amyleesterling/humanoid-robot/electrical/kicad/project-button-v3/output/project-button-v3-pcb-test-access-bottom.png

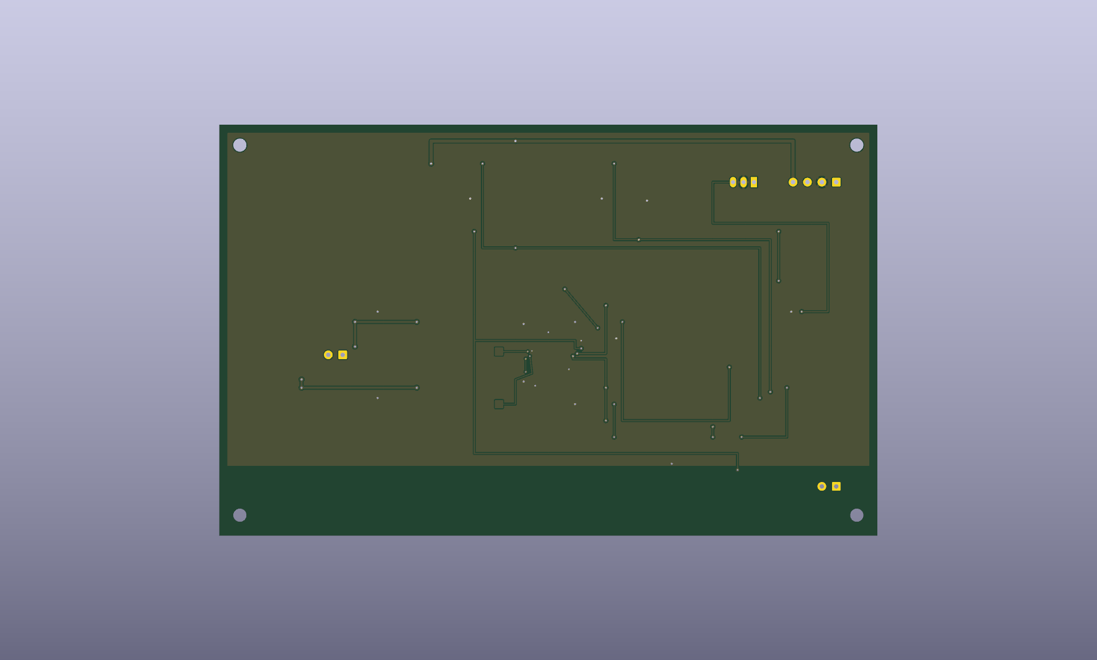
electrical/kicad/project-button-v3/output/project-button-v3-pcb-test-access-bottom.png
