amyleesterling/humanoid-robot/configuration/hr-v0-firmware-mechanical-source-binding-p0.1/README.md

# HR-V0-FW-MECH-SRC-BIND-P0.1

> **PRELIMINARY - NOT APPROVED FOR PROCUREMENT, FABRICATION, ASSEMBLY, CONNECTION, POWERED TESTING, MOTION, OR ENERGIZATION**

R245 binds both firmware configuration files to a SHA-256 manifest covering the current integrated P0.8 assembly, corrected P0.3 custom-part binding, inherited P0.7 kinematic basis and P0.3 hard-stop basis. The separate physical/HIL acceptance hash remains `SELECTION REQUIRED`; motion remains fail-closed.
