amyleesterling/humanoid-robot/configuration/hr-v0-config-reconciliation-p0.10/README.md

# HR-V0-CONFIG-REC-P0.10

> **PRELIMINARY - NOT APPROVED FOR PROCUREMENT, FABRICATION, ASSEMBLY, CONNECTION, POWERED TESTING, MOTION, OR ENERGIZATION**

R246 carries P0.9 forward and adds the partial/not-accepted P1.21 static voltage-budget evidence. P1.15 remains current; P1.21 remains unaccepted. Forty-one holds and fifty-seven unexecuted acceptance rows remain.
