amyleesterling/humanoid-robot/configuration/hr-v0-config-reconciliation-p0.11/README.md

# HR-V0-CONFIG-REC-P0.11

> **PRELIMINARY - NOT APPROVED FOR PROCUREMENT, FABRICATION, ASSEMBLY, CONNECTION, POWERED TESTING, MOTION, OR ENERGIZATION**

R247 carries P0.10 forward and adds the review/RFQ-preparation-only mechanical shop and unpowered assembly candidate. P1.15 remains current; P1.21 remains unaccepted. Forty-five holds and sixty-five unexecuted acceptance rows remain.
