amyleesterling/humanoid-robot/configuration/hr-v0-config-reconciliation-p0.12/README.md

# HR-V0-CONFIG-REC-P0.12

> **PRELIMINARY - NOT APPROVED FOR PROCUREMENT, FABRICATION, ASSEMBLY, CONNECTION, POWERED TESTING, MOTION, OR ENERGIZATION**

R248 carries P0.11 forward and adds a blank physical-properties evidence contract. It does not add physical evidence or close B-010. Fifty holds and seventy-three unexecuted acceptance rows remain.
