amyleesterling/humanoid-robot/configuration/hr-v0-config-reconciliation-p0.13/README.md

# HR-V0-CONFIG-REC-P0.13

> **PRELIMINARY - NOT APPROVED FOR PROCUREMENT, FABRICATION, ASSEMBLY, CONNECTION, POWERED TESTING, MOTION, OR ENERGIZATION**

R249 carries P0.12 forward and adds fail-closed accepted-property propagation. No accepted physical bundle or downstream rebuild exists. Fifty-five holds and eighty-one unexecuted acceptance rows remain.
