amyleesterling/humanoid-robot/configuration/hr-v0-config-reconciliation-p0.14/README.md

# HR-V0-CONFIG-REC-P0.14

> **PRELIMINARY - NOT APPROVED FOR PROCUREMENT, FABRICATION, ASSEMBLY, CONNECTION, POWERED TESTING, MOTION, OR ENERGIZATION**

R250 adds a qualified-review-only GD&T proposal. Formal GD&T remains unreleased. Sixty holds and eighty-nine unexecuted acceptances remain.
