amyleesterling/humanoid-robot/configuration/hr-v0-config-reconciliation-p0.15/README.md

# HR-V0-CONFIG-REC-P0.15

> **PRELIMINARY - NOT APPROVED FOR PROCUREMENT, FABRICATION, ASSEMBLY, CONNECTION, POWERED TESTING, MOTION, OR ENERGIZATION**

R251 adds the fail-closed first-shop-session contract. Sixty-five holds and ninety-seven unexecuted acceptances remain.
