amyleesterling/humanoid-robot/configuration/hr-v0-config-reconciliation-p0.16/README.md

# HR-V0-CONFIG-REC-P0.16

> **PRELIMINARY - NOT APPROVED FOR PROCUREMENT, FABRICATION, ASSEMBLY, CONNECTION, POWERED TESTING, MOTION, OR ENERGIZATION**

R252 adds the review-only zero-energy fixture and temporary-stack instruction. Seventy holds and 103 unexecuted acceptances remain.
