amyleesterling/humanoid-robot/configuration/hr-v0-config-reconciliation-p0.17/README.md

# HR-V0-CONFIG-REC-P0.17

> **PRELIMINARY - NOT APPROVED FOR PROCUREMENT, FABRICATION, ASSEMBLY, CONNECTION, POWERED TESTING, MOTION, OR ENERGIZATION**

R253 supersedes the rank-3 P0.1 locating scheme with rank-6 nominal P0.2. Seventy holds and 103 unexecuted acceptances remain.
