amyleesterling/humanoid-robot/configuration/hr-v0-config-reconciliation-p0.18/README.md

# HR-V0-CONFIG-REC-P0.18

> **PRELIMINARY - NOT APPROVED FOR PROCUREMENT, FABRICATION, ASSEMBLY, CONNECTION, POWERED TESTING, MOTION, OR ENERGIZATION**

R254 adds HR-V0-JOINT-MET-P0.2, supersedes P0.1 for execution planning, and limits P0.2 fixture applicability. 82 holds and 115 unexecuted acceptances remain.
