amyleesterling/humanoid-robot/configuration/hr-v0-config-reconciliation-p0.19/README.md

# HR-V0-CONFIG-REC-P0.19

> **PRELIMINARY - NOT APPROVED FOR PROCUREMENT, FABRICATION, ASSEMBLY, CONNECTION, POWERED TESTING, MOTION, OR ENERGIZATION**

R255 adds HR-V0-LOT-A-INQUIRY-P0.2 and supersedes two historical inquiry plans for current use. 97 holds and 130 unexecuted acceptances remain. Nothing is sent or authorized.
