amyleesterling/humanoid-robot/configuration/hr-v0-config-reconciliation-p0.2/README.md

# HR-V0 configuration reconciliation P0.2

> **PRELIMINARY - NOT APPROVED FOR PROCUREMENT, FABRICATION, ASSEMBLY, CONNECTION, POWERED TESTING, MOTION, OR ENERGIZATION**

R212 retains P1.15 as the direct watchdog/core binding and adds the machine-parity-checked P1.17 system view, current observation carrier P0.5, Pi carrier P0.1 and both observation harness candidates. P1.16, observation P0.2/P0.3/P0.4 and configuration P0.1 are historical. Pi acceptance, BOM closure, DFM, physical evidence and qualified acceptance remain open.
