amyleesterling/humanoid-robot/configuration/hr-v0-config-reconciliation-p0.20/README.md

# HR-V0-CONFIG-REC-P0.20

> **PRELIMINARY - NOT APPROVED FOR PROCUREMENT, FABRICATION, ASSEMBLY, CONNECTION, POWERED TESTING, MOTION, OR ENERGIZATION**

R256 adds HR-V0-JOINT-MEAS-DEF-P0.1. It defines exact source references but releases no physical result, tolerance, selection or work authority. 109 holds and 142 unexecuted acceptances remain.
