amyleesterling/humanoid-robot/configuration/hr-v0-config-reconciliation-p0.21/README.md

# HR-V0-CONFIG-REC-P0.21

> **PRELIMINARY - NOT APPROVED FOR PROCUREMENT, FABRICATION, ASSEMBLY, CONNECTION, POWERED TESTING, MOTION, OR ENERGIZATION**

R257 adds HR-V0-LOT-A-INQUIRY-P0.3 and supersedes P0.2 for current inquiry use. 125 holds and 158 unexecuted acceptances remain. Nothing is sent or authorized.
