amyleesterling/humanoid-robot/configuration/hr-v0-config-reconciliation-p0.22/README.md

# HR-V0-CONFIG-REC-P0.22

> **PRELIMINARY - NOT APPROVED FOR PROCUREMENT, FABRICATION, ASSEMBLY, CONNECTION, POWERED TESTING, MOTION, OR ENERGIZATION**

R258 adds HR-V0-LOT-A-TX-BUNDLE-P0.1. Five deterministic archives exist, but all remain UNSENT and NOT AUTHORIZED. Vendor-CAD redistribution authority remains open. 136 holds and 169 unexecuted acceptances remain.
