amyleesterling/humanoid-robot/configuration/hr-v0-config-reconciliation-p0.23/README.md

# HR-V0-CONFIG-REC-P0.23

> **PRELIMINARY - NOT APPROVED FOR PROCUREMENT, FABRICATION, ASSEMBLY, CONNECTION, POWERED TESTING, MOTION, OR ENERGIZATION**

R259 adds HR-V0-OBS-BOM-INTEGRATION-P0.1, BOM-099 through BOM-108, and corrects current release metadata to 108 groups. Exact mounting hardware, cable cuts, provider/received evidence, physical tests, qualified review and all work authority remain open. 144 holds and 179 unexecuted acceptances remain.
