amyleesterling/humanoid-robot/configuration/hr-v0-config-reconciliation-p0.24/README.md

# HR-V0-CONFIG-REC-P0.24

> **PRELIMINARY - NOT APPROVED FOR PROCUREMENT, FABRICATION, ASSEMBLY, CONNECTION, POWERED TESTING, MOTION, OR ENERGIZATION**

R260 adds HR-V0-OBS-MOUNT-STACK-P0.1. BOM-107 and BOM-108 now contain exact but unreleased candidate hardware; BOM-104 records restricted Samtec availability and the nominal 0.13 mm stack mismatch. 153 holds and 191 unexecuted acceptances remain.
