amyleesterling/humanoid-robot/configuration/hr-v0-config-reconciliation-p0.25/README.md

# HR-V0-CONFIG-REC-P0.25

> **PRELIMINARY - NOT APPROVED FOR PROCUREMENT, FABRICATION, ASSEMBLY, CONNECTION, POWERED TESTING, MOTION, OR ENERGIZATION**

R261 adds HR-V0-U2D2-JC1-HARNESS-P0.1. BOM-061 is now an exact but unreleased two-conductor harness candidate and the canonical BOM closure now agrees that BOM-107/108 are exact-candidate holds. 165 holds and 204 unexecuted acceptances remain.
