amyleesterling/humanoid-robot/configuration/hr-v0-config-reconciliation-p0.26/README.md

# HR-V0-CONFIG-REC-P0.26

> **PRELIMINARY - NOT APPROVED FOR PROCUREMENT, FABRICATION, ASSEMBLY, CONNECTION, POWERED TESTING, MOTION, OR ENERGIZATION**

R262 adds HR-V0-U2D2-JC1-HARNESS-RFQ-P0.1: a deterministic, UNSENT manufacturer-build request for the R261 controller harness. Provider response, quote, process evidence, first article, purchase decision and all physical/system acceptance remain open. 175 holds and 216 blank acceptances remain.
