amyleesterling/humanoid-robot/configuration/hr-v0-config-reconciliation-p0.27/README.md

# HR-V0-CONFIG-REC-P0.27

> **PRELIMINARY - NOT APPROVED FOR PROCUREMENT, FABRICATION, ASSEMBLY, CONNECTION, POWERED TESTING, MOTION, OR ENERGIZATION**

R263 adds HR-V0-DXL-PROT-CARRIER-HARNESS-P0.2: six exact harness identities, corrected minimum JST population, an exact held #8 source-terminal candidate, rejection of thirteen stale-placement collisions and a zero-planar-collision rotated planning screen. Placement, cuts, process, physical/qualified evidence and all work authority remain open. 185 holds and 234 blank acceptances remain.
