amyleesterling/humanoid-robot/configuration/hr-v0-config-reconciliation-p0.28/README.md

# HR-V0-CONFIG-REC-P0.28

> **PRELIMINARY - NOT APPROVED FOR PROCUREMENT, FABRICATION, DRILLING, ASSEMBLY, CONNECTION, POWERED TESTING, MOTION, OR ENERGIZATION**

R264 adds HR-V0-DXL-CARRIER-MOUNT-IF-P0.2: twelve transformed hole centers, six connector anchors, current screw replacement disposition and an inert no-drill fit contract. 200 holds and 252 blank acceptances remain.
