amyleesterling/humanoid-robot/configuration/hr-v0-config-reconciliation-p0.29/README.md

# HR-V0-CONFIG-REC-P0.29

> **PRELIMINARY - NOT APPROVED FOR PROCUREMENT, FABRICATION, MARKING, DRILLING, ASSEMBLY, CONNECTION, POWERED TESTING, MOTION, OR ENERGIZATION**

R265 adds HR-V0-CARRIER-FIT-EVID-CAP-P0.1, a blank local-only physical-fit evidence contract. It authorizes no session or physical work. 210 holds and 264 blank acceptances remain.
