amyleesterling/humanoid-robot/configuration/hr-v0-config-reconciliation-p0.3/README.md

# HR-V0 configuration reconciliation P0.3

> **PRELIMINARY - NOT APPROVED FOR PROCUREMENT, FABRICATION, ASSEMBLY, CONNECTION, POWERED TESTING, MOTION, OR ENERGIZATION**

R214 adds `HR-V0-ARM-ARCH-P0.8-DWG-INTEGRATED-CANDIDATE` as the current held integrated mechanical identity. It directly imports the five R213 custom-part STEP identities while retaining P0.7 only as historical transform/collision basis. All physical evidence, qualified acceptance and work authority remain open.
