amyleesterling/humanoid-robot/configuration/hr-v0-config-reconciliation-p0.30/README.md

# HR-V0-CONFIG-REC-P0.30

> **PRELIMINARY - NOT APPROVED FOR PROCUREMENT, FABRICATION, ASSEMBLY, CONNECTION, POWERED TESTING, MOTION, OR ENERGIZATION**

R266 adds HR-V0-LOT-A-DECISION-CAP-P0.1, a local-only blank decision surface. It records current primary-page facts and authorizes no contact, cart, checkout, purchase or receipt. 222 holds and 276 blank acceptances remain.
