amyleesterling/humanoid-robot/configuration/hr-v0-config-reconciliation-p0.31/README.md

# HR-V0-CONFIG-REC-P0.31

> **PRELIMINARY - NOT APPROVED FOR PROCUREMENT, FABRICATION, ASSEMBLY, CONNECTION, POWERED TESTING, MOTION, OR ENERGIZATION**

R267 adds HR-V0-LOT-A-ALT-ROUTE-P0.1. The exact actuator marketplace route is conditionally admissible for dated cart/quote evaluation only. It authorizes no contact, cart, checkout, purchase, receipt or physical work. 234 holds and 288 blank acceptances remain.
