amyleesterling/humanoid-robot/configuration/hr-v0-config-reconciliation-p0.32/README.md

# HR-V0-CONFIG-REC-P0.32

> **PRELIMINARY - NOT APPROVED FOR PROCUREMENT, FABRICATION, ASSEMBLY, CONNECTION, POWERED TESTING, MOTION, OR ENERGIZATION**

R268 adds HR-V0-GDT-REVIEW-P0.2. It corrects a non-equivalent tolerance-zone proposal and removes ambiguous datum wording without changing drawing geometry or authorizing work. 246 holds and 300 blank acceptances remain.
