amyleesterling/humanoid-robot/configuration/hr-v0-config-reconciliation-p0.33/README.md

# HR-V0-CONFIG-REC-P0.33

> **PRELIMINARY - NOT APPROVED FOR PROCUREMENT, QUOTATION, FABRICATION, ASSEMBLY, CONNECTION, POWERED TESTING, MOTION, OR ENERGIZATION**

R269 adds HR-V0-J2-STOP-STRENGTH-P0.1 as unselected review evidence. P0.8 remains the current unaccepted mechanical identity; P0.9 is not promoted. 258 holds and 312 blank acceptances remain.
