amyleesterling/humanoid-robot/configuration/hr-v0-config-reconciliation-p0.34/README.md

# HR-V0-CONFIG-REC-P0.34

> **PRELIMINARY - NOT APPROVED FOR PROCUREMENT, QUOTATION, FABRICATION, ASSEMBLY, CONNECTION, POWERED TESTING, MOTION, OR ENERGIZATION**

R270 supersedes the R269 force conversion and indexes HR-V0-J2-STOP-BOSSED-P0.1. P0.8 remains the current unaccepted mechanical identity; P0.10 is not selected.
