amyleesterling/humanoid-robot/configuration/hr-v0-config-reconciliation-p0.35/README.md

# HR-V0-CONFIG-REC-P0.35

> **PRELIMINARY - NOT APPROVED FOR PROCUREMENT, QUOTATION, FABRICATION, ASSEMBLY, CONNECTION, POWERED TESTING, MOTION, OR ENERGIZATION**

R271 indexes HR-V0-J2-STOP-FEA-P0.1. P0.8 remains the current unaccepted mechanical identity; P0.10 fails the interim full-part screen and is not selected.
