amyleesterling/humanoid-robot/configuration/hr-v0-config-reconciliation-p0.38/README.md

# HR-V0-CONFIG-REC-P0.38

> **PRELIMINARY - NOT APPROVED FOR PROCUREMENT, QUOTATION, FABRICATION, ASSEMBLY, CONNECTION, POWERED TESTING, MOTION, OR ENERGIZATION**

R274 indexes the unselected A04 P0.1 exact-candidate and verification package. P0.8 remains the current unaccepted mechanical identity; no procurement or structural-use authority exists.
