amyleesterling/humanoid-robot/configuration/hr-v0-config-reconciliation-p0.39/README.md

# HR-V0-CONFIG-REC-P0.39

> **PRELIMINARY - NOT APPROVED FOR PROCUREMENT, QUOTATION, FABRICATION, ASSEMBLY, CONNECTION, POWERED TESTING, MOTION, OR ENERGIZATION**

R275 indexes an unselected Rogers 2300327 soft-contact test-coupon candidate. It has no sole structural-stop or safety credit.
