amyleesterling/humanoid-robot/configuration/hr-v0-config-reconciliation-p0.4/README.md

# HR-V0-CONFIG-REC-P0.4

> **PRELIMINARY - NOT APPROVED FOR PROCUREMENT, FABRICATION, ASSEMBLY, CONNECTION, POWERED TESTING, MOTION, OR ENERGIZATION**

R223 reconciles P1.15 current identity with the unaccepted P1.18 topology, explicit P2P schedule, held node placement and 95-group covered BOM. No physical or work gate closes.
