amyleesterling/humanoid-robot/configuration/hr-v0-config-reconciliation-p0.40/README.md

# HR-V0-CONFIG-REC-P0.40

> **PRELIMINARY - NOT APPROVED FOR PROCUREMENT, QUOTATION, FABRICATION, ASSEMBLY, CONNECTION, POWERED TESTING, MOTION, OR ENERGIZATION**

R276 indexes P0.2's exact P0.12 contact-load boundary. Rogers 2300327 remains an unselected sacrificial test coupon with no structural-stop or safety credit.
