amyleesterling/humanoid-robot/configuration/hr-v0-config-reconciliation-p0.41/README.md

# HR-V0-CONFIG-REC-P0.41

> **PRELIMINARY - NOT APPROVED FOR PROCUREMENT, QUOTATION, FABRICATION, ASSEMBLY, CONNECTION, POWERED TESTING, MOTION, OR ENERGIZATION**

R277 indexes the P0.13 pad-pocket geometry and dependent-depth control. The 0.520 mm CAD depth is not a machining dimension; pad, adhesive and P0.13 remain unselected.
