amyleesterling/humanoid-robot/configuration/hr-v0-config-reconciliation-p0.42/README.md

# HR-V0-CONFIG-REC-P0.42

> **PRELIMINARY - NOT APPROVED FOR PROCUREMENT, QUOTATION, FABRICATION, ASSEMBLY, CONNECTION, POWERED TESTING, MOTION, OR ENERGIZATION**

R278 indexes the corrected exact-normal P0.13 linear screens. P0.13 remains unselected; nonlinear, joined-load, dynamic, physical and qualified closure remains open.
