amyleesterling/humanoid-robot/configuration/hr-v0-config-reconciliation-p0.43/README.md

# HR-V0-CONFIG-REC-P0.43

> **PRELIMINARY - NOT APPROVED FOR PROCUREMENT, QUOTATION, FABRICATION, ASSEMBLY, CONNECTION, POWERED TESTING, MOTION, OR ENERGIZATION**

R279 indexes the unexecuted exact local convergence protocol. R278-H02 and every work authority remain open.
