amyleesterling/humanoid-robot/configuration/hr-v0-config-reconciliation-p0.44/README.md

# HR-V0-CONFIG-REC-P0.44

> **PRELIMINARY - SCRATCH NUMERICAL EVIDENCE ONLY - NOT APPROVED FOR PROCUREMENT, QUOTATION, FABRICATION, ASSEMBLY, CONNECTION, POWERED TESTING, MOTION, OR ENERGIZATION**

R280 indexes bounded local-mesh/solver feasibility evidence. R278-H02 and every work authority remain open.
