amyleesterling/humanoid-robot/configuration/hr-v0-config-reconciliation-p0.45/README.md

# HR-V0-CONFIG-REC-P0.45

> **PRELIMINARY - NUMERICAL SOLVER FEASIBILITY ONLY - NOT APPROVED FOR PROCUREMENT, QUOTATION, FABRICATION, ASSEMBLY, CONNECTION, POWERED TESTING, MOTION, OR ENERGIZATION**

R281 indexes bounded numerical method evidence. H02 and every work authority remain open.
