amyleesterling/humanoid-robot/configuration/hr-v0-config-reconciliation-p0.46/README.md

# HR-V0-CONFIG-REC-P0.46

> **PRELIMINARY - PROTOCOL CORRECTION AND NUMERICAL METHOD EVIDENCE ONLY - NOT APPROVED FOR PROCUREMENT, QUOTATION, FABRICATION, ASSEMBLY, CONNECTION, POWERED TESTING, MOTION, OR ENERGIZATION**

R282 indexes the current fail-closed J2 refinement erratum. H02 and every work authority remain open.
