amyleesterling/humanoid-robot/configuration/hr-v0-config-reconciliation-p0.48/README.md

# HR-V0-CONFIG-REC-P0.48

> **PRELIMINARY - NUMERICAL MESH-METHOD DEVELOPMENT ONLY - NOT APPROVED FOR PROCUREMENT, QUOTATION, FABRICATION, ASSEMBLY, CONNECTION, POWERED TESTING, MOTION, OR ENERGIZATION**

R284 indexes bounded C07 mesh-method candidates and targeted failure localization. The sequence is not converged; R279-C02, H02, capacity and every work authority remain open.
