amyleesterling/humanoid-robot/configuration/hr-v0-config-reconciliation-p0.49/README.md

# HR-V0-CONFIG-REC-P0.49

> **PRELIMINARY - TARGETED CURVED-MESH METHOD EVIDENCE ONLY - NOT APPROVED FOR PROCUREMENT, QUOTATION, FABRICATION, ASSEMBLY, CONNECTION, POWERED TESTING, MOTION, OR ENERGIZATION**

R285 indexes exact target-feature identities and a repeatable bounded targeted-remesh candidate. Exact B-Rep/facet/load/full-domain/exact-zone/R279-C02/H02 and every authority remain open.
