amyleesterling/humanoid-robot/configuration/hr-v0-config-reconciliation-p0.6/README.md

# HR-V0-CONFIG-REC-P0.6

> **PRELIMINARY - NOT APPROVED FOR PROCUREMENT, FABRICATION, ASSEMBLY, CONNECTION, POWERED TESTING, MOTION, OR ENERGIZATION**

R242 adds held BOM-097 and HR-V0-P121-CONDUCTOR-FILL-P0.1. P1.15 remains current; P1.21 is unaccepted; no work gate closes.
