amyleesterling/humanoid-robot/configuration/hr-v0-config-reconciliation-p0.7/README.md

# HR-V0-CONFIG-REC-P0.7

> **PRELIMINARY - NOT APPROVED FOR PROCUREMENT, FABRICATION, ASSEMBLY, CONNECTION, POWERED TESTING, MOTION, OR ENERGIZATION**

R243 adds held BOM-098 and HR-V0-P121-TERM-P0.1. P1.15 remains current; P1.21 is unaccepted; no gate or work authority closes.
