amyleesterling/humanoid-robot/configuration/hr-v0-config-reconciliation-p0.9/README.md

# HR-V0-CONFIG-REC-P0.9

> **PRELIMINARY - NOT APPROVED FOR PROCUREMENT, FABRICATION, ASSEMBLY, CONNECTION, POWERED TESTING, MOTION, OR ENERGIZATION**

R245 corrects BOM-027 to `HR-V0-MECH-BOM-BIND-P0.3` and binds both firmware configurations to HR-V0-FW-MECH-SRC-BIND-P0.1. Source identity is closed; shop-document, physical/HIL and qualified acceptance remain open. P1.15 remains current and P1.21 unaccepted.
