amyleesterling/humanoid-robot/controls/hr-v0-runtime-evidence-log-p0.1/README.md

# HR-V0-EVID-LOG-P0.1

> **PRELIMINARY - NOT APPROVED FOR PROCUREMENT, FABRICATION, ASSEMBLY, CONNECTION, POWERED TESTING, MOTION, OR ENERGIZATION**

This package controls the source-side runtime evidence stream and the future target/calibration acceptance route. It does not contain an accepted calibration, target trace, physical result, qualified disposition, or test authority.

- 14 required event classes
- 10 clock/uncertainty budget rows
- 12 blank calibration records
- 15 future tests, all `NOT_EXECUTED`
- 15 open holds
- Sol M-022 remains `PARTIALLY_ADDRESSED_OPEN`
