amyleesterling/humanoid-robot/safety/hr-v0-p121-application-evidence-p0.1/README.md

# HR-V0-P121-APP-EVID-P0.1

> **PRELIMINARY - NOT APPROVED FOR PROCUREMENT, FABRICATION, ASSEMBLY, CONNECTION, POWERED TESTING, MOTION, OR ENERGIZATION**

R235 converts P1.21 application holds into 13 exact unsent manufacturer questions, 12 response controls, 18 unexecuted no-load tests and 14 open holds. It sends nothing, selects no unresolved dynamic limit, executes no test and grants no authority. P1.15 remains current; P1.21 remains unaccepted.
