amyleesterling/humanoid-robot/safety/hr-v0-p121-sra1-supply-watchdog-p0.1/README.md

# HR-V0-P121-SRA1-SUPPLY-WD-P0.1

> **PRELIMINARY - NOT APPROVED FOR PROCUREMENT, FABRICATION, ASSEMBLY, CONNECTION, POWERED TESTING, MOTION, OR ENERGIZATION**

R234 records the unaccepted P1.21 SRA1-supply watchdog candidate: seven exact terminal changes, 14 fault cases, nine supply/contact screens and 11 open holds. P1.15 remains current. DF-01 has zero safety credit.
