amyleesterling/humanoid-robot/safety/hr-v0-pnoz-kwd-application-p0.2/README.md

# HR-V0-PNOZ-KWD-APP-P0.2

> **PRELIMINARY - NOT APPROVED FOR PROCUREMENT, FABRICATION, ASSEMBLY, CONNECTION, POWERED TESTING, MOTION, OR ENERGIZATION**

R233 screens the P1.20 PNOZ s4 750104 input path against Phoenix Contact 2967060 source data. The electrical contact screen passes on paper; B-005 remains partially addressed/open, P1.20 remains unaccepted, and safety credit/work authority remain zero.
