amyleesterling/humanoid-robot/configuration/hr-v0-config-reconciliation-p0.1/README.md

# HR-V0 configuration reconciliation P0.1

> **PRELIMINARY - NOT APPROVED FOR PROCUREMENT, FABRICATION, ASSEMBLY, CONNECTION, MOTION, OR ENERGIZATION**

R195 synchronizes the carrier-integrated P1.15 candidate, direct-bound watchdog PCB-P1.0, watchdog manufacturing package P0.2, CAM review P0.2 and E2 hardware slice P0.4 into one fail-closed configuration. The P1.14 source, R165 parity record and P0.1 CAM remain controlled historical evidence. Physical evidence and qualified acceptance remain open.
