amyleesterling/humanoid-robot/hr30/whole-body-p0.1/joint-hardware-successor-reconciliation-p0.1/README.md

# HR-30 joint-hardware successor reconciliation P0.1

PRELIMINARY - JOINT-HARDWARE SUCCESSOR CANDIDATES ONLY - NOT APPROVED FOR PROCUREMENT, FABRICATION, ASSEMBLY, POWERED TESTING, MOTION, OR ENERGIZATION

This package binds all 39 legacy pulley/coupler envelopes to physical successor candidates. The old shapes are not manufacturing parts. No successor is selected or released. See `successor-manufacturing-binding.csv`.
