amyleesterling/humanoid-robot/hr30/whole-body-p0.1/leg-drivetrain-p0.1/README.md

# HR-30 reduced-leg drivetrain P0.1

**PRELIMINARY - PRODUCT/GEOMETRY CANDIDATE ONLY - NOT APPROVED FOR PROCUREMENT, FABRICATION, ASSEMBLY, POWERED TESTING, MOTION, OR ENERGIZATION**

Four product-specific 5GT/EV5GT modules cover all ten reduced leg axes. The dedicated LD-25K knee module uses 16:40 teeth, a 250 mm belt and a 10 mm XH540 horn-adapter interface. Native CAD represents catalog external/routing envelopes and exact solved pitch centers. P-bore-plus-tap retention and separate dimensioned adapter geometry are selected, while vendor tooth B-Reps, material, fits, fasteners, capacity and work authority remain open.
