amyleesterling/humanoid-robot/electrical/mechanical/hr-v0-dxl-carrier-mount-p0.2/README.md

# HR-V0-DXL-CARRIER-MOUNT-IF-P0.2

> **PRELIMINARY - NOT APPROVED FOR PROCUREMENT, FABRICATION, DRILLING, ASSEMBLY, CONNECTION, POWERED TESTING, MOTION, OR ENERGIZATION**

R264 defines exact nominal panel datums and an inert no-drill fit contract. It releases no hole, hardware, route, cut or physical work.
