amyleesterling/humanoid-robot/electrical/routing/hr-v0-p121-segregation-hardware-p0.1/README.md

# HR-V0-P121-SEGREGATION-HW-P0.1

> **PRELIMINARY - NOT APPROVED FOR PROCUREMENT, FABRICATION, ASSEMBLY, CONNECTION, POWERED TESTING, MOTION, OR ENERGIZATION**

R241 controls an exact 25 x 25 mm duct body/cover candidate and panel fit screen. Junction, conductors, fill, installation, safety credit and all authority remain open.
