amyleesterling/humanoid-robot/hr30/whole-body-p0.1/leg-drivetrain-adapters-p0.1/README.md

# HR-30 leg-drive adapters P0.1

**PRELIMINARY - DIMENSIONED ADAPTER GEOMETRY CANDIDATE ONLY - NOT APPROVED FOR PROCUREMENT, FABRICATION, ASSEMBLY, POWERED TESTING, MOTION, OR ENERGIZATION**

Five reusable machined-part families give all ten reduced leg axes a concrete nominal horn, pulley and output-shaft interface. The package is editable geometry, not a manufacturing release.
