amyleesterling/humanoid-robot/mechanical/analysis/hr-v0-j2-c07-conformal-successor-disposition-p0.1/README.md

# HR-V0-J2-C07-CONFORMAL-SUCCESSOR-DISPOSITION-P0.1

**PRELIMINARY - CONFORMAL SUCCESSOR DISPOSITION ONLY - NOT APPROVED FOR PROCUREMENT, QUOTATION, FABRICATION, ASSEMBLY, CONNECTION, POWERED TESTING, MOTION, OR ENERGIZATION**

R292 records the split R291 result: sampled curved-Jacobian failures are eliminated, while pocket-junction SICN regresses. More straight-only refinement is rejected; a separately preregistered optimization/topology-method candidate is required.
