amyleesterling/humanoid-robot/mechanical/analysis/hr-v0-j2-c07-conformal-successor-mesh-p0.1/README.md

# HR-V0-J2-C07-CONFORMAL-SUCCESSOR-MESH-P0.1

**PRELIMINARY - PREREGISTERED CONFORMAL SUCCESSOR MESH EVIDENCE ONLY - NOT APPROVED FOR PROCUREMENT, QUOTATION, FABRICATION, ASSEMBLY, CONNECTION, POWERED TESTING, MOTION, OR ENERGIZATION**

R291 executes exactly one preregistered successor to the retained failed R289 mesh. It preserves every R289 setting, adds a 0.18 mm field to the four failed exact pocket-straight volumes, and adds a 0.35 mm field to six symmetry-closed exact cylinder faces. All R279 thresholds are unchanged.

The result is data-driven. Even a complete R279-C02 mesh-quality pass does not execute structural fields, close H02, establish capacity, or grant any work authority.
