amyleesterling/humanoid-robot/mechanical/analysis/hr-v0-j2-c07-conformal-successor-prereg-p0.1/README.md

# HR-V0-J2-C07-CONFORMAL-SUCCESSOR-PREREG-P0.1

**PRELIMINARY - SUCCESSOR MESH PREREGISTRATION ONLY - NOT APPROVED FOR PROCUREMENT, QUOTATION, FABRICATION, ASSEMBLY, CONNECTION, POWERED TESTING, MOTION, OR ENERGIZATION**

R291 freezes one successor execution before meshing: four exact failed pocket-straight volumes receive a 0.18 mm local field and the four observed curved-failure cylinder faces are X-mirror-closed to six exact faces receiving a 0.35 mm field. All R279 acceptance thresholds remain unchanged. No mesh has been executed by this package.
