amyleesterling/humanoid-robot/mechanical/analysis/hr-v0-j2-c07-conformal-zone-mesh-p0.1/README.md

# HR-V0-J2-C07-CONFORMAL-ZONE-MESH-P0.1

**PRELIMINARY - EXACT-ZONE CONFORMAL MESH EVIDENCE ONLY - NOT APPROVED FOR PROCUREMENT, QUOTATION, FABRICATION, ASSEMBLY, CONNECTION, POWERED TESTING, MOTION, OR ENERGIZATION**

R289 meshes the exact R288 Boolean partition. Every tetrahedron inherits one exact volume-entity provenance; no centroid or sampled-distance zone membership is used. Full fixed-bin SICN histograms are retained globally and for every exact zone, and signed/normalized Tet10 Jacobians are evaluated at the actual Gmsh Gauss4/Gauss6/Gauss8 points.

The result is a bounded mesh-quality execution only. Full-domain Jacobian positivity, exterior facet fidelity, structural fields, convergence, H02, capacity, safety credit and every work authority remain open.
