amyleesterling/humanoid-robot/mechanical/analysis/hr-v0-j2-c07-exact-zone-partition-p0.1/README.md

# HR-V0-J2-C07-EXACT-ZONE-PARTITION-P0.1

**PRELIMINARY - EXACT ANALYSIS-ZONE CAD PARTITION ONLY - NOT APPROVED FOR PROCUREMENT, QUOTATION, FABRICATION, ASSEMBLY, CONNECTION, POWERED TESTING, MOTION, OR ENERGIZATION**

R288 creates an exact OpenCASCADE partition of the authoritative P0.13 C07 part into 27 primary analysis zones: eight separately named pocket-perimeter bands, the pocket-floor backing volume, twelve Euclidean 1 mm hole-rim neighborhoods, and six nonsingular ligament bands. The retained B-Rep is partitioned by Boolean provenance; no centroid, sampled-polyline, or element-mean membership substitute is used.

The exact C07 M5 bores E1/E2 begin at y=2.9 mm. R288 therefore rejects the earlier aggregate y=0 hole assumption for those two bores. It does not invent the missing radial thickness for fixed-offset hole gauge volumes.

No mesh or structural solve is executed. R279-C02, R278-H02, capacity, safety credit and every work authority remain open.
