amyleesterling/humanoid-robot/mechanical/analysis/hr-v0-j2-c07-fidelity-remesh-p0.1/README.md

# HR-V0-J2-C07-FIDELITY-REMESH-P0.1

> **PRELIMINARY - TARGETED B-REP FIDELITY REMESH EVIDENCE ONLY - NOT APPROVED FOR PROCUREMENT, QUOTATION, FABRICATION, ASSEMBLY, CONNECTION, POWERED TESTING, MOTION, OR ENERGIZATION**

R287 applies the preregistered 0.35 mm field to the X-mirror-closed set of 22 exact faces (21 R286 failures plus one required mirror counterpart) and their 88 owner-boundary curves while retaining the R285 global, pocket, hole, boss and rail-transition controls. The exact R286 evaluator is run next; no mesh pass alone grants structural, capacity, safety or work-authority credit.
