amyleesterling/humanoid-robot/mechanical/analysis/hr-v0-j2-c07-pe-cad-curving-facet-localization-p0.1/README.md

# HR-V0-J2-C07-PE-CAD-CURVING-FACET-LOCALIZATION-P0.1

**PRELIMINARY - R308 UNMAPPED-FACET LOCALIZATION EVIDENCE ONLY - NOT APPROVED FOR PROCUREMENT, QUOTATION, FABRICATION, ASSEMBLY, CONNECTION, POWERED TESTING, MOTION, OR ENERGIZATION**

R309 reproduces the R308 77-facet failure without changing mesh or tolerance and assigns each unmapped facet its nearest exact OCC face with six-node deviations. This is localization only; it does not retroactively pass the exact-face map or authorize a replacement mesh.
