amyleesterling/humanoid-robot/mechanical/analysis/hr-v0-j2-c07-pe-cad-curving-facet-p0.1/README.md

# HR-V0-J2-C07-PE-CAD-CURVING-FACET-P0.1

**PRELIMINARY - FAILED R307 EXACT FACET/B-REP/LOAD REVALIDATION EVIDENCE ONLY - NOT APPROVED FOR PROCUREMENT, QUOTATION, FABRICATION, ASSEMBLY, CONNECTION, POWERED TESTING, MOTION, OR ENERGIZATION**

The one frozen R308 evaluation stopped fail-closed before area/load credit: 112,569 of 112,646 exterior R307 quadratic facets mapped uniquely to an exact OCC face, while 77 mapped to none. No threshold, geometry, mesh or optimizer setting was changed. R307 remains valid only as bounded sampled Jacobian evidence. R279-C02, structural execution, H02, capacity, physical validation and every work authority remain open.
