amyleesterling/humanoid-robot/mechanical/analysis/hr-v0-j2-c07-pe-cad-curving-facet-prereg-p0.1/README.md

# HR-V0-J2-C07-PE-CAD-CURVING-FACET-PREREG-P0.1

**PRELIMINARY - R307 EXACT FACET/B-REP/LOAD REVALIDATION PREREGISTRATION ONLY - NOT APPROVED FOR PROCUREMENT, QUOTATION, FABRICATION, ASSEMBLY, CONNECTION, POWERED TESTING, MOTION, OR ENERGIZATION**

R308 freezes one exact exterior-facet/B-Rep/load evaluation of the retained R307 candidate. It does not remesh or alter CAD. Passing this gate still does not prove full-reference-domain positivity, structural convergence, capacity, physical validation, or work authority.
