amyleesterling/humanoid-robot/mechanical/analysis/hr-v0-j2-c07-pe-cad-curving-mesh-p0.1/README.md

# HR-V0-J2-C07-PE-CAD-CURVING-MESH-P0.1

**PRELIMINARY - CAD-RESIDENT CONSTRAINED CURVING EVIDENCE ONLY - NOT APPROVED FOR PROCUREMENT, QUOTATION, FABRICATION, ASSEMBLY, CONNECTION, POWERED TESTING, MOTION, OR ENERGIZATION**

R307 executes the one frozen CAD-resident constrained `HighOrder` candidate while the exact R297 OCC model remains live. The regenerated R300 linear mesh must reproduce exactly, all mapped linear corners are restored, and only optimized midsides are retained. Q4/Q6/Q8 results are finite sampled evidence, not proof over the complete reference tetrahedron.

Even a sampled pass does not close R279-C02. Exact exterior-facet/B-Rep/load revalidation, independent acceptance, structural fields, convergence, H02, capacity, physical validation and every work authority remain open.
