amyleesterling/humanoid-robot/mechanical/analysis/hr-v0-j2-c07-pe-cad-curving-prereg-p0.1/README.md

# HR-V0-J2-C07-PE-CAD-CURVING-PREREG-P0.1

**PRELIMINARY - CAD-RESIDENT CONSTRAINED CURVING PREREGISTRATION ONLY - NOT APPROVED FOR PROCUREMENT, QUOTATION, FABRICATION, ASSEMBLY, CONNECTION, POWERED TESTING, MOTION, OR ENERGIZATION**

R307 moves the one constrained `HighOrder` operation from the stalled discrete-mesh R306 route into the live OCC/CAD-resident R300 generation pipeline. The physical part and analysis partition do not change. The regenerated linear mesh must first reproduce R300 exactly. No structural or physical-work authority follows from this preregistration or a future sampled pass.
