amyleesterling/humanoid-robot/mechanical/analysis/hr-v0-j2-c07-pe-constrained-curving-mesh-p0.1/README.md

# HR-V0-J2-C07-PE-CONSTRAINED-CURVING-MESH-P0.1

**PRELIMINARY - CONTROLLED-STOP CONSTRAINED CURVING ATTEMPT EVIDENCE ONLY - NOT APPROVED FOR PROCUREMENT, QUOTATION, FABRICATION, ASSEMBLY, CONNECTION, POWERED TESTING, MOTION, OR ENERGIZATION**

R306 attempted the single preregistered `HighOrder` operation on the retained discrete R300 mesh. The process produced no result and was stopped after its CPU and memory counters remained unchanged for at least 60 seconds. No alternate optimizer was substituted. Only the temporary decompressed copy was removed; R300 remains intact. The route is rejected for this toolchain.
