amyleesterling/humanoid-robot/mechanical/analysis/hr-v0-j2-c07-pe-constrained-curving-prereg-p0.1/README.md

# HR-V0-J2-C07-PE-CONSTRAINED-CURVING-PREREG-P0.1

**PRELIMINARY - CONSTRAINED HIGH-ORDER CURVING PREREGISTRATION ONLY - NOT APPROVED FOR PROCUREMENT, QUOTATION, FABRICATION, ASSEMBLY, CONNECTION, POWERED TESTING, MOTION, OR ENERGIZATION**

R306 freezes one no-remesh constrained `HighOrder` optimization of the R300 C07-MATRIX. Every pre-operation linear corner must be restored exactly; optimized midsides may be retained only if Q4/Q6/Q8, exact facet mapping, B-Rep deviation, per-face area and load-geometry gates all pass. Full-domain positivity, R279-C02, structural convergence, H02, capacity and all work authority remain open.
