amyleesterling/humanoid-robot/mechanical/analysis/hr-v0-j2-c07-pe-corrected-surface-imprint-p0.1/README.md

# HR-V0-J2-C07-PE-CORRECTED-SURFACE-IMPRINT-P0.1

**PRELIMINARY - CORRECTED 24-FACE ANALYSIS-SURFACE IMPRINT EVIDENCE ONLY - NOT APPROVED FOR PROCUREMENT, QUOTATION, FABRICATION, ASSEMBLY, CONNECTION, POWERED TESTING, MOTION, OR ENERGIZATION**

R312 executes the one frozen 24-face surface imprint across all 21 R297 analysis volumes. It grants topology evidence only if every zone maps one-to-one with volume/bbox/COM closure, the fused PE band remains one volume, and every corrected exact trimmed face is present with one exterior owner. No mesh or structural solve is executed.
