amyleesterling/humanoid-robot/mechanical/analysis/hr-v0-j2-c07-pe-corrected-surface-imprint-prereg-p0.1/README.md

# HR-V0-J2-C07-PE-CORRECTED-SURFACE-IMPRINT-PREREG-P0.1

**PRELIMINARY - CORRECTED 24-FACE ANALYSIS-SURFACE IMPRINT PREREGISTRATION ONLY - NOT APPROVED FOR PROCUREMENT, QUOTATION, FABRICATION, ASSEMBLY, CONNECTION, POWERED TESTING, MOTION, OR ENERGIZATION**

R312 freezes one corrected surface-imprint operation using all 24 exact STEP faces implicated by the R311 trimmed-face audit. The earlier R310 seven-plane candidate is rejected. No Boolean or mesh has executed.
