amyleesterling/humanoid-robot/mechanical/analysis/hr-v0-j2-c07-pe-frontal-disposition-p0.1/README.md

# HR-V0-J2-C07-PE-FRONTAL-DISPOSITION-P0.1

**PRELIMINARY - FRONTAL TETRAHEDRALIZATION DISPOSITION ONLY - NOT APPROVED FOR PROCUREMENT, QUOTATION, FABRICATION, ASSEMBLY, CONNECTION, POWERED TESTING, MOTION, OR ENERGIZATION**

R296 rejects R295. Three linear-mesh methods leave the same four PE straight-zone defects, while every R2 subzone and every non-PE R295 zone passes. This is evidence that the four tangent internal analysis seams—not the authoritative part—force the low-quality cells.

The next partition removes only those internal analysis seams by representing the exact PE band as one fused material volume. Eight exact straight/corner solids remain retained classification subsets. Requiring every fused-band cell to meet SICN 0.20 conservatively proves the same floor for each subset. No physical CAD, requirement threshold, structural result, capacity conclusion, or work authority changes.
