amyleesterling/humanoid-robot/mechanical/analysis/hr-v0-j2-c07-pe-frontal-mesh-p0.1/README.md

# HR-V0-J2-C07-PE-FRONTAL-MESH-P0.1

**PRELIMINARY - PREREGISTERED FRONTAL TETRAHEDRALIZATION EVIDENCE ONLY - NOT APPROVED FOR PROCUREMENT, QUOTATION, FABRICATION, ASSEMBLY, CONNECTION, POWERED TESTING, MOTION, OR ENERGIZATION**

R295 executes exactly one preregistered linear-topology candidate: Gmsh Frontal `Algorithm3D=4`, Netgen linear optimization, and then Tet10 conversion. Exact CAD, targets, size fields, and acceptance thresholds remain unchanged; Relocate3D and high-order optimization are absent.

This is mesh-method evidence only. Even an R279-C02 pass does not execute structural fields, establish convergence or capacity, close H02, or grant work authority.
