amyleesterling/humanoid-robot/mechanical/analysis/hr-v0-j2-c07-pe-frontal-prereg-p0.1/README.md

# HR-V0-J2-C07-PE-FRONTAL-PREREG-P0.1

**PRELIMINARY - FRONTAL TETRAHEDRALIZATION PREREGISTRATION ONLY - NOT APPROVED FOR PROCUREMENT, QUOTATION, FABRICATION, ASSEMBLY, CONNECTION, POWERED TESTING, MOTION, OR ENERGIZATION**

R295 freezes one genuinely different linear tetrahedralization before execution: Gmsh Frontal `Algorithm3D=4`, then Netgen optimization, then Tet10 conversion. Exact CAD, targets, mesh-size fields, thresholds, and single-thread execution remain unchanged. Relocate3D and high-order optimization are prohibited.
