amyleesterling/humanoid-robot/mechanical/analysis/hr-v0-j2-c07-pe-rail-jacobian-disposition-p0.1/README.md

# HR-V0-J2-C07-PE-RAIL-JACOBIAN-DISPOSITION-P0.1

**PRELIMINARY - RAIL-JACOBIAN SUCCESSOR DISPOSITION ONLY - NOT APPROVED FOR PROCUREMENT, QUOTATION, FABRICATION, ASSEMBLY, CONNECTION, POWERED TESTING, MOTION, OR ENERGIZATION**

R305 rejects the R303 rail-face refinement. R303 retains the linear gates but degrades the global minimum SICN and increases failed Q4/Q6/Q8 points from 3 to 10. R300 is restored as the next numerical-method baseline. The next candidate must change only high-order curving, restore every linear corner exactly, and revalidate exact B-Rep facets, surface deviation, area, and load geometry before any structural work.
