amyleesterling/humanoid-robot/mechanical/analysis/hr-v0-j2-c07-pe-rail-jacobian-mesh-p0.1/README.md

# HR-V0-J2-C07-PE-RAIL-JACOBIAN-MESH-P0.1

**PRELIMINARY - PREREGISTERED RAIL-TRANSITION JACOBIAN SUCCESSOR EVIDENCE ONLY - NOT APPROVED FOR PROCUREMENT, QUOTATION, FABRICATION, ASSEMBLY, CONNECTION, POWERED TESTING, MOTION, OR ENERGIZATION**

R303 executes exactly one R302-preregistered successor to R300. The only new field is the frozen 0.25 mm / 1.5 mm field on the R301-localized rail-transition cylinder and its exact X mirror. The R300 H1-H4 bore-wall field, seam-free partition, Frontal+Netgen method, all prior fields, and all thresholds remain unchanged. The resulting finite sampled mesh-quality candidate does not pass.

Even a sampled gate pass does not prove full-reference-domain curved-element positivity, close R279-C02 or H02, establish capacity, or grant any physical-work authority.
