amyleesterling/humanoid-robot/mechanical/analysis/hr-v0-j2-c07-pe-rail-jacobian-prereg-p0.1/README.md

# HR-V0-J2-C07-PE-RAIL-JACOBIAN-PREREG-P0.1

**PRELIMINARY - RAIL-TRANSITION JACOBIAN SUCCESSOR PREREGISTRATION ONLY - NOT APPROVED FOR PROCUREMENT, QUOTATION, FABRICATION, ASSEMBLY, CONNECTION, POWERED TESTING, MOTION, OR ENERGIZATION**

R302 freezes two exact X-mirrored rail-transition cylinders at 0.25 mm after R301 localized three residual Q8 failures to one face. Candidate Z mirrors were explicitly enumerated and do not exist in the R297 topology. R300's passing linear quality evidence and all thresholds remain unchanged. The mesh is not executed by this package.

[Interactive guide](index.html)
