amyleesterling/humanoid-robot/mechanical/analysis/hr-v0-j2-c07-pe-seam-free-jacobian-mesh-p0.1/README.md

# HR-V0-J2-C07-PE-SEAM-FREE-JACOBIAN-MESH-P0.1

**PRELIMINARY - PREREGISTERED SEAM-FREE JACOBIAN SUCCESSOR EVIDENCE ONLY - NOT APPROVED FOR PROCUREMENT, QUOTATION, FABRICATION, ASSEMBLY, CONNECTION, POWERED TESTING, MOTION, OR ENERGIZATION**

R300 executes one preregistered successor to R298. The only change is a symmetry-closed 0.25 mm field on the four H1-H4 bore-wall faces localized by R299. The seam-free partition, Frontal+Netgen method, all existing fields, and every threshold remain unchanged.

A mesh gate pass only unlocks separately preregistered structural-field and convergence work. It does not close H02, establish capacity, or grant work authority.
