amyleesterling/humanoid-robot/mechanical/analysis/hr-v0-j2-c07-pe-seam-free-jacobian-prereg-p0.1/README.md

# HR-V0-J2-C07-PE-SEAM-FREE-JACOBIAN-PREREG-P0.1

**PRELIMINARY - SEAM-FREE JACOBIAN SUCCESSOR PREREGISTRATION ONLY - NOT APPROVED FOR PROCUREMENT, QUOTATION, FABRICATION, ASSEMBLY, CONNECTION, POWERED TESTING, MOTION, OR ENERGIZATION**

R300 freezes one successor to R298 before meshing. The only addition is a 0.25 mm field around the one R299 bore-wall failure face, closed by X/Z symmetry to all four H1-H4 bore walls. Exact CAD, seam-free topology, existing fields, Frontal+Netgen method, and thresholds are unchanged.
