amyleesterling/humanoid-robot/mechanical/analysis/hr-v0-j2-c07-pe-seam-free-mesh-p0.1/README.md

# HR-V0-J2-C07-PE-SEAM-FREE-MESH-P0.1

**PRELIMINARY - PREREGISTERED SEAM-FREE PE MESH EVIDENCE ONLY - NOT APPROVED FOR PROCUREMENT, QUOTATION, FABRICATION, ASSEMBLY, CONNECTION, POWERED TESTING, MOTION, OR ENERGIZATION**

R298 executes one preregistered Frontal+Netgen mesh of the R297 seam-free analysis partition. The authoritative physical geometry is unchanged. All cells in the exact fused PE volume are screened at SICN 0.20; because each retained straight/corner solid is an exact subset, the fused-volume minimum conservatively bounds all eight subzones without centroid classification.

This is mesh evidence only. Structural fields, convergence, H02, capacity, safety credit, and every work authority remain open even if R279-C02 passes.
