amyleesterling/humanoid-robot/mechanical/analysis/hr-v0-j2-c07-pe-seam-free-mesh-prereg-p0.1/README.md

# HR-V0-J2-C07-PE-SEAM-FREE-MESH-PREREG-P0.1

**PRELIMINARY - SEAM-FREE PE MESH PREREGISTRATION ONLY - NOT APPROVED FOR PROCUREMENT, QUOTATION, FABRICATION, ASSEMBLY, CONNECTION, POWERED TESTING, MOTION, OR ENERGIZATION**

R298 freezes one Frontal+Netgen mesh of the validated R297 seam-free analysis partition. The fused PE volume receives the retained 0.18 mm field; six exact curved faces retain 0.35 mm refinement. All thresholds and the one-run stop rule are frozen before meshing.
