amyleesterling/humanoid-robot/mechanical/analysis/hr-v0-j2-c07-pe-seam-free-partition-p0.1/README.md

# HR-V0-J2-C07-PE-SEAM-FREE-PARTITION-P0.1

**PRELIMINARY - SEAM-FREE PE ANALYSIS PARTITION ONLY - NOT APPROVED FOR PROCUREMENT, QUOTATION, FABRICATION, ASSEMBLY, CONNECTION, POWERED TESTING, MOTION, OR ENERGIZATION**

R297 removes only four internal tangent seam planes from the analysis partition by fusing the eight exact R288 PE material fragments into one exact `C07-PE-FUSED` material volume. The authoritative P0.13 physical solid is unchanged. Eight original PE subzone solids are retained in a separate classification B-Rep with exact volumes and signatures.

The 21 volumes are re-fragmented together after the PE union so every remaining interface is topologically shared; each input maps one-to-one to one output volume and the removed PE-to-PE seams do not return. PE, per-volume, and total material volumes close within 1e-10 relative error. No mesh or structural solve is executed.
