amyleesterling/humanoid-robot/mechanical/analysis/hr-v0-j2-c07-pe-surface-imprint-disposition-p0.1/README.md

# HR-V0-J2-C07-PE-SURFACE-IMPRINT-DISPOSITION-P0.1

**PRELIMINARY - EXACT EXTERIOR-SURFACE IMPRINT DISPOSITION/PREREGISTRATION ONLY - NOT APPROVED FOR PROCUREMENT, QUOTATION, FABRICATION, ASSEMBLY, CONNECTION, POWERED TESTING, MOTION, OR ENERGIZATION**

R310 proves all 255 nodes on the 77 R308 failures are exactly unchanged from R300 to R307. Coordinate restoration is rejected as non-corrective. The next frozen candidate imprints the seven exact trimmed planar face boundaries onto the exterior analysis topology while preserving the seam-free internal volume partition and all material. No topology execution or mesh has occurred.
