amyleesterling/humanoid-robot/mechanical/analysis/hr-v0-j2-c07-pe-topology-disposition-p0.1/README.md

# HR-V0-J2-C07-PE-TOPOLOGY-DISPOSITION-P0.1

**PRELIMINARY - PE-JUNCTION MESH-METHOD DISPOSITION ONLY - NOT APPROVED FOR PROCUREMENT, QUOTATION, FABRICATION, ASSEMBLY, CONNECTION, POWERED TESTING, MOTION, OR ENERGIZATION**

R294 rejects the preregistered R293 relocation candidate. It retains the same 948,530 tetrahedral topology, changes 551,625 element-quality values, and leaves 24 cells below SICN 0.20 across the same four PE straight zones plus C07-MATRIX. The actual-quadrature curved-Jacobian gate remains clean.

The next candidate changes the tetrahedralization itself: Gmsh Frontal Algorithm3D=4 followed by Netgen only, with exact CAD, fields, and thresholds unchanged. It is not executed by this disposition package.
