amyleesterling/humanoid-robot/mechanical/analysis/hr-v0-j2-c07-pe-topology-mesh-p0.1/README.md

# HR-V0-J2-C07-PE-TOPOLOGY-MESH-P0.1

**PRELIMINARY - PREREGISTERED PE-JUNCTION MESH-METHOD EVIDENCE ONLY - NOT APPROVED FOR PROCUREMENT, QUOTATION, FABRICATION, ASSEMBLY, CONNECTION, POWERED TESTING, MOTION, OR ENERGIZATION**

R293 executes exactly one preregistered PE-junction method candidate. Exact CAD, target entities, mesh-size fields, and acceptance thresholds are byte-bound to the prior evidence. The only change is the linear optimizer sequence `Netgen` then `Relocate3D` before Tet10 conversion.

The result is a bounded mesh-method execution. Even an R279-C02 pass does not execute structural fields, establish convergence or capacity, close H02, or grant any work authority.
