amyleesterling/humanoid-robot/mechanical/analysis/hr-v0-j2-c07-pe-topology-prereg-p0.1/README.md

# HR-V0-J2-C07-PE-TOPOLOGY-PREREG-P0.1

**PRELIMINARY - PE-JUNCTION MESH-METHOD PREREGISTRATION ONLY - NOT APPROVED FOR PROCUREMENT, QUOTATION, FABRICATION, ASSEMBLY, CONNECTION, POWERED TESTING, MOTION, OR ENERGIZATION**

R293 freezes one PE-junction mesh-method candidate before execution. It preserves the exact R288 CAD partition, all R291 size fields and targets, and every acceptance threshold. The only method change is a pre-Tet10 linear optimizer sequence of `Netgen` followed by `Relocate3D`.

The one-run stop rule forbids result-dependent tuning. No mesh, structural solution, convergence study, capacity decision, or work authority is created here.
