amyleesterling/humanoid-robot/mechanical/analysis/hr-v0-j2-c07-pe-trimmed-facet-audit-p0.1/README.md

# HR-V0-J2-C07-PE-TRIMMED-FACET-AUDIT-P0.1

**PRELIMINARY - CORRECTED EXACT TRIMMED-FACE OWNERSHIP AUDIT ONLY - NOT APPROVED FOR PROCUREMENT, QUOTATION, FABRICATION, ASSEMBLY, CONNECTION, POWERED TESTING, MOTION, OR ENERGIZATION**

R311 corrects the earlier exact-face method by requiring both <=1e-7 mm underlying-surface distance and exact OCC trimmed-face containment for every quadratic-facet node. R308-R310 are superseded where they treated distance as sufficient containment evidence. No mesh or tolerance changed.
