amyleesterling/humanoid-robot/mechanical/analysis/hr-v0-j2-c07-pe-trimmed-facet-audit-prereg-p0.1/README.md

# HR-V0-J2-C07-PE-TRIMMED-FACET-AUDIT-PREREG-P0.1

**PRELIMINARY - CORRECTED EXACT TRIMMED-FACE AUDIT PREREGISTRATION ONLY - NOT APPROVED FOR PROCUREMENT, QUOTATION, FABRICATION, ASSEMBLY, CONNECTION, POWERED TESTING, MOTION, OR ENERGIZATION**

R311 preregisters a corrected exact trimmed-face audit after a read-only check disproved the R310 containment premise. No topology operation may execute until this full boundary audit is disposed.
