amyleesterling/humanoid-robot/mechanical/analysis/hr-v0-j2-c07-targeted-remesh-p0.1/README.md

# HR-V0-J2-C07-TARGETED-REMESH-P0.1

> **PRELIMINARY - TARGETED CURVED-MESH METHOD EVIDENCE ONLY - NOT APPROVED FOR PROCUREMENT, QUOTATION, FABRICATION, ASSEMBLY, CONNECTION, POWERED TESTING, MOTION, OR ENERGIZATION**

R285 applies bounded exact-OCC targeted refinement to the R284 V06 no-high-order-optimizer route and repeats it twice in fresh Python processes. Q4/Q6/Q8 are finite sampled-Jacobian screens, not a proof over each curved element or a structural solve. Exact B-Rep surface deviation, exact facet mapping, exact-zone clipped histograms, full-domain curved-Jacobian positivity, load-boundary preservation, R279-C02, H02, selection, capacity, safety and every work authority remain open.
