amyleesterling/humanoid-robot/mechanical/analysis/hr-v0-j2-curved-mesh-development-p0.1/README.md

# HR-V0-J2-CURVED-MESH-DEVELOPMENT-P0.1

> **PRELIMINARY - NUMERICAL MESH-METHOD DEVELOPMENT ONLY - NOT APPROVED FOR PROCUREMENT, QUOTATION, FABRICATION, ASSEMBLY, CONNECTION, POWERED TESTING, MOTION, OR ENERGIZATION**

R284 identifies V06 and a constrained-high-order alternate as bounded sampled-Jacobian method candidates. The non-monotonic V03/V06/V08 sequence is not convergence; R279-C02, H02 and every physical-work gate remain open.
