amyleesterling/humanoid-robot/mechanical/analysis/hr-v0-j2-exact-zone-submodel-architecture-p0.1/README.md

# HR-V0-J2-EXACT-ZONE-SUBMODEL-ARCH-P0.1

**PRELIMINARY - NUMERICAL METHOD PROTOTYPE ONLY - NOT APPROVED FOR PROCUREMENT, QUOTATION, FABRICATION, ASSEMBLY, CONNECTION, POWERED TESTING, MOTION, OR ENERGIZATION**

This isolated R283 package is an executable numerical-method architecture prototype. It proves SHA-bound STEP loading, exact OpenCASCADE edge-distance calls, retained B-Rep edge identities with owner-face/wire adjacency, exact section geometry, exact frozen-probe face binding, synthetic direct-quadrature arithmetic, and a fail-closed raw-run schema.

It does **not** execute production cell/facet clipping, a structural solve, submodel transfer, mesh convergence, section resultants, or H02 closure. The intended C07 pocket perimeter is retained as one ordered closed loop of four straight edges and four R2 corner arcs. The C06 INBOARD/OUTBOARD parameter convention and FRONT/BACK half-space sign remain open.

Run `tools/generate_hr_v0_j2_exact_zone_submodel_p01.py`, then `tools/check_hr_v0_j2_exact_zone_submodel_p01.py` in the repository CAD environment.
