amyleesterling/humanoid-robot/mechanical/analysis/hr-v0-j2-execution-architecture-p0.1/README.md

# HR-V0-J2-EXECUTION-ARCHITECTURE-P0.1

> **PRELIMINARY - NUMERICAL METHOD ARCHITECTURE ONLY - NOT APPROVED FOR PROCUREMENT, QUOTATION, FABRICATION, ASSEMBLY, CONNECTION, POWERED TESTING, MOTION, OR ENERGIZATION**

R283 publishes an accepted-for-development exact-zone/submodel execution architecture prototype and rejects the V04 curved-mesh route. H02 and every physical-work gate remain open.
