amyleesterling/humanoid-robot/mechanical/analysis/hr-v0-j2-numerical-backend-p0.1/README.md

# HR-V0-J2-NUMERICAL-BACKEND-P0.1

> **PRELIMINARY - NUMERICAL SOLVER FEASIBILITY ONLY - NOT APPROVED FOR PROCUREMENT, QUOTATION, FABRICATION, ASSEMBLY, CONNECTION, POWERED TESTING, MOTION, OR ENERGIZATION**

R281 establishes a bounded iterative P2 and C07 mesh-quality route for later R279 execution. It does not close H02 or supply capacity/work authority.
