amyleesterling/humanoid-robot/mechanical/analysis/hr-v0-j2-refinement-erratum-p0.1/README.md

# HR-V0-J2-REFINEMENT-ERRATUM-P0.1

> **PRELIMINARY - PROTOCOL CORRECTION AND NUMERICAL METHOD EVIDENCE ONLY - NOT APPROVED FOR PROCUREMENT, QUOTATION, FABRICATION, ASSEMBLY, CONNECTION, POWERED TESTING, MOTION, OR ENERGIZATION**

R282 corrects the R279 execution protocol and publishes bounded backend/curved-geometry prototypes. C07 curved Jacobians fail, so H02 remains open.
