amyleesterling/humanoid-robot/mechanical/analysis/hr-v0-j2-stop-access-well-fea-p0.1/README.md

# HR-V0-J2-STOP-ACCESS-WELL-FEA-P0.1

> **PRELIMINARY - NOT APPROVED FOR PROCUREMENT, QUOTATION, FABRICATION, ASSEMBLY, CONNECTION, POWERED TESTING, MOTION, OR ENERGIZATION**

R273 screens exact P0.12 C06/C07 with C07 restraint returned to the original A04 land. The result is not a joined-load or release analysis.
