amyleesterling/humanoid-robot/mechanical/analysis/hr-v0-j2-stop-bossed-p0.1/README.md

# HR-V0-J2-STOP-BOSSED-P0.1

> **PRELIMINARY - NOT APPROVED FOR PROCUREMENT, QUOTATION, FABRICATION, ASSEMBLY, CONNECTION, POWERED TESTING, MOTION, OR ENERGIZATION**

R270 corrects the J2 contact-force moment arm and binds an unselected integral-boss CAD candidate. The 4x result is an interim geometry rejection screen only. Twelve physical and qualified holds remain open.
