amyleesterling/humanoid-robot/mechanical/analysis/hr-v0-j2-stop-fea-p0.1/README.md

# HR-V0-J2-STOP-FEA-P0.1

> **PRELIMINARY - NOT APPROVED FOR PROCUREMENT, QUOTATION, FABRICATION, ASSEMBLY, CONNECTION, POWERED TESTING, MOTION, OR ENERGIZATION**

R271 records a reproducible linear-elastic full-part rejection screen of exact P0.10 C06. The model does not select P0.10 or release fabrication, motion or energization.
