amyleesterling/humanoid-robot/mechanical/analysis/hr-v0-j2-stop-pad-pocket-fea-p0.1/README.md

# HR-V0-J2-STOP-PAD-POCKET-FEA-P0.1

> **PRELIMINARY - NOT APPROVED FOR PROCUREMENT, QUOTATION, FABRICATION, ASSEMBLY, CONNECTION, POWERED TESTING, MOTION, OR ENERGIZATION**

R278 corrects the C06/C07 coordinate transforms and separately screens the P0.13 metal-perimeter and pocket-floor paths. All cases pass an internal linear geometry-rejection rule; no allowable, selection or work authority is released.
