amyleesterling/humanoid-robot/mechanical/analysis/hr-v0-j2-stop-refinement-execution-p0.1/README.md

# HR-V0-J2-STOP-REFINEMENT-EXECUTION-P0.1

> **PRELIMINARY - SCRATCH NUMERICAL EVIDENCE ONLY - NOT APPROVED FOR PROCUREMENT, QUOTATION, FABRICATION, ASSEMBLY, CONNECTION, POWERED TESTING, MOTION, OR ENERGIZATION**

R280 records exact P0.13 entity-tag/local-mesh feasibility, one bounded P1 diagnostic, a C07 quality rejection and two resource-limited P2 attempts. R278-H02 remains open.
