amyleesterling/humanoid-robot/mechanical/analysis/hr-v0-j2-stop-strength-p0.1/README.md

# HR-V0-J2-STOP-STRENGTH-P0.1

> **PRELIMINARY - NOT APPROVED FOR PROCUREMENT, QUOTATION, FABRICATION, ASSEMBLY, CONNECTION, POWERED TESTING, MOTION, OR ENERGIZATION**

R269 corrects the hidden perfect-load-sharing assumption in the P0.8 J2 stop screen. P0.9 remains an unselected geometry candidate pending all twelve holds.
