amyleesterling/humanoid-robot/mechanical/analysis/hr-v0-j2-targeted-remesh-disposition-p0.1/README.md

# HR-V0-J2-TARGETED-REMESH-DISPOSITION-P0.1

> **PRELIMINARY - TARGETED CURVED-MESH METHOD EVIDENCE ONLY - NOT APPROVED FOR PROCUREMENT, QUOTATION, FABRICATION, ASSEMBLY, CONNECTION, POWERED TESTING, MOTION, OR ENERGIZATION**

R285 freezes exact target features and demonstrates a three-run repeatable bounded sampled-Jacobian targeted mesh. Exact B-Rep/facet/load/full-domain/exact-zone/convergence evidence, R279-C02 and H02 remain open.
