amyleesterling/humanoid-robot/mechanical/analysis/hr-v0-property-propagation-p0.1/README.md

# HR-V0-PROP-PROPAGATION-P0.1

> **PRELIMINARY - NOT APPROVED FOR PROCUREMENT, FABRICATION, ASSEMBLY, CONNECTION, POWERED TESTING, MOTION, OR ENERGIZATION**

R249 prevents incomplete historical mass, torque, stop and impact screens from becoming release inputs. The six-row accepted-property compiler currently exits 78 because R248 is unexecuted. No downstream analysis is rebuilt or accepted.
