amyleesterling/humanoid-robot/mechanical/drawings/hr-v0-gdt-review-p0.1/README.md

# HR-V0-GDT-REVIEW-P0.1

> **PRELIMINARY - NOT APPROVED FOR PROCUREMENT, FABRICATION, ASSEMBLY, CONNECTION, POWERED TESTING, MOTION, OR ENERGIZATION**

Five functional datum schemes and twenty feature-control candidates are proposed for qualified review. No drawing geometry changes, formal release, physical evidence or work authority exists.
