amyleesterling/humanoid-robot/mechanical/drawings/hr-v0-gdt-review-p0.2/README.md

# HR-V0-GDT-REVIEW-P0.2

> **PRELIMINARY - NOT APPROVED FOR PROCUREMENT, FABRICATION, ASSEMBLY, CONNECTION, POWERED TESTING, MOTION, OR ENERGIZATION**

R268 removes the ambiguous `B/C as applicable` wording and proves that the prior Ø0.14 position proposal is not equivalent to the current ±0.05 coordinate zones. Current controls remain unchanged until functional stack analysis and qualified review.
