amyleesterling/humanoid-robot/mechanical/joints/hr-v0-a04-joint-p0.1/README.md

# HR-V0-A04-JOINT-P0.1

> **PRELIMINARY - NOT APPROVED FOR PROCUREMENT, QUOTATION, FABRICATION, ASSEMBLY, CONNECTION, POWERED TESTING, MOTION, OR ENERGIZATION**

R274 replaces unavailable dimensional placeholders at A04 with five exact supplier/tool candidates and a fail-closed stack, torque-preload, joined-load and proof evidence contract. No hardware is selected or authorized for purchase or use.
