amyleesterling/humanoid-robot/mechanical/metrology/hr-v0-first-shop-session-p0.1/README.md

# HR-V0-FIRST-SHOP-SESSION-P0.1

> **PRELIMINARY - NOT APPROVED FOR PROCUREMENT, FABRICATION, ASSEMBLY, CONNECTION, POWERED TESTING, MOTION, OR ENERGIZATION**

One controlled path from the blocked Lot A inquiry through receipt, quarantine and unpowered joint-stack metrology. All gates, questions, roles, evidence and results remain open.
