amyleesterling/humanoid-robot/mechanical/metrology/hr-v0-moving-properties-closure-p0.1/README.md

# HR-V0-MOVING-PROP-CLOSURE-P0.1

> **PRELIMINARY - NOT APPROVED FOR PROCUREMENT, FABRICATION, ASSEMBLY, CONNECTION, POWERED TESTING, MOTION, OR ENERGIZATION**

R248 defines the complete blank physical-evidence contract for all 17 moving-mass ledger rows, four assembly configurations, two-axis COM and calibrated bifilar inertia. It contains no physical result and does not close Sol B-010 or R247-H11.
