amyleesterling/humanoid-robot/mechanical/stops/hr-v0-j2-pad-pocket-p0.1/README.md

# HR-V0-J2-PAD-POCKET-P0.1

> **PRELIMINARY - NOT APPROVED FOR PROCUREMENT, QUOTATION, FABRICATION, ASSEMBLY, CONNECTION, POWERED TESTING, MOTION, OR ENERGIZATION**

R277 adds exact P0.13 bonded-pad pockets and a received-stack-dependent machining rule. The 0.520 mm CAD depth is visualization only. Rogers 2300327 and 3M 467MP remain unselected candidates; the pad receives zero structural credit and the surrounding metal stop remains mandatory.
