amyleesterling/humanoid-robot/mechanical/stops/hr-v0-j2-soft-contact-pad-p0.1/README.md

# HR-V0-J2-SOFT-CONTACT-PAD-P0.1

> **PRELIMINARY - NOT APPROVED FOR PROCUREMENT, QUOTATION, FABRICATION, ASSEMBLY, CONNECTION, POWERED TESTING, MOTION, OR ENERGIZATION**

R275 defines Rogers 2300327 only as an unselected sacrificial soft-contact pad ahead of the structural metal backup. It is not an energy-rated stop and carries no safety credit.
