amyleesterling/humanoid-robot/docs/hr-v0-arm-architecture-p0.8-dwg-integrated.md

# HR-V0 integrated arm architecture P0.8

> **PRELIMINARY - NOT APPROVED FOR PROCUREMENT, FABRICATION, ASSEMBLY, CONNECTION, POWERED TESTING, MOTION, OR ENERGIZATION.**

Identifier: `HR-V0-ARM-ARCH-P0.8-DWG-INTEGRATED-CANDIDATE`

Round: `R214`

## Result

The complete arm/column candidate now directly imports all five exact STEP identities from `HR-V0-MECH-BOM-BIND-P0.2`. The P0.7 transforms and nine interface records are unchanged. The successor generation reran the 40,001-pose collision sweep, 69-pair continuous-clearance certificate and J2 positive-stop analysis.

Four corrected parts encode nominal 11.30 mm × 2.90 mm, 90-degree countersinks. The 11.40 mm diameter and 3.10 mm depth remain separate conservative inspection/calculation screens. C05 is unchanged.

The model-space evidence reproduces first nominal body contact at 121.643289 degrees, the candidate 115-degree soft limit and the candidate 118-degree metal-stop target. This does not establish physical stopping distance, load capacity, fit, tolerance accumulation, cable/guard clearance or safety performance.

## Remaining release boundary

Twelve holds in `release/hr-v0/arm-architecture-p0.8-dwg-integrated/open-holds.csv` retain qualified review, DFM, MTR, FAI, received fit, fastener seating, mass/inertia, structural proof, physical stop proof, cables/guards, firmware binding and stage-specific written authority.

Passing repository checks does not authorize provider contact, procurement, fabrication, assembly, connection, powered testing, motion, or energization.
