amyleesterling/humanoid-robot/docs/hr-v0-j2-execution-architecture-p0.1.md

# HR-V0 J2 execution architecture P0.1

> **PRELIMINARY - NUMERICAL METHOD ARCHITECTURE ONLY - NOT APPROVED FOR PROCUREMENT, QUOTATION, FABRICATION, ASSEMBLY, CONNECTION, POWERED TESTING, MOTION, OR ENERGIZATION**

R283 freezes the exact C07 eight-edge perimeter, C06 root identities, gauge/probe definitions and raw-run evidence contract. The refined V04 curved mesh passes bounded SICN and determinant screens but is rejected because 897 of 8,999 corner correspondences exceed 1e-9 mm, with 0.0863831 mm maximum displacement. Production clipping, structural fields, submodel transfer, convergence, H02 and every physical gate remain open.

[Interactive R283 guide](../release/hr-v0/j2-execution-architecture-p0.1/index.html)
