amyleesterling/humanoid-robot/docs/hr-v0-atomic-requirements-p0.2.md

# HR-V0 internally audited atomic requirement candidates P0.2

**PRELIMINARY - NOT APPROVED FOR FABRICATION, CONNECTION, MOTION, OR ENERGIZATION**

Identifier: `HR-V0-REQ-ATOMIC-P0.2`

Round: R143

Date: 2026-08-09

R143 challenged R142's one-`shall` syntax screen and found 62 additional independently passable duties hidden inside child statements. Examples included cable versus connector inspections, RESET versus ARM outputs, separate inhibit/shutdown responses, and device-open versus register-write prohibitions.

P0.2 contains 458 draft child candidates across the same 66 parents. Existing P0.1 artifacts remain immutable historical evidence. P0.2 is a revised candidate register; changed statements and appended IDs are controlled by the product revision and have not been independently accepted.

Every child now carries a candidate PASS criterion and an exact blank result schema. `child-acceptance-record-template.csv` contains 458 unexecuted rows with configuration, procedure revision, observation, limit, result, evidence, executor, timestamp, reviewer and decision fields. The template is not evidence and cannot be bulk-promoted.

Eight holds remain open, including independent parent-coverage/atomicity acceptance, procedure integration, named qualified people, execution, downstream trace acceptance and formal baselining. `GOV-001` and Sol R12 N-004 remain open.
