amyleesterling/humanoid-robot/docs/reviews/2026-08-08-e2-hardware-p0.1-independent-review-request.md

# Project Button R79 independent engineering review request

**PRELIMINARY - REVIEW INPUT ONLY - NOT APPROVED FOR FABRICATION OR ENERGIZATION**

Date: 2026-08-08

Scope: Electrical `V3-P1.9` and `HR-V0-E2-HW-P0.1`

Please review accuracy and completeness, not presentation polish. Treat this repository as authoritative and the hosted website as presentation only. Do not treat clean ERC, DRC, generated HTML or repository checks as physical or safety validation.

## Focus questions

1. Does XT1's exact catalog group and `XT1-01` through `XT1-06` mapping agree across KiCad, BOM, connector schedule, wire table, physical-panel records and the E2 slice?
2. Is it correct to retain XT1 in the unresolved-interface register after freezing hardware and positions because conductors, protection, received compatibility, installation and point-to-point proof remain open?
3. Does the E2 slice unambiguously keep the 12 V actuator source, actuator branches, U2D2 power path and every actuator plug physically absent or disconnected?
4. Are K1/K2 correctly limited at E2 to coil and auxiliary/mirror-contact observation with load poles unsourced and unwired?
5. Do any installed/absent/DNP states conflict with Electrical V3-P1.9, `HR-V0-CP-P0.4`, `HR-V0-E2-SEQ-P0.1`, functional-safety allocation or gate records?
6. Are any hardware, terminal, conductor, protection, enclosure, firmware, instrument, authorization or physical-evidence prerequisites missing from the twelve holds?
7. Does any wording imply permission to procure, fabricate, wire, connect, energize or operate?

## Reproduction

```powershell
python tools/generate_hr_v0_electrical_v3.py --validate
python tools/check_hr_v0_electrical_v3.py
python tools/generate_hr_v0_e2_hardware_slice.py
python tools/check_hr_v0_e2_hardware_slice.py
python tools/check_hr_v0_control_panel.py
```

Please report `BLOCKER`, `MAJOR` and `MINOR` findings with exact file/row/reference/net evidence and current primary-source support. Do not mark the design approved or ready for energization.
