amyleesterling/humanoid-robot/hr30/whole-body-p0.1/safety-requirements-p0.1/README.md

# HR-30 whole-body safety requirements P0.1

**PRELIMINARY - SAFETY REQUIREMENTS CANDIDATE ONLY - NOT FUNCTIONALLY SAFETY VALIDATED - NOT APPROVED FOR CONNECTION, POWERED TESTING, MOTION, OR ENERGIZATION**

This package is the candidate SRS for the complete HR-30 P0.1 through the E0-E7 zero-motion first-energization ladder. It records no achieved PL, accepted risk, physical test, qualified approval or work authority. Open [index.html](index.html) for the readable guide.
