amyleesterling/humanoid-robot/electrical/kicad/hr-v0-dxl-star-p0.2-carrier-candidate/output/hr-v0-dxl-star-p0.2-carrier-candidate-bottom.png

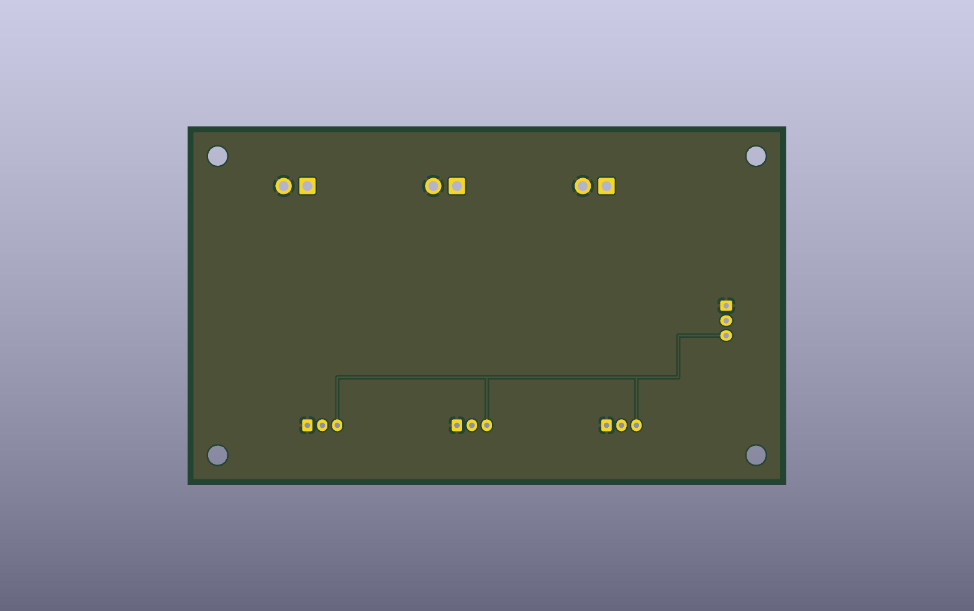
electrical/kicad/hr-v0-dxl-star-p0.2-carrier-candidate/output/hr-v0-dxl-star-p0.2-carrier-candidate-bottom.png
