amyleesterling/humanoid-robot/mechanical/analysis/hr-v0-j2-stop-fea-p0.1/mesh-convergence.png

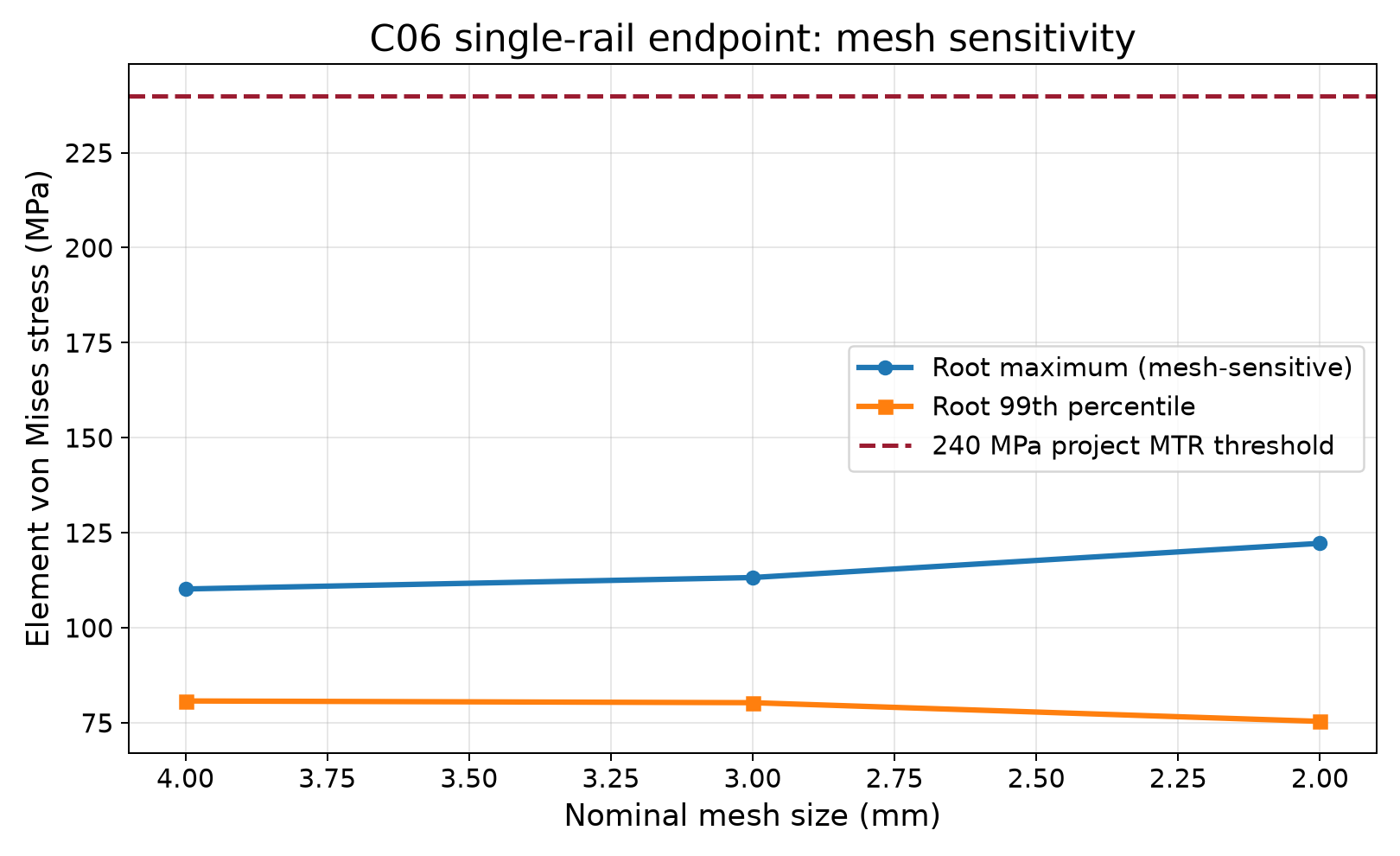
mechanical/analysis/hr-v0-j2-stop-fea-p0.1/mesh-convergence.png
