amyleesterling/humanoid-robot/release/hr-v0/dxl-protection-carrier-p0.1/output/hr-v0-dxl-protection-carrier-bottom.png

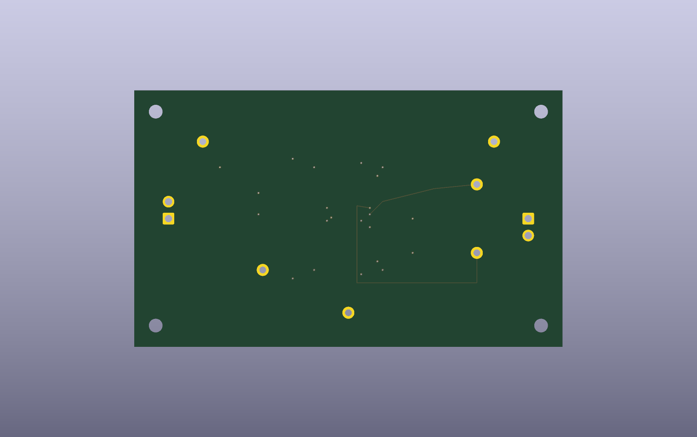
release/hr-v0/dxl-protection-carrier-p0.1/output/hr-v0-dxl-protection-carrier-bottom.png
