amyleesterling/humanoid-robot/bom/hr-v0-observation-bom-integration-p0.1/README.md

# HR-V0-OBS-BOM-INTEGRATION-P0.1

> **PRELIMINARY - NOT APPROVED FOR PROCUREMENT, FABRICATION, ASSEMBLY, CONNECTION, POWERED TESTING, MOTION, OR ENERGIZATION**

R259 adds BOM-099 through BOM-108 and binds four observation assemblies, exact connector/conductor candidates and two unresolved mounting-interface sets. Exact hardware, cable cuts, provider/process evidence, received articles, tests and qualified acceptance remain open.
