amyleesterling/humanoid-robot/hr30/whole-body-p0.1/fabrication-sourcing-p0.1/README.md

# HR-30 whole-body fabrication sourcing P0.1

PRELIMINARY - RFQ AND DFM CONVERSATION PACKAGE ONLY - NOT APPROVED FOR PROCUREMENT, FABRICATION, ASSEMBLY, POWERED TESTING, MOTION, OR ENERGIZATION

This package turns all **98** existing whole-body manufacturing candidates into a controlled **pre-RFQ/DFM conversation**. It does not release a drawing, material, tolerance, purchase order, fabrication operation, or powered work.

The key practical result is a complete part-to-route allocation: 45 flat profiles, 5 CNC/cut-drill metal parts, 20 machined polymer or elastomer candidates, 4 precision rods, and 24 nonstructural printed fit articles. Every row points to the controlled STEP plus any existing DXF/STL derivative and records the STEP SHA-256.

The public-stock screen is intentionally fail-closed. Only 0 of 45 planar candidates match the reviewed SendCutSend nominal stock values within 0.02 mm. Every other row says **DO NOT SUBSTITUTE**: use an exact-finished-thickness CNC quote or revise the authoritative CAD after engineering review.

Recommended sequence: request no-order DFM quotes from two qualified suppliers for each batch; visit or contact Artisans Asylum for local machining/fixture discussion; use The Hive or another trained shop only for nonstructural fit articles; reconcile written DFM; then release materials, tolerances, inspection and purchase documents through qualified review.
