amyleesterling/humanoid-robot/mechanical/analysis/hr-v0-j2-c07-constrained-high-order-p0.1/README.md

# HR-V0-J2-C07-CONSTRAINED-HIGH-ORDER-P0.1

> **PRELIMINARY - CONSTRAINED HIGH-ORDER MESH METHOD EVIDENCE ONLY - NOT APPROVED FOR PROCUREMENT, QUOTATION, FABRICATION, ASSEMBLY, CONNECTION, POWERED TESTING, MOTION, OR ENERGIZATION**

R284 demonstrates one bounded constrained-high-order C07 meshing route. HighOrder-optimized midsides are retained while all 8,999 linear corners are restored exactly. Linear SICN, connectivity/orientation, OCC corner membership and finite samples at Q4/Q6/Q8 curved/normalized determinant rules pass. These samples are not a proof over each full curved element and are not actual future structural quadrature unless that solver chooses the same rules. Corner restoration has not been revalidated against the exact B-Rep curved entities; exact facet mapping and surface deviation remain open. This is meshing-method evidence only: full R279-C02, H02, selection, safety, capacity and work authority remain open.
