amyleesterling/humanoid-robot/docs/hr-v0-mechanical-bom-binding-p0.2.md

# HR-V0 corrected mechanical custom-part/BOM binding P0.2

> **PRELIMINARY - NOT APPROVED FOR QUOTATION, FABRICATION, ASSEMBLY, MOTION, OR ENERGIZATION**

R213 issues `HR-V0-MECH-BOM-BIND-P0.2` and makes `HR-V0-ARM-ARCH-P0.8-DWG-CANDIDATE` the current **held design candidate** for BOM-027 custom-part review. It does not release a part for quotation or machining.

The five-row binding contains one each `MV0-C01`, `MV0-C04`, `MV0-C05`, `MV0-C06`, and `MV0-C07`. Four P0.8 STEP solids replace the P0.7 upper-limit countersink model with nominal 11.30 mm × 2.90 mm, 90° geometry. C05 is unchanged. Machine evidence records zero external bounding-box delta, unchanged controlled hole centers, five finished DXFs, five conventional drawings, 26 drawing-explicit controls, five ICF-01 registrations, and 30 unexecuted FAI operations.

P0.7 remains the controlled system transform/collision basis only because the corrected solids have identical external envelopes and controlled hole centers. It is historical for BOM-027 fabrication-geometry review.

Twelve holds remain open. Independent/qualified review, provider DFM, material/MTR, received fastener seating, all FAI, unpowered fit, stop/structural proof, mass properties, configuration acceptance, and physical evidence are absent. `EG-003`, `EG-005`, and `EG-006` remain partial.
