amyleesterling/humanoid-robot/bom/bom.csv

item_id | subsystem | manufacturer | manufacturer_part_number | quantity | baseline_status | selection_basis
BOM-001 | compute | Raspberry Pi | Raspberry Pi 5 8GB unit only; SC1112 | 1 | proposed | Exact current 8GB unit-only candidate from the Raspberry Pi configurator; receiving, cooling, storage/image, retention, runtime, thermal and application evidence remain open
BOM-002 | compute | Raspberry Pi | 27W USB-C Power Supply US Type A black; SC1158 | 1 | proposed | Exact current US Type-A black candidate from the Raspberry Pi configurator; received identity, site, cable retention, load/startup/brownout and thermal evidence remain open
BOM-003 | interface | ROBOTIS | U2D2; SKU 902-0132-000 | 1 | proposed | USB to DYNAMIXEL TTL/RS-485 interface; received USB connector revision and retained cable remain acceptance inputs
BOM-004 | interface | ROBOTIS | U2D2 Power Hub Board Set; SKU 902-0145-001 | 1 | dnp_development_only | Official maximum is 10.0 A versus 11.1 A summed actuator stall screen; prohibited from carrying operational HR-V0 actuator current
BOM-005 | shoulder | ROBOTIS | XM540-W270-T; SKU 902-0137-000 | 1 | proposed | 12 V TTL actuator; 10.6 N m stall at 12 V and 4.4 A; stall is not a continuous rating; verify received -T interface and model readback
BOM-006 | elbow | ROBOTIS | XM540-W270-T; SKU 902-0137-000 | 1 | proposed | Same controlled candidate as shoulder; final use gated by received inspection and thermal/current characterization
BOM-007 | gripper | ROBOTIS | XM430-W350-T; SKU 902-0124-000 | 1 | proposed | TTL actuator candidate for gripper architecture; verify received -T interface and model readback
BOM-008 | actuator_power | Mean Well | LRS-350-12 | 1 | legacy_v2.1_not_v3 | Retained only for V2.1 provenance; V3 removes project-built mains and proposes external GST280A12-C6P
BOM-009 | safety_power | Mean Well | HDR-30-24 | 1 | legacy_v2.1_not_v3 | Retained only for V2.1 provenance; V3 removes project-built mains; the historical GST40A24-P1J proposal was superseded by the current GlobTek factory-cord candidate
BOM-010 | safety_relay | Pilz | PNOZ s4 24 VDC 750104 | 2 | proposed | V3 uses separate SR1 RESET eligibility and SRA1 ARM/EDM stages; monitored falling-edge application review and physical tests remain required
BOM-011 | power_contactor | Schneider Electric | LC1D25BD | 2 | proposed | 24 VDC coil with integrated 1NO+1NC mirror/mechanically linked auxiliaries; MKTED210011EN Catalog 2026 shows 32 A at 24 V for LC1D25 with one to three poles in series, but the 11.1 A HR-V0 screen is below that table and triggers the catalog critical-current/support warning; exact 12 V regenerative duty, protection coordination, loaded interruption and qualified review remain required
BOM-012 | emergency_stop | IDEC | XW1E-BV402M-R | 1 | selection_required | Exact dual-NC candidate recorded; received bottom-view block identity continuity terminal mapping panel fit and qualified review required before selection
BOM-013 | watchdog_controller | Raspberry Pi | Raspberry Pi Pico 1; order SC0915; RP2040 | 1 | proposed | Independent heartbeat monitor candidate; exact GPIO firmware and failure analysis open; not safety-rated
BOM-014 | watchdog_relay | Phoenix Contact | PLC-RSC-24DC/21-21; item 2967060 | 2 | proposed | Two independently driven ordinary relay candidates; official terminal drawing received mapping DC application and common-cause review required; no PL/SIL credit
BOM-015 | branch_protection | Littelfuse | ATOF 287 Series exact ampere order codes SELECTION REQUIRED | 4 | selection_required | F0 through F3 use the proposed ATOF family only; no ampere value is released. Selection requires source fault current cable connector inrush regeneration duty ambient bundling time-current interrupting and jurisdiction evidence
BOM-016 | frame | Generic | 6061-T6 aluminum plate and spacers | 1 | superseded | Replaced by controlled MV0-001 through MV0-004 rows; retained for history
BOM-017 | guard | Selection required | Tool-removable fixed enclosure panels and support frame | 1 | design_required | Preliminary 900 x 400 x 950 mm internal space and 6 mm panel geometry are planning values only; exact material grade thickness frame fasteners support spacing impact retention access probe and service method require sweep/stop/drop evidence
BOM-018 | gripper_mechanics | ROBOTIS | OpenMANIPULATOR-X Frame Set RM-X52; SKU 905-0023-000 | 1 | proposed | Orderable parent kit for the allocated gripper mechanism subset in bom/hr-v0-gripper-kit-contents.csv; R108 rejects FR12-G101GM as a sole substitute because its published frame-set scope does not establish the complete mechanism; FR12-H104K fit guard pads exact fasteners measured mass grip-force characterization and received inspection remain release blockers
BOM-019 | safety_output_fuse_holder | Phoenix Contact | PT 4-HESI (5X20), item 3211861 | 2 | exact_candidate_hold | Exact non-LED 5 x 20 mm DIN fuse-terminal holder candidate only; fuse links conductors ferrules grouping loss source/coil behavior coordination received evidence and qualified review remain SELECTION REQUIRED
BOM-020 | coil_suppression | Schneider Electric | Integrated in LC1D25BD BD coil | 2 | integrated_candidate | BD coil includes bidirectional peak-limiting diode; do not add an assumed external suppression network; validate received coil dropout and stopping time
BOM-021 | shoulder_output_frame | ROBOTIS | FR13-H101K Set; SKU 903-0270-300 | 1 | proposed | Manufacturer STEP/PDF controlled locally; expected kit contents in bom/hr-v0-frame-kit-contents.csv; PCD22 fit output stack fasteners proof and received inspection required
BOM-022 | elbow_output_frame | ROBOTIS | FR13-H101K Set; SKU 903-0270-300 | 1 | proposed | Manufacturer STEP/PDF controlled locally; expected kit contents in bom/hr-v0-frame-kit-contents.csv; PCD22 fit output stack fasteners proof and received inspection required
BOM-023 | actuator_body_frames | ROBOTIS | FR13-S102K Set; SKU 903-0269-300 | 2 | evaluation_candidate | R69 exact architecture uses two S102 sets with corrected XM540 registration; evaluation purchase requires program-owner approval and received contents fit tool access fastener allocation load proof and qualified application release remain required
BOM-024 | frame_extrusion | 80/20 Inc. | 40-4040 40 Series T-Slot | 5 | exact_candidate_hold | Two 500 mm longitudinal rails two 240 mm transverse rails and one 500 mm column produce the candidate 500 x 320 mm square-cut outside frame without positive-volume member overlap; supplier quote receiving inspection joint proof and application release remain required
BOM-025 | frame_gussets | 80/20 Inc. | 40-4332 | 6 | exact_candidate_hold | Exact candidate allocation is four vertical-ridge base-corner brackets plus two opposed Y-face column brackets; manufacturer suggests two 75-3422 bolt assemblies per bracket; received fit tool access actual-joint torque slip proof and qualified mechanical acceptance remain required
BOM-026 | arm_link_stock | 80/20 Inc. | 20-2040 profile with 20-7047 two-hole M5 x 0.8 end-tap service | 2 | exact_candidate_hold | R57 candidate cut lengths are 100 mm and 50 mm with the 40 mm section vertical; supplier end-service confirmation cut tolerance end squareness finish receiving inspection interface proof and qualified release remain required
BOM-027 | arm_adapters | Custom CNC / provider SELECTION REQUIRED | HR-V0-ARM-ARCH-P0.8-DWG-CANDIDATE held custom set: MV0-C01/C04/C05/C06/C07 x1 each; 6061-T651 9.525 mm nominal candidate | 5 | exact_candidate_hold | R213 replaces the P0.7 custom-part manufacturing identities with the corrected P0.8 drawing candidate: four nominal 11.30 mm x 2.90 mm 90 degree countersink STEP solids, unchanged C05, five finished DXFs, five conventional drawings, 26 drawing-explicit controls and 30 unexecuted FAI operations. Twelve P0.2 holds remain open; no provider contact, quote, purchase, fabrication, assembly, motion or energization authority.
BOM-028 | bench_anchors | Custom | MV0-004 | 2 | design_required | Geometry exists; bench fastener and substrate evidence remain selection required
BOM-029 | reset_control | IDEC | HW1B-M1F10-B | 1 | proposed | Exact black momentary 1NO operator frozen from current IDEC primary evidence; explicit RESET legend panel spacing guarding received terminal mapping continuity and human-factors review remain open; RESET has no motion authority
BOM-030 | arm_control | IDEC | HW1B-M1F10-G | 1 | proposed | Exact green momentary 1NO operator frozen from current IDEC primary evidence to differ from black RESET; explicit ARM legend panel spacing guarding received terminal mapping continuity and human-factors review remain open
BOM-031 | actuator_power_v3 | Mean Well | GST280A12-C6P | 1 | proposed | External 12 V 21 A candidate; source application reverse-current regeneration fault coordination mating harness and received tests remain open
BOM-032 | safety_power_v3 | GlobTek | WR9QI1660YL4NKITR6B | 1 | proposed | Exact 24 V 1.66 A 40 W Class II wall-adapter candidate with factory YL4/C40337 locking output cord and Q blade kit; received plug identity/fit blade retention load startup branch protection site application and physical tests remain open
BOM-033 | actuator_source_mating | Molex | 39012066 housing; 6x 444783112 HCS male contacts | 1 | proposed | Project-side connector system frozen for 16 AWG with tool 63819-0900; exact wire order code/length distribution strain relief source-side contact construction unequal current sharing crimp pull retention polarity and stabilized thermal evidence remain open
BOM-034 | safety_source_interface | Kycon | KPJX-PM-4S | 1 | proposed | Exact panel-jack candidate for the GlobTek YL4/KPPX-4P-or-equal output cord; received plug identity fit pin-view continuity polarity PCB/harness panel mounting retention strain relief touch protection and thermal evidence remain open
BOM-035 | actuator_injection | Integrated function | Integrated in BOM-051 DXL-STAR-P0.2-CARRIER-CANDIDATE; no separate item | 1 | integrated_candidate | R163 reconciles the carrier-aware configuration: current Electrical V3-P1.15 contains one INJ1 and native DXL-STAR-P0.2 implements all three limited-postcarrier VDD branches on parent BOM-051. No separate injection-module purchase is required. BOM-051 current manufacturing data, BOM-087 carrier PCBAs, BOM-088/BOM-089 harnesses, BOM-090/BOM-091 mounting hardware, connectors, protection, waveform, no-backfeed, grounding, thermal, physical and qualified-review evidence remain open; no fabrication, assembly, connection, motion or energization is authorized.
BOM-036 | watchdog_driver | Texas Instruments | TPL7407LPWR | 2 | proposed | Two physically separate 40 V seven-channel packages; only OUT1 used per package; unused inputs tied low and unused outputs open; exact PCB COM bypass slew clamp polarity thermal brownout fault and HIL evidence required
BOM-037 | watchdog_supply | TRACO POWER | TSR 1-2450 | 1 | proposed | Exact non-isolated pinout frozen; branch protection load budget startup brownout output-fault EMC enclosed-thermal and received-unit evidence remain open
BOM-038 | heartbeat_interface | Vishay / Panasonic | VO618A-4X017T with ERJ6ENF9100V 910 ohm input resistor and ERJ6ENF1002V 10 kilohm pullup | 1 | proposed | Ordinary optical signal interface only; exact PCB creepage clearance GPIO level LED current leakage edge timing power-sequence EMC open-short fault and HIL evidence required; no safety credit
BOM-039 | control_terminals | Phoenix Contact | XT1: 3209510 x5; 3209523 x1; 3030417 x1; NO JUMPERS | 1 | exact_candidate_hold | R168 freezes six feed-through bodies, the end cover, color/position mapping and controlled absence of jumpers. Two 3022218 restraints are allocated from BOM-085 and marker stock/text/process remain under BOM-062; do not duplicate them here. Conductors, insulation, gauge/color/length, direct-wire/ferrule method, tool/die, strip process, current/temperature/protection coordination, grounding, received identity, labels, rail retention, point-to-point evidence and qualified review remain SELECTION REQUIRED. No procurement, assembly, wiring or energization authority.
BOM-040 | bonding_interface | Selection required | Frame and cable-shield termination system | 1 | selection_required | Exact implementation awaits EMC and parallel-path review against GST280A internal output-to-PE bond
BOM-041 | safe_indicator | IDEC | HW1P-1FQD-A-24V | 1 | proposed | Exact amber 22 mm round-flush 24 VAC/DC screw-terminal pilot-light candidate; label RESET STAGE READY - DIAGNOSTIC ONLY / NO MOTION AUTHORITY; execute HR-V0-H1-RCV-P0.1 for received terminal/internal-circuit/polarity/current/brightness/mounting/human-factors evidence; no safety credit or procurement/wiring release
BOM-042 | service_disconnect | Littelfuse | 75920-01 70 V DC SPST master disconnect with On/Off markings and yellow knob | 1 | exact_candidate_hold | Exact active catalog candidate only; high-side SPST topology matches the positive-only schematic and OFF-position padlock feature is documented. Conductor/lug system, source/load designation, fault/load-break duty, rear touch protection, received geometry, placement, zero-energy verification, human factors, Boston application review and physical tests remain required
BOM-043 | watchdog_feedback_interface | Texas Instruments / Vishay / Panasonic / TDK / Murata | ISO1212DBQ dual-channel 24 V feedback receiver assembly with exact proposed passive order codes | 1 | proposed | V3-P1.0 retains MMA02040C1001FB300 ERJ6ENF5620V CGA3E2X7R1H103K080AA CRCW12102K70FKEA GRM21BR71H104KA01L ERJ6ENF1001V and ERJ6ENF1002V; routed PCB derating received measurements EMC fault injection HIL and qualified review remain required
BOM-044 | receiver_catch | Selection required | Fixed payload receiver nests and catch tray assembly | 1 | design_required | Preliminary 820 x 320 x 50 mm catch space only; exact nest positions material thickness support fasteners rebound/slide limits and drop-test configuration remain SELECTION REQUIRED
BOM-045 | moving_harness_mechanical | Selection required | Moving cable clamps service loops abrasion protection and strain relief | 1 | design_required | Five controlled route zones exist; exact cable connector bundle diameter bend/twist/tension limits clamps flex life and mass allocation remain SELECTION REQUIRED
BOM-046 | watchdog_pcb_terminals | Phoenix Contact | MKDS 1/4-3,5 item 1751264 | 1 | proposed | JWP1 project pin allocation frozen in V3-P1.0; official drawing land pattern received orientation conductor ferrule torque harness protection temperature and application evidence remain open
BOM-047 | watchdog_pcb_terminals | Phoenix Contact | MKDS 1/2-3,5 item 1751248 | 2 | proposed | JWF1/JWH1 project pin allocations frozen in V3-P1.0; official drawing land pattern received orientation conductor ferrule torque harness retention EMC and application evidence remain open
BOM-048 | watchdog_pcb | Custom PCB / provider SELECTION REQUIRED | Project Button watchdog PCB PCB-P1.0 / Electrical V3-P1.15 direct-bound; assembly data HR-V0-WD-PCBA-DATA-P0.2 | 1 | exact_candidate_hold | R195 directly binds the native PCB-P1.0 board-title identity to Electrical V3-P1.15 and refreshes source-bound HR-V0-WD-CAM-P0.2 review outputs: 10 Gerber/job files, 5 drill/map/report files, IPC-D-356, board statistics, native DRC 0, and exact 42-reference internal position parity. Copper, topology, placement and native assembly fields are unchanged from PCB-P0.9. The CAM set is quarantined and not supplier-released; supplier-normalized XYRS, provider, process, stackup, material, copper, finish, mask, legend, tolerances, panelization, electrical test, DFM, first article, physical, HIL, EMC, thermal, and qualified-review evidence remain SELECTION REQUIRED; HR-V0-WD-CAM-P0.1 and historical PCB-P0.5 CAM are prohibited for supplier use; no contact, upload, quotation, fabrication, assembly, connection, motion, energization, or safety credit is authorized.
BOM-049 | main_fuse_holder | Littelfuse | FHAC0002SXJ | 1 | proposed | Exact 32 V heavy-duty inline ATO holder candidate with 12 AWG GXL pigtails and 30 A holder maximum; fuse rating 12-to-16 AWG transition splice strain relief mounting and installed thermal evidence remain SELECTION REQUIRED
BOM-050 | branch_fuse_block | Blue Sea Systems | 5025 | 1 | proposed | Exact six-circuit ST Blade block candidate with negative bus and cover; 32 VDC 30 A/circuit and 100 A/block product maxima are not branch selections; terminals conductors mounting unused positions cover access and thermal evidence remain open
BOM-051 | actuator_injection_pcb | Custom PCB / provider SELECTION REQUIRED | DXL-STAR-P0.2-CARRIER-CANDIDATE; manufacturing review HR-V0-DXL-STAR-MFG-P0.2 | 1 | exact_candidate_hold | R164 source-binds the carrier-aware P0.2 native board to quarantined internal CAM: 10 Gerber/job files, 5 drill/map/report files, IPC-D-356, native DRC 0, exact seven-connector placement parity, eighteen terminal mappings and four NPTH records. The R151 P0.1 CAM remains historical and may not fabricate P0.2. The P0.2 CAM is not supplier-released; provider/process, supplier-normalized XYRS, material/stackup/finish/tolerances, DFM, first article, connector/current, harness, protection, waveform, no-backfeed, return/PE/shield, thermal/load, physical, HIL, EMC and qualified-review evidence remain open; no contact, upload, quotation, fabrication, assembly, connection, motion, energization or safety credit is authorized.
BOM-052 | actuator_injection_header | JST | B3B-EH-A | 4 | proposed | One controller and three actuator headers; 2.5 mm EH family 3 A AWG22 series basis does not resolve the XM540 4.4 A stall-current conflict
BOM-053 | actuator_power_header | JST | B2P-VH | 3 | proposed | Three branch-power board headers; exact mating contacts depend on selected conductor and application evidence
BOM-054 | actuator_signal_housing | JST | EHR-3 | 2 | proposed | Two EHR-3 housings are controlled internal content of BOM-061. R262 makes JST/GAM custom assembly the primary unsent inquiry route; separate housing purchase is prohibited if that route is later accepted. Provider part/drawing, received identity, population, retention and physical evidence remain open.
BOM-055 | actuator_signal_contact | JST | SEH-001T-P0.6 | 4 | proposed | Four SEH-001T-P0.6 contacts are controlled internal content of BOM-061 cavities 1 and 3. R262 makes manufacturer-controlled termination the primary unsent inquiry route; separate contact/tool purchase is prohibited if accepted. Exact wire/process compatibility, crimp conformity, pull/section evidence, retention and received inspection remain open.
BOM-056 | actuator_power_housing | JST | VHR-2N | 9 | proposed | R263 corrects the minimum populated quantity to nine VHR-2N housings: three carrier-input ends plus both ends of three carrier-output harnesses. Process spares, receiving, assembly process, retention, thermal and procurement authority remain open.
BOM-057 | actuator_power_contact | JST | SVH-21T-P1.1 | 18 plus process scrap SELECTION REQUIRED | proposed | R263 corrects the minimum populated quantity to eighteen SVH-21T-P1.1 contacts for nine two-cavity housings. Exact process scrap, tooling, crimp geometry, pull/inspection, receiving, thermal and procurement authority remain open.
BOM-058 | control_enclosure | Hammond Manufacturing | PJ302410RT enclosure plus 18P2721 white-steel inner panel | 1 | exact_candidate_hold | Exact enlarged catalog-candidate pair adopted by HR-V0-CP-P0.6 after the smaller P0.5 panel could not honestly contain the compute installation; received fit mounting cable entries ventilation thermal rise bonding separation and qualified enclosure-system evidence remain open
BOM-059 | panel_mounting_residual | Selection required | Backplate mounting fasteners DR4 end retention rail/duct fasteners and protective-bonding hardware | 1 | selection_required | R123 separates exact held rail duct and DR1-DR3 end-bracket candidates into BOM-083 through BOM-085. Exact backplate fasteners DR4 end retention rail/duct fasteners hole patterns coating preparation bonding hardware torque loads and qualified installation evidence remain SELECTION REQUIRED
BOM-060 | stationary_control_wire | Selection required | Stationary 24 V control and actuator-power conductors | 1 | selection_required | Every conductor requires exact manufacturer order code insulation temperature voltage stranding color gauge length termination bundling and routing evidence
BOM-061 | controller_signal_harness | Project-controlled custom / JST / Belden | HR-V0-U2D2-JC1-HARNESS-P0.1; 2 x EHR-3; 4 x SEH-001T-P0.6; 500 +/- 5 mm finished; 3051 BK005 GND + 3051 WH005 DATA; cavity 2 empty both ends | 1 | exact_candidate_hold | Exact data/reference-only candidate: U2D2 1 GND to JC1.1 CTRL_GND, 2 empty with no contact or conductor to JC1.2 NO_NET_NO_COPPER, 3 DATA to JC1.3 DXL_DATA. Finished length and twist lay are candidates only; raw cuts, official crimp limits, received route, pull/continuity/isolation/no-backfeed/waveform evidence and qualified release remain open. R262 adds a deterministic UNSENT JST/GAM custom-assembly RFQ and rejects catalog 304.8 mm single leads as the complete harness. Provider part/drawing, response, quote, process evidence, first article, purchase decision and every physical/system result remain open. R262 adds a deterministic UNSENT JST/GAM custom-assembly RFQ and rejects catalog 304.8 mm single leads as the complete harness. Provider part/drawing, response, quote, process evidence, first article, purchase decision and every physical/system result remain open.
BOM-062 | panel_identification | Phoenix Contact | 0828734 UCT-TM 5; 0830839 US-EMLP 17.5X15; 0828805 US-EMLP 60X30 | 1 | exact_candidate_hold | R169 freezes exact candidate material stocks and controlled text for six XT1 position markers, thirty device references, four operator legends and four large status/configuration legends. Configured material is one card of each, but manufacturer pack/minimum-order quantities are not installed quantities or purchase authority. Printer or marking service, consumables, approved artwork, placement, substrate preparation, adhesion, durability, received/as-built evidence, true two-end wire-marker stock/sleeves/schedule, Boston/US code-required markings and qualified review remain SELECTION REQUIRED. No procurement, printing, installation, wiring or energization authority.
BOM-063 | ac_input_cords | Eaton Tripp Lite series | P006-006; NEMA 5-15P to IEC C13; 10 A 125 VAC; 18 AWG; 6 ft; black | 1 | proposed | R147 freezes the current UL/cUL P006-006 catalog candidate for Boston/US evaluation against the GST280A12-C6P Class-I C14 inlet. Exact premises branch protection makerspace policy code applicability received identity C13/C14 fit PE continuity route retention 95 A catalog inrush temperature abnormal behavior and qualified electrical acceptance remain open; no purchase connection or energization authority
BOM-064 | compute_storage | Kingston Technology | SDCIT2/64GBSP | 1 | exact_candidate_hold | R170 freezes the exact 64 GB card-only industrial microSD candidate from Kingston's current primary datasheet. Family pSLC-mode TLC 30K P/E power-failure protection wear-levelling ECC and health-monitoring statements are not Project Button validation; approved seller receiving identity 64 GB endurance allocation Pi 5 compatibility imaging filesystem abrupt-loss recovery retention current thermal and qualified-review evidence remain open
BOM-065 | bench_anchoring | Selection required | Bench-specific anchors bolts washers backing plates and retention | 1 | design_required | Exact hardware depends on surveyed bench substrate thickness edge distance permission and pull-out/shear proof
BOM-066 | structural_fasteners | Selection required | Project-added frame link adapter stop and gripper fastener/retention set | 1 | design_required | R274 defines McMaster 91290A303/98688A148/90576A161 and Wiha 36852/26060 as unselected A04 exact supplier/tool candidates; current quote lot certificates received tolerance torque-preload joined-load fit proof qualified acceptance and all other structural fasteners remain SELECTION REQUIRED
BOM-067 | cable_entry_and_strain_relief | Selection required | Cable glands bushings clamps and enclosure strain-relief hardware | 1 | design_required | Exact order codes depend on released cable diameters enclosure wall thickness bend radius pull load EMC and ingress strategy
BOM-068 | guard_access_hardware | Selection required | Tool-removable guard panel fasteners supports and captive access hardware | 1 | design_required | Exact hardware and spacing depend on released guard material impact/retention proof access-probe results and service method
BOM-069 | wire_termination_materials | Selection required | Ferrules lugs splices heat-shrink markers and insulating boots | 1 | selection_required | Every termination requires exact order code compatible conductor terminal tool strip length inspection and pull-test acceptance
BOM-070 | compute_interface_cable | StarTech.com | USB2AC50CM | 1 | exact_candidate_hold | Exact 0.5 m straight USB-A-to-USB-C USB 2.0 candidate; current official datasheet states 480 Mbps 3.5 mm OD 22/30 AWG PVC jacket and aluminum-mylar foil with braid shield. Received identity host/U2D2 fit bend/retention pull/slip abrasion enumeration waveform common-mode no-backfeed power-sequencing EMC thermal and qualified application evidence remain open; cable operating environment must remain within the published 0 to 35 C range
BOM-071 | frame_joint_hardware | 80/20 Inc. | 75-3422 | 12 | exact_candidate_hold | Two M8 x 16 BHSCS plus economy T-nut assemblies per 40-4332 bracket; 13 to 20 N m is a manufacturer guide only and actual-joint torque proof receiving inspection reuse rule and witness marking remain required
BOM-072 | safety_output_fuse_links | Selection required | Two 5 x 20 mm fuse links for FSR1 and FSR2 | 2 | selection_required | Exact manufacturer family ampere rating speed voltage interrupting rating power loss temperature derating and order codes require received WR9QI1660YL4NKITR6B/LC1D25BD behavior conductor ambient grouping time-current clearing evidence and qualified review
BOM-073 | safety_output_fuse_end_cover | Phoenix Contact | D-ST 4, item 3030420 | 1 | exact_candidate_hold | Exact 2.2 mm-wide end-cover candidate for the open side of the proposed 3211861 holder group; received compatibility orientation grouping fit and qualified application evidence remain required
BOM-074 | guard_frame_profile | 80/20 Inc. | 20-2020 custom length | 16 | exact_candidate_hold | Exact 6063-T6 clear-anodized 20 x 20 mm catalog profile candidate with four open T-slots; quantities and cut lengths follow HR-V0-GUARD-P0.3; written configuration received length/squareness identity joint calculation anchors and proof remain required
BOM-075 | guard_frame_brackets | 80/20 Inc. | 14201 | 20 | exact_candidate_hold | Exact 20 Series dual-support inside-corner bracket candidate for the twenty modeled rail/post joints; published page gives geometry and suggested hardware but no project allowable; orientation access load torque fit slip and proof remain required
BOM-076 | guard_frame_joint_hardware | 80/20 Inc. | 75-3581 | 40 | exact_candidate_hold | Two manufacturer-suggested M5 x 8 BHSCS plus slide-in economy T-nut assemblies per 14201 joint; received identity torque locking reuse witness marking slip and proof remain required
BOM-077 | guard_transparent_sheet | Plaskolite | TUFFAK GP clear nominal 6 mm; supplier SKU SELECTION REQUIRED | 13 | exact_candidate_hold | Exact manufacturer grade and nominal thickness candidate for eight outer panels plus five receiver pieces; PDS004 122022 values are typical and not specification values; supplier SKU stock thickness tolerance edge retention impact flame suitability and proof remain required
BOM-078 | guard_panel_retainers | 80/20 Inc. | 12004 with nominal 3 mm outer-panel branch; 11 x 2 m stock screen; 20-2496 EXCLUDED | 1 | selection_required | HR-V0-GUARD-RET-P0.1 excludes the drill-through 20-2496 route and records 12004 only as an exact continuous-gasket evaluation candidate for nominal 3 mm outer panels; impact energy retention allowable final sheet dimensions temperature fit received proof and qualified selection remain required
BOM-079 | compute_cooling | Raspberry Pi | SC1148 | 1 | exact_candidate_hold | Raspberry Pi Active Cooler for Raspberry Pi 5 exact candidate; received identity push pins thermal pads fan connector installed current airflow clearance thermal fault enclosure and qualified application evidence remain required
BOM-080 | compute_subenclosure | Waveshare | PI5-CASE-D; SKU 26087 | 1 | exact_candidate_hold | Exact metal Raspberry Pi 5 case and included 35 mm rail-bracket candidate; official Active Cooler compatibility is published but received identity hardware thread and length rail retention coating grounding EMC clearance airflow service and thermal evidence remain required
BOM-081 | compute_device_retention | HellermannTyton | GTM500C2; article 130-95000 | 3 | exact_candidate_hold | Exact nonadhesive screw-mount hook-and-loop bases proposed for one U2D2 body and two cable-service-loop positions; exact panel fasteners torque rigid-device retention abrasion pull vibration flame application and received fit remain open
BOM-082 | compute_device_retention_straps | HellermannTyton | GT.50X80C2; article 854-44353 | 3 | exact_candidate_hold | Exact 203.2 x 12.7 mm black releasable Grip Tie candidates paired with BOM-081; manufacturer publishes cable-bundling use rather than rigid U2D2 retention so compression slip abrasion pull vibration service-life and qualified application evidence remain open
BOM-083 | panel_din_rail | Phoenix Contact | NS 35/7,5 UNPERF 500MM; item 1207648 | 2 | exact_candidate_hold | Two exact 500 mm unperforated EN 60715 steel rail candidates cover planning segments DR1 323.8 mm DR3 65 mm on RAIL-A and DR2 153.8 mm DR4 100 mm plus R223 DR5 160 mm on RAIL-B. RAIL-B retains 86.2 mm before kerf. All lengths remain planning values; received stock cut kerf hole pattern drilling deburr coating damage fasteners bonding load retention inspection and qualified release remain open. Application quantity is not a manufacturer pack/order quantity
BOM-084 | panel_wire_duct | Phoenix Contact | CD 40X40; item 3240189 | 1 | exact_candidate_hold | One exact 2000 mm 40 x 40 mm PVC duct candidate comprising upper part and mounting base covers WD1 665.8 mm WD2 665.8 mm WD3 323.8 mm and R223 WD4 323.8 mm with 20.8 mm remaining before kerf. Exact cut lengths kerf tolerance damage allowance fill routing separation cover access fasteners thermal behavior received inspection and qualified release remain open. Application quantity is not a manufacturer pack/order quantity
BOM-085 | panel_rail_end_brackets | Phoenix Contact | CLIPFIX 35; item 3022218 | 8 | exact_candidate_hold | Two exact NS 35/7.5-compatible end-bracket candidates each for DR1 DR2 DR3 and R223 DR5. DR4 is deliberately excluded because the 100 mm planning rail and 90.5 mm case envelope do not establish room or compatibility for two 9.5 mm brackets; its end retention remains in BOM-059. Received fit installed retention load vibration service access and qualified release remain open; application quantity is not a manufacturer pack/order quantity
BOM-086 | actuator_branch_cables | Integrated ROBOTIS package content | Robot Cable-X3P 180mm JST-JST, one included in each BOM-005/BOM-006/BOM-007 actuator package; standalone 10-pack reference SKU 903-0249-000 | 3 | integrated_candidate | R153 records three assembled branch cables as included package content with no separate purchase. Current official XM540/XM430 pages each list one 180 mm JST-JST X3P cable; the standalone 10-pack page identifies SKU 903-0249-000. Received identity, pin orientation, continuity, factory conductor construction, routing, bend/strain relief, connector retention, the JST EH 3 A versus XM540 4.4 A stall-current conflict, thermal, waveform, fault and qualified application evidence remain open; no connection or energization is authorized
BOM-087 | actuator_branch_current_limiter_pcba | Custom PCB / provider SELECTION REQUIRED | HR-V0-DXL-PROT-CARRIER-P0.3; two J1/J2 1.65 kOhm ILM variants plus one G1 3.32 kOhm ILM variant | 3 | exact_candidate_hold | R159 source-controls the routed four-layer P0.3 carrier and exact variant populations. R161 inserts three carrier interfaces between fused-prelimit and limited-postcarrier nets. Provider/process, PCB stack/material/finish, assembler DFM, first article, current-limit tolerance, reverse-energy, transient, thermal, fault, EMC, received inspection and qualified application evidence remain open; no upload, quotation, fabrication, assembly, connection or energization is authorized
BOM-088 | actuator_branch_carrier_input_harness | Custom harness / exact candidates on hold | HAR-CIN-J1 / HAR-CIN-J2 / HAR-CIN-G1; PN18-8R-E to VHR-2N/SVH-21T-P1.1 on Belden 9918; cuts SELECTION REQUIRED | 3 | design_required | R263 defines three input harnesses and advances both 5025 source conductors to Panduit PN18-8R-E #8 ring-terminal candidates. Physical positive/return screw positions, received one-ring-per-screw fit, cut lengths, both termination processes, route, thermal/fault evidence, qualified review and authority remain open.
BOM-089 | actuator_branch_carrier_output_harness | Custom harness / exact candidates on hold | HAR-COUT-J1 / HAR-COUT-J2 / HAR-COUT-G1; VHR-2N/SVH-21T-P1.1 both ends on Belden 9918; cuts SELECTION REQUIRED | 3 | design_required | R263 defines three output harnesses with exact candidate populations at carrier JOUT1 and DXL-star JP1/JP2/JP3. Exact cuts, JST process, route, retention, thermal/fault evidence, qualified review and authority remain open.
BOM-090 | actuator_branch_carrier_standoffs | Essentra Components | TNM3-6.5-10-1 | 12 | exact_candidate_hold | R162 proposes twelve exact M3 female/female insulating standoffs nominally 10 mm long with 6.5 mm bodies and 6 mm internal thread depth. Received dimensions/material/insert identity, temperature/fire/creep application, torque, pull/shear/vibration proof, panel fit and qualified review remain open; no procurement or mounting authority is issued
BOM-091 | actuator_branch_carrier_screws | Essentra Components | NSE-1580-M3-6; official Essentra replacement shown for legacy 0120070000VR | 24 | exact_candidate_hold | R264 records the manufacturer page's replacement relation without assuming received equivalence. Twenty-four nylon M3 x 0.5 x 6 mm screw candidates remain held pending current order route, received identity/dimensions/material, tolerance stack, panel hole/coating, torque/locking/reuse, creep, pull/shear/vibration, rear clearance and qualified review. No procurement, drilling or mounting authority is issued.
BOM-092 | panel_control_distribution_blocks | Phoenix Contact | PTFIX 6/18X2,5-NS35 RD item 3273114 x1; PTFIX 6/18X2,5-NS35 BU item 3273112 x1 | 2 | exact_candidate_hold | R222/R223 add one exact red XD24 and one exact blue XD0 catalog candidate. Catalog connection counts and envelopes are controlled; project loading protection conductor preparation spare-position treatment rail fit markers received identity thermal/fault evidence and qualified electrical acceptance remain open. No procurement installation wiring connection or energization is authorized
BOM-093 | panel_control_junction_terminals | Phoenix Contact | PT 2,5-TWIN item 3209549 | 3 | exact_candidate_hold | R222/R223 add three exact catalog candidates for XN1 SR1_S12 XN2 SRA1_S12 and diagnostic XN3 SR1_STATUS. Different-potential adjacency end-cover/partition/marker application rail retention conductors received identity continuity pull thermal/fault evidence and qualified acceptance remain open. No procurement installation wiring connection or energization is authorized
BOM-094 | panel_control_junction_end_cover | Phoenix Contact | D-ST 2,5-TWIN item 3030488 | 1 | exact_candidate_hold | The current Phoenix Contact PT 2,5-TWIN record lists 3030488 as an end-cover accessory. Quantity one is a held group-end candidate only; orientation different-potential adjacency partitions markers received fit access and qualified application acceptance remain open. No procurement installation wiring connection or energization is authorized
BOM-095 | panel_control_node_accessories | Selection required | PTFIX/PT 2,5-TWIN markers partitions covers adapters and any additional restraint; SELECTION REQUIRED | 1 | design_required | R223 exposes rather than assumes the remaining node accessory system. Exact markers spare-position covers partitions adapters restraint quantities compatibility and qualified application evidence remain SELECTION REQUIRED. No procurement installation wiring connection or energization is authorized
BOM-096 | panel_protected_top_routing_duct | Phoenix Contact | CD 25X25 item 3240187 | 1 | exact_candidate_hold | R241 adds one application-piece candidate from a 25 x 25 x 2000 mm base-and-cover stock article for WD5. Manufacturer packing unit and minimum order quantity are 24, not the application quantity. Exact conductor size and OD, fill, thermal conditions, junction/cutout, ribs, edges, clips, fasteners, labels, received fit, installation and qualified review remain open. No procurement, cutting, drilling, installation, wiring, connection or energization is authorized
BOM-097 | panel_p121_stationary_control_conductor | Belden | 3057 BL005 | 1 | exact_candidate_hold | R242 assigns one exact active 100 ft blue 16 AWG candidate reel to the seven stationary P1.21 WD5/WD2 conductors. The 6.72325 m route-centerline sum is geometry only. Qualified Boston/US color convention, the red XD24/blue XD0 identification conflict, received identity/DCR, cut lengths, ferrules/tools, strip/torque/pull, F24/fault coordination, complete WD2 occupancy, bend/junction, thermal, installed evidence and qualified review remain open. No procurement, cutting, wiring, connection or energization is authorized
BOM-098 | panel_p121_ferrule_materials | Phoenix Contact | AI 1,5 - 8 BK item 3200043, minimum pack 100; A 1,5 - 7 item 3200263, minimum pack 1000 | 2 | exact_candidate_hold | R243 maps twelve item 3200043 insulated 8 mm ferrules to XD24/KWD endpoints and two item 3200263 uninsulated 7 mm ferrules to Pilz SR1/SRA1 A1 endpoints. Application quantities are not manufacturer order quantities. Terminal application acceptance, exact torque bits, tool calibration, received Belden/ferrule coupons, 40 N for 60 s pull evidence, installed retention/torque/continuity/isolation and qualified review remain open. No procurement, wiring, connection or energization is authorized
BOM-099 | diagnostic_observation | Custom PCB / provider SELECTION REQUIRED | HR-V0-RUNTIME-OBS-CARRIER-P0.5 PCBA; 49 mounted components; four M3 mounting interfaces | 1 | exact_candidate_hold | One source-bound diagnostic receiver PCBA. Native source, connector map and population are exact; provider, process, stackup, DFM, first article, physical tests and qualified review remain open. Zero safety credit.
BOM-100 | diagnostic_observation | Custom PCB / provider SELECTION REQUIRED | HR-V0-PI-OBS-CARRIER-P0.1 PCBA; two mounted connectors; four M2.5 mounting interfaces | 1 | exact_candidate_hold | One source-bound passive Pi observation carrier. Provider, process, received Pi/header geometry, stack, physical tests and qualified review remain open. Zero safety credit.
BOM-101 | diagnostic_observation_harness | Custom harness / selection required | HR-V0-OBSERVATION-FIELD-HARNESS-P0.1; five point-to-point conductors | 1 | design_required | One field harness assembly with five exact net/color candidates. Every cut length, installed route, support, preparation, pull/continuity result and physical acceptance remains SELECTION REQUIRED.
BOM-102 | diagnostic_observation_harness | Custom harness / selection required | HR-V0-OBSERVATION-COMPUTE-HARNESS-P0.1; six point-to-point conductors | 1 | design_required | One compute harness assembly with six exact net/color candidates. Every cut length, installed route, separation, preparation, pull/continuity result and physical acceptance remains SELECTION REQUIRED.
BOM-103 | diagnostic_observation_pcba_component | Phoenix Contact | MKDS 1/6-3,5; item 1751280; JFIELD1 and JLOGIC1 | 2 | exact_candidate_hold | Two exact six-position runtime-carrier terminal candidates. Land, orientation, conductor preparation, torque, received identity, DFM and installed evidence remain open.
BOM-104 | diagnostic_observation_pcba_component | Samtec | ESQ-120-33-G-D; JPI1 | 1 | exact_candidate_hold | One exact 2x20 elevated socket candidate. Samtec currently restricts the part to existing customers and directs new customers to inquire for an alternate. Received Pi/header fit, land/drill DFM, 16.13 mm header versus 16.00 mm spacer reconciliation, mechanical support and physical acceptance remain open.
BOM-105 | diagnostic_observation_pcba_component | Phoenix Contact | MKDS 1/6-3,5; item 1751280; JOBS1 | 1 | exact_candidate_hold | One exact six-position Pi-carrier terminal candidate. Land, orientation, conductor preparation, torque, received identity, DFM and installed evidence remain open.
BOM-106 | diagnostic_observation_harness_material | Belden | 3051 WB005, WO005, WV005, WY005, WU005, RD005, BK005, BL005, OR005, VI005 and WH005 | 11 | exact_candidate_hold | Eleven exact 22 AWG color/spool candidates cover one unique conductor color each. BK005 and WH005 are also allocated to BOM-061 without a duplicate system-BOM purchase group. Purchase quantity, process allowance, received identity/DCR, all raw cut lengths, application review and physical evidence remain open.
BOM-107 | diagnostic_observation_mounting | Essentra Components | 4 x TNM3-6.5-10-1; 8 x NSE-1580-M3-6 current manufacturer replacement candidate for legacy 0120070000VR | 1 | exact_candidate_hold | R264 records the current official replacement relation. Current order route, received replacement identity/dimensions, equivalence, tolerances, torque, creep, load, coating interface, panel-hole process and physical proof remain open. No drilling or procurement release.
BOM-108 | diagnostic_observation_mounting | Essentra Components | 4 x 300251659935; 8 x 50M025045P006 | 1 | exact_candidate_hold | Exact four-site M2.5 nylon candidate stack. US availability, received dimensions, 0.13 mm nominal header/spacer mismatch, Pi/cooler/case fit, torque, creep, load and physical proof remain open. No assembly or procurement release.
BOM-109 | actuator_branch_source_ring_terminal | Panduit | PN18-8R-E | 1 package of 20; 6 production positions and 14 unallocated process/spare pieces | exact_candidate_hold | R263 exact #8 ring-terminal candidate for Belden 9918 at six Blue Sea 5025 branch positive/return screw interfaces. Exact physical screw assignments, tool/product approval, strip/crimp process, samples, pull/inspection, received fit, torque, thermal and procurement authority remain open.
BOM-110 | j2_soft_contact_pad | Rogers Corporation | 2300327; PORON 4790-92-25024-04P; converter/cut-piece order route SELECTION REQUIRED | 2 finished 40 x 12 mm R1.5 coupons from one quoted converter route | exact_candidate_hold | R277 exact material candidate for sacrificial contact/noise/rebound only; converter laminates retention film to PET-supported face and cuts coupons. Quote, lot/CoC, stack map, dependent pocket depth, retention/dynamics/life/physical proof and qualified acceptance open. PRELIMINARY - NOT APPROVED FOR PROCUREMENT, QUOTATION, FABRICATION, ASSEMBLY, CONNECTION, POWERED TESTING, MOTION, OR ENERGIZATION
BOM-111 | j2_soft_contact_pad_retention | 3M | 467MP / Adhesive 200MP; exact roll size and converter-laminated cut-piece order SELECTION REQUIRED | 2 finished 40 x 12 mm adhesive films applied by selected converter | exact_product_family_candidate_hold | R277 nonstructural retention candidate only. September 2024 TDS gives 2.3 mil/0.06 mm typical thickness and metal/HSE-plastic application; not a specification tolerance or PORON application approval. Quote, converter, surface prep, lot/CoC, stack measurement, peel/migration/life proof and qualified acceptance open. PRELIMINARY - NOT APPROVED FOR PROCUREMENT, QUOTATION, FABRICATION, ASSEMBLY, CONNECTION, POWERED TESTING, MOTION, OR ENERGIZATION
