amyleesterling/humanoid-robot/bom/hr-v0-compute-selection-p0.1.csv

line_id | parent_item_id | manufacturer | exact_candidate | quantity | selection_state | primary_evidence | receiving_route | allowed_action | warning
COMP-001 | BOM-001 | Raspberry Pi | Raspberry Pi 5 8GB RAM - Unit only; SC1112 | 1 | EXACT CANDIDATE - APPLICATION OPEN | electrical/vendor/raspberry-pi/compute-r119/source-manifest-p0.1.csv | tests/forms/hr-v0-compute-receiving-template-p0.1.csv | HOLD - SEPARATE PROGRAM OWNER APPROVAL REQUIRED BEFORE PURCHASE | PRELIMINARY - NOT APPROVED FOR PROCUREMENT FABRICATION OR ENERGIZATION
COMP-002 | BOM-002 | Raspberry Pi | Raspberry Pi 27W USB-C Power Supply; US Type A; black; SC1158 | 1 | EXACT CANDIDATE - APPLICATION OPEN | electrical/vendor/raspberry-pi/compute-r119/source-manifest-p0.1.csv | tests/forms/hr-v0-compute-receiving-template-p0.1.csv | HOLD - SEPARATE PROGRAM OWNER APPROVAL REQUIRED BEFORE PURCHASE | PRELIMINARY - NOT APPROVED FOR PROCUREMENT FABRICATION OR ENERGIZATION
