amyleesterling/humanoid-robot/bom/hr-v0-gripper-acquisition-candidate-p0.1.csv

record_id | manufacturer | orderable_item | order_code | documented_scope | project_disposition | evidence_required | status
GAC-001 | ROBOTIS | OpenMANIPULATOR-X Frame Set RM-X52 | 905-0023-000 | Current proposed parent kit for the complete gripper-mechanism subset recorded in hr-v0-gripper-kit-contents.csv | RETAINED AS PROPOSED PARENT KIT; NOT RELEASED | received label and contents reconciliation; individual mass and geometry; H104 registration; fastener stack; guard; force/current/drop evidence | SELECTION REQUIRED
GAC-002 | ROBOTIS | FR12-G101GM Set | 903-0256-300 | Manufacturer calls this a gripper frame set; package lists FR12-E170GM x1, FR12-E171GM x1, WB M2x3 x12, FHS M2.5x14 x6 and spacer ring x6; idler excluded | REJECTED AS SOLE HR-V0 GRIPPER-MECHANISM SOURCE; OPTIONAL UNPOWERED EVALUATION ONLY | manufacturer drawing or received inspection identifying the two assemblies; complete mechanism reconciliation; exact mass and geometry | REJECTED AS SOLE SOURCE
GAC-003 | ROBOTIS | HN12-I101 Set | 903-0240-000 | Manufacturer-required XH430/XM430 idler set; package lists plastic bearing, idler, DC12 cap and WB M2x3 x18; hinge frame excluded | REQUIRED SUPPLEMENT IF GAC-002 IS EVER SELECTED; NOT RELEASED | received identity and contents; fit; mass; cable-clearance; fastener and retention evidence | SELECTION REQUIRED
