amyleesterling/humanoid-robot/bom/hr-v0-watchdog-pcb-binding.csv

binding_id | bom_item_id | board_id | electrical_revision | current_system_binding | native_pcb_path | native_pcb_sha256 | assembly_data_id | assembly_bom_path | assembly_bom_sha256 | placement_path | placement_sha256 | populated_references | bom_lines | mechanical_features | cam_exists_at_issue | current_cam_review_identifier | current_cam_review_exists | supplier_xyrs_exists | fabrication_authorized | release_state | warning
WDBIND-001 | BOM-048 | PCB-P1.0 | Project Button Electrical V3-P1.15 | Project Button Electrical V3-P1.15-CARRIER-CANDIDATE / PCB-P1.0 direct native binding | electrical/kicad/project-button-v3/project-button-v3.kicad_pcb | 4e893c7d0d8e18ad933487bd51e390ef4497f9d021df8e67b7821797db296720 | HR-V0-WD-PCBA-DATA-P0.2 | electrical/manufacturing/hr-v0-watchdog-pcba-assembly-data-p0.2/board-assembly-bom.csv | 47d069003a4a42f3128e9a224e3426ea2c301197aa9685f0a61b131faa7c52c0 | electrical/manufacturing/hr-v0-watchdog-pcba-assembly-data-p0.2/assembly-placement-reference.csv | 9d913d4b7dab246f6791a2d47a7e6ffbf9366115b6c4d91100b07eb507e3807d | 42 | 16 | 4 | FALSE | HR-V0-WD-CAM-P0.2 | TRUE | FALSE | FALSE | EXACT CANDIDATE HOLD - CURRENT CAM REVIEW EXISTS BUT IS NOT RELEASED; ASSEMBLY PROCESS ABSENT | PRELIMINARY - NOT APPROVED FOR FABRICATION, ASSEMBLY, CONNECTION, MOTION, OR ENERGIZATION
