amyleesterling/humanoid-robot/hr30/whole-body-p0.1/component-envelope-schedule.csv

component | group | physical_or_reference | xmin_mm | xmax_mm | ymin_mm | ymax_mm | zmin_mm | zmax_mm | note | status
L_FOOT_SHELL_ENVELOPE | foot | PHYSICAL ENVELOPE | 17.493945 | 107.506055 | -47.506055 | 97.506055 | -0.006055 | 35.006055 |  | CANDIDATE ENVELOPE - NOT A FABRICATION PART
L_ANKLE_HOUSING_ENVELOPE | joint housing | PHYSICAL ENVELOPE | 29.494954 | 95.505046 | -32.005046 | 32.005046 | 24.994954 | 77.005046 |  | CANDIDATE ENVELOPE - NOT A FABRICATION PART
L_SHIN_STRUCTURAL_ENVELOPE | lower leg | PHYSICAL ENVELOPE | 35.494954 | 89.505046 | -27.005046 | 27.005046 | 59.994954 | 195.005046 |  | CANDIDATE ENVELOPE - NOT A FABRICATION PART
L_SHIN_SHELL_ENVELOPE | lower-leg shell | PHYSICAL ENVELOPE | 26.750000 | 98.250000 | -37.750000 | 37.750000 | 59.250000 | 195.750000 |  | CANDIDATE ENVELOPE - NOT A FABRICATION PART
L_KNEE_HOUSING_ENVELOPE | joint housing | PHYSICAL ENVELOPE | 27.493945 | 97.506055 | -34.006055 | 34.006055 | 181.993945 | 238.006055 |  | CANDIDATE ENVELOPE - NOT A FABRICATION PART
L_THIGH_STRUCTURAL_ENVELOPE | upper leg | PHYSICAL ENVELOPE | 33.494954 | 91.505046 | -29.005046 | 29.005046 | 224.994954 | 365.005046 |  | CANDIDATE ENVELOPE - NOT A FABRICATION PART
L_THIGH_SHELL_ENVELOPE | upper-leg shell | PHYSICAL ENVELOPE | 23.500000 | 101.500000 | -40.000000 | 40.000000 | 223.000000 | 367.000000 |  | CANDIDATE ENVELOPE - NOT A FABRICATION PART
L_HIP_HOUSING_ENVELOPE | joint housing | PHYSICAL ENVELOPE | 26.492936 | 98.507064 | -41.007064 | 41.007064 | 344.992936 | 415.007064 |  | CANDIDATE ENVELOPE - NOT A FABRICATION PART
R_FOOT_SHELL_ENVELOPE | foot | PHYSICAL ENVELOPE | -107.506055 | -17.493945 | -47.506055 | 97.506055 | -0.006055 | 35.006055 |  | CANDIDATE ENVELOPE - NOT A FABRICATION PART
R_ANKLE_HOUSING_ENVELOPE | joint housing | PHYSICAL ENVELOPE | -95.505046 | -29.494954 | -32.005046 | 32.005046 | 24.994954 | 77.005046 |  | CANDIDATE ENVELOPE - NOT A FABRICATION PART
R_SHIN_STRUCTURAL_ENVELOPE | lower leg | PHYSICAL ENVELOPE | -89.505046 | -35.494954 | -27.005046 | 27.005046 | 59.994954 | 195.005046 |  | CANDIDATE ENVELOPE - NOT A FABRICATION PART
R_SHIN_SHELL_ENVELOPE | lower-leg shell | PHYSICAL ENVELOPE | -98.250000 | -26.750000 | -37.750000 | 37.750000 | 59.250000 | 195.750000 |  | CANDIDATE ENVELOPE - NOT A FABRICATION PART
R_KNEE_HOUSING_ENVELOPE | joint housing | PHYSICAL ENVELOPE | -97.506055 | -27.493945 | -34.006055 | 34.006055 | 181.993945 | 238.006055 |  | CANDIDATE ENVELOPE - NOT A FABRICATION PART
R_THIGH_STRUCTURAL_ENVELOPE | upper leg | PHYSICAL ENVELOPE | -91.505046 | -33.494954 | -29.005046 | 29.005046 | 224.994954 | 365.005046 |  | CANDIDATE ENVELOPE - NOT A FABRICATION PART
R_THIGH_SHELL_ENVELOPE | upper-leg shell | PHYSICAL ENVELOPE | -101.500000 | -23.500000 | -40.000000 | 40.000000 | 223.000000 | 367.000000 |  | CANDIDATE ENVELOPE - NOT A FABRICATION PART
R_HIP_HOUSING_ENVELOPE | joint housing | PHYSICAL ENVELOPE | -98.507064 | -26.492936 | -41.007064 | 41.007064 | 344.992936 | 415.007064 |  | CANDIDATE ENVELOPE - NOT A FABRICATION PART
PELVIS_SHELL_ENVELOPE | pelvis | PHYSICAL ENVELOPE | -80.750000 | 80.750000 | -55.750000 | 55.750000 | 348.750000 | 420.250000 |  | CANDIDATE ENVELOPE - NOT A FABRICATION PART
PELVIS_LOAD_FRAME_ENVELOPE | pelvis structure | PHYSICAL ENVELOPE | -66.005046 | 66.005046 | -36.005046 | 36.005046 | 368.994954 | 411.005046 |  | CANDIDATE ENVELOPE - NOT A FABRICATION PART
WAIST_BEARING_STACK_RESERVATION | joint housing | PHYSICAL ENVELOPE | -56.006055 | 56.006055 | -42.006055 | 42.006055 | 407.993945 | 442.006055 |  | CANDIDATE ENVELOPE - NOT A FABRICATION PART
TORSO_SHELL_ENVELOPE | torso | PHYSICAL ENVELOPE | -104.500000 | 104.500000 | -64.500000 | 64.500000 | 430.500000 | 594.500000 |  | CANDIDATE ENVELOPE - NOT A FABRICATION PART
TORSO_LEFT_FRAME_RAIL | torso structure | PHYSICAL ENVELOPE | 59.996972 | 80.003028 | -12.503028 | 12.503028 | 438.996972 | 581.003028 |  | CANDIDATE ENVELOPE - NOT A FABRICATION PART
TORSO_RIGHT_FRAME_RAIL | torso structure | PHYSICAL ENVELOPE | -80.003028 | -59.996972 | -12.503028 | 12.503028 | 438.996972 | 581.003028 |  | CANDIDATE ENVELOPE - NOT A FABRICATION PART
TORSO_SHOULDER_CROSSMEMBER | torso structure | PHYSICAL ENVELOPE | -85.003028 | 85.003028 | -14.003028 | 14.003028 | 562.996972 | 587.003028 |  | CANDIDATE ENVELOPE - NOT A FABRICATION PART
NECK_COLUMN_ENVELOPE | neck | PHYSICAL ENVELOPE | -27.006055 | 27.006055 | -27.006055 | 27.006055 | 595.993945 | 654.006055 |  | CANDIDATE ENVELOPE - NOT A FABRICATION PART
HEAD_SHELL_ENVELOPE | head | PHYSICAL ENVELOPE | -75.012110 | 75.012110 | -55.012110 | 55.012110 | 649.987890 | 762.012110 |  | CANDIDATE ENVELOPE - NOT A FABRICATION PART
FACE_SCREEN_PANEL | face screen | PHYSICAL ENVELOPE | -58.003028 | 58.003028 | -61.003028 | -53.996972 | 674.996972 | 733.003028 | serviceable display-panel envelope; exact display selection required | CANDIDATE ENVELOPE - NOT A FABRICATION PART
FACE_LEFT_EYE_GRAPHIC | screen-face graphic | PHYSICAL ENVELOPE | 18.999293 | 37.000707 | -62.500707 | -60.499293 | 708.999293 | 717.000707 | visual identity only; rendered by the display in production | CANDIDATE ENVELOPE - NOT A FABRICATION PART
FACE_RIGHT_EYE_GRAPHIC | screen-face graphic | PHYSICAL ENVELOPE | -37.000707 | -18.999293 | -62.500707 | -60.499293 | 708.999293 | 717.000707 | visual identity only; rendered by the display in production | CANDIDATE ENVELOPE - NOT A FABRICATION PART
FACE_DISPLAY_RESERVATION | sensor/display bay | REFERENCE/RESERVATION | -54.003028 | 54.003028 | -56.003028 | -47.996972 | 678.996972 | 729.003028 | display, camera privacy indicator and status-light hardware unresolved | CANDIDATE ENVELOPE - NOT A FABRICATION PART
L_SHOULDER_HOUSING_ENVELOPE | joint housing | PHYSICAL ENVELOPE | 69.993945 | 110.006055 | -36.006055 | 36.006055 | 560.993945 | 619.006055 |  | CANDIDATE ENVELOPE - NOT A FABRICATION PART
L_UPPER_ARM_STRUCTURAL_ENVELOPE | upper arm | PHYSICAL ENVELOPE | 73.549272 | 144.450728 | -17.000000 | 17.000000 | 440.581192 | 594.311951 |  | CANDIDATE ENVELOPE - NOT A FABRICATION PART
L_UPPER_ARM_SHELL_ENVELOPE | upper-arm shell | PHYSICAL ENVELOPE | 66.775443 | 151.224557 | -24.000000 | 24.000000 | 438.805683 | 596.087460 |  | CANDIDATE ENVELOPE - NOT A FABRICATION PART
L_ELBOW_HOUSING_ENVELOPE | joint housing | PHYSICAL ENVELOPE | 100.993945 | 155.006055 | -31.006055 | 31.006055 | 417.887088 | 471.899198 |  | CANDIDATE ENVELOPE - NOT A FABRICATION PART
L_FOREARM_STRUCTURAL_ENVELOPE | forearm | PHYSICAL ENVELOPE | 112.004542 | 148.995458 | -16.000000 | 16.000000 | 299.422678 | 445.449840 |  | CANDIDATE ENVELOPE - NOT A FABRICATION PART
L_FOREARM_SHELL_ENVELOPE | forearm shell | PHYSICAL ENVELOPE | 105.006529 | 155.993471 | -23.000000 | 23.000000 | 299.179123 | 445.693395 |  | CANDIDATE ENVELOPE - NOT A FABRICATION PART
L_WRIST_HOUSING_ENVELOPE | joint housing | PHYSICAL ENVELOPE | 108.993945 | 157.006055 | -28.006055 | 28.006055 | 277.473320 | 322.485430 |  | CANDIDATE ENVELOPE - NOT A FABRICATION PART
L_HAND_PALM_ENVELOPE | hand-shaped gripper palm | PHYSICAL ENVELOPE | 107.993945 | 158.006055 | -29.006055 | 29.006055 | 256.973320 | 292.985430 | houses one actuator and symmetric coupling | CANDIDATE ENVELOPE - NOT A FABRICATION PART
L_INBOARD_GRIPPER_FINGER | hand-shaped gripper finger | PHYSICAL ENVELOPE | 110.994954 | 129.005046 | -22.005046 | 22.005046 | 223.974329 | 269.984421 | broad parallel jaw; no narrow scissor point | CANDIDATE ENVELOPE - NOT A FABRICATION PART
L_INBOARD_SOFT_PAD_LAND | gripper contact pad land | PHYSICAL ENVELOPE | 111.996972 | 128.003028 | -24.003028 | 24.003028 | 230.976348 | 238.982403 | replaceable compliant pad; material and force-stroke selection required | CANDIDATE ENVELOPE - NOT A FABRICATION PART
L_OUTBOARD_GRIPPER_FINGER | hand-shaped gripper finger | PHYSICAL ENVELOPE | 136.994954 | 155.005046 | -22.005046 | 22.005046 | 223.974329 | 269.984421 | broad parallel jaw; no narrow scissor point | CANDIDATE ENVELOPE - NOT A FABRICATION PART
L_OUTBOARD_SOFT_PAD_LAND | gripper contact pad land | PHYSICAL ENVELOPE | 137.996972 | 154.003028 | -24.003028 | 24.003028 | 230.976348 | 238.982403 | replaceable compliant pad; material and force-stroke selection required | CANDIDATE ENVELOPE - NOT A FABRICATION PART
R_SHOULDER_HOUSING_ENVELOPE | joint housing | PHYSICAL ENVELOPE | -110.006055 | -69.993945 | -36.006055 | 36.006055 | 560.993945 | 619.006055 |  | CANDIDATE ENVELOPE - NOT A FABRICATION PART
R_UPPER_ARM_STRUCTURAL_ENVELOPE | upper arm | PHYSICAL ENVELOPE | -144.450728 | -73.549272 | -17.000000 | 17.000000 | 440.581192 | 594.311951 |  | CANDIDATE ENVELOPE - NOT A FABRICATION PART
R_UPPER_ARM_SHELL_ENVELOPE | upper-arm shell | PHYSICAL ENVELOPE | -151.224557 | -66.775443 | -24.000000 | 24.000000 | 438.805683 | 596.087460 |  | CANDIDATE ENVELOPE - NOT A FABRICATION PART
R_ELBOW_HOUSING_ENVELOPE | joint housing | PHYSICAL ENVELOPE | -155.006055 | -100.993945 | -31.006055 | 31.006055 | 417.887088 | 471.899198 |  | CANDIDATE ENVELOPE - NOT A FABRICATION PART
R_FOREARM_STRUCTURAL_ENVELOPE | forearm | PHYSICAL ENVELOPE | -148.995458 | -112.004542 | -16.000000 | 16.000000 | 299.422678 | 445.449840 |  | CANDIDATE ENVELOPE - NOT A FABRICATION PART
R_FOREARM_SHELL_ENVELOPE | forearm shell | PHYSICAL ENVELOPE | -155.993471 | -105.006529 | -23.000000 | 23.000000 | 299.179123 | 445.693395 |  | CANDIDATE ENVELOPE - NOT A FABRICATION PART
R_WRIST_HOUSING_ENVELOPE | joint housing | PHYSICAL ENVELOPE | -157.006055 | -108.993945 | -28.006055 | 28.006055 | 277.473320 | 322.485430 |  | CANDIDATE ENVELOPE - NOT A FABRICATION PART
R_HAND_PALM_ENVELOPE | hand-shaped gripper palm | PHYSICAL ENVELOPE | -158.006055 | -107.993945 | -29.006055 | 29.006055 | 256.973320 | 292.985430 | houses one actuator and symmetric coupling | CANDIDATE ENVELOPE - NOT A FABRICATION PART
R_INBOARD_GRIPPER_FINGER | hand-shaped gripper finger | PHYSICAL ENVELOPE | -155.005046 | -136.994954 | -22.005046 | 22.005046 | 223.974329 | 269.984421 | broad parallel jaw; no narrow scissor point | CANDIDATE ENVELOPE - NOT A FABRICATION PART
R_INBOARD_SOFT_PAD_LAND | gripper contact pad land | PHYSICAL ENVELOPE | -154.003028 | -137.996972 | -24.003028 | 24.003028 | 230.976348 | 238.982403 | replaceable compliant pad; material and force-stroke selection required | CANDIDATE ENVELOPE - NOT A FABRICATION PART
R_OUTBOARD_GRIPPER_FINGER | hand-shaped gripper finger | PHYSICAL ENVELOPE | -129.005046 | -110.994954 | -22.005046 | 22.005046 | 223.974329 | 269.984421 | broad parallel jaw; no narrow scissor point | CANDIDATE ENVELOPE - NOT A FABRICATION PART
R_OUTBOARD_SOFT_PAD_LAND | gripper contact pad land | PHYSICAL ENVELOPE | -128.003028 | -111.996972 | -24.003028 | 24.003028 | 230.976348 | 238.982403 | replaceable compliant pad; material and force-stroke selection required | CANDIDATE ENVELOPE - NOT A FABRICATION PART
TORSO_COMPUTE_BAY | component bay | REFERENCE/RESERVATION | -71.004037 | 71.004037 | -31.004037 | 41.004037 | 478.995963 | 561.004037 | compute, cooling, storage and retention selection required | CANDIDATE ENVELOPE - NOT A FABRICATION PART
PELVIS_POWER_BAY | component bay | REFERENCE/RESERVATION | -59.004037 | 59.004037 | -31.004037 | 41.004037 | 359.495963 | 404.504037 | source, conversion, protection and regeneration architecture selection required | CANDIDATE ENVELOPE - NOT A FABRICATION PART
HEAD_SENSOR_BAY | component bay | REFERENCE/RESERVATION | -54.004037 | 54.004037 | -31.004037 | 39.004037 | 675.995963 | 734.004037 | camera, audio, illumination and privacy hardware selection required | CANDIDATE ENVELOPE - NOT A FABRICATION PART
PELVIS_IMU_DATUM_BAY | component bay | REFERENCE/RESERVATION | -21.003028 | 21.003028 | -21.003028 | 21.003028 | 396.996972 | 417.003028 | pelvis IMU exact model and mount remain open | CANDIDATE ENVELOPE - NOT A FABRICATION PART
PELVIS_RESTRAINT_INTERFACE_ENVELOPE | restraint interface | REFERENCE/RESERVATION | -40.003028 | 40.003028 | 5.996972 | 58.003028 | 403.996972 | 424.003028 | rated restraint interface not designed | CANDIDATE ENVELOPE - NOT A FABRICATION PART
AXIS_HEAD_PAN | joint axis reference | REFERENCE/RESERVATION | -3.501088 | 3.501088 | -3.500000 | 3.500000 | 622.498912 | 677.501088 |  | CANDIDATE ENVELOPE - NOT A FABRICATION PART
AXIS_HEAD_TILT | joint axis reference | REFERENCE/RESERVATION | -27.501088 | 27.501088 | -3.500000 | 3.500000 | 686.498912 | 693.501088 |  | CANDIDATE ENVELOPE - NOT A FABRICATION PART
AXIS_WAIST_YAW | joint axis reference | REFERENCE/RESERVATION | -3.501088 | 3.501088 | -3.500000 | 3.500000 | 397.498912 | 452.501088 |  | CANDIDATE ENVELOPE - NOT A FABRICATION PART
AXIS_L_SHOULDER_PITCH | joint axis reference | REFERENCE/RESERVATION | 55.998912 | 124.001088 | -3.500000 | 3.500000 | 586.498912 | 593.501088 |  | CANDIDATE ENVELOPE - NOT A FABRICATION PART
AXIS_L_SHOULDER_ROLL | joint axis reference | REFERENCE/RESERVATION | 86.500000 | 93.500000 | -34.001088 | 34.001088 | 586.498912 | 593.501088 |  | CANDIDATE ENVELOPE - NOT A FABRICATION PART
AXIS_L_ELBOW_PITCH | joint axis reference | REFERENCE/RESERVATION | 93.998912 | 162.001088 | -3.500000 | 3.500000 | 441.392055 | 448.394231 |  | CANDIDATE ENVELOPE - NOT A FABRICATION PART
AXIS_L_WRIST_ROTATION | joint axis reference | REFERENCE/RESERVATION | 129.498912 | 136.501088 | -3.500000 | 3.500000 | 265.978287 | 333.980463 |  | CANDIDATE ENVELOPE - NOT A FABRICATION PART
AXIS_L_GRIPPER | joint axis reference | REFERENCE/RESERVATION | 98.998912 | 167.001088 | -3.500000 | 3.500000 | 253.478287 | 260.480463 |  | CANDIDATE ENVELOPE - NOT A FABRICATION PART
AXIS_L_HIP_YAW | joint axis reference | REFERENCE/RESERVATION | 58.998912 | 66.001088 | -3.500000 | 3.500000 | 375.998912 | 444.001088 |  | CANDIDATE ENVELOPE - NOT A FABRICATION PART
AXIS_L_HIP_ROLL | joint axis reference | REFERENCE/RESERVATION | 59.000000 | 66.000000 | -34.001088 | 34.001088 | 386.498912 | 393.501088 |  | CANDIDATE ENVELOPE - NOT A FABRICATION PART
AXIS_L_HIP_PITCH | joint axis reference | REFERENCE/RESERVATION | 28.498912 | 96.501088 | -3.500000 | 3.500000 | 366.498912 | 373.501088 |  | CANDIDATE ENVELOPE - NOT A FABRICATION PART
AXIS_L_KNEE_PITCH | joint axis reference | REFERENCE/RESERVATION | 28.498912 | 96.501088 | -3.500000 | 3.500000 | 206.498912 | 213.501088 |  | CANDIDATE ENVELOPE - NOT A FABRICATION PART
AXIS_L_ANKLE_PITCH | joint axis reference | REFERENCE/RESERVATION | 28.498912 | 96.501088 | -3.500000 | 3.500000 | 51.498912 | 58.501088 |  | CANDIDATE ENVELOPE - NOT A FABRICATION PART
AXIS_L_ANKLE_ROLL | joint axis reference | REFERENCE/RESERVATION | 59.000000 | 66.000000 | -34.001088 | 34.001088 | 31.498912 | 38.501088 |  | CANDIDATE ENVELOPE - NOT A FABRICATION PART
AXIS_R_SHOULDER_PITCH | joint axis reference | REFERENCE/RESERVATION | -124.001088 | -55.998912 | -3.500000 | 3.500000 | 586.498912 | 593.501088 |  | CANDIDATE ENVELOPE - NOT A FABRICATION PART
AXIS_R_SHOULDER_ROLL | joint axis reference | REFERENCE/RESERVATION | -93.500000 | -86.500000 | -34.001088 | 34.001088 | 586.498912 | 593.501088 |  | CANDIDATE ENVELOPE - NOT A FABRICATION PART
AXIS_R_ELBOW_PITCH | joint axis reference | REFERENCE/RESERVATION | -162.001088 | -93.998912 | -3.500000 | 3.500000 | 441.392055 | 448.394231 |  | CANDIDATE ENVELOPE - NOT A FABRICATION PART
AXIS_R_WRIST_ROTATION | joint axis reference | REFERENCE/RESERVATION | -136.501088 | -129.498912 | -3.500000 | 3.500000 | 265.978287 | 333.980463 |  | CANDIDATE ENVELOPE - NOT A FABRICATION PART
AXIS_R_GRIPPER | joint axis reference | REFERENCE/RESERVATION | -167.001088 | -98.998912 | -3.500000 | 3.500000 | 253.478287 | 260.480463 |  | CANDIDATE ENVELOPE - NOT A FABRICATION PART
AXIS_R_HIP_YAW | joint axis reference | REFERENCE/RESERVATION | -66.001088 | -58.998912 | -3.500000 | 3.500000 | 375.998912 | 444.001088 |  | CANDIDATE ENVELOPE - NOT A FABRICATION PART
AXIS_R_HIP_ROLL | joint axis reference | REFERENCE/RESERVATION | -66.000000 | -59.000000 | -34.001088 | 34.001088 | 386.498912 | 393.501088 |  | CANDIDATE ENVELOPE - NOT A FABRICATION PART
AXIS_R_HIP_PITCH | joint axis reference | REFERENCE/RESERVATION | -96.501088 | -28.498912 | -3.500000 | 3.500000 | 366.498912 | 373.501088 |  | CANDIDATE ENVELOPE - NOT A FABRICATION PART
AXIS_R_KNEE_PITCH | joint axis reference | REFERENCE/RESERVATION | -96.501088 | -28.498912 | -3.500000 | 3.500000 | 206.498912 | 213.501088 |  | CANDIDATE ENVELOPE - NOT A FABRICATION PART
AXIS_R_ANKLE_PITCH | joint axis reference | REFERENCE/RESERVATION | -96.501088 | -28.498912 | -3.500000 | 3.500000 | 51.498912 | 58.501088 |  | CANDIDATE ENVELOPE - NOT A FABRICATION PART
AXIS_R_ANKLE_ROLL | joint axis reference | REFERENCE/RESERVATION | -66.000000 | -59.000000 | -34.001088 | 34.001088 | 31.498912 | 38.501088 |  | CANDIDATE ENVELOPE - NOT A FABRICATION PART
JMOD_HEAD_PAN_OUTPUT_SHAFT | joint module shaft | PHYSICAL ENVELOPE | -3.000933 | 3.000933 | -3.000000 | 3.000000 | 630.999067 | 669.000933 | JMF-01-COMPACT hollow shaft candidate with 3.7 mm through bore; material, wall, fits and retention selection required | CANDIDATE ENVELOPE - NOT A FABRICATION PART
JMOD_HEAD_PAN_BEARING_B_RING | joint module bearing | PHYSICAL ENVELOPE | -7.502331 | 7.502331 | -7.500000 | 7.500000 | 660.997669 | 666.002331 | JMF-01-COMPACT 696 OPEN EVALUATION CANDIDATE catalogue envelope; load direction, life, suffix, fit, retention and application selection required | CANDIDATE ENVELOPE - NOT A FABRICATION PART
JMOD_HEAD_PAN_INTERFACE_PLATE_B | joint module interface plate | PHYSICAL ENVELOPE | -19.001189 | 19.001189 | -18.001189 | 18.001189 | 665.998409 | 669.001591 | JMF-01-COMPACT provisional four-hole module interface; thread/fastener stack not released | CANDIDATE ENVELOPE - NOT A FABRICATION PART
JMOD_HEAD_PAN_CABLE_CORRIDOR | joint cable corridor | REFERENCE/RESERVATION | -3.000933 | 3.000933 | 7.080000 | 13.080000 | 630.999067 | 669.000933 | JMF-01-COMPACT routing reservation; cable construction and bend control selection required | CANDIDATE ENVELOPE - NOT A FABRICATION PART
JMOD_HEAD_PAN_ACTUATOR_VENDOR_CANDIDATE | joint actuator vendor geometry | PHYSICAL ENVELOPE | -24.500000 | 9.500000 | -10.000000 | 10.000000 | 591.500000 | 620.500000 | ROBOTIS-XC330 SHA-bound manufacturer geometry in STEP; dimension-matched simplified body in GLB; project mounting interface remains candidate | CANDIDATE ENVELOPE - NOT A FABRICATION PART
JMOD_HEAD_PAN_ACTUATOR_OUTPUT_COUPLER | joint transmission | PHYSICAL ENVELOPE | -2.160671 | 2.160671 | -2.160000 | 2.160000 | 613.999329 | 650.000671 | coaxial output coupling candidate; spline, clamp, material and retention selection required | CANDIDATE ENVELOPE - NOT A FABRICATION PART
JMOD_HEAD_TILT_OUTPUT_SHAFT | joint module shaft | PHYSICAL ENVELOPE | -19.000933 | 19.000933 | -3.000000 | 3.000000 | 686.999067 | 693.000933 | JMF-01-COMPACT hollow shaft candidate with 3.7 mm through bore; material, wall, fits and retention selection required | CANDIDATE ENVELOPE - NOT A FABRICATION PART
JMOD_HEAD_TILT_BEARING_B_RING | joint module bearing | PHYSICAL ENVELOPE | 10.997669 | 16.002331 | -7.500000 | 7.500000 | 682.497669 | 697.502331 | JMF-01-COMPACT 696 OPEN EVALUATION CANDIDATE catalogue envelope; load direction, life, suffix, fit, retention and application selection required | CANDIDATE ENVELOPE - NOT A FABRICATION PART
JMOD_HEAD_TILT_INTERFACE_PLATE_B | joint module interface plate | PHYSICAL ENVELOPE | 15.998409 | 19.001591 | -18.001189 | 18.001189 | 670.998811 | 709.001189 | JMF-01-COMPACT provisional four-hole module interface; thread/fastener stack not released | CANDIDATE ENVELOPE - NOT A FABRICATION PART
JMOD_HEAD_TILT_CABLE_CORRIDOR | joint cable corridor | REFERENCE/RESERVATION | -19.000933 | 19.000933 | 7.080000 | 13.080000 | 686.999067 | 693.000933 | JMF-01-COMPACT routing reservation; cable construction and bend control selection required | CANDIDATE ENVELOPE - NOT A FABRICATION PART
JMOD_HEAD_TILT_ACTUATOR_VENDOR_CANDIDATE | joint actuator vendor geometry | PHYSICAL ENVELOPE | -58.500000 | -29.500000 | -10.000000 | 10.000000 | 665.500000 | 699.500000 | ROBOTIS-XC330 SHA-bound manufacturer geometry in STEP; dimension-matched simplified body in GLB; project mounting interface remains candidate | CANDIDATE ENVELOPE - NOT A FABRICATION PART
JMOD_HEAD_TILT_ACTUATOR_OUTPUT_COUPLER | joint transmission | PHYSICAL ENVELOPE | -36.000671 | 0.000671 | -2.160000 | 2.160000 | 687.839329 | 692.160671 | coaxial output coupling candidate; spline, clamp, material and retention selection required | CANDIDATE ENVELOPE - NOT A FABRICATION PART
JMOD_WAIST_YAW_OUTPUT_SHAFT | joint module shaft | PHYSICAL ENVELOPE | -8.502642 | 8.502642 | -8.500000 | 8.500000 | 405.997358 | 444.002642 | JMF-05-WAIST hollow shaft candidate with 10.5 mm through bore; material, wall, fits and retention selection required | CANDIDATE ENVELOPE - NOT A FABRICATION PART
JMOD_WAIST_YAW_BEARING_B_RING | joint module bearing | PHYSICAL ENVELOPE | -13.004041 | 13.004041 | -13.000000 | 13.000000 | 433.995959 | 439.004041 | JMF-05-WAIST 6803 OPEN EVALUATION CANDIDATE catalogue envelope; load direction, life, suffix, fit, retention and application selection required | CANDIDATE ENVELOPE - NOT A FABRICATION PART
JMOD_WAIST_YAW_INTERFACE_PLATE_B | joint module interface plate | PHYSICAL ENVELOPE | -36.000984 | 36.000984 | -49.000984 | 49.000984 | 438.996540 | 444.003460 | JMF-05-WAIST provisional four-hole module interface; thread/fastener stack not released | CANDIDATE ENVELOPE - NOT A FABRICATION PART
JMOD_WAIST_YAW_CABLE_CORRIDOR | joint cable corridor | REFERENCE/RESERVATION | -9.002797 | 9.002797 | 11.160000 | 29.160000 | 405.997203 | 444.002797 | JMF-05-WAIST routing reservation; cable construction and bend control selection required | CANDIDATE ENVELOPE - NOT A FABRICATION PART
JMOD_WAIST_YAW_ACTUATOR_VENDOR_CANDIDATE | joint actuator vendor geometry | PHYSICAL ENVELOPE | -44.750000 | 13.750000 | -16.750000 | 16.750000 | 357.500000 | 411.800000 | ROBOTIS-540 SHA-bound manufacturer geometry in STEP; dimension-matched simplified body in GLB; project mounting interface remains candidate | CANDIDATE ENVELOPE - NOT A FABRICATION PART
JMOD_WAIST_YAW_ACTUATOR_OUTPUT_COUPLER | joint transmission | PHYSICAL ENVELOPE | -6.121902 | 6.121902 | -6.120000 | 6.120000 | 381.998098 | 425.001902 | coaxial output coupling candidate; spline, clamp, material and retention selection required | CANDIDATE ENVELOPE - NOT A FABRICATION PART
JMOD_L_SHOULDER_PITCH_OUTPUT_SHAFT | joint module shaft | PHYSICAL ENVELOPE | 62.998446 | 117.001554 | -5.000000 | 5.000000 | 584.998446 | 595.001554 | JMF-03-SHOULDER-GIMBAL hollow shaft candidate with 6.2 mm through bore; material, wall, fits and retention selection required | CANDIDATE ENVELOPE - NOT A FABRICATION PART
JMOD_L_SHOULDER_PITCH_BEARING_A_RING | joint module bearing | PHYSICAL ENVELOPE | 66.996581 | 73.003419 | -11.000000 | 11.000000 | 578.996581 | 601.003419 | JMF-03-SHOULDER-GIMBAL 61900-2RS1 EVALUATION CANDIDATE catalogue envelope; load direction, life, suffix, fit, retention and application selection required | CANDIDATE ENVELOPE - NOT A FABRICATION PART
JMOD_L_SHOULDER_PITCH_INTERFACE_PLATE_A | joint module interface plate | PHYSICAL ENVELOPE | 62.997695 | 67.002305 | -26.001690 | 26.001690 | 561.998310 | 618.001690 | JMF-03-SHOULDER-GIMBAL provisional four-hole module interface; thread/fastener stack not released | CANDIDATE ENVELOPE - NOT A FABRICATION PART
JMOD_L_SHOULDER_PITCH_BEARING_B_RING | joint module bearing | PHYSICAL ENVELOPE | 106.996581 | 113.003419 | -11.000000 | 11.000000 | 578.996581 | 601.003419 | JMF-03-SHOULDER-GIMBAL 61900-2RS1 EVALUATION CANDIDATE catalogue envelope; load direction, life, suffix, fit, retention and application selection required | CANDIDATE ENVELOPE - NOT A FABRICATION PART
JMOD_L_SHOULDER_PITCH_INTERFACE_PLATE_B | joint module interface plate | PHYSICAL ENVELOPE | 112.997695 | 117.002305 | -26.001690 | 26.001690 | 561.998310 | 618.001690 | JMF-03-SHOULDER-GIMBAL provisional four-hole module interface; thread/fastener stack not released | CANDIDATE ENVELOPE - NOT A FABRICATION PART
JMOD_L_SHOULDER_PITCH_CABLE_CORRIDOR | joint cable corridor | REFERENCE/RESERVATION | 62.998446 | 117.001554 | 9.560000 | 19.560000 | 584.998446 | 595.001554 | JMF-03-SHOULDER-GIMBAL routing reservation; cable construction and bend control selection required | CANDIDATE ENVELOPE - NOT A FABRICATION PART
JMOD_L_SHOULDER_PITCH_OUTPUT_PULLEY | joint transmission | PHYSICAL ENVELOPE | 83.994240 | 96.005760 | -18.535760 | 18.535760 | 571.470000 | 608.530000 | 1.5:1 exact catalogue candidate lightweight spoked pulley envelope; pitch/width/tooth count selection required | CANDIDATE ENVELOPE - NOT A FABRICATION PART
JMOD_L_SHOULDER_PITCH_MOTOR_PULLEY | joint transmission | PHYSICAL ENVELOPE | 83.996220 | 96.003780 | 29.853942 | 54.181501 | 577.840000 | 602.160000 | 1.5:1 exact catalogue candidate lightweight spoked motor pulley envelope; bore and retention selection required | CANDIDATE ENVELOPE - NOT A FABRICATION PART
JMOD_L_SHOULDER_PITCH_ACTUATOR_VENDOR_CANDIDATE | joint actuator vendor geometry | PHYSICAL ENVELOPE | 71.000000 | 113.700000 | 27.767722 | 56.267722 | 554.750000 | 601.250000 | ROBOTIS-X430 SHA-bound manufacturer geometry in STEP; dimension-matched simplified body in GLB; project mounting interface remains candidate | CANDIDATE ENVELOPE - NOT A FABRICATION PART
JMOD_L_SHOULDER_PITCH_BELT_PATH_RESERVATION | joint transmission reservation | REFERENCE/RESERVATION | 86.000000 | 94.000000 | -0.001243 | 42.018965 | 585.998757 | 594.001243 | belt sweep/guard reservation only; no belt selection or load credit | CANDIDATE ENVELOPE - NOT A FABRICATION PART
JMOD_L_SHOULDER_ROLL_OUTPUT_SHAFT | joint module shaft | PHYSICAL ENVELOPE | 85.000000 | 95.000000 | -27.001554 | 27.001554 | 584.998446 | 595.001554 | JMF-03-SHOULDER-GIMBAL hollow shaft candidate with 6.2 mm through bore; material, wall, fits and retention selection required | CANDIDATE ENVELOPE - NOT A FABRICATION PART
JMOD_L_SHOULDER_ROLL_BEARING_A_RING | joint module bearing | PHYSICAL ENVELOPE | 79.000000 | 101.000000 | -23.003419 | -16.996581 | 578.996581 | 601.003419 | JMF-03-SHOULDER-GIMBAL 61900-2RS1 EVALUATION CANDIDATE catalogue envelope; load direction, life, suffix, fit, retention and application selection required | CANDIDATE ENVELOPE - NOT A FABRICATION PART
JMOD_L_SHOULDER_ROLL_INTERFACE_PLATE_A | joint module interface plate | PHYSICAL ENVELOPE | 63.998310 | 116.001690 | -27.002305 | -22.997695 | 561.998310 | 618.001690 | JMF-03-SHOULDER-GIMBAL provisional four-hole module interface; thread/fastener stack not released | CANDIDATE ENVELOPE - NOT A FABRICATION PART
JMOD_L_SHOULDER_ROLL_BEARING_B_RING | joint module bearing | PHYSICAL ENVELOPE | 79.000000 | 101.000000 | 16.996581 | 23.003419 | 578.996581 | 601.003419 | JMF-03-SHOULDER-GIMBAL 61900-2RS1 EVALUATION CANDIDATE catalogue envelope; load direction, life, suffix, fit, retention and application selection required | CANDIDATE ENVELOPE - NOT A FABRICATION PART
JMOD_L_SHOULDER_ROLL_INTERFACE_PLATE_B | joint module interface plate | PHYSICAL ENVELOPE | 63.998310 | 116.001690 | 22.997695 | 27.002305 | 561.998310 | 618.001690 | JMF-03-SHOULDER-GIMBAL provisional four-hole module interface; thread/fastener stack not released | CANDIDATE ENVELOPE - NOT A FABRICATION PART
JMOD_L_SHOULDER_ROLL_CABLE_CORRIDOR | joint cable corridor | REFERENCE/RESERVATION | 85.000000 | 95.000000 | -27.001554 | 27.001554 | 570.438446 | 580.441554 | JMF-03-SHOULDER-GIMBAL routing reservation; cable construction and bend control selection required | CANDIDATE ENVELOPE - NOT A FABRICATION PART
JMOD_L_SHOULDER_ROLL_OUTPUT_PULLEY | joint transmission | PHYSICAL ENVELOPE | 71.464240 | 108.535760 | -6.005760 | 6.005760 | 571.470000 | 608.530000 | 1.5:1 exact catalogue candidate lightweight spoked pulley envelope; pitch/width/tooth count selection required | CANDIDATE ENVELOPE - NOT A FABRICATION PART
JMOD_L_SHOULDER_ROLL_MOTOR_PULLEY | joint transmission | PHYSICAL ENVELOPE | 77.836220 | 102.163780 | -6.003780 | 6.003780 | 535.822278 | 560.142278 | 1.5:1 exact catalogue candidate lightweight spoked motor pulley envelope; bore and retention selection required | CANDIDATE ENVELOPE - NOT A FABRICATION PART
JMOD_L_SHOULDER_ROLL_ACTUATOR_VENDOR_CANDIDATE | joint actuator vendor geometry | PHYSICAL ENVELOPE | 75.750000 | 104.250000 | -19.000000 | 23.700000 | 512.732278 | 559.232278 | ROBOTIS-X430 SHA-bound manufacturer geometry in STEP; dimension-matched simplified body in GLB; project mounting interface remains candidate | CANDIDATE ENVELOPE - NOT A FABRICATION PART
JMOD_L_SHOULDER_ROLL_BELT_PATH_RESERVATION | joint transmission reservation | REFERENCE/RESERVATION | 85.998757 | 94.001243 | -4.000000 | 4.000000 | 547.981035 | 590.001243 | belt sweep/guard reservation only; no belt selection or load credit | CANDIDATE ENVELOPE - NOT A FABRICATION PART
JMOD_L_ELBOW_PITCH_OUTPUT_SHAFT | joint module shaft | PHYSICAL ENVELOPE | 100.998446 | 155.001554 | -5.000000 | 5.000000 | 439.891589 | 449.894697 | JMF-04-MEDIUM hollow shaft candidate with 6.2 mm through bore; material, wall, fits and retention selection required | CANDIDATE ENVELOPE - NOT A FABRICATION PART
JMOD_L_ELBOW_PITCH_BEARING_B_RING | joint module bearing | PHYSICAL ENVELOPE | 144.996581 | 151.003419 | -11.000000 | 11.000000 | 433.889724 | 455.896562 | JMF-04-MEDIUM 61900-2RS1 EVALUATION CANDIDATE catalogue envelope; load direction, life, suffix, fit, retention and application selection required | CANDIDATE ENVELOPE - NOT A FABRICATION PART
JMOD_L_ELBOW_PITCH_INTERFACE_PLATE_B | joint module interface plate | PHYSICAL ENVELOPE | 150.997695 | 155.002305 | -26.001690 | 26.001690 | 416.891453 | 472.894833 | JMF-04-MEDIUM provisional four-hole module interface; thread/fastener stack not released | CANDIDATE ENVELOPE - NOT A FABRICATION PART
JMOD_L_ELBOW_PITCH_CABLE_CORRIDOR | joint cable corridor | REFERENCE/RESERVATION | 100.998601 | 155.001399 | 10.060000 | 19.060000 | 440.391744 | 449.394542 | JMF-04-MEDIUM routing reservation; cable construction and bend control selection required | CANDIDATE ENVELOPE - NOT A FABRICATION PART
JMOD_L_ELBOW_PITCH_ACTUATOR_VENDOR_CANDIDATE | joint actuator vendor geometry | PHYSICAL ENVELOPE | 58.000000 | 100.700000 | -14.250000 | 14.250000 | 409.643143 | 456.143143 | ROBOTIS-X430 SHA-bound manufacturer geometry in STEP; dimension-matched simplified body in GLB; project mounting interface remains candidate | CANDIDATE ENVELOPE - NOT A FABRICATION PART
JMOD_L_ELBOW_PITCH_ACTUATOR_OUTPUT_COUPLER | joint transmission | PHYSICAL ENVELOPE | 76.998881 | 128.001119 | -3.600000 | 3.600000 | 441.292024 | 448.494262 | coaxial output coupling candidate; spline, clamp, material and retention selection required | CANDIDATE ENVELOPE - NOT A FABRICATION PART
JMOD_L_WRIST_ROTATION_OUTPUT_SHAFT | joint module shaft | PHYSICAL ENVELOPE | 129.999067 | 136.000933 | -3.000000 | 3.000000 | 280.978443 | 318.980308 | JMF-01-COMPACT hollow shaft candidate with 3.7 mm through bore; material, wall, fits and retention selection required | CANDIDATE ENVELOPE - NOT A FABRICATION PART
JMOD_L_WRIST_ROTATION_BEARING_B_RING | joint module bearing | PHYSICAL ENVELOPE | 125.497669 | 140.502331 | -7.500000 | 7.500000 | 310.977044 | 315.981707 | JMF-01-COMPACT 696 OPEN EVALUATION CANDIDATE catalogue envelope; load direction, life, suffix, fit, retention and application selection required | CANDIDATE ENVELOPE - NOT A FABRICATION PART
JMOD_L_WRIST_ROTATION_INTERFACE_PLATE_B | joint module interface plate | PHYSICAL ENVELOPE | 113.998811 | 152.001189 | -18.001189 | 18.001189 | 315.977785 | 318.980966 | JMF-01-COMPACT provisional four-hole module interface; thread/fastener stack not released | CANDIDATE ENVELOPE - NOT A FABRICATION PART
JMOD_L_WRIST_ROTATION_CABLE_CORRIDOR | joint cable corridor | REFERENCE/RESERVATION | 129.999067 | 136.000933 | 7.080000 | 13.080000 | 280.978443 | 318.980308 | JMF-01-COMPACT routing reservation; cable construction and bend control selection required | CANDIDATE ENVELOPE - NOT A FABRICATION PART
JMOD_L_WRIST_ROTATION_ACTUATOR_VENDOR_CANDIDATE | joint actuator vendor geometry | PHYSICAL ENVELOPE | 108.500000 | 142.500000 | -10.000000 | 10.000000 | 313.479375 | 342.479376 | ROBOTIS-XC330 SHA-bound manufacturer geometry in STEP; dimension-matched simplified body in GLB; project mounting interface remains candidate | CANDIDATE ENVELOPE - NOT A FABRICATION PART
JMOD_L_WRIST_ROTATION_ACTUATOR_OUTPUT_COUPLER | joint transmission | PHYSICAL ENVELOPE | 130.839329 | 135.160671 | -2.160000 | 2.160000 | 299.978704 | 335.980047 | coaxial output coupling candidate; spline, clamp, material and retention selection required | CANDIDATE ENVELOPE - NOT A FABRICATION PART
JMOD_L_GRIPPER_OUTPUT_SHAFT | joint module shaft | PHYSICAL ENVELOPE | 115.999223 | 150.000777 | -2.500000 | 2.500000 | 254.478598 | 259.480153 | JMF-02-GRIPPER hollow shaft candidate with 3.1 mm through bore; material, wall, fits and retention selection required | CANDIDATE ENVELOPE - NOT A FABRICATION PART
JMOD_L_GRIPPER_BEARING_B_RING | joint module bearing | PHYSICAL ENVELOPE | 141.997513 | 147.002487 | -8.000000 | 8.000000 | 248.976889 | 264.981862 | JMF-02-GRIPPER 625-2Z EVALUATION CANDIDATE catalogue envelope; load direction, life, suffix, fit, retention and application selection required | CANDIDATE ENVELOPE - NOT A FABRICATION PART
JMOD_L_GRIPPER_INTERFACE_PLATE_B | joint module interface plate | PHYSICAL ENVELOPE | 146.998447 | 150.001553 | -21.001189 | 21.001189 | 238.978186 | 274.980565 | JMF-02-GRIPPER provisional four-hole module interface; thread/fastener stack not released | CANDIDATE ENVELOPE - NOT A FABRICATION PART
JMOD_L_GRIPPER_CABLE_CORRIDOR | joint cable corridor | REFERENCE/RESERVATION | 115.999067 | 150.000933 | 7.640000 | 13.640000 | 253.978443 | 259.980308 | JMF-02-GRIPPER routing reservation; cable construction and bend control selection required | CANDIDATE ENVELOPE - NOT A FABRICATION PART
JMOD_L_GRIPPER_ACTUATOR_VENDOR_CANDIDATE | joint actuator vendor geometry | PHYSICAL ENVELOPE | 123.000000 | 143.000000 | -22.500000 | 6.500000 | 258.479375 | 292.479375 | ROBOTIS-XC330 SHA-bound manufacturer geometry mounted transversely in the palm; dimension-matched simplified body in GLB; project mounting interface remains candidate | CANDIDATE ENVELOPE - NOT A FABRICATION PART
JMOD_L_GRIPPER_SYMMETRIC_DRIVE_COUPLER | gripper transmission | PHYSICAL ENVELOPE | 129.999067 | 136.000933 | -3.000000 | 3.000000 | 256.978443 | 282.980308 | candidate rack/pinion or tendon equalizer connection; geometry is packaging-only | CANDIDATE ENVELOPE - NOT A FABRICATION PART
JMOD_L_HIP_YAW_OUTPUT_SHAFT | joint module shaft | PHYSICAL ENVELOPE | 56.498135 | 68.501865 | -6.000000 | 6.000000 | 374.998135 | 445.001865 | JMF-06-LEG-DIRECT hollow shaft candidate with 7.4 mm through bore; material, wall, fits and retention selection required | CANDIDATE ENVELOPE - NOT A FABRICATION PART
JMOD_L_HIP_YAW_BEARING_B_RING | joint module bearing | PHYSICAL ENVELOPE | 50.496270 | 74.503730 | -12.000000 | 12.000000 | 433.996270 | 440.003730 | JMF-06-LEG-DIRECT 6901 OPEN EVALUATION CANDIDATE catalogue envelope; load direction, life, suffix, fit, retention and application selection required | CANDIDATE ENVELOPE - NOT A FABRICATION PART
JMOD_L_HIP_YAW_INTERFACE_PLATE_B | joint module interface plate | PHYSICAL ENVELOPE | 27.498029 | 97.501971 | -33.001971 | 33.001971 | 439.997204 | 445.002796 | JMF-06-LEG-DIRECT provisional four-hole module interface; thread/fastener stack not released | CANDIDATE ENVELOPE - NOT A FABRICATION PART
JMOD_L_HIP_YAW_CABLE_CORRIDOR | joint cable corridor | REFERENCE/RESERVATION | 56.498135 | 68.501865 | 12.480000 | 24.480000 | 374.998135 | 445.001865 | JMF-06-LEG-DIRECT routing reservation; cable construction and bend control selection required | CANDIDATE ENVELOPE - NOT A FABRICATION PART
JMOD_L_HIP_YAW_ACTUATOR_VENDOR_CANDIDATE | joint actuator vendor geometry | PHYSICAL ENVELOPE | 17.750000 | 76.250000 | -16.750000 | 16.750000 | 324.500000 | 378.800000 | ROBOTIS-540 SHA-bound manufacturer geometry in STEP; dimension-matched simplified body in GLB; project mounting interface remains candidate | CANDIDATE ENVELOPE - NOT A FABRICATION PART
JMOD_L_HIP_YAW_ACTUATOR_OUTPUT_COUPLER | joint transmission | PHYSICAL ENVELOPE | 58.178657 | 66.821343 | -4.320000 | 4.320000 | 348.998657 | 410.001343 | coaxial output coupling candidate; spline, clamp, material and retention selection required | CANDIDATE ENVELOPE - NOT A FABRICATION PART
JMOD_L_HIP_ROLL_OUTPUT_SHAFT | joint module shaft | PHYSICAL ENVELOPE | 56.500000 | 68.500000 | -37.001865 | 37.001865 | 383.998135 | 396.001865 | JMF-08-LEG-REDUCED-20 hollow shaft candidate with 7.4 mm through bore; material, wall, fits and retention selection required | CANDIDATE ENVELOPE - NOT A FABRICATION PART
JMOD_L_HIP_ROLL_BEARING_A_RING | joint module bearing | PHYSICAL ENVELOPE | 50.500000 | 74.500000 | -32.003730 | -25.996270 | 377.996270 | 402.003730 | JMF-08-LEG-REDUCED-20 6901 OPEN EVALUATION CANDIDATE catalogue envelope; load direction, life, suffix, fit, retention and application selection required | CANDIDATE ENVELOPE - NOT A FABRICATION PART
JMOD_L_HIP_ROLL_INTERFACE_PLATE_A | joint module interface plate | PHYSICAL ENVELOPE | 25.498029 | 99.501971 | -37.002752 | -31.997248 | 354.998029 | 425.001971 | JMF-08-LEG-REDUCED-20 provisional four-hole module interface; thread/fastener stack not released | CANDIDATE ENVELOPE - NOT A FABRICATION PART
JMOD_L_HIP_ROLL_BEARING_B_RING | joint module bearing | PHYSICAL ENVELOPE | 50.500000 | 74.500000 | 25.996270 | 32.003730 | 377.996270 | 402.003730 | JMF-08-LEG-REDUCED-20 6901 OPEN EVALUATION CANDIDATE catalogue envelope; load direction, life, suffix, fit, retention and application selection required | CANDIDATE ENVELOPE - NOT A FABRICATION PART
JMOD_L_HIP_ROLL_INTERFACE_PLATE_B | joint module interface plate | PHYSICAL ENVELOPE | 25.498029 | 99.501971 | 31.997248 | 37.002752 | 354.998029 | 425.001971 | JMF-08-LEG-REDUCED-20 provisional four-hole module interface; thread/fastener stack not released | CANDIDATE ENVELOPE - NOT A FABRICATION PART
JMOD_L_HIP_ROLL_CABLE_CORRIDOR | joint cable corridor | REFERENCE/RESERVATION | 56.500000 | 68.500000 | -37.001865 | 37.001865 | 364.398135 | 376.401865 | JMF-08-LEG-REDUCED-20 routing reservation; cable construction and bend control selection required | CANDIDATE ENVELOPE - NOT A FABRICATION PART
JMOD_L_HIP_ROLL_OUTPUT_PULLEY | joint transmission | PHYSICAL ENVELOPE | 31.230284 | 93.769716 | -6.009716 | 6.009716 | 358.740000 | 421.260000 | 2.0:1 exact product/geometry candidate lightweight spoked pulley envelope; pitch/width/tooth count selection required | CANDIDATE ENVELOPE - NOT A FABRICATION PART
JMOD_L_HIP_ROLL_MOTOR_PULLEY | joint transmission | PHYSICAL ENVELOPE | 47.150230 | 77.849770 | -6.004770 | 6.004770 | 324.689793 | 355.379794 | 2.0:1 exact product/geometry candidate lightweight spoked motor pulley envelope; bore and retention selection required | CANDIDATE ENVELOPE - NOT A FABRICATION PART
JMOD_L_HIP_ROLL_ACTUATOR_VENDOR_CANDIDATE | joint actuator vendor geometry | PHYSICAL ENVELOPE | 45.750000 | 79.250000 | -24.500000 | 29.800000 | 295.284793 | 353.784793 | ROBOTIS-540 SHA-bound manufacturer geometry in STEP; dimension-matched simplified body in GLB; project mounting interface remains candidate | CANDIDATE ENVELOPE - NOT A FABRICATION PART
JMOD_L_HIP_ROLL_BELT_PATH_RESERVATION | joint transmission reservation | REFERENCE/RESERVATION | 58.498757 | 66.501243 | -4.000000 | 4.000000 | 340.033550 | 390.001243 | belt sweep/guard reservation only; no belt selection or load credit | CANDIDATE ENVELOPE - NOT A FABRICATION PART
JMOD_L_HIP_PITCH_OUTPUT_SHAFT | joint module shaft | PHYSICAL ENVELOPE | 25.498135 | 99.501865 | -6.000000 | 6.000000 | 363.998135 | 376.001865 | JMF-07-LEG-REDUCED-15 hollow shaft candidate with 7.4 mm through bore; material, wall, fits and retention selection required | CANDIDATE ENVELOPE - NOT A FABRICATION PART
JMOD_L_HIP_PITCH_BEARING_A_RING | joint module bearing | PHYSICAL ENVELOPE | 30.496270 | 36.503730 | -12.000000 | 12.000000 | 357.996270 | 382.003730 | JMF-07-LEG-REDUCED-15 6901 OPEN EVALUATION CANDIDATE catalogue envelope; load direction, life, suffix, fit, retention and application selection required | CANDIDATE ENVELOPE - NOT A FABRICATION PART
JMOD_L_HIP_PITCH_INTERFACE_PLATE_A | joint module interface plate | PHYSICAL ENVELOPE | 25.497371 | 30.502629 | -36.001971 | 36.001971 | 330.998029 | 409.001971 | JMF-07-LEG-REDUCED-15 provisional four-hole module interface; thread/fastener stack not released | CANDIDATE ENVELOPE - NOT A FABRICATION PART
JMOD_L_HIP_PITCH_BEARING_B_RING | joint module bearing | PHYSICAL ENVELOPE | 88.496270 | 94.503730 | -12.000000 | 12.000000 | 357.996270 | 382.003730 | JMF-07-LEG-REDUCED-15 6901 OPEN EVALUATION CANDIDATE catalogue envelope; load direction, life, suffix, fit, retention and application selection required | CANDIDATE ENVELOPE - NOT A FABRICATION PART
JMOD_L_HIP_PITCH_INTERFACE_PLATE_B | joint module interface plate | PHYSICAL ENVELOPE | 94.497371 | 99.502629 | -36.001971 | 36.001971 | 330.998029 | 409.001971 | JMF-07-LEG-REDUCED-15 provisional four-hole module interface; thread/fastener stack not released | CANDIDATE ENVELOPE - NOT A FABRICATION PART
JMOD_L_HIP_PITCH_CABLE_CORRIDOR | joint cable corridor | REFERENCE/RESERVATION | 25.498135 | 99.501865 | -6.000000 | 6.000000 | 343.838135 | 355.841865 | JMF-07-LEG-REDUCED-15 routing reservation; cable construction and bend control selection required | CANDIDATE ENVELOPE - NOT A FABRICATION PART
JMOD_L_HIP_PITCH_OUTPUT_PULLEY | joint transmission | PHYSICAL ENVELOPE | 56.492756 | 68.507244 | -23.312244 | 23.312244 | 346.695000 | 393.305000 | 1.5:1 exact product/geometry candidate lightweight spoked pulley envelope; pitch/width/tooth count selection required | CANDIDATE ENVELOPE - NOT A FABRICATION PART
JMOD_L_HIP_PITCH_MOTOR_PULLEY | joint transmission | PHYSICAL ENVELOPE | 56.495230 | 68.504770 | -15.349770 | 15.349770 | 305.296487 | 335.986488 | 1.5:1 exact product/geometry candidate lightweight spoked motor pulley envelope; bore and retention selection required | CANDIDATE ENVELOPE - NOT A FABRICATION PART
JMOD_L_HIP_PITCH_ACTUATOR_VENDOR_CANDIDATE | joint actuator vendor geometry | PHYSICAL ENVELOPE | 38.000000 | 92.300000 | -16.750000 | 16.750000 | 275.891488 | 334.391488 | ROBOTIS-540 SHA-bound manufacturer geometry in STEP; dimension-matched simplified body in GLB; project mounting interface remains candidate | CANDIDATE ENVELOPE - NOT A FABRICATION PART
JMOD_L_HIP_PITCH_BELT_PATH_RESERVATION | joint transmission reservation | REFERENCE/RESERVATION | 58.498757 | 66.501243 | -4.000000 | 4.000000 | 320.640244 | 370.001243 | belt sweep/guard reservation only; no belt selection or load credit | CANDIDATE ENVELOPE - NOT A FABRICATION PART
JMOD_L_KNEE_PITCH_OUTPUT_SHAFT | joint module shaft | PHYSICAL ENVELOPE | 25.498135 | 99.501865 | -6.000000 | 6.000000 | 203.998135 | 216.001865 | JMF-09-KNEE-REDUCED-25 hollow shaft candidate with 7.4 mm through bore; material, wall, fits and retention selection required | CANDIDATE ENVELOPE - NOT A FABRICATION PART
JMOD_L_KNEE_PITCH_BEARING_A_RING | joint module bearing | PHYSICAL ENVELOPE | 30.496270 | 36.503730 | -12.000000 | 12.000000 | 197.996270 | 222.003730 | JMF-09-KNEE-REDUCED-25 6901 OPEN EVALUATION CANDIDATE catalogue envelope; load direction, life, suffix, fit, retention and application selection required | CANDIDATE ENVELOPE - NOT A FABRICATION PART
JMOD_L_KNEE_PITCH_INTERFACE_PLATE_A | joint module interface plate | PHYSICAL ENVELOPE | 25.497277 | 30.502723 | -37.001971 | 37.001971 | 170.998029 | 249.001971 | JMF-09-KNEE-REDUCED-25 provisional four-hole module interface; thread/fastener stack not released | CANDIDATE ENVELOPE - NOT A FABRICATION PART
JMOD_L_KNEE_PITCH_BEARING_B_RING | joint module bearing | PHYSICAL ENVELOPE | 88.496270 | 94.503730 | -12.000000 | 12.000000 | 197.996270 | 222.003730 | JMF-09-KNEE-REDUCED-25 6901 OPEN EVALUATION CANDIDATE catalogue envelope; load direction, life, suffix, fit, retention and application selection required | CANDIDATE ENVELOPE - NOT A FABRICATION PART
JMOD_L_KNEE_PITCH_INTERFACE_PLATE_B | joint module interface plate | PHYSICAL ENVELOPE | 94.497277 | 99.502723 | -37.001971 | 37.001971 | 170.998029 | 249.001971 | JMF-09-KNEE-REDUCED-25 provisional four-hole module interface; thread/fastener stack not released | CANDIDATE ENVELOPE - NOT A FABRICATION PART
JMOD_L_KNEE_PITCH_CABLE_CORRIDOR | joint cable corridor | REFERENCE/RESERVATION | 25.498135 | 99.501865 | -6.000000 | 6.000000 | 224.718135 | 236.721865 | JMF-09-KNEE-REDUCED-25 routing reservation; cable construction and bend control selection required | CANDIDATE ENVELOPE - NOT A FABRICATION PART
JMOD_L_KNEE_PITCH_OUTPUT_PULLEY | joint transmission | PHYSICAL ENVELOPE | 56.490284 | 68.509716 | -31.269716 | 31.269716 | 178.740000 | 241.260000 | 2.5:1 exact product/geometry candidate lightweight spoked pulley envelope; pitch/width/tooth count selection required | CANDIDATE ENVELOPE - NOT A FABRICATION PART
JMOD_L_KNEE_PITCH_MOTOR_PULLEY | joint transmission | PHYSICAL ENVELOPE | 56.496220 | 68.503780 | -12.163780 | 12.163780 | 249.295623 | 273.615623 | 2.5:1 exact product/geometry candidate lightweight spoked motor pulley envelope; bore and retention selection required | CANDIDATE ENVELOPE - NOT A FABRICATION PART
JMOD_L_KNEE_PITCH_ACTUATOR_VENDOR_CANDIDATE | joint actuator vendor geometry | PHYSICAL ENVELOPE | 38.000000 | 92.300000 | -16.750000 | 16.750000 | 216.705623 | 275.205623 | ROBOTIS-540 SHA-bound manufacturer geometry in STEP; dimension-matched simplified body in GLB; project mounting interface remains candidate | CANDIDATE ENVELOPE - NOT A FABRICATION PART
JMOD_L_KNEE_PITCH_BELT_PATH_RESERVATION | joint transmission reservation | REFERENCE/RESERVATION | 58.498757 | 66.501243 | -4.000000 | 4.000000 | 209.998757 | 261.456866 | belt sweep/guard reservation only; no belt selection or load credit | CANDIDATE ENVELOPE - NOT A FABRICATION PART
JMOD_L_ANKLE_PITCH_OUTPUT_SHAFT | joint module shaft | PHYSICAL ENVELOPE | 25.498135 | 99.501865 | -6.000000 | 6.000000 | 48.998135 | 61.001865 | JMF-10-ANKLE-PITCH-REDUCED-25 hollow shaft candidate with 7.4 mm through bore; material, wall, fits and retention selection required | CANDIDATE ENVELOPE - NOT A FABRICATION PART
JMOD_L_ANKLE_PITCH_BEARING_A_RING | joint module bearing | PHYSICAL ENVELOPE | 30.496270 | 36.503730 | -12.000000 | 12.000000 | 42.996270 | 67.003730 | JMF-10-ANKLE-PITCH-REDUCED-25 6901 OPEN EVALUATION CANDIDATE catalogue envelope; load direction, life, suffix, fit, retention and application selection required | CANDIDATE ENVELOPE - NOT A FABRICATION PART
JMOD_L_ANKLE_PITCH_INTERFACE_PLATE_A | joint module interface plate | PHYSICAL ENVELOPE | 25.497276 | 30.502724 | -37.001971 | 37.001971 | 18.998029 | 91.001971 | JMF-10-ANKLE-PITCH-REDUCED-25 provisional four-hole module interface; thread/fastener stack not released | CANDIDATE ENVELOPE - NOT A FABRICATION PART
JMOD_L_ANKLE_PITCH_BEARING_B_RING | joint module bearing | PHYSICAL ENVELOPE | 88.496270 | 94.503730 | -12.000000 | 12.000000 | 42.996270 | 67.003730 | JMF-10-ANKLE-PITCH-REDUCED-25 6901 OPEN EVALUATION CANDIDATE catalogue envelope; load direction, life, suffix, fit, retention and application selection required | CANDIDATE ENVELOPE - NOT A FABRICATION PART
JMOD_L_ANKLE_PITCH_INTERFACE_PLATE_B | joint module interface plate | PHYSICAL ENVELOPE | 94.497276 | 99.502724 | -37.001971 | 37.001971 | 18.998029 | 91.001971 | JMF-10-ANKLE-PITCH-REDUCED-25 provisional four-hole module interface; thread/fastener stack not released | CANDIDATE ENVELOPE - NOT A FABRICATION PART
JMOD_L_ANKLE_PITCH_CABLE_CORRIDOR | joint cable corridor | REFERENCE/RESERVATION | 25.498446 | 99.501554 | -5.000000 | 5.000000 | 70.158446 | 80.161554 | JMF-10-ANKLE-PITCH-REDUCED-25 routing reservation; cable construction and bend control selection required | CANDIDATE ENVELOPE - NOT A FABRICATION PART
JMOD_L_ANKLE_PITCH_OUTPUT_PULLEY | joint transmission | PHYSICAL ENVELOPE | 56.490284 | 68.509716 | -31.269716 | 31.269716 | 23.740000 | 86.260000 | 2.5:1 exact product/geometry candidate lightweight spoked pulley envelope; pitch/width/tooth count selection required | CANDIDATE ENVELOPE - NOT A FABRICATION PART
JMOD_L_ANKLE_PITCH_MOTOR_PULLEY | joint transmission | PHYSICAL ENVELOPE | 56.496220 | 68.503780 | -12.163780 | 12.163780 | 94.295623 | 118.615623 | 2.5:1 exact product/geometry candidate lightweight spoked motor pulley envelope; bore and retention selection required | CANDIDATE ENVELOPE - NOT A FABRICATION PART
JMOD_L_ANKLE_PITCH_ACTUATOR_VENDOR_CANDIDATE | joint actuator vendor geometry | PHYSICAL ENVELOPE | 43.500000 | 86.200000 | -14.250000 | 14.250000 | 71.205623 | 117.705623 | ROBOTIS-X430 SHA-bound manufacturer geometry in STEP; dimension-matched simplified body in GLB; project mounting interface remains candidate | CANDIDATE ENVELOPE - NOT A FABRICATION PART
JMOD_L_ANKLE_PITCH_BELT_PATH_RESERVATION | joint transmission reservation | REFERENCE/RESERVATION | 58.498757 | 66.501243 | -4.000000 | 4.000000 | 54.998757 | 106.456866 | belt sweep/guard reservation only; no belt selection or load credit | CANDIDATE ENVELOPE - NOT A FABRICATION PART
JMOD_L_ANKLE_ROLL_OUTPUT_SHAFT | joint module shaft | PHYSICAL ENVELOPE | 56.500000 | 68.500000 | -37.001865 | 37.001865 | 28.998135 | 41.001865 | JMF-08-LEG-REDUCED-20 hollow shaft candidate with 7.4 mm through bore; material, wall, fits and retention selection required | CANDIDATE ENVELOPE - NOT A FABRICATION PART
JMOD_L_ANKLE_ROLL_BEARING_A_RING | joint module bearing | PHYSICAL ENVELOPE | 50.500000 | 74.500000 | -32.003730 | -25.996270 | 22.996270 | 47.003730 | JMF-08-LEG-REDUCED-20 6901 OPEN EVALUATION CANDIDATE catalogue envelope; load direction, life, suffix, fit, retention and application selection required | CANDIDATE ENVELOPE - NOT A FABRICATION PART
JMOD_L_ANKLE_ROLL_INTERFACE_PLATE_A | joint module interface plate | PHYSICAL ENVELOPE | 25.498029 | 99.501971 | -37.002752 | -31.997248 | -0.001971 | 70.001971 | JMF-08-LEG-REDUCED-20 provisional four-hole module interface; thread/fastener stack not released | CANDIDATE ENVELOPE - NOT A FABRICATION PART
JMOD_L_ANKLE_ROLL_BEARING_B_RING | joint module bearing | PHYSICAL ENVELOPE | 50.500000 | 74.500000 | 25.996270 | 32.003730 | 22.996270 | 47.003730 | JMF-08-LEG-REDUCED-20 6901 OPEN EVALUATION CANDIDATE catalogue envelope; load direction, life, suffix, fit, retention and application selection required | CANDIDATE ENVELOPE - NOT A FABRICATION PART
JMOD_L_ANKLE_ROLL_INTERFACE_PLATE_B | joint module interface plate | PHYSICAL ENVELOPE | 25.498029 | 99.501971 | 31.997248 | 37.002752 | -0.001971 | 70.001971 | JMF-08-LEG-REDUCED-20 provisional four-hole module interface; thread/fastener stack not released | CANDIDATE ENVELOPE - NOT A FABRICATION PART
JMOD_L_ANKLE_ROLL_CABLE_CORRIDOR | joint cable corridor | REFERENCE/RESERVATION | 56.500000 | 68.500000 | -37.001865 | 37.001865 | 48.598135 | 60.601865 | JMF-08-LEG-REDUCED-20 routing reservation; cable construction and bend control selection required | CANDIDATE ENVELOPE - NOT A FABRICATION PART
JMOD_L_ANKLE_ROLL_OUTPUT_PULLEY | joint transmission | PHYSICAL ENVELOPE | 31.230284 | 93.769716 | -6.009716 | 6.009716 | 3.740000 | 66.260000 | 2.0:1 exact product/geometry candidate lightweight spoked pulley envelope; pitch/width/tooth count selection required | CANDIDATE ENVELOPE - NOT A FABRICATION PART
JMOD_L_ANKLE_ROLL_MOTOR_PULLEY | joint transmission | PHYSICAL ENVELOPE | 47.150230 | 77.849770 | -6.004770 | 6.004770 | 69.620206 | 100.310207 | 2.0:1 exact product/geometry candidate lightweight spoked motor pulley envelope; bore and retention selection required | CANDIDATE ENVELOPE - NOT A FABRICATION PART
JMOD_L_ANKLE_ROLL_ACTUATOR_VENDOR_CANDIDATE | joint actuator vendor geometry | PHYSICAL ENVELOPE | 48.250000 | 76.750000 | -19.000000 | 23.700000 | 49.715207 | 96.215207 | ROBOTIS-X430 SHA-bound manufacturer geometry in STEP; dimension-matched simplified body in GLB; project mounting interface remains candidate | CANDIDATE ENVELOPE - NOT A FABRICATION PART
JMOD_L_ANKLE_ROLL_BELT_PATH_RESERVATION | joint transmission reservation | REFERENCE/RESERVATION | 58.498757 | 66.501243 | -4.000000 | 4.000000 | 34.998757 | 84.966450 | belt sweep/guard reservation only; no belt selection or load credit | CANDIDATE ENVELOPE - NOT A FABRICATION PART
JMOD_R_SHOULDER_PITCH_OUTPUT_SHAFT | joint module shaft | PHYSICAL ENVELOPE | -117.001554 | -62.998446 | -5.000000 | 5.000000 | 584.998446 | 595.001554 | JMF-03-SHOULDER-GIMBAL hollow shaft candidate with 6.2 mm through bore; material, wall, fits and retention selection required | CANDIDATE ENVELOPE - NOT A FABRICATION PART
JMOD_R_SHOULDER_PITCH_BEARING_A_RING | joint module bearing | PHYSICAL ENVELOPE | -113.003419 | -106.996581 | -11.000000 | 11.000000 | 578.996581 | 601.003419 | JMF-03-SHOULDER-GIMBAL 61900-2RS1 EVALUATION CANDIDATE catalogue envelope; load direction, life, suffix, fit, retention and application selection required | CANDIDATE ENVELOPE - NOT A FABRICATION PART
JMOD_R_SHOULDER_PITCH_INTERFACE_PLATE_A | joint module interface plate | PHYSICAL ENVELOPE | -117.002305 | -112.997695 | -26.001690 | 26.001690 | 561.998310 | 618.001690 | JMF-03-SHOULDER-GIMBAL provisional four-hole module interface; thread/fastener stack not released | CANDIDATE ENVELOPE - NOT A FABRICATION PART
JMOD_R_SHOULDER_PITCH_BEARING_B_RING | joint module bearing | PHYSICAL ENVELOPE | -73.003419 | -66.996581 | -11.000000 | 11.000000 | 578.996581 | 601.003419 | JMF-03-SHOULDER-GIMBAL 61900-2RS1 EVALUATION CANDIDATE catalogue envelope; load direction, life, suffix, fit, retention and application selection required | CANDIDATE ENVELOPE - NOT A FABRICATION PART
JMOD_R_SHOULDER_PITCH_INTERFACE_PLATE_B | joint module interface plate | PHYSICAL ENVELOPE | -67.002305 | -62.997695 | -26.001690 | 26.001690 | 561.998310 | 618.001690 | JMF-03-SHOULDER-GIMBAL provisional four-hole module interface; thread/fastener stack not released | CANDIDATE ENVELOPE - NOT A FABRICATION PART
JMOD_R_SHOULDER_PITCH_CABLE_CORRIDOR | joint cable corridor | REFERENCE/RESERVATION | -117.001554 | -62.998446 | 9.560000 | 19.560000 | 584.998446 | 595.001554 | JMF-03-SHOULDER-GIMBAL routing reservation; cable construction and bend control selection required | CANDIDATE ENVELOPE - NOT A FABRICATION PART
JMOD_R_SHOULDER_PITCH_OUTPUT_PULLEY | joint transmission | PHYSICAL ENVELOPE | -96.005760 | -83.994240 | -18.535760 | 18.535760 | 571.470000 | 608.530000 | 1.5:1 exact catalogue candidate lightweight spoked pulley envelope; pitch/width/tooth count selection required | CANDIDATE ENVELOPE - NOT A FABRICATION PART
JMOD_R_SHOULDER_PITCH_MOTOR_PULLEY | joint transmission | PHYSICAL ENVELOPE | -96.003780 | -83.996220 | 29.853942 | 54.181501 | 577.840000 | 602.160000 | 1.5:1 exact catalogue candidate lightweight spoked motor pulley envelope; bore and retention selection required | CANDIDATE ENVELOPE - NOT A FABRICATION PART
JMOD_R_SHOULDER_PITCH_ACTUATOR_VENDOR_CANDIDATE | joint actuator vendor geometry | PHYSICAL ENVELOPE | -109.000000 | -66.300000 | 27.767722 | 56.267722 | 554.750000 | 601.250000 | ROBOTIS-X430 SHA-bound manufacturer geometry in STEP; dimension-matched simplified body in GLB; project mounting interface remains candidate | CANDIDATE ENVELOPE - NOT A FABRICATION PART
JMOD_R_SHOULDER_PITCH_BELT_PATH_RESERVATION | joint transmission reservation | REFERENCE/RESERVATION | -94.000000 | -86.000000 | -0.001243 | 42.018965 | 585.998757 | 594.001243 | belt sweep/guard reservation only; no belt selection or load credit | CANDIDATE ENVELOPE - NOT A FABRICATION PART
JMOD_R_SHOULDER_ROLL_OUTPUT_SHAFT | joint module shaft | PHYSICAL ENVELOPE | -95.000000 | -85.000000 | -27.001554 | 27.001554 | 584.998446 | 595.001554 | JMF-03-SHOULDER-GIMBAL hollow shaft candidate with 6.2 mm through bore; material, wall, fits and retention selection required | CANDIDATE ENVELOPE - NOT A FABRICATION PART
JMOD_R_SHOULDER_ROLL_BEARING_A_RING | joint module bearing | PHYSICAL ENVELOPE | -101.000000 | -79.000000 | -23.003419 | -16.996581 | 578.996581 | 601.003419 | JMF-03-SHOULDER-GIMBAL 61900-2RS1 EVALUATION CANDIDATE catalogue envelope; load direction, life, suffix, fit, retention and application selection required | CANDIDATE ENVELOPE - NOT A FABRICATION PART
JMOD_R_SHOULDER_ROLL_INTERFACE_PLATE_A | joint module interface plate | PHYSICAL ENVELOPE | -116.001690 | -63.998310 | -27.002305 | -22.997695 | 561.998310 | 618.001690 | JMF-03-SHOULDER-GIMBAL provisional four-hole module interface; thread/fastener stack not released | CANDIDATE ENVELOPE - NOT A FABRICATION PART
JMOD_R_SHOULDER_ROLL_BEARING_B_RING | joint module bearing | PHYSICAL ENVELOPE | -101.000000 | -79.000000 | 16.996581 | 23.003419 | 578.996581 | 601.003419 | JMF-03-SHOULDER-GIMBAL 61900-2RS1 EVALUATION CANDIDATE catalogue envelope; load direction, life, suffix, fit, retention and application selection required | CANDIDATE ENVELOPE - NOT A FABRICATION PART
JMOD_R_SHOULDER_ROLL_INTERFACE_PLATE_B | joint module interface plate | PHYSICAL ENVELOPE | -116.001690 | -63.998310 | 22.997695 | 27.002305 | 561.998310 | 618.001690 | JMF-03-SHOULDER-GIMBAL provisional four-hole module interface; thread/fastener stack not released | CANDIDATE ENVELOPE - NOT A FABRICATION PART
JMOD_R_SHOULDER_ROLL_CABLE_CORRIDOR | joint cable corridor | REFERENCE/RESERVATION | -95.000000 | -85.000000 | -27.001554 | 27.001554 | 570.438446 | 580.441554 | JMF-03-SHOULDER-GIMBAL routing reservation; cable construction and bend control selection required | CANDIDATE ENVELOPE - NOT A FABRICATION PART
JMOD_R_SHOULDER_ROLL_OUTPUT_PULLEY | joint transmission | PHYSICAL ENVELOPE | -108.535760 | -71.464240 | -6.005760 | 6.005760 | 571.470000 | 608.530000 | 1.5:1 exact catalogue candidate lightweight spoked pulley envelope; pitch/width/tooth count selection required | CANDIDATE ENVELOPE - NOT A FABRICATION PART
JMOD_R_SHOULDER_ROLL_MOTOR_PULLEY | joint transmission | PHYSICAL ENVELOPE | -102.163780 | -77.836220 | -6.003780 | 6.003780 | 535.822278 | 560.142278 | 1.5:1 exact catalogue candidate lightweight spoked motor pulley envelope; bore and retention selection required | CANDIDATE ENVELOPE - NOT A FABRICATION PART
JMOD_R_SHOULDER_ROLL_ACTUATOR_VENDOR_CANDIDATE | joint actuator vendor geometry | PHYSICAL ENVELOPE | -104.250000 | -75.750000 | -19.000000 | 23.700000 | 512.732278 | 559.232278 | ROBOTIS-X430 SHA-bound manufacturer geometry in STEP; dimension-matched simplified body in GLB; project mounting interface remains candidate | CANDIDATE ENVELOPE - NOT A FABRICATION PART
JMOD_R_SHOULDER_ROLL_BELT_PATH_RESERVATION | joint transmission reservation | REFERENCE/RESERVATION | -94.001243 | -85.998757 | -4.000000 | 4.000000 | 547.981035 | 590.001243 | belt sweep/guard reservation only; no belt selection or load credit | CANDIDATE ENVELOPE - NOT A FABRICATION PART
JMOD_R_ELBOW_PITCH_OUTPUT_SHAFT | joint module shaft | PHYSICAL ENVELOPE | -155.001554 | -100.998446 | -5.000000 | 5.000000 | 439.891589 | 449.894697 | JMF-04-MEDIUM hollow shaft candidate with 6.2 mm through bore; material, wall, fits and retention selection required | CANDIDATE ENVELOPE - NOT A FABRICATION PART
JMOD_R_ELBOW_PITCH_BEARING_B_RING | joint module bearing | PHYSICAL ENVELOPE | -111.003419 | -104.996581 | -11.000000 | 11.000000 | 433.889724 | 455.896562 | JMF-04-MEDIUM 61900-2RS1 EVALUATION CANDIDATE catalogue envelope; load direction, life, suffix, fit, retention and application selection required | CANDIDATE ENVELOPE - NOT A FABRICATION PART
JMOD_R_ELBOW_PITCH_INTERFACE_PLATE_B | joint module interface plate | PHYSICAL ENVELOPE | -105.002305 | -100.997695 | -26.001690 | 26.001690 | 416.891453 | 472.894833 | JMF-04-MEDIUM provisional four-hole module interface; thread/fastener stack not released | CANDIDATE ENVELOPE - NOT A FABRICATION PART
JMOD_R_ELBOW_PITCH_CABLE_CORRIDOR | joint cable corridor | REFERENCE/RESERVATION | -155.001399 | -100.998601 | 10.060000 | 19.060000 | 440.391744 | 449.394542 | JMF-04-MEDIUM routing reservation; cable construction and bend control selection required | CANDIDATE ENVELOPE - NOT A FABRICATION PART
JMOD_R_ELBOW_PITCH_ACTUATOR_VENDOR_CANDIDATE | joint actuator vendor geometry | PHYSICAL ENVELOPE | -96.000000 | -53.300000 | -14.250000 | 14.250000 | 409.643143 | 456.143143 | ROBOTIS-X430 SHA-bound manufacturer geometry in STEP; dimension-matched simplified body in GLB; project mounting interface remains candidate | CANDIDATE ENVELOPE - NOT A FABRICATION PART
JMOD_R_ELBOW_PITCH_ACTUATOR_OUTPUT_COUPLER | joint transmission | PHYSICAL ENVELOPE | -128.001119 | -76.998881 | -3.600000 | 3.600000 | 441.292024 | 448.494262 | coaxial output coupling candidate; spline, clamp, material and retention selection required | CANDIDATE ENVELOPE - NOT A FABRICATION PART
JMOD_R_WRIST_ROTATION_OUTPUT_SHAFT | joint module shaft | PHYSICAL ENVELOPE | -136.000933 | -129.999067 | -3.000000 | 3.000000 | 280.978443 | 318.980308 | JMF-01-COMPACT hollow shaft candidate with 3.7 mm through bore; material, wall, fits and retention selection required | CANDIDATE ENVELOPE - NOT A FABRICATION PART
JMOD_R_WRIST_ROTATION_BEARING_B_RING | joint module bearing | PHYSICAL ENVELOPE | -140.502331 | -125.497669 | -7.500000 | 7.500000 | 310.977044 | 315.981707 | JMF-01-COMPACT 696 OPEN EVALUATION CANDIDATE catalogue envelope; load direction, life, suffix, fit, retention and application selection required | CANDIDATE ENVELOPE - NOT A FABRICATION PART
JMOD_R_WRIST_ROTATION_INTERFACE_PLATE_B | joint module interface plate | PHYSICAL ENVELOPE | -152.001189 | -113.998811 | -18.001189 | 18.001189 | 315.977785 | 318.980966 | JMF-01-COMPACT provisional four-hole module interface; thread/fastener stack not released | CANDIDATE ENVELOPE - NOT A FABRICATION PART
JMOD_R_WRIST_ROTATION_CABLE_CORRIDOR | joint cable corridor | REFERENCE/RESERVATION | -136.000933 | -129.999067 | 7.080000 | 13.080000 | 280.978443 | 318.980308 | JMF-01-COMPACT routing reservation; cable construction and bend control selection required | CANDIDATE ENVELOPE - NOT A FABRICATION PART
JMOD_R_WRIST_ROTATION_ACTUATOR_VENDOR_CANDIDATE | joint actuator vendor geometry | PHYSICAL ENVELOPE | -157.500000 | -123.500000 | -10.000000 | 10.000000 | 313.479375 | 342.479376 | ROBOTIS-XC330 SHA-bound manufacturer geometry in STEP; dimension-matched simplified body in GLB; project mounting interface remains candidate | CANDIDATE ENVELOPE - NOT A FABRICATION PART
JMOD_R_WRIST_ROTATION_ACTUATOR_OUTPUT_COUPLER | joint transmission | PHYSICAL ENVELOPE | -135.160671 | -130.839329 | -2.160000 | 2.160000 | 299.978704 | 335.980047 | coaxial output coupling candidate; spline, clamp, material and retention selection required | CANDIDATE ENVELOPE - NOT A FABRICATION PART
JMOD_R_GRIPPER_OUTPUT_SHAFT | joint module shaft | PHYSICAL ENVELOPE | -150.000777 | -115.999223 | -2.500000 | 2.500000 | 254.478598 | 259.480153 | JMF-02-GRIPPER hollow shaft candidate with 3.1 mm through bore; material, wall, fits and retention selection required | CANDIDATE ENVELOPE - NOT A FABRICATION PART
JMOD_R_GRIPPER_BEARING_B_RING | joint module bearing | PHYSICAL ENVELOPE | -147.002487 | -141.997513 | -8.000000 | 8.000000 | 248.976889 | 264.981862 | JMF-02-GRIPPER 625-2Z EVALUATION CANDIDATE catalogue envelope; load direction, life, suffix, fit, retention and application selection required | CANDIDATE ENVELOPE - NOT A FABRICATION PART
JMOD_R_GRIPPER_INTERFACE_PLATE_B | joint module interface plate | PHYSICAL ENVELOPE | -150.001553 | -146.998447 | -21.001189 | 21.001189 | 238.978186 | 274.980565 | JMF-02-GRIPPER provisional four-hole module interface; thread/fastener stack not released | CANDIDATE ENVELOPE - NOT A FABRICATION PART
JMOD_R_GRIPPER_CABLE_CORRIDOR | joint cable corridor | REFERENCE/RESERVATION | -150.000933 | -115.999067 | 7.640000 | 13.640000 | 253.978443 | 259.980308 | JMF-02-GRIPPER routing reservation; cable construction and bend control selection required | CANDIDATE ENVELOPE - NOT A FABRICATION PART
JMOD_R_GRIPPER_ACTUATOR_VENDOR_CANDIDATE | joint actuator vendor geometry | PHYSICAL ENVELOPE | -143.000000 | -123.000000 | -22.500000 | 6.500000 | 258.479375 | 292.479375 | ROBOTIS-XC330 SHA-bound manufacturer geometry mounted transversely in the palm; dimension-matched simplified body in GLB; project mounting interface remains candidate | CANDIDATE ENVELOPE - NOT A FABRICATION PART
JMOD_R_GRIPPER_SYMMETRIC_DRIVE_COUPLER | gripper transmission | PHYSICAL ENVELOPE | -136.000933 | -129.999067 | -3.000000 | 3.000000 | 256.978443 | 282.980308 | candidate rack/pinion or tendon equalizer connection; geometry is packaging-only | CANDIDATE ENVELOPE - NOT A FABRICATION PART
JMOD_R_HIP_YAW_OUTPUT_SHAFT | joint module shaft | PHYSICAL ENVELOPE | -68.501865 | -56.498135 | -6.000000 | 6.000000 | 374.998135 | 445.001865 | JMF-06-LEG-DIRECT hollow shaft candidate with 7.4 mm through bore; material, wall, fits and retention selection required | CANDIDATE ENVELOPE - NOT A FABRICATION PART
JMOD_R_HIP_YAW_BEARING_B_RING | joint module bearing | PHYSICAL ENVELOPE | -74.503730 | -50.496270 | -12.000000 | 12.000000 | 433.996270 | 440.003730 | JMF-06-LEG-DIRECT 6901 OPEN EVALUATION CANDIDATE catalogue envelope; load direction, life, suffix, fit, retention and application selection required | CANDIDATE ENVELOPE - NOT A FABRICATION PART
JMOD_R_HIP_YAW_INTERFACE_PLATE_B | joint module interface plate | PHYSICAL ENVELOPE | -97.501971 | -27.498029 | -33.001971 | 33.001971 | 439.997204 | 445.002796 | JMF-06-LEG-DIRECT provisional four-hole module interface; thread/fastener stack not released | CANDIDATE ENVELOPE - NOT A FABRICATION PART
JMOD_R_HIP_YAW_CABLE_CORRIDOR | joint cable corridor | REFERENCE/RESERVATION | -68.501865 | -56.498135 | 12.480000 | 24.480000 | 374.998135 | 445.001865 | JMF-06-LEG-DIRECT routing reservation; cable construction and bend control selection required | CANDIDATE ENVELOPE - NOT A FABRICATION PART
JMOD_R_HIP_YAW_ACTUATOR_VENDOR_CANDIDATE | joint actuator vendor geometry | PHYSICAL ENVELOPE | -107.250000 | -48.750000 | -16.750000 | 16.750000 | 324.500000 | 378.800000 | ROBOTIS-540 SHA-bound manufacturer geometry in STEP; dimension-matched simplified body in GLB; project mounting interface remains candidate | CANDIDATE ENVELOPE - NOT A FABRICATION PART
JMOD_R_HIP_YAW_ACTUATOR_OUTPUT_COUPLER | joint transmission | PHYSICAL ENVELOPE | -66.821343 | -58.178657 | -4.320000 | 4.320000 | 348.998657 | 410.001343 | coaxial output coupling candidate; spline, clamp, material and retention selection required | CANDIDATE ENVELOPE - NOT A FABRICATION PART
JMOD_R_HIP_ROLL_OUTPUT_SHAFT | joint module shaft | PHYSICAL ENVELOPE | -68.500000 | -56.500000 | -37.001865 | 37.001865 | 383.998135 | 396.001865 | JMF-08-LEG-REDUCED-20 hollow shaft candidate with 7.4 mm through bore; material, wall, fits and retention selection required | CANDIDATE ENVELOPE - NOT A FABRICATION PART
JMOD_R_HIP_ROLL_BEARING_A_RING | joint module bearing | PHYSICAL ENVELOPE | -74.500000 | -50.500000 | -32.003730 | -25.996270 | 377.996270 | 402.003730 | JMF-08-LEG-REDUCED-20 6901 OPEN EVALUATION CANDIDATE catalogue envelope; load direction, life, suffix, fit, retention and application selection required | CANDIDATE ENVELOPE - NOT A FABRICATION PART
JMOD_R_HIP_ROLL_INTERFACE_PLATE_A | joint module interface plate | PHYSICAL ENVELOPE | -99.501971 | -25.498029 | -37.002752 | -31.997248 | 354.998029 | 425.001971 | JMF-08-LEG-REDUCED-20 provisional four-hole module interface; thread/fastener stack not released | CANDIDATE ENVELOPE - NOT A FABRICATION PART
JMOD_R_HIP_ROLL_BEARING_B_RING | joint module bearing | PHYSICAL ENVELOPE | -74.500000 | -50.500000 | 25.996270 | 32.003730 | 377.996270 | 402.003730 | JMF-08-LEG-REDUCED-20 6901 OPEN EVALUATION CANDIDATE catalogue envelope; load direction, life, suffix, fit, retention and application selection required | CANDIDATE ENVELOPE - NOT A FABRICATION PART
JMOD_R_HIP_ROLL_INTERFACE_PLATE_B | joint module interface plate | PHYSICAL ENVELOPE | -99.501971 | -25.498029 | 31.997248 | 37.002752 | 354.998029 | 425.001971 | JMF-08-LEG-REDUCED-20 provisional four-hole module interface; thread/fastener stack not released | CANDIDATE ENVELOPE - NOT A FABRICATION PART
JMOD_R_HIP_ROLL_CABLE_CORRIDOR | joint cable corridor | REFERENCE/RESERVATION | -68.500000 | -56.500000 | -37.001865 | 37.001865 | 364.398135 | 376.401865 | JMF-08-LEG-REDUCED-20 routing reservation; cable construction and bend control selection required | CANDIDATE ENVELOPE - NOT A FABRICATION PART
JMOD_R_HIP_ROLL_OUTPUT_PULLEY | joint transmission | PHYSICAL ENVELOPE | -93.769716 | -31.230284 | -6.009716 | 6.009716 | 358.740000 | 421.260000 | 2.0:1 exact product/geometry candidate lightweight spoked pulley envelope; pitch/width/tooth count selection required | CANDIDATE ENVELOPE - NOT A FABRICATION PART
JMOD_R_HIP_ROLL_MOTOR_PULLEY | joint transmission | PHYSICAL ENVELOPE | -77.849770 | -47.150230 | -6.004770 | 6.004770 | 324.689793 | 355.379794 | 2.0:1 exact product/geometry candidate lightweight spoked motor pulley envelope; bore and retention selection required | CANDIDATE ENVELOPE - NOT A FABRICATION PART
JMOD_R_HIP_ROLL_ACTUATOR_VENDOR_CANDIDATE | joint actuator vendor geometry | PHYSICAL ENVELOPE | -79.250000 | -45.750000 | -24.500000 | 29.800000 | 295.284793 | 353.784793 | ROBOTIS-540 SHA-bound manufacturer geometry in STEP; dimension-matched simplified body in GLB; project mounting interface remains candidate | CANDIDATE ENVELOPE - NOT A FABRICATION PART
JMOD_R_HIP_ROLL_BELT_PATH_RESERVATION | joint transmission reservation | REFERENCE/RESERVATION | -66.501243 | -58.498757 | -4.000000 | 4.000000 | 340.033550 | 390.001243 | belt sweep/guard reservation only; no belt selection or load credit | CANDIDATE ENVELOPE - NOT A FABRICATION PART
JMOD_R_HIP_PITCH_OUTPUT_SHAFT | joint module shaft | PHYSICAL ENVELOPE | -99.501865 | -25.498135 | -6.000000 | 6.000000 | 363.998135 | 376.001865 | JMF-07-LEG-REDUCED-15 hollow shaft candidate with 7.4 mm through bore; material, wall, fits and retention selection required | CANDIDATE ENVELOPE - NOT A FABRICATION PART
JMOD_R_HIP_PITCH_BEARING_A_RING | joint module bearing | PHYSICAL ENVELOPE | -94.503730 | -88.496270 | -12.000000 | 12.000000 | 357.996270 | 382.003730 | JMF-07-LEG-REDUCED-15 6901 OPEN EVALUATION CANDIDATE catalogue envelope; load direction, life, suffix, fit, retention and application selection required | CANDIDATE ENVELOPE - NOT A FABRICATION PART
JMOD_R_HIP_PITCH_INTERFACE_PLATE_A | joint module interface plate | PHYSICAL ENVELOPE | -99.502629 | -94.497371 | -36.001971 | 36.001971 | 330.998029 | 409.001971 | JMF-07-LEG-REDUCED-15 provisional four-hole module interface; thread/fastener stack not released | CANDIDATE ENVELOPE - NOT A FABRICATION PART
JMOD_R_HIP_PITCH_BEARING_B_RING | joint module bearing | PHYSICAL ENVELOPE | -36.503730 | -30.496270 | -12.000000 | 12.000000 | 357.996270 | 382.003730 | JMF-07-LEG-REDUCED-15 6901 OPEN EVALUATION CANDIDATE catalogue envelope; load direction, life, suffix, fit, retention and application selection required | CANDIDATE ENVELOPE - NOT A FABRICATION PART
JMOD_R_HIP_PITCH_INTERFACE_PLATE_B | joint module interface plate | PHYSICAL ENVELOPE | -30.502629 | -25.497371 | -36.001971 | 36.001971 | 330.998029 | 409.001971 | JMF-07-LEG-REDUCED-15 provisional four-hole module interface; thread/fastener stack not released | CANDIDATE ENVELOPE - NOT A FABRICATION PART
JMOD_R_HIP_PITCH_CABLE_CORRIDOR | joint cable corridor | REFERENCE/RESERVATION | -99.501865 | -25.498135 | -6.000000 | 6.000000 | 343.838135 | 355.841865 | JMF-07-LEG-REDUCED-15 routing reservation; cable construction and bend control selection required | CANDIDATE ENVELOPE - NOT A FABRICATION PART
JMOD_R_HIP_PITCH_OUTPUT_PULLEY | joint transmission | PHYSICAL ENVELOPE | -68.507244 | -56.492756 | -23.312244 | 23.312244 | 346.695000 | 393.305000 | 1.5:1 exact product/geometry candidate lightweight spoked pulley envelope; pitch/width/tooth count selection required | CANDIDATE ENVELOPE - NOT A FABRICATION PART
JMOD_R_HIP_PITCH_MOTOR_PULLEY | joint transmission | PHYSICAL ENVELOPE | -68.504770 | -56.495230 | -15.349770 | 15.349770 | 305.296487 | 335.986488 | 1.5:1 exact product/geometry candidate lightweight spoked motor pulley envelope; bore and retention selection required | CANDIDATE ENVELOPE - NOT A FABRICATION PART
JMOD_R_HIP_PITCH_ACTUATOR_VENDOR_CANDIDATE | joint actuator vendor geometry | PHYSICAL ENVELOPE | -87.000000 | -32.700000 | -16.750000 | 16.750000 | 275.891488 | 334.391488 | ROBOTIS-540 SHA-bound manufacturer geometry in STEP; dimension-matched simplified body in GLB; project mounting interface remains candidate | CANDIDATE ENVELOPE - NOT A FABRICATION PART
JMOD_R_HIP_PITCH_BELT_PATH_RESERVATION | joint transmission reservation | REFERENCE/RESERVATION | -66.501243 | -58.498757 | -4.000000 | 4.000000 | 320.640244 | 370.001243 | belt sweep/guard reservation only; no belt selection or load credit | CANDIDATE ENVELOPE - NOT A FABRICATION PART
JMOD_R_KNEE_PITCH_OUTPUT_SHAFT | joint module shaft | PHYSICAL ENVELOPE | -99.501865 | -25.498135 | -6.000000 | 6.000000 | 203.998135 | 216.001865 | JMF-09-KNEE-REDUCED-25 hollow shaft candidate with 7.4 mm through bore; material, wall, fits and retention selection required | CANDIDATE ENVELOPE - NOT A FABRICATION PART
JMOD_R_KNEE_PITCH_BEARING_A_RING | joint module bearing | PHYSICAL ENVELOPE | -94.503730 | -88.496270 | -12.000000 | 12.000000 | 197.996270 | 222.003730 | JMF-09-KNEE-REDUCED-25 6901 OPEN EVALUATION CANDIDATE catalogue envelope; load direction, life, suffix, fit, retention and application selection required | CANDIDATE ENVELOPE - NOT A FABRICATION PART
JMOD_R_KNEE_PITCH_INTERFACE_PLATE_A | joint module interface plate | PHYSICAL ENVELOPE | -99.502723 | -94.497277 | -37.001971 | 37.001971 | 170.998029 | 249.001971 | JMF-09-KNEE-REDUCED-25 provisional four-hole module interface; thread/fastener stack not released | CANDIDATE ENVELOPE - NOT A FABRICATION PART
JMOD_R_KNEE_PITCH_BEARING_B_RING | joint module bearing | PHYSICAL ENVELOPE | -36.503730 | -30.496270 | -12.000000 | 12.000000 | 197.996270 | 222.003730 | JMF-09-KNEE-REDUCED-25 6901 OPEN EVALUATION CANDIDATE catalogue envelope; load direction, life, suffix, fit, retention and application selection required | CANDIDATE ENVELOPE - NOT A FABRICATION PART
JMOD_R_KNEE_PITCH_INTERFACE_PLATE_B | joint module interface plate | PHYSICAL ENVELOPE | -30.502723 | -25.497277 | -37.001971 | 37.001971 | 170.998029 | 249.001971 | JMF-09-KNEE-REDUCED-25 provisional four-hole module interface; thread/fastener stack not released | CANDIDATE ENVELOPE - NOT A FABRICATION PART
JMOD_R_KNEE_PITCH_CABLE_CORRIDOR | joint cable corridor | REFERENCE/RESERVATION | -99.501865 | -25.498135 | -6.000000 | 6.000000 | 224.718135 | 236.721865 | JMF-09-KNEE-REDUCED-25 routing reservation; cable construction and bend control selection required | CANDIDATE ENVELOPE - NOT A FABRICATION PART
JMOD_R_KNEE_PITCH_OUTPUT_PULLEY | joint transmission | PHYSICAL ENVELOPE | -68.509716 | -56.490284 | -31.269716 | 31.269716 | 178.740000 | 241.260000 | 2.5:1 exact product/geometry candidate lightweight spoked pulley envelope; pitch/width/tooth count selection required | CANDIDATE ENVELOPE - NOT A FABRICATION PART
JMOD_R_KNEE_PITCH_MOTOR_PULLEY | joint transmission | PHYSICAL ENVELOPE | -68.503780 | -56.496220 | -12.163780 | 12.163780 | 249.295623 | 273.615623 | 2.5:1 exact product/geometry candidate lightweight spoked motor pulley envelope; bore and retention selection required | CANDIDATE ENVELOPE - NOT A FABRICATION PART
JMOD_R_KNEE_PITCH_ACTUATOR_VENDOR_CANDIDATE | joint actuator vendor geometry | PHYSICAL ENVELOPE | -87.000000 | -32.700000 | -16.750000 | 16.750000 | 216.705623 | 275.205623 | ROBOTIS-540 SHA-bound manufacturer geometry in STEP; dimension-matched simplified body in GLB; project mounting interface remains candidate | CANDIDATE ENVELOPE - NOT A FABRICATION PART
JMOD_R_KNEE_PITCH_BELT_PATH_RESERVATION | joint transmission reservation | REFERENCE/RESERVATION | -66.501243 | -58.498757 | -4.000000 | 4.000000 | 209.998757 | 261.456866 | belt sweep/guard reservation only; no belt selection or load credit | CANDIDATE ENVELOPE - NOT A FABRICATION PART
JMOD_R_ANKLE_PITCH_OUTPUT_SHAFT | joint module shaft | PHYSICAL ENVELOPE | -99.501865 | -25.498135 | -6.000000 | 6.000000 | 48.998135 | 61.001865 | JMF-10-ANKLE-PITCH-REDUCED-25 hollow shaft candidate with 7.4 mm through bore; material, wall, fits and retention selection required | CANDIDATE ENVELOPE - NOT A FABRICATION PART
JMOD_R_ANKLE_PITCH_BEARING_A_RING | joint module bearing | PHYSICAL ENVELOPE | -94.503730 | -88.496270 | -12.000000 | 12.000000 | 42.996270 | 67.003730 | JMF-10-ANKLE-PITCH-REDUCED-25 6901 OPEN EVALUATION CANDIDATE catalogue envelope; load direction, life, suffix, fit, retention and application selection required | CANDIDATE ENVELOPE - NOT A FABRICATION PART
JMOD_R_ANKLE_PITCH_INTERFACE_PLATE_A | joint module interface plate | PHYSICAL ENVELOPE | -99.502724 | -94.497276 | -37.001971 | 37.001971 | 18.998029 | 91.001971 | JMF-10-ANKLE-PITCH-REDUCED-25 provisional four-hole module interface; thread/fastener stack not released | CANDIDATE ENVELOPE - NOT A FABRICATION PART
JMOD_R_ANKLE_PITCH_BEARING_B_RING | joint module bearing | PHYSICAL ENVELOPE | -36.503730 | -30.496270 | -12.000000 | 12.000000 | 42.996270 | 67.003730 | JMF-10-ANKLE-PITCH-REDUCED-25 6901 OPEN EVALUATION CANDIDATE catalogue envelope; load direction, life, suffix, fit, retention and application selection required | CANDIDATE ENVELOPE - NOT A FABRICATION PART
JMOD_R_ANKLE_PITCH_INTERFACE_PLATE_B | joint module interface plate | PHYSICAL ENVELOPE | -30.502724 | -25.497276 | -37.001971 | 37.001971 | 18.998029 | 91.001971 | JMF-10-ANKLE-PITCH-REDUCED-25 provisional four-hole module interface; thread/fastener stack not released | CANDIDATE ENVELOPE - NOT A FABRICATION PART
JMOD_R_ANKLE_PITCH_CABLE_CORRIDOR | joint cable corridor | REFERENCE/RESERVATION | -99.501554 | -25.498446 | -5.000000 | 5.000000 | 70.158446 | 80.161554 | JMF-10-ANKLE-PITCH-REDUCED-25 routing reservation; cable construction and bend control selection required | CANDIDATE ENVELOPE - NOT A FABRICATION PART
JMOD_R_ANKLE_PITCH_OUTPUT_PULLEY | joint transmission | PHYSICAL ENVELOPE | -68.509716 | -56.490284 | -31.269716 | 31.269716 | 23.740000 | 86.260000 | 2.5:1 exact product/geometry candidate lightweight spoked pulley envelope; pitch/width/tooth count selection required | CANDIDATE ENVELOPE - NOT A FABRICATION PART
JMOD_R_ANKLE_PITCH_MOTOR_PULLEY | joint transmission | PHYSICAL ENVELOPE | -68.503780 | -56.496220 | -12.163780 | 12.163780 | 94.295623 | 118.615623 | 2.5:1 exact product/geometry candidate lightweight spoked motor pulley envelope; bore and retention selection required | CANDIDATE ENVELOPE - NOT A FABRICATION PART
JMOD_R_ANKLE_PITCH_ACTUATOR_VENDOR_CANDIDATE | joint actuator vendor geometry | PHYSICAL ENVELOPE | -81.500000 | -38.800000 | -14.250000 | 14.250000 | 71.205623 | 117.705623 | ROBOTIS-X430 SHA-bound manufacturer geometry in STEP; dimension-matched simplified body in GLB; project mounting interface remains candidate | CANDIDATE ENVELOPE - NOT A FABRICATION PART
JMOD_R_ANKLE_PITCH_BELT_PATH_RESERVATION | joint transmission reservation | REFERENCE/RESERVATION | -66.501243 | -58.498757 | -4.000000 | 4.000000 | 54.998757 | 106.456866 | belt sweep/guard reservation only; no belt selection or load credit | CANDIDATE ENVELOPE - NOT A FABRICATION PART
JMOD_R_ANKLE_ROLL_OUTPUT_SHAFT | joint module shaft | PHYSICAL ENVELOPE | -68.500000 | -56.500000 | -37.001865 | 37.001865 | 28.998135 | 41.001865 | JMF-08-LEG-REDUCED-20 hollow shaft candidate with 7.4 mm through bore; material, wall, fits and retention selection required | CANDIDATE ENVELOPE - NOT A FABRICATION PART
JMOD_R_ANKLE_ROLL_BEARING_A_RING | joint module bearing | PHYSICAL ENVELOPE | -74.500000 | -50.500000 | -32.003730 | -25.996270 | 22.996270 | 47.003730 | JMF-08-LEG-REDUCED-20 6901 OPEN EVALUATION CANDIDATE catalogue envelope; load direction, life, suffix, fit, retention and application selection required | CANDIDATE ENVELOPE - NOT A FABRICATION PART
JMOD_R_ANKLE_ROLL_INTERFACE_PLATE_A | joint module interface plate | PHYSICAL ENVELOPE | -99.501971 | -25.498029 | -37.002752 | -31.997248 | -0.001971 | 70.001971 | JMF-08-LEG-REDUCED-20 provisional four-hole module interface; thread/fastener stack not released | CANDIDATE ENVELOPE - NOT A FABRICATION PART
JMOD_R_ANKLE_ROLL_BEARING_B_RING | joint module bearing | PHYSICAL ENVELOPE | -74.500000 | -50.500000 | 25.996270 | 32.003730 | 22.996270 | 47.003730 | JMF-08-LEG-REDUCED-20 6901 OPEN EVALUATION CANDIDATE catalogue envelope; load direction, life, suffix, fit, retention and application selection required | CANDIDATE ENVELOPE - NOT A FABRICATION PART
JMOD_R_ANKLE_ROLL_INTERFACE_PLATE_B | joint module interface plate | PHYSICAL ENVELOPE | -99.501971 | -25.498029 | 31.997248 | 37.002752 | -0.001971 | 70.001971 | JMF-08-LEG-REDUCED-20 provisional four-hole module interface; thread/fastener stack not released | CANDIDATE ENVELOPE - NOT A FABRICATION PART
JMOD_R_ANKLE_ROLL_CABLE_CORRIDOR | joint cable corridor | REFERENCE/RESERVATION | -68.500000 | -56.500000 | -37.001865 | 37.001865 | 48.598135 | 60.601865 | JMF-08-LEG-REDUCED-20 routing reservation; cable construction and bend control selection required | CANDIDATE ENVELOPE - NOT A FABRICATION PART
JMOD_R_ANKLE_ROLL_OUTPUT_PULLEY | joint transmission | PHYSICAL ENVELOPE | -93.769716 | -31.230284 | -6.009716 | 6.009716 | 3.740000 | 66.260000 | 2.0:1 exact product/geometry candidate lightweight spoked pulley envelope; pitch/width/tooth count selection required | CANDIDATE ENVELOPE - NOT A FABRICATION PART
JMOD_R_ANKLE_ROLL_MOTOR_PULLEY | joint transmission | PHYSICAL ENVELOPE | -77.849770 | -47.150230 | -6.004770 | 6.004770 | 69.620206 | 100.310207 | 2.0:1 exact product/geometry candidate lightweight spoked motor pulley envelope; bore and retention selection required | CANDIDATE ENVELOPE - NOT A FABRICATION PART
JMOD_R_ANKLE_ROLL_ACTUATOR_VENDOR_CANDIDATE | joint actuator vendor geometry | PHYSICAL ENVELOPE | -76.750000 | -48.250000 | -19.000000 | 23.700000 | 49.715207 | 96.215207 | ROBOTIS-X430 SHA-bound manufacturer geometry in STEP; dimension-matched simplified body in GLB; project mounting interface remains candidate | CANDIDATE ENVELOPE - NOT A FABRICATION PART
JMOD_R_ANKLE_ROLL_BELT_PATH_RESERVATION | joint transmission reservation | REFERENCE/RESERVATION | -66.501243 | -58.498757 | -4.000000 | 4.000000 | 34.998757 | 84.966450 | belt sweep/guard reservation only; no belt selection or load credit | CANDIDATE ENVELOPE - NOT A FABRICATION PART
