amyleesterling/humanoid-robot/bom/hr-v0-observation-bom-integration-p0.1/acceptance-matrix.csv

acceptance_id | criterion | execution_state | result | evidence_uri | approver | warning
R259-ACC-01 | BOM-099 through BOM-108 exist exactly once in the hierarchical BOM and closure register | NOT EXECUTED | OPEN |  |  | PRELIMINARY - NOT APPROVED FOR PROCUREMENT, FABRICATION, ASSEMBLY, CONNECTION, POWERED TESTING, MOTION, OR ENERGIZATION
R259-ACC-02 | Runtime PCBA quantity and 49-component/four-hole source scope agree | NOT EXECUTED | OPEN |  |  | PRELIMINARY - NOT APPROVED FOR PROCUREMENT, FABRICATION, ASSEMBLY, CONNECTION, POWERED TESTING, MOTION, OR ENERGIZATION
R259-ACC-03 | Pi PCBA quantity and two-component/four-hole source scope agree | NOT EXECUTED | OPEN |  |  | PRELIMINARY - NOT APPROVED FOR PROCUREMENT, FABRICATION, ASSEMBLY, CONNECTION, POWERED TESTING, MOTION, OR ENERGIZATION
R259-ACC-04 | Runtime and Pi terminal allocations total three item 1751280 candidates without duplication | NOT EXECUTED | OPEN |  |  | PRELIMINARY - NOT APPROVED FOR PROCUREMENT, FABRICATION, ASSEMBLY, CONNECTION, POWERED TESTING, MOTION, OR ENERGIZATION
R259-ACC-05 | One Samtec ESQ-120-33-G-D candidate is allocated only to JPI1 | NOT EXECUTED | OPEN |  |  | PRELIMINARY - NOT APPROVED FOR PROCUREMENT, FABRICATION, ASSEMBLY, CONNECTION, POWERED TESTING, MOTION, OR ENERGIZATION
R259-ACC-06 | Field harness has one assembly and five conductor identities | NOT EXECUTED | OPEN |  |  | PRELIMINARY - NOT APPROVED FOR PROCUREMENT, FABRICATION, ASSEMBLY, CONNECTION, POWERED TESTING, MOTION, OR ENERGIZATION
R259-ACC-07 | Compute harness has one assembly and six conductor identities | NOT EXECUTED | OPEN |  |  | PRELIMINARY - NOT APPROVED FOR PROCUREMENT, FABRICATION, ASSEMBLY, CONNECTION, POWERED TESTING, MOTION, OR ENERGIZATION
R259-ACC-08 | Eleven distinct Belden color/order-code candidates cover all eleven conductor rows | NOT EXECUTED | OPEN |  |  | PRELIMINARY - NOT APPROVED FOR PROCUREMENT, FABRICATION, ASSEMBLY, CONNECTION, POWERED TESTING, MOTION, OR ENERGIZATION
R259-ACC-09 | Both four-site mounting interfaces remain unresolved and unreleased | NOT EXECUTED | OPEN |  |  | PRELIMINARY - NOT APPROVED FOR PROCUREMENT, FABRICATION, ASSEMBLY, CONNECTION, POWERED TESTING, MOTION, OR ENERGIZATION
R259-ACC-10 | No procurement, fabrication, assembly, connection, powered testing, motion, energization or safety credit is authorized | NOT EXECUTED | OPEN |  |  | PRELIMINARY - NOT APPROVED FOR PROCUREMENT, FABRICATION, ASSEMBLY, CONNECTION, POWERED TESTING, MOTION, OR ENERGIZATION
