amyleesterling/humanoid-robot/bom/hr-v0-observation-bom-integration-p0.1/selection-holds.csv

hold_id | scope | evidence_required | state | warning
R259-H01 | runtime carrier fabrication and assembly | provider/process/stackup/DFM/XYRS/first article and received inspection | OPEN | PRELIMINARY - NOT APPROVED FOR PROCUREMENT, FABRICATION, ASSEMBLY, CONNECTION, POWERED TESTING, MOTION, OR ENERGIZATION
R259-H02 | Pi carrier fabrication and assembly | provider/process/DFM/header land/stack/first article and received inspection | OPEN | PRELIMINARY - NOT APPROVED FOR PROCUREMENT, FABRICATION, ASSEMBLY, CONNECTION, POWERED TESTING, MOTION, OR ENERGIZATION
R259-H03 | runtime mounting hardware | exact four-site hardware identities, stack, panel interface, torque and proof | DESIGN REQUIRED | PRELIMINARY - NOT APPROVED FOR PROCUREMENT, FABRICATION, ASSEMBLY, CONNECTION, POWERED TESTING, MOTION, OR ENERGIZATION
R259-H04 | Pi mounting hardware | exact four-site hardware identities, stack, cooler/case clearance, torque and fit | DESIGN REQUIRED | PRELIMINARY - NOT APPROVED FOR PROCUREMENT, FABRICATION, ASSEMBLY, CONNECTION, POWERED TESTING, MOTION, OR ENERGIZATION
R259-H05 | field harness | five cut lengths, routes, support, preparations, labels and physical results | SELECTION REQUIRED | PRELIMINARY - NOT APPROVED FOR PROCUREMENT, FABRICATION, ASSEMBLY, CONNECTION, POWERED TESTING, MOTION, OR ENERGIZATION
R259-H06 | compute harness | six cut lengths, routes, separation, support, preparations, labels and physical results | SELECTION REQUIRED | PRELIMINARY - NOT APPROVED FOR PROCUREMENT, FABRICATION, ASSEMBLY, CONNECTION, POWERED TESTING, MOTION, OR ENERGIZATION
R259-H07 | conductor material allocation | make/buy strategy, actual procurement quantities, received identity/DCR and process allowance | SELECTION REQUIRED | PRELIMINARY - NOT APPROVED FOR PROCUREMENT, FABRICATION, ASSEMBLY, CONNECTION, POWERED TESTING, MOTION, OR ENERGIZATION
R259-H08 | qualified review and authority | qualified electrical/mechanical/functional-safety dispositions and separate written stage authority | NOT EXECUTED | PRELIMINARY - NOT APPROVED FOR PROCUREMENT, FABRICATION, ASSEMBLY, CONNECTION, POWERED TESTING, MOTION, OR ENERGIZATION
