amyleesterling/humanoid-robot/references/gripper/robotis-gripper-orderable-source-register-p0.1.csv

source_id | manufacturer | title | url | revision_or_date | access_date | verified_claim | evidence_boundary
GOS-001 | ROBOTIS | FR12-G101GM Set | https://www.robotis.us/fr12-g101gm-set/ | web page; no document revision shown | 2026-08-08 | SKU 903-0256-300; X430 gripper frame set; five package line items; HN12-I101 required for XM430 and not included | commerce stock price and weight are time-sensitive and rejected for engineering mass or availability credit; page does not establish a complete HR-V0 mechanism
GOS-002 | ROBOTIS | HN12-I101 Set | https://www.robotis.us/hn12-i101-set/ | web page; no document revision shown | 2026-08-08 | SKU 903-0240-000; compatible with XH/XM430; four package line items; hinge frame excluded | commerce weight is rejected for engineering mass credit; no received fit retention or cable-clearance evidence
GOS-003 | ROBOTIS | DYNAMIXEL-X compatibility chart | https://en.robotis.com/service/compatibility_table.php?cate=dx | live compatibility chart; no document revision shown | 2026-08-08 | HN12-I101 row includes XM430-W350-T | compatibility listing is not an HR-V0 assembly release
GOS-004 | ROBOTIS | Drawing index - Frame | https://en.robotis.com/service/downloadpage.php?ca_id=7030 | live drawing index; no document revision shown | 2026-08-08 | FR12-H101K FR12-H103GM FR12-H104K FR12-S101K and FR12-S102K records are exposed | no FR12-G101GM FR12-E170GM or FR12-E171GM record was located; no gripper-frame drawing file was acquired
GOS-005 | ROBOTIS | OpenMANIPULATOR-X assembly | https://emanual.robotis.com/docs/en/platform/openmanipulator_x/assembly/ | live e-Manual; page revision not shown | 2026-08-08 | assembly page identifies the RM-X52-era complete mechanism parts and publisher-CAD routes | publisher CAD endpoint remains unavailable and public meshes do not provide manufacturing definition
