amyleesterling/humanoid-robot/hr30/whole-body-p0.1/first-build-cart-p0.1/purchase-candidate-register.csv

cart_id | disposition | manufacturer | order_code | description | quantity | unit_price_usd | extended_price_usd | shipping_tax | availability | source_id | project_use | authority
FBC-P01 | HUMAN APPROVAL REQUIRED | ROBOTIS | 902-0132-000 | U2D2 USB communication interface; reusable single-actuator commissioning tool | 1 | 36.92 | 36.92 | NOT INCLUDED | LISTED FOR SALE; NUMERIC STOCK NOT STATED | FBC-S01 | ONE DISCONNECTED ACTUATOR ONLY; NOT A WHOLE-BODY BUS CONTROLLER | NO ORDER PLACED / NO CONNECTION OR POWER AUTHORITY
FBC-P02 | HUMAN APPROVAL REQUIRED | ROBOTIS | 902-0145-001 | U2D2 Power Hub Board Set; reusable current-limited single-actuator bench interface | 1 | 21.85 | 21.85 | NOT INCLUDED | LISTED FOR SALE; NUMERIC STOCK NOT STATED | FBC-S03 | ONE ACTUATOR ONLY; REJECTED FOR SUMMED ROBOT POWER | NO ORDER PLACED / NO CONNECTION OR POWER AUTHORITY
