amyleesterling/humanoid-robot/cad/hr-v0/generated/HR-V0_preliminary_assembly.step

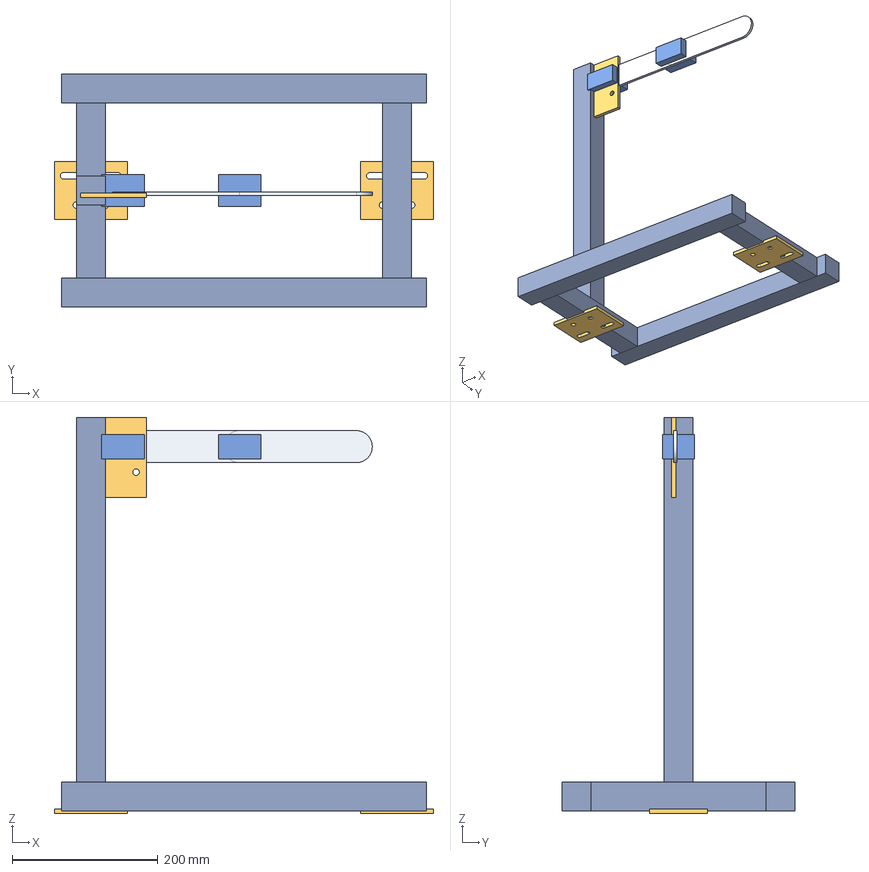
[picture p9: CAD file, 2026-08-10]
cad/hr-v0/generated/HR-V0_preliminary_assembly.step
520.0 x 320.0 x 543.2 mm
base_rear
base_front
base_left
base_right
column
MV0_003_adapter
J1_XM540_envelope
MV0_001_upper
J2_XM540_envelope
MV0_002_forearm
MV0_004_anchor_left
MV0_004_anchor_right
