amyleesterling/humanoid-robot/hr30/whole-body-p0.1/harness/physical-p0.1/HR30_whole_body_harness_centerlines_candidate.step

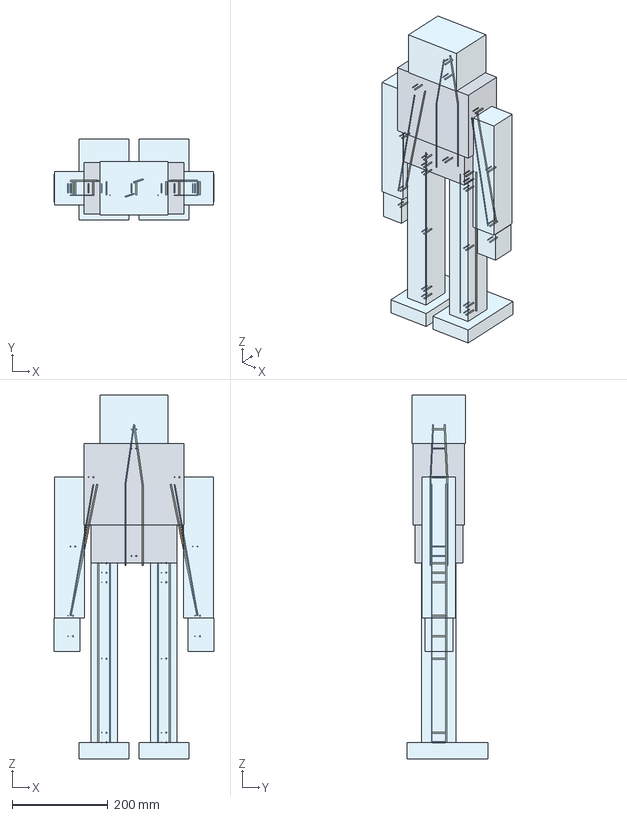
[picture p10: CAD file, 2026-08-17]
hr30/whole-body-p0.1/harness/physical-p0.1/HR30_whole_body_harness_centerlines_candidate.step
334.0 x 170.0 x 762.0 mm
BODY-LEFT-FOOT
BODY-RIGHT-FOOT
BODY-LEFT-LEG
BODY-RIGHT-LEG
BODY-PELVIS
BODY-TORSO
BODY-HEAD
BODY-LEFT-ARM
BODY-RIGHT-ARM
BODY-LEFT-HAND
BODY-RIGHT-HAND
ROUTE-HN01_TORSO_POWER_SPINE
ROUTE-HN01_TORSO_DATA_SPINE
ROUTE-HN01_HEAD_BRANCH
ROUTE-HN01_HEAD_POWER_BRANCH
ROUTE-HN01_L_LEG_POWER
ROUTE-HN01_L_LEG_DATA
ROUTE-HN01_L_ARM_POWER
ROUTE-HN01_L_ARM_DATA
ROUTE-HN01_R_LEG_POWER
ROUTE-HN01_R_LEG_DATA
ROUTE-HN01_R_ARM_POWER
ROUTE-HN01_R_ARM_DATA
ROUTE-LOOP-L_HIP_YAW-PWR
ROUTE-LOOP-L_HIP_YAW-DATA
ROUTE-LOOP-L_HIP_ROLL-PWR
ROUTE-LOOP-L_HIP_ROLL-DATA
ROUTE-LOOP-L_HIP_PITCH-PWR
ROUTE-LOOP-L_HIP_PITCH-DATA
ROUTE-LOOP-L_KNEE_PITCH-PWR
ROUTE-LOOP-L_KNEE_PITCH-DATA
ROUTE-LOOP-L_ANKLE_PITCH-PWR
ROUTE-LOOP-L_ANKLE_PITCH-DATA
ROUTE-LOOP-L_ANKLE_ROLL-PWR
ROUTE-LOOP-L_ANKLE_ROLL-DATA
ROUTE-LOOP-R_HIP_YAW-PWR
ROUTE-LOOP-R_HIP_YAW-DATA
ROUTE-LOOP-R_HIP_ROLL-PWR
ROUTE-LOOP-R_HIP_ROLL-DATA
ROUTE-LOOP-R_HIP_PITCH-PWR
ROUTE-LOOP-R_HIP_PITCH-DATA
ROUTE-LOOP-R_KNEE_PITCH-PWR
ROUTE-LOOP-R_KNEE_PITCH-DATA
ROUTE-LOOP-R_ANKLE_PITCH-PWR
ROUTE-LOOP-R_ANKLE_PITCH-DATA
ROUTE-LOOP-R_ANKLE_ROLL-PWR
ROUTE-LOOP-R_ANKLE_ROLL-DATA
ROUTE-LOOP-L_SHOULDER_PITCH-PWR
ROUTE-LOOP-L_SHOULDER_PITCH-DATA
ROUTE-LOOP-L_SHOULDER_ROLL-PWR
ROUTE-LOOP-L_SHOULDER_ROLL-DATA
ROUTE-LOOP-L_ELBOW_PITCH-PWR
ROUTE-LOOP-L_ELBOW_PITCH-DATA
ROUTE-LOOP-R_SHOULDER_PITCH-PWR
ROUTE-LOOP-R_SHOULDER_PITCH-DATA
ROUTE-LOOP-R_SHOULDER_ROLL-PWR
ROUTE-LOOP-R_SHOULDER_ROLL-DATA
ROUTE-LOOP-R_ELBOW_PITCH-PWR
ROUTE-LOOP-R_ELBOW_PITCH-DATA
ROUTE-LOOP-WAIST_YAW-PWR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
