amyleesterling/humanoid-robot/hr30/whole-body-p0.1/joint-family-cad/JMF-01-COMPACT/JMF-01-COMPACT_assembly.step

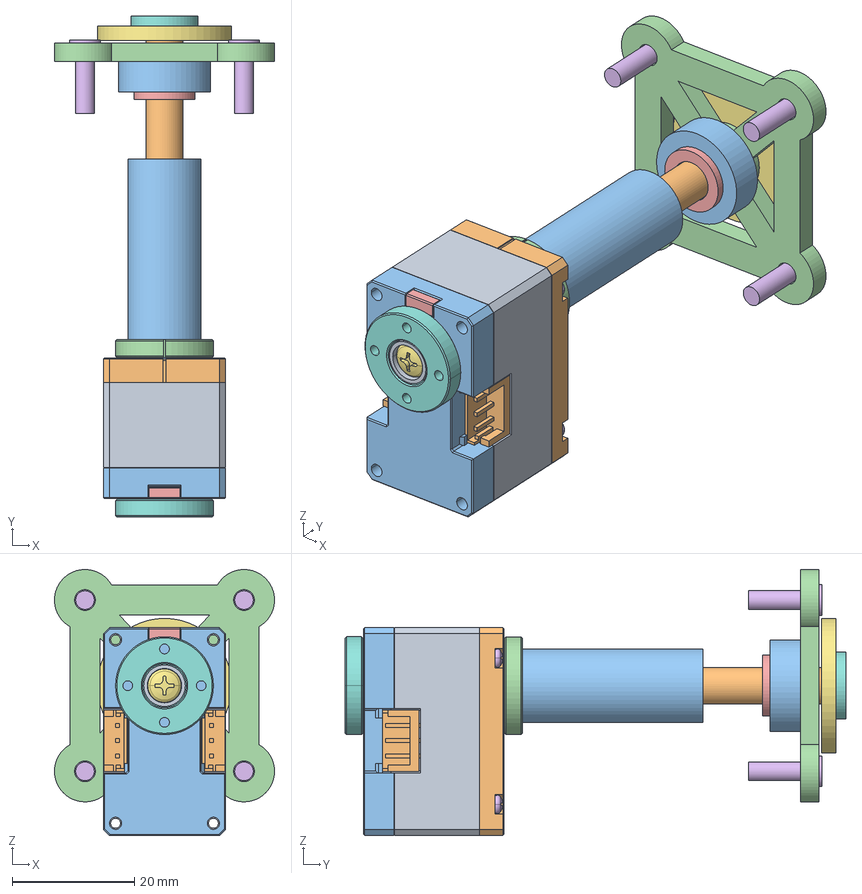
[picture p11: CAD file, 2026-08-15]
hr30/whole-body-p0.1/joint-family-cad/JMF-01-COMPACT/JMF-01-COMPACT_assembly.step
36.0 x 81.9 x 43.5 mm
