amyleesterling/humanoid-robot/hr30/whole-body-p0.1/joint-family-cad/JMF-02-GRIPPER/JMF-02-GRIPPER_assembly.step

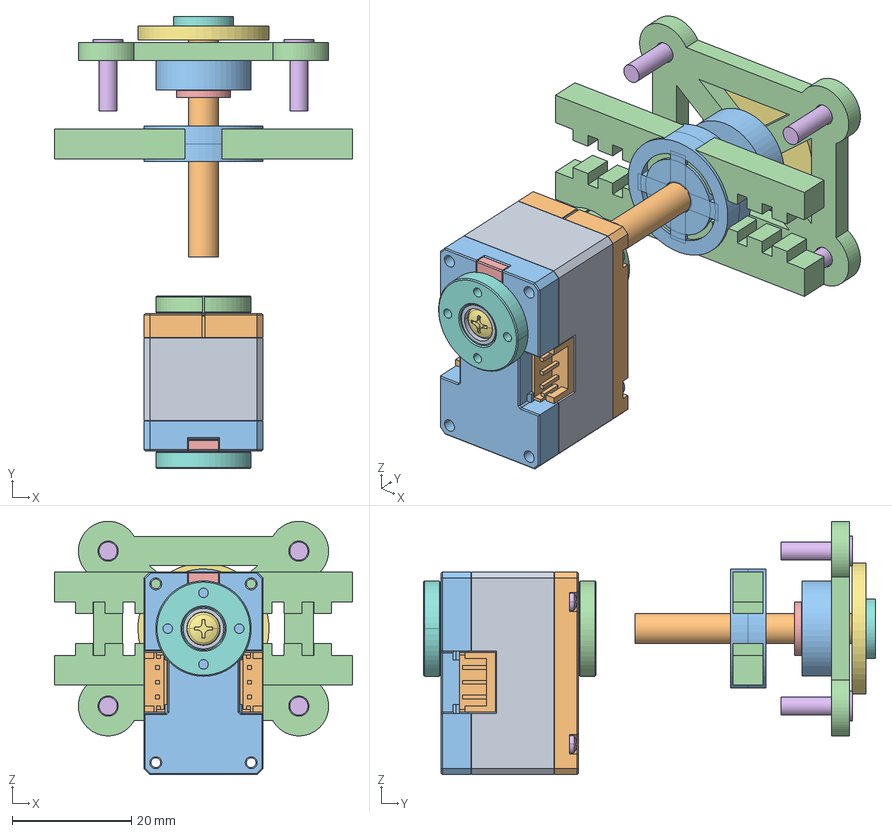
[picture p12: CAD file, 2026-08-15]
hr30/whole-body-p0.1/joint-family-cad/JMF-02-GRIPPER/JMF-02-GRIPPER_assembly.step
50.0 x 75.9 x 42.5 mm
