amyleesterling/humanoid-robot/hr30/whole-body-p0.1/joint-family-cad/JMF-04-MEDIUM/JMF-04-MEDIUM_assembly.step

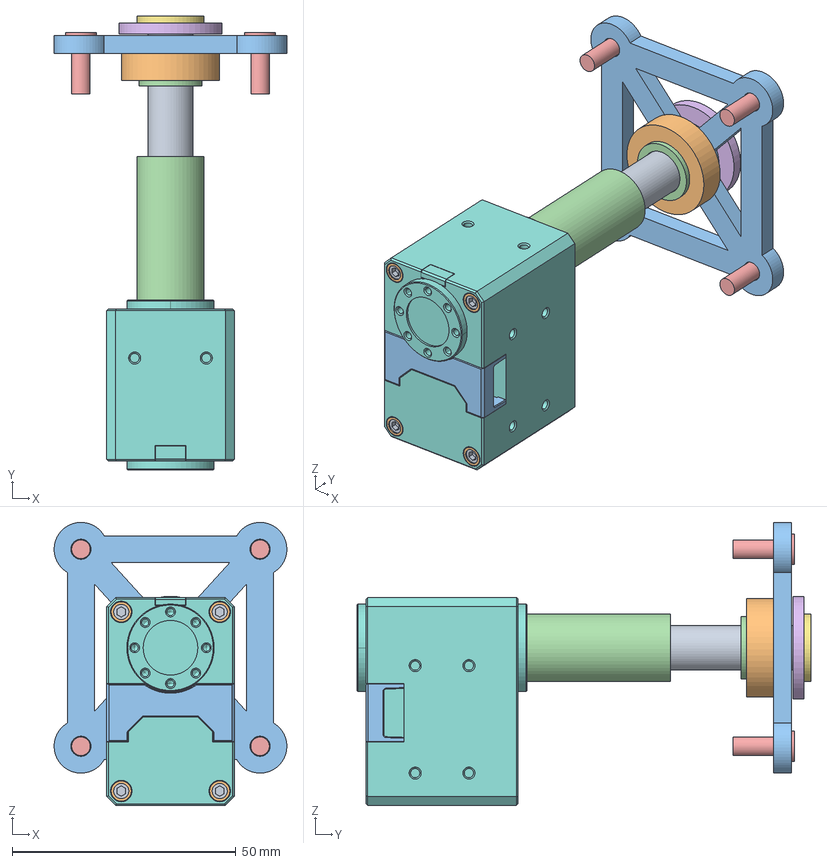
[picture p13: CAD file, 2026-08-16]
hr30/whole-body-p0.1/joint-family-cad/JMF-04-MEDIUM/JMF-04-MEDIUM_assembly.step
52.0 x 101.4 x 63.2 mm
