amyleesterling/humanoid-robot/hr30/whole-body-p0.1/joint-family-cad/JMF-05-WAIST/JMF-05-WAIST_assembly.step

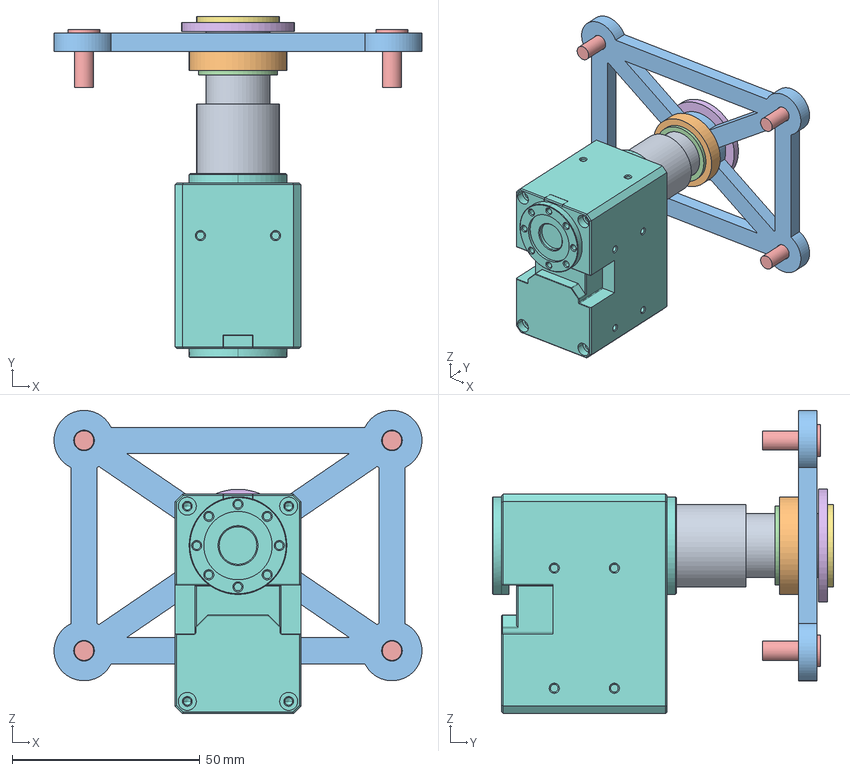
[picture p14: CAD file, 2026-08-16]
hr30/whole-body-p0.1/joint-family-cad/JMF-05-WAIST/JMF-05-WAIST_assembly.step
98.0 x 90.9 x 80.7 mm
