amyleesterling/humanoid-robot/hr30/whole-body-p0.1/joint-family-cad/JMF-06-LEG-DIRECT/JMF-06-LEG-DIRECT_assembly.step

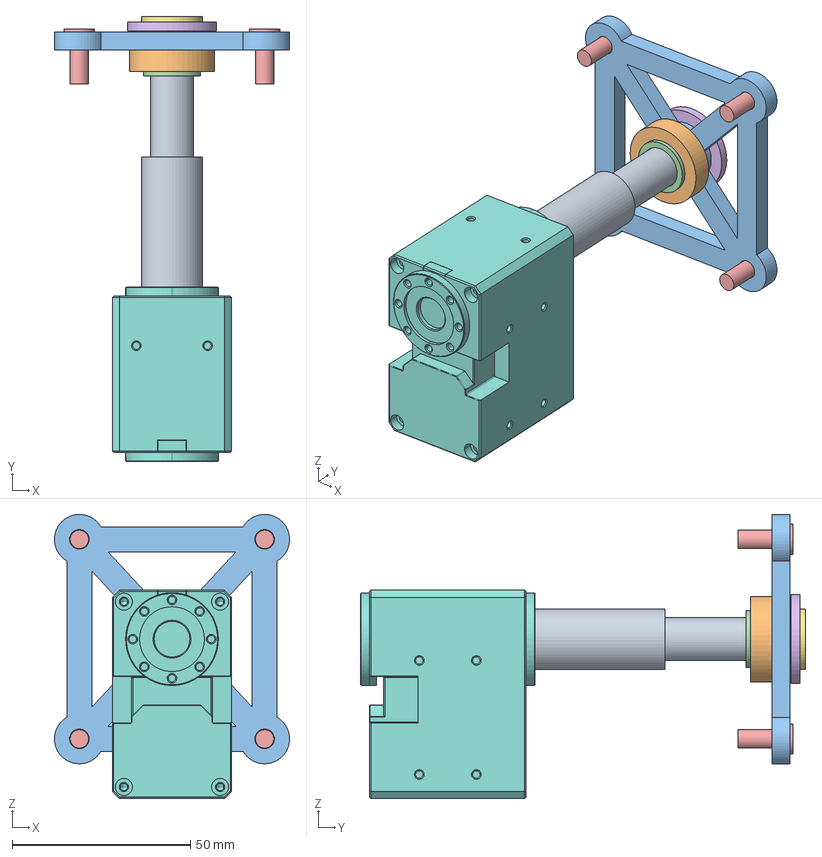
[picture p15: CAD file, 2026-08-16]
hr30/whole-body-p0.1/joint-family-cad/JMF-06-LEG-DIRECT/JMF-06-LEG-DIRECT_assembly.step
66.0 x 124.9 x 79.7 mm
