amyleesterling/humanoid-robot/hr30/whole-body-p0.1/joint-family-cad/JMF-07-LEG-REDUCED-15/JMF-07-LEG-REDUCED-15_assembly.step

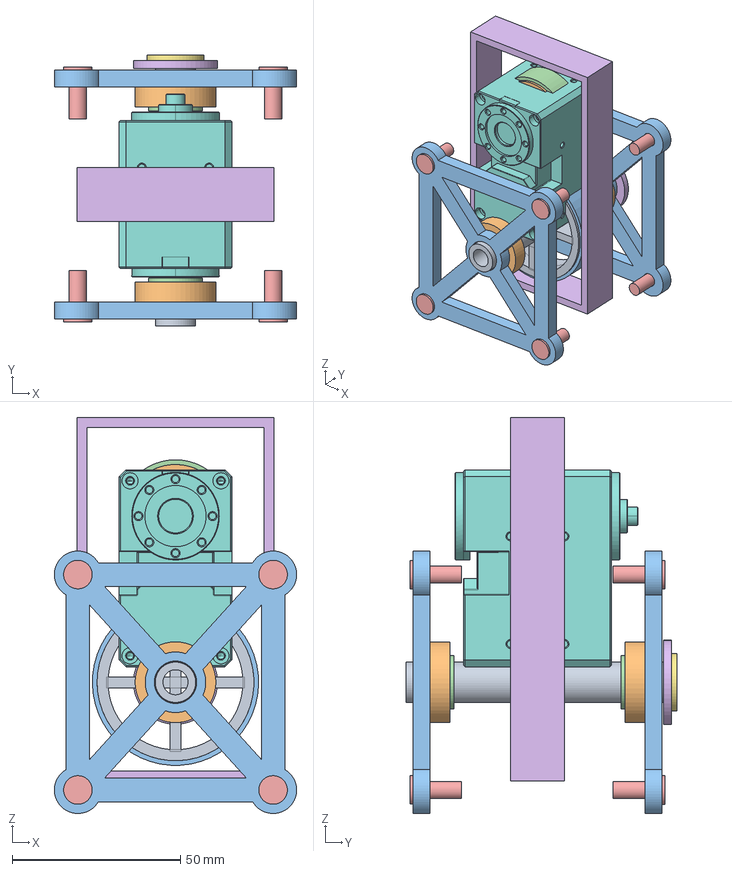
[picture p16: CAD file, 2026-08-16]
hr30/whole-body-p0.1/joint-family-cad/JMF-07-LEG-REDUCED-15/JMF-07-LEG-REDUCED-15_assembly.step
72.0 x 80.4 x 117.7 mm
