amyleesterling/humanoid-robot/hr30/whole-body-p0.1/joint-family-cad/JMF-08-LEG-REDUCED-20/JMF-08-LEG-REDUCED-20_assembly.step

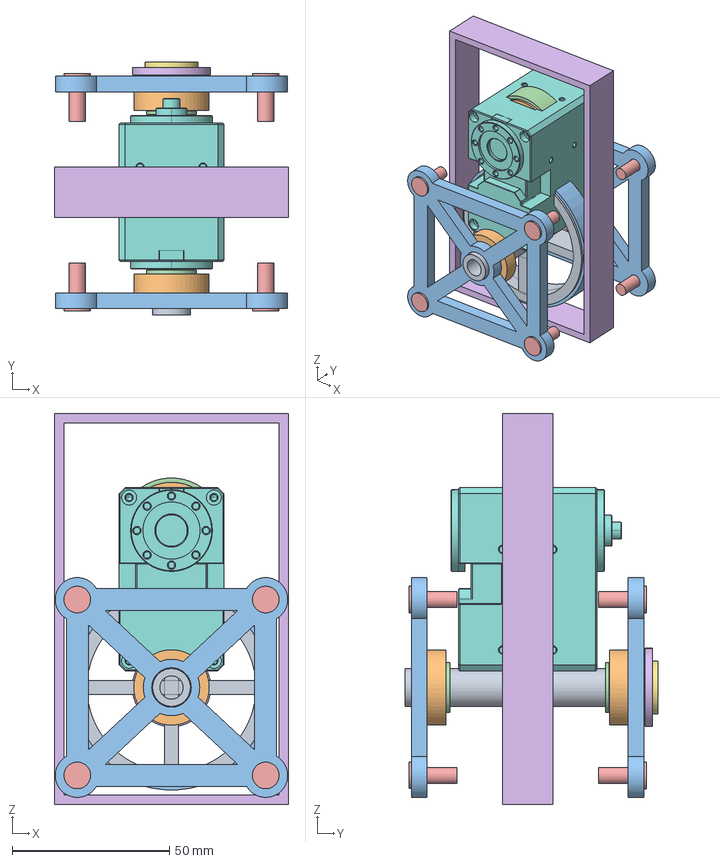
[picture p17: CAD file, 2026-08-16]
hr30/whole-body-p0.1/joint-family-cad/JMF-08-LEG-REDUCED-20/JMF-08-LEG-REDUCED-20_assembly.step
74.5 x 80.4 x 124.5 mm
