amyleesterling/humanoid-robot/hr30/whole-body-p0.1/joint-family-cad/JMF-09-KNEE-REDUCED-20/JMF-09-KNEE-REDUCED-20_assembly.step

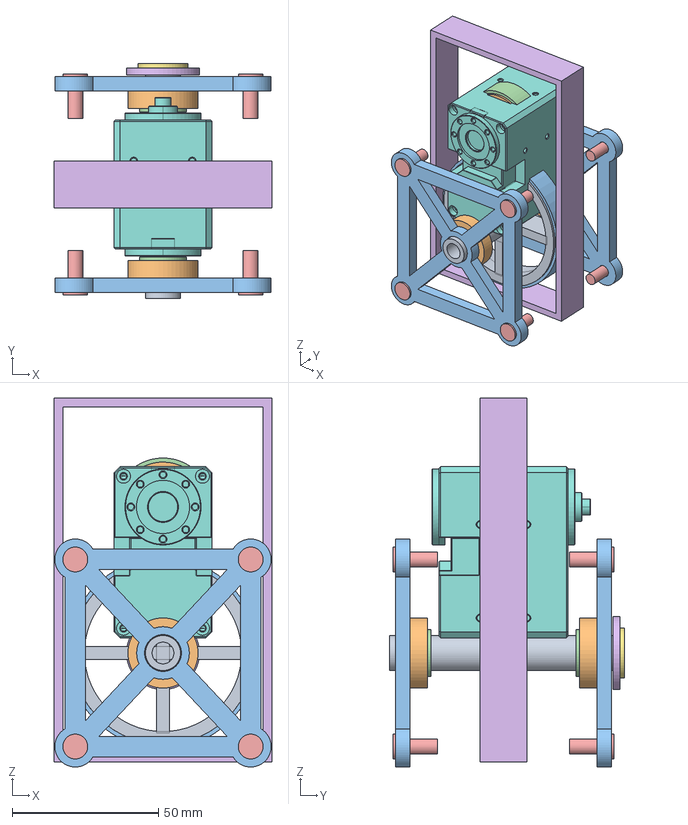
[picture p18: CAD file, 2026-08-15]
hr30/whole-body-p0.1/joint-family-cad/JMF-09-KNEE-REDUCED-20/JMF-09-KNEE-REDUCED-20_assembly.step
74.5 x 80.4 x 126.2 mm
