amyleesterling/humanoid-robot/hr30/whole-body-p0.1/joint-family-cad/JMF-09-KNEE-REDUCED-25/JMF-09-KNEE-REDUCED-25_assembly.step

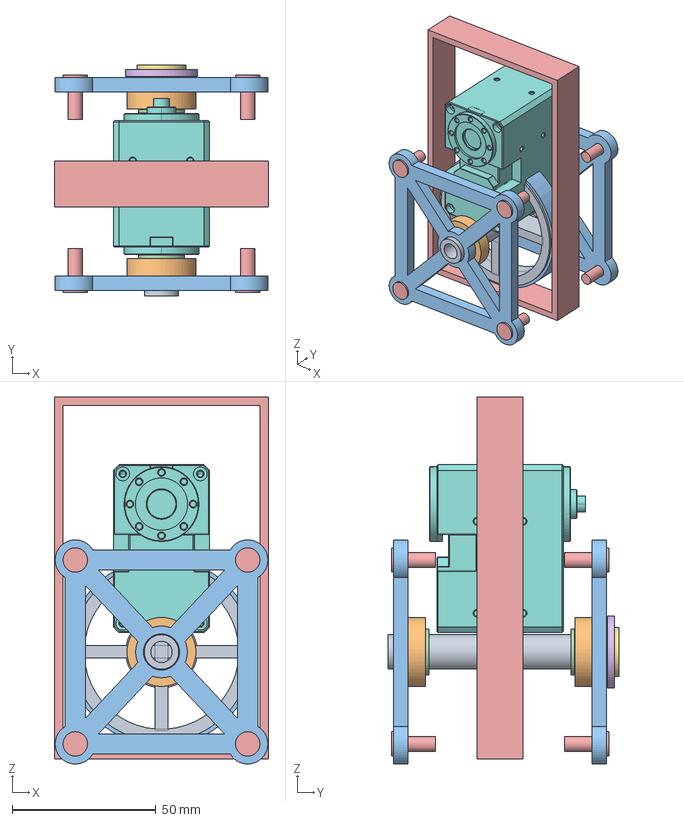
[picture p19: CAD file, 2026-08-16]
hr30/whole-body-p0.1/joint-family-cad/JMF-09-KNEE-REDUCED-25/JMF-09-KNEE-REDUCED-25_assembly.step
74.5 x 80.4 x 127.7 mm
