amyleesterling/humanoid-robot/hr30/whole-body-p0.1/joint-family-cad/JMF-10-ANKLE-PITCH-REDUCED-25/JMF-10-ANKLE-PITCH-REDUCED-25_assembly.step

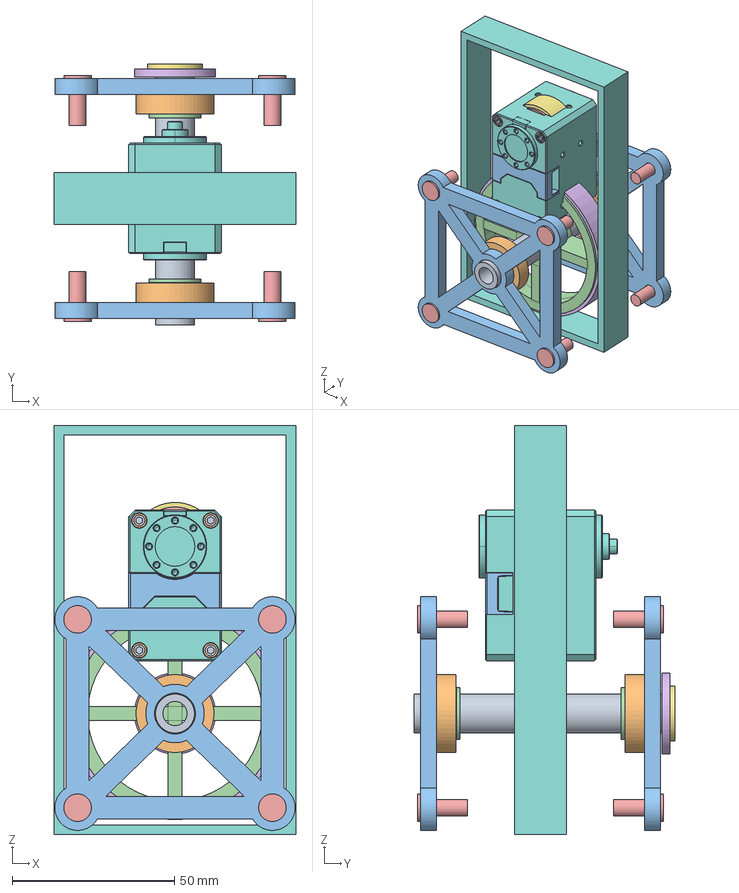
[picture p20: CAD file, 2026-08-16]
hr30/whole-body-p0.1/joint-family-cad/JMF-10-ANKLE-PITCH-REDUCED-25/JMF-10-ANKLE-PITCH-REDUCED-25_assembly.step
74.5 x 80.4 x 126.0 mm
