amyleesterling/humanoid-robot/hr30/whole-body-p0.1/harness/actuator-transition-brackets-p0.1/ATB-STANDARD-ASSEMBLY-P0.1.step

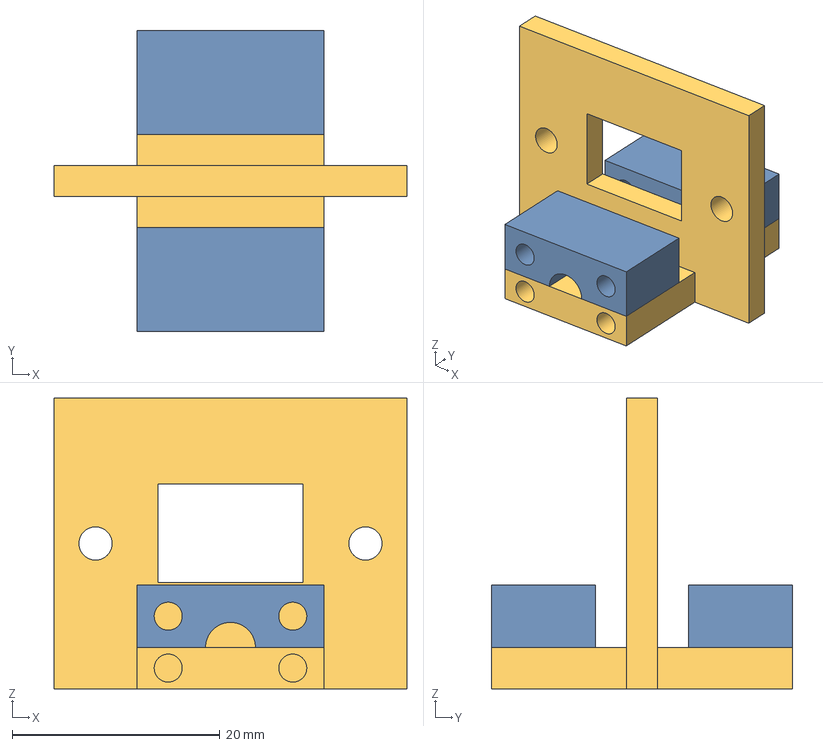
[picture p21: CAD file, 2026-08-17]
hr30/whole-body-p0.1/harness/actuator-transition-brackets-p0.1/ATB-STANDARD-ASSEMBLY-P0.1.step
34.0 x 29.0 x 28.0 mm
ATB-BASE
ATB-CAP-DYNAMIC
ATB-CAP-PIGTAIL
