amyleesterling/humanoid-robot/cad/hr-v0-q4x-box-layout-p0.1/hr-v0-q4x-box-layout-p0.1.step

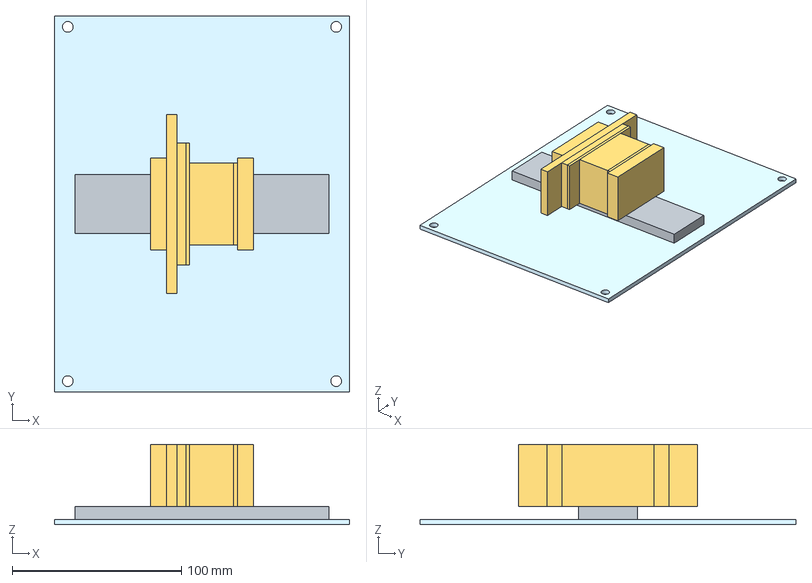
[picture p22: CAD file, 2026-08-10]
cad/hr-v0-q4x-box-layout-p0.1/hr-v0-q4x-box-layout-p0.1.step
174.5 x 222.2 x 47.5 mm
PANEL1_14F0907_PROXY
DR1_150MM_ENVELOPE
CATALOG_ENVELOPE_01
CATALOG_ENVELOPE_02
CATALOG_ENVELOPE_03
CATALOG_ENVELOPE_04
CATALOG_ENVELOPE_05
CATALOG_ENVELOPE_06
CATALOG_ENVELOPE_07
