amyleesterling/humanoid-robot/cad/hr-v0/generated/arm-architecture-p0.1/parts/MV0-C01_pcd22_to_20-2040_adapter.step

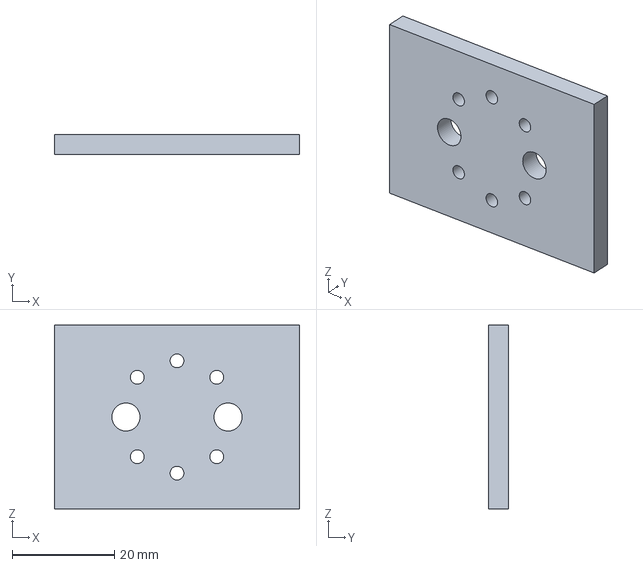
[picture p23: CAD file, 2026-08-10]
cad/hr-v0/generated/arm-architecture-p0.1/parts/MV0-C01_pcd22_to_20-2040_adapter.step
48.0 x 4.00 x 36.0 mm
