amyleesterling/humanoid-robot/cad/hr-v0/generated/arm-architecture-p0.10-bossed-stop/HR-V0_J2_positive_stop_contact_candidate.step

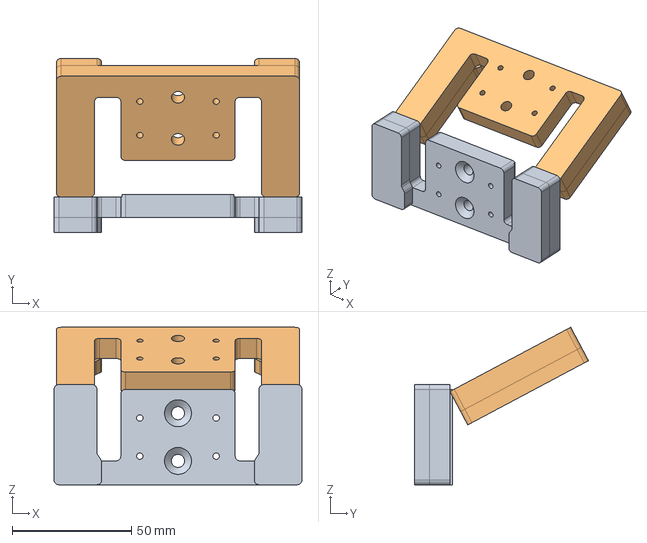
[picture p24: CAD file, 2026-08-15]
cad/hr-v0/generated/arm-architecture-p0.10-bossed-stop/HR-V0_J2_positive_stop_contact_candidate.step
104.0 x 73.0 x 66.1 mm
