amyleesterling/humanoid-robot/cad/hr-v0/generated/arm-architecture-p0.10-bossed-stop/parts/MV0-C07_J2-positive-fixed-catch-profile.dxf

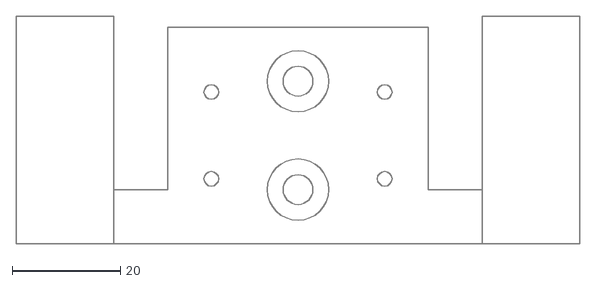
[picture p25: CAD file, 2026-08-15]
cad/hr-v0/generated/arm-architecture-p0.10-bossed-stop/parts/MV0-C07_J2-positive-fixed-catch-profile.dxf
104.0 x 42.0
