amyleesterling/humanoid-robot/cad/hr-v0/generated/arm-architecture-p0.11-side-web-stop/parts/MV0-C07_J2_positive_fixed_catch_adapter.step

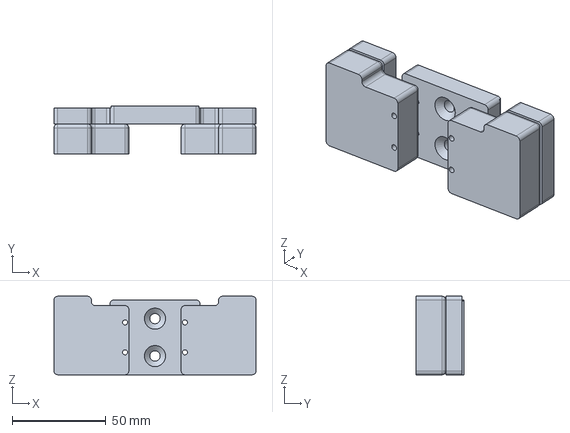
[picture p27: CAD file, 2026-08-15]
cad/hr-v0/generated/arm-architecture-p0.11-side-web-stop/parts/MV0-C07_J2_positive_fixed_catch_adapter.step
108.0 x 25.4 x 42.0 mm
