amyleesterling/humanoid-robot/cad/hr-v0/generated/arm-architecture-p0.12-access-well-stop/HR-V0_J2_positive_stop_contact_candidate.step

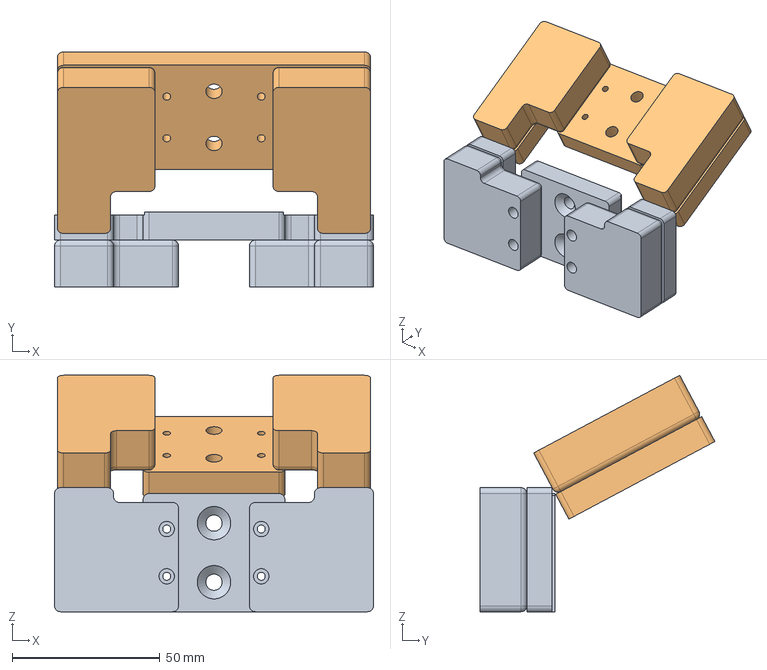
[picture p28: CAD file, 2026-08-15]
cad/hr-v0/generated/arm-architecture-p0.12-access-well-stop/HR-V0_J2_positive_stop_contact_candidate.step
108.0 x 79.5 x 80.1 mm
