amyleesterling/humanoid-robot/cad/hr-v0/generated/arm-architecture-p0.12-access-well-stop/parts/MV0-C06_J2-positive-moving-striker-profile.dxf

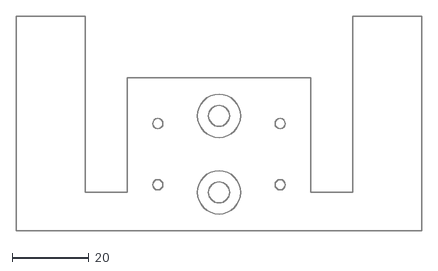
[picture p29: CAD file, 2026-08-15]
cad/hr-v0/generated/arm-architecture-p0.12-access-well-stop/parts/MV0-C06_J2-positive-moving-striker-profile.dxf
106.0 x 56.0
