amyleesterling/humanoid-robot/cad/hr-v0/generated/arm-architecture-p0.13-pad-pocket-stop/HR-V0_J2_C07_pad-pocket-installed-screen.step

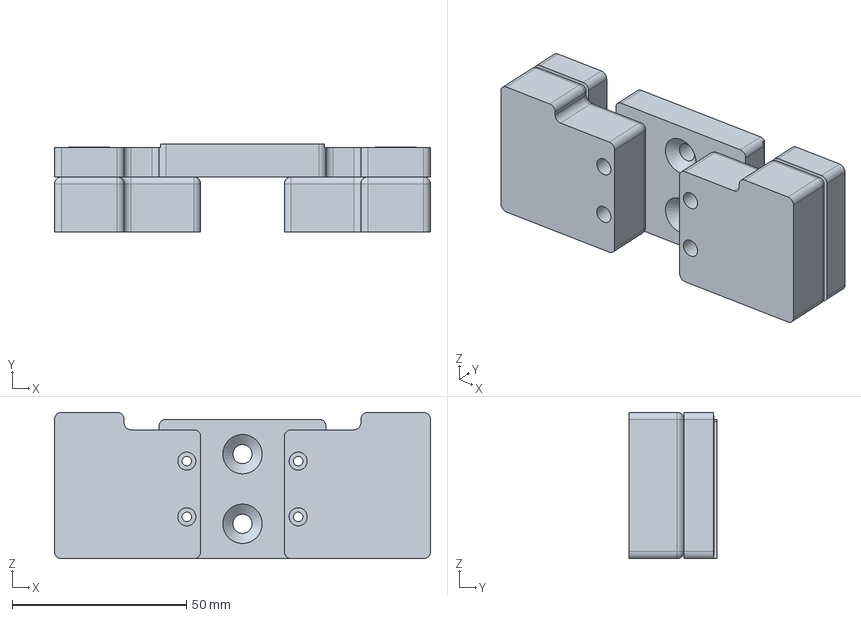
[picture p30: CAD file, 2026-08-15]
cad/hr-v0/generated/arm-architecture-p0.13-pad-pocket-stop/HR-V0_J2_C07_pad-pocket-installed-screen.step
108.0 x 25.4 x 42.0 mm
