amyleesterling/humanoid-robot/cad/hr-v0/generated/arm-architecture-p0.13-pad-pocket-stop/parts/MV0-C06_J2_positive_moving_striker_adapter.step

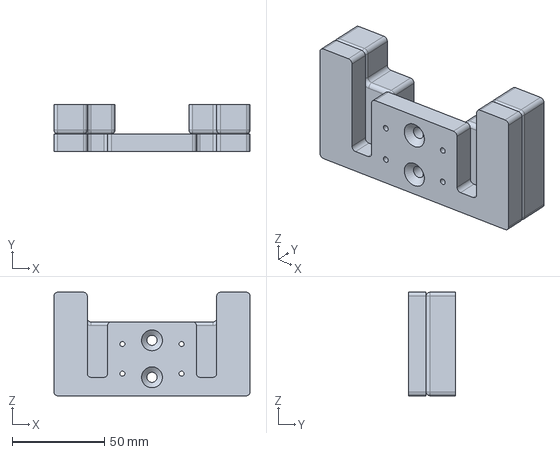
[picture p31: CAD file, 2026-08-15]
cad/hr-v0/generated/arm-architecture-p0.13-pad-pocket-stop/parts/MV0-C06_J2_positive_moving_striker_adapter.step
106.0 x 25.4 x 56.0 mm
