amyleesterling/humanoid-robot/cad/hr-v0/generated/arm-architecture-p0.8-dwg-integrated/HR-V0_J2_positive_stop_contact_candidate.step

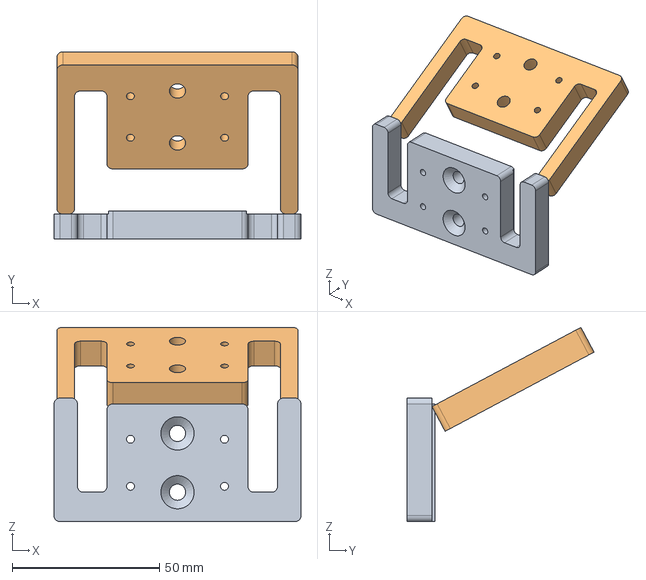
[picture p32: CAD file, 2026-08-15]
cad/hr-v0/generated/arm-architecture-p0.8-dwg-integrated/HR-V0_J2_positive_stop_contact_candidate.step
84.0 x 63.7 x 66.1 mm
