amyleesterling/humanoid-robot/cad/hr-v0/generated/arm-architecture-p0.8-dwg-integrated/parts/MV0-C01_rect32x16_to_20-2040_countersunk_adapter.step

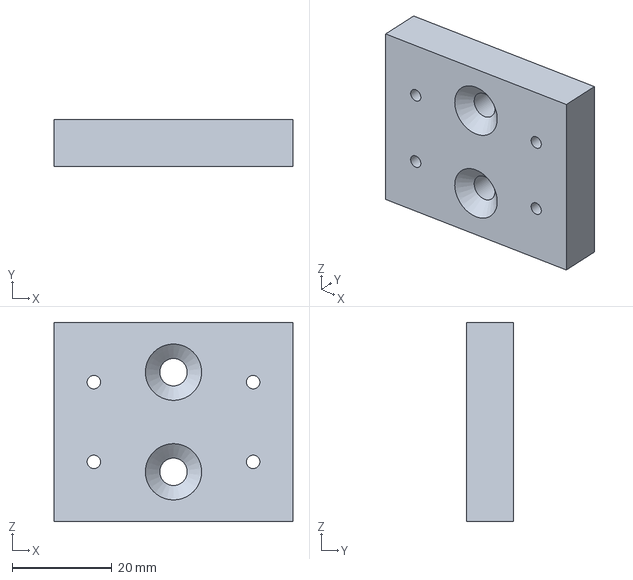
[picture p33: CAD file, 2026-08-10]
cad/hr-v0/generated/arm-architecture-p0.8-dwg-integrated/parts/MV0-C01_rect32x16_to_20-2040_countersunk_adapter.step
48.0 x 9.53 x 40.0 mm
