amyleesterling/humanoid-robot/cad/hr-v0/generated/arm-architecture-p0.9-stop-strength/parts/MV0-C06_J2-positive-moving-striker-profile.dxf

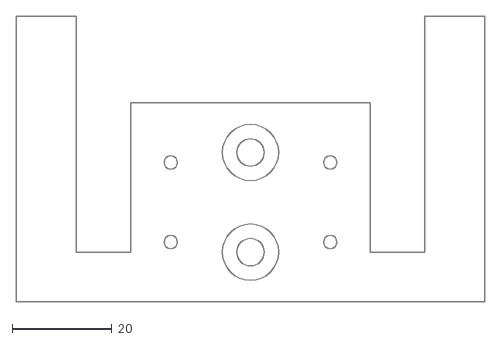
[picture p35: CAD file, 2026-08-15]
cad/hr-v0/generated/arm-architecture-p0.9-stop-strength/parts/MV0-C06_J2-positive-moving-striker-profile.dxf
94.0 x 57.4
