amyleesterling/humanoid-robot/cad/hr-v0/generated/arm-architecture-p0.9-x430/parts/P09-C01_X430_fixed-catch-adapter.step

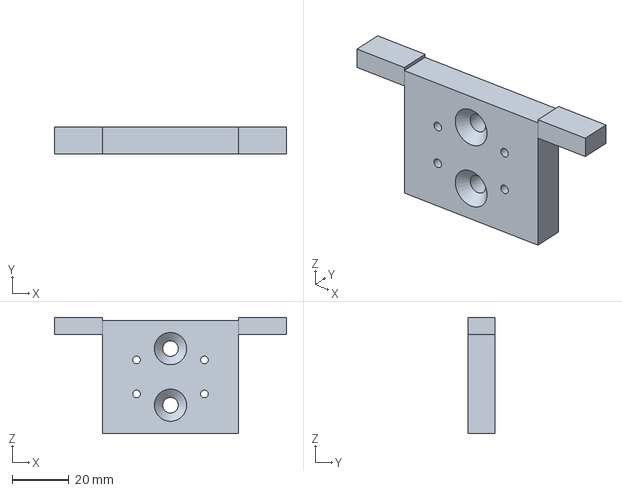
[picture p36: CAD file, 2026-08-10]
cad/hr-v0/generated/arm-architecture-p0.9-x430/parts/P09-C01_X430_fixed-catch-adapter.step
82.0 x 9.53 x 41.0 mm
