amyleesterling/humanoid-robot/cad/hr-v0/generated/arm-architecture-p1.0-x430-clearance/parts/P10-C02_X430_relief-moving-striker.step

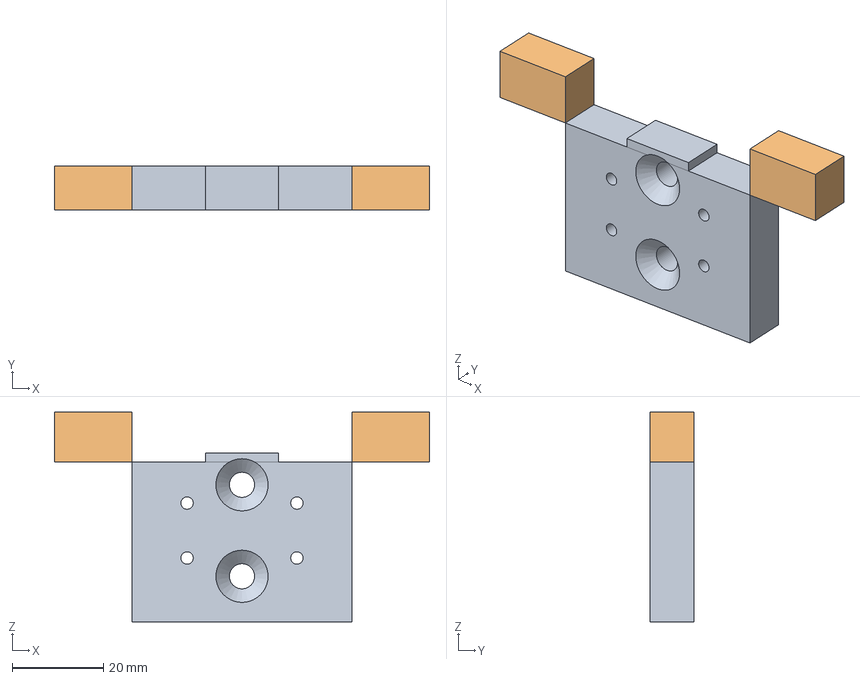
[picture p37: CAD file, 2026-08-10]
cad/hr-v0/generated/arm-architecture-p1.0-x430-clearance/parts/P10-C02_X430_relief-moving-striker.step
82.0 x 9.53 x 45.9 mm
