amyleesterling/humanoid-robot/cad/hr-v0/generated/arm-architecture-p1.1-x430-lowered-forearm/parts/P11-C02_X430_lowered-forearm-moving-striker.step

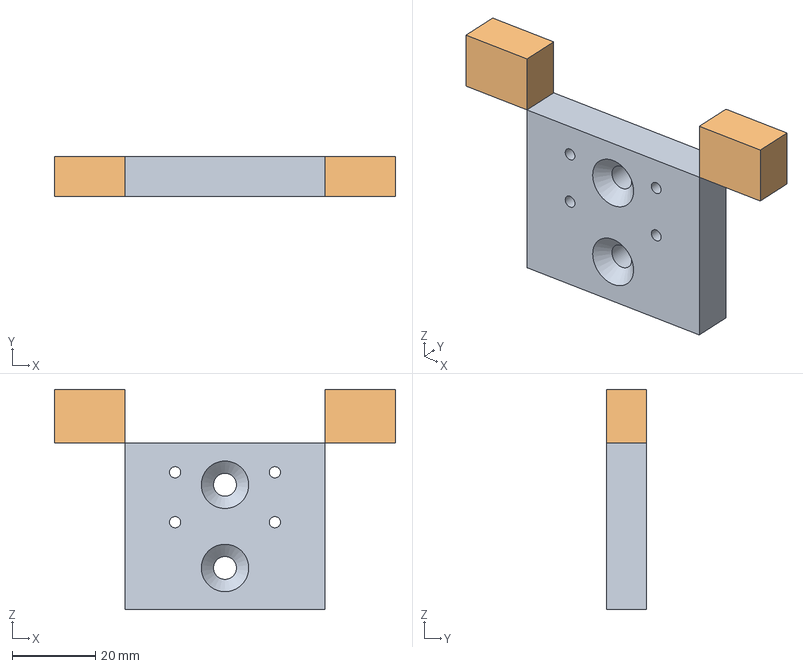
[picture p38: CAD file, 2026-08-10]
cad/hr-v0/generated/arm-architecture-p1.1-x430-lowered-forearm/parts/P11-C02_X430_lowered-forearm-moving-striker.step
82.0 x 9.53 x 52.9 mm
