amyleesterling/humanoid-robot/cad/hr-v0/generated/fit-coupons/MV0-FC02_s102_32x16_tapped_pattern_coupon.step

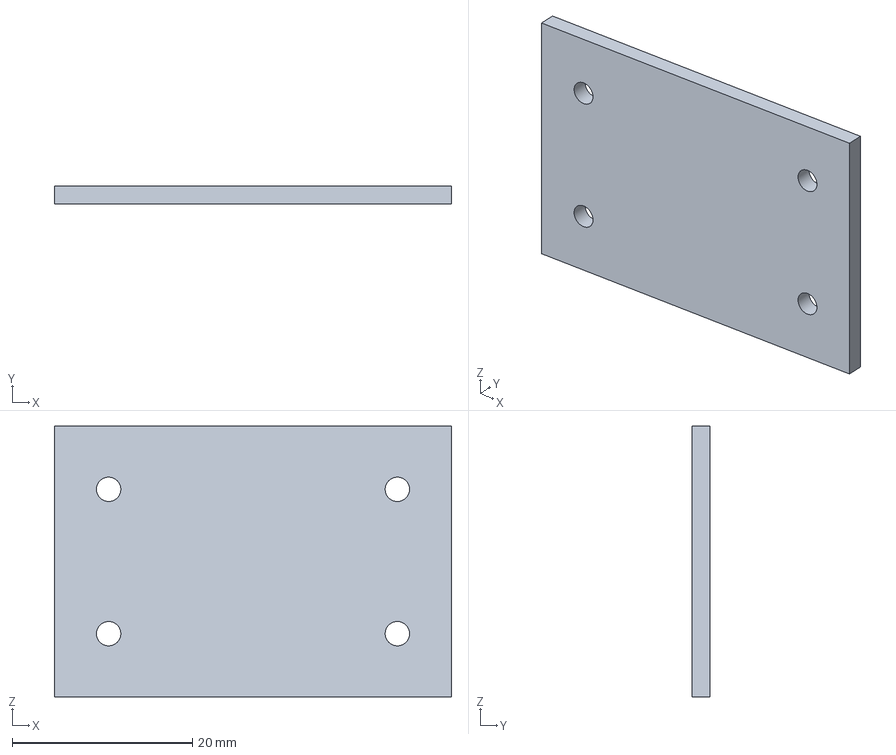
[picture p39: CAD file, 2026-08-10]
cad/hr-v0/generated/fit-coupons/MV0-FC02_s102_32x16_tapped_pattern_coupon.step
44.0 x 2.00 x 30.0 mm
