amyleesterling/humanoid-robot/cad/hr-v0/generated/fx103-output-adapter-p0.2/FX103-C01_P0.2_horn_flange.step

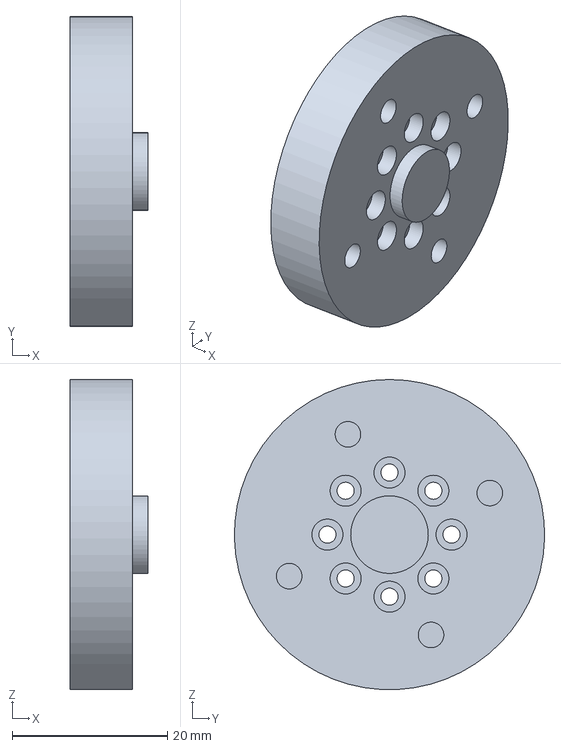
[picture p40: CAD file, 2026-08-10]
cad/hr-v0/generated/fx103-output-adapter-p0.2/FX103-C01_P0.2_horn_flange.step
10.0 x 40.0 x 40.0 mm
