amyleesterling/humanoid-robot/cad/hr-v0/generated/fx103-output-adapter-p0.3/FX103-C02_P0.1_shaft_flange.step

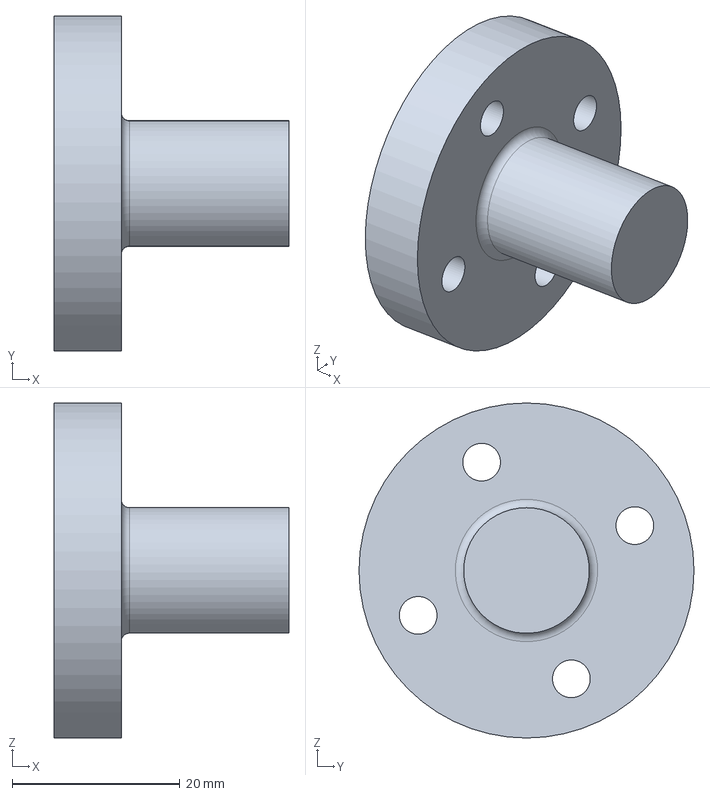
[picture p41: CAD file, 2026-08-10]
cad/hr-v0/generated/fx103-output-adapter-p0.3/FX103-C02_P0.1_shaft_flange.step
28.0 x 40.0 x 40.0 mm
