amyleesterling/humanoid-robot/cad/hr-v0/generated/fx104-c01-p0.1/FX104-C01_P0.1_fabrication_candidate.step

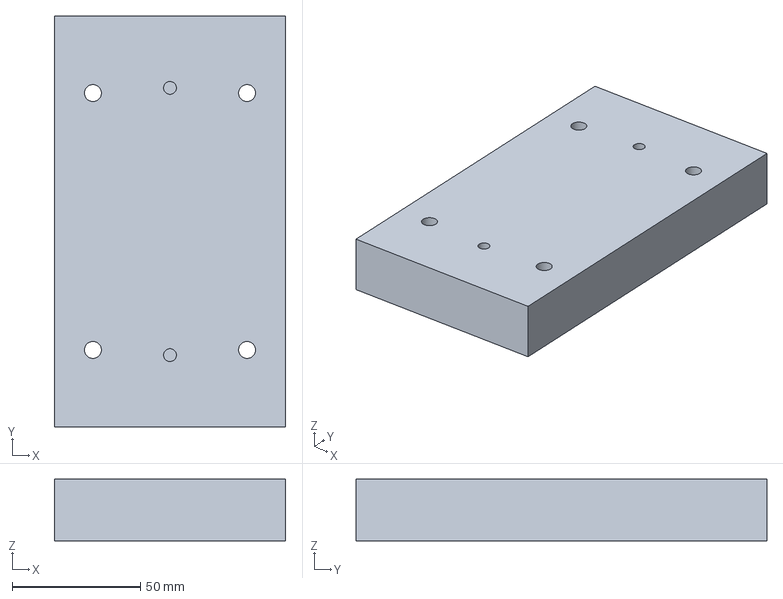
[picture p42: CAD file, 2026-08-10]
cad/hr-v0/generated/fx104-c01-p0.1/FX104-C01_P0.1_fabrication_candidate.step
90.0 x 160.0 x 24.0 mm
