amyleesterling/humanoid-robot/cad/hr-v0/generated/manufacturing-blanks/MV0-003_shoulder_adapter_PROFILE_ONLY_RFQ.step

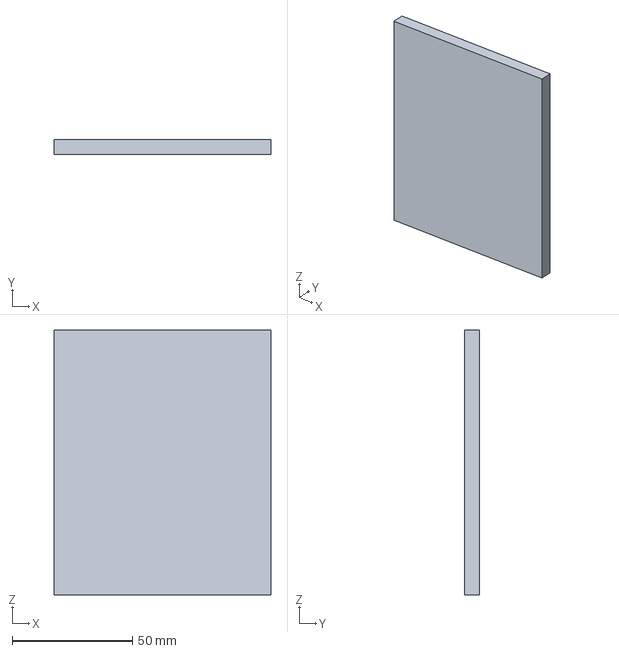
[picture p43: CAD file, 2026-08-10]
cad/hr-v0/generated/manufacturing-blanks/MV0-003_shoulder_adapter_PROFILE_ONLY_RFQ.step
90.0 x 6.35 x 110.0 mm
