amyleesterling/humanoid-robot/cad/hr-v0/generated/mass-reduction-p0.1/HR-V0_mass-reduced-moving-adapters-candidate.step

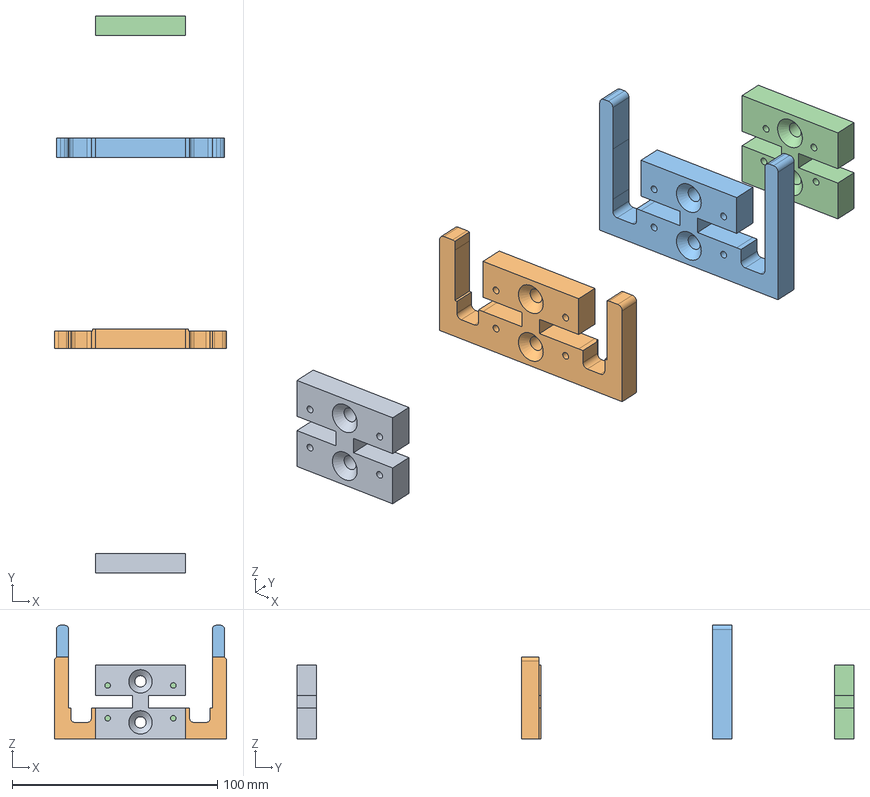
[picture p44: CAD file, 2026-08-10]
cad/hr-v0/generated/mass-reduction-p0.1/HR-V0_mass-reduced-moving-adapters-candidate.step
84.0 x 271.6 x 55.4 mm
