amyleesterling/humanoid-robot/cad/hr-v0/generated/mass-reduction-p0.1/parts/MV0-C01R_same-interface-relief-candidate.step

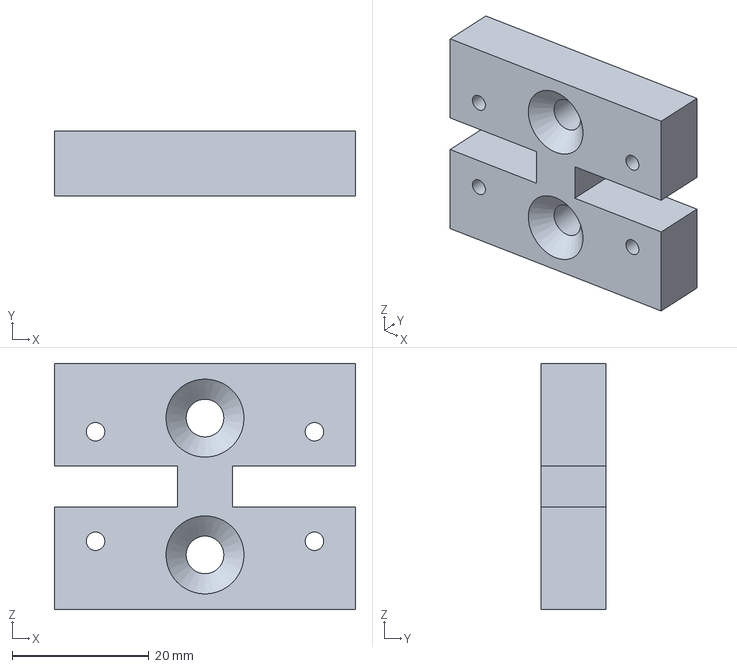
[picture p45: CAD file, 2026-08-10]
cad/hr-v0/generated/mass-reduction-p0.1/parts/MV0-C01R_same-interface-relief-candidate.step
44.0 x 9.53 x 36.0 mm
