amyleesterling/humanoid-robot/cad/hr-v0/generated/mechanical-drawing-p0.1/dxf/MV0-C04_finished-profile-and-features_P0.1.dxf

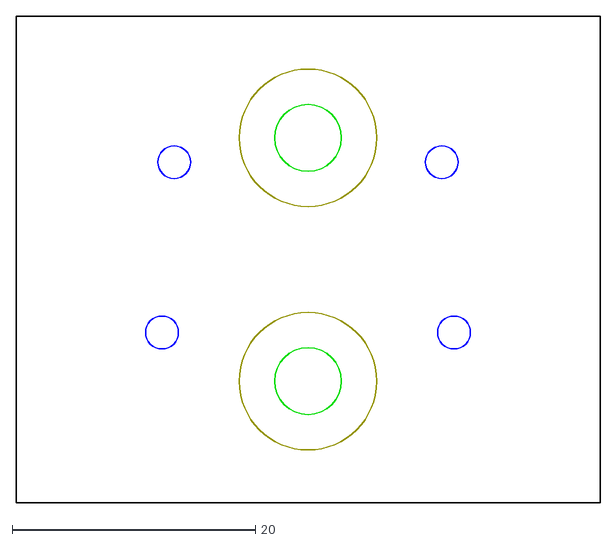
[picture p46: CAD file, 2026-08-10]
cad/hr-v0/generated/mechanical-drawing-p0.1/dxf/MV0-C04_finished-profile-and-features_P0.1.dxf
48.0 x 40.0
