amyleesterling/humanoid-robot/cad/hr-v0/generated/parts/MV0-002_forearm_link_plate.step

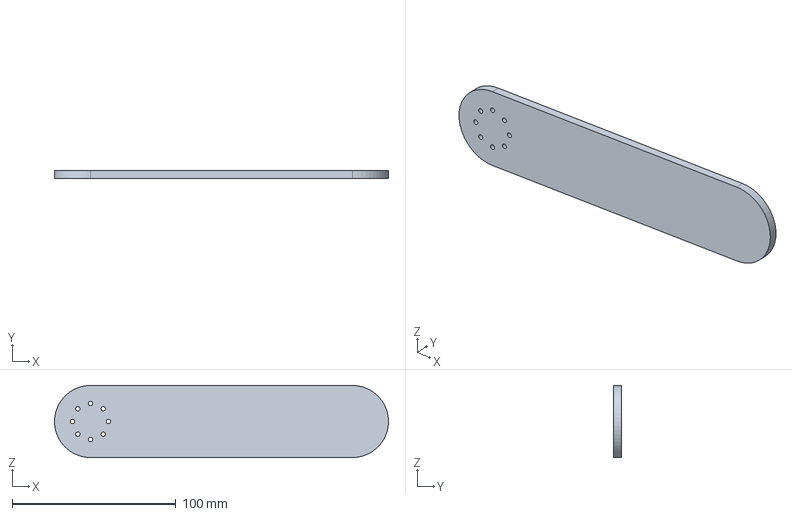
[picture p47: CAD file, 2026-08-10]
cad/hr-v0/generated/parts/MV0-002_forearm_link_plate.step
204.0 x 4.75 x 44.0 mm
