amyleesterling/humanoid-robot/cad/hr-v0/generated/passive-arm-receiver-detail-p0.2/FAB-REC-003-guide-tab-blank.step

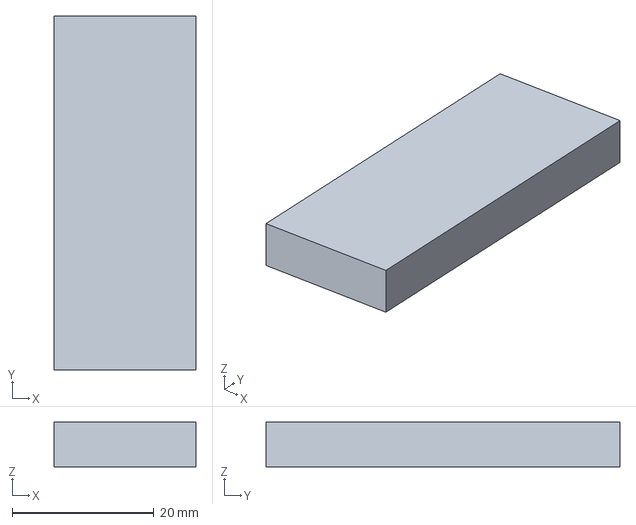
[picture p48: CAD file, 2026-08-10]
cad/hr-v0/generated/passive-arm-receiver-detail-p0.2/FAB-REC-003-guide-tab-blank.step
20.0 x 50.0 x 6.35 mm
