amyleesterling/humanoid-robot/cad/hr-v0/generated/passive-arm-receiver-p0.1/HR-V0_passive-arm-receiver-candidate.step

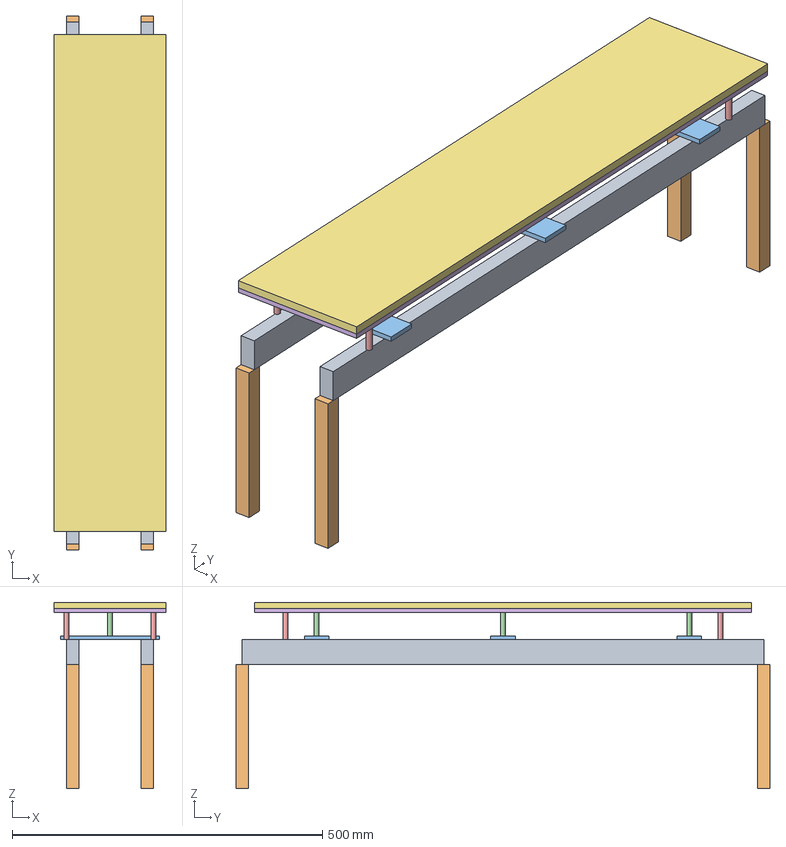
[picture p49: CAD file, 2026-08-10]
cad/hr-v0/generated/passive-arm-receiver-p0.1/HR-V0_passive-arm-receiver-candidate.step
180.0 x 860.0 x 300.0 mm
