amyleesterling/humanoid-robot/cad/hr-v0/generated/pololu-gripper-adapter-p0.1/hr-v0-pololu-gripper-adapter-p0.1.step

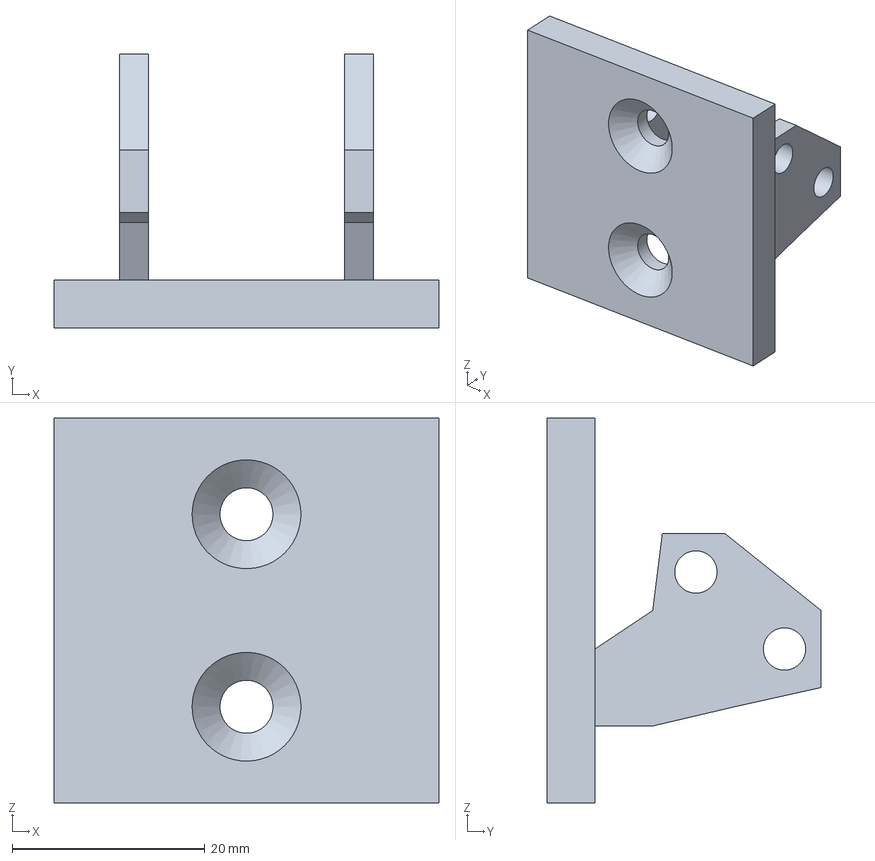
[picture p50: CAD file, 2026-08-10]
cad/hr-v0/generated/pololu-gripper-adapter-p0.1/hr-v0-pololu-gripper-adapter-p0.1.step
40.0 x 28.5 x 40.0 mm
