amyleesterling/humanoid-robot/cad/hr-v0/generated/power-loss-envelope-p0.1/HR-V0_collapse-envelope-review.step

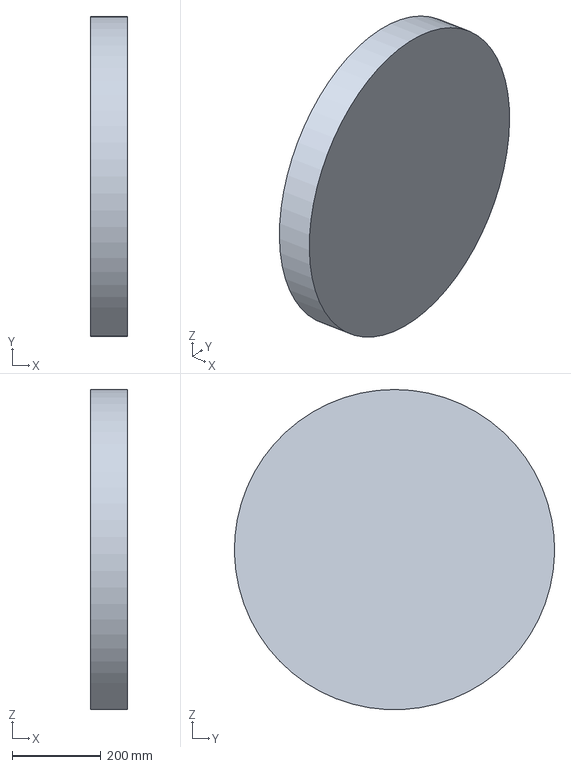
[picture p51: CAD file, 2026-08-10]
cad/hr-v0/generated/power-loss-envelope-p0.1/HR-V0_collapse-envelope-review.step
84.0 x 719.7 x 719.5 mm
