amyleesterling/humanoid-robot/cad/hr-v0/generated/receiver-guide-interface-p0.1/FAB-REC-004-guide-angle-hole-free-envelope.step

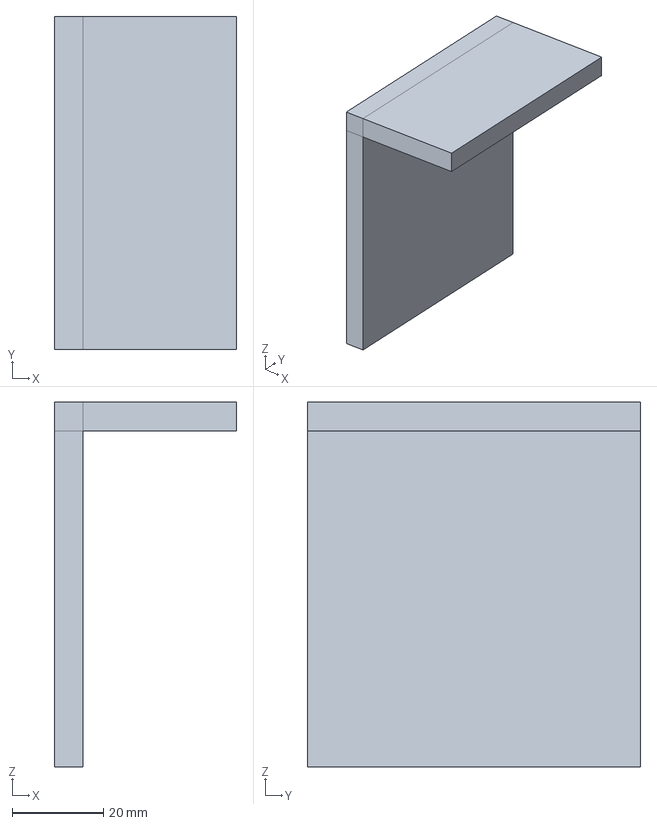
[picture p52: CAD file, 2026-08-10]
cad/hr-v0/generated/receiver-guide-interface-p0.1/FAB-REC-004-guide-angle-hole-free-envelope.step
40.0 x 73.0 x 80.0 mm
