amyleesterling/humanoid-robot/cad/hr-v0/generated/safety-enclosure/HR-V0_guard_receiver_envelope_NOT_RELEASED.step

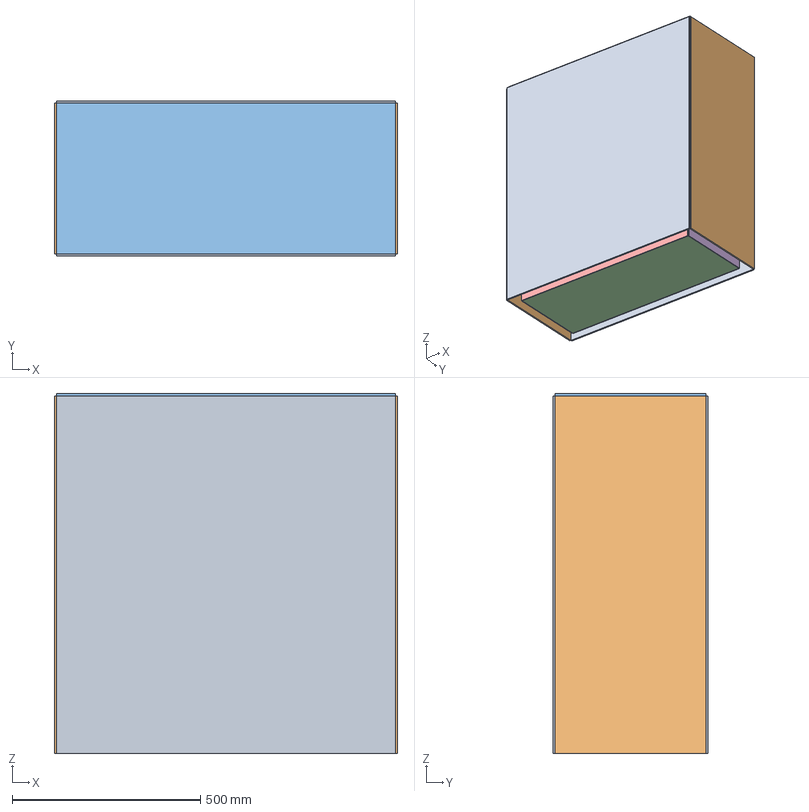
[picture p53: CAD file, 2026-08-10]
cad/hr-v0/generated/safety-enclosure/HR-V0_guard_receiver_envelope_NOT_RELEASED.step
912.0 x 412.0 x 956.0 mm
rear_panel_envelope
tool_removable_front_panel_envelope
left_panel_envelope
right_panel_envelope
top_panel_envelope
catch_bottom_envelope
catch_rear_wall_envelope
catch_front_wall_envelope
catch_left_wall_envelope
catch_right_wall_envelope
