amyleesterling/humanoid-robot/cad/hr-v0/generated/vendor-interfaces/XM540-H101-S102-same-origin.step

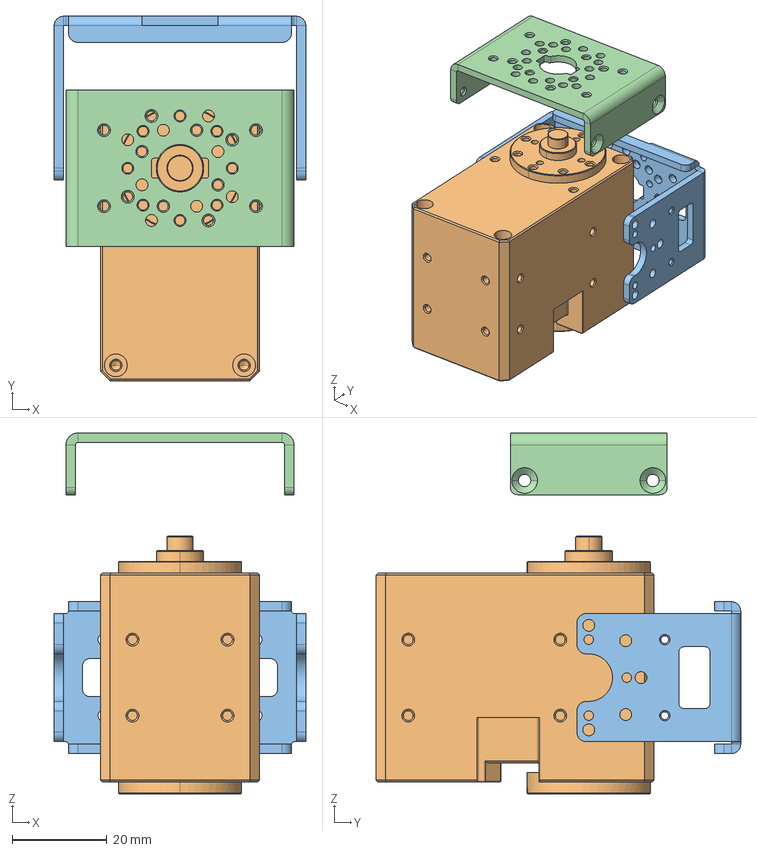
[picture p54: CAD file, 2026-08-10]
cad/hr-v0/generated/vendor-interfaces/XM540-H101-S102-same-origin.step
53.0 x 76.8 x 76.0 mm
