amyleesterling/humanoid-robot/cad/hr-v0/generated/xc330-gripper-feasibility-p0.1/hr-v0-xc330-gripper-right-jaw-p0.1.step

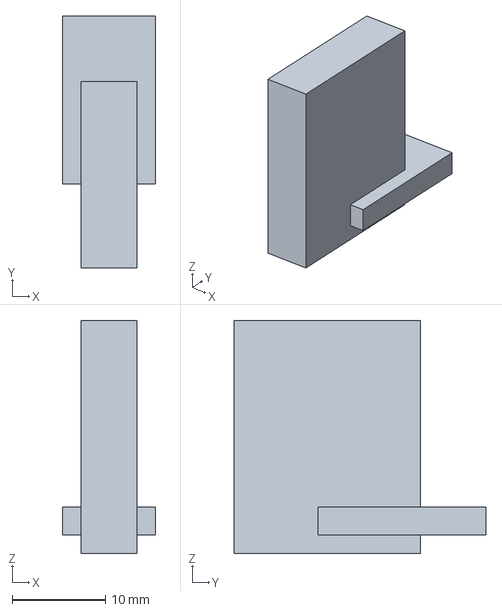
[picture p55: CAD file, 2026-08-10]
cad/hr-v0/generated/xc330-gripper-feasibility-p0.1/hr-v0-xc330-gripper-right-jaw-p0.1.step
10.0 x 27.0 x 25.0 mm
