amyleesterling/humanoid-robot/cad/hr-v0/generated/xc330-gripper-interface-p0.2/hr-v0-xc330-gripper-left-pad-envelope-p0.2.step

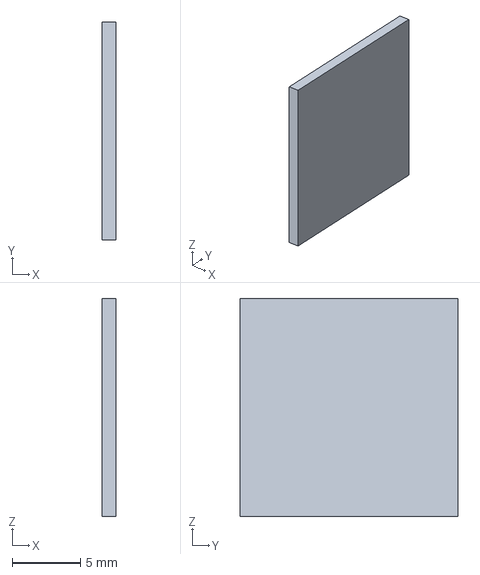
[picture p56: CAD file, 2026-08-10]
cad/hr-v0/generated/xc330-gripper-interface-p0.2/hr-v0-xc330-gripper-left-pad-envelope-p0.2.step
1.00 x 16.0 x 16.0 mm
