amyleesterling/humanoid-robot/cad/hr-v0/generated/xc330-wrist-integration-p0.1/hr-v0-xc330-h104-bridge-minus-p0.1.step

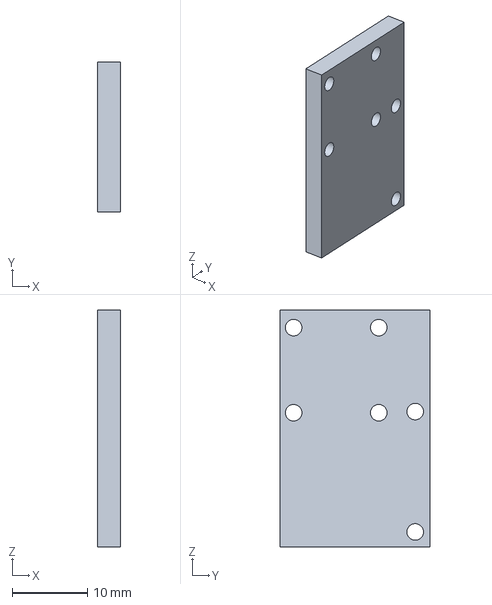
[picture p57: CAD file, 2026-08-10]
cad/hr-v0/generated/xc330-wrist-integration-p0.1/hr-v0-xc330-h104-bridge-minus-p0.1.step
3.00 x 20.0 x 31.5 mm
