amyleesterling/humanoid-robot/cad/hr-v0/guard-receiver-p0.2/HR-V0_fixed-guard-receiver-candidate.step

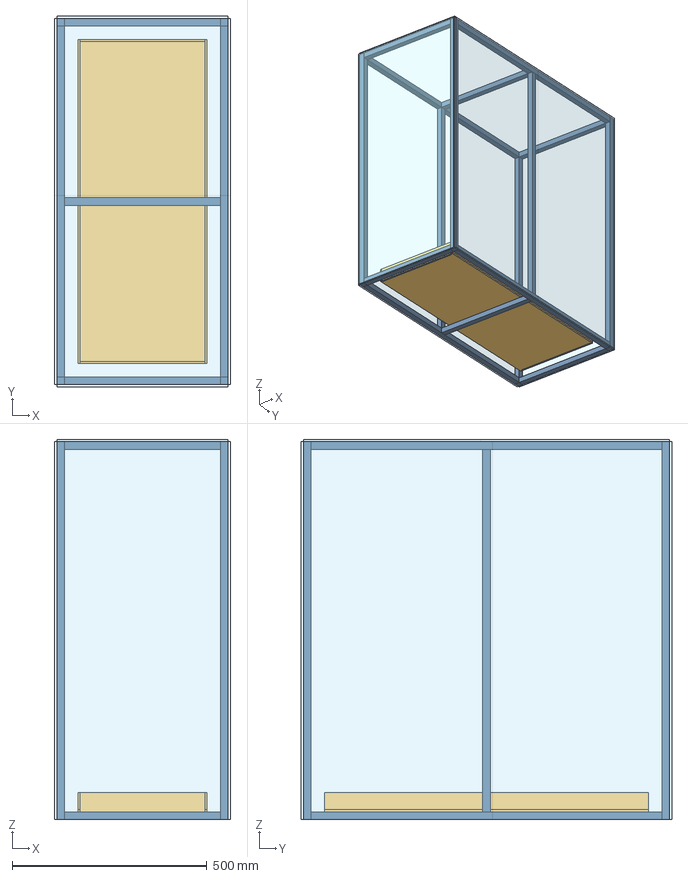
[picture p58: CAD file, 2026-08-10]
cad/hr-v0/guard-receiver-p0.2/HR-V0_fixed-guard-receiver-candidate.step
452.0 x 952.0 x 976.0 mm
POST-01
POST-02
POST-03
POST-04
POST-05
POST-06
YRAIL-FRONT-BOT
YRAIL-REAR-BOT
XRAIL-LEFT-BOT
XRAIL-RIGHT-BOT
XRAIL-CENTER-BOT
YRAIL-FRONT-TOP
YRAIL-REAR-TOP
XRAIL-LEFT-TOP
XRAIL-RIGHT-TOP
XRAIL-CENTER-TOP
PANEL-FRONT-LEFT
PANEL-FRONT-RIGHT
PANEL-REAR-LEFT
PANEL-REAR-RIGHT
PANEL-LEFT
PANEL-RIGHT
PANEL-TOP-LEFT
PANEL-TOP-RIGHT
RECEIVER-BASE
RECEIVER-WALL-X1
RECEIVER-WALL-X2
RECEIVER-WALL-Y1
RECEIVER-WALL-Y2
RESERVED-YZ-SPACE-NOT-SAFETY-DISTANCE
