amyleesterling/humanoid-robot/hr30/whole-body-p0.1/boston-fabrication-route-p0.1/bpl-submission/HR30_G01_gripper_fit_plate_nonstructural.stl

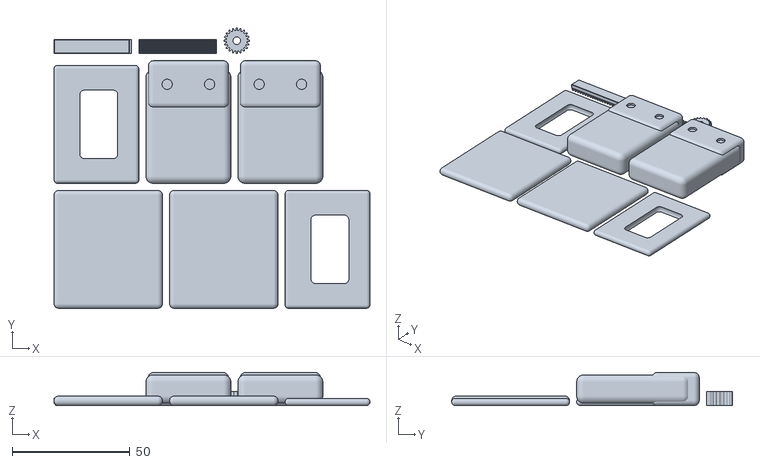
[picture p59: CAD file, 2026-08-17]
hr30/whole-body-p0.1/boston-fabrication-route-p0.1/bpl-submission/HR30_G01_gripper_fit_plate_nonstructural.stl
134.0 x 119.0 x 14.0
