amyleesterling/humanoid-robot/hr30/whole-body-p0.1/electrical/axis-commissioning-station-p0.1/HR30_axis_commissioning_station_candidate.step

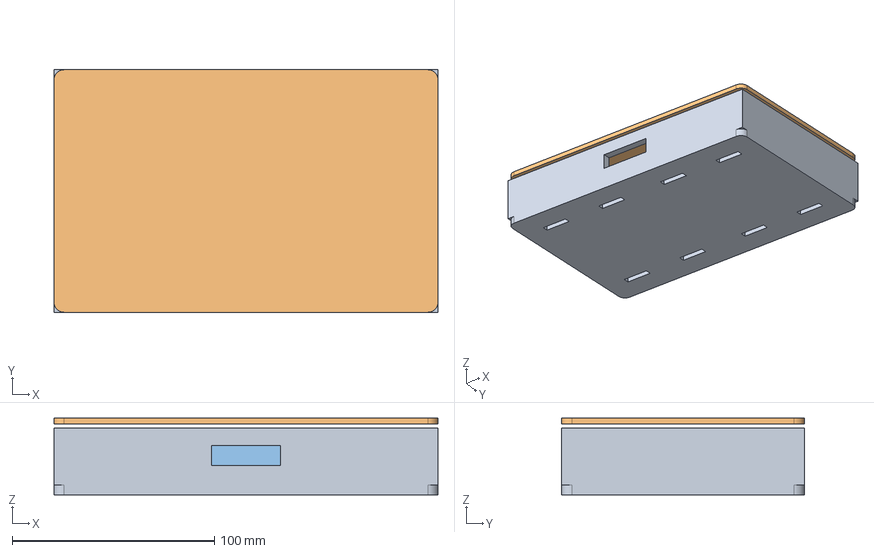
[picture p60: CAD file, 2026-08-17]
hr30/whole-body-p0.1/electrical/axis-commissioning-station-p0.1/HR30_axis_commissioning_station_candidate.step
190.0 x 120.0 x 38.0 mm
