amyleesterling/humanoid-robot/hr30/whole-body-p0.1/electrical/axis-commissioning-station-p0.1/no-motion-inspection-p0.1/xm430_w350_r_restraint_base.step

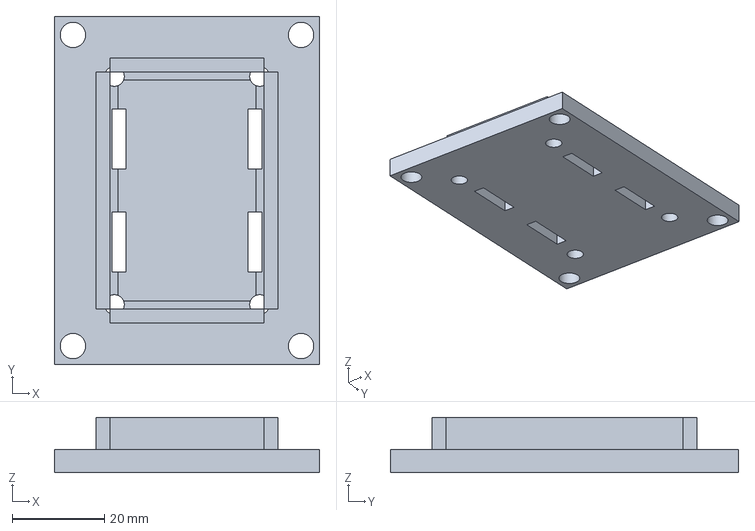
[picture p61: CAD file, 2026-08-17]
hr30/whole-body-p0.1/electrical/axis-commissioning-station-p0.1/no-motion-inspection-p0.1/xm430_w350_r_restraint_base.step
57.5 x 75.5 x 12.0 mm
