amyleesterling/humanoid-robot/hr30/whole-body-p0.1/electrical/tether-power-core-p0.1/HR30_external_tether_panel_candidate.step

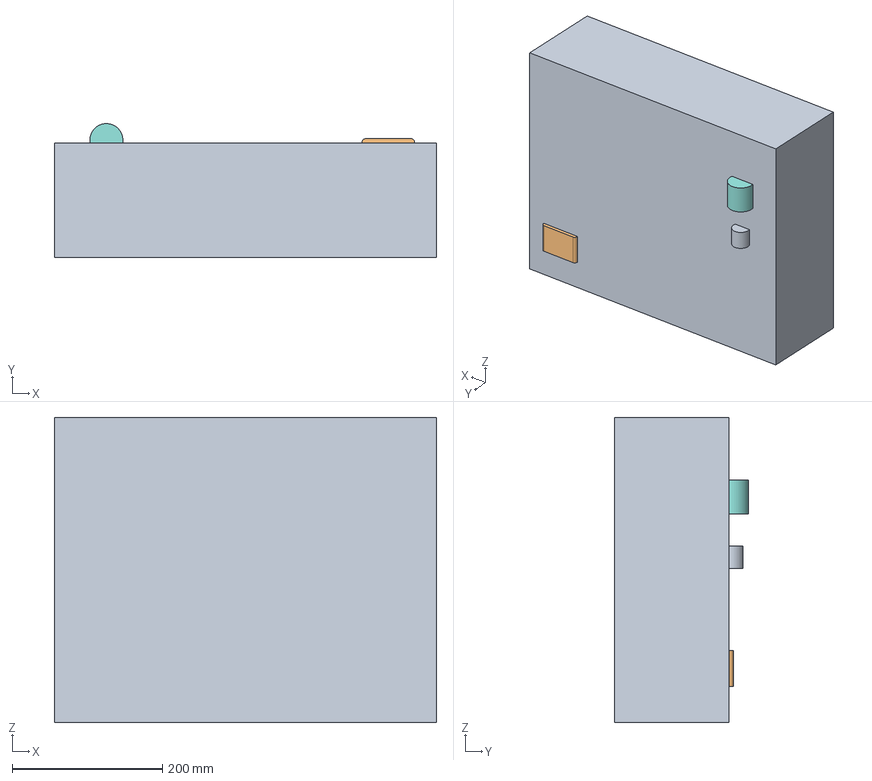
[picture p62: CAD file, 2026-08-17]
hr30/whole-body-p0.1/electrical/tether-power-core-p0.1/HR30_external_tether_panel_candidate.step
508.0 x 178.0 x 406.0 mm
