amyleesterling/humanoid-robot/hr30/whole-body-p0.1/first-fit-article-p0.1/FFA_clearance_coupon.stl

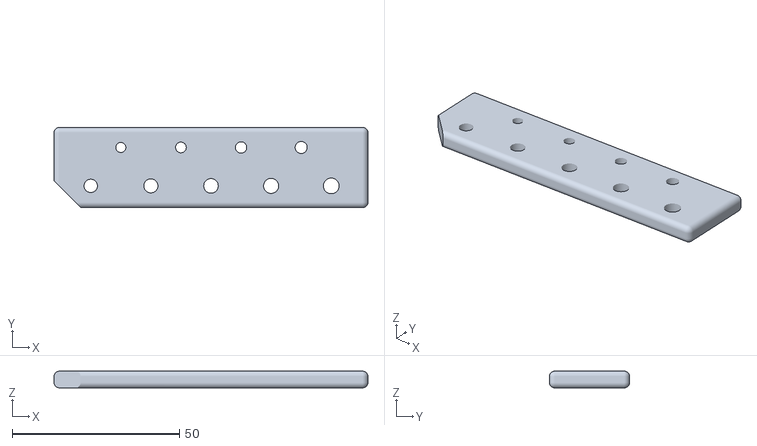
[picture p63: CAD file, 2026-08-17]
hr30/whole-body-p0.1/first-fit-article-p0.1/FFA_clearance_coupon.stl
94.0 x 24.0 x 5.00
