amyleesterling/humanoid-robot/hr30/whole-body-p0.1/first-fit-article-p0.1/stl/FFA_FRAME_FRONT.stl

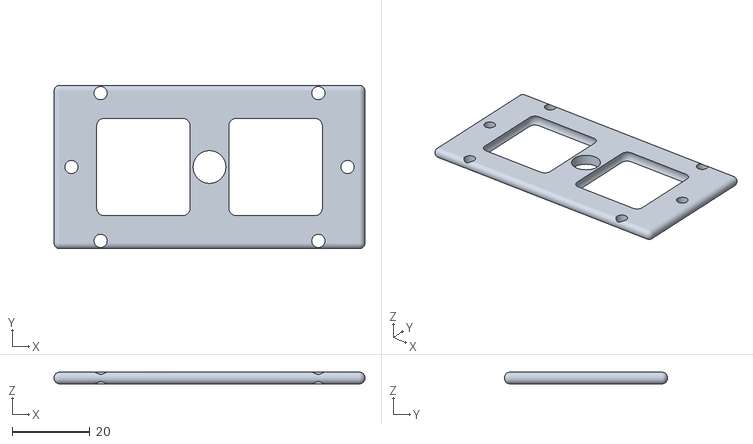
[picture p64: CAD file, 2026-08-17]
hr30/whole-body-p0.1/first-fit-article-p0.1/stl/FFA_FRAME_FRONT.stl
80.0 x 42.0 x 3.00
