amyleesterling/humanoid-robot/hr30/whole-body-p0.1/full-scale-fit-check-p0.1/stl/A01/A01_UPPER_ARM_FRONT_COVER.stl

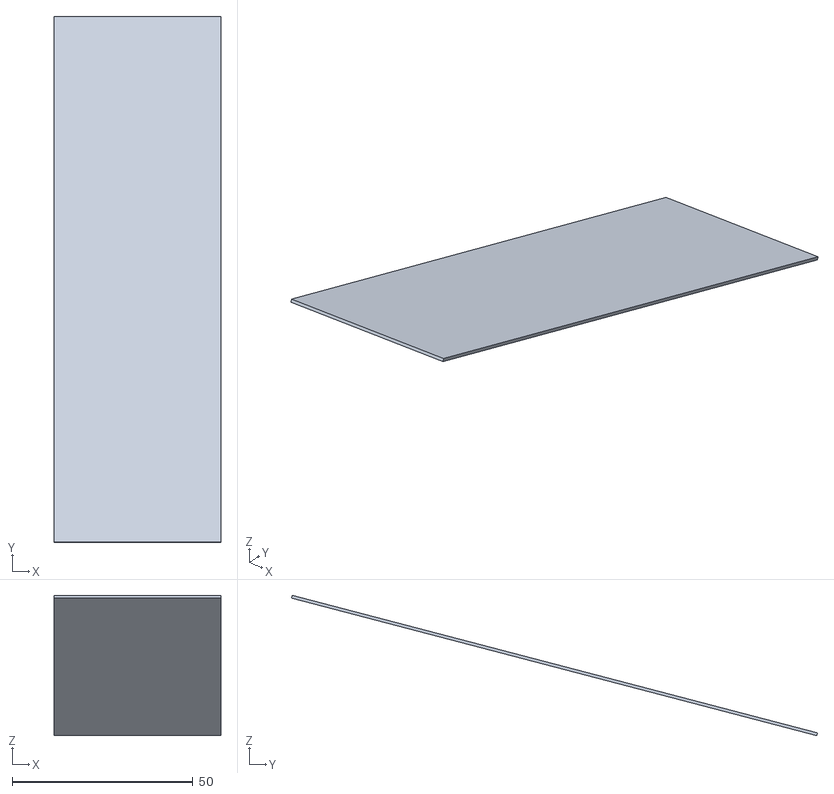
[picture p65: CAD file, 2026-08-17]
hr30/whole-body-p0.1/full-scale-fit-check-p0.1/stl/A01/A01_UPPER_ARM_FRONT_COVER.stl
46.0 x 145.3 x 38.8
