amyleesterling/humanoid-robot/hr30/whole-body-p0.1/full-scale-fit-check-p0.1/stl/A02/A02_FOREARM_FRONT_COVER.stl

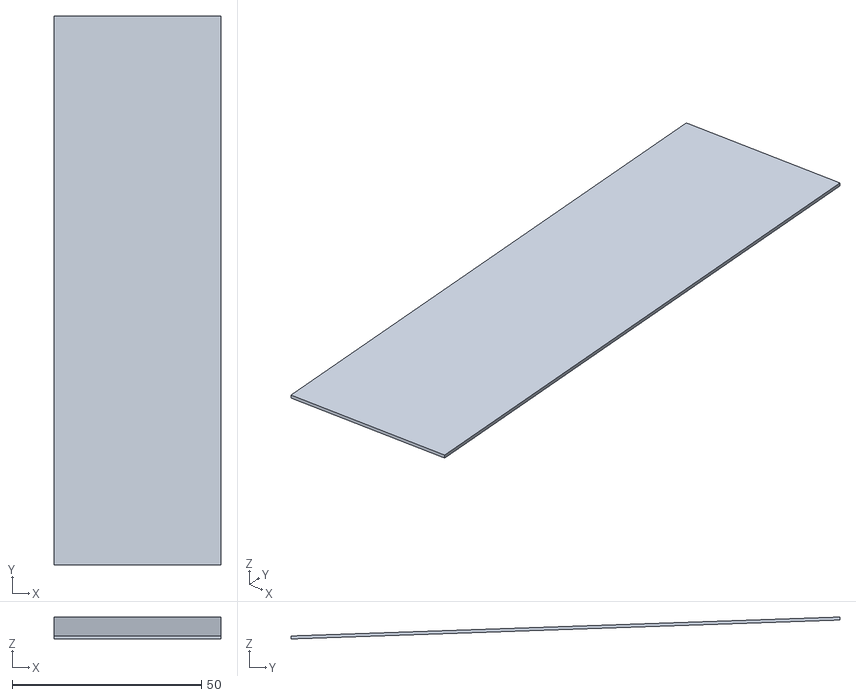
[picture p66: CAD file, 2026-08-17]
hr30/whole-body-p0.1/full-scale-fit-check-p0.1/stl/A02/A02_FOREARM_FRONT_COVER.stl
44.0 x 144.9 x 5.80
