amyleesterling/humanoid-robot/hr30/whole-body-p0.1/full-scale-fit-check-p0.1/stl/F01/F01_TOP_COVER.stl

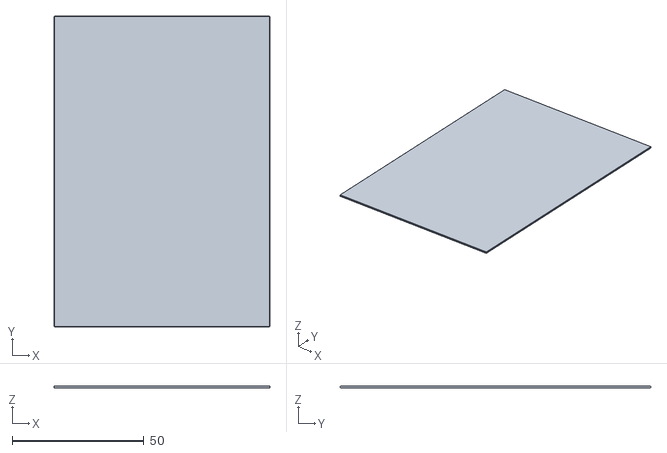
[picture p67: CAD file, 2026-08-17]
hr30/whole-body-p0.1/full-scale-fit-check-p0.1/stl/F01/F01_TOP_COVER.stl
82.0 x 118.0 x 0.8
