amyleesterling/humanoid-robot/hr30/whole-body-p0.1/full-scale-fit-check-p0.1/stl/F02/F02_SOLE_CARRIER.stl

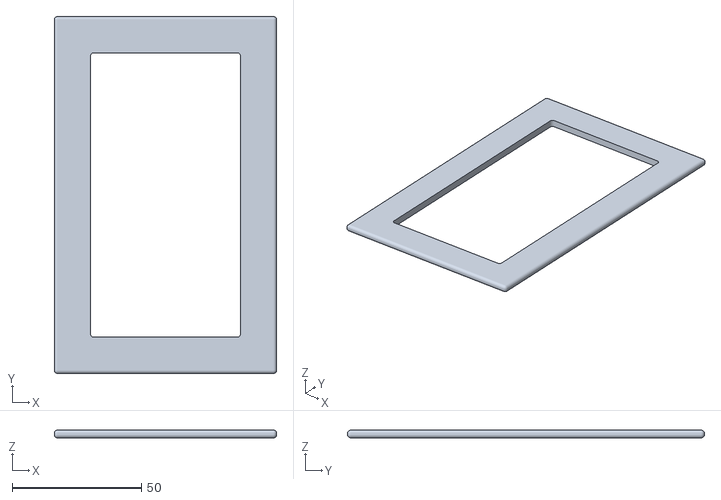
[picture p68: CAD file, 2026-08-17]
hr30/whole-body-p0.1/full-scale-fit-check-p0.1/stl/F02/F02_SOLE_CARRIER.stl
86.0 x 138.0 x 3.00
