amyleesterling/humanoid-robot/hr30/whole-body-p0.1/full-scale-fit-check-p0.1/stl/G01/G01_MANUAL_RELEASE_HUB.stl

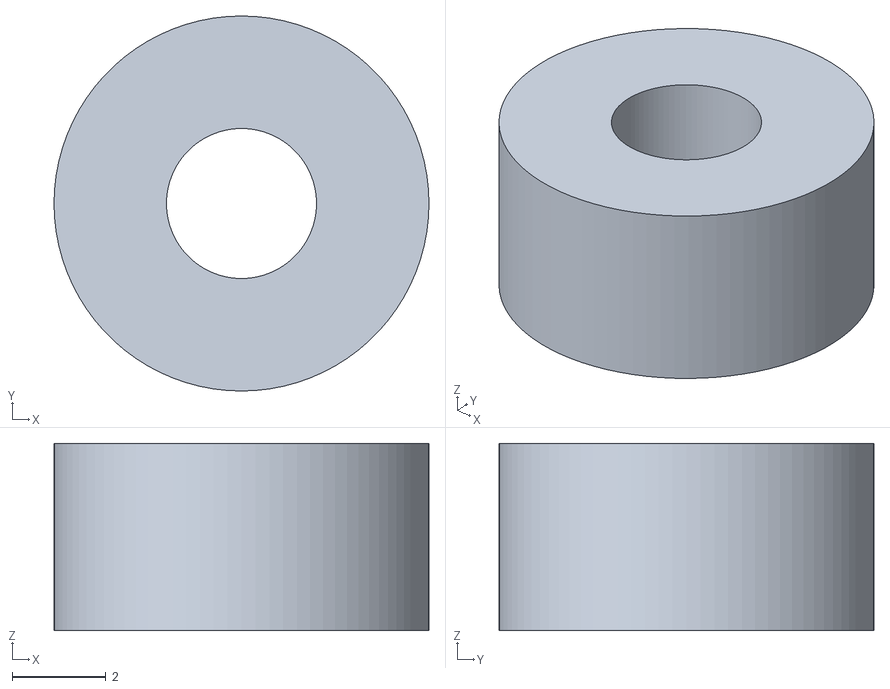
[picture p69: CAD file, 2026-08-17]
hr30/whole-body-p0.1/full-scale-fit-check-p0.1/stl/G01/G01_MANUAL_RELEASE_HUB.stl
8.00 x 8.00 x 4.00
