amyleesterling/humanoid-robot/hr30/whole-body-p0.1/full-scale-fit-check-p0.1/stl/G02/G02_RACK_POSITIVE.stl

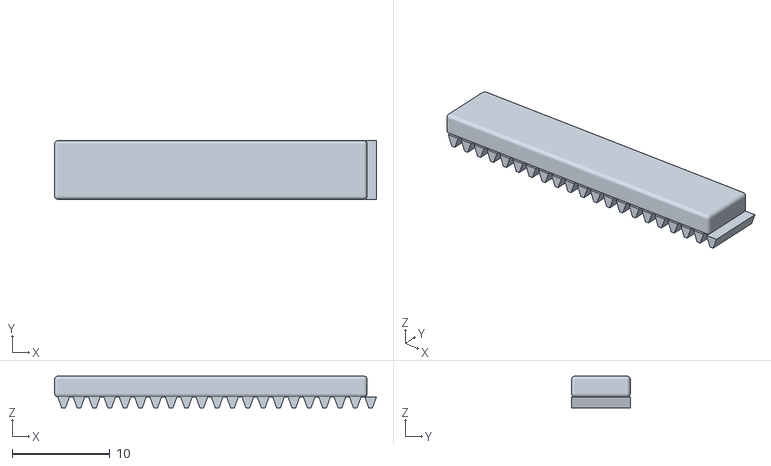
[picture p70: CAD file, 2026-08-17]
hr30/whole-body-p0.1/full-scale-fit-check-p0.1/stl/G02/G02_RACK_POSITIVE.stl
33.0 x 6.00 x 3.25
