amyleesterling/humanoid-robot/hr30/whole-body-p0.1/full-scale-fit-check-p0.1/stl/H01/H01_HEAD_REAR_COVER.stl

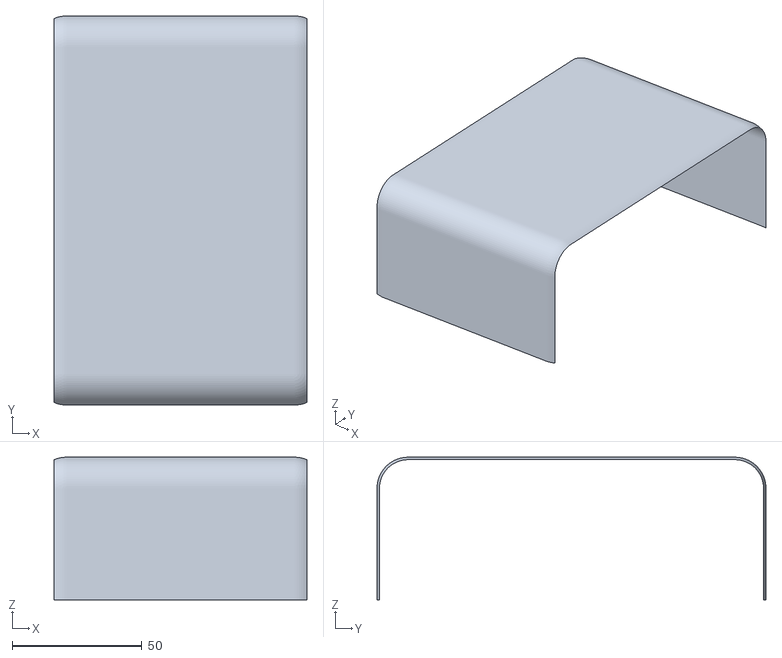
[picture p71: CAD file, 2026-08-17]
hr30/whole-body-p0.1/full-scale-fit-check-p0.1/stl/H01/H01_HEAD_REAR_COVER.stl
97.4 x 150.0 x 55.0
