amyleesterling/humanoid-robot/hr30/whole-body-p0.1/full-scale-fit-check-p0.1/stl/L01/L01_THIGH_REAR_COVER.stl

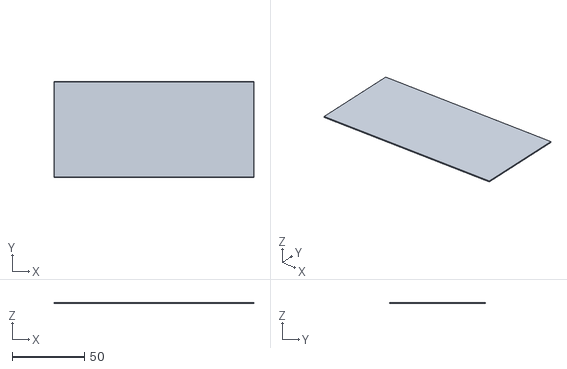
[picture p72: CAD file, 2026-08-17]
hr30/whole-body-p0.1/full-scale-fit-check-p0.1/stl/L01/L01_THIGH_REAR_COVER.stl
138.0 x 66.0 x 0.8
