amyleesterling/humanoid-robot/hr30/whole-body-p0.1/full-scale-fit-check-p0.1/stl/L02/L02_SHIN_REAR_COVER.stl

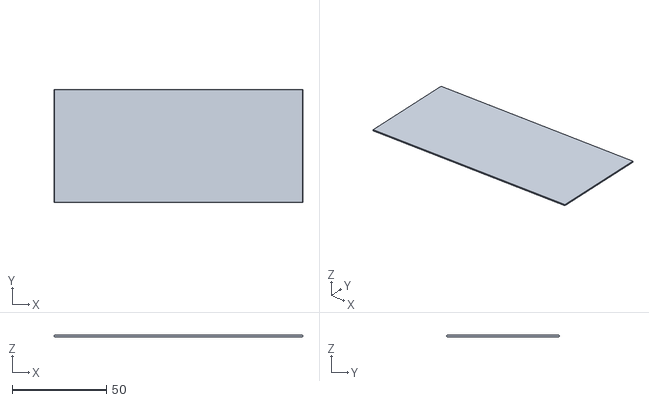
[picture p73: CAD file, 2026-08-17]
hr30/whole-body-p0.1/full-scale-fit-check-p0.1/stl/L02/L02_SHIN_REAR_COVER.stl
132.0 x 60.0 x 0.8
