amyleesterling/humanoid-robot/hr30/whole-body-p0.1/full-scale-fit-check-p0.1/stl/N01/N01_NECK_TUBE.stl

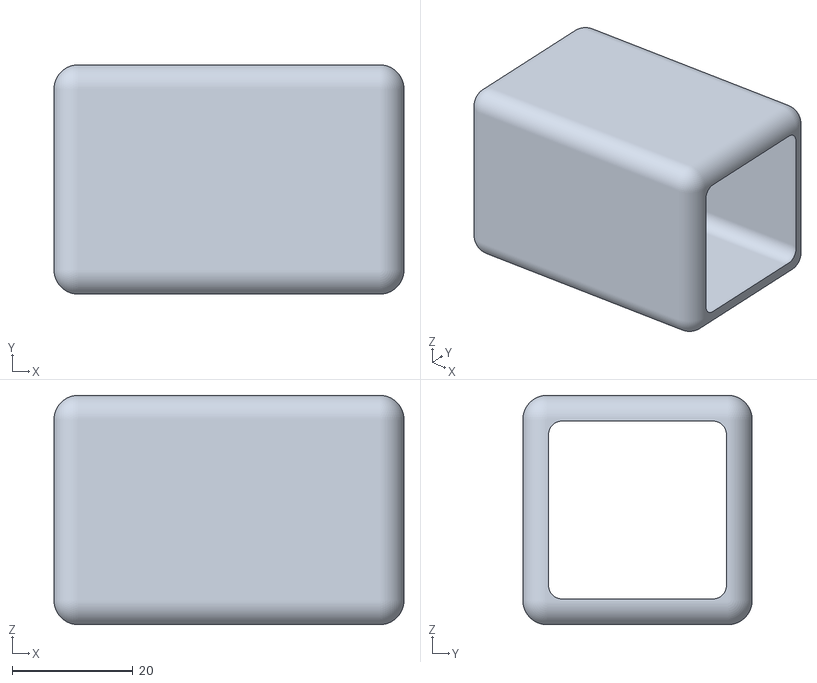
[picture p74: CAD file, 2026-08-17]
hr30/whole-body-p0.1/full-scale-fit-check-p0.1/stl/N01/N01_NECK_TUBE.stl
58.0 x 38.0 x 38.0
