amyleesterling/humanoid-robot/hr30/whole-body-p0.1/full-scale-fit-check-p0.1/stl/P01/P01_WAIST_BRIDGE.stl

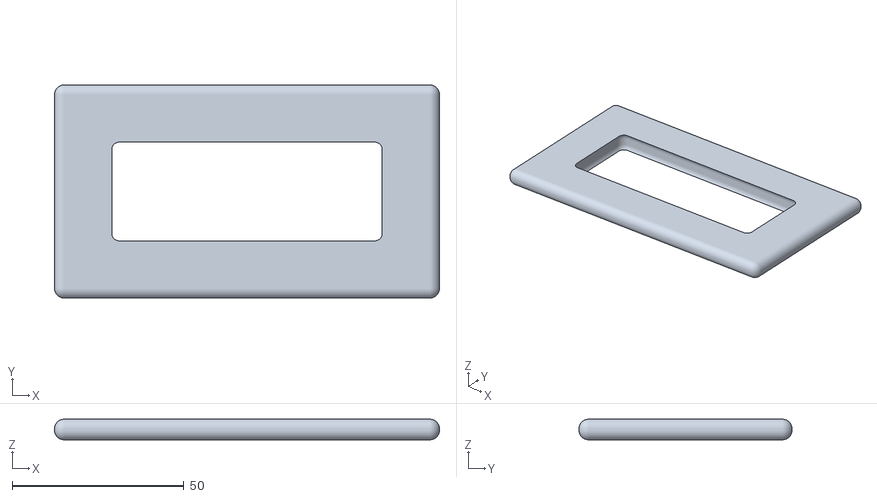
[picture p75: CAD file, 2026-08-17]
hr30/whole-body-p0.1/full-scale-fit-check-p0.1/stl/P01/P01_WAIST_BRIDGE.stl
112.0 x 62.0 x 6.00
