amyleesterling/humanoid-robot/hr30/whole-body-p0.1/full-scale-fit-check-p0.1/stl/T01/T01_SHOULDER_CROSS_TUBE.stl

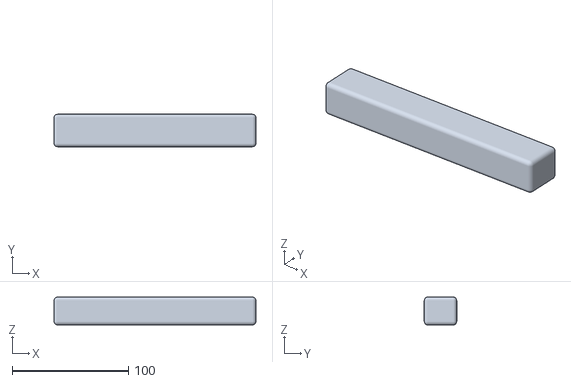
[picture p76: CAD file, 2026-08-17]
hr30/whole-body-p0.1/full-scale-fit-check-p0.1/stl/T01/T01_SHOULDER_CROSS_TUBE.stl
174.0 x 28.0 x 24.0
