amyleesterling/humanoid-robot/hr30/whole-body-p0.1/grippers-p0.1/parts/FINGER_NEGATIVE.step

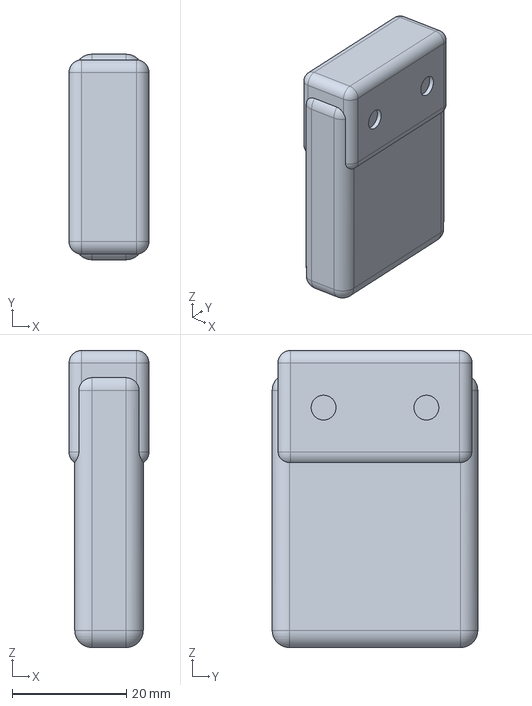
[picture p77: CAD file, 2026-08-16]
hr30/whole-body-p0.1/grippers-p0.1/parts/FINGER_NEGATIVE.step
14.0 x 36.0 x 52.0 mm
