amyleesterling/humanoid-robot/hr30/whole-body-p0.1/harness/actuator-transition-brackets-p0.1/ATB-CLAMP-CAP-P0.1.step

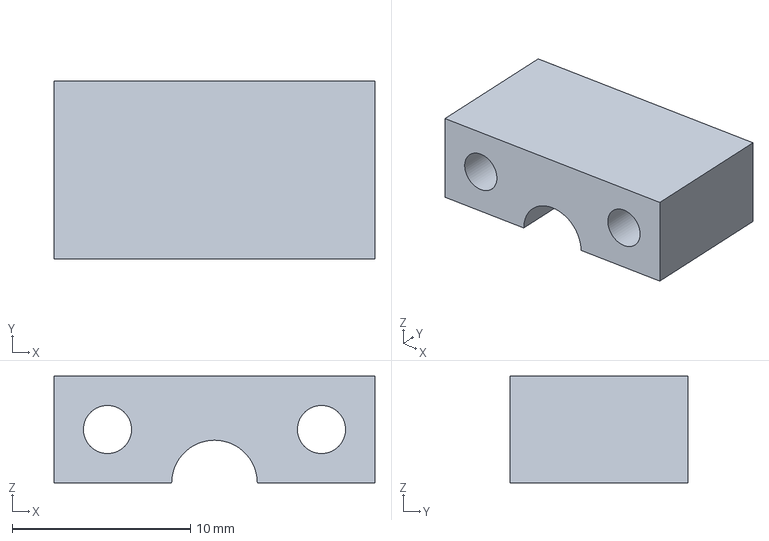
[picture p78: CAD file, 2026-08-17]
hr30/whole-body-p0.1/harness/actuator-transition-brackets-p0.1/ATB-CLAMP-CAP-P0.1.step
18.0 x 10.0 x 6.00 mm
