amyleesterling/humanoid-robot/hr30/whole-body-p0.1/harness/power-route-guides-p0.1/HR-30_power_route_guides_candidate.step

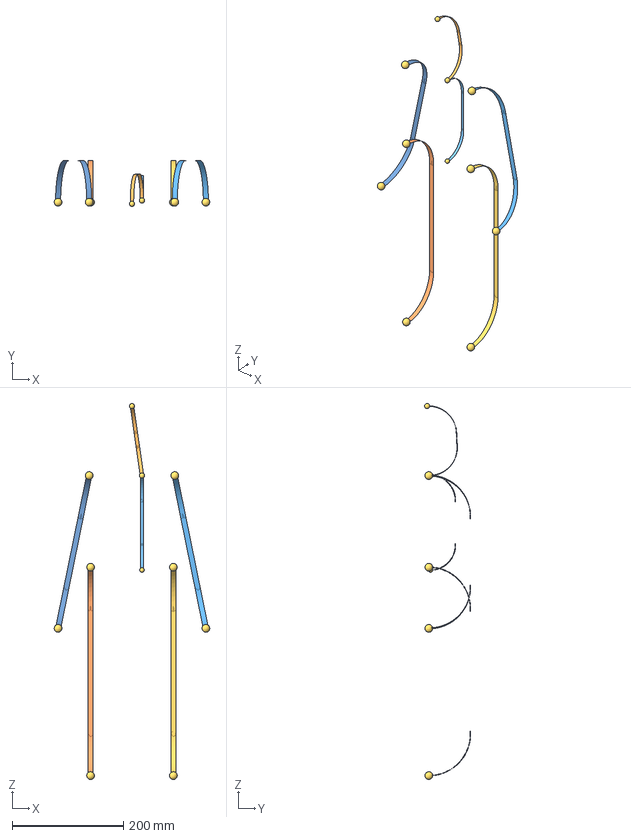
[picture p79: CAD file, 2026-08-18]
hr30/whole-body-p0.1/harness/power-route-guides-p0.1/HR-30_power_route_guides_candidate.step
280.0 x 82.6 x 676.7 mm
HN01_HEAD_POWER_BRANCH
HN01_HEAD_POWER_BRANCH_ENTRY
HN01_HEAD_POWER_BRANCH_EXIT
HN01_L_ARM_POWER
HN01_L_ARM_POWER_ENTRY
HN01_L_ARM_POWER_EXIT
HN01_L_LEG_POWER
HN01_L_LEG_POWER_ENTRY
HN01_L_LEG_POWER_EXIT
HN01_R_ARM_POWER
HN01_R_ARM_POWER_ENTRY
HN01_R_ARM_POWER_EXIT
HN01_R_LEG_POWER
HN01_R_LEG_POWER_ENTRY
HN01_R_LEG_POWER_EXIT
HN01_TORSO_POWER_SPINE
HN01_TORSO_POWER_SPINE_ENTRY
HN01_TORSO_POWER_SPINE_EXIT
