amyleesterling/humanoid-robot/hr30/whole-body-p0.1/HR-30_p09_left_touchdown_candidate.step

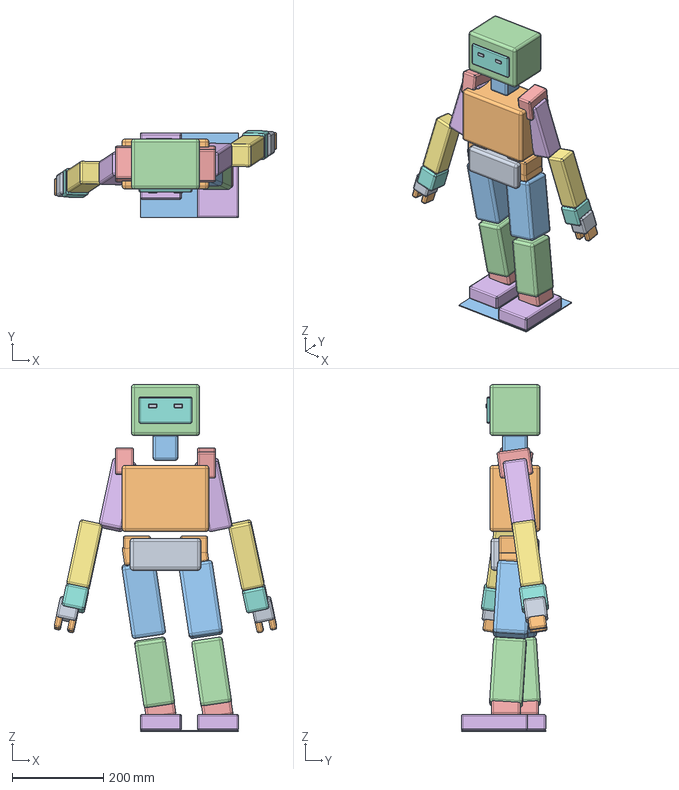
[picture p80: CAD file, 2026-08-17]
hr30/whole-body-p0.1/HR-30_p09_left_touchdown_candidate.step
487.0 x 191.2 x 760.0 mm
