amyleesterling/humanoid-robot/hr30/whole-body-p0.1/joint-hardware-manufacturing-p0.1/parts/HEAD_PAN/JMOD_HEAD_PAN_INTERFACE_PLATE_B/JMOD_HEAD_PAN_INTERFACE_PLATE_B_profile.dxf

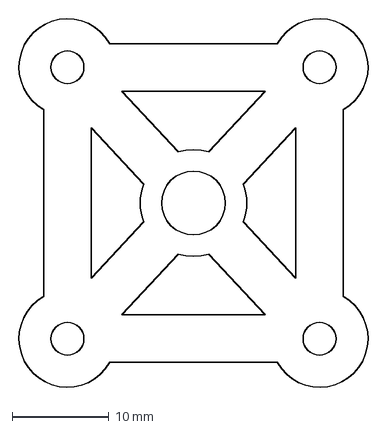
[picture p81: CAD file, 2026-08-17]
hr30/whole-body-p0.1/joint-hardware-manufacturing-p0.1/parts/HEAD_PAN/JMOD_HEAD_PAN_INTERFACE_PLATE_B/JMOD_HEAD_PAN_INTERFACE_PLATE_B_profile.dxf
36.6 x 38.6 mm
