amyleesterling/humanoid-robot/hr30/whole-body-p0.1/joint-hardware-manufacturing-p0.1/parts/HEAD_PAN/JMOD_HEAD_PAN_OUTPUT_SHAFT/JMOD_HEAD_PAN_OUTPUT_SHAFT.step

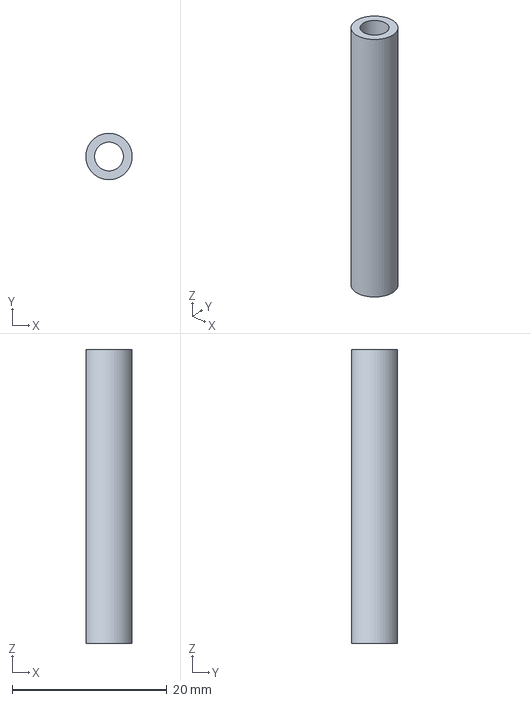
[picture p82: CAD file, 2026-08-15]
hr30/whole-body-p0.1/joint-hardware-manufacturing-p0.1/parts/HEAD_PAN/JMOD_HEAD_PAN_OUTPUT_SHAFT/JMOD_HEAD_PAN_OUTPUT_SHAFT.step
5.99 x 6.00 x 38.0 mm
