amyleesterling/humanoid-robot/hr30/whole-body-p0.1/joint-hardware-manufacturing-p0.1/parts/L_ANKLE_PITCH/JMOD_L_ANKLE_PITCH_INTERFACE_PLATE_B/JMOD_L_ANKLE_PITCH_INTERFACE_PLATE_B_profile.dxf

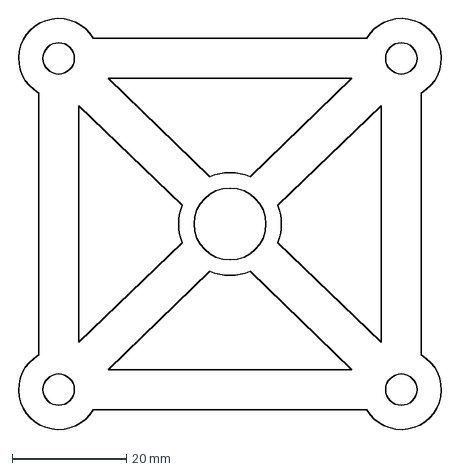
[picture p85: CAD file, 2026-08-17]
hr30/whole-body-p0.1/joint-hardware-manufacturing-p0.1/parts/L_ANKLE_PITCH/JMOD_L_ANKLE_PITCH_INTERFACE_PLATE_B/JMOD_L_ANKLE_PITCH_INTERFACE_PLATE_B_profile.dxf
74.8 x 72.8 mm
