amyleesterling/humanoid-robot/hr30/whole-body-p0.1/joint-hardware-manufacturing-p0.1/parts/L_ANKLE_PITCH/JMOD_L_ANKLE_PITCH_OUTPUT_SHAFT/JMOD_L_ANKLE_PITCH_OUTPUT_SHAFT.step

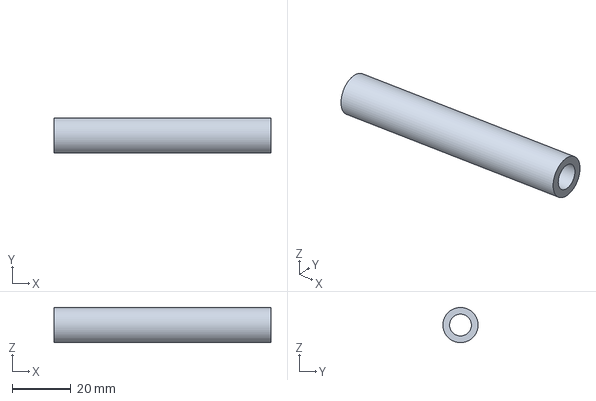
[picture p86: CAD file, 2026-08-15]
hr30/whole-body-p0.1/joint-hardware-manufacturing-p0.1/parts/L_ANKLE_PITCH/JMOD_L_ANKLE_PITCH_OUTPUT_SHAFT/JMOD_L_ANKLE_PITCH_OUTPUT_SHAFT.step
74.0 x 12.0 x 12.0 mm
