amyleesterling/humanoid-robot/hr30/whole-body-p0.1/joint-hardware-manufacturing-p0.1/parts/L_ELBOW_PITCH/JMOD_L_ELBOW_PITCH_OUTPUT_SHAFT/JMOD_L_ELBOW_PITCH_OUTPUT_SHAFT.step

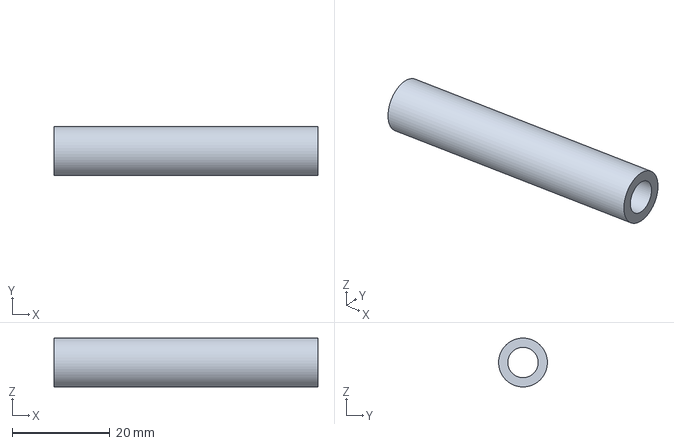
[picture p90: CAD file, 2026-08-16]
hr30/whole-body-p0.1/joint-hardware-manufacturing-p0.1/parts/L_ELBOW_PITCH/JMOD_L_ELBOW_PITCH_OUTPUT_SHAFT/JMOD_L_ELBOW_PITCH_OUTPUT_SHAFT.step
54.0 x 10.00 x 9.99 mm
