amyleesterling/humanoid-robot/hr30/whole-body-p0.1/joint-hardware-manufacturing-p0.1/parts/L_GRIPPER/JMOD_L_GRIPPER_INTERFACE_PLATE_B/JMOD_L_GRIPPER_INTERFACE_PLATE_B_profile.dxf

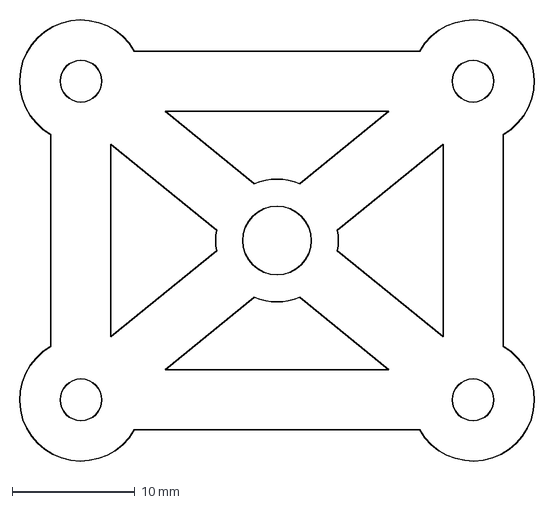
[picture p91: CAD file, 2026-08-17]
hr30/whole-body-p0.1/joint-hardware-manufacturing-p0.1/parts/L_GRIPPER/JMOD_L_GRIPPER_INTERFACE_PLATE_B/JMOD_L_GRIPPER_INTERFACE_PLATE_B_profile.dxf
42.6 x 36.6 mm
