amyleesterling/humanoid-robot/hr30/whole-body-p0.1/joint-hardware-manufacturing-p0.1/parts/L_GRIPPER/JMOD_L_GRIPPER_OUTPUT_SHAFT/JMOD_L_GRIPPER_OUTPUT_SHAFT.step

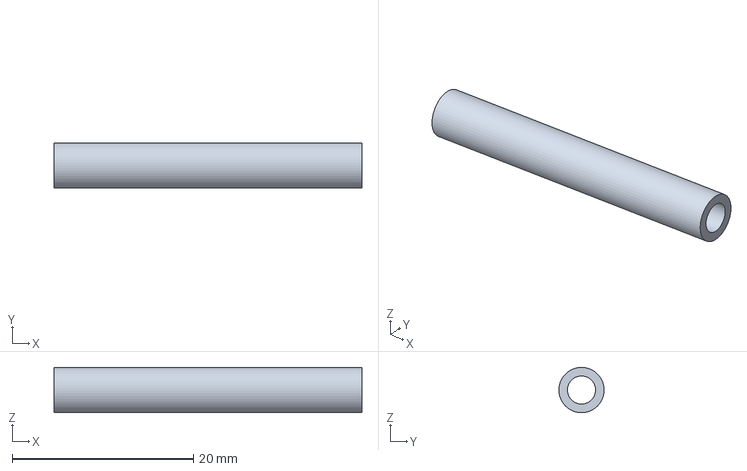
[picture p92: CAD file, 2026-08-16]
hr30/whole-body-p0.1/joint-hardware-manufacturing-p0.1/parts/L_GRIPPER/JMOD_L_GRIPPER_OUTPUT_SHAFT/JMOD_L_GRIPPER_OUTPUT_SHAFT.step
34.0 x 5.00 x 5.00 mm
