amyleesterling/humanoid-robot/hr30/whole-body-p0.1/joint-hardware-manufacturing-p0.1/parts/L_HIP_PITCH/JMOD_L_HIP_PITCH_INTERFACE_PLATE_A/JMOD_L_HIP_PITCH_INTERFACE_PLATE_A_profile.dxf

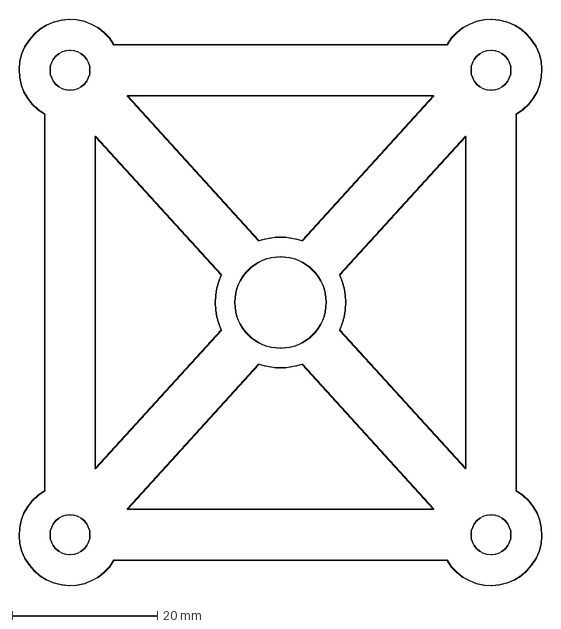
[picture p93: CAD file, 2026-08-17]
hr30/whole-body-p0.1/joint-hardware-manufacturing-p0.1/parts/L_HIP_PITCH/JMOD_L_HIP_PITCH_INTERFACE_PLATE_A/JMOD_L_HIP_PITCH_INTERFACE_PLATE_A_profile.dxf
72.8 x 78.8 mm
