amyleesterling/humanoid-robot/hr30/whole-body-p0.1/joint-hardware-manufacturing-p0.1/parts/L_HIP_YAW/JMOD_L_HIP_YAW_OUTPUT_SHAFT/JMOD_L_HIP_YAW_OUTPUT_SHAFT.step

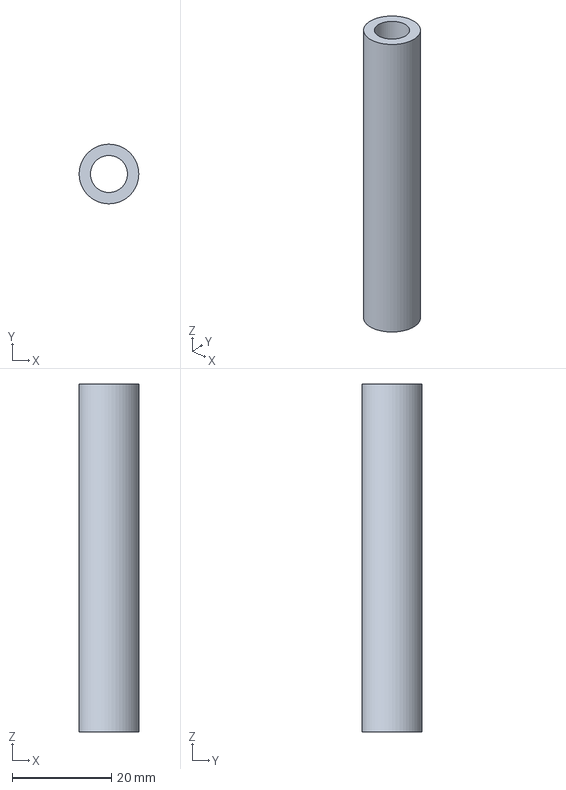
[picture p98: CAD file, 2026-08-15]
hr30/whole-body-p0.1/joint-hardware-manufacturing-p0.1/parts/L_HIP_YAW/JMOD_L_HIP_YAW_OUTPUT_SHAFT/JMOD_L_HIP_YAW_OUTPUT_SHAFT.step
12.0 x 12.0 x 70.0 mm
