amyleesterling/humanoid-robot/hr30/whole-body-p0.1/joint-hardware-manufacturing-p0.1/parts/L_KNEE_PITCH/JMOD_L_KNEE_PITCH_INTERFACE_PLATE_B/JMOD_L_KNEE_PITCH_INTERFACE_PLATE_B_profile.dxf

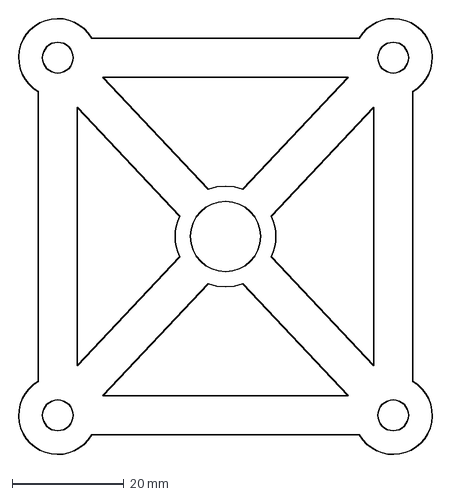
[picture p100: CAD file, 2026-08-17]
hr30/whole-body-p0.1/joint-hardware-manufacturing-p0.1/parts/L_KNEE_PITCH/JMOD_L_KNEE_PITCH_INTERFACE_PLATE_B/JMOD_L_KNEE_PITCH_INTERFACE_PLATE_B_profile.dxf
74.8 x 78.8 mm
