amyleesterling/humanoid-robot/hr30/whole-body-p0.1/joint-hardware-manufacturing-p0.1/parts/L_SHOULDER_ROLL/JMOD_L_SHOULDER_ROLL_INTERFACE_PLATE_B/JMOD_L_SHOULDER_ROLL_INTERFACE_PLATE_B_profile.dxf

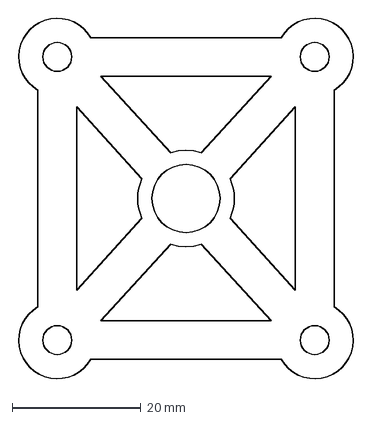
[picture p104: CAD file, 2026-08-17]
hr30/whole-body-p0.1/joint-hardware-manufacturing-p0.1/parts/L_SHOULDER_ROLL/JMOD_L_SHOULDER_ROLL_INTERFACE_PLATE_B/JMOD_L_SHOULDER_ROLL_INTERFACE_PLATE_B_profile.dxf
52.7 x 56.7 mm
