amyleesterling/humanoid-robot/hr30/whole-body-p0.1/joint-hardware-manufacturing-p0.1/parts/R_ANKLE_PITCH/JMOD_R_ANKLE_PITCH_INTERFACE_PLATE_A/JMOD_R_ANKLE_PITCH_INTERFACE_PLATE_A_profile.dxf

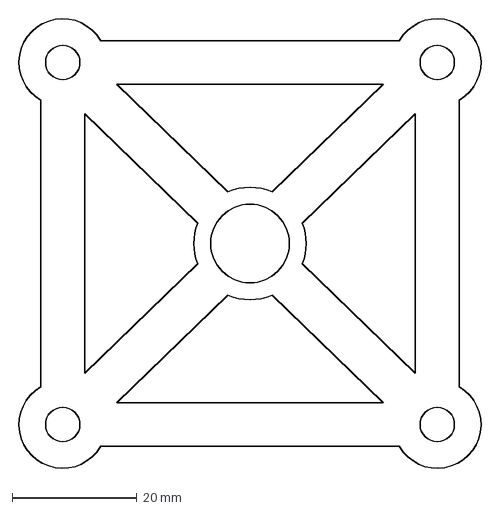
[picture p106: CAD file, 2026-08-17]
hr30/whole-body-p0.1/joint-hardware-manufacturing-p0.1/parts/R_ANKLE_PITCH/JMOD_R_ANKLE_PITCH_INTERFACE_PLATE_A/JMOD_R_ANKLE_PITCH_INTERFACE_PLATE_A_profile.dxf
74.8 x 72.8 mm
