amyleesterling/humanoid-robot/hr30/whole-body-p0.1/joint-hardware-manufacturing-p0.1/parts/R_ANKLE_ROLL/JMOD_R_ANKLE_ROLL_INTERFACE_PLATE_B/JMOD_R_ANKLE_ROLL_INTERFACE_PLATE_B_profile.dxf

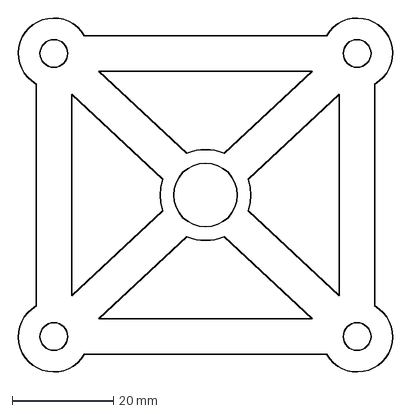
[picture p109: CAD file, 2026-08-17]
hr30/whole-body-p0.1/joint-hardware-manufacturing-p0.1/parts/R_ANKLE_ROLL/JMOD_R_ANKLE_ROLL_INTERFACE_PLATE_B/JMOD_R_ANKLE_ROLL_INTERFACE_PLATE_B_profile.dxf
74.8 x 70.8 mm
