amyleesterling/humanoid-robot/hr30/whole-body-p0.1/joint-hardware-manufacturing-p0.1/parts/R_HIP_ROLL/JMOD_R_HIP_ROLL_INTERFACE_PLATE_A/JMOD_R_HIP_ROLL_INTERFACE_PLATE_A_profile.dxf

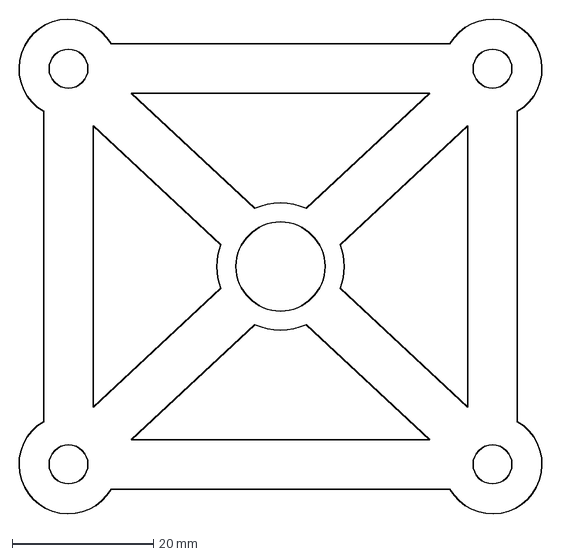
[picture p114: CAD file, 2026-08-17]
hr30/whole-body-p0.1/joint-hardware-manufacturing-p0.1/parts/R_HIP_ROLL/JMOD_R_HIP_ROLL_INTERFACE_PLATE_A/JMOD_R_HIP_ROLL_INTERFACE_PLATE_A_profile.dxf
74.8 x 70.8 mm
