amyleesterling/humanoid-robot/hr30/whole-body-p0.1/joint-hardware-manufacturing-p0.1/parts/R_HIP_YAW/JMOD_R_HIP_YAW_INTERFACE_PLATE_B/JMOD_R_HIP_YAW_INTERFACE_PLATE_B_profile.dxf

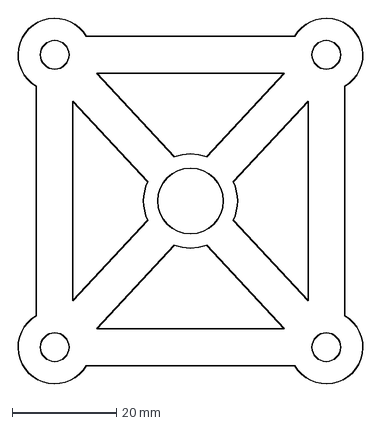
[picture p116: CAD file, 2026-08-17]
hr30/whole-body-p0.1/joint-hardware-manufacturing-p0.1/parts/R_HIP_YAW/JMOD_R_HIP_YAW_INTERFACE_PLATE_B/JMOD_R_HIP_YAW_INTERFACE_PLATE_B_profile.dxf
66.8 x 70.8 mm
