amyleesterling/humanoid-robot/hr30/whole-body-p0.1/joint-hardware-manufacturing-p0.1/parts/R_KNEE_PITCH/JMOD_R_KNEE_PITCH_INTERFACE_PLATE_B/JMOD_R_KNEE_PITCH_INTERFACE_PLATE_B_profile.dxf

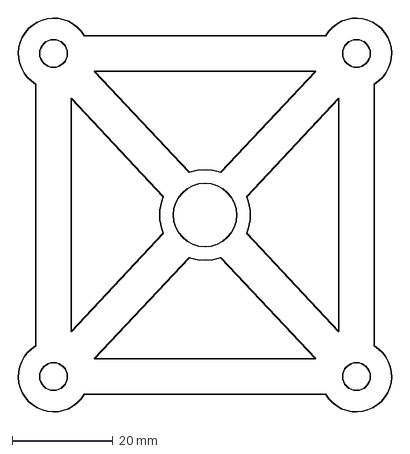
[picture p118: CAD file, 2026-08-17]
hr30/whole-body-p0.1/joint-hardware-manufacturing-p0.1/parts/R_KNEE_PITCH/JMOD_R_KNEE_PITCH_INTERFACE_PLATE_B/JMOD_R_KNEE_PITCH_INTERFACE_PLATE_B_profile.dxf
74.8 x 78.8 mm
