amyleesterling/humanoid-robot/hr30/whole-body-p0.1/joint-hardware-manufacturing-p0.1/parts/R_SHOULDER_PITCH/JMOD_R_SHOULDER_PITCH_INTERFACE_PLATE_B/JMOD_R_SHOULDER_PITCH_INTERFACE_PLATE_B_profile.dxf

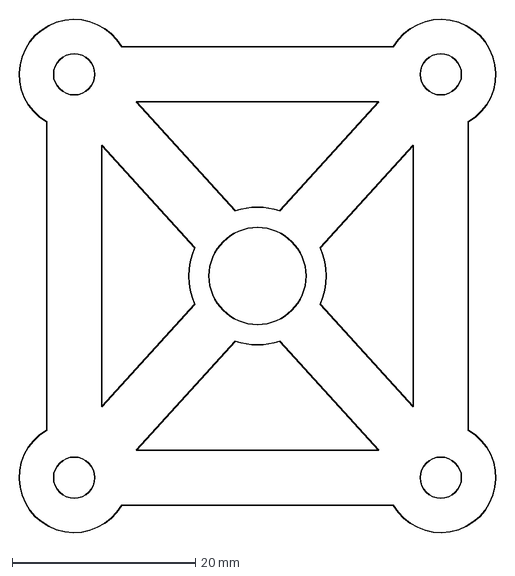
[picture p120: CAD file, 2026-08-17]
hr30/whole-body-p0.1/joint-hardware-manufacturing-p0.1/parts/R_SHOULDER_PITCH/JMOD_R_SHOULDER_PITCH_INTERFACE_PLATE_B/JMOD_R_SHOULDER_PITCH_INTERFACE_PLATE_B_profile.dxf
52.7 x 56.7 mm
