amyleesterling/humanoid-robot/hr30/whole-body-p0.1/joint-hardware-manufacturing-p0.1/parts/R_WRIST_ROTATION/JMOD_R_WRIST_ROTATION_INTERFACE_PLATE_B/JMOD_R_WRIST_ROTATION_INTERFACE_PLATE_B_profile.dxf

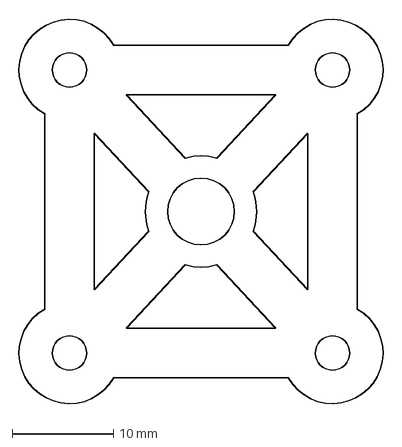
[picture p123: CAD file, 2026-08-17]
hr30/whole-body-p0.1/joint-hardware-manufacturing-p0.1/parts/R_WRIST_ROTATION/JMOD_R_WRIST_ROTATION_INTERFACE_PLATE_B/JMOD_R_WRIST_ROTATION_INTERFACE_PLATE_B_profile.dxf
36.6 x 38.6 mm
