amyleesterling/humanoid-robot/hr30/whole-body-p0.1/joint-hardware-manufacturing-p0.1/parts/WAIST_YAW/JMOD_WAIST_YAW_INTERFACE_PLATE_B/JMOD_WAIST_YAW_INTERFACE_PLATE_B_profile.dxf

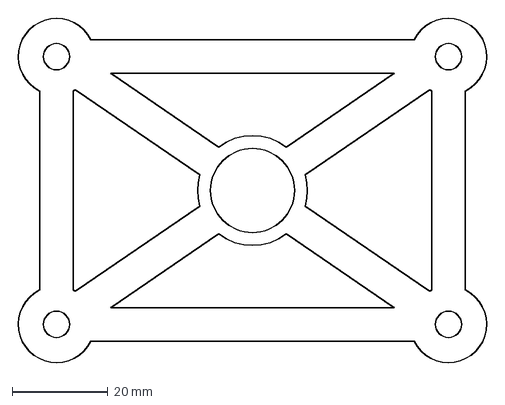
[picture p124: CAD file, 2026-08-17]
hr30/whole-body-p0.1/joint-hardware-manufacturing-p0.1/parts/WAIST_YAW/JMOD_WAIST_YAW_INTERFACE_PLATE_B/JMOD_WAIST_YAW_INTERFACE_PLATE_B_profile.dxf
98.9 x 72.9 mm
