amyleesterling/humanoid-robot/hr30/whole-body-p0.1/joint-hardware-manufacturing-p0.1/parts/WAIST_YAW/JMOD_WAIST_YAW_OUTPUT_SHAFT/JMOD_WAIST_YAW_OUTPUT_SHAFT.step

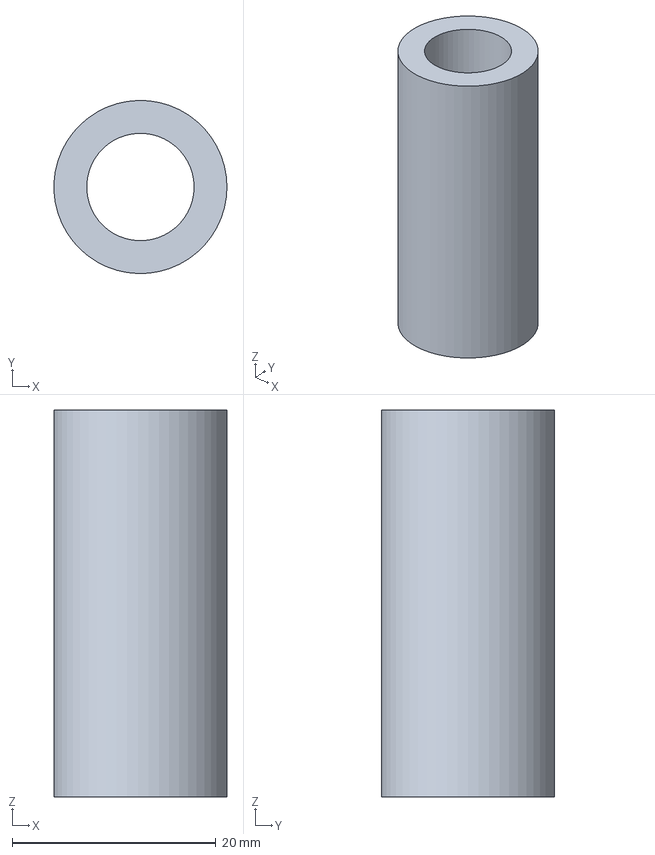
[picture p125: CAD file, 2026-08-15]
hr30/whole-body-p0.1/joint-hardware-manufacturing-p0.1/parts/WAIST_YAW/JMOD_WAIST_YAW_OUTPUT_SHAFT/JMOD_WAIST_YAW_OUTPUT_SHAFT.step
17.0 x 17.0 x 38.0 mm
