amyleesterling/humanoid-robot/(list of files, cad)

Other CAD files:
cad/hr-v0/generated/elbow-architecture-p0.8/parts/P08-C02_X430_moving-striker-adapter.step
cad/hr-v0/guard-receiver-p0.3/HR-V0_fixed-guard-receiver-candidate.step
hr30/whole-body-p0.1/joint-hardware-manufacturing-p0.1/parts/HEAD_TILT/JMOD_HEAD_TILT_OUTPUT_SHAFT/JMOD_HEAD_TILT_OUTPUT_SHAFT.step
hr30/whole-body-p0.1/joint-hardware-manufacturing-p0.1/parts/L_ANKLE_ROLL/JMOD_L_ANKLE_ROLL_OUTPUT_SHAFT/JMOD_L_ANKLE_ROLL_OUTPUT_SHAFT.step
hr30/whole-body-p0.1/joint-hardware-manufacturing-p0.1/parts/L_HIP_PITCH/JMOD_L_HIP_PITCH_OUTPUT_SHAFT/JMOD_L_HIP_PITCH_OUTPUT_SHAFT.step
hr30/whole-body-p0.1/joint-hardware-manufacturing-p0.1/parts/L_HIP_ROLL/JMOD_L_HIP_ROLL_OUTPUT_SHAFT/JMOD_L_HIP_ROLL_OUTPUT_SHAFT.step
hr30/whole-body-p0.1/joint-hardware-manufacturing-p0.1/parts/L_KNEE_PITCH/JMOD_L_KNEE_PITCH_OUTPUT_SHAFT/JMOD_L_KNEE_PITCH_OUTPUT_SHAFT.step
hr30/whole-body-p0.1/joint-hardware-manufacturing-p0.1/parts/L_SHOULDER_PITCH/JMOD_L_SHOULDER_PITCH_OUTPUT_SHAFT/JMOD_L_SHOULDER_PITCH_OUTPUT_SHAFT.step
hr30/whole-body-p0.1/joint-hardware-manufacturing-p0.1/parts/L_SHOULDER_ROLL/JMOD_L_SHOULDER_ROLL_OUTPUT_SHAFT/JMOD_L_SHOULDER_ROLL_OUTPUT_SHAFT.step
hr30/whole-body-p0.1/joint-hardware-manufacturing-p0.1/parts/L_WRIST_ROTATION/JMOD_L_WRIST_ROTATION_OUTPUT_SHAFT/JMOD_L_WRIST_ROTATION_OUTPUT_SHAFT.step
hr30/whole-body-p0.1/joint-hardware-manufacturing-p0.1/parts/R_ANKLE_PITCH/JMOD_R_ANKLE_PITCH_OUTPUT_SHAFT/JMOD_R_ANKLE_PITCH_OUTPUT_SHAFT.step
hr30/whole-body-p0.1/joint-hardware-manufacturing-p0.1/parts/R_ANKLE_ROLL/JMOD_R_ANKLE_ROLL_OUTPUT_SHAFT/JMOD_R_ANKLE_ROLL_OUTPUT_SHAFT.step
hr30/whole-body-p0.1/joint-hardware-manufacturing-p0.1/parts/R_ELBOW_PITCH/JMOD_R_ELBOW_PITCH_OUTPUT_SHAFT/JMOD_R_ELBOW_PITCH_OUTPUT_SHAFT.step
hr30/whole-body-p0.1/joint-hardware-manufacturing-p0.1/parts/R_GRIPPER/JMOD_R_GRIPPER_OUTPUT_SHAFT/JMOD_R_GRIPPER_OUTPUT_SHAFT.step
hr30/whole-body-p0.1/joint-hardware-manufacturing-p0.1/parts/R_HIP_PITCH/JMOD_R_HIP_PITCH_OUTPUT_SHAFT/JMOD_R_HIP_PITCH_OUTPUT_SHAFT.step
hr30/whole-body-p0.1/joint-hardware-manufacturing-p0.1/parts/R_HIP_ROLL/JMOD_R_HIP_ROLL_OUTPUT_SHAFT/JMOD_R_HIP_ROLL_OUTPUT_SHAFT.step
hr30/whole-body-p0.1/joint-hardware-manufacturing-p0.1/parts/R_HIP_YAW/JMOD_R_HIP_YAW_OUTPUT_SHAFT/JMOD_R_HIP_YAW_OUTPUT_SHAFT.step
hr30/whole-body-p0.1/joint-hardware-manufacturing-p0.1/parts/R_KNEE_PITCH/JMOD_R_KNEE_PITCH_OUTPUT_SHAFT/JMOD_R_KNEE_PITCH_OUTPUT_SHAFT.step
hr30/whole-body-p0.1/joint-hardware-manufacturing-p0.1/parts/R_SHOULDER_PITCH/JMOD_R_SHOULDER_PITCH_OUTPUT_SHAFT/JMOD_R_SHOULDER_PITCH_OUTPUT_SHAFT.step
hr30/whole-body-p0.1/joint-hardware-manufacturing-p0.1/parts/R_SHOULDER_ROLL/JMOD_R_SHOULDER_ROLL_OUTPUT_SHAFT/JMOD_R_SHOULDER_ROLL_OUTPUT_SHAFT.step
hr30/whole-body-p0.1/joint-hardware-manufacturing-p0.1/parts/R_WRIST_ROTATION/JMOD_R_WRIST_ROTATION_OUTPUT_SHAFT/JMOD_R_WRIST_ROTATION_OUTPUT_SHAFT.step
cad/hr-v0-q4x-box-layout-p0.1/14F0907-review-proxy.stl
cad/hr-v0/generated/arm-architecture-p0.1/parts/MV0-C02_20-2040_100mm_collision_envelope.step
cad/hr-v0/generated/arm-architecture-p0.1/parts/MV0-C03_20-2040_50mm_collision_envelope.step
cad/hr-v0/generated/arm-architecture-p0.10-bossed-stop/parts/MV0-C01_adapter-finished-profile.dxf
cad/hr-v0/generated/arm-architecture-p0.10-bossed-stop/parts/MV0-C02_20-2040_100mm_vertical_collision_envelope.step
cad/hr-v0/generated/arm-architecture-p0.10-bossed-stop/parts/MV0-C03_20-2040_50mm_vertical_collision_envelope.step
cad/hr-v0/generated/arm-architecture-p0.10-bossed-stop/parts/MV0-C04_H104_to_20-2040_countersunk_adapter.step
cad/hr-v0/generated/arm-architecture-p0.10-bossed-stop/parts/MV0-C04_gripper-adapter-finished-profile.dxf
cad/hr-v0/generated/arm-architecture-p0.10-bossed-stop/parts/MV0-C05_S102_to_40-4040_side_slot_support.step
cad/hr-v0/generated/arm-architecture-p0.10-bossed-stop/parts/MV0-C05_shoulder-support-finished-profile.dxf
cad/hr-v0/generated/arm-architecture-p0.10-bossed-stop/parts/MV0-C06_J2-positive-moving-striker-profile.dxf
cad/hr-v0/generated/arm-architecture-p0.10-bossed-stop/parts/MV0-C06_J2_positive_moving_striker_adapter.step
cad/hr-v0/generated/arm-architecture-p0.10-bossed-stop/parts/MV0-C07_J2_positive_fixed_catch_adapter.step
cad/hr-v0/generated/arm-architecture-p0.11-side-web-stop/parts/MV0-C01_adapter-finished-profile.dxf
cad/hr-v0/generated/arm-architecture-p0.11-side-web-stop/parts/MV0-C02_20-2040_100mm_vertical_collision_envelope.step
cad/hr-v0/generated/arm-architecture-p0.11-side-web-stop/parts/MV0-C03_20-2040_50mm_vertical_collision_envelope.step
cad/hr-v0/generated/arm-architecture-p0.11-side-web-stop/parts/MV0-C04_H104_to_20-2040_countersunk_adapter.step
cad/hr-v0/generated/arm-architecture-p0.11-side-web-stop/parts/MV0-C04_gripper-adapter-finished-profile.dxf
cad/hr-v0/generated/arm-architecture-p0.11-side-web-stop/parts/MV0-C05_S102_to_40-4040_side_slot_support.step
cad/hr-v0/generated/arm-architecture-p0.11-side-web-stop/parts/MV0-C05_shoulder-support-finished-profile.dxf
cad/hr-v0/generated/arm-architecture-p0.11-side-web-stop/parts/MV0-C07_J2-positive-fixed-catch-profile.dxf
cad/hr-v0/generated/arm-architecture-p0.12-access-well-stop/parts/MV0-C01_adapter-finished-profile.dxf
cad/hr-v0/generated/arm-architecture-p0.12-access-well-stop/parts/MV0-C02_20-2040_100mm_vertical_collision_envelope.step
cad/hr-v0/generated/arm-architecture-p0.12-access-well-stop/parts/MV0-C03_20-2040_50mm_vertical_collision_envelope.step
cad/hr-v0/generated/arm-architecture-p0.12-access-well-stop/parts/MV0-C04_H104_to_20-2040_countersunk_adapter.step
cad/hr-v0/generated/arm-architecture-p0.12-access-well-stop/parts/MV0-C04_gripper-adapter-finished-profile.dxf
cad/hr-v0/generated/arm-architecture-p0.12-access-well-stop/parts/MV0-C05_S102_to_40-4040_side_slot_support.step
cad/hr-v0/generated/arm-architecture-p0.12-access-well-stop/parts/MV0-C05_shoulder-support-finished-profile.dxf
cad/hr-v0/generated/arm-architecture-p0.12-access-well-stop/parts/MV0-C07_J2-positive-fixed-catch-profile.dxf
cad/hr-v0/generated/arm-architecture-p0.12-access-well-stop/parts/MV0-C07_J2_positive_fixed_catch_adapter.step
cad/hr-v0/generated/arm-architecture-p0.13-pad-pocket-stop/HR-V0_J2_positive_stop_contact_candidate.step
cad/hr-v0/generated/arm-architecture-p0.13-pad-pocket-stop/parts/MV0-C01_adapter-finished-profile.dxf
cad/hr-v0/generated/arm-architecture-p0.13-pad-pocket-stop/parts/MV0-C02_20-2040_100mm_vertical_collision_envelope.step
cad/hr-v0/generated/arm-architecture-p0.13-pad-pocket-stop/parts/MV0-C03_20-2040_50mm_vertical_collision_envelope.step
cad/hr-v0/generated/arm-architecture-p0.13-pad-pocket-stop/parts/MV0-C04_H104_to_20-2040_countersunk_adapter.step
cad/hr-v0/generated/arm-architecture-p0.13-pad-pocket-stop/parts/MV0-C04_gripper-adapter-finished-profile.dxf
cad/hr-v0/generated/arm-architecture-p0.13-pad-pocket-stop/parts/MV0-C05_S102_to_40-4040_side_slot_support.step
cad/hr-v0/generated/arm-architecture-p0.13-pad-pocket-stop/parts/MV0-C05_shoulder-support-finished-profile.dxf
cad/hr-v0/generated/arm-architecture-p0.13-pad-pocket-stop/parts/MV0-C07_J2-positive-fixed-catch-profile.dxf
cad/hr-v0/generated/arm-architecture-p0.13-pad-pocket-stop/parts/MV0-C07_J2_positive_fixed_catch_adapter.step
cad/hr-v0/generated/arm-architecture-p0.13-pad-pocket-stop/parts/PAD-SR1-1_40x12x0.61_nominal-screen.step
cad/hr-v0/generated/arm-architecture-p0.13-pad-pocket-stop/parts/PAD-SR1-2_40x12x0.61_nominal-screen.step
cad/hr-v0/generated/arm-architecture-p0.8-dwg-integrated/parts/MV0-C01_adapter-finished-profile.dxf
cad/hr-v0/generated/arm-architecture-p0.8-dwg-integrated/parts/MV0-C02_20-2040_100mm_vertical_collision_envelope.step
cad/hr-v0/generated/arm-architecture-p0.8-dwg-integrated/parts/MV0-C03_20-2040_50mm_vertical_collision_envelope.step
cad/hr-v0/generated/arm-architecture-p0.8-dwg-integrated/parts/MV0-C04_H104_to_20-2040_countersunk_adapter.step
cad/hr-v0/generated/arm-architecture-p0.8-dwg-integrated/parts/MV0-C04_gripper-adapter-finished-profile.dxf
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
