amyleesterling/humanoid-robot/hr30/whole-body-p0.1/first-build-cart-p0.1/README.md

# HR-30 first physical-build cart P0.1

PRELIMINARY - HUMAN APPROVAL REQUIRED BEFORE ANY ORDER OR PHYSICAL WORK - NOT APPROVED FOR PROCUREMENT, STRUCTURAL FABRICATION, CONNECTION, POWERED TESTING, MOTION, OR ENERGIZATION

This package creates a small, human-approved first physical tranche from the current whole-body release: one clearance coupon and eleven-part manual G01 fit article, two reusable ROBOTIS bench-interface candidates, eight sample/quote requests, six borrow/contract equipment paths and eight explicit do-not-buy holds. No order or physical work has been executed.
