amyleesterling/humanoid-robot/hr30/whole-body-p0.1/boston-fabrication-route-p0.1/README.md

# HR-30 Boston fabrication route P0.1

PRELIMINARY - UNPOWERED NONSTRUCTURAL FIT-CHECK / RFQ ROUTE ONLY - NOT APPROVED FOR PROCUREMENT, STRUCTURAL FABRICATION, ASSEMBLY, POWERED TESTING, MOTION, OR ENERGIZATION

This package contains one BPL-envelope gripper fit plate, a complete 98-STL makerspace bundle, current Boston-area facility research, and controlled commercial RFQ routing. BPL is currently unavailable; no facility has been contacted and no quote, material, structural part or work authority is released.
