amyleesterling/humanoid-robot/hr30/whole-body-p0.1/joint-hardware-manufacturing-p0.1/README.md

# HR-30 actual-axis joint-hardware manufacturing P0.1

**PRELIMINARY - JOINT-HARDWARE REFINEMENT FILES ONLY - NOT APPROVED FOR PROCUREMENT, FABRICATION, ASSEMBLY, POWERED TESTING, MOTION, OR ENERGIZATION**

All 142 non-actuator joint-hardware candidates on the 25 actual axes are classified. The package exports 64 local-coordinate shaft/carrier refinement STEP/SVG files and 39 carrier DXFs. It intentionally withholds supplier files for 39 catalogue bearing envelopes. The 39 legacy pulley/coupler envelopes are superseded and bound through the successor reconciliation; none is a supplier-upload part, and all successor validation/release gates remain open.

This is editable refinement geometry, not a drawing release or work authority.
