amyleesterling/humanoid-robot/hr30/whole-body-p0.1/assembly-guide-p0.1/README.md

# HR-30 whole-robot assembly guide P0.1

**PRELIMINARY - CONFIGURATION AND PACKAGING CAD ONLY - NOT APPROVED FOR PROCUREMENT, FABRICATION, ASSEMBLY, POWERED TESTING, MOTION, OR ENERGIZATION**

This package converts the complete P0.1 humanoid into twelve dependency-ordered, module-specific unpowered assembly travelers. Open `index.html` for the interactive guide. Browser checkboxes are planning aids only and are not signed evidence.
