amyleesterling/humanoid-robot/hr30/whole-body-p0.1/leg-drivetrain-installation-p0.1/README.md

# HR-30 installed leg drivetrains P0.1

**PRELIMINARY - WHOLE-BODY PRODUCT PACKAGING CANDIDATE ONLY - NOT APPROVED FOR PROCUREMENT, FABRICATION, ASSEMBLY, POWERED TESTING, MOTION, OR ENERGIZATION**

A complete-body derived assembly replaces the ten generic reduced-leg pulley, belt and actuator placeholders with exact candidate product envelopes, exact horns, nominal motor adapters, shouldered output shafts and capture washers on external service planes. This is packaging CAD, not a released structure or capacity result.
