amyleesterling/humanoid-robot/docs/hr-v0-mechanical-manufacturing-review-p0.1.md

# HR-V0 mechanical manufacturing review package P0.1

> **PRELIMINARY - NOT APPROVED FOR PROCUREMENT, FABRICATION, ASSEMBLY, CONNECTION, POWERED TESTING, MOTION, OR ENERGIZATION.**

Identifier: `HR-V0-MECH-MFG-REVIEW-P0.1`  
Round: R215  
Configuration: `HR-V0-ARM-ARCH-P0.8-DWG-INTEGRATED-CANDIDATE`  
Manufacturing identity: `HR-V0-MECH-BOM-BIND-P0.2`

## Outcome

R215 creates one qualified-review-ready front door for the five current custom aluminum candidates. It does not introduce new part geometry. It binds the existing five conventional drawings, five finished DXFs, five exact STEP identities, 26 drawing-explicit controls, 30 unexecuted first-article operations, nine integrated interfaces, six exact fastener candidates on hold, twelve provider DFM questions, and twelve open release holds.

The package corrects a process ambiguity left after R214: a reviewer previously had to discover the manufacturing evidence across several historical packages. The new document-precedence rule makes the drawing/control register, exact STEP, and exact DXF a co-controlled set. No artifact silently overrides another. Any mismatch, portal healing, default substitution, best-fit shift, slotting, filing, or forced alignment is a blocking nonconformance requiring a new controlled revision.

## Permitted action

A qualified mechanical reviewer may inspect the exact files, independently recompute hashes, create controlled redlines, and return the blank decision template tied to an exact Git commit. This is the only action made available by R215.

Provider contact, file upload, quotation, procurement, fabrication, assembly, connection, powered test, motion, and energization remain prohibited without separate written authority. The package records zero provider responses, zero qualified decisions, zero received articles, zero FAI results, and zero physical proof.

## Source freshness

On 2026-08-11, current official 80/20 pages still identified `20-2040`, the `20-7047` two-hole M5 x 0.8 end-tap option, `13035`, `17-8520`, and `40-4040`. The official MISUMI catalog family supports `SCB` M2.5 and A2-70, but the exact live configurator could not be fetched. The exact Accu `SHKL-M5-20-A2-R360` and `HNN-M2.5-A2` pages were not reverified. Those items therefore remain exact candidates on hold, with current availability and received identity explicitly `SELECTION REQUIRED`.

Source freshness does not establish suitability, stock, orderability, received identity, torque, locking, reuse, fit, or proof.

## Controlled artifacts

- [Interactive manufacturing-review guide](../release/hr-v0/mechanical-manufacturing-review-p0.1/index.html)
- `release/hr-v0/mechanical-manufacturing-review-p0.1/part-release-matrix.csv`
- `release/hr-v0/mechanical-manufacturing-review-p0.1/document-precedence.csv`
- `release/hr-v0/mechanical-manufacturing-review-p0.1/interface-fastener-stack.csv`
- `release/hr-v0/mechanical-manufacturing-review-p0.1/fastener-candidate-register.csv`
- `release/hr-v0/mechanical-manufacturing-review-p0.1/qualified-review-checklist.csv`
- `release/hr-v0/mechanical-manufacturing-review-p0.1/qualified-review-decision-template.csv`
- `release/hr-v0/mechanical-manufacturing-review-p0.1/provider-dfm-response-template.csv`
- `release/hr-v0/mechanical-manufacturing-review-p0.1/source-freshness-register.csv`
- `release/hr-v0/mechanical-manufacturing-review-p0.1/source-hash-register.csv`
- `release/hr-v0/mechanical-manufacturing-review-p0.1/open-holds.csv`
- `release/hr-v0/mechanical-manufacturing-review-p0.1/authority-boundary.csv`
- `release/hr-v0/mechanical-manufacturing-review-p0.1/package-status.json`

## Remaining closure

All twelve inherited holds remain open: qualified drawing/GD&T review; provider DFM; exact material/MTR; countersink and received-fastener seating; C05 column/T-slot proof; C04 gripper-interface proof; C06/C07 bumper/contact/load/life proof; all thirty FAI operations; received mass/COM/inertia; unpowered complete-chain fit; structural/static/stop/fatigue proof; and immutable configuration acceptance.

`EG-003`, `EG-005`, and `EG-006` remain partial. Passing the package checker proves repository consistency only. It is not a machining, structural, safety, or energization approval.
