amyleesterling/humanoid-robot/docs/hr-v0-build-site-basis.md

# HR-V0 Boston Build-Site Basis

Status: **PARTIAL INPUT RECORD — NOT AN ENERGIZATION AUTHORIZATION**

Recorded: 2026-08-06

Code-route recheck: 2026-08-08

Superseding site-control supplement: `HR-V0-BOSTON-SITE-P0.2` / R194 / 2026-08-10

Applies to: HR-V0 only

## Frozen program inputs

| Input | Controlled value |
|---|---|
| Build/use region | Boston, Massachusetts, USA |
| Nominal utility basis | 120 VAC, 60 Hz |
| Environment | Indoor bench-mounted experimental machinery |
| Operators | Adults working in a controlled test area |
| Child access | Prohibited during assembly, test, and operation |
| Payload | One controlled soft-foam object; measured mass no more than 100 g; each measured principal dimension 40-70 mm inclusive; exact article and metrology method remain `SELECTION REQUIRED` |
| Strength/cost objective | Low-mass, low-force, cost-conscious demonstrator; no relaxation of proof or safety gates |
| Local fabrication access | A Boston-area library makerspace may have CNC equipment; metal capability, machine model, material permission, training, and tolerance are not yet verified |
| HR-30 program end-state | 762 mm nominal humanoid capable of untethered level-floor walking after the staged validation program |

The 120 VAC/60 Hz entry identifies the nominal regional supply only. It is not evidence that a particular receptacle or branch circuit is suitable.

## Inputs required to close EG-001

R194 converts these narrative inputs into the twenty-row completion form at `configuration/hr-v0-boston-site-p0.2/premises-input-template.csv` and records eight fail-closed holds. This document remains the program-input basis; the R194 package is the current machine-readable site-control record.

The Massachusetts Department of Fire Services current page identifies 527 CMR 12.00 as based on the 2026 edition of NFPA 70, effective 2026-04-24. Boston's current permit page identifies the licensed-contractor application and inspection route for covered electrical installation work. These current routes do not determine applicability to a not-yet-selected home, library, makerspace or workplace test site. The exact site representative and qualified local reviewer must record the site/work-scope determination.

- Exact assembly and test site, responsible site representative, and written permission.
- Receptacle type and condition; measured polarity and equipment-ground continuity.
- Branch-circuit voltage, breaker type/rating, available fault-current basis, and whether GFCI protection is present or required.
- Applicable edition and local adoption/amendments of electrical, fire, building, workplace, and machinery requirements, reviewed by a qualified person.
- Available bench footprint, floor footprint, access clearances, egress, and exclusion-zone boundary.
- Bench construction, anchoring substrate, permitted anchor method, and load rating.
- Ambient temperature, ventilation, dust/moisture exposure, lighting, and housekeeping constraints.
- Emergency response, disconnect accessibility, fire-extinguisher provision, and supervision rules.
- Exact external AC/DC adapters and their listing/marking accepted for the site and application.
- Exact library/makerspace name and machine evidence if any released part will be made there: equipment model, allowed materials and thickness, work envelope, CAM workflow, training, supervision, cost, achievable tolerance, inspection tools, and permission for outside stock.

## Required evidence

The program owner and qualified electrical reviewer must sign a site-input record covering the items above. The reviewer must confirm the applicable code basis and the written staged energization procedure. Until then, energization gate EG-001 remains **partial**.

**PRELIMINARY—NOT APPROVED FOR FABRICATION OR ENERGIZATION.**
