amyleesterling/humanoid-robot/docs/hr-v0-q4x-installation-evidence-p0.1.md

# HR-V0 Q4X installation evidence and receiving package P0.1

> **PRELIMINARY - RECEIVING AND METROLOGY PLAN ONLY - NOT APPROVED FOR PROCUREMENT, FABRICATION, DRILLING, CONNECTION, POWERED TESTING, MOTION, OR ENERGIZATION**

Artifact: **HR-V0-Q4X-INSTALL-EVIDENCE-P0.1**

Round: **R186**

Date: **2026-08-10**

## Outcome

R186 makes the next physical-evidence step executable on paper without releasing a purchase or a hole. LAPP instruction `99990621 / BS00/2622 VS20` applies torque `M = 1.5 N m` to M12 gland installation into a housing or with a locknut and to the cap nut. The VDE certificate updated 2022-10-21 also lists 1.5 N m installation and cap-nut torque, but its separate locknut-torque field is blank. The package preserves that distinction.

No reviewed LAPP record gives a Project Button through-hole diameter or tolerance. The bore, G1/G2 coordinates, rail hardware, modified-enclosure rating and physical work authority therefore remain `SELECTION REQUIRED`.

## What can happen next

Only after a separately signed acquisition decision may the exact ten-line evaluation lot be purchased and received. The ten-step metrology plan then records the enclosure wall map, panel, rail-slot realization, gland/locknut geometry and a dry DIN-device fit. All result fields are blank and `NOT EXECUTED`.

The final bore and drilling drawing require received measurements, calibrated tools, exact cable/sheath evidence and qualified mechanical/electrical review. Catalog torque is an installation input, not proof that a drilled fiberglass enclosure retains any catalog rating.

## Controlled artifacts

- source, installation, lot, metrology, hash and hold registers: `test-equipment/hr-v0/q4x-installation-evidence-p0.1/`;
- blank receiving/metrology form: `tests/forms/hr-v0-q4x-hardware-receiving-template-p0.1.csv`; and
- interactive evidence guide: `release/hr-v0/q4x-installation-evidence-p0.1/index.html`.

## Gate effect

R186 closes no energization gate and no Sol R12 blocker. It reduces an undocumented torque question to a bounded manufacturer/application decision, but all eleven `QIH-*` holds remain open. `EG-025` remains open and `EG-026` remains partial.
