amyleesterling/humanoid-robot/docs/reviews/2026-08-08-boston-fabrication-route-p0.2-independent-review-request.md

# Independent review request - HR-V0 Boston fabrication route P0.2

> **PRELIMINARY - NOT APPROVED FOR QUOTATION, FABRICATION, ASSEMBLY, MOTION, OR ENERGIZATION.**

Review `HR-V0-BOSTON-FAB-ROUTE-P0.2`, `HR-V0-FAB-SRC-P0.5` and the current P0.7 drawings for accuracy, manufacturability and completeness.

Please independently check:

1. Confirm every C01/C04/C05/C06/C07 thickness, hole, profile, countersink, flatness, parallelism, rail-datum, face-step and coplanarity control against the native P0.7 STEP/DXF/drawing sources.
2. Confirm that the earlier 4.75 mm suggestion is incompatible and that 9.525 mm nominal / 9.00..10.00 mm finished is correctly propagated.
3. Recheck current Xometry and Protolabs default/precision capabilities, inspection options and material controls; identify anything that requires manual rather than instant quoting.
4. Recheck SendCutSend's published tolerance, material/temper and M5 countersink behavior. Challenge the finished-part exclusion if current primary evidence proves the exact P0.7 controls can be guaranteed.
5. Determine whether a two-stage oversized-blank route can preserve heat-lot traceability and datums without increasing risk or cost; no such route is currently released.
6. Confirm Artisans Asylum's exact machine, access/training, material, workholding, CAM, metrology and accepted-job limits before assigning any role beyond capability inquiry.
7. Review the twelve capability/DFM questions and identify any missing quality, nonconformance, fixture, inspection, traceability, export-control, commercial or first-article term.
8. Confirm that no current file can be mistaken for an upload, quote request, purchase order or first-article authorization.
9. Identify which drawing/material/stop issues a qualified mechanical reviewer must close before an inquiry can responsibly be sent.
10. State separately whether the package is ready for capability inquiry, quotation, first article, fabrication and energization. Do not collapse those decisions.

Return BLOCKER / MAJOR / MINOR findings with exact part/control/file references, re-derived units, primary-source URLs and evidence needed to close. Do not approve quotation, fabrication, motion or energization.
