amyleesterling/humanoid-robot/test-fixtures/hr-v0-p121-no-load-fixture-p0.1/README.md

# HR-V0 P1.21 no-load fixture P0.1

**PRELIMINARY - NOT APPROVED FOR PROCUREMENT, FABRICATION, ASSEMBLY, CONNECTION, POWERED TESTING, MOTION, OR ENERGIZATION**

This package provides the missing control-only fixture artifact for the P1.21 A1-gating evidence plan: a five-sheet native KiCad project, 42-row point-to-point schedule, physical planning layout, all 15 required signal bindings, all 18 unexecuted test bindings, explicit physical-absence checks and candidate BOM. It does not close AUTH-004 because independent checking and release acceptance remain open. AUTH-001 through AUTH-010 still prohibit connection and powered work.
