amyleesterling/humanoid-robot/tests/hr-v0-carrier-fit-evidence-capture-p0.1/README.md

# HR-V0-CARRIER-FIT-EVID-CAP-P0.1

> **PRELIMINARY - NOT APPROVED FOR PROCUREMENT, FABRICATION, MARKING, DRILLING, ASSEMBLY, CONNECTION, POWERED TESTING, MOTION, OR ENERGIZATION**

R265 is a blank local-only raw evidence capture surface. It authorizes no session or physical work and computes no acceptance.
