amyleesterling/humanoid-robot/docs/reviews/2026-08-10-r206-validation-record.md

# R206 validation record

**PRELIMINARY - NOT APPROVED FOR PROCUREMENT, FABRICATION, ASSEMBLY, CONNECTION, POWERED TESTING, MOTION, OR ENERGIZATION**

R206 issues nonselected Electrical `V3-P1.16-OBSERVATION-CANDIDATE` and `HR-V0-OBSERVATION-FIELD-HARNESS-P0.1`. The first P1.16 generation exposed a hierarchy/export defect: page 13 existed as a child file and schedule input but was absent from the root hierarchy, ERC sheet list and exports. The generator now allocates thirteen hierarchy blocks, and a dedicated checker fails if page 13 disappears from any native evidence surface.

The corrected native project contains root plus thirteen child sheets, 81 component blocks and 332 modeled terminals. KiCad 10.0.5 ERC reports 0 errors / 0 warnings and explicitly parses `/13 Runtime diagnostic observation interfaces/`. This proves modeled connectivity and annotation only.

The field-harness package source-matches W9007-W9011, records five exact Belden 3051 color/order-code candidates and records current Phoenix conductor/strip/torque envelopes. The 263.1 mm rounded-centerline result is a geometry screen only. Every cut length remains `SELECTION REQUIRED`; all twelve selection holds and twelve acceptance rows remain open.

## Repository validation

- Ordinary fail-closed repository checker sweep: 148/148 passed.
- KiCad 10.0.5 `pcbnew` checker sweep: 15/15 passed.
- Supervisor tests: 67/67 passed.
- Watchdog model/compiled-C tests: 11/11 passed.
- Host-deployment tests: 16/16 passed while correctly reporting `ready: false` and `motion_authority: NONE` with 36 holds.
- Energization-gate audit through E6: 30 applicable, 0 closed, 23 partial and 7 open. `--require-ready` correctly exited 2.
- Desktop browser QA at 1280 px passed: 16 px body text, readable warning, four metric cards, wiring diagram and horizontally scrollable schedules without page-level overflow.
- Narrow browser QA at 390 x 844 passed: 16 px body text, 32 px heading, 339 px reflowed cards/warning, no page-level horizontal overflow and deliberate table-local scrolling (335 px viewport / 880 px content).

The non-ready gate result is the required fail-closed outcome. No passing source check closes a physical, functional-safety, qualified-review or work-authorization gate.
