amyleesterling/humanoid-robot/docs/reviews/2026-08-11-r217-validation-record.md

# R217 validation record

> **PRELIMINARY - NOT APPROVED FOR PROCUREMENT, FABRICATION, ASSEMBLY, CONNECTION, POWERED TESTING, MOTION, OR ENERGIZATION.**

Identifier: `HR-V0-BOSTON-FAB-ROUTE-P0.4`

## Repository checks

- Five current P0.8/R215/R173 configuration inputs are SHA-256 bound.
- Six routes are classified as local commercial, online commercial/network, self-fabrication/training or excluded.
- Ten current official provider/resource records carry explicit capability-only claim boundaries.
- Ten fabrication inputs preserve the R173 payload/motion correction while retaining every unresolved load, duty, material, inspection and authority hold.
- Nine capability-inquiry questions remain `NOT SENT / NO RESPONSE`.
- The authorization template permits no files and remains `NOT AUTHORIZED`.
- No provider is selected, contacted, quoted or supplied files.
- Every procurement, fabrication, assembly, connection, powered-test, motion and energization flag remains false.

## Validation state

- Dedicated package checker: PASS (five bound current inputs, six routes, ten official sources, ten unresolved inputs and nine unsent capability questions; all authority flags false).
- Pre-stage standard repository sweep: 158/159 PASS. The sole expected failure was the release-manifest checker rejecting the sixteen new, still-untracked R217 files before staging.
- Native KiCad checker sweep under KiCad 10 Python: 18/18 PASS.
- Firmware source validation: 78 executable unit tests PASS. Target flash, received-hardware execution and HIL were not performed.
- Interactive desktop QA at 1280 x 900: body/control text 16 px minimum, secondary text 14 px minimum, six route cards, no horizontal overflow and the preliminary warning present.
- Route filters: Boston-area 3, online 2, excluded 1 and all routes 6; every returned provider/resource matched its route class.
- Interactive mobile QA at 390 x 844: body/control text 16 px minimum, secondary text 14 px minimum, 335 px single-column cards, no horizontal overflow and the preliminary warning present.
- Final synchronized standard sweep, release-manifest count and clean-commit verification are recorded below after staging.

## Final synchronized state

- Final standard repository sweep: 159/159 PASS.
- Release manifest regenerated with 4,078 package files.
- Dedicated package checker, native KiCad sweep, firmware validation and `git diff --check`: PASS.
- Clean-commit and remote-identity verification are recorded in the commit/PR handoff after publication.

Passing checks establish repository identity, provenance, state and presentation consistency only. They do not establish provider acceptance, machinability, material traceability, physical part conformance, structural adequacy, functional safety or work authority.
