amyleesterling/humanoid-robot/docs/reviews/2026-08-11-r219-validation-record.md

# R219 validation record

> **PRELIMINARY - NOT APPROVED FOR PROCUREMENT, FABRICATION, ASSEMBLY, CONNECTION, POWERED TESTING, MOTION, OR ENERGIZATION.**

Identifier: `HR-V0-FS-REVIEW-ROUTE-P0.1`

## Controlled checks

- Eight current review inputs are SHA-256 bound, including the P1.15 core and P1.17 observation-view project identities.
- Four official capability leads are recorded without provider selection, endorsement or project-acceptance claims.
- Twelve competence and independence criteria remain unaccepted and require evidence from named people.
- Ten scope records cover pre-design, pre-E2 and pre-E4 work; none is accepted or executed.
- Ten capability questions remain `NOT SENT`; the authorization form permits no file transmission or quote request.
- Thirteen reviewer-declaration fields remain `NOT EXECUTED` and `NOT ACCEPTED`.
- Sixteen required deliverables remain unreceived, unbound, unaccepted and unsigned.
- All provider, file-transfer, quotation, contract, PLr/SIL, validation, approval and energization flags remain false.

## Validation state

- Dedicated package checker: PASS.
- Correct-runtime pre-stage standard repository sweep: 160/161 PASS. The sole expected failure was the release-manifest checker rejecting the eighteen new, still-untracked R219 files before staging.
- Native KiCad checker sweep under KiCad 10 Python: 18/18 PASS. No ECAD source changed in R219.
- Firmware source validation: supervisor 67/67 and watchdog 11/11, total 78/78 PASS. Target flash, received-hardware execution and HIL were not performed.
- Interactive desktop QA at 1280 x 720: 16 px body/control text, 14 px metadata, four cards, warning present and no horizontal overflow.
- The `Local MA office` filter returned only TÜV SÜD America; the all-routes view returned four cards.
- Visual inspection confirmed readable dark-blue/sky-blue/gold presentation and explicit unresolved-provider language.
- Final synchronized standard sweep and release-manifest count are recorded below after staging.

## Final synchronized state

- Final standard repository sweep: 161/161 PASS.
- Release manifest regenerated with 4,114 package files.
- Dedicated package checker, native KiCad sweep, firmware validation and `git diff --check`: PASS.

Passing source checks establish provenance, scope, fail-closed state and presentation consistency only. They do not establish provider competence for this project, reviewer independence, project acceptance, PLr/SIL, achieved safety performance, physical validation, functional-safety approval or permission to perform powered work.
