amyleesterling/humanoid-robot/docs/reviews/2026-08-11-r221-validation-record.md

# R221 validation record

**PRELIMINARY - NOT APPROVED FOR PROCUREMENT, FABRICATION, ASSEMBLY, CONNECTION, POWERED TESTING, MOTION, OR ENERGIZATION**

Date: 2026-08-11

Artifact: `HR-V0-PANEL-COND-P0.1`

## Digital checks

- current input contains exactly 66 unique panel endpoint records;
- 56 fixed internal endpoints carry only a Belden 3057 16 AWG family/gauge candidate;
- ten `S0/S1/S2/H1` door-loom endpoints remain without a conductor candidate;
- every exact color/order code, cut length, listed-end termination, opposite endpoint, opposite-end termination and route remains `SELECTION REQUIRED`;
- 22 AWG is explicitly rejected at Schneider `LC1D25BD` control terminals;
- 16 AWG ferrules are explicitly rejected at Phoenix `1751248` watchdog-board terminals;
- voltage drop and `F24` coordination remain not calculated / not selected;
- all twelve closure holds are open; and
- no procurement, fabrication, assembly, connection, powered-test, motion or energization authority is present.

## Validation results

- dedicated R221 conductor-basis checker: PASS;
- standard repository checks: 163/163 PASS;
- native KiCad checks under KiCad 10 Python: 18/18 PASS;
- executable firmware tests: 78/78 PASS;
- controlled release manifest: 4,150 package files, PASS;
- staged-diff whitespace check: PASS after correction; and
- responsive browser-layout inspection: NOT EXECUTED because the controlled in-app browser rejected the local `file:` URL under its URL policy. This is an open evidence item, not a pass.

These are digital consistency checks, not physical or safety validation. No physical wire sample, terminal preparation, ferrule/crimp, pull, temperature-rise, fault-current, voltage-drop, routing, door-flex, EMC or protection-coordination test has been executed.
