amyleesterling/humanoid-robot/docs/reviews/2026-08-11-r222-validation-record.md

# R222 validation record

**PRELIMINARY - NOT APPROVED FOR PROCUREMENT, FABRICATION, ASSEMBLY, CONNECTION, POWERED TESTING, MOTION, OR ENERGIZATION**

Date: 2026-08-11

Artifacts: `HR-V0-PANEL-P2P-P0.1`; `V3-P1.18-PANEL-TOPOLOGY-CANDIDATE`

## Digital checks

- 55 physical conductor candidates have two populated ends;
- all 66 unique R221 endpoint labels are mapped exactly once;
- `XD24`, `XD0`, `XN1`, `XN2`, and `XN3` are explicit component blocks in native ECAD;
- node order codes, modeled positions and net allocations match the controlled topology register;
- the P1.18 hierarchy parses as 13 pages with 84 component blocks and 340 modeled terminals;
- native KiCad 10.0.5 ERC reports 0 errors and 0 warnings;
- 45 fixed-internal conductors carry only the R221 family/gauge candidate;
- ten door conductors remain without a dynamic-flex candidate;
- every exact color/order code, length, route and end preparation remains unselected;
- all ten closure holds remain open; and
- every work-authority flag remains false.

## Validation results

- dedicated R222 topology checker: PASS;
- pre-stage standard repository checker sweep: 163/164 PASS; the sole expected failure was the manifest check rejecting new untracked R222 files;
- final staged standard repository checker sweep: 164/164 PASS;
- native KiCad checker sweep under KiCad 10 Python: 18/18 PASS;
- executable firmware tests: supervisor 67/67 and watchdog 11/11, total 78/78 PASS;
- controlled release manifest: 4,218 package files, PASS;
- staged-diff whitespace check: PASS; and
- responsive browser-layout inspection: NOT EXECUTED. The prior controlled browser route rejected local `file:` URLs; this remains an open visual evidence item unless a deployed review URL is inspected.

These are digital consistency checks, not physical or safety validation. No conductor has been selected completely, cut, terminated, installed, inspected or tested. No distribution block, terminal, cover or marker has been received. No fault, thermal, separation, stopping or functional-safety evidence has been executed.
