amyleesterling/humanoid-robot/docs/reviews/2026-08-11-r229-validation-record.md

# R229 validation record

> **PRELIMINARY - NOT APPROVED FOR PROCUREMENT, FABRICATION, ASSEMBLY, CONNECTION, POWERED TESTING, MOTION, OR ENERGIZATION**

- Date: 2026-08-11
- Artifact: `HR-V0-P118-DISPOSITION-P0.1`

## Configuration results

- 13 P1.15/P1.18 native sheet pairs are SHA-256 bound.
- Nine child sheets are identical after narrow administrative normalization.
- Sheets 01-03 contain the five explicit topology-node additions; the root contains index narrative only.
- All 77 original BOM rows and 308 original terminal/net rows are identical.
- Five components and 32 terminal rows are added; none are removed.
- All 106 named nets remain; 101 have identical membership and five gain only node terminals.
- All 269 semantic wire-table rows remain, with 32 node-terminal rows added.
- All 63 unresolved records remain identical by sheet/reference.
- Eight logic invariants retain zero new safety credit.
- Seven holds remain open; all independent/qualified decision and work-authority fields remain blank or false.
- P1.15 remains current; P1.18 remains unaccepted.

## Repository and visual validation

- focused R229 checker: **PASS**;
- native KiCad/pcbnew checker sweep: **18 / 18 PASS**;
- pre-manifest standard repository checker sweep: **171 / 172 PASS**; every nonmanifest checker passed and the only failure was the expected untracked/stale-manifest gate;
- final staged standard repository checker sweep: **172 / 172 PASS**;
- supervisor firmware tests: **67 / 67 PASS**;
- watchdog firmware tests: **11 / 11 PASS**;
- desktop browser QA at 1280 x 720: **PASS**; no body overflow, 16 px body text, 14 px code text, thirteen sheet cards and exact 106/101/5 net filters; both tables fit 1,225 px containers;
- mobile browser QA at requested 390 x 844: **PASS**; 375 CSS-pixel document width, no body overflow, 16 px body text, 14 px code text, 339 px cards and both tables contained in 335 px horizontal-scroll regions;
- staged deterministic release manifest: **PASS with 4,440 controlled package files**;
- independent electrical and functional-safety review: **OPEN**.

The bounded semantic delta does not prove terminal application, protection, installed construction, fault behavior, stopping performance, functional safety or permission to perform work.
