amyleesterling/humanoid-robot/docs/reviews/2026-08-11-r231-validation-record.md

# R231 validation record

> **PRELIMINARY - NOT APPROVED FOR PROCUREMENT, FABRICATION, ASSEMBLY, CONNECTION, POWERED TESTING, MOTION, OR ENERGIZATION**

- Date: 2026-08-11
- Artifact: `HR-V0-SOL-R12-STATUS-R231`

## Evidence results

- The complete archived Sol R12 review remains unchanged at 18 BLOCKER, 30 MAJOR and 8 MINOR findings.
- The R231 register contains every blocker ID from B-001 through B-018 exactly once.
- Current dispositions total 12 `PARTIALLY_ADDRESSED_OPEN`, one `OPEN_BLOCKER` and five `OPEN_HR30_BLOCKER`.
- Qualified-closure count remains zero.
- The focused R231 checker passes 18/18 records.
- Desktop browser QA passes at 1,265 CSS pixels: 18 rows, no body overflow, 16 px body text and 14 px badges/code.
- Mobile browser QA passes at requested 390 x 844: 375 CSS-pixel document width, no body overflow, 16 px body text, and the 343 px table viewport contains deliberate local scrolling.
- The HR-30 filter exposes exactly five rows.
- Standard repository checker sweep: **174 / 174 PASS**.
- Native KiCad/pcbnew checker sweep: **18 / 18 PASS**.
- Supervisor firmware source tests: **67 / 67 PASS**.
- Watchdog reference-model and compiled-C differential tests: **11 / 11 PASS**.
- Final staged deterministic release manifest: **PASS with 4,518 controlled package files**.

## Boundary

R231 is a project-owned reconciliation of an existing independent review. It is not new independent evidence, qualified review, physical validation or permission to perform work. Source and configuration improvements cannot close a finding whose acceptance requires received parts, installed construction, calibrated measurement, fault injection, stopping performance, functional-safety calculation or signed qualified disposition.
