amyleesterling/humanoid-robot/docs/reviews/2026-08-11-r238-validation-record.md

# R238 validation record

> **PRELIMINARY - NOT APPROVED FOR PROCUREMENT, FABRICATION, ASSEMBLY, CONNECTION, POWERED TESTING, MOTION, OR ENERGIZATION**

Date: 2026-08-11  
Package: `HR-V0-P121-CONSOLIDATED-REVIEW-P0.1`

## Executed checks

- Consolidated-package generator: PASS.
- Dedicated R238 structural checker: PASS.
- Source lineage: P1.21 imports P1.20; P1.20 imports P1.19: PASS.
- Native sheet count: 13: PASS.
- P1.19-to-P1.21 keyed terminal delta: 6: PASS.
- P1.21 ERC record: 0 errors / 0 warnings: PASS, connectivity and annotation only.
- Pre-manifest standard repository checker sweep: 180/181 PASS; the only failure was the expected release-manifest rejection of the new untracked R238 files.
- Native KiCad `pcbnew` checker sweep under KiCad 10.0.5 Python: 18/18 PASS. R238 changes no board source.
- Interactive browser QA at 1280 x 720: PASS. The header, warning, status cards and selected page 3 rendered without body overflow; the selector changed the drawing to the ARM/watchdog sheet; the SVG loaded at 2245 px natural width; minimum functional text was 14 CSS px and body copy remained 16 px or larger. Responsive CSS is present; a separate narrow viewport was not executed.
- Final staged standard repository checker sweep: 181/181 PASS using the controlled Python/CadQuery environment.
- Deterministic release manifest: 4,824 package files; manifest checker PASS before commit.

## Boundary

P1.15 remains current. P1.21 remains unaccepted. No independent or qualified review, manufacturer response, physical test result, functional-safety approval or work authorization is created by these checks.
