amyleesterling/humanoid-robot/docs/reviews/2026-08-11-r239-validation-record.md

# R239 validation record

> **PRELIMINARY - NOT APPROVED FOR PROCUREMENT, FABRICATION, ASSEMBLY, CONNECTION, POWERED TESTING, MOTION, OR ENERGIZATION**

Date: 2026-08-11  
Package: `HR-V0-P121-VISUAL-REVIEW-P0.1`

## Executed evidence

- Dedicated R239 generator/checker: PASS.
- Page coverage: 13/13.
- Fresh complete-sheet browser inspection: pages 2 and 3, PASS.
- Inherited R230/R238 layout basis: pages 0, 1 and 4-12, hash-bound.
- Project visual findings: 0.
- Closed project-owned hold: `P121C-H01` only.
- Remaining holds: 10 OPEN.
- Pre-manifest standard repository checker sweep: 181/182 PASS; only the expected manifest rejection of new untracked R239 files failed.
- Native KiCad `pcbnew` checker sweep: 18/18 PASS; R239 changes no ECAD source.
- Interactive guide browser QA at 1280 x 720: PASS; both SVGs loaded, thirteen table rows rendered, body width stayed within the viewport and minimum functional text was 14 CSS px.
- Final staged standard repository checker sweep: 182/182 PASS using the controlled Python/CadQuery environment.
- Deterministic release manifest: 4,844 package files; manifest checker PASS before commit.

## Boundary

The inspection is project-owned and visual. It does not prove electrical correctness, physical suitability, functional-safety performance or work authorization. P1.15 remains current and P1.21 remains unaccepted.
