amyleesterling/humanoid-robot/docs/reviews/2026-08-11-r251-validation-record.md

# R251 validation record

> **PRELIMINARY - NOT APPROVED FOR PROCUREMENT, FABRICATION, ASSEMBLY, CONNECTION, POWERED TESTING, MOTION, OR ENERGIZATION**

R251 validates the fail-closed first-shop-session contract: six exact articles, ten purchase gates, eight unsent supplier questions, eighteen unpowered operations, eight hold points, six instruments, twenty HSI rows, seven roles, nine evidence locations, ten stop-work conditions, twelve open holds and ten unexecuted acceptance rows. Nothing was purchased, received, assembled, connected, powered, moved or accepted.

Executed results:

- dedicated R251 checker: **PASS**;
- standard repository sweep: **194/194 PASS**;
- native KiCad regression: **18/18 PASS**;
- release manifest: **5,506 package files before this validation record; regenerated afterward**;
- desktop browser QA at 1265 px viewport: both guides render with 16 px body text and 14 px minimum technical text, zero page-level horizontal overflow, exact preliminary/status warnings, 18 tables, 18 downloads and 361 data rows in total; first views are readable and nonoverlapping; and
- mobile visual execution: **NOT COMPLETED**.

Browser QA initially detected a real encoding defect: the generator wrote HTML with the Windows default encoding while declaring UTF-8. The generator now emits UTF-8 explicitly and uses an HTML entity for the status separators; the corrected status renders as `PURCHASE BLOCKED · SESSION NOT AUTHORIZED · NO ASSEMBLY OR POWER · ALL RESULTS BLANK`.

These checks validate package structure, binding, blank-state controls and presentation only. They do not answer the supplier questions, authorize purchase or shop work, establish instrument capability, generate physical measurements, select a hard-stop topology, release buildable mechanical drawings, or establish any safety function or energization authority.
