amyleesterling/humanoid-robot/docs/reviews/2026-08-11-r254-validation-record.md

# R254 validation record

> **PRELIMINARY - NOT APPROVED FOR PROCUREMENT, FABRICATION, ASSEMBLY, CONNECTION, POWERED TESTING, MOTION, OR ENERGIZATION**

R254 validates the generated execution contract and configuration consistency only. It does not validate a measurement method, fixture, article, purchase, assembly or physical result.

## Generated-package checks

- dedicated R254 checker: **PASS**;
- task-specific methods: **5**, all `NOT EXECUTED`;
- HSI routes: **20/20**, all open;
- uncertainty inputs: **40**, all blank and `SELECTION REQUIRED`;
- phase gates: **5**, all `NOT AUTHORIZED` and `NOT EXECUTED`;
- operations: **22**, all authorization `NONE` and `NOT EXECUTED`;
- hold points: **12 OPEN**;
- acceptance rows: **12 OPEN / NOT EXECUTED**;
- P0.2 applicability: two `NOT APPLICABLE`, one conditional support candidate, one conditional fixed-datum candidate and one `NOT ACCEPTABLE AS SOLE FIXTURE`; all use authority `NO`;
- configuration P0.18: **37 current records, 27 supersession records, 82 open holds and 115 open/unexecuted acceptance rows**; and
- package status: zero articles received, operations executed or authorizations granted.

- standard repository checker sweep under the project CadQuery runtime: **197/197 PASS**;
- native KiCad regression under KiCad 10.0: **18/18 PASS**;
- staged release-candidate manifest: **5,675 package files; PASS before commit**; and
- `git diff --check`: **PASS**.

## Browser QA

At the default 1280 px viewport, the interactive P0.2 guide renders with 16 px body text, 14 px technical-table text, zero page-level horizontal overflow, seven tables and 109 data rows. The six method-filter buttons are present; selecting `JSM2-M03` uniquely activates that filter and leaves only its 15 applicable rows visible. Browser console warning/error count is zero.

At a 390 x 844 px mobile viewport, body text remains 16 px, technical-table text remains 14 px, page-level width remains inside the viewport, and wide tables use their own horizontal scrollers rather than shrinking text. The temporary viewport override was reset after QA.

## Interpretation boundary

The R84 overall measurement-capability values remain provisional screens. Because calibration, resolution, repeatability, fixture, datum, environmental, model-fit and processing inputs are blank, no uncertainty result is claimed. The P0.2 constraint-rank result remains valid as a nominal mathematical fact, but it does not demonstrate suitability for any of the five measurement methods.

No Sol blocker, build gate, qualified-review gate, functional-safety claim or energization prerequisite closes through R254.
