amyleesterling/humanoid-robot/docs/reviews/2026-08-11-r255-validation-record.md

# R255 validation record

> **PRELIMINARY - NOT APPROVED FOR PROCUREMENT, FABRICATION, ASSEMBLY, CONNECTION, POWERED TESTING, MOTION, OR ENERGIZATION**

R255 validates controlled inquiry artifacts only. It does not validate a supplier response, quote, provider capability, method, purchase or work event.

## Generated-package checks

- dedicated R255 checker: **PASS**;
- inquiry routes: **5**, all not authorized/not contacted;
- ROBOTIS questions: **12**, all unsent/not received;
- metrology questions: **32 unique / 96 provider-attributed rows**, all unsent/not received;
- recipient-specific response templates: **5**, containing 8, 4, 32, 32 and 32 blank rows;
- method bid rows: **15**, all not received/not dispositioned;
- returned-evidence rows: **18**, all not received;
- decision gates: **15 OPEN**;
- workflow steps: **14**, all authorization `NONE` and `NOT EXECUTED`;
- acceptance rows: **15 OPEN / NOT EXECUTED**;
- transmittals: **5**, with sender/reply identity `SELECTION REQUIRED`, send authorization `NOT AUTHORIZED` and sent state `NOT SENT`;
- configuration P0.19: **38 current records, 30 supersession records, 97 open holds and 130 blank/unexecuted acceptance rows**; and
- package status: zero transmissions authorized, messages sent, responses received, providers selected, purchases, shipments, work events or articles.

- standard repository checker sweep under the project CadQuery runtime: **198/198 PASS**;
- native KiCad regression under KiCad 10.0: **18/18 PASS**;
- staged release-candidate manifest: **5,748 package files; PASS before commit**; and
- `git diff --check`: **PASS**.

## Browser QA

At the default 1280 px viewport, the interactive inquiry guide renders with 16 px body text, 14 px technical-table text, zero page-level horizontal overflow, eight tables and 180 data rows. Six filter buttons are present. Selecting `R255-RT-04` uniquely activates that provider and leaves its 39 attributable rows visible. Browser console warning/error count is zero.

At a 390 x 844 px mobile viewport, body text remains 16 px, technical-table text remains 14 px, page-level width remains inside the viewport, and each wide table retains a horizontal scroller. The temporary viewport override was reset after QA.

## Interpretation boundary

Official contact/service pages establish only current routes and published capability claims. They do not establish exact availability, price, method suitability, uncertainty, accredited result scope or application approval. Those facts remain unverified until attributable evidence is returned and qualified reviewers accept it.

No Sol blocker, build gate, qualified-review gate, functional-safety claim or energization prerequisite closes through R255.
