amyleesterling/humanoid-robot/docs/reviews/2026-08-12-r257-validation-record.md

# R257 validation record

> **PRELIMINARY - NOT APPROVED FOR PROCUREMENT, FABRICATION, ASSEMBLY, CONNECTION, POWERED TESTING, MOTION, OR ENERGIZATION**

R257 validates an unsent exact-feature inquiry package only. It does not validate any provider, bid, method, measurement, purchase or work event.

## Generated-package checks

- dedicated R257 checker: **PASS**;
- inquiry routes: **5**, all not authorized/not contacted;
- controlled attachments: **14**, all current and hash-bound;
- R256 source features: **79**;
- R256 measurement characteristics: **18**;
- ROBOTIS questions: **12**, all unsent/not received;
- metrology questions: **33 unique / 99 provider-attributed rows**, all unsent/not received;
- method bid rows: **15**, all not received/not dispositioned;
- characteristic bid rows: **54**, all blank/not received/not dispositioned;
- recipient-isolated response templates: **8**, containing 8, 4, 33, 33, 33, 18, 18 and 18 rows;
- returned-evidence rows: **20**, all not received;
- decision gates: **16 OPEN**;
- workflow steps: **15**, all authorization `NONE` and `NOT EXECUTED`;
- acceptance rows: **16 OPEN / NOT EXECUTED**;
- configuration P0.21: **40 current records, 33 supersession records, 125 open holds and 158 blank/unexecuted acceptance rows**; and
- package status: zero transmissions, responses, providers, purchases, shipments, work events, articles or physical results.

- standard repository checker sweep under the project CadQuery runtime: **200/200 PASS**;
- native KiCad/`pcbnew` checker sweep under KiCad 10.0: **18/18 PASS**; R257 changes no ECAD source;
- staged release-candidate manifest: **5,886 package files; PASS before commit**; and
- `git diff --check`: **PASS**.

## Browser QA

At the default 1280 px viewport, the interactive guide renders with 16 px body text, 14 px technical-table text, no page-level horizontal overflow, ten sections, seven tables and 223 data rows. Six route-filter buttons are present. Selecting `R257-RT-04` uniquely activates that provider, leaves 57 attributable rows visible and exposes zero rows belonging to another provider. Browser console warning/error count is zero.

At a 390 x 844 px mobile viewport, body text remains 16 px, technical-table text remains 14 px and page-level width stays inside the viewport. All seven wide tables retain independent horizontal scrollers. The temporary viewport override was reset after QA.

## Interpretation boundary

The exact files make quotation scope reproducible. They do not provide a received-feature match, accepted measurement method, numeric uncertainty, acceptance limit, assembly instruction or work authority.

No Sol R12 blocker, build gate, qualified-review gate, functional-safety claim or energization prerequisite closes through R257.
