amyleesterling/humanoid-robot/docs/reviews/2026-08-12-r258-validation-record.md

# R258 validation record

> **PRELIMINARY - NOT APPROVED FOR PROCUREMENT, FABRICATION, ASSEMBLY, CONNECTION, POWERED TESTING, MOTION, OR ENERGIZATION**

R258 validates deterministic archive construction and isolation only. It does not validate external-transmission rights, any recipient, response, provider, purchase or work event.

## Generated-package checks

- dedicated R258 checker: **PASS**;
- deterministic recipient archives: **5/5 reproduced byte-for-byte**;
- archive control: sorted members, fixed timestamps, CRC verification and internal SHA-256 manifests;
- route isolation: **PASS**;
- ROBOTIS sales/technical question separation: **PASS**;
- ROBOTIS metrology-content exclusion: **PASS**;
- metrology bundle contents: **14 scope attachments + 33 questions + five method rows + 18 characteristic rows each**;
- decision gates: **11 OPEN**, including vendor-CAD redistribution authority;
- transmission-event rows: **5 NOT SENT**, all event fields blank;
- acceptance rows: **11 OPEN / NOT EXECUTED**;
- configuration P0.22: **41 current records, 34 supersession records, 136 open holds and 169 blank/unexecuted acceptance rows**; and
- package status: zero transmissions authorized, messages sent, responses, providers, purchases, articles, work events or physical results.

- standard repository checker sweep under the project runtime: **201/201 PASS**;
- native KiCad/`pcbnew` checker sweep under KiCad 10.0: **18/18 PASS**; R258 changes no ECAD source;
- staged release-candidate manifest: **5,943 package files; PASS**; and
- `git diff --check`: **PASS**.

## Browser QA

At a 1280 x 900 px desktop viewport, the guide renders with 16 px body text, 14 px technical-table text, no page-level horizontal overflow, five recipient cards, two tables, 16 data rows and five distinct ZIP links. Both table wrappers retain `overflow-x: auto`. The five visible archives and hashes match the generated register.

At a 390 x 844 px mobile viewport, body text remains 16 px, technical-table text remains 14 px and page-level width stays inside the viewport. Both wide tables own their horizontal overflow: the 311 px wrappers contain 980 px and 1,141 px tables. Captured console warning/error count is zero. The temporary viewport override was reset and the QA tab closed after inspection.

## Interpretation boundary

No Sol R12 blocker, build gate, qualified-review gate, functional-safety claim or energization prerequisite closes through R258.
