amyleesterling/humanoid-robot/docs/reviews/2026-08-12-r259-validation-record.md

# R259 validation record

> **PRELIMINARY - NOT APPROVED FOR PROCUREMENT, FABRICATION, ASSEMBLY, CONNECTION, POWERED TESTING, MOTION, OR ENERGIZATION**

R259 validates observation-assembly BOM coverage and current configuration metadata only. It does not validate a fabricated article, installed harness, mounting stack, physical fit, electrical performance, functional safety or work authority.

## Generated-package checks

- dedicated R259 checker: **PASS**;
- system BOM / closure parity: **108/108 identifiers and classifications**;
- new observation groups: **10 (`BOM-099..108`)**;
- assembly register: **4 rows**;
- mounting-interface register: **2 rows**, both `SELECTION REQUIRED` / `DESIGN REQUIRED`;
- conductor-candidate register: **11 exact color/spool candidates**, with cut and purchase quantities unresolved;
- selection holds: **8 OPEN / DESIGN REQUIRED / SELECTION REQUIRED / NOT EXECUTED**;
- acceptance rows: **10 blank/unexecuted**;
- configuration P0.23: **42 current records, 35 supersession records, 28 BOM-integration records, 11 gate records, 144 open holds and 179 blank/unexecuted acceptance rows**; and
- package status: zero physical articles, tests, qualified approvals or procurement/fabrication/assembly/connection/powered-test/motion/energization authority.

- standard-runtime repository checker sweep before manifest freeze: **201/201 PASS**;
- native KiCad/`pcbnew` checker sweep under KiCad 10.0.5 Python: **18/18 PASS**; R259 changes no ECAD source; and
- `git diff --check`: **PASS**.

- staged release-candidate manifest: **5,994 package files; PASS**; and
- final standard-runtime sweep including the staged manifest checker: **202/202 PASS**.

## Browser QA

At a 1280 x 900 px desktop viewport, the guide renders with 16 px body text, 14 px technical-table text, no page-level horizontal overflow, four summary cards, four tables, 24 data rows and five controlled-record links. All four table wrappers retain `overflow-x: auto`.

At a 390 x 844 px mobile viewport, body text remains 16 px and table text remains 14 px. The page has no page-level horizontal overflow; each 311 px table wrapper owns its 980 px table overflow. The preliminary warning is visible at both the top and bottom. Captured console warning/error count is zero. The temporary viewport override was reset and the QA tabs were closed after inspection.

## Interpretation boundary

HOLD-15 remains open. No Sol R12 blocker, build gate, qualified-review gate, functional-safety claim or energization prerequisite closes through R259.
