amyleesterling/humanoid-robot/docs/reviews/2026-08-12-r262-validation-record.md

# R262 validation record

> **PRELIMINARY - NOT APPROVED FOR PROCUREMENT, FABRICATION, ASSEMBLY, CONNECTION, POWERED TESTING, MOTION, OR ENERGIZATION**

Generated correction: `HR-V0-U2D2-JC1-HARNESS-RFQ-P0.1`.

Controlled scope:

- eight current primary-source records;
- three manufacturing-route dispositions;
- twelve exact provider requirement rows;
- eighteen provider questions, all `UNSENT`;
- twelve blank response-evaluation rows;
- one deterministic UNSENT ZIP with internal manifest and fail-closed control JSON;
- ten open holds and twelve blank acceptance rows;
- unchanged 108-group system BOM with R262 boundaries on BOM-054/055/061; and
- configuration P0.26 with 45 current records, 38 supersessions, 29 BOM integrations, 11 gates, 175 holds and 216 blank acceptances.

## Executed validation

- dedicated R262 checker: **PASS**;
- standard-runtime repository checker sweep: **205/205 PASS**;
- native KiCad/`pcbnew` checker sweep under KiCad 10.0.5 Python: **18/18 PASS**; R262 changes no ECAD source;
- staged release-candidate manifest: **6,156 package files; PASS**;
- deterministic UNSENT ZIP membership, timestamp, internal-manifest and engineering/release byte parity: **PASS**; and
- `git diff --check`: **PASS**.

## Web-guide and diagram validation boundary

Static inspection confirms a responsive viewport, 16 px minimum body copy, 14 px table text, table-owned horizontal overflow, mobile rules, an accessible SVG title/description and 18 px minimum SVG annotation text. The local SVG renderer could not process the file and direct local-file browser access remains prohibited by browser policy, so no screenshot-based visual result is claimed. The guide and numbered SVG require visual recheck when served from an approved local or hosted URL.

Passing these checks does not establish provider acceptance, price, delivery, process quality, physical performance, functional safety or authority to transmit, purchase or perform work.
