amyleesterling/humanoid-robot/docs/reviews/2026-08-12-r263-validation-record.md

# R263 validation record

> **PRELIMINARY - NOT APPROVED FOR PROCUREMENT, FABRICATION, ASSEMBLY, CONNECTION, POWERED TESTING, MOTION, OR ENERGIZATION**

Date: 2026-08-12  
Package: `HR-V0-DXL-PROT-CARRIER-HARNESS-P0.2`  
Configuration: `HR-V0-CONFIG-REC-P0.27`

## Reproduced corrections

- Six harnesses, twelve conductors and 24 endpoint rows are present.
- The minimum populated JST quantity is nine `VHR-2N` housings and eighteen `SVH-21T-P1.1` contacts before process scrap.
- Six Panduit `PN18-8R-E` terminals are held candidates for the Blue Sea Systems 5025 branch positive/return screw interfaces; physical circuit positions, one-ring-per-screw fit and all process evidence remain open.
- Thirteen positive-area rectangle intersections reproduce the stale R161 placement conflict with current P0.7 objects.
- Three rotated right-side planning rectangles have zero nominal planar intersections. This is a two-dimensional analytical screen, not received fit, depth, connector-sweep, access, thermal or drilling evidence.
- All twelve cut lengths and all strip/crimp values remain `SELECTION REQUIRED` and `DO NOT CUT OR CRIMP`.

## Automated validation

- Dedicated R263 checker: pass.
- Historical affected checks for R237, R259, R260, R261 and R262: pass after successor-aware configuration checks were extended to P0.27 and the 109-group BOM.
- Standard repository checker count: final post-staging result 206 of 206 pass. The initial pre-staging sweep reported six successor/manifest failures; successor-aware checks, fail-closed metadata and staged-manifest synchronization were corrected before the final pass.
- Native KiCad checks: 18 of 18 pass under KiCad 10 Python, including the current P0.3 limiter carrier, current P0.2 DXL star, watchdog PCB/CAM and observation carriers.
- Python syntax compilation: pass for the R263 generator and checker.
- Web legibility static checks: body text minimum 16 px-equivalent, table text 14 px and SVG functional text 19 px or larger.
- Browser visual QA: not claimed. The available browser connection prohibits direct local-file navigation, and this round did not publish or start an alternate server.

## Evidence boundary

No component was ordered or received. No conductor was cut, stripped or crimped. No board or panel was drilled. No harness was assembled, connected, powered or tested. No qualified reviewer accepted the carrier placement, conductor/terminal application, protection coordination, grounding, functional safety or work authority. ERC/DRC and project checkers establish file consistency only; they do not approve electrical correctness, functional safety or energization.

The synchronized release manifest contains 6,215 package files. Energization remains prohibited.
