amyleesterling/humanoid-robot/docs/reviews/2026-08-12-r264-validation-record.md

# R264 validation record

> **PRELIMINARY - NOT APPROVED FOR PROCUREMENT, FABRICATION, DRILLING, ASSEMBLY, CONNECTION, POWERED TESTING, MOTION, OR ENERGIZATION**

Identifier: `HR-V0-DXL-CARRIER-MOUNT-IF-P0.2`

Configuration: `HR-V0-CONFIG-REC-P0.28`

Generation reproduces twelve hole centers and six connector anchors from the hashed P0.3 PCB, P0.7 panel and R263 placement sources. All 15 holds and 18 acceptance rows are open; all 14 metrology rows are unexecuted. The SVG is explicitly not a drill template. No physical article, measurement, drilling, procurement, connection, powered test, motion or energization occurred.

Automated validation result: the dedicated checker passes; 203 non-KiCad repository checks pass; 19 native board checks pass under KiCad 10 Python; generator/checker syntax compilation passes. Desktop browser QA found and corrected one clipped SVG legend, then confirmed the corrected diagram and no page-level horizontal overflow. Functional HTML text is 16 px body, 14 px tables and 14 px or larger in the SVG. The available viewport override did not change the browser's reported 1280 px width, so narrow-screen visual QA is not claimed; the responsive rule and horizontal table reflow are statically present. The staged release manifest passes with 6,276 package files.

No Sol R12 blocker receives qualified closure.
