amyleesterling/humanoid-robot/docs/reviews/2026-08-12-r265-validation-record.md

# R265 validation record

> **PRELIMINARY - NOT APPROVED FOR PROCUREMENT, FABRICATION, MARKING, DRILLING, ASSEMBLY, CONNECTION, POWERED TESTING, MOTION, OR ENERGIZATION**

Package: `HR-V0-CARRIER-FIT-EVID-CAP-P0.1`

Configuration: `HR-V0-CONFIG-REC-P0.29`

Generation binds the exact R264 source hashes and produces 80 blank measurement rows, twelve blank photo groups, twelve active stop conditions, ten open holds and twelve blank acceptance rows. Both scale bars and all three board envelopes are encoded in millimetres on a US Letter landscape SVG. No physical session, download, measurement, photo, result, signature or authority is claimed.

Automated validation passed 206 non-native repository checks and 19 KiCad-native checks. The dedicated R265 checker and `node --check` of the external capture script passed. Browser QA at the effective 1280 x 720 viewport confirmed 16 px body/input text, 14 px table text, no page-level horizontal overflow, readable unclipped mockup art, successful script loading, and a completeness change from 0 to 1 after one dummy raw-value entry. No download was activated. The requested 390 x 844 viewport override remained at 1280 x 720, so narrow-mobile visual QA is explicitly unverified; the static CSS breakpoint and internal table scrolling were checked only from source.

The staged master release manifest passed with 6,340 package files. No Sol R12 blocker receives qualified closure.
