amyleesterling/humanoid-robot/docs/reviews/2026-08-12-r266-validation-record.md

# R266 validation record

> **PRELIMINARY - NOT APPROVED FOR PROCUREMENT, FABRICATION, ASSEMBLY, CONNECTION, POWERED TESTING, MOTION, OR ENERGIZATION**

`HR-V0-LOT-A-DECISION-CAP-P0.1` records four current primary-source checks, three exact item lines, four open findings, twelve decision gates, twelve blank owner inputs, six blank signatures, eight scope rows, ten active stop conditions and twelve blank acceptances. The $1,182.22 arithmetic is `2 x 482.89 + 2 x 76.71 + 2 x 31.51`; it excludes shipping, tax, fees and allocation. No supplier was contacted, no cart was created, no download was activated, and no purchase or physical work is claimed.

Automated validation passed 207 non-native repository checks and 19 KiCad-native checks. The dedicated R266 checker and `node --check` of the external decision script passed. Browser QA at the effective 1280 x 720 viewport confirmed 16 px body/input text, 14 px table text, no page-level horizontal overflow, no script errors, and a draft counter change from 0/12 to 1/12 after one dummy `defer` entry. No download was activated. Narrow-mobile visual QA remains unverified because the browser viewport override did not apply in this environment; the static CSS breakpoint and internal table scrolling were inspected only from source.

The staged master release manifest passed with 6,402 package files. No Sol R12 blocker receives qualified closure.
