amyleesterling/humanoid-robot/docs/reviews/2026-08-12-r267-validation-record.md

# R267 validation record

> **PRELIMINARY - NOT APPROVED FOR PROCUREMENT, FABRICATION, ASSEMBLY, CONNECTION, POWERED TESTING, MOTION, OR ENERGIZATION**

`HR-V0-LOT-A-ALT-ROUTE-P0.1` records eight current source checks, four compared routes, three exact basket lines, six open findings, twelve gates, twelve blank owner inputs, six blank signatures, eight scope rows, ten active stop conditions and twelve blank acceptances. The visible arithmetic remains `2 x 482.89 + 2 x 76.71 + 2 x 31.51 = 1,182.22 USD`. No seller was contacted, no cart/quote was created, no checkout or download was activated, and no purchase, receipt or physical work is claimed.

The DigiKey route is conditionally admissible only because its page explicitly binds the exact manufacturer number to the `-T` model and displays fulfillment from ROBOTIS Inc. This is not a claim that dynamic stock is reserved, that commercial terms are accepted, or that the received identity is proven. No Sol R12 blocker receives qualified closure.

Automated validation passed 208 non-native repository checks and 19 KiCad-native checks. The dedicated R267 checker and `node --check` of the external decision script passed. Browser QA at the effective 1280 x 720 viewport confirmed 16 px body/input text, 14 px table text, no page-level horizontal overflow, legible unclipped content and a draft counter transition from 0/12 to 1/12 after one dummy `defer` entry; the input was cleared back to 0/12 and no download was activated. The browser evaluation sandbox does not expose page globals or handler properties, so successful counter behavior is the runtime evidence. Narrow-mobile visual QA remains unverified in this environment; responsive CSS and internal table scrolling were inspected from source.

The staged master release manifest covers 6,466 package files. No physical article, executed test, qualified approval or energization authority is claimed.
