amyleesterling/humanoid-robot/docs/reviews/2026-08-12-r268-validation-record.md

# R268 validation record

> **PRELIMINARY - NOT APPROVED FOR PROCUREMENT, FABRICATION, ASSEMBLY, CONNECTION, POWERED TESTING, MOTION, OR ENERGIZATION**

`HR-V0-GDT-REVIEW-P0.2` binds five current drawings and provides five functional datum strategies, twenty exact feature-family rows, twenty feature-control decisions, fifteen degree-of-freedom rows, one numerical tolerance-zone comparison, twelve open holds and twelve blank acceptances. It changes no drawing geometry or coordinate tolerance and releases no formal GD&T.

The numerical comparison independently reproduces the square-corner radius `sqrt(0.05^2 + 0.05^2) = 0.070710678 mm`, the enclosing circular diameter `0.141421356 mm`, and the Ø0.14 radius `0.070000000 mm`. Because neither zone contains the other, P0.1's proposed conversion is rejected as non-equivalent.

Automated validation passed **211/211 non-native repository checks** and **18/18 KiCad-native checks** under KiCad 10.0. Browser QA passed at 1280 x 720 and 390 x 844: body text remained 16 px, table text 14 px, the warning remained visible, the page had no horizontal overflow, and wide tables used internal horizontal scrolling. The page contains zero forms and zero buttons. The staged master manifest covers **6,521 package files**.

No Sol R12 blocker closes. B-003 and EG-005 remain partial/open pending qualified review, functional stack analysis, successor drawings, provider DFM, FAI, received fit, structural proof and signed authority.
