amyleesterling/humanoid-robot/docs/reviews/2026-08-12-r269-validation-record.md

# R269 validation record

> **PRELIMINARY - NOT APPROVED FOR PROCUREMENT, QUOTATION, FABRICATION, ASSEMBLY, CONNECTION, POWERED TESTING, MOTION, OR ENERGIZATION**

`HR-V0-J2-STOP-STRENGTH-P0.1` binds twelve artifacts and records the corrected load model. P0.9 changes only C06/C07 stop geometry; C01/C04/C05 STEP identities, actuator-side hole axes and transforms remain unchanged. Deterministic CAD validation passed 40,001 discrete poses and 69 continuous-clearance pairs with 0.765783 mm minimum nominal clearance. The single-rail 12 V momentary-stall nominal screen is 61.344 MPa with a 3.912 ratio to the provisional 240 MPa MTR threshold; the 4.0 combined-factor case fails.

Automated validation passed **213/213 repository checks**. Native KiCad 10.0.5 / `pcbnew` regression passed **18/18**; R269 changes no ECAD source. Browser QA passed at 1280 x 720 and 390 x 844: body text remained 16 px, table text 14 px, the warning and assembly image rendered, there was no page-level horizontal overflow, and wide tables used internal scrolling. The page has zero forms, zero buttons and zero browser errors/warnings. The staged master manifest covers **6,623 package files**.

All twelve holds and twelve acceptances remain open/unexecuted. P0.9 is not selected. All 18 Sol R12 blockers remain without qualified closure; HR-V0 remains not build-ready and energization remains prohibited.
