amyleesterling/humanoid-robot/docs/reviews/2026-08-12-r270-validation-record.md

# R270 validation record

> **PRELIMINARY - NOT APPROVED FOR PROCUREMENT, QUOTATION, FABRICATION, ASSEMBLY, CONNECTION, POWERED TESTING, MOTION, OR ENERGIZATION**

R270 regenerated `HR-V0-ARM-ARCH-P0.10-BOSSED-STOP-CANDIDATE` twice from source. The full nominal CAD pass completed 40,001 discrete poses and 69 continuous non-intentional body-pair certificates. Exact-kernel near-contact evaluation at J2 = 117.9999 degrees recorded a 0.000028516 mm face gap, +Y common normal, and 19.115315 mm effective normal-force arm about the J2 +X axis.

Repository validation passed **214/214** checks. Native KiCad regression passed **19/19** detected `pcbnew` checks; R270 changes no ECAD source. The staged master manifest contains **6,730** package files.

Browser QA passed at 1280 × 720 and 390 × 844. Body text was 16 px and table text 14 px at both sizes; the page had no document-level horizontal overflow, wide tables remained internally scrollable, and the assembly image loaded. The temporary mobile viewport override was reset.

This validation demonstrates repository consistency and nominal candidate geometry only. It does not close nonlinear contact/root/interface analysis, tolerances, fasteners, deflection, fatigue, bumper behavior, measured inertia/speed/current decay, DFM, FAI, physical stopping tests, qualified review, or work authority.
