amyleesterling/humanoid-robot/docs/reviews/2026-08-12-r272-validation-record.md

# R272 validation record

> **PRELIMINARY - NOT APPROVED FOR PROCUREMENT, QUOTATION, FABRICATION, ASSEMBLY, CONNECTION, POWERED TESTING, MOTION, OR ENERGIZATION**

R272 generated exact P0.11 C06/C07 STEP, assembly STEP/GLB and full nominal arm evidence. The 40,001-pose sampled sweep reports no collision within the provisional command domain. The adaptive continuous certificate covers 69 non-intentional pairs over J1 -20..70 degrees and J2 15..120 degrees with a 0.764678 mm minimum guaranteed nominal-model clearance. Nominal stop contact is 118 degrees after retuning C06 top Z to 36.026374 mm.

The exact 253.607 N endpoint-plus-gravity single-rail load was applied to three meshes per part. The 2 mm C06 model gives 17.914836 MPa global maximum and 0.017444 mm maximum displacement; its 4x internal rejection value is 71.659343 MPa. The 2 mm C07 model gives 7.845007 MPa and 0.003196 mm; its 4x value is 31.380028 MPa. Final-two-mesh global-maximum changes are 3.31% and 8.48%. Qualified convergence is not claimed.

C07's rear web now carries through its four M2.5 axes. The longer fastener stack, preload, bearing, prying, tool access and frame compliance are unresolved. Twelve acceptance rows remain unexecuted. P0.11 remains unselected.

Repository validation passed **216/216** non-`pcbnew` checks. Native KiCad 10.0.5 regression passed **18/18** currently detected `pcbnew` checks; R272 changes no ECAD source. The staged master manifest contains **6,947** package files, including this validation record and all R272 source/evidence artifacts.

Browser QA passed at 1280 x 720 and 390 x 844. Body text remained 16 px, table text 14 px and the warning 16 px. Neither viewport had document-level horizontal overflow; wide tables scrolled internally; the four artifact links resolved to controlled local paths; no images were broken; the page contains zero forms and zero buttons; and the browser reported zero warnings or errors. The temporary viewport override and local server were reset.

The first repository sweep correctly rejected an attempted P0.11 attachment to current release products. That promotion was removed: P0.8 remains the current unaccepted mechanical identity, P0.11 is indexed only as unselected review evidence, and all inherited electrical/BOM/assembly release metadata remains unchanged. A second sweep then passed 216/216.

No physical or qualified-review claim is made. Passing automation does not authorize procurement, fabrication, assembly, connection, powered testing, motion or energization.
