amyleesterling/humanoid-robot/docs/reviews/2026-08-12-r273-validation-record.md

# R273 validation record

> **PRELIMINARY - NOT APPROVED FOR PROCUREMENT, QUOTATION, FABRICATION, ASSEMBLY, CONNECTION, POWERED TESTING, MOTION, OR ENERGIZATION**

R273 generated exact P0.12 C06/C07 STEP, assembly STEP/GLB and full nominal arm evidence. Four 5.20 mm C07 rear access wells terminate at the original screw-head seat plane, leaving the original 9.525 mm A04 clamped grip and all four axes unchanged. Nominal geometry screens report 0.350 mm radial head clearance, 1.400 mm inner-web ligament and 4.500 pitches beyond the screened nut envelope. These values exclude complete manufacturing and received-hardware tolerances.

The 40,001-pose sampled sweep reports no collision within the provisional command domain. The adaptive continuous certificate covers 69 non-intentional pairs over J1 -20..70 degrees and J2 15..120 degrees with a 0.764678 mm minimum guaranteed nominal-model clearance. Nominal stop contact remains 118 degrees and modeled body contact remains 121.643289 degrees.

The exact 253.607 N endpoint-plus-gravity single-rail load was applied to three meshes per part. C06 is unchanged at 17.914836 MPa and 0.017444 mm on the 2 mm mesh. With C07 restraint moved to the original A04 land, C07 gives 25.671010 MPa and 0.012189 mm; its internal 4x value is 102.684039 MPa. Final-two-mesh global-maximum changes are 3.31% and 2.05%. Qualified convergence is not claimed.

The elastic bolt-group demand screen gives 392.085 N maximum absolute axial reaction, 112.275 N maximum in-plane shear and 407.844 N combined demand at one axis. It makes no capacity claim and omits preload, slip, prying, S102 compliance, nonlinear contact, tolerance, fatigue and shock.

The referenced screw, washer and nut pages are recorded only for dimensional traceability. Current exact available order codes, certificates, strength, tightening, anti-galling, locking, reuse, physical fit and proof remain `SELECTION REQUIRED`. Fifteen acceptance rows remain unexecuted. P0.12 remains unselected.

The staged repository validation passed **217/217** non-`pcbnew` checks. Native KiCad 10.0.5 regression passed **18/18** currently detected `pcbnew` checks; R273 changes no ECAD source. The staged master manifest contains **7,099** package files.

Browser QA passed at 1280 x 720 and 390 x 844. Body copy remained 16 px, table/secondary text 14 px and the warning at least 16 px. Neither viewport had document-level horizontal overflow; wide tables scrolled inside their own containers. All six artifact links resolve to staged controlled files, no images are broken, the page contains zero forms/buttons and the browser reported zero warnings or errors. The temporary viewport override and local server were reset.

No physical or qualified-review claim is made. Passing automation does not authorize procurement, fabrication, assembly, connection, powered testing, motion or energization.
