amyleesterling/humanoid-robot/docs/reviews/2026-08-12-r274-validation-record.md

# R274 validation record

> **PRELIMINARY - NOT APPROVED FOR PROCUREMENT, QUOTATION, FABRICATION, ASSEMBLY, CONNECTION, POWERED TESTING, MOTION, OR ENERGIZATION**

R274 generated `HR-V0-A04-JOINT-P0.1`, its release copy and configuration reconciliation P0.38. The package identifies five current supplier-order/tool candidates, but selects none of them and releases no work.

The nominal stack arithmetic reproduces 2.725 mm, or 6.056 M2.5 pitches, beyond the nominal nut. This is not a tolerance closure because received screw length, nut height and S102 thickness bounds remain unavailable or unaccepted. The corrected direct bolt-demand screen uses the R273 elastic-group reactions and reports 115.632 MPa axial stress, 33.112 MPa shear stress and 129.073 MPa von Mises stress on the M2.5 tensile-stress area. It is a demand screen only; preload, slip, separation, prying, sheet flexibility, bearing, thread/head/nut/washer capacity, fatigue and impact remain open.

The package contains five candidate lines, ten blank receiving rows, twelve blank torque/preload trials, a four-axis installation traveler, seven unexecuted verification steps and twelve open holds. Catalog class labels were not promoted to configuration allowables. Procurement, assembly, structural use, powered testing, motion and energization remain unauthorized.

The staged repository validation passed **219/219** non-`pcbnew` checks. Native KiCad 10.0.5 regression passed **18/18** currently detected `pcbnew` checks; R274 changes no ECAD source. The final staged master-manifest count is recorded below after regeneration.

Browser QA passed at 1440 x 900 and 390 x 844. Body copy was 17.28 px desktop and 16 px mobile; the smallest functional/table text was 14 px. Neither viewport had document-level horizontal overflow, while the wide tables scrolled within their own containers. The stack calculator was exercised by changing screw length from 18.0 mm to 17.5 mm; the displayed projection changed from 2.725 mm / 6.056 pitches to 2.225 mm / 4.944 pitches, then the input was reset. The temporary viewport override, local tab and local server were reset or closed.

Final staged master manifest: **7,201 package files**.

No physical result or qualified-review acceptance is claimed. Passing automation does not authorize procurement, fabrication, assembly, connection, powered testing, motion or energization.
