amyleesterling/humanoid-robot/docs/reviews/2026-08-12-r275-validation-record.md

# R275 validation record

> **PRELIMINARY - NOT APPROVED FOR PROCUREMENT, QUOTATION, FABRICATION, ASSEMBLY, CONNECTION, POWERED TESTING, MOTION, OR ENERGIZATION**

R275 generated `HR-V0-J2-SOFT-CONTACT-PAD-P0.1`, its release copy and configuration reconciliation P0.39. The package records Rogers `2300327` / PORON `4790-92-25024-04P` only as an unselected test-coupon candidate ahead of the structural metal backup.

Published thickness of 0.61 +/-0.08 mm fits the current 0.75 mm envelope on paper. Published compression-force data are not an energy or stall-load rating. The package therefore assigns the pad only a sacrificial contact/noise/rebound role and gives it zero structural-stop or safety credit. ACE `MC5M-3-B` is recorded as unsuitable for the current envelope and approach speed, not as a released alternative.

The arithmetic reproduces 0.000154502 J at 10 deg/s and 0.001390518 J at the 30 deg/s sensitivity point using the currently unaccepted inertia. The 0.142290750 J motor-work comparison is explicitly an order-of-magnitude warning built from the superseded radius-basis endpoint force; it is not an accepted force or energy model. Exact contact-normal work, as-built inertia including reflected rotor, maximum fault speed, current/torque decay, bumper force-stroke behavior and the full joined backup-stop load path remain open.

The package contains four manufacturer-source records, six separated load cases, ten unexecuted verification tests, twelve open holds and twelve unexecuted acceptance rows. No pad has been selected, ordered, received, installed or tested.

The staged repository validation passed **219/219** non-`pcbnew` checks. Native KiCad 10.0.5 regression passed **18/18** currently detected `pcbnew` checks; R275 changes no ECAD source. The final staged master-manifest count is recorded below after regeneration.

Browser QA passed at 1440 x 900 and 390 x 844. Body copy was 17.28 px desktop and 16 px mobile; the smallest functional/table text was 14 px. Neither viewport had document-level horizontal overflow, while the wide tables scrolled within their own containers. The warning, role boundary, metrics, load cases, source table and evidence table rendered in the expected order. The temporary viewport override, local tab and local server were reset or closed.

Final staged master manifest: **7,201 package files**.

No physical result or qualified-review acceptance is claimed. Passing automation does not authorize procurement, fabrication, assembly, connection, powered testing, motion or energization.
