amyleesterling/humanoid-robot/docs/reviews/2026-08-12-r279-validation-record.md

# R279 validation record

> **PRELIMINARY - NOT APPROVED FOR PROCUREMENT, QUOTATION, FABRICATION, ASSEMBLY, CONNECTION, POWERED TESTING, MOTION, OR ENERGIZATION**

R279 generated `HR-V0-J2-STOP-REFINEMENT-PROTOCOL-P0.1`, its synchronized interactive guide and configuration reconciliation P0.43. This is an executable protocol definition, not an executed local-convergence analysis.

The audit recomputed 18 R278 final-pair metrics directly from `mesh-convergence.csv`. Thirteen exceed 5% relative change. The largest is 18.700% for the reported C07 pocket-floor root maximum; the metal-perimeter root maximum changes 17.910% and the C06 reported root p99 changes 15.992%. The uniform 2 mm P1 mesh also cannot resolve the 0.520 mm pocket thickness. R278-H02 therefore remains open.

The successor protocol defines seven named physical-zone groups, including exact B-Rep rail-root and pocket-edge identities, fixed C06/C07 gauge sections, pocket-floor probes and six separately reported hole families. Four local mesh levels reduce the pocket target from 0.26 to 0.09 mm and use growth no greater than 1.4. Acceptance requires curvature-conforming P2 evidence, recorded mesh quality, normalized force and moment balance, exact loaded-area/resultant preservation, registered displacement probes, section resultants, fixed-domain volume-weighted metrics, observed order/GCI and explicit raw singularity trends. A future pass can establish only numerical convergence of the idealized model.

Repository validation passed **223/224** non-`pcbnew` checks before staging; the sole expected failure was the staged-manifest checker rejecting the new untracked R279 files. Native KiCad regression and final post-staging results are recorded below after configuration closure.

Browser QA passed at 1440 x 900 and 390 x 844. Desktop body/table text measured 17/16 px; mobile body/table text measured 16/16 px. The smallest functional text was 16 px. Neither viewport had page-level horizontal overflow; all six wide tables used their own horizontal scrolling on mobile. The warning and R278-H02-open statement were visible in the rendered DOM. The temporary browser tab and local server were closed.

Final native KiCad result: **18/18 passed**.

Final post-staging non-`pcbnew` result: **224/224 passed**.

Final staged master manifest: **7,469 package files**.

No analysis execution, mesh-convergence closure, capacity result, physical result, qualified acceptance or work authorization is claimed.
