amyleesterling/humanoid-robot/docs/reviews/2026-08-12-r283-validation-record.md

# R283 validation record

> **PRELIMINARY - NUMERICAL METHOD ARCHITECTURE ONLY - NOT APPROVED FOR PROCUREMENT, QUOTATION, FABRICATION, ASSEMBLY, CONNECTION, POWERED TESTING, MOTION, OR ENERGIZATION**

R283 publishes `HR-V0-J2-EXECUTION-ARCHITECTURE-P0.1` and configuration reconciliation P0.47. The exact-geometry architecture prototype passed its bounded checks. The V04 C07 curved mesh was rejected: its linear SICN and Q4/Q6/Q8 determinant screens passed, but 897 of 8,999 corner correspondences exceeded the frozen 1e-9 mm tolerance; maximum displacement was 0.0863831 mm.

Validation on 2026-08-12:

- Exact-zone/submodel architecture checker: **PASS**.
- C07 curved-mesh repair checker: **PASS as synchronized rejection evidence**; no route promoted.
- R283 integration checker: **PASS**.
- HR-V0 standard checker sweep: **230/230 checks passed**.
- Native KiCad status remains **18/18 checks passed**; R283 changes no ECAD source.
- Master release inventory: **7,775 package files**.
- Staged whitespace validation: **PASS**.
- Interactive guide desktop QA at 1,265 px: 16 px minimum text, no root overflow, all three tables present.
- Interactive guide mobile QA at 375 px client width: 16 px minimum text, no root overflow, all three tables scroll internally.

These checks prove configuration consistency and bounded numerical-method behavior only. Exact clipped zones, structural fields, submodel transfer, multilevel convergence, H02, capacity, selection, safety credit, fabrication, powered testing, motion and energization remain open.
