amyleesterling/humanoid-robot/docs/reviews/2026-08-12-r284-validation-record.md

# R284 validation record

> **PRELIMINARY - NUMERICAL MESH-METHOD DEVELOPMENT ONLY - NOT APPROVED FOR PROCUREMENT, QUOTATION, FABRICATION, ASSEMBLY, CONNECTION, POWERED TESTING, MOTION, OR ENERGIZATION**

Project-owned checkers reproduce V03 fail (37 sampled determinant failures), V06 bounded pass (zero), V08 fail (9), constrained V04 bounded pass, and localization of 12 failed elements across V03/V08. Independent and qualified acceptance remain open.

Validation on 2026-08-12:

- Fixed-corner raw Tet10 transfer/Jacobian checker: **PASS**; V06 is the sole bounded candidate.
- Constrained-high-order alternate checker: **PASS as bounded method evidence**.
- Failed-element localization checker: **PASS**; no remesh or structural result claimed.
- R284 integration checker: **PASS**.
- HR-V0 standard checker sweep: **234/234 checks passed**.
- Master release inventory: **7,938 package files**.
- Staged whitespace validation: **PASS**.
- Interactive guide desktop QA at 1,265 px client width: 16 px minimum text, no root overflow, all three tables present.
- Interactive guide mobile QA at 360 px client width: 16 px minimum text, no root overflow, all three tables scroll internally.

These checks establish configuration consistency and bounded numerical-method evidence only. Exact facet/B-Rep fidelity, repeatability, full R279-C02 quality evidence, structural fields, exact-zone statistics, multilevel convergence, R278-H02, capacity, selection, safety credit, fabrication, powered testing, motion and energization remain open.
