amyleesterling/humanoid-robot/docs/reviews/2026-08-13-r308-validation-record.md

# R308 project validation record

**PRELIMINARY - NOT APPROVED FOR ENERGIZATION OR PHYSICAL WORK**

- R307 executor compiled and completed once under the frozen protocol.
- Exact R300 linear arrays and Tet10 topology reproduced.
- 239,848 corners were restored; recorded maximum final error was 0.0 mm.
- Finite Q4/Q6/Q8 signed and normalized screens contained zero failures.
- The independent R307 package checker passes.
- R308 executed once and failed closed with 112,569 uniquely mapped and 77 unmapped exterior facets.
- The R308 failure-package checker passes.
- Exact-facet revalidation, R279-C02, structural execution, H02, capacity, safety credit and all work authority remain false.

This is project-owned validation, not independent or qualified acceptance.
