amyleesterling/humanoid-robot/docs/reviews/2026-08-13-r312-validation-record.md

# R312 project validation record

**PRELIMINARY - NOT APPROVED FOR ENERGIZATION OR PHYSICAL WORK**

- R311's corrected evaluator requires exact trimmed-face containment for every candidate node.
- The R311 checker reproduces 112,399 uniquely mapped and 247 unmapped exterior facets in 32 clusters across 24 exact faces.
- The R312 operation was preregistered before its single execution.
- All 21 source zones map one-to-one; total material, zone volumes, bounding boxes, centers of mass and the fused PE volume meet the frozen equivalence limits.
- Only 8 of 24 exact target faces meet the frozen one-face/one-exterior-owner criterion, so topology acceptance is false.
- The R312 checker verifies the preregistration, source/release parity, manifests, hashes, numerical limits, rejection state and authority boundary.
- No mesh, structural solve, R279-C02 closure, H02 closure, capacity credit, safety credit or physical-work authority exists.

This is project-owned validation, not independent or qualified acceptance.
