amyleesterling/humanoid-robot/docs/reviews/2026-08-07-dynamic-characterization-p0.1-independent-review-request.md

# Independent review request — HR-V0 dynamic-characterization P0.1

> **CRITICISM REQUEST ONLY—NOT AN APPROVAL OR AUTHORIZATION TO BUILD, CONNECT, TEST, MOVE, OR ENERGIZE.**

Please review repository identifier `HR-V0-DYN-CHAR-P0.1` and report `BLOCKER`, `MAJOR`, and `MINOR` findings with exact file/row references.

## Questions

1. Does the 15-channel register capture the minimum independent evidence for angle, velocity, bidirectional current, voltage, reaction force, bumper travel, contactor states, stop events, video and sample timing?
2. Is the ROBOTIS/U2D2 telemetry boundary conservative and technically accurate?
3. Is LabJack T7 correctly treated as a nonselected evaluation candidate, with manufacturer stream-rate facts separated from project requirements?
4. Are fixture reaction loads, secondary restraint, guard independence and remote-operation controls sufficiently fail-closed?
5. Does the sequence prevent a successful unpowered or source-only stage from implicitly authorizing motion?
6. What additional sensor dynamics, synchronization, aliasing, uncertainty, saturation, regeneration, data-integrity or fault-injection evidence is needed?
7. Is the 35-field raw schema sufficient to reproduce stopping time, residual travel, contact energy and current persistence without relying on narrative notes?
8. Which items require a qualified mechanical, electrical, metrology or functional-safety reviewer before physical execution?

Please do not infer sensor ranges, sample rates, order codes, safe impact limits, proof loads or authorization. Mark unresolved values `SELECTION REQUIRED`.
