amyleesterling/humanoid-robot/mechanical/analysis/hr-v0-j2-c07-conformal-mesh-failure-localization-p0.1/README.md

# HR-V0-J2-C07-CONFORMAL-MESH-FAILURE-LOCALIZATION-P0.1

**PRELIMINARY - CONFORMAL MESH FAILURE LOCALIZATION ONLY - NOT APPROVED FOR PROCUREMENT, QUOTATION, FABRICATION, ASSEMBLY, CONNECTION, POWERED TESTING, MOTION, OR ENERGIZATION**

R290 localizes every R289 linear SICN value below 0.20 and every wrong/zero or normalized-floor Tet10 Jacobian at the actual Gauss4/Gauss6/Gauss8 points. Exact-zone membership comes from the R289 physical-volume provenance. Curved failures are additionally bound to the nearest exact R288 B-Rep face.

No threshold changes, remesh, structural solve, capacity or work authority follow from this diagnostic package.
