amyleesterling/humanoid-robot/mechanical/analysis/hr-v0-j2-c07-curved-mesh-repair-p0.1/README.md

# HR-V0-J2-C07-CURVED-MESH-REPAIR-P0.1

> **PRELIMINARY - CURVED MESH METHOD EVIDENCE ONLY - NOT APPROVED FOR PROCUREMENT, QUOTATION, FABRICATION, ASSEMBLY, CONNECTION, POWERED TESTING, MOTION, OR ENERGIZATION**

R283 reruns V04 against the exact STEP SHA with retained raw evidence. Linear SICN, Q4/Q6/Q8 curved determinant, element connectivity/orientation and OCC corner-membership screens pass. The frozen unique 1e-9 mm spatial corner bijection fails: maximum nearest-corner displacement is 0.0863831 mm. V04 is rejected and no bounded route is promoted. This is not R279-C02, H02, capacity, selection, safety credit, or work authority.
