amyleesterling/humanoid-robot/mechanical/analysis/hr-v0-j2-c07-pe-rail-jacobian-failure-localization-p0.1/README.md

# HR-V0-J2-C07-PE-RAIL-JACOBIAN-FAILURE-LOCALIZATION-P0.1

**PRELIMINARY - RAIL-JACOBIAN SUCCESSOR FAILURE LOCALIZATION ONLY - NOT APPROVED FOR PROCUREMENT, QUOTATION, FABRICATION, ASSEMBLY, CONNECTION, POWERED TESTING, MOTION, OR ENERGIZATION**

R304 localizes all 10 residual R303 failed quadrature points across 1 element(s) and 1 exact B-Rep face cluster(s). R303 retains the global and monitored-zone linear quality gates. No remesh or structural work is executed.
