amyleesterling/humanoid-robot/mechanical/analysis/hr-v0-j2-c07-pe-seam-free-failure-localization-p0.1/README.md

# HR-V0-J2-C07-PE-SEAM-FREE-FAILURE-LOCALIZATION-P0.1

**PRELIMINARY - SEAM-FREE MESH FAILURE LOCALIZATION ONLY - NOT APPROVED FOR PROCUREMENT, QUOTATION, FABRICATION, ASSEMBLY, CONNECTION, POWERED TESTING, MOTION, OR ENERGIZATION**

R299 localizes the residual R298 evidence: 1 global cell below SICN 0.20 (permitted by the global fraction gate) and 6 failed Gauss-order/QP pairs across 2 curved Tet10 element(s). Exact nearest R297 B-Rep faces are retained for the next preregistration. No remesh or structural work is executed.
