amyleesterling/humanoid-robot/mechanical/analysis/hr-v0-j2-c07-pe-seam-free-jacobian-failure-localization-p0.1/README.md

# HR-V0-J2-C07-PE-SEAM-FREE-JACOBIAN-FAILURE-LOCALIZATION-P0.1

**PRELIMINARY - SEAM-FREE JACOBIAN FAILURE LOCALIZATION ONLY - NOT APPROVED FOR PROCUREMENT, QUOTATION, FABRICATION, ASSEMBLY, CONNECTION, POWERED TESTING, MOTION, OR ENERGIZATION**

R301 localizes all 3 residual R300 curved failed quadrature points across 2 element(s) and 1 exact B-Rep face cluster(s). R300 has zero linear cells below SICN 0.20. No remesh or structural work is executed.
