amyleesterling/humanoid-robot/hr30/whole-body-p0.1/hr30.urdf

<robot name="hr30_whole_body_p01">
  <link name="base_link">
    <inertial>
      <origin xyz="-0.003051 0.007384 -0.000262" rpy="0 0 0" />
      <mass value="1.550063" />
      <inertia ixx="0.002057063" ixy="0" ixz="0" iyy="0.003736298" iyz="0" izz="0.004527477" />
    </inertial>
    <visual>
      <origin xyz="0.000000 0.000000 0.000000" rpy="0 0 0" />
      <geometry>
        <box size="0.155000 0.105000 0.070000" />
      </geometry>
      <material name="button_sky">
        <color rgba="0.49 0.83 0.98 1" />
      </material>
    </visual>
    <collision>
      <origin xyz="0.000000 0.000000 0.000000" rpy="0 0 0" />
      <geometry>
        <box size="0.155000 0.105000 0.070000" />
      </geometry>
    </collision>
  </link>
  <link name="torso">
    <inertial>
      <origin xyz="-0.000208 0.044790 0.099923" rpy="0 0 0" />
      <mass value="2.499749" />
      <inertia ixx="0.006900349" ixy="0" ixz="0" iyy="0.011899847" iyz="0" izz="0.010040659" />
    </inertial>
    <visual>
      <origin xyz="0.000000 0.000000 0.087500" rpy="0 0 0" />
      <geometry>
        <box size="0.190000 0.110000 0.145000" />
      </geometry>
      <material name="button_sky">
        <color rgba="0.49 0.83 0.98 1" />
      </material>
    </visual>
    <collision>
      <origin xyz="0.000000 0.000000 0.087500" rpy="0 0 0" />
      <geometry>
        <box size="0.190000 0.110000 0.145000" />
      </geometry>
    </collision>
  </link>
  <link name="neck_pan_link">
    <inertial>
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
    <collision>
      <origin xyz="0.000000 0.000000 0.000000" rpy="0 0 0" />
      <geometry>
        <box size="0.066000 0.064000 0.052000" />
      </geometry>
    </collision>
  </link>
  <link name="R_foot">
    <inertial>
      <origin xyz="-0.000000 0.005810 -0.001025" rpy="0 0 0" />
      <mass value="0.448853" />
      <inertia ixx="0.000832248" ixy="0" ixz="0" iyy="0.000348796" iyz="0" izz="0.001089403" />
    </inertial>
    <visual>
      <origin xyz="0.000000 -0.025000 -0.017500" rpy="0 0 0" />
      <geometry>
        <box size="0.090000 0.145000 0.035000" />
      </geometry>
      <material name="button_sky">
        <color rgba="0.49 0.83 0.98 1" />
      </material>
    </visual>
    <collision>
      <origin xyz="0.000000 -0.025000 -0.017500" rpy="0 0 0" />
      <geometry>
        <box size="0.090000 0.145000 0.035000" />
      </geometry>
    </collision>
  </link>
  <joint name="WAIST_YAW" type="revolute">
    <parent link="base_link" />
    <child link="torso" />
    <origin xyz="0.000000 0.000000 0.035000" rpy="0 0 0" />
    <axis xyz="0 0 1" />
    <limit lower="-0.520000" upper="0.520000" effort="0.0" velocity="0.250000" />
    <dynamics damping="0.1" friction="0.0" />
  </joint>
  <joint name="HEAD_PAN" type="revolute">
    <parent link="torso" />
    <child link="neck_pan_link" />
    <origin xyz="0.000000 0.000000 0.225000" rpy="0 0 0" />
    <axis xyz="0 0 1" />
    <limit lower="-1.400000" upper="1.400000" effort="0.0" velocity="1.000000" />
    <dynamics damping="0.1" friction="0.0" />
  </joint>
  <joint name="HEAD_TILT" type="revolute">
    <parent link="neck_pan_link" />
    <child link="head" />
    <origin xyz="0.000000 0.000000 0.040000" rpy="0 0 0" />
    <axis xyz="1 0 0" />
    <limit lower="-0.520000" upper="0.520000" effort="0.0" velocity="0.800000" />
    <dynamics damping="0.1" friction="0.0" />
  </joint>
  <joint name="L_SHOULDER_PITCH" type="revolute">
    <parent link="torso" />
    <child link="L_shoulder_pitch_link" />
    <origin xyz="0.090000 0.000000 0.165000" rpy="0 0 0" />
    <axis xyz="1 0 0" />
    <limit lower="-1.570000" upper="1.570000" effort="0.0" velocity="0.600000" />
    <dynamics damping="0.1" friction="0.0" />
  </joint>
  <joint name="L_SHOULDER_ROLL" type="revolute">
    <parent link="L_shoulder_pitch_link" />
    <child link="L_upper_arm" />
    <origin xyz="0.000000 0.000000 0.000000" rpy="0 0 0" />
    <axis xyz="0 1 0" />
    <limit lower="-1.220000" upper="1.220000" effort="0.0" velocity="0.600000" />
    <dynamics damping="0.1" friction="0.0" />
  </joint>
  <joint name="L_ELBOW_PITCH" type="revolute">
    <parent link="L_upper_arm" />
    <child link="L_forearm" />
    <origin xyz="0.038000 0.000000 -0.145107" rpy="0 0 0" />
    <axis xyz="1 0 0" />
    <limit lower="0.000000" upper="2.200000" effort="0.0" velocity="0.800000" />
    <dynamics damping="0.1" friction="0.0" />
  </joint>
  <joint name="L_WRIST_ROTATION" type="revolute">
    <parent link="L_forearm" />
    <child link="L_hand" />
    <origin xyz="0.005000 0.000000 -0.144914" rpy="0 0 0" />
    <axis xyz="0 0 1" />
    <limit lower="-1.570000" upper="1.570000" effort="0.0" velocity="1.000000" />
    <dynamics damping="0.1" friction="0.0" />
  </joint>
  <joint name="L_GRIPPER" type="prismatic">
    <parent link="L_hand" />
    <child link="L_gripper" />
    <origin xyz="0.000000 0.000000 -0.043000" rpy="0 0 0" />
    <axis xyz="1.0 0 0" />
    <limit lower="0.000000" upper="0.026000" effort="0.0" velocity="0.030000" />
    <dynamics damping="0.1" friction="0.0" />
  </joint>
  <joint name="L_HIP_YAW" type="revolute">
    <parent link="base_link" />
    <child link="L_hip_yaw_link" />
    <origin xyz="0.062500 0.000000 0.020000" rpy="0 0 0" />
    <axis xyz="0 0 1" />
    <limit lower="-0.520000" upper="0.520000" effort="0.0" velocity="0.500000" />
    <dynamics damping="0.1" friction="0.0" />
  </joint>
  <joint name="L_HIP_ROLL" type="revolute">
    <parent link="L_hip_yaw_link" />
    <child link="L_hip_roll_link" />
    <origin xyz="0.000000 0.000000 -0.020000" rpy="0 0 0" />
    <axis xyz="0 1 0" />
    <limit lower="-0.440000" upper="0.440000" effort="0.0" velocity="0.500000" />
    <dynamics damping="0.1" friction="0.0" />
  </joint>
  <joint name="L_HIP_PITCH" type="revolute">
    <parent link="L_hip_roll_link" />
    <child link="L_thigh" />
    <origin xyz="0.000000 0.000000 -0.020000" rpy="0 0 0" />
    <axis xyz="1 0 0" />
    <limit lower="-0.610000" upper="0.790000" effort="0.0" velocity="0.600000" />
    <dynamics damping="0.1" friction="0.0" />
  </joint>
  <joint name="L_KNEE_PITCH" type="revolute">
    <parent link="L_thigh" />
    <child link="L_shin" />
    <origin xyz="0.000000 0.000000 -0.160000" rpy="0 0 0" />
    <axis xyz="1 0 0" />
    <limit lower="0.000000" upper="2.090000" effort="0.0" velocity="0.700000" />
    <dynamics damping="0.1" friction="0.0" />
  </joint>
  <joint name="L_ANKLE_PITCH" type="revolute">
    <parent link="L_shin" />
    <child link="L_ankle_pitch_link" />
    <origin xyz="0.000000 0.000000 -0.155000" rpy="0 0 0" />
    <axis xyz="1 0 0" />
    <limit lower="-0.610000" upper="0.520000" effort="0.0" velocity="0.700000" />
    <dynamics damping="0.1" friction="0.0" />
  </joint>
  <joint name="L_ANKLE_ROLL" type="revolute">
    <parent link="L_ankle_pitch_link" />
    <child link="L_foot" />
    <origin xyz="0.000000 0.000000 -0.020000" rpy="0 0 0" />
    <axis xyz="0 1 0" />
    <limit lower="-0.350000" upper="0.350000" effort="0.0" velocity="0.700000" />
    <dynamics damping="0.1" friction="0.0" />
  </joint>
  <joint name="R_SHOULDER_PITCH" type="revolute">
    <parent link="torso" />
    <child link="R_shoulder_pitch_link" />
    <origin xyz="-0.090000 0.000000 0.165000" rpy="0 0 0" />
    <axis xyz="1 0 0" />
    <limit lower="-1.570000" upper="1.570000" effort="0.0" velocity="0.600000" />
    <dynamics damping="0.1" friction="0.0" />
  </joint>
  <joint name="R_SHOULDER_ROLL" type="revolute">
    <parent link="R_shoulder_pitch_link" />
    <child link="R_upper_arm" />
    <origin xyz="0.000000 0.000000 0.000000" rpy="0 0 0" />
    <axis xyz="0 1 0" />
    <limit lower="-1.220000" upper="1.220000" effort="0.0" velocity="0.600000" />
    <dynamics damping="0.1" friction="0.0" />
  </joint>
  <joint name="R_ELBOW_PITCH" type="revolute">
    <parent link="R_upper_arm" />
    <child link="R_forearm" />
    <origin xyz="-0.038000 0.000000 -0.145107" rpy="0 0 0" />
    <axis xyz="1 0 0" />
    <limit lower="0.000000" upper="2.200000" effort="0.0" velocity="0.800000" />
    <dynamics damping="0.1" friction="0.0" />
  </joint>
  <joint name="R_WRIST_ROTATION" type="revolute">
    <parent link="R_forearm" />
    <child link="R_hand" />
    <origin xyz="-0.005000 0.000000 -0.144914" rpy="0 0 0" />
    <axis xyz="0 0 1" />
    <limit lower="-1.570000" upper="1.570000" effort="0.0" velocity="1.000000" />
    <dynamics damping="0.1" friction="0.0" />
  </joint>
  <joint name="R_GRIPPER" type="prismatic">
    <parent link="R_hand" />
    <child link="R_gripper" />
    <origin xyz="0.000000 0.000000 -0.043000" rpy="0 0 0" />
    <axis xyz="-1.0 0 0" />
    <limit lower="0.000000" upper="0.026000" effort="0.0" velocity="0.030000" />
    <dynamics damping="0.1" friction="0.0" />
  </joint>
  <joint name="R_HIP_YAW" type="revolute">
    <parent link="base_link" />
    <child link="R_hip_yaw_link" />
    <origin xyz="-0.062500 0.000000 0.020000" rpy="0 0 0" />
    <axis xyz="0 0 1" />
    <limit lower="-0.520000" upper="0.520000" effort="0.0" velocity="0.500000" />
    <dynamics damping="0.1" friction="0.0" />
  </joint>
  <joint name="R_HIP_ROLL" type="revolute">
    <parent link="R_hip_yaw_link" />
    <child link="R_hip_roll_link" />
    <origin xyz="0.000000 0.000000 -0.020000" rpy="0 0 0" />
    <axis xyz="0 1 0" />
    <limit lower="-0.440000" upper="0.440000" effort="0.0" velocity="0.500000" />
    <dynamics damping="0.1" friction="0.0" />
  </joint>
  <joint name="R_HIP_PITCH" type="revolute">
    <parent link="R_hip_roll_link" />
    <child link="R_thigh" />
    <origin xyz="0.000000 0.000000 -0.020000" rpy="0 0 0" />
    <axis xyz="1 0 0" />
    <limit lower="-0.610000" upper="0.790000" effort="0.0" velocity="0.600000" />
    <dynamics damping="0.1" friction="0.0" />
  </joint>
  <joint name="R_KNEE_PITCH" type="revolute">
    <parent link="R_thigh" />
    <child link="R_shin" />
    <origin xyz="0.000000 0.000000 -0.160000" rpy="0 0 0" />
    <axis xyz="1 0 0" />
    <limit lower="0.000000" upper="2.090000" effort="0.0" velocity="0.700000" />
    <dynamics damping="0.1" friction="0.0" />
  </joint>
  <joint name="R_ANKLE_PITCH" type="revolute">
    <parent link="R_shin" />
    <child link="R_ankle_pitch_link" />
    <origin xyz="0.000000 0.000000 -0.155000" rpy="0 0 0" />
    <axis xyz="1 0 0" />
    <limit lower="-0.610000" upper="0.520000" effort="0.0" velocity="0.700000" />
    <dynamics damping="0.1" friction="0.0" />
  </joint>
  <joint name="R_ANKLE_ROLL" type="revolute">
    <parent link="R_ankle_pitch_link" />
    <child link="R_foot" />
    <origin xyz="0.000000 0.000000 -0.020000" rpy="0 0 0" />
    <axis xyz="0 1 0" />
    <limit lower="-0.350000" upper="0.350000" effort="0.0" velocity="0.700000" />
    <dynamics damping="0.1" friction="0.0" />
  </joint>
</robot>
