amyleesterling/humanoid-robot/electrical/kicad/hr-v0-runtime-observation-interface-p0.1/output/hr-v0-runtime-observation-interface-p0.1-preliminary.pdf

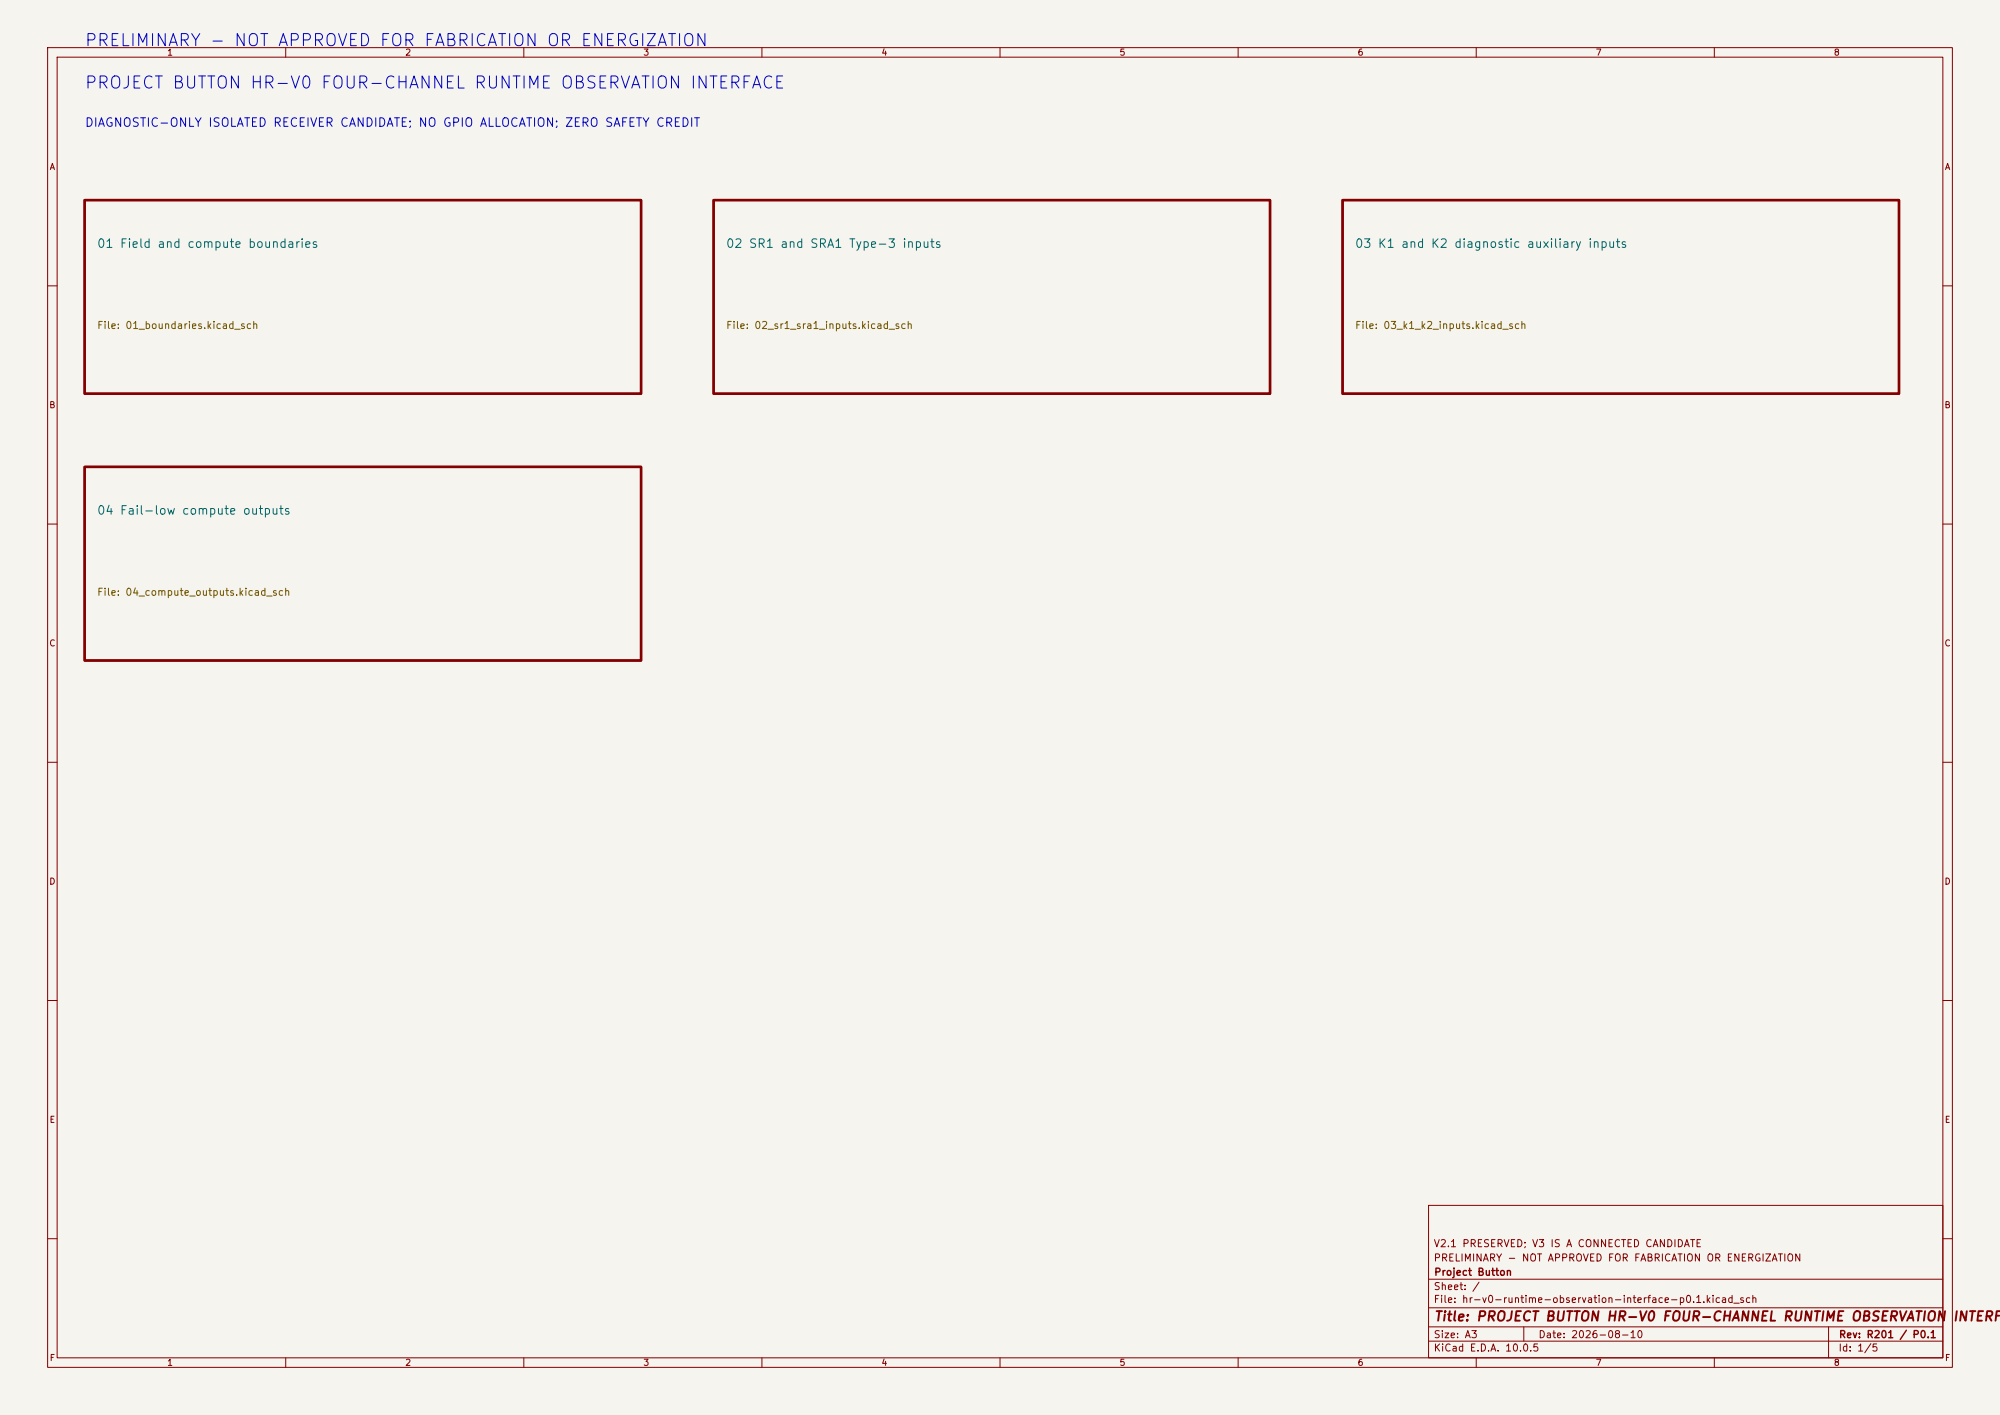
[picture p126: page 1]

PRELIMINARY - NOT APPROVED FOR FABRICATION OR ENERGIZATION

PROJECT BUTTON HR-V0 FOUR-CHANNEL RUNTIME OBSERVATION INTERFACE

DIAGNOSTIC-ONLY ISOLATED RECEIVER CANDIDATE; NO GPIO ALLOCATION; ZERO SAFETY CREDIT

01 Field and compute boundaries

03 K1 and K2 diagnostic auxiliary inputs

04 Fail-low compute outputs

V2.1 PRESERVED; V3 IS A CONNECTED CANDIDATE
Project Button
Sheet: /
File: hr-v0-runtime-observation-interface-p0.1.kicad_sch
Title: PROJECT BUTTON HR-V0 FOUR-CHANNEL RUNTIME OBSERVATION INTERFACE index

Size: A3 | Rev: R201 / P0.1 | F Date: 2026-08-10
KiCad E.D.A. 10.0.5 | Id: 1/5

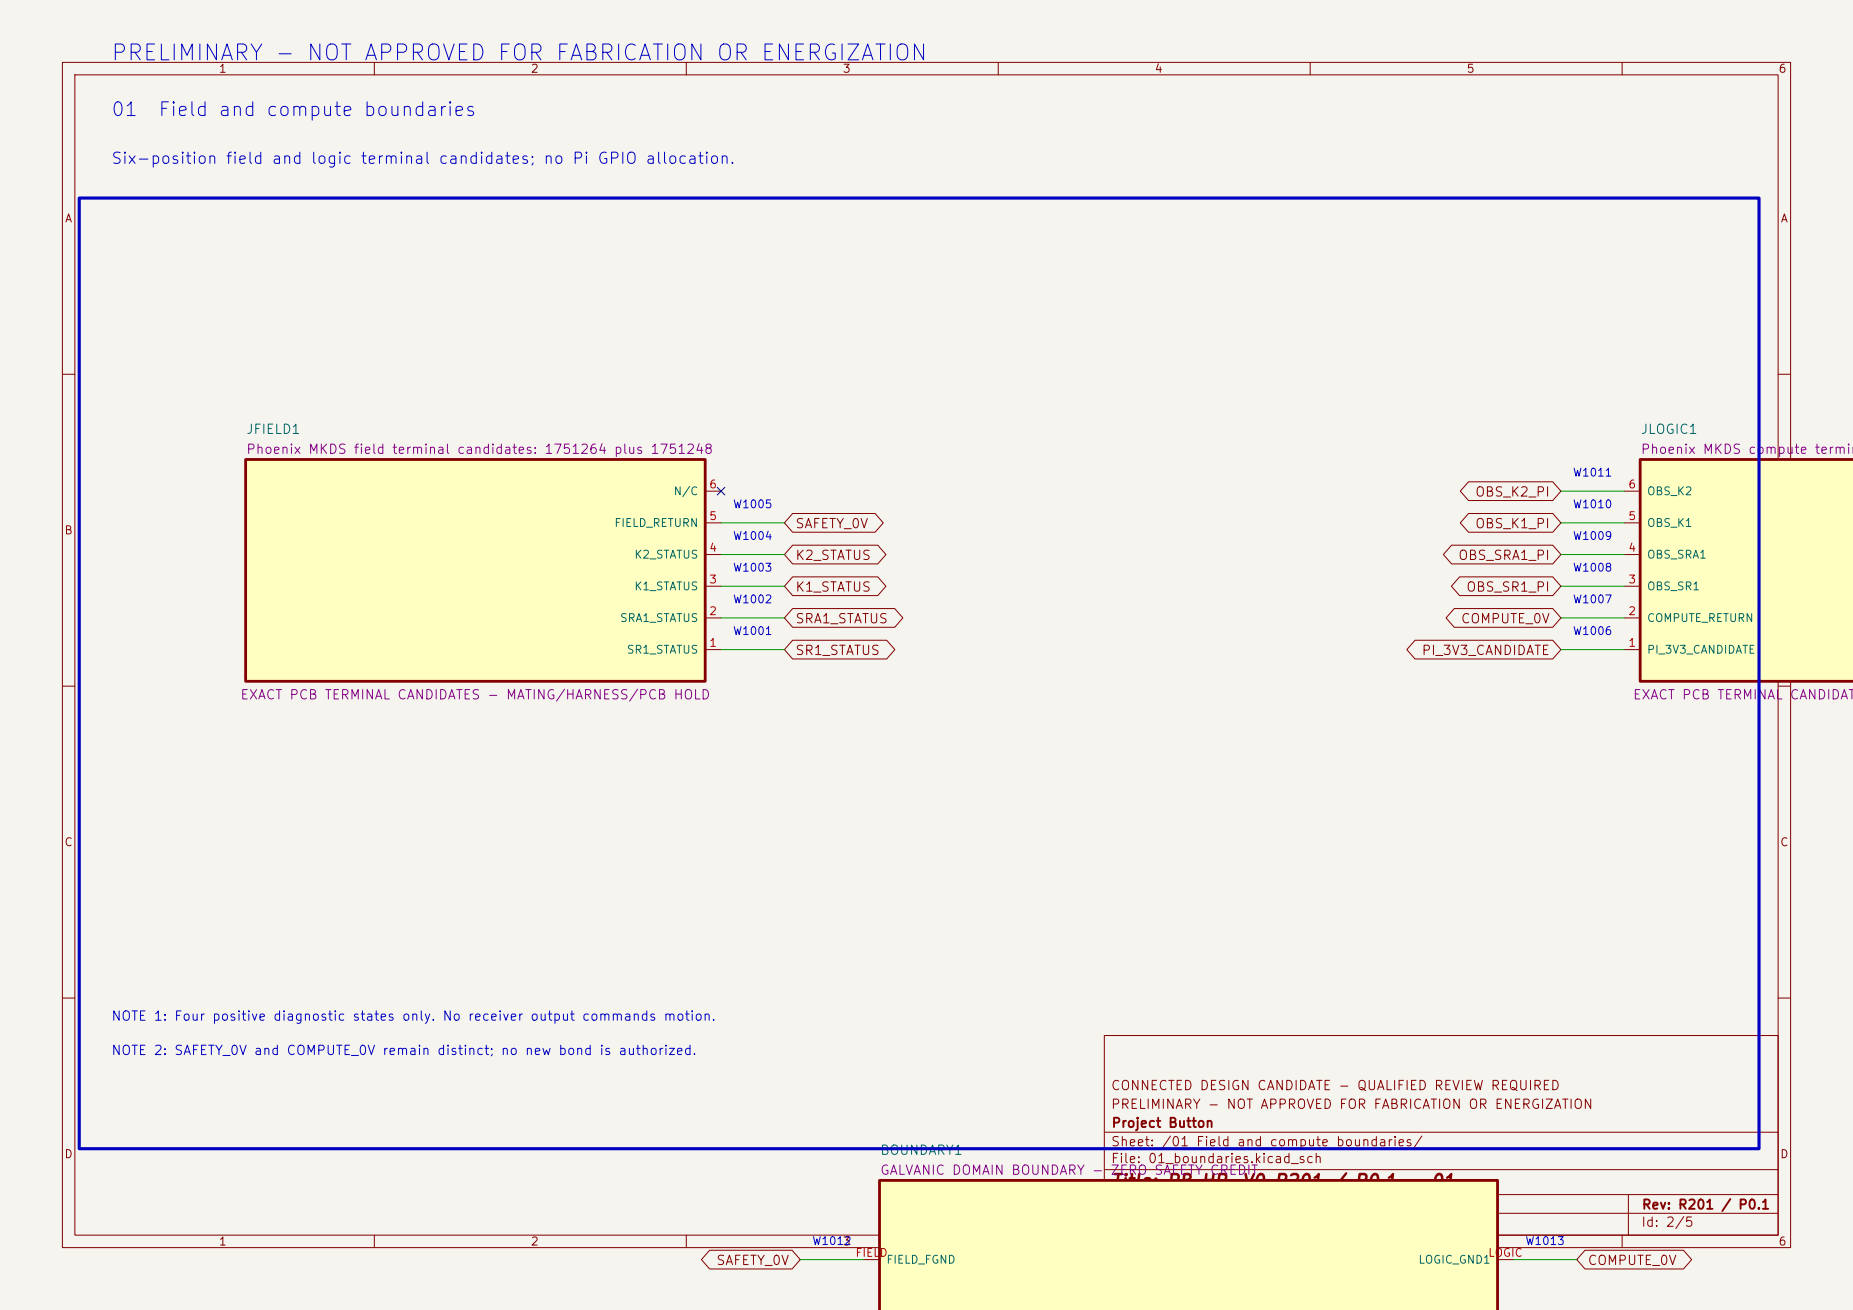
[picture p127: page 2]

01 Field and compute boundaries

JFIELD1
Phoenix MKDS field terminal candidates: 1751264 plus 1751248

JLOGIC1
Phoenix MKDS compute terminal candidates: 1751264 plus 1751248

W1010 NOTE 2: SAFETY_0V and COMPUTE_0V remain distinct; no new bond is authorized.

EXACT PCB TERMINAL CANDIDATES - MATING/HARNESS/PCB HOLD

EXACT PCB TERMINAL CANDIDATES - PI PINS/HARNESS/PCB HOLD

CONNECTED DESIGN CANDIDATE - QUALIFIED REVIEW REQUIRED PRELIMINARY - NOT APPROVED FOR FABRICATION OR ENERGIZATION Project Button

Sheet: /01 Field and compute boundaries/

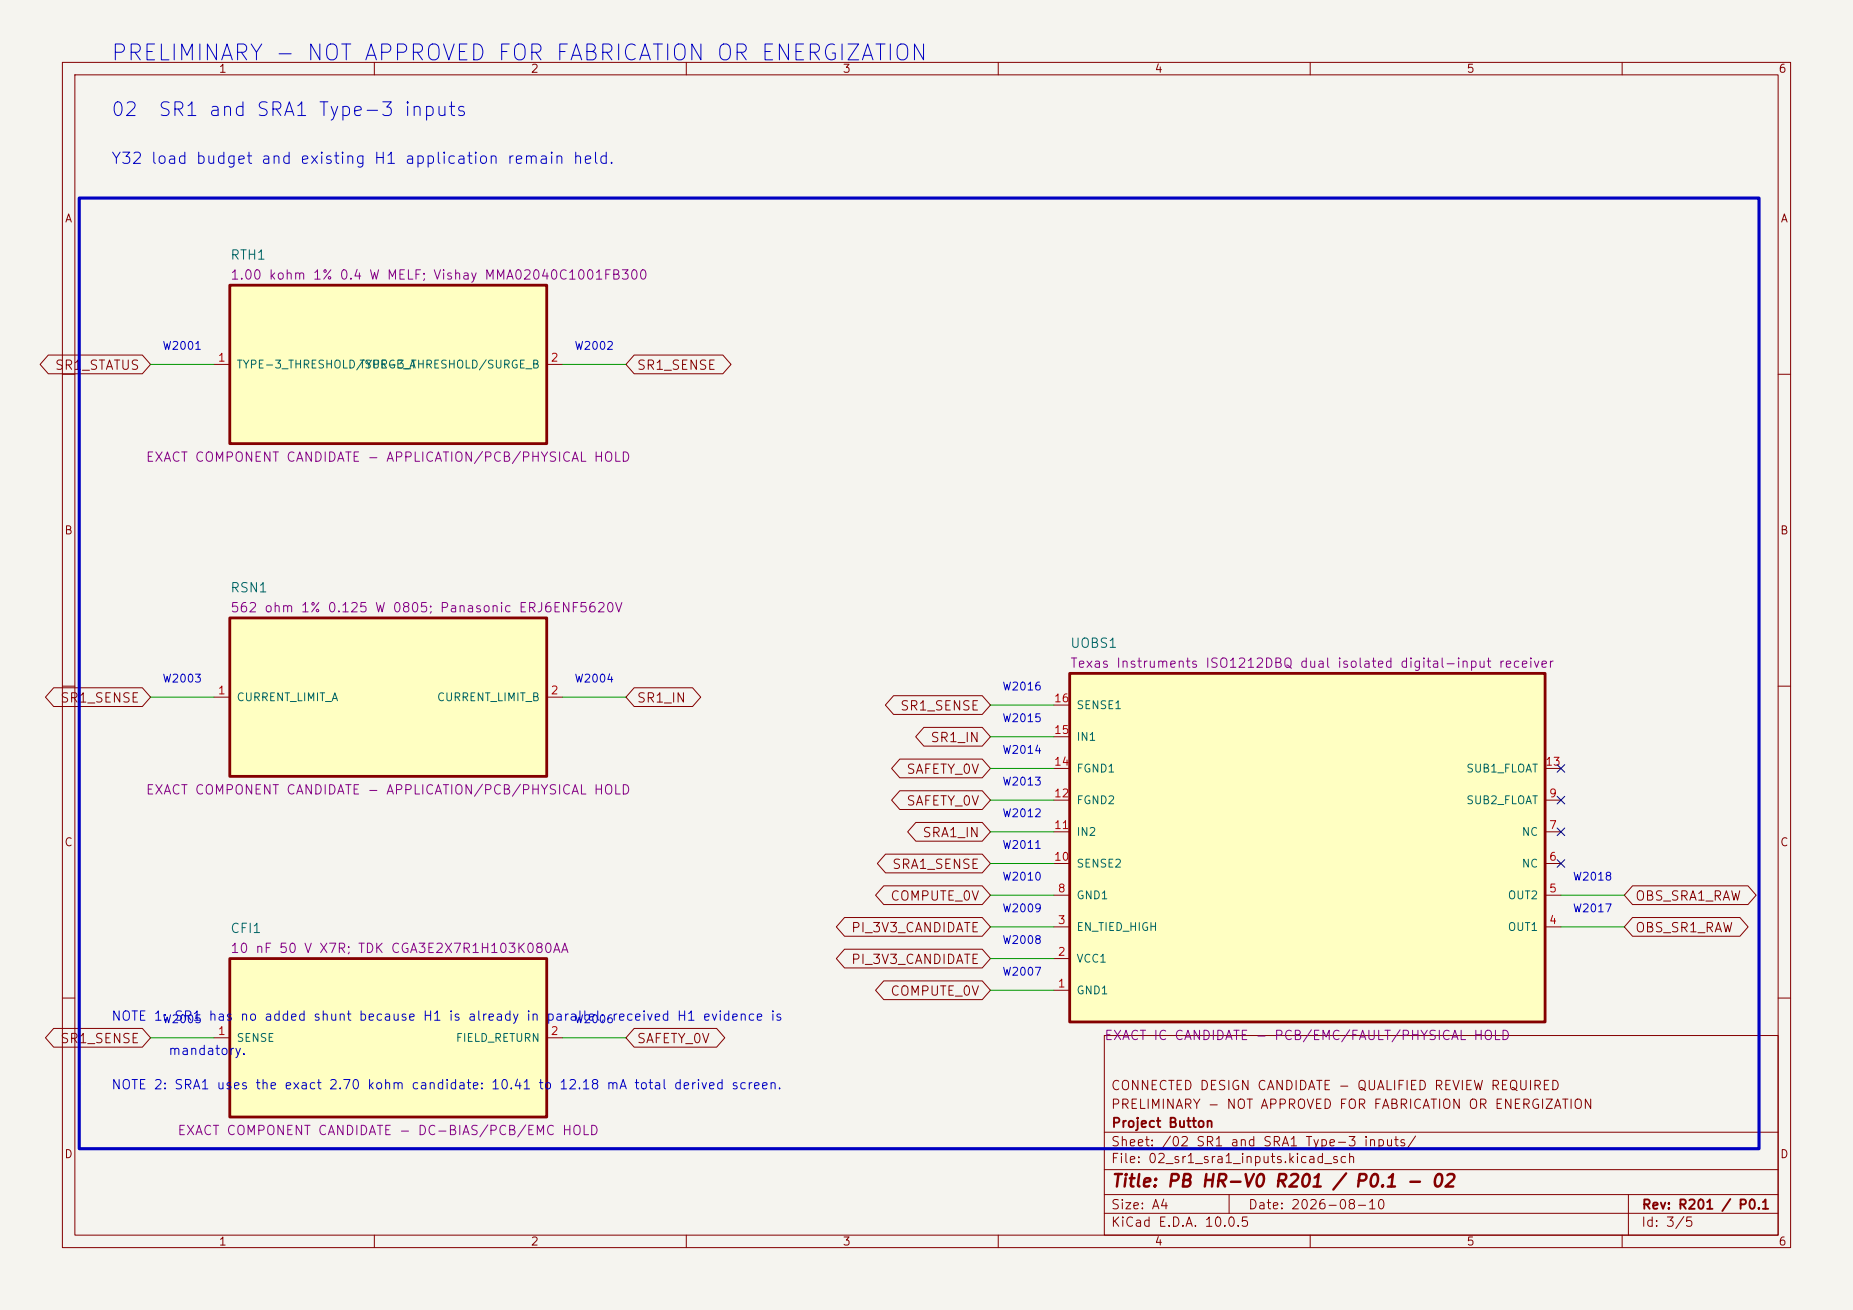
[picture p128: page 3]

EXACT COMPONENT CANDIDATE - APPLICATION/PCB/PHYSICAL HOLD

EXACT IC CANDIDATE - PCB/EMC/FAULT/PHYSICAL HOLD

CONNECTED DESIGN CANDIDATE - QUALIFIED REVIEW REQUIRED PRELIMINARY - NOT APPROVED FOR FABRICATION OR ENERGIZATION Project Button

EXACT COMPONENT CANDIDATE - DC-BIAS/PCB/EMC HOLD

Sheet: /02 SR1 and SRA1 Type-3 inputs/

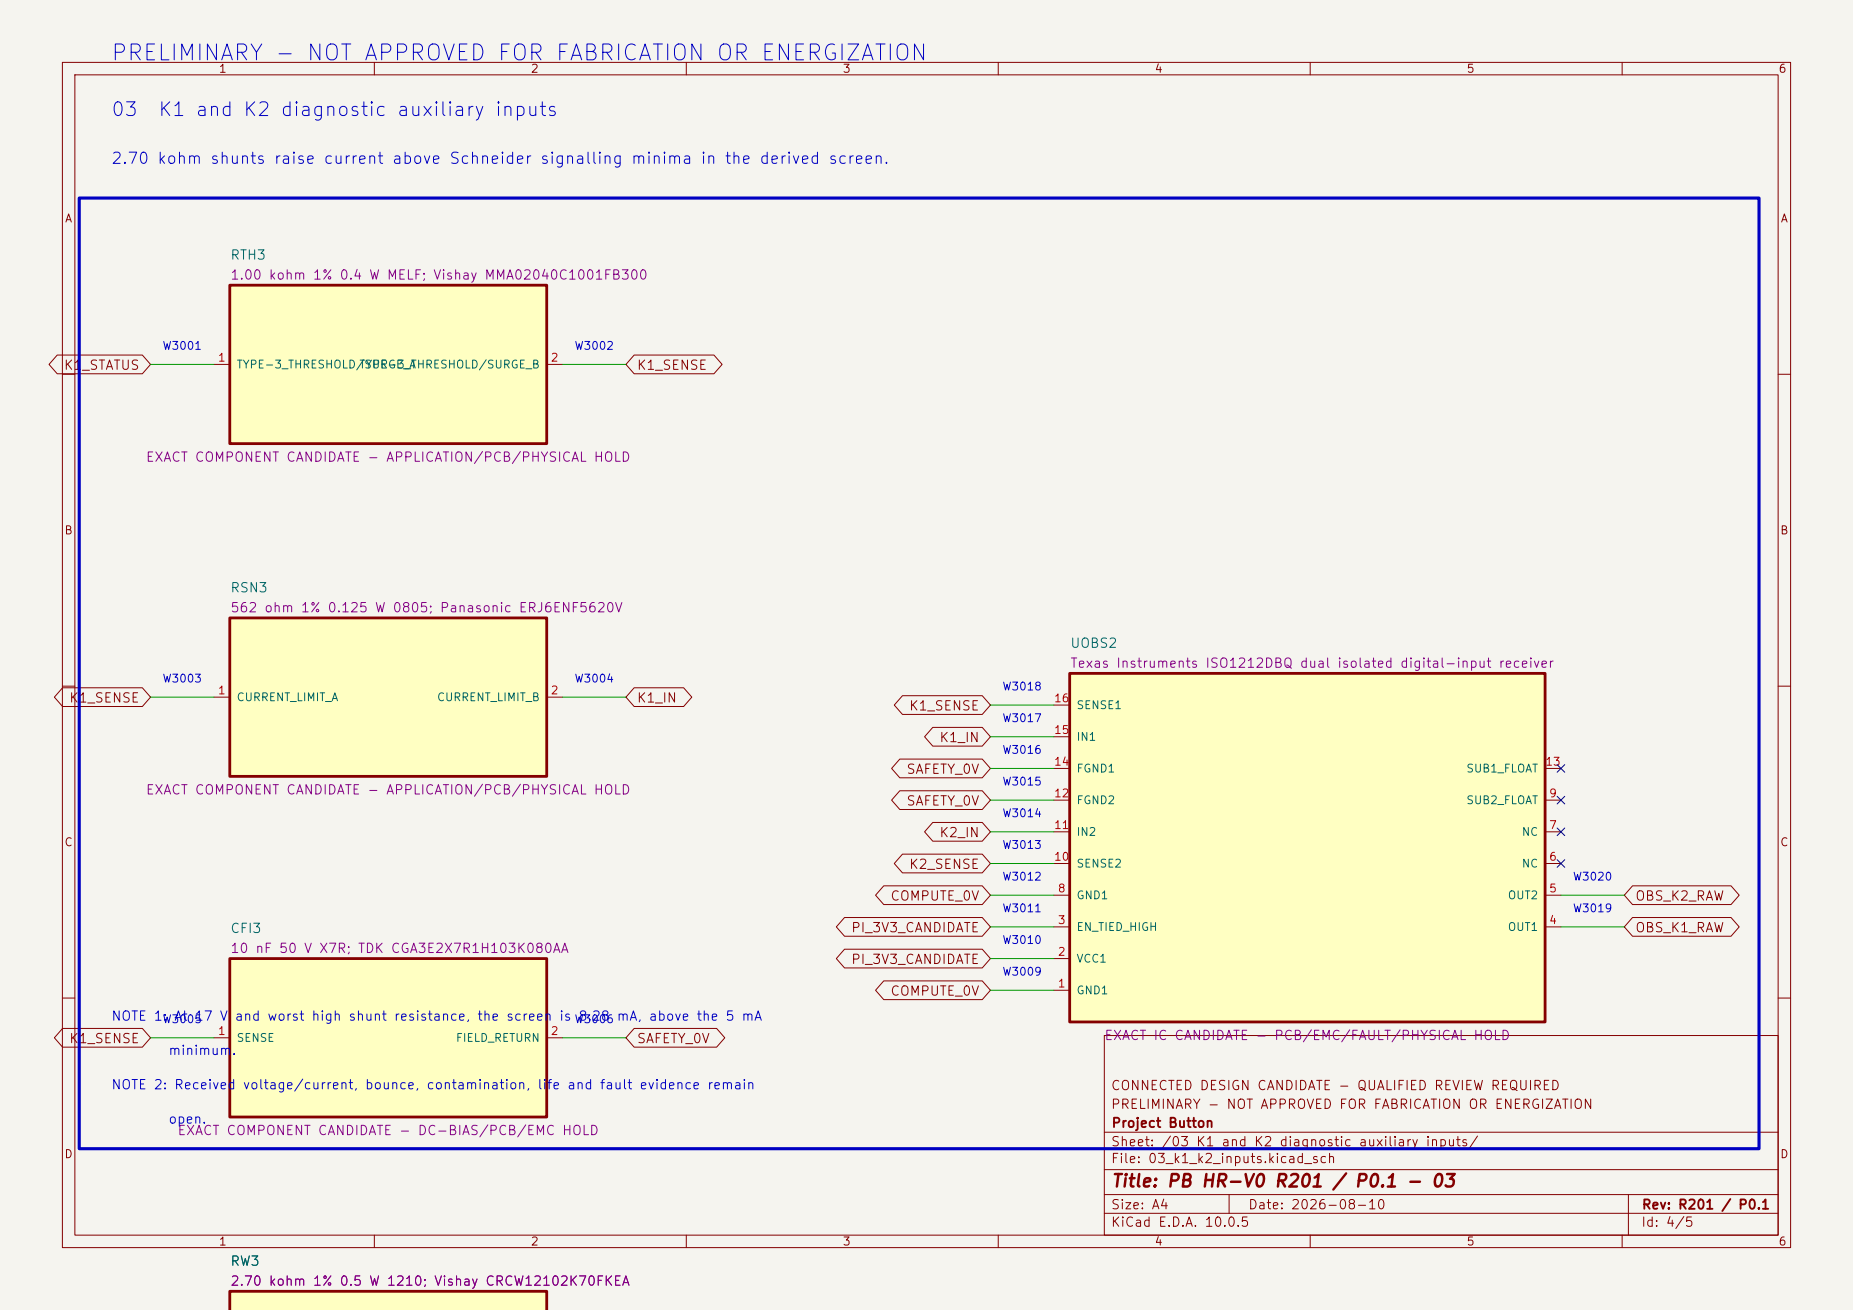
[picture p129: page 4]

03 K1 and K2 diagnostic auxiliary inputs

2.70 kohm shunts raise current above Schneider signalling minima in the derived screen.

EXACT COMPONENT CANDIDATE - APPLICATION/PCB/PHYSICAL HOLD

Texas Instruments ISO1212DBQ dual isolated digital-input receiver

EXACT IC CANDIDATE - PCB/EMC/FAULT/PHYSICAL HOLD

CONNECTED DESIGN CANDIDATE - QUALIFIED REVIEW REQUIRED PRELIMINARY - NOT APPROVED FOR FABRICATION OR ENERGIZATION Project Button

EXACT COMPONENT CANDIDATE - DC-BIAS/PCB/EMC HOLD

Sheet: /03 K1 and K2 diagnostic auxiliary inputs/

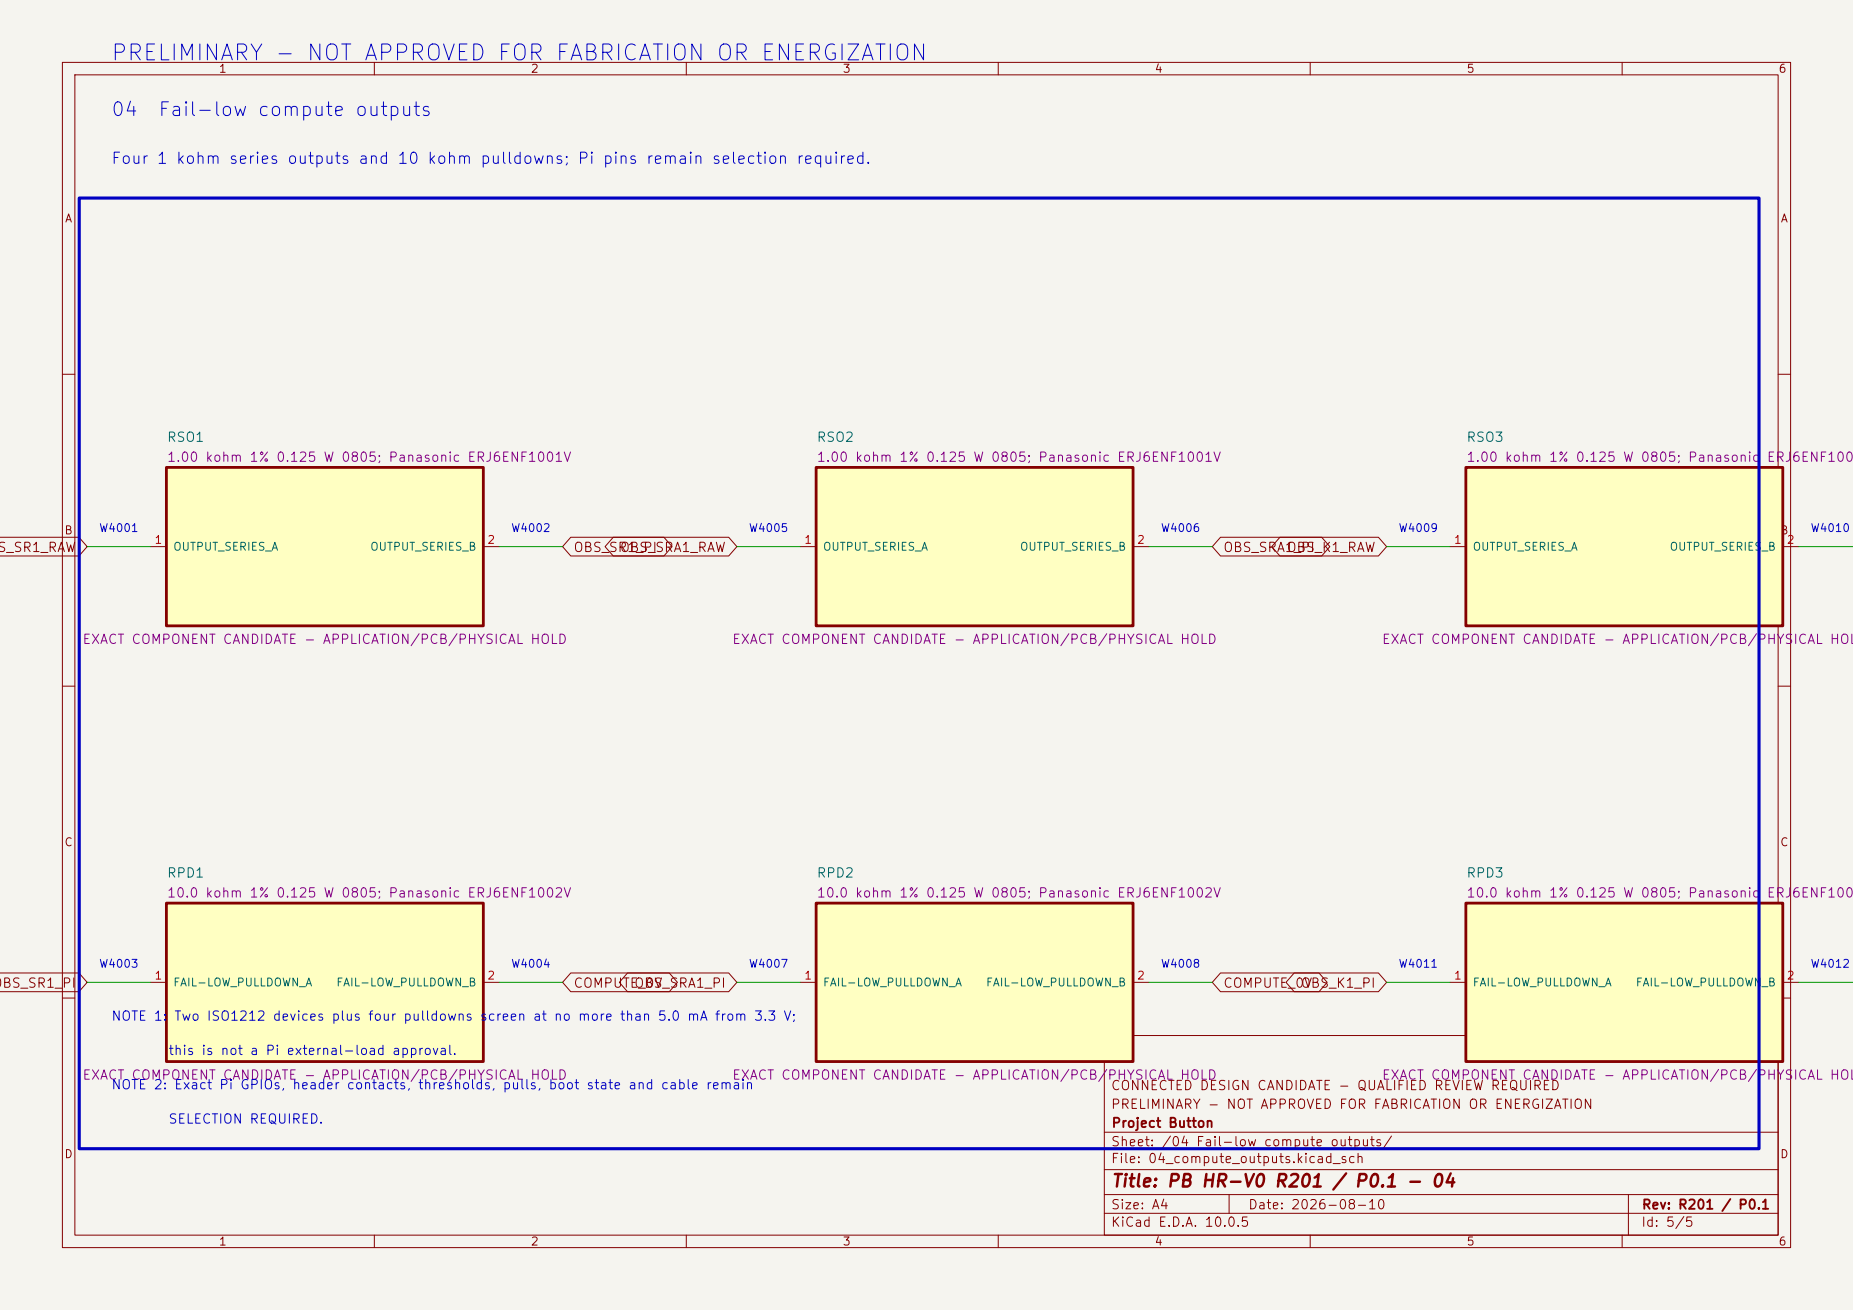
[picture p130: page 5]

W4001 PRELIMINARY - NOT APPROVED FOR FABRICATION OR ENERGIZATION

04 Fail-low compute outputs

EXACT COMPONENT CANDIDATE - APPLICATION/PCB/PHYSICAL HOLD

CONNECTED DESIGN CANDIDATE - QUALIFIED REVIEW REQUIRED PRELIMINARY - NOT APPROVED FOR FABRICATION OR ENERGIZATION Project Button

Sheet: /04 Fail-low compute outputs/
