amyleesterling/humanoid-robot/electrical/kicad/project-button-v3-p1.16-observation-candidate/output/project-button-v3-p1.16-observation-candidate-preliminary.pdf

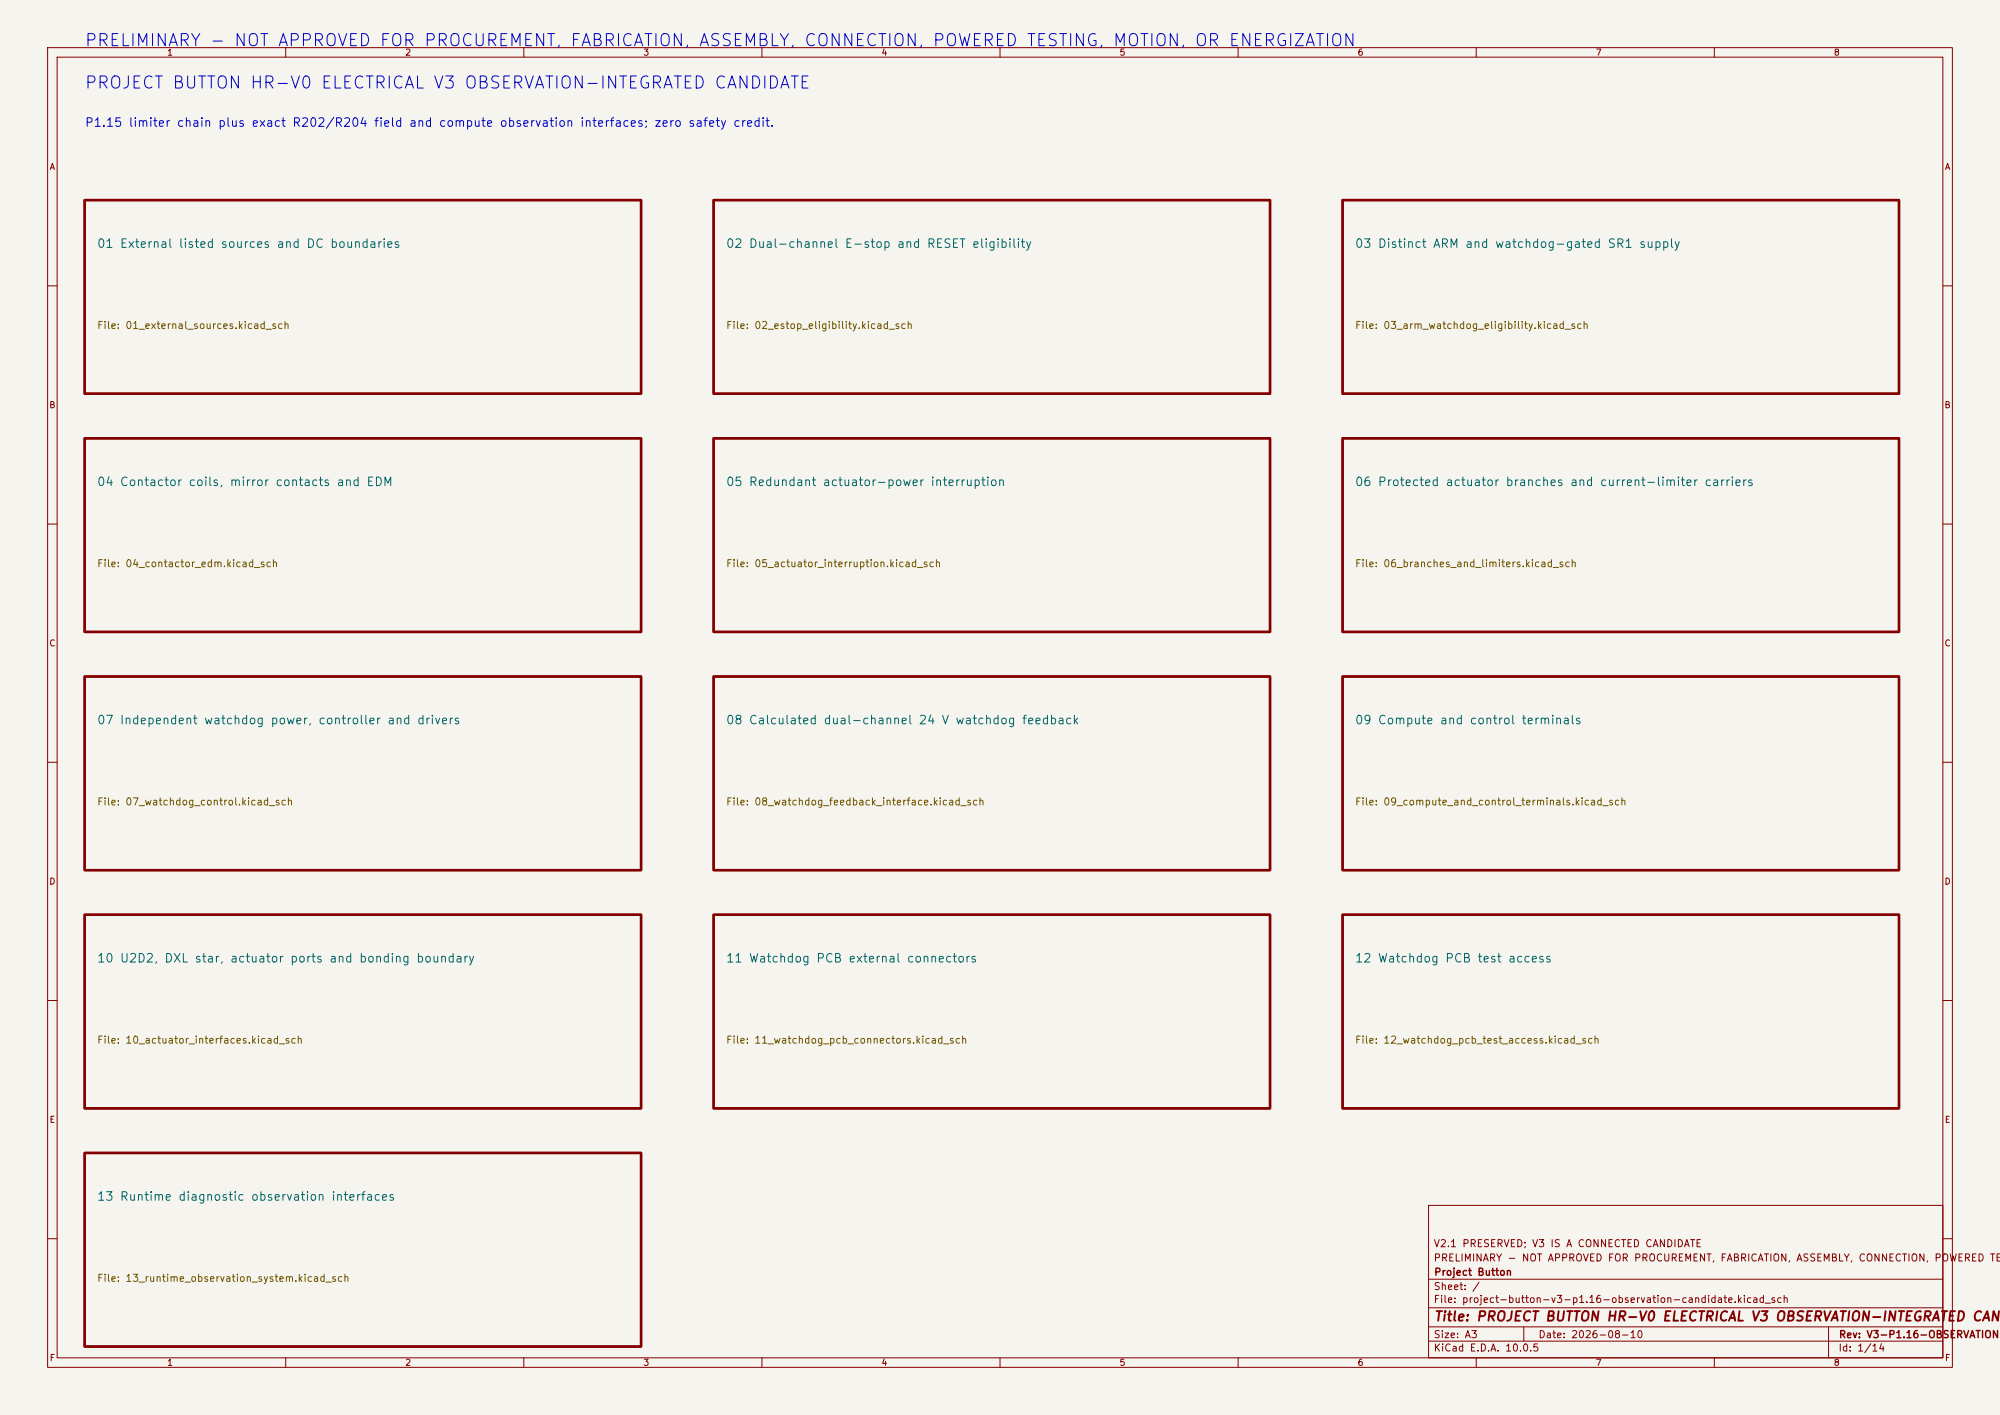
[picture p131: page 1]

PRELIMINARY - NOT APPROVED FOR PROCUREMENT, FABRICATION, ASSEMBLY, CONNECTION, POWERED TESTING, MOTION, OR ENERGIZATION

PROJECT BUTTON HR-V0 ELECTRICAL V3 OBSERVATION-INTEGRATED CANDIDATE

P1.15 limiter chain plus exact R202/R204 field and compute observation interfaces; zero safety credit.

01 External listed sources and DC boundaries

02 Dual-channel E-stop and RESET eligibility

03 Distinct ARM and watchdog-gated SR1 supply

04 Contactor coils, mirror contacts and EDM

05 Redundant actuator-power interruption

06 Protected actuator branches and current-limiter carriers

07 Independent watchdog power, controller and drivers

08 Calculated dual-channel 24 V watchdog feedback

09 Compute and control terminals

10 U2D2, DXL star, actuator ports and bonding boundary

11 Watchdog PCB external connectors

12 Watchdog PCB test access

13 Runtime diagnostic observation interfaces

V2.1 PRESERVED; V3 IS A CONNECTED CANDIDATE
Project Button
Sheet: /
File: project-button-v3-p1.16-observation-candidate.kicad_sch
Title: PROJECT BUTTON HR-V0 ELECTRICAL V3 OBSERVATION-INTEGRATED CANDIDATE index

F Date: 2026-08-10

KiCad E.D.A. 10.0.5 | Id: 1/14

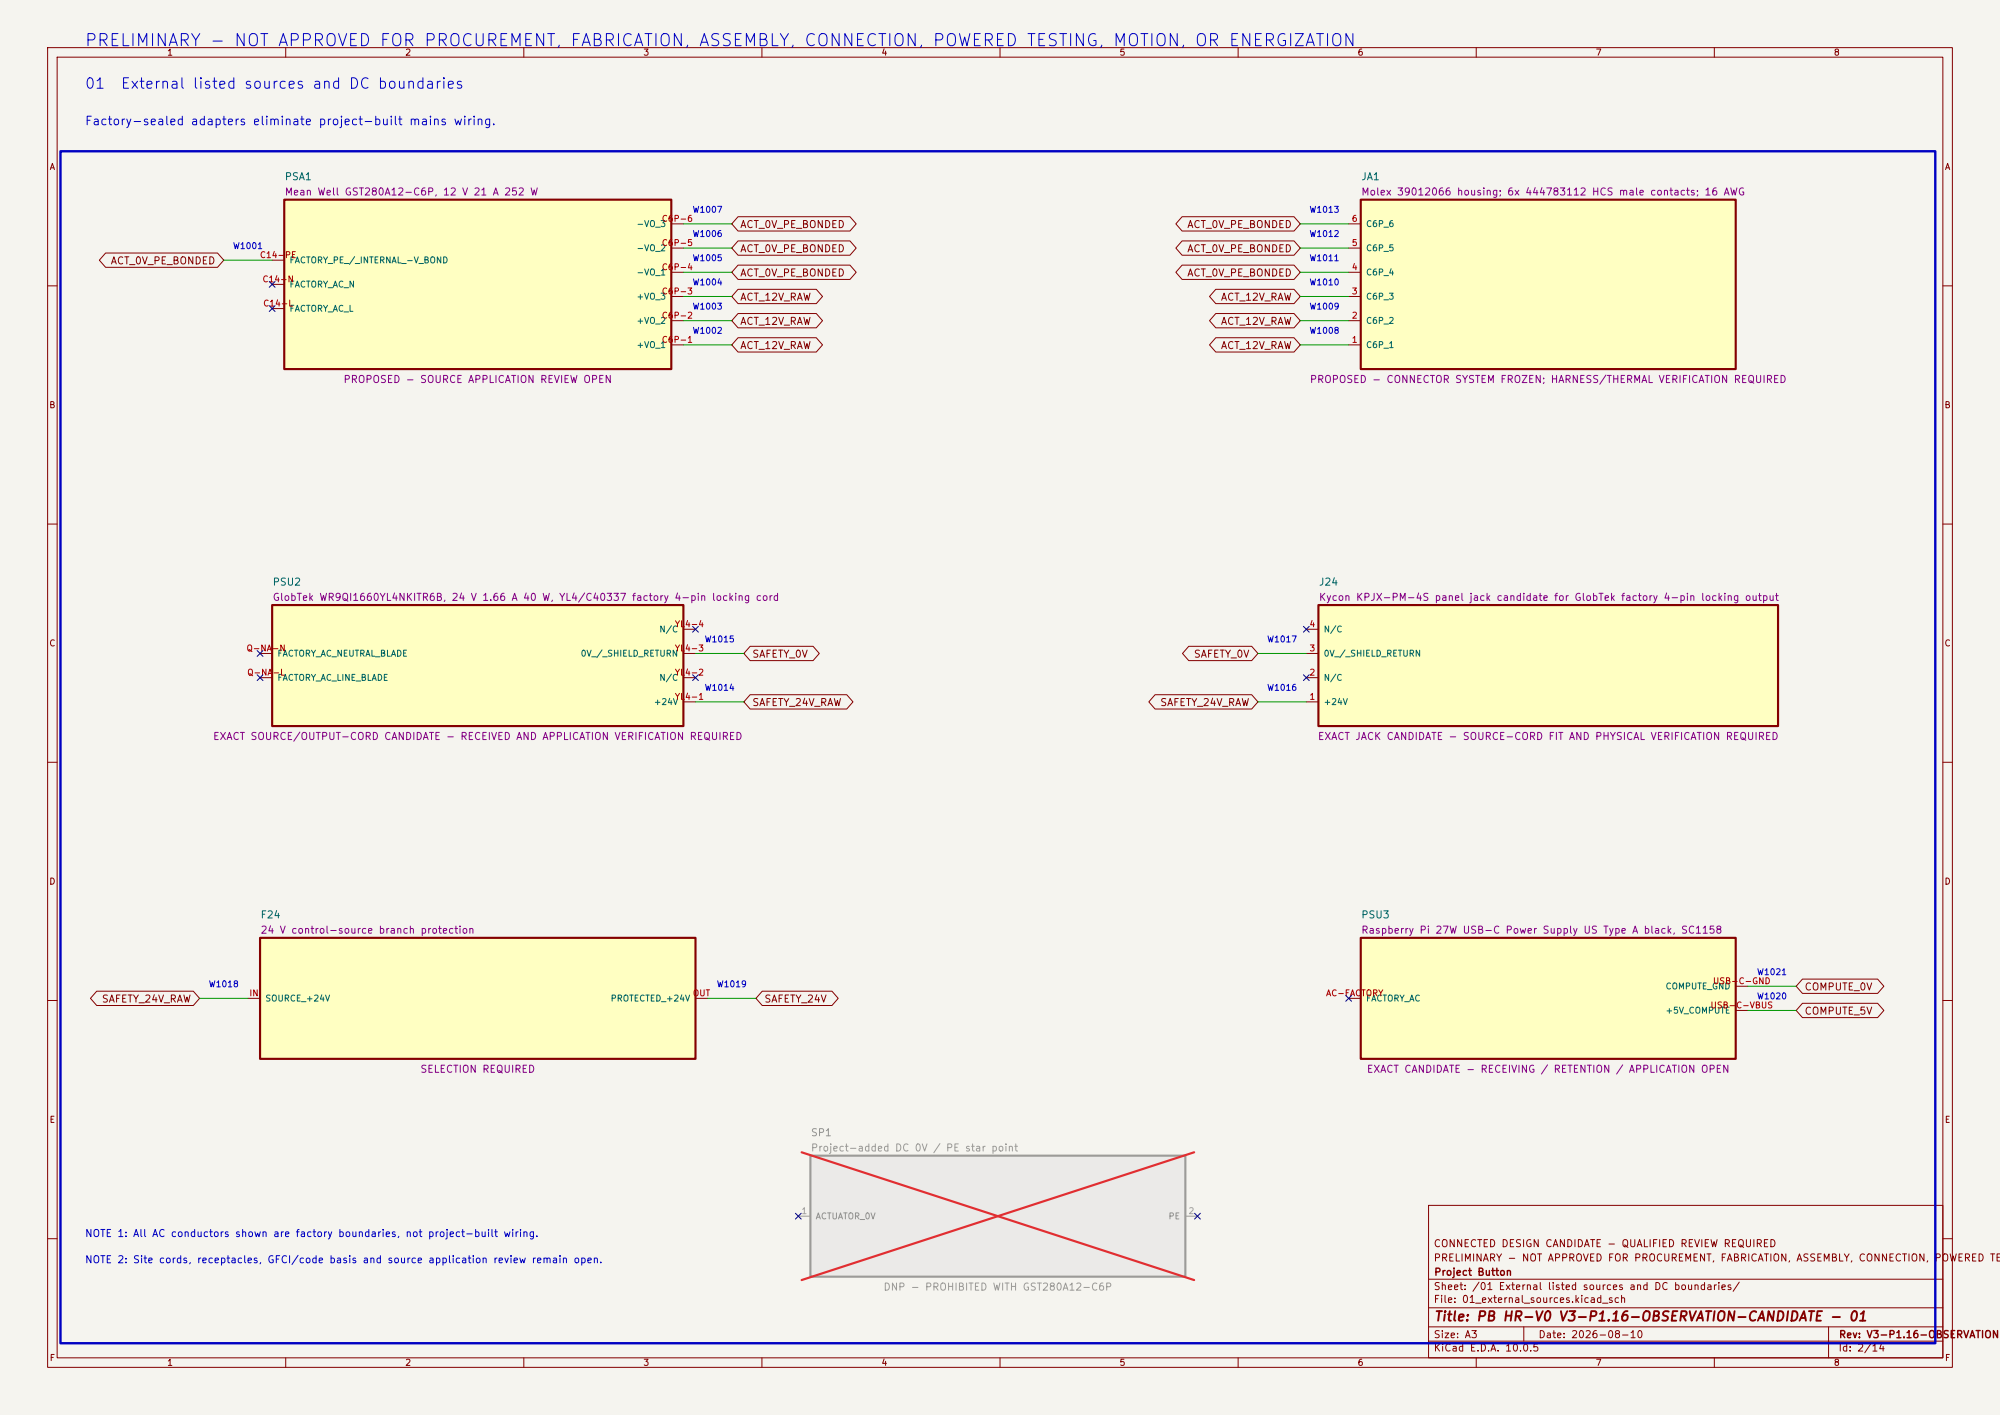
[picture p132: page 2]

01 External listed sources and DC boundaries

SAFETY_0V W1004 W1003 W1002 W1001 Factory-sealed adapters eliminate project-built mains wiring.

Molex 39012066 housing; 6x 444783112 HCS male contacts; 16 AWG +VO_1C6P-1 +VO_2C6P-2 +VO_3C6P-3 -VO_1C6P-4 -VO_2C6P-5 -VO_3C6P-6

PROPOSED - SOURCE APPLICATION REVIEW OPEN

PROPOSED - CONNECTOR SYSTEM FROZEN; HARNESS/THERMAL VERIFICATION REQUIRED

Kycon KPJX-PM-4S panel jack candidate for GlobTek factory 4-pin locking output

EXACT SOURCE/OUTPUT-CORD CANDIDATE - RECEIVED AND APPLICATION VERIFICATION REQUIRED

EXACT JACK CANDIDATE - SOURCE-CORD FIT AND PHYSICAL VERIFICATION REQUIRED

24 V control-source branch protection

Raspberry Pi 27W USB-C Power Supply US Type A black, SC1158

EXACT CANDIDATE - RECEIVING / RETENTION / APPLICATION OPEN

Project-added DC 0V / PE star point

NOTE 1: All AC conductors shown are factory boundaries, not project-built wiring.

CONNECTED DESIGN CANDIDATE - QUALIFIED REVIEW REQUIRED
Project Button
Sheet: /01 External listed sources and DC boundaries/
File: 01_external_sources.kicad_sch
Title: PB HR-V0 V3-P1.16-OBSERVATION-CANDIDATE - 01

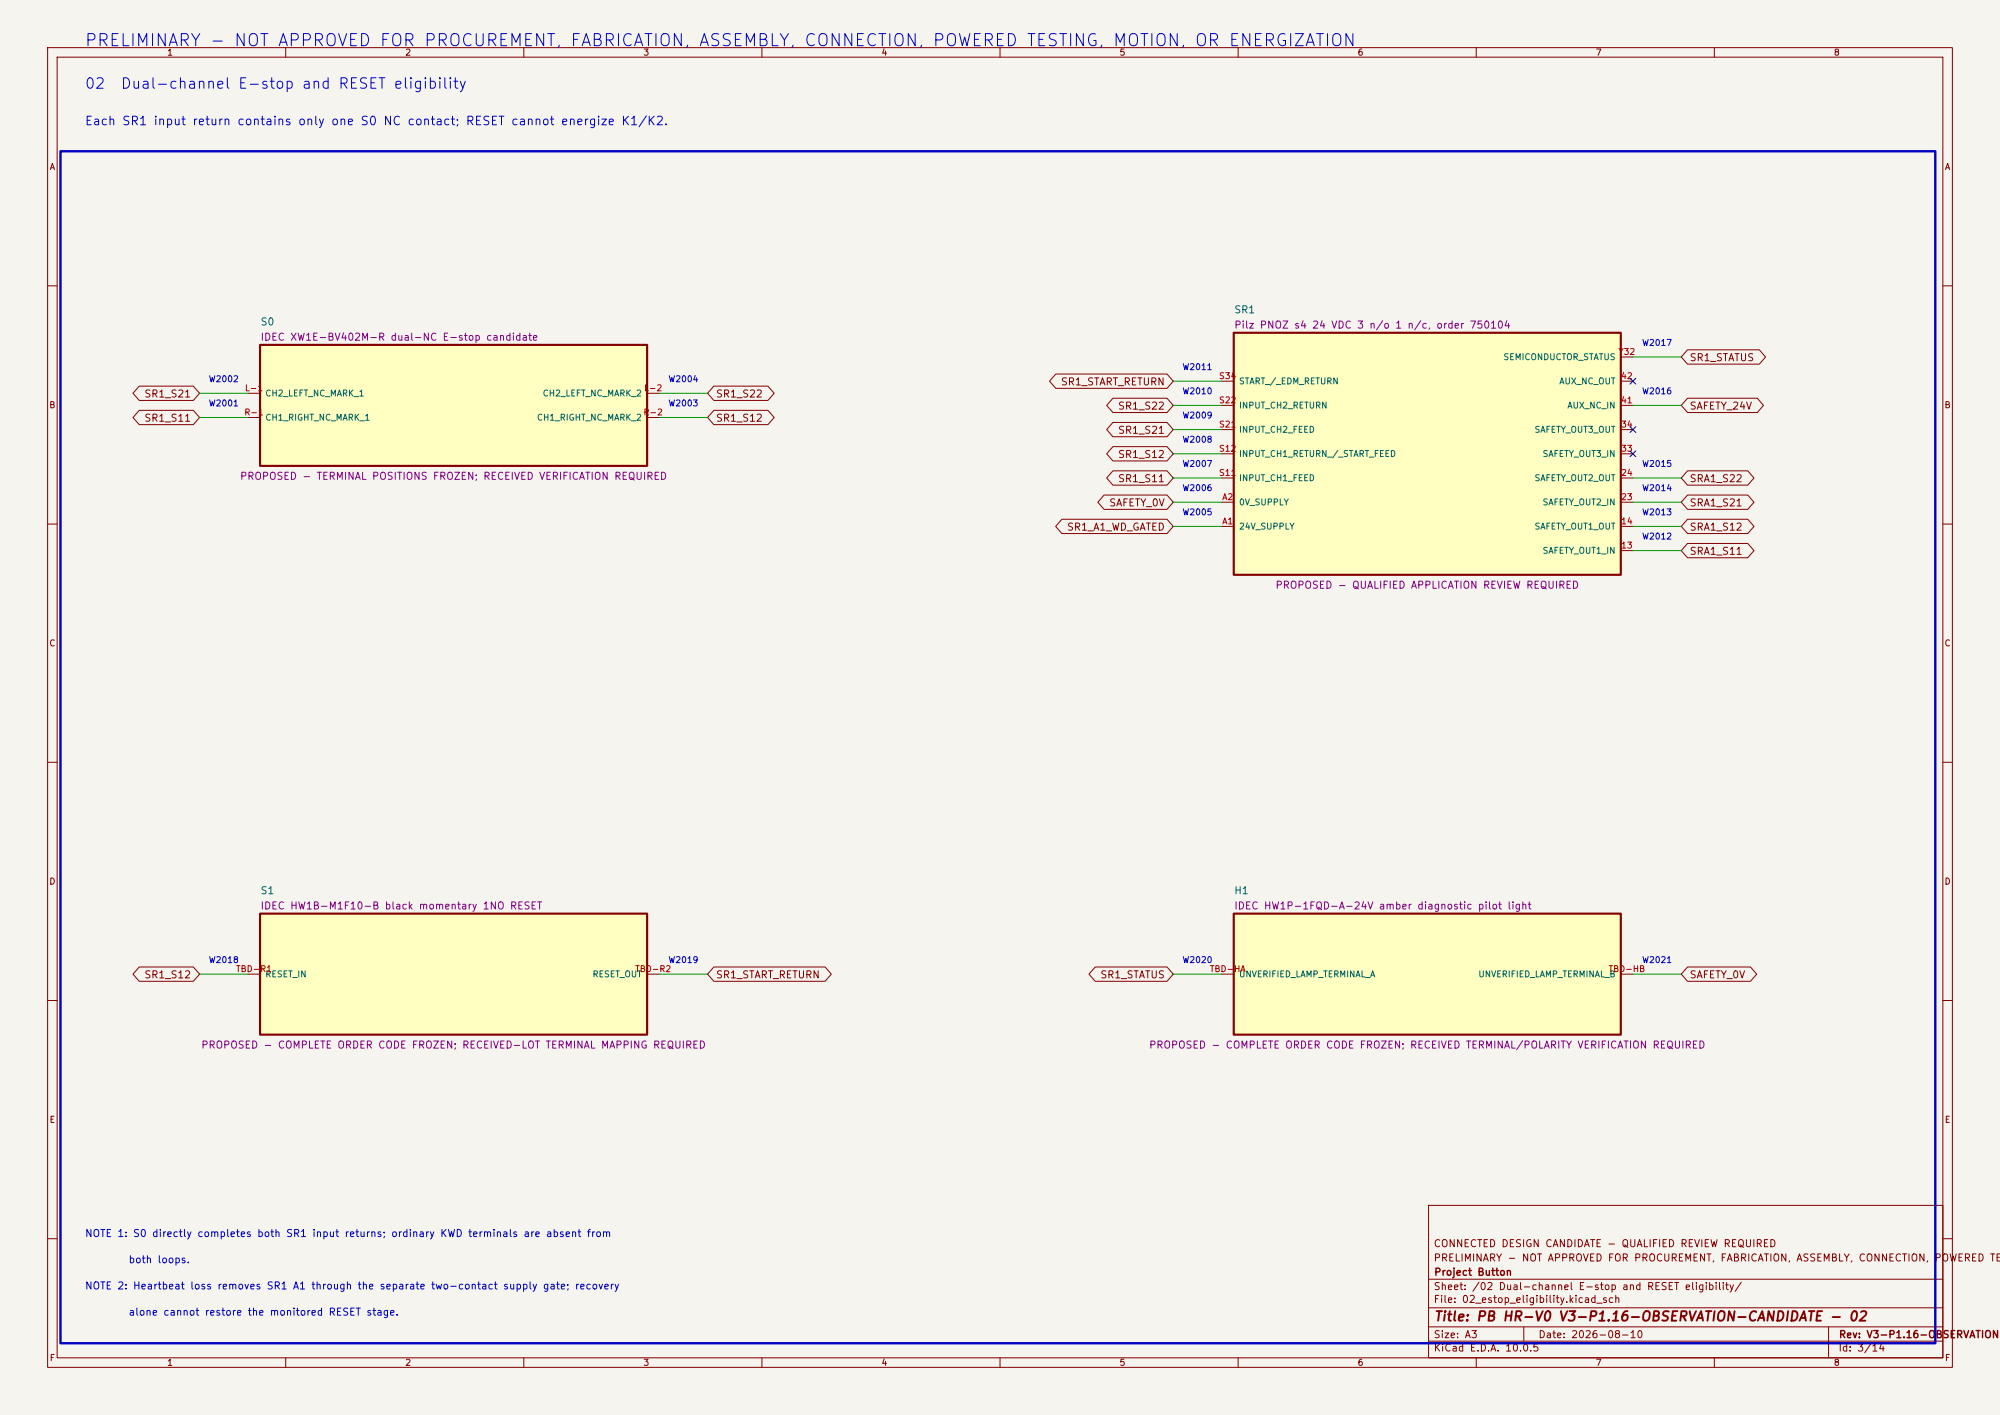
[picture p133: page 3]

02 Dual-channel E-stop and RESET eligibility

W2012 Each SR1 input return contains only one S0 NC contact; RESET cannot energize K1/K2.

SEMICONDUCTOR_STATUS Y32 SR1
Pilz PNOZ s4 24 VDC 3 n/o 1 n/c, order 750104

IDEC XW1E-BV402M-R dual-NC E-stop candidate

PROPOSED - TERMINAL POSITIONS FROZEN; RECEIVED VERIFICATION REQUIRED

PROPOSED - QUALIFIED APPLICATION REVIEW REQUIRED

PROPOSED - COMPLETE ORDER CODE FROZEN; RECEIVED-LOT TERMINAL MAPPING REQUIRED

PROPOSED - COMPLETE ORDER CODE FROZEN; RECEIVED TERMINAL/POLARITY VERIFICATION REQUIRED

NOTE 1: S0 directly completes both SR1 input returns; ordinary KWD terminals are absent from

CONNECTED DESIGN CANDIDATE - QUALIFIED REVIEW REQUIRED Project Button

NOTE 2: Heartbeat loss removes SR1 A1 through the separate two-contact supply gate; recovery

Sheet: /02 Dual-channel E-stop and RESET eligibility/ File: 02_estop_eligibility.kicad_sch

alone cannot restore the monitored RESET stage.

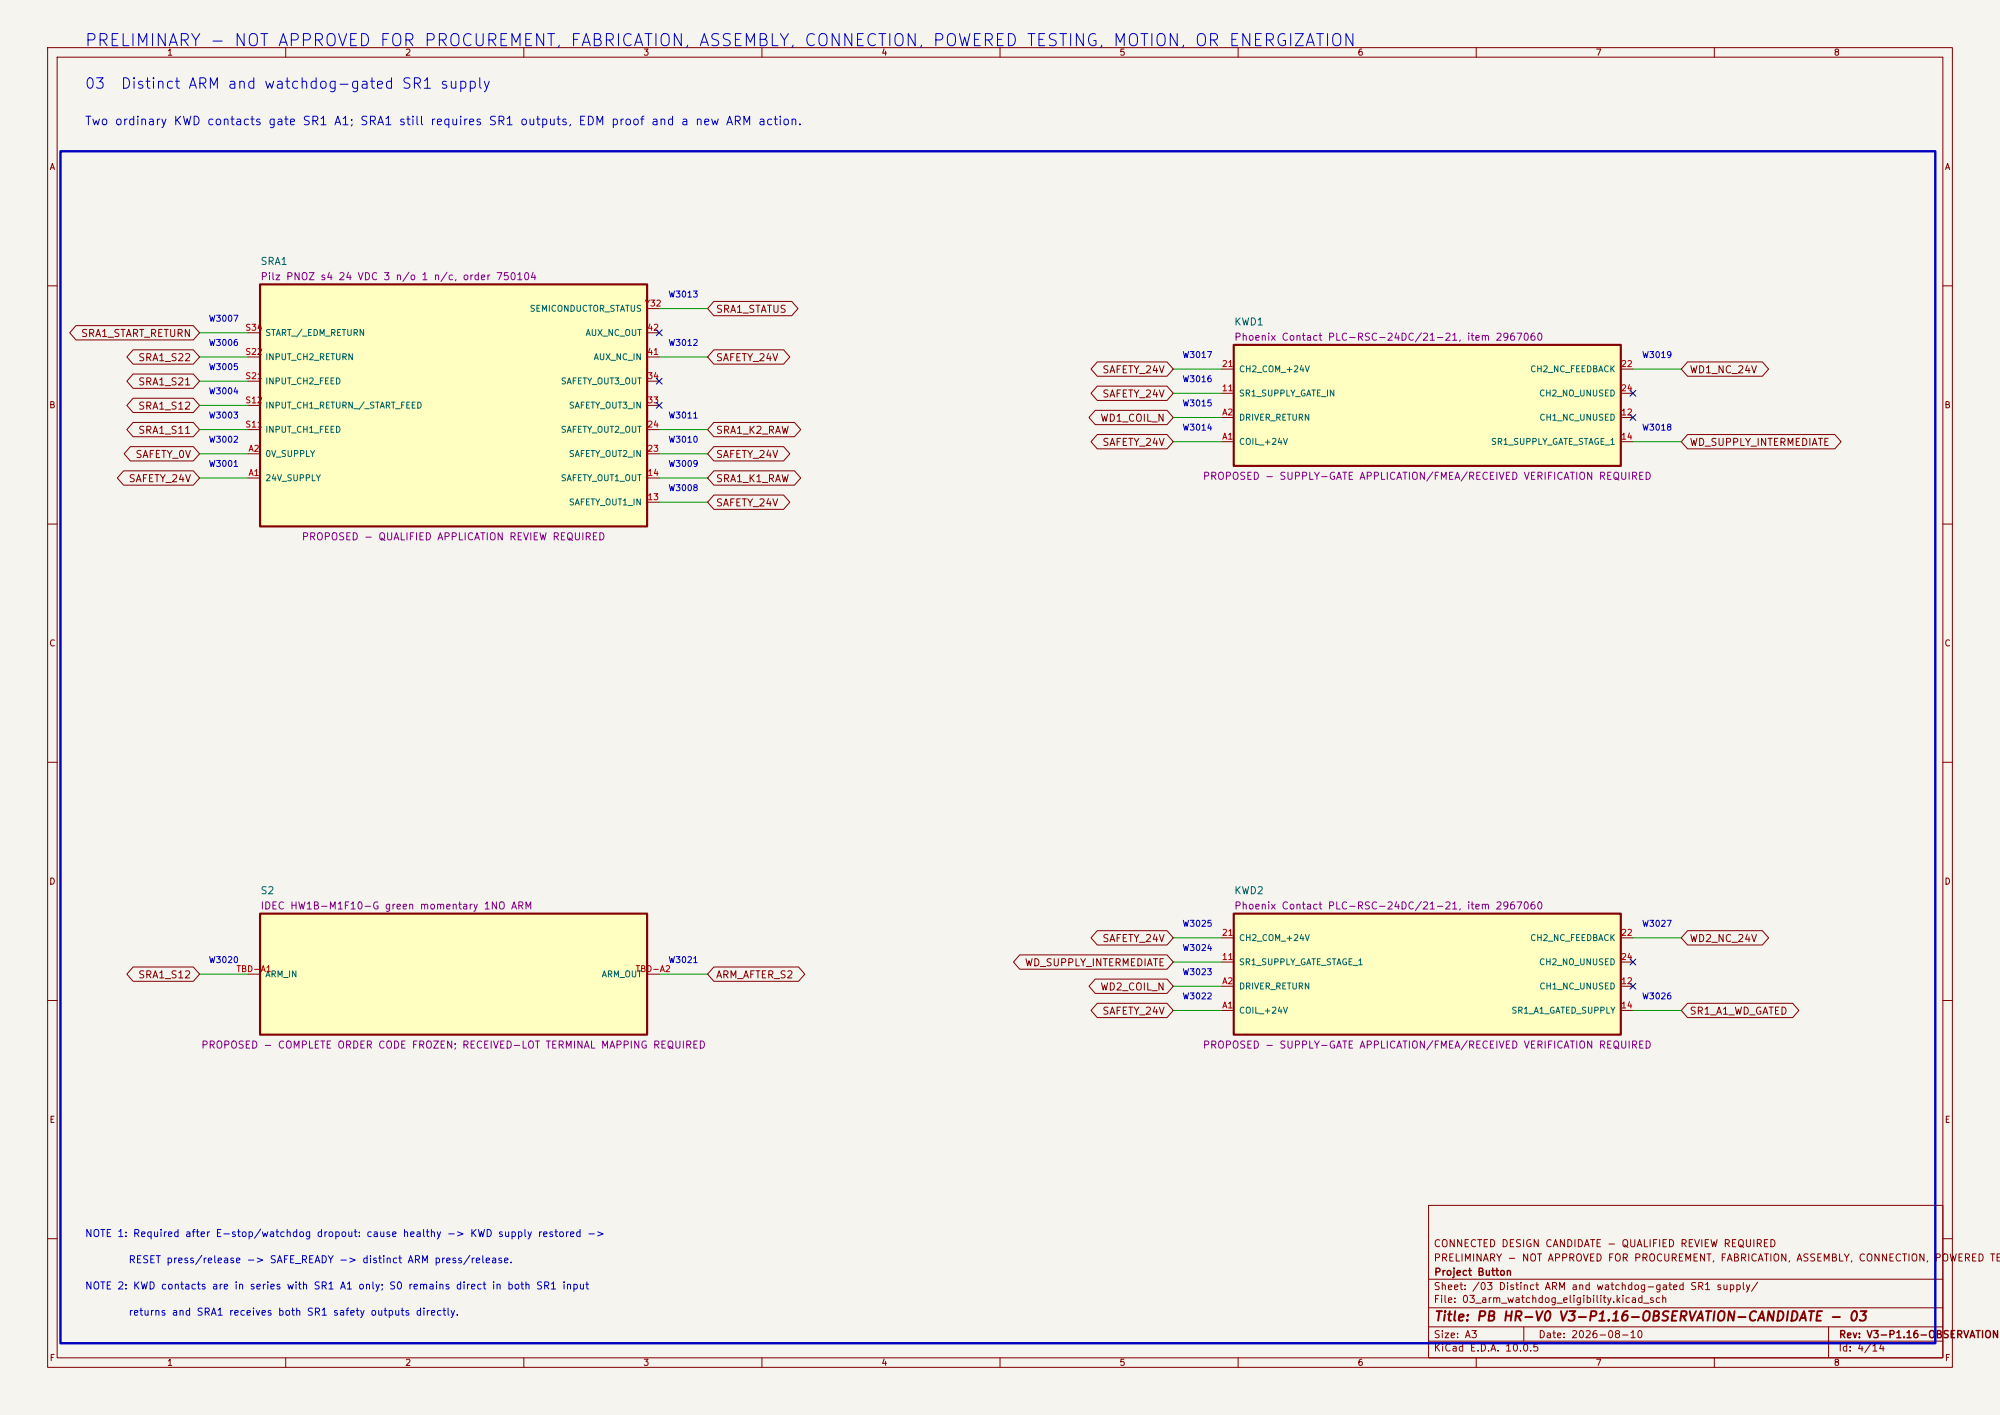
[picture p134: page 4]

PRELIMINARY - NOT APPROVED FOR PROCUREMENT, FABRICATION, ASSEMBLY, CONNECTION, POWERED TESTING, MOTION, OR ENERGIZATION

W3015 03 Distinct ARM and watchdog-gated SR1 supply

SEMICONDUCTOR_STATUS Y32 SRA1
Pilz PNOZ s4 24 VDC 3 n/o 1 n/c, order 750104

Phoenix Contact PLC-RSC-24DC/21-21, item 2967060

PROPOSED - SUPPLY-GATE APPLICATION/FMEA/RECEIVED VERIFICATION REQUIRED

PROPOSED - QUALIFIED APPLICATION REVIEW REQUIRED

IDEC HW1B-M1F10-G green momentary 1NO ARM

PROPOSED - COMPLETE ORDER CODE FROZEN; RECEIVED-LOT TERMINAL MAPPING REQUIRED

CONNECTED DESIGN CANDIDATE - QUALIFIED REVIEW REQUIRED Project Button

RESET press/release -> SAFE_READY -> distinct ARM press/release.

Sheet: /03 Distinct ARM and watchdog-gated SR1 supply/ File: 03_arm_watchdog_eligibility.kicad_sch

returns and SRA1 receives both SR1 safety outputs directly.

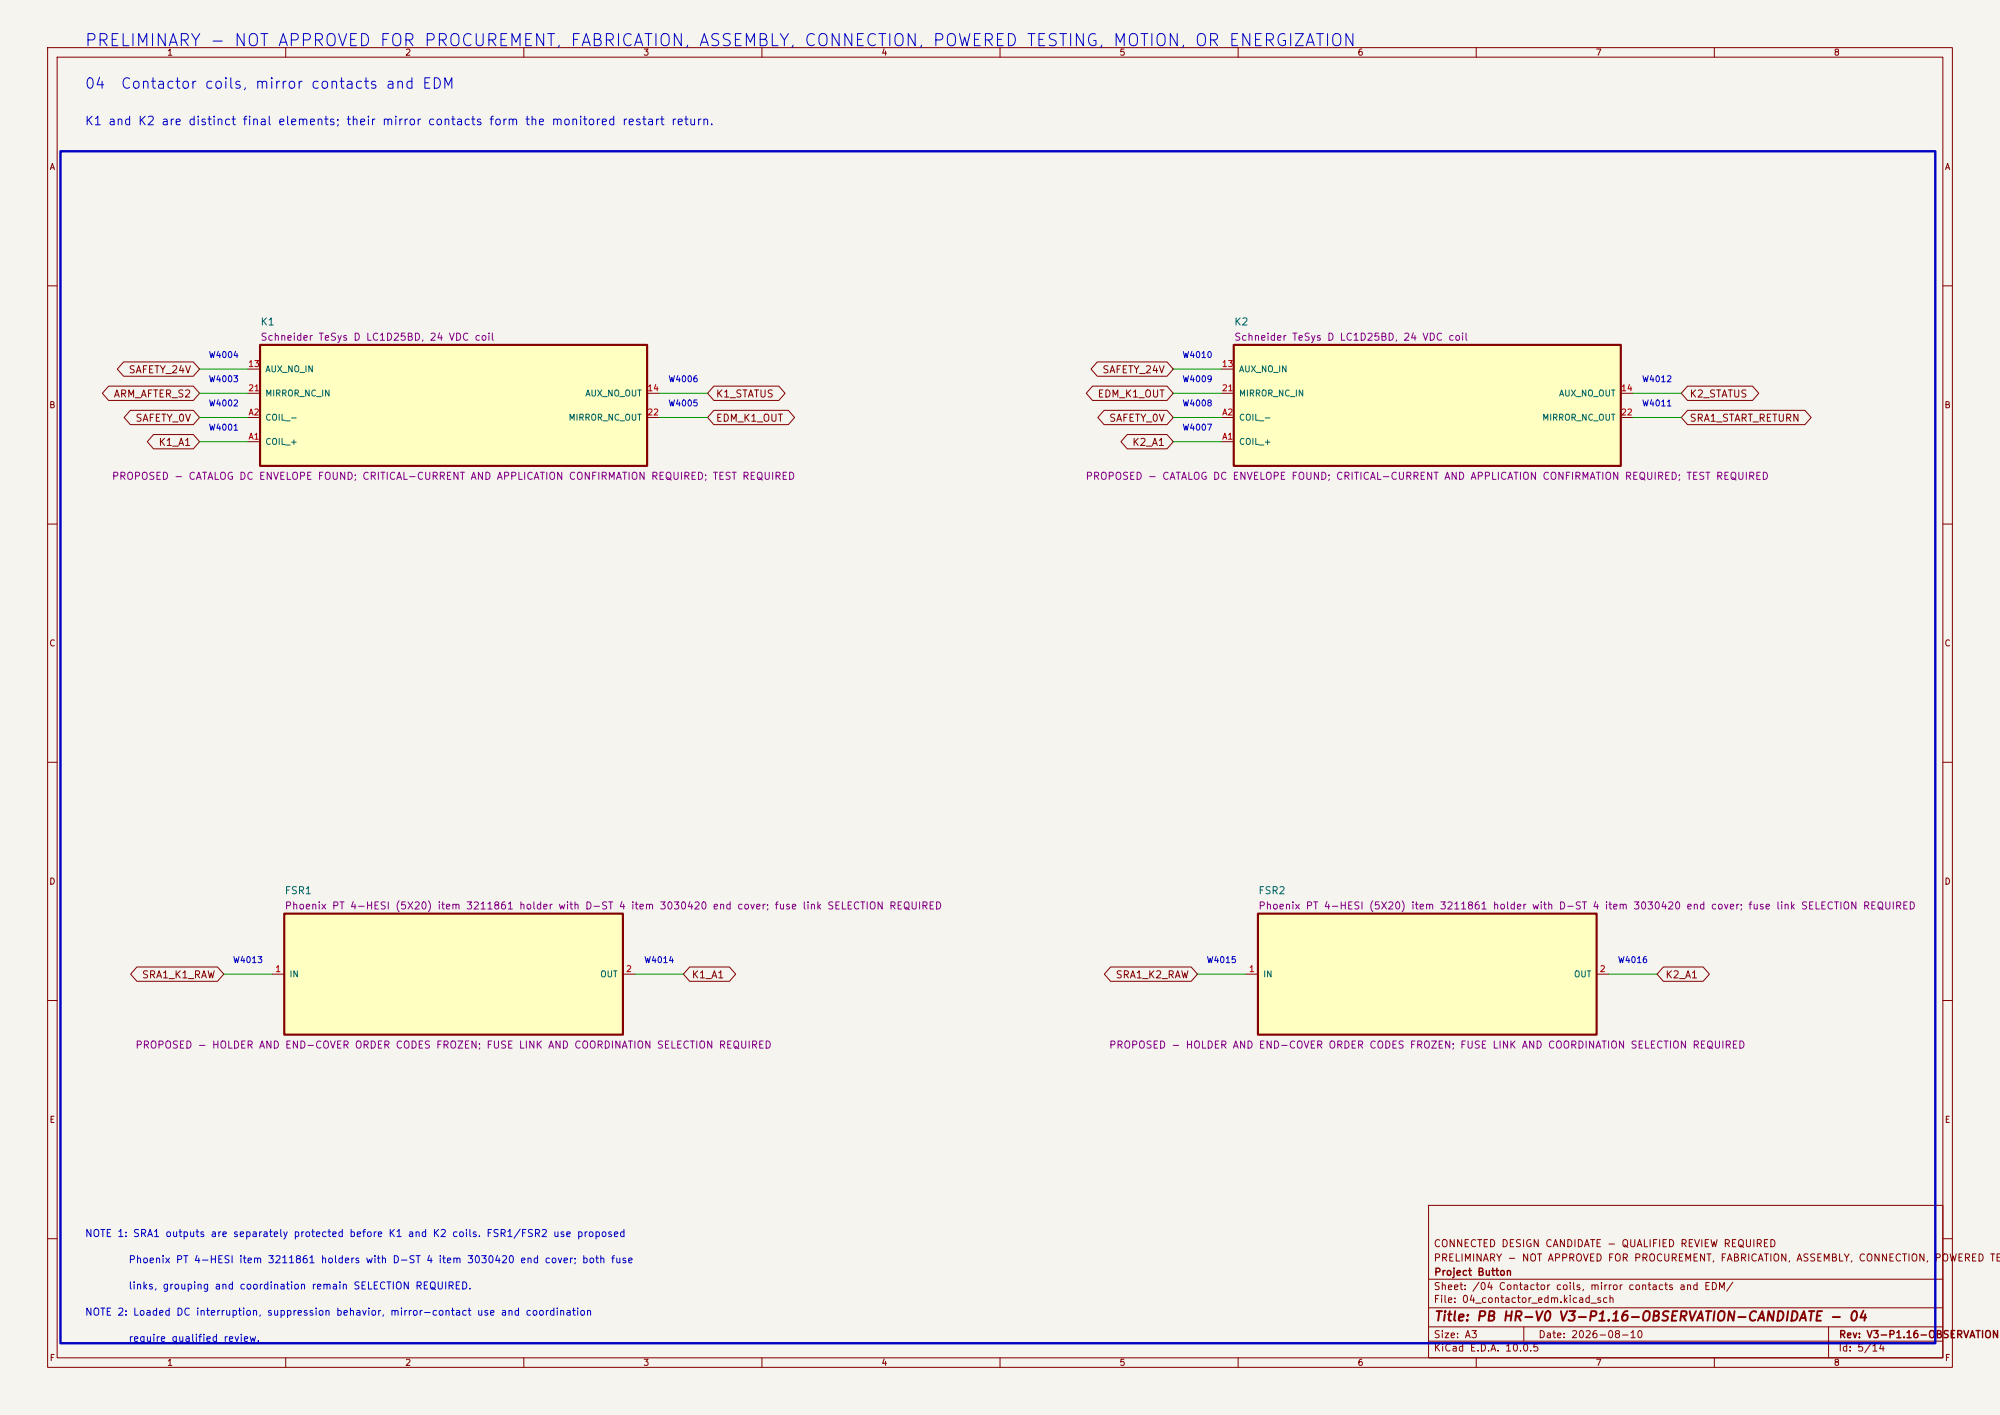
[picture p135: page 5]

PRELIMINARY - NOT APPROVED FOR PROCUREMENT, FABRICATION, ASSEMBLY, CONNECTION, POWERED TESTING, MOTION, OR ENERGIZATION

W4008 W4003 04 Contactor coils, mirror contacts and EDM

Schneider TeSys D LC1D25BD, 24 VDC coil

PROPOSED - CATALOG DC ENVELOPE FOUND; CRITICAL-CURRENT AND APPLICATION CONFIRMATION REQUIRED; TEST REQUIRED

Phoenix PT 4-HESI (5X20) item 3211861 holder with D-ST 4 item 3030420 end cover; fuse link SELECTION REQUIRED

W4014 NOTE 1: SRA1 outputs are separately protected before K1 and K2 coils. FSR1/FSR2 use proposed

PROPOSED - HOLDER AND END-COVER ORDER CODES FROZEN; FUSE LINK AND COORDINATION SELECTION REQUIRED

CONNECTED DESIGN CANDIDATE - QUALIFIED REVIEW REQUIRED Project Button

Phoenix PT 4-HESI item 3211861 holders with D-ST 4 item 3030420 end cover; both fuse

links, grouping and coordination remain SELECTION REQUIRED.

Sheet: /04 Contactor coils, mirror contacts and EDM/ File: 04_contactor_edm.kicad_sch

NOTE 2: Loaded DC interruption, suppression behavior, mirror-contact use and coordination

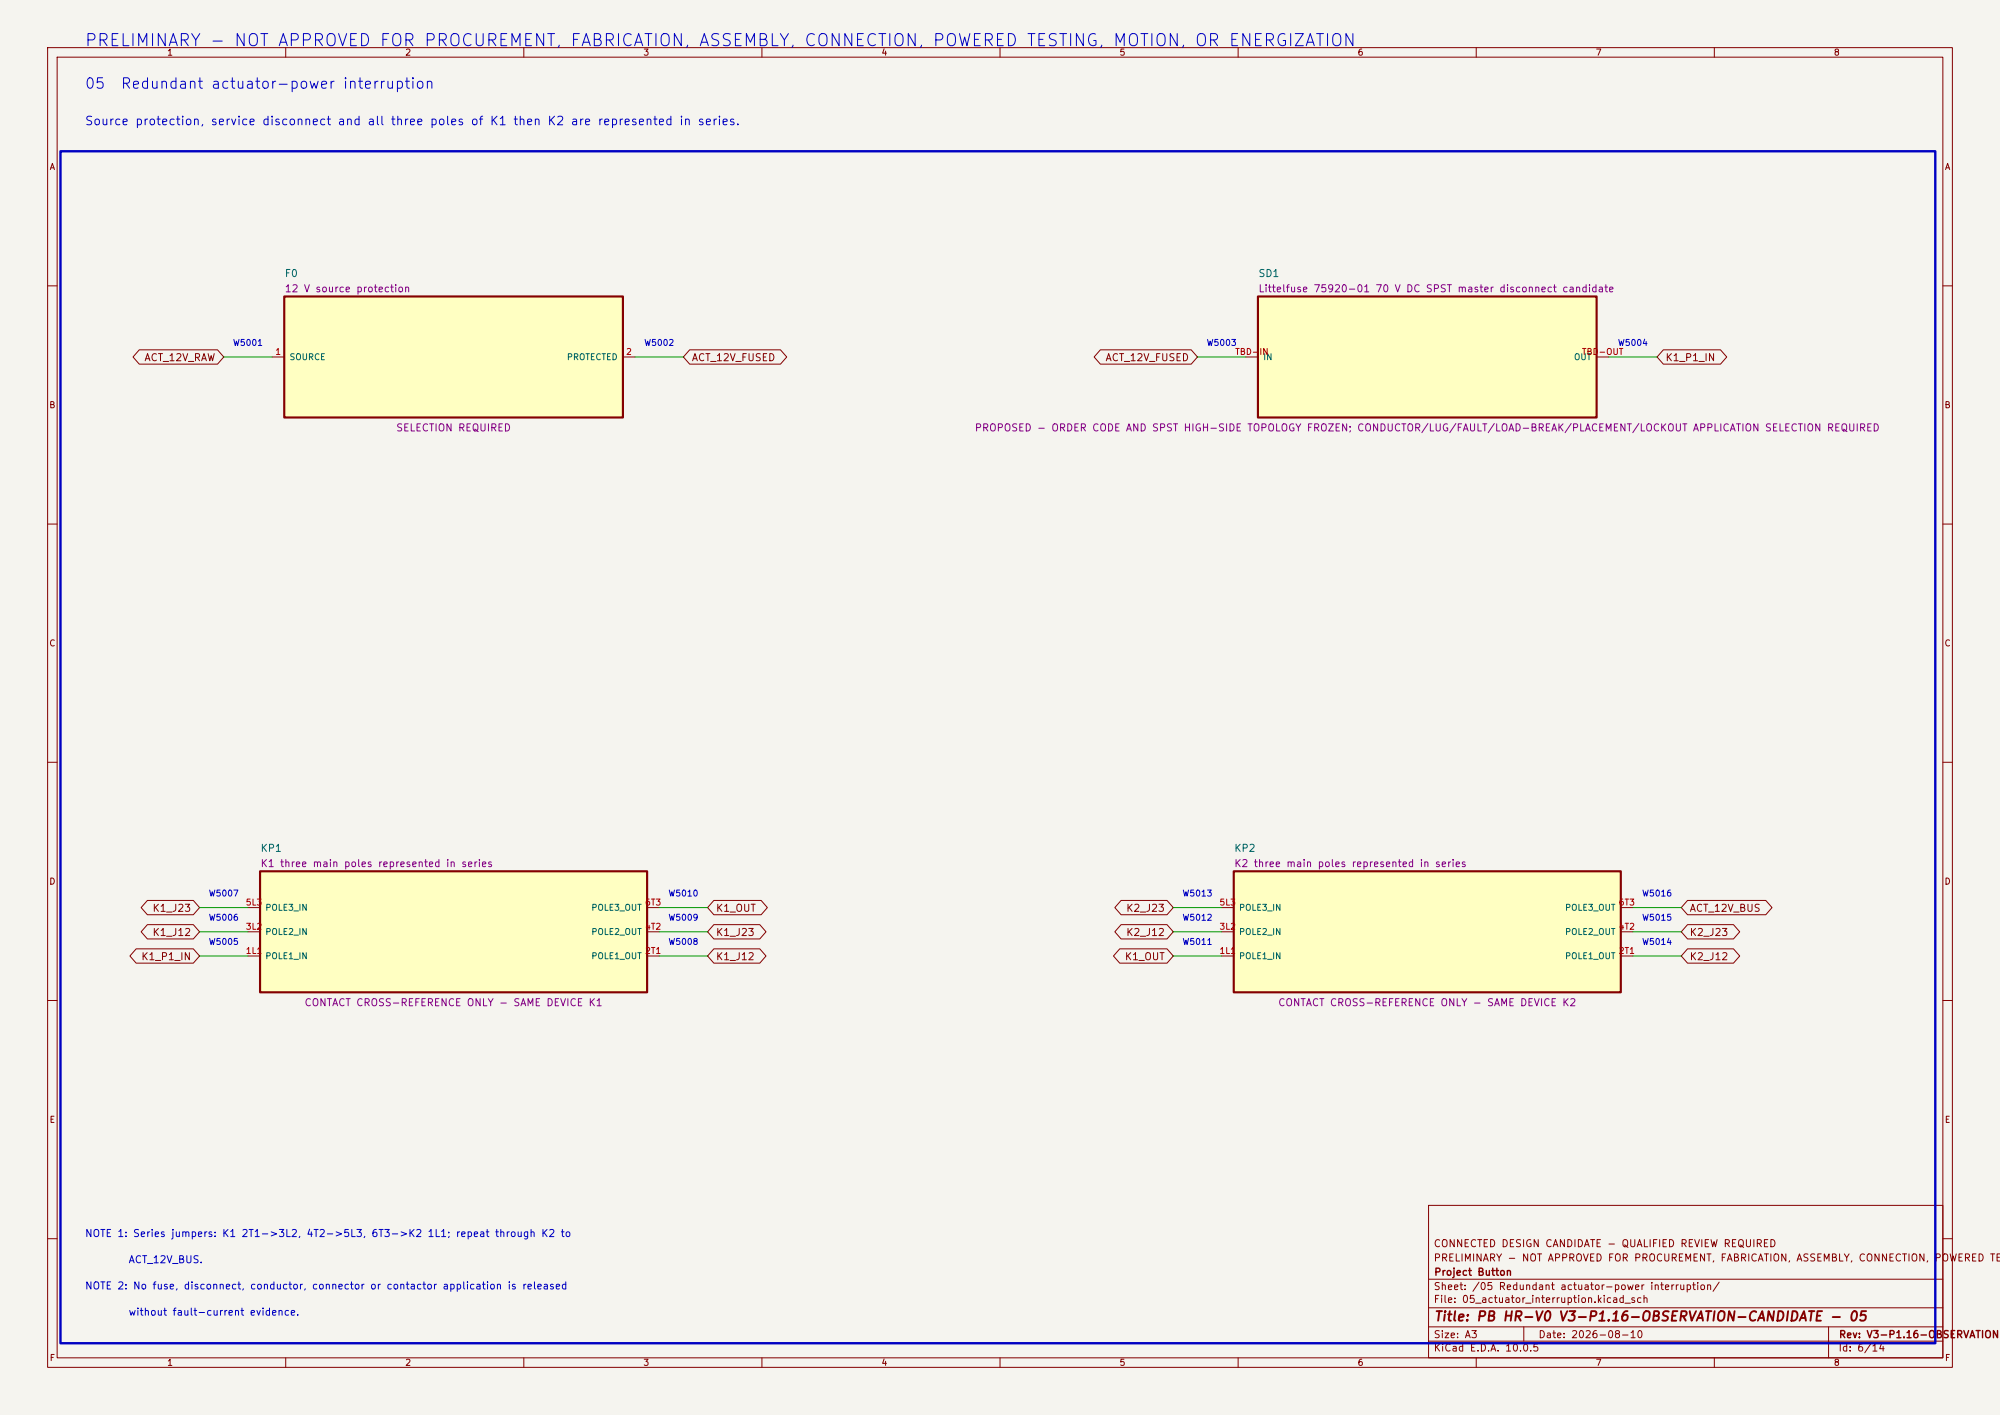
[picture p136: page 6]

W5003 PRELIMINARY - NOT APPROVED FOR PROCUREMENT, FABRICATION, ASSEMBLY, CONNECTION, POWERED TESTING, MOTION, OR ENERGIZATION

05 Redundant actuator-power interruption

Source protection, service disconnect and all three poles of K1 then K2 are represented in series.

Littelfuse 75920-01 70 V DC SPST master disconnect candidate

PROPOSED - ORDER CODE AND SPST HIGH-SIDE TOPOLOGY FROZEN; CONDUCTOR/LUG/FAULT/LOAD-BREAK/PLACEMENT/LOCKOUT APPLICATION SELECTION REQUIRED

K1 three main poles represented in series

K2 three main poles represented in series

CONTACT CROSS-REFERENCE ONLY - SAME DEVICE K1

CONTACT CROSS-REFERENCE ONLY - SAME DEVICE K2

CONNECTED DESIGN CANDIDATE - QUALIFIED REVIEW REQUIRED Project Button

NOTE 2: No fuse, disconnect, conductor, connector or contactor application is released

Sheet: /05 Redundant actuator-power interruption/ File: 05_actuator_interruption.kicad_sch

without fault-current evidence.

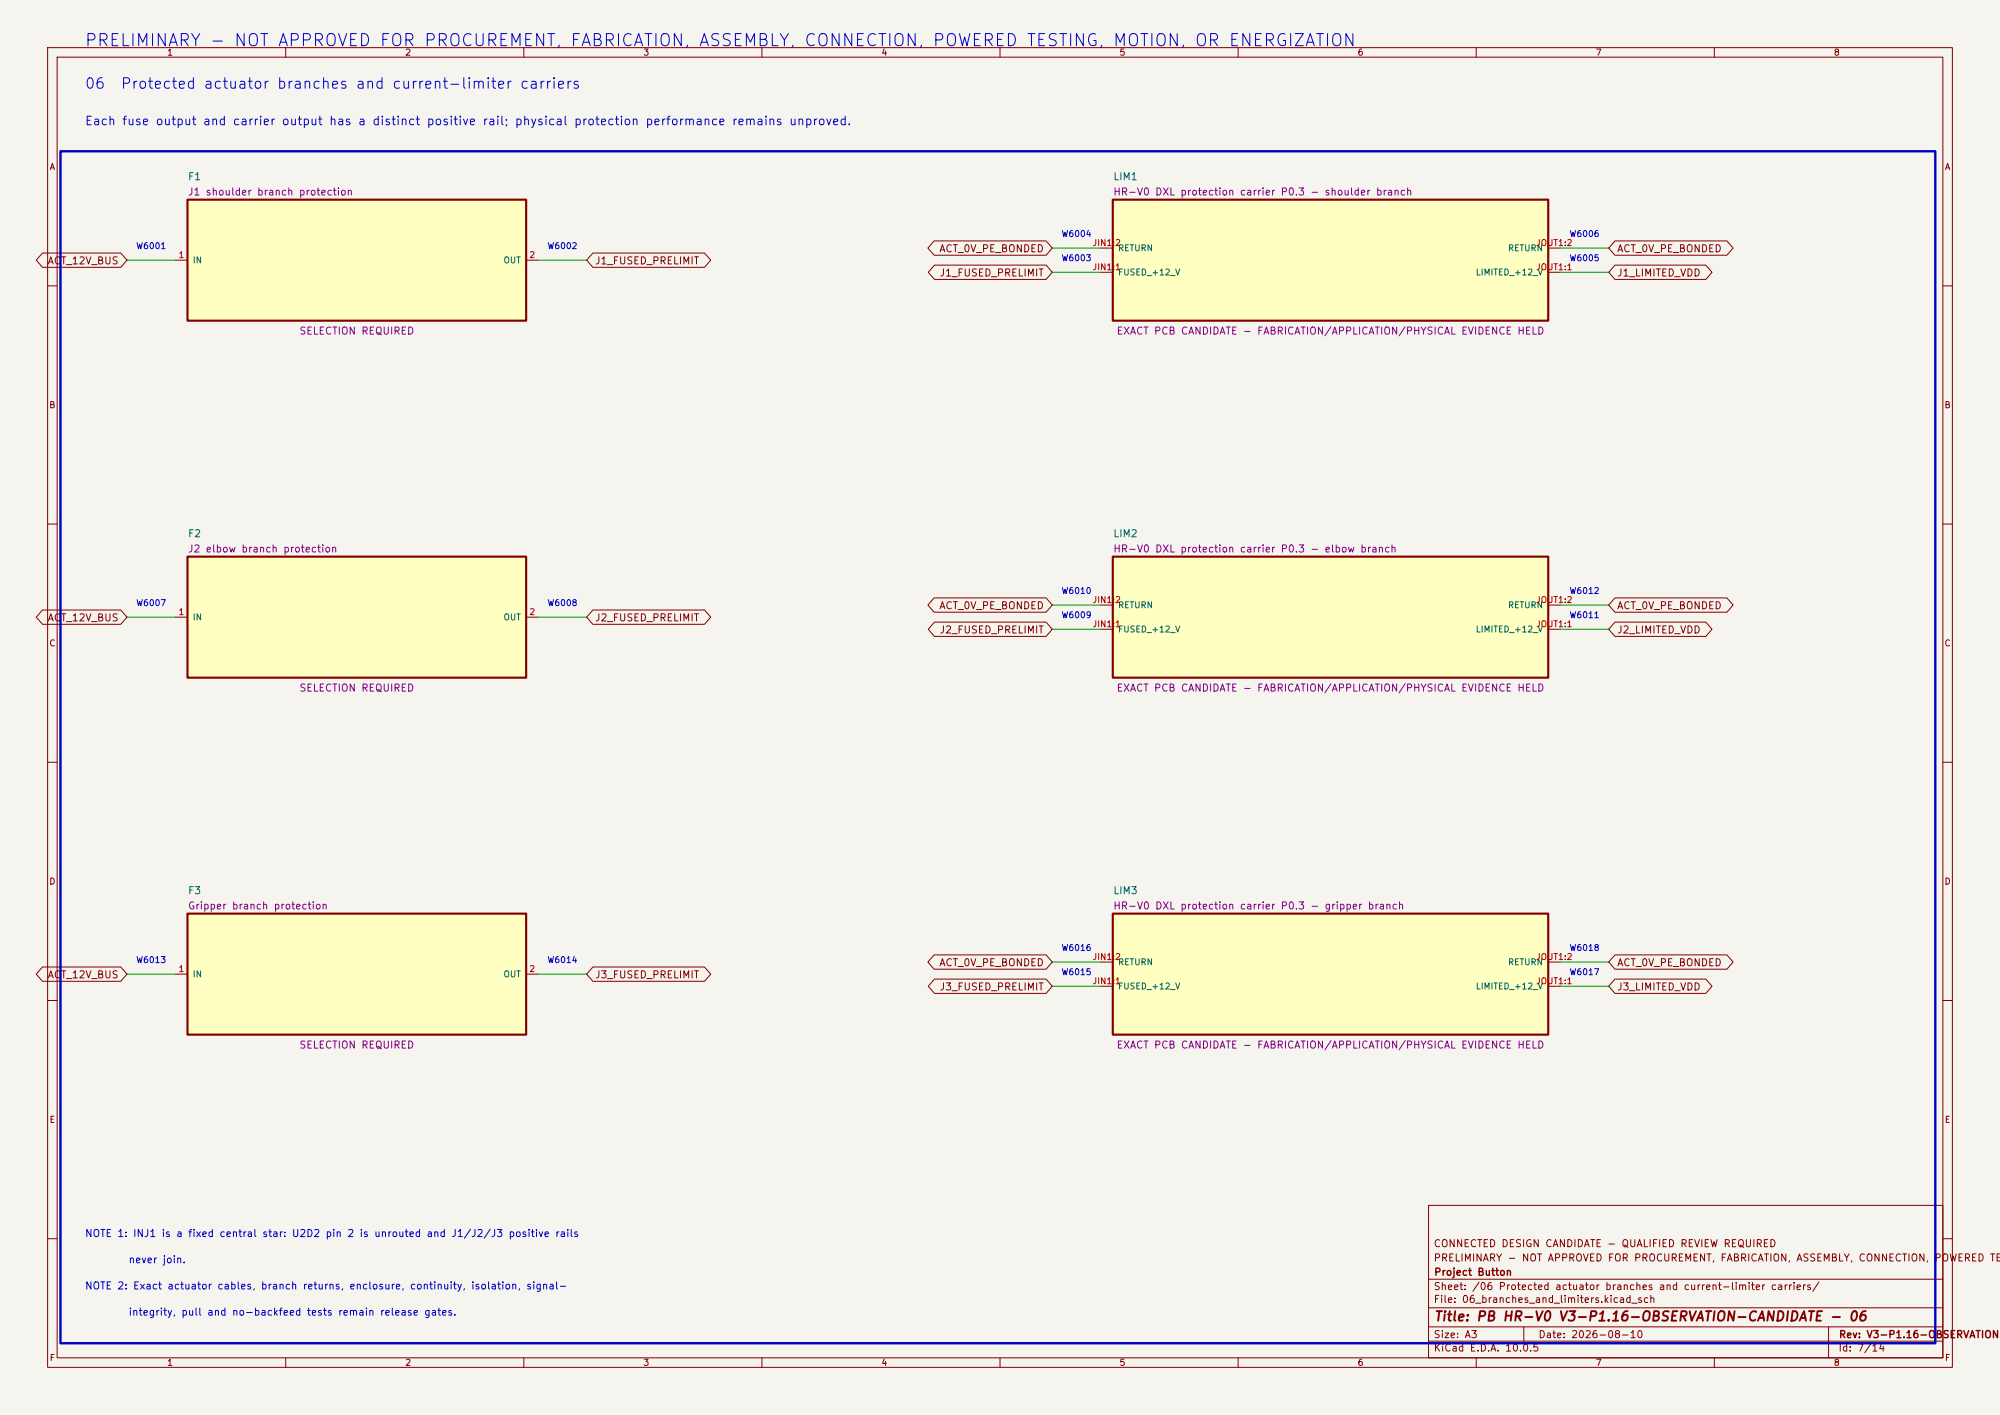
[picture p137: page 7]

PRELIMINARY - NOT APPROVED FOR PROCUREMENT, FABRICATION, ASSEMBLY, CONNECTION, POWERED TESTING, MOTION, OR ENERGIZATION

06 Protected actuator branches and current-limiter carriers

Each fuse output and carrier output has a distinct positive rail; physical protection performance remains unproved.

LIMITED_+12_VJOUT1:1 RETURNJOUT1:2 LIM1
HR-V0 DXL protection carrier P0.3 - shoulder branch

EXACT PCB CANDIDATE - FABRICATION/APPLICATION/PHYSICAL EVIDENCE HELD

LIMITED_+12_VJOUT1:1 RETURNJOUT1:2 LIM2
HR-V0 DXL protection carrier P0.3 - elbow branch

LIMITED_+12_VJOUT1:1 RETURNJOUT1:2 LIM3
HR-V0 DXL protection carrier P0.3 - gripper branch

CONNECTED DESIGN CANDIDATE - QUALIFIED REVIEW REQUIRED Project Button

NOTE 2: Exact actuator cables, branch returns, enclosure, continuity, isolation, signal-

Sheet: /06 Protected actuator branches and current-limiter carriers/ File: 06_branches_and_limiters.kicad_sch

integrity, pull and no-backfeed tests remain release gates.

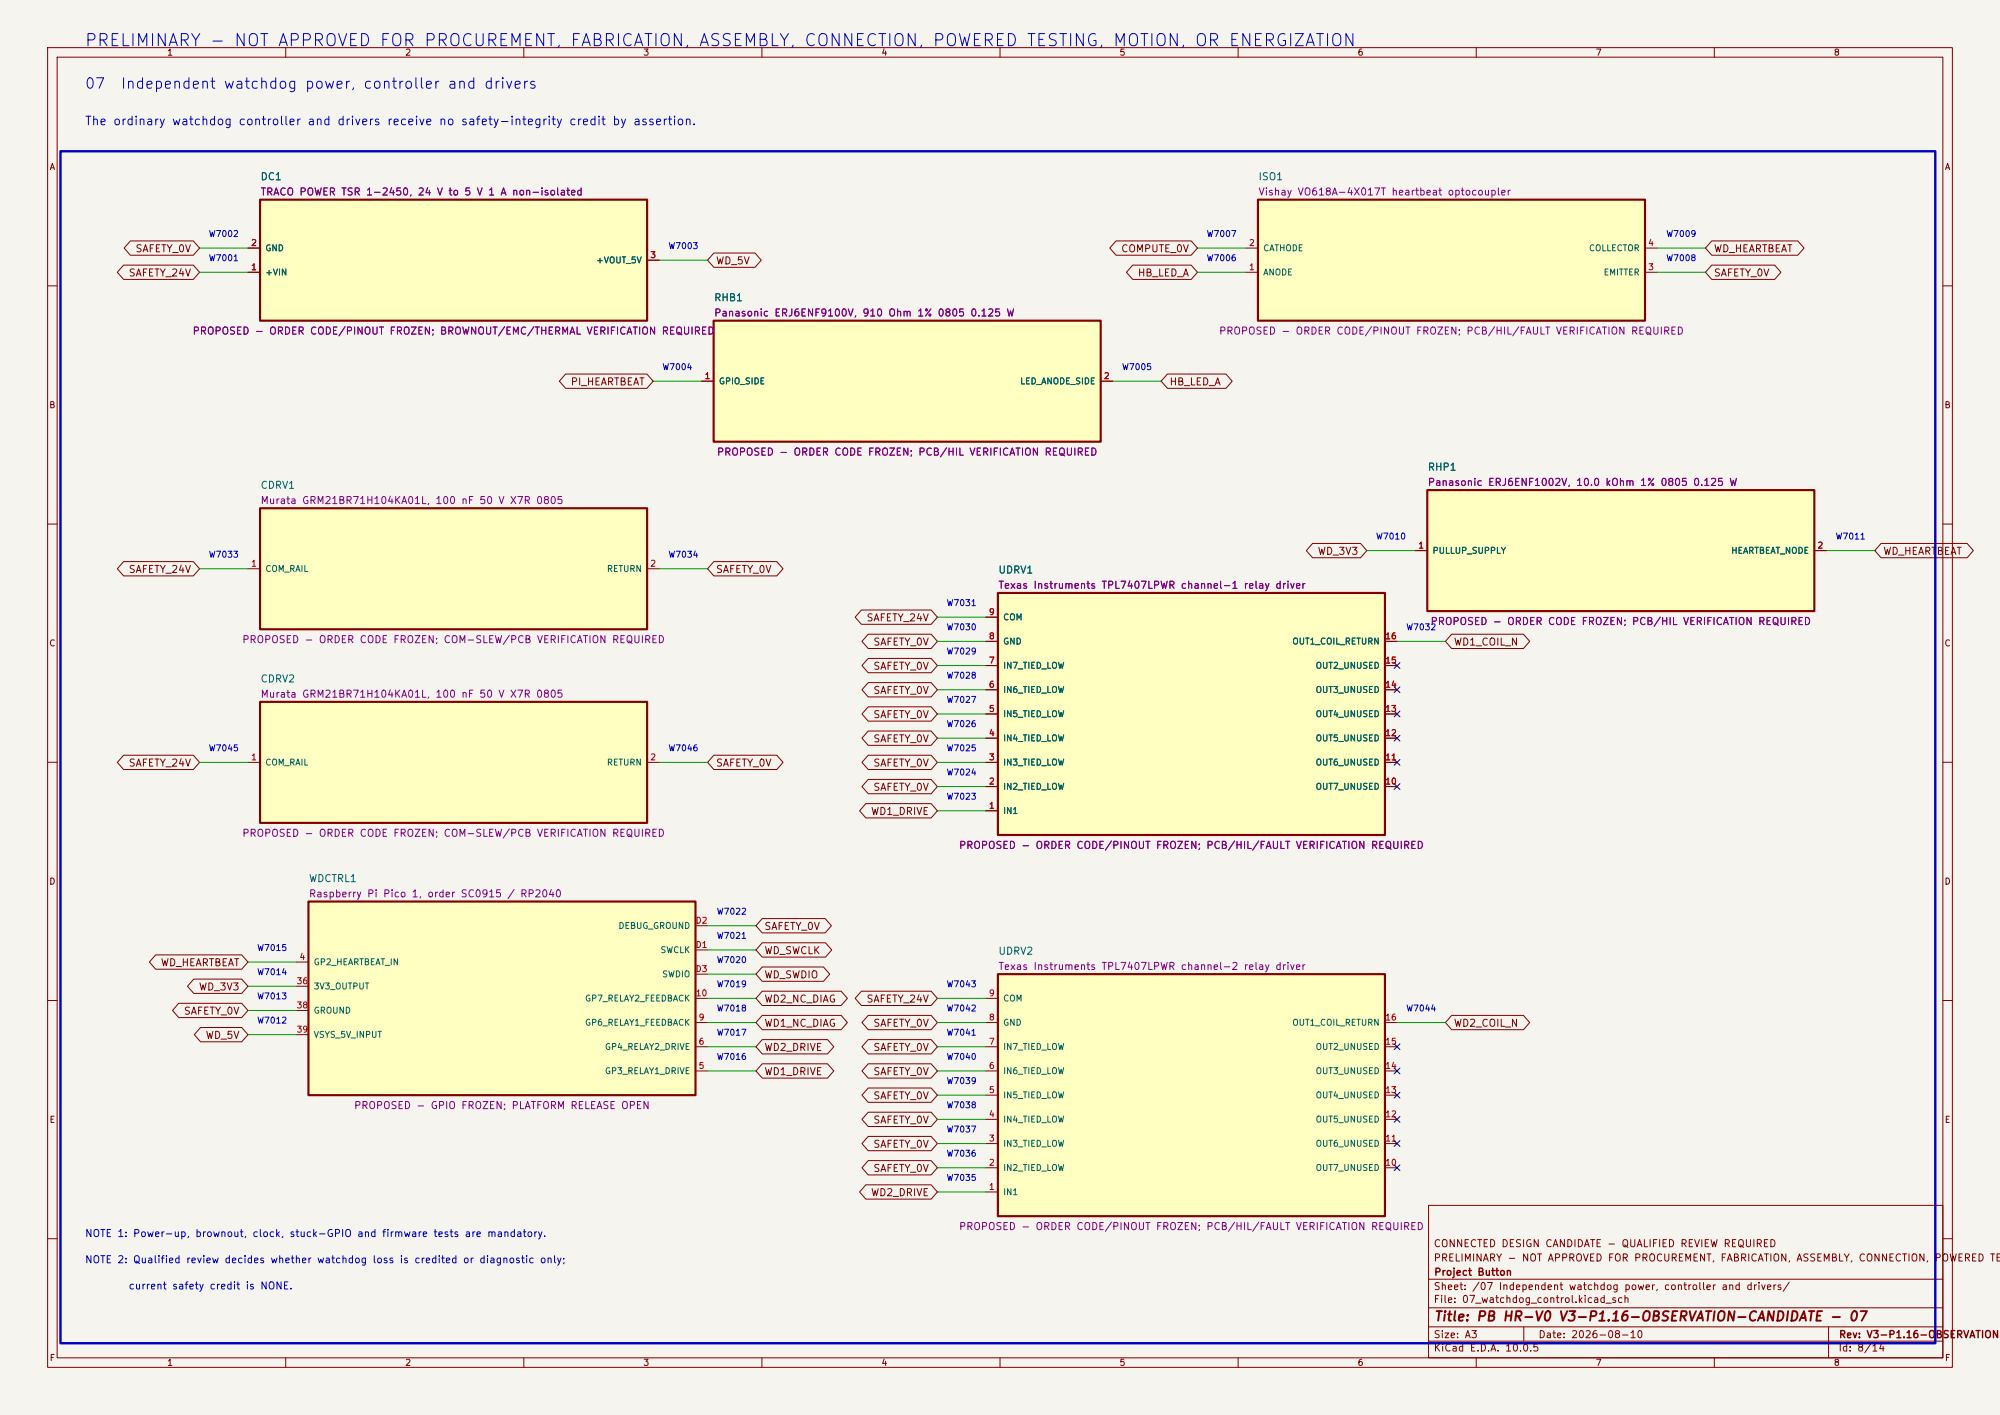
[picture p138: page 8]

W7002 PRELIMINARY - NOT APPROVED FOR PROCUREMENT, FABRICATION, ASSEMBLY, CONNECTION, POWERED TESTING, MOTION, OR ENERGIZATION

TRACO POWER TSR 1-2450, 24 V to 5 V 1 A non-isolated

PROPOSED - ORDER CODE/PINOUT FROZEN; BROWNOUT/EMC/THERMAL VERIFICATION REQUIRED

PROPOSED - ORDER CODE/PINOUT FROZEN; PCB/HIL/FAULT VERIFICATION REQUIRED

PROPOSED - ORDER CODE FROZEN; PCB/HIL VERIFICATION REQUIRED

Texas Instruments TPL7407LPWR channel-1 relay driver

PROPOSED - ORDER CODE FROZEN; COM-SLEW/PCB VERIFICATION REQUIRED

Raspberry Pi Pico 1, order SC0915 / RP2040

Texas Instruments TPL7407LPWR channel-2 relay driver

PROPOSED - GPIO FROZEN; PLATFORM RELEASE OPEN

NOTE 1: Power-up, brownout, clock, stuck-GPIO and firmware tests are mandatory.

CONNECTED DESIGN CANDIDATE - QUALIFIED REVIEW REQUIRED Project Button

NOTE 2: Qualified review decides whether watchdog loss is credited or diagnostic only;

current safety credit is NONE.

Sheet: /07 Independent watchdog power, controller and drivers/ File: 07_watchdog_control.kicad_sch

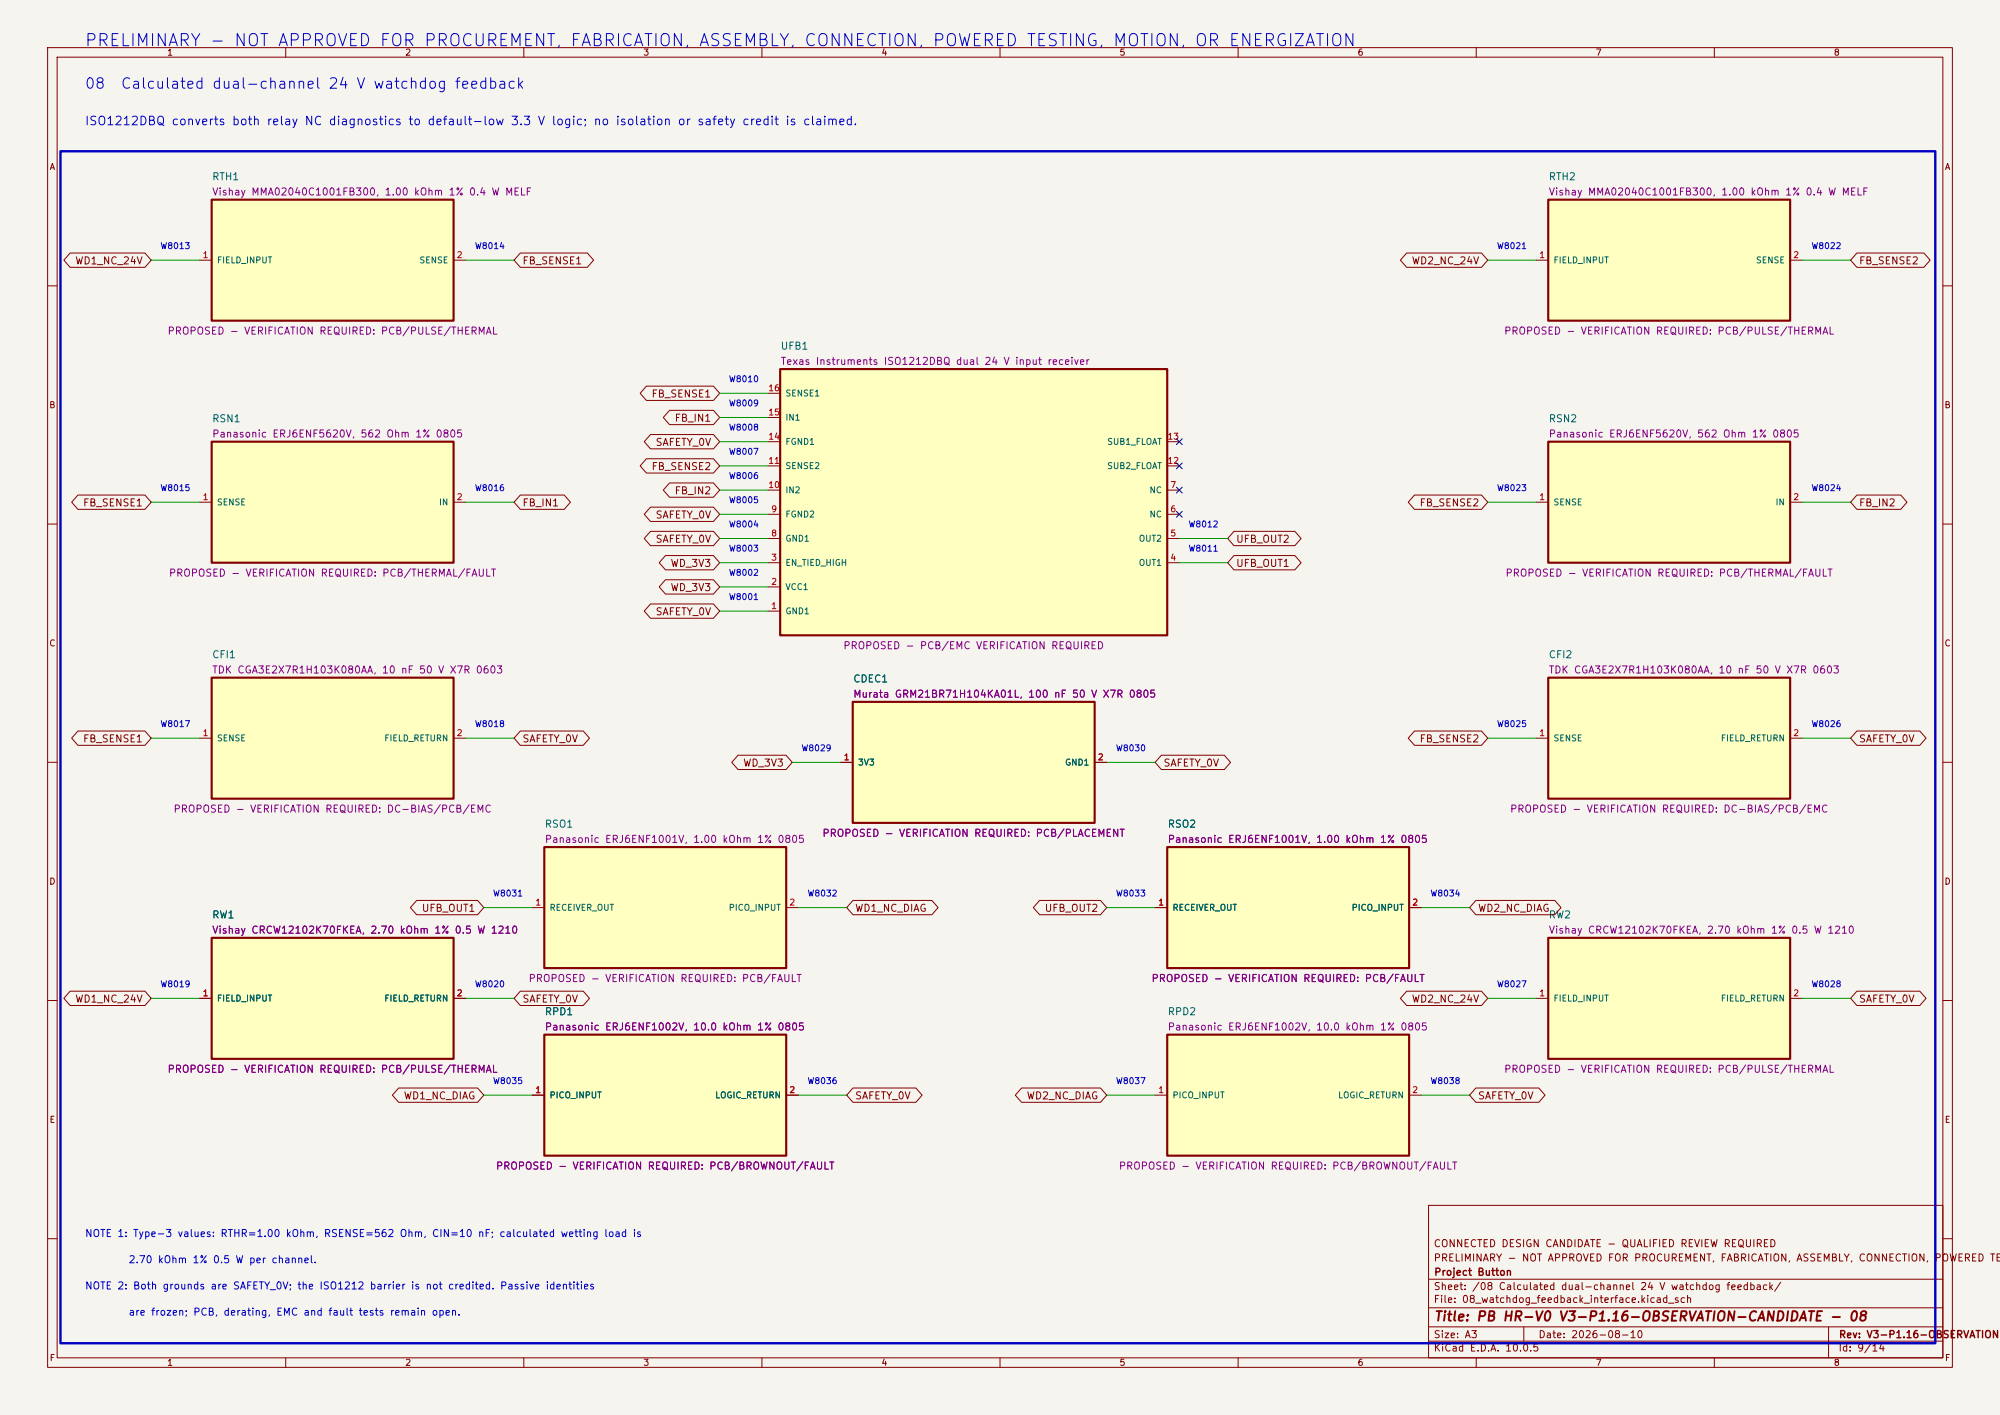
[picture p139: page 9]

W8009 W8008 W8007 PRELIMINARY - NOT APPROVED FOR PROCUREMENT, FABRICATION, ASSEMBLY, CONNECTION, POWERED TESTING, MOTION, OR ENERGIZATION

08 Calculated dual-channel 24 V watchdog feedback

ISO1212DBQ converts both relay NC diagnostics to default-low 3.3 V logic; no isolation or safety credit is claimed.

PROPOSED - VERIFICATION REQUIRED: PCB/PULSE/THERMAL

Texas Instruments ISO1212DBQ dual 24 V input receiver SENSE 1

PROPOSED - VERIFICATION REQUIRED: PCB/THERMAL/FAULT

PROPOSED - PCB/EMC VERIFICATION REQUIRED

PROPOSED - VERIFICATION REQUIRED: DC-BIAS/PCB/EMC

PROPOSED - VERIFICATION REQUIRED: PCB/PLACEMENT

PROPOSED - VERIFICATION REQUIRED: PCB/FAULT

PROPOSED - VERIFICATION REQUIRED: PCB/BROWNOUT/FAULT

CONNECTED DESIGN CANDIDATE - QUALIFIED REVIEW REQUIRED Project Button

NOTE 2: Both grounds are SAFETY_0V; the ISO1212 barrier is not credited. Passive identities are frozen; PCB, derating, EMC and fault tests remain open.

Sheet: /08 Calculated dual-channel 24 V watchdog feedback/ File: 08_watchdog_feedback_interface.kicad_sch

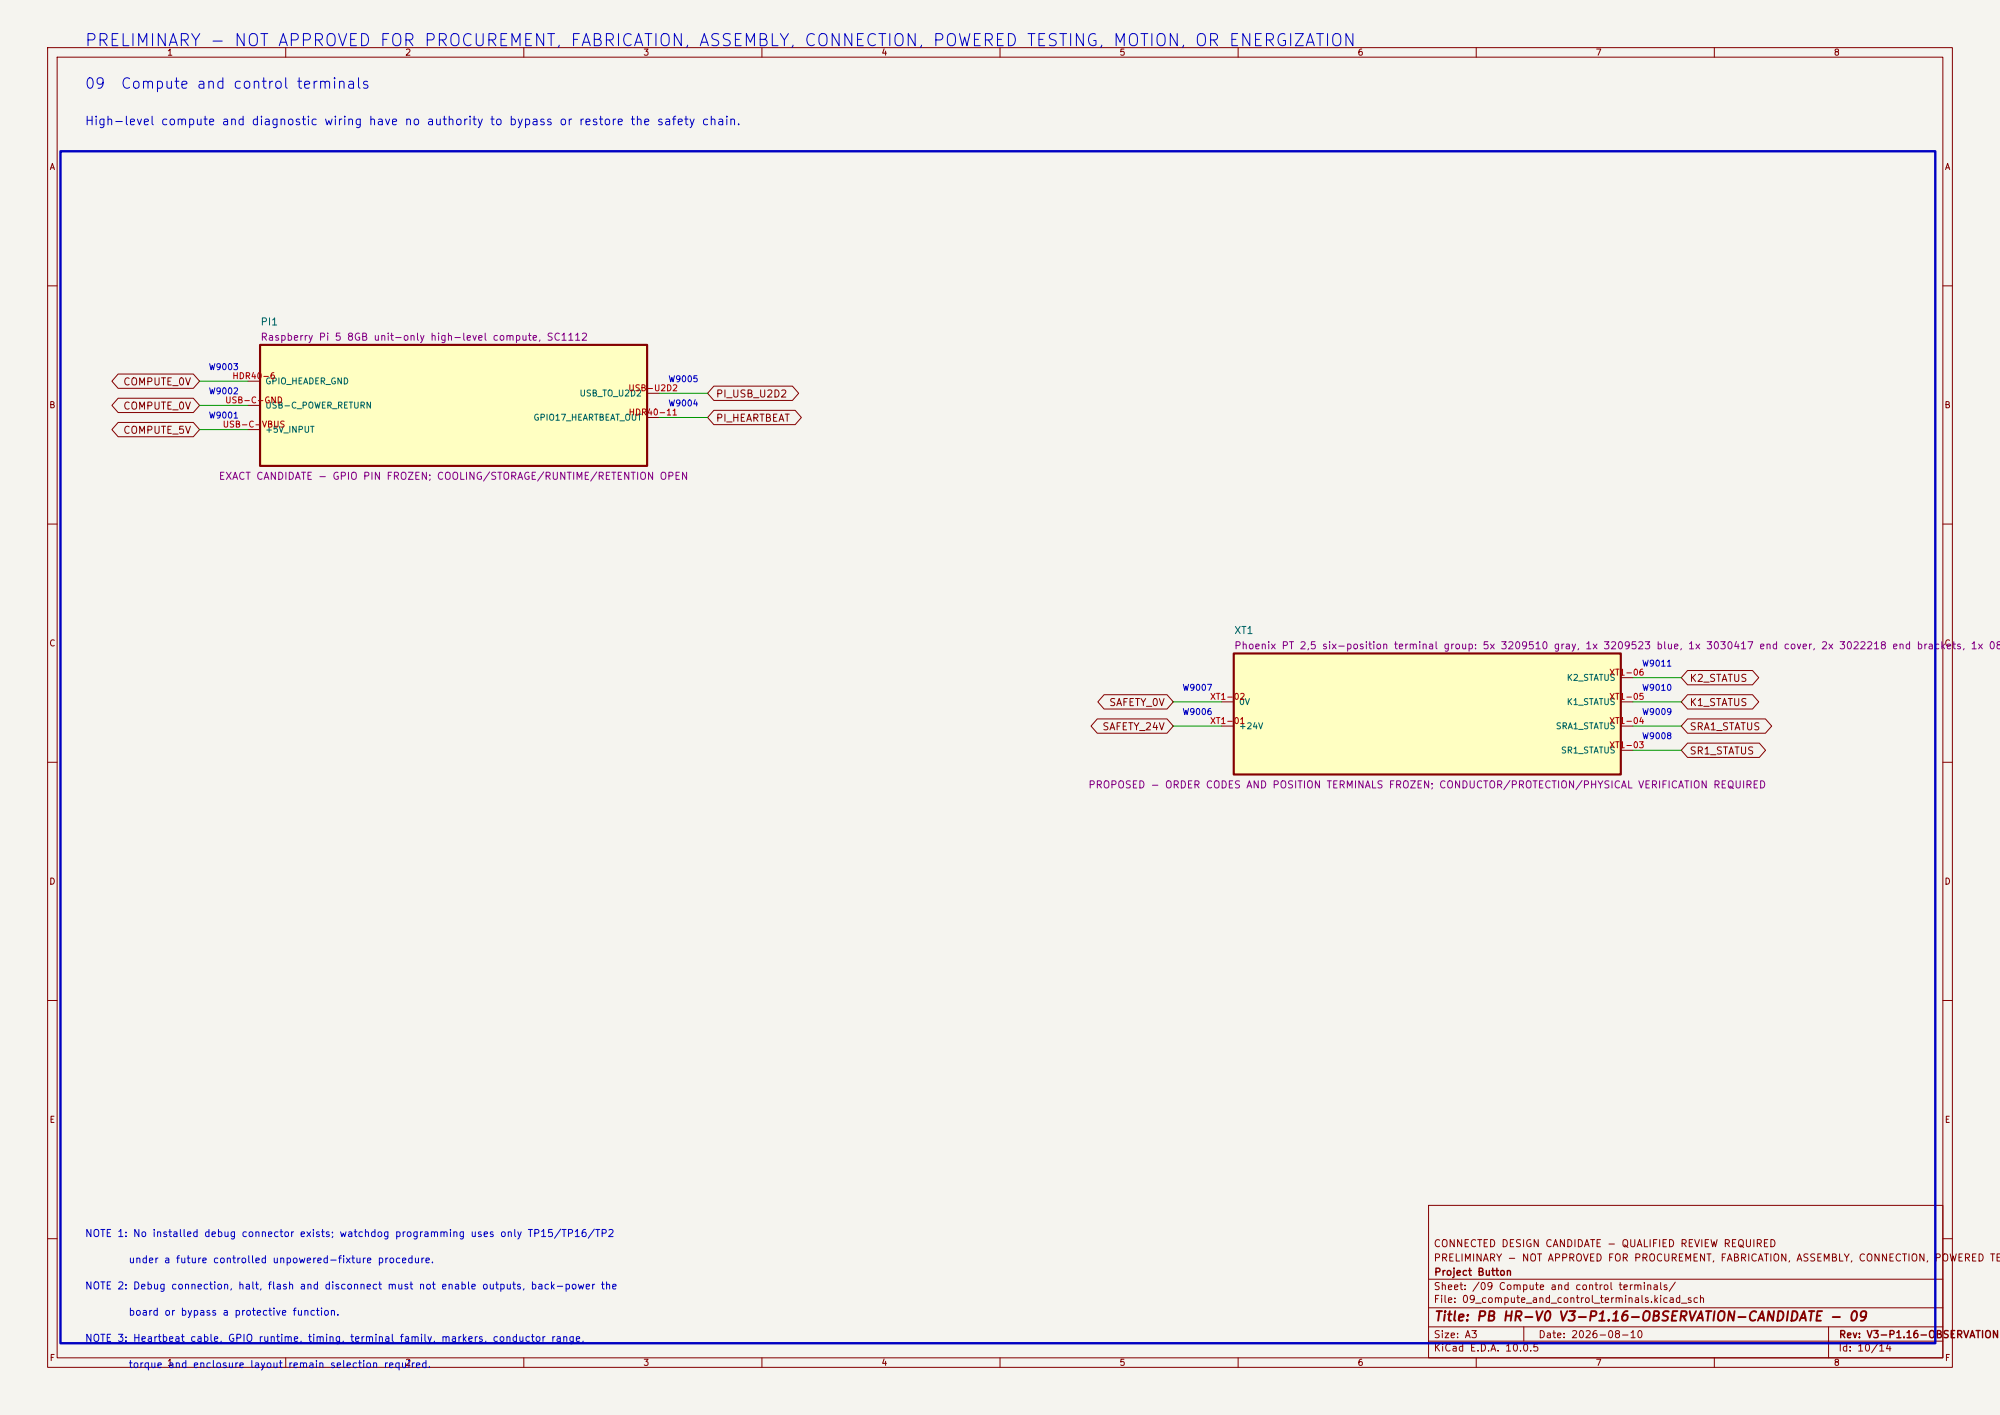
[picture p140: page 10]

W9009 High-level compute and diagnostic wiring have no authority to bypass or restore the safety chain.

EXACT CANDIDATE - GPIO PIN FROZEN; COOLING/STORAGE/RUNTIME/RETENTION OPEN

SRA1_STATUSXT1-04 K1_STATUSXT1-05 K2_STATUSXT1-06 XT1
Phoenix PT 2,5 six-position terminal group: 5x 3209510 gray, 1x 3209523 blue, 1x 3030417 end cover, 2x 3022218 end brackets, 1x 0828734 marker sheet

PROPOSED - ORDER CODES AND POSITION TERMINALS FROZEN; CONDUCTOR/PROTECTION/PHYSICAL VERIFICATION REQUIRED

CONNECTED DESIGN CANDIDATE - QUALIFIED REVIEW REQUIRED Project Button

under a future controlled unpowered-fixture procedure.

NOTE 2: Debug connection, halt, flash and disconnect must not enable outputs, back-power the

Sheet: /09 Compute and control terminals/ File: 09_compute_and_control_terminals.kicad_sch

board or bypass a protective function.

NOTE 3: Heartbeat cable, GPIO runtime, timing, terminal family, markers, conductor range,

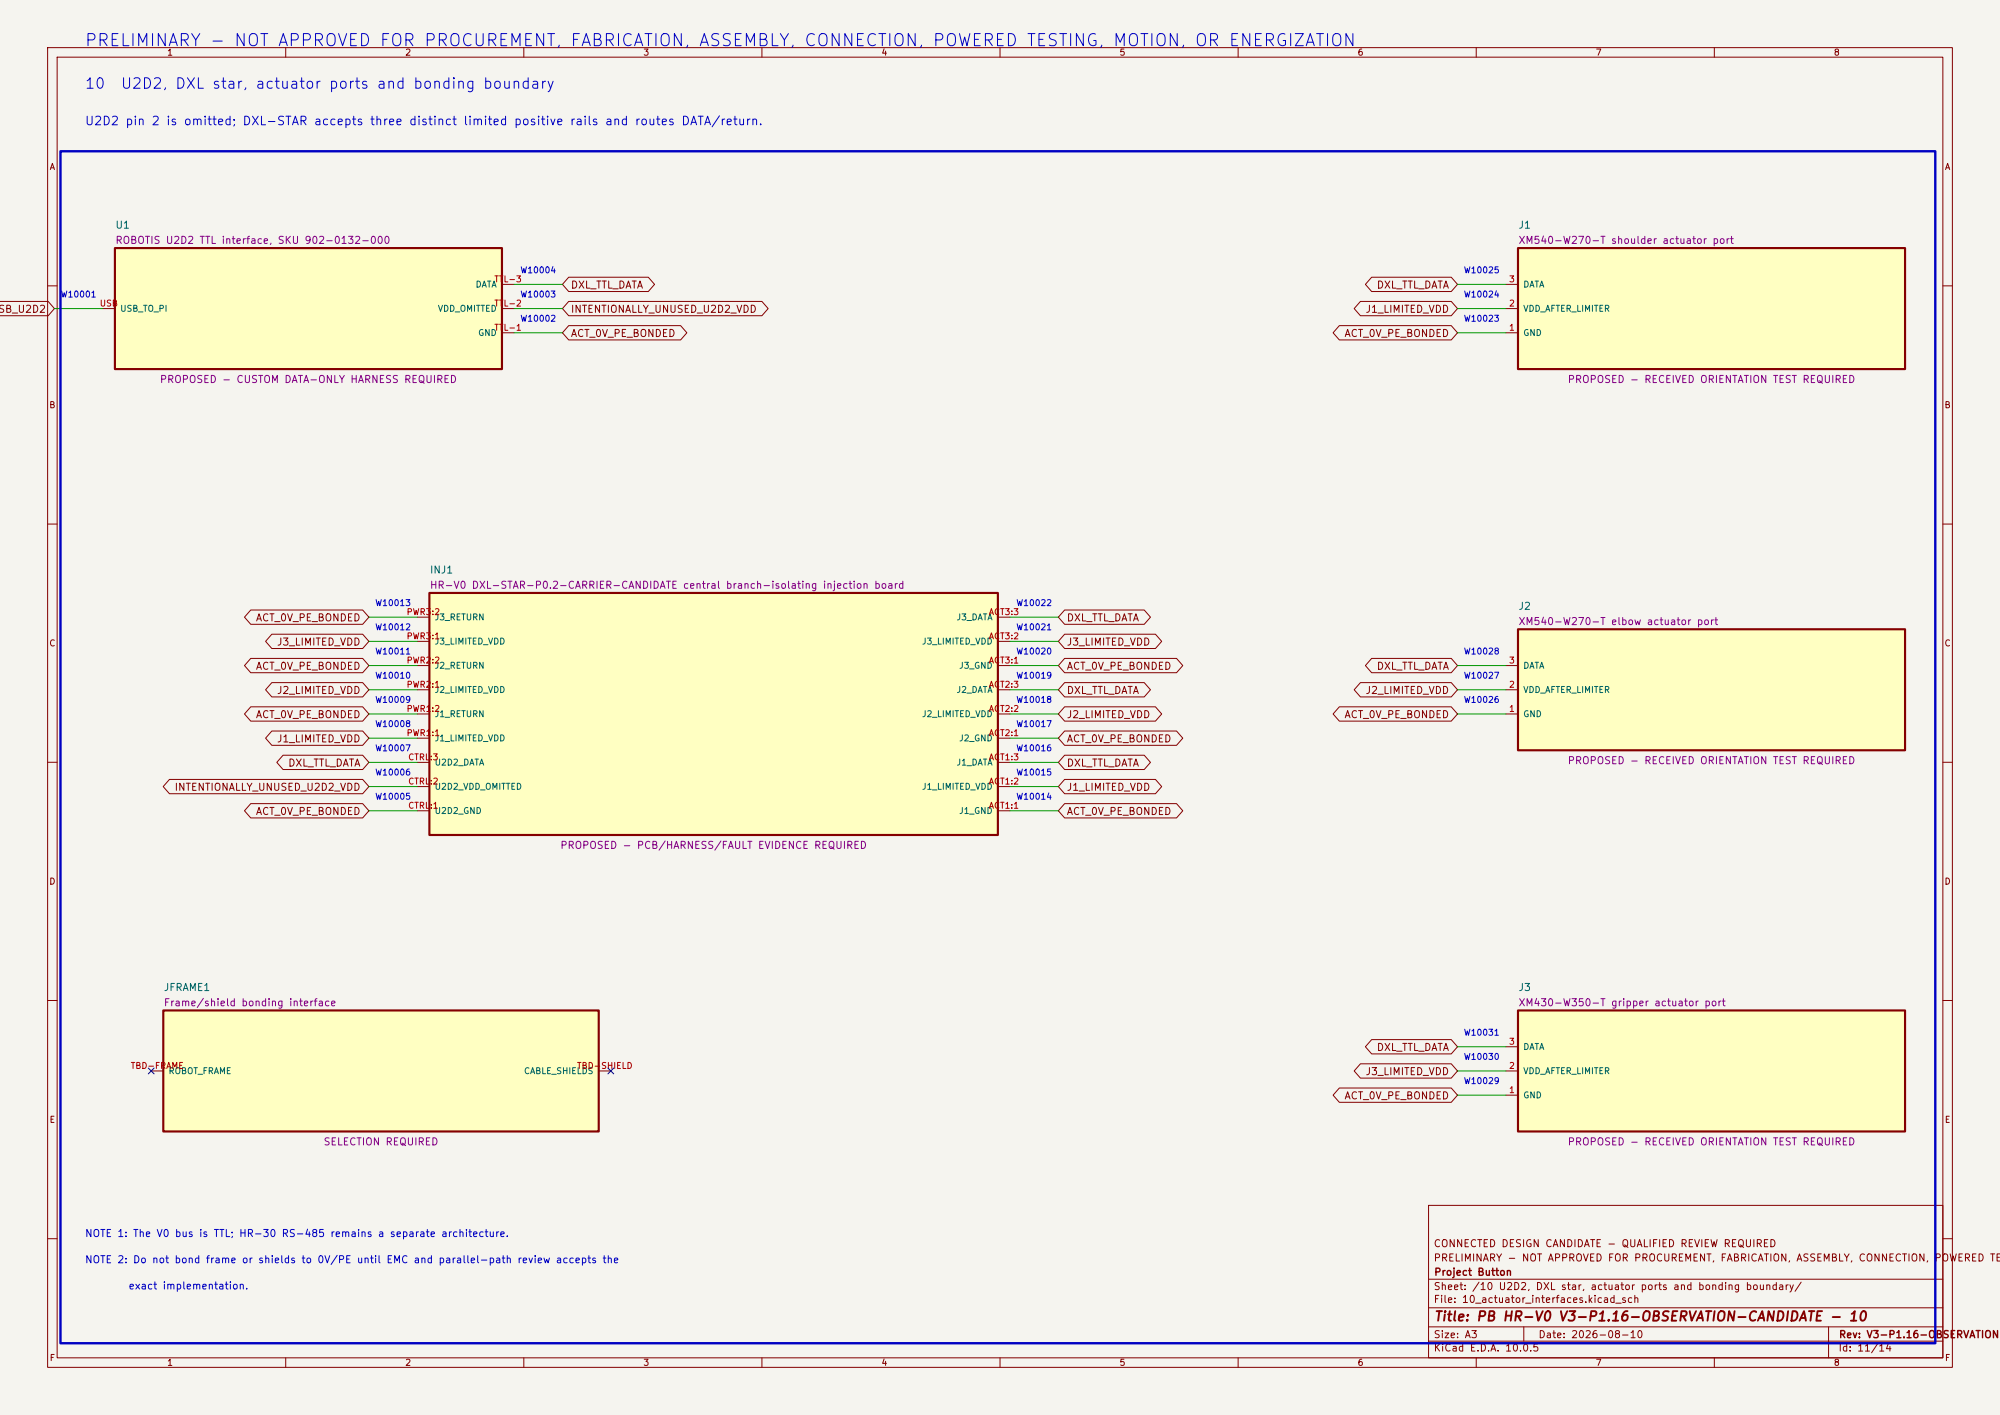
[picture p141: page 11]

VDD_OMITTEDTTL-2 DATATTL-3 USB_TO_PI USBU1
ROBOTIS U2D2 TTL interface, SKU 902-0132-000

PROPOSED - CUSTOM DATA-ONLY HARNESS REQUIRED

PROPOSED - RECEIVED ORIENTATION TEST REQUIRED

INJ1
HR-V0 DXL-STAR-P0.2-CARRIER-CANDIDATE central branch-isolating injection board

PROPOSED - PCB/HARNESS/FAULT EVIDENCE REQUIRED

JFRAME1
Frame/shield bonding interface

CONNECTED DESIGN CANDIDATE - QUALIFIED REVIEW REQUIRED Project Button

NOTE 2: Do not bond frame or shields to 0V/PE until EMC and parallel-path review accepts the

Sheet: /10 U2D2, DXL star, actuator ports and bonding boundary/ File: 10_actuator_interfaces.kicad_sch

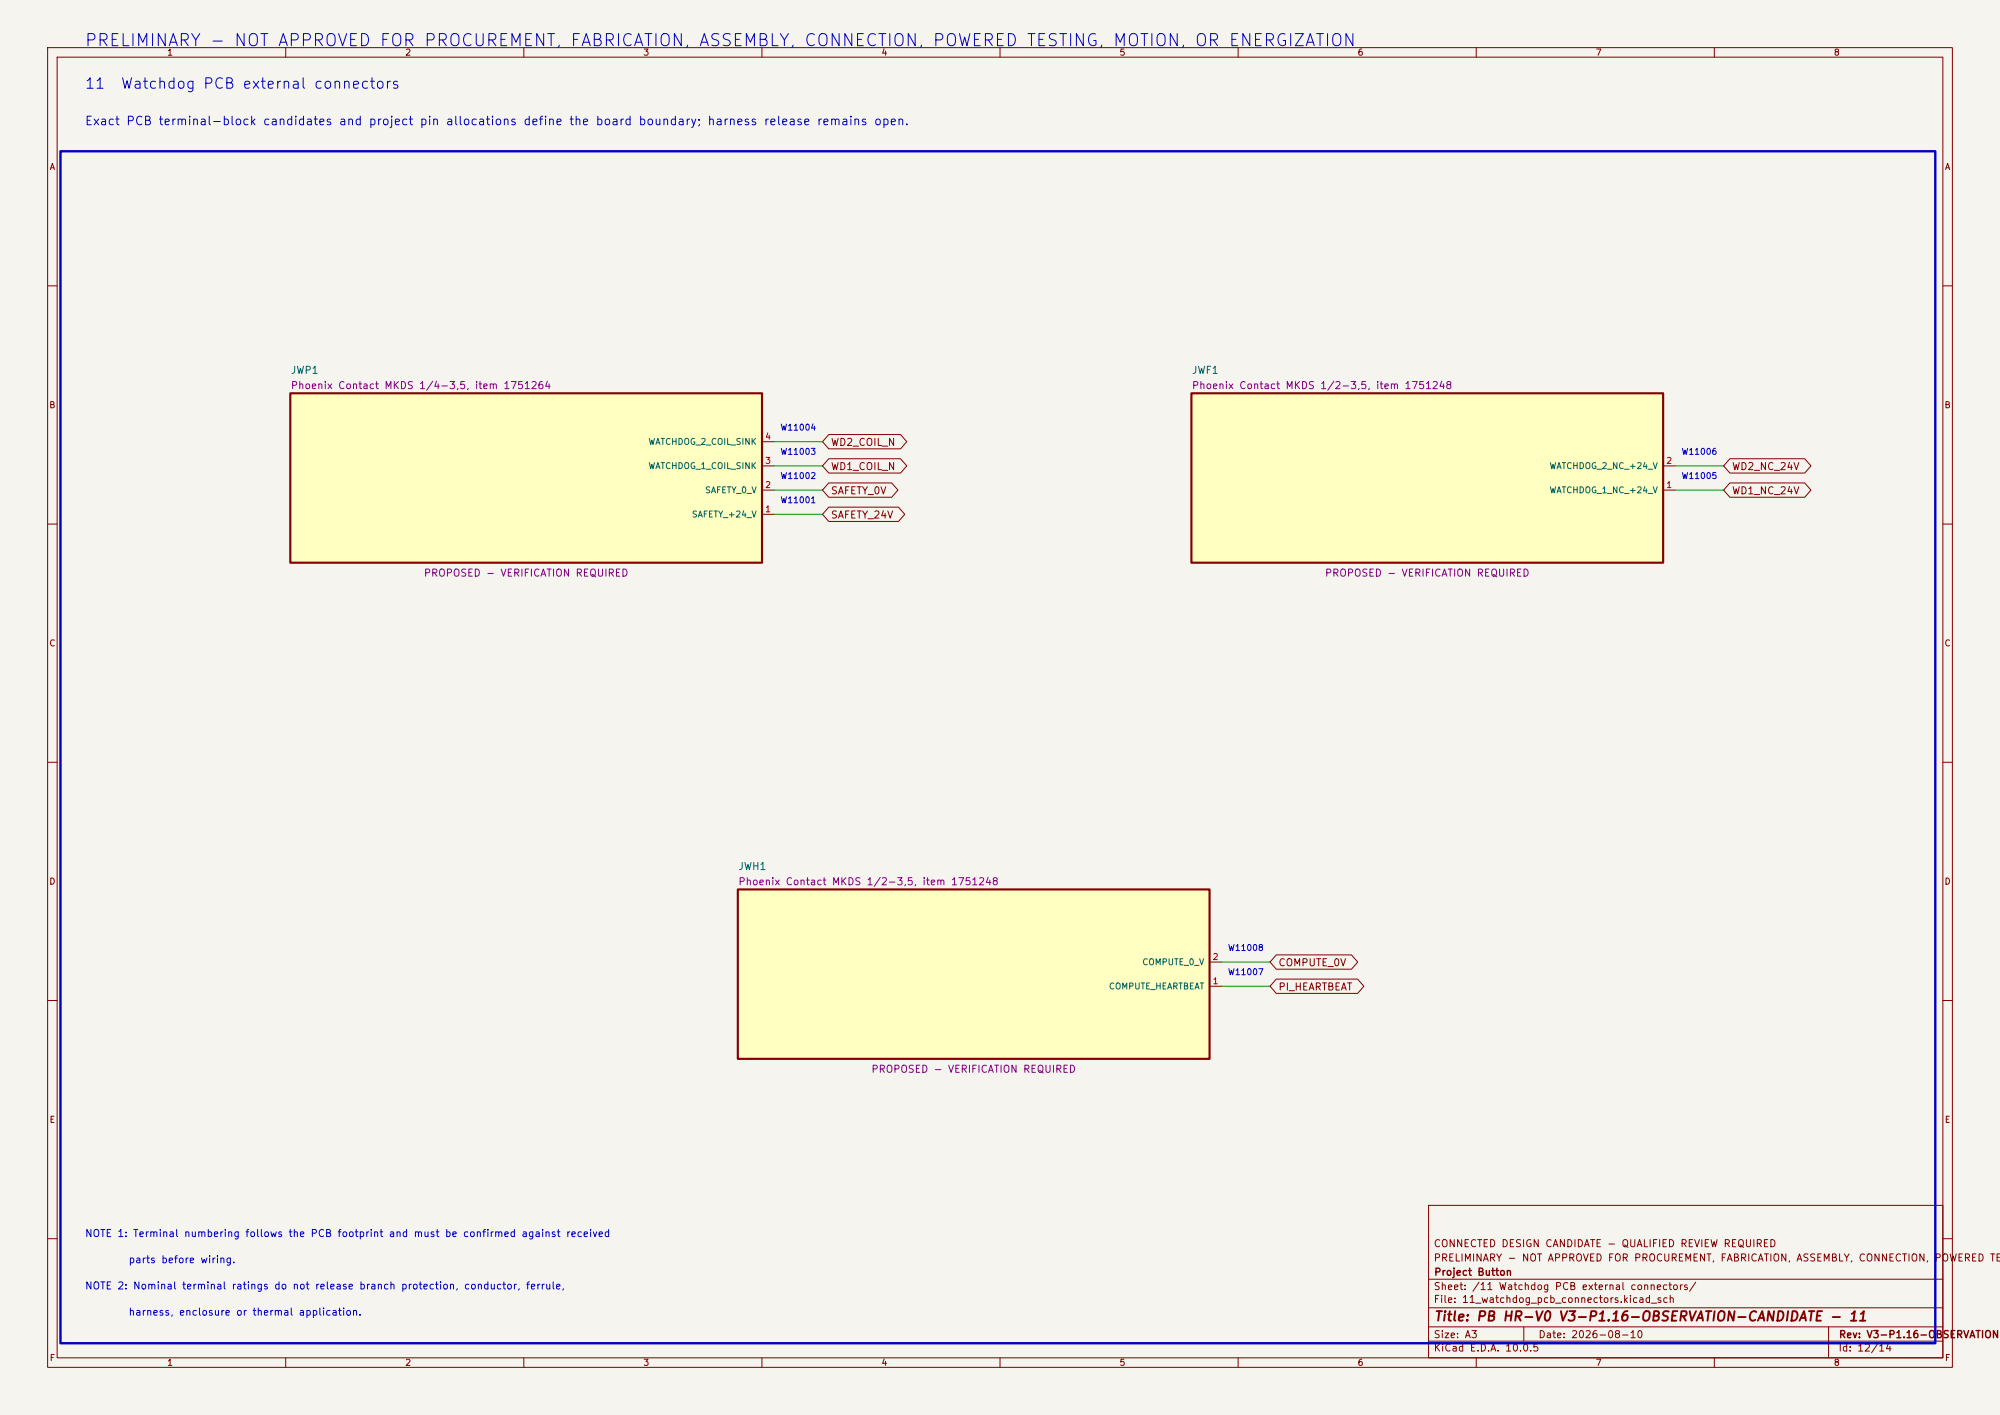
[picture p142: page 12]

11 Watchdog PCB external connectors

Exact PCB terminal-block candidates and project pin allocations define the board boundary; harness release remains open.

JWP1
Phoenix Contact MKDS 1/4-3,5, item 1751264

JWF1
Phoenix Contact MKDS 1/2-3,5, item 1751248

JWH1

W11008 NOTE 1: Terminal numbering follows the PCB footprint and must be confirmed against received

CONNECTED DESIGN CANDIDATE - QUALIFIED REVIEW REQUIRED Project Button

NOTE 2: Nominal terminal ratings do not release branch protection, conductor, ferrule,

Sheet: /11 Watchdog PCB external connectors/ File: 11_watchdog_pcb_connectors.kicad_sch

harness, enclosure or thermal application.

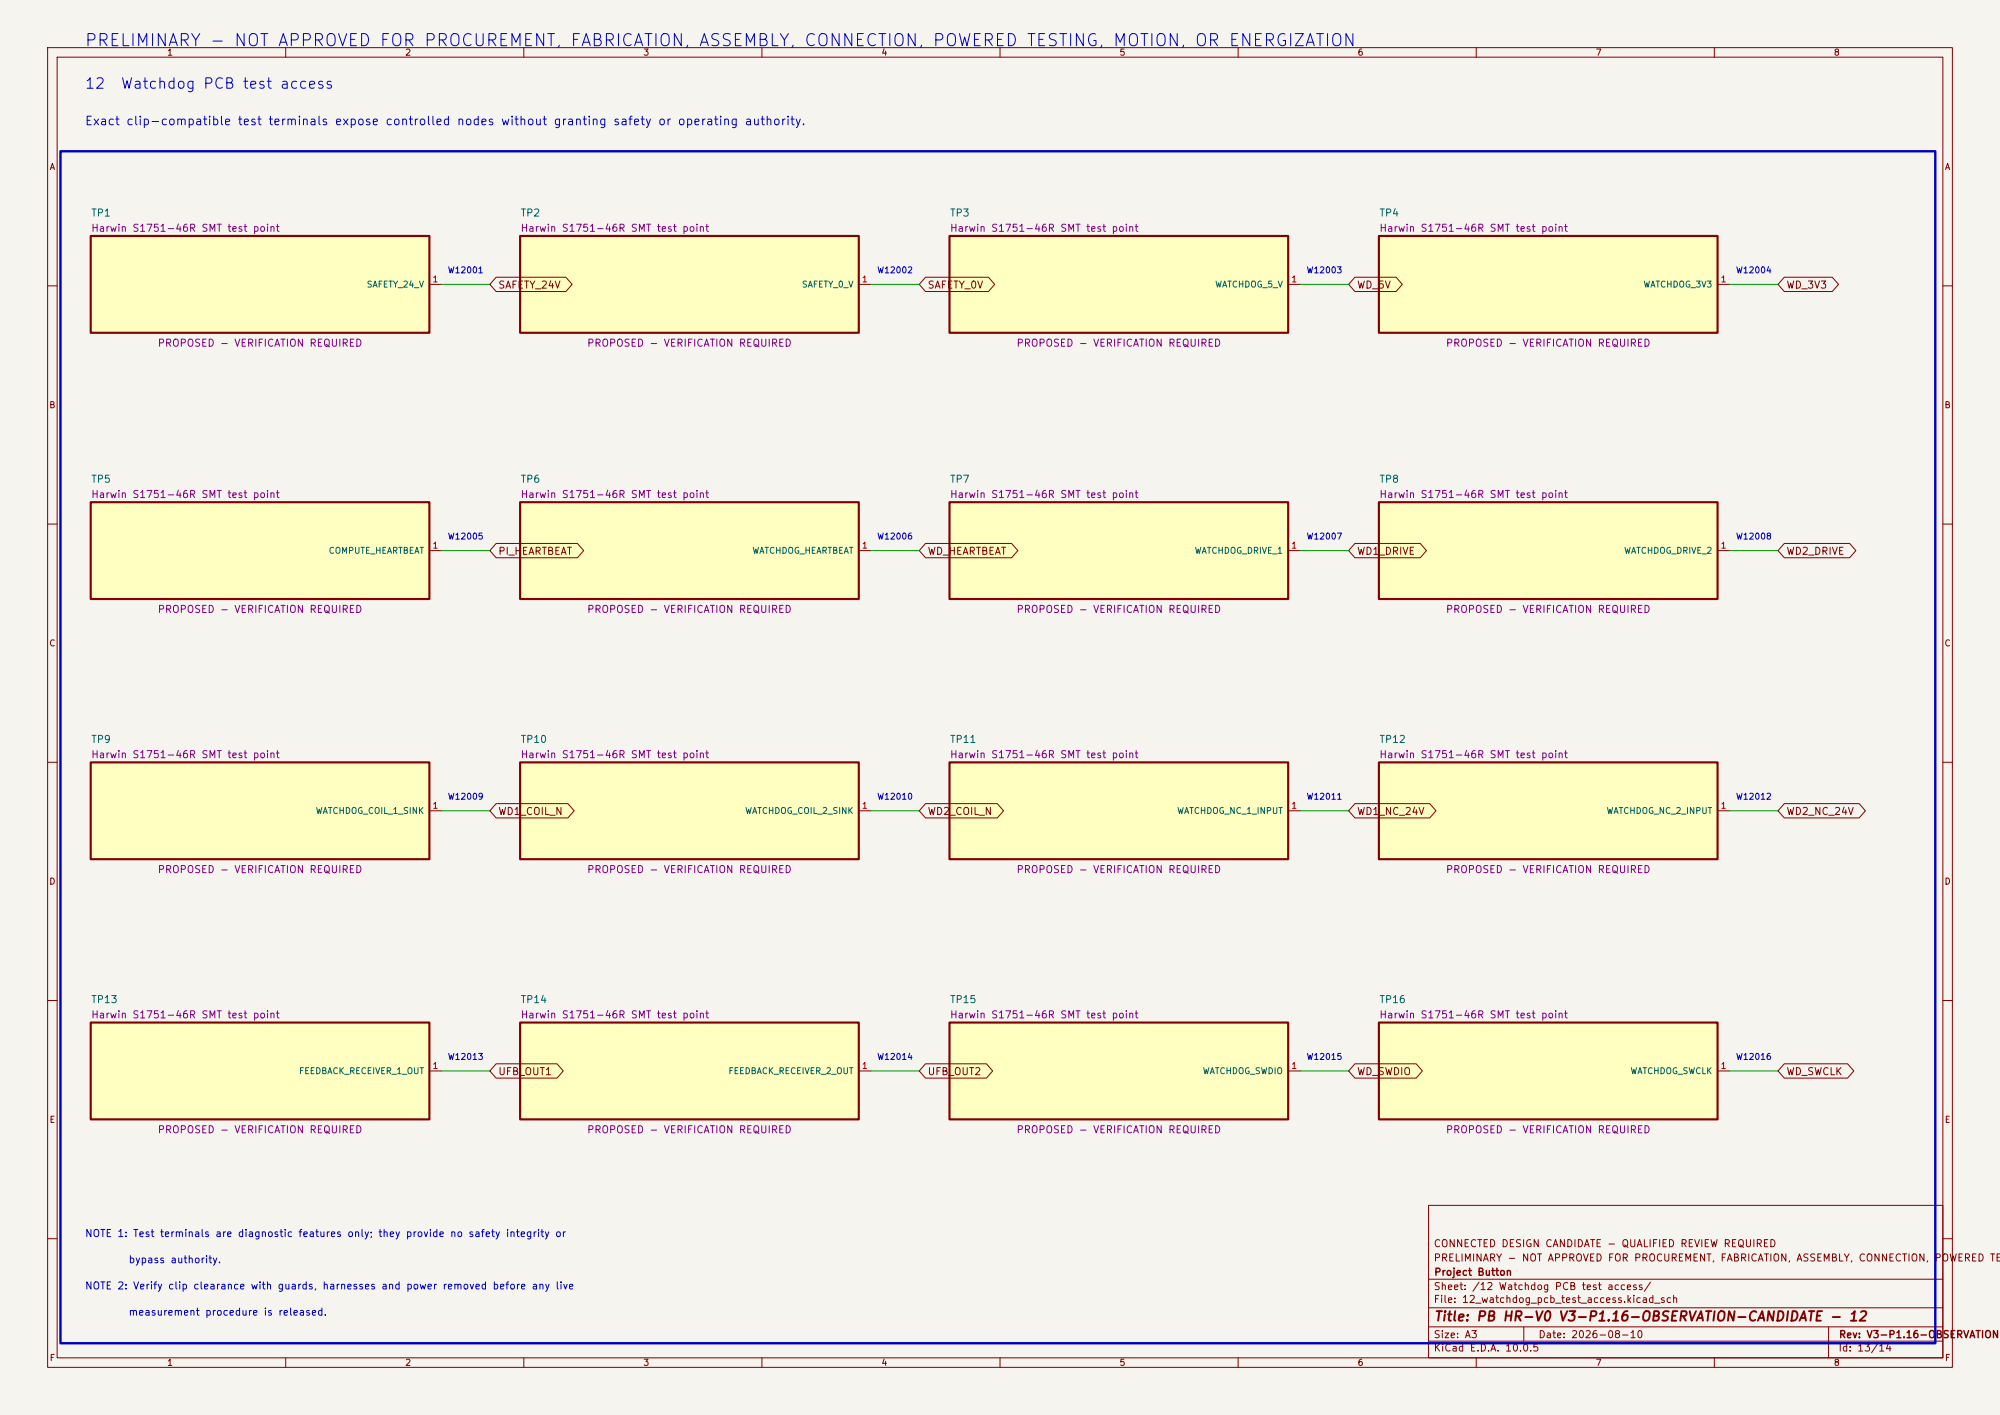
[picture p143: page 13]

W12001 PRELIMINARY - NOT APPROVED FOR PROCUREMENT, FABRICATION, ASSEMBLY, CONNECTION, POWERED TESTING, MOTION, OR ENERGIZATION

12 Watchdog PCB test access

Exact clip-compatible test terminals expose controlled nodes without granting safety or operating authority. W12005 NOTE 1: Test terminals are diagnostic features only; they provide no safety integrity or bypass authority.

Harwin S1751-46R SMT test point

CONNECTED DESIGN CANDIDATE - QUALIFIED REVIEW REQUIRED Project Button

NOTE 2: Verify clip clearance with guards, harnesses and power removed before any live

Sheet: /12 Watchdog PCB test access/ File: 12_watchdog_pcb_test_access.kicad_sch

measurement procedure is released.

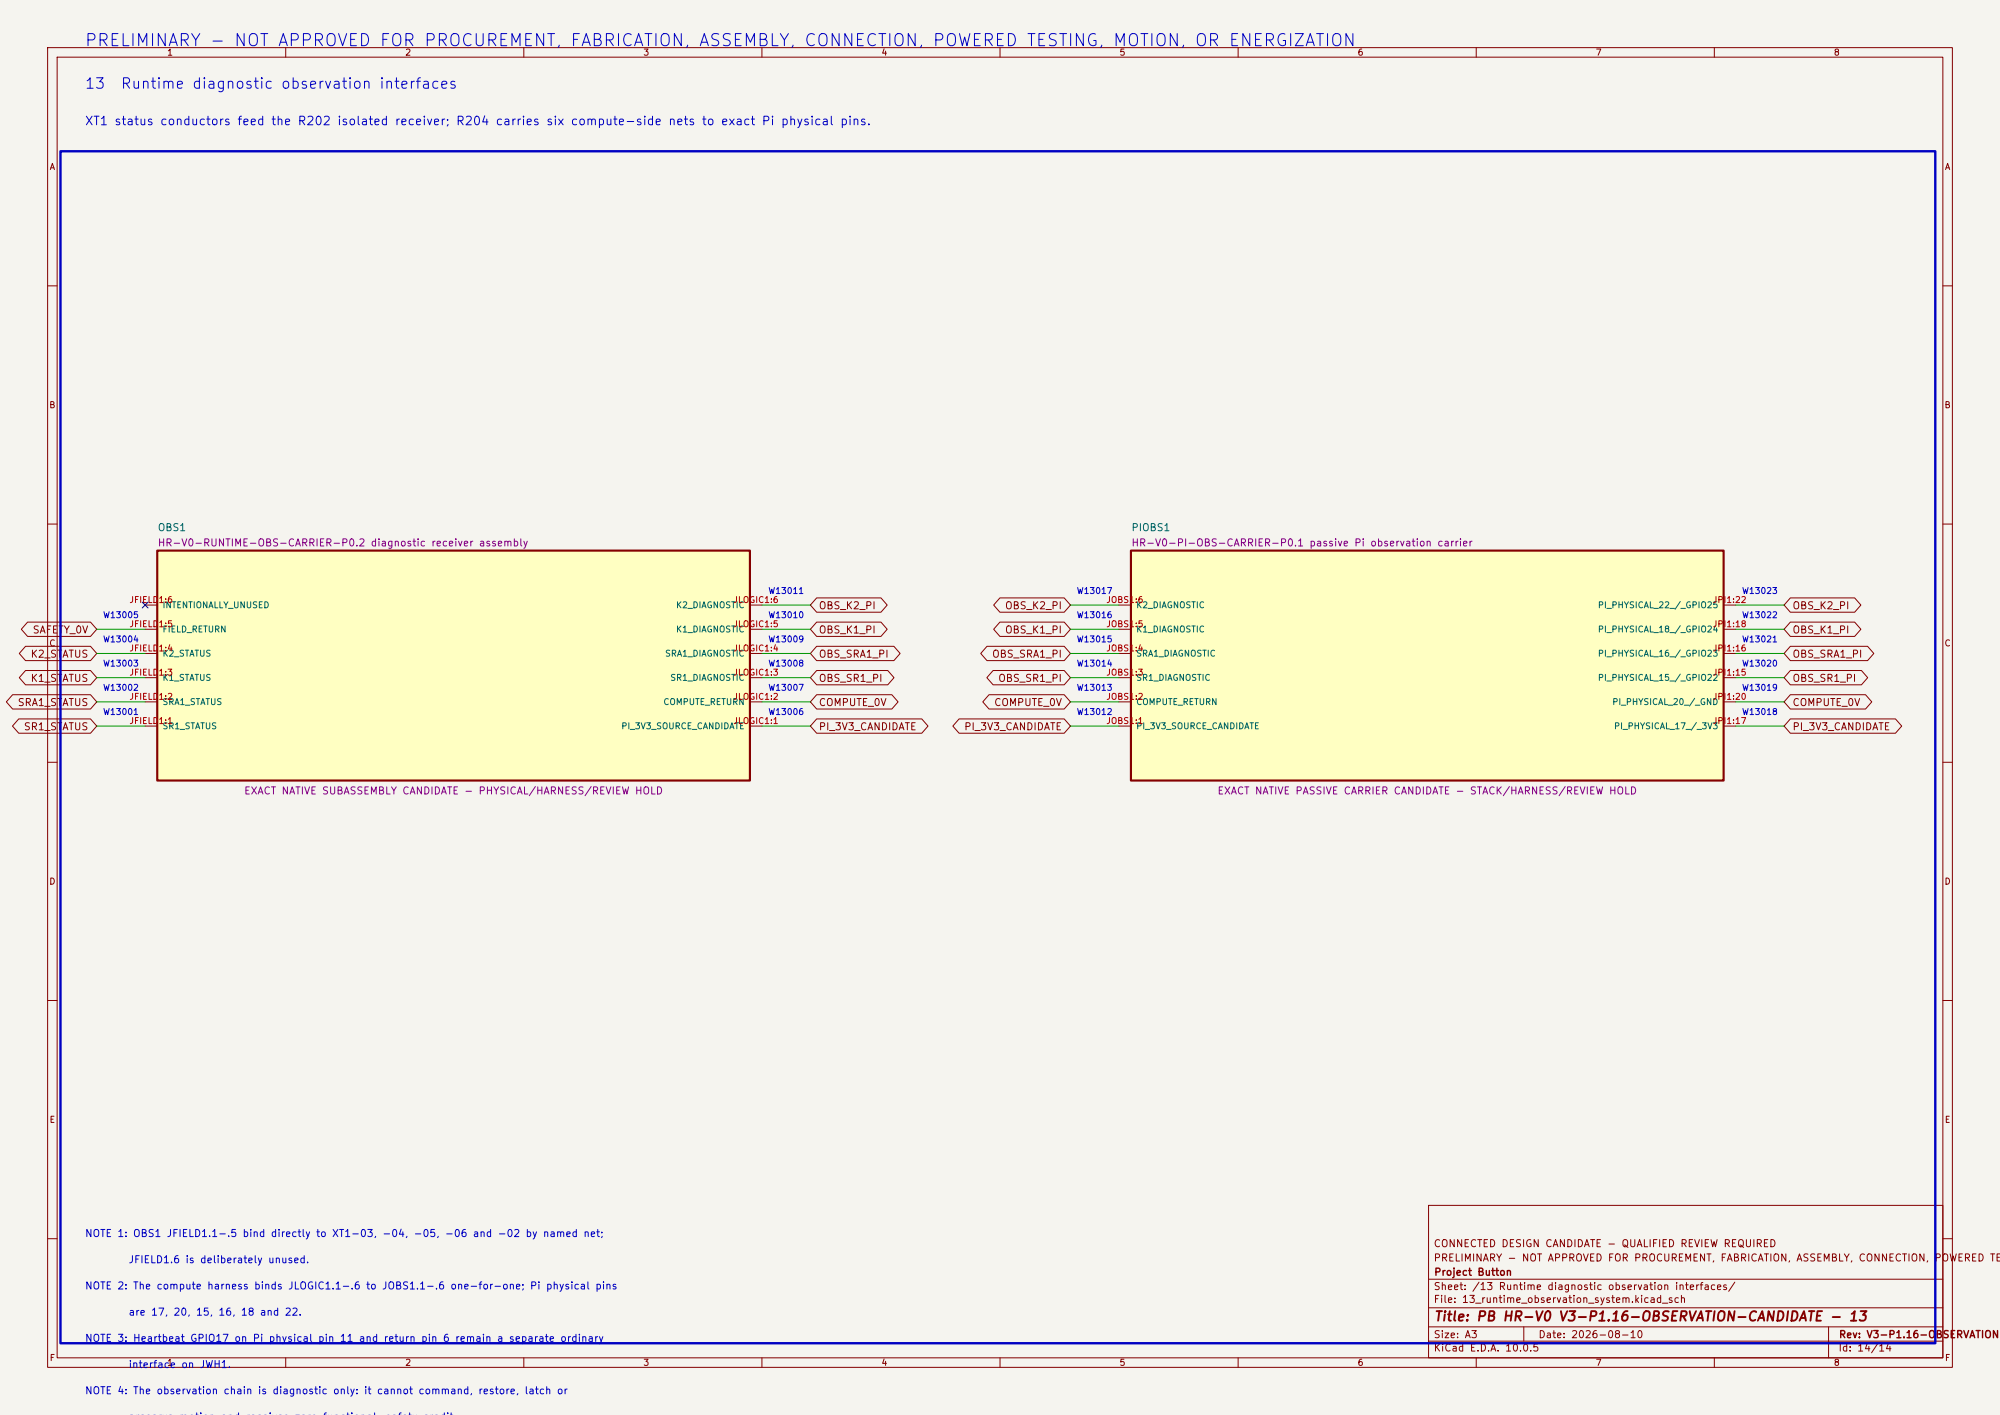
[picture p144: page 14]

XT1 status conductors feed the R202 isolated receiver; R204 carries six compute-side nets to exact Pi physical pins.

SRA1_DIAGNOSTICJLOGIC1:4 K1_DIAGNOSTICJLOGIC1:5 K2_DIAGNOSTICJLOGIC1:6 OBS1
HR-V0-PI-OBS-CARRIER-P0.1 passive Pi observation carrier SR1_STATUS JFIELD1:1

HR-V0-RUNTIME-OBS-CARRIER-P0.2 diagnostic receiver assembly

W13001 NOTE 1: OBS1 JFIELD1.1-.5 bind directly to XT1-03, -04, -05, -06 and -02 by named net;

EXACT NATIVE SUBASSEMBLY CANDIDATE - PHYSICAL/HARNESS/REVIEW HOLD

EXACT NATIVE PASSIVE CARRIER CANDIDATE - STACK/HARNESS/REVIEW HOLD

CONNECTED DESIGN CANDIDATE - QUALIFIED REVIEW REQUIRED Project Button

NOTE 2: The compute harness binds JLOGIC1.1-.6 to JOBS1.1-.6 one-for-one; Pi physical pins are 17, 20, 15, 16, 18 and 22.

Sheet: /13 Runtime diagnostic observation interfaces/ File: 13_runtime_observation_system.kicad_sch

NOTE 3: Heartbeat GPIO17 on Pi physical pin 11 and return pin 6 remain a separate ordinary

NOTE 4: The observation chain is diagnostic only: it cannot command, restore, latch or

preserve motion and receives zero functional-safety credit.
