amyleesterling/humanoid-robot/electrical/kicad/project-button-v3-p1.19-visual-correction-candidate/output/project-button-v3-p1.19-visual-correction-candidate-preliminary.pdf

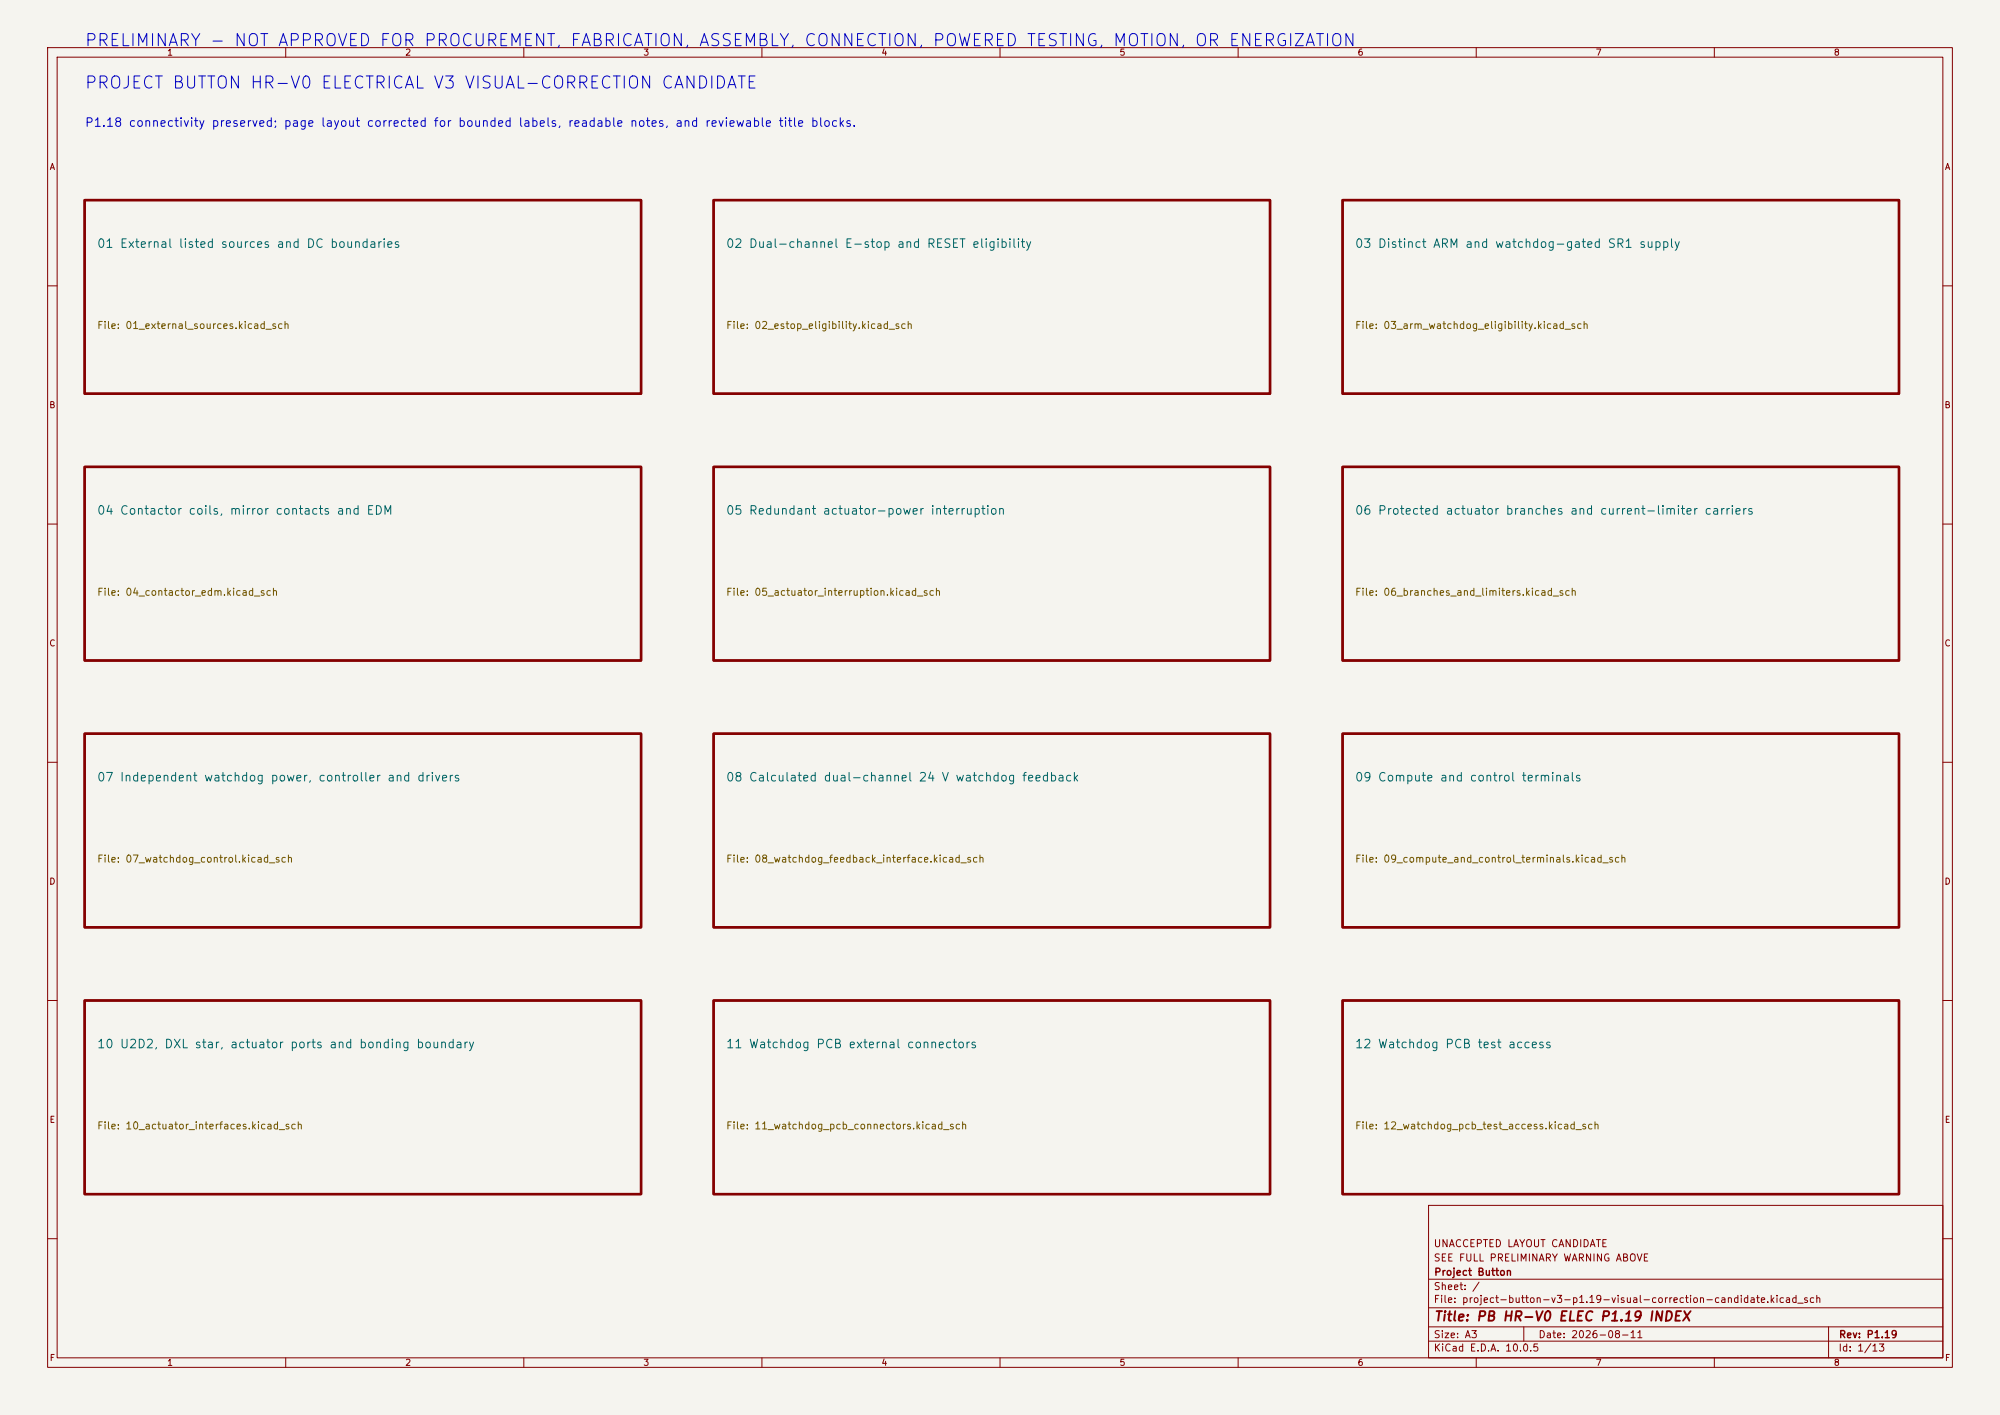
[picture p172: page 1]

PRELIMINARY - NOT APPROVED FOR PROCUREMENT, FABRICATION, ASSEMBLY, CONNECTION, POWERED TESTING, MOTION, OR ENERGIZATION

PROJECT BUTTON HR-V0 ELECTRICAL V3 VISUAL-CORRECTION CANDIDATE

P1.18 connectivity preserved; page layout corrected for bounded labels, readable notes, and reviewable title blocks.

01 External listed sources and DC boundaries

02 Dual-channel E-stop and RESET eligibility

03 Distinct ARM and watchdog-gated SR1 supply

04 Contactor coils, mirror contacts and EDM

05 Redundant actuator-power interruption

06 Protected actuator branches and current-limiter carriers

07 Independent watchdog power, controller and drivers

08 Calculated dual-channel 24 V watchdog feedback

09 Compute and control terminals

10 U2D2, DXL star, actuator ports and bonding boundary

11 Watchdog PCB external connectors

12 Watchdog PCB test access

UNACCEPTED LAYOUT CANDIDATE
SEE FULL PRELIMINARY WARNING ABOVE
Project Button
Sheet: /
File: project-button-v3-p1.19-visual-correction-candidate.kicad_sch
Title: PB HR-V0 ELEC P1.19 INDEX

Size: A3 | Rev: P1.19 | F Date: 2026-08-11
KiCad E.D.A. 10.0.5 | Id: 1/13

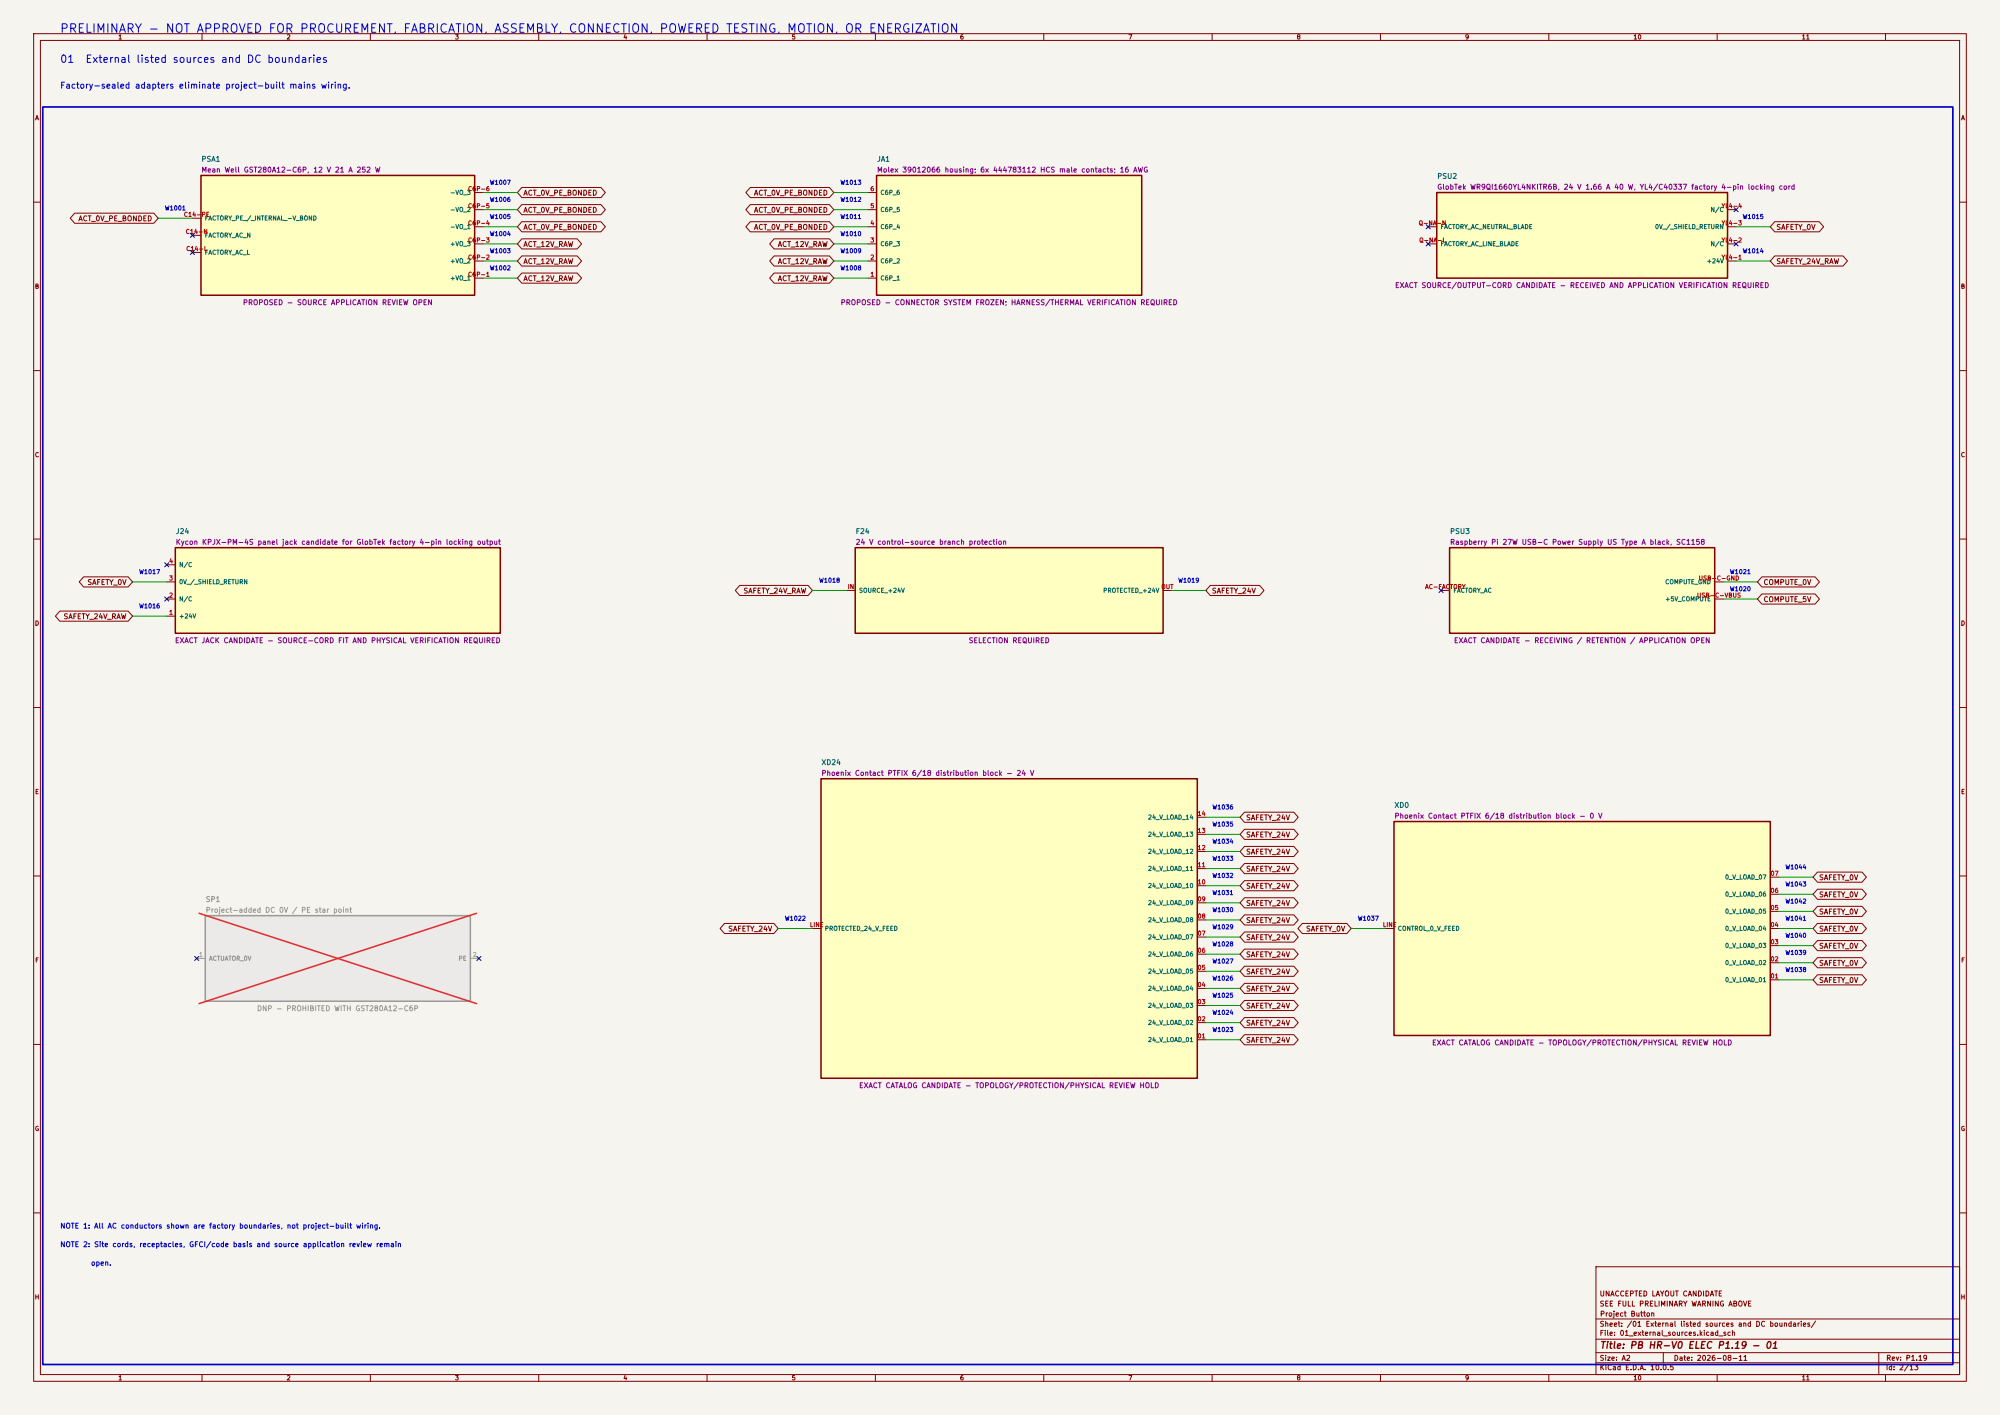
[picture p173: page 2]

PRELIMINARY - NOT APPROVED FOR PROCUREMENT, FABRICATION, ASSEMBLY, CONNECTION, POWERED TESTING, MOTION, OR ENERGIZATION

01 External listed sources and DC boundaries

Factory-sealed adapters eliminate project-built mains wiring.

Molex 39012066 housing; 6x 444783112 HCS male contacts; 16 AWG

YL4-4 PSU2
GlobTek WR9QI1660YL4NKITR6B, 24 V 1.66 A 40 W, YL4/C40337 factory 4-pin locking cord

Kycon KPJX-PM-4S panel jack candidate for GlobTek factory 4-pin locking output +VO_1C6P-1 +VO_2C6P-2 +VO_3C6P-3 -VO_1C6P-4 -VO_2C6P-5 -VO_3C6P-6

EXACT SOURCE/OUTPUT-CORD CANDIDATE - RECEIVED AND APPLICATION VERIFICATION REQUIRED

PROPOSED - SOURCE APPLICATION REVIEW OPEN

PROPOSED - CONNECTOR SYSTEM FROZEN; HARNESS/THERMAL VERIFICATION REQUIRED

24 V control-source branch protection

Raspberry Pi 27W USB-C Power Supply US Type A black, SC1158

EXACT JACK CANDIDATE - SOURCE-CORD FIT AND PHYSICAL VERIFICATION REQUIRED

EXACT CANDIDATE - RECEIVING / RETENTION / APPLICATION OPEN

14 PROTECTED_24_V_FEED LINEXD24
Phoenix Contact PTFIX 6/18 distribution block - 24 V

LINEXD0
Phoenix Contact PTFIX 6/18 distribution block - 0 V

EXACT CATALOG CANDIDATE - TOPOLOGY/PROTECTION/PHYSICAL REVIEW HOLD

UNACCEPTED LAYOUT CANDIDATE
SEE FULL PRELIMINARY WARNING ABOVE
Project Button
Sheet: /01 External listed sources and DC boundaries/
File: 01_external_sources.kicad_sch
Title: PB HR-V0 ELEC P1.19 - 01

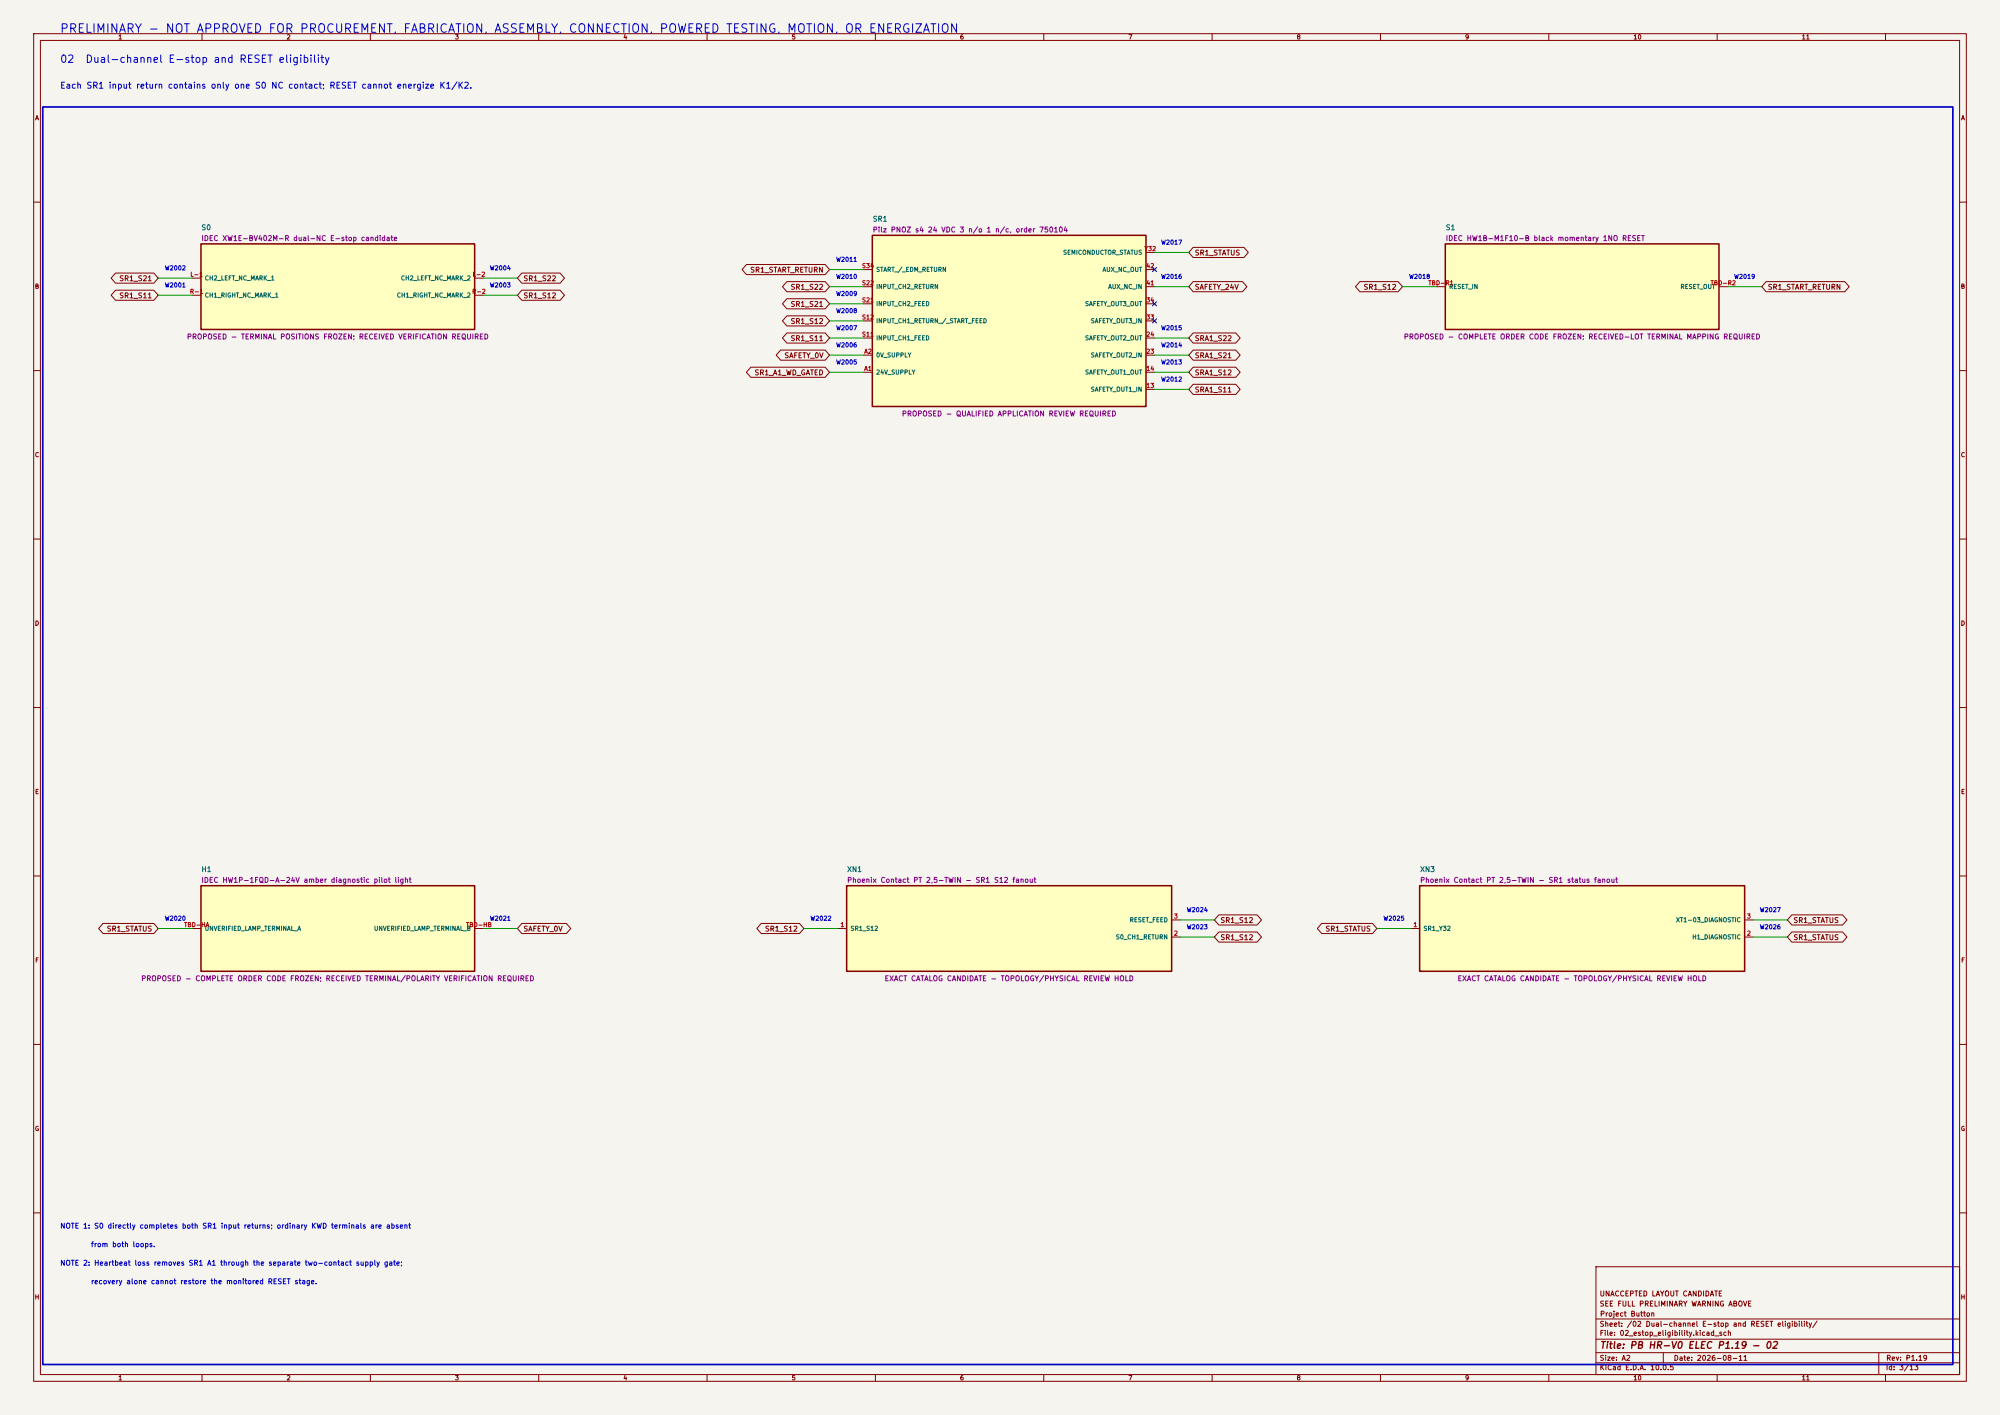
[picture p174: page 3]

W2010 PRELIMINARY - NOT APPROVED FOR PROCUREMENT, FABRICATION, ASSEMBLY, CONNECTION, POWERED TESTING, MOTION, OR ENERGIZATION

02 Dual-channel E-stop and RESET eligibility

SEMICONDUCTOR_STATUS Y32 SR1
Pilz PNOZ s4 24 VDC 3 n/o 1 n/c, order 750104

IDEC XW1E-BV402M-R dual-NC E-stop candidate

PROPOSED - TERMINAL POSITIONS FROZEN; RECEIVED VERIFICATION REQUIRED

PROPOSED - COMPLETE ORDER CODE FROZEN; RECEIVED-LOT TERMINAL MAPPING REQUIRED

PROPOSED - QUALIFIED APPLICATION REVIEW REQUIRED

IDEC HW1P-1FQD-A-24V amber diagnostic pilot light

Phoenix Contact PT 2,5-TWIN - SR1 S12 fanout

Phoenix Contact PT 2,5-TWIN - SR1 status fanout

PROPOSED - COMPLETE ORDER CODE FROZEN; RECEIVED TERMINAL/POLARITY VERIFICATION REQUIRED

EXACT CATALOG CANDIDATE - TOPOLOGY/PHYSICAL REVIEW HOLD

NOTE 1: S0 directly completes both SR1 input returns; ordinary KWD terminals are absent

NOTE 2: Heartbeat loss removes SR1 A1 through the separate two-contact supply gate;

recovery alone cannot restore the monitored RESET stage.

UNACCEPTED LAYOUT CANDIDATE
SEE FULL PRELIMINARY WARNING ABOVE
Project Button
Sheet: /02 Dual-channel E-stop and RESET eligibility/
File: 02_estop_eligibility.kicad_sch

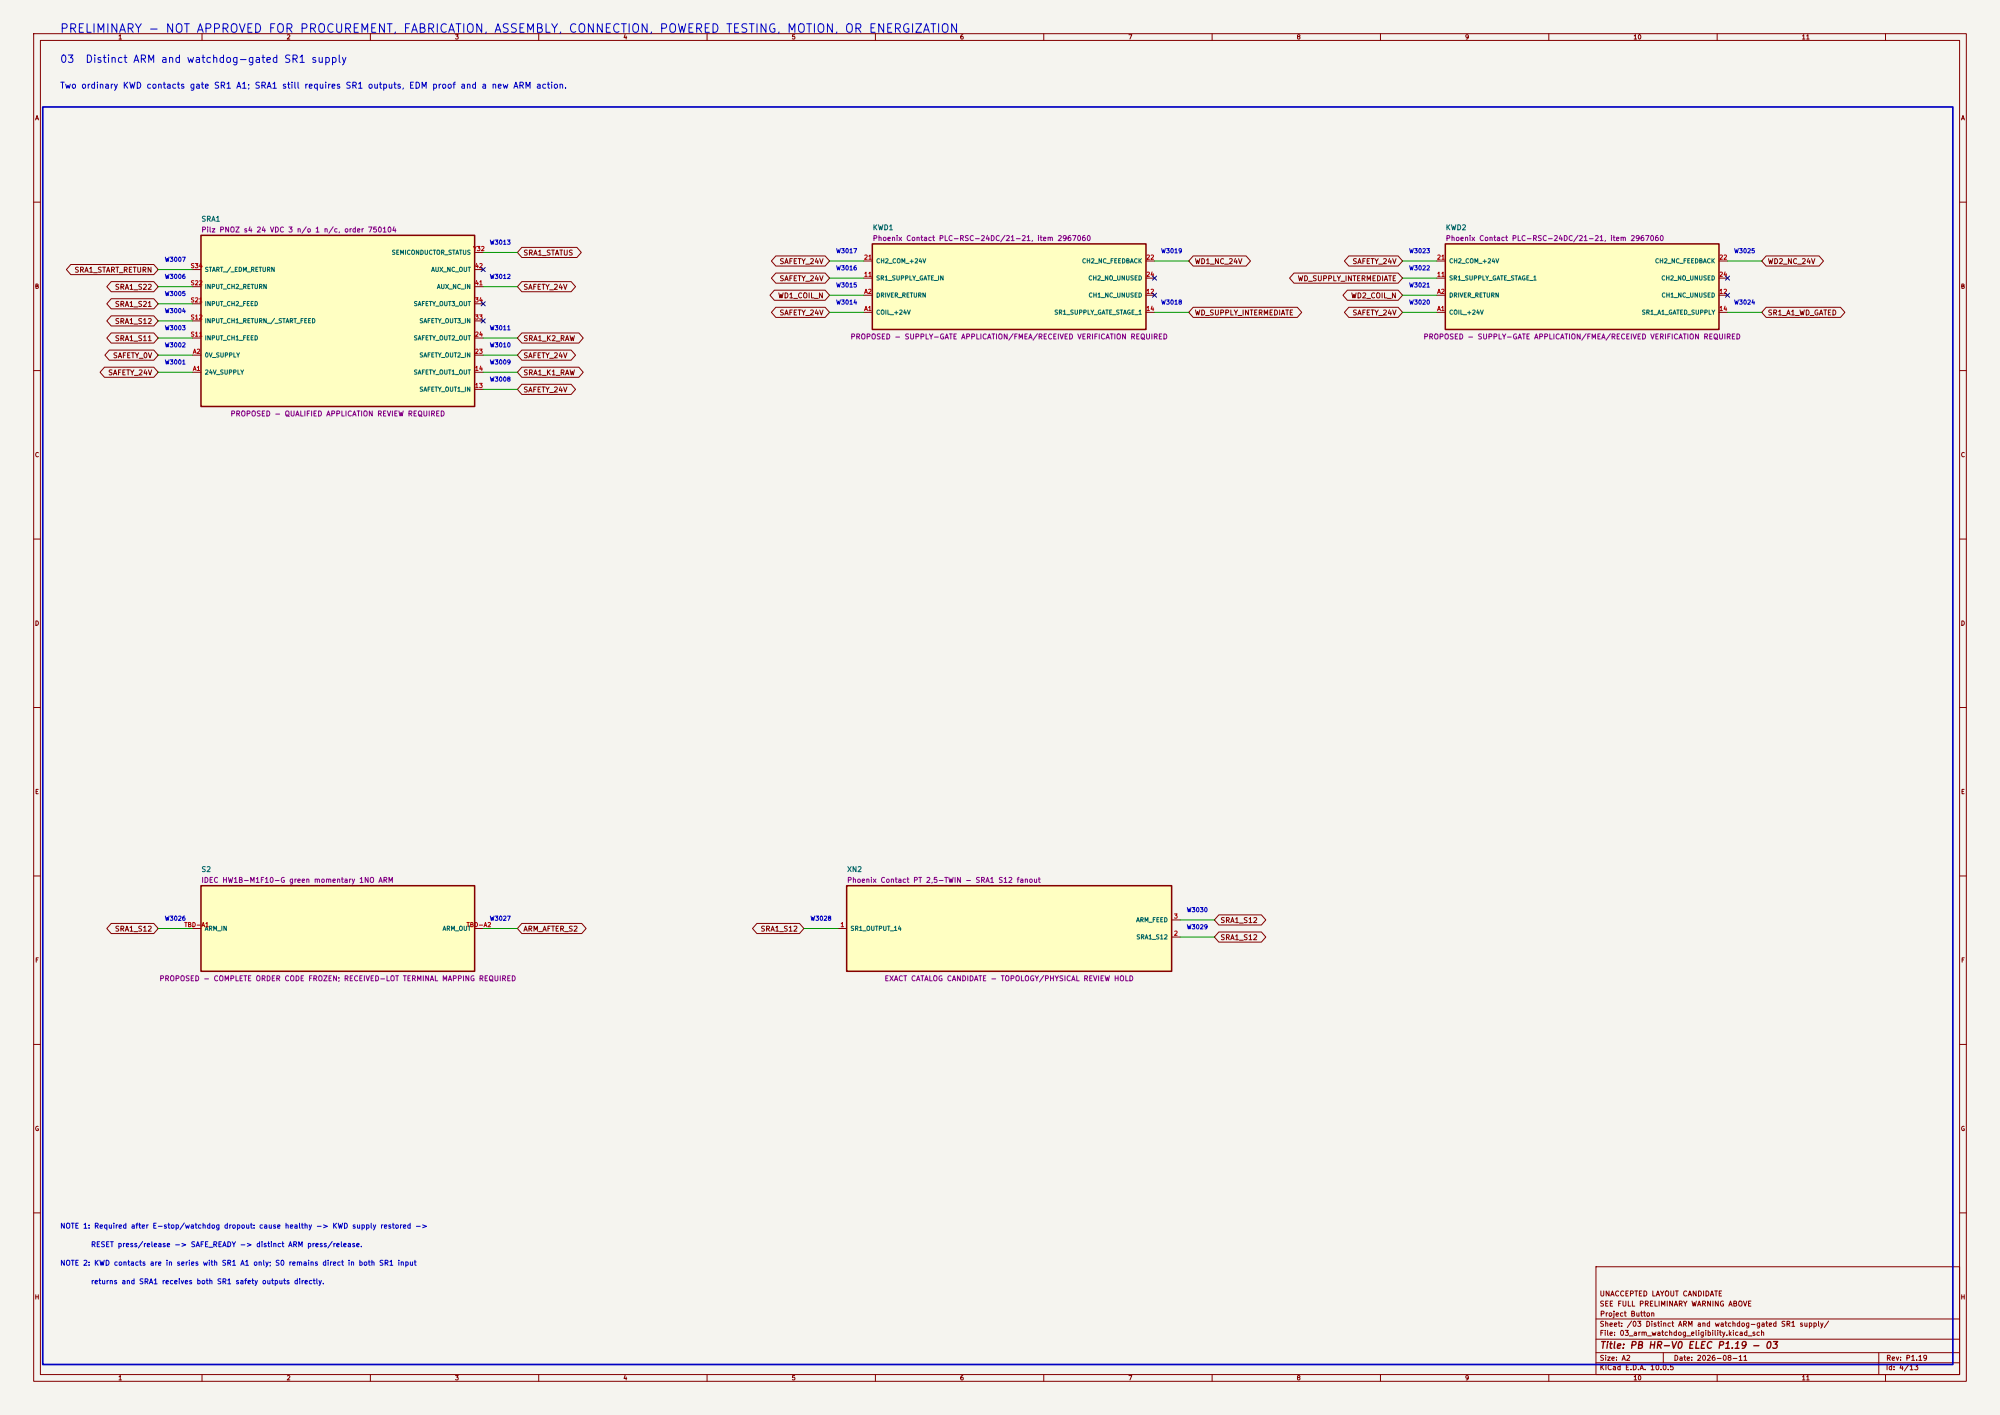
[picture p175: page 4]

03 Distinct ARM and watchdog-gated SR1 supply

Two ordinary KWD contacts gate SR1 A1; SRA1 still requires SR1 outputs, EDM proof and a new ARM action.

SEMICONDUCTOR_STATUS Y32 SRA1
Pilz PNOZ s4 24 VDC 3 n/o 1 n/c, order 750104

Phoenix Contact PLC-RSC-24DC/21-21, item 2967060

A2KWD2

PROPOSED - SUPPLY-GATE APPLICATION/FMEA/RECEIVED VERIFICATION REQUIRED

PROPOSED - QUALIFIED APPLICATION REVIEW REQUIRED

IDEC HW1B-M1F10-G green momentary 1NO ARM

Phoenix Contact PT 2,5-TWIN - SRA1 S12 fanout

PROPOSED - COMPLETE ORDER CODE FROZEN; RECEIVED-LOT TERMINAL MAPPING REQUIRED

EXACT CATALOG CANDIDATE - TOPOLOGY/PHYSICAL REVIEW HOLD

NOTE 1: Required after E-stop/watchdog dropout: cause healthy -> KWD supply restored ->

RESET press/release -> SAFE_READY -> distinct ARM press/release.

NOTE 2: KWD contacts are in series with SR1 A1 only; S0 remains direct in both SR1 input

returns and SRA1 receives both SR1 safety outputs directly.

UNACCEPTED LAYOUT CANDIDATE
SEE FULL PRELIMINARY WARNING ABOVE
Project Button
Sheet: /03 Distinct ARM and watchdog-gated SR1 supply/
File: 03_arm_watchdog_eligibility.kicad_sch

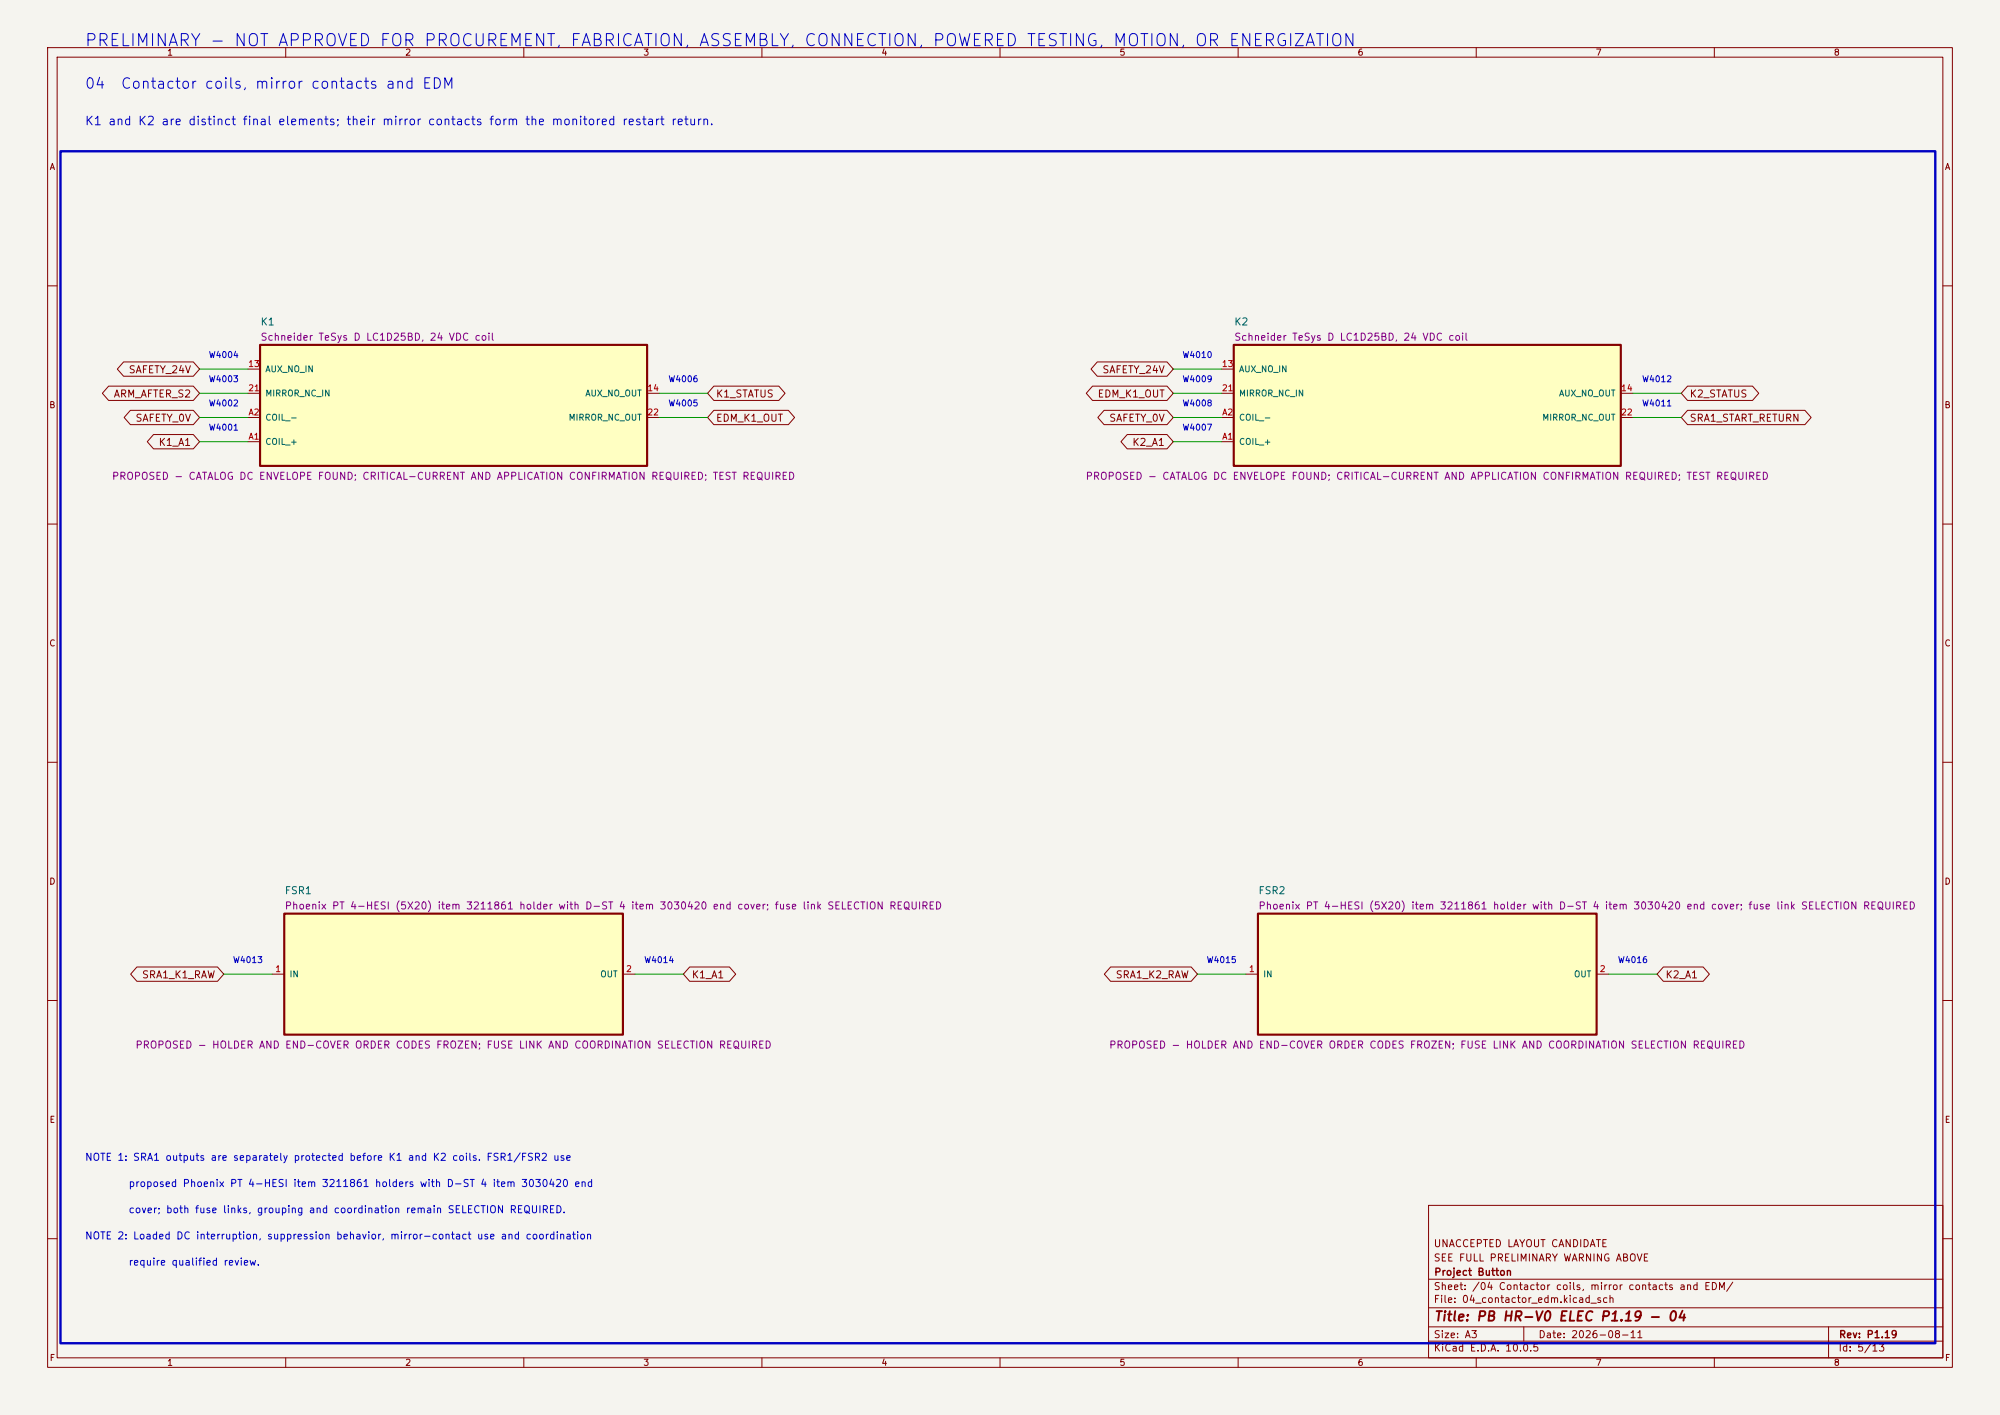
[picture p176: page 5]

PRELIMINARY - NOT APPROVED FOR PROCUREMENT, FABRICATION, ASSEMBLY, CONNECTION, POWERED TESTING, MOTION, OR ENERGIZATION

W4008 W4003 04 Contactor coils, mirror contacts and EDM

Schneider TeSys D LC1D25BD, 24 VDC coil

PROPOSED - CATALOG DC ENVELOPE FOUND; CRITICAL-CURRENT AND APPLICATION CONFIRMATION REQUIRED; TEST REQUIRED

Phoenix PT 4-HESI (5X20) item 3211861 holder with D-ST 4 item 3030420 end cover; fuse link SELECTION REQUIRED

W4014 NOTE 1: SRA1 outputs are separately protected before K1 and K2 coils. FSR1/FSR2 use

PROPOSED - HOLDER AND END-COVER ORDER CODES FROZEN; FUSE LINK AND COORDINATION SELECTION REQUIRED

proposed Phoenix PT 4-HESI item 3211861 holders with D-ST 4 item 3030420 end

cover; both fuse links, grouping and coordination remain SELECTION REQUIRED.

NOTE 2: Loaded DC interruption, suppression behavior, mirror-contact use and coordination

UNACCEPTED LAYOUT CANDIDATE SEE FULL PRELIMINARY WARNING ABOVE Project Button

Sheet: /04 Contactor coils, mirror contacts and EDM/ File: 04_contactor_edm.kicad_sch

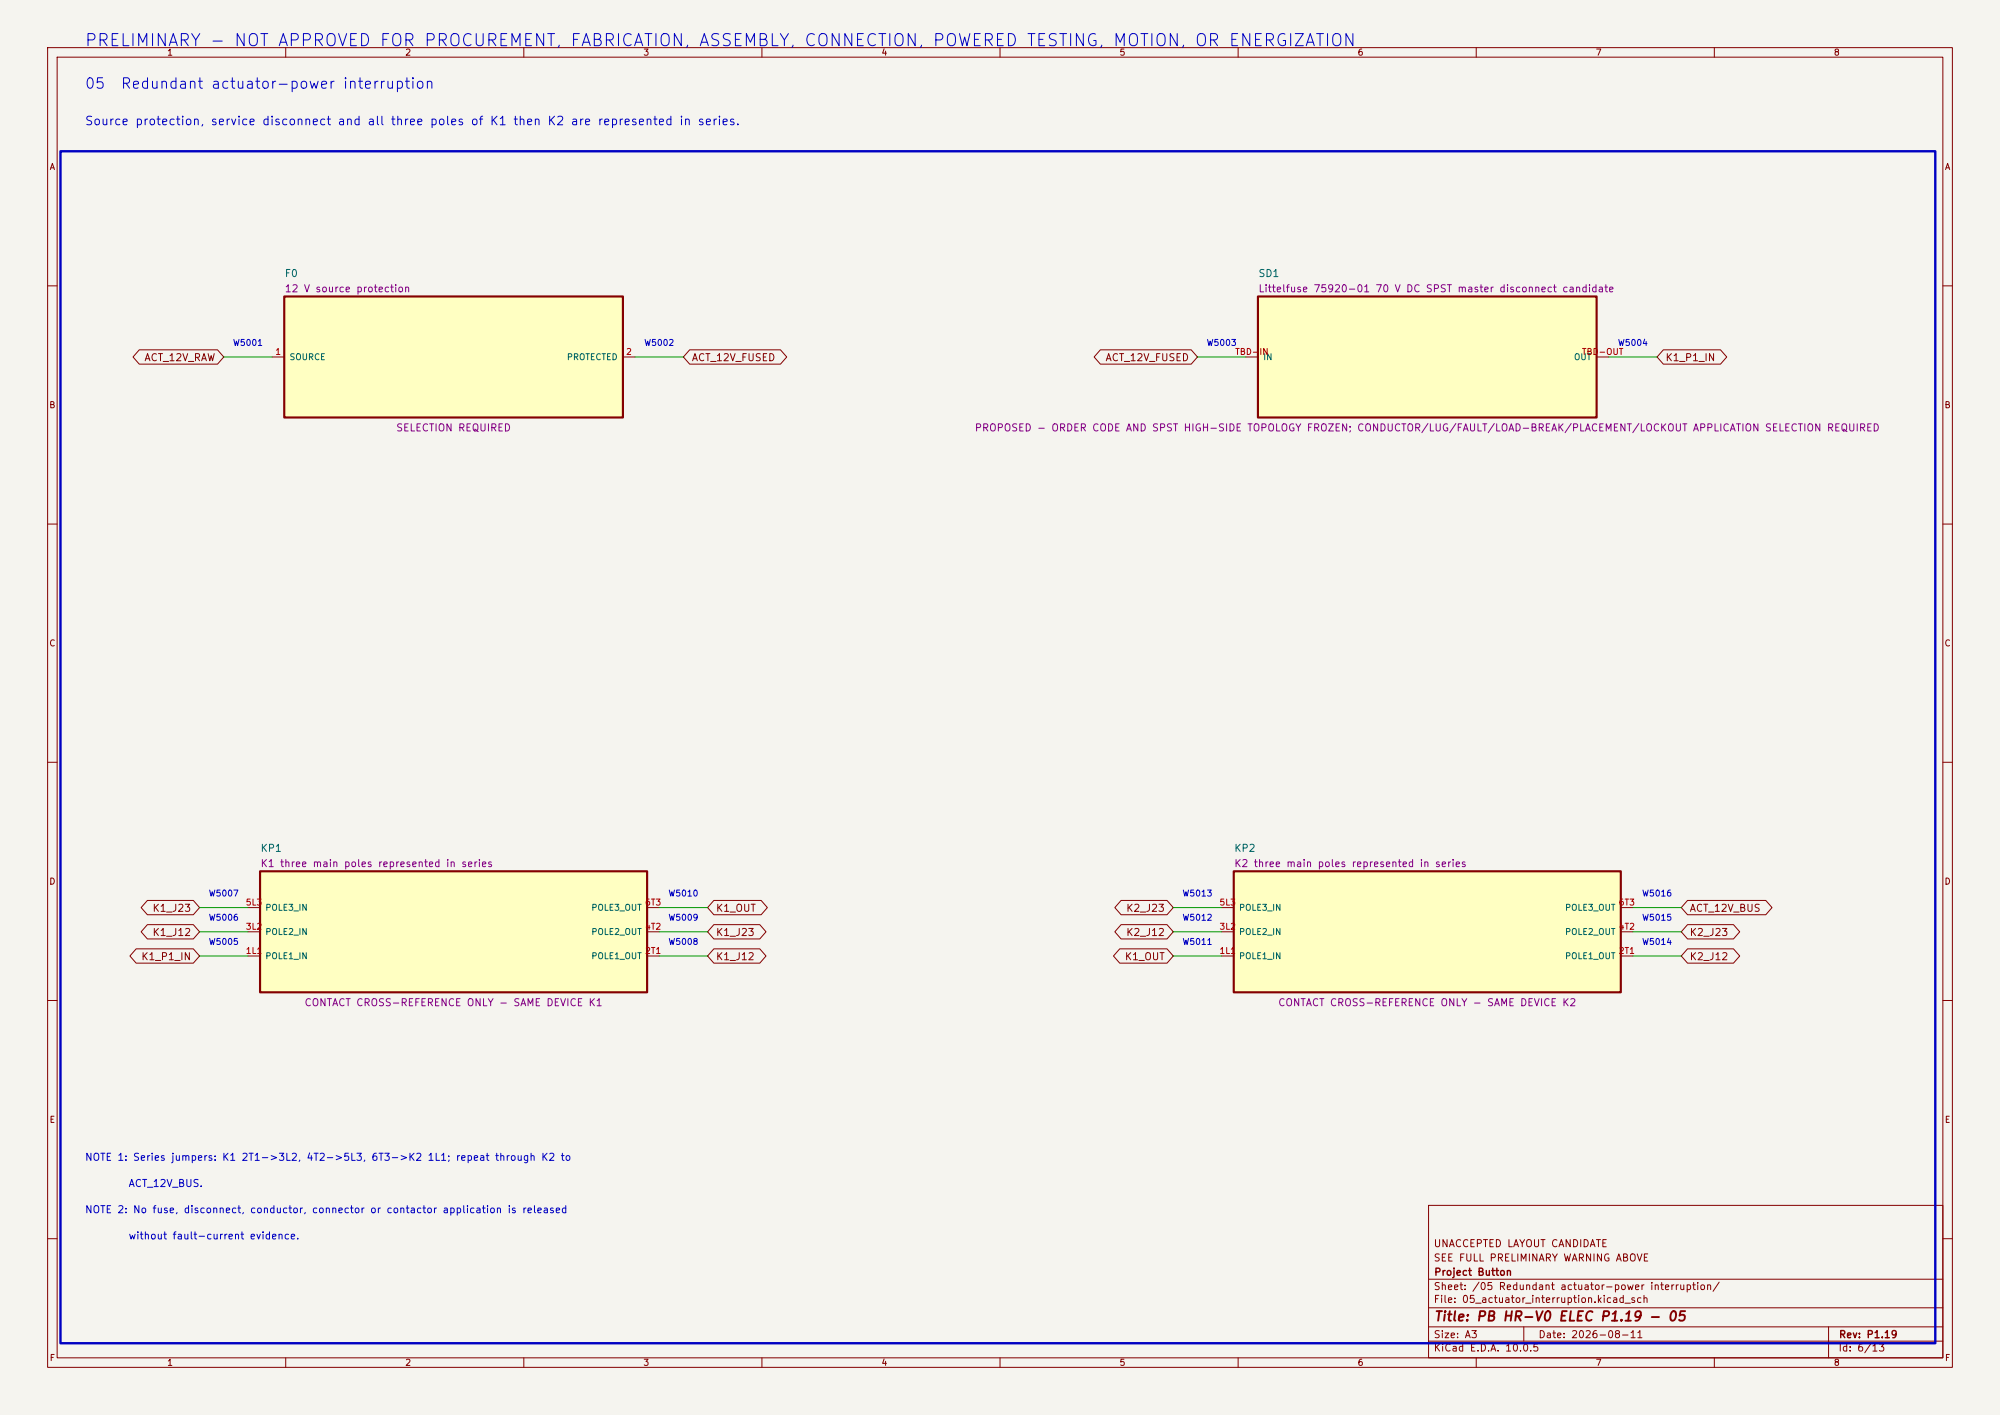
[picture p177: page 6]

W5003 PRELIMINARY - NOT APPROVED FOR PROCUREMENT, FABRICATION, ASSEMBLY, CONNECTION, POWERED TESTING, MOTION, OR ENERGIZATION

05 Redundant actuator-power interruption

Source protection, service disconnect and all three poles of K1 then K2 are represented in series.

Littelfuse 75920-01 70 V DC SPST master disconnect candidate

PROPOSED - ORDER CODE AND SPST HIGH-SIDE TOPOLOGY FROZEN; CONDUCTOR/LUG/FAULT/LOAD-BREAK/PLACEMENT/LOCKOUT APPLICATION SELECTION REQUIRED

K1 three main poles represented in series

K2 three main poles represented in series

CONTACT CROSS-REFERENCE ONLY - SAME DEVICE K1

CONTACT CROSS-REFERENCE ONLY - SAME DEVICE K2

NOTE 2: No fuse, disconnect, conductor, connector or contactor application is released

without fault-current evidence.

UNACCEPTED LAYOUT CANDIDATE SEE FULL PRELIMINARY WARNING ABOVE Project Button

Sheet: /05 Redundant actuator-power interruption/ File: 05_actuator_interruption.kicad_sch

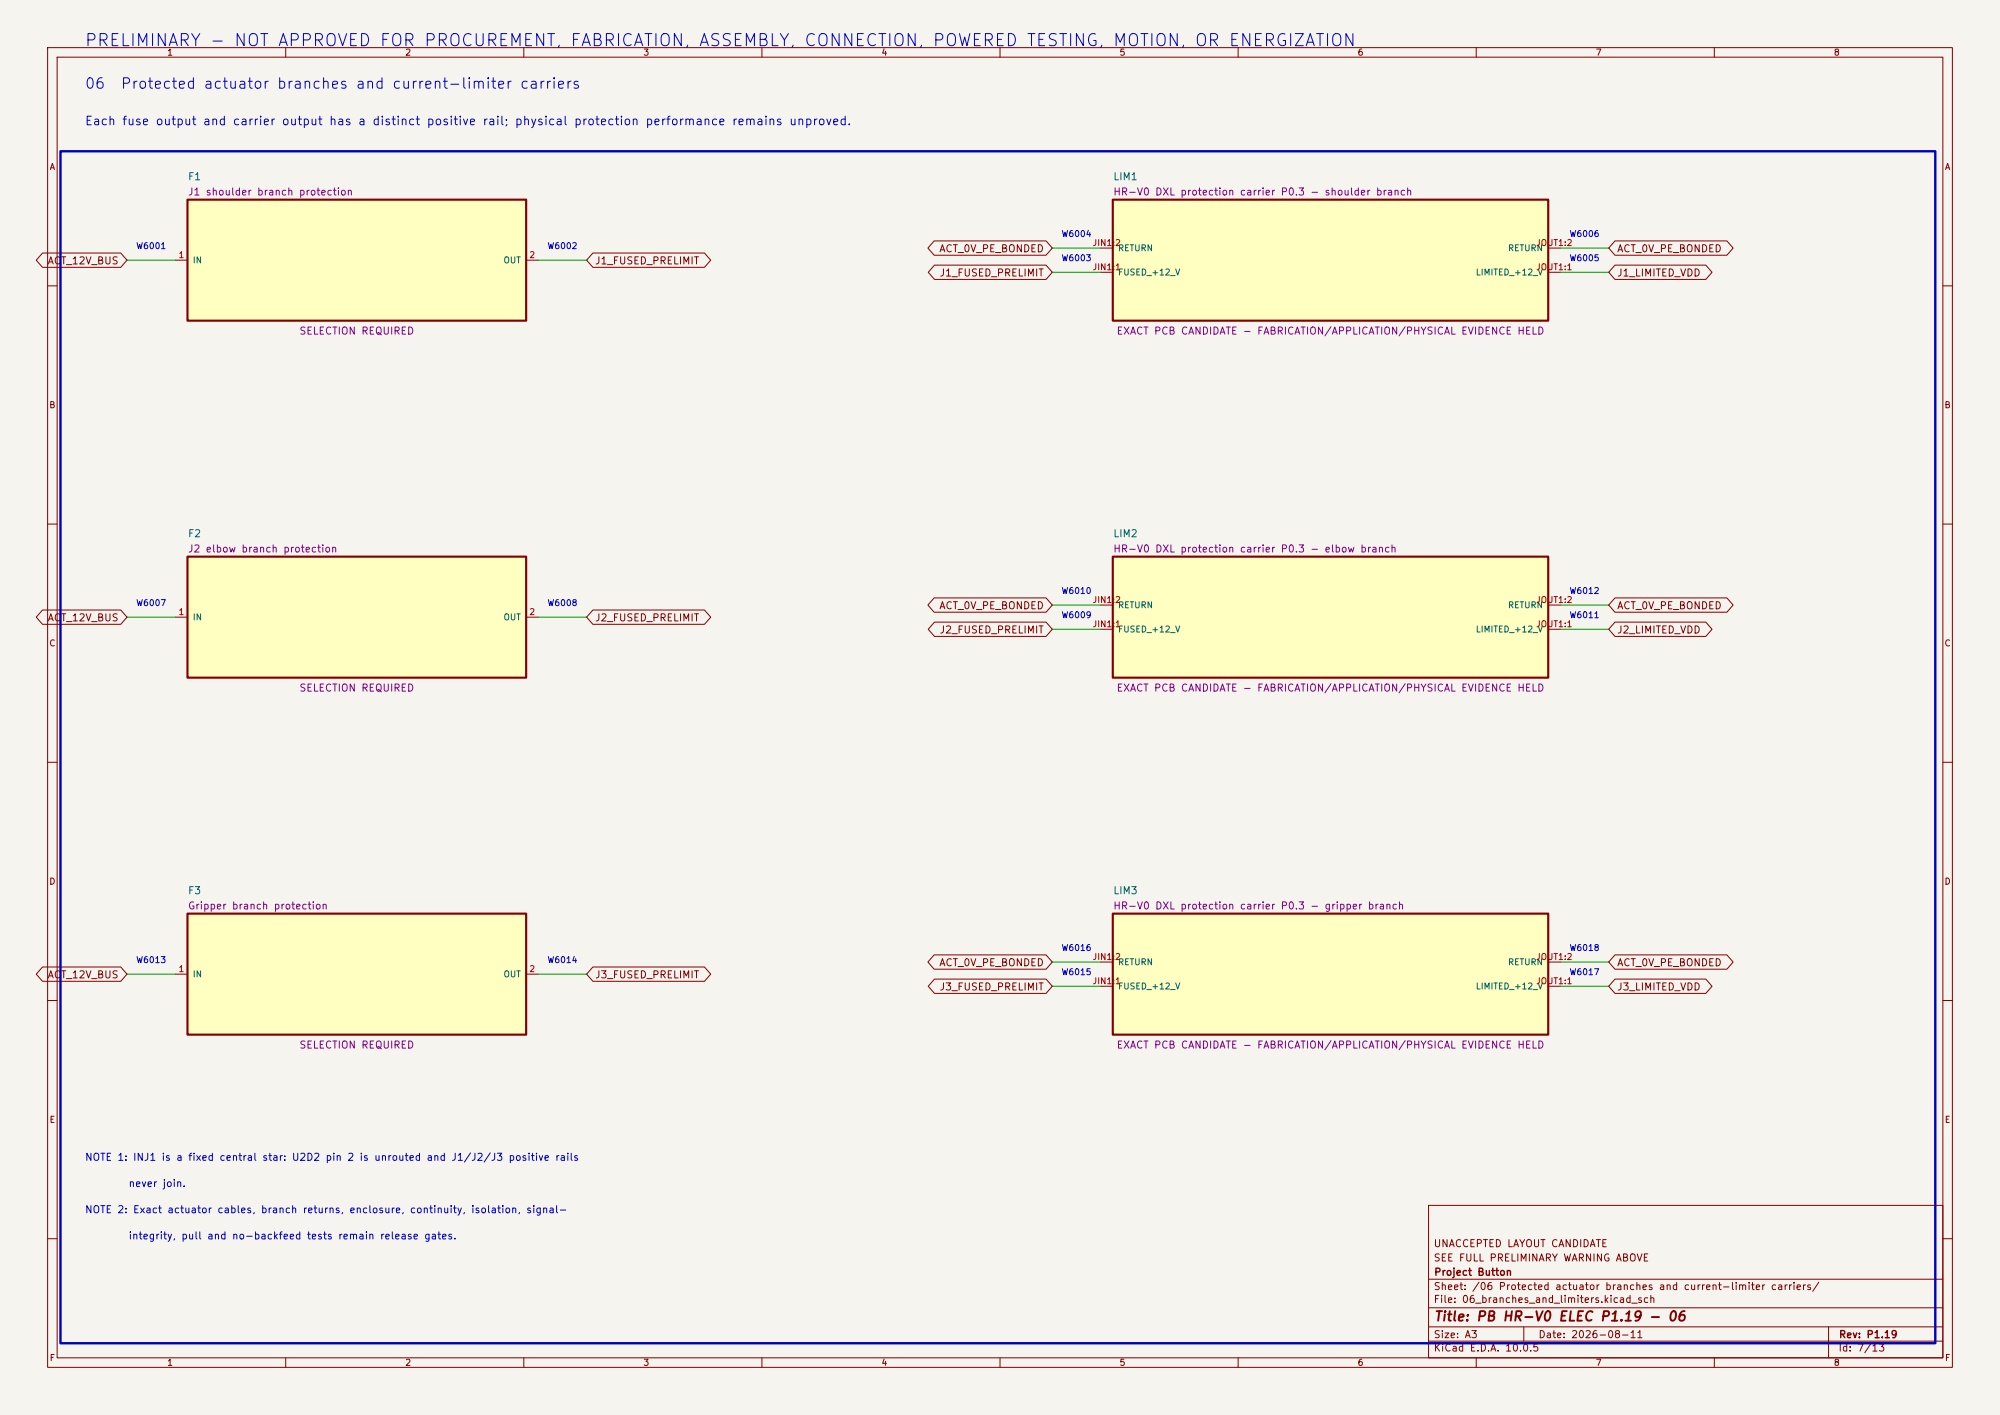
[picture p178: page 7]

PRELIMINARY - NOT APPROVED FOR PROCUREMENT, FABRICATION, ASSEMBLY, CONNECTION, POWERED TESTING, MOTION, OR ENERGIZATION

06 Protected actuator branches and current-limiter carriers

Each fuse output and carrier output has a distinct positive rail; physical protection performance remains unproved.

LIMITED_+12_VJOUT1:1 RETURNJOUT1:2 LIM1
HR-V0 DXL protection carrier P0.3 - shoulder branch

EXACT PCB CANDIDATE - FABRICATION/APPLICATION/PHYSICAL EVIDENCE HELD

LIMITED_+12_VJOUT1:1 RETURNJOUT1:2 LIM2
HR-V0 DXL protection carrier P0.3 - elbow branch

LIMITED_+12_VJOUT1:1 RETURNJOUT1:2 LIM3
HR-V0 DXL protection carrier P0.3 - gripper branch

NOTE 2: Exact actuator cables, branch returns, enclosure, continuity, isolation, signal-

integrity, pull and no-backfeed tests remain release gates.

UNACCEPTED LAYOUT CANDIDATE SEE FULL PRELIMINARY WARNING ABOVE Project Button

Sheet: /06 Protected actuator branches and current-limiter carriers/ File: 06_branches_and_limiters.kicad_sch

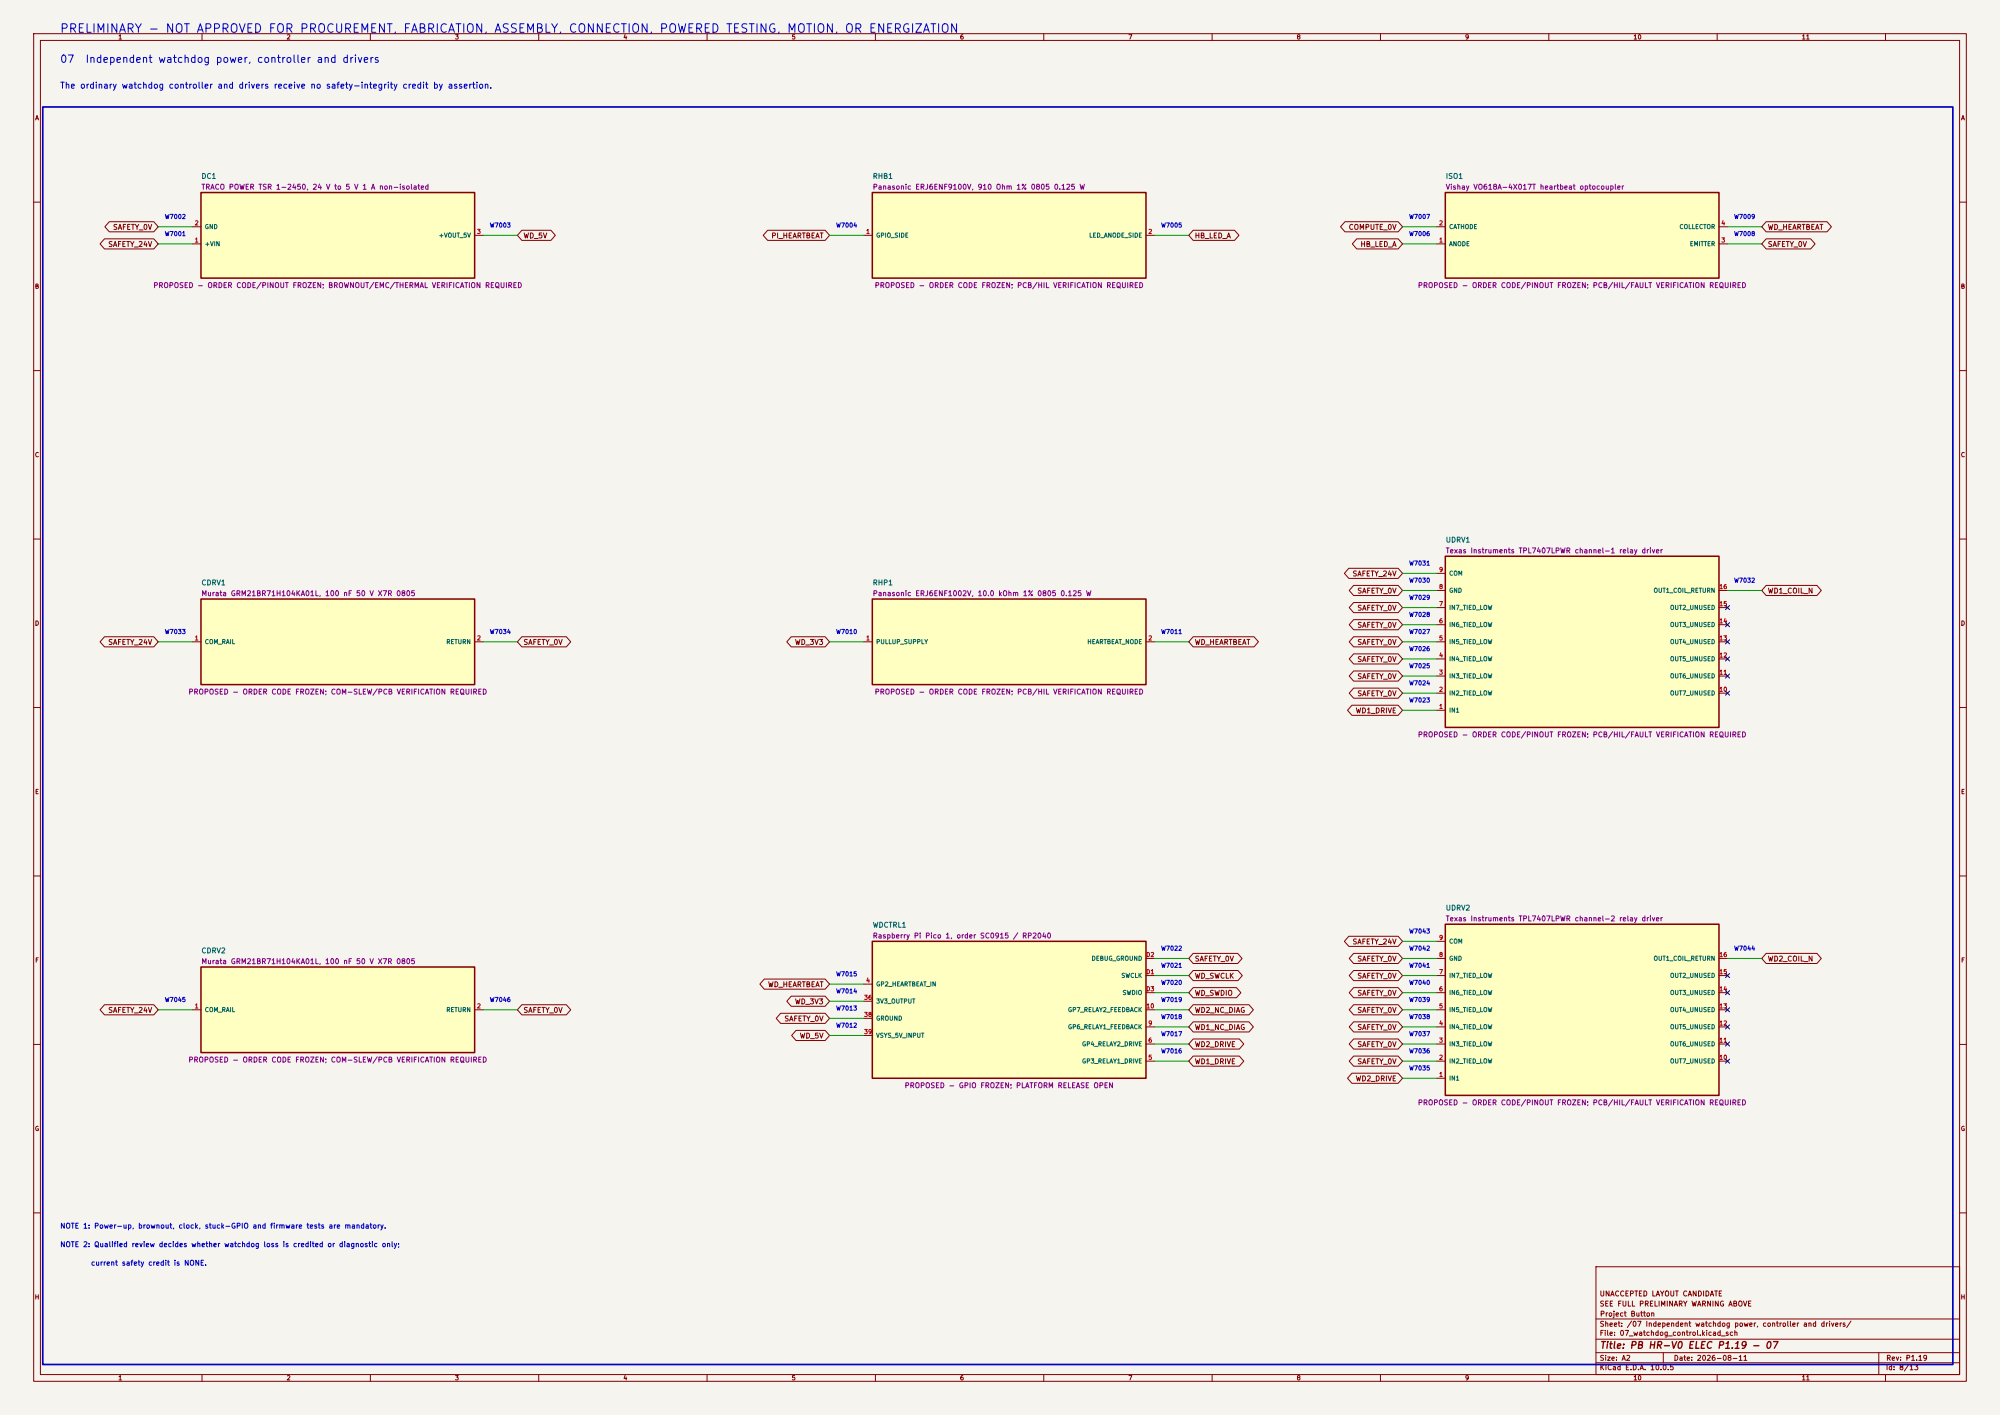
[picture p179: page 8]

W7005 PRELIMINARY - NOT APPROVED FOR PROCUREMENT, FABRICATION, ASSEMBLY, CONNECTION, POWERED TESTING, MOTION, OR ENERGIZATION

07 Independent watchdog power, controller and drivers

TRACO POWER TSR 1-2450, 24 V to 5 V 1 A non-isolated

PROPOSED - ORDER CODE/PINOUT FROZEN; BROWNOUT/EMC/THERMAL VERIFICATION REQUIRED

PROPOSED - ORDER CODE FROZEN; PCB/HIL VERIFICATION REQUIRED

PROPOSED - ORDER CODE/PINOUT FROZEN; PCB/HIL/FAULT VERIFICATION REQUIRED

PROPOSED - ORDER CODE FROZEN; COM-SLEW/PCB VERIFICATION REQUIRED

Raspberry Pi Pico 1, order SC0915 / RP2040

PROPOSED - GPIO FROZEN; PLATFORM RELEASE OPEN

NOTE 1: Power-up, brownout, clock, stuck-GPIO and firmware tests are mandatory.

NOTE 2: Qualified review decides whether watchdog loss is credited or diagnostic only;

current safety credit is NONE.

UNACCEPTED LAYOUT CANDIDATE
SEE FULL PRELIMINARY WARNING ABOVE
Project Button
Sheet: /07 Independent watchdog power, controller and drivers/
File: 07_watchdog_control.kicad_sch

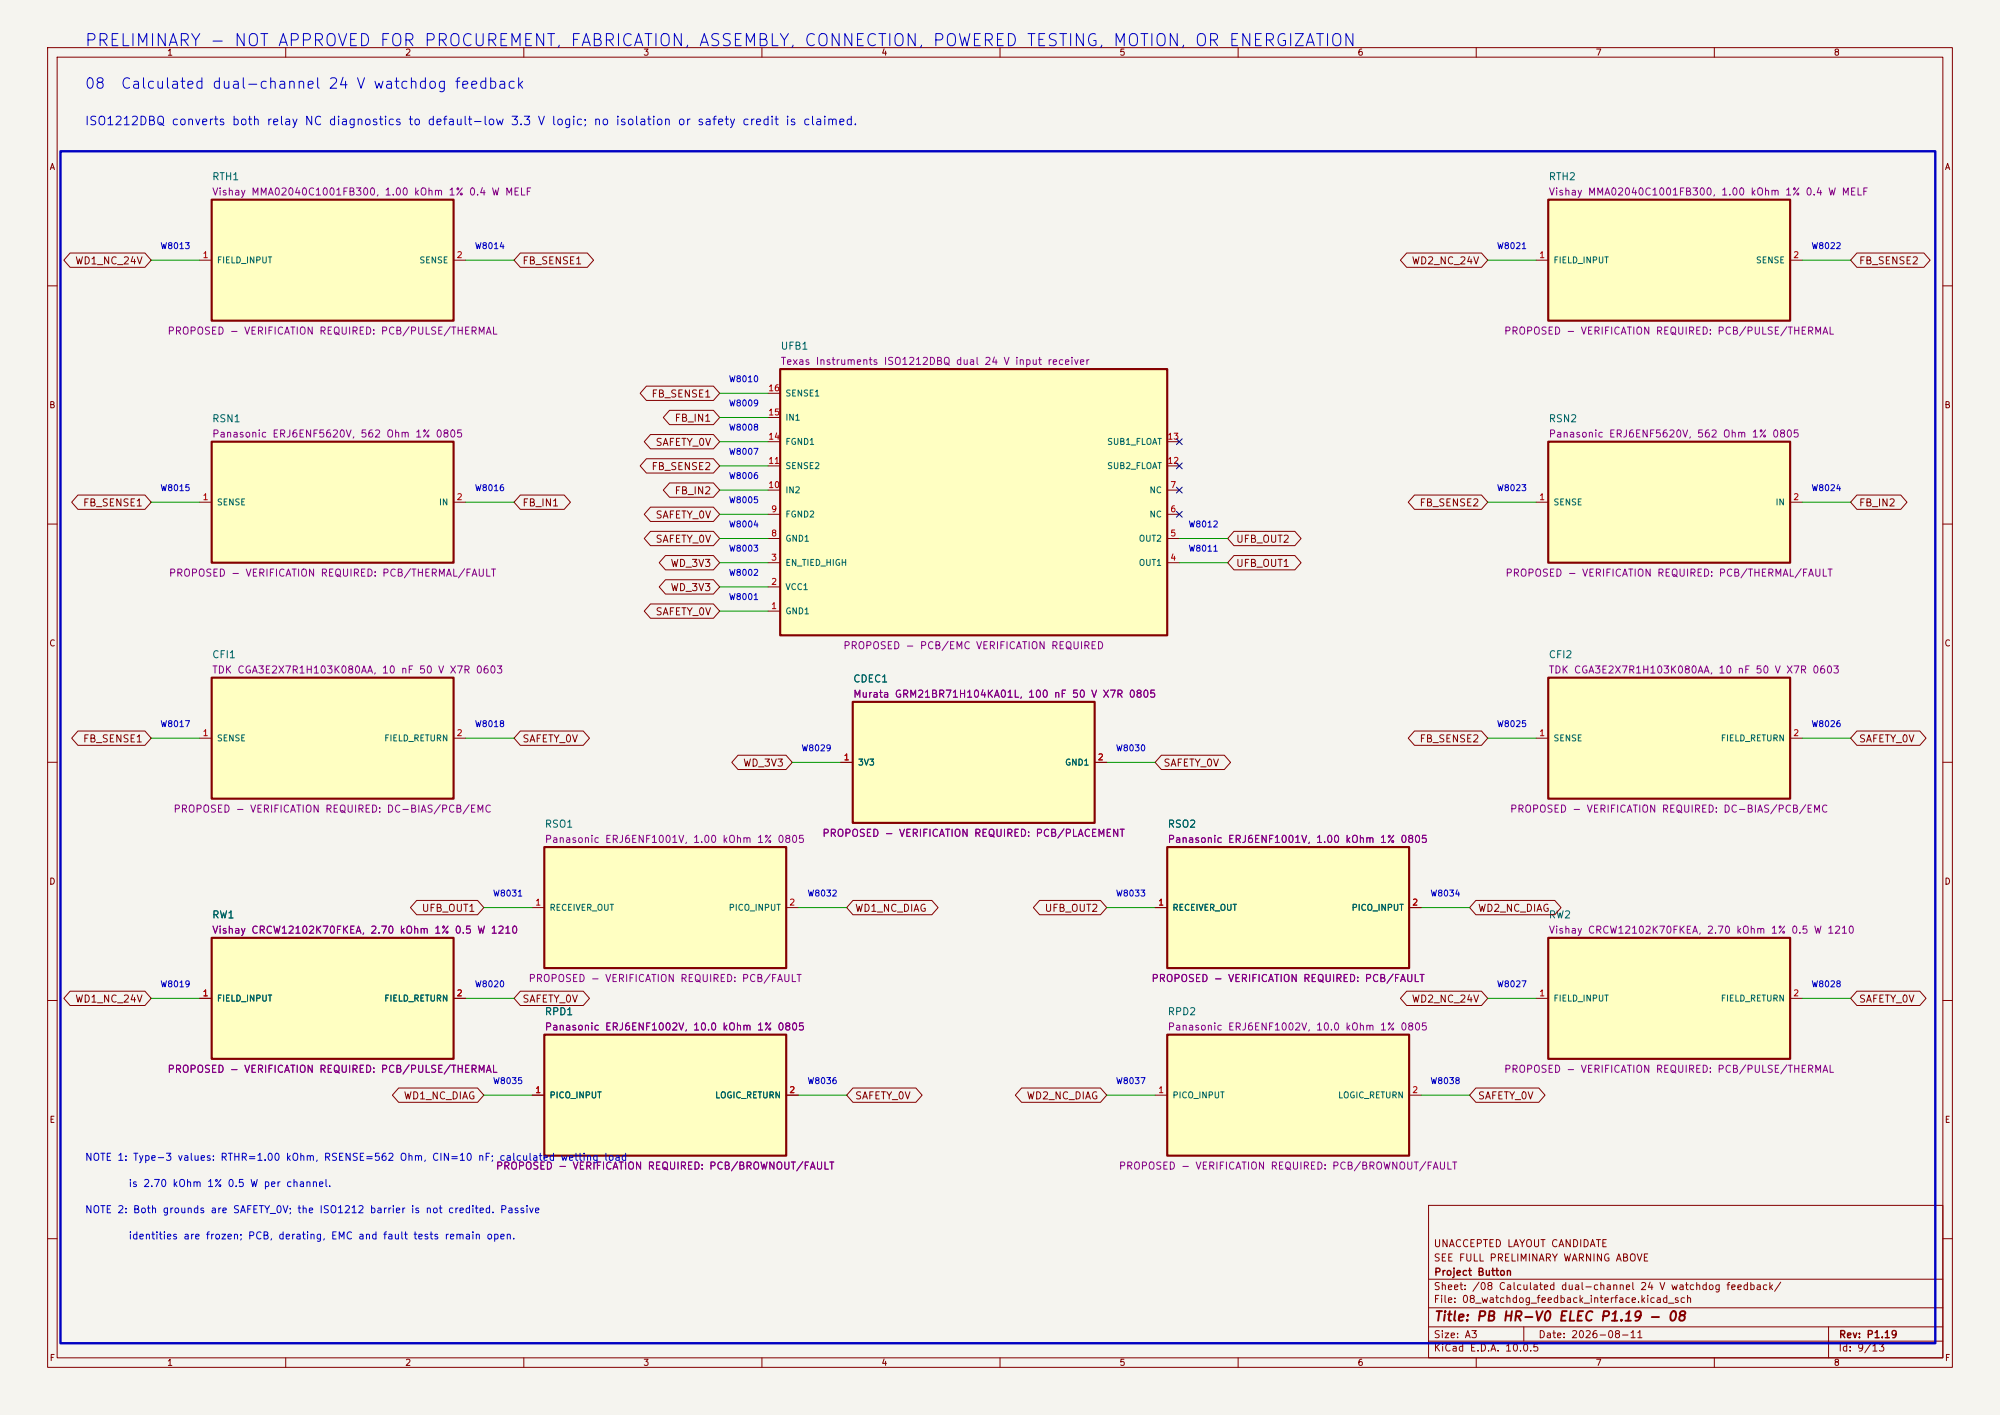
[picture p180: page 9]

W8009 W8008 W8007 PRELIMINARY - NOT APPROVED FOR PROCUREMENT, FABRICATION, ASSEMBLY, CONNECTION, POWERED TESTING, MOTION, OR ENERGIZATION

08 Calculated dual-channel 24 V watchdog feedback

ISO1212DBQ converts both relay NC diagnostics to default-low 3.3 V logic; no isolation or safety credit is claimed.

PROPOSED - VERIFICATION REQUIRED: PCB/PULSE/THERMAL

Texas Instruments ISO1212DBQ dual 24 V input receiver SENSE 1

PROPOSED - VERIFICATION REQUIRED: PCB/THERMAL/FAULT

PROPOSED - PCB/EMC VERIFICATION REQUIRED

PROPOSED - VERIFICATION REQUIRED: DC-BIAS/PCB/EMC

PROPOSED - VERIFICATION REQUIRED: PCB/PLACEMENT

PROPOSED - VERIFICATION REQUIRED: PCB/FAULT

PROPOSED - VERIFICATION REQUIRED: PCB/BROWNOUT/FAULT

is 2.70 kOhm 1% 0.5 W per channel.

NOTE 2: Both grounds are SAFETY_0V; the ISO1212 barrier is not credited. Passive

identities are frozen; PCB, derating, EMC and fault tests remain open.

UNACCEPTED LAYOUT CANDIDATE SEE FULL PRELIMINARY WARNING ABOVE Project Button

Sheet: /08 Calculated dual-channel 24 V watchdog feedback/ File: 08_watchdog_feedback_interface.kicad_sch

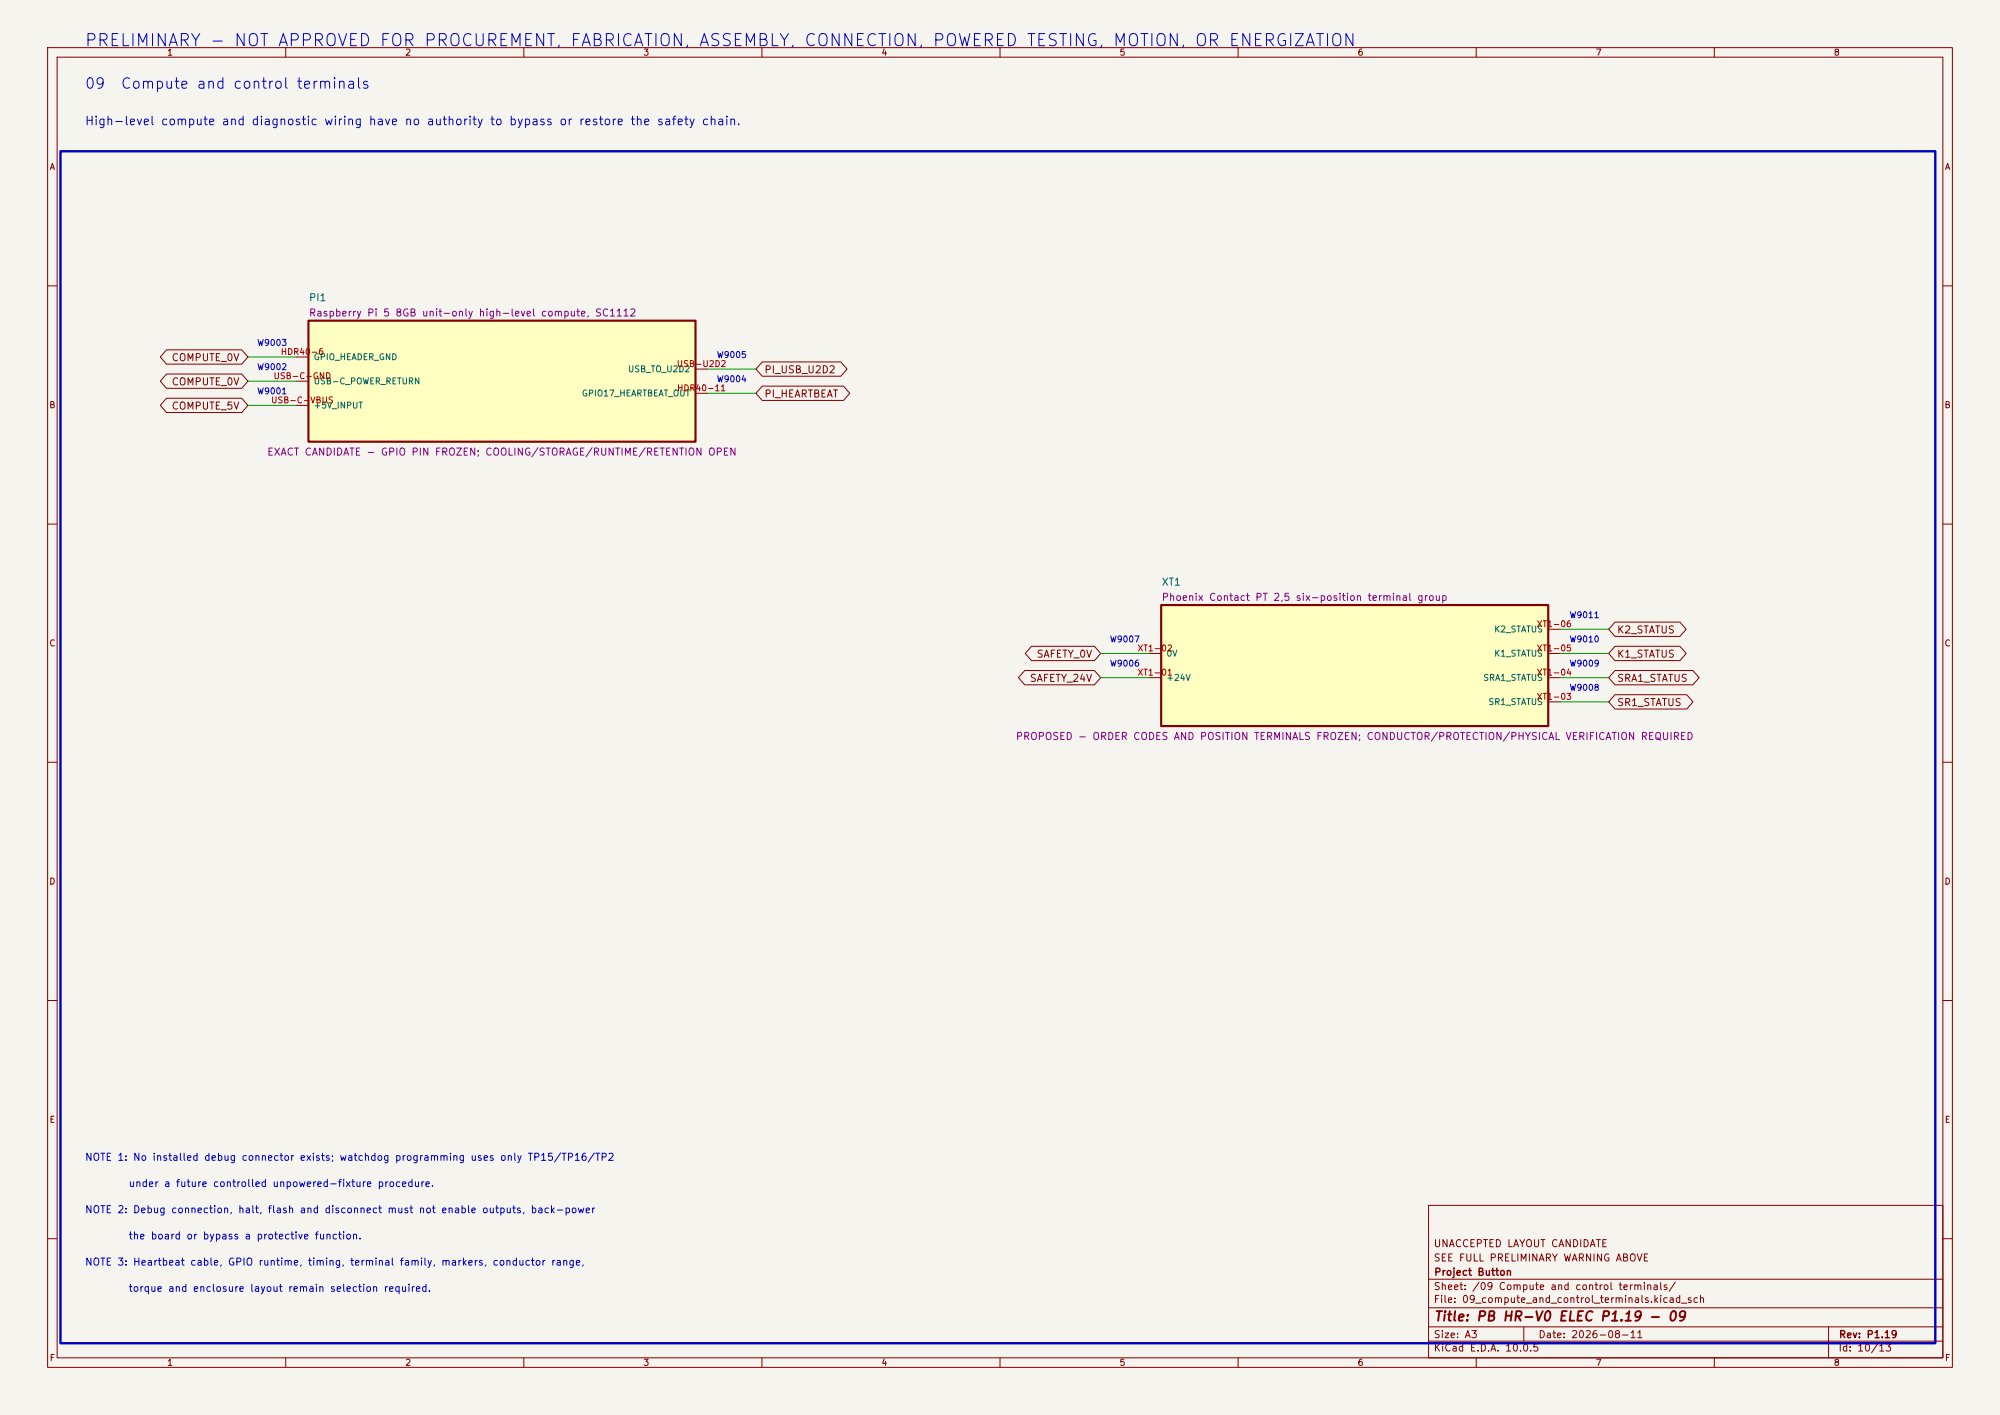
[picture p181: page 10]

W9007 PRELIMINARY - NOT APPROVED FOR PROCUREMENT, FABRICATION, ASSEMBLY, CONNECTION, POWERED TESTING, MOTION, OR ENERGIZATION

W9009 09 Compute and control terminals

Raspberry Pi 5 8GB unit-only high-level compute, SC1112

EXACT CANDIDATE - GPIO PIN FROZEN; COOLING/STORAGE/RUNTIME/RETENTION OPEN

SRA1_STATUSXT1-04 K1_STATUSXT1-05 K2_STATUSXT1-06 XT1
Phoenix Contact PT 2,5 six-position terminal group

W9006 NOTE 1: No installed debug connector exists; watchdog programming uses only TP15/TP16/TP2

PROPOSED - ORDER CODES AND POSITION TERMINALS FROZEN; CONDUCTOR/PROTECTION/PHYSICAL VERIFICATION REQUIRED

under a future controlled unpowered-fixture procedure.

NOTE 2: Debug connection, halt, flash and disconnect must not enable outputs, back-power

the board or bypass a protective function.

UNACCEPTED LAYOUT CANDIDATE SEE FULL PRELIMINARY WARNING ABOVE Project Button

NOTE 3: Heartbeat cable, GPIO runtime, timing, terminal family, markers, conductor range,

torque and enclosure layout remain selection required.

Sheet: /09 Compute and control terminals/ File: 09_compute_and_control_terminals.kicad_sch

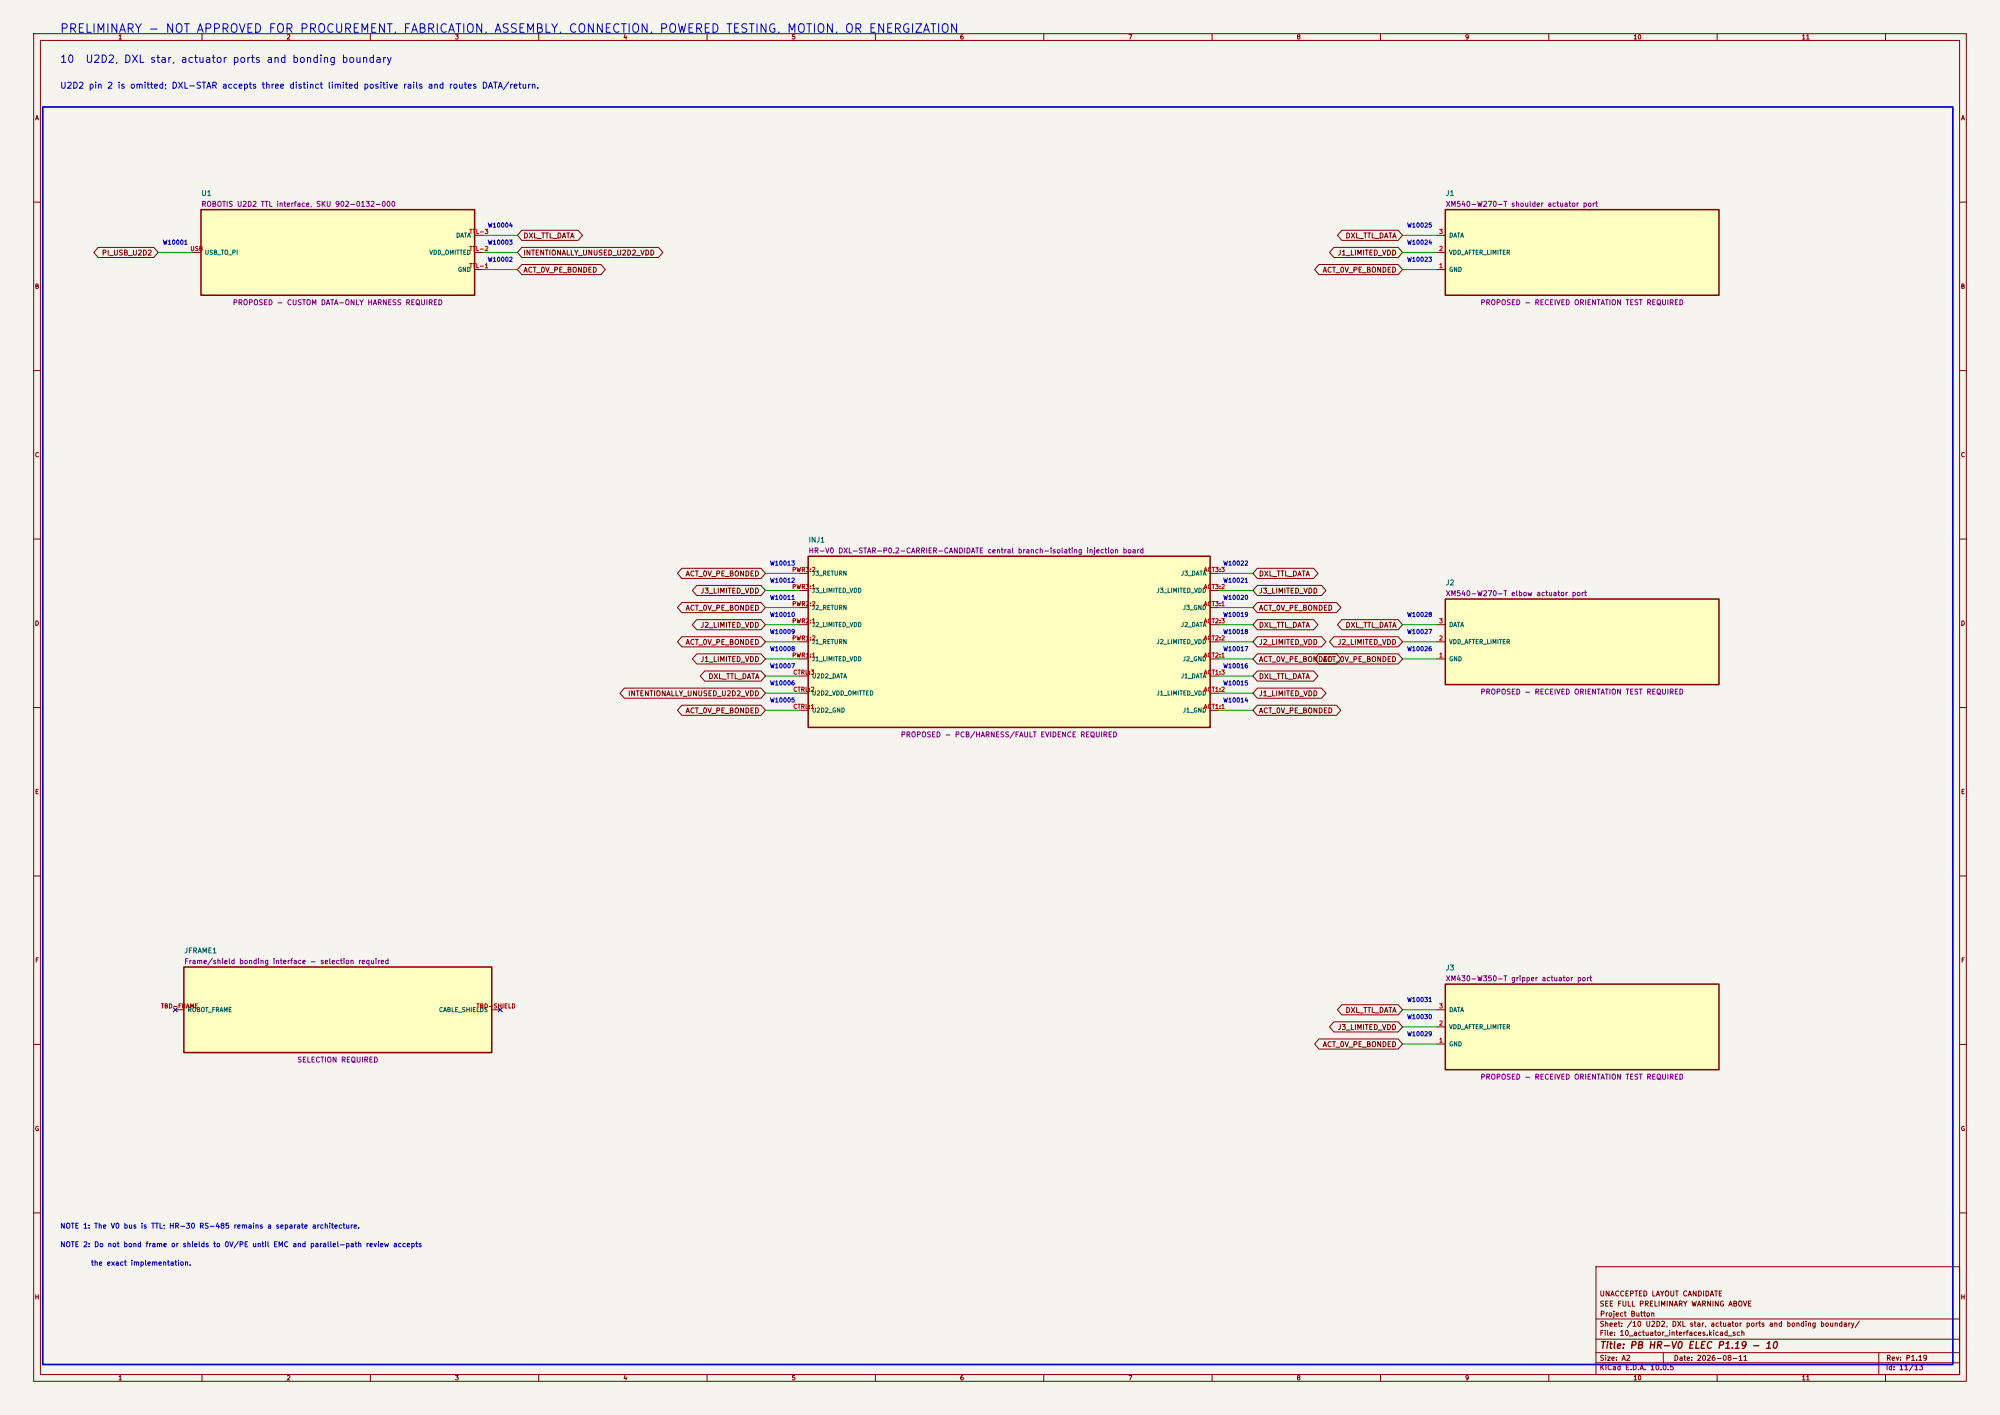
[picture p182: page 11]

PRELIMINARY - NOT APPROVED FOR PROCUREMENT, FABRICATION, ASSEMBLY, CONNECTION, POWERED TESTING, MOTION, OR ENERGIZATION

10 U2D2, DXL star, actuator ports and bonding boundary

VDD_OMITTEDTTL-2 DATATTL-3 USB_TO_PI USBU1
ROBOTIS U2D2 TTL interface, SKU 902-0132-000

XM540-W270-T shoulder actuator port GNDTTL-1

PROPOSED - CUSTOM DATA-ONLY HARNESS REQUIRED

PROPOSED - RECEIVED ORIENTATION TEST REQUIRED

INJ1
HR-V0 DXL-STAR-P0.2-CARRIER-CANDIDATE central branch-isolating injection board

PROPOSED - PCB/HARNESS/FAULT EVIDENCE REQUIRED

JFRAME1
Frame/shield bonding interface - selection required

NOTE 1: The V0 bus is TTL; HR-30 RS-485 remains a separate architecture.

NOTE 2: Do not bond frame or shields to 0V/PE until EMC and parallel-path review accepts

UNACCEPTED LAYOUT CANDIDATE
SEE FULL PRELIMINARY WARNING ABOVE
Project Button
Sheet: /10 U2D2, DXL star, actuator ports and bonding boundary/
File: 10_actuator_interfaces.kicad_sch

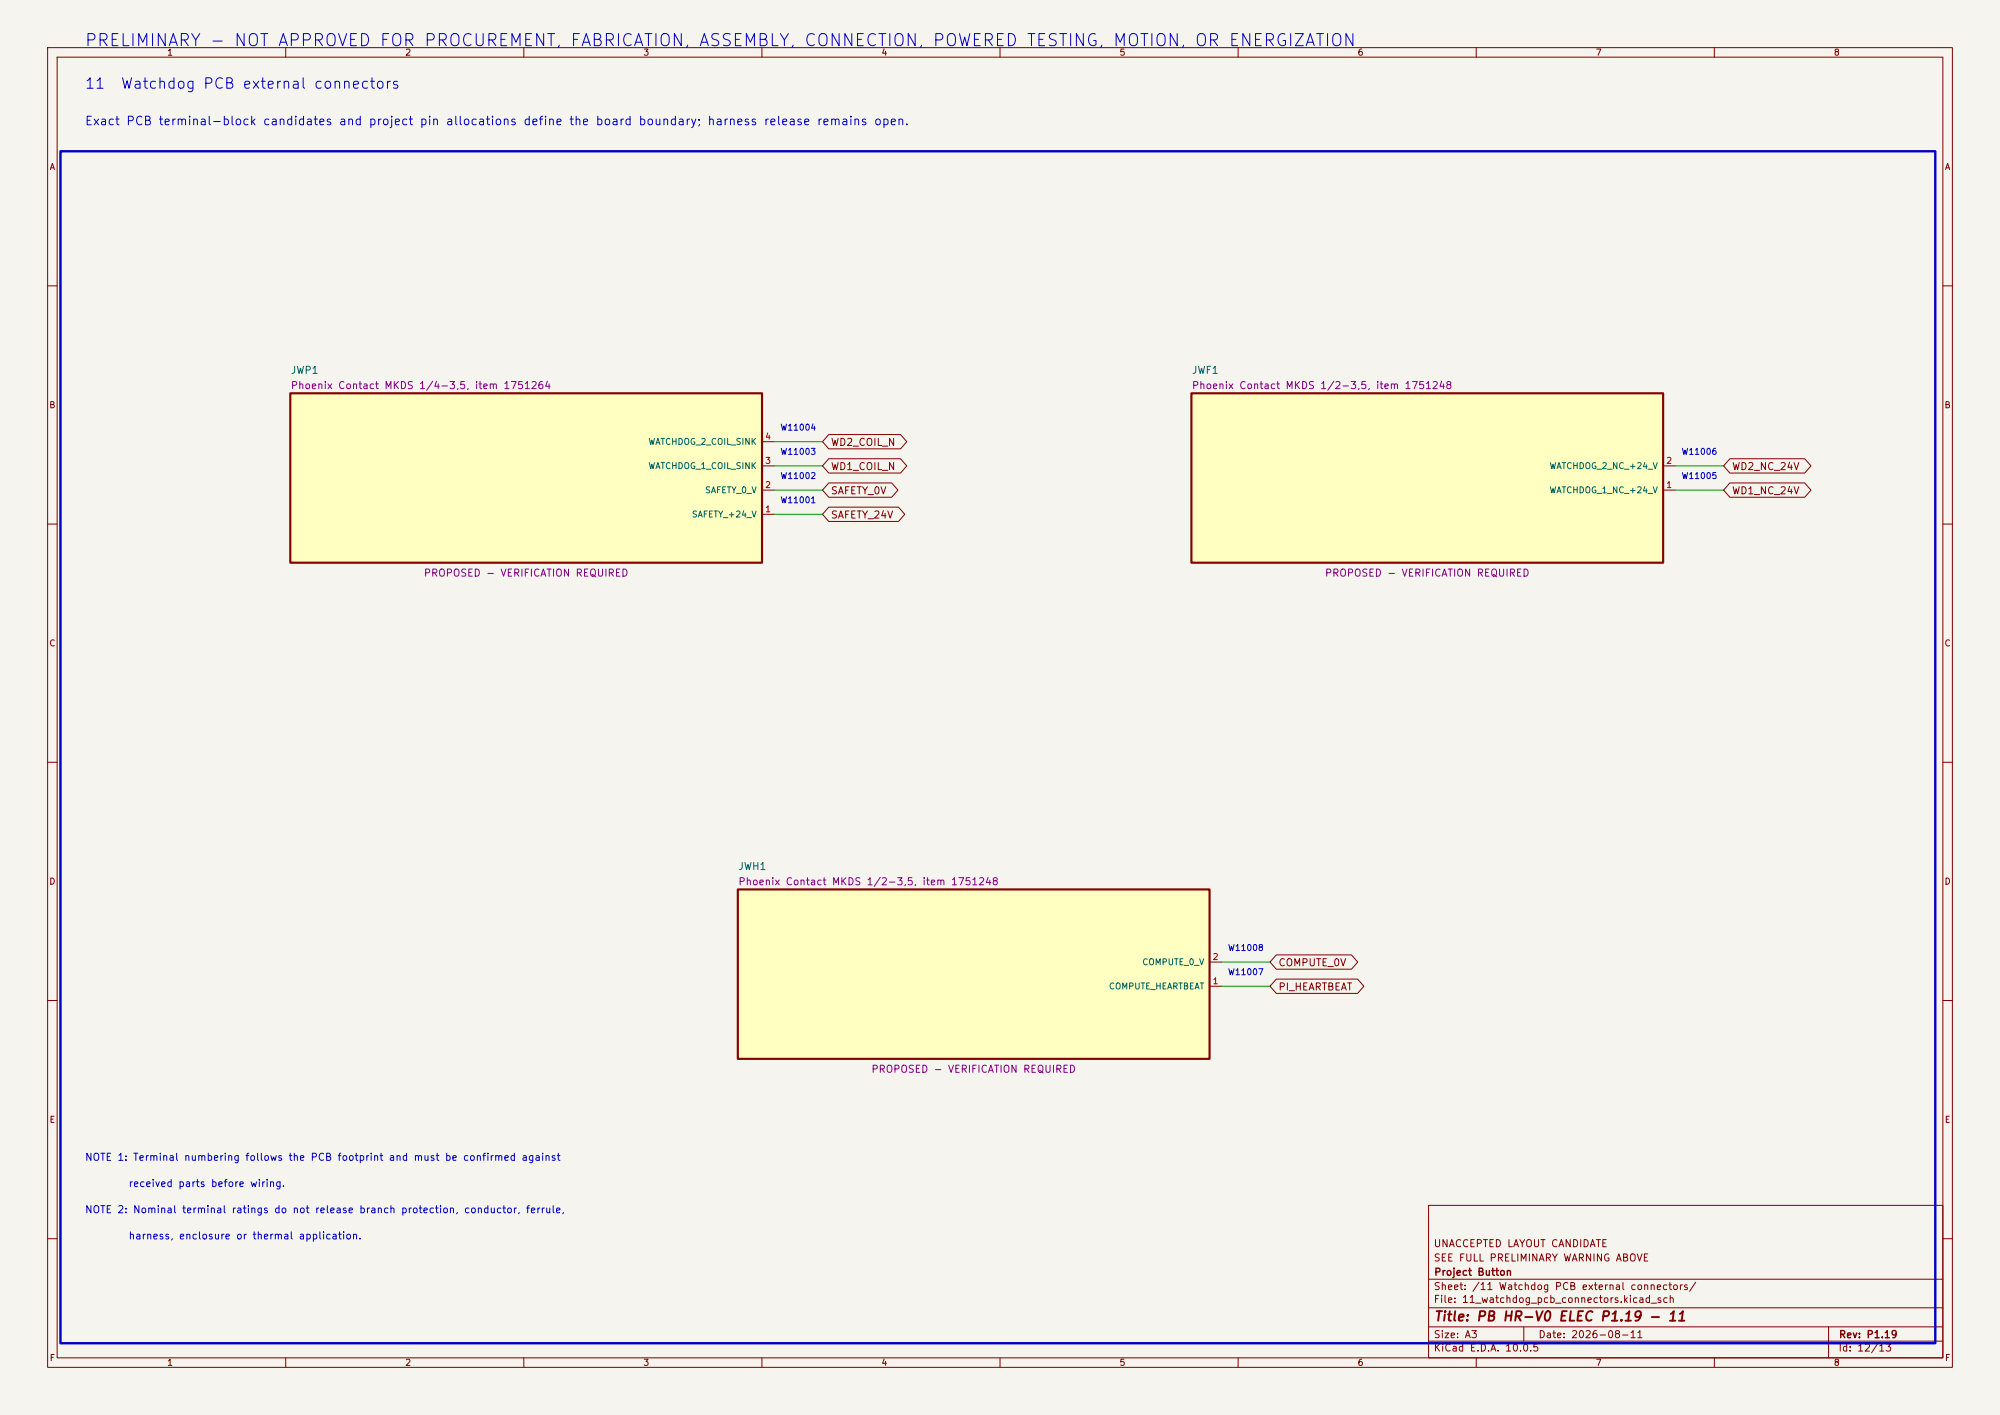
[picture p183: page 12]

11 Watchdog PCB external connectors

Exact PCB terminal-block candidates and project pin allocations define the board boundary; harness release remains open.

JWP1
Phoenix Contact MKDS 1/4-3,5, item 1751264

JWF1
Phoenix Contact MKDS 1/2-3,5, item 1751248

JWH1

W11008 NOTE 1: Terminal numbering follows the PCB footprint and must be confirmed against

received parts before wiring.

NOTE 2: Nominal terminal ratings do not release branch protection, conductor, ferrule,

harness, enclosure or thermal application.

UNACCEPTED LAYOUT CANDIDATE SEE FULL PRELIMINARY WARNING ABOVE Project Button

Sheet: /11 Watchdog PCB external connectors/ File: 11_watchdog_pcb_connectors.kicad_sch

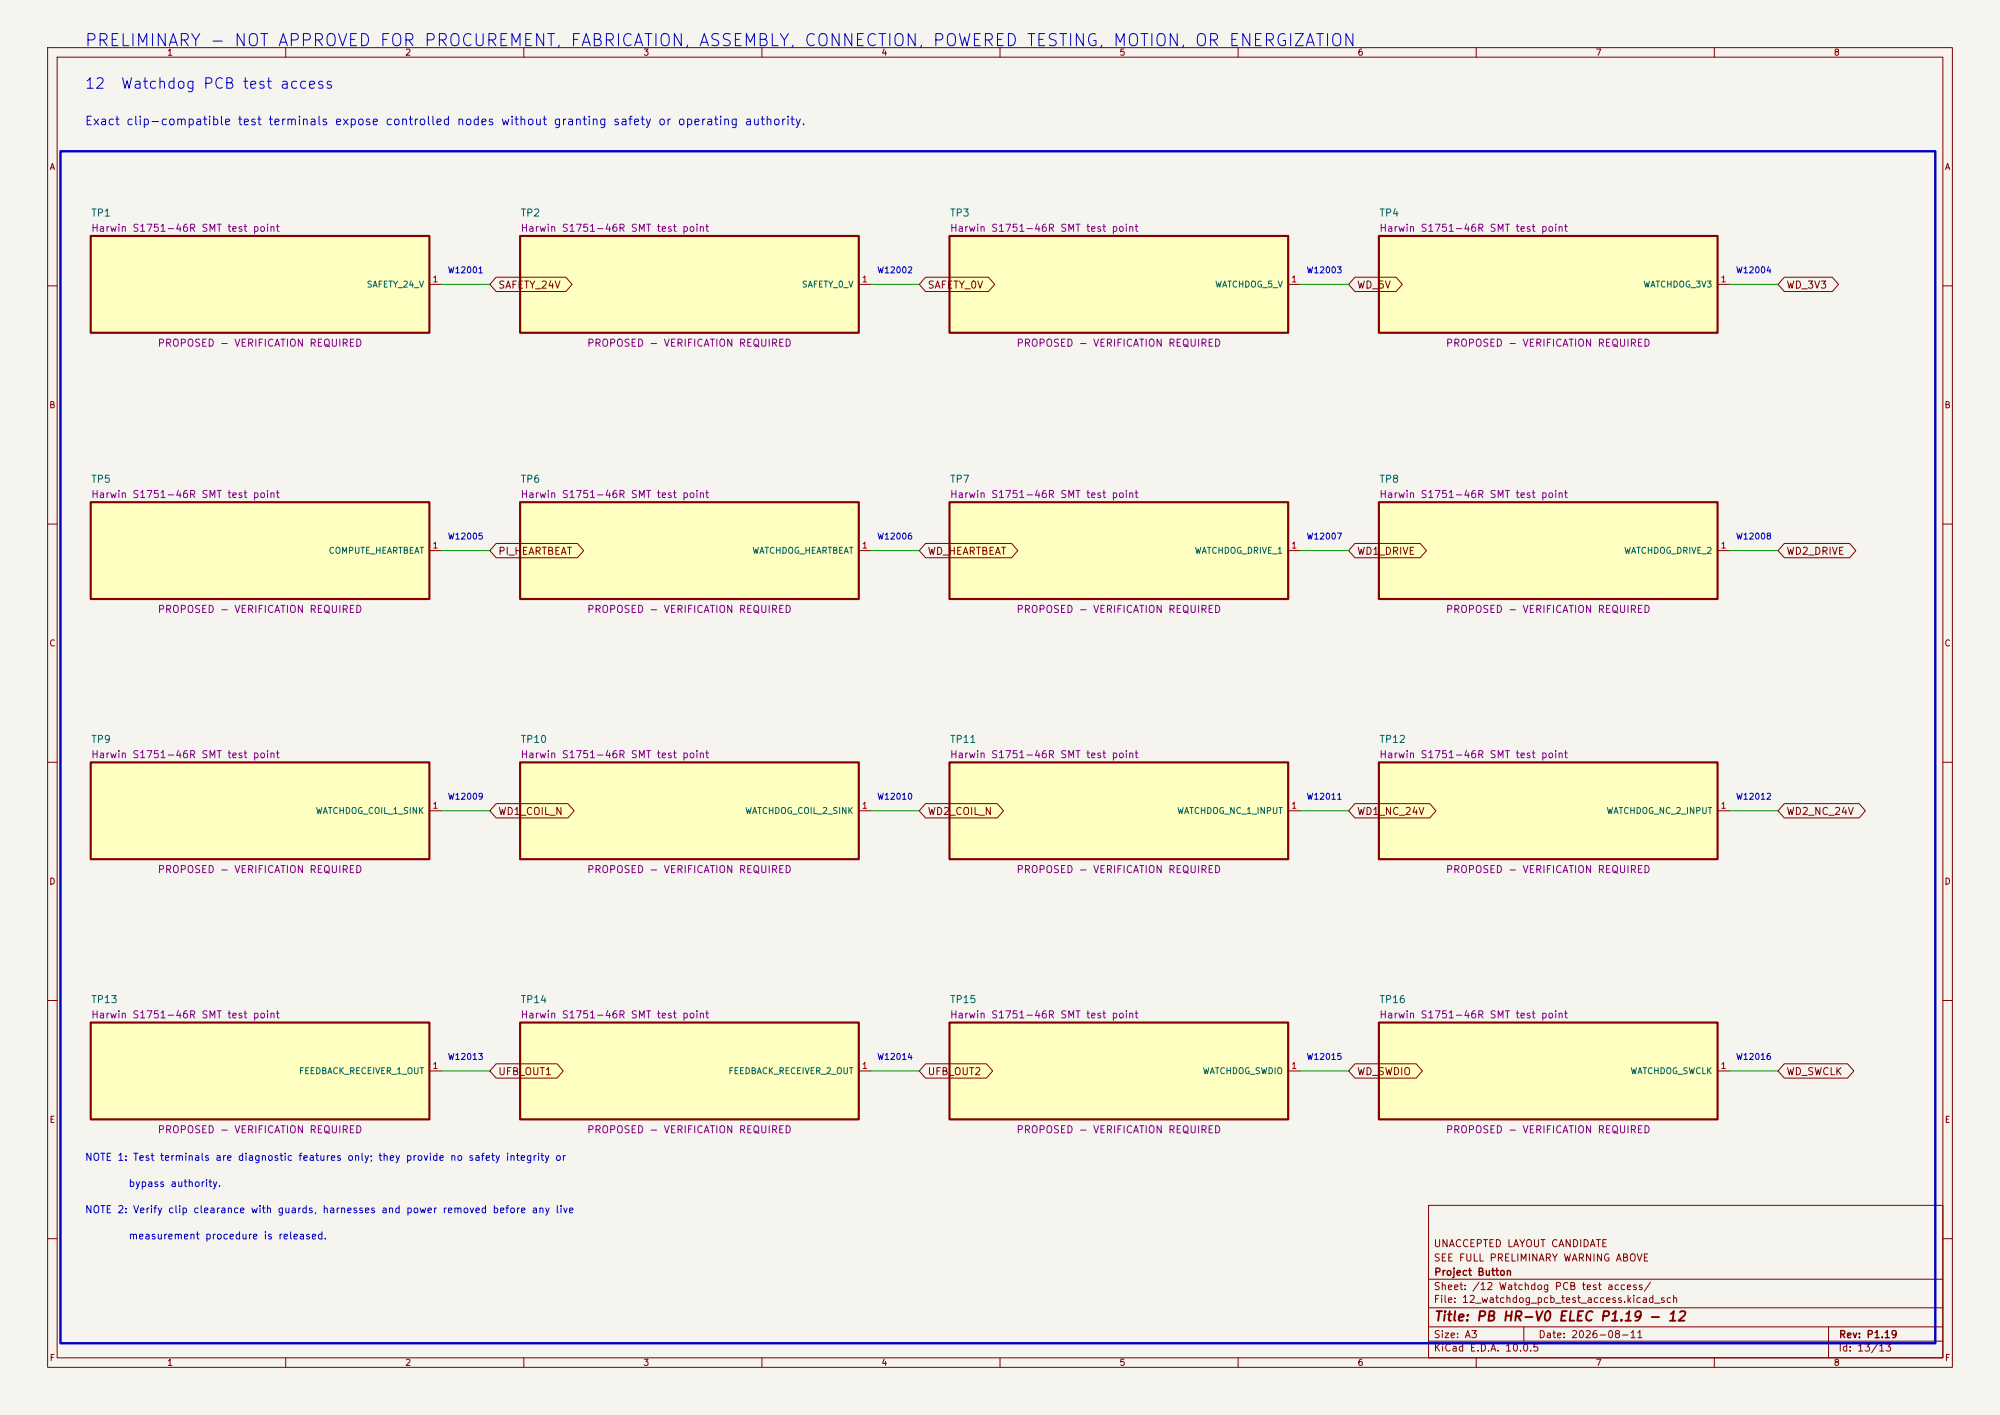
[picture p184: page 13]

W12001 PRELIMINARY - NOT APPROVED FOR PROCUREMENT, FABRICATION, ASSEMBLY, CONNECTION, POWERED TESTING, MOTION, OR ENERGIZATION

12 Watchdog PCB test access

Exact clip-compatible test terminals expose controlled nodes without granting safety or operating authority. W12005 NOTE 1: Test terminals are diagnostic features only; they provide no safety integrity or bypass authority.

Harwin S1751-46R SMT test point

NOTE 2: Verify clip clearance with guards, harnesses and power removed before any live

measurement procedure is released.

UNACCEPTED LAYOUT CANDIDATE SEE FULL PRELIMINARY WARNING ABOVE Project Button

Sheet: /12 Watchdog PCB test access/ File: 12_watchdog_pcb_test_access.kicad_sch
