amyleesterling/humanoid-robot/electrical/kicad/hr-v0-dxl-protection-eval/output/hr-v0-dxl-protection-eval-preliminary.pdf

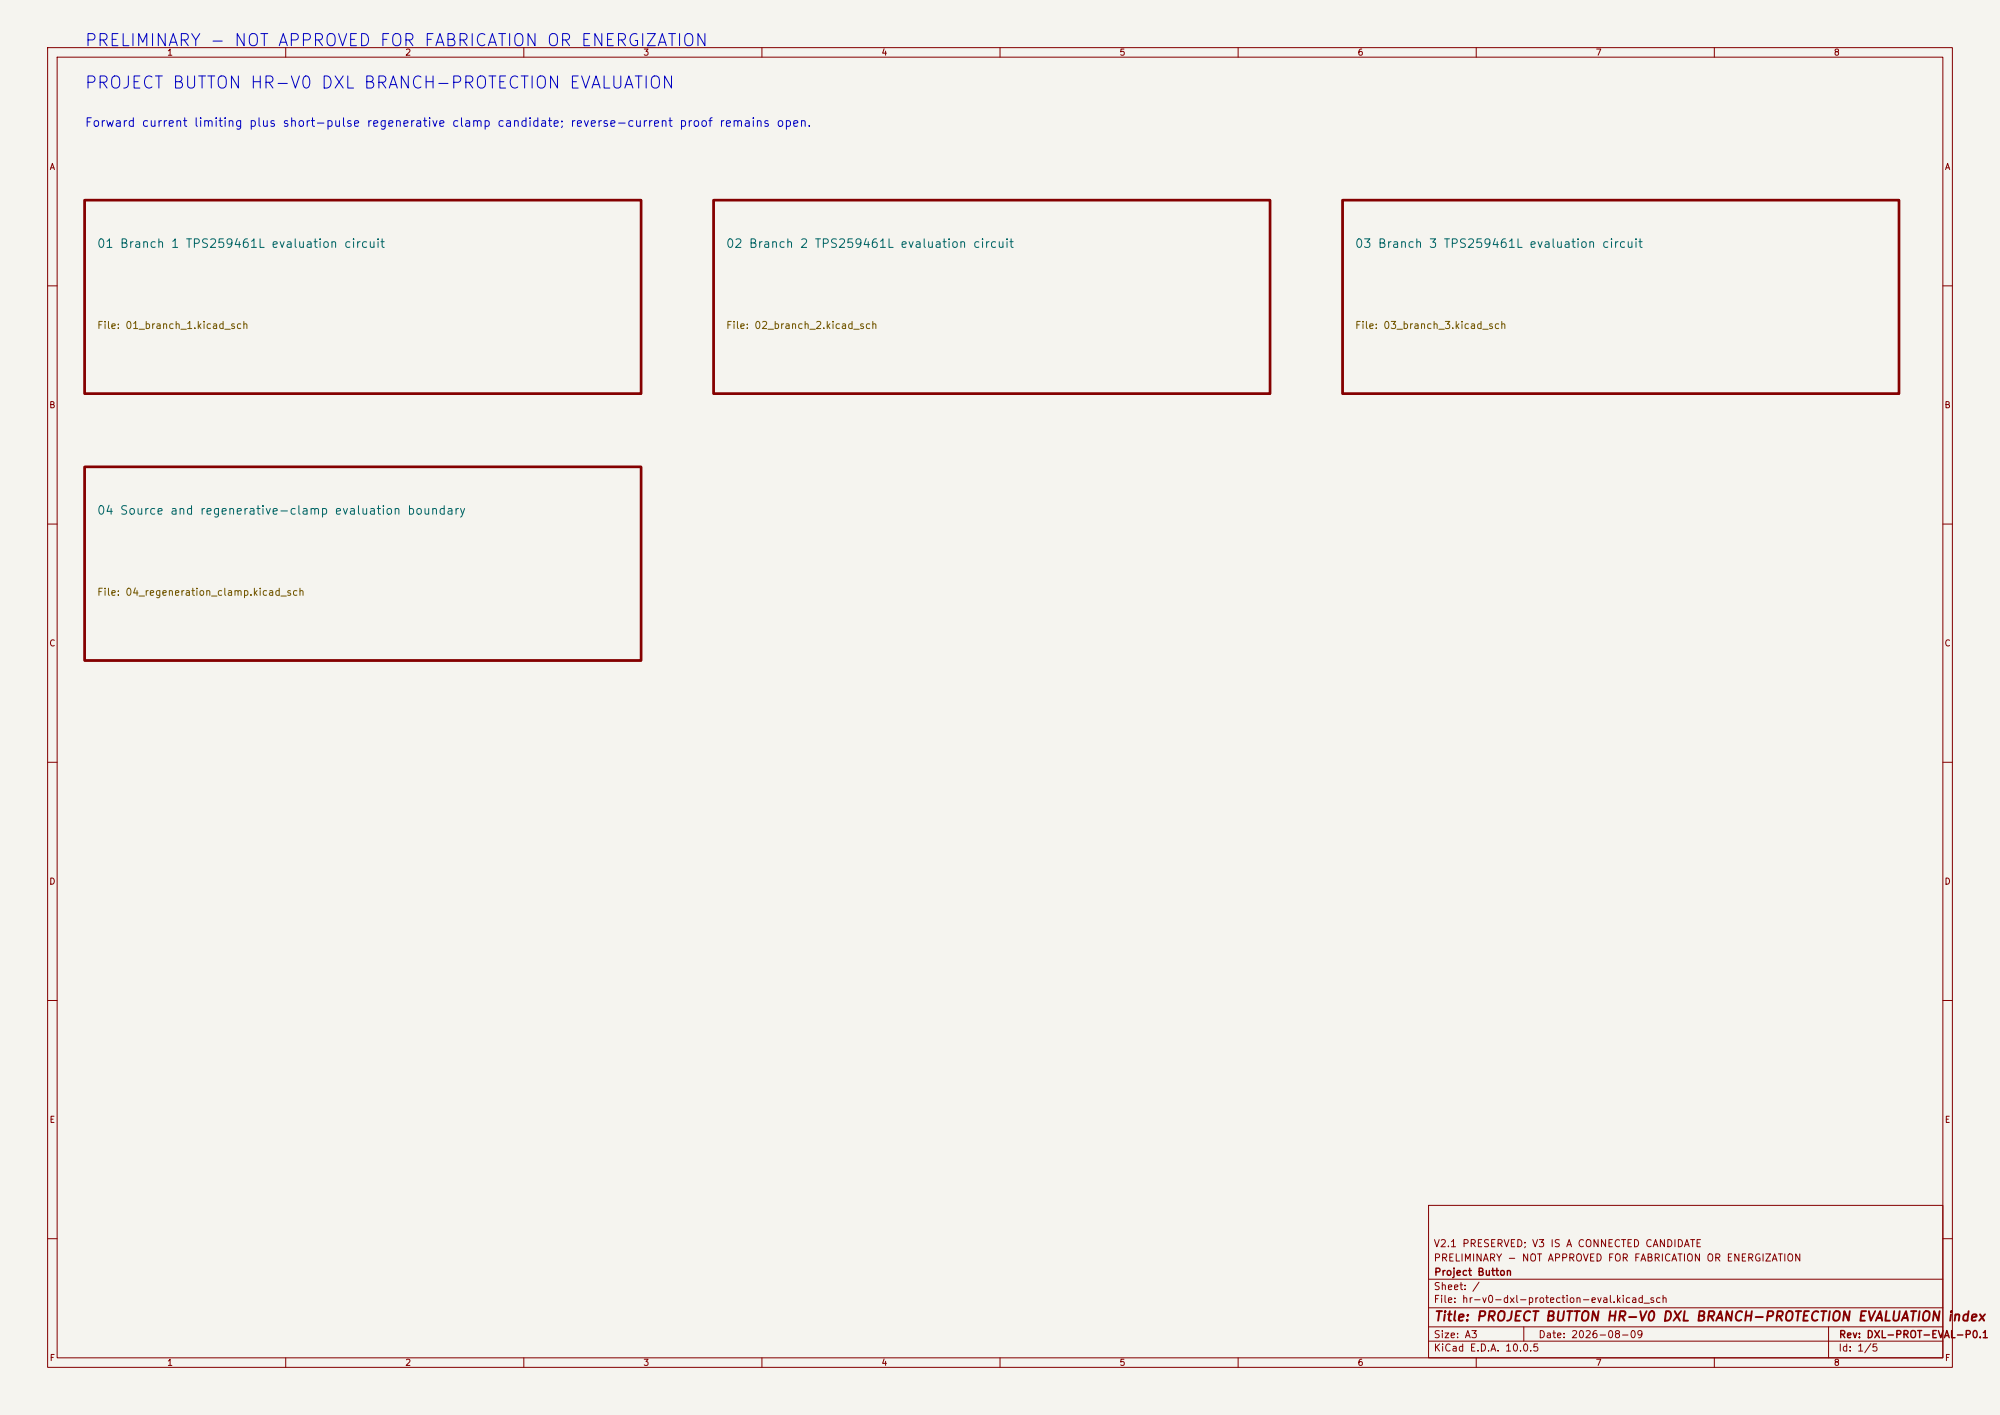
[picture p211: page 1]

PRELIMINARY - NOT APPROVED FOR FABRICATION OR ENERGIZATION

PROJECT BUTTON HR-V0 DXL BRANCH-PROTECTION EVALUATION

Forward current limiting plus short-pulse regenerative clamp candidate; reverse-current proof remains open.

04 Source and regenerative-clamp evaluation boundary

V2.1 PRESERVED; V3 IS A CONNECTED CANDIDATE
Project Button
Sheet: /
File: hr-v0-dxl-protection-eval.kicad_sch
Title: PROJECT BUTTON HR-V0 DXL BRANCH-PROTECTION EVALUATION index

F Date: 2026-08-09

KiCad E.D.A. 10.0.5 | Id: 1/5

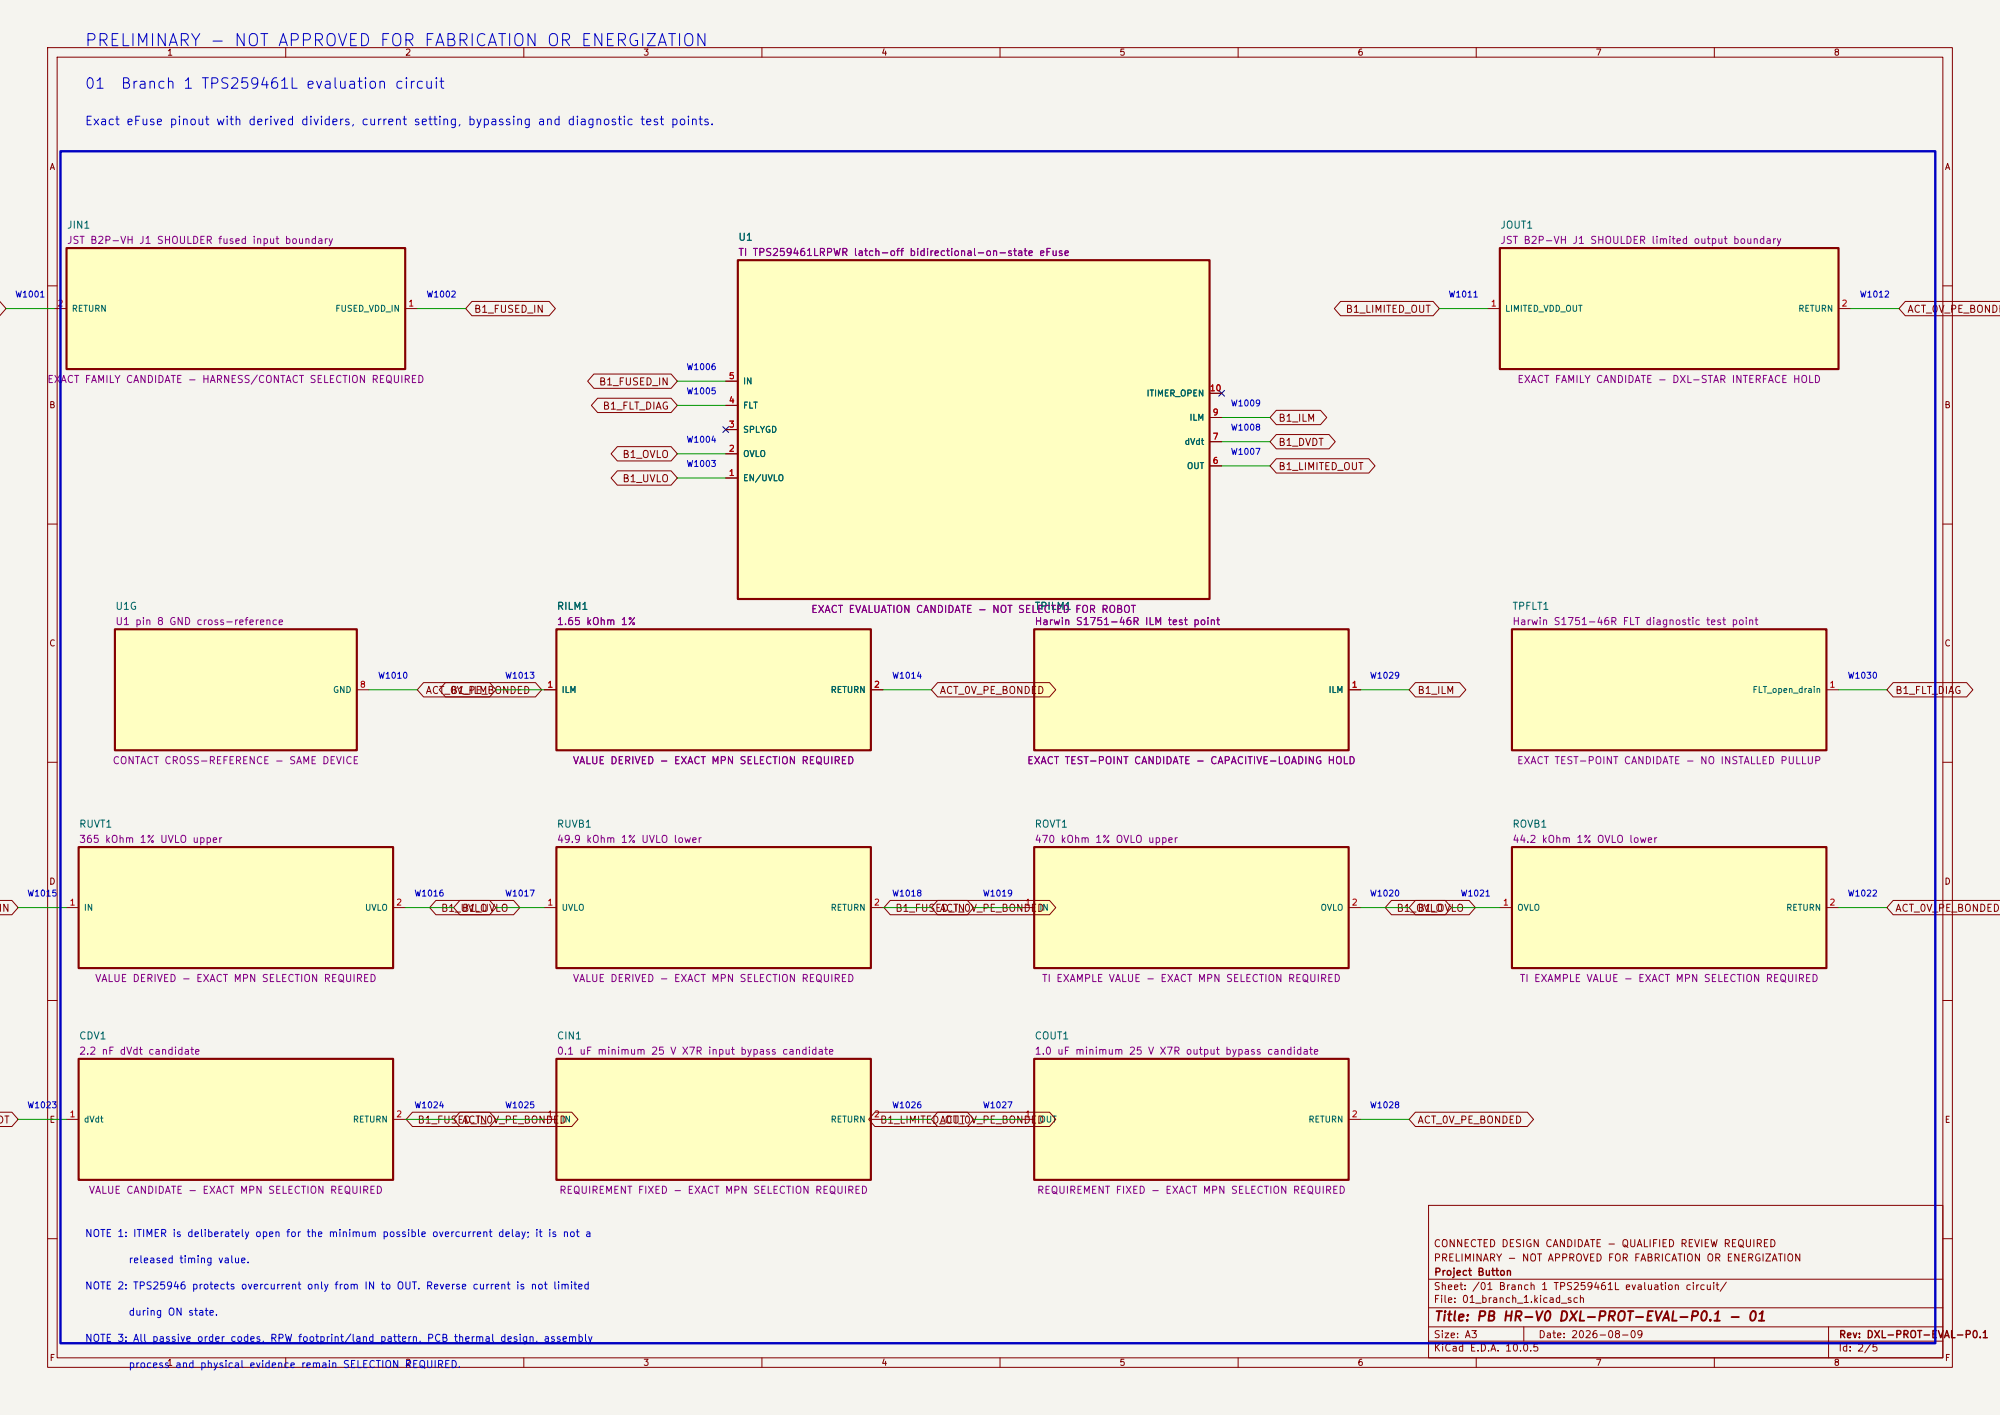
[picture p212: page 2]

Exact eFuse pinout with derived dividers, current setting, bypassing and diagnostic test points. W1006

JIN1
JST B2P-VH J1 SHOULDER fused input boundary

JOUT1
JST B2P-VH J1 SHOULDER limited output boundary

TI TPS259461LRPWR latch-off bidirectional-on-state eFuse

EXACT FAMILY CANDIDATE - HARNESS/CONTACT SELECTION REQUIRED

EXACT FAMILY CANDIDATE - DXL-STAR INTERFACE HOLD

EXACT EVALUATION CANDIDATE - NOT SELECTED FOR ROBOT

TPILM1
Harwin S1751-46R ILM test point

TPFLT1
Harwin S1751-46R FLT diagnostic test point

CONTACT CROSS-REFERENCE - SAME DEVICE

VALUE DERIVED - EXACT MPN SELECTION REQUIRED

EXACT TEST-POINT CANDIDATE - CAPACITIVE-LOADING HOLD

EXACT TEST-POINT CANDIDATE - NO INSTALLED PULLUP

TI EXAMPLE VALUE - EXACT MPN SELECTION REQUIRED

0.1 uF minimum 25 V X7R input bypass candidate

1.0 uF minimum 25 V X7R output bypass candidate

VALUE CANDIDATE - EXACT MPN SELECTION REQUIRED

REQUIREMENT FIXED - EXACT MPN SELECTION REQUIRED

CONNECTED DESIGN CANDIDATE - QUALIFIED REVIEW REQUIRED PRELIMINARY - NOT APPROVED FOR FABRICATION OR ENERGIZATION Project Button

Sheet: /01 Branch 1 TPS259461L evaluation circuit/ File: 01_branch_1.kicad_sch

Title: PB HR-V0 DXL-PROT-EVAL-P0.1 - 01

NOTE 3: All passive order codes, RPW footprint/land pattern, PCB thermal design, assembly

process and physical evidence remain SELECTION REQUIRED.

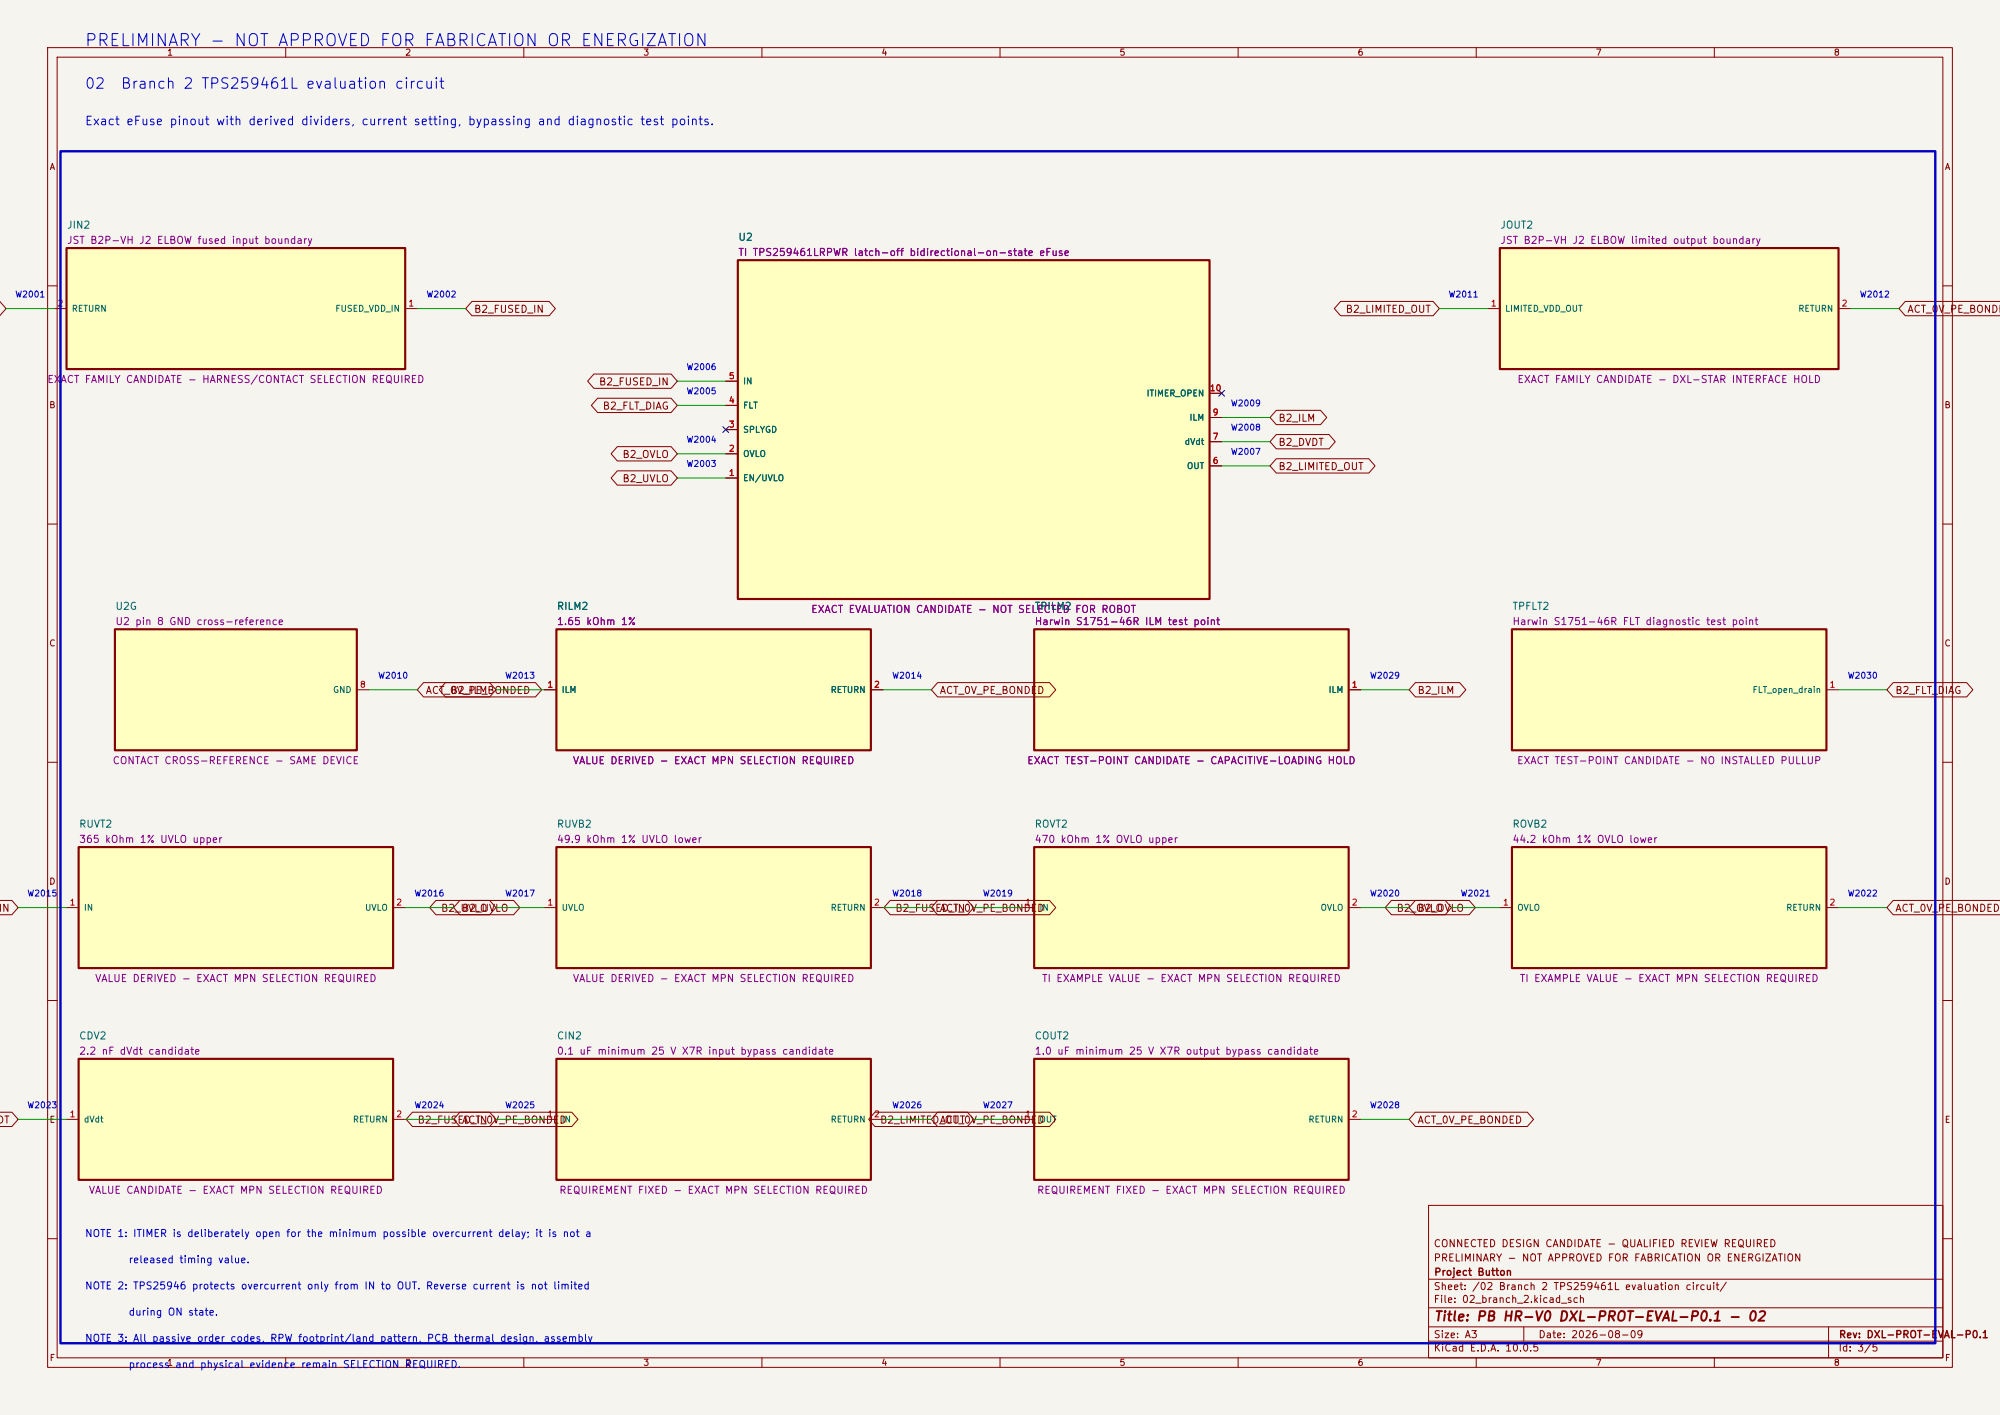
[picture p213: page 3]

Exact eFuse pinout with derived dividers, current setting, bypassing and diagnostic test points. W2006

JIN2
JST B2P-VH J2 ELBOW fused input boundary

JOUT2
JST B2P-VH J2 ELBOW limited output boundary

TI TPS259461LRPWR latch-off bidirectional-on-state eFuse

EXACT FAMILY CANDIDATE - HARNESS/CONTACT SELECTION REQUIRED

EXACT FAMILY CANDIDATE - DXL-STAR INTERFACE HOLD

EXACT EVALUATION CANDIDATE - NOT SELECTED FOR ROBOT

TPILM2
Harwin S1751-46R ILM test point

TPFLT2
Harwin S1751-46R FLT diagnostic test point

CONTACT CROSS-REFERENCE - SAME DEVICE

VALUE DERIVED - EXACT MPN SELECTION REQUIRED

EXACT TEST-POINT CANDIDATE - CAPACITIVE-LOADING HOLD

EXACT TEST-POINT CANDIDATE - NO INSTALLED PULLUP

TI EXAMPLE VALUE - EXACT MPN SELECTION REQUIRED

0.1 uF minimum 25 V X7R input bypass candidate

1.0 uF minimum 25 V X7R output bypass candidate

VALUE CANDIDATE - EXACT MPN SELECTION REQUIRED

REQUIREMENT FIXED - EXACT MPN SELECTION REQUIRED

CONNECTED DESIGN CANDIDATE - QUALIFIED REVIEW REQUIRED PRELIMINARY - NOT APPROVED FOR FABRICATION OR ENERGIZATION Project Button

Sheet: /02 Branch 2 TPS259461L evaluation circuit/ File: 02_branch_2.kicad_sch

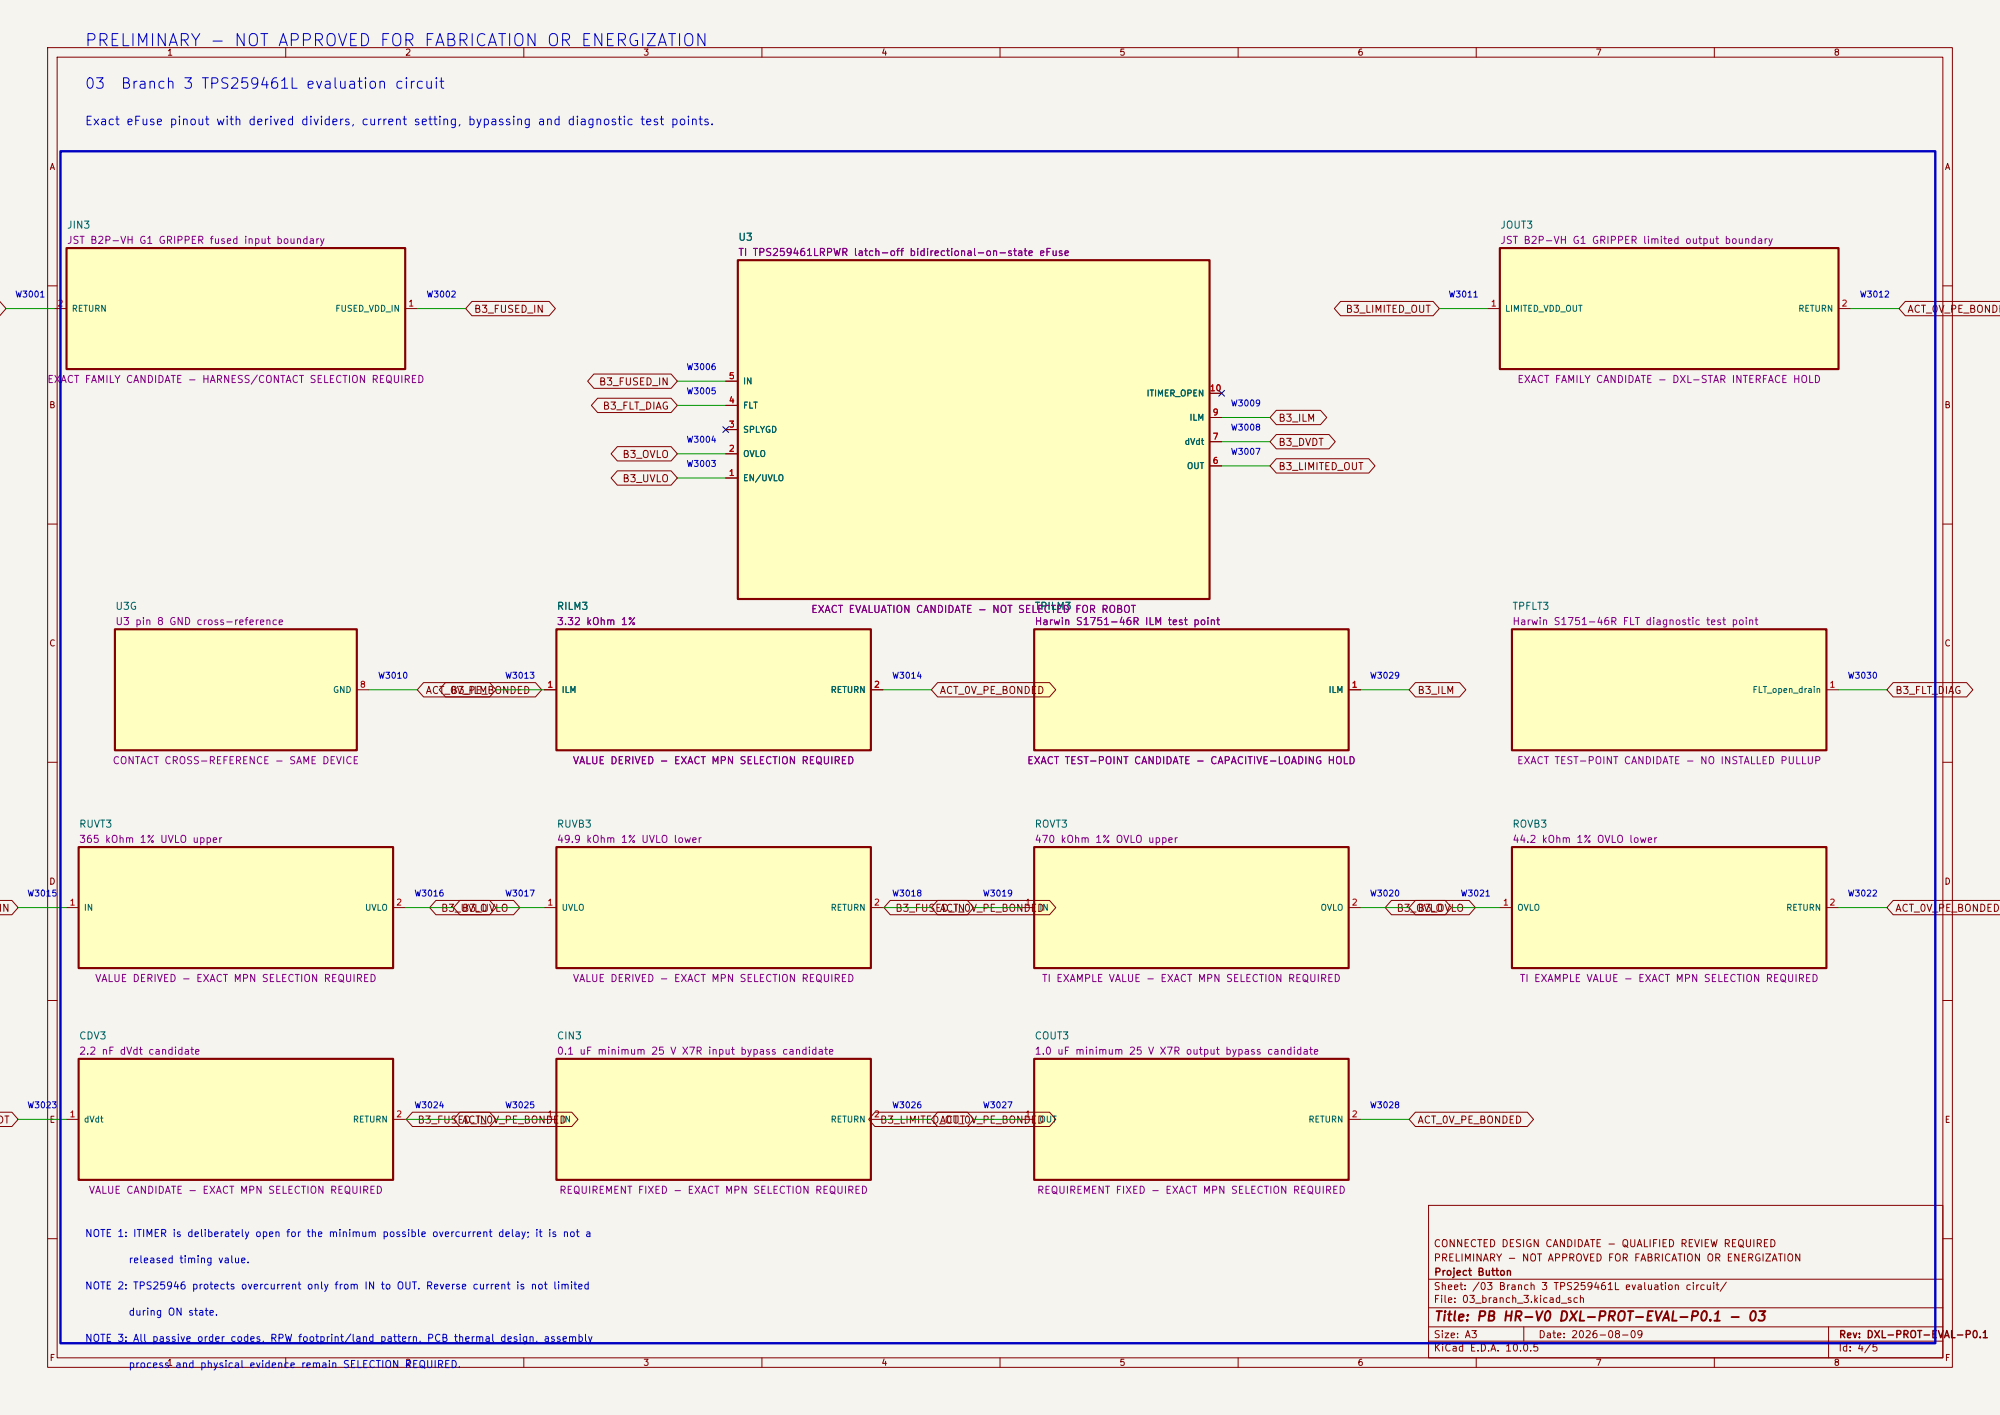
[picture p214: page 4]

Exact eFuse pinout with derived dividers, current setting, bypassing and diagnostic test points. W3006

JIN3
JST B2P-VH G1 GRIPPER fused input boundary

JOUT3
JST B2P-VH G1 GRIPPER limited output boundary

TI TPS259461LRPWR latch-off bidirectional-on-state eFuse

EXACT FAMILY CANDIDATE - HARNESS/CONTACT SELECTION REQUIRED

EXACT FAMILY CANDIDATE - DXL-STAR INTERFACE HOLD

EXACT EVALUATION CANDIDATE - NOT SELECTED FOR ROBOT

TPILM3
Harwin S1751-46R ILM test point

TPFLT3
Harwin S1751-46R FLT diagnostic test point

CONTACT CROSS-REFERENCE - SAME DEVICE

VALUE DERIVED - EXACT MPN SELECTION REQUIRED

EXACT TEST-POINT CANDIDATE - CAPACITIVE-LOADING HOLD

EXACT TEST-POINT CANDIDATE - NO INSTALLED PULLUP

TI EXAMPLE VALUE - EXACT MPN SELECTION REQUIRED

0.1 uF minimum 25 V X7R input bypass candidate

1.0 uF minimum 25 V X7R output bypass candidate

VALUE CANDIDATE - EXACT MPN SELECTION REQUIRED

REQUIREMENT FIXED - EXACT MPN SELECTION REQUIRED

CONNECTED DESIGN CANDIDATE - QUALIFIED REVIEW REQUIRED PRELIMINARY - NOT APPROVED FOR FABRICATION OR ENERGIZATION Project Button

Sheet: /03 Branch 3 TPS259461L evaluation circuit/ File: 03_branch_3.kicad_sch

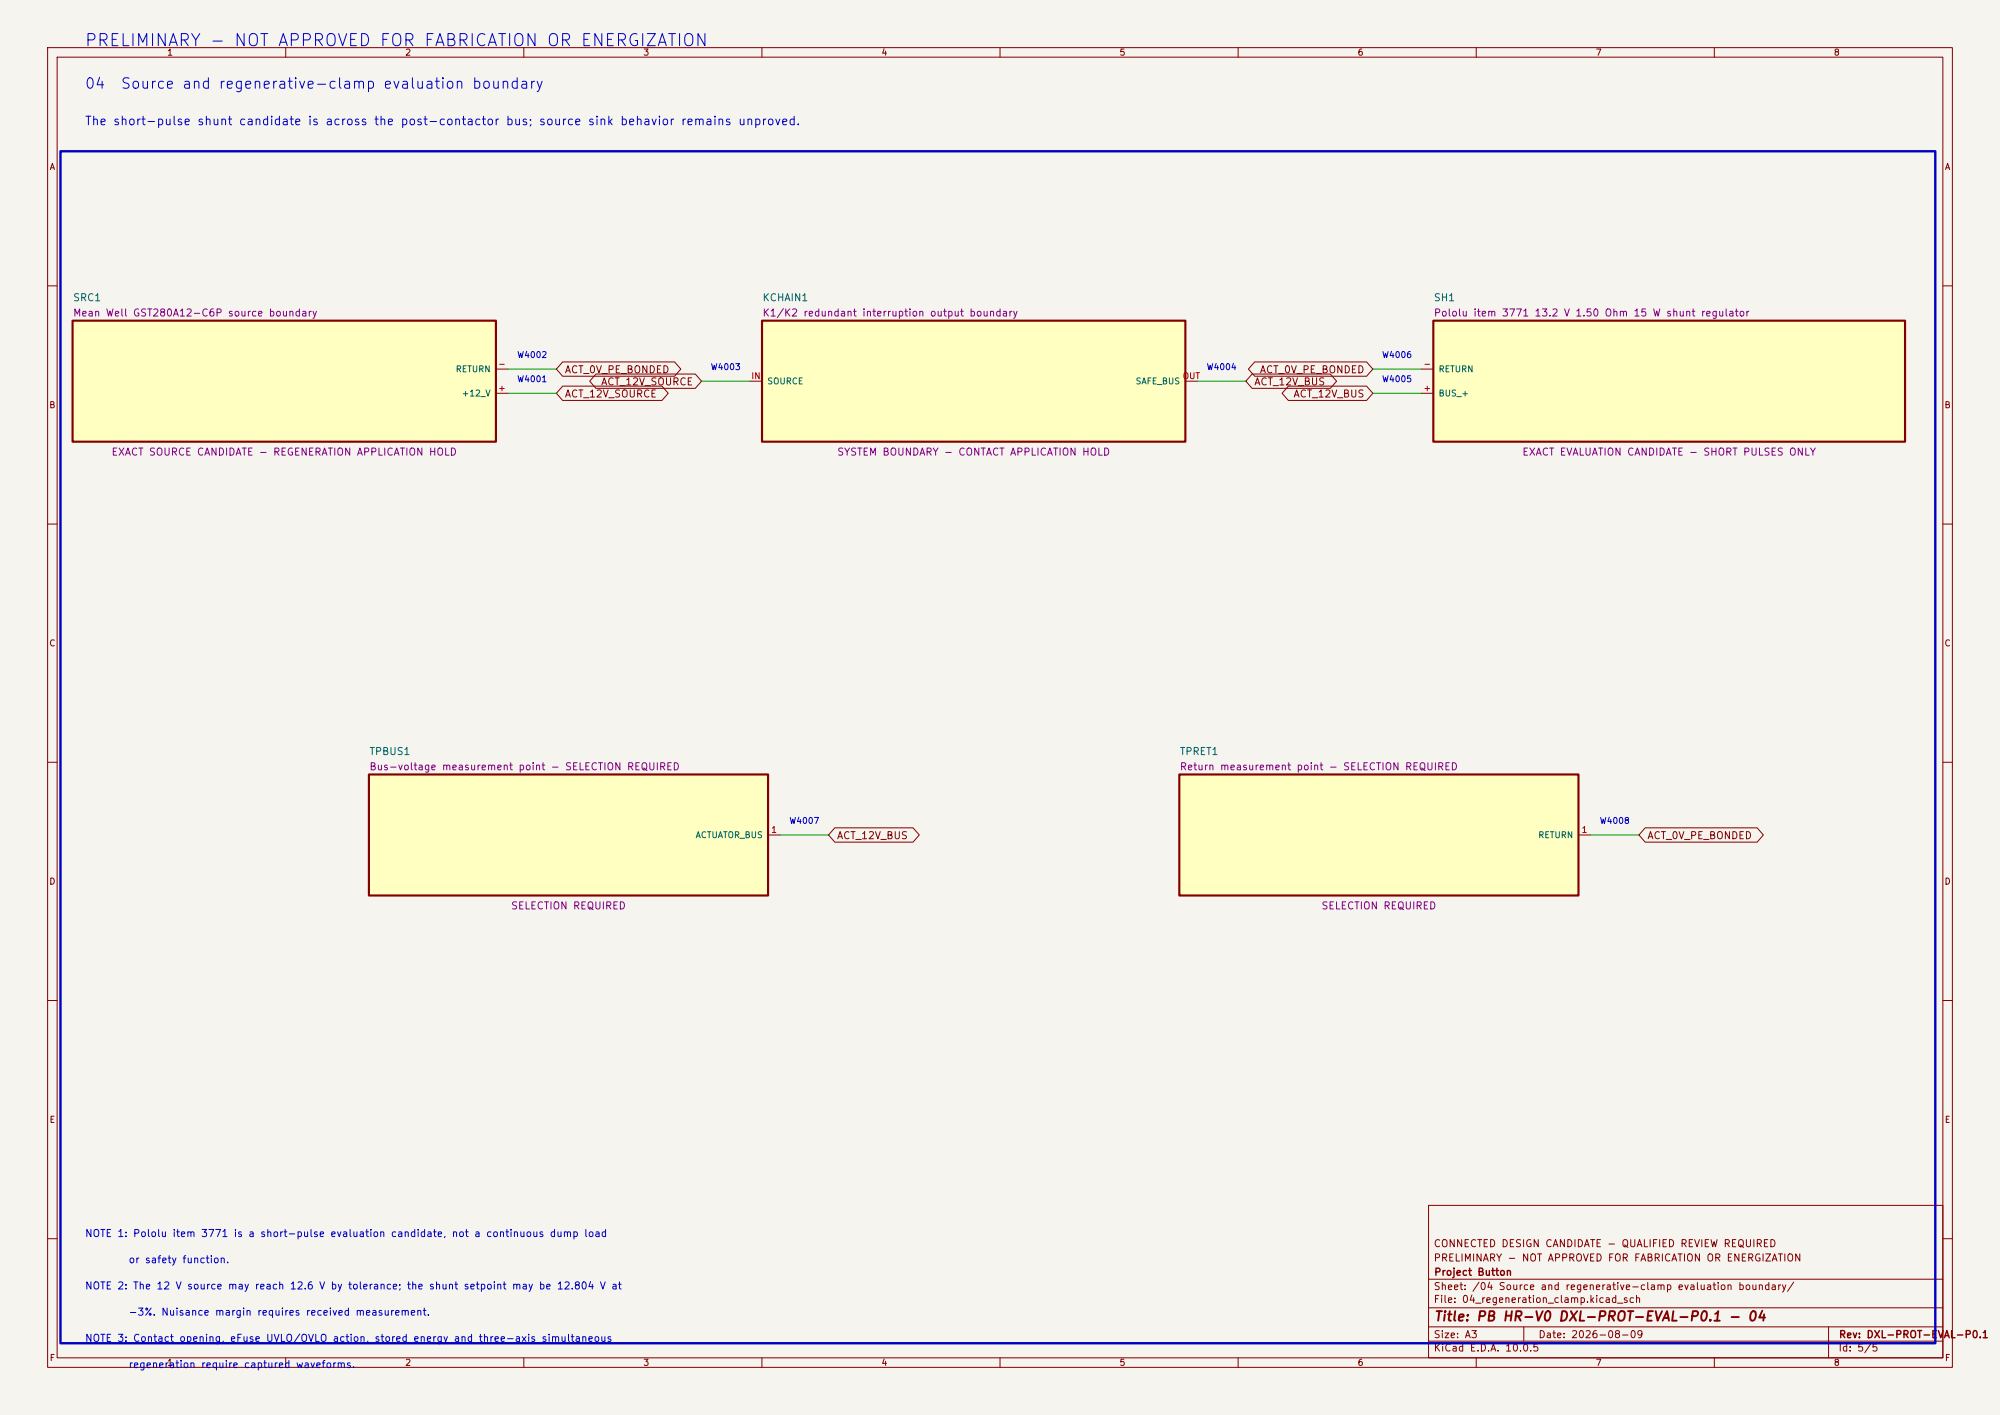
[picture p215: page 5]

04 Source and regenerative-clamp evaluation boundary

W4002 The short-pulse shunt candidate is across the post-contactor bus; source sink behavior remains unproved.

EXACT SOURCE CANDIDATE - REGENERATION APPLICATION HOLD

SYSTEM BOUNDARY - CONTACT APPLICATION HOLD

EXACT EVALUATION CANDIDATE - SHORT PULSES ONLY

TPBUS1
Bus-voltage measurement point - SELECTION REQUIRED

TPRET1
Return measurement point - SELECTION REQUIRED

NOTE 1: Pololu item 3771 is a short-pulse evaluation candidate, not a continuous dump load

CONNECTED DESIGN CANDIDATE - QUALIFIED REVIEW REQUIRED PRELIMINARY - NOT APPROVED FOR FABRICATION OR ENERGIZATION Project Button

NOTE 2: The 12 V source may reach 12.6 V by tolerance; the shunt setpoint may be 12.804 V at

Sheet: /04 Source and regenerative-clamp evaluation boundary/ File: 04_regeneration_clamp.kicad_sch

-3%. Nuisance margin requires received measurement.

NOTE 3: Contact opening, eFuse UVLO/OVLO action, stored energy and three-axis simultaneous

regeneration require captured waveforms.
