amyleesterling/humanoid-robot/electrical/kicad/hr-v0-dxl-star-p0.2-carrier-candidate/output/hr-v0-dxl-star-p0.2-carrier-candidate-preliminary.pdf

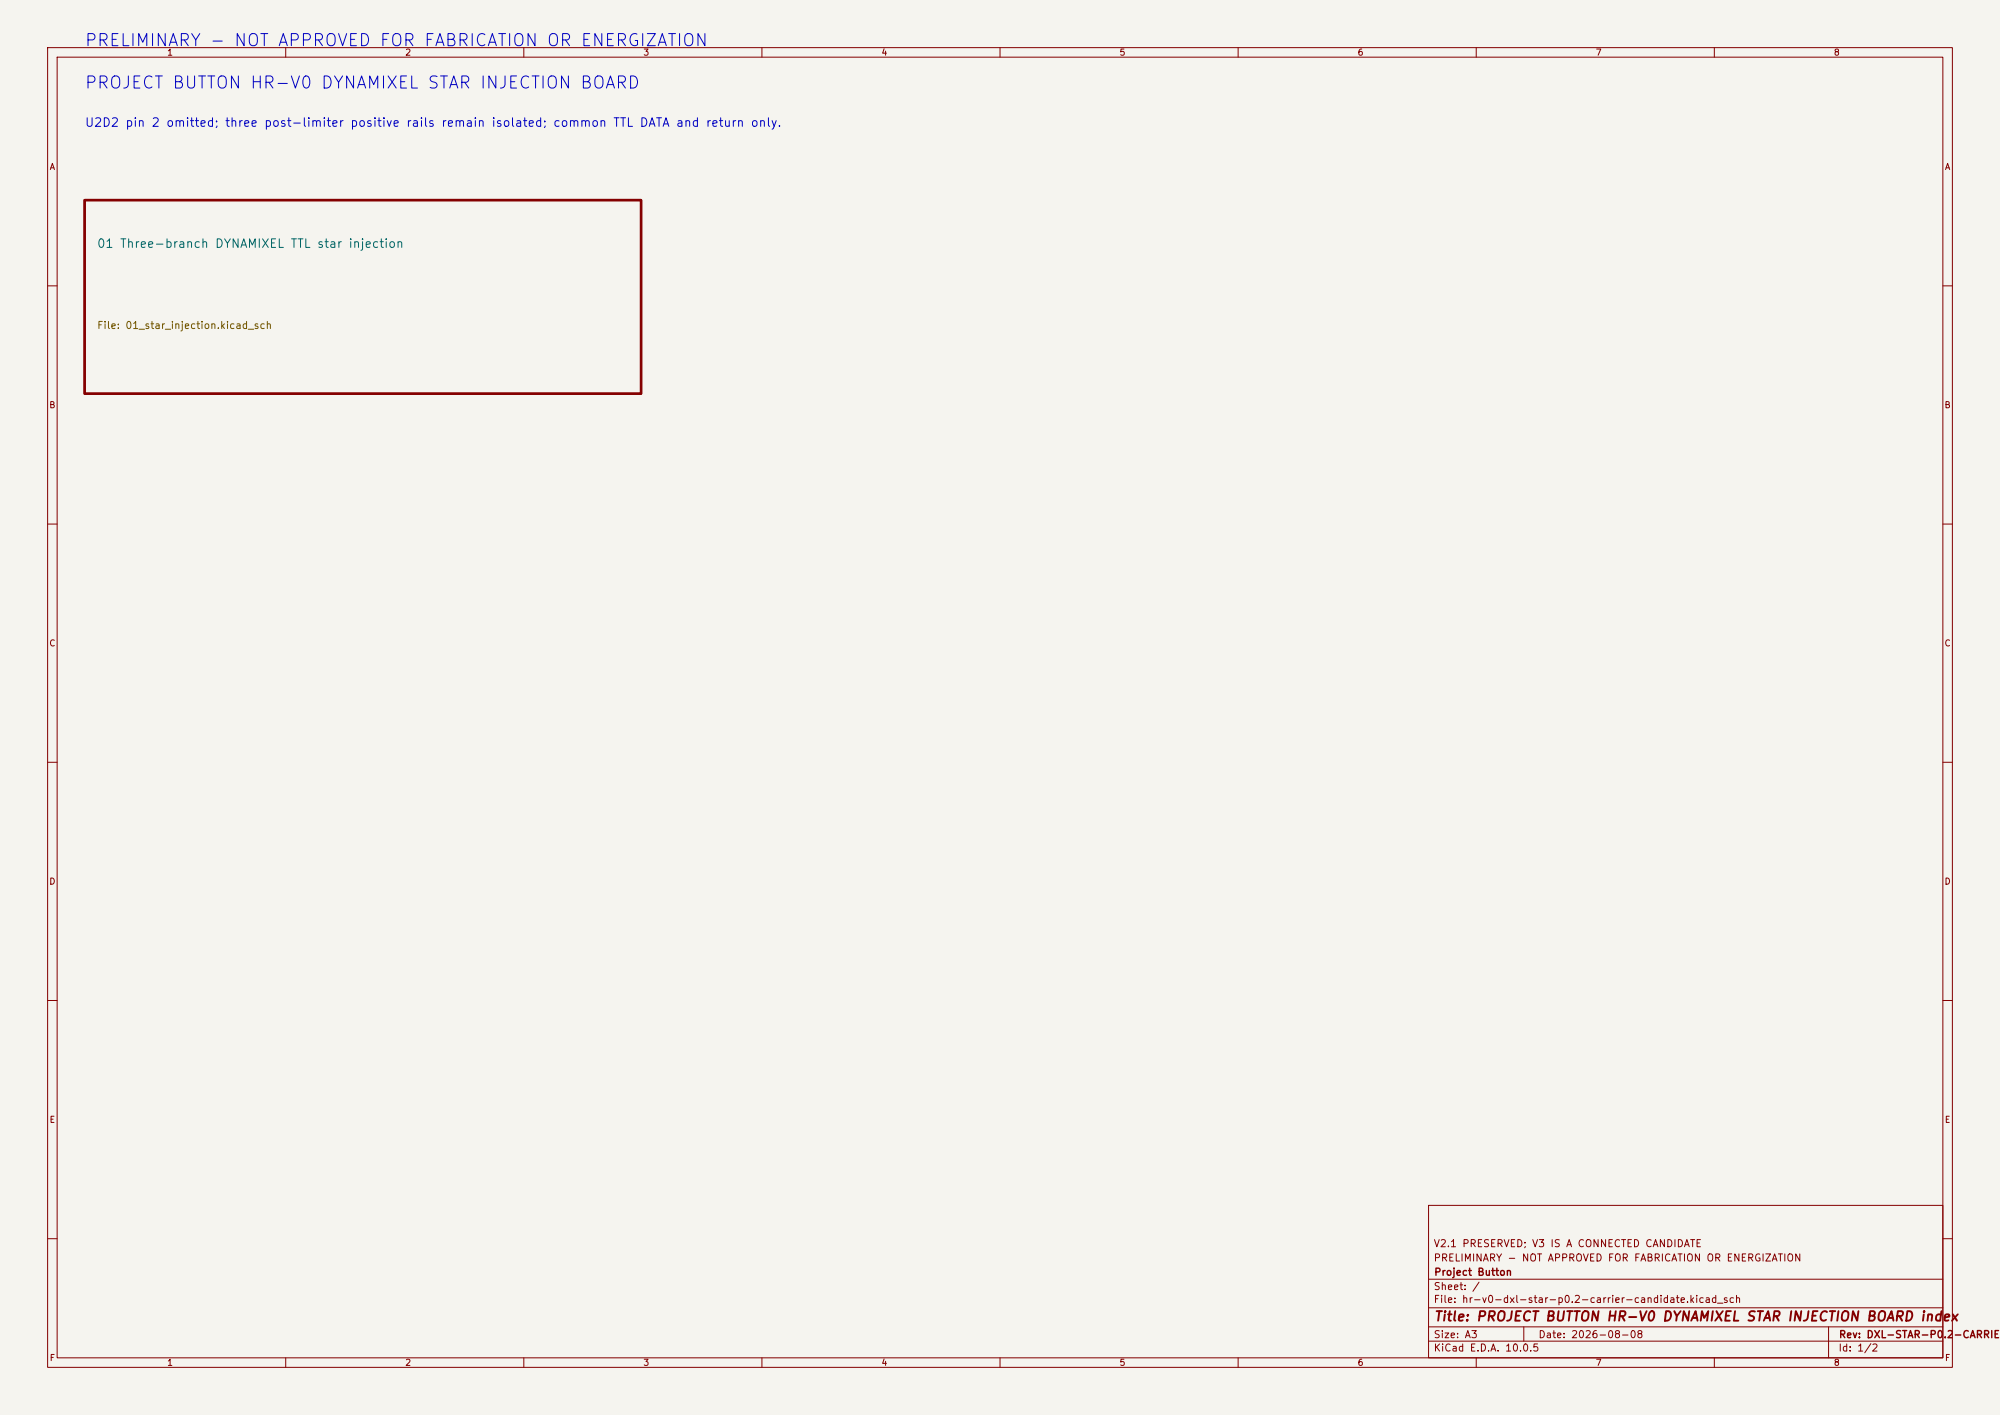
[picture p216: page 1]

PRELIMINARY - NOT APPROVED FOR FABRICATION OR ENERGIZATION

PROJECT BUTTON HR-V0 DYNAMIXEL STAR INJECTION BOARD

U2D2 pin 2 omitted; three post-limiter positive rails remain isolated; common TTL DATA and return only.

01 Three-branch DYNAMIXEL TTL star injection

V2.1 PRESERVED; V3 IS A CONNECTED CANDIDATE
Project Button
Sheet: /
File: hr-v0-dxl-star-p0.2-carrier-candidate.kicad_sch
Title: PROJECT BUTTON HR-V0 DYNAMIXEL STAR INJECTION BOARD index

F Date: 2026-08-08

KiCad E.D.A. 10.0.5 | Id: 1/2

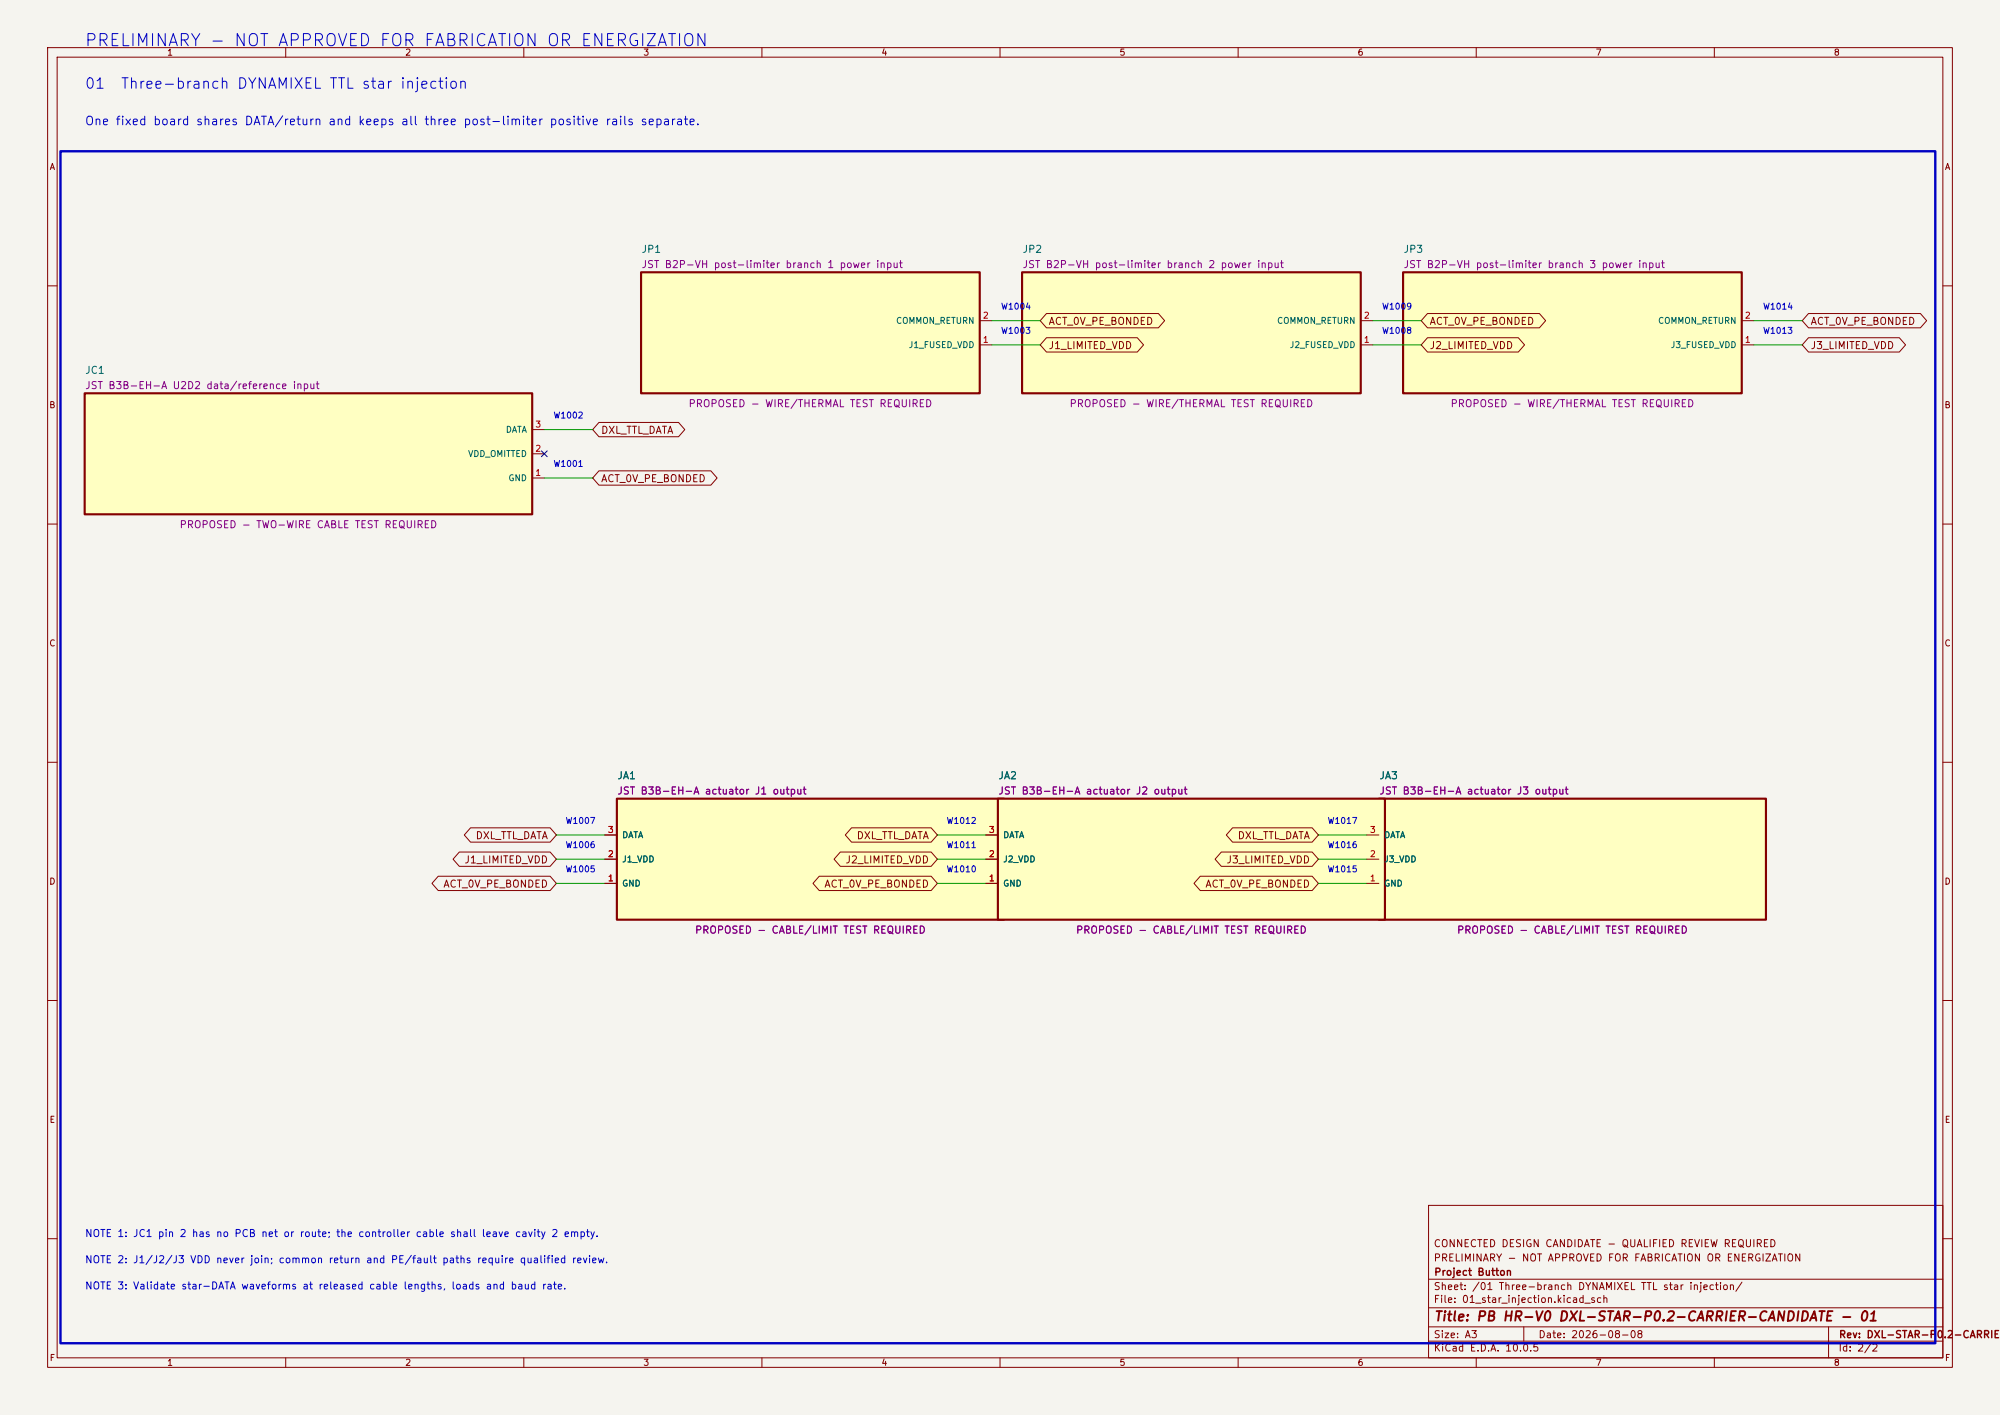
[picture p217: page 2]

W1002 W1001 PRELIMINARY - NOT APPROVED FOR FABRICATION OR ENERGIZATION

01 Three-branch DYNAMIXEL TTL star injection

One fixed board shares DATA/return and keeps all three post-limiter positive rails separate.

PROPOSED - WIRE/THERMAL TEST REQUIRED

PROPOSED - TWO-WIRE CABLE TEST REQUIRED

JST B3B-EH-A actuator J3 output GND 1

JST B3B-EH-A actuator J1 output

JST B3B-EH-A actuator J2 output

JST B3B-EH-A actuator J2 output GND 1

JST B3B-EH-A actuator J1 output GND 1

PROPOSED - CABLE/LIMIT TEST REQUIRED

NOTE 1: JC1 pin 2 has no PCB net or route; the controller cable shall leave cavity 2 empty.

CONNECTED DESIGN CANDIDATE - QUALIFIED REVIEW REQUIRED PRELIMINARY - NOT APPROVED FOR FABRICATION OR ENERGIZATION Project Button

NOTE 2: J1/J2/J3 VDD never join; common return and PE/fault paths require qualified review.

Sheet: /01 Three-branch DYNAMIXEL TTL star injection/ File: 01_star_injection.kicad_sch

Title: PB HR-V0 DXL-STAR-P0.2-CARRIER-CANDIDATE - 01

F Date: 2026-08-08
