amyleesterling/humanoid-robot/electrical/kicad/hr-v0-dynamic-event-ain-p0.1/output/hr-v0-dynamic-event-ain-p0.1-preliminary.pdf

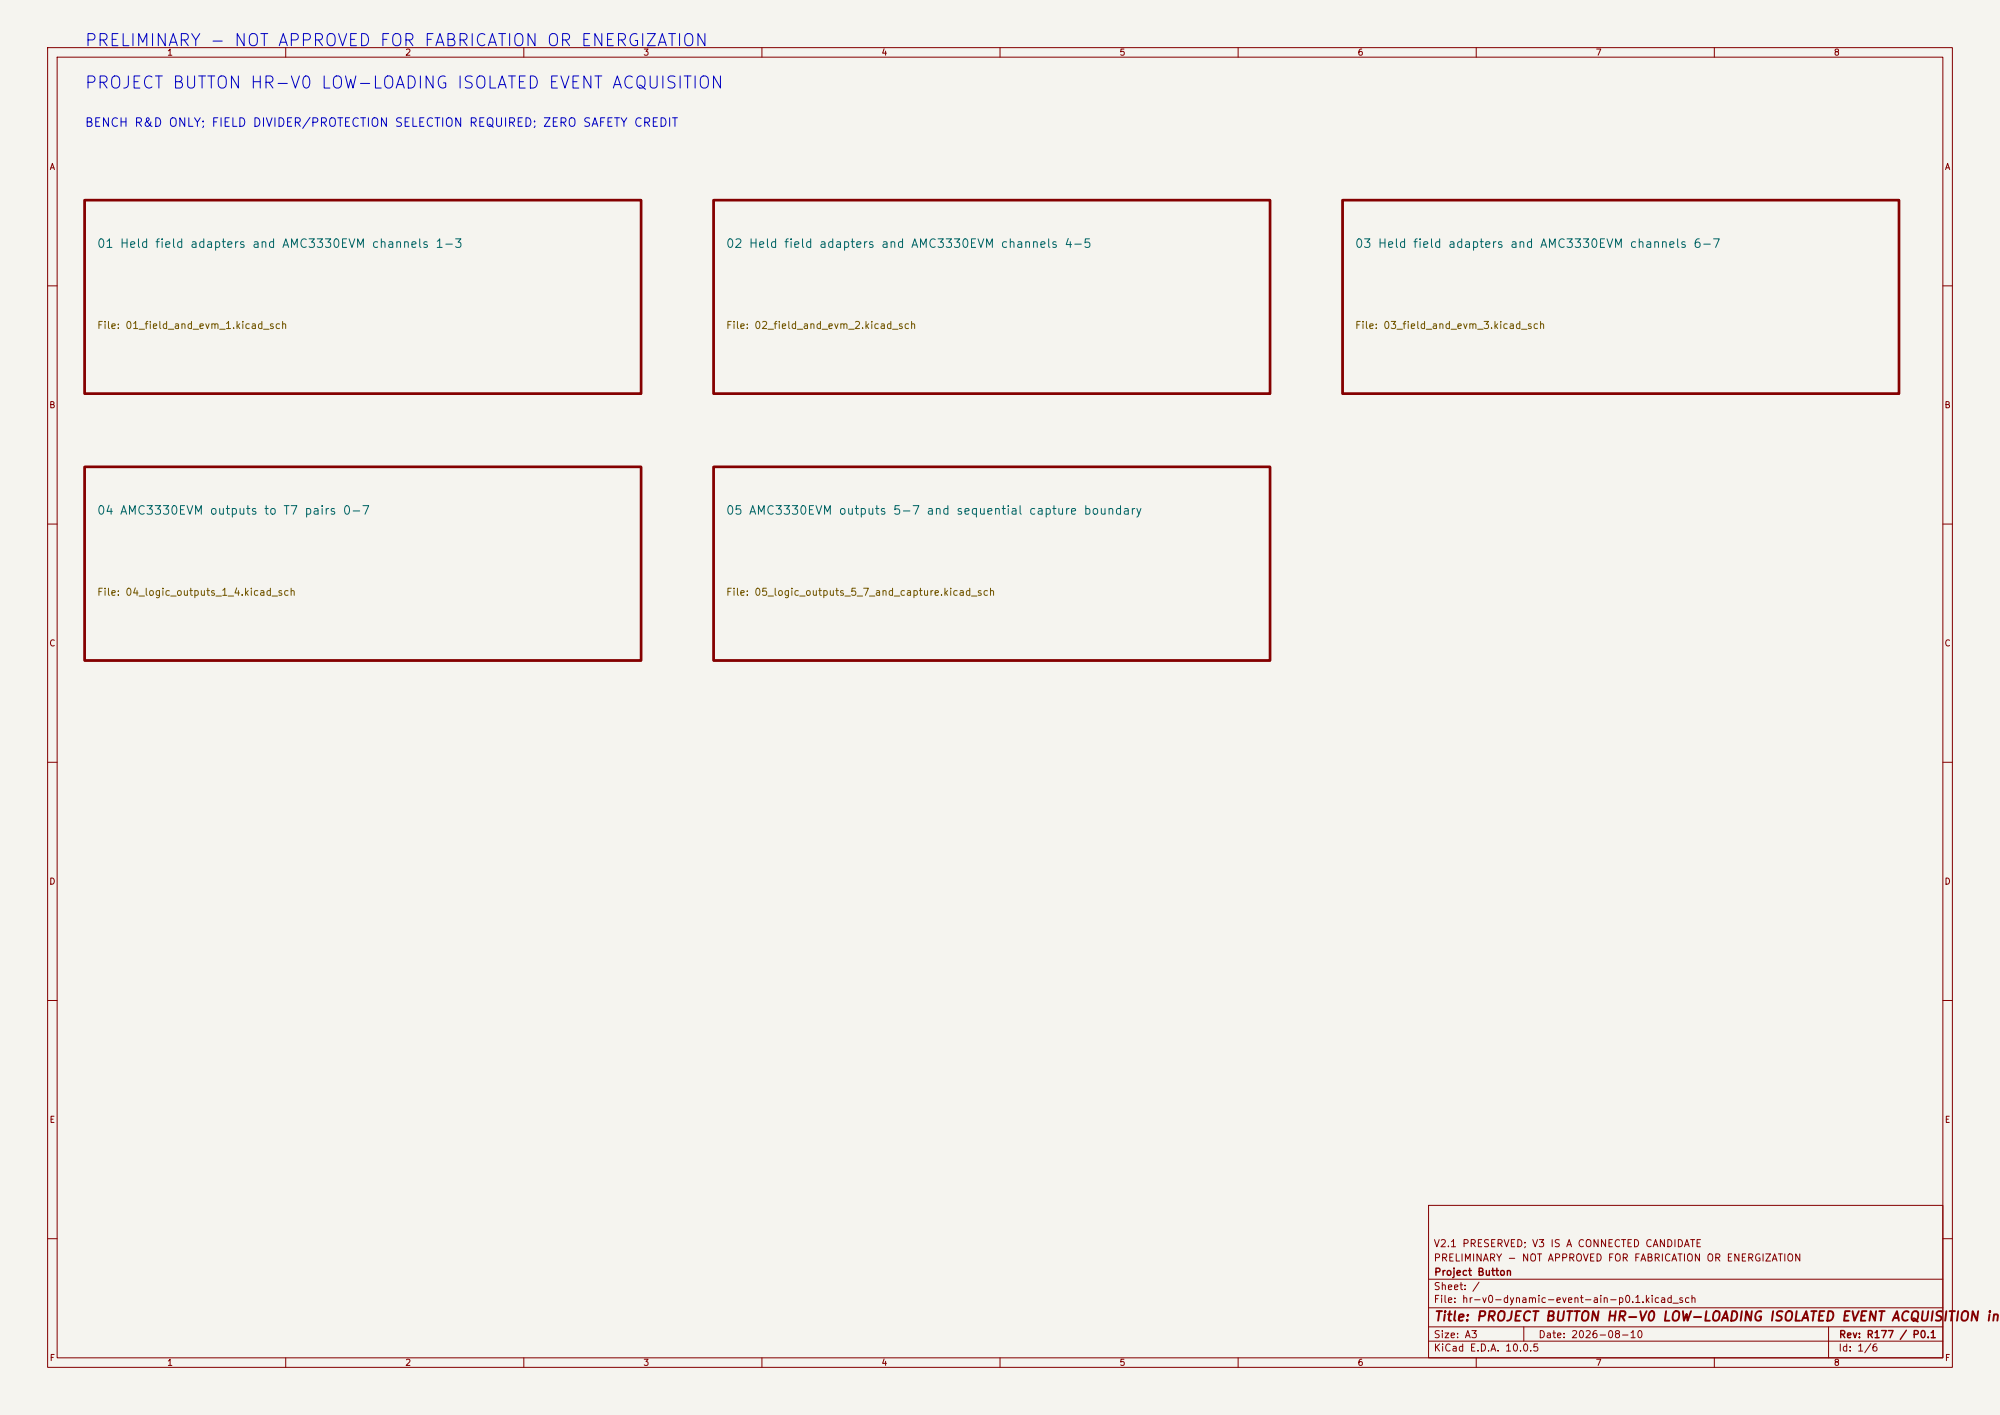
[picture p220: page 1]

PRELIMINARY - NOT APPROVED FOR FABRICATION OR ENERGIZATION

PROJECT BUTTON HR-V0 LOW-LOADING ISOLATED EVENT ACQUISITION

BENCH R&D ONLY; FIELD DIVIDER/PROTECTION SELECTION REQUIRED; ZERO SAFETY CREDIT

01 Held field adapters and AMC3330EVM channels 1-3

02 Held field adapters and AMC3330EVM channels 4-5

03 Held field adapters and AMC3330EVM channels 6-7

05 AMC3330EVM outputs 5-7 and sequential capture boundary

V2.1 PRESERVED; V3 IS A CONNECTED CANDIDATE
Project Button
Sheet: /
File: hr-v0-dynamic-event-ain-p0.1.kicad_sch
Title: PROJECT BUTTON HR-V0 LOW-LOADING ISOLATED EVENT ACQUISITION index

Size: A3 | Rev: R177 / P0.1 | F Date: 2026-08-10
KiCad E.D.A. 10.0.5 | Id: 1/6

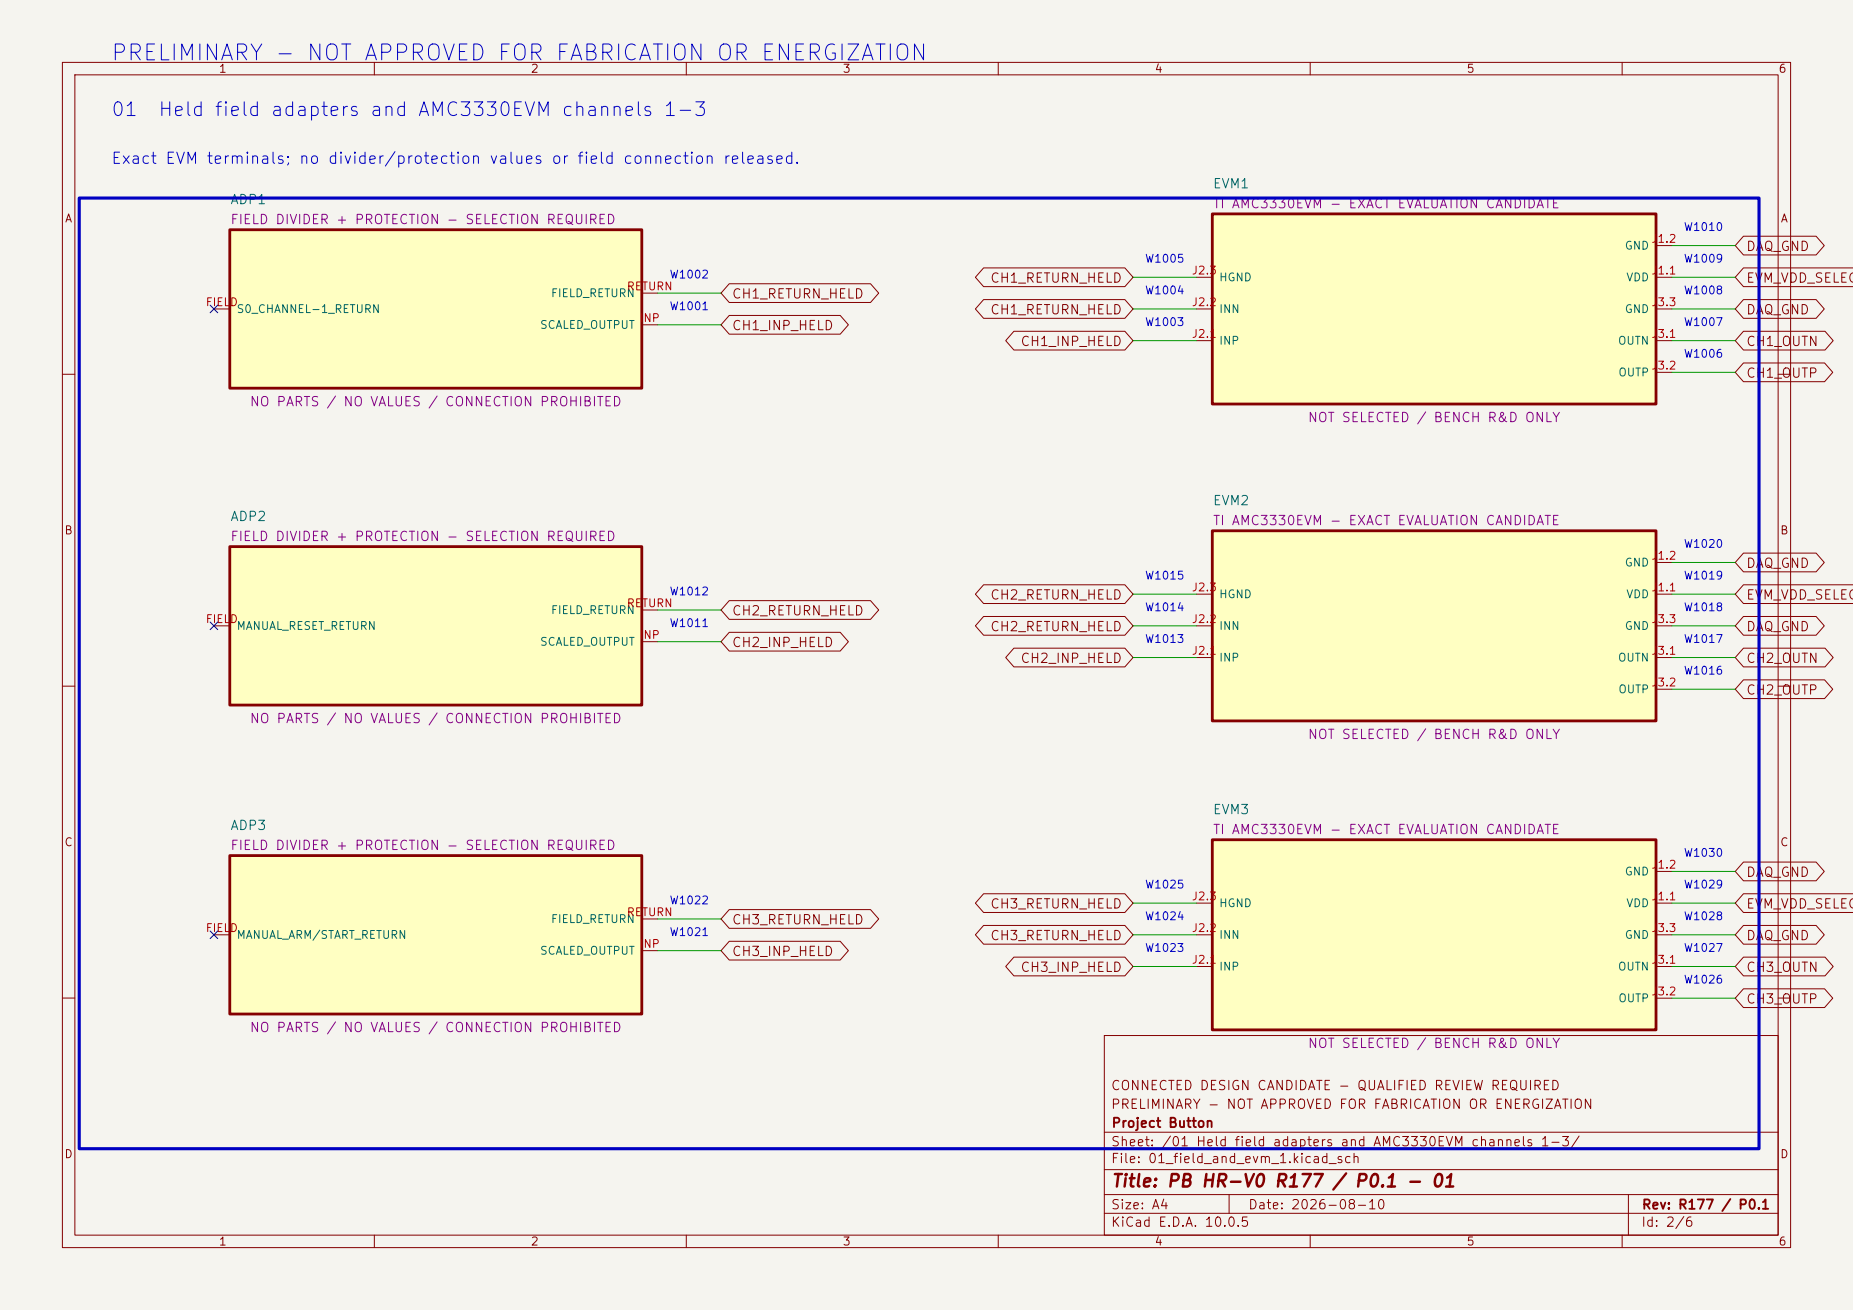
[picture p221: page 2]

W1016 W1022 W1011 W1021 01 Held field adapters and AMC3330EVM channels 1-3

TI AMC3330EVM - EXACT EVALUATION CANDIDATE

ADP1
FIELD DIVIDER + PROTECTION - SELECTION REQUIRED

NO PARTS / NO VALUES / CONNECTION PROHIBITED

NOT SELECTED / BENCH R&D ONLY

ADP2

ADP3

NOT SELECTED / BENCH R&D ONLY CONNECTED DESIGN CANDIDATE - QUALIFIED REVIEW REQUIRED PRELIMINARY - NOT APPROVED FOR FABRICATION OR ENERGIZATION Project Button

Sheet: /01 Held field adapters and AMC3330EVM channels 1-3/

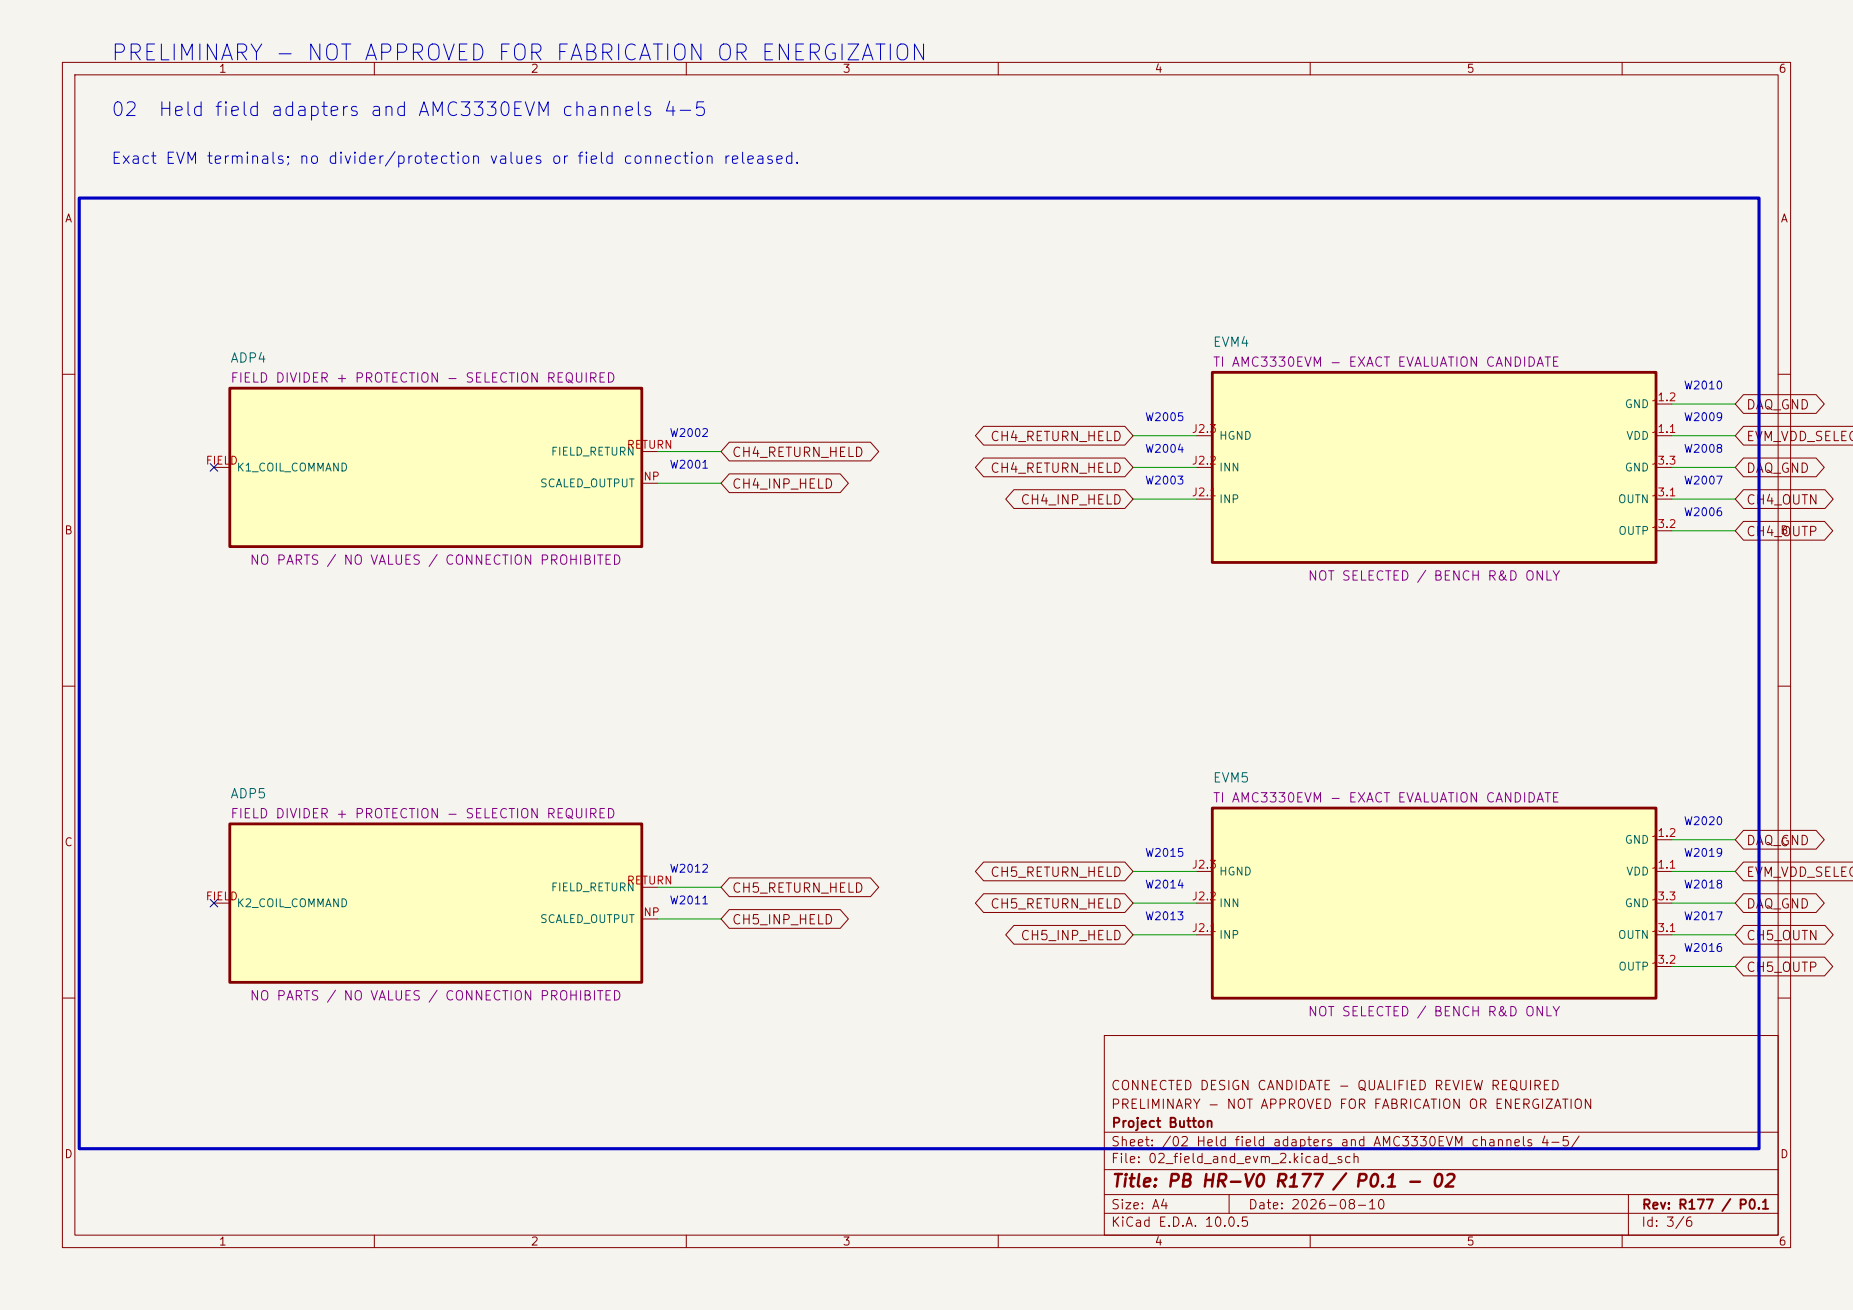
[picture p222: page 3]

02 Held field adapters and AMC3330EVM channels 4-5

TI AMC3330EVM - EXACT EVALUATION CANDIDATE

ADP4
FIELD DIVIDER + PROTECTION - SELECTION REQUIRED

NO PARTS / NO VALUES / CONNECTION PROHIBITED

NOT SELECTED / BENCH R&D ONLY

ADP5

CONNECTED DESIGN CANDIDATE - QUALIFIED REVIEW REQUIRED PRELIMINARY - NOT APPROVED FOR FABRICATION OR ENERGIZATION Project Button

Sheet: /02 Held field adapters and AMC3330EVM channels 4-5/

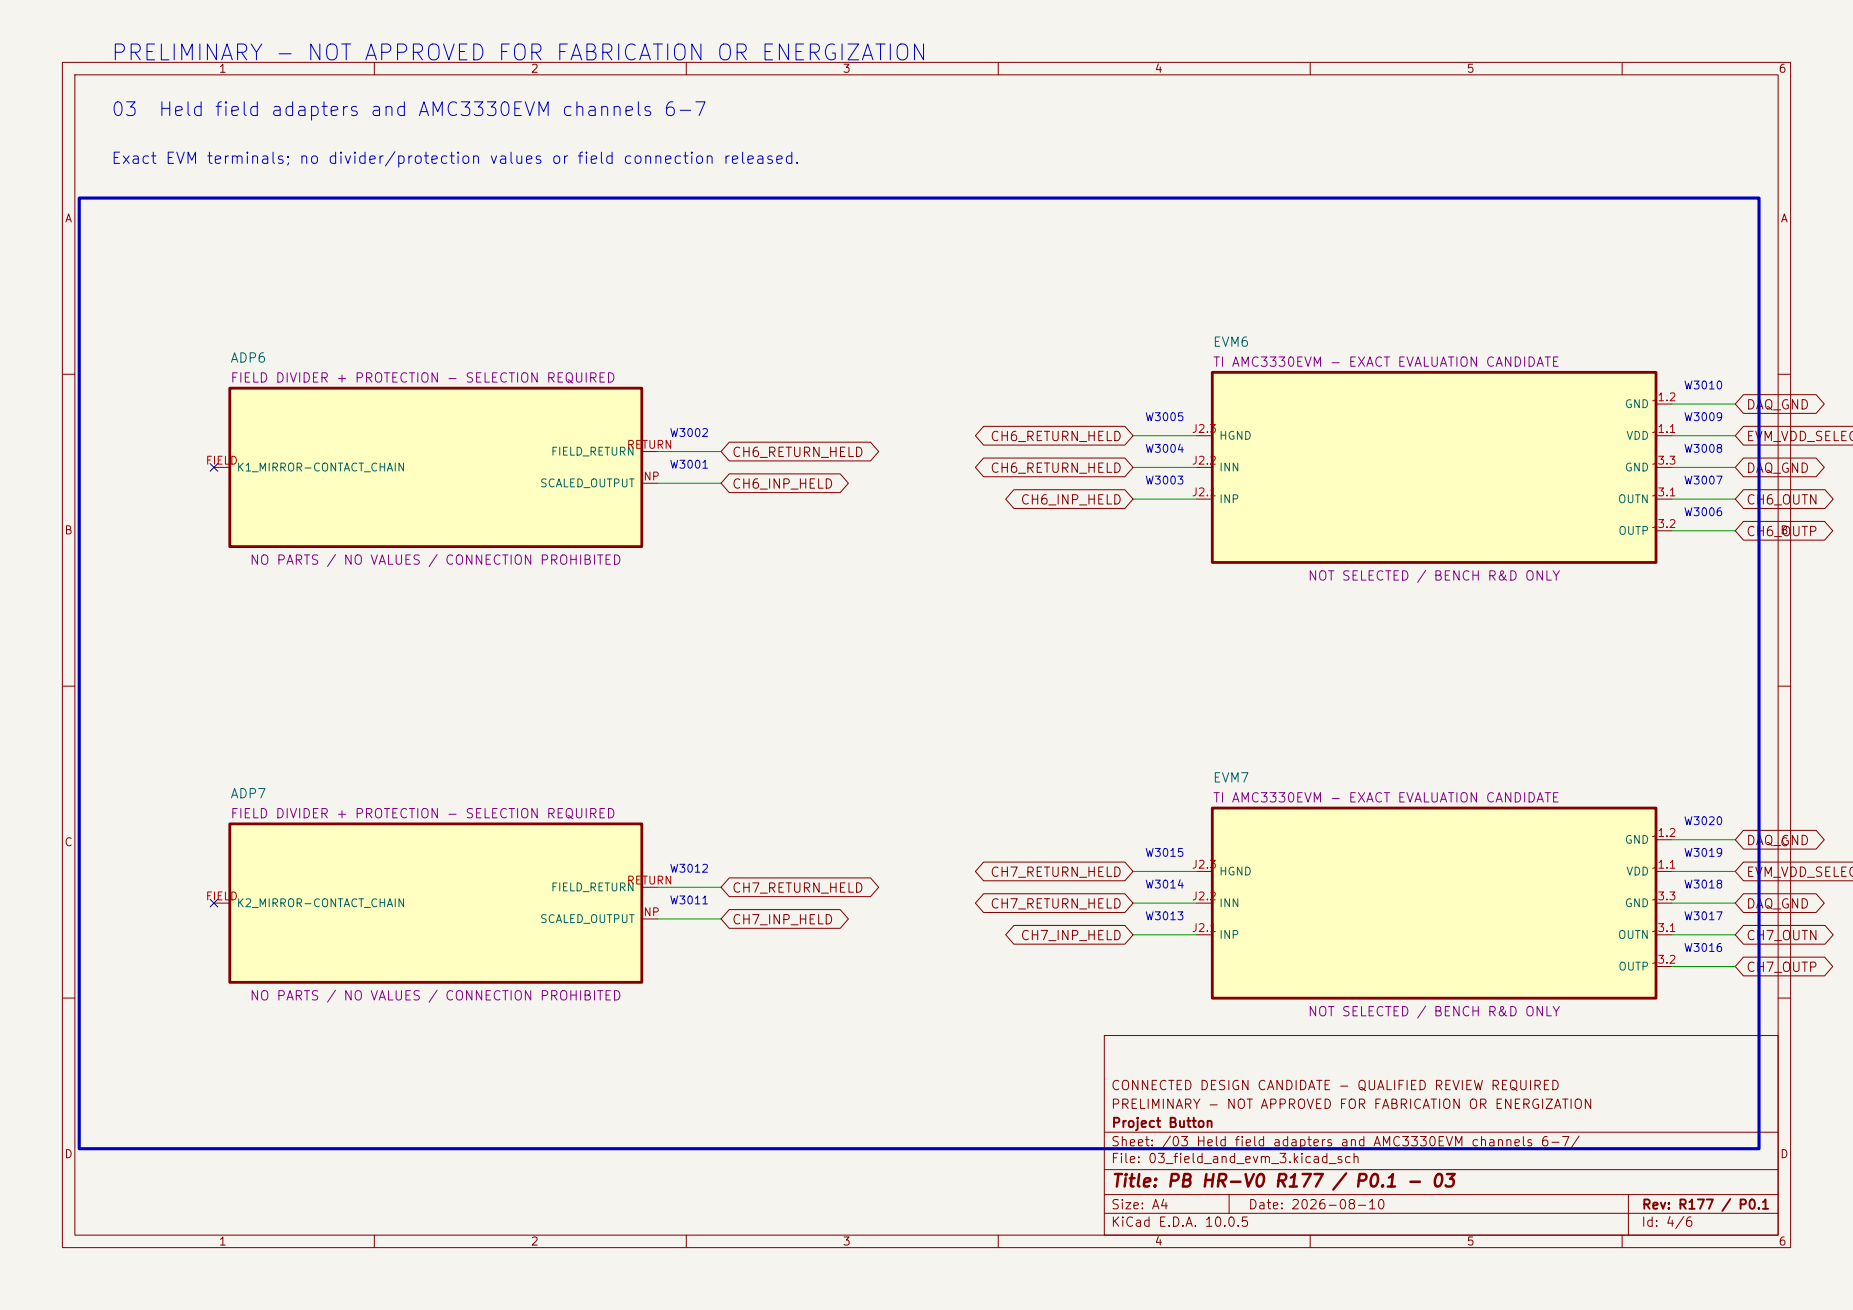
[picture p223: page 4]

03 Held field adapters and AMC3330EVM channels 6-7

TI AMC3330EVM - EXACT EVALUATION CANDIDATE

ADP6
FIELD DIVIDER + PROTECTION - SELECTION REQUIRED

NO PARTS / NO VALUES / CONNECTION PROHIBITED

NOT SELECTED / BENCH R&D ONLY

ADP7

CONNECTED DESIGN CANDIDATE - QUALIFIED REVIEW REQUIRED PRELIMINARY - NOT APPROVED FOR FABRICATION OR ENERGIZATION Project Button

Sheet: /03 Held field adapters and AMC3330EVM channels 6-7/

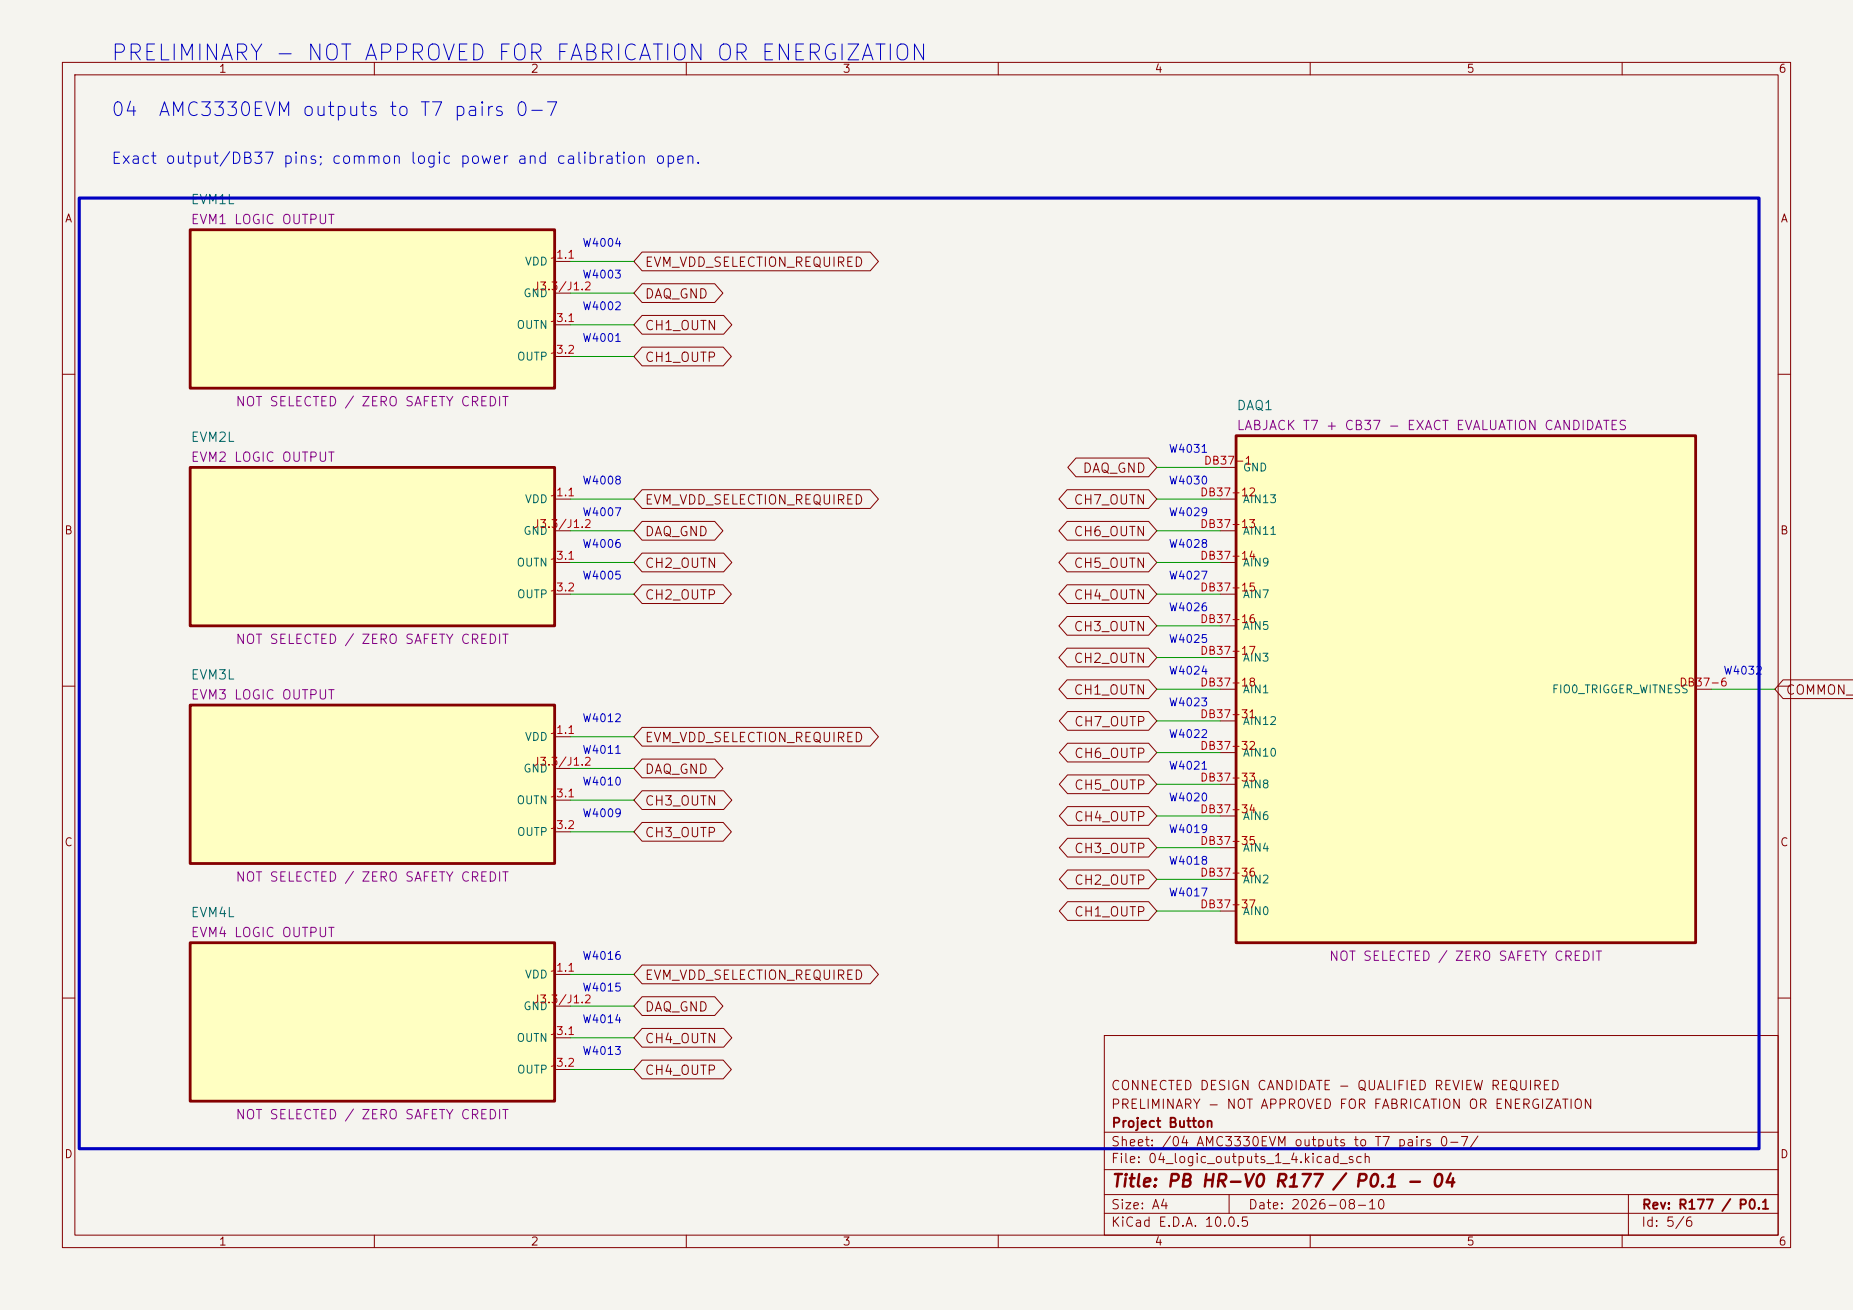
[picture p224: page 5]

W4016 PRELIMINARY - NOT APPROVED FOR FABRICATION OR ENERGIZATION

NOT SELECTED / ZERO SAFETY CREDIT

AIN0 DB37-37 DAQ1
LABJACK T7 + CB37 - EXACT EVALUATION CANDIDATES

CONNECTED DESIGN CANDIDATE - QUALIFIED REVIEW REQUIRED PRELIMINARY - NOT APPROVED FOR FABRICATION OR ENERGIZATION Project Button

Sheet: /04 AMC3330EVM outputs to T7 pairs 0-7/

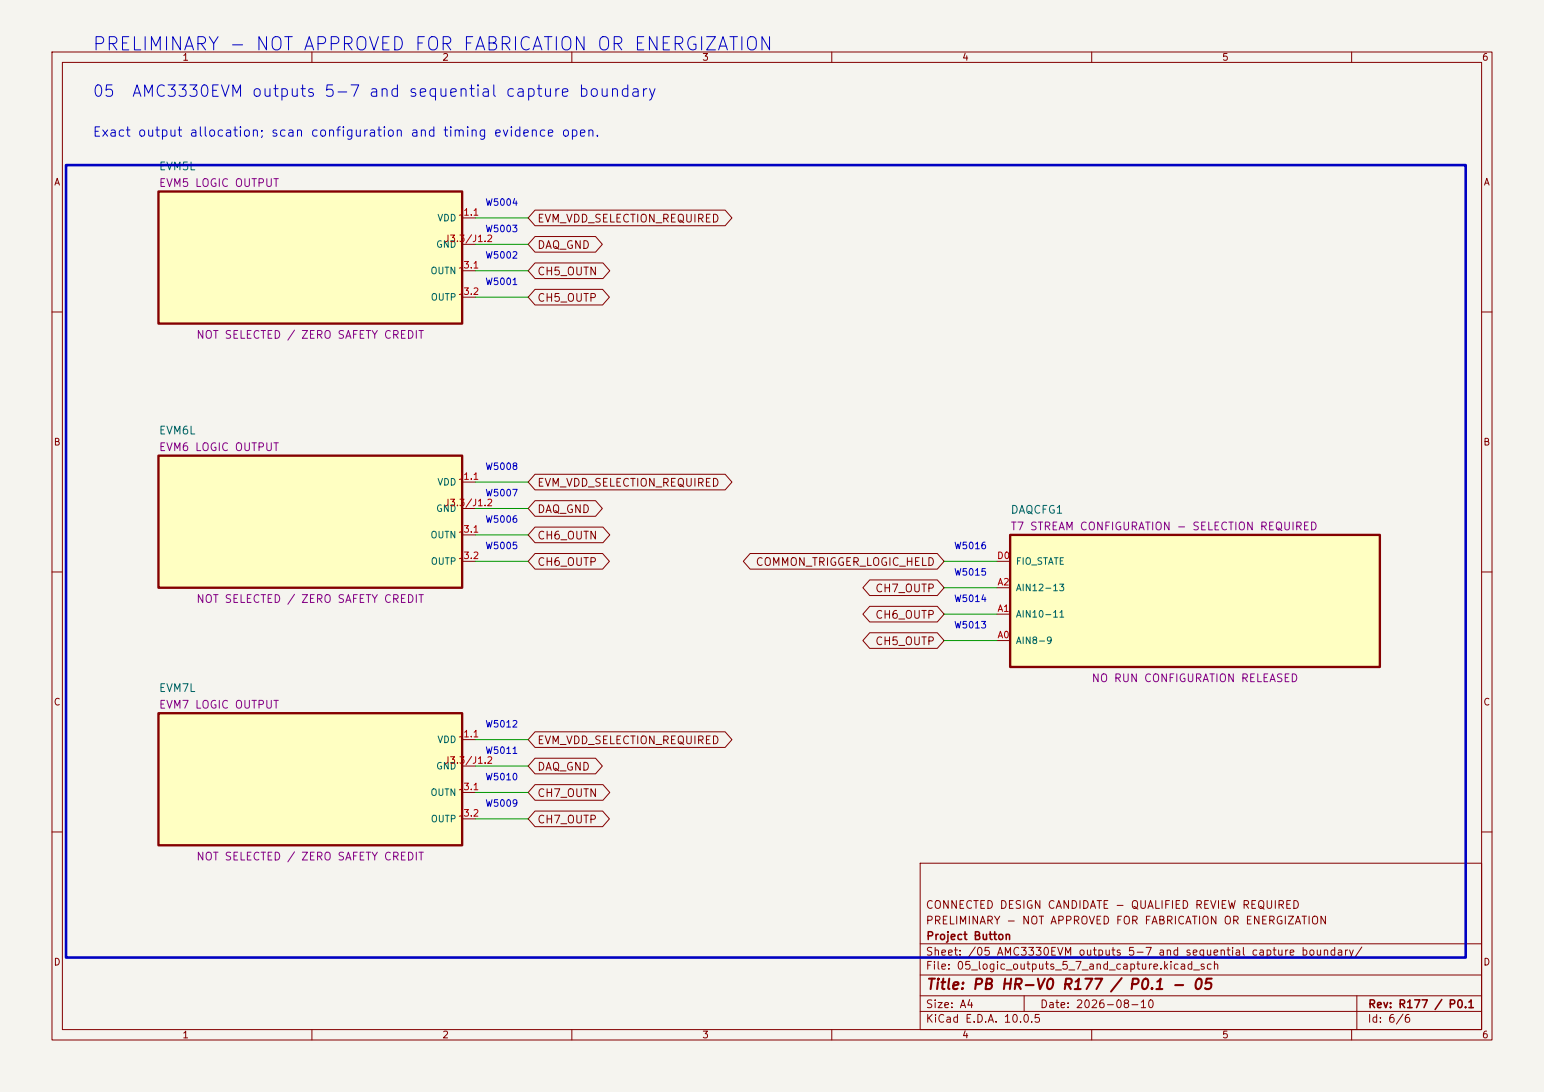
[picture p225: page 6]

PRELIMINARY - NOT APPROVED FOR FABRICATION OR ENERGIZATION

NOT SELECTED / ZERO SAFETY CREDIT

FIO_STATE D0DAQCFG1
T7 STREAM CONFIGURATION - SELECTION REQUIRED

NO RUN CONFIGURATION RELEASED

CONNECTED DESIGN CANDIDATE - QUALIFIED REVIEW REQUIRED PRELIMINARY - NOT APPROVED FOR FABRICATION OR ENERGIZATION Project Button

Sheet: /05 AMC3330EVM outputs 5-7 and sequential capture boundary/
