amyleesterling/humanoid-robot/electrical/kicad/hr-v0-dynamic-event-interface-p0.1/output/hr-v0-dynamic-event-interface-p0.1-preliminary.pdf

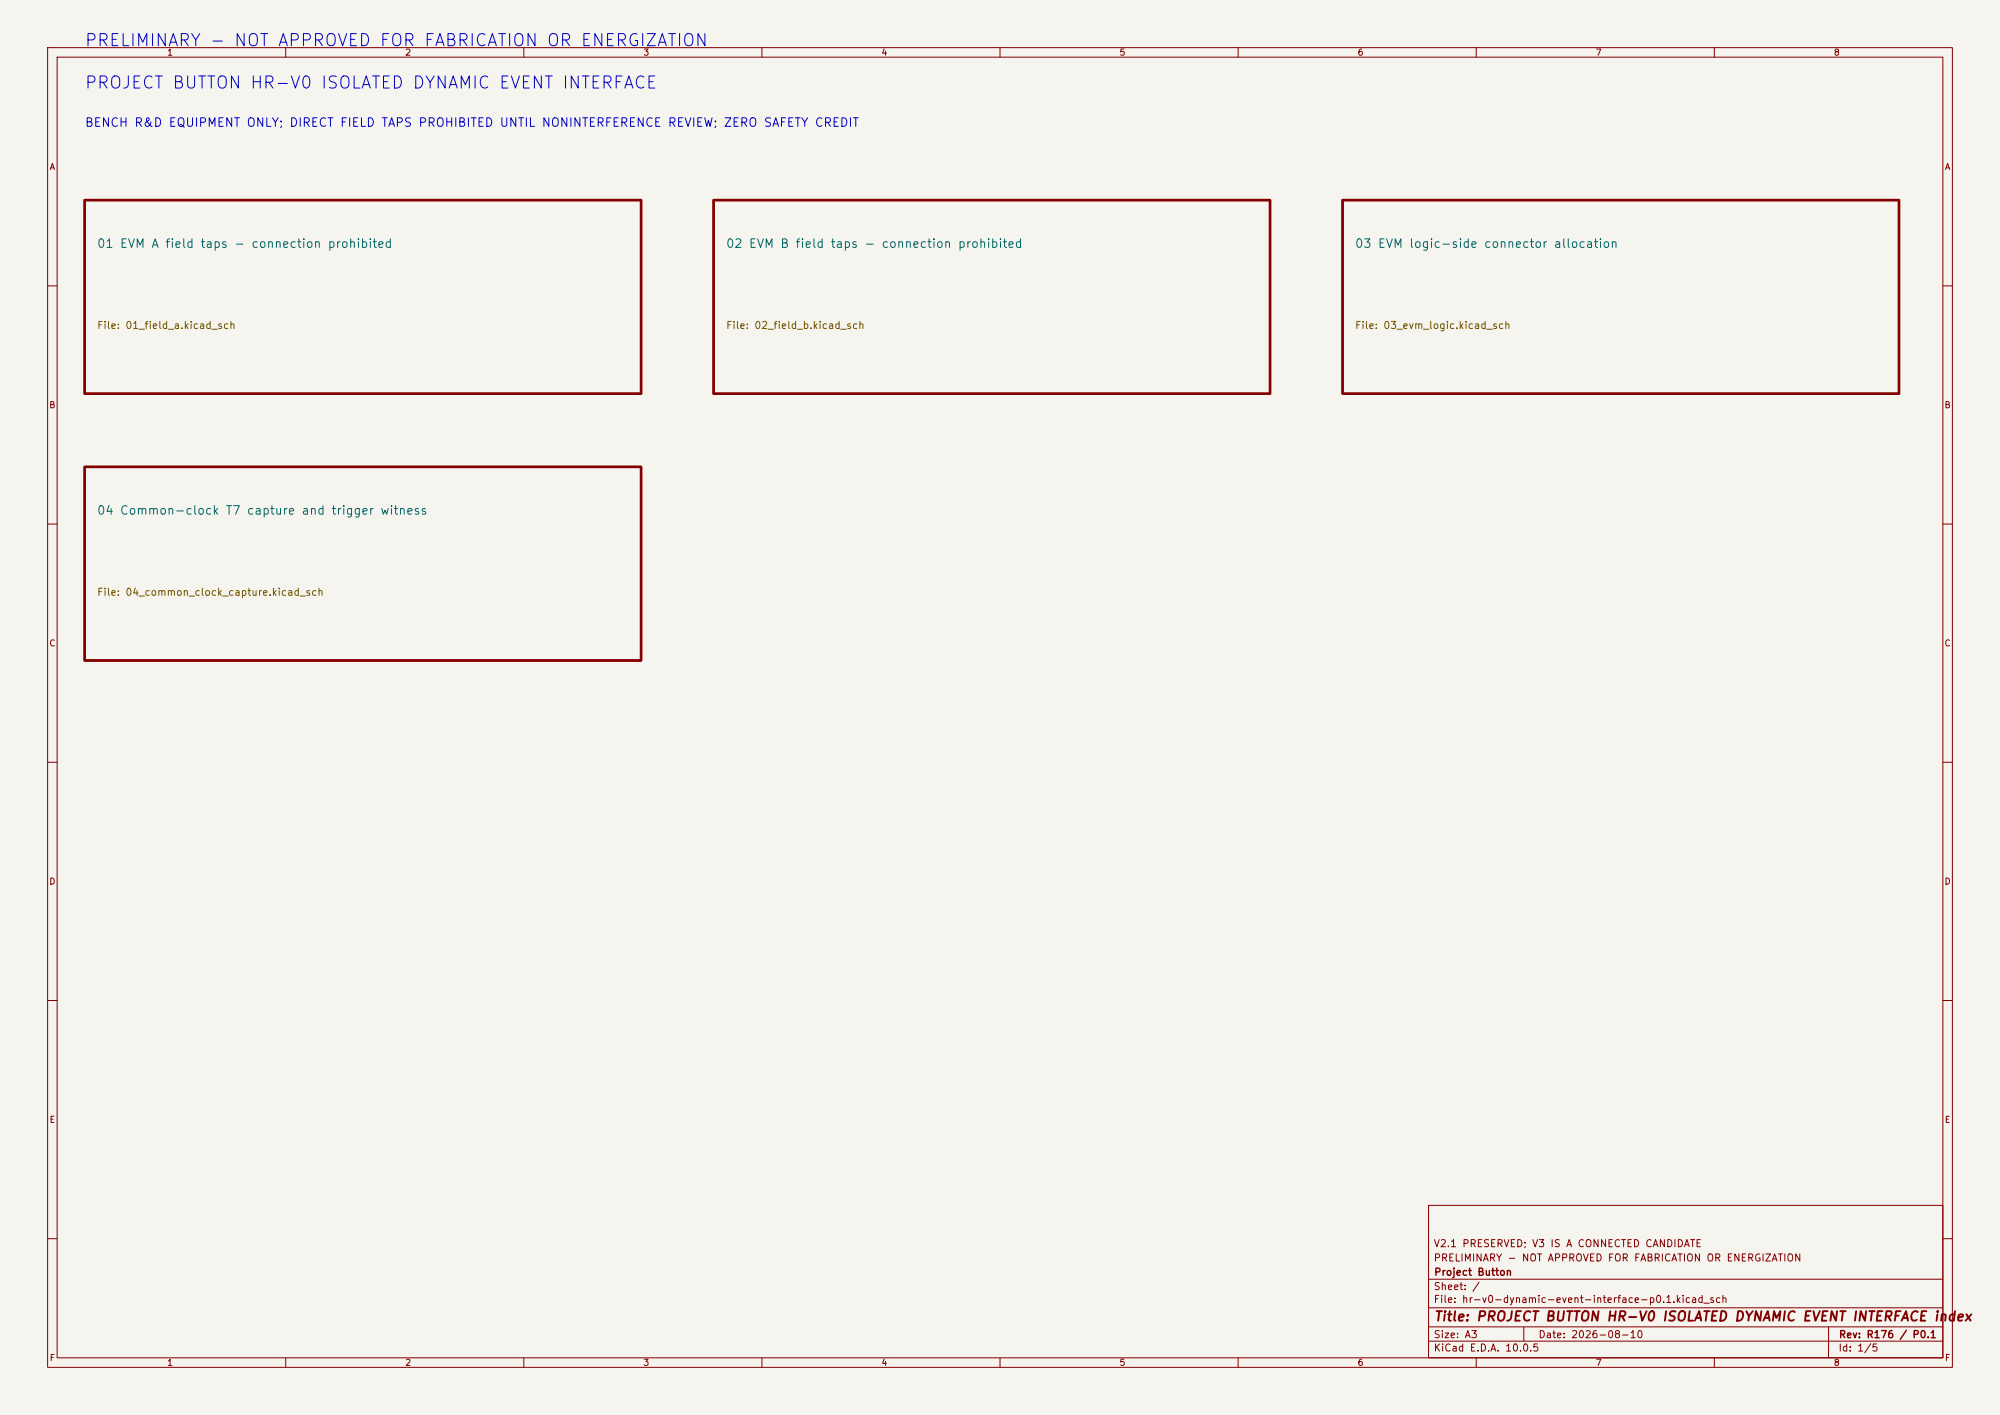
[picture p226: page 1]

PRELIMINARY - NOT APPROVED FOR FABRICATION OR ENERGIZATION

PROJECT BUTTON HR-V0 ISOLATED DYNAMIC EVENT INTERFACE

BENCH R&D EQUIPMENT ONLY; DIRECT FIELD TAPS PROHIBITED UNTIL NONINTERFERENCE REVIEW; ZERO SAFETY CREDIT

01 EVM A field taps - connection prohibited

02 EVM B field taps - connection prohibited

03 EVM logic-side connector allocation

04 Common-clock T7 capture and trigger witness

V2.1 PRESERVED; V3 IS A CONNECTED CANDIDATE
Project Button
Sheet: /
File: hr-v0-dynamic-event-interface-p0.1.kicad_sch
Title: PROJECT BUTTON HR-V0 ISOLATED DYNAMIC EVENT INTERFACE index

Size: A3 | Rev: R176 / P0.1 | F Date: 2026-08-10
KiCad E.D.A. 10.0.5 | Id: 1/5

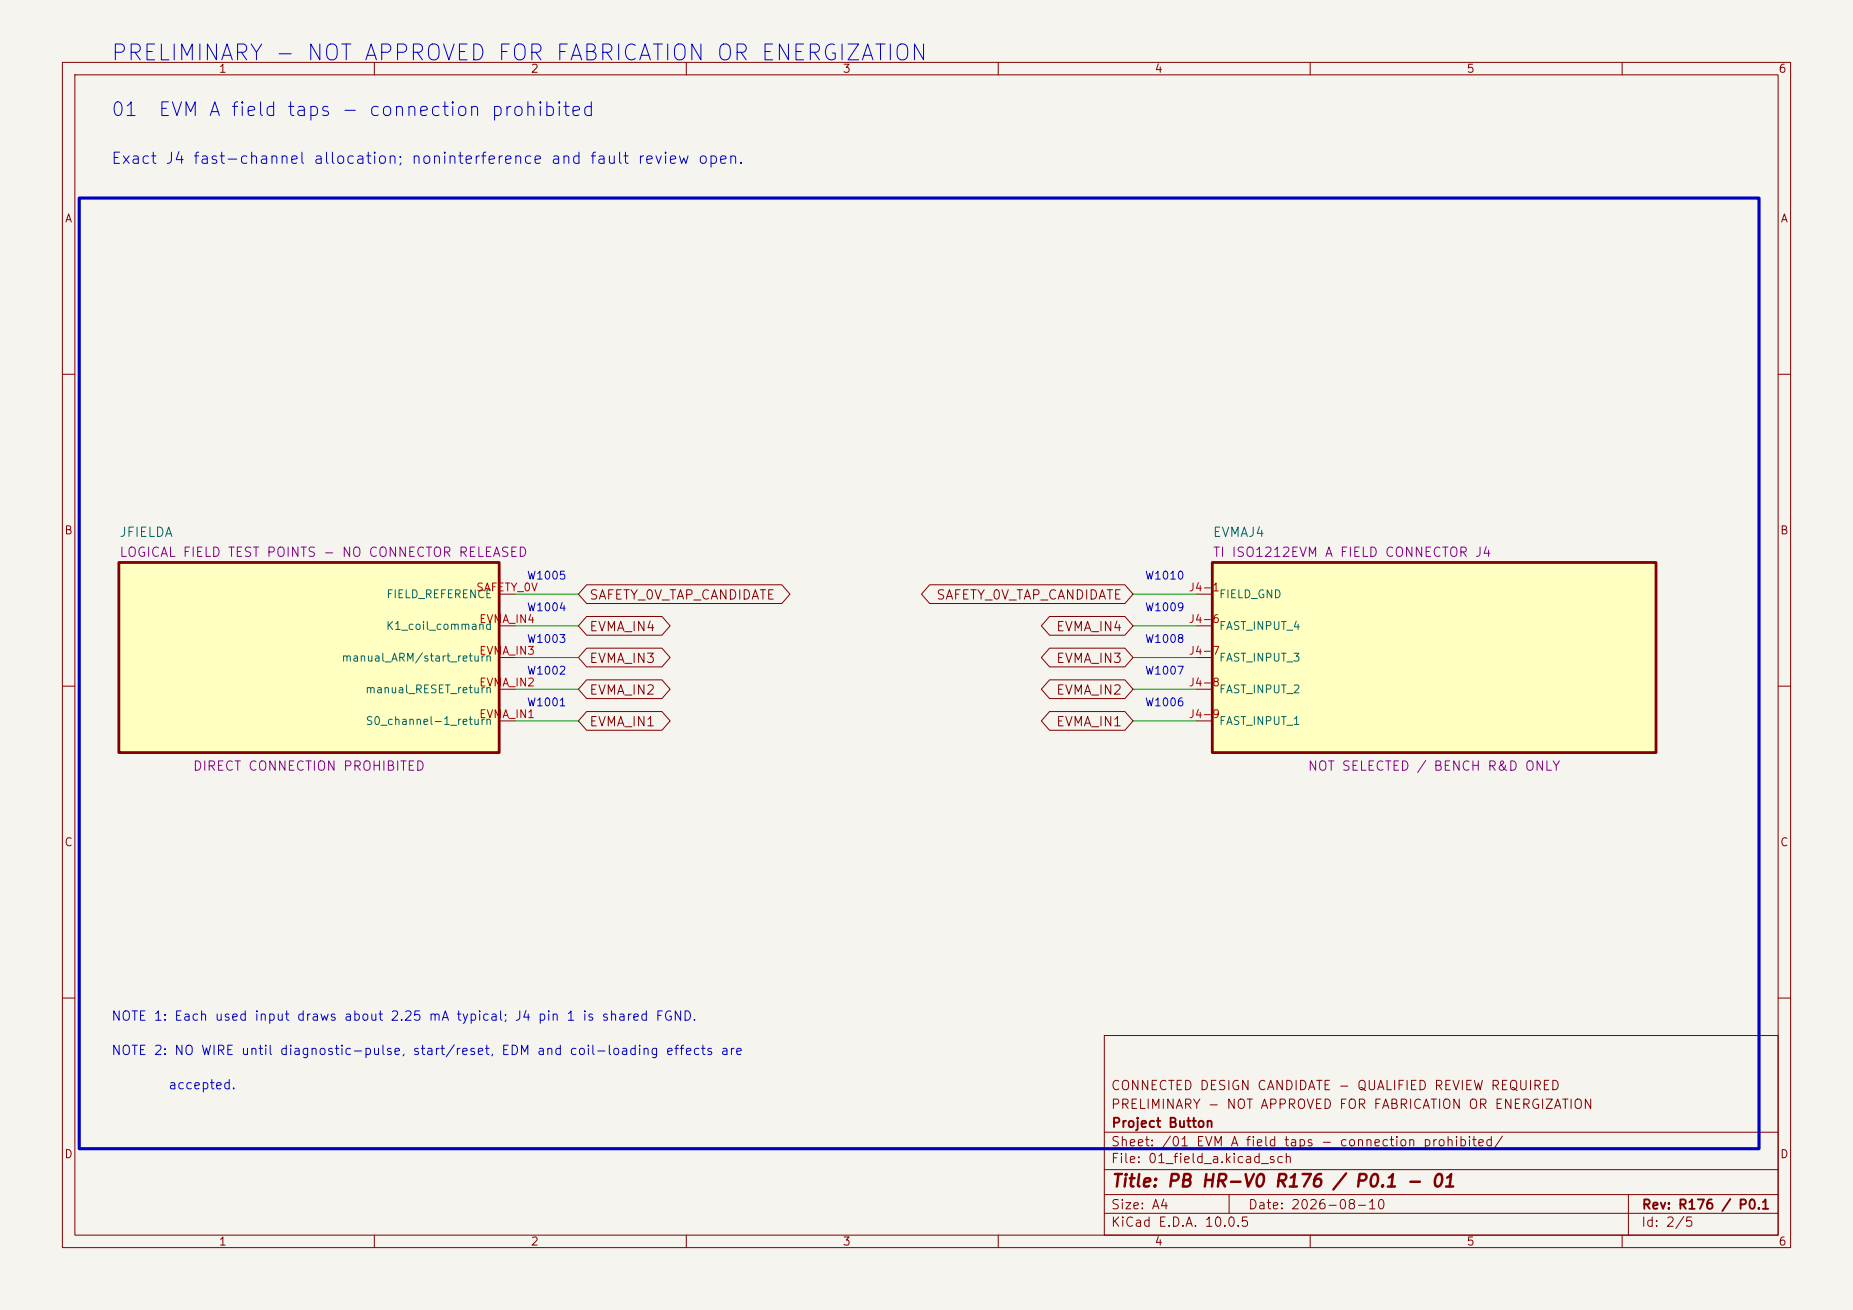
[picture p227: page 2]

01 EVM A field taps - connection prohibited

FIELD_REFERENCE SAFETY_0V JFIELDA
LOGICAL FIELD TEST POINTS - NO CONNECTOR RELEASED

W1002 W1001 W1003 NOTE 1: Each used input draws about 2.25 mA typical; J4 pin 1 is shared FGND.

NOT SELECTED / BENCH R&D ONLY

CONNECTED DESIGN CANDIDATE - QUALIFIED REVIEW REQUIRED PRELIMINARY - NOT APPROVED FOR FABRICATION OR ENERGIZATION Project Button

Sheet: /01 EVM A field taps - connection prohibited/

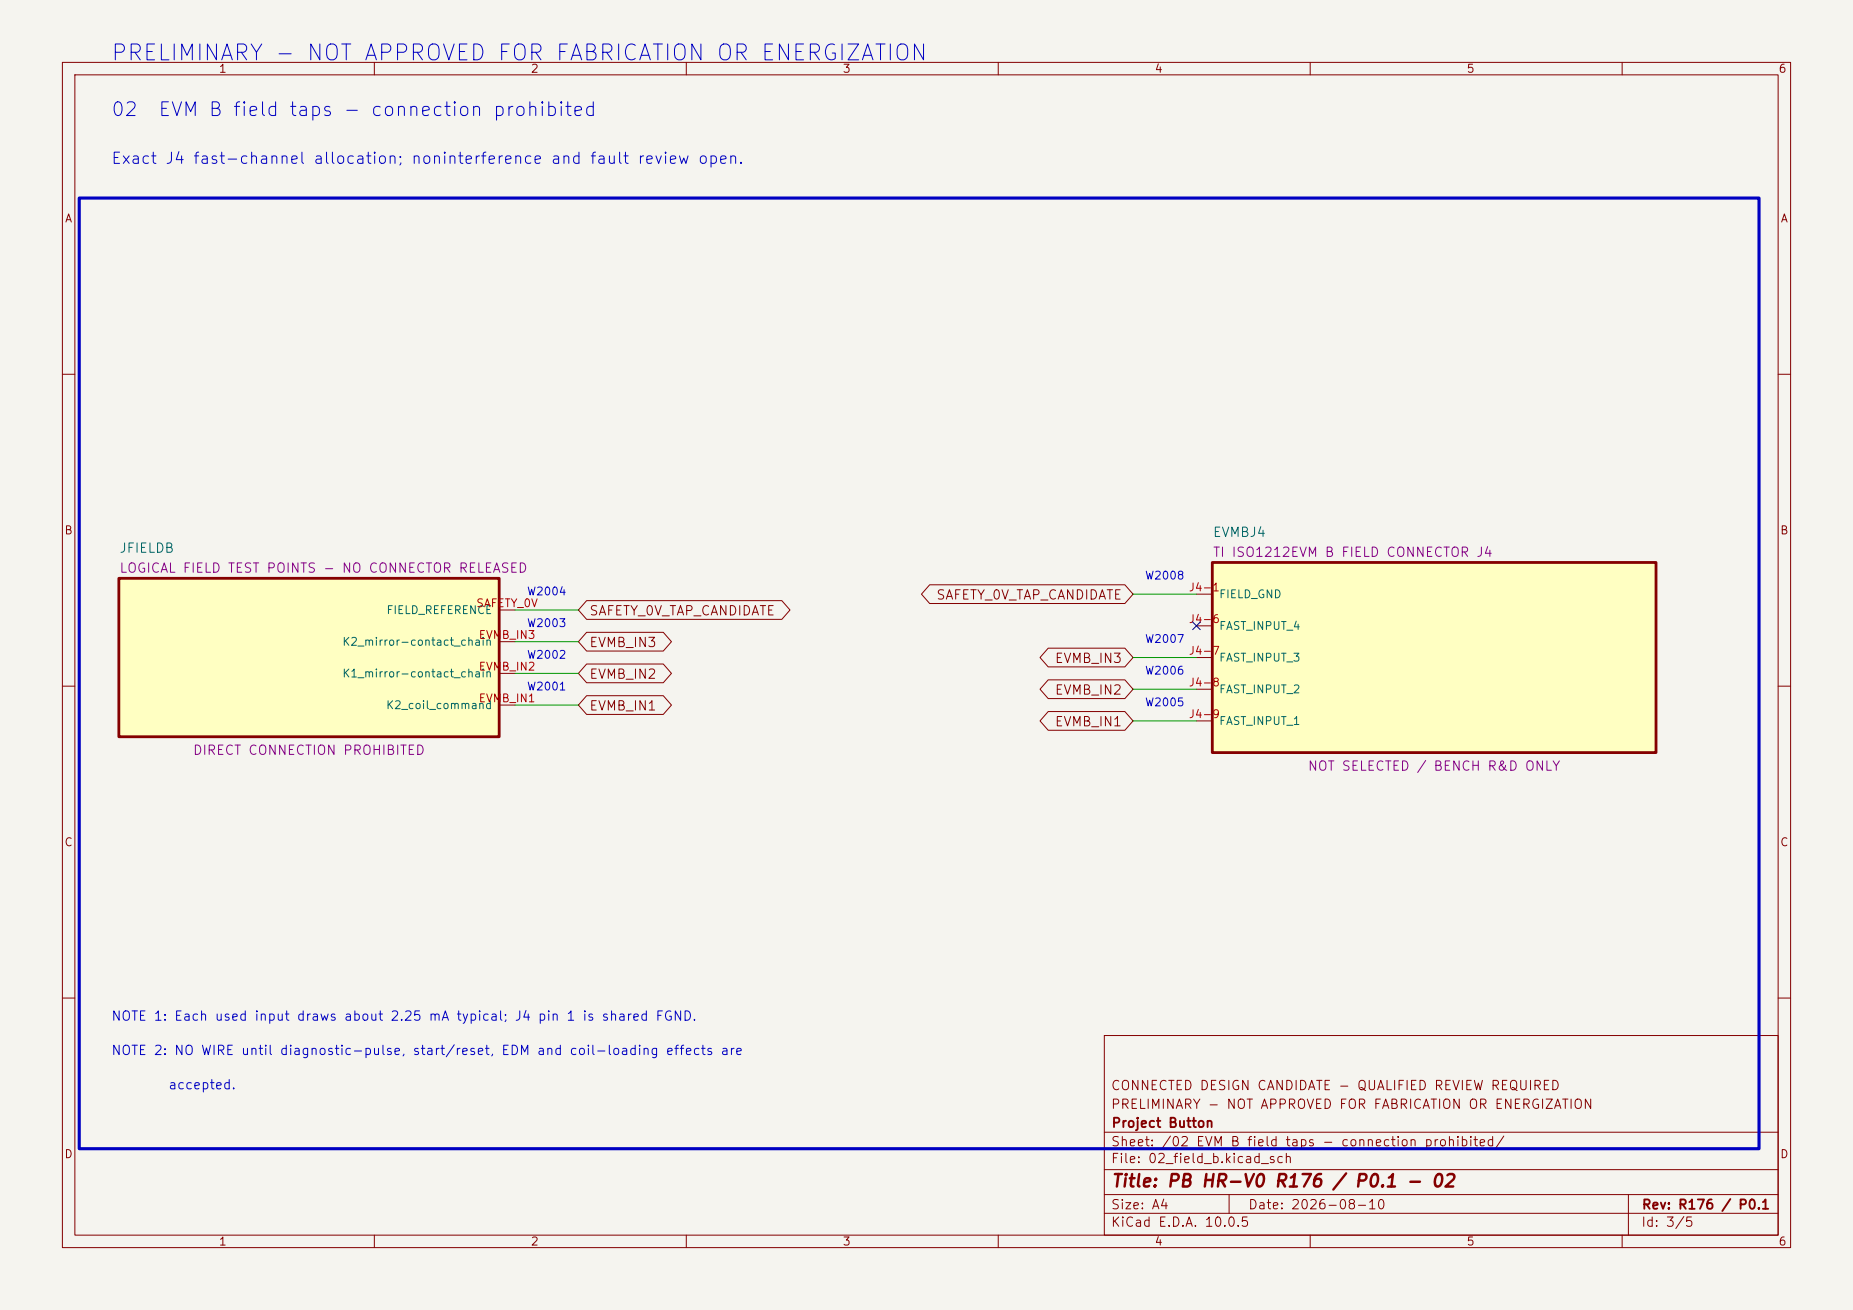
[picture p228: page 3]

02 EVM B field taps - connection prohibited

FIELD_REFERENCE SAFETY_0V JFIELDB
LOGICAL FIELD TEST POINTS - NO CONNECTOR RELEASED

NOT SELECTED / BENCH R&D ONLY

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

CONNECTED DESIGN CANDIDATE - QUALIFIED REVIEW REQUIRED PRELIMINARY - NOT APPROVED FOR FABRICATION OR ENERGIZATION Project Button

Sheet: /02 EVM B field taps - connection prohibited/

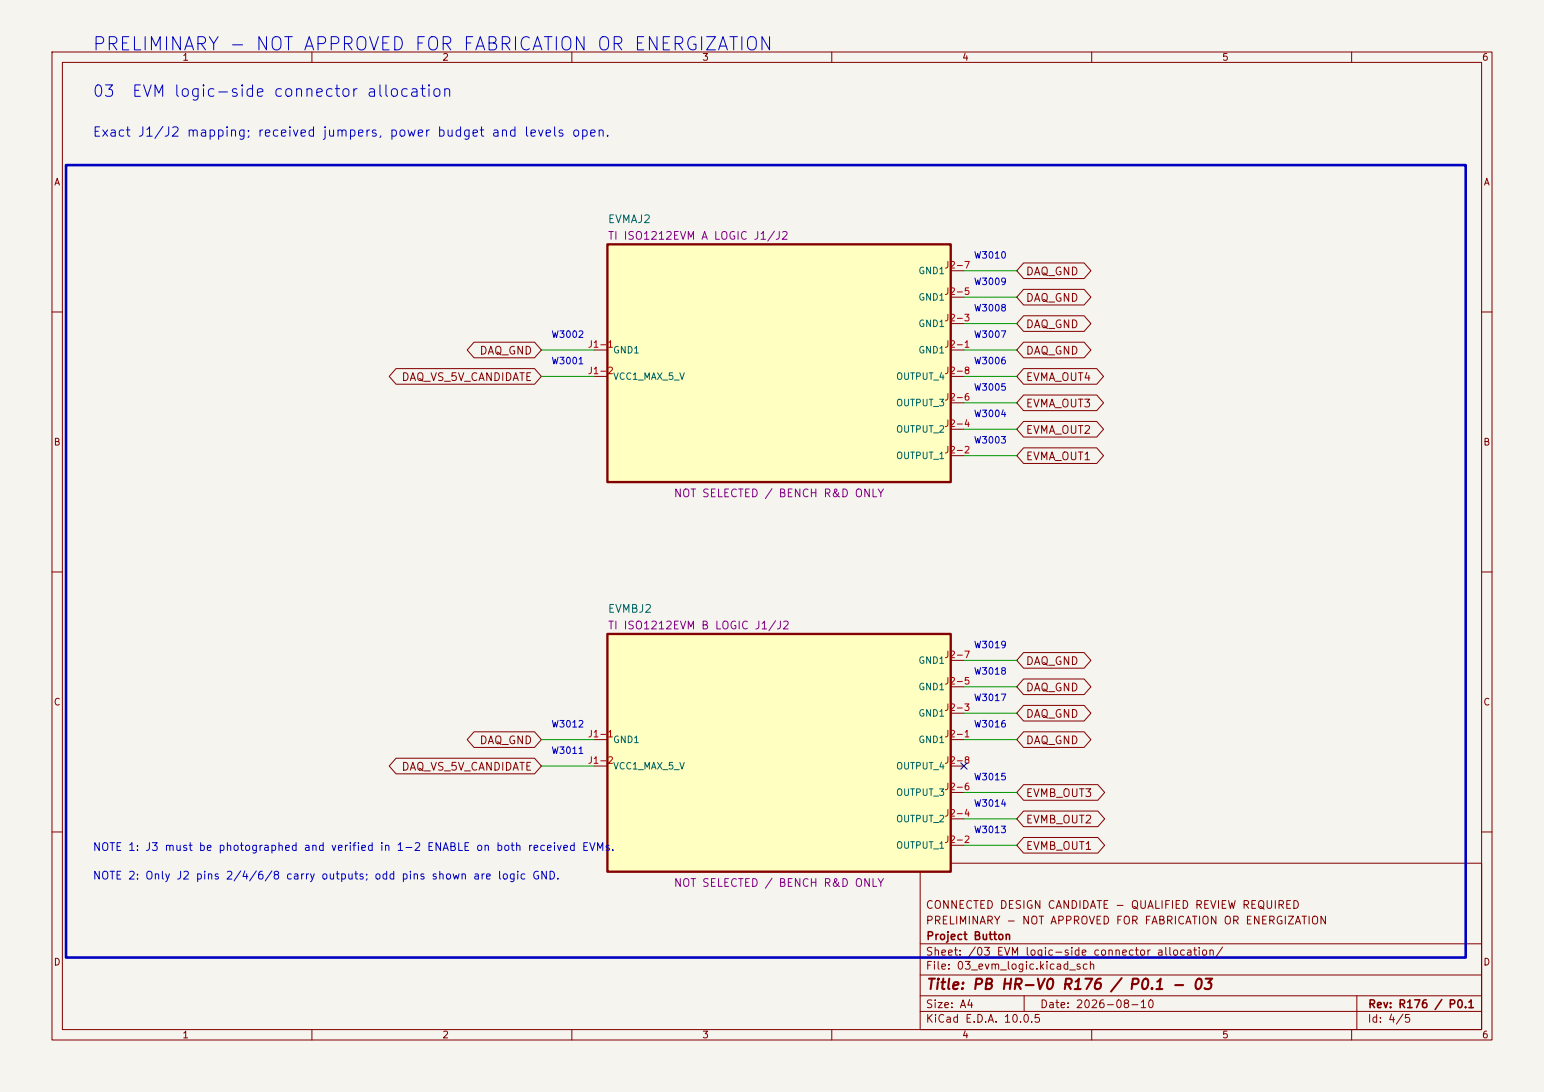
[picture p229: page 4]

03 EVM logic-side connector allocation

NOT SELECTED / BENCH R&D ONLY

CONNECTED DESIGN CANDIDATE - QUALIFIED REVIEW REQUIRED PRELIMINARY - NOT APPROVED FOR FABRICATION OR ENERGIZATION Project Button

Sheet: /03 EVM logic-side connector allocation/

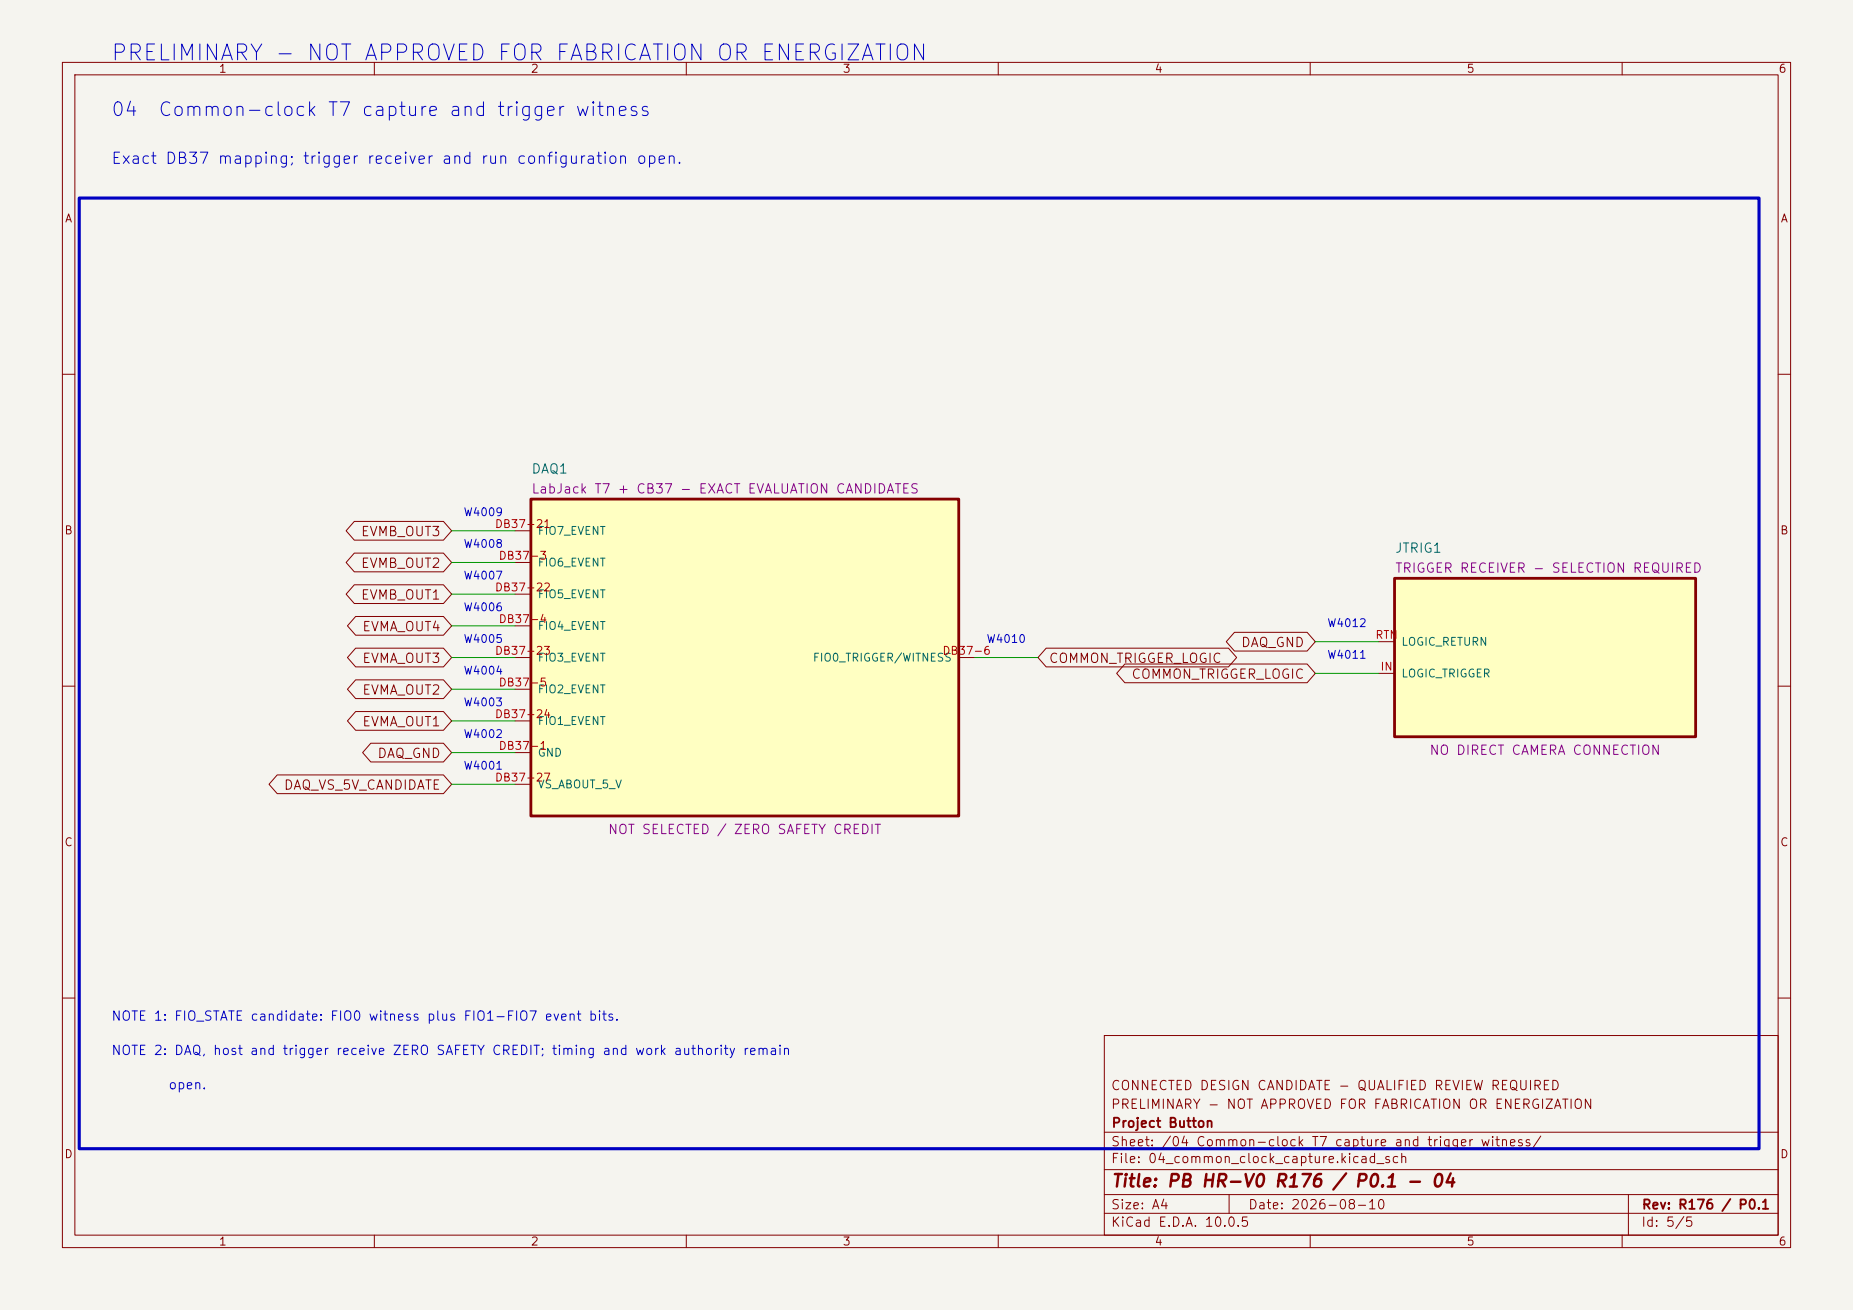
[picture p230: page 5]

PRELIMINARY - NOT APPROVED FOR FABRICATION OR ENERGIZATION

VS_ABOUT_5_V DB37-27 DAQ1
LabJack T7 + CB37 - EXACT EVALUATION CANDIDATES

JTRIG1
TRIGGER RECEIVER - SELECTION REQUIRED

NO DIRECT CAMERA CONNECTION

NOT SELECTED / ZERO SAFETY CREDIT

NOTE 1: FIO_STATE candidate: FIO0 witness plus FIO1-FIO7 event bits.

CONNECTED DESIGN CANDIDATE - QUALIFIED REVIEW REQUIRED PRELIMINARY - NOT APPROVED FOR FABRICATION OR ENERGIZATION Project Button

Sheet: /04 Common-clock T7 capture and trigger witness/
