amyleesterling/humanoid-robot/electrical/kicad/hr-v0-event-tap-disposition-p0.1/output/hr-v0-event-tap-disposition-p0.1-preliminary.pdf

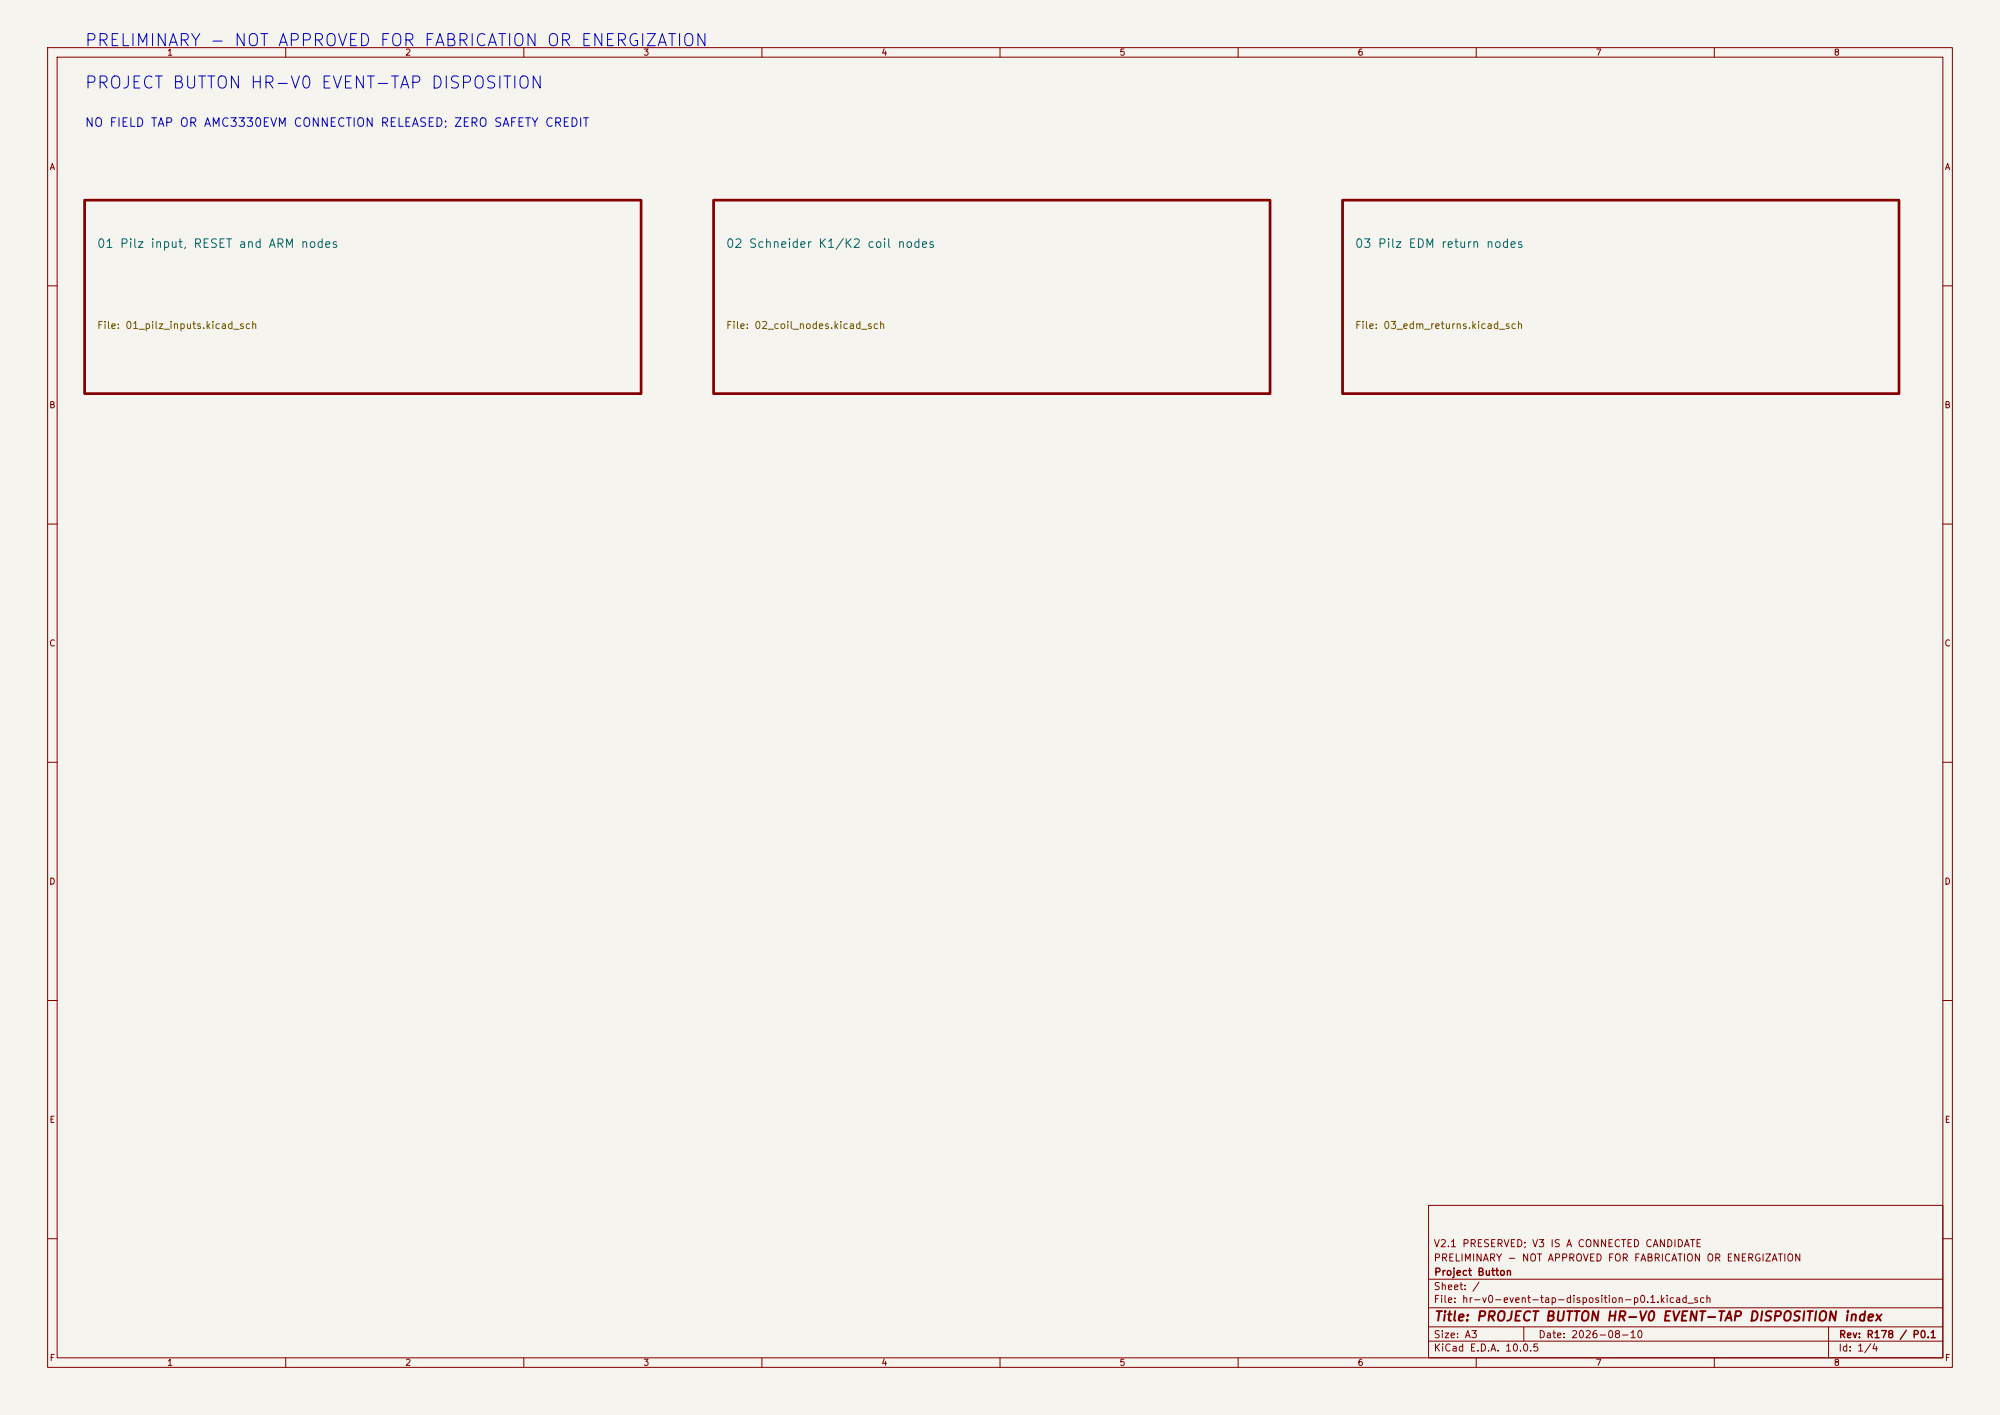
[picture p231: page 1]

PRELIMINARY - NOT APPROVED FOR FABRICATION OR ENERGIZATION

PROJECT BUTTON HR-V0 EVENT-TAP DISPOSITION

NO FIELD TAP OR AMC3330EVM CONNECTION RELEASED; ZERO SAFETY CREDIT

01 Pilz input, RESET and ARM nodes

03 Pilz EDM return nodes

V2.1 PRESERVED; V3 IS A CONNECTED CANDIDATE
Project Button
Sheet: /
File: hr-v0-event-tap-disposition-p0.1.kicad_sch
Title: PROJECT BUTTON HR-V0 EVENT-TAP DISPOSITION index

Size: A3 | Rev: R178 / P0.1 | F Date: 2026-08-10
KiCad E.D.A. 10.0.5 | Id: 1/4

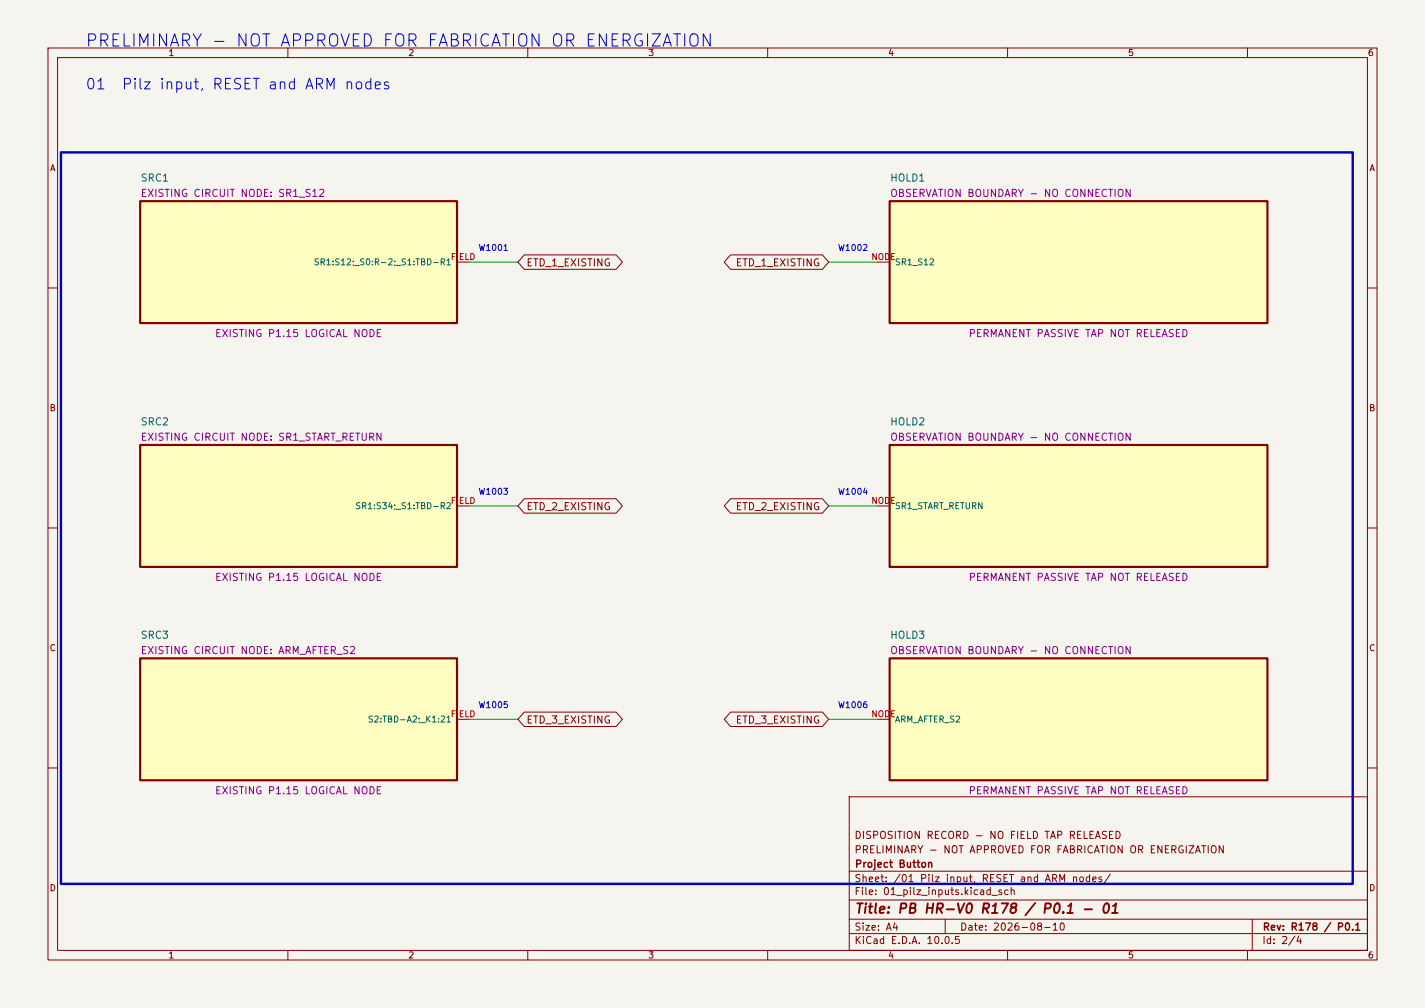
[picture p232: page 2]

01 Pilz input, RESET and ARM nodes

SR1_S12 NODEHOLD1
OBSERVATION BOUNDARY - NO CONNECTION

PERMANENT PASSIVE TAP NOT RELEASED

SR1_START_RETURN NODEHOLD2

ARM_AFTER_S2 NODEHOLD3

DISPOSITION RECORD - NO FIELD TAP RELEASED PRELIMINARY - NOT APPROVED FOR FABRICATION OR ENERGIZATION Project Button

Sheet: /01 Pilz input, RESET and ARM nodes/

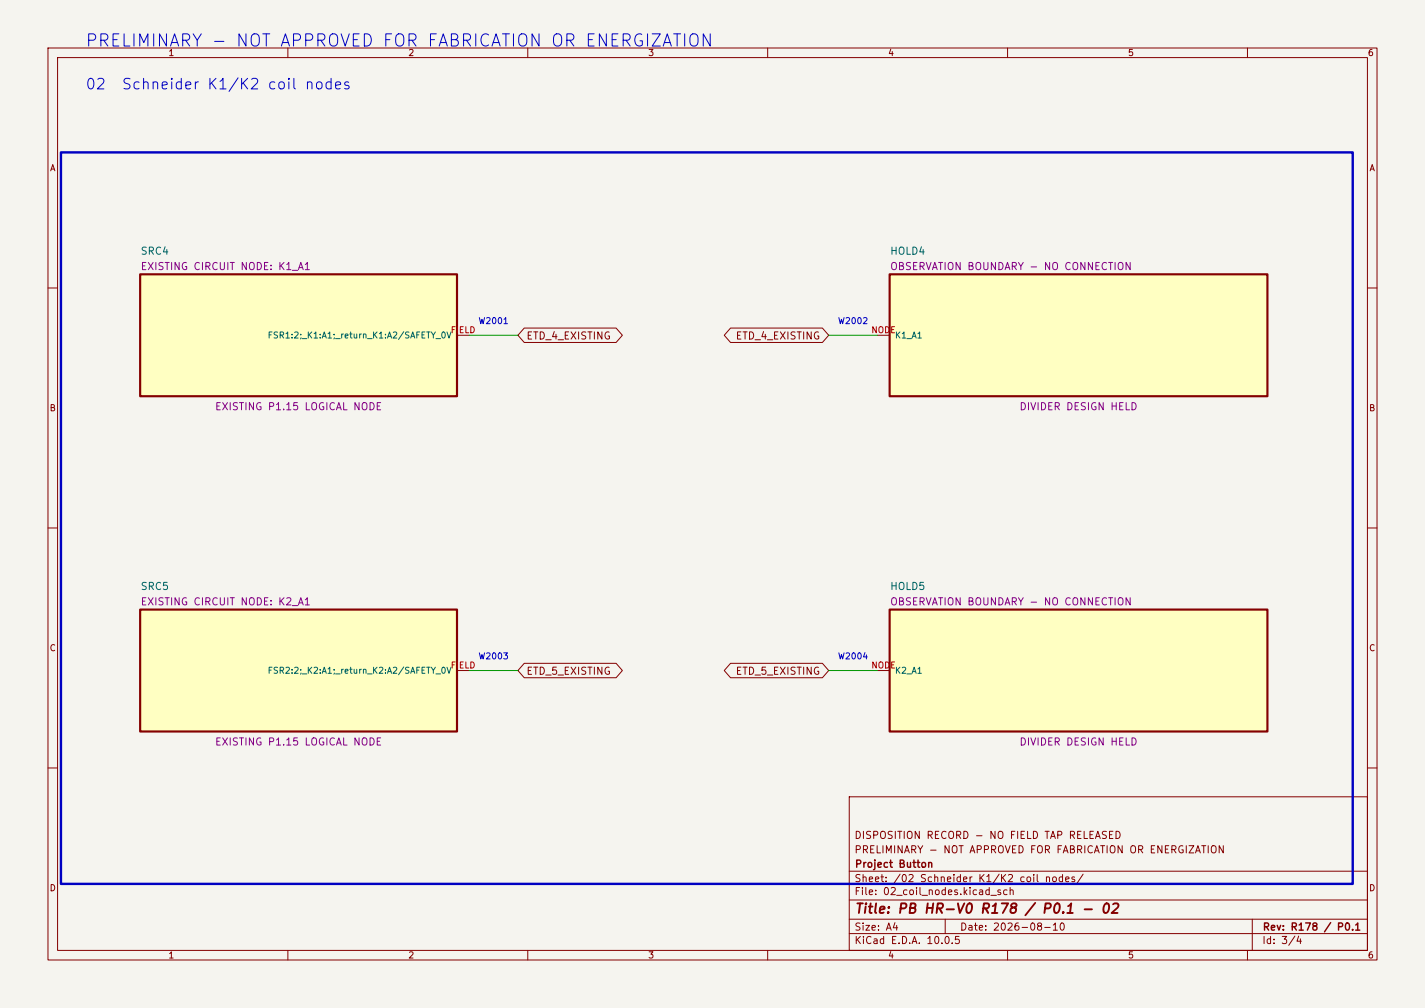
[picture p233: page 3]

K1_A1 NODEHOLD4
OBSERVATION BOUNDARY - NO CONNECTION

K2_A1 NODEHOLD5

DISPOSITION RECORD - NO FIELD TAP RELEASED PRELIMINARY - NOT APPROVED FOR FABRICATION OR ENERGIZATION Project Button

Sheet: /02 Schneider K1/K2 coil nodes/

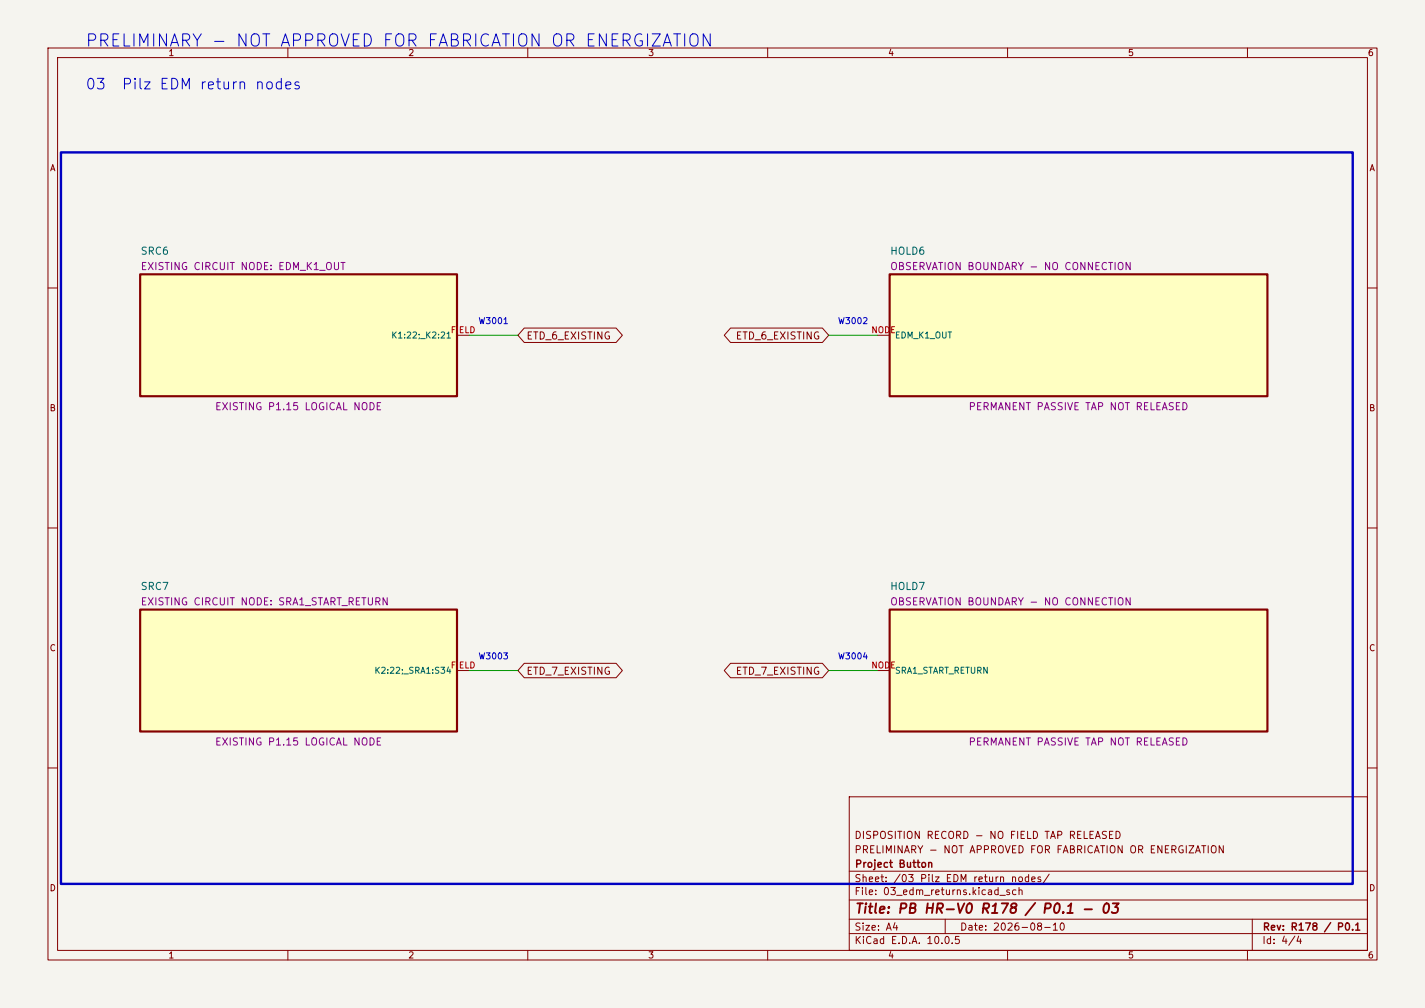
[picture p234: page 4]

03 Pilz EDM return nodes

OBSERVATION BOUNDARY - NO CONNECTION

PERMANENT PASSIVE TAP NOT RELEASED

SRA1_START_RETURN NODEHOLD7

DISPOSITION RECORD - NO FIELD TAP RELEASED PRELIMINARY - NOT APPROVED FOR FABRICATION OR ENERGIZATION Project Button

Sheet: /03 Pilz EDM return nodes/
