amyleesterling/humanoid-robot/electrical/kicad/hr-v0-gripper-interface/output/hr-v0-gripper-interface-preliminary.pdf

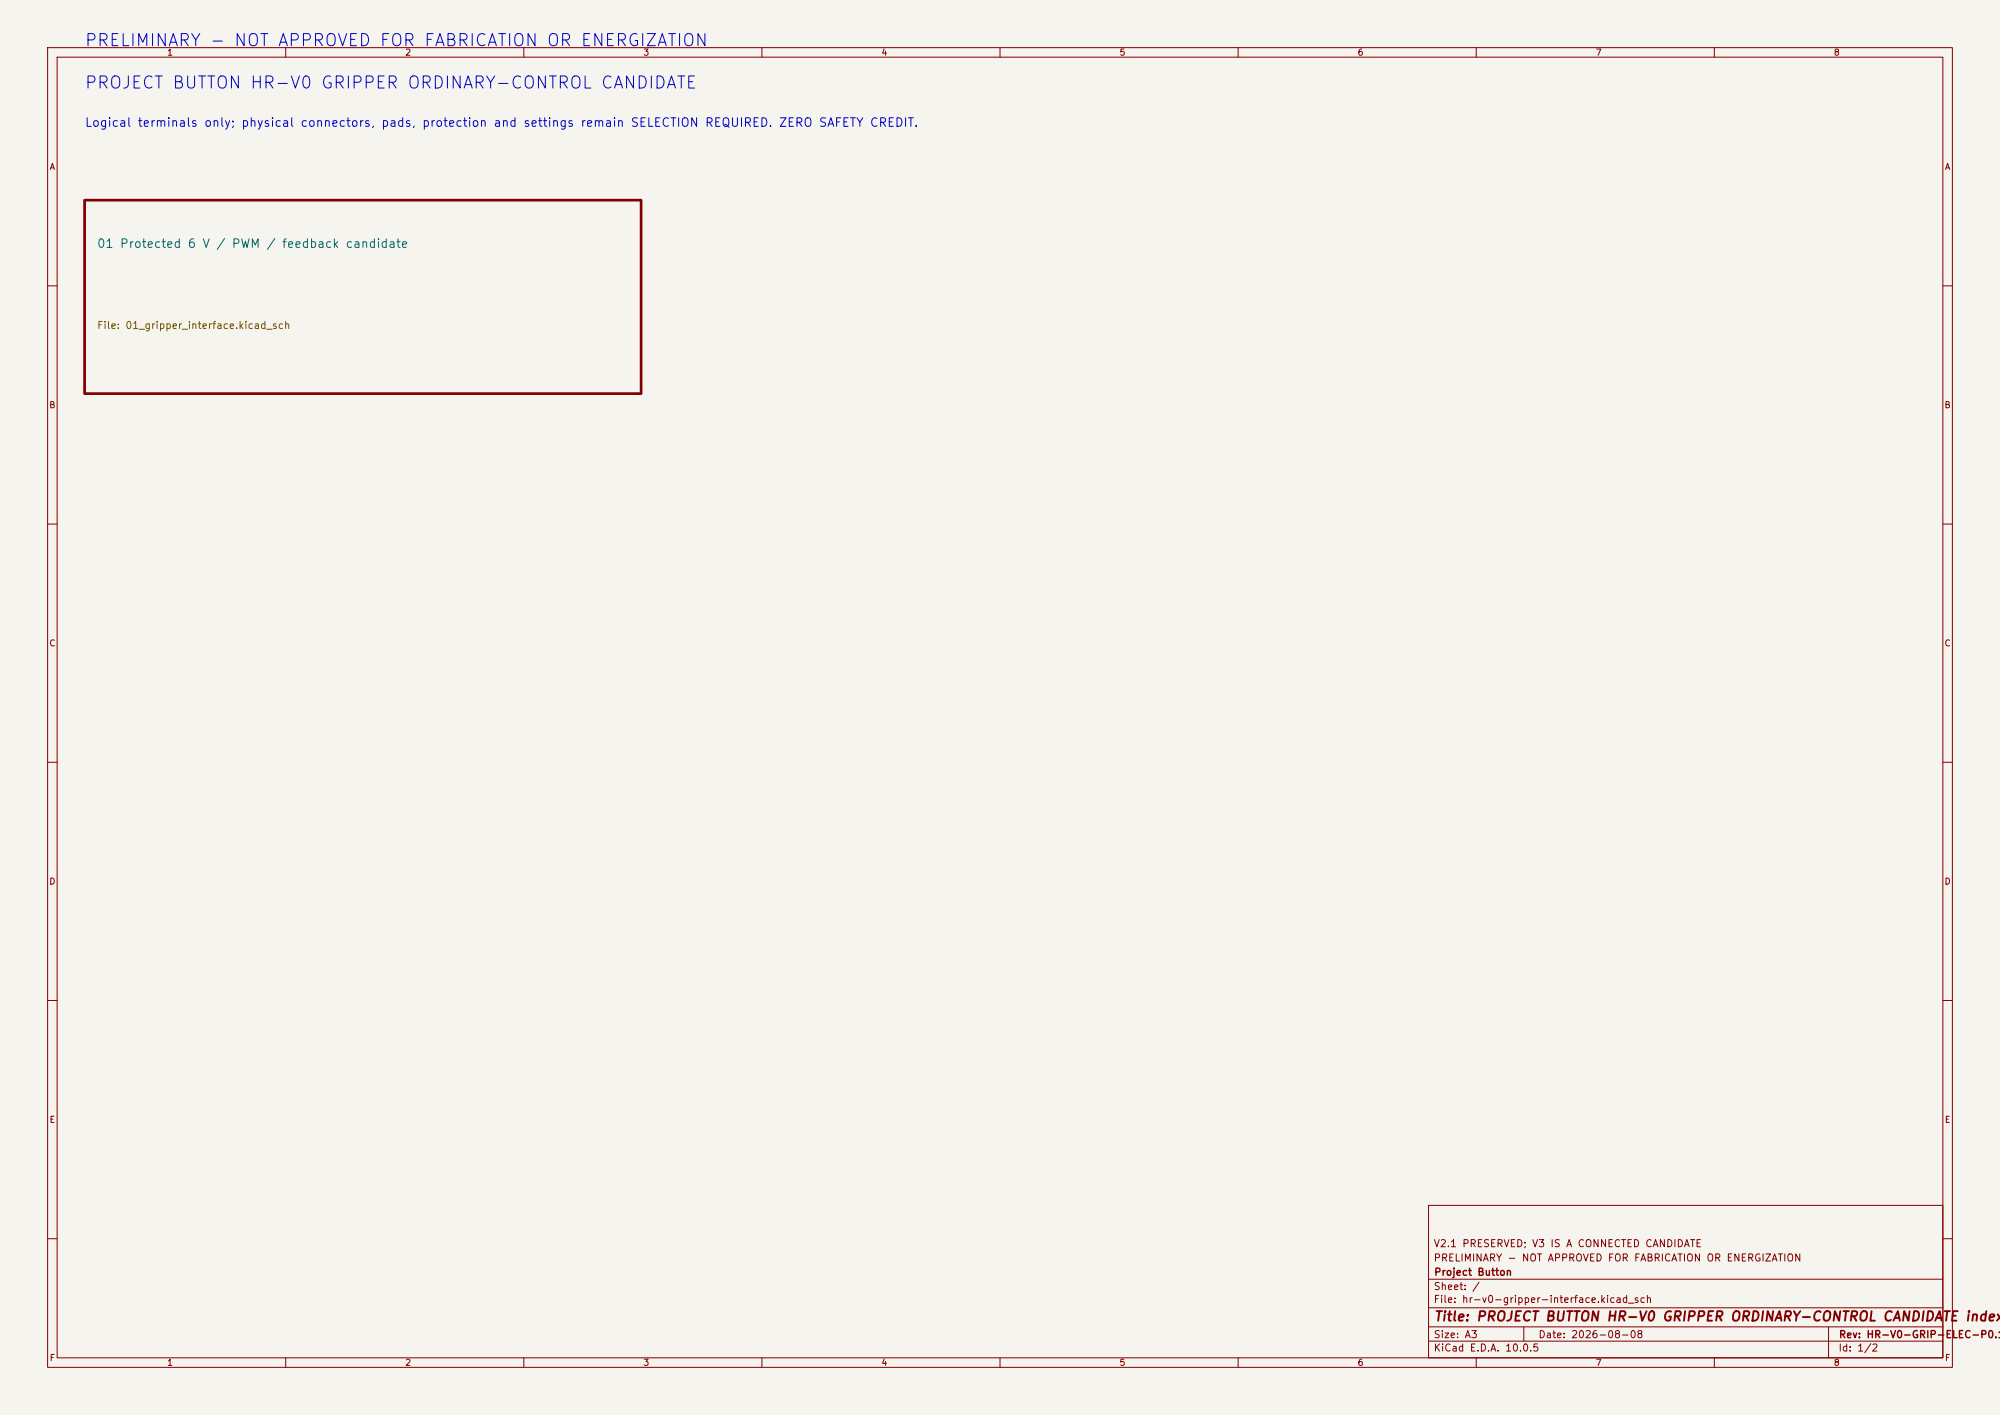
[picture p235: page 1]

PRELIMINARY - NOT APPROVED FOR FABRICATION OR ENERGIZATION

PROJECT BUTTON HR-V0 GRIPPER ORDINARY-CONTROL CANDIDATE

Logical terminals only; physical connectors, pads, protection and settings remain SELECTION REQUIRED. ZERO SAFETY CREDIT.

01 Protected 6 V / PWM / feedback candidate

V2.1 PRESERVED; V3 IS A CONNECTED CANDIDATE
Project Button
Sheet: /
File: hr-v0-gripper-interface.kicad_sch
Title: PROJECT BUTTON HR-V0 GRIPPER ORDINARY-CONTROL CANDIDATE index

F Date: 2026-08-08

KiCad E.D.A. 10.0.5 | Id: 1/2

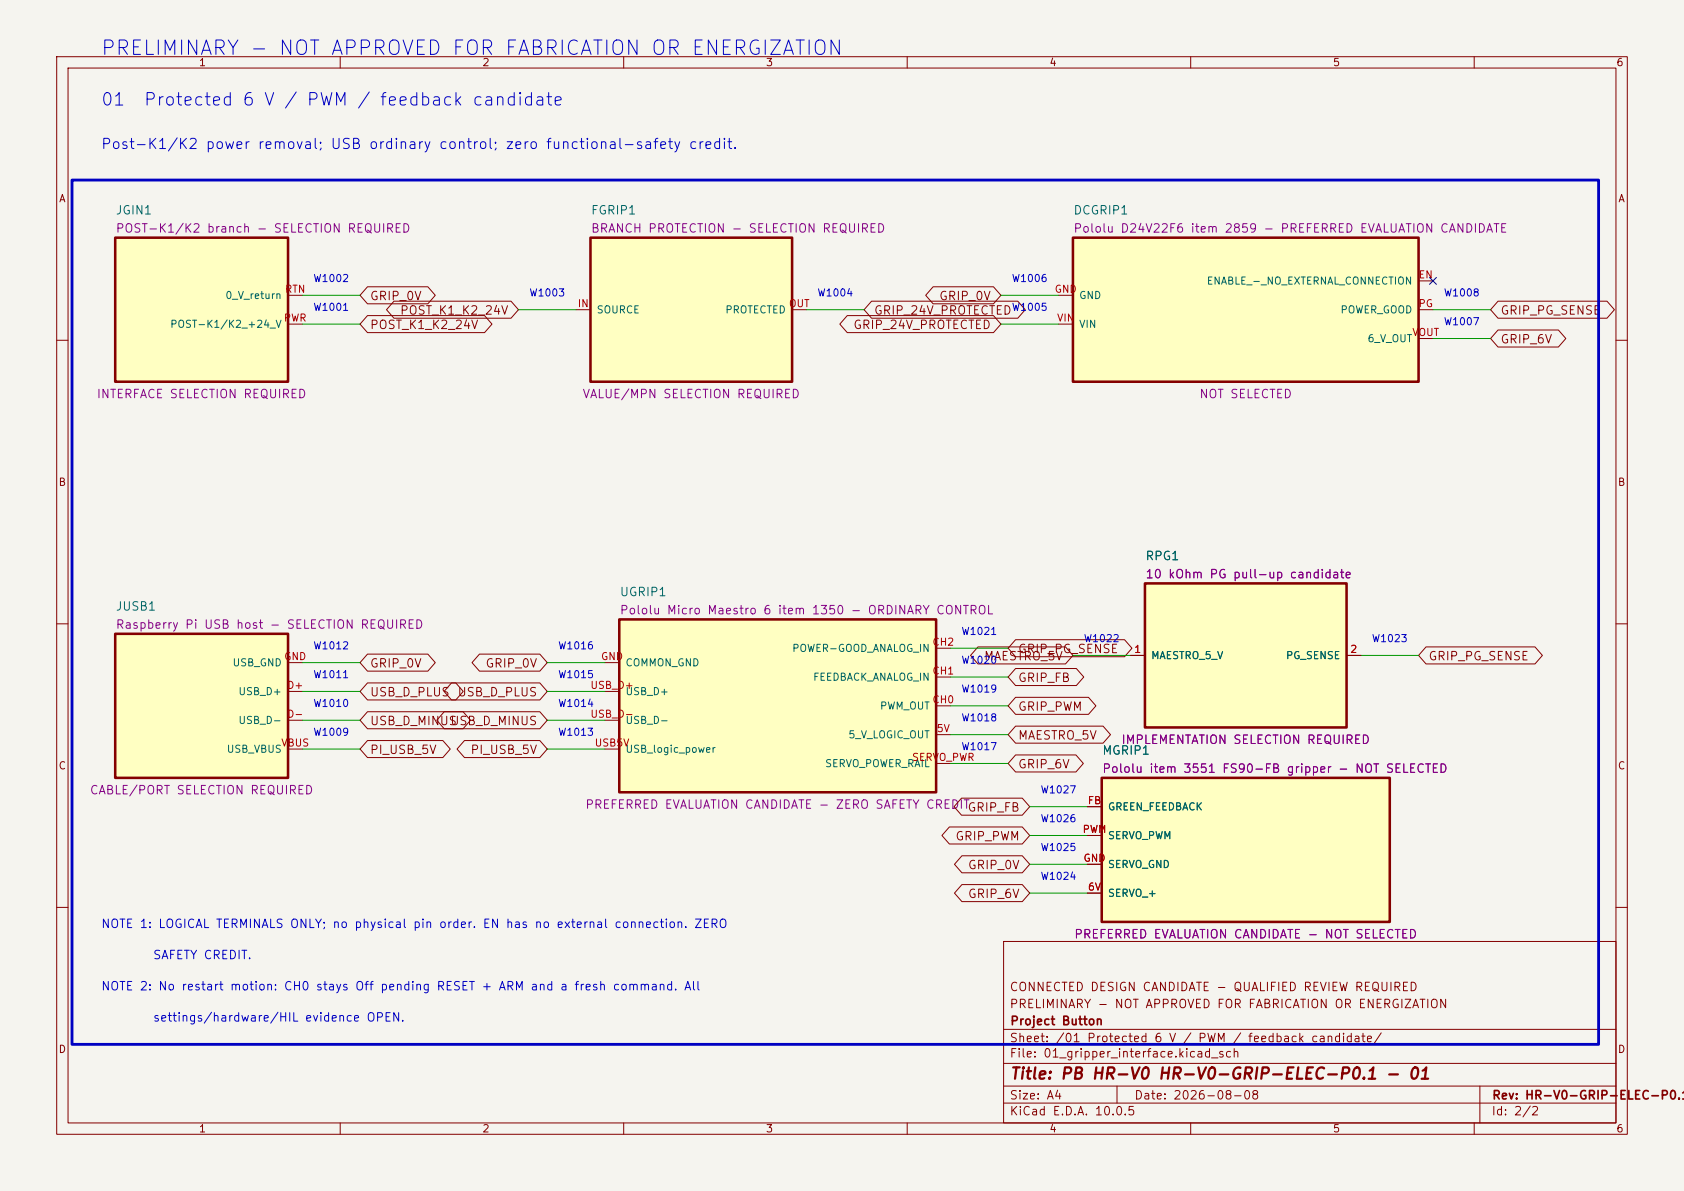
[picture p236: page 2]

JGIN1
POST-K1/K2 branch - SELECTION REQUIRED

BRANCH PROTECTION - SELECTION REQUIRED

6_V_OUTVOUT DCGRIP1
Pololu D24V22F6 item 2859 - PREFERRED EVALUATION CANDIDATE

VALUE/MPN SELECTION REQUIRED

10 kOhm PG pull-up candidate

UGRIP1
Pololu Micro Maestro 6 item 1350 - ORDINARY CONTROL

JUSB1
Raspberry Pi USB host - SELECTION REQUIRED

SERVO_PWM PWMMGRIP1
Pololu item 3551 FS90-FB gripper - NOT SELECTED

CABLE/PORT SELECTION REQUIRED

PREFERRED EVALUATION CANDIDATE - ZERO SAFETY CREDIT

PREFERRED EVALUATION CANDIDATE - NOT SELECTED

NOTE 2: No restart motion: CH0 stays Off pending RESET + ARM and a fresh command. All

CONNECTED DESIGN CANDIDATE - QUALIFIED REVIEW REQUIRED PRELIMINARY - NOT APPROVED FOR FABRICATION OR ENERGIZATION Project Button

Sheet: /01 Protected 6 V / PWM / feedback candidate/

File: 01_gripper_interface.kicad_sch
Title: PB HR-V0 HR-V0-GRIP-ELEC-P0.1 - 01
KiCad E.D.A. 10.0.5
