amyleesterling/humanoid-robot/electrical/kicad/project-button-v3-p1.15-carrier-candidate/output/project-button-v3-p1.15-carrier-candidate-preliminary.pdf

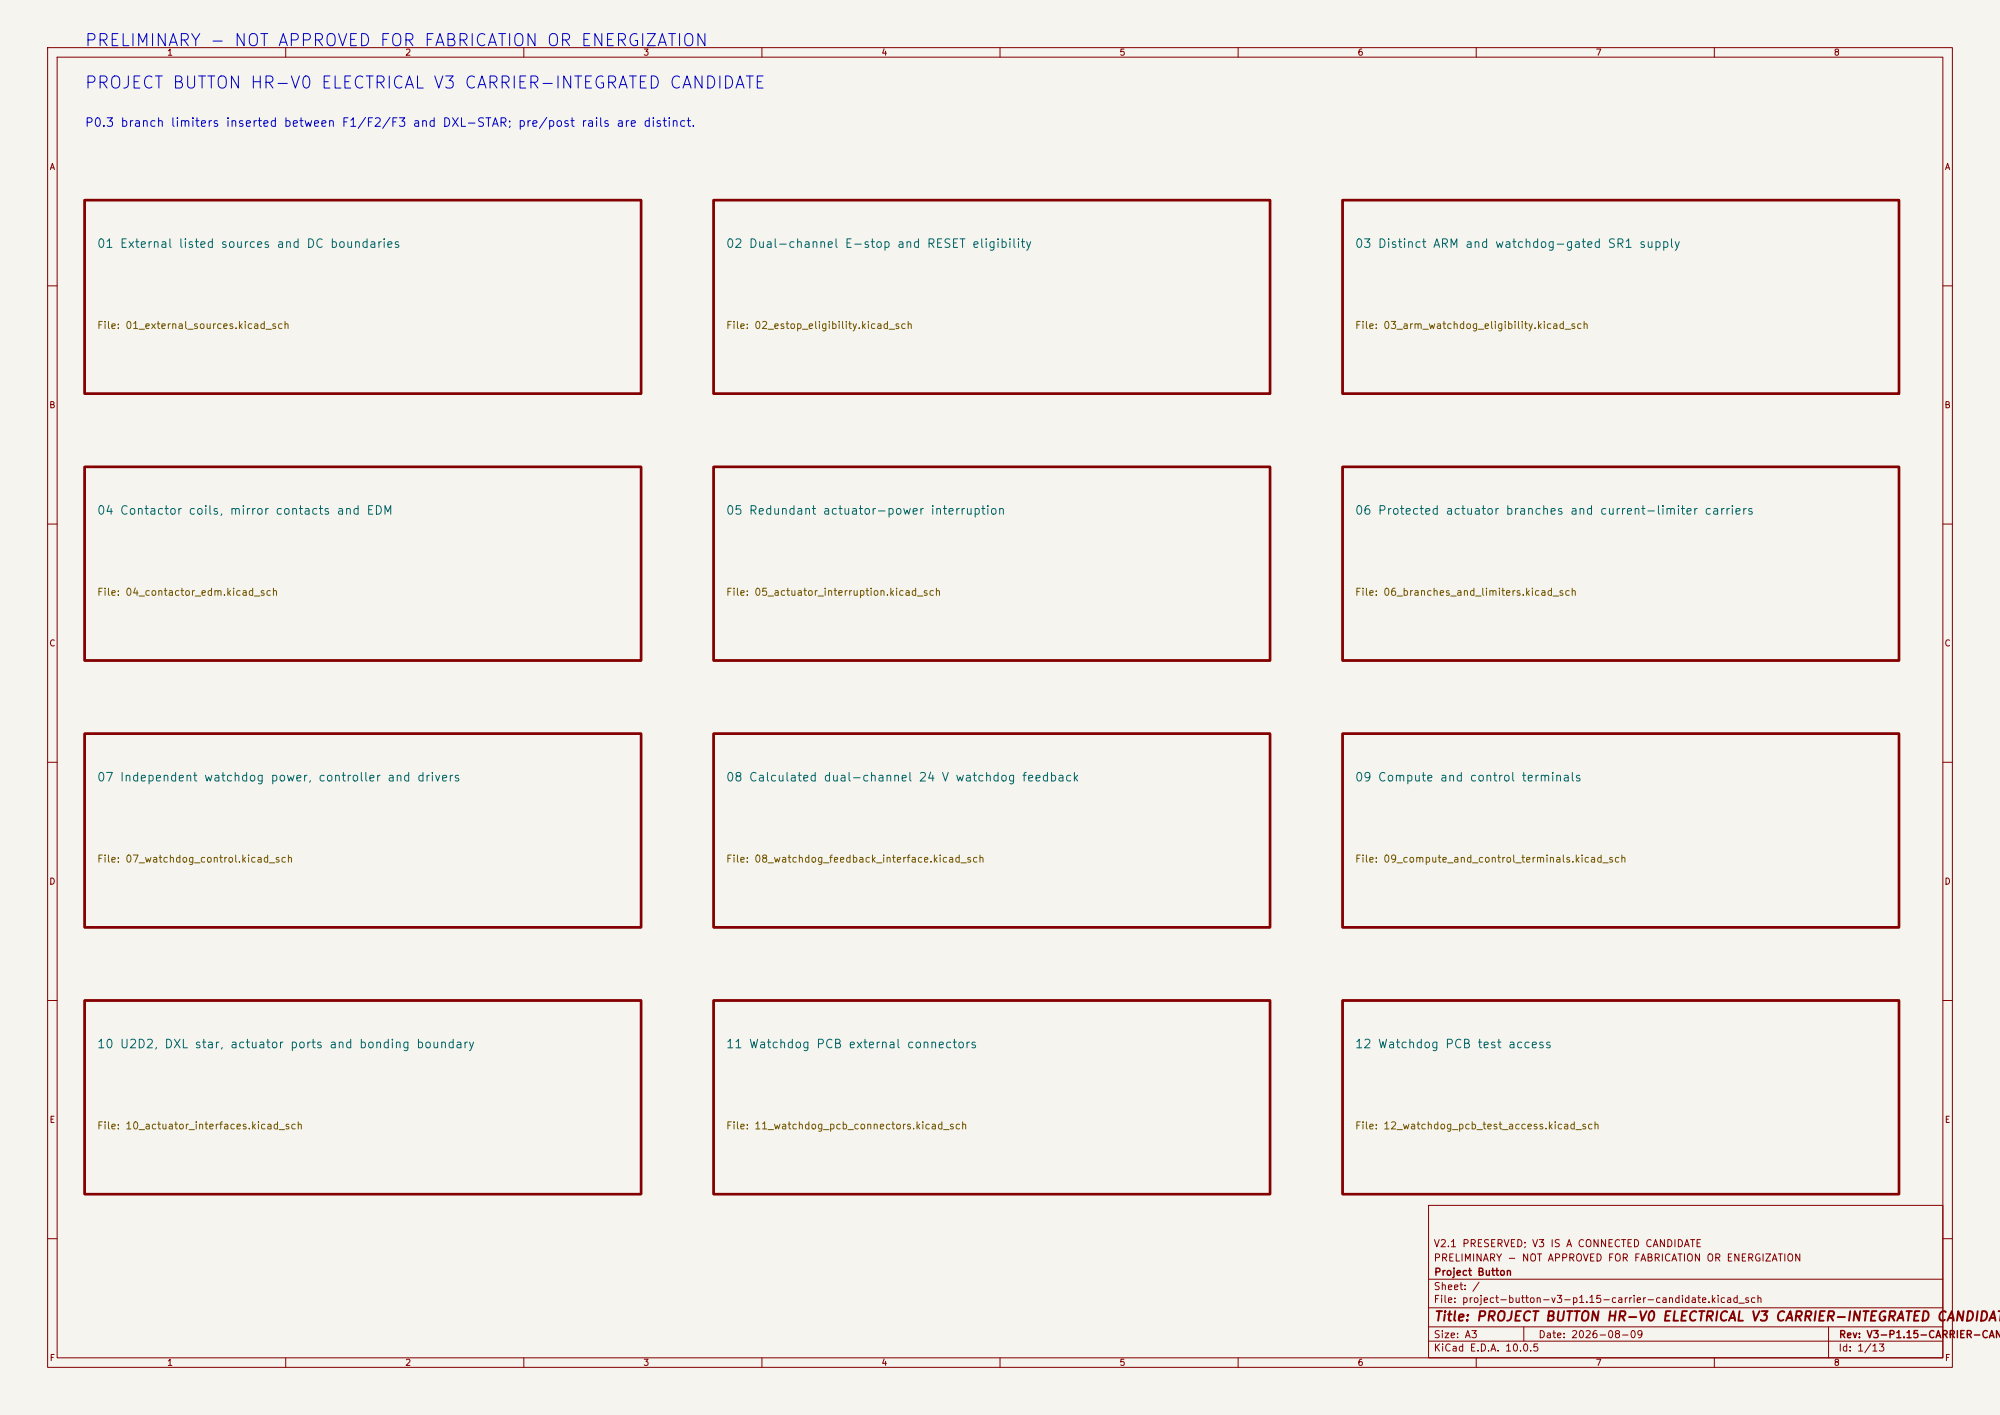
[picture p237: page 1]

PRELIMINARY - NOT APPROVED FOR FABRICATION OR ENERGIZATION

PROJECT BUTTON HR-V0 ELECTRICAL V3 CARRIER-INTEGRATED CANDIDATE

P0.3 branch limiters inserted between F1/F2/F3 and DXL-STAR; pre/post rails are distinct.

01 External listed sources and DC boundaries

02 Dual-channel E-stop and RESET eligibility

03 Distinct ARM and watchdog-gated SR1 supply

04 Contactor coils, mirror contacts and EDM

05 Redundant actuator-power interruption

06 Protected actuator branches and current-limiter carriers

07 Independent watchdog power, controller and drivers

08 Calculated dual-channel 24 V watchdog feedback

09 Compute and control terminals

10 U2D2, DXL star, actuator ports and bonding boundary

11 Watchdog PCB external connectors

12 Watchdog PCB test access

V2.1 PRESERVED; V3 IS A CONNECTED CANDIDATE
Project Button
Sheet: /
File: project-button-v3-p1.15-carrier-candidate.kicad_sch
Title: PROJECT BUTTON HR-V0 ELECTRICAL V3 CARRIER-INTEGRATED CANDIDATE index

F Date: 2026-08-09

KiCad E.D.A. 10.0.5 | Id: 1/13

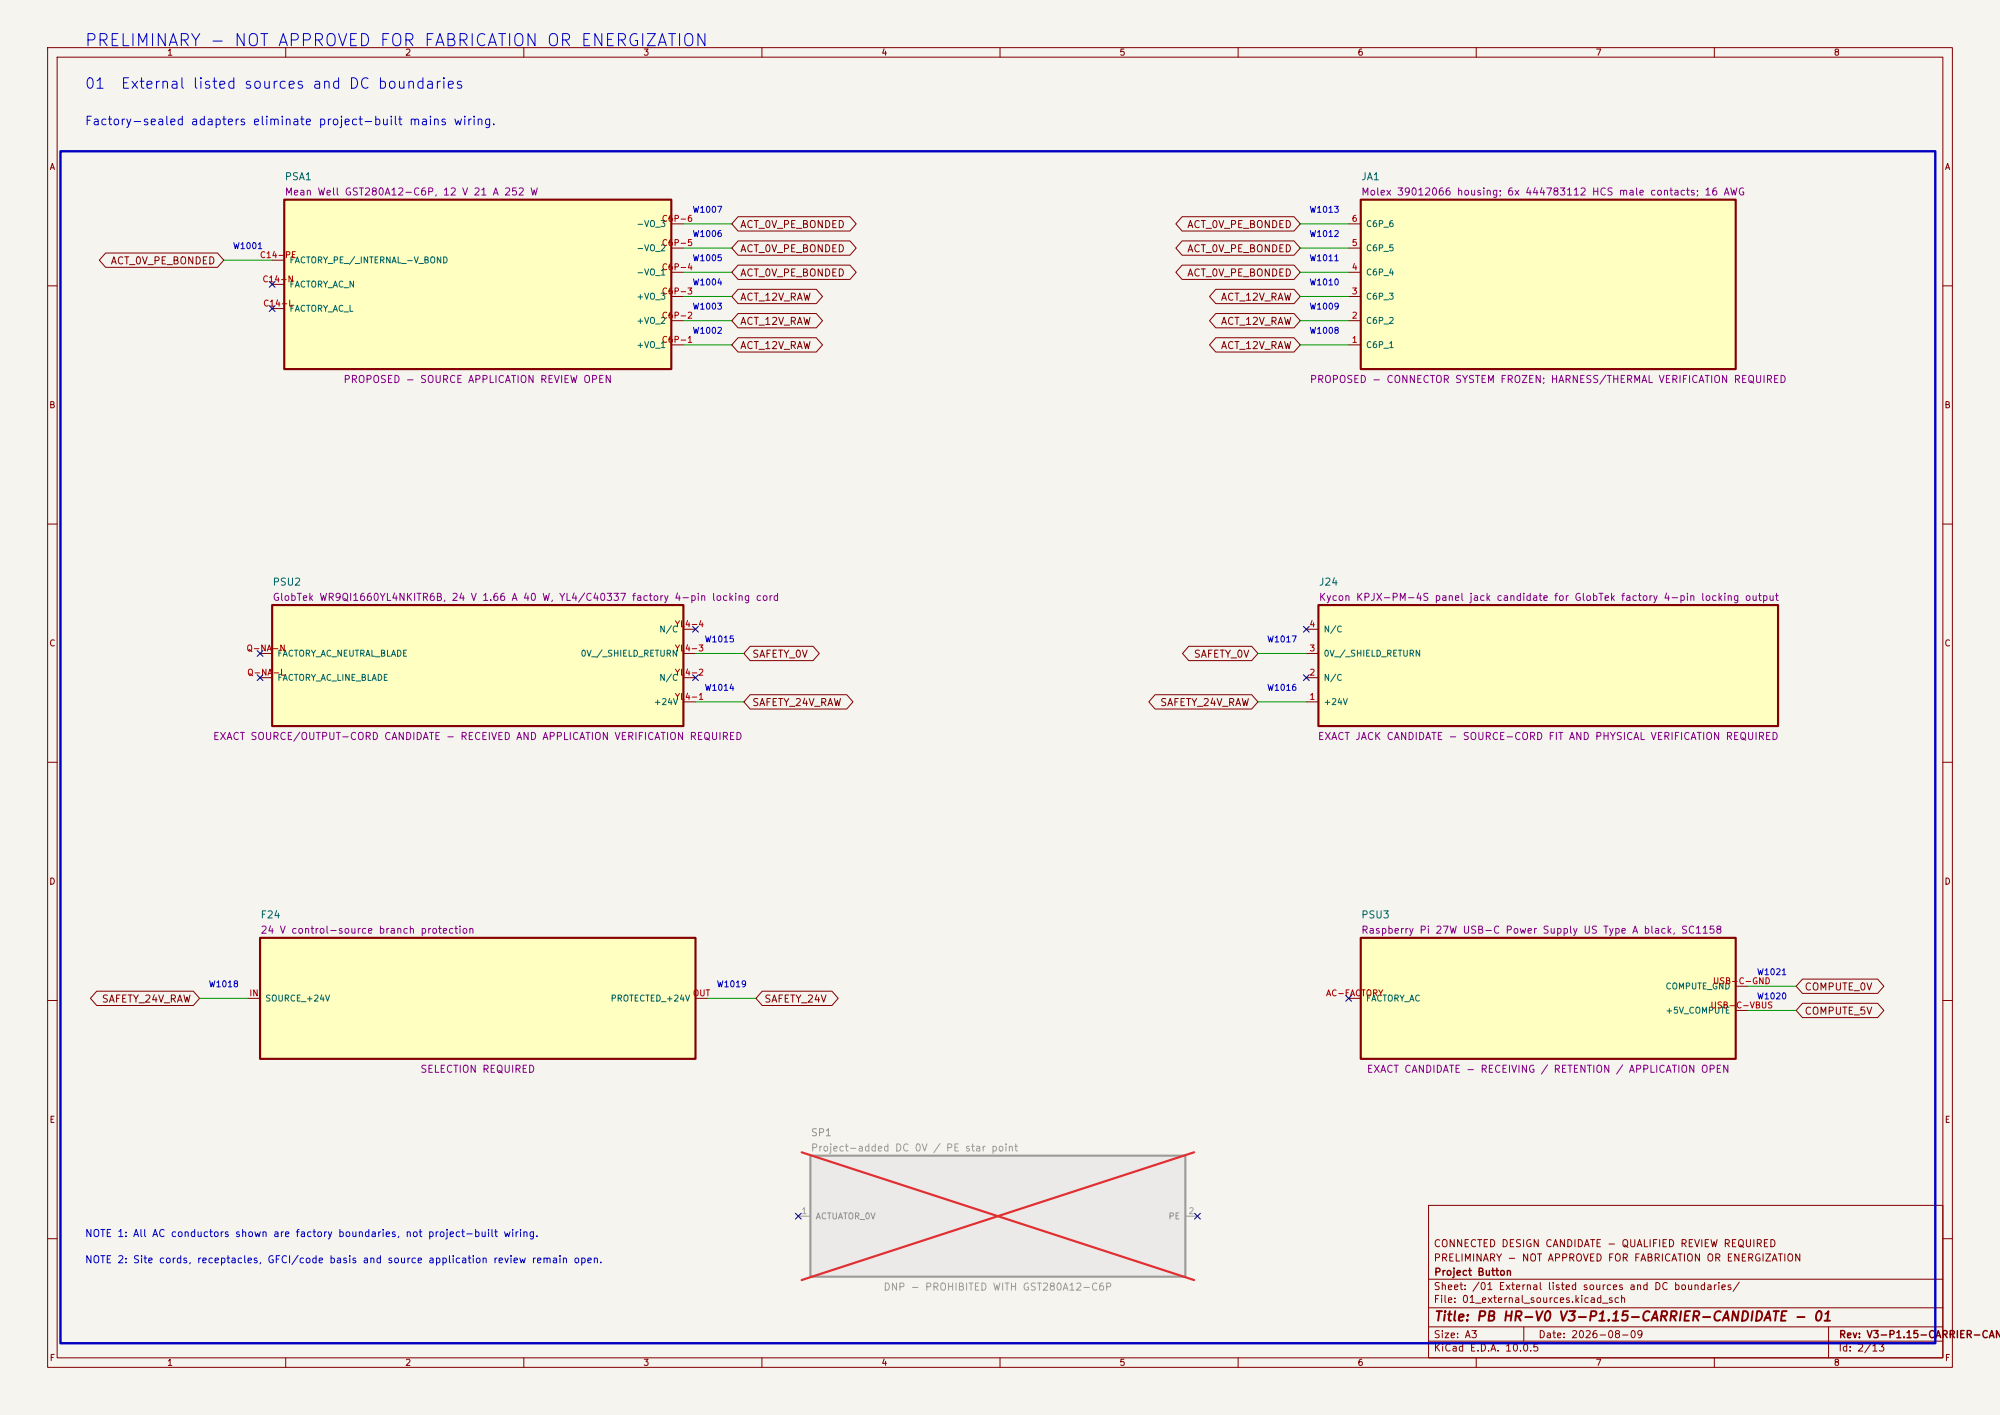
[picture p238: page 2]

W1004 PRELIMINARY - NOT APPROVED FOR FABRICATION OR ENERGIZATION

01 External listed sources and DC boundaries

Molex 39012066 housing; 6x 444783112 HCS male contacts; 16 AWG

PROPOSED - SOURCE APPLICATION REVIEW OPEN

PROPOSED - CONNECTOR SYSTEM FROZEN; HARNESS/THERMAL VERIFICATION REQUIRED

0V_/_SHIELD_RETURNYL4-3 N/CYL4-4 PSU2
GlobTek WR9QI1660YL4NKITR6B, 24 V 1.66 A 40 W, YL4/C40337 factory 4-pin locking cord

EXACT SOURCE/OUTPUT-CORD CANDIDATE - RECEIVED AND APPLICATION VERIFICATION REQUIRED

EXACT JACK CANDIDATE - SOURCE-CORD FIT AND PHYSICAL VERIFICATION REQUIRED

24 V control-source branch protection

Raspberry Pi 27W USB-C Power Supply US Type A black, SC1158

EXACT CANDIDATE - RECEIVING / RETENTION / APPLICATION OPEN

NOTE 1: All AC conductors shown are factory boundaries, not project-built wiring.

CONNECTED DESIGN CANDIDATE - QUALIFIED REVIEW REQUIRED
PRELIMINARY - NOT APPROVED FOR FABRICATION OR ENERGIZATION
Project Button
Sheet: /01 External listed sources and DC boundaries/
File: 01_external_sources.kicad_sch
Title: PB HR-V0 V3-P1.15-CARRIER-CANDIDATE - 01

NOTE 2: Site cords, receptacles, GFCI/code basis and source application review remain open.

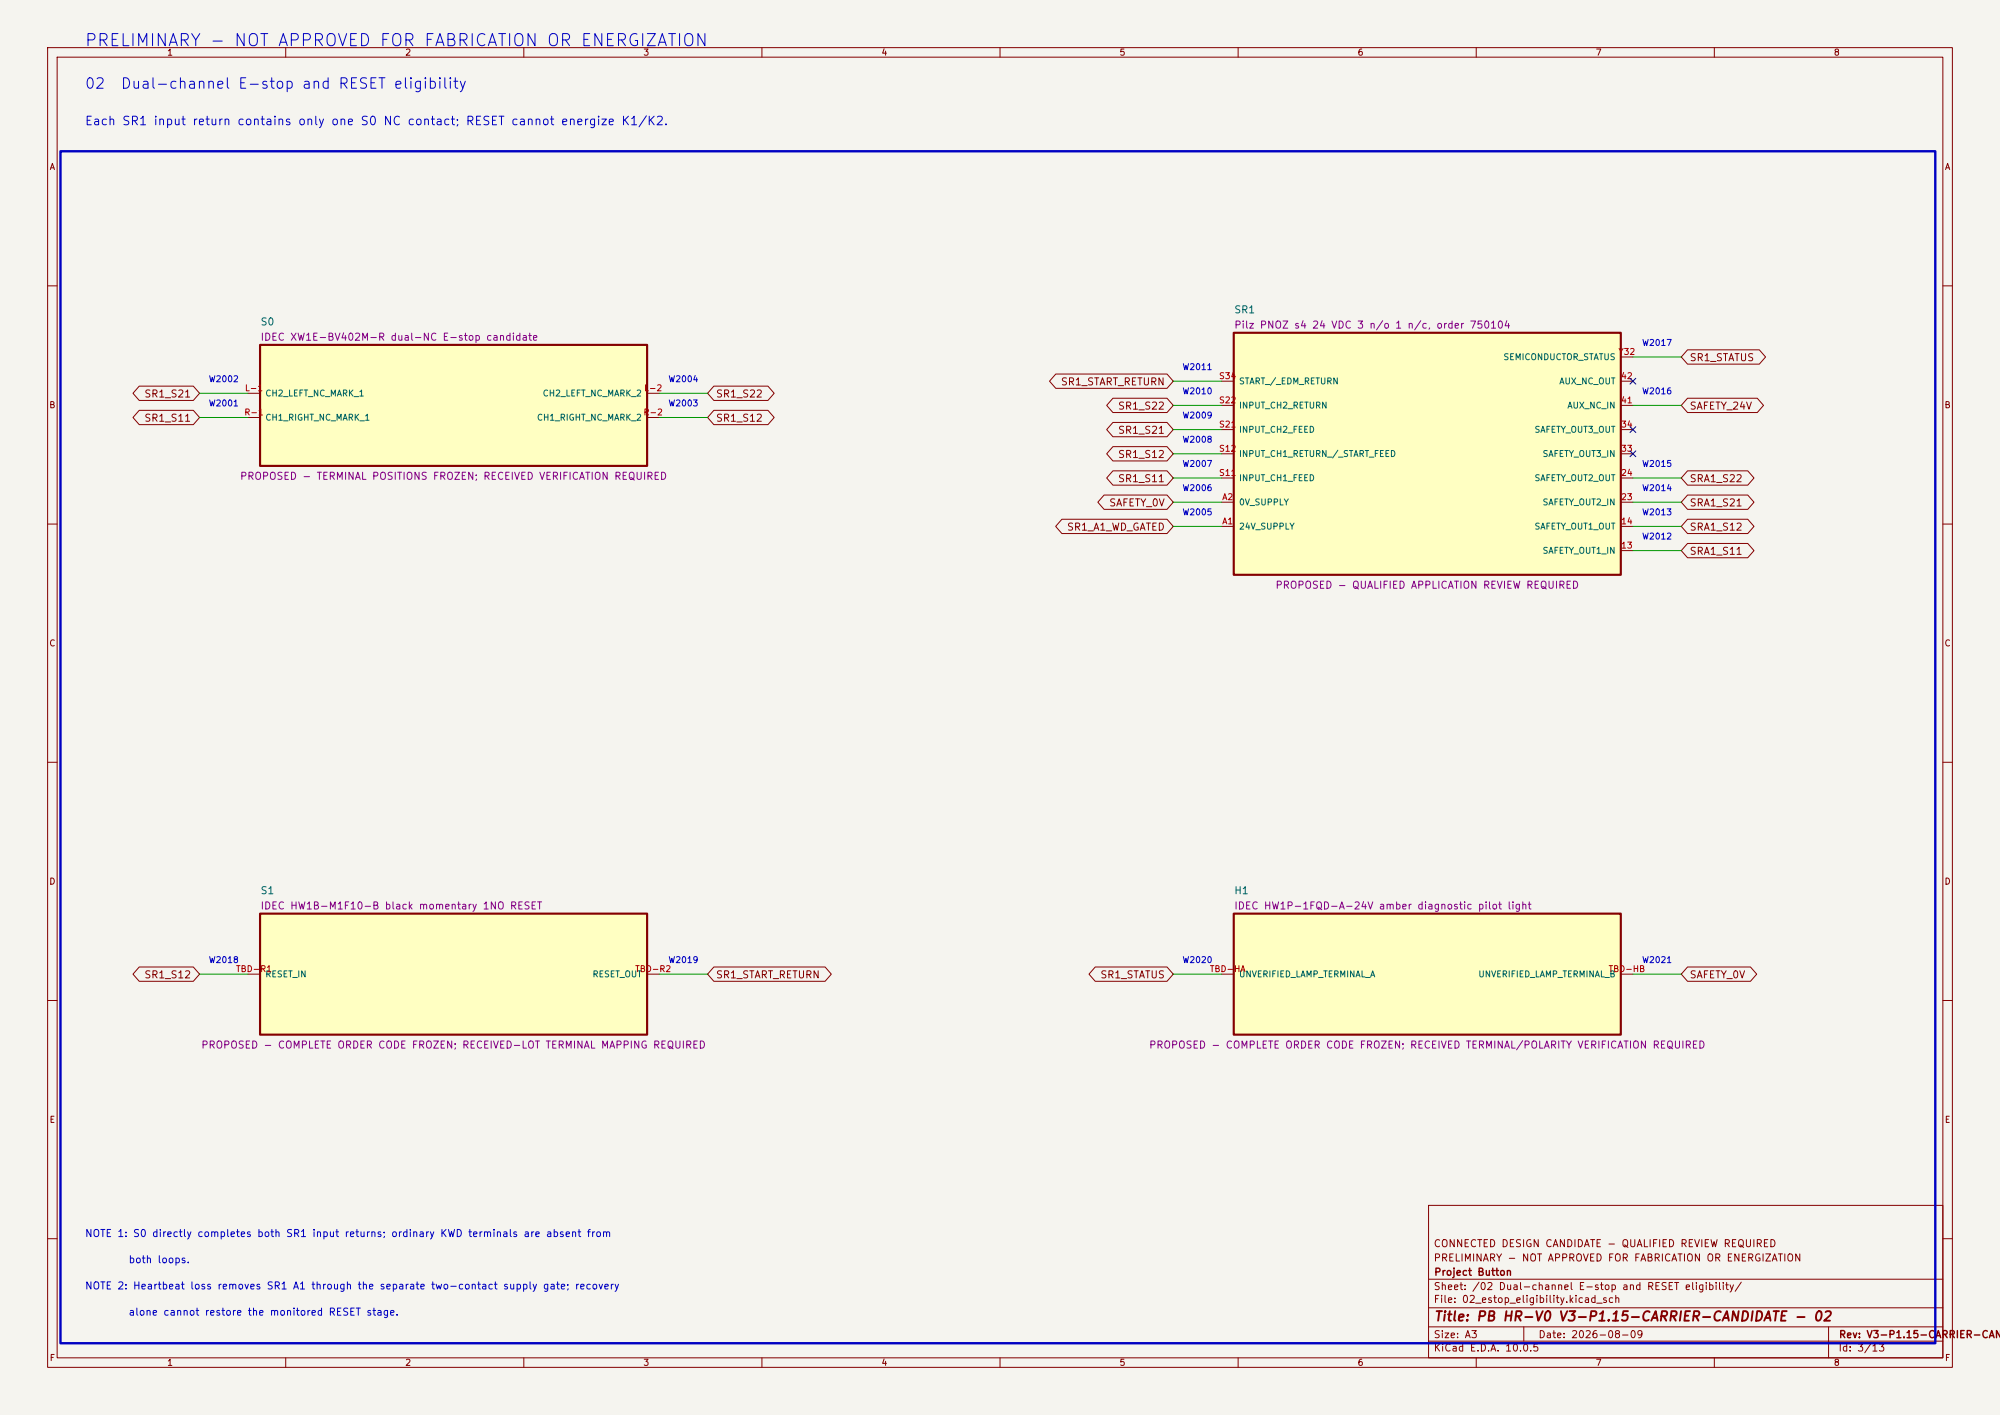
[picture p239: page 3]

SEMICONDUCTOR_STATUS Y32 SR1
Pilz PNOZ s4 24 VDC 3 n/o 1 n/c, order 750104

IDEC XW1E-BV402M-R dual-NC E-stop candidate

PROPOSED - TERMINAL POSITIONS FROZEN; RECEIVED VERIFICATION REQUIRED

PROPOSED - QUALIFIED APPLICATION REVIEW REQUIRED

IDEC HW1B-M1F10-B black momentary 1NO RESET

IDEC HW1P-1FQD-A-24V amber diagnostic pilot light

PROPOSED - COMPLETE ORDER CODE FROZEN; RECEIVED-LOT TERMINAL MAPPING REQUIRED

PROPOSED - COMPLETE ORDER CODE FROZEN; RECEIVED TERMINAL/POLARITY VERIFICATION REQUIRED

CONNECTED DESIGN CANDIDATE - QUALIFIED REVIEW REQUIRED PRELIMINARY - NOT APPROVED FOR FABRICATION OR ENERGIZATION Project Button

NOTE 2: Heartbeat loss removes SR1 A1 through the separate two-contact supply gate; recovery

Sheet: /02 Dual-channel E-stop and RESET eligibility/ File: 02_estop_eligibility.kicad_sch

alone cannot restore the monitored RESET stage.

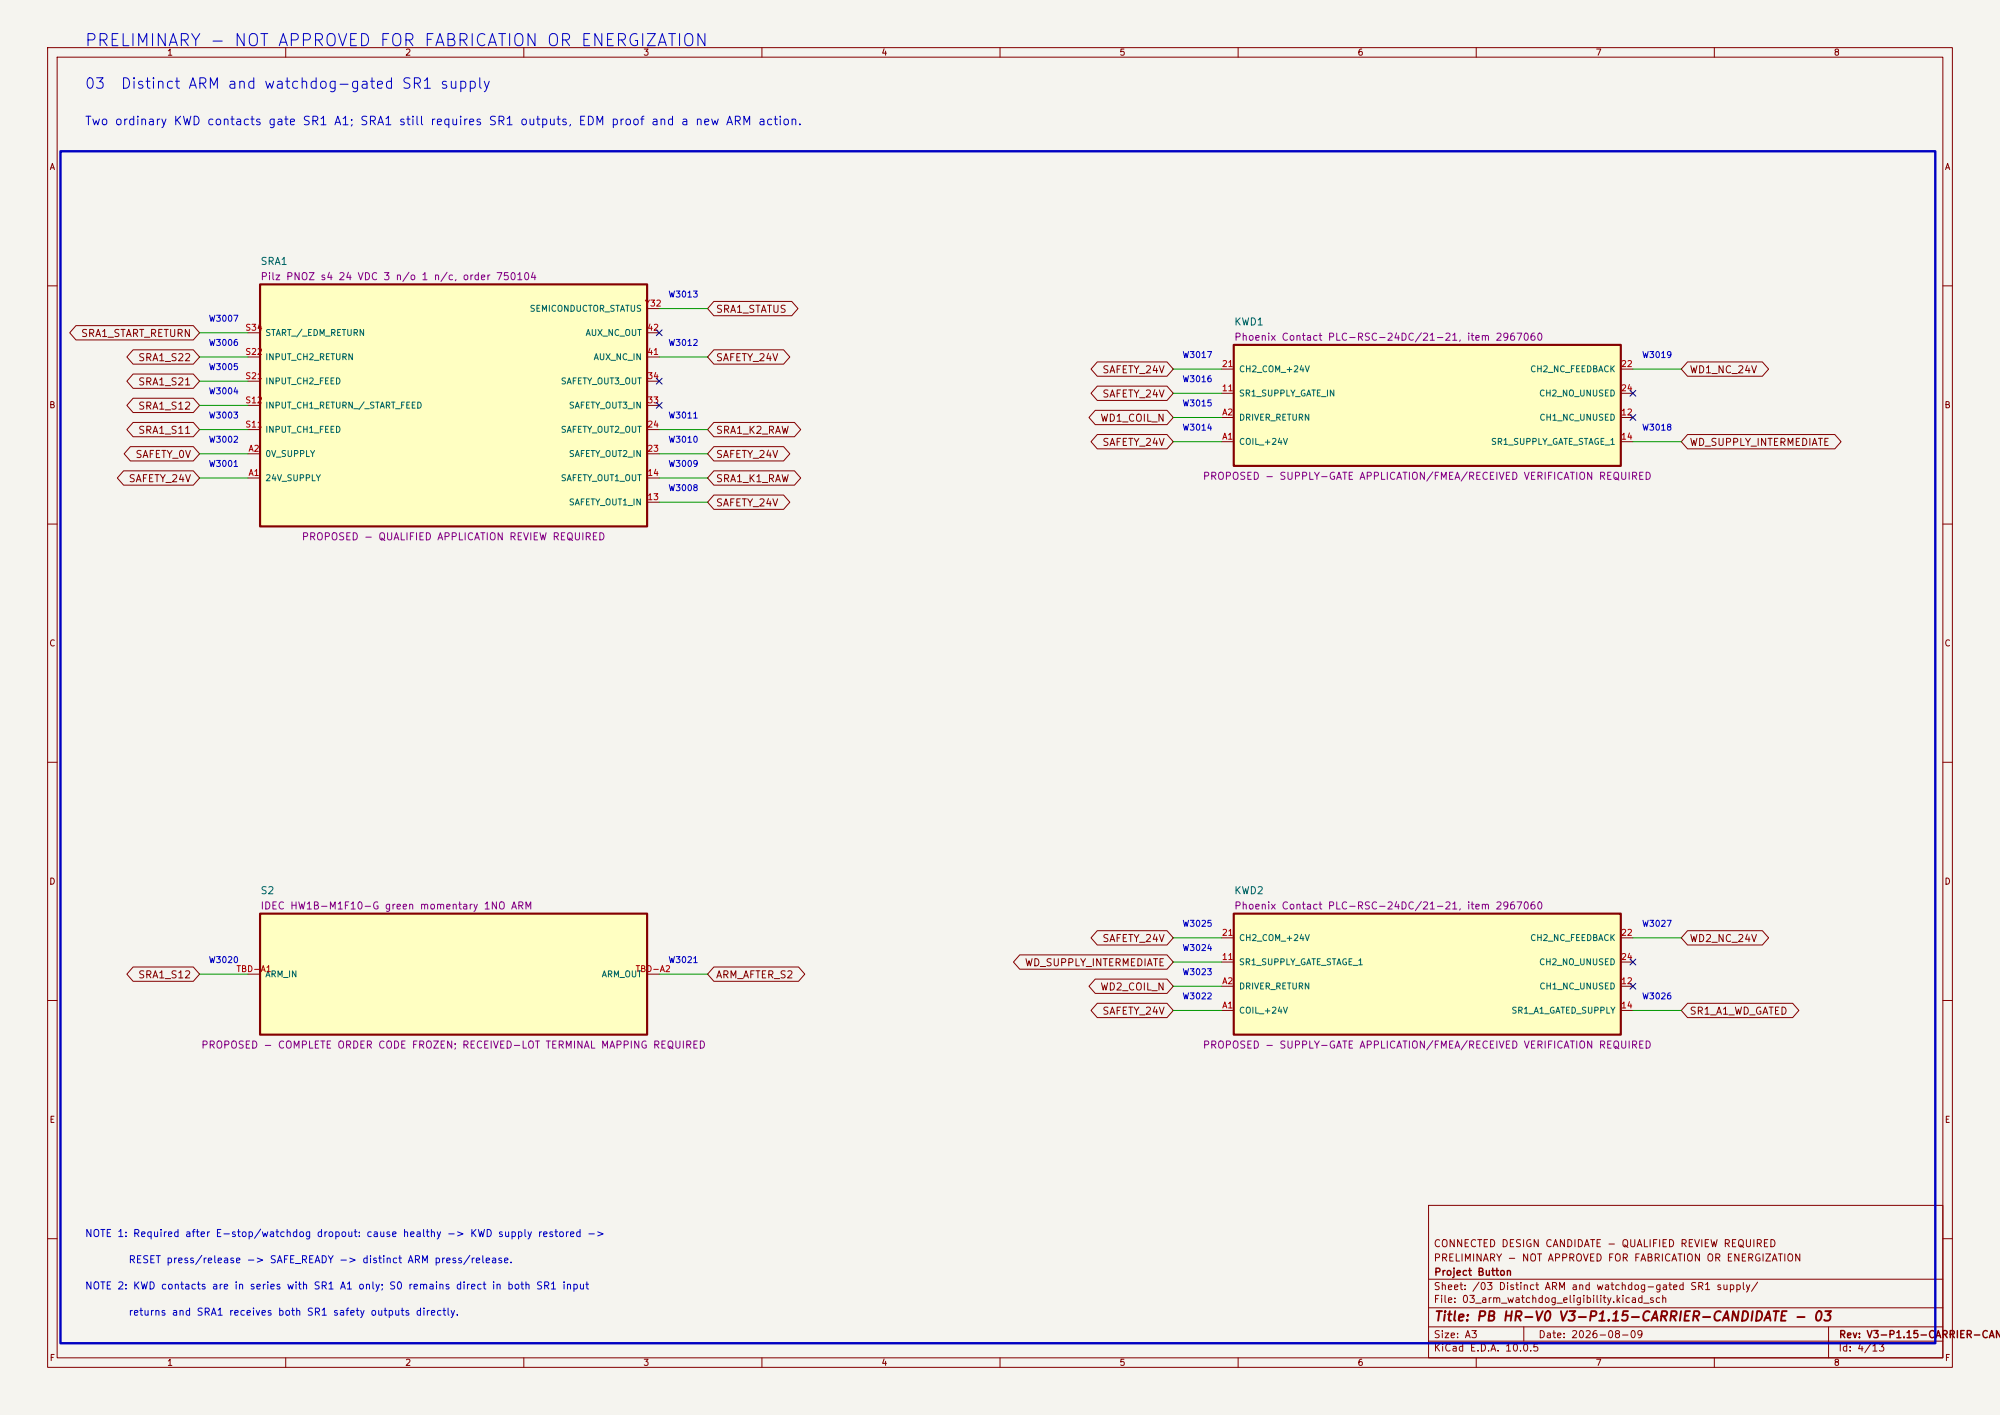
[picture p240: page 4]

W3019 W3002 W3004 PRELIMINARY - NOT APPROVED FOR FABRICATION OR ENERGIZATION

SEMICONDUCTOR_STATUS Y32 SRA1
Pilz PNOZ s4 24 VDC 3 n/o 1 n/c, order 750104

Phoenix Contact PLC-RSC-24DC/21-21, item 2967060

PROPOSED - SUPPLY-GATE APPLICATION/FMEA/RECEIVED VERIFICATION REQUIRED

PROPOSED - QUALIFIED APPLICATION REVIEW REQUIRED

IDEC HW1B-M1F10-G green momentary 1NO ARM

PROPOSED - COMPLETE ORDER CODE FROZEN; RECEIVED-LOT TERMINAL MAPPING REQUIRED

CONNECTED DESIGN CANDIDATE - QUALIFIED REVIEW REQUIRED PRELIMINARY - NOT APPROVED FOR FABRICATION OR ENERGIZATION Project Button

NOTE 2: KWD contacts are in series with SR1 A1 only; S0 remains direct in both SR1 input

Sheet: /03 Distinct ARM and watchdog-gated SR1 supply/ File: 03_arm_watchdog_eligibility.kicad_sch

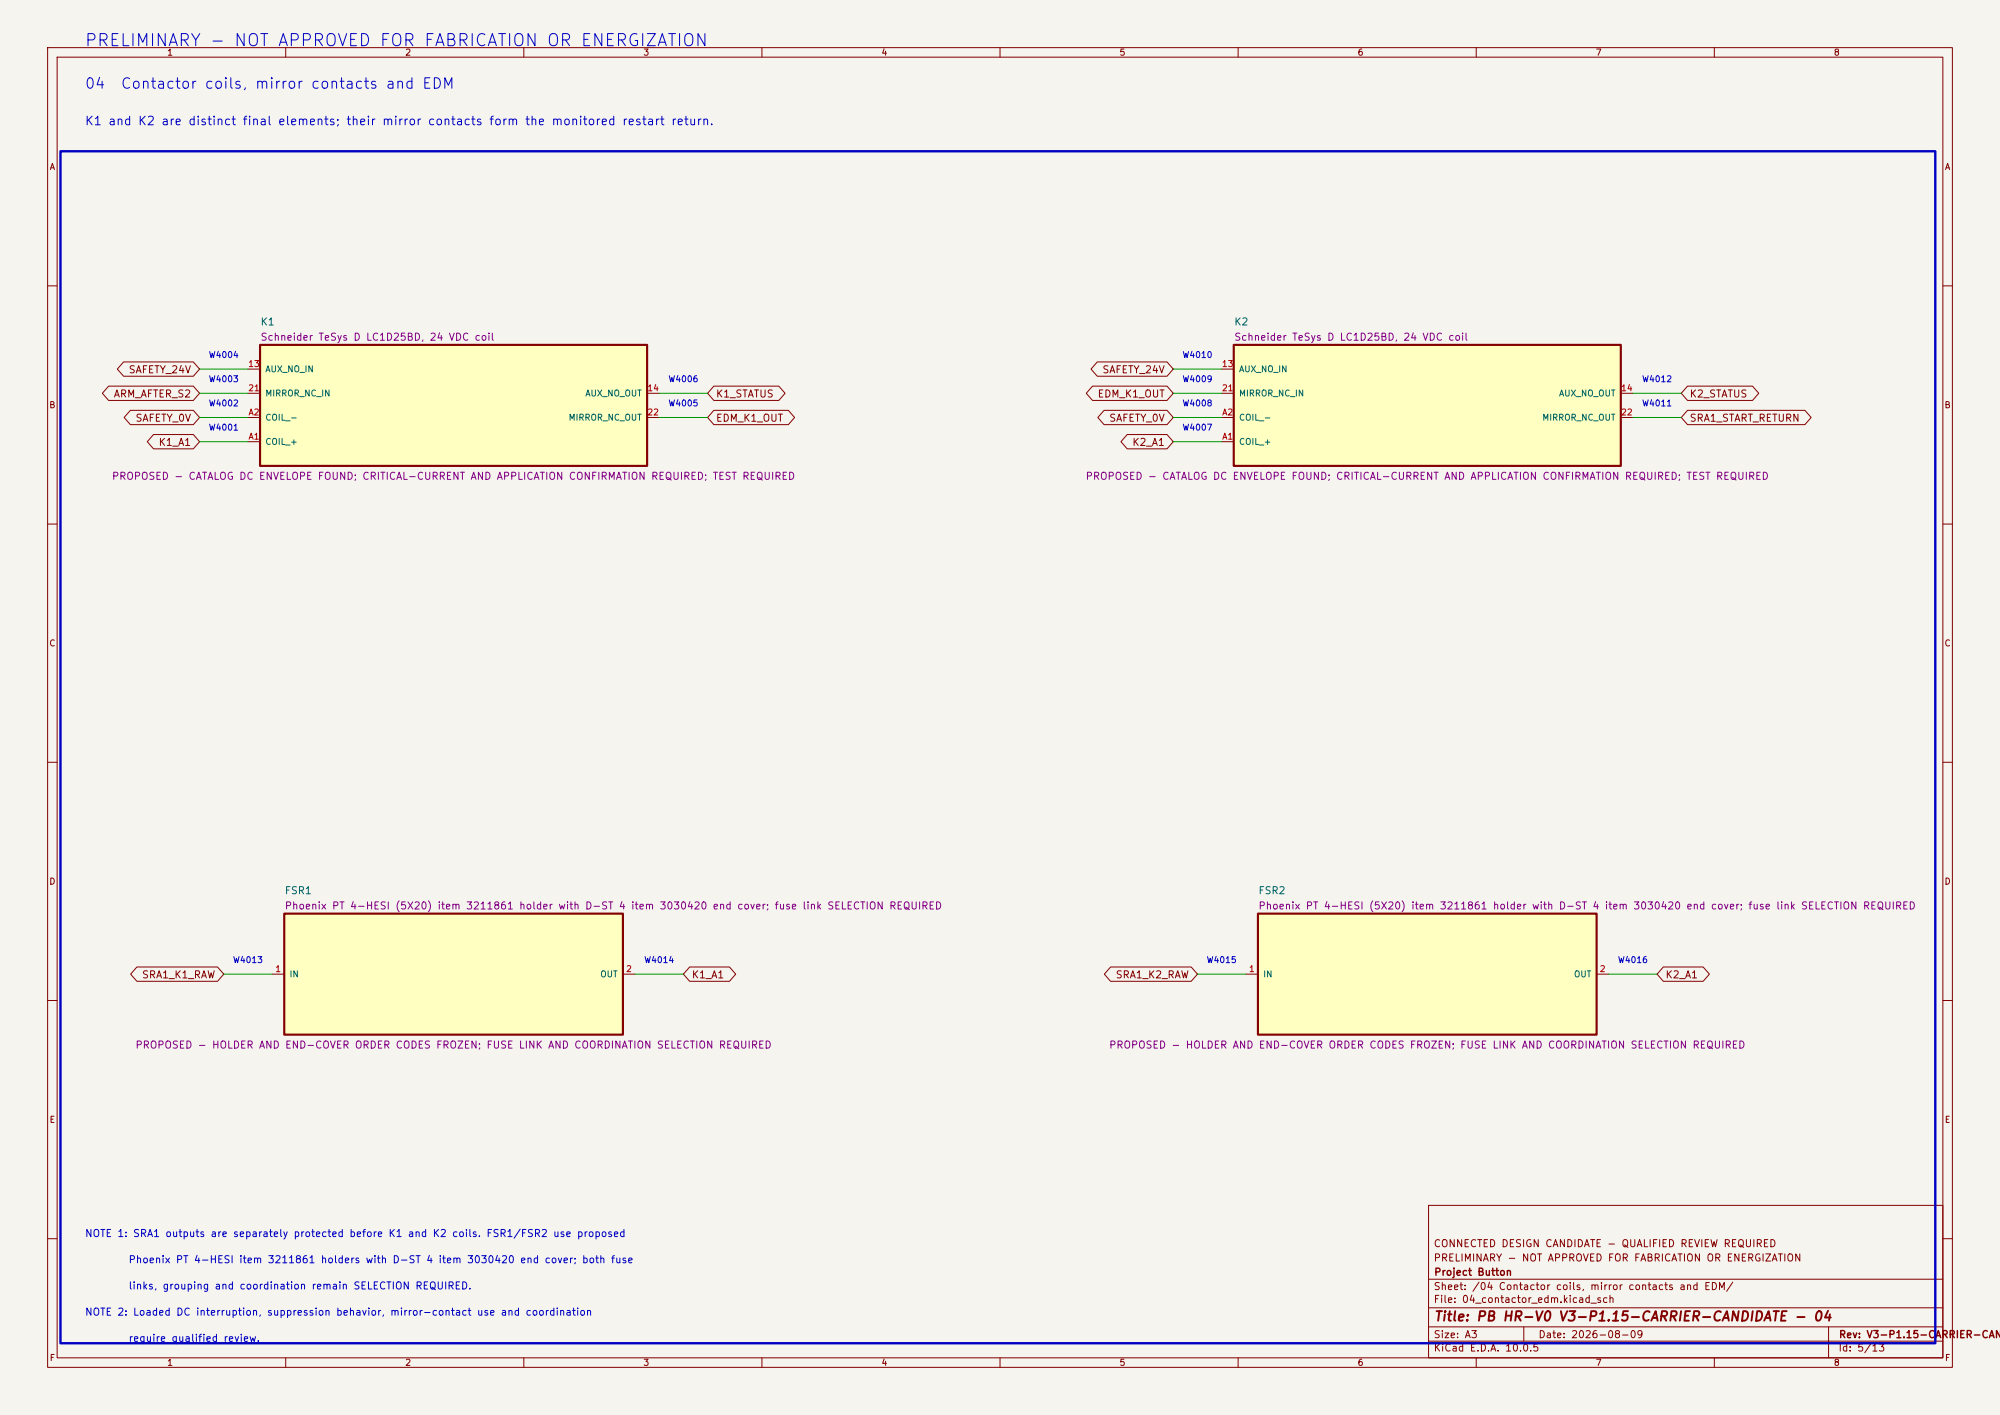
[picture p241: page 5]

PRELIMINARY - NOT APPROVED FOR FABRICATION OR ENERGIZATION

04 Contactor coils, mirror contacts and EDM

Schneider TeSys D LC1D25BD, 24 VDC coil

PROPOSED - CATALOG DC ENVELOPE FOUND; CRITICAL-CURRENT AND APPLICATION CONFIRMATION REQUIRED; TEST REQUIRED

Phoenix PT 4-HESI (5X20) item 3211861 holder with D-ST 4 item 3030420 end cover; fuse link SELECTION REQUIRED

PROPOSED - HOLDER AND END-COVER ORDER CODES FROZEN; FUSE LINK AND COORDINATION SELECTION REQUIRED

CONNECTED DESIGN CANDIDATE - QUALIFIED REVIEW REQUIRED PRELIMINARY - NOT APPROVED FOR FABRICATION OR ENERGIZATION Project Button

Phoenix PT 4-HESI item 3211861 holders with D-ST 4 item 3030420 end cover; both fuse

links, grouping and coordination remain SELECTION REQUIRED.

Sheet: /04 Contactor coils, mirror contacts and EDM/ File: 04_contactor_edm.kicad_sch

NOTE 2: Loaded DC interruption, suppression behavior, mirror-contact use and coordination

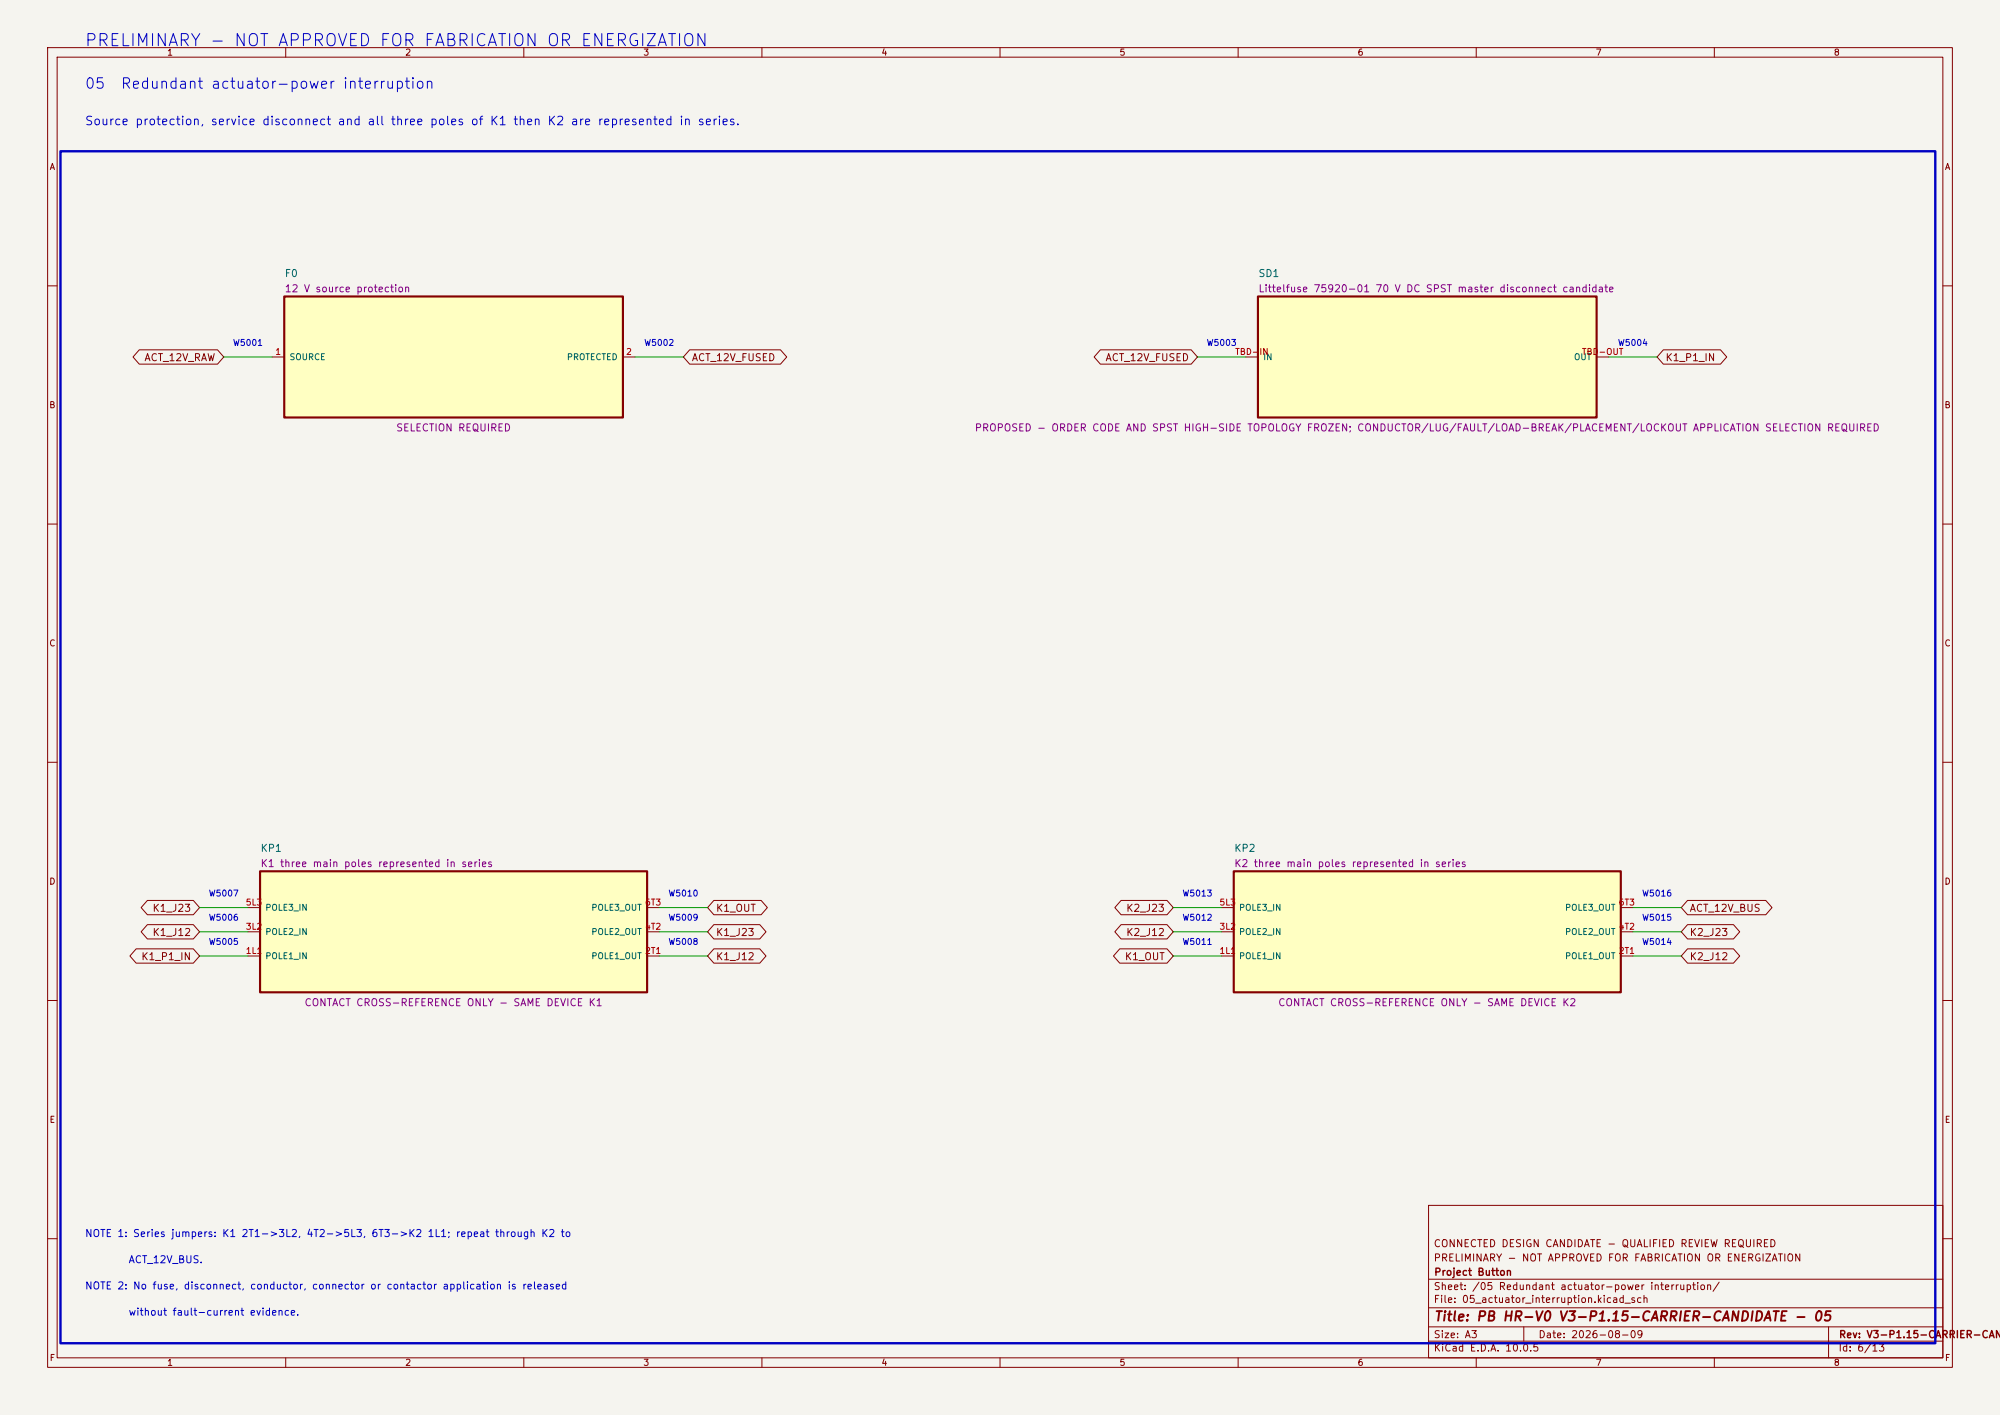
[picture p242: page 6]

PRELIMINARY - NOT APPROVED FOR FABRICATION OR ENERGIZATION

05 Redundant actuator-power interruption

Littelfuse 75920-01 70 V DC SPST master disconnect candidate

PROPOSED - ORDER CODE AND SPST HIGH-SIDE TOPOLOGY FROZEN; CONDUCTOR/LUG/FAULT/LOAD-BREAK/PLACEMENT/LOCKOUT APPLICATION SELECTION REQUIRED

K1 three main poles represented in series

CONTACT CROSS-REFERENCE ONLY - SAME DEVICE K1

CONTACT CROSS-REFERENCE ONLY - SAME DEVICE K2

CONNECTED DESIGN CANDIDATE - QUALIFIED REVIEW REQUIRED PRELIMINARY - NOT APPROVED FOR FABRICATION OR ENERGIZATION Project Button

NOTE 2: No fuse, disconnect, conductor, connector or contactor application is released

Sheet: /05 Redundant actuator-power interruption/ File: 05_actuator_interruption.kicad_sch

without fault-current evidence.

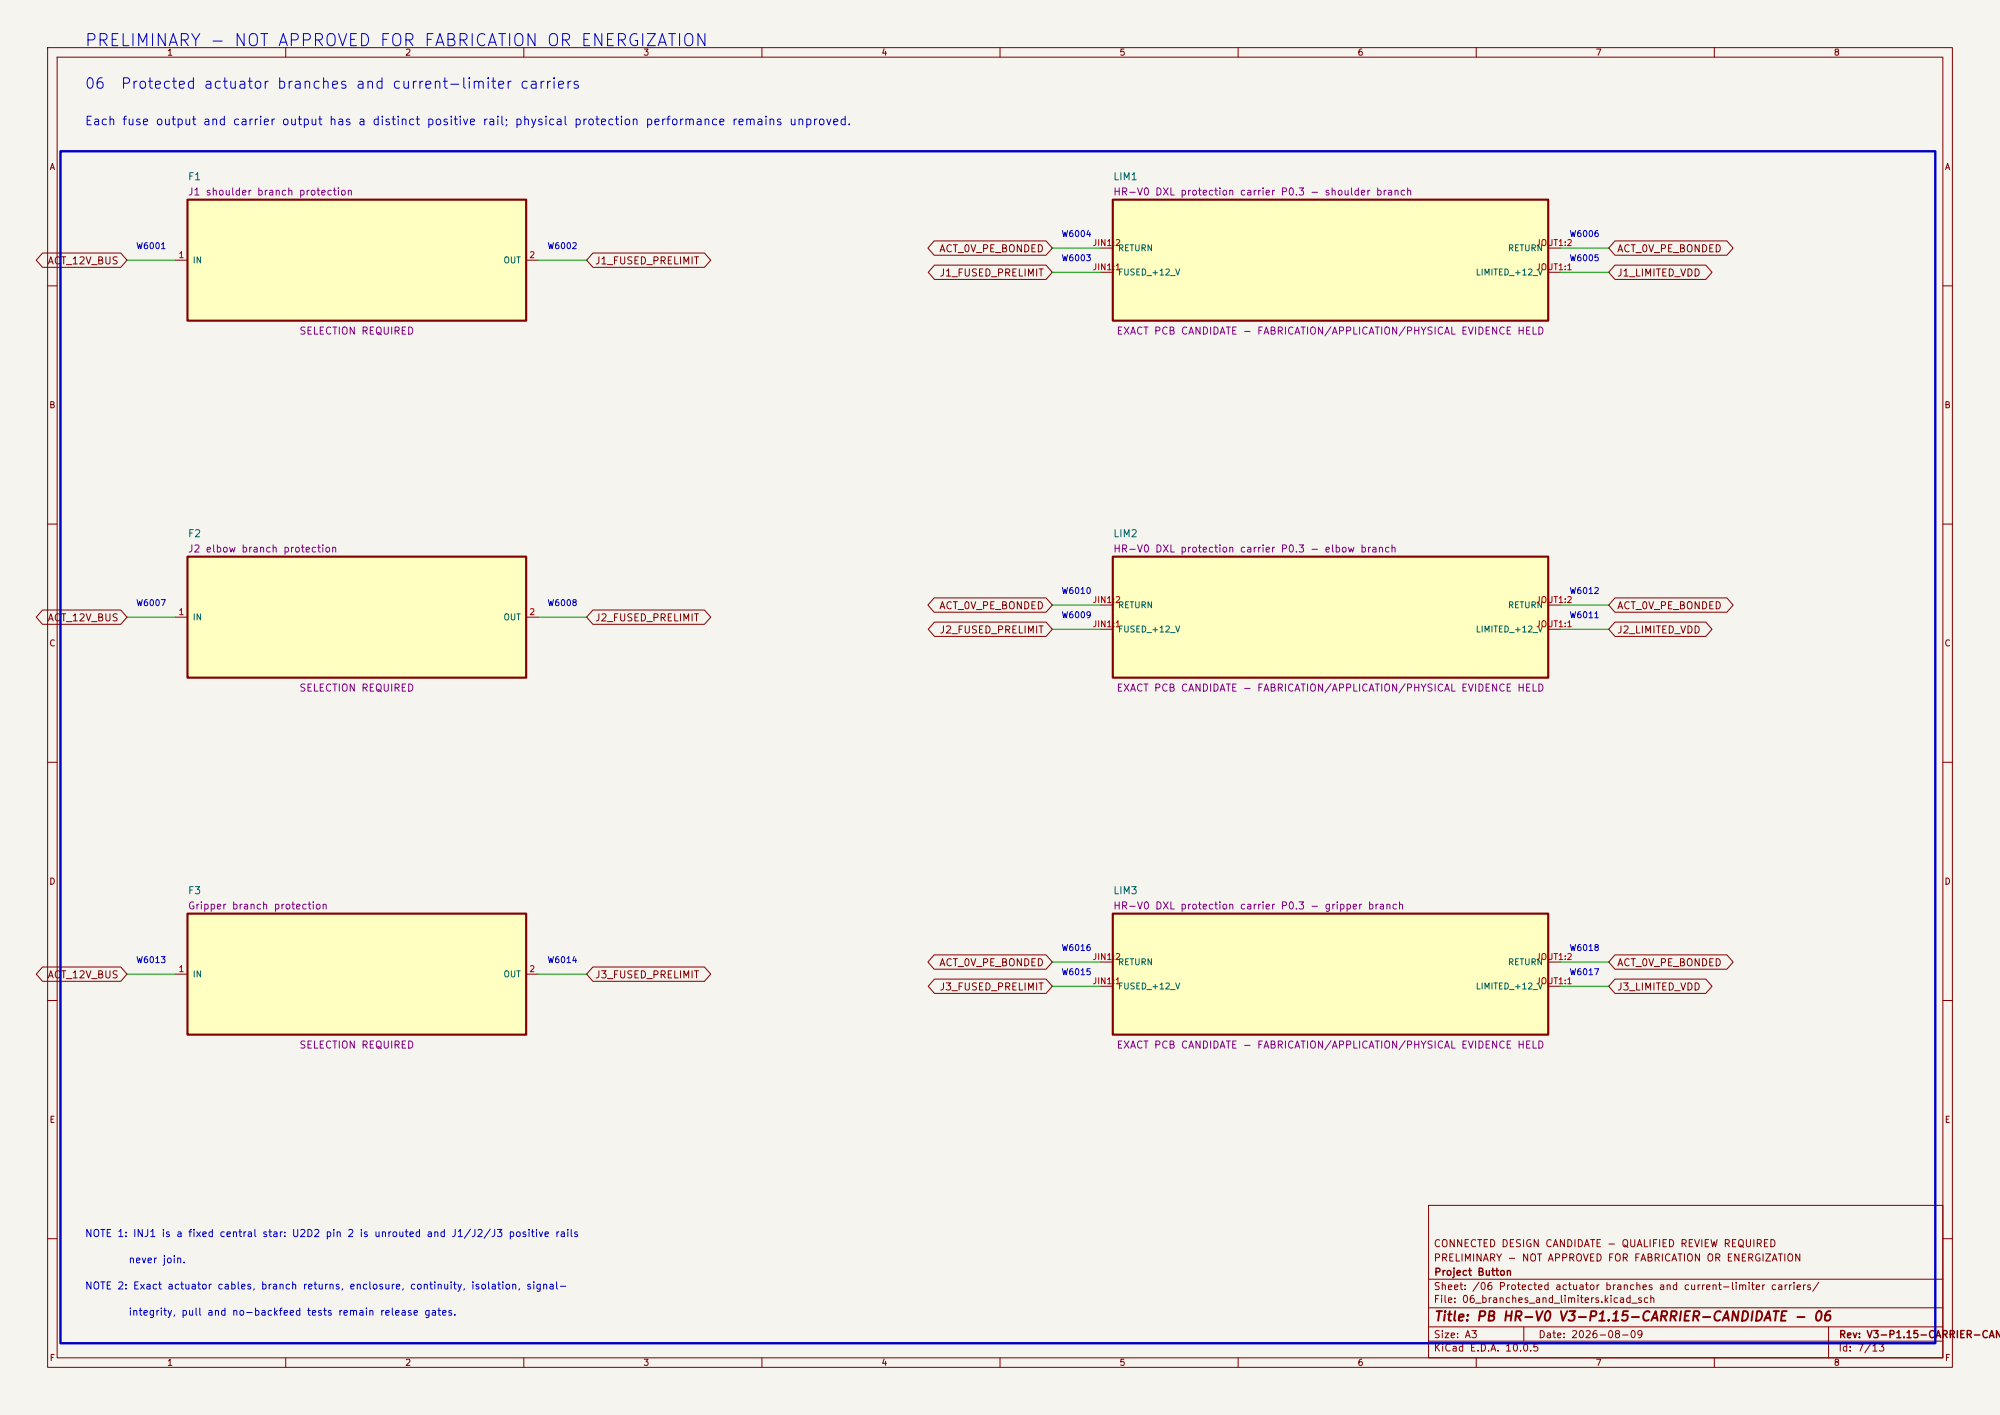
[picture p243: page 7]

W6007 W6001 PRELIMINARY - NOT APPROVED FOR FABRICATION OR ENERGIZATION

W6017 W6018 W6011 06 Protected actuator branches and current-limiter carriers

LIMITED_+12_VJOUT1:1 RETURNJOUT1:2 LIM1
HR-V0 DXL protection carrier P0.3 - shoulder branch

EXACT PCB CANDIDATE - FABRICATION/APPLICATION/PHYSICAL EVIDENCE HELD

LIMITED_+12_VJOUT1:1 RETURNJOUT1:2 LIM2
HR-V0 DXL protection carrier P0.3 - elbow branch

LIMITED_+12_VJOUT1:1 RETURNJOUT1:2 LIM3
HR-V0 DXL protection carrier P0.3 - gripper branch

W6014 NOTE 1: INJ1 is a fixed central star: U2D2 pin 2 is unrouted and J1/J2/J3 positive rails never join.

CONNECTED DESIGN CANDIDATE - QUALIFIED REVIEW REQUIRED PRELIMINARY - NOT APPROVED FOR FABRICATION OR ENERGIZATION Project Button

NOTE 2: Exact actuator cables, branch returns, enclosure, continuity, isolation, signal-

Sheet: /06 Protected actuator branches and current-limiter carriers/ File: 06_branches_and_limiters.kicad_sch

integrity, pull and no-backfeed tests remain release gates.

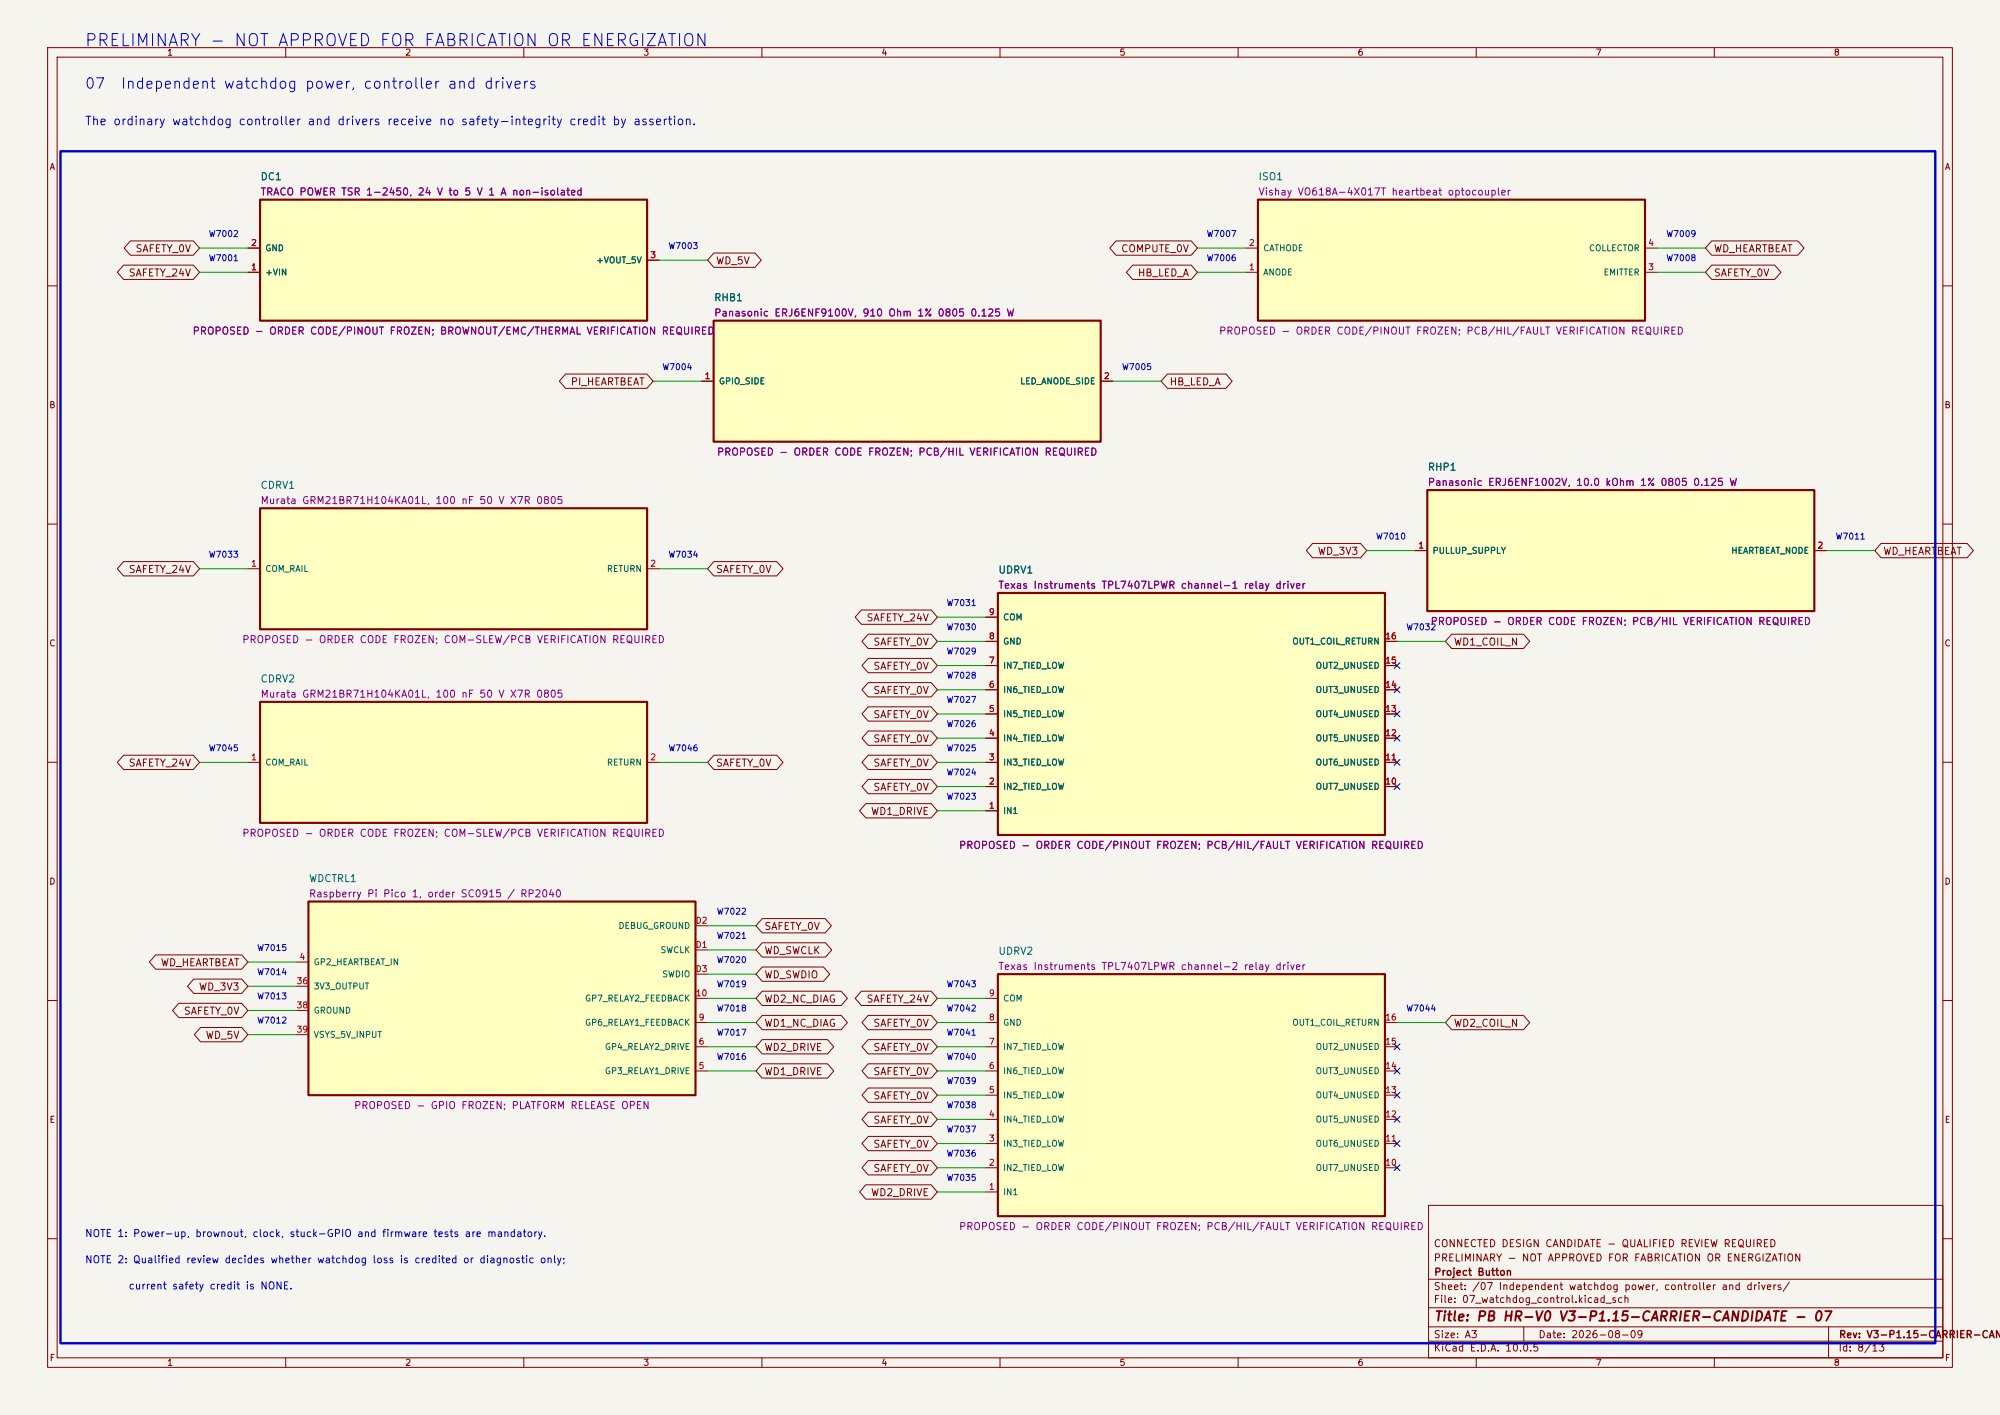
[picture p244: page 8]

W7026 07 Independent watchdog power, controller and drivers

TRACO POWER TSR 1-2450, 24 V to 5 V 1 A non-isolated

PROPOSED - ORDER CODE/PINOUT FROZEN; BROWNOUT/EMC/THERMAL VERIFICATION REQUIRED

PROPOSED - ORDER CODE/PINOUT FROZEN; PCB/HIL/FAULT VERIFICATION REQUIRED

PROPOSED - ORDER CODE FROZEN; PCB/HIL VERIFICATION REQUIRED

Texas Instruments TPL7407LPWR channel-1 relay driver

PROPOSED - ORDER CODE FROZEN; COM-SLEW/PCB VERIFICATION REQUIRED

Raspberry Pi Pico 1, order SC0915 / RP2040

PROPOSED - GPIO FROZEN; PLATFORM RELEASE OPEN

CONNECTED DESIGN CANDIDATE - QUALIFIED REVIEW REQUIRED PRELIMINARY - NOT APPROVED FOR FABRICATION OR ENERGIZATION Project Button

Sheet: /07 Independent watchdog power, controller and drivers/ File: 07_watchdog_control.kicad_sch

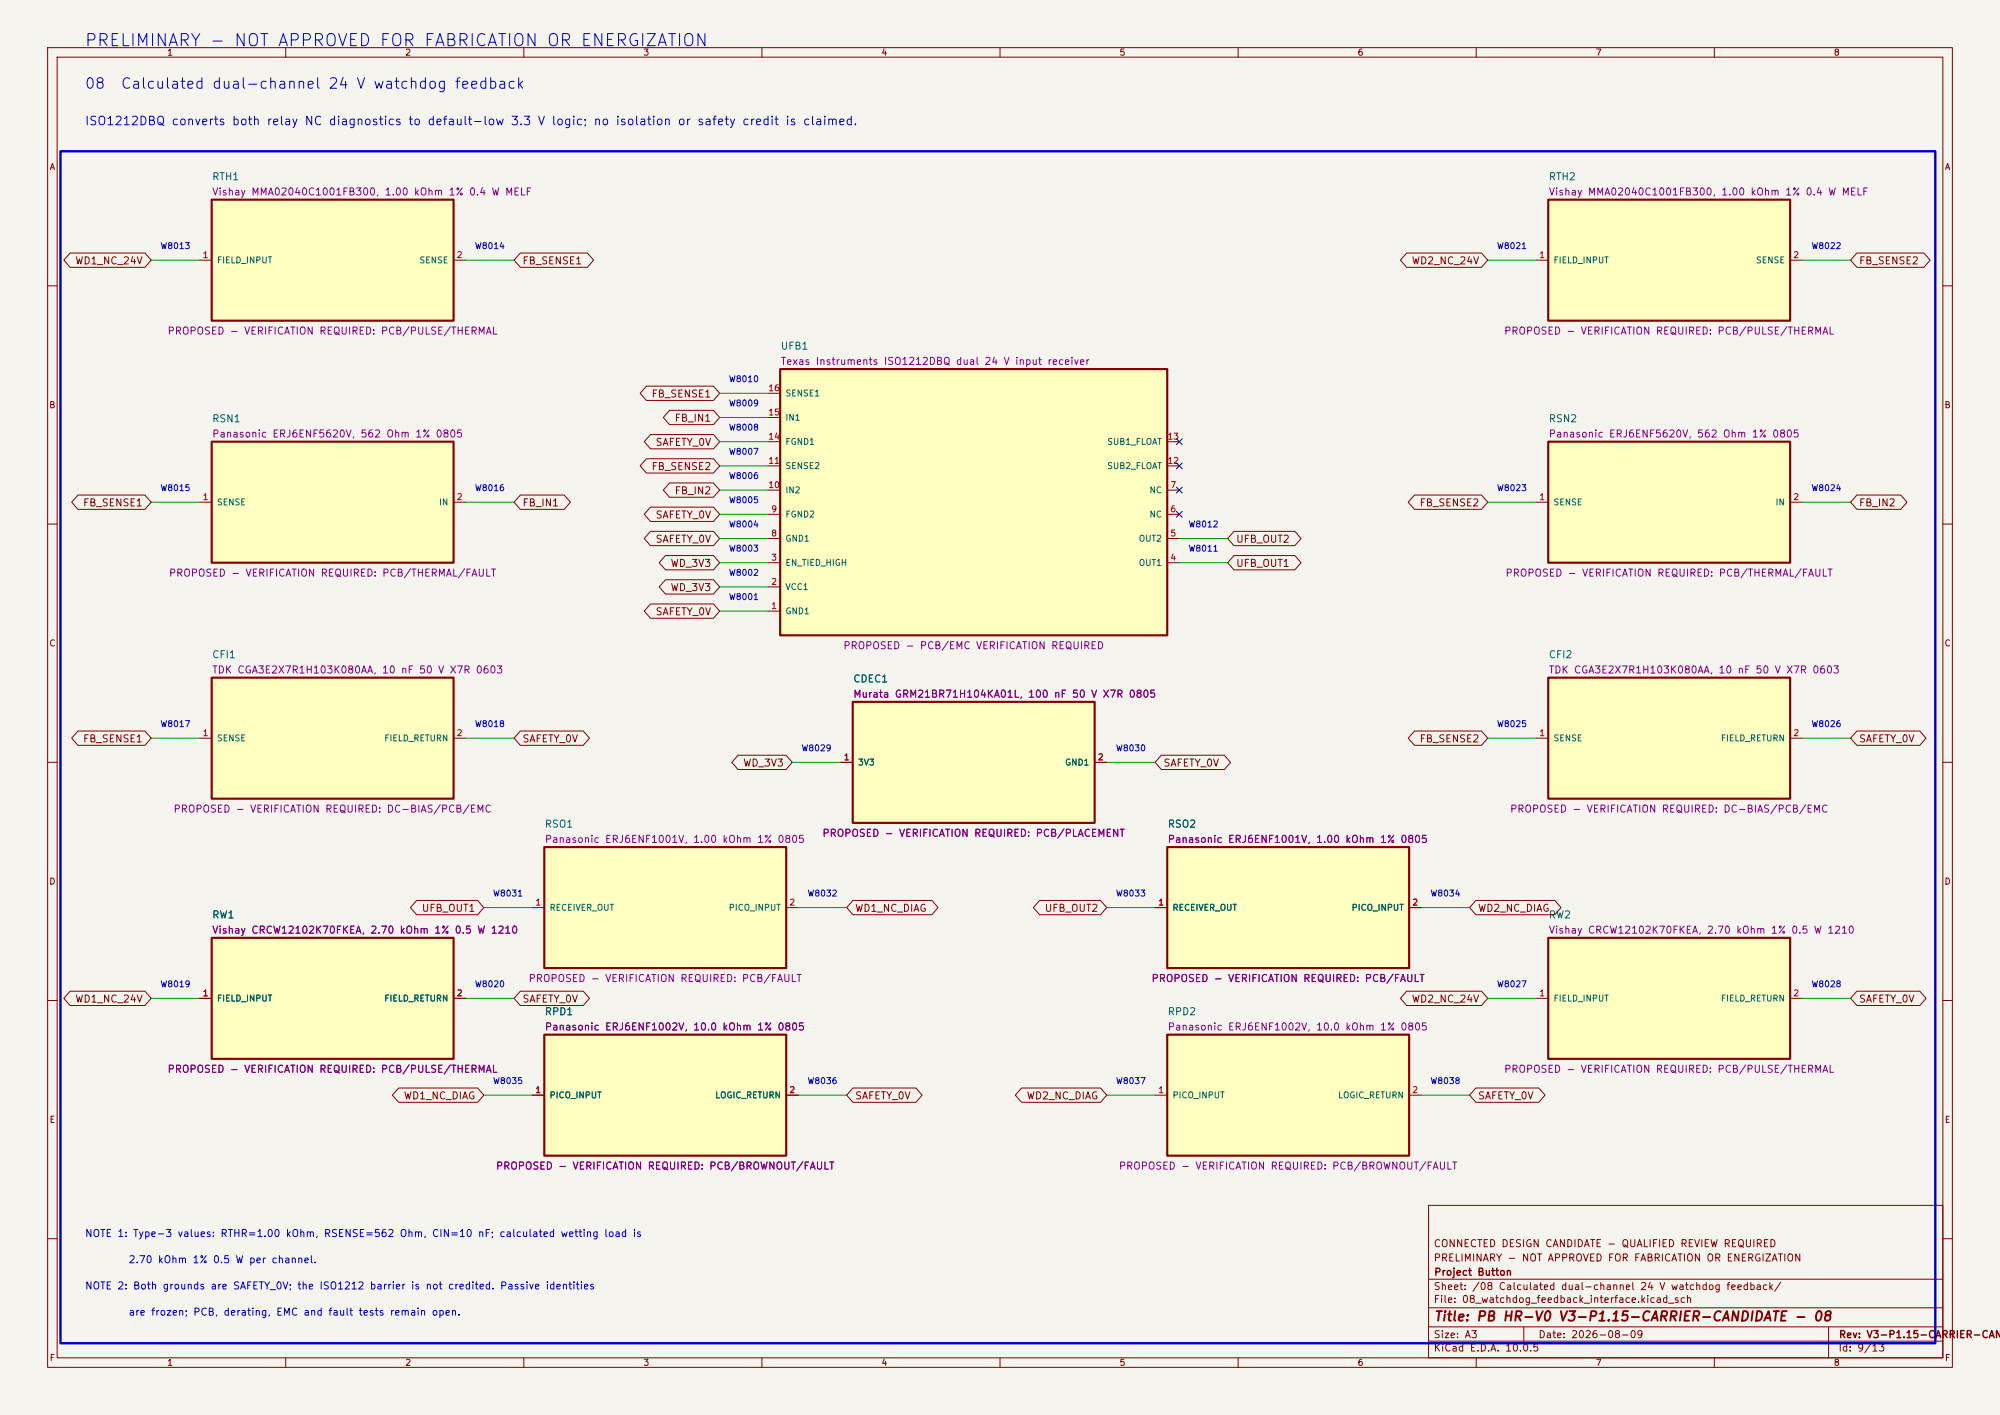
[picture p245: page 9]

08 Calculated dual-channel 24 V watchdog feedback

ISO1212DBQ converts both relay NC diagnostics to default-low 3.3 V logic; no isolation or safety credit is claimed.

PROPOSED - VERIFICATION REQUIRED: PCB/PULSE/THERMAL

PROPOSED - VERIFICATION REQUIRED: PCB/THERMAL/FAULT

PROPOSED - PCB/EMC VERIFICATION REQUIRED

PROPOSED - VERIFICATION REQUIRED: DC-BIAS/PCB/EMC

PROPOSED - VERIFICATION REQUIRED: PCB/PLACEMENT

W8034 are frozen; PCB, derating, EMC and fault tests remain open.

PROPOSED - VERIFICATION REQUIRED: PCB/FAULT

PROPOSED - VERIFICATION REQUIRED: PCB/BROWNOUT/FAULT

CONNECTED DESIGN CANDIDATE - QUALIFIED REVIEW REQUIRED PRELIMINARY - NOT APPROVED FOR FABRICATION OR ENERGIZATION Project Button

Sheet: /08 Calculated dual-channel 24 V watchdog feedback/ File: 08_watchdog_feedback_interface.kicad_sch

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
PRELIMINARY - NOT APPROVED FOR FABRICATION OR ENERGIZATION Project Button

Sheet: /09 Compute and control terminals/ File: 09_compute_and_control_terminals.kicad_sch

CONNECTED DESIGN CANDIDATE - QUALIFIED REVIEW REQUIRED +24V XT1-01

0V XT1-02

SR1_STATUSXT1-03

SRA1_STATUSXT1-04 K1_STATUSXT1-05 K2_STATUSXT1-06 XT1

PROPOSED - ORDER CODES AND POSITION TERMINALS FROZEN; CONDUCTOR/PROTECTION/PHYSICAL VERIFICATION REQUIRED

Phoenix PT 2,5 six-position terminal group: 5x 3209510 gray, 1x 3209523 blue, 1x 3030417 end cover, 2x 3022218 end brackets, 1x 0828734 marker sheet GPIO_HEADER_GND HDR40-6 | GPIO17_HEARTBEAT_OUT HDR40-11 USB-C_POWER_RETURN USB-C-GND +5V_INPUT USB-C-VBUS | USB_TO_U2D2 USB-U2D2 PI1

EXACT CANDIDATE - GPIO PIN FROZEN; COOLING/STORAGE/RUNTIME/RETENTION OPEN

Raspberry Pi 5 8GB unit-only high-level compute, SC1112

K1_STATUS

SRA1_STATUS

SR1_STATUS

SAFETY_24V

K2_STATUS

COMPUTE_5V

COMPUTE_0V

COMPUTE_0V

SAFETY_0V

PI_USB_U2D2

PI_HEARTBEAT

## 09 Compute and control terminals

High-level compute and diagnostic wiring have no authority to bypass or restore the safety chain. W9003 W9001 PRELIMINARY - NOT APPROVED FOR FABRICATION OR ENERGIZATION

W9002

torque and enclosure layout remain selection required.

W9011 W9006 NOTE 3: Heartbeat cable, GPIO runtime, timing, terminal family, markers, conductor range,

W9007 | W9010 NOTE 2: Debug connection, halt, flash and disconnect must not enable outputs, back-power the

W9004

board or bypass a protective function.

W9008 W9009 W9005

under a future controlled unpowered-fixture procedure.

NOTE 1: No installed debug connector exists; watchdog programming uses only TP15/TP16/TP2

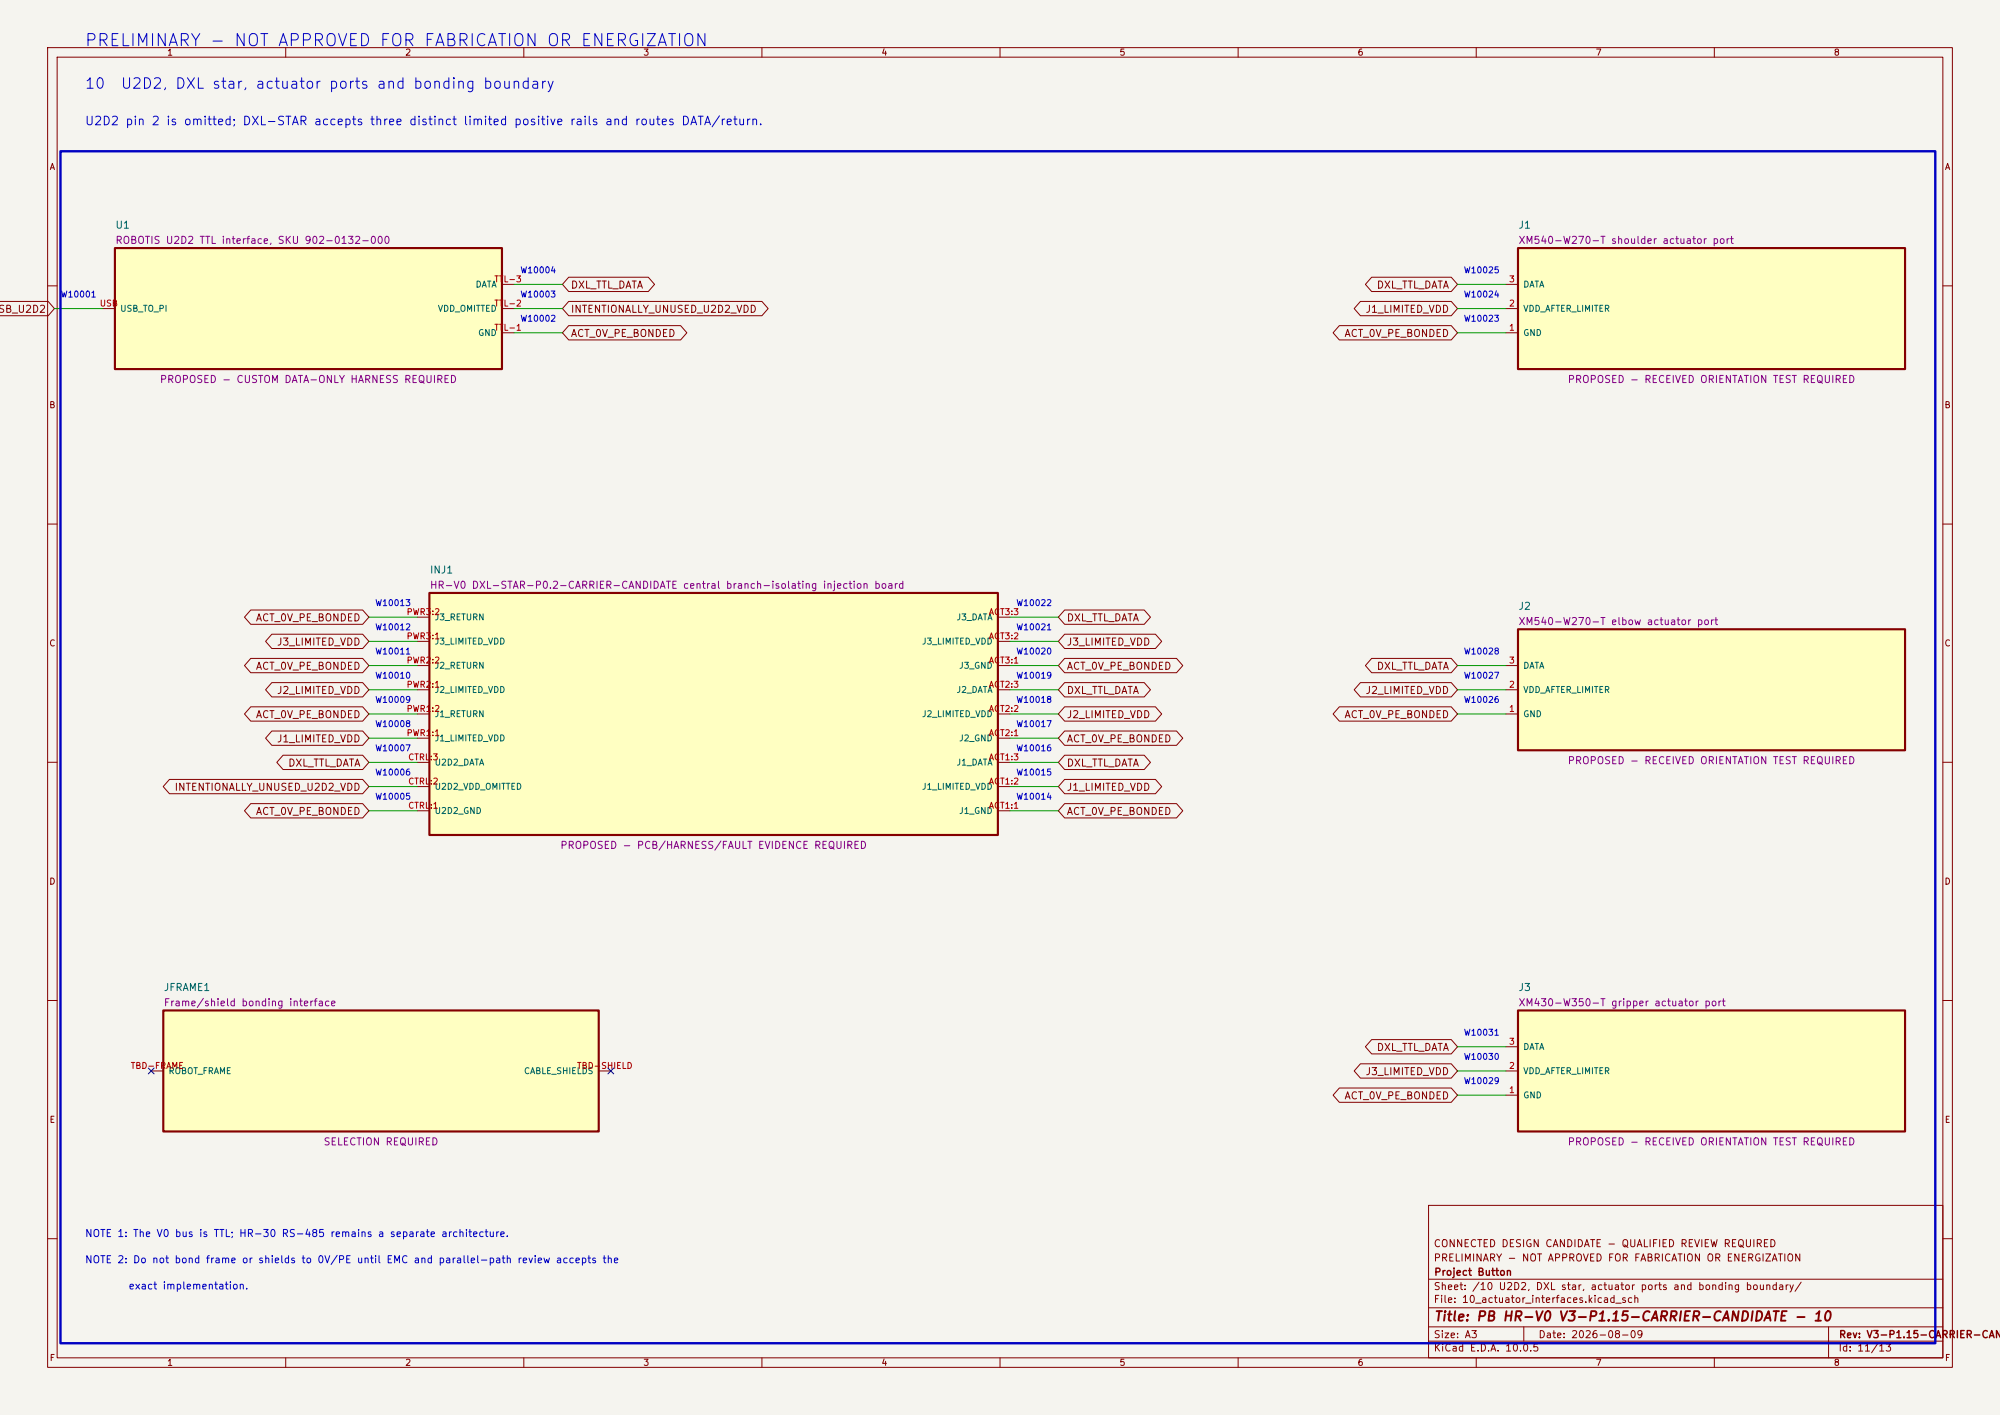
[picture p246: page 11]

PRELIMINARY - NOT APPROVED FOR FABRICATION OR ENERGIZATION

10 U2D2, DXL star, actuator ports and bonding boundary

VDD_OMITTEDTTL-2 DATATTL-3 USB_TO_PI USBU1
ROBOTIS U2D2 TTL interface, SKU 902-0132-000

W10023 W10011 W10009 NOTE 1: The V0 bus is TTL; HR-30 RS-485 remains a separate architecture.

PROPOSED - CUSTOM DATA-ONLY HARNESS REQUIRED

PROPOSED - RECEIVED ORIENTATION TEST REQUIRED

INJ1
HR-V0 DXL-STAR-P0.2-CARRIER-CANDIDATE central branch-isolating injection board

PROPOSED - PCB/HARNESS/FAULT EVIDENCE REQUIRED

JFRAME1
Frame/shield bonding interface

CONNECTED DESIGN CANDIDATE - QUALIFIED REVIEW REQUIRED PRELIMINARY - NOT APPROVED FOR FABRICATION OR ENERGIZATION Project Button

NOTE 2: Do not bond frame or shields to 0V/PE until EMC and parallel-path review accepts the

Sheet: /10 U2D2, DXL star, actuator ports and bonding boundary/ File: 10_actuator_interfaces.kicad_sch

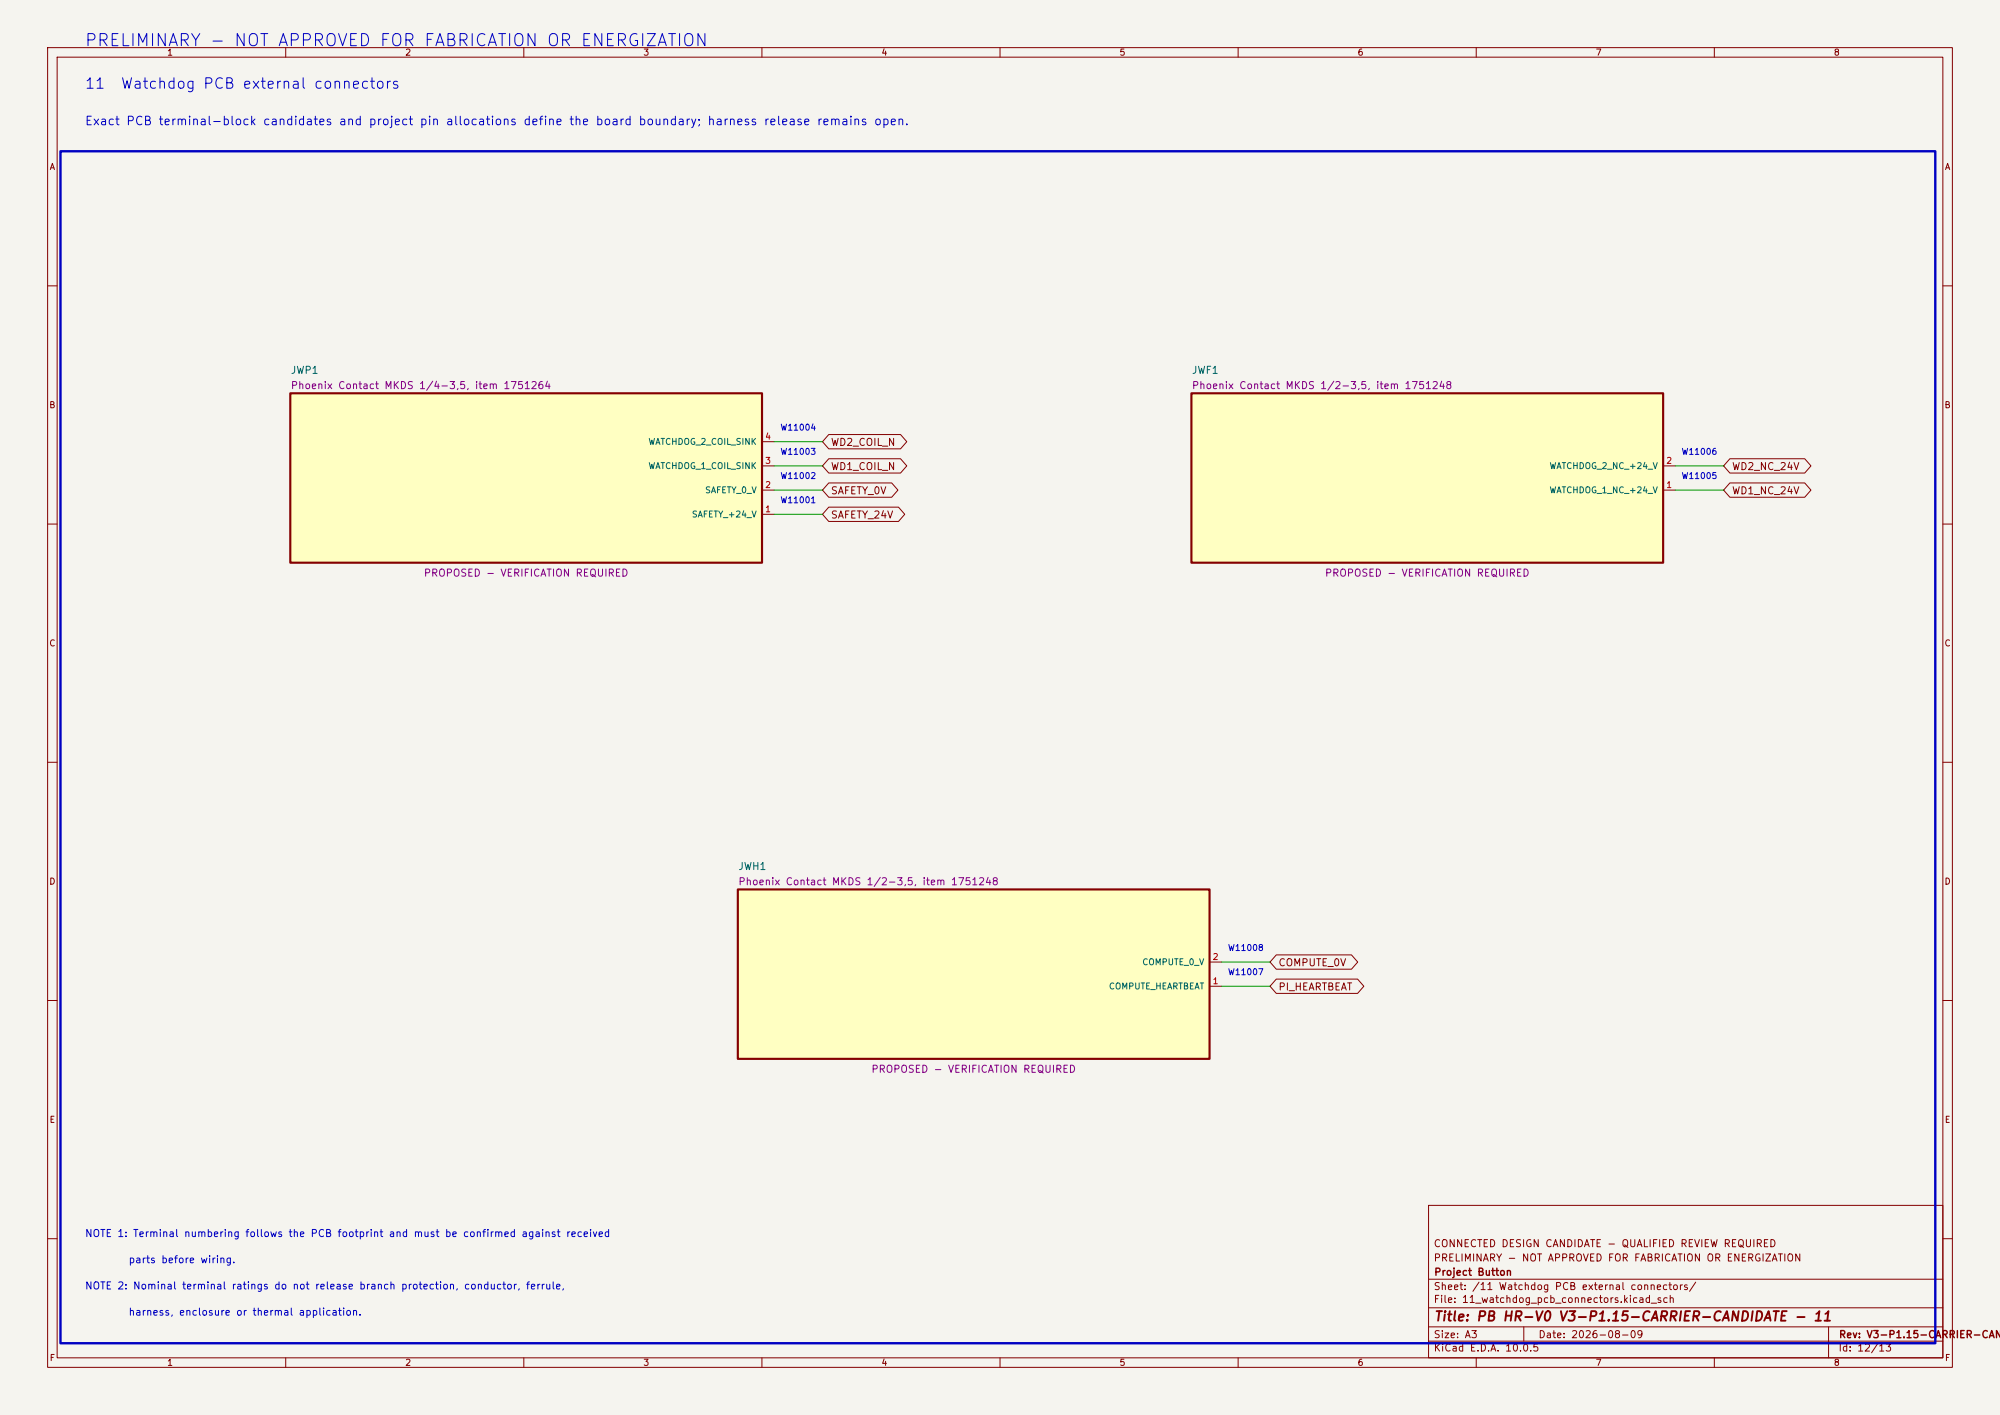
[picture p247: page 12]

PRELIMINARY - NOT APPROVED FOR FABRICATION OR ENERGIZATION

11 Watchdog PCB external connectors

JWP1
Phoenix Contact MKDS 1/4-3,5, item 1751264

JWF1
Phoenix Contact MKDS 1/2-3,5, item 1751248

JWH1

NOTE 1: Terminal numbering follows the PCB footprint and must be confirmed against received

CONNECTED DESIGN CANDIDATE - QUALIFIED REVIEW REQUIRED PRELIMINARY - NOT APPROVED FOR FABRICATION OR ENERGIZATION Project Button

NOTE 2: Nominal terminal ratings do not release branch protection, conductor, ferrule,

Sheet: /11 Watchdog PCB external connectors/ File: 11_watchdog_pcb_connectors.kicad_sch

harness, enclosure or thermal application.

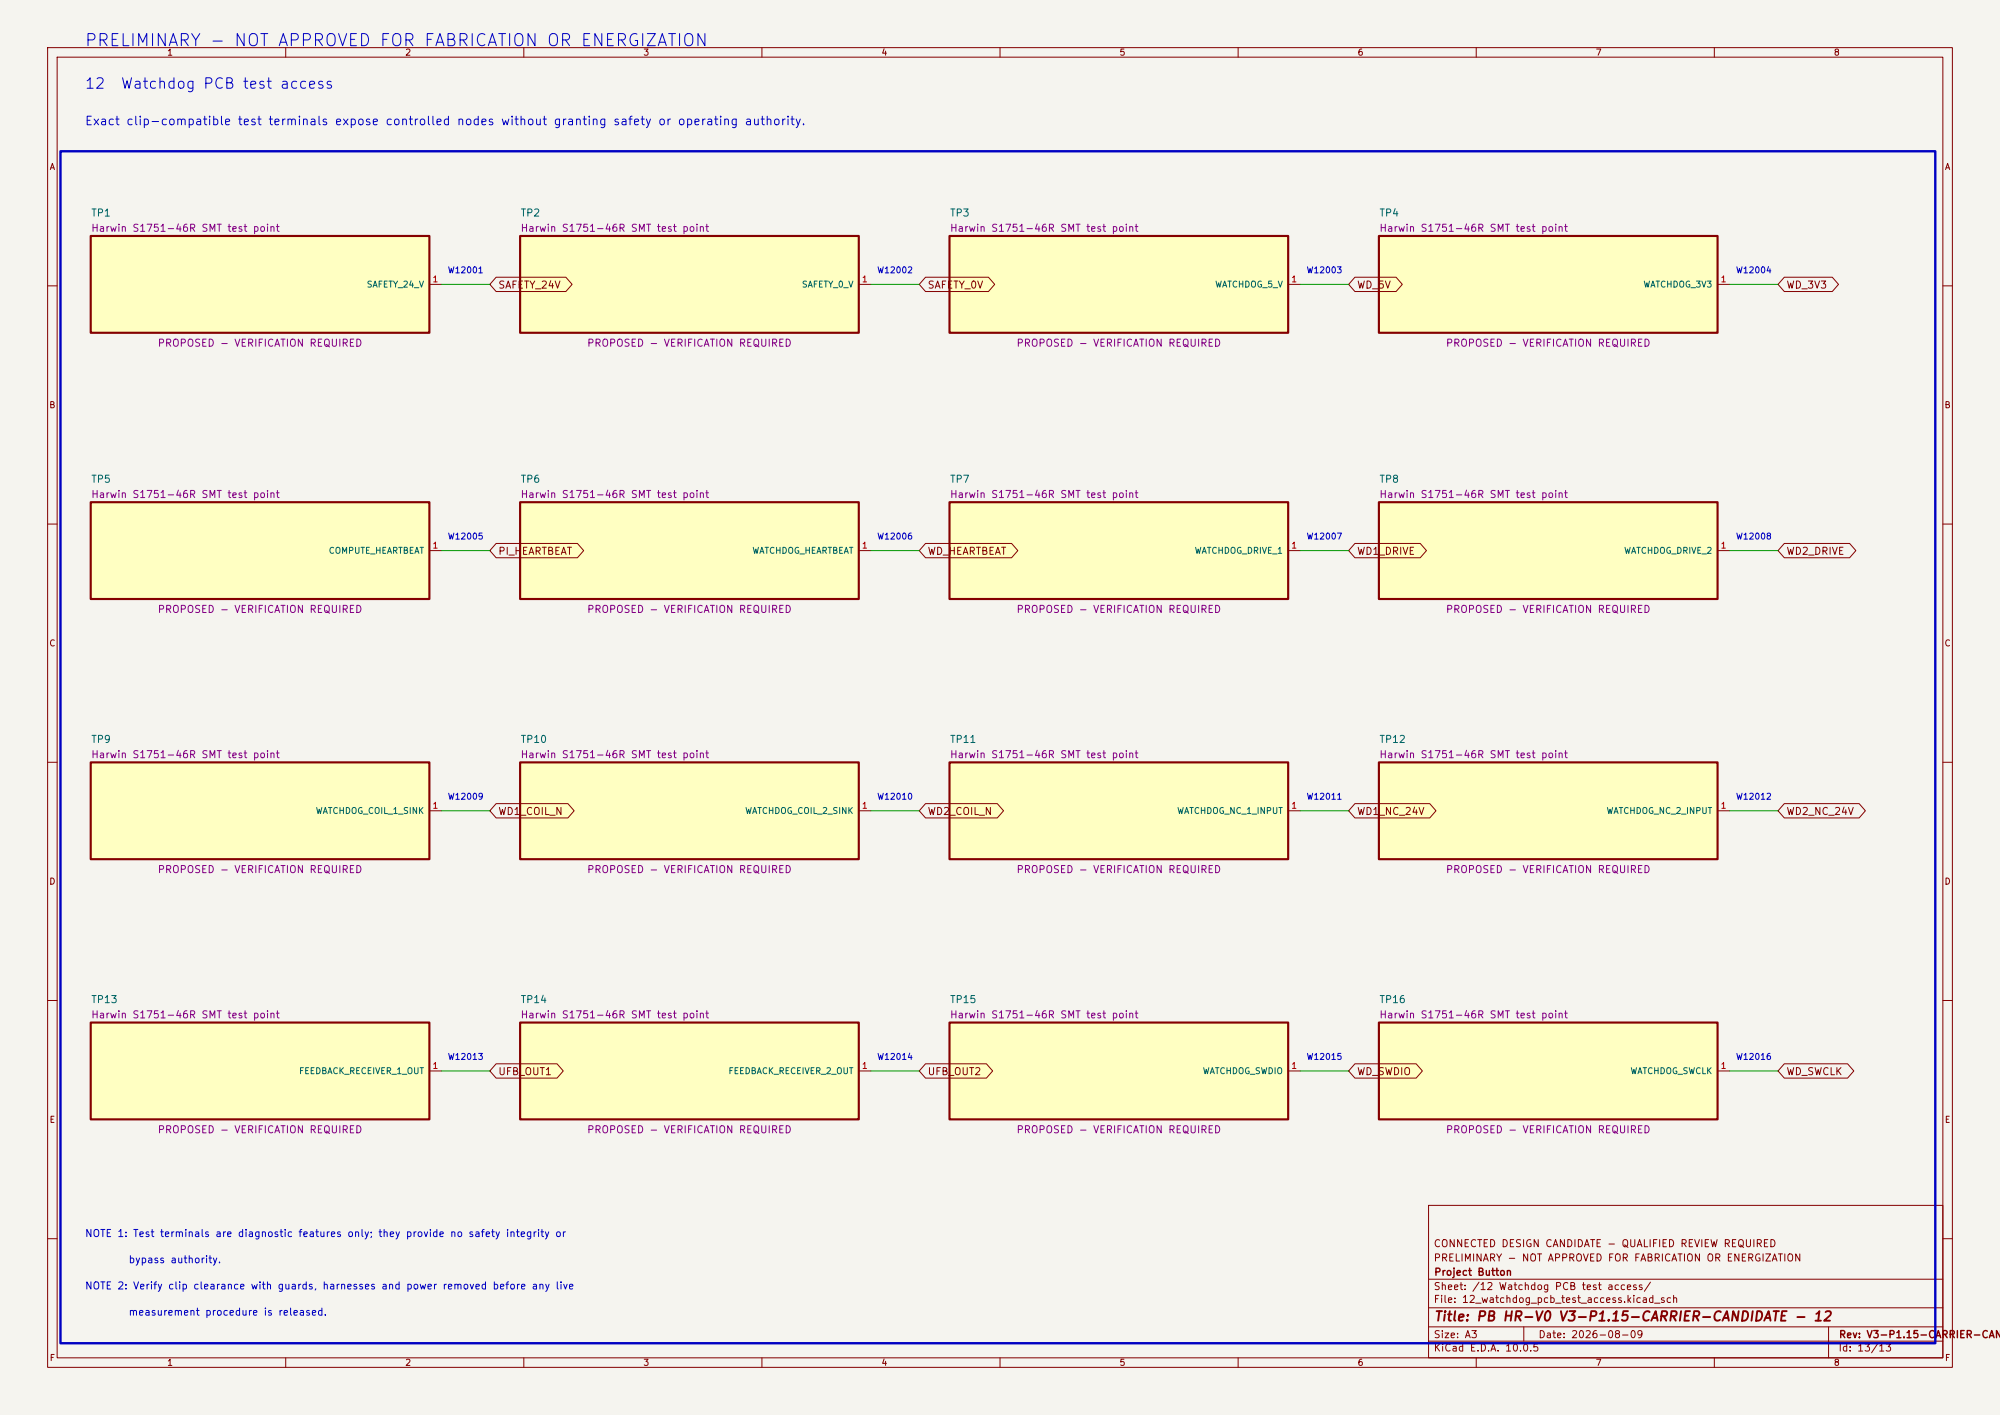
[picture p248: page 13]

W12014 W12010 PRELIMINARY - NOT APPROVED FOR FABRICATION OR ENERGIZATION

12 Watchdog PCB test access

Exact clip-compatible test terminals expose controlled nodes without granting safety or operating authority.

Harwin S1751-46R SMT test point

NOTE 1: Test terminals are diagnostic features only; they provide no safety integrity or

CONNECTED DESIGN CANDIDATE - QUALIFIED REVIEW REQUIRED PRELIMINARY - NOT APPROVED FOR FABRICATION OR ENERGIZATION Project Button

NOTE 2: Verify clip clearance with guards, harnesses and power removed before any live

Sheet: /12 Watchdog PCB test access/ File: 12_watchdog_pcb_test_access.kicad_sch

measurement procedure is released.
