amyleesterling/humanoid-robot/release/hr-v0/dxl-protection-carrier-p0.1/output/hr-v0-dxl-protection-carrier-preliminary.pdf

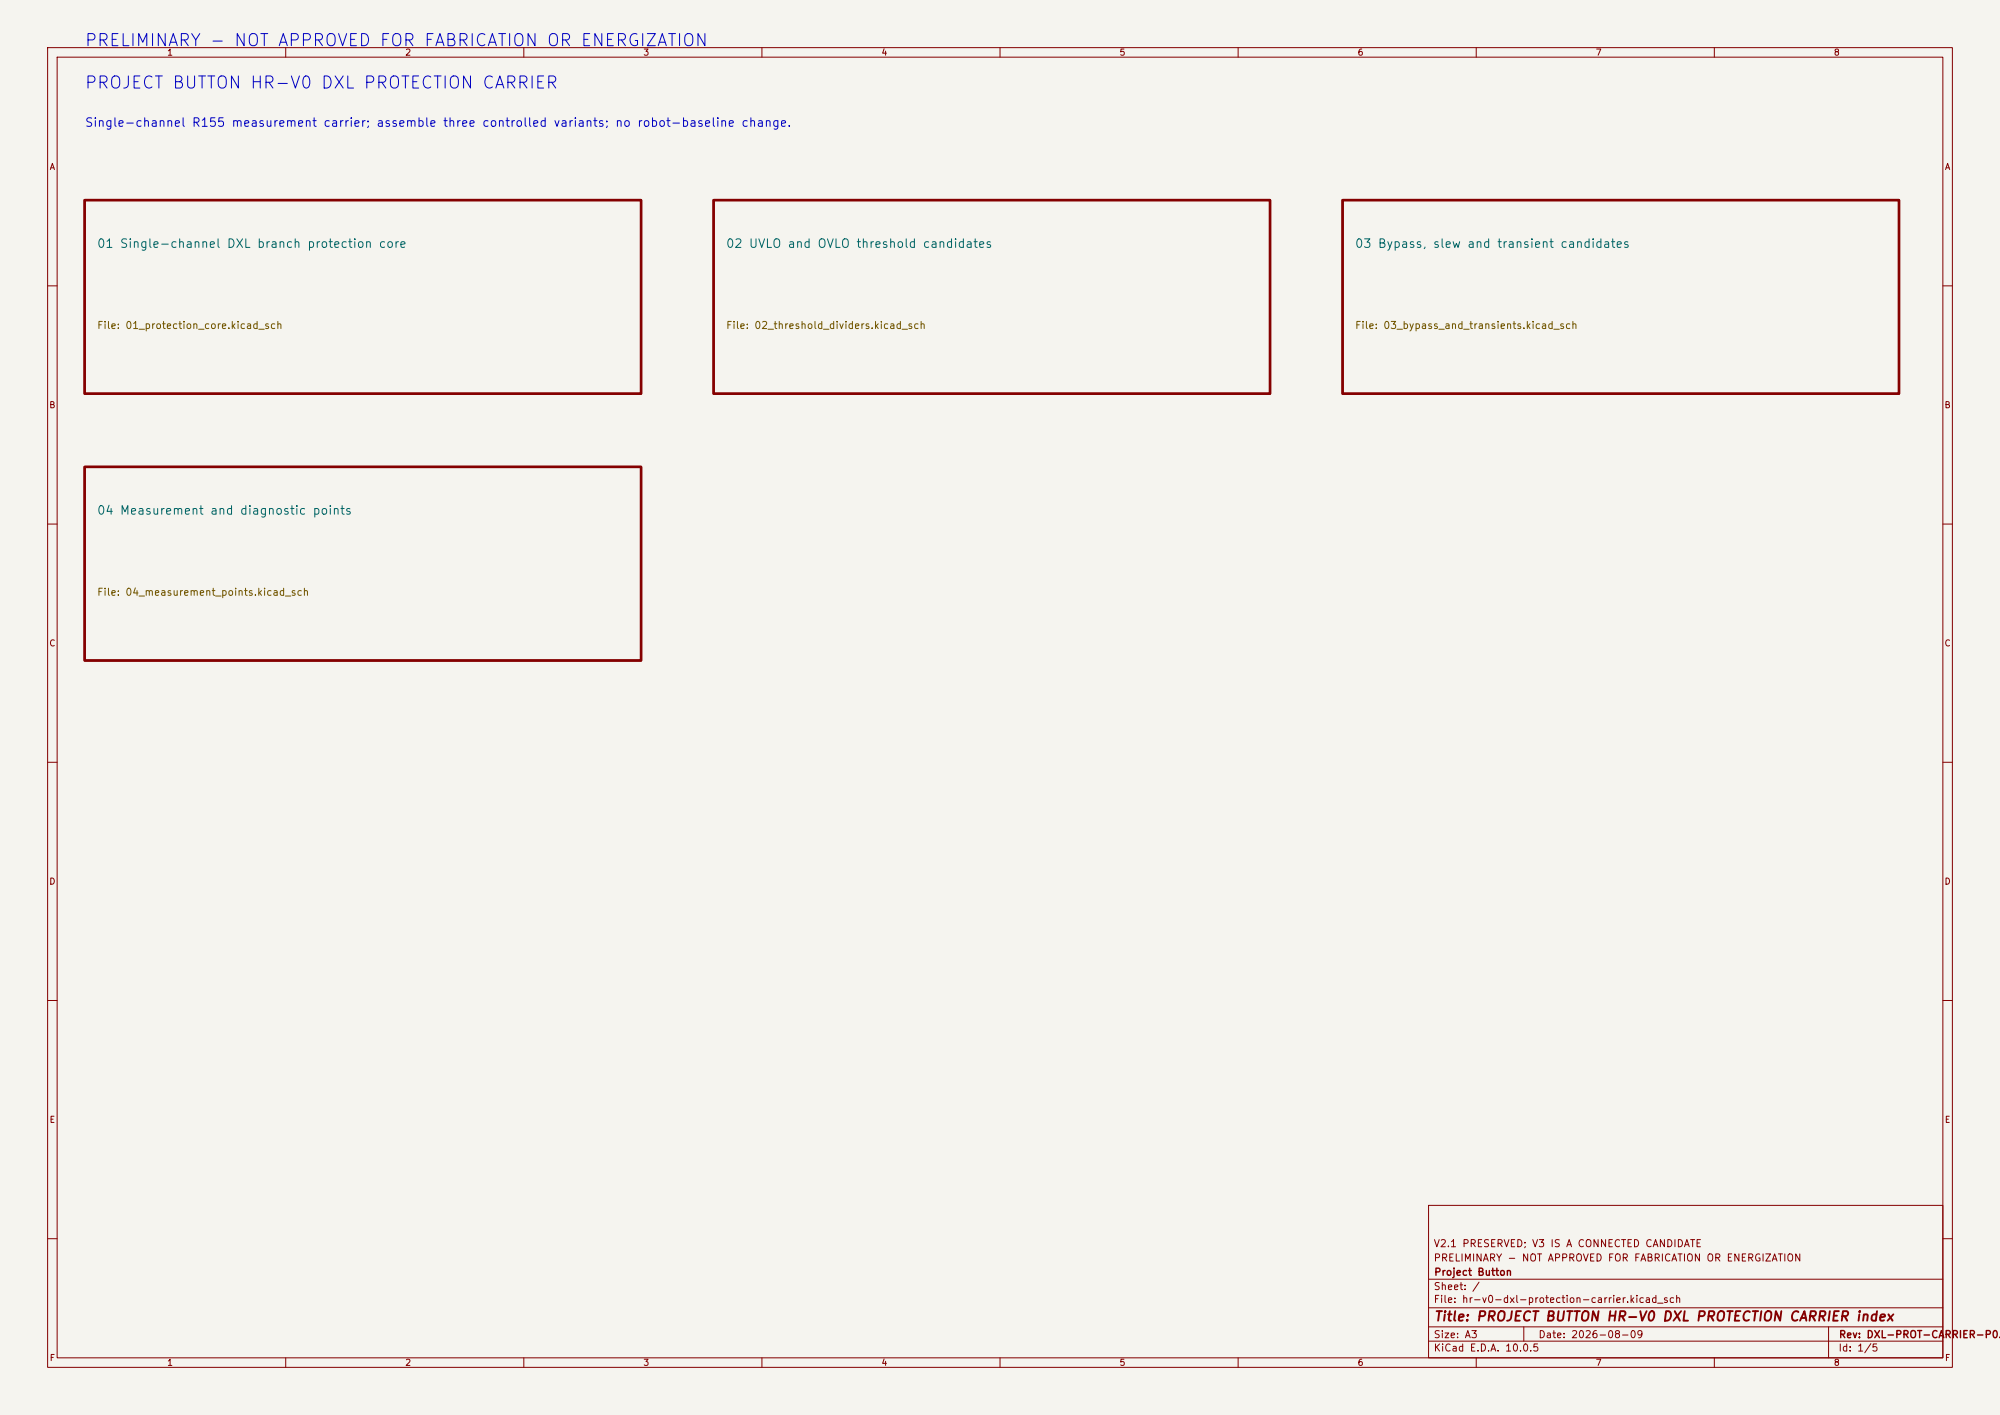
[picture p261: page 1]

PRELIMINARY - NOT APPROVED FOR FABRICATION OR ENERGIZATION

PROJECT BUTTON HR-V0 DXL PROTECTION CARRIER

Single-channel R155 measurement carrier; assemble three controlled variants; no robot-baseline change.

01 Single-channel DXL branch protection core

02 UVLO and OVLO threshold candidates

03 Bypass, slew and transient candidates

04 Measurement and diagnostic points

V2.1 PRESERVED; V3 IS A CONNECTED CANDIDATE
Project Button
Sheet: /
File: hr-v0-dxl-protection-carrier.kicad_sch
Title: PROJECT BUTTON HR-V0 DXL PROTECTION CARRIER index

F Date: 2026-08-09

KiCad E.D.A. 10.0.5 | Id: 1/5

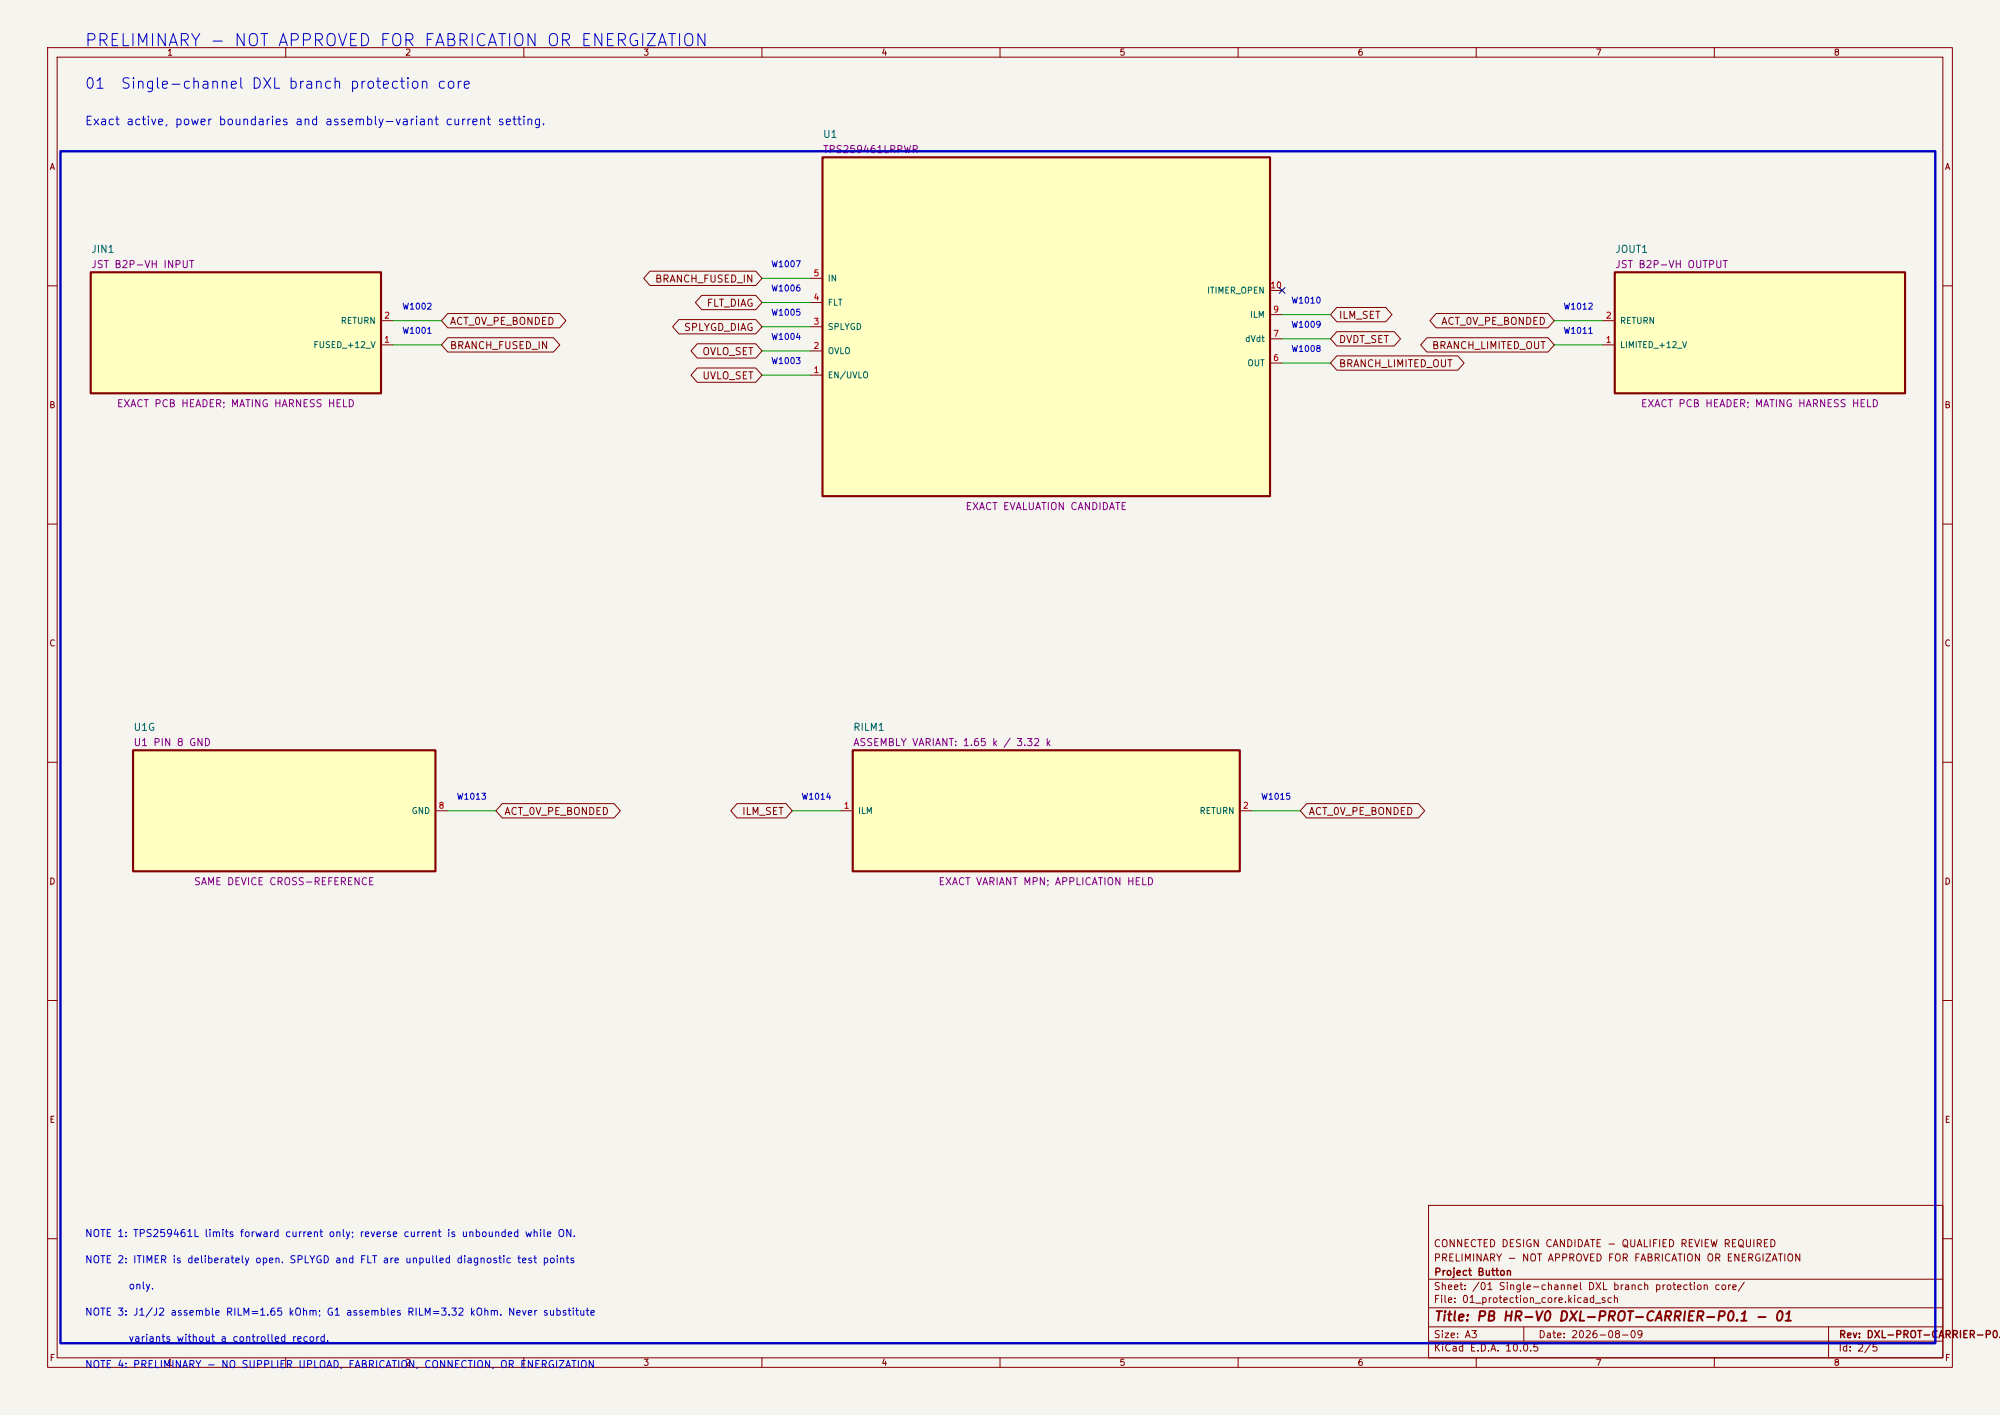
[picture p262: page 2]

W1004 W1001 PRELIMINARY - NOT APPROVED FOR FABRICATION OR ENERGIZATION

01 Single-channel DXL branch protection core

EXACT PCB HEADER; MATING HARNESS HELD

SAME DEVICE CROSS-REFERENCE

EXACT VARIANT MPN; APPLICATION HELD

NOTE 1: TPS259461L limits forward current only; reverse current is unbounded while ON.

CONNECTED DESIGN CANDIDATE - QUALIFIED REVIEW REQUIRED PRELIMINARY - NOT APPROVED FOR FABRICATION OR ENERGIZATION Project Button

NOTE 2: ITIMER is deliberately open. SPLYGD and FLT are unpulled diagnostic test points

Sheet: /01 Single-channel DXL branch protection core/ File: 01_protection_core.kicad_sch

NOTE 3: J1/J2 assemble RILM=1.65 kOhm; G1 assembles RILM=3.32 kOhm. Never substitute

Title: PB HR-V0 DXL-PROT-CARRIER-P0.1 - 01

variants without a controlled record.

NOTE 4: PRELIMINARY - NO SUPPLIER UPLOAD, FABRICATION, CONNECTION, OR ENERGIZATION

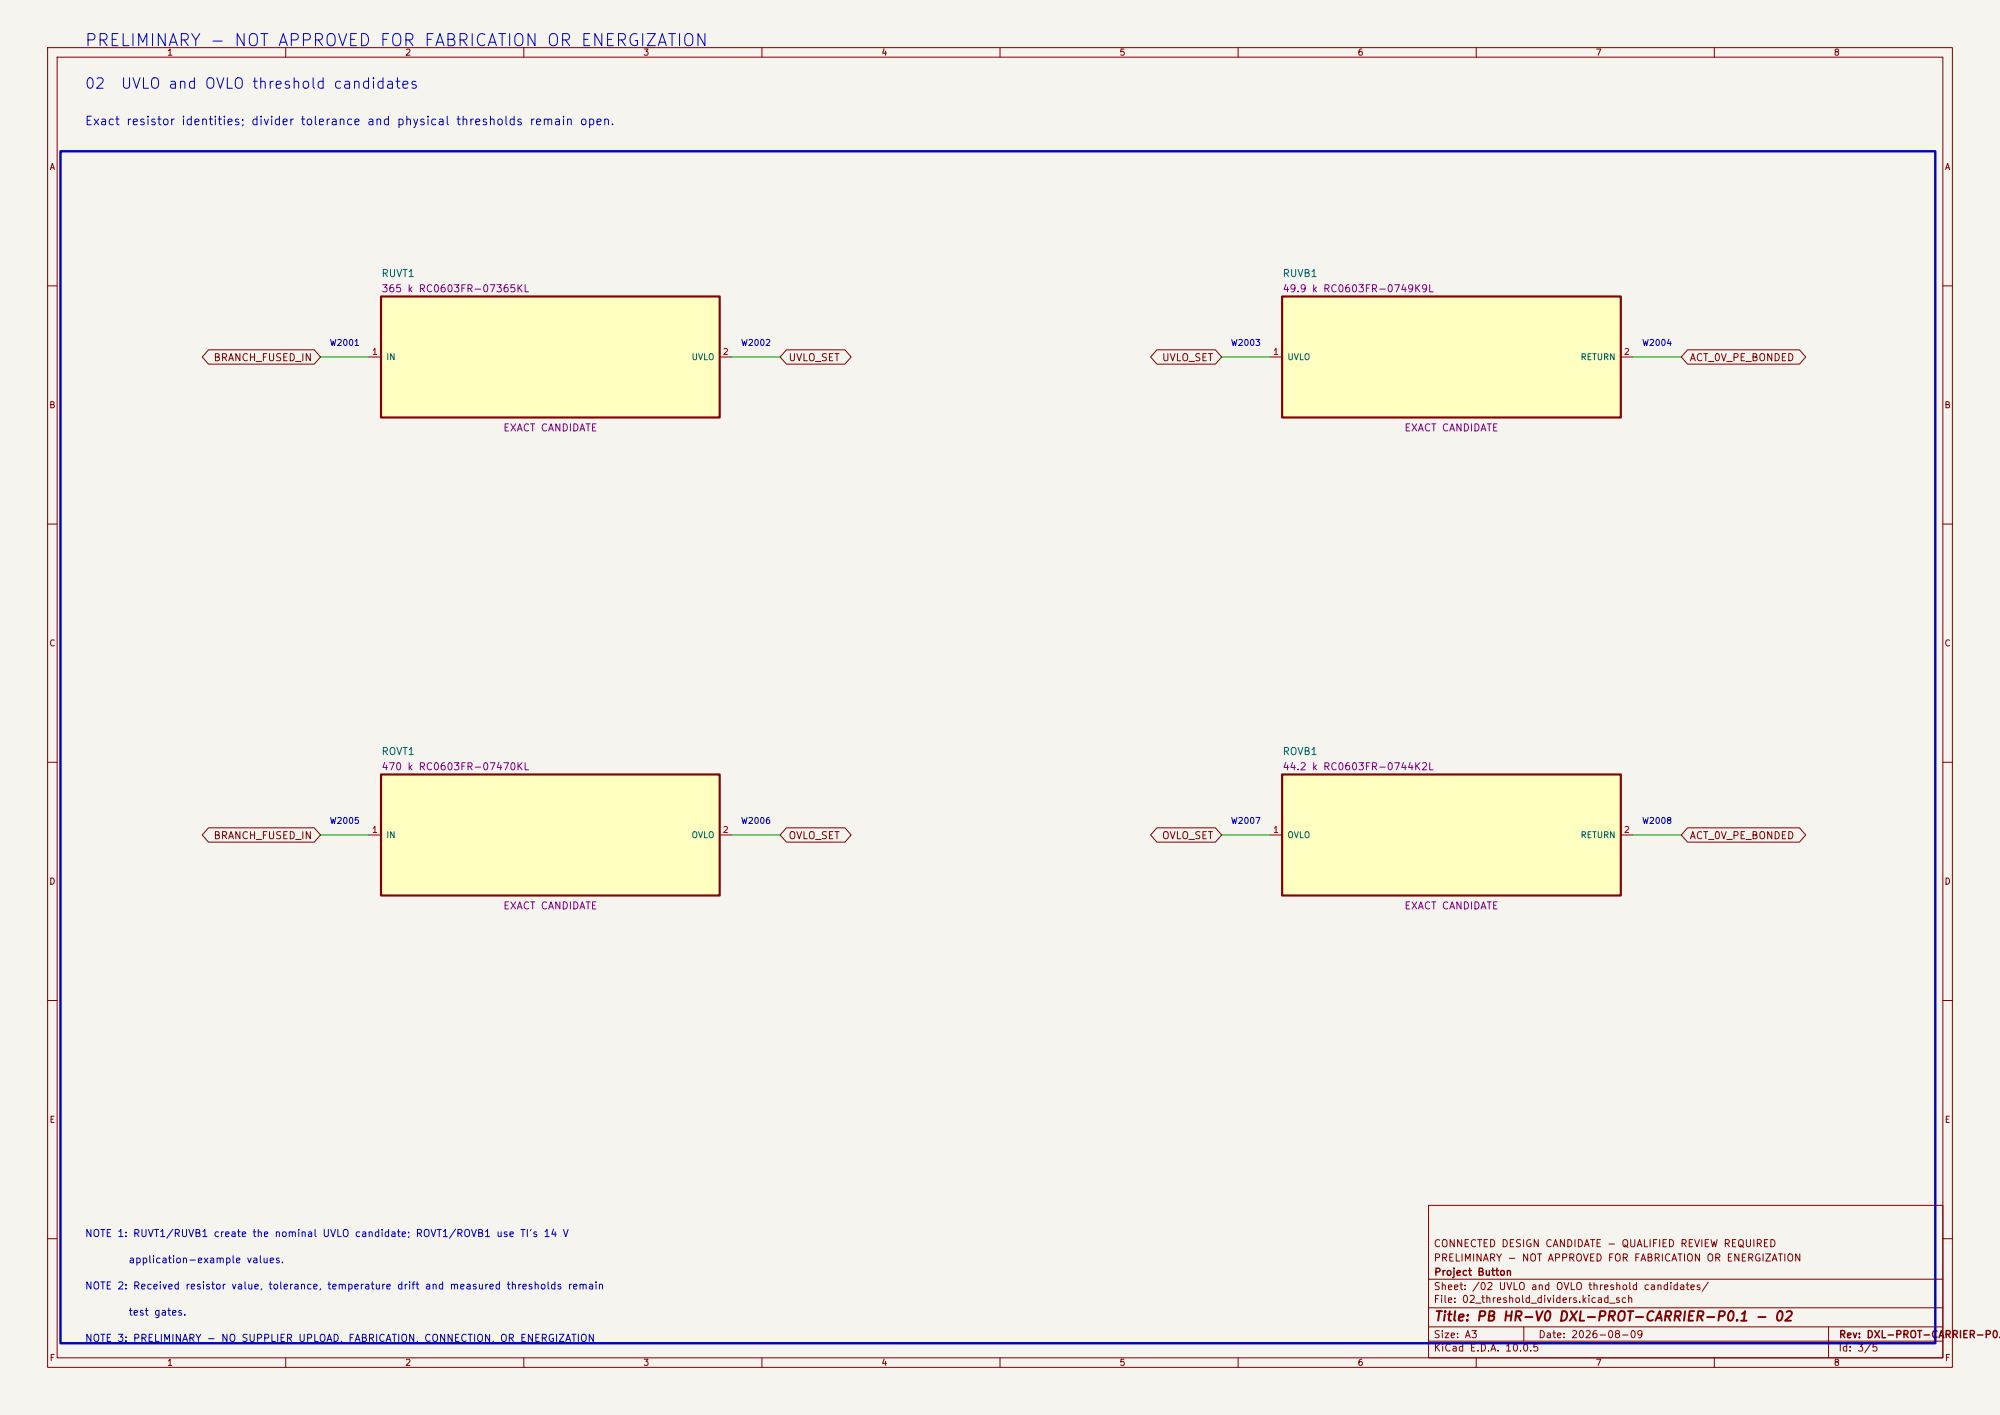
[picture p263: page 3]

W2008 W2002 PRELIMINARY - NOT APPROVED FOR FABRICATION OR ENERGIZATION

02 UVLO and OVLO threshold candidates

CONNECTED DESIGN CANDIDATE - QUALIFIED REVIEW REQUIRED PRELIMINARY - NOT APPROVED FOR FABRICATION OR ENERGIZATION Project Button

NOTE 2: Received resistor value, tolerance, temperature drift and measured thresholds remain

Sheet: /02 UVLO and OVLO threshold candidates/ File: 02_threshold_dividers.kicad_sch

NOTE 3: PRELIMINARY - NO SUPPLIER UPLOAD, FABRICATION, CONNECTION, OR ENERGIZATION

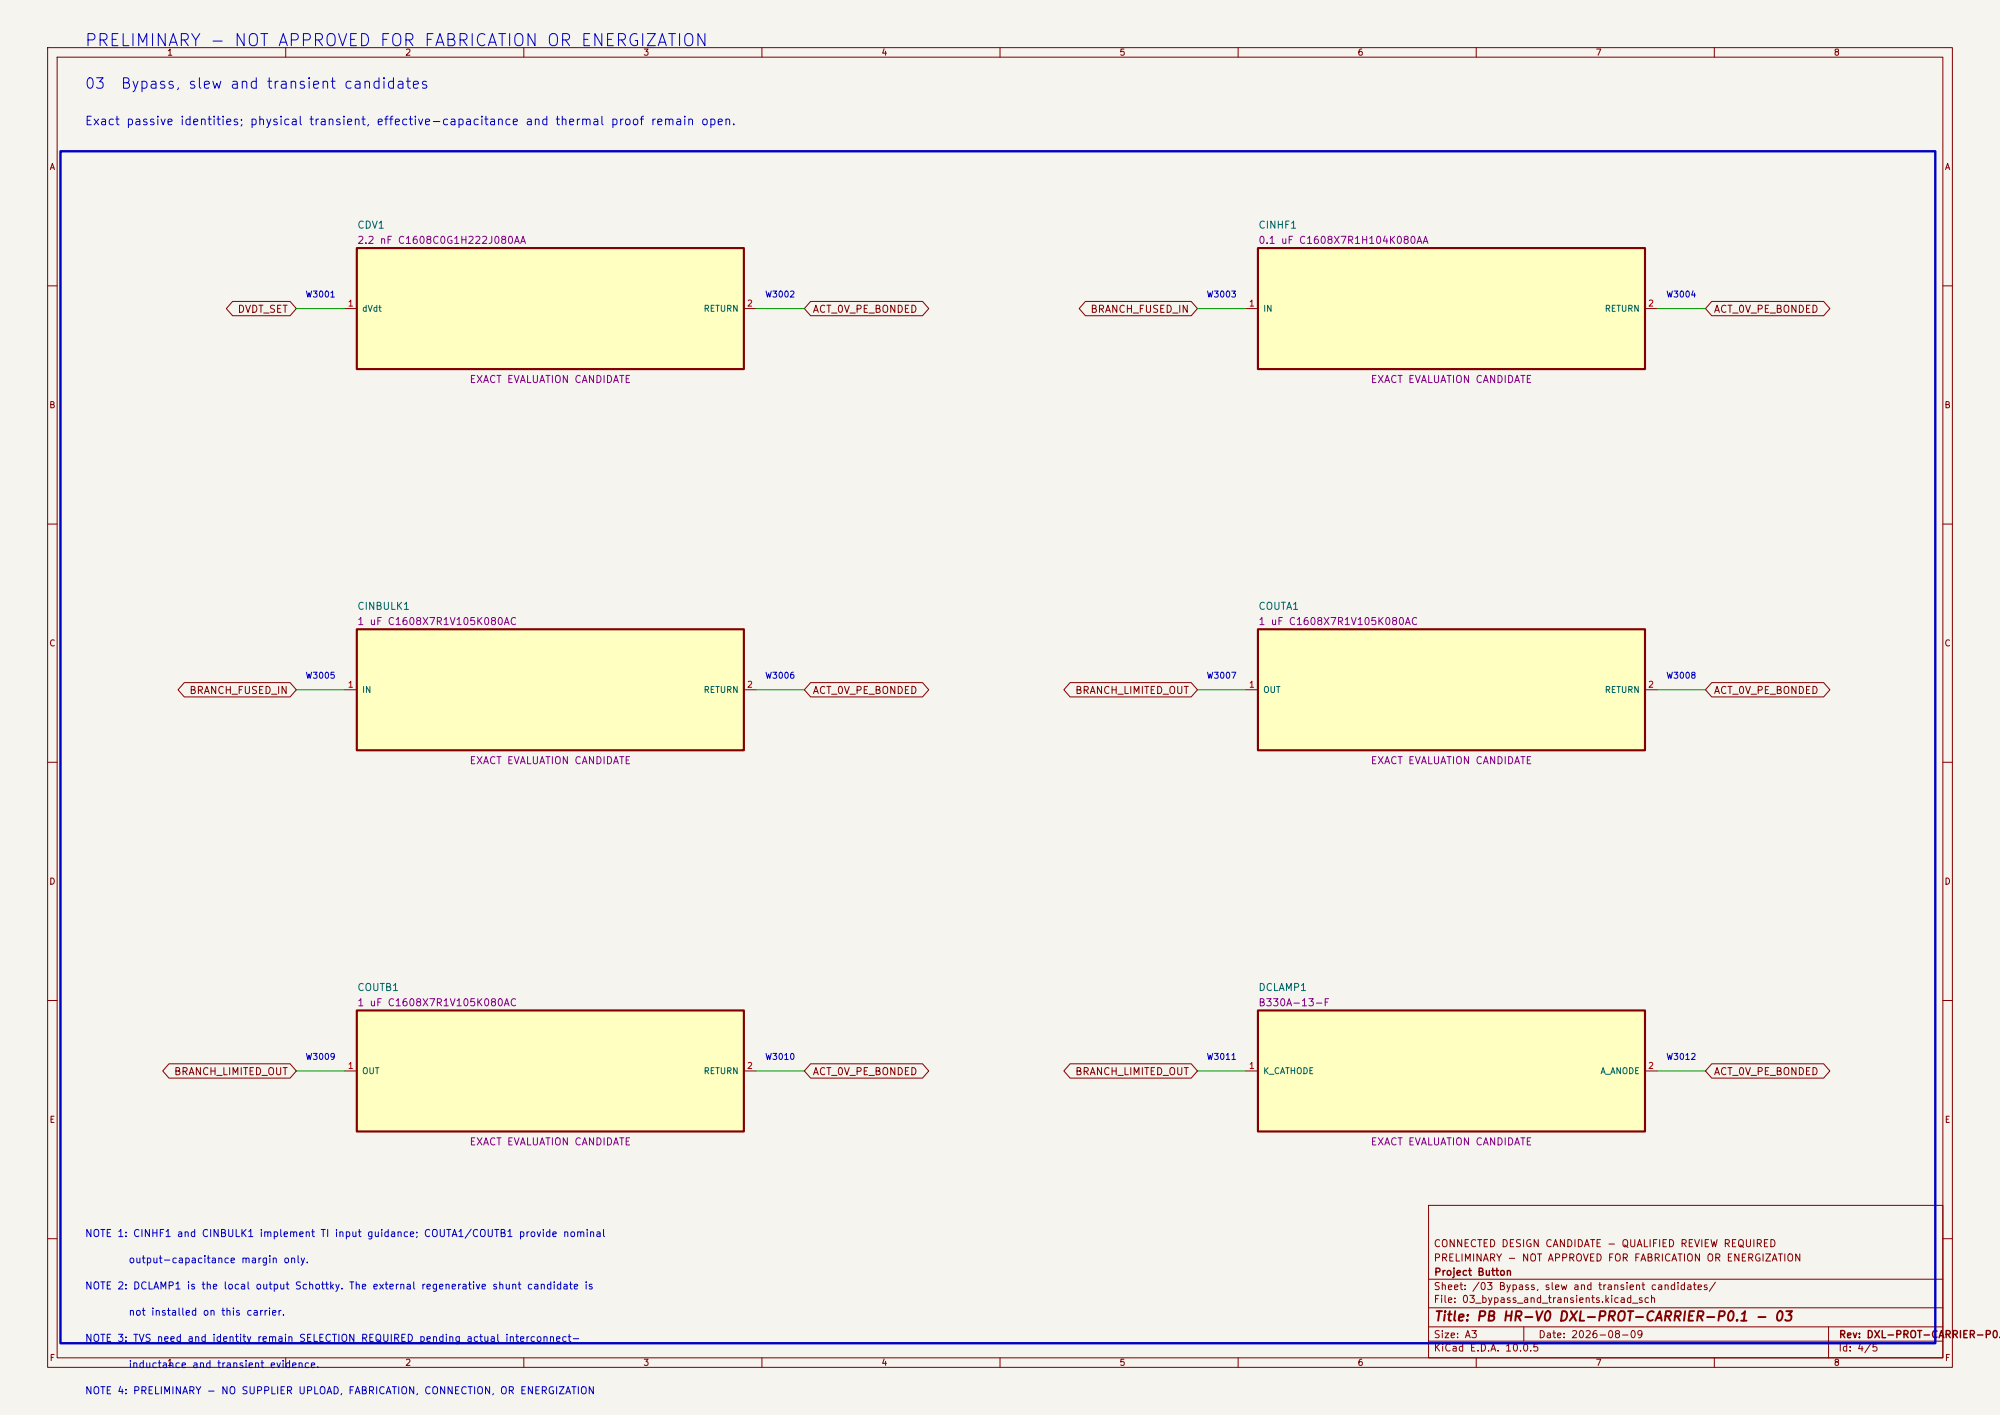
[picture p264: page 4]

03 Bypass, slew and transient candidates

Exact passive identities; physical transient, effective-capacitance and thermal proof remain open. W3001

NOTE 1: CINHF1 and CINBULK1 implement TI input guidance; COUTA1/COUTB1 provide nominal W3009 output-capacitance margin only.

CONNECTED DESIGN CANDIDATE - QUALIFIED REVIEW REQUIRED PRELIMINARY - NOT APPROVED FOR FABRICATION OR ENERGIZATION Project Button

NOTE 2: DCLAMP1 is the local output Schottky. The external regenerative shunt candidate is

Sheet: /03 Bypass, slew and transient candidates/ File: 03_bypass_and_transients.kicad_sch

not installed on this carrier.

NOTE 3: TVS need and identity remain SELECTION REQUIRED pending actual interconnect-

inductance and transient evidence.

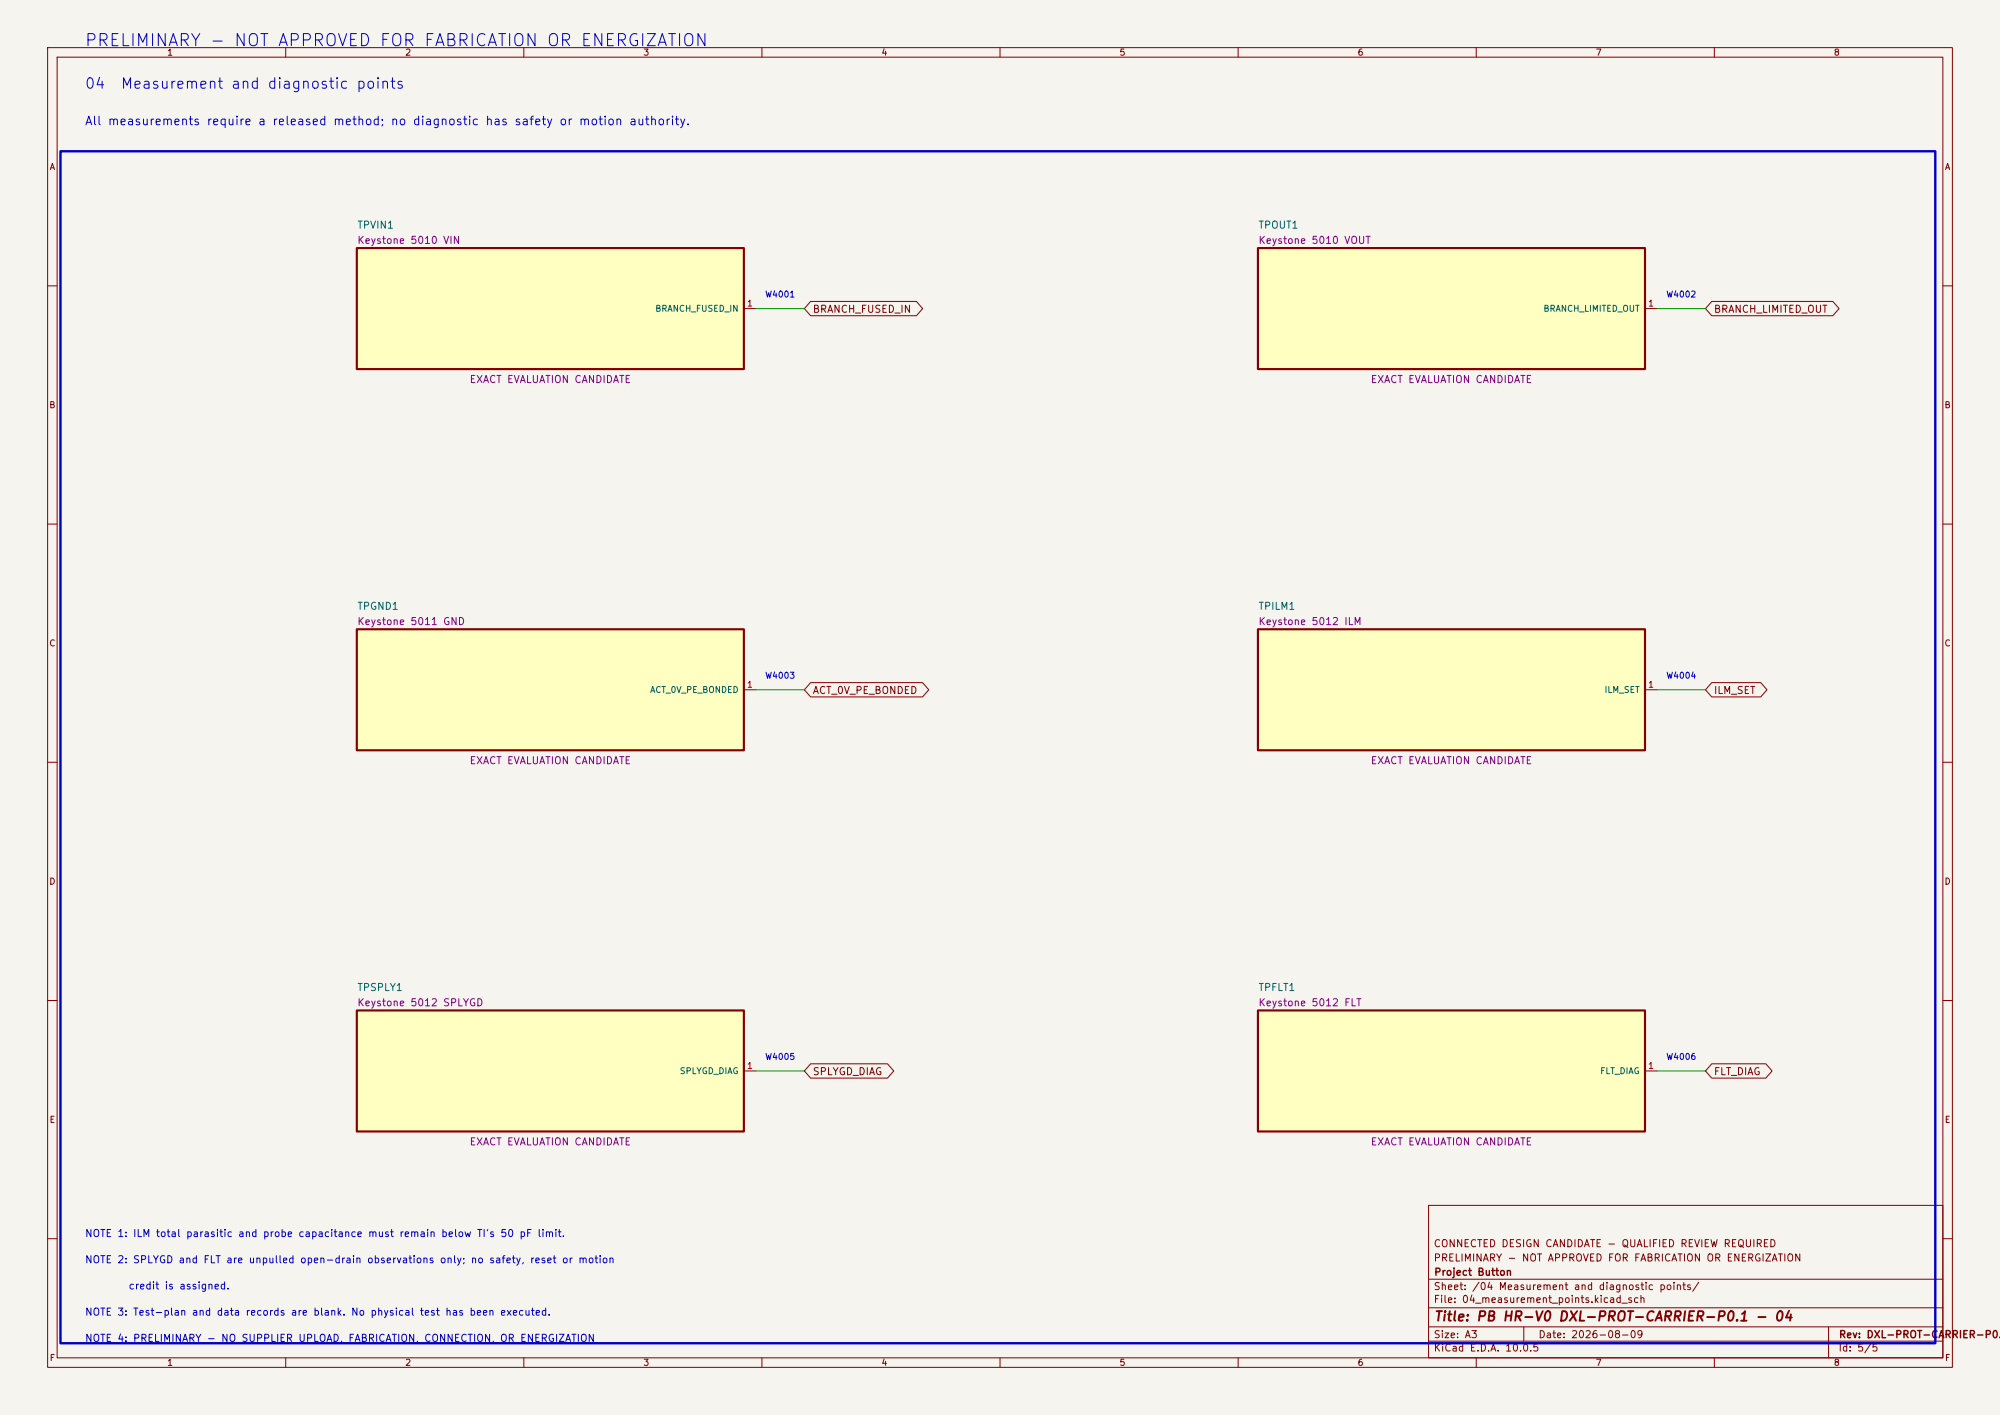
[picture p265: page 5]

PRELIMINARY - NOT APPROVED FOR FABRICATION OR ENERGIZATION

04 Measurement and diagnostic points

CONNECTED DESIGN CANDIDATE - QUALIFIED REVIEW REQUIRED PRELIMINARY - NOT APPROVED FOR FABRICATION OR ENERGIZATION Project Button

NOTE 2: SPLYGD and FLT are unpulled open-drain observations only; no safety, reset or motion

Sheet: /04 Measurement and diagnostic points/ File: 04_measurement_points.kicad_sch

NOTE 3: Test-plan and data records are blank. No physical test has been executed.
