amyleesterling/humanoid-robot/electrical/kicad/project-button-v2/output/pdf/project-button-electrical-v2-preliminary.pdf

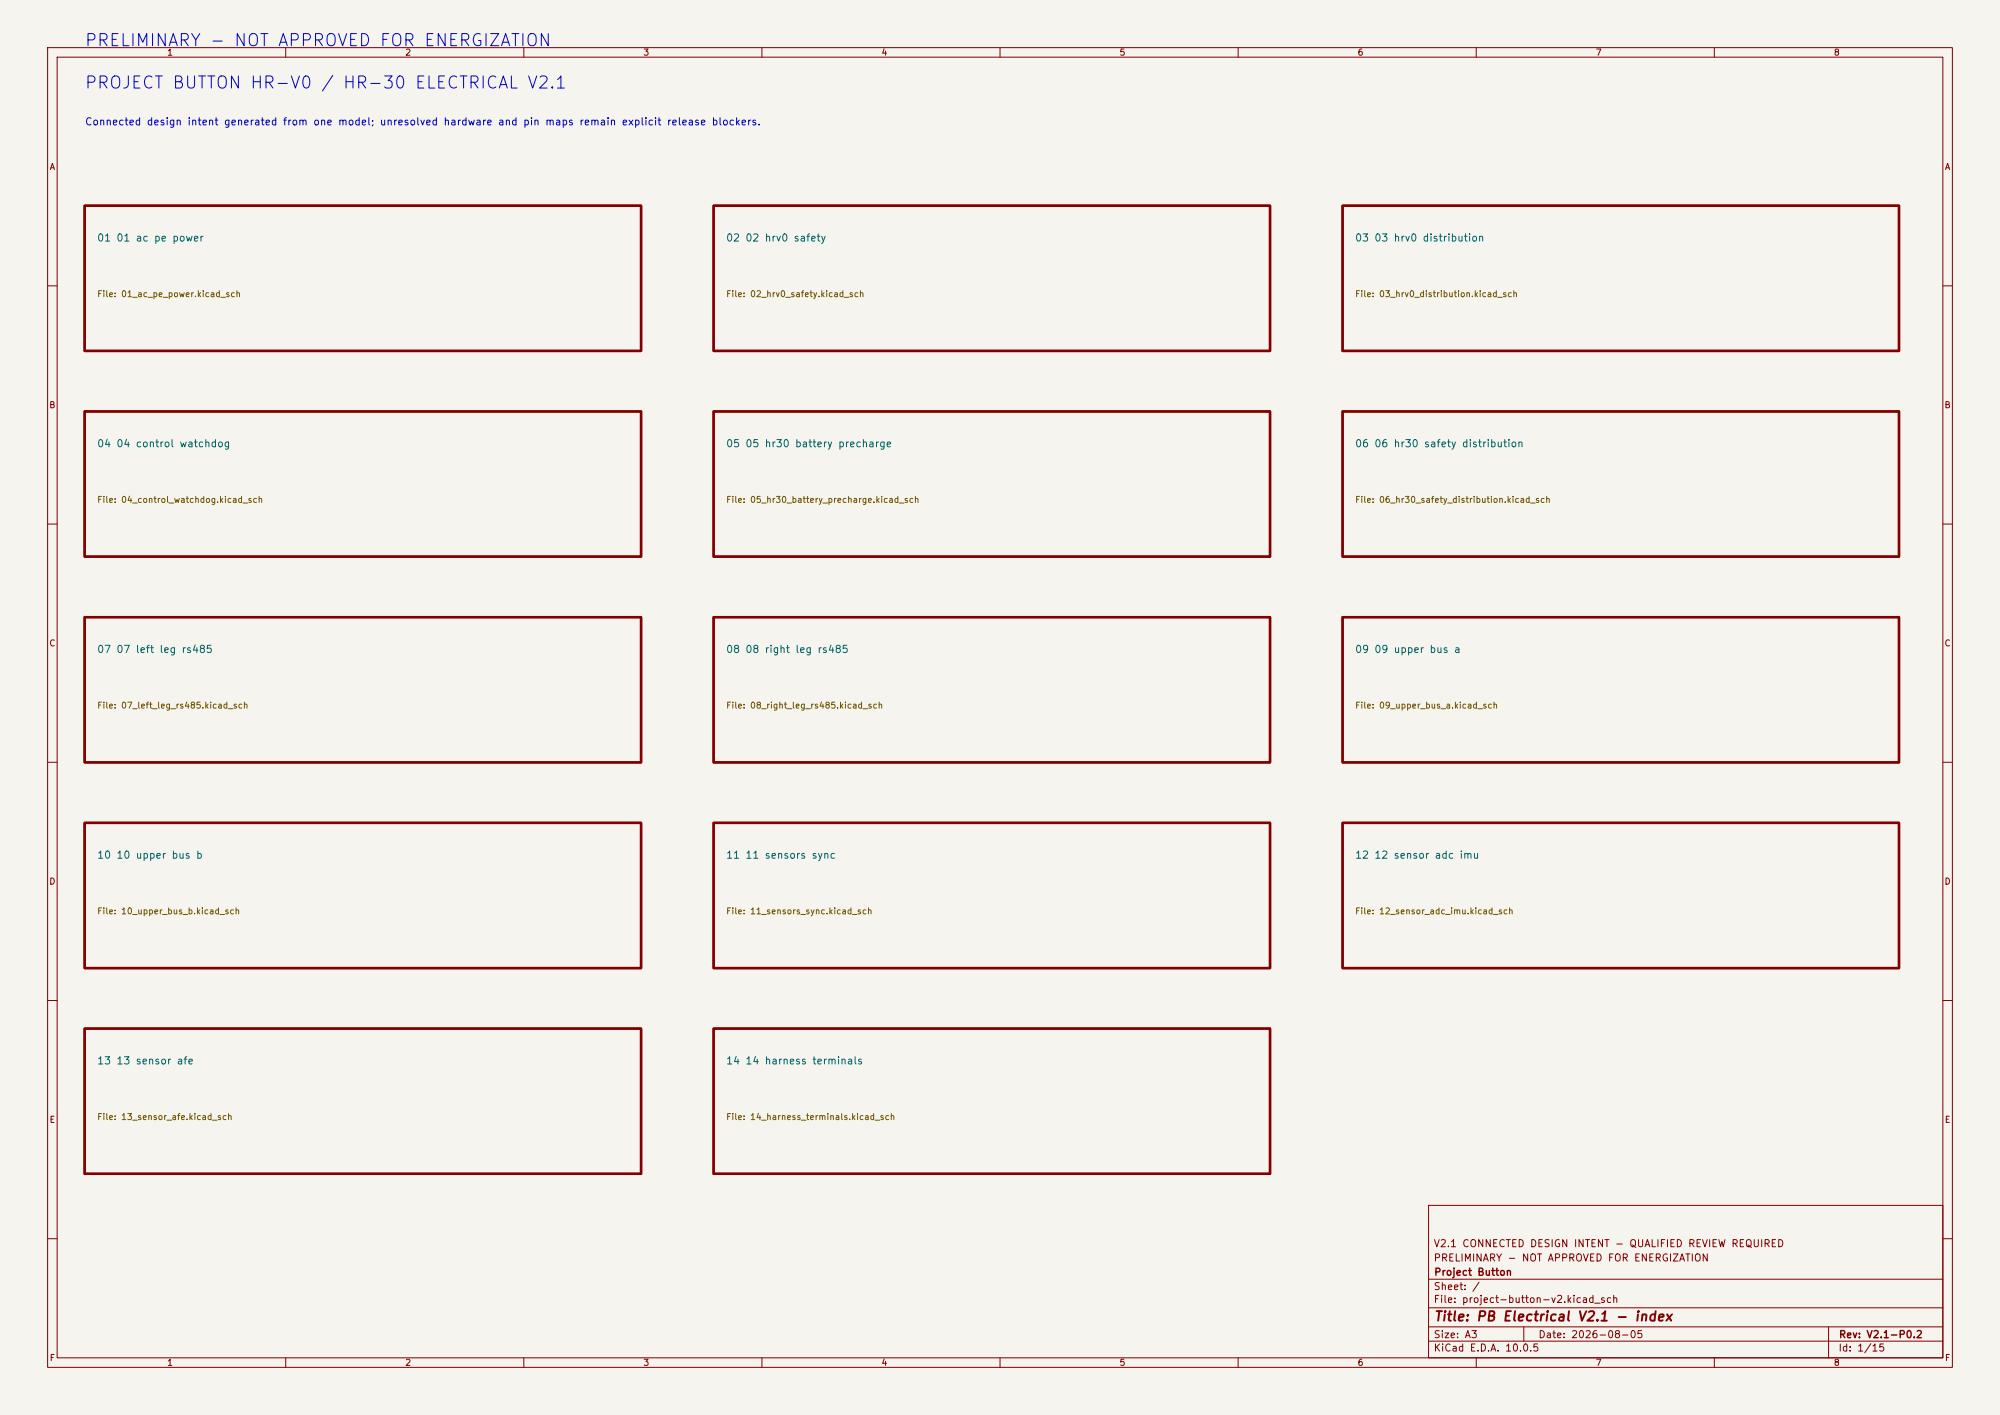
[picture p276: page 1]

PRELIMINARY - NOT APPROVED FOR ENERGIZATION

PROJECT BUTTON HR-V0 / HR-30 ELECTRICAL V2.1

Connected design intent generated from one model; unresolved hardware and pin maps remain explicit release blockers.

01 01 ac pe power File: 01_ac_pe_power.kicad_sch

V2.1 CONNECTED DESIGN INTENT - QUALIFIED REVIEW REQUIRED
Project Button
Sheet: /
File: project-button-v2.kicad_sch
Title: PB Electrical V2.1 - index

Size: A3 | Rev: V2.1-P0.2 | F Date: 2026-08-05
KiCad E.D.A. 10.0.5 | Id: 1/15

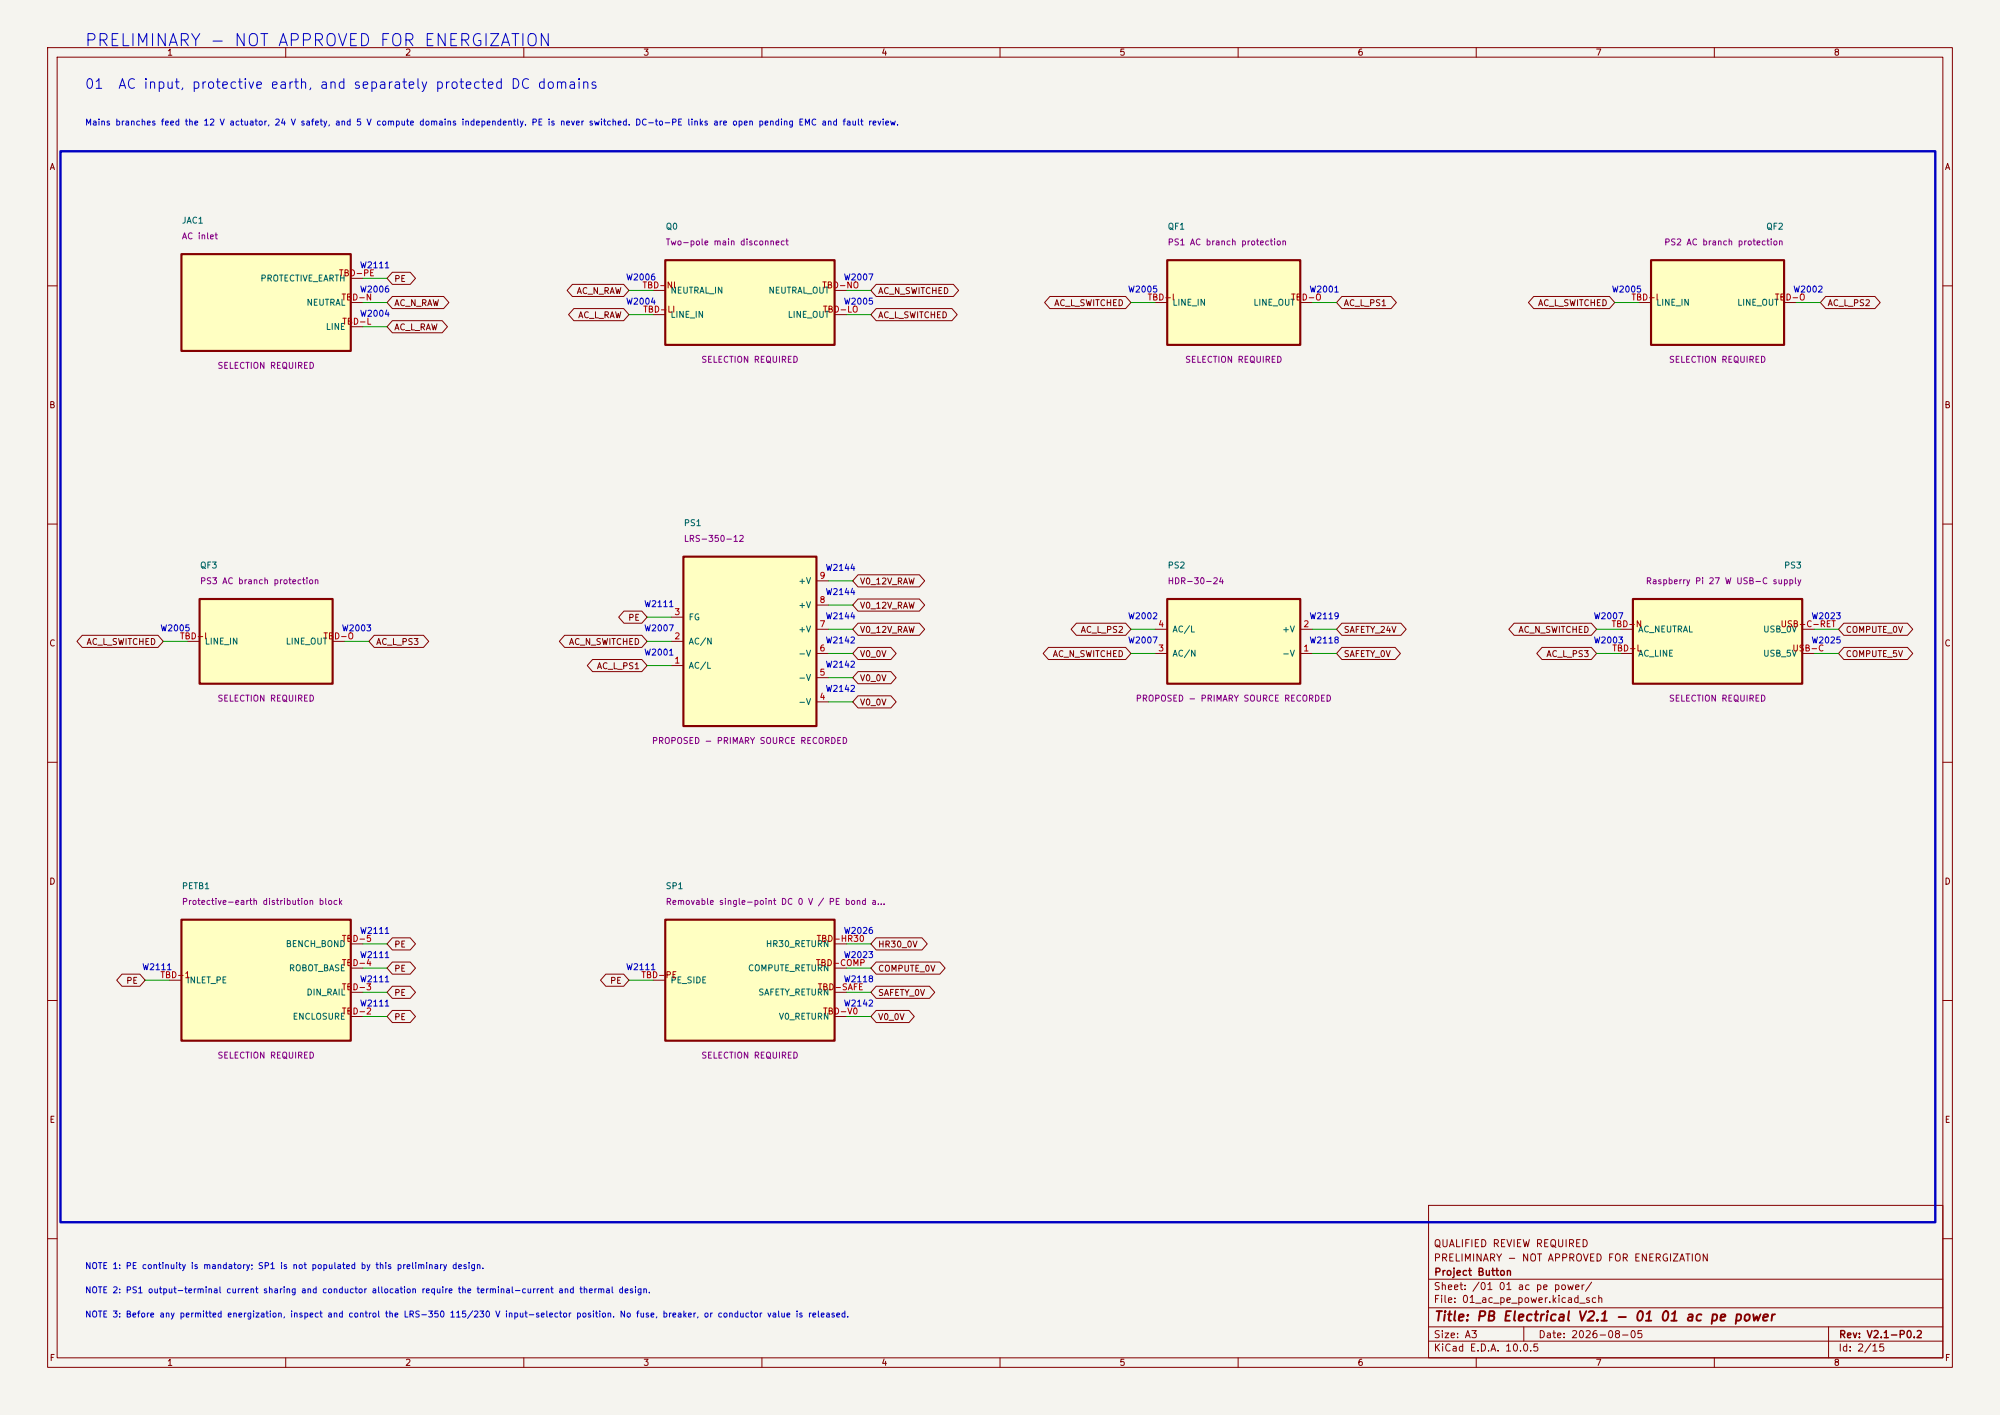
[picture p277: page 2]

01 AC input, protective earth, and separately protected DC domains

Two-pole main disconnect LINETBD-L NEUTRALTBD-N

Raspberry Pi 27 W USB-C supply AC_L_SWITCHED

AC/L 4 PS2 PROPOSED - PRIMARY SOURCE RECORDED HDR-30-24

Protective-earth distribution block

QUALIFIED REVIEW REQUIRED
PRELIMINARY - NOT APPROVED FOR ENERGIZATION
Project Button
Sheet: /01 01 ac pe power/
File: 01_ac_pe_power.kicad_sch
Title: PB Electrical V2.1 - 01 01 ac pe power

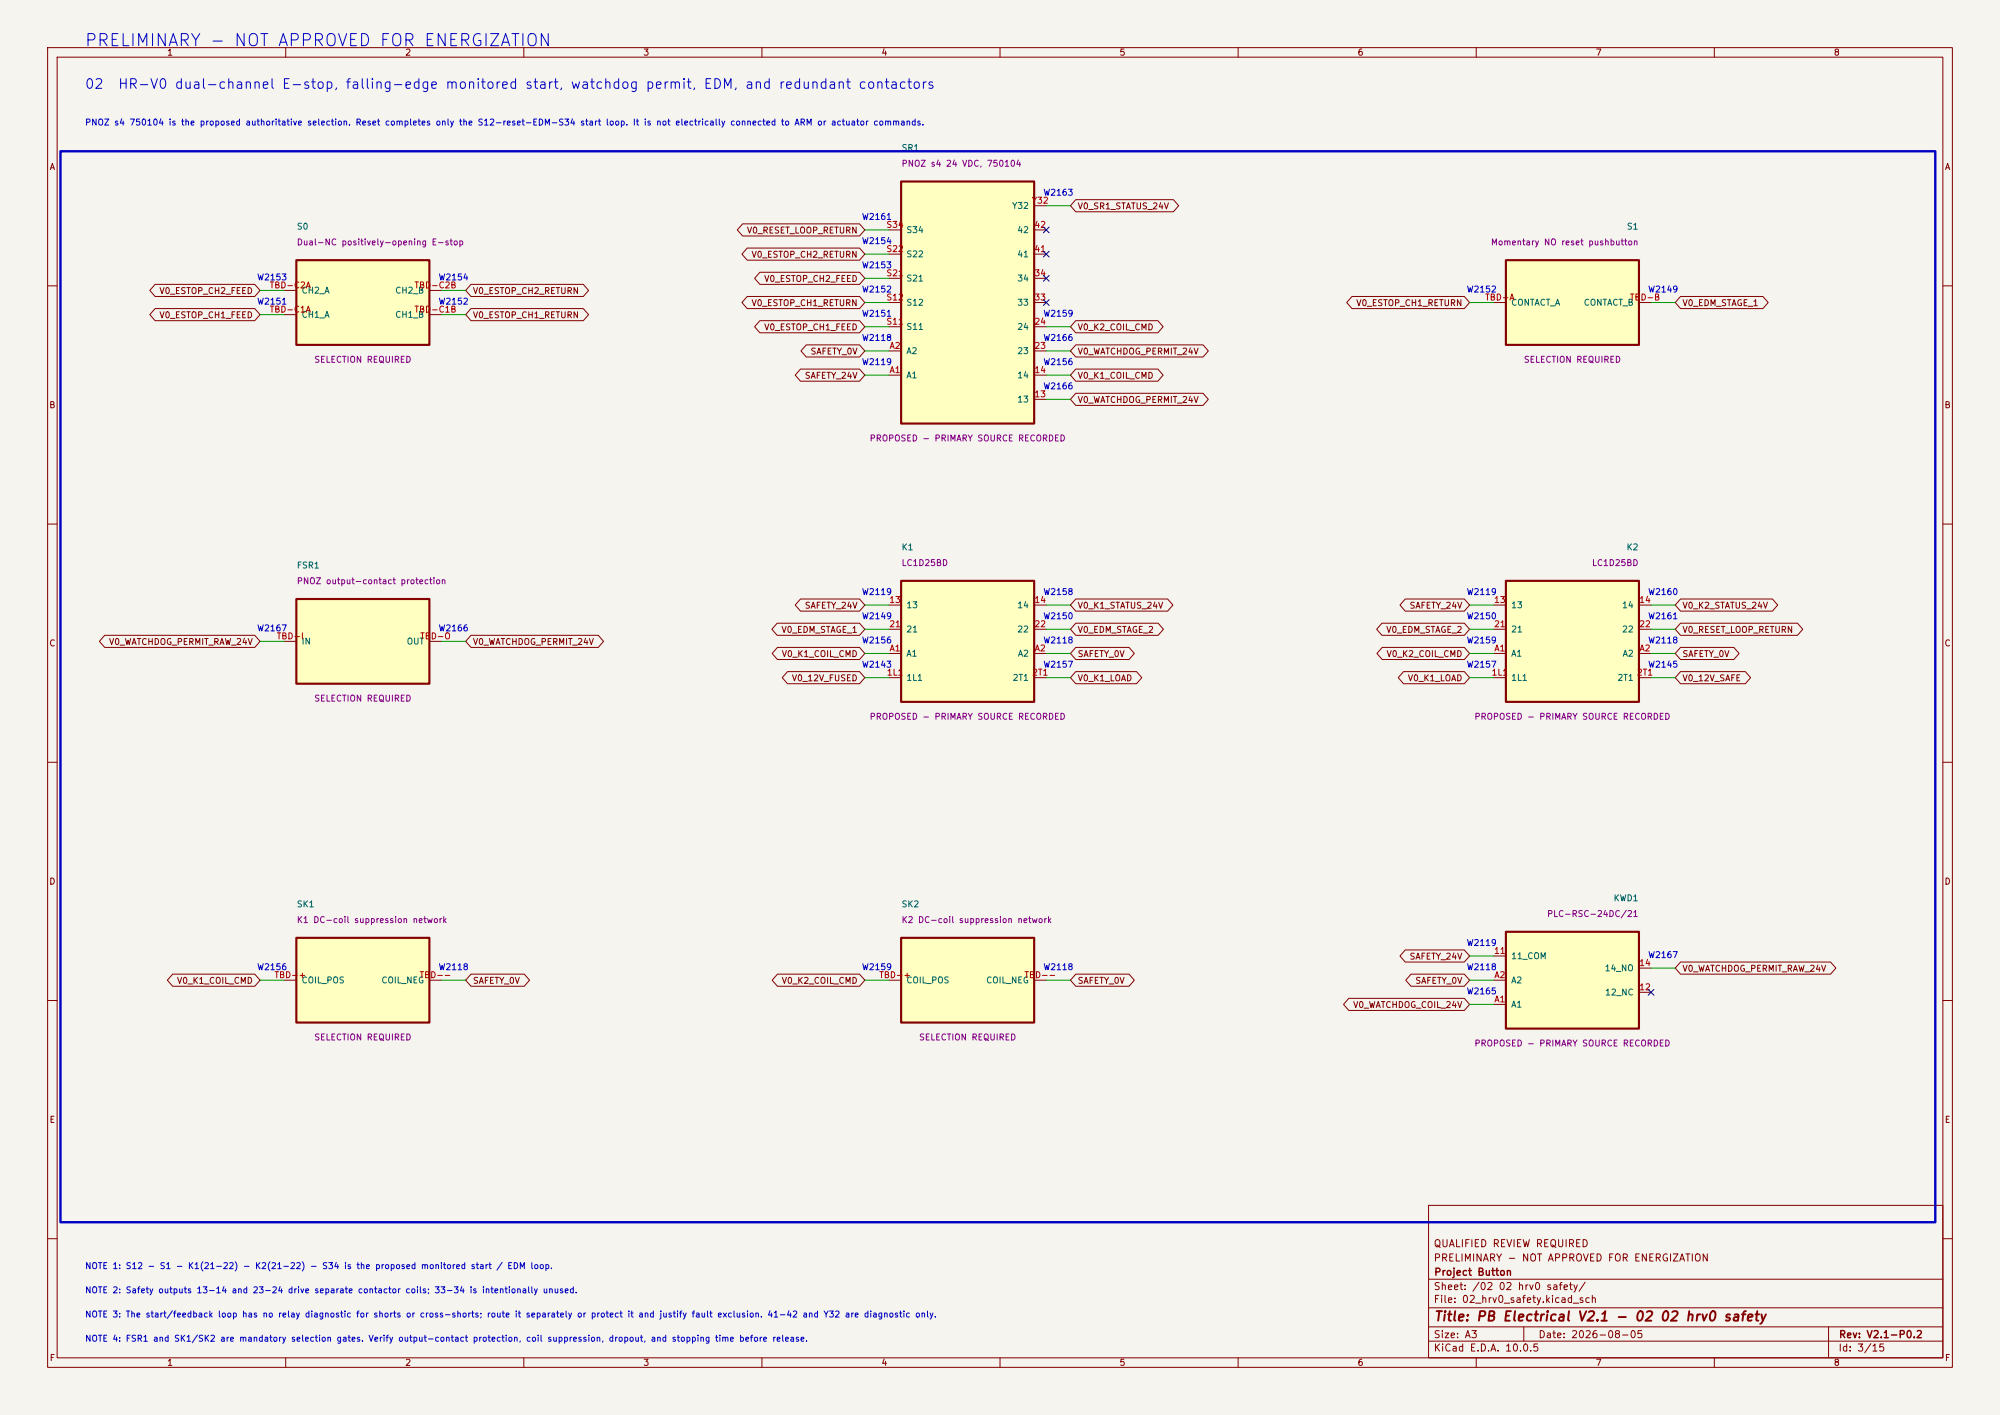
[picture p278: page 3]

02 HR-V0 dual-channel E-stop, falling-edge monitored start, watchdog permit, EDM, and redundant contactors

SR1 PROPOSED - PRIMARY SOURCE RECORDED

Dual-NC positively-opening E-stop

K1 DC-coil suppression network

W2159 NOTE 3: The start/feedback loop has no relay diagnostic for shorts or cross-shorts; route it separately or protect it and justify fault exclusion. 41-42 and Y32 are diagnostic only.

QUALIFIED REVIEW REQUIRED
PRELIMINARY - NOT APPROVED FOR ENERGIZATION
Project Button
Sheet: /02 02 hrv0 safety/
File: 02_hrv0_safety.kicad_sch
Title: PB Electrical V2.1 - 02 02 hrv0 safety

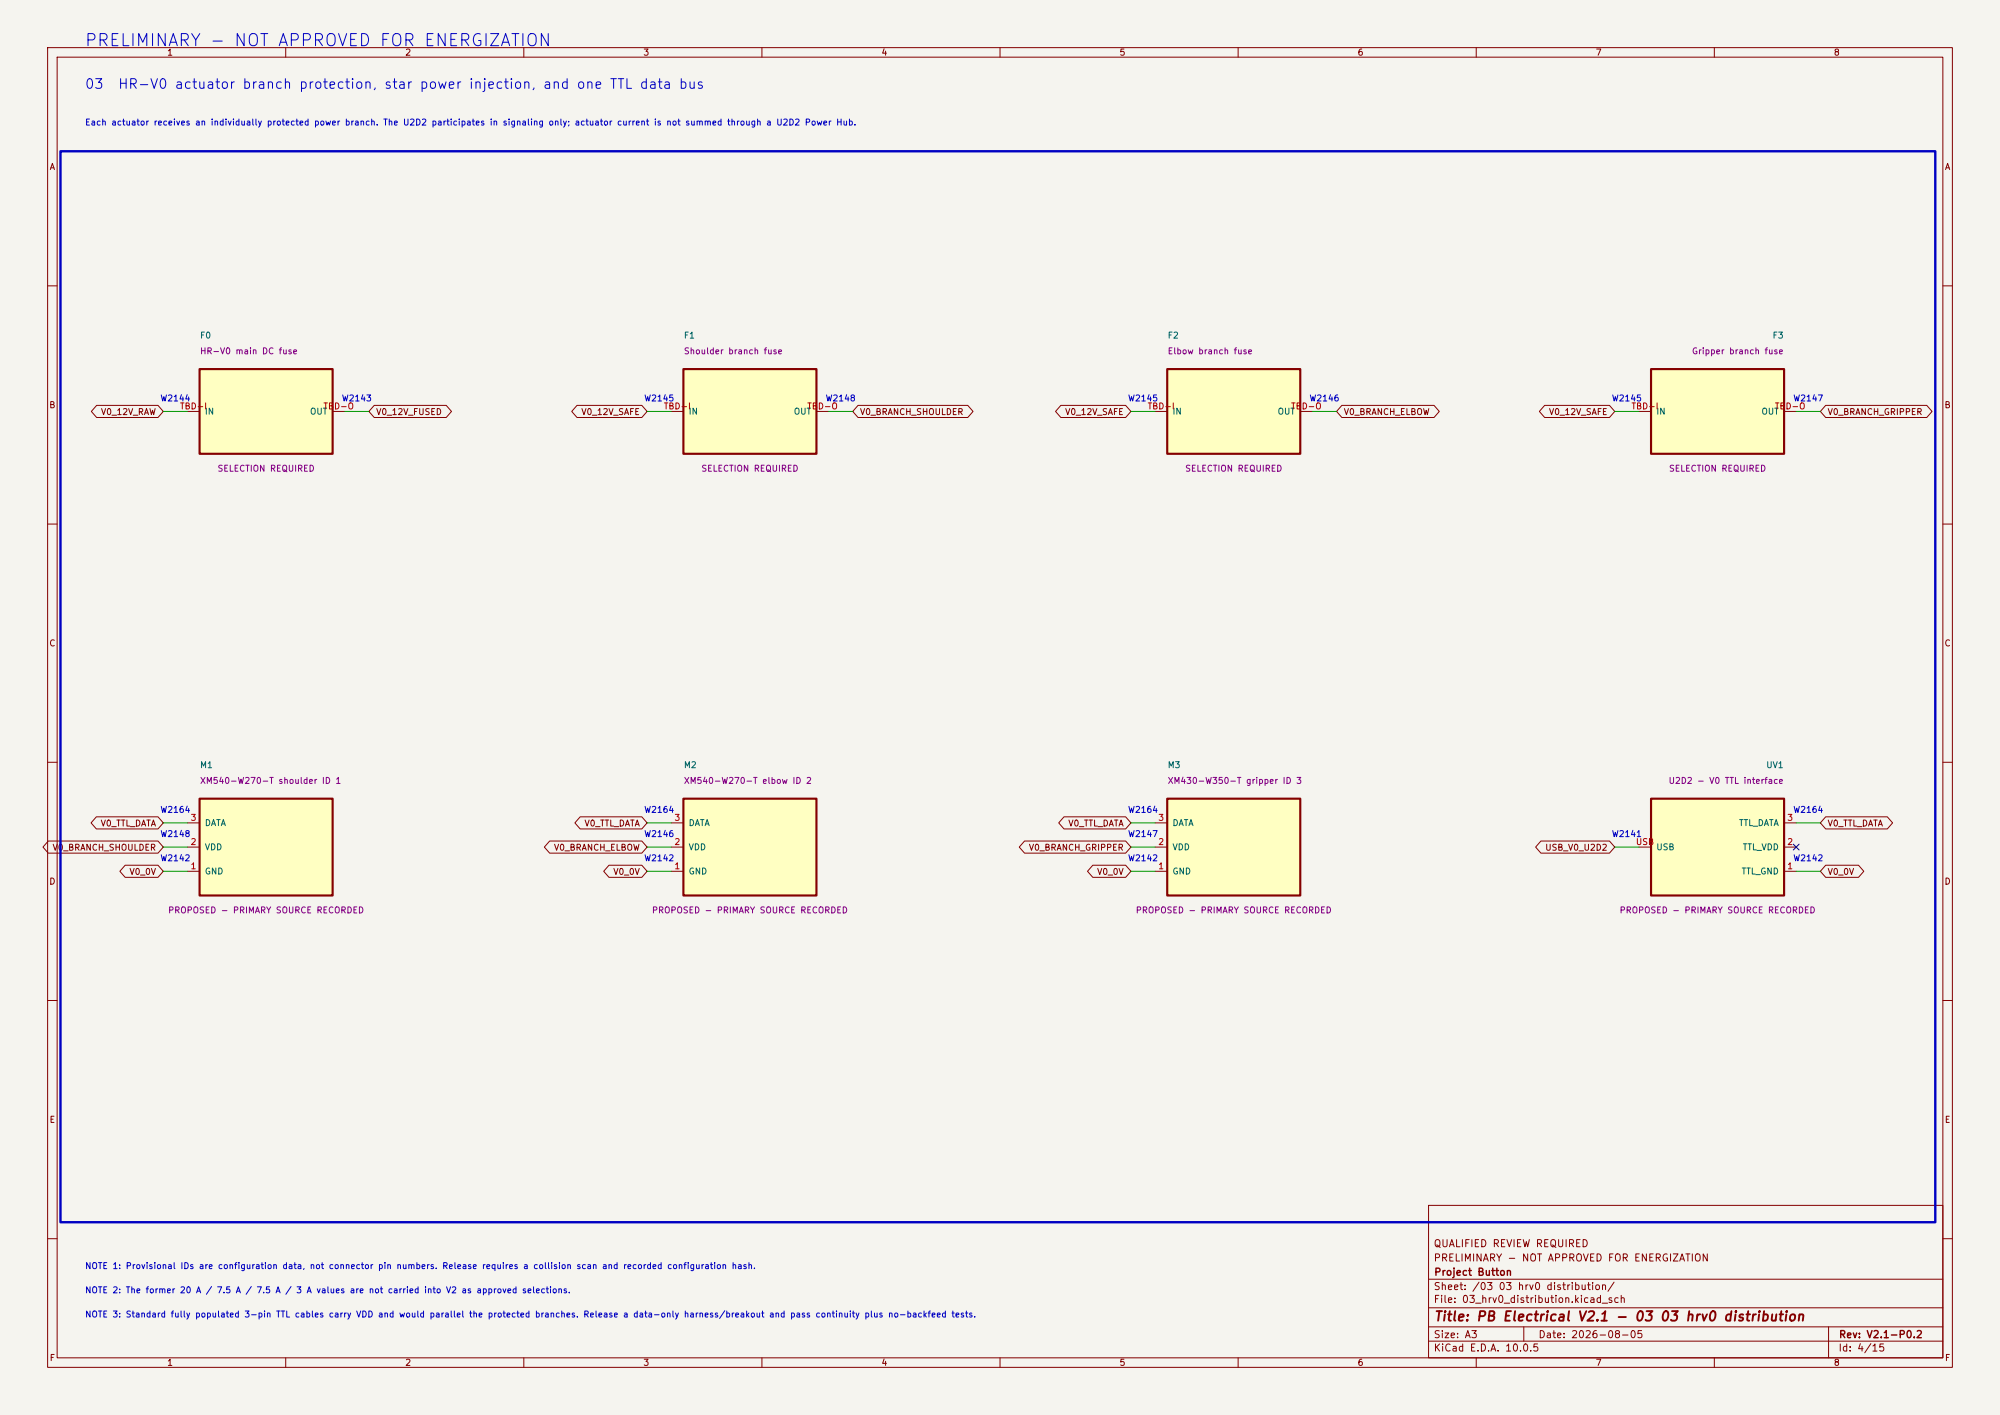
[picture p279: page 4]

03 HR-V0 actuator branch protection, star power injection, and one TTL data bus

Each actuator receives an individually protected power branch. The U2D2 participates in signaling only; actuator current is not summed through a U2D2 Power Hub.

SELECTION REQUIRED HR-V0 main DC fuse

Shoulder branch fuse GND 1

QUALIFIED REVIEW REQUIRED
PRELIMINARY - NOT APPROVED FOR ENERGIZATION
Project Button
Sheet: /03 03 hrv0 distribution/
File: 03_hrv0_distribution.kicad_sch
Title: PB Electrical V2.1 - 03 03 hrv0 distribution

NOTE 2: The former 20 A / 7.5 A / 7.5 A / 3 A values are not carried into V2 as approved selections.

NOTE 3: Standard fully populated 3-pin TTL cables carry VDD and would parallel the protected branches. Release a data-only harness/breakout and pass continuity plus no-backfeed tests.

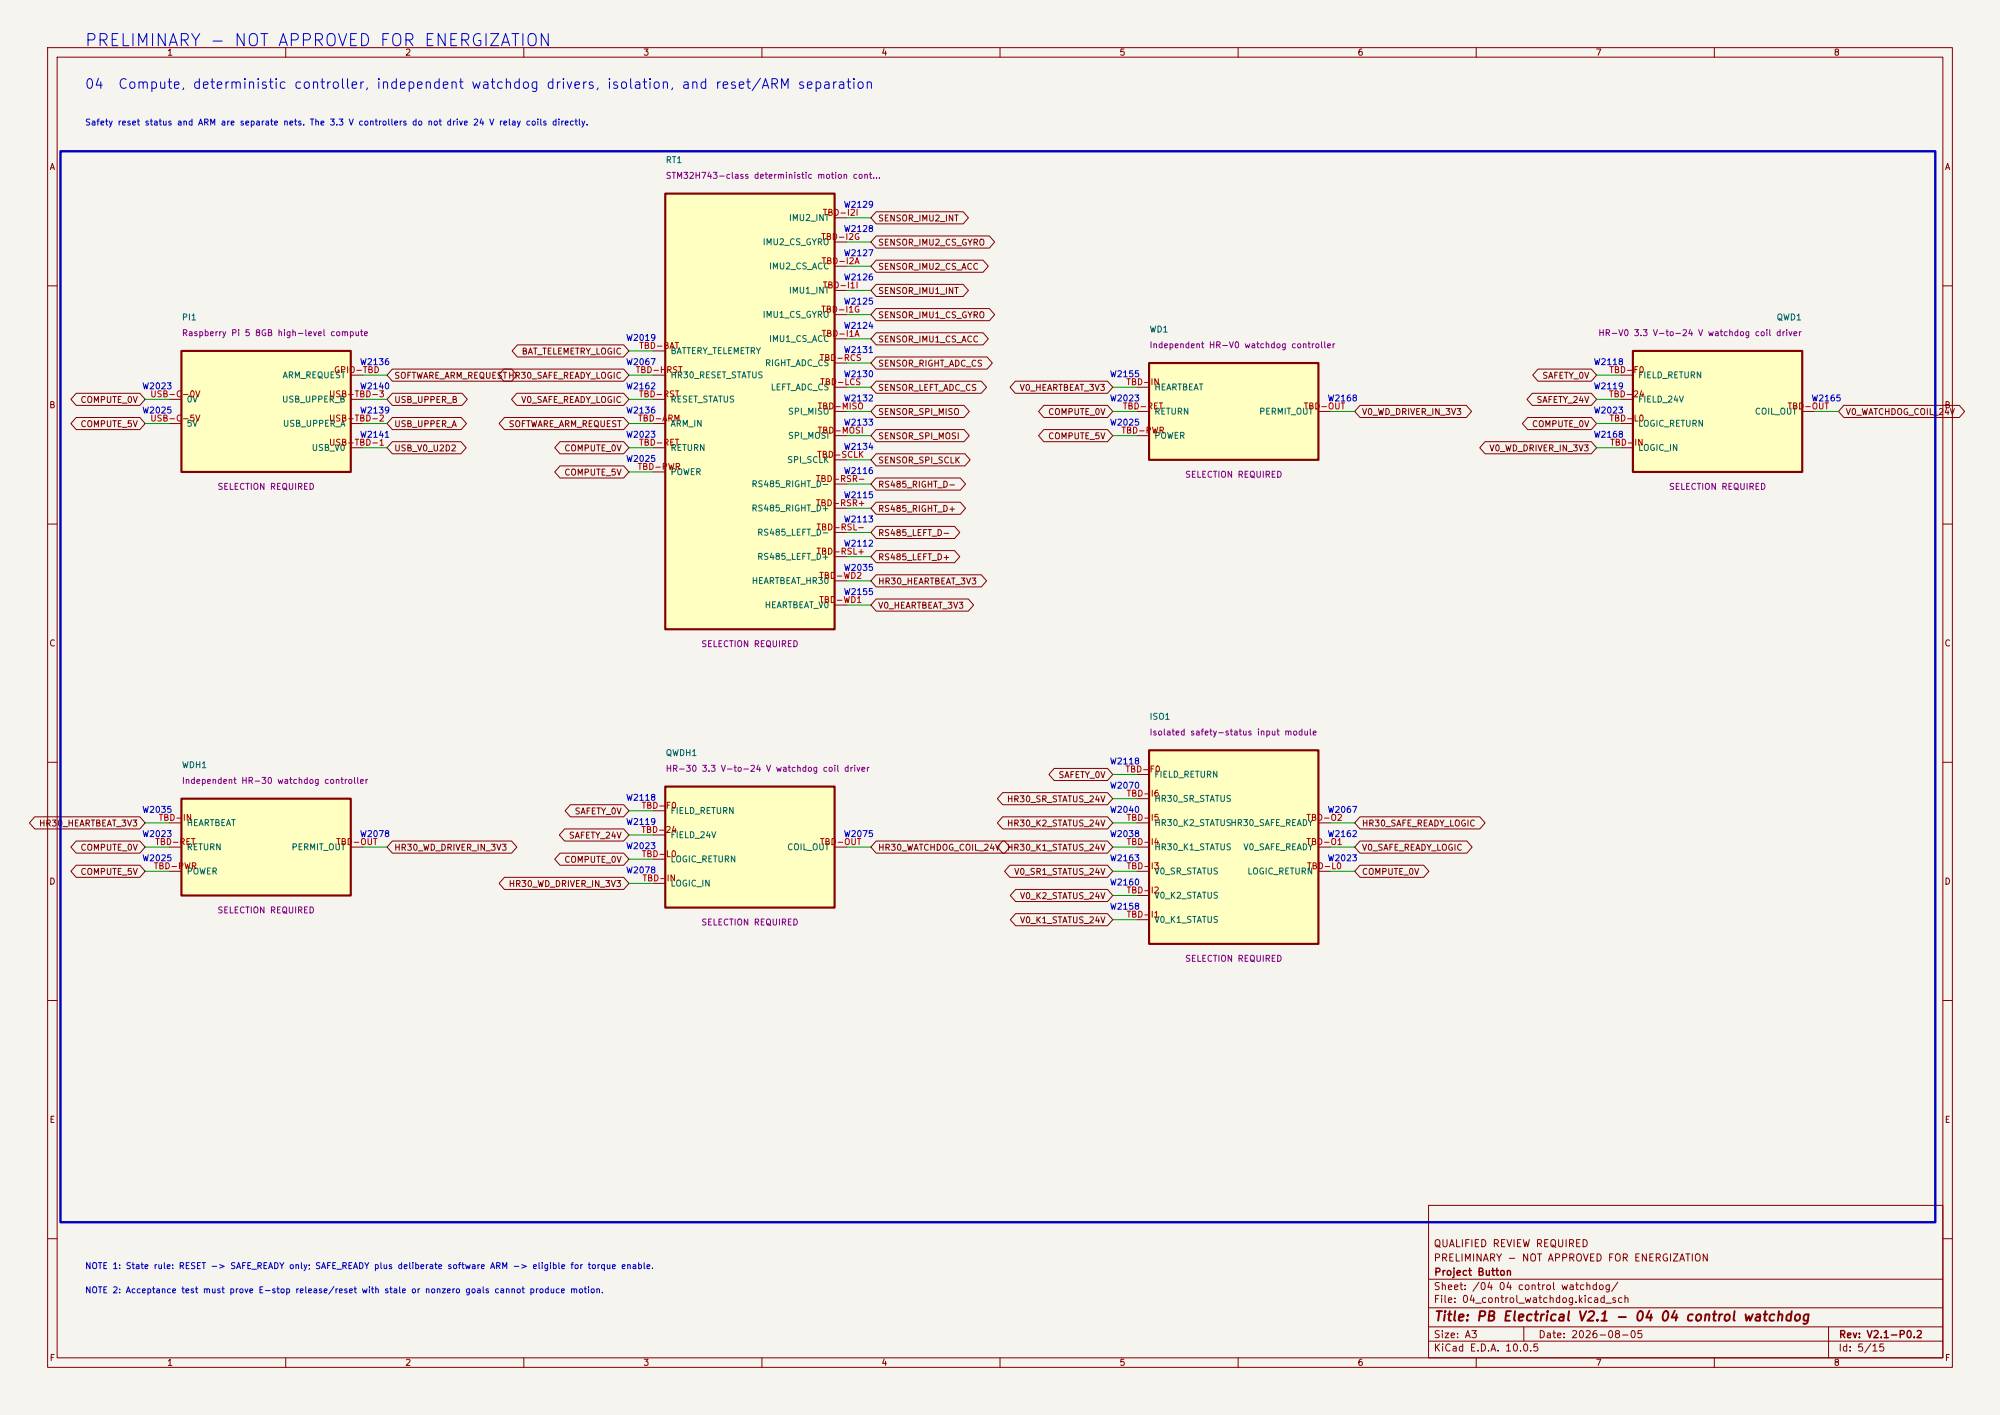
[picture p280: page 5]

W2126 PRELIMINARY - NOT APPROVED FOR ENERGIZATION
IMU2_INTTBD-I2I LEFT_ADC_CSTBD-LCS

04 Compute, deterministic controller, independent watchdog drivers, isolation, and reset/ARM separation

Raspberry Pi 5 8GB high-level compute
Independent HR-V0 watchdog controller HEARTBEAT TBD-IN

RETURN TBD-RET WD1
SELECTION REQUIRED HR-V0 3.3 V-to-24 V watchdog coil driver HEARTBEAT TBD-IN

PERMIT_OUTTBD-OUT POWER TBD-PWR

ARM_IN TBD-ARM
SPI_MOSI TBD-MOSI POWER TBD-PWR

Isolated safety-status input module

SELECTION REQUIRED HR-30 3.3 V-to-24 V watchdog coil driver

Independent HR-30 watchdog controller

V0_SR_STATUS TBD-I3HR30_K1_STATUS TBD-I4HR30_K2_STATUS TBD-I5HR30_SR_STATUS TBD-I6

QUALIFIED REVIEW REQUIRED
PRELIMINARY - NOT APPROVED FOR ENERGIZATION
Project Button
Sheet: /04 04 control watchdog/
File: 04_control_watchdog.kicad_sch
Title: PB Electrical V2.1 - 04 04 control watchdog

NOTE 1: State rule: RESET -> SAFE_READY only; SAFE_READY plus deliberate software ARM -> eligible for torque enable. NOTE 2: Acceptance test must prove E-stop release/reset with stale or nonzero goals cannot produce motion.

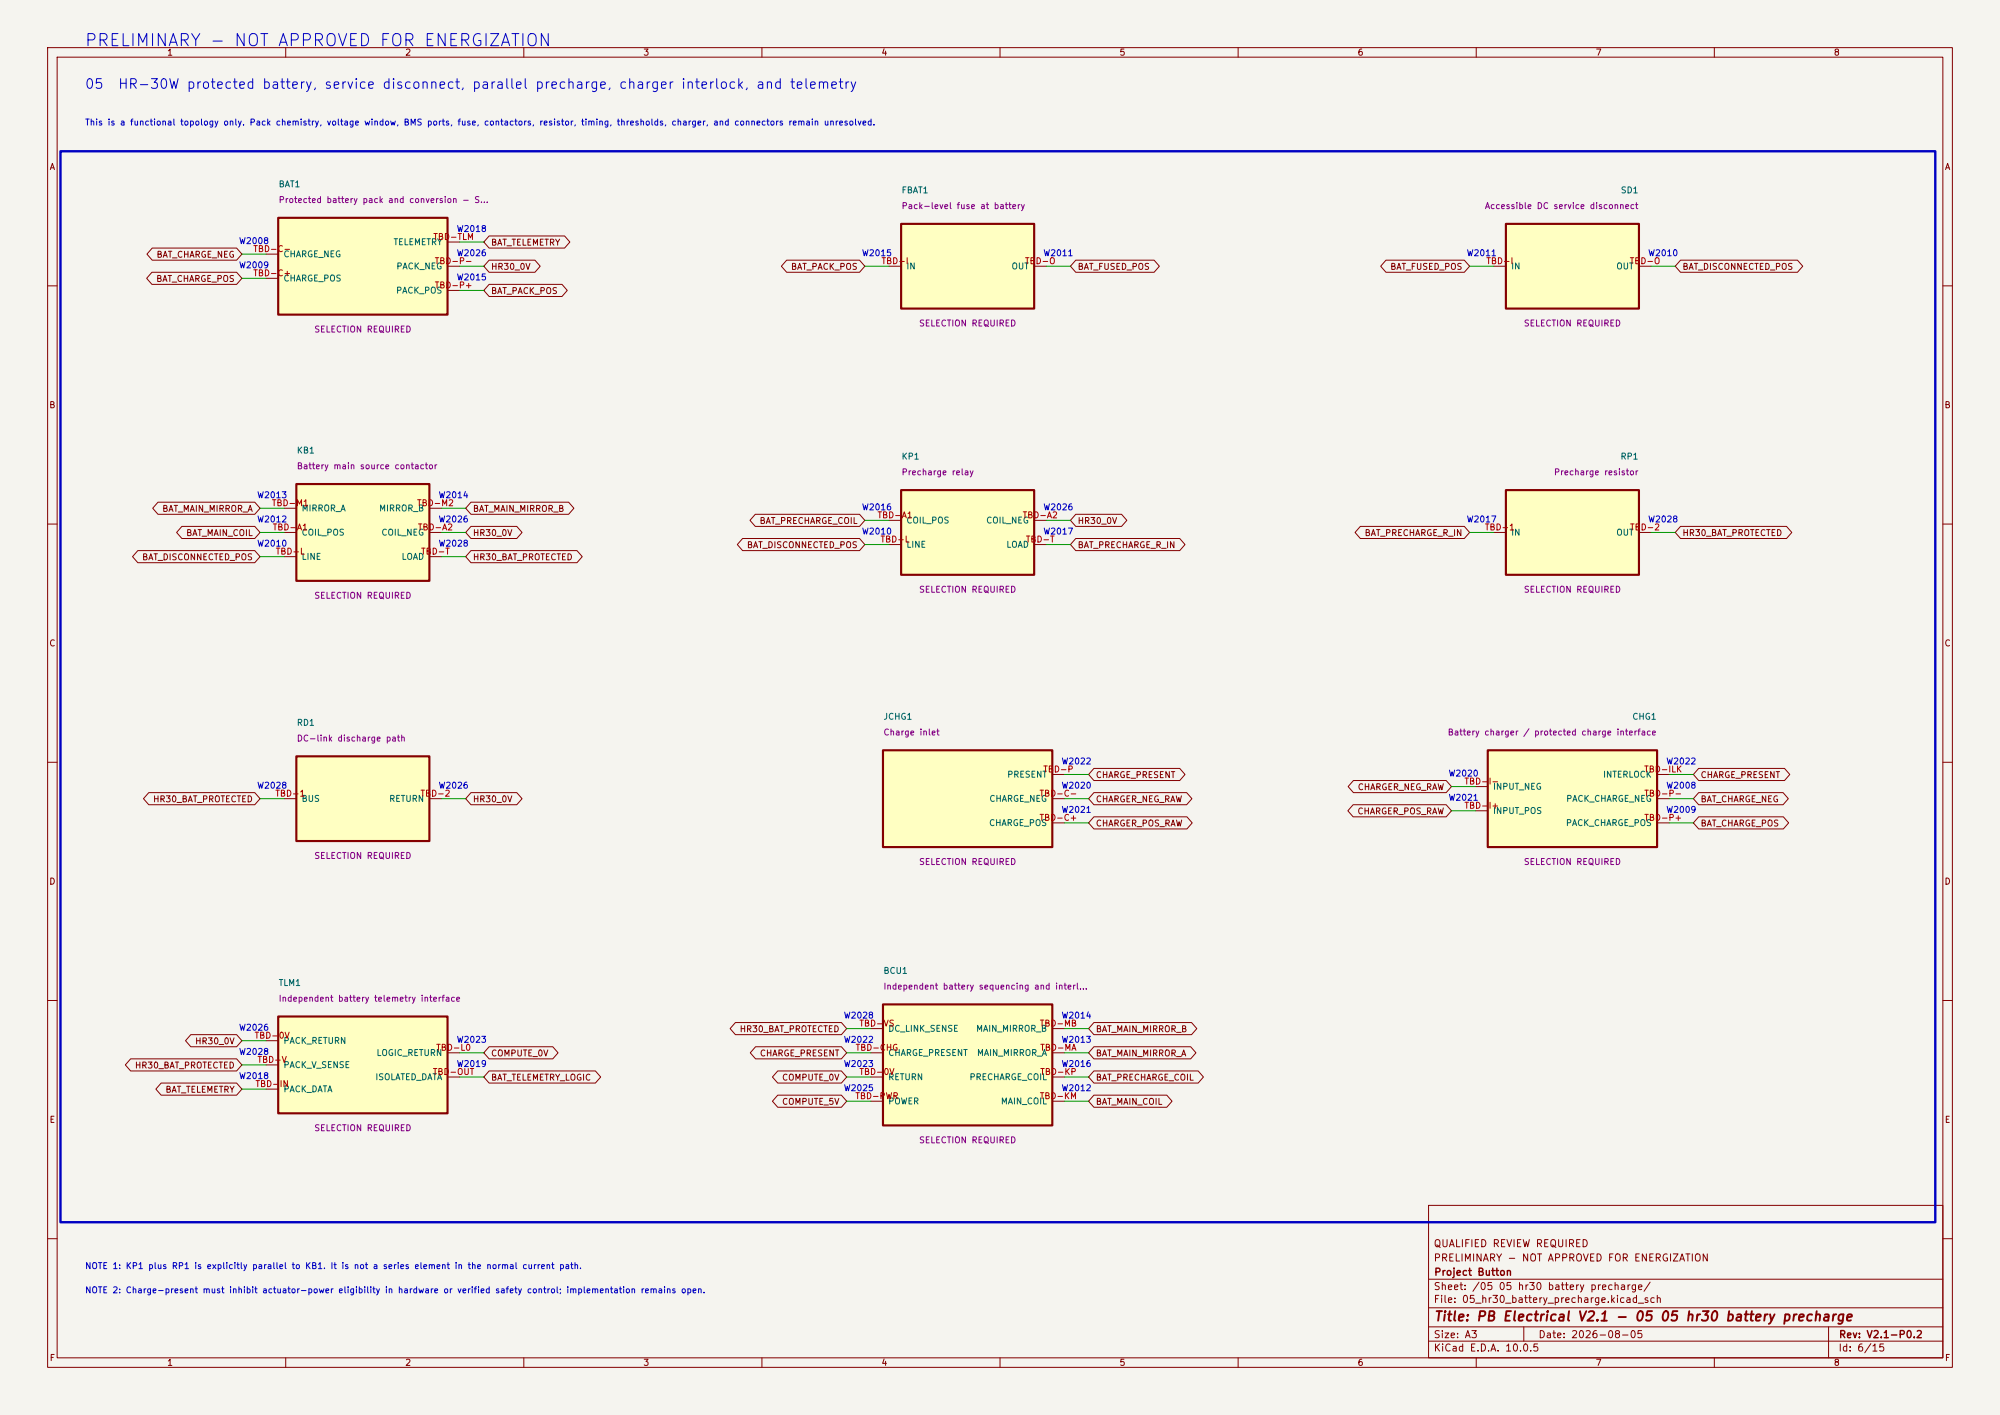
[picture p281: page 6]

W2018 PRELIMINARY - NOT APPROVED FOR ENERGIZATION

05 HR-30W protected battery, service disconnect, parallel precharge, charger interlock, and telemetry

FBAT1
Pack-level fuse at battery CHARGE_POSTBD-C+

Protected battery pack and conversion - S...

Accessible DC service disconnect

DC-link discharge path

Independent battery sequencing and interl...

QUALIFIED REVIEW REQUIRED
PRELIMINARY - NOT APPROVED FOR ENERGIZATION
Project Button
Sheet: /05 05 hr30 battery precharge/
File: 05_hr30_battery_precharge.kicad_sch
Title: PB Electrical V2.1 - 05 05 hr30 battery precharge

NOTE 1: KP1 plus RP1 is explicitly parallel to KB1. It is not a series element in the normal current path. NOTE 2: Charge-present must inhibit actuator-power eligibility in hardware or verified safety control; implementation remains open.

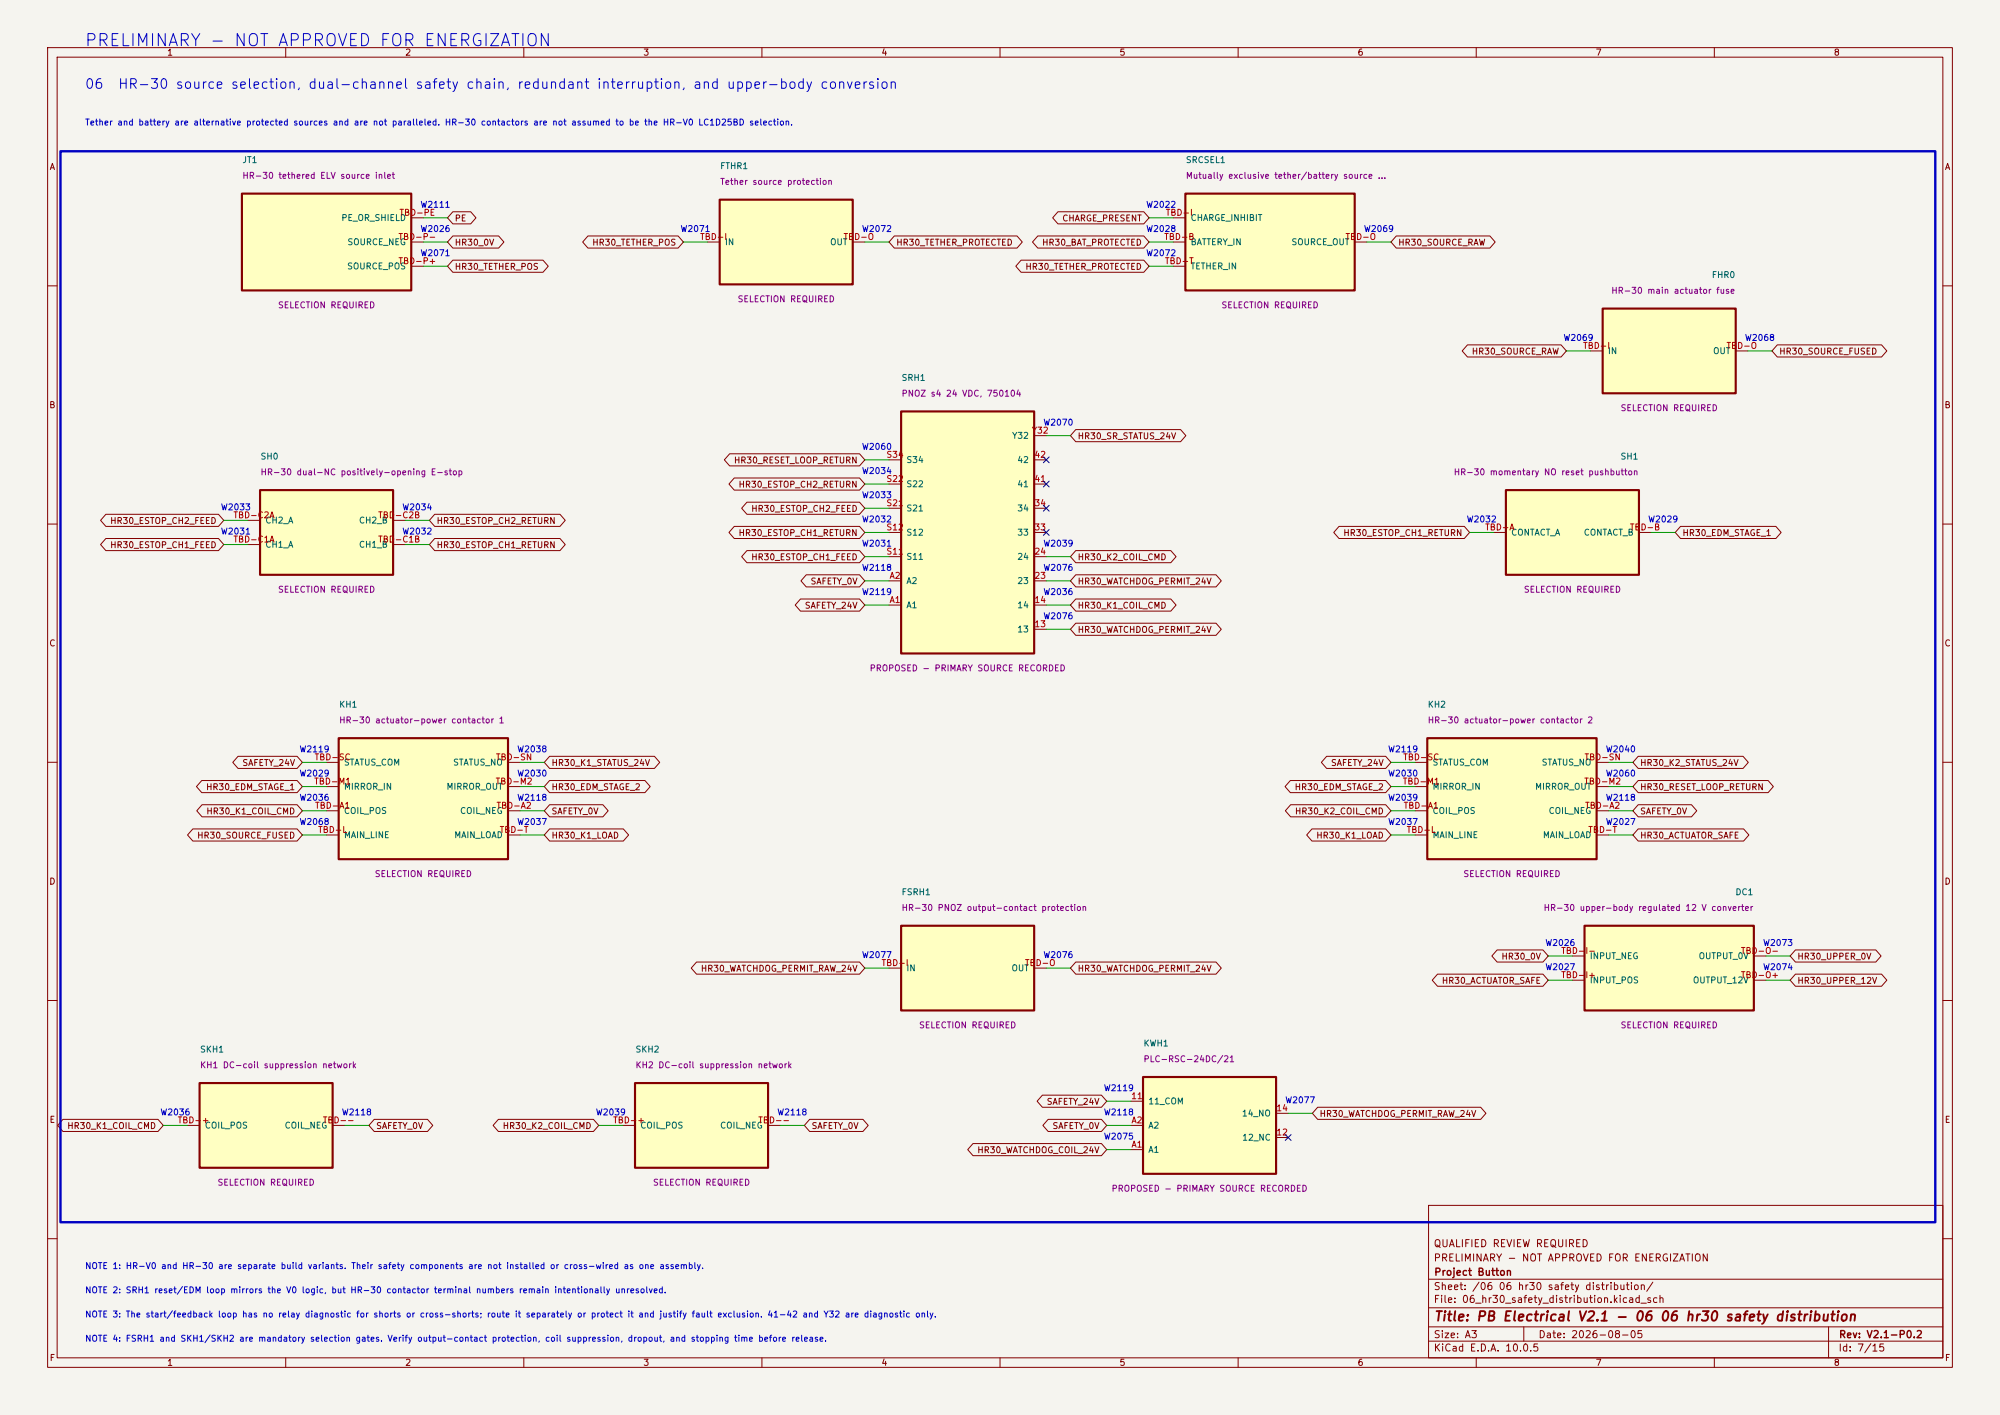
[picture p282: page 7]

W2034 PRELIMINARY - NOT APPROVED FOR ENERGIZATION

06 HR-30 source selection, dual-channel safety chain, redundant interruption, and upper-body conversion

Tether and battery are alternative protected sources and are not paralleled. HR-30 contactors are not assumed to be the HR-V0 LC1D25BD selection.

TETHER_IN TBD-TSRCSEL1
SELECTION REQUIRED Mutually exclusive tether/battery source ...

SELECTION REQUIRED HR-30 main actuator fuse BATTERY_IN TBD-B

SRH1 PROPOSED - PRIMARY SOURCE RECORDED

SELECTION REQUIRED HR-30 momentary NO reset pushbutton

SELECTION REQUIRED HR-30 actuator-power contactor 2

W2029 W2036 NOTE 1: HR-V0 and HR-30 are separate build variants. Their safety components are not installed or cross-wired as one assembly. NOTE 3: The start/feedback loop has no relay diagnostic for shorts or cross-shorts; route it separately or protect it and justify fault exclusion. 41-42 and Y32 are diagnostic only. NOTE 4: FSRH1 and SKH1/SKH2 are mandatory selection gates. Verify output-contact protection, coil suppression, dropout, and stopping time before release.

FSRH1
SELECTION REQUIRED HR-30 PNOZ output-contact protection

SELECTION REQUIRED HR-30 upper-body regulated 12 V converter 11_COM 11

A2 A2 KWH1 PROPOSED - PRIMARY SOURCE RECORDED

KH1 DC-coil suppression network

KH2 DC-coil suppression network

W2118 NOTE 2: SRH1 reset/EDM loop mirrors the V0 logic, but HR-30 contactor terminal numbers remain intentionally unresolved.

QUALIFIED REVIEW REQUIRED
PRELIMINARY - NOT APPROVED FOR ENERGIZATION
Project Button
Sheet: /06 06 hr30 safety distribution/
File: 06_hr30_safety_distribution.kicad_sch
Title: PB Electrical V2.1 - 06 06 hr30 safety distribution

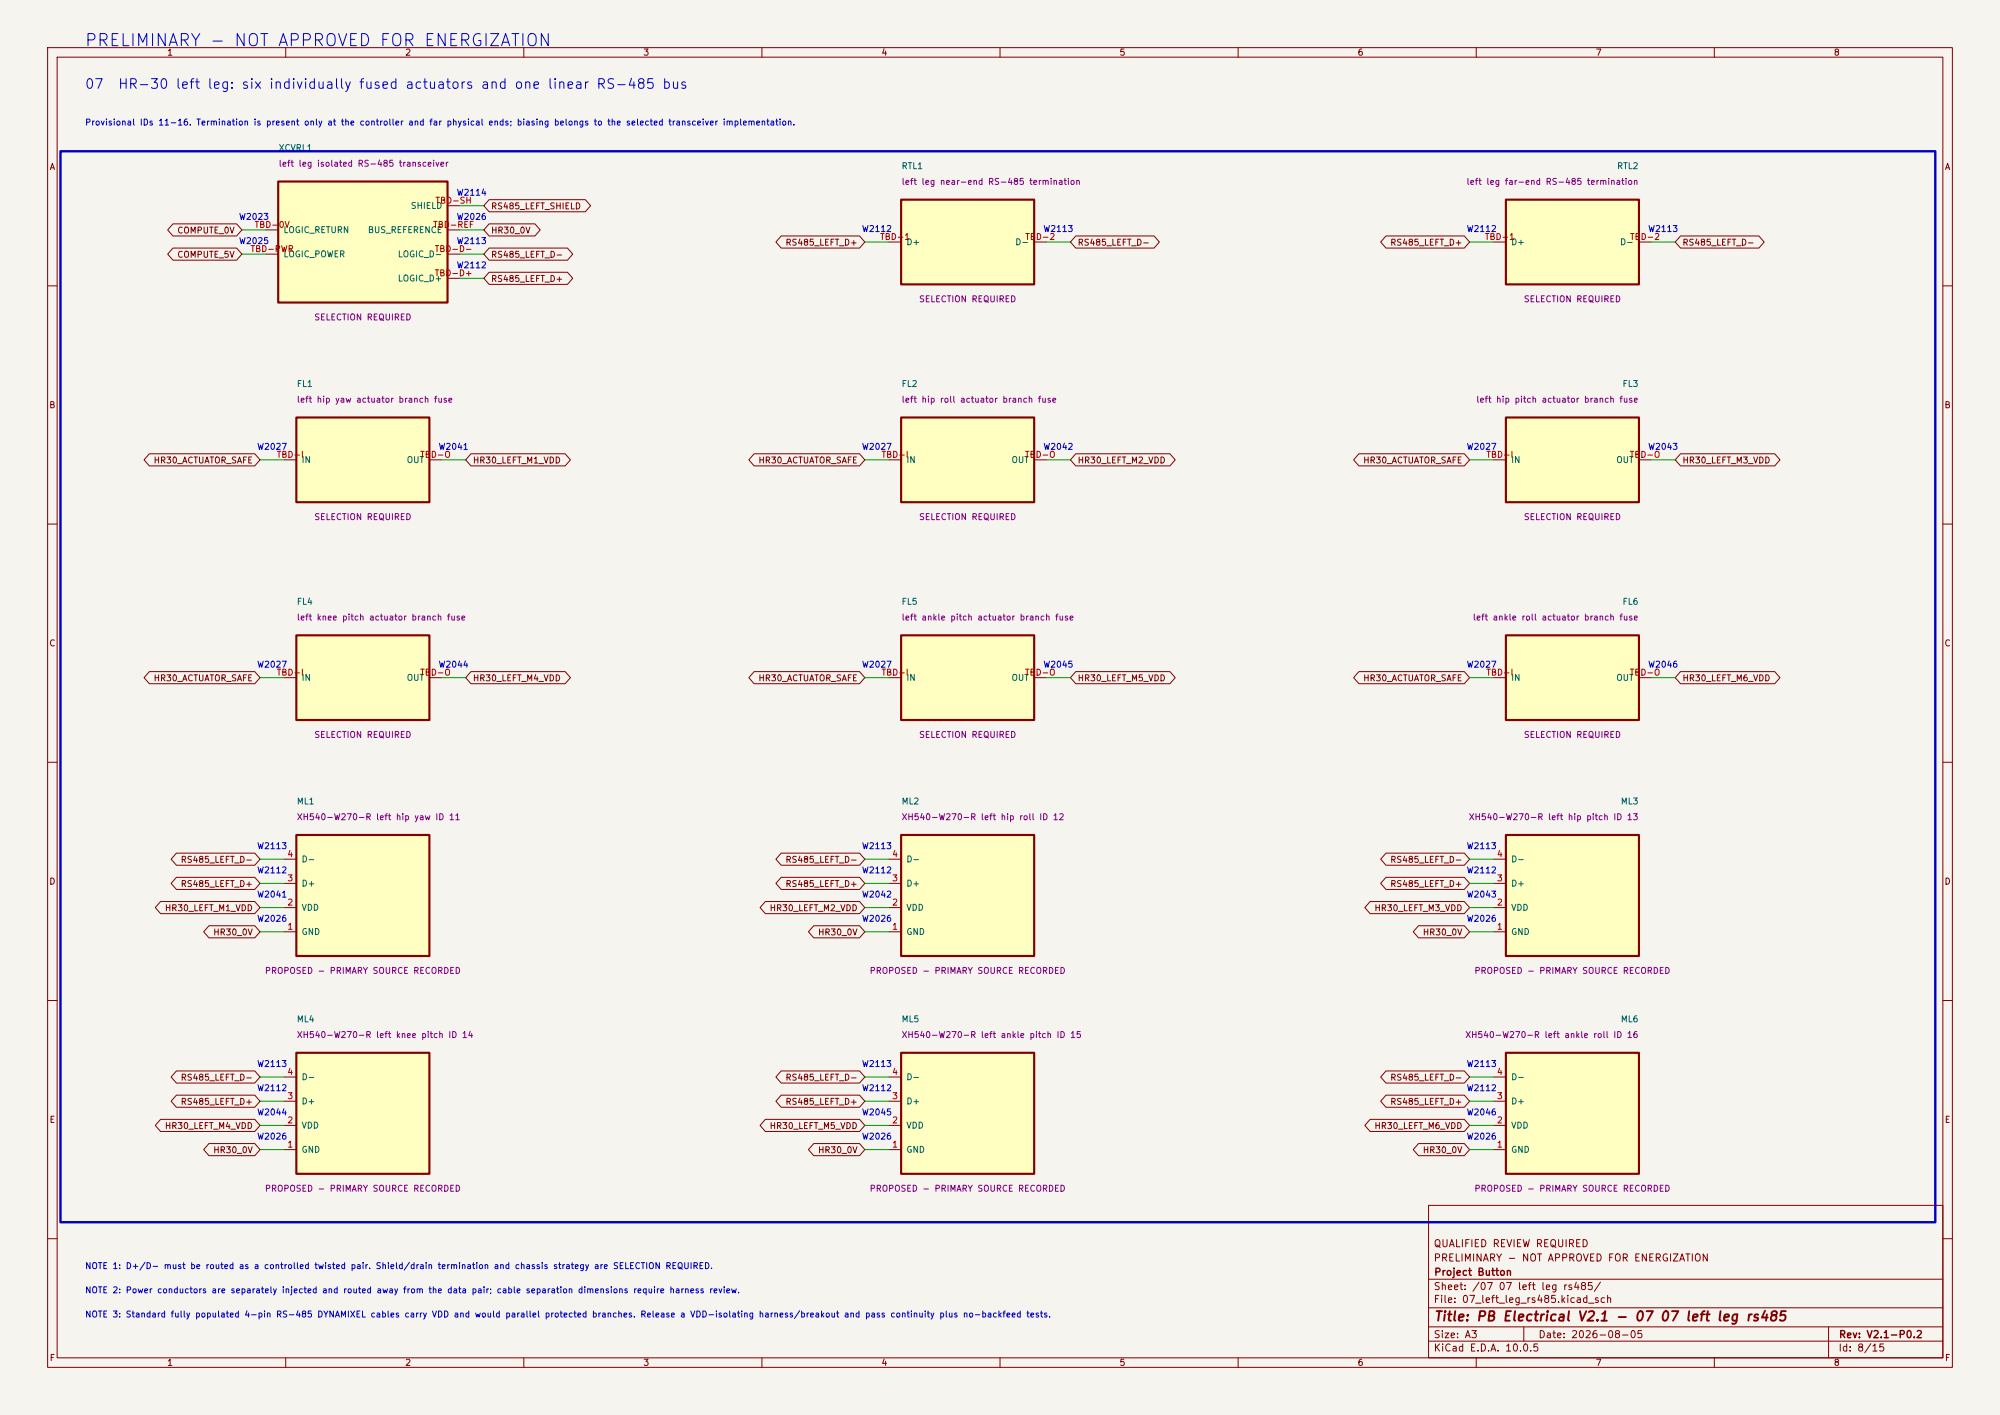
[picture p283: page 8]

07 HR-30 left leg: six individually fused actuators and one linear RS-485 bus

left leg isolated RS-485 transceiver

left leg near-end RS-485 termination

left leg far-end RS-485 termination

left hip yaw actuator branch fuse

left hip roll actuator branch fuse

left hip pitch actuator branch fuse

SELECTION REQUIRED
XH540-W270-R left hip pitch ID 13 GND 1

left ankle roll actuator branch fuse GND 1

XH540-W270-R left hip yaw ID 11 GND 1

XH540-W270-R left hip roll ID 12

XH540-W270-R left ankle pitch ID 15 GND 1

XH540-W270-R left ankle roll ID 16

XH540-W270-R left knee pitch ID 14

QUALIFIED REVIEW REQUIRED
PRELIMINARY - NOT APPROVED FOR ENERGIZATION
Project Button
Sheet: /07 07 left leg rs485/
File: 07_left_leg_rs485.kicad_sch
Title: PB Electrical V2.1 - 07 07 left leg rs485

NOTE 1: D+/D- must be routed as a controlled twisted pair. Shield/drain termination and chassis strategy are SELECTION REQUIRED. NOTE 2: Power conductors are separately injected and routed away from the data pair; cable separation dimensions require harness review. NOTE 3: Standard fully populated 4-pin RS-485 DYNAMIXEL cables carry VDD and would parallel protected branches. Release a VDD-isolating harness/breakout and pass continuity plus no-backfeed tests.

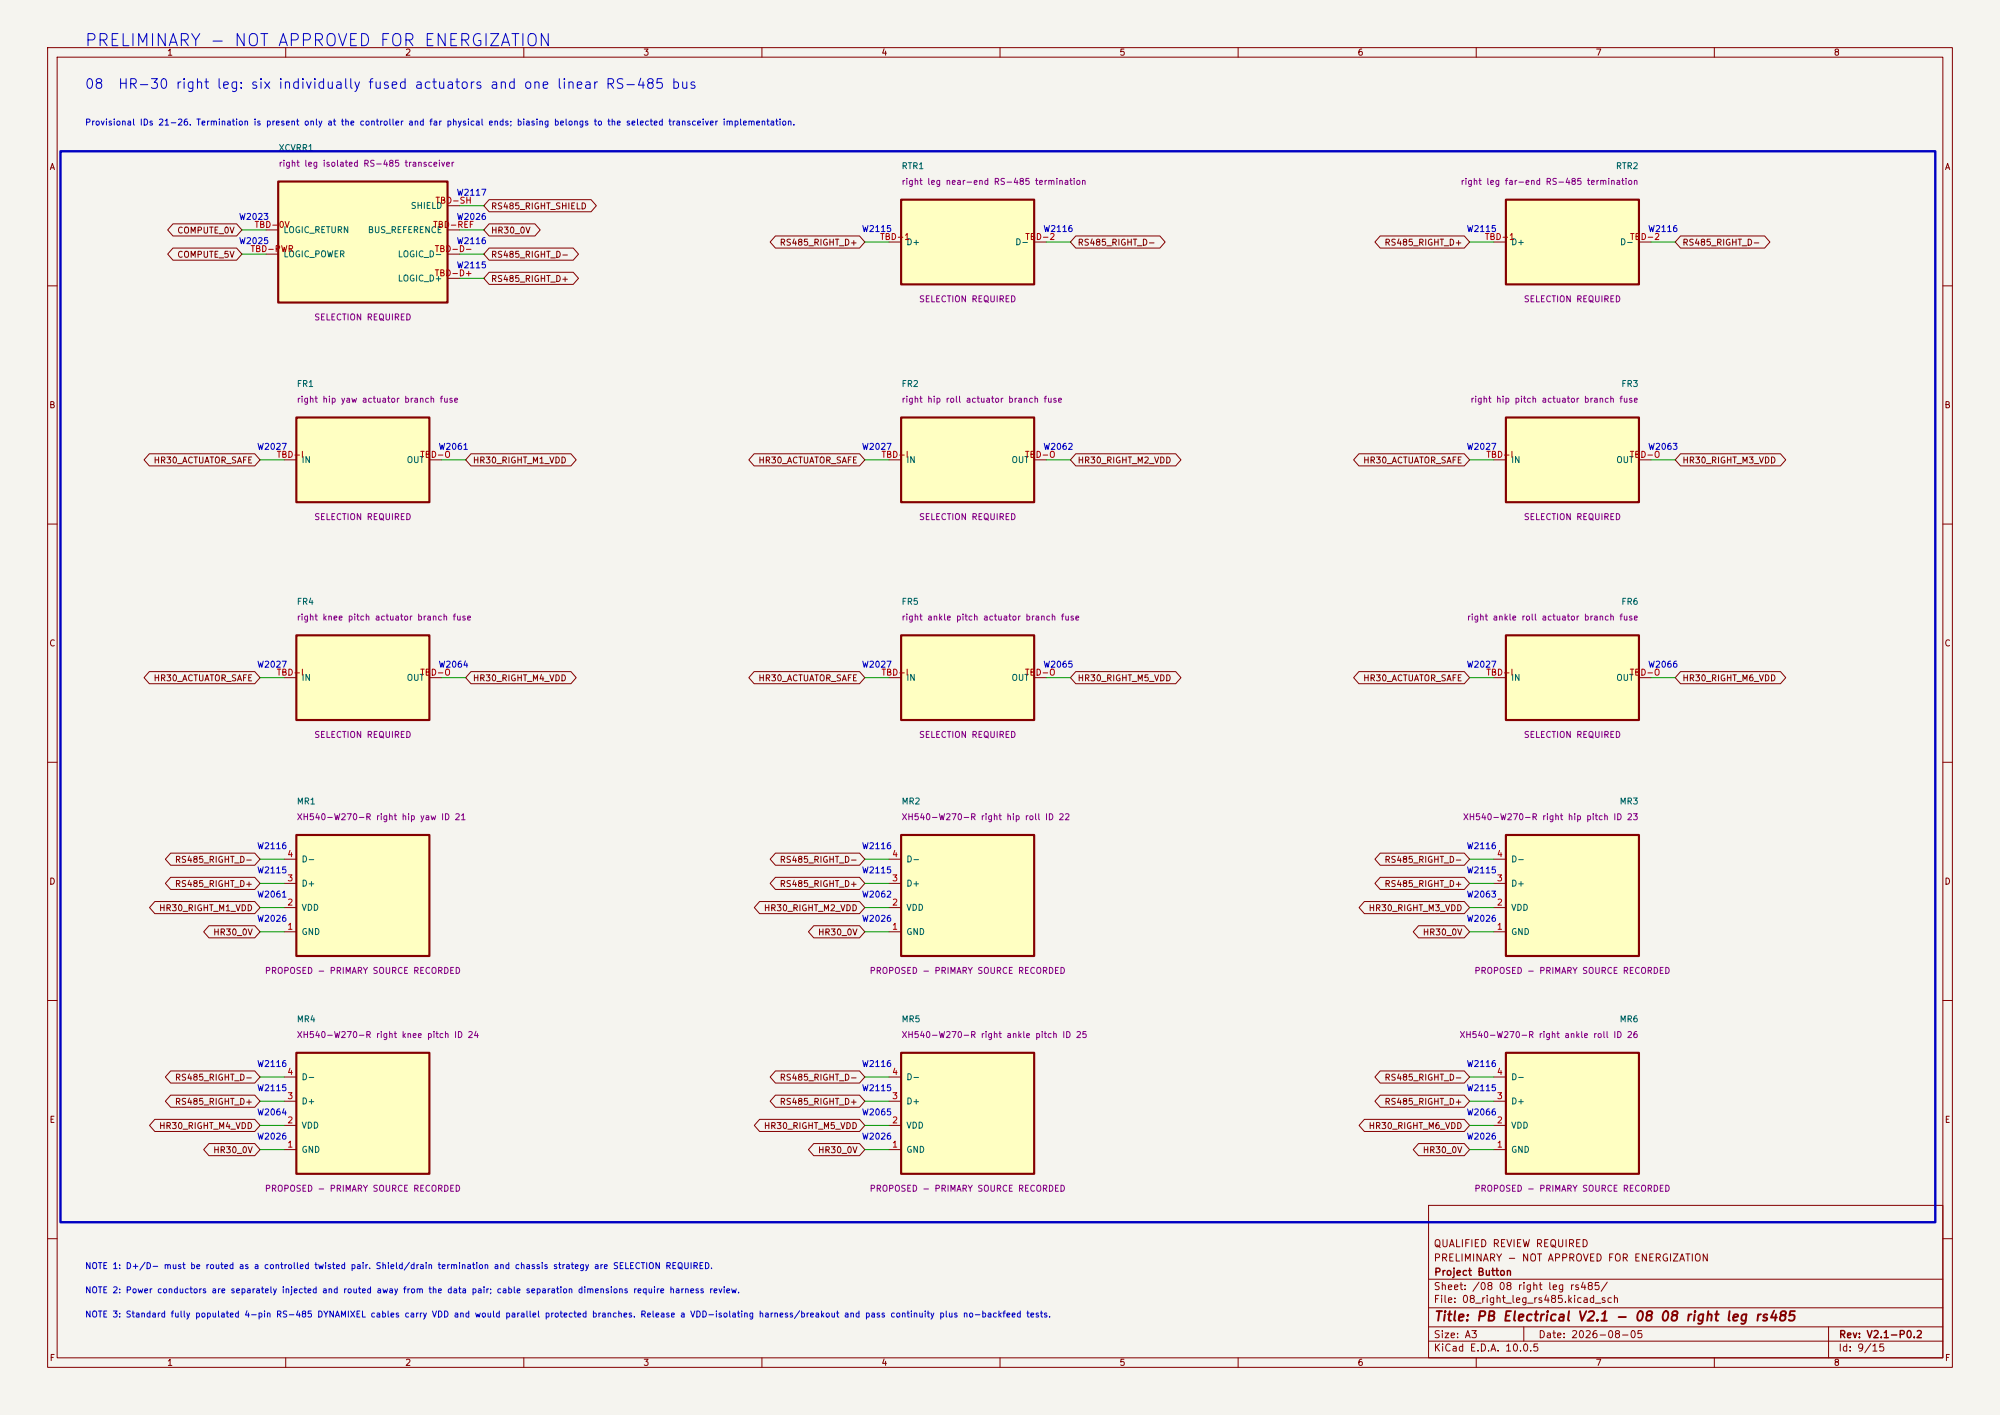
[picture p284: page 9]

W2061 08 HR-30 right leg: six individually fused actuators and one linear RS-485 bus
LOGIC_D-TBD-D- LOGIC_POWER TBD-PWR

Provisional IDs 21-26. Termination is present only at the controller and far physical ends; biasing belongs to the selected transceiver implementation.

right leg isolated RS-485 transceiver

right leg near-end RS-485 termination

right leg far-end RS-485 termination HR30_RIGHT_M5_VDD

right hip yaw actuator branch fuse

right ankle roll actuator branch fuse GND 1

right knee pitch actuator branch fuse

right ankle pitch actuator branch fuse

XH540-W270-R right hip roll ID 22 GND 1

XH540-W270-R right hip pitch ID 23 GND 1

XH540-W270-R right hip yaw ID 21

XH540-W270-R right ankle roll ID 26

QUALIFIED REVIEW REQUIRED
PRELIMINARY - NOT APPROVED FOR ENERGIZATION
Project Button
Sheet: /08 08 right leg rs485/
File: 08_right_leg_rs485.kicad_sch
Title: PB Electrical V2.1 - 08 08 right leg rs485

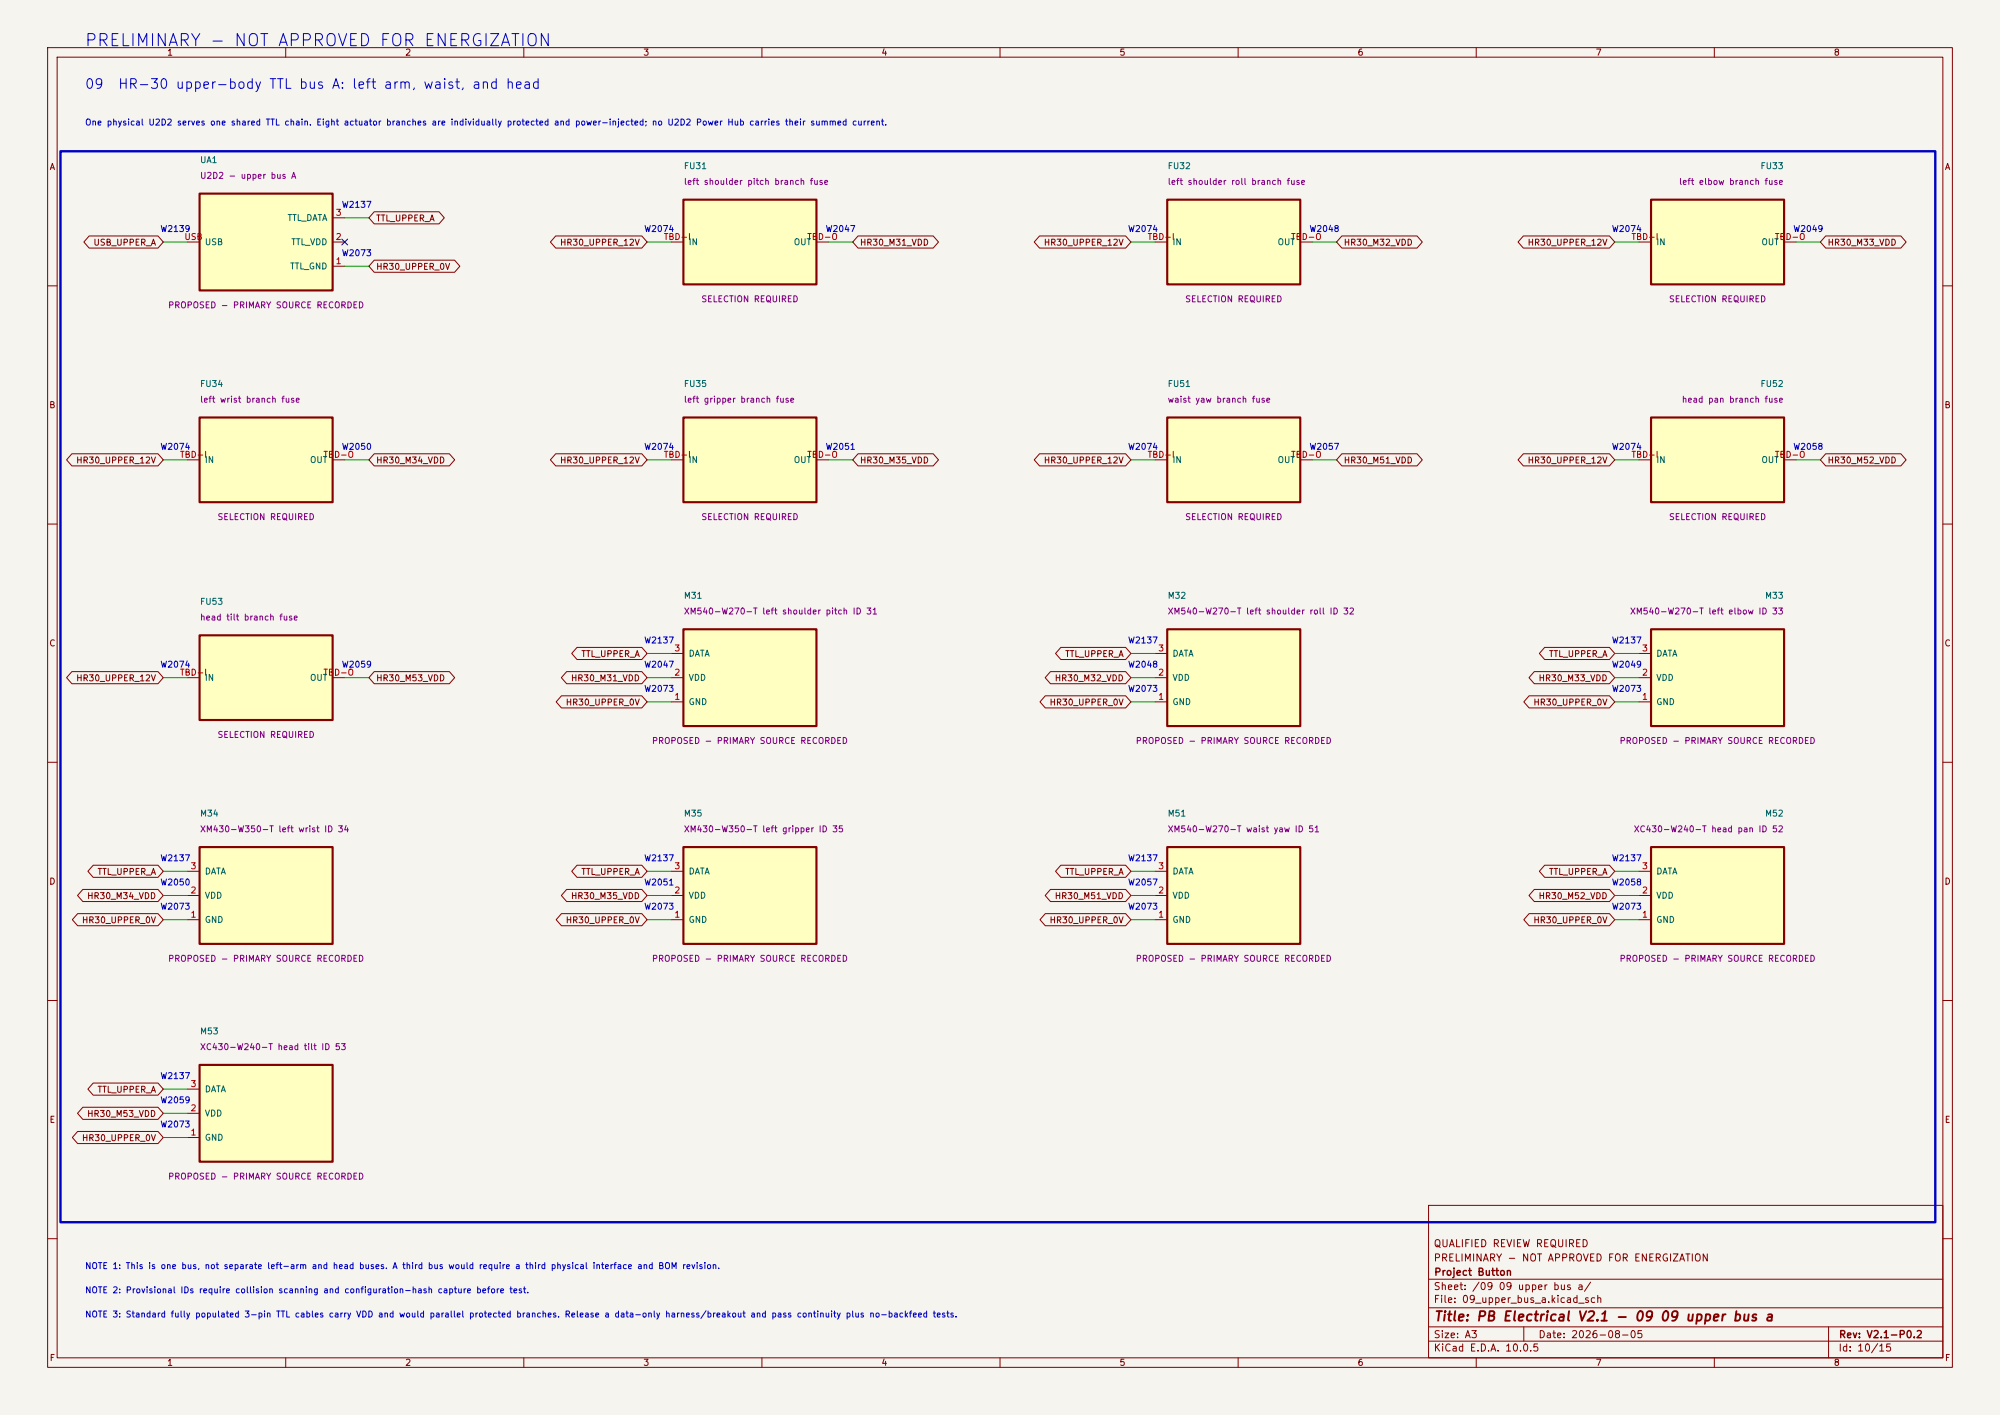
[picture p285: page 10]

09 HR-30 upper-body TTL bus A: left arm, waist, and head

left shoulder pitch branch fuse
left gripper branch fuse GND 1

left shoulder roll branch fuse

left elbow branch fuse

left wrist branch fuse

head pan branch fuse

head tilt branch fuse

XM540-W270-T left elbow ID 33 GND 1

XM540-W270-T left shoulder pitch ID 31

XM540-W270-T left shoulder roll ID 32

XM430-W350-T left gripper ID 35 GND 1

QUALIFIED REVIEW REQUIRED
PRELIMINARY - NOT APPROVED FOR ENERGIZATION
Project Button
Sheet: /09 09 upper bus a/
File: 09_upper_bus_a.kicad_sch
Title: PB Electrical V2.1 - 09 09 upper bus a

NOTE 2: Provisional IDs require collision scanning and configuration-hash capture before test. NOTE 3: Standard fully populated 3-pin TTL cables carry VDD and would parallel protected branches. Release a data-only harness/breakout and pass continuity plus no-backfeed tests.

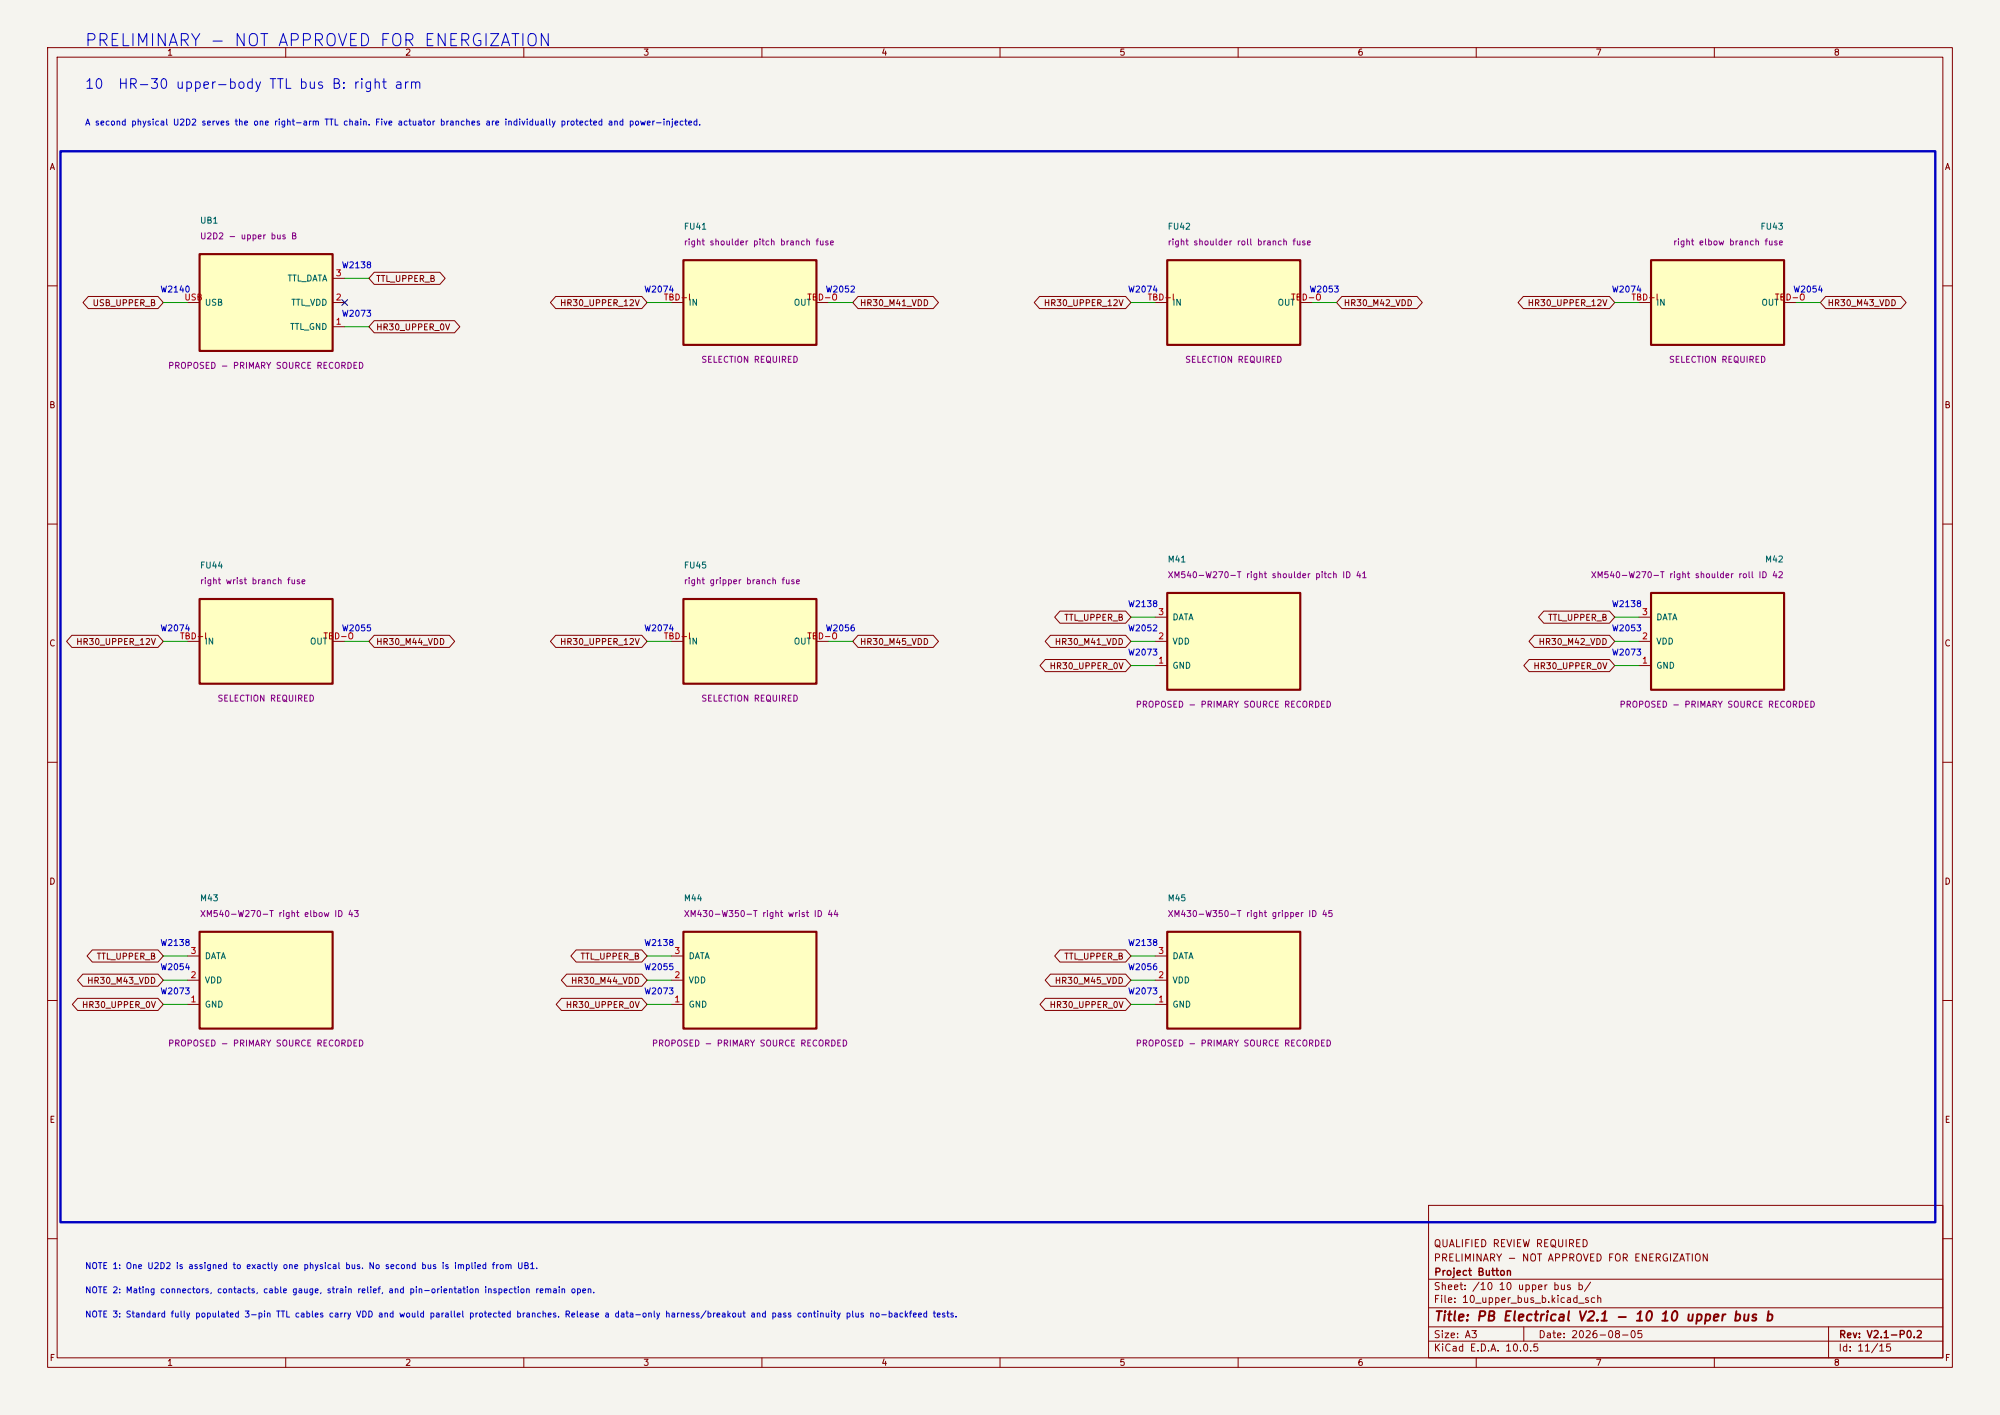
[picture p286: page 11]

right shoulder pitch branch fuse

right elbow branch fuse

XM540-W270-T right shoulder roll ID 42 GND 1

XM540-W270-T right shoulder pitch ID 41 GND 1
right wrist branch fuse

QUALIFIED REVIEW REQUIRED
PRELIMINARY - NOT APPROVED FOR ENERGIZATION
Project Button
Sheet: /10 10 upper bus b/
File: 10_upper_bus_b.kicad_sch
Title: PB Electrical V2.1 - 10 10 upper bus b

NOTE 1: One U2D2 is assigned to exactly one physical bus. No second bus is implied from UB1. NOTE 2: Mating connectors, contacts, cable gauge, strain relief, and pin-orientation inspection remain open. NOTE 3: Standard fully populated 3-pin TTL cables carry VDD and would parallel protected branches. Release a data-only harness/breakout and pass continuity plus no-backfeed tests.

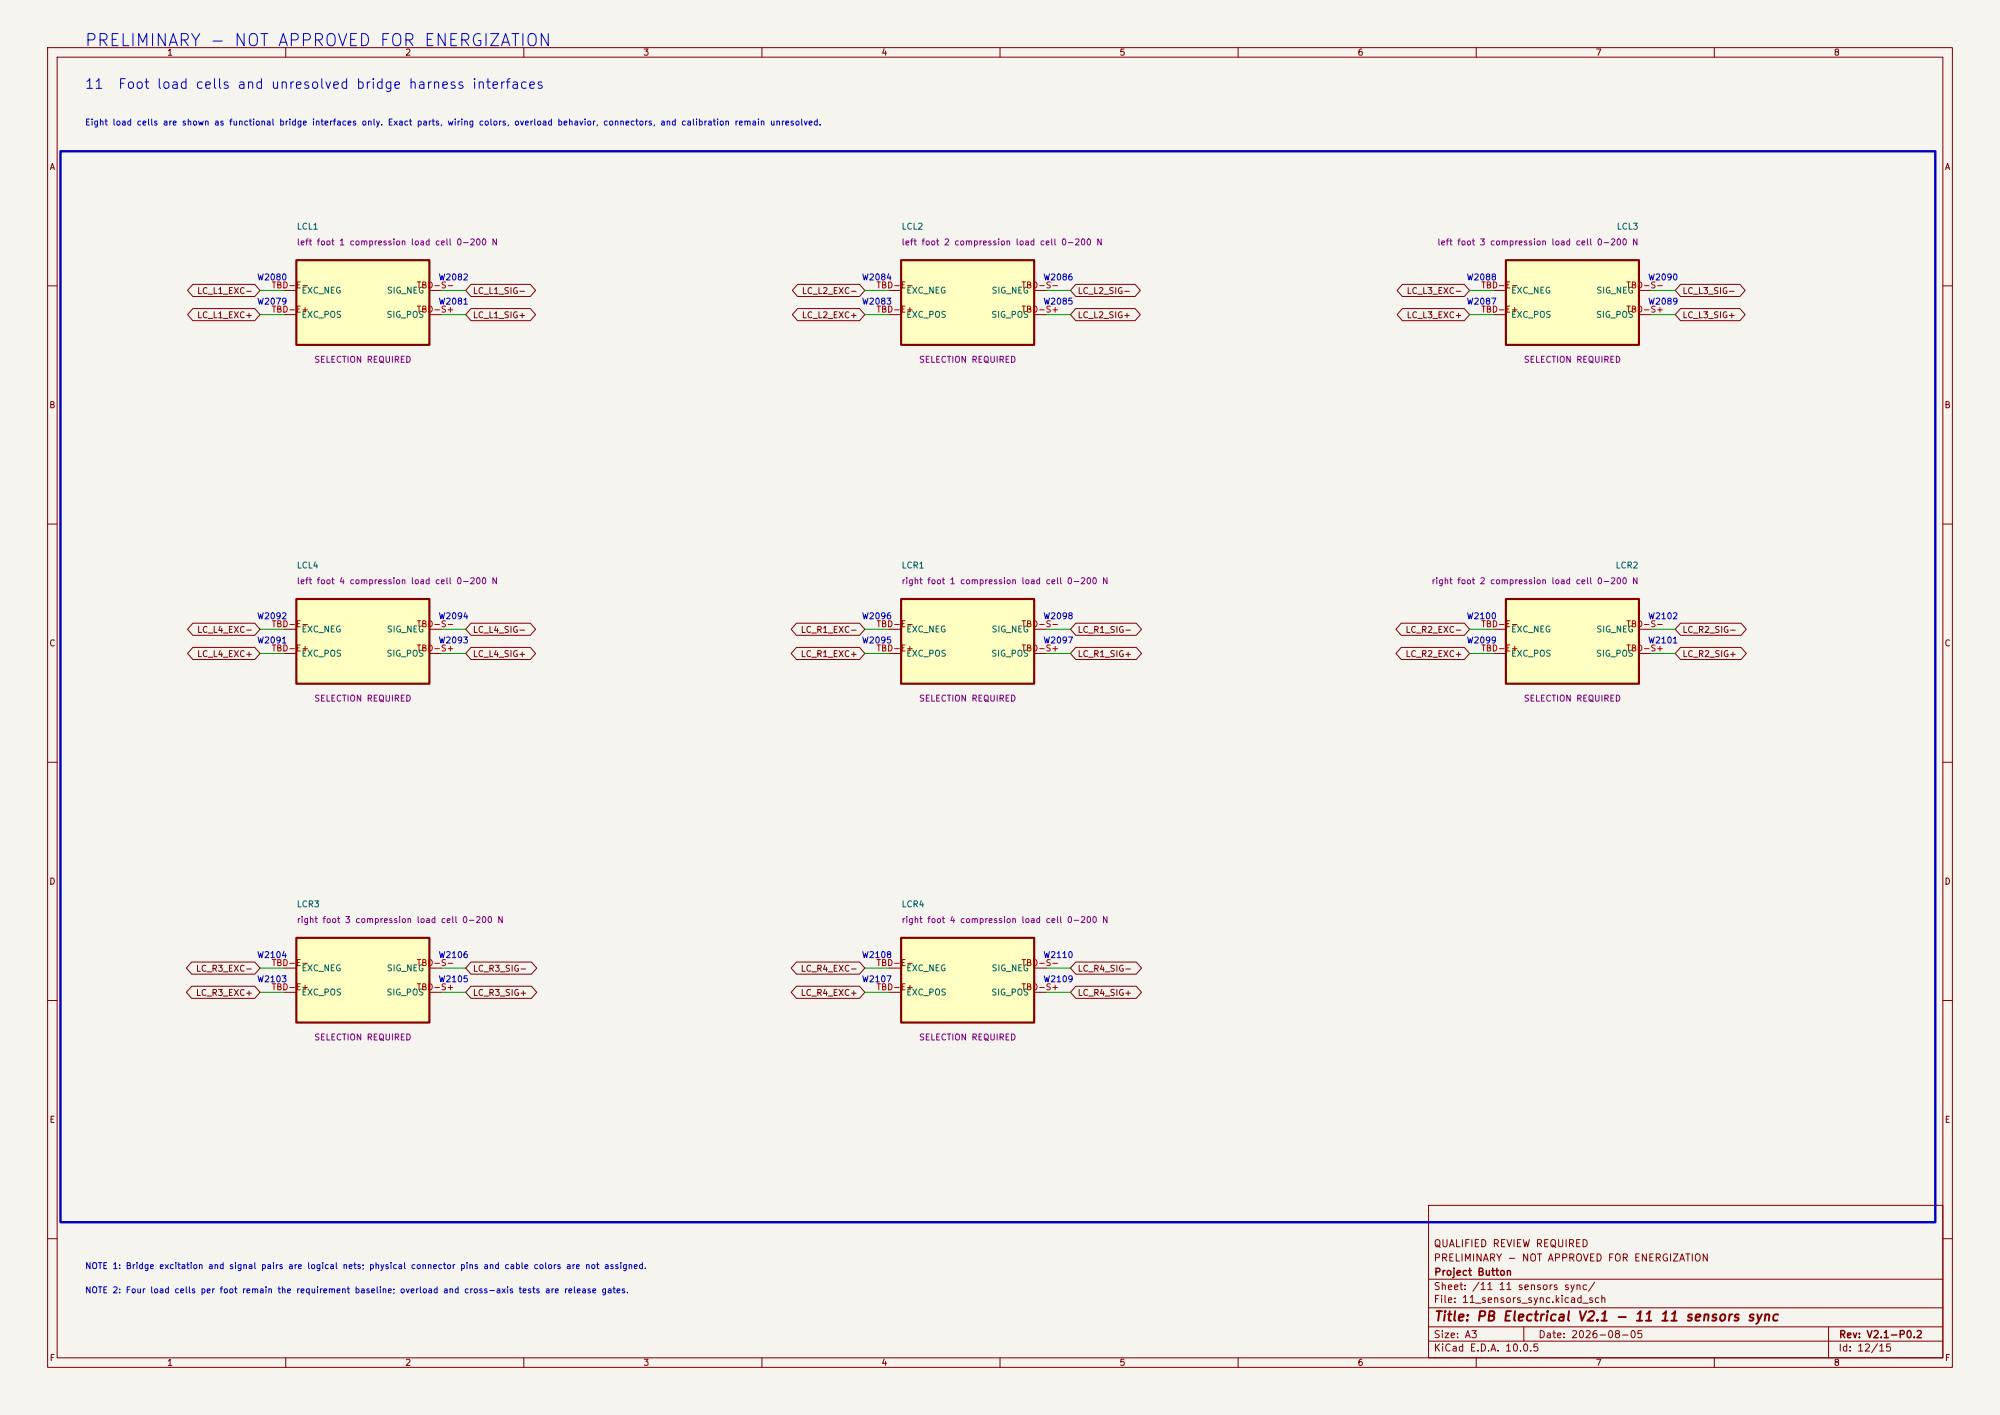
[picture p287: page 12]

W2080 11 Foot load cells and unresolved bridge harness interfaces

Eight load cells are shown as functional bridge interfaces only. Exact parts, wiring colors, overload behavior, connectors, and calibration remain unresolved.

left foot 1 compression load cell 0-200 N

left foot 2 compression load cell 0-200 N

left foot 3 compression load cell 0-200 N

left foot 4 compression load cell 0-200 N

right foot 1 compression load cell 0-200 N

right foot 2 compression load cell 0-200 N

right foot 3 compression load cell 0-200 N

right foot 4 compression load cell 0-200 N

QUALIFIED REVIEW REQUIRED
PRELIMINARY - NOT APPROVED FOR ENERGIZATION
Project Button
Sheet: /11 11 sensors sync/
File: 11_sensors_sync.kicad_sch
Title: PB Electrical V2.1 - 11 11 sensors sync

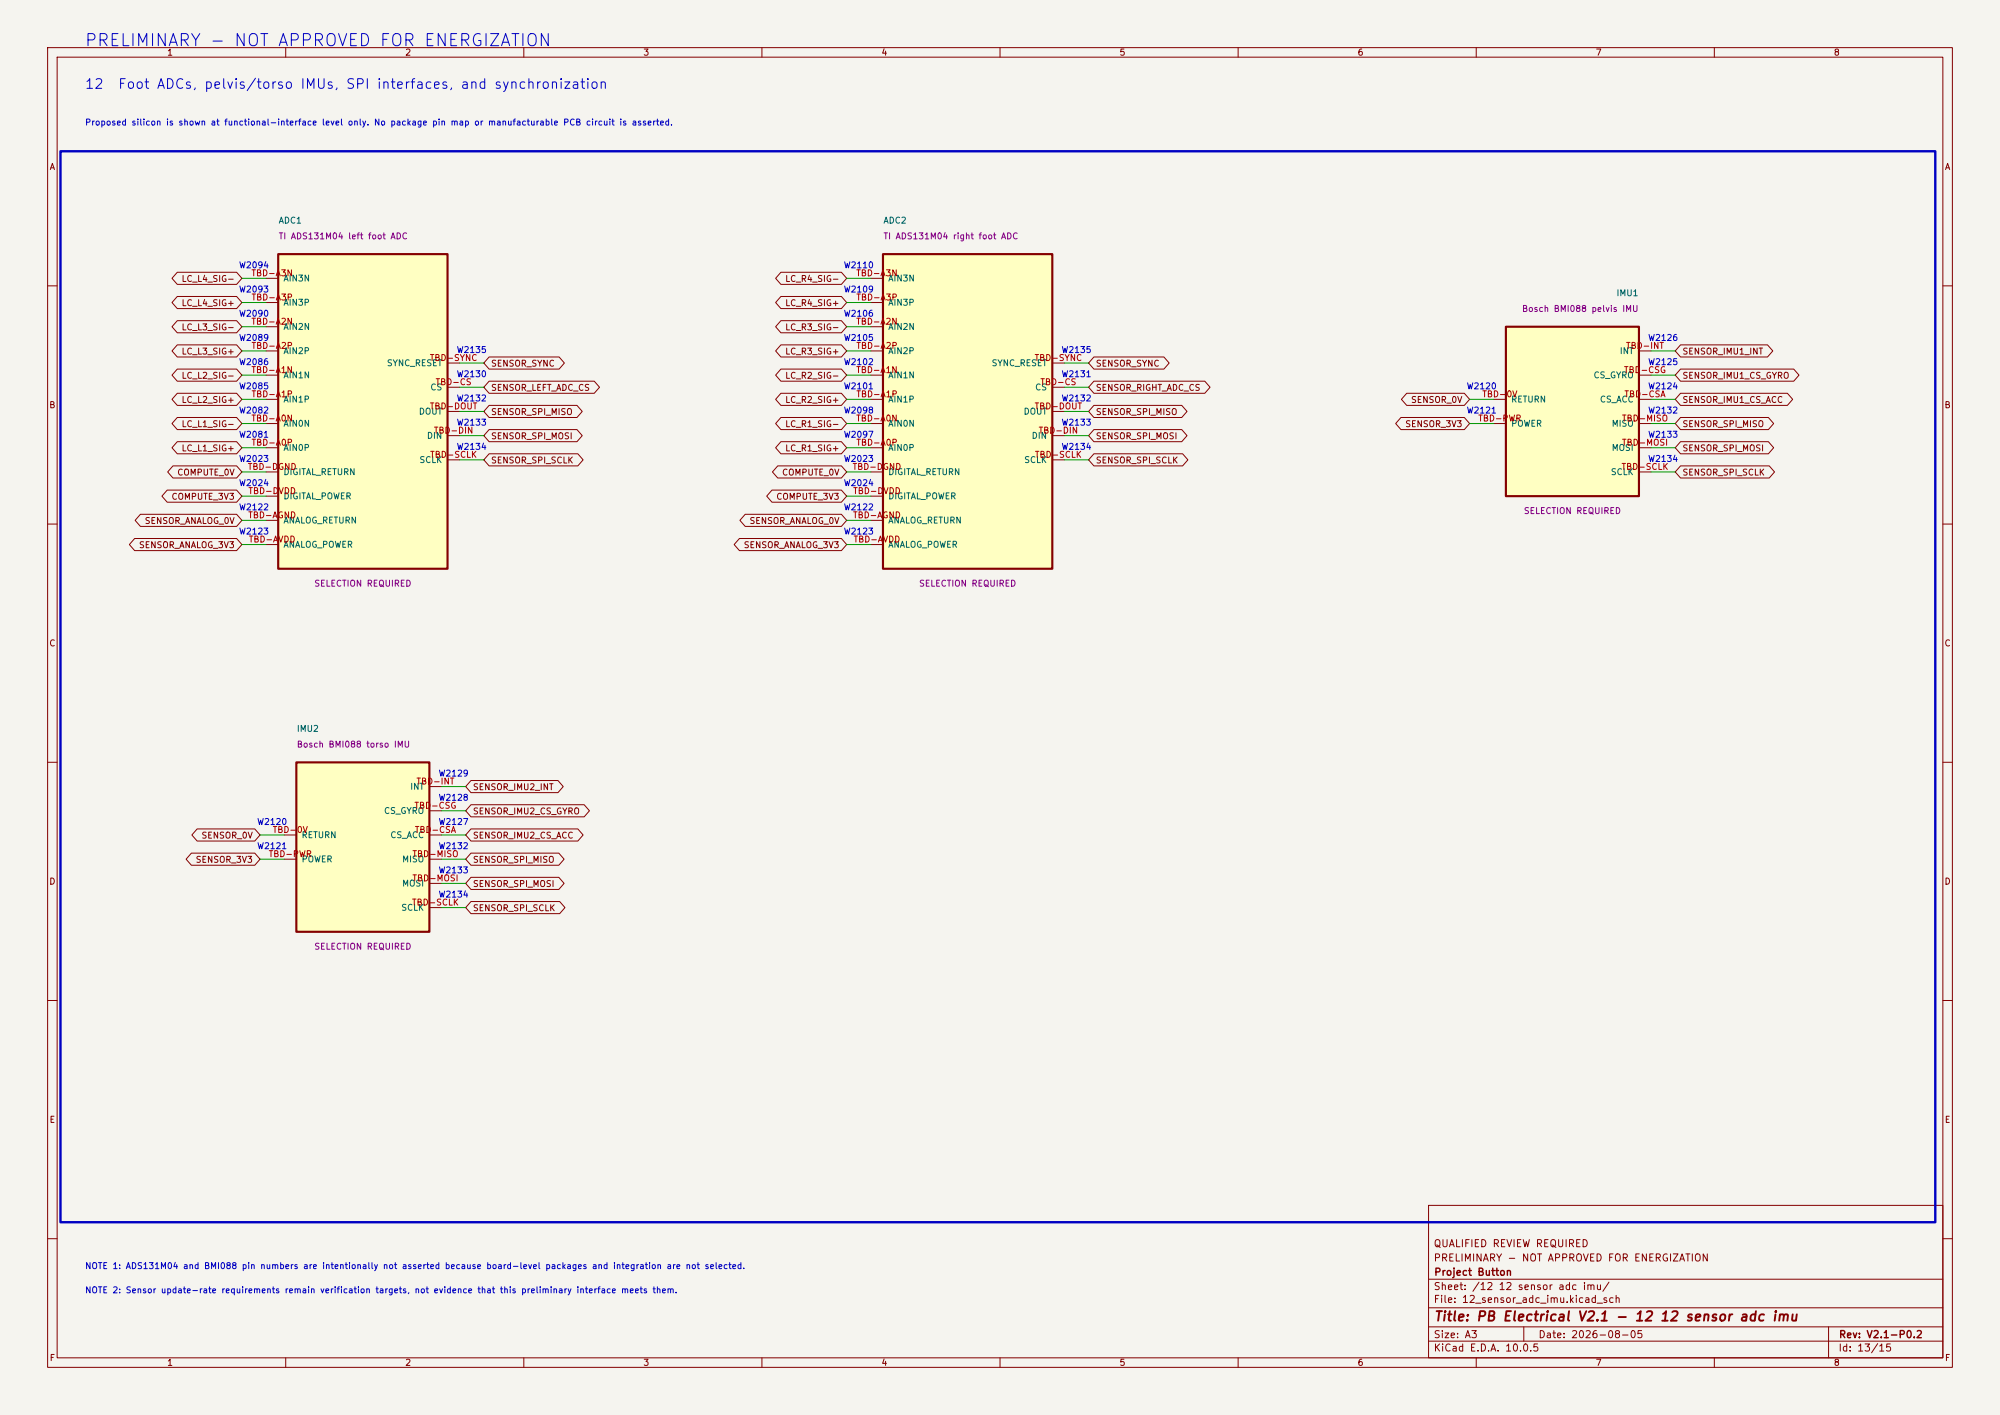
[picture p288: page 13]

W2101 W2081 PRELIMINARY - NOT APPROVED FOR ENERGIZATION

W2094 Proposed silicon is shown at functional-interface level only. No package pin map or manufacturable PCB circuit is asserted. 12 Foot ADCs, pelvis/torso IMUs, SPI interfaces, and synchronization

ADC1
TI ADS131M04 left foot ADC

ADC2
TI ADS131M04 right foot ADC

INTTBD-INT MISOTBD-MISO MOSI TBD-MOSI POWER TBD-PWR

AIN1N TBD-A1N
CSTBD-CS DIGITAL_RETURN TBD-DGND
AIN1P TBD-A1P
DOUT TBD-DOUT DIGITAL_POWER TBD-DVDD
AIN0N TBD-A0N

QUALIFIED REVIEW REQUIRED
PRELIMINARY - NOT APPROVED FOR ENERGIZATION
Project Button
Sheet: /12 12 sensor adc imu/
File: 12_sensor_adc_imu.kicad_sch
Title: PB Electrical V2.1 - 12 12 sensor adc imu

NOTE 1: ADS131M04 and BMI088 pin numbers are intentionally not asserted because board-level packages and integration are not selected. NOTE 2: Sensor update-rate requirements remain verification targets, not evidence that this preliminary interface meets them.

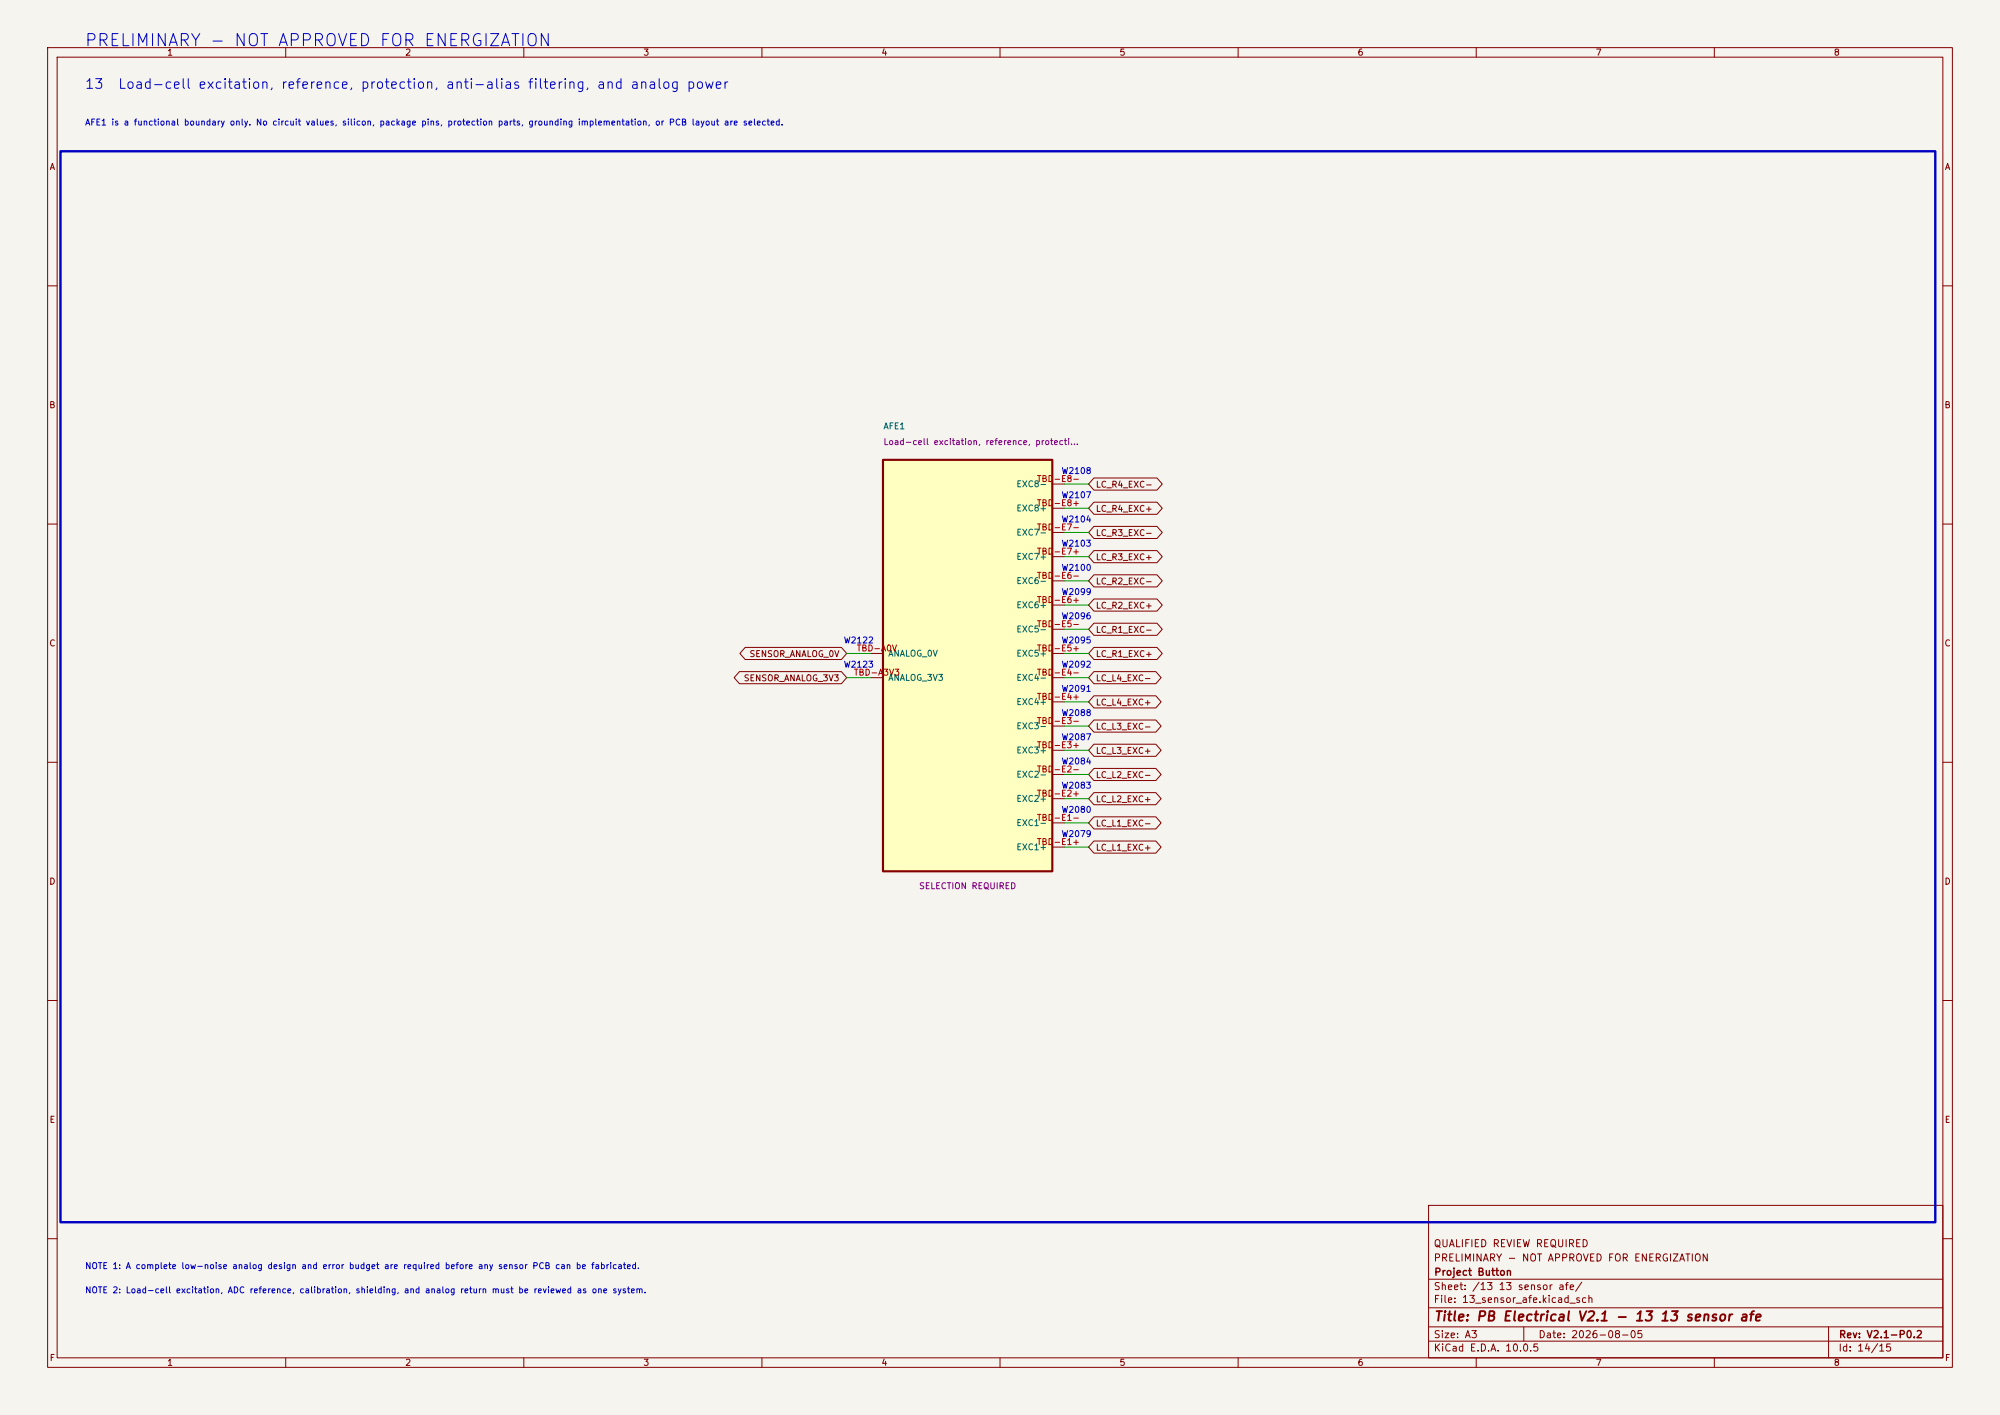
[picture p289: page 14]

QUALIFIED REVIEW REQUIRED
PRELIMINARY - NOT APPROVED FOR ENERGIZATION
Project Button
Sheet: /13 13 sensor afe/
File: 13_sensor_afe.kicad_sch
Title: PB Electrical V2.1 - 13 13 sensor afe

NOTE 2: Load-cell excitation, ADC reference, calibration, shielding, and analog return must be reviewed as one system.

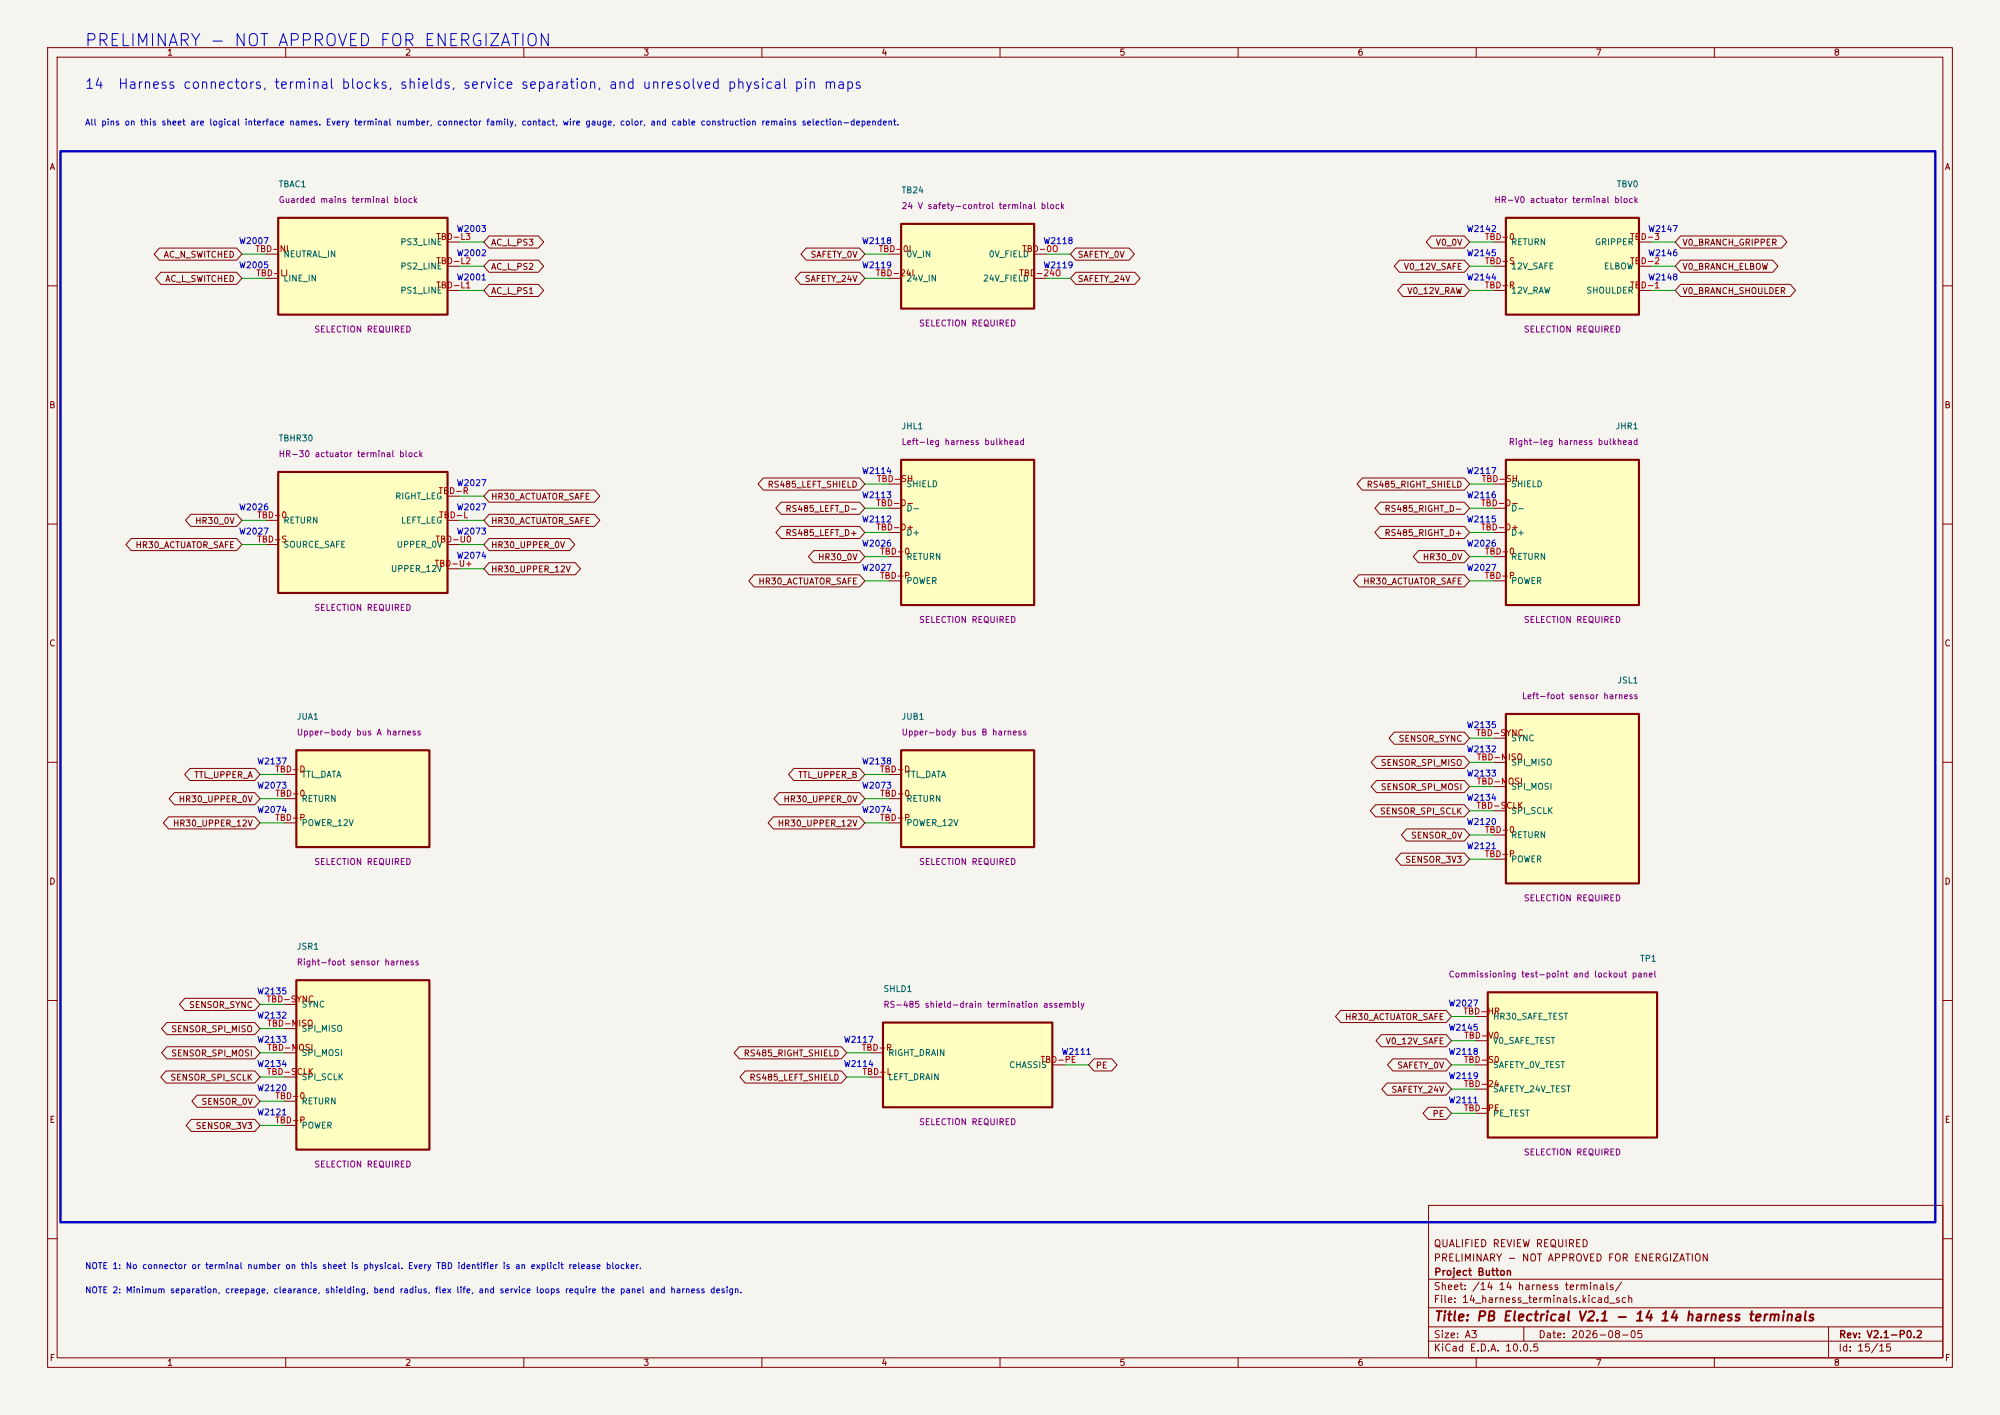
[picture p290: page 15]

W2001 PRELIMINARY - NOT APPROVED FOR ENERGIZATION

14 Harness connectors, terminal blocks, shields, service separation, and unresolved physical pin maps

All pins on this sheet are logical interface names. Every terminal number, connector family, contact, wire gauge, color, and cable construction remains selection-dependent. W2027W2133

Guarded mains terminal block

24 V safety-control terminal block

SELECTION REQUIRED HR-V0 actuator terminal block SAFETY_24V

SELECTION REQUIRED HR-30 actuator terminal block PS1_LINETBD-L1 PS2_LINETBD-L2 PS3_LINETBD-L3

Left-foot sensor harness RETURN TBD-0

JUB1
SELECTION REQUIRED Upper-body bus B harness

W2133 NOTE 1: No connector or terminal number on this sheet is physical. Every TBD identifier is an explicit release blocker.

SPI_MOSI TBD-MOSI POWER TBD-P

Commissioning test-point and lockout panel

RS-485 shield-drain termination assembly

QUALIFIED REVIEW REQUIRED
PRELIMINARY - NOT APPROVED FOR ENERGIZATION
Project Button
Sheet: /14 14 harness terminals/
File: 14_harness_terminals.kicad_sch
Title: PB Electrical V2.1 - 14 14 harness terminals

NOTE 2: Minimum separation, creepage, clearance, shielding, bend radius, flex life, and service loops require the panel and harness design.
