amyleesterling/humanoid-robot/(list of files, drawings)

Other design files:
electrical/kicad/hr-v0-runtime-observation-carrier-p0.2/validation/pcb-summary.json
electrical/kicad/hr-v0-runtime-observation-carrier-p0.3/validation/pcb-summary.json
electrical/kicad/hr-v0-runtime-observation-carrier-p0.4/validation/pcb-summary.json
electrical/kicad/hr-v0-runtime-observation-carrier-p0.5/validation/pcb-summary.json
electrical/manufacturing/hr-v0-watchdog-footprint-metadata-p0.1/pcb-p0.7-geometry-topology-baseline.json
electrical/manufacturing/hr-v0-watchdog-footprint-metadata-p0.1/pcb-p0.8-geometry-topology-current.json
