amyleesterling/humanoid-robot/hr30/whole-body-p0.1/electrical/walking-power-successor-p0.1/hr30-walking-power-successor-p0.1.kicad_pcb

## KiCad design hr30/whole-body-p0.1/electrical/walking-power-successor-p0.1/hr30-walking-power-successor-p0.1.kicad_pcb (2026-08-17)

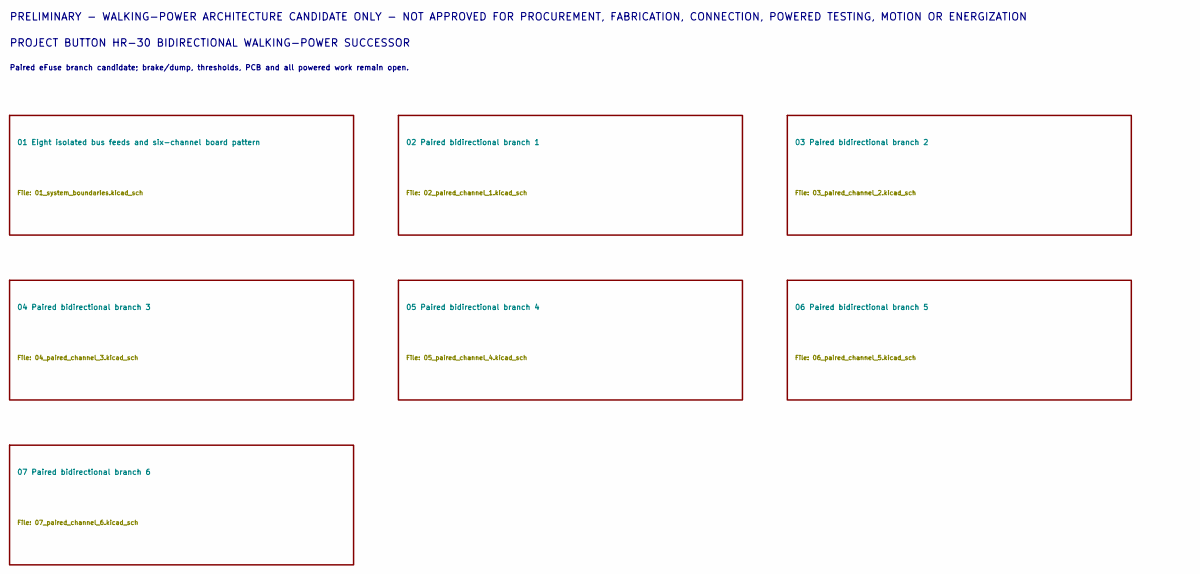
[picture p291: schematic hr30-walking-power-successor-p0.1.kicad_sch, PROJECT BUTTON HR-30 BIDIRECTIONAL WALKING-POWER SUCCESSOR …]

Notes on the sheet:
PRELIMINARY - WALKING-POWER ARCHITECTURE CANDIDATE ONLY - NOT APPROVED FOR PROCUREMENT, FABRICATION, CONNECTION, POWERED TESTING, MOTION OR ENERGIZATION
PROJECT BUTTON HR-30 BIDIRECTIONAL WALKING-POWER SUCCESSOR
Paired eFuse branch candidate; brake/dump, thresholds, PCB and all powered work remain open.

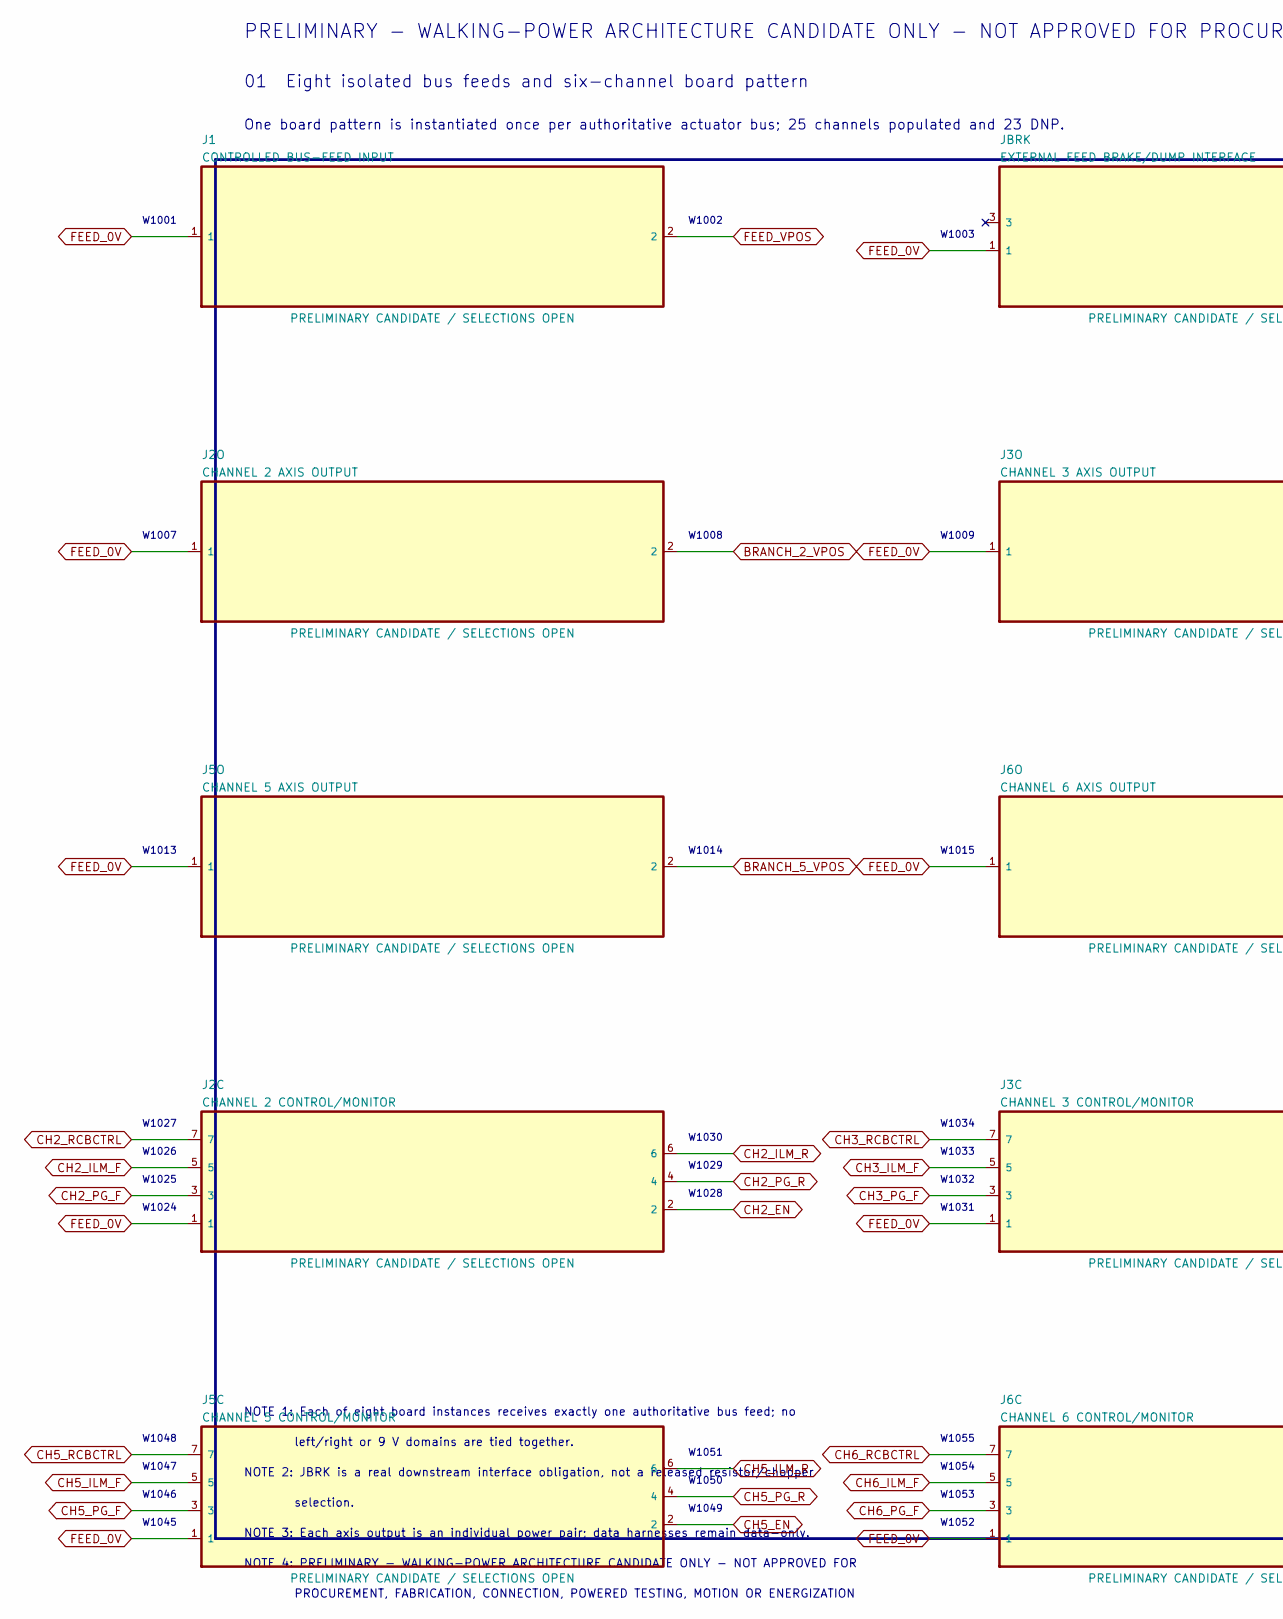
[picture p292: schematic 01_system_boundaries.kicad_sch, PB HR-V0 P0.1 - 01, part in row 1, column 1]

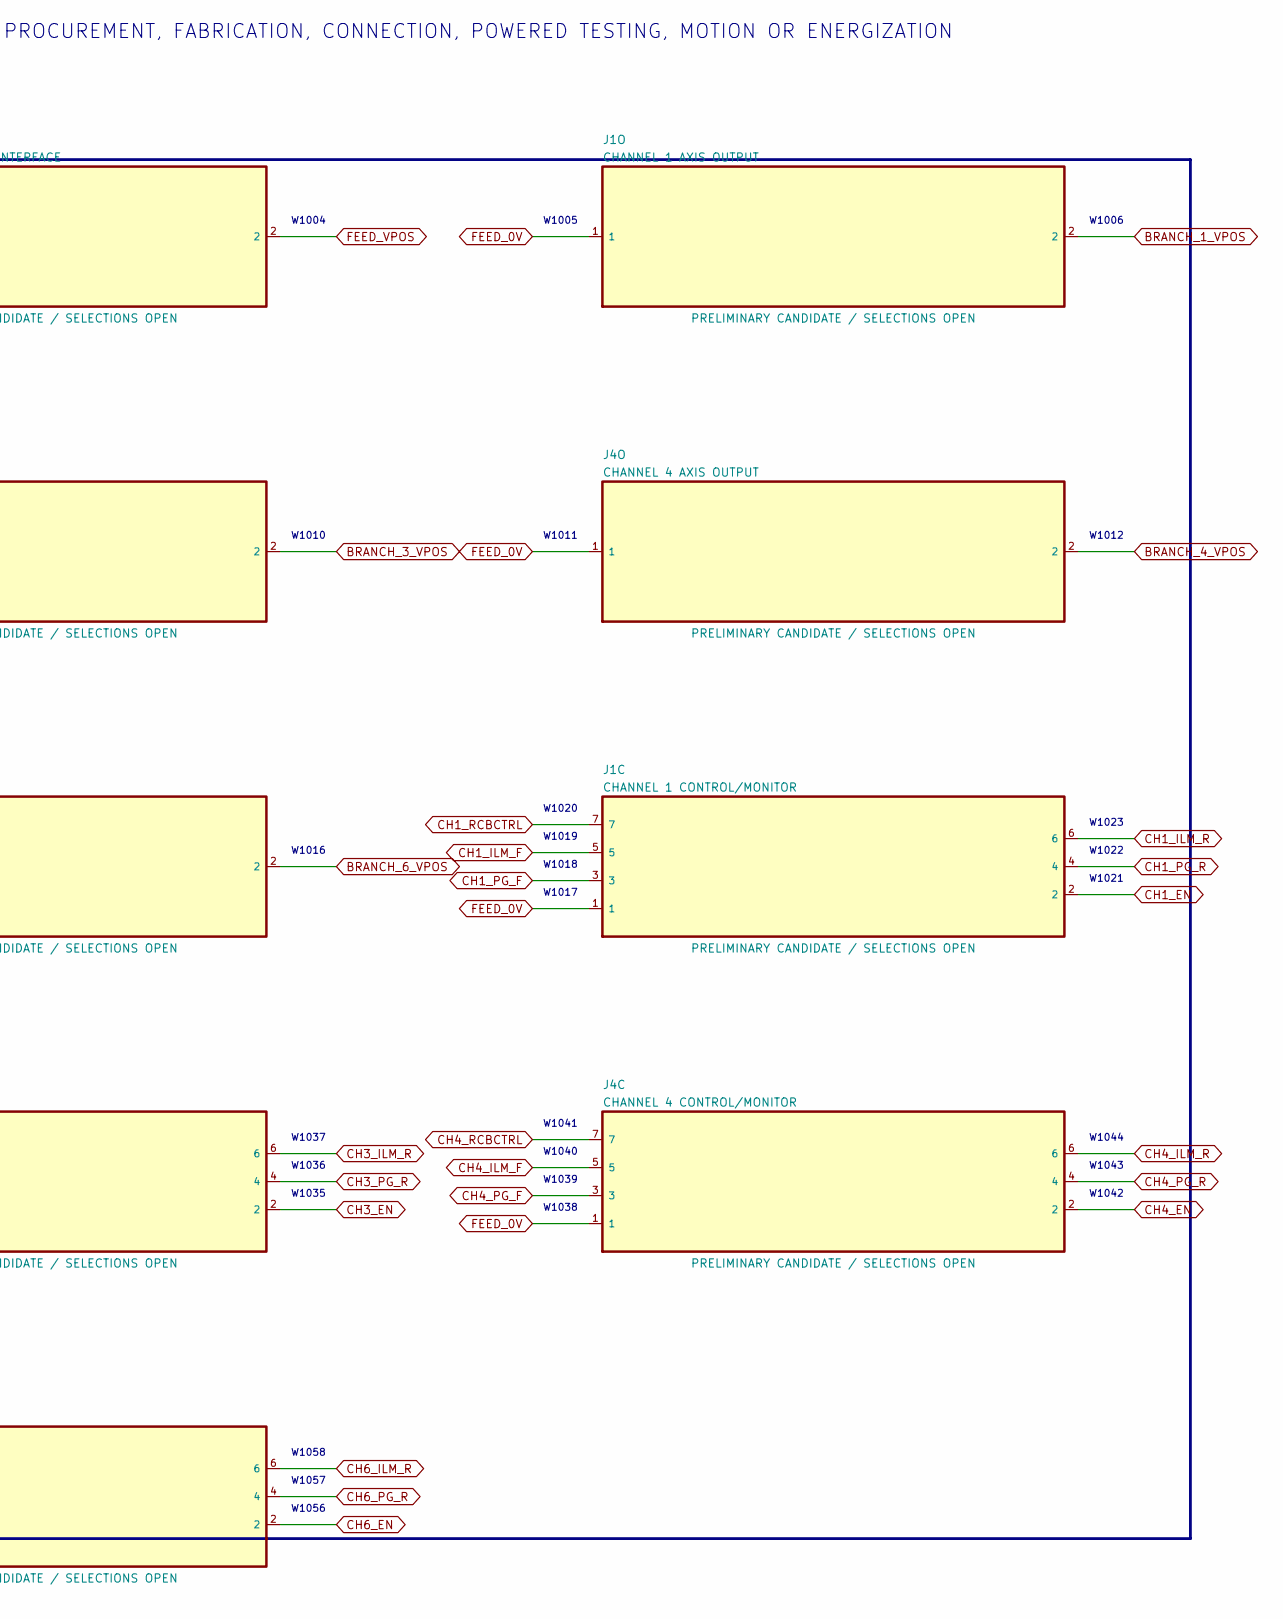
[picture p293: schematic 01_system_boundaries.kicad_sch, PB HR-V0 P0.1 - 01, part in row 1, column 2]

Parts:
J1: CONTROLLED BUS-FEED INPUT; TerminalBlock_MetzConnect_Type703_RT10N02HGLU_1x02_P9.52mm_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
J1C: CHANNEL 1 CONTROL/MONITOR; JST_GH_BM07B-GHS-TBT_1x07-1MP_P1.25mm_Vertical
J1O: CHANNEL 1 AXIS OUTPUT; JST_VH_B2P-VH_1x02_P3.96mm_Vertical
J2C: CHANNEL 2 CONTROL/MONITOR; JST_GH_BM07B-GHS-TBT_1x07-1MP_P1.25mm_Vertical
J2O: CHANNEL 2 AXIS OUTPUT; JST_VH_B2P-VH_1x02_P3.96mm_Vertical
J3C: CHANNEL 3 CONTROL/MONITOR; JST_GH_BM07B-GHS-TBT_1x07-1MP_P1.25mm_Vertical
J3O: CHANNEL 3 AXIS OUTPUT; JST_VH_B2P-VH_1x02_P3.96mm_Vertical
J4C: CHANNEL 4 CONTROL/MONITOR; JST_GH_BM07B-GHS-TBT_1x07-1MP_P1.25mm_Vertical
J4O: CHANNEL 4 AXIS OUTPUT; JST_VH_B2P-VH_1x02_P3.96mm_Vertical
J5C: CHANNEL 5 CONTROL/MONITOR; JST_GH_BM07B-GHS-TBT_1x07-1MP_P1.25mm_Vertical
J5O: CHANNEL 5 AXIS OUTPUT; JST_VH_B2P-VH_1x02_P3.96mm_Vertical
J6C: CHANNEL 6 CONTROL/MONITOR; JST_GH_BM07B-GHS-TBT_1x07-1MP_P1.25mm_Vertical
J6O: CHANNEL 6 AXIS OUTPUT; JST_VH_B2P-VH_1x02_P3.96mm_Vertical
JBRK: EXTERNAL FEED BRAKE/DUMP INTERFACE; JST_VH_B3P-VH_1x03_P3.96mm_Vertical

Connections:
BRANCH_1_VPOS: J1O.2; also elsewhere on the board
BRANCH_2_VPOS: J2O.2; also elsewhere on the board
BRANCH_3_VPOS: J3O.2; also elsewhere on the board
BRANCH_4_VPOS: J4O.2; also elsewhere on the board
BRANCH_5_VPOS: J5O.2; also elsewhere on the board
BRANCH_6_VPOS: J6O.2; also elsewhere on the board
CH1_EN: J1C.2; also elsewhere on the board
CH1_ILM_F: J1C.5; also elsewhere on the board
CH1_ILM_R: J1C.6; also elsewhere on the board
CH1_PG_F: J1C.3; also elsewhere on the board
CH1_PG_R: J1C.4; also elsewhere on the board
CH1_RCBCTRL: J1C.7; also elsewhere on the board
CH2_EN: J2C.2; also elsewhere on the board
CH2_ILM_F: J2C.5; also elsewhere on the board
CH2_ILM_R: J2C.6; also elsewhere on the board
CH2_PG_F: J2C.3; also elsewhere on the board
CH2_PG_R: J2C.4; also elsewhere on the board
CH2_RCBCTRL: J2C.7; also elsewhere on the board
CH3_EN: J3C.2; also elsewhere on the board
CH3_ILM_F: J3C.5; also elsewhere on the board
CH3_ILM_R: J3C.6; also elsewhere on the board
CH3_PG_F: J3C.3; also elsewhere on the board
CH3_PG_R: J3C.4; also elsewhere on the board
CH3_RCBCTRL: J3C.7; also elsewhere on the board
CH4_EN: J4C.2; also elsewhere on the board
CH4_ILM_F: J4C.5; also elsewhere on the board
CH4_ILM_R: J4C.6; also elsewhere on the board
CH4_PG_F: J4C.3; also elsewhere on the board
CH4_PG_R: J4C.4; also elsewhere on the board
CH4_RCBCTRL: J4C.7; also elsewhere on the board
CH5_EN: J5C.2; also elsewhere on the board
CH5_ILM_F: J5C.5; also elsewhere on the board
CH5_ILM_R: J5C.6; also elsewhere on the board
CH5_PG_F: J5C.3; also elsewhere on the board
CH5_PG_R: J5C.4; also elsewhere on the board
CH5_RCBCTRL: J5C.7; also elsewhere on the board
CH6_EN: J6C.2; also elsewhere on the board
CH6_ILM_F: J6C.5; also elsewhere on the board
CH6_ILM_R: J6C.6; also elsewhere on the board
CH6_PG_F: J6C.3; also elsewhere on the board
CH6_PG_R: J6C.4; also elsewhere on the board
CH6_RCBCTRL: J6C.7; also elsewhere on the board
DUMP_DIAG: JBRK.3
FEED_0V: J1.1, J1C.1, J1O.1, J2C.1, J2O.1, J3C.1, J3O.1, J4C.1, J4O.1, J5C.1, J5O.1, J6C.1, J6O.1, JBRK.1; also elsewhere on the board
FEED_VPOS: J1.2, JBRK.2; also elsewhere on the board

Notes on the sheet:
PRELIMINARY - WALKING-POWER ARCHITECTURE CANDIDATE ONLY - NOT APPROVED FOR PROCUREMENT, FABRICATION, CONNECTION, POWERED TESTING, MOTION OR ENERGIZATION
01 Eight isolated bus feeds and six-channel board pattern
One board pattern is instantiated once per authoritative actuator bus; 25 channels populated and 23 DNP.
W1001
W1002
W1003
W1004
W1005
W1006
W1007
W1008
W1009
W1010
W1011
W1012
W1013
W1014
W1015
W1016
W1017
W1018
W1019
W1020
W1021
W1022
W1023
W1024
W1025
W1026
W1027
W1028
W1029
W1030
W1031
W1032
W1033
W1034
W1035
W1036
W1037
W1038
W1039
W1040
W1041
W1042
W1043
W1044
W1045
W1046
W1047
W1048
W1049
W1050
W1051
W1052
W1053
W1054
W1055
W1056
W1057
W1058
NOTE 1: Each of eight board instances receives exactly one authoritative bus feed; no
left/right or 9 V domains are tied together.
NOTE 2: JBRK is a real downstream interface obligation, not a released resistor/chopper
selection.
NOTE 3: Each axis output is an individual power pair; data harnesses remain data-only.
NOTE 4: PRELIMINARY - WALKING-POWER ARCHITECTURE CANDIDATE ONLY - NOT APPROVED FOR
PROCUREMENT, FABRICATION, CONNECTION, POWERED TESTING, MOTION OR ENERGIZATION

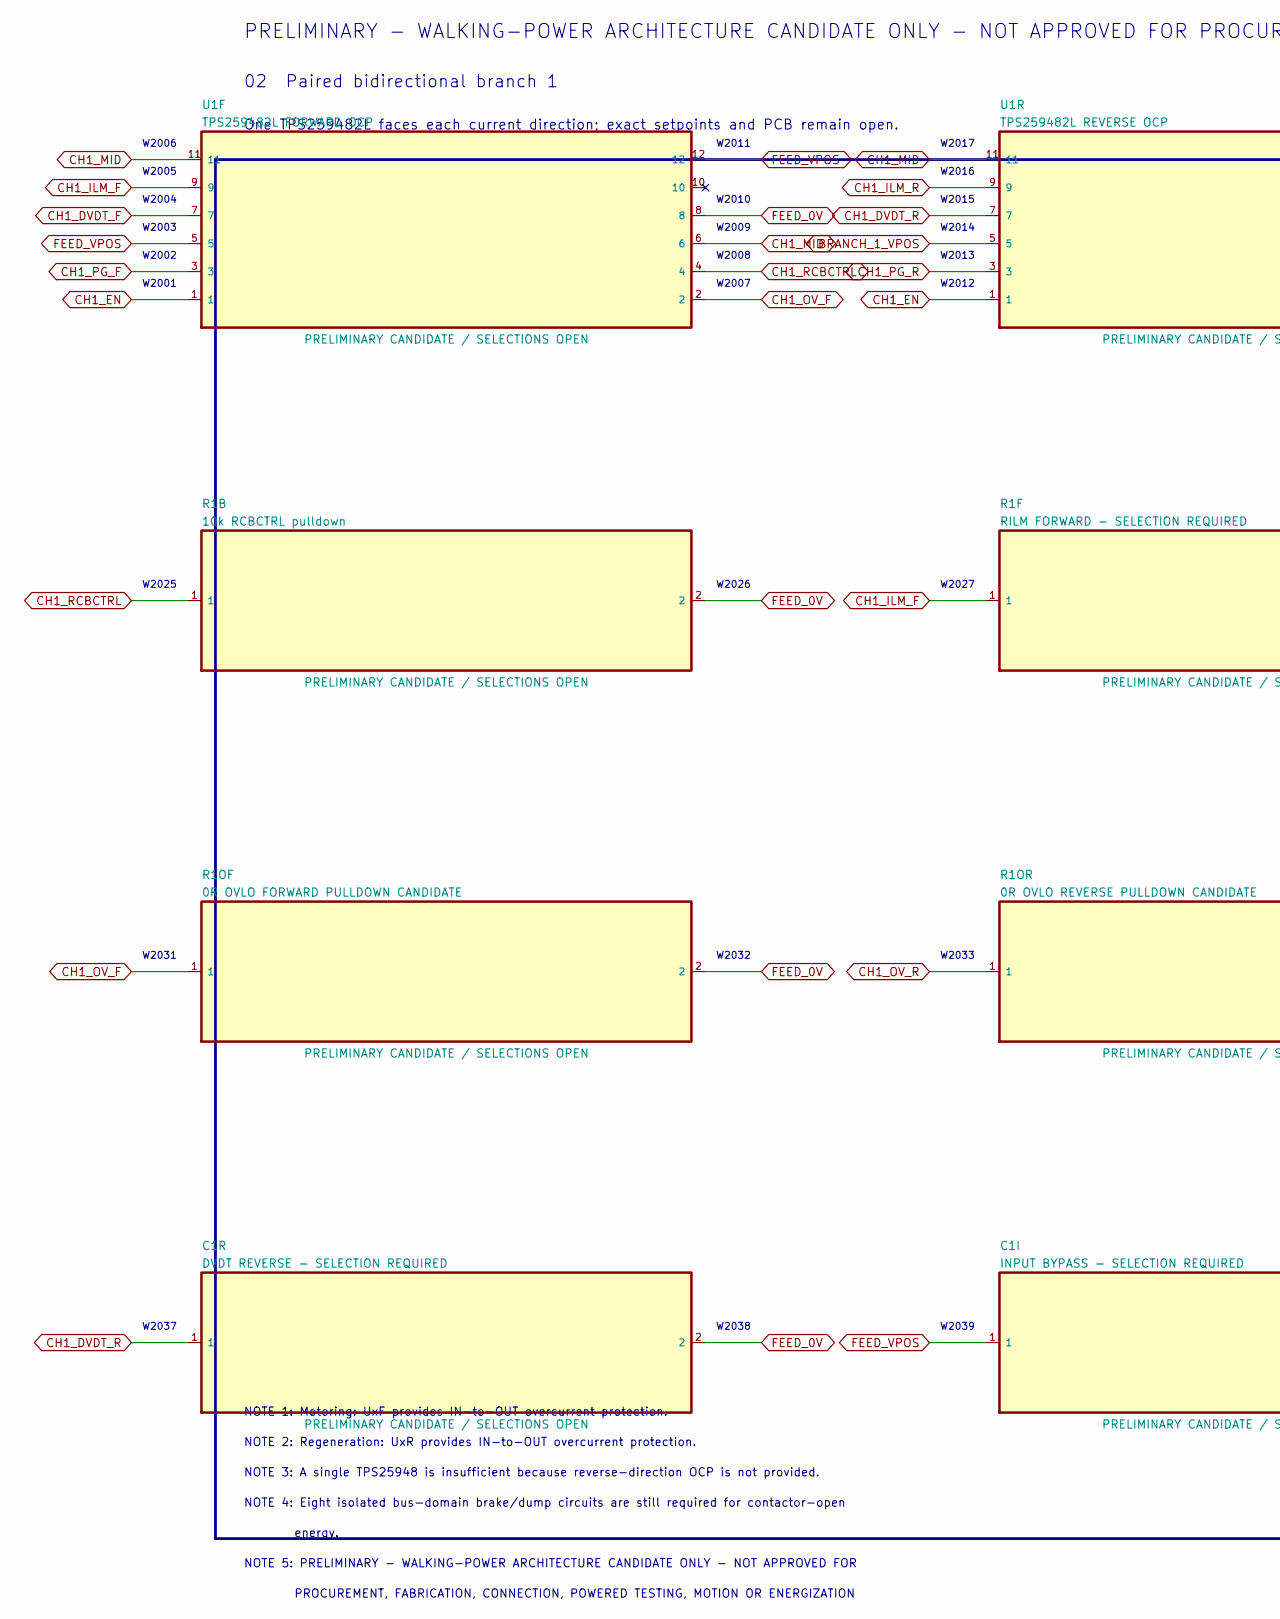
[picture p294: schematic 02_paired_channel_1.kicad_sch, PB HR-V0 P0.1 - 02, part in row 1, column 1]

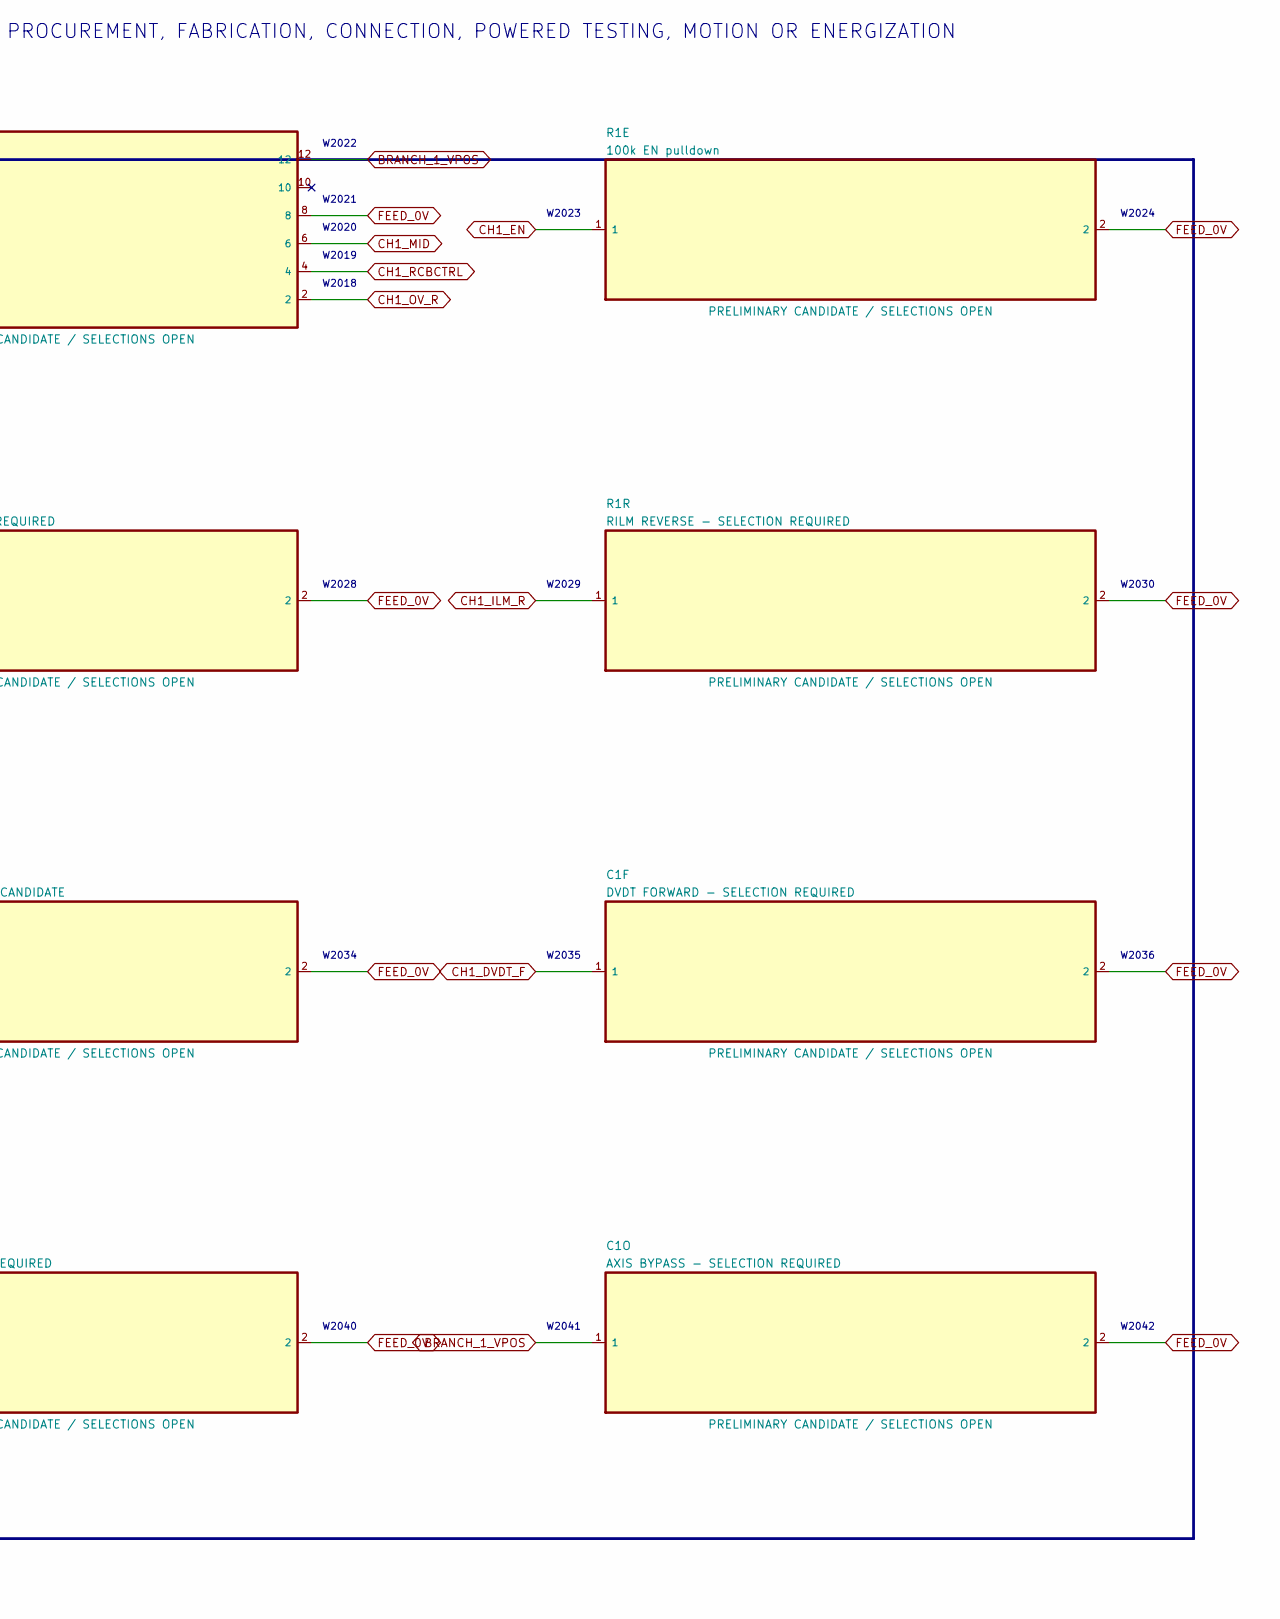
[picture p295: schematic 02_paired_channel_1.kicad_sch, PB HR-V0 P0.1 - 02, part in row 1, column 2]

Parts:
C1F: DVDT FORWARD - SELECTION REQUIRED; C_0603_1608Metric
C1I: INPUT BYPASS - SELECTION REQUIRED; C_0805_2012Metric
C1O: AXIS BYPASS - SELECTION REQUIRED; C_0805_2012Metric
C1R: DVDT REVERSE - SELECTION REQUIRED; C_0603_1608Metric
R1B: 10k RCBCTRL pulldown; R_0603_1608Metric
R1E: 100k EN pulldown; R_0603_1608Metric
R1F: RILM FORWARD - SELECTION REQUIRED; R_0603_1608Metric
R1OF: 0R OVLO FORWARD PULLDOWN CANDIDATE; R_0603_1608Metric
R1OR: 0R OVLO REVERSE PULLDOWN CANDIDATE; R_0603_1608Metric
R1R: RILM REVERSE - SELECTION REQUIRED; R_0603_1608Metric
U1F: TPS259482L FORWARD OCP; TI_YWP0012A_PowerWCSP_2.441x1.728mm
U1R: TPS259482L REVERSE OCP; TI_YWP0012A_PowerWCSP_2.441x1.728mm

Connections:
BRANCH_1_VPOS: C1O.1, U1R.5, U1R.12; also elsewhere on the board
CH1_DVDT_F: C1F.1, U1F.7
CH1_DVDT_R: C1R.1, U1R.7
CH1_EN: R1E.1, U1F.1, U1R.1; also elsewhere on the board
CH1_ILM_F: R1F.1, U1F.9; also elsewhere on the board
CH1_ILM_R: R1R.1, U1R.9; also elsewhere on the board
CH1_ITIMER_F: U1F.10
CH1_ITIMER_R: U1R.10
CH1_MID: U1F.6, U1F.11, U1R.6, U1R.11
CH1_OV_F: R1OF.1, U1F.2
CH1_OV_R: R1OR.1, U1R.2
CH1_PG_F: U1F.3; also elsewhere on the board
CH1_PG_R: U1R.3; also elsewhere on the board
CH1_RCBCTRL: R1B.1, U1F.4, U1R.4; also elsewhere on the board
FEED_0V: C1F.2, C1I.2, C1O.2, C1R.2, R1B.2, R1E.2, R1F.2, R1OF.2, R1OR.2, R1R.2, U1F.8, U1R.8; also elsewhere on the board
FEED_VPOS: C1I.1, U1F.5, U1F.12; also elsewhere on the board

Notes on the sheet:
PRELIMINARY - WALKING-POWER ARCHITECTURE CANDIDATE ONLY - NOT APPROVED FOR PROCUREMENT, FABRICATION, CONNECTION, POWERED TESTING, MOTION OR ENERGIZATION
02 Paired bidirectional branch 1
One TPS259482L faces each current direction; exact setpoints and PCB remain open.
W2001
W2002
W2003
W2004
W2005
W2006
W2007
W2008
W2009
W2010
W2011
W2012
W2013
W2014
W2015
W2016
W2017
W2018
W2019
W2020
W2021
W2022
W2023
W2024
W2025
W2026
W2027
W2028
W2029
W2030
W2031
W2032
W2033
W2034
W2035
W2036
W2037
W2038
W2039
W2040
W2041
W2042
NOTE 1: Motoring: UxF provides IN-to-OUT overcurrent protection.
NOTE 2: Regeneration: UxR provides IN-to-OUT overcurrent protection.
NOTE 3: A single TPS25948 is insufficient because reverse-direction OCP is not provided.
NOTE 4: Eight isolated bus-domain brake/dump circuits are still required for contactor-open
energy.
NOTE 5: PRELIMINARY - WALKING-POWER ARCHITECTURE CANDIDATE ONLY - NOT APPROVED FOR
PROCUREMENT, FABRICATION, CONNECTION, POWERED TESTING, MOTION OR ENERGIZATION

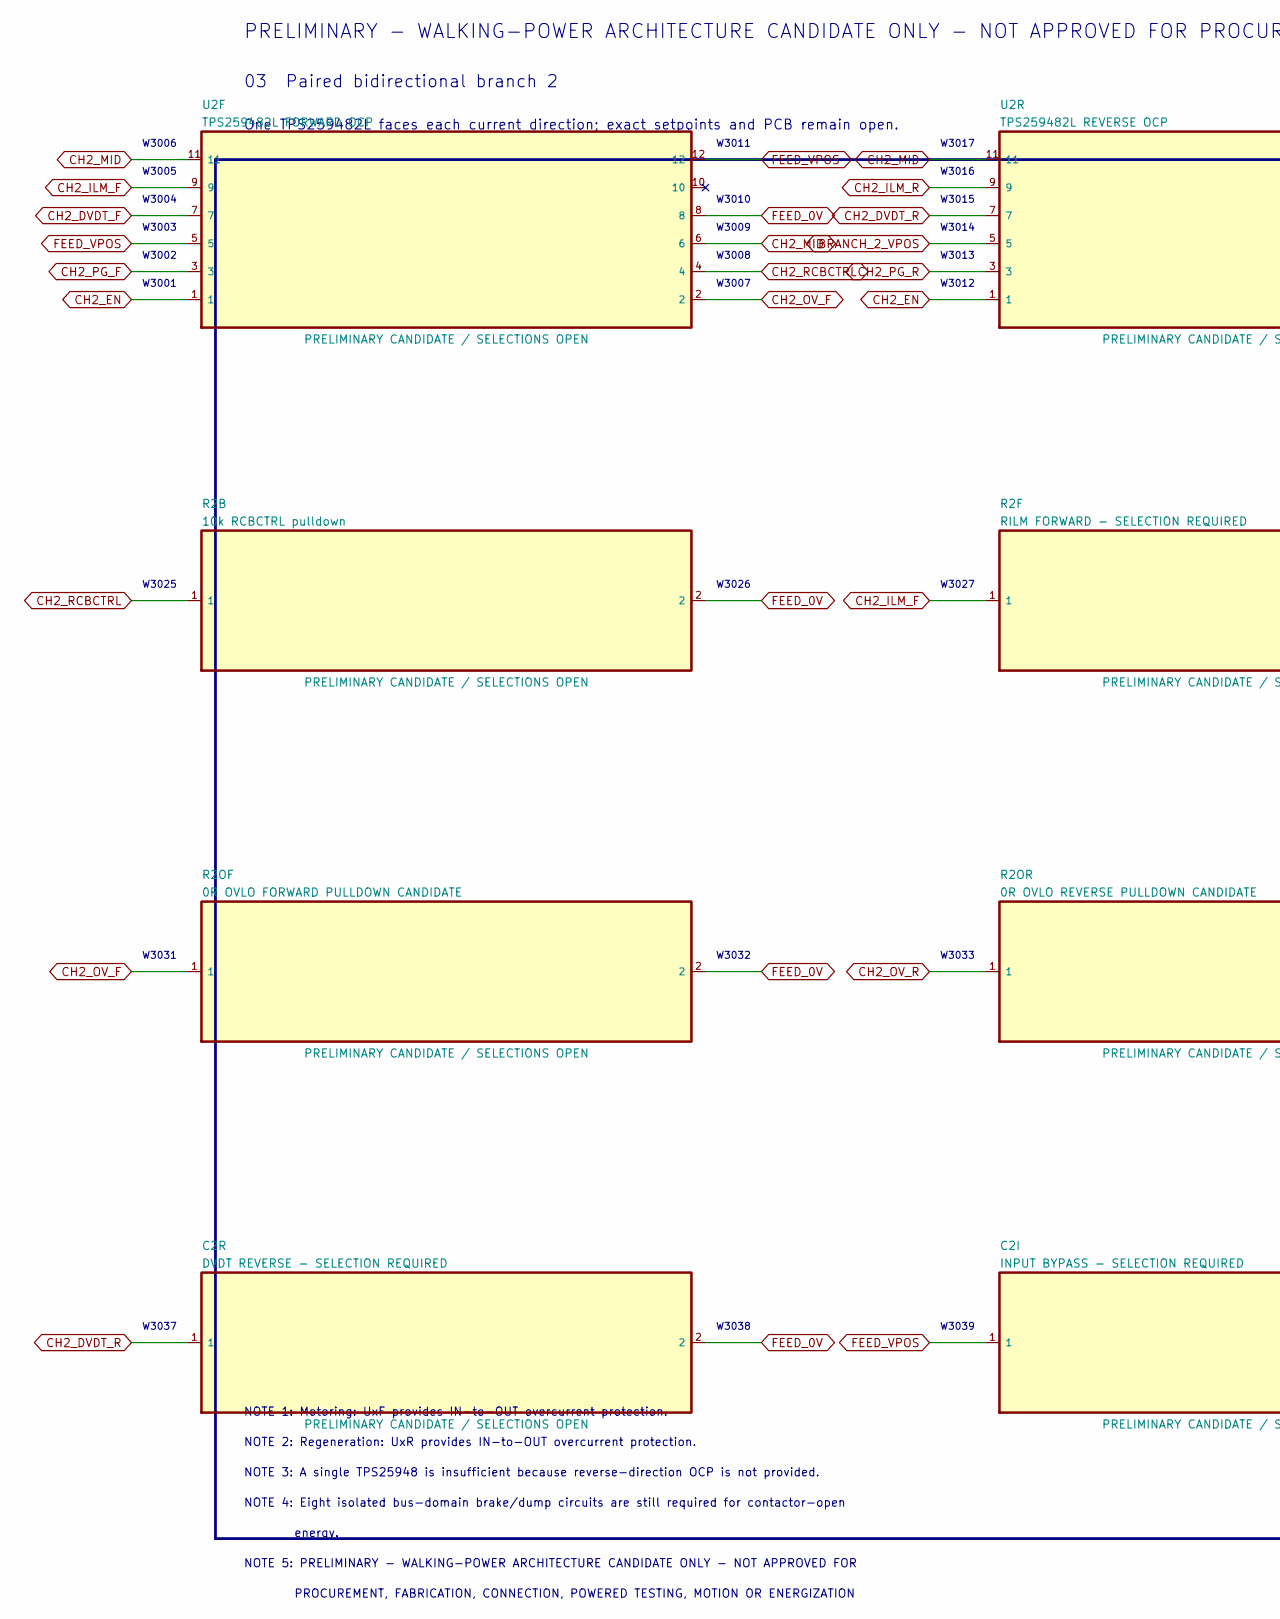
[picture p296: schematic 03_paired_channel_2.kicad_sch, PB HR-V0 P0.1 - 03, part in row 1, column 1]

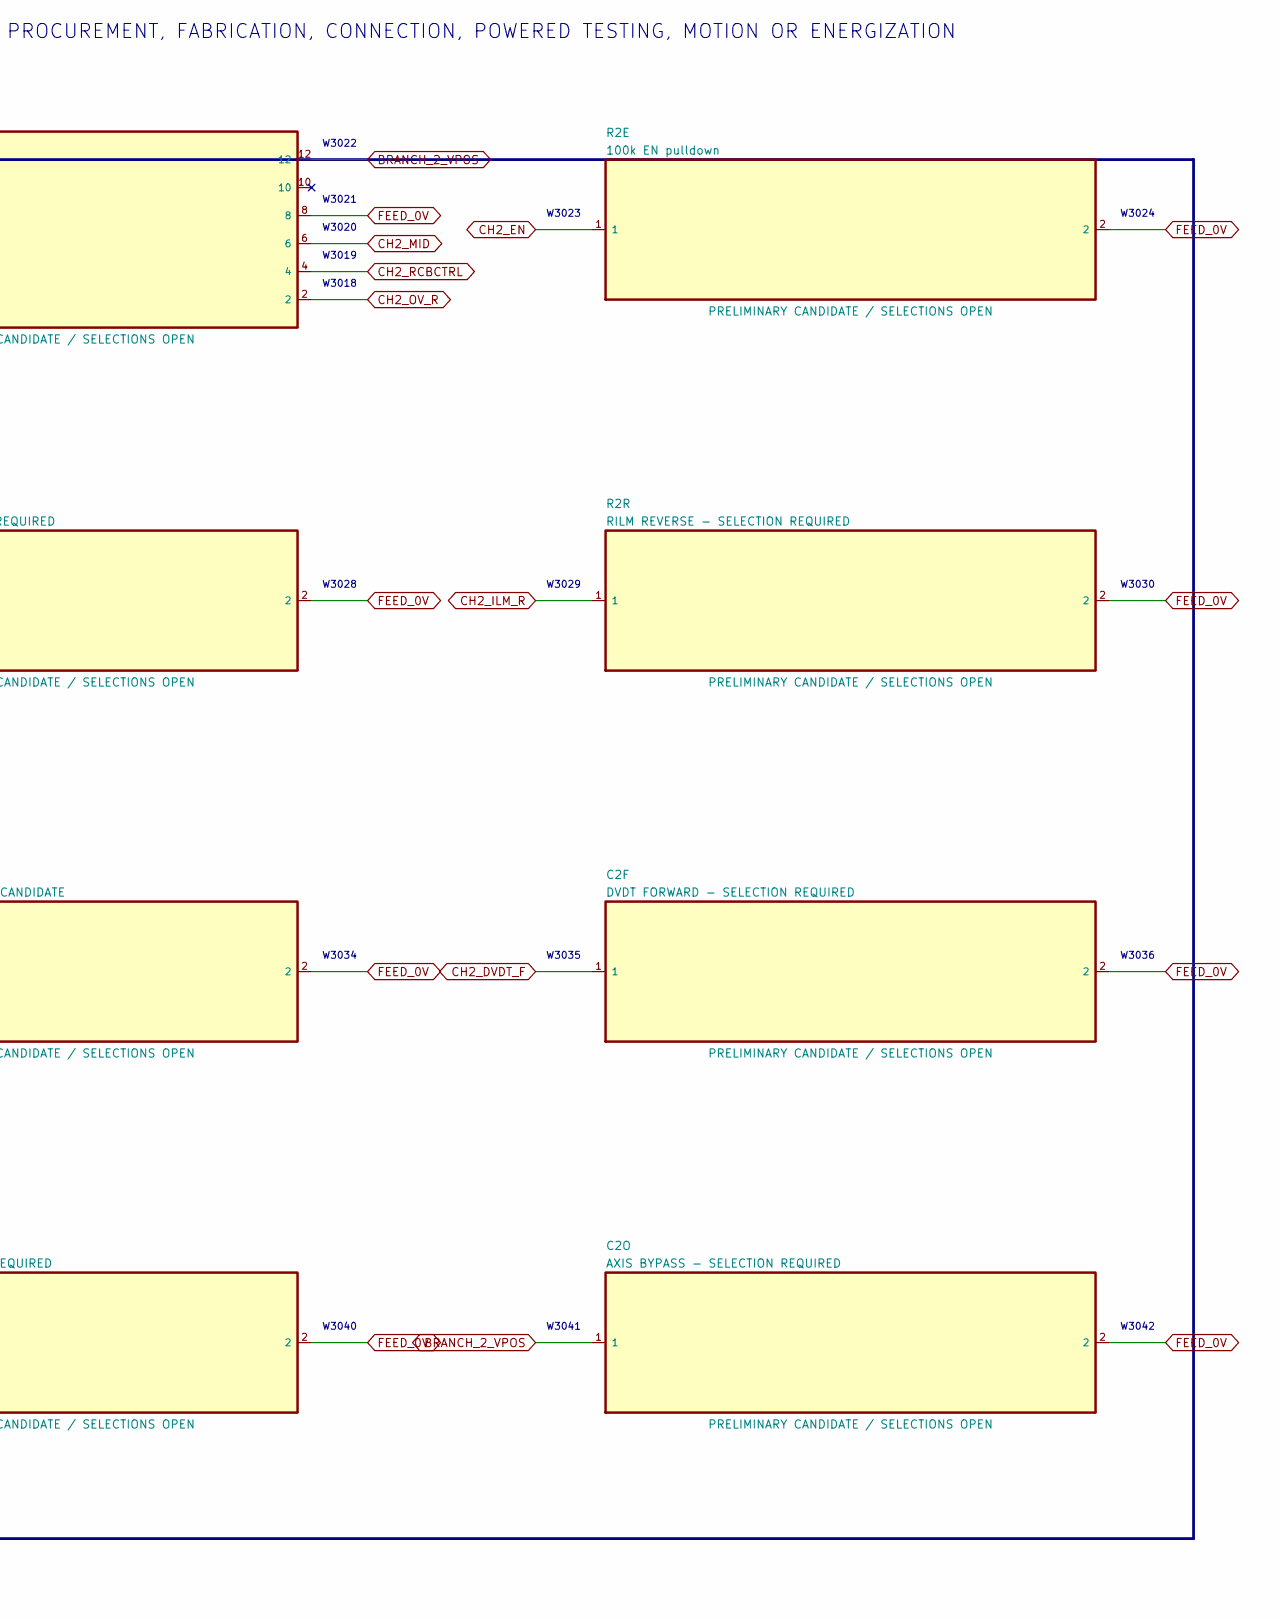
[picture p297: schematic 03_paired_channel_2.kicad_sch, PB HR-V0 P0.1 - 03, part in row 1, column 2]

Parts:
C2F: DVDT FORWARD - SELECTION REQUIRED; C_0603_1608Metric
C2I: INPUT BYPASS - SELECTION REQUIRED; C_0805_2012Metric
C2O: AXIS BYPASS - SELECTION REQUIRED; C_0805_2012Metric
C2R: DVDT REVERSE - SELECTION REQUIRED; C_0603_1608Metric
R2B: 10k RCBCTRL pulldown; R_0603_1608Metric
R2E: 100k EN pulldown; R_0603_1608Metric
R2F: RILM FORWARD - SELECTION REQUIRED; R_0603_1608Metric
R2OF: 0R OVLO FORWARD PULLDOWN CANDIDATE; R_0603_1608Metric
R2OR: 0R OVLO REVERSE PULLDOWN CANDIDATE; R_0603_1608Metric
R2R: RILM REVERSE - SELECTION REQUIRED; R_0603_1608Metric
U2F: TPS259482L FORWARD OCP; TI_YWP0012A_PowerWCSP_2.441x1.728mm
U2R: TPS259482L REVERSE OCP; TI_YWP0012A_PowerWCSP_2.441x1.728mm

Connections:
BRANCH_2_VPOS: C2O.1, U2R.5, U2R.12; also elsewhere on the board
CH2_DVDT_F: C2F.1, U2F.7
CH2_DVDT_R: C2R.1, U2R.7
CH2_EN: R2E.1, U2F.1, U2R.1; also elsewhere on the board
CH2_ILM_F: R2F.1, U2F.9; also elsewhere on the board
CH2_ILM_R: R2R.1, U2R.9; also elsewhere on the board
CH2_ITIMER_F: U2F.10
CH2_ITIMER_R: U2R.10
CH2_MID: U2F.6, U2F.11, U2R.6, U2R.11
CH2_OV_F: R2OF.1, U2F.2
CH2_OV_R: R2OR.1, U2R.2
CH2_PG_F: U2F.3; also elsewhere on the board
CH2_PG_R: U2R.3; also elsewhere on the board
CH2_RCBCTRL: R2B.1, U2F.4, U2R.4; also elsewhere on the board
FEED_0V: C2F.2, C2I.2, C2O.2, C2R.2, R2B.2, R2E.2, R2F.2, R2OF.2, R2OR.2, R2R.2, U2F.8, U2R.8; also elsewhere on the board
FEED_VPOS: C2I.1, U2F.5, U2F.12; also elsewhere on the board

Notes on the sheet:
PRELIMINARY - WALKING-POWER ARCHITECTURE CANDIDATE ONLY - NOT APPROVED FOR PROCUREMENT, FABRICATION, CONNECTION, POWERED TESTING, MOTION OR ENERGIZATION
03 Paired bidirectional branch 2
One TPS259482L faces each current direction; exact setpoints and PCB remain open.
W3001
W3002
W3003
W3004
W3005
W3006
W3007
W3008
W3009
W3010
W3011
W3012
W3013
W3014
W3015
W3016
W3017
W3018
W3019
W3020
W3021
W3022
W3023
W3024
W3025
W3026
W3027
W3028
W3029
W3030
W3031
W3032
W3033
W3034
W3035
W3036
W3037
W3038
W3039
W3040
W3041
W3042
NOTE 1: Motoring: UxF provides IN-to-OUT overcurrent protection.
NOTE 2: Regeneration: UxR provides IN-to-OUT overcurrent protection.
NOTE 3: A single TPS25948 is insufficient because reverse-direction OCP is not provided.
NOTE 4: Eight isolated bus-domain brake/dump circuits are still required for contactor-open
energy.
NOTE 5: PRELIMINARY - WALKING-POWER ARCHITECTURE CANDIDATE ONLY - NOT APPROVED FOR
PROCUREMENT, FABRICATION, CONNECTION, POWERED TESTING, MOTION OR ENERGIZATION
