amyleesterling/humanoid-robot/hr30/whole-body-p0.1/electrical/walking-power-successor-p0.1/hr30-walking-power-successor-p0.1.kicad_pcb

## KiCad design hr30/whole-body-p0.1/electrical/walking-power-successor-p0.1/hr30-walking-power-successor-p0.1.kicad_pcb (continued)

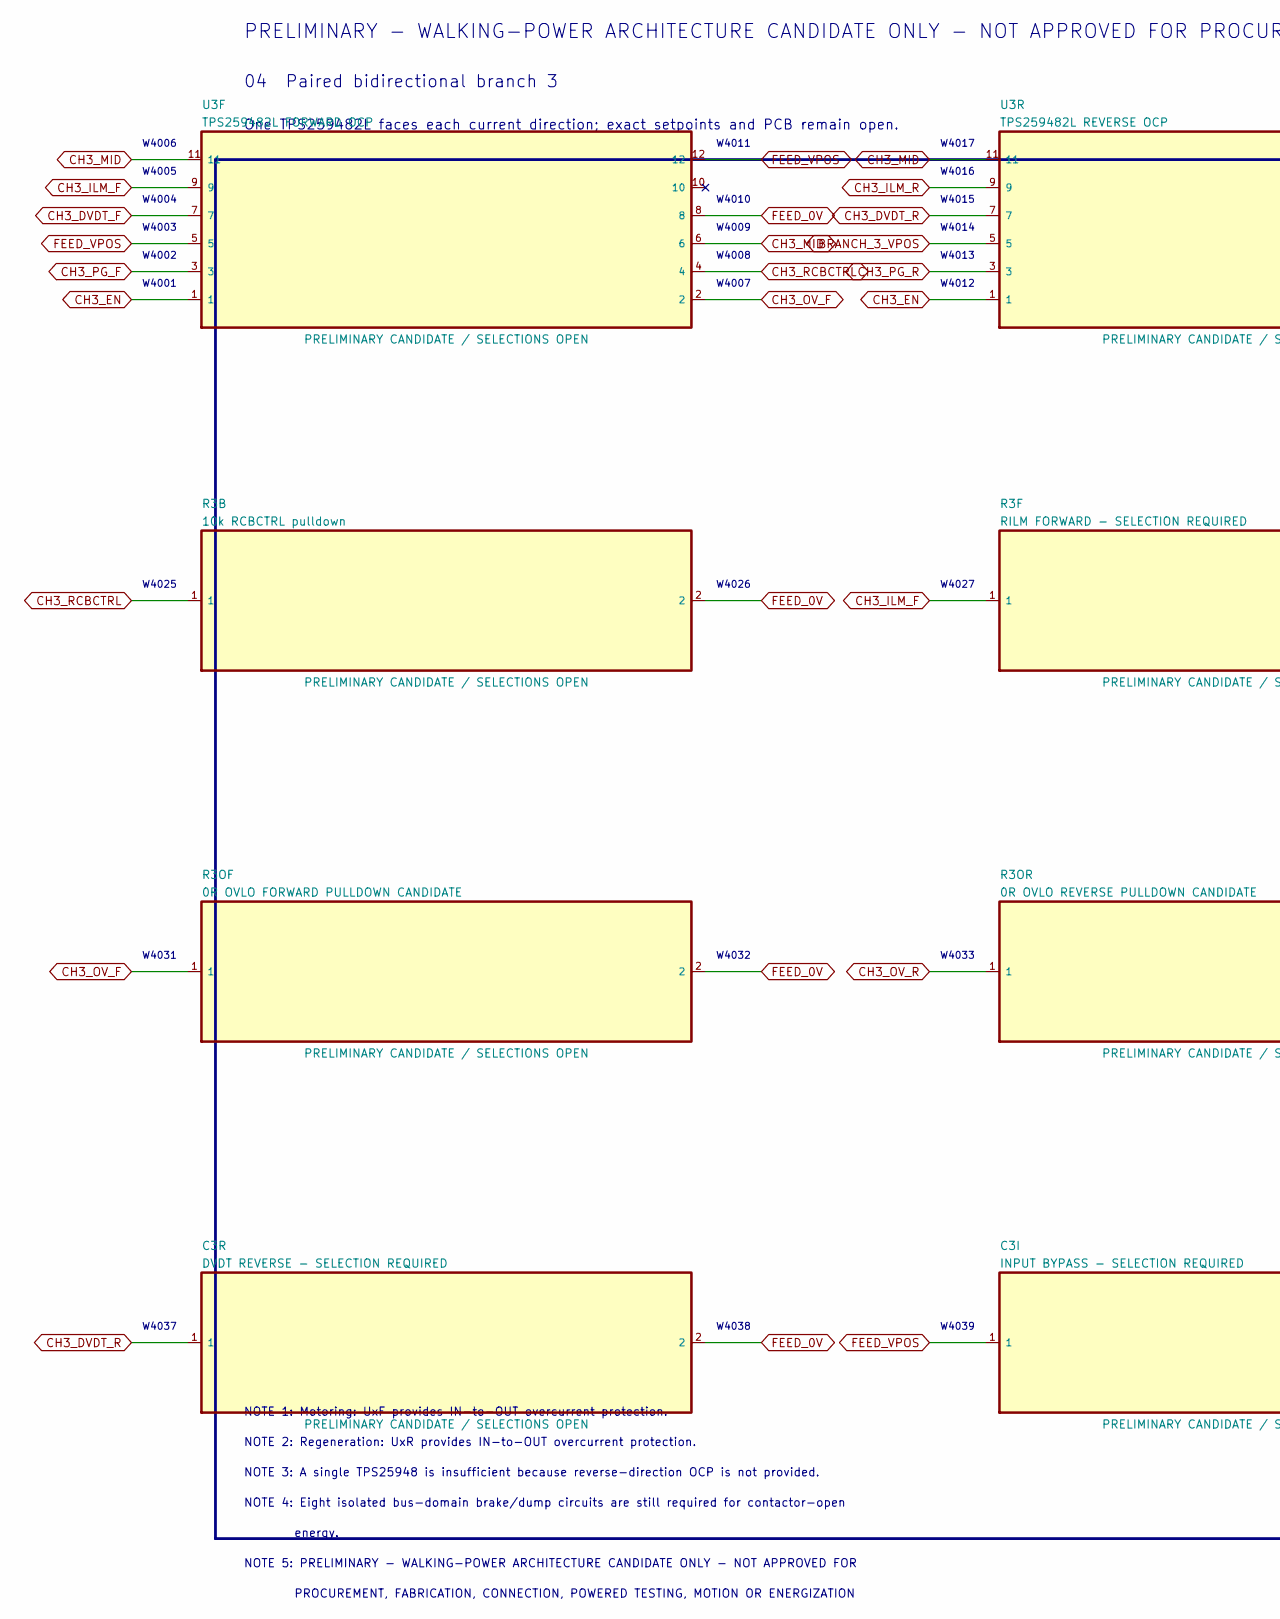
[picture p298: schematic 04_paired_channel_3.kicad_sch, PB HR-V0 P0.1 - 04, part in row 1, column 1]

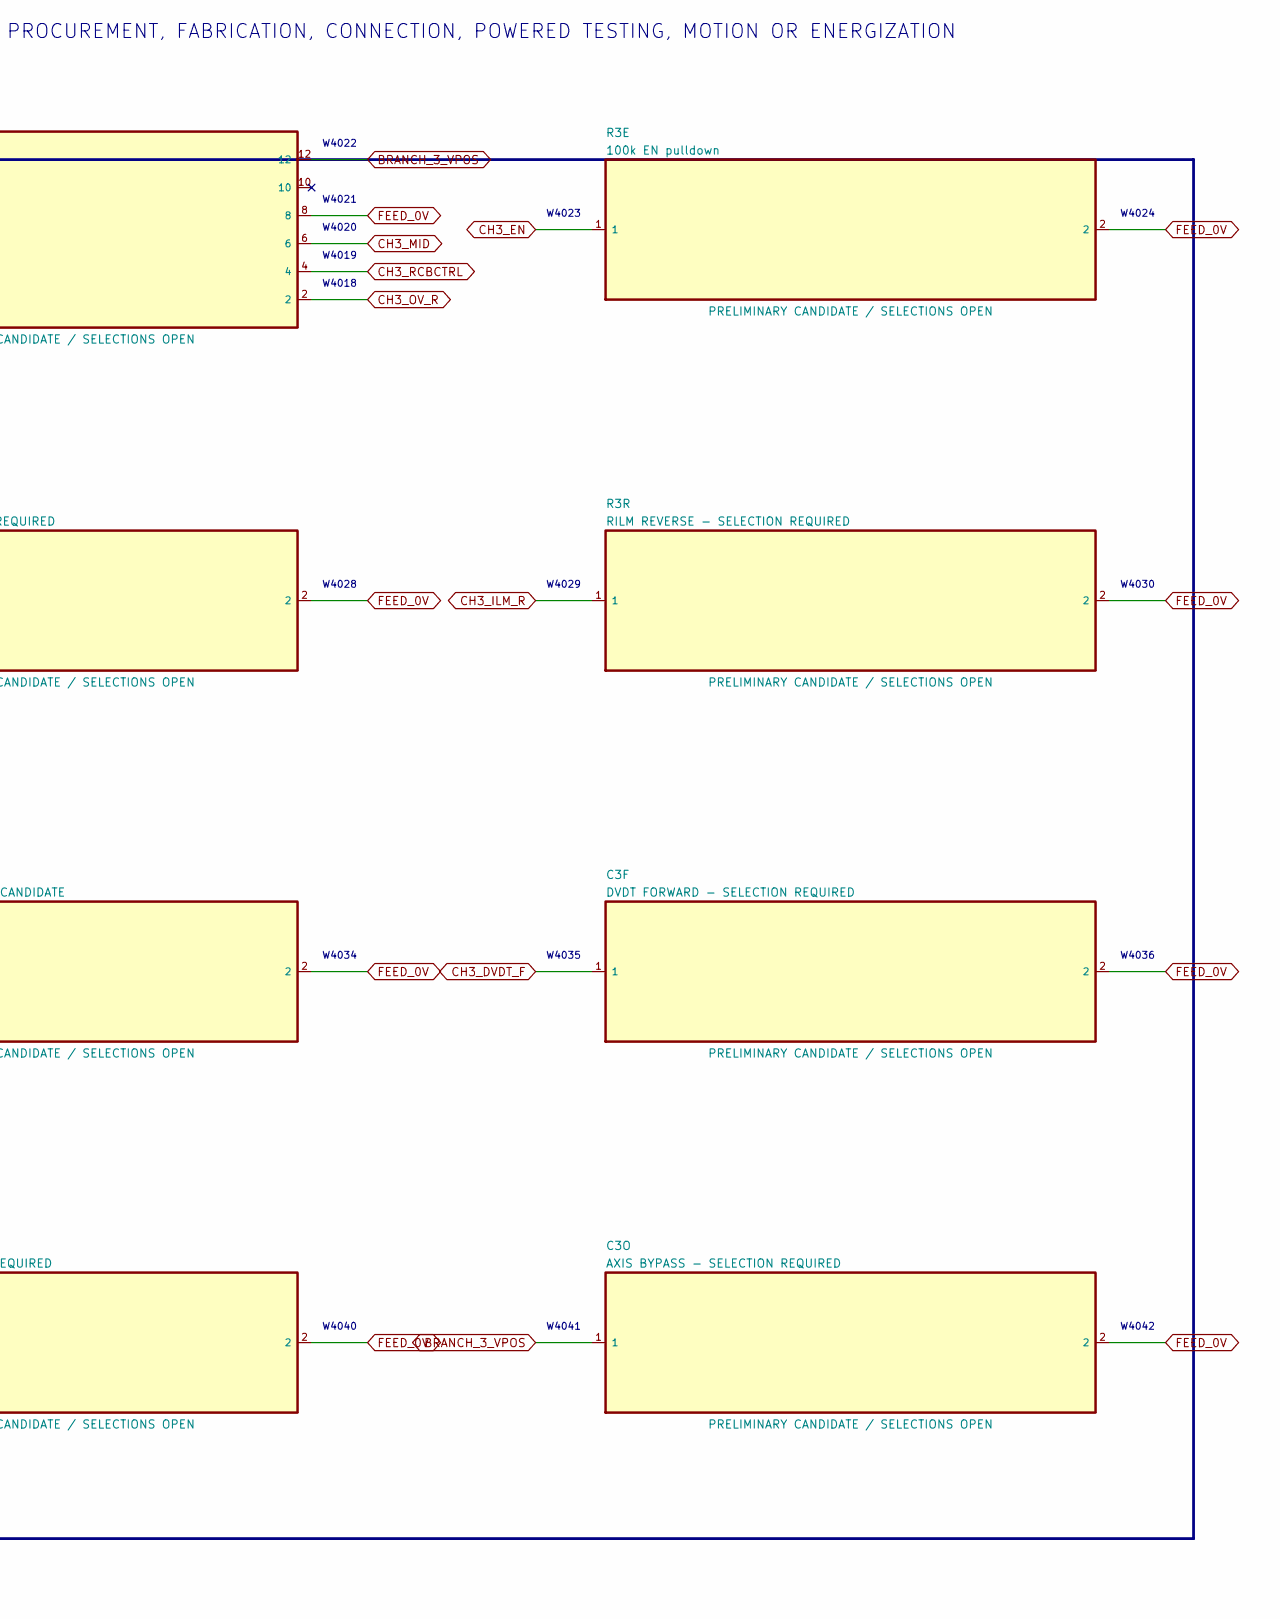
[picture p299: schematic 04_paired_channel_3.kicad_sch, PB HR-V0 P0.1 - 04, part in row 1, column 2]

Parts:
C3F: DVDT FORWARD - SELECTION REQUIRED; C_0603_1608Metric
C3I: INPUT BYPASS - SELECTION REQUIRED; C_0805_2012Metric
C3O: AXIS BYPASS - SELECTION REQUIRED; C_0805_2012Metric
C3R: DVDT REVERSE - SELECTION REQUIRED; C_0603_1608Metric
R3B: 10k RCBCTRL pulldown; R_0603_1608Metric
R3E: 100k EN pulldown; R_0603_1608Metric
R3F: RILM FORWARD - SELECTION REQUIRED; R_0603_1608Metric
R3OF: 0R OVLO FORWARD PULLDOWN CANDIDATE; R_0603_1608Metric
R3OR: 0R OVLO REVERSE PULLDOWN CANDIDATE; R_0603_1608Metric
R3R: RILM REVERSE - SELECTION REQUIRED; R_0603_1608Metric
U3F: TPS259482L FORWARD OCP; TI_YWP0012A_PowerWCSP_2.441x1.728mm
U3R: TPS259482L REVERSE OCP; TI_YWP0012A_PowerWCSP_2.441x1.728mm

Connections:
BRANCH_3_VPOS: C3O.1, U3R.5, U3R.12; also elsewhere on the board
CH3_DVDT_F: C3F.1, U3F.7
CH3_DVDT_R: C3R.1, U3R.7
CH3_EN: R3E.1, U3F.1, U3R.1; also elsewhere on the board
CH3_ILM_F: R3F.1, U3F.9; also elsewhere on the board
CH3_ILM_R: R3R.1, U3R.9; also elsewhere on the board
CH3_ITIMER_F: U3F.10
CH3_ITIMER_R: U3R.10
CH3_MID: U3F.6, U3F.11, U3R.6, U3R.11
CH3_OV_F: R3OF.1, U3F.2
CH3_OV_R: R3OR.1, U3R.2
CH3_PG_F: U3F.3; also elsewhere on the board
CH3_PG_R: U3R.3; also elsewhere on the board
CH3_RCBCTRL: R3B.1, U3F.4, U3R.4; also elsewhere on the board
FEED_0V: C3F.2, C3I.2, C3O.2, C3R.2, R3B.2, R3E.2, R3F.2, R3OF.2, R3OR.2, R3R.2, U3F.8, U3R.8; also elsewhere on the board
FEED_VPOS: C3I.1, U3F.5, U3F.12; also elsewhere on the board

Notes on the sheet:
PRELIMINARY - WALKING-POWER ARCHITECTURE CANDIDATE ONLY - NOT APPROVED FOR PROCUREMENT, FABRICATION, CONNECTION, POWERED TESTING, MOTION OR ENERGIZATION
04 Paired bidirectional branch 3
One TPS259482L faces each current direction; exact setpoints and PCB remain open.
W4001
W4002
W4003
W4004
W4005
W4006
W4007
W4008
W4009
W4010
W4011
W4012
W4013
W4014
W4015
W4016
W4017
W4018
W4019
W4020
W4021
W4022
W4023
W4024
W4025
W4026
W4027
W4028
W4029
W4030
W4031
W4032
W4033
W4034
W4035
W4036
W4037
W4038
W4039
W4040
W4041
W4042
NOTE 1: Motoring: UxF provides IN-to-OUT overcurrent protection.
NOTE 2: Regeneration: UxR provides IN-to-OUT overcurrent protection.
NOTE 3: A single TPS25948 is insufficient because reverse-direction OCP is not provided.
NOTE 4: Eight isolated bus-domain brake/dump circuits are still required for contactor-open
energy.
NOTE 5: PRELIMINARY - WALKING-POWER ARCHITECTURE CANDIDATE ONLY - NOT APPROVED FOR
PROCUREMENT, FABRICATION, CONNECTION, POWERED TESTING, MOTION OR ENERGIZATION

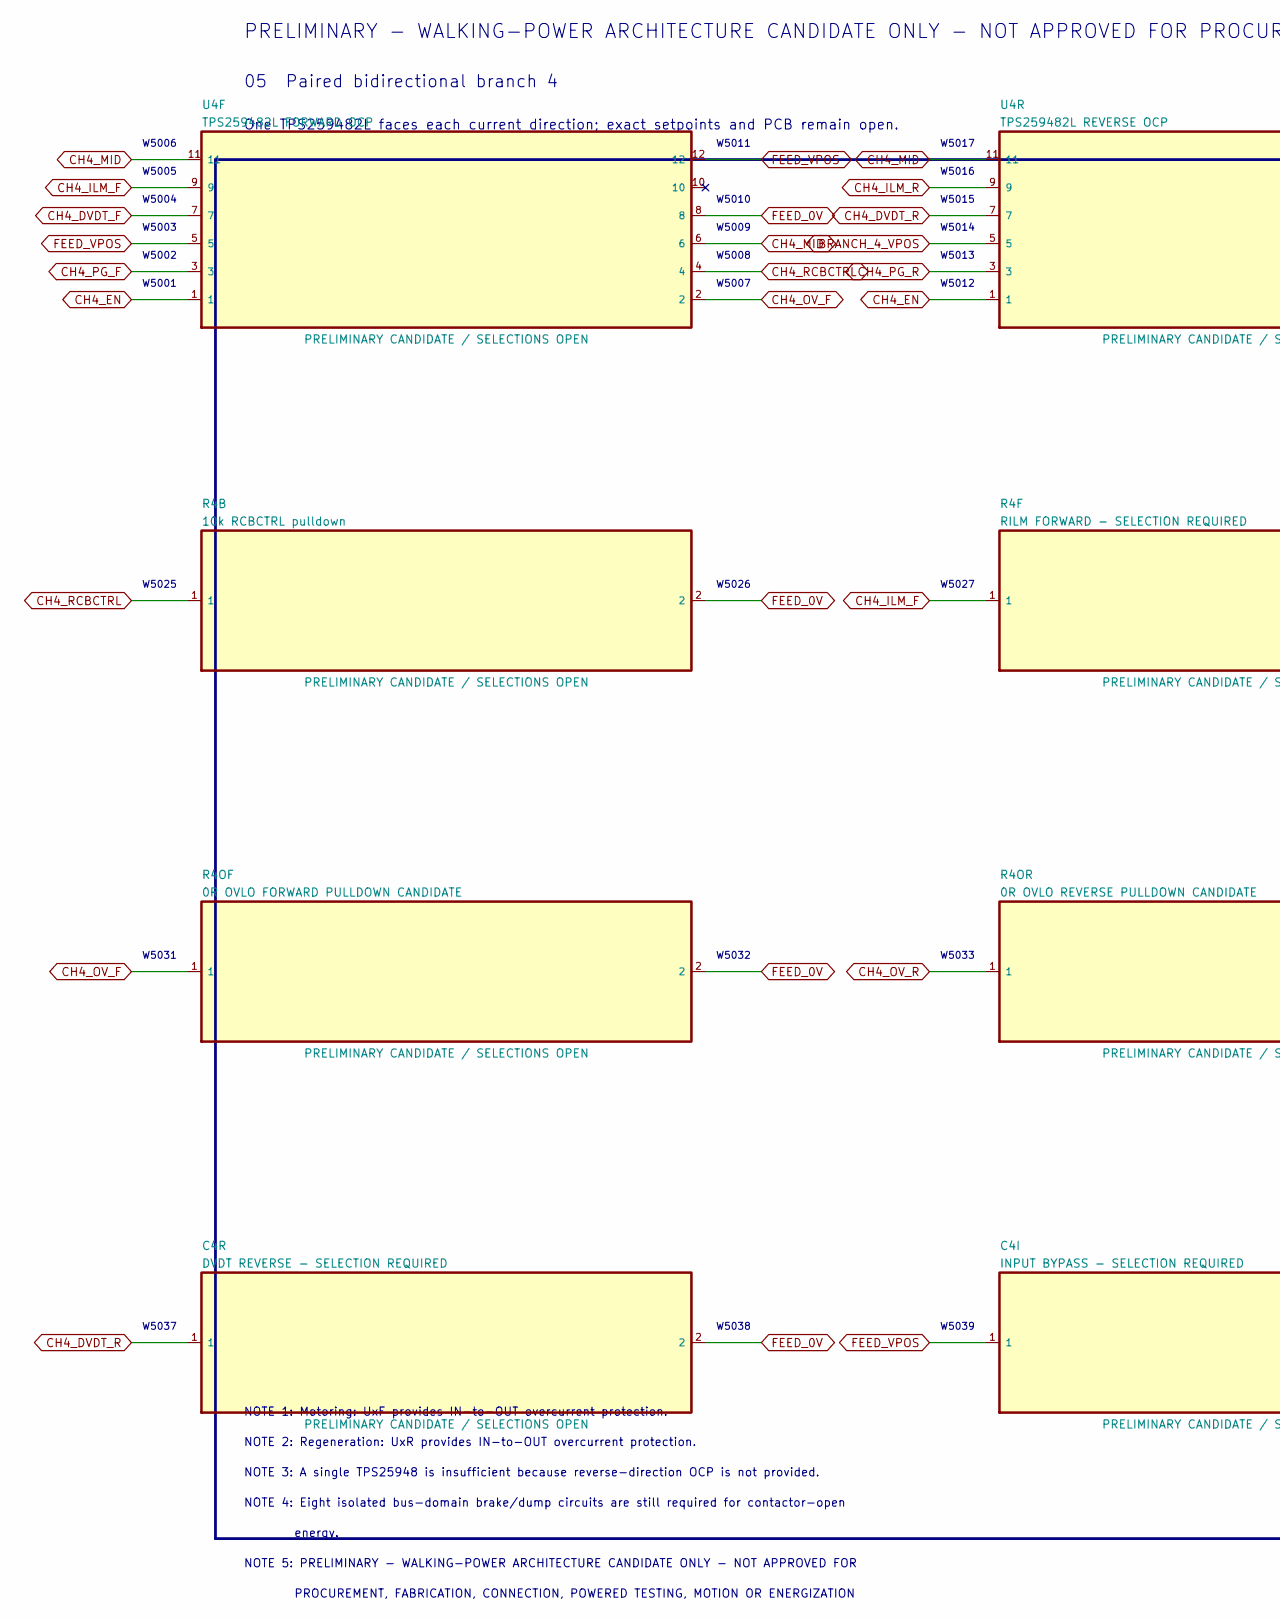
[picture p300: schematic 05_paired_channel_4.kicad_sch, PB HR-V0 P0.1 - 05, part in row 1, column 1]

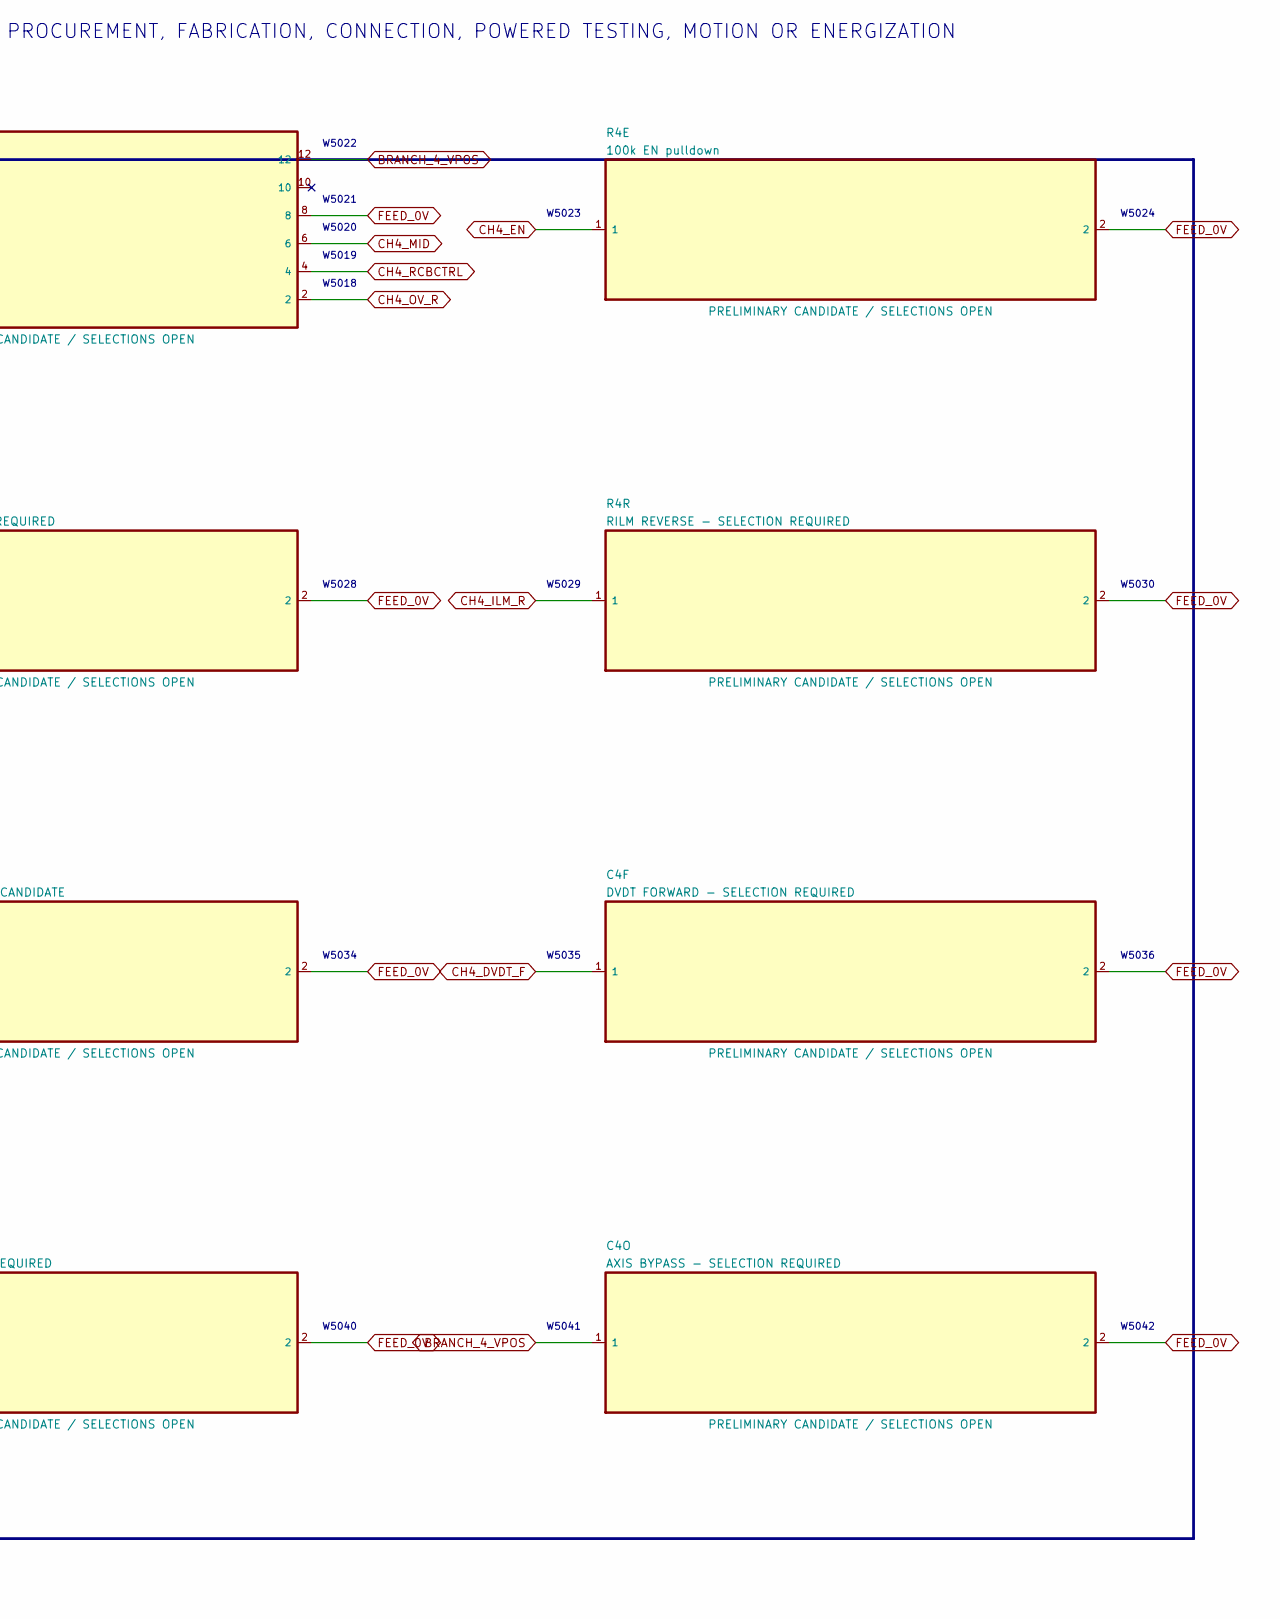
[picture p301: schematic 05_paired_channel_4.kicad_sch, PB HR-V0 P0.1 - 05, part in row 1, column 2]

Parts:
C4F: DVDT FORWARD - SELECTION REQUIRED; C_0603_1608Metric
C4I: INPUT BYPASS - SELECTION REQUIRED; C_0805_2012Metric
C4O: AXIS BYPASS - SELECTION REQUIRED; C_0805_2012Metric
C4R: DVDT REVERSE - SELECTION REQUIRED; C_0603_1608Metric
R4B: 10k RCBCTRL pulldown; R_0603_1608Metric
R4E: 100k EN pulldown; R_0603_1608Metric
R4F: RILM FORWARD - SELECTION REQUIRED; R_0603_1608Metric
R4OF: 0R OVLO FORWARD PULLDOWN CANDIDATE; R_0603_1608Metric
R4OR: 0R OVLO REVERSE PULLDOWN CANDIDATE; R_0603_1608Metric
R4R: RILM REVERSE - SELECTION REQUIRED; R_0603_1608Metric
U4F: TPS259482L FORWARD OCP; TI_YWP0012A_PowerWCSP_2.441x1.728mm
U4R: TPS259482L REVERSE OCP; TI_YWP0012A_PowerWCSP_2.441x1.728mm

Connections:
BRANCH_4_VPOS: C4O.1, U4R.5, U4R.12; also elsewhere on the board
CH4_DVDT_F: C4F.1, U4F.7
CH4_DVDT_R: C4R.1, U4R.7
CH4_EN: R4E.1, U4F.1, U4R.1; also elsewhere on the board
CH4_ILM_F: R4F.1, U4F.9; also elsewhere on the board
CH4_ILM_R: R4R.1, U4R.9; also elsewhere on the board
CH4_ITIMER_F: U4F.10
CH4_ITIMER_R: U4R.10
CH4_MID: U4F.6, U4F.11, U4R.6, U4R.11
CH4_OV_F: R4OF.1, U4F.2
CH4_OV_R: R4OR.1, U4R.2
CH4_PG_F: U4F.3; also elsewhere on the board
CH4_PG_R: U4R.3; also elsewhere on the board
CH4_RCBCTRL: R4B.1, U4F.4, U4R.4; also elsewhere on the board
FEED_0V: C4F.2, C4I.2, C4O.2, C4R.2, R4B.2, R4E.2, R4F.2, R4OF.2, R4OR.2, R4R.2, U4F.8, U4R.8; also elsewhere on the board
FEED_VPOS: C4I.1, U4F.5, U4F.12; also elsewhere on the board

Notes on the sheet:
PRELIMINARY - WALKING-POWER ARCHITECTURE CANDIDATE ONLY - NOT APPROVED FOR PROCUREMENT, FABRICATION, CONNECTION, POWERED TESTING, MOTION OR ENERGIZATION
05 Paired bidirectional branch 4
One TPS259482L faces each current direction; exact setpoints and PCB remain open.
W5001
W5002
W5003
W5004
W5005
W5006
W5007
W5008
W5009
W5010
W5011
W5012
W5013
W5014
W5015
W5016
W5017
W5018
W5019
W5020
W5021
W5022
W5023
W5024
W5025
W5026
W5027
W5028
W5029
W5030
W5031
W5032
W5033
W5034
W5035
W5036
W5037
W5038
W5039
W5040
W5041
W5042
NOTE 1: Motoring: UxF provides IN-to-OUT overcurrent protection.
NOTE 2: Regeneration: UxR provides IN-to-OUT overcurrent protection.
NOTE 3: A single TPS25948 is insufficient because reverse-direction OCP is not provided.
NOTE 4: Eight isolated bus-domain brake/dump circuits are still required for contactor-open
energy.
NOTE 5: PRELIMINARY - WALKING-POWER ARCHITECTURE CANDIDATE ONLY - NOT APPROVED FOR
PROCUREMENT, FABRICATION, CONNECTION, POWERED TESTING, MOTION OR ENERGIZATION

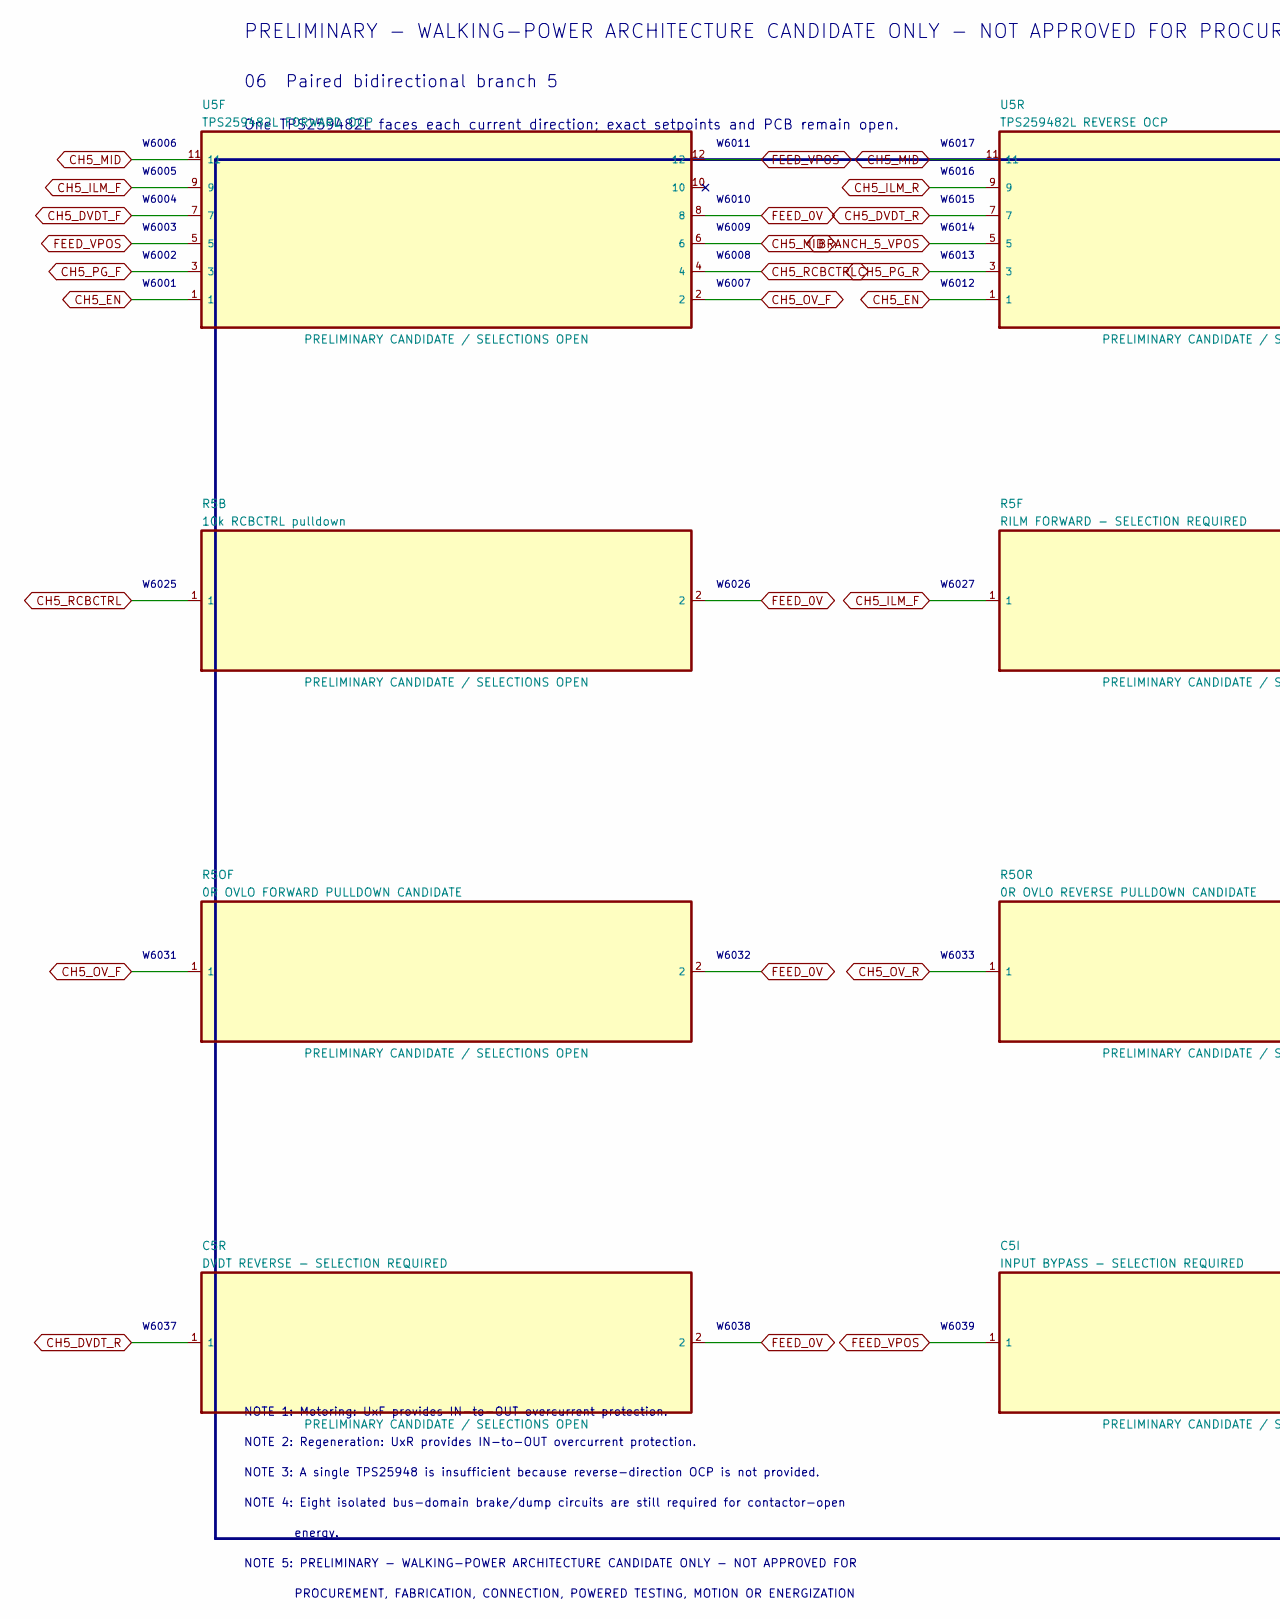
[picture p302: schematic 06_paired_channel_5.kicad_sch, PB HR-V0 P0.1 - 06, part in row 1, column 1]

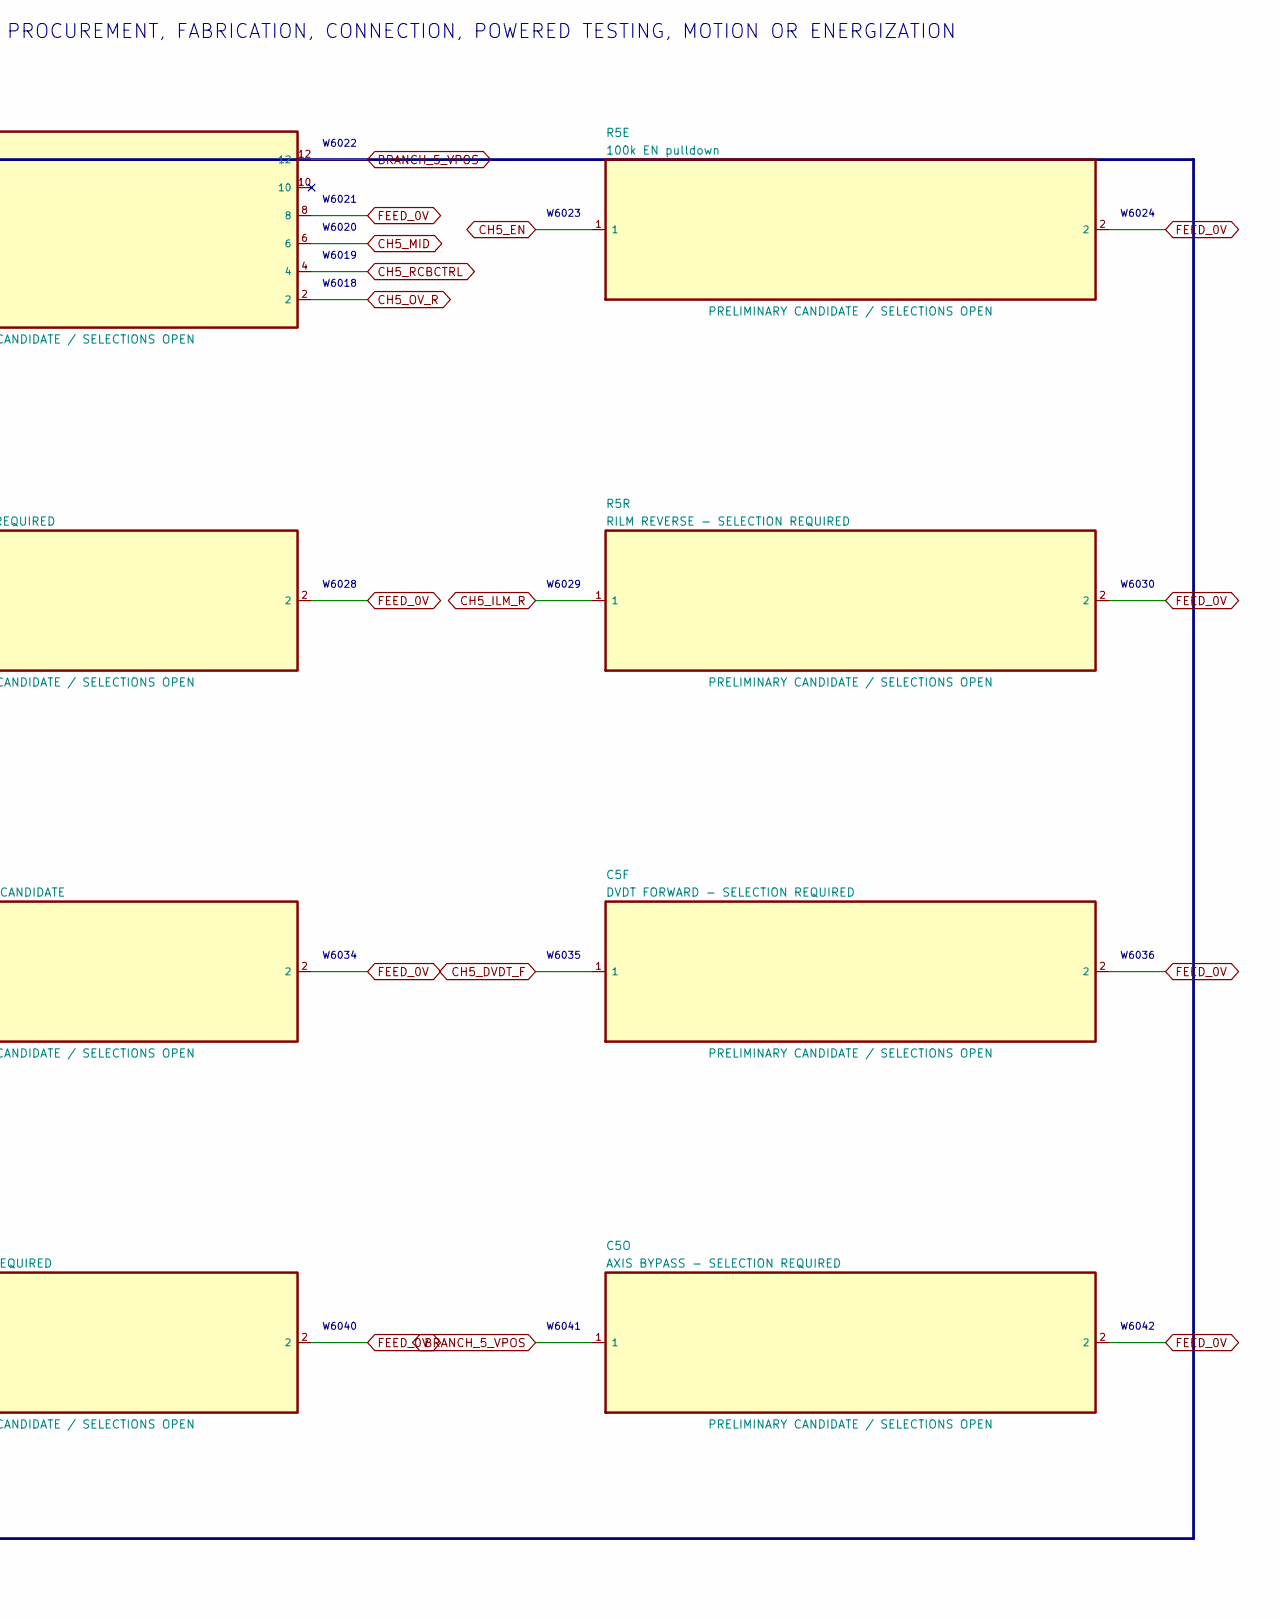
[picture p303: schematic 06_paired_channel_5.kicad_sch, PB HR-V0 P0.1 - 06, part in row 1, column 2]

Parts:
C5F: DVDT FORWARD - SELECTION REQUIRED; C_0603_1608Metric
C5I: INPUT BYPASS - SELECTION REQUIRED; C_0805_2012Metric
C5O: AXIS BYPASS - SELECTION REQUIRED; C_0805_2012Metric
C5R: DVDT REVERSE - SELECTION REQUIRED; C_0603_1608Metric
R5B: 10k RCBCTRL pulldown; R_0603_1608Metric
R5E: 100k EN pulldown; R_0603_1608Metric
R5F: RILM FORWARD - SELECTION REQUIRED; R_0603_1608Metric
R5OF: 0R OVLO FORWARD PULLDOWN CANDIDATE; R_0603_1608Metric
R5OR: 0R OVLO REVERSE PULLDOWN CANDIDATE; R_0603_1608Metric
R5R: RILM REVERSE - SELECTION REQUIRED; R_0603_1608Metric
U5F: TPS259482L FORWARD OCP; TI_YWP0012A_PowerWCSP_2.441x1.728mm
U5R: TPS259482L REVERSE OCP; TI_YWP0012A_PowerWCSP_2.441x1.728mm

Connections:
BRANCH_5_VPOS: C5O.1, U5R.5, U5R.12; also elsewhere on the board
CH5_DVDT_F: C5F.1, U5F.7
CH5_DVDT_R: C5R.1, U5R.7
CH5_EN: R5E.1, U5F.1, U5R.1; also elsewhere on the board
CH5_ILM_F: R5F.1, U5F.9; also elsewhere on the board
CH5_ILM_R: R5R.1, U5R.9; also elsewhere on the board
CH5_ITIMER_F: U5F.10
CH5_ITIMER_R: U5R.10
CH5_MID: U5F.6, U5F.11, U5R.6, U5R.11
CH5_OV_F: R5OF.1, U5F.2
CH5_OV_R: R5OR.1, U5R.2
CH5_PG_F: U5F.3; also elsewhere on the board
CH5_PG_R: U5R.3; also elsewhere on the board
CH5_RCBCTRL: R5B.1, U5F.4, U5R.4; also elsewhere on the board
FEED_0V: C5F.2, C5I.2, C5O.2, C5R.2, R5B.2, R5E.2, R5F.2, R5OF.2, R5OR.2, R5R.2, U5F.8, U5R.8; also elsewhere on the board
FEED_VPOS: C5I.1, U5F.5, U5F.12; also elsewhere on the board

Notes on the sheet:
PRELIMINARY - WALKING-POWER ARCHITECTURE CANDIDATE ONLY - NOT APPROVED FOR PROCUREMENT, FABRICATION, CONNECTION, POWERED TESTING, MOTION OR ENERGIZATION
06 Paired bidirectional branch 5
One TPS259482L faces each current direction; exact setpoints and PCB remain open.
W6001
W6002
W6003
W6004
W6005
W6006
W6007
W6008
W6009
W6010
W6011
W6012
W6013
W6014
W6015
W6016
W6017
W6018
W6019
W6020
W6021
W6022
W6023
W6024
W6025
W6026
W6027
W6028
W6029
W6030
W6031
W6032
W6033
W6034
W6035
W6036
W6037
W6038
W6039
W6040
W6041
W6042
NOTE 1: Motoring: UxF provides IN-to-OUT overcurrent protection.
NOTE 2: Regeneration: UxR provides IN-to-OUT overcurrent protection.
NOTE 3: A single TPS25948 is insufficient because reverse-direction OCP is not provided.
NOTE 4: Eight isolated bus-domain brake/dump circuits are still required for contactor-open
energy.
NOTE 5: PRELIMINARY - WALKING-POWER ARCHITECTURE CANDIDATE ONLY - NOT APPROVED FOR
PROCUREMENT, FABRICATION, CONNECTION, POWERED TESTING, MOTION OR ENERGIZATION

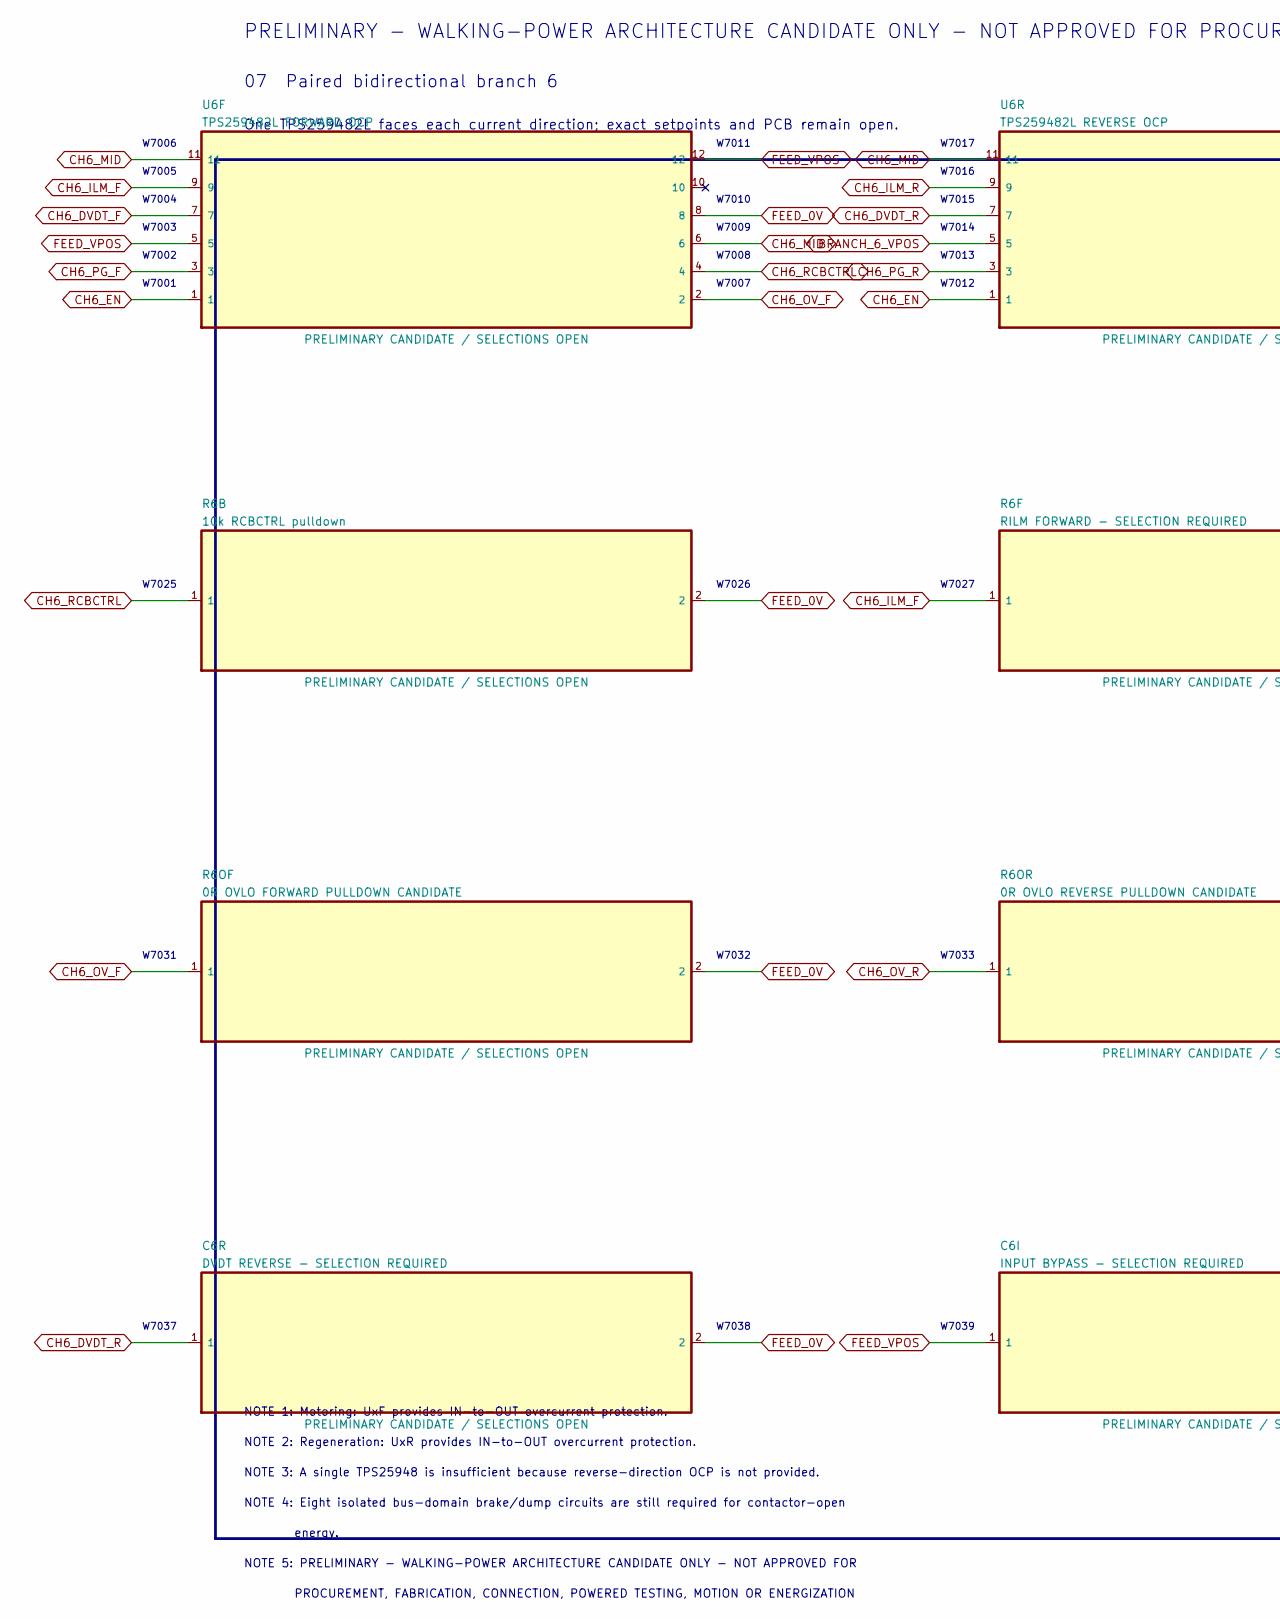
[picture p304: schematic 07_paired_channel_6.kicad_sch, PB HR-V0 P0.1 - 07, part in row 1, column 1]

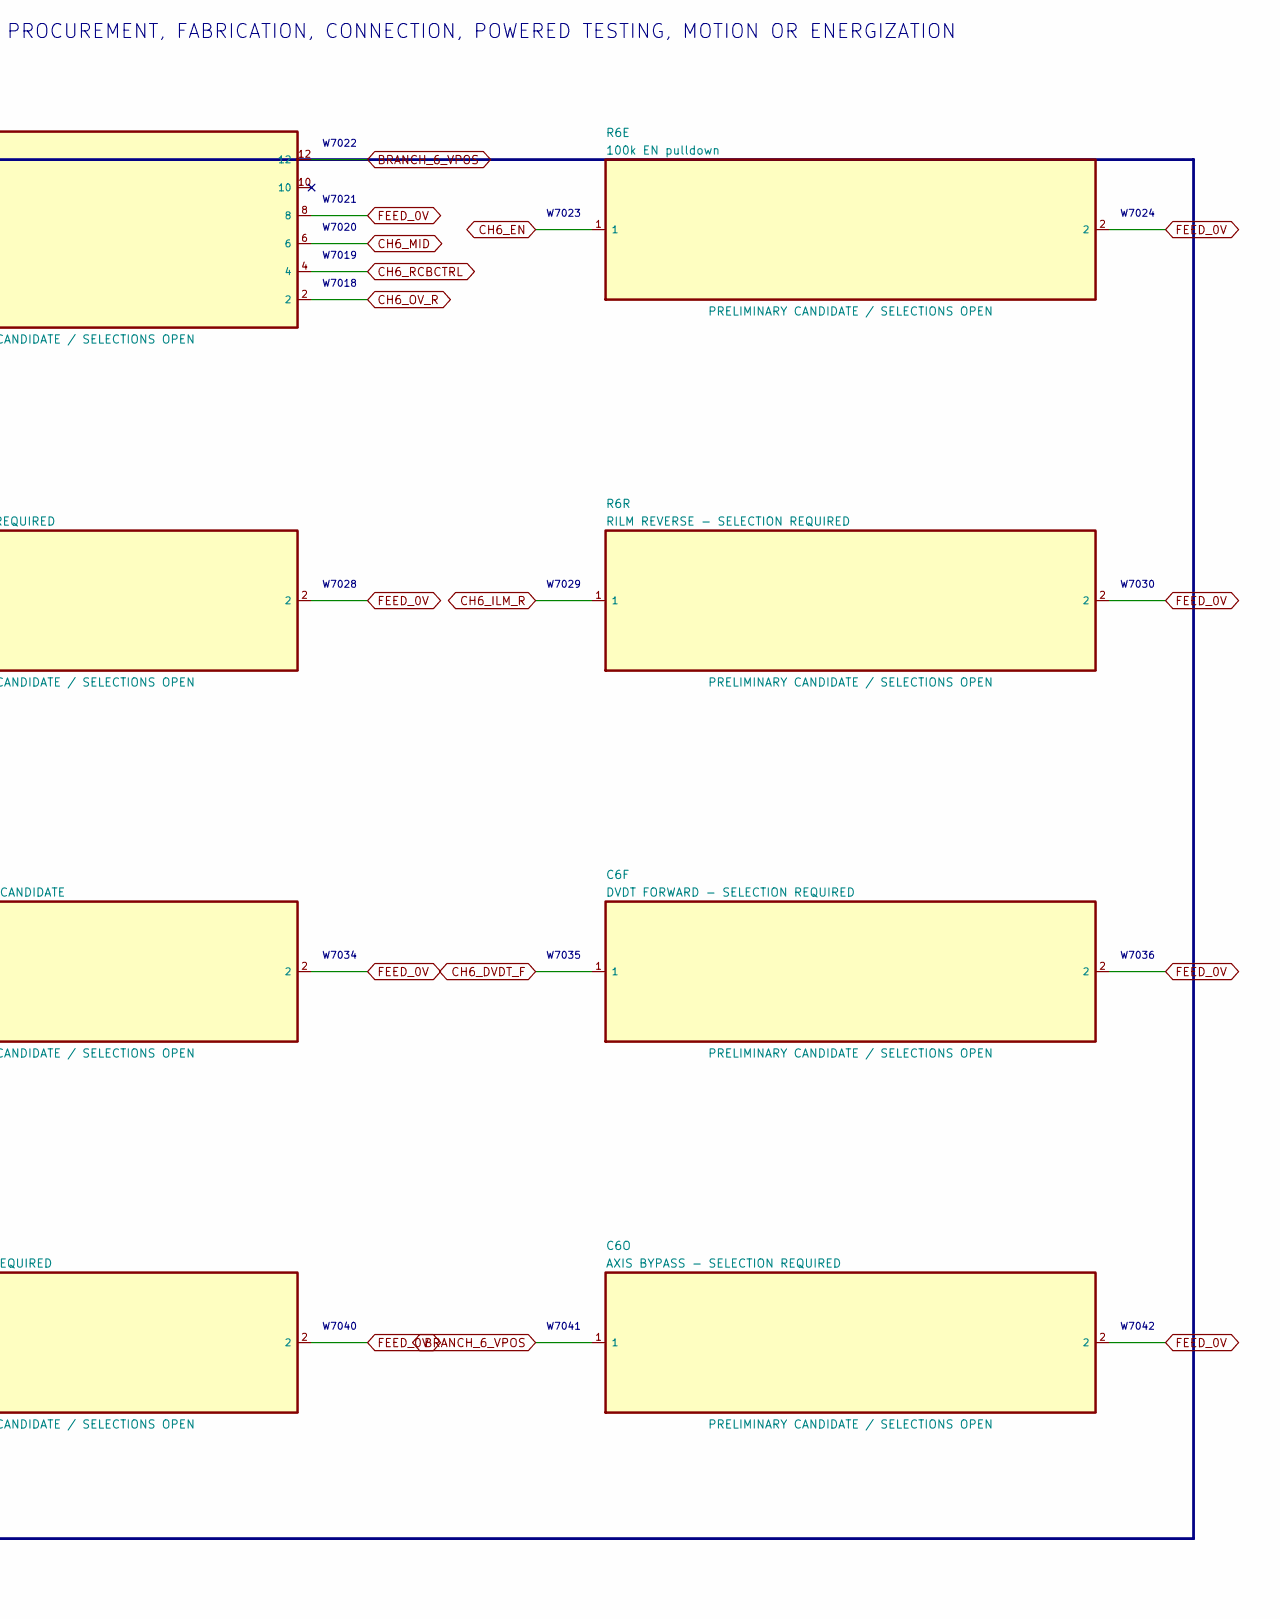
[picture p305: schematic 07_paired_channel_6.kicad_sch, PB HR-V0 P0.1 - 07, part in row 1, column 2]

Parts:
C6F: DVDT FORWARD - SELECTION REQUIRED; C_0603_1608Metric
C6I: INPUT BYPASS - SELECTION REQUIRED; C_0805_2012Metric
C6O: AXIS BYPASS - SELECTION REQUIRED; C_0805_2012Metric
C6R: DVDT REVERSE - SELECTION REQUIRED; C_0603_1608Metric
R6B: 10k RCBCTRL pulldown; R_0603_1608Metric
R6E: 100k EN pulldown; R_0603_1608Metric
R6F: RILM FORWARD - SELECTION REQUIRED; R_0603_1608Metric
R6OF: 0R OVLO FORWARD PULLDOWN CANDIDATE; R_0603_1608Metric
R6OR: 0R OVLO REVERSE PULLDOWN CANDIDATE; R_0603_1608Metric
R6R: RILM REVERSE - SELECTION REQUIRED; R_0603_1608Metric
U6F: TPS259482L FORWARD OCP; TI_YWP0012A_PowerWCSP_2.441x1.728mm
U6R: TPS259482L REVERSE OCP; TI_YWP0012A_PowerWCSP_2.441x1.728mm

Connections:
BRANCH_6_VPOS: C6O.1, U6R.5, U6R.12; also elsewhere on the board
CH6_DVDT_F: C6F.1, U6F.7
CH6_DVDT_R: C6R.1, U6R.7
CH6_EN: R6E.1, U6F.1, U6R.1; also elsewhere on the board
CH6_ILM_F: R6F.1, U6F.9; also elsewhere on the board
CH6_ILM_R: R6R.1, U6R.9; also elsewhere on the board
CH6_ITIMER_F: U6F.10
CH6_ITIMER_R: U6R.10
CH6_MID: U6F.6, U6F.11, U6R.6, U6R.11
CH6_OV_F: R6OF.1, U6F.2
CH6_OV_R: R6OR.1, U6R.2
CH6_PG_F: U6F.3; also elsewhere on the board
CH6_PG_R: U6R.3; also elsewhere on the board
CH6_RCBCTRL: R6B.1, U6F.4, U6R.4; also elsewhere on the board
FEED_0V: C6F.2, C6I.2, C6O.2, C6R.2, R6B.2, R6E.2, R6F.2, R6OF.2, R6OR.2, R6R.2, U6F.8, U6R.8; also elsewhere on the board
FEED_VPOS: C6I.1, U6F.5, U6F.12; also elsewhere on the board

Notes on the sheet:
PRELIMINARY - WALKING-POWER ARCHITECTURE CANDIDATE ONLY - NOT APPROVED FOR PROCUREMENT, FABRICATION, CONNECTION, POWERED TESTING, MOTION OR ENERGIZATION
07 Paired bidirectional branch 6
One TPS259482L faces each current direction; exact setpoints and PCB remain open.
W7001
W7002
W7003
W7004
W7005
W7006
W7007
W7008
W7009
W7010
W7011
W7012
W7013
W7014
W7015
W7016
W7017
W7018
W7019
W7020
W7021
W7022
W7023
W7024
W7025
W7026
W7027
W7028
W7029
W7030
W7031
W7032
W7033
W7034
W7035
W7036
W7037
W7038
W7039
W7040
W7041
W7042
NOTE 1: Motoring: UxF provides IN-to-OUT overcurrent protection.
NOTE 2: Regeneration: UxR provides IN-to-OUT overcurrent protection.
NOTE 3: A single TPS25948 is insufficient because reverse-direction OCP is not provided.
NOTE 4: Eight isolated bus-domain brake/dump circuits are still required for contactor-open
energy.
NOTE 5: PRELIMINARY - WALKING-POWER ARCHITECTURE CANDIDATE ONLY - NOT APPROVED FOR
PROCUREMENT, FABRICATION, CONNECTION, POWERED TESTING, MOTION OR ENERGIZATION

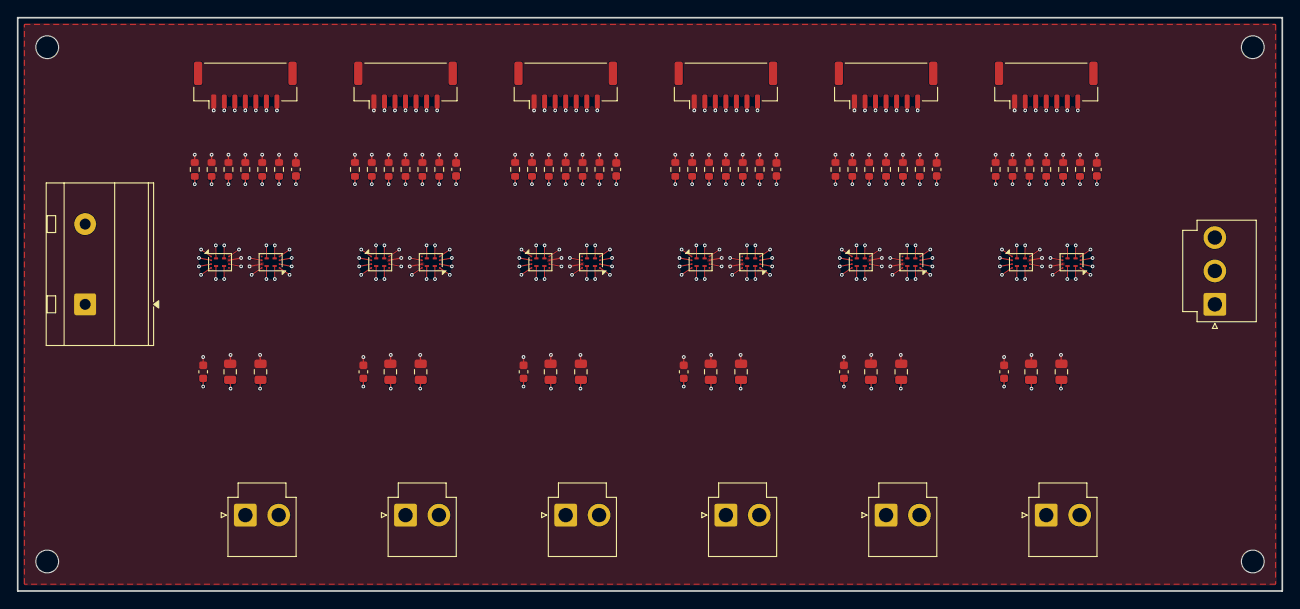
[picture p306: board hr30-walking-power-successor-p0.1.kicad_pcb from above]

Board: 10 copper layers, 150.0 x 68.0 mm, 90 parts (0 on the bottom side), 74 nets.

Other parts of the board:
MH1, MH2, MH3, MH4: M2.5 BOARD-ONLY; MountingHole_2.7mm_M2.5
