amyleesterling/humanoid-robot/hr30/whole-body-p0.1/electrical/actuator-branch-pdu-p0.1/hr30-actuator-branch-pdu-p0.1.kicad_pcb

## KiCad design hr30/whole-body-p0.1/electrical/actuator-branch-pdu-p0.1/hr30-actuator-branch-pdu-p0.1.kicad_pcb (2026-08-17)

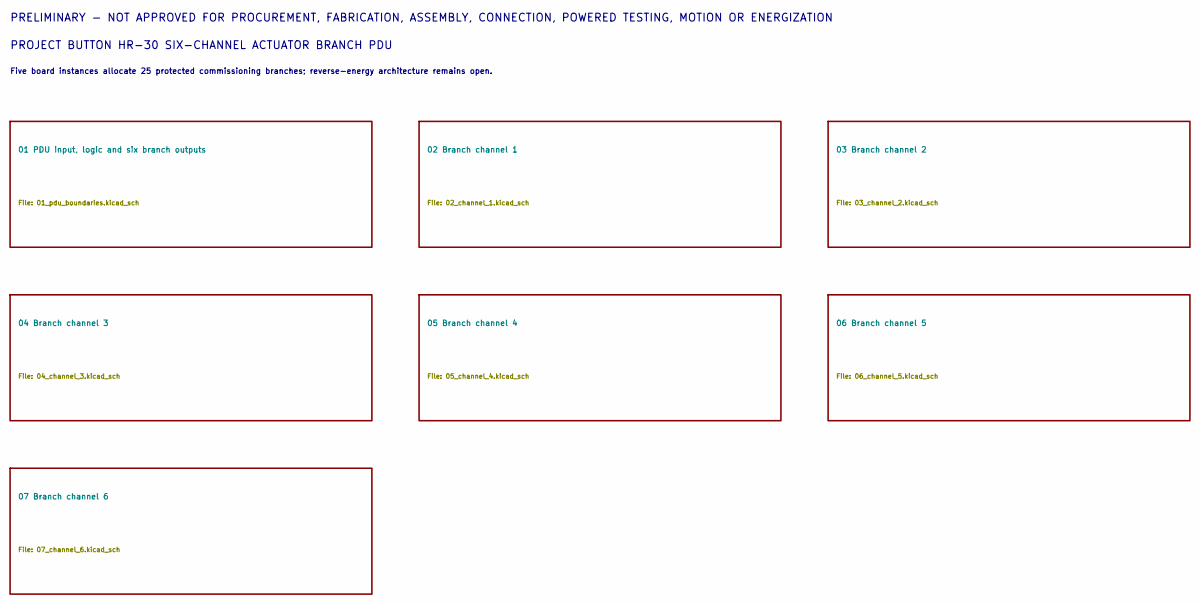
[picture p307: schematic hr30-actuator-branch-pdu-p0.1.kicad_sch, PROJECT BUTTON HR-30 SIX-CHANNEL ACTUATOR BRANCH PDU index]

Notes on the sheet:
PRELIMINARY - NOT APPROVED FOR PROCUREMENT, FABRICATION, ASSEMBLY, CONNECTION, POWERED TESTING, MOTION OR ENERGIZATION
PROJECT BUTTON HR-30 SIX-CHANNEL ACTUATOR BRANCH PDU
Five board instances allocate 25 protected commissioning branches; reverse-energy architecture remains open.

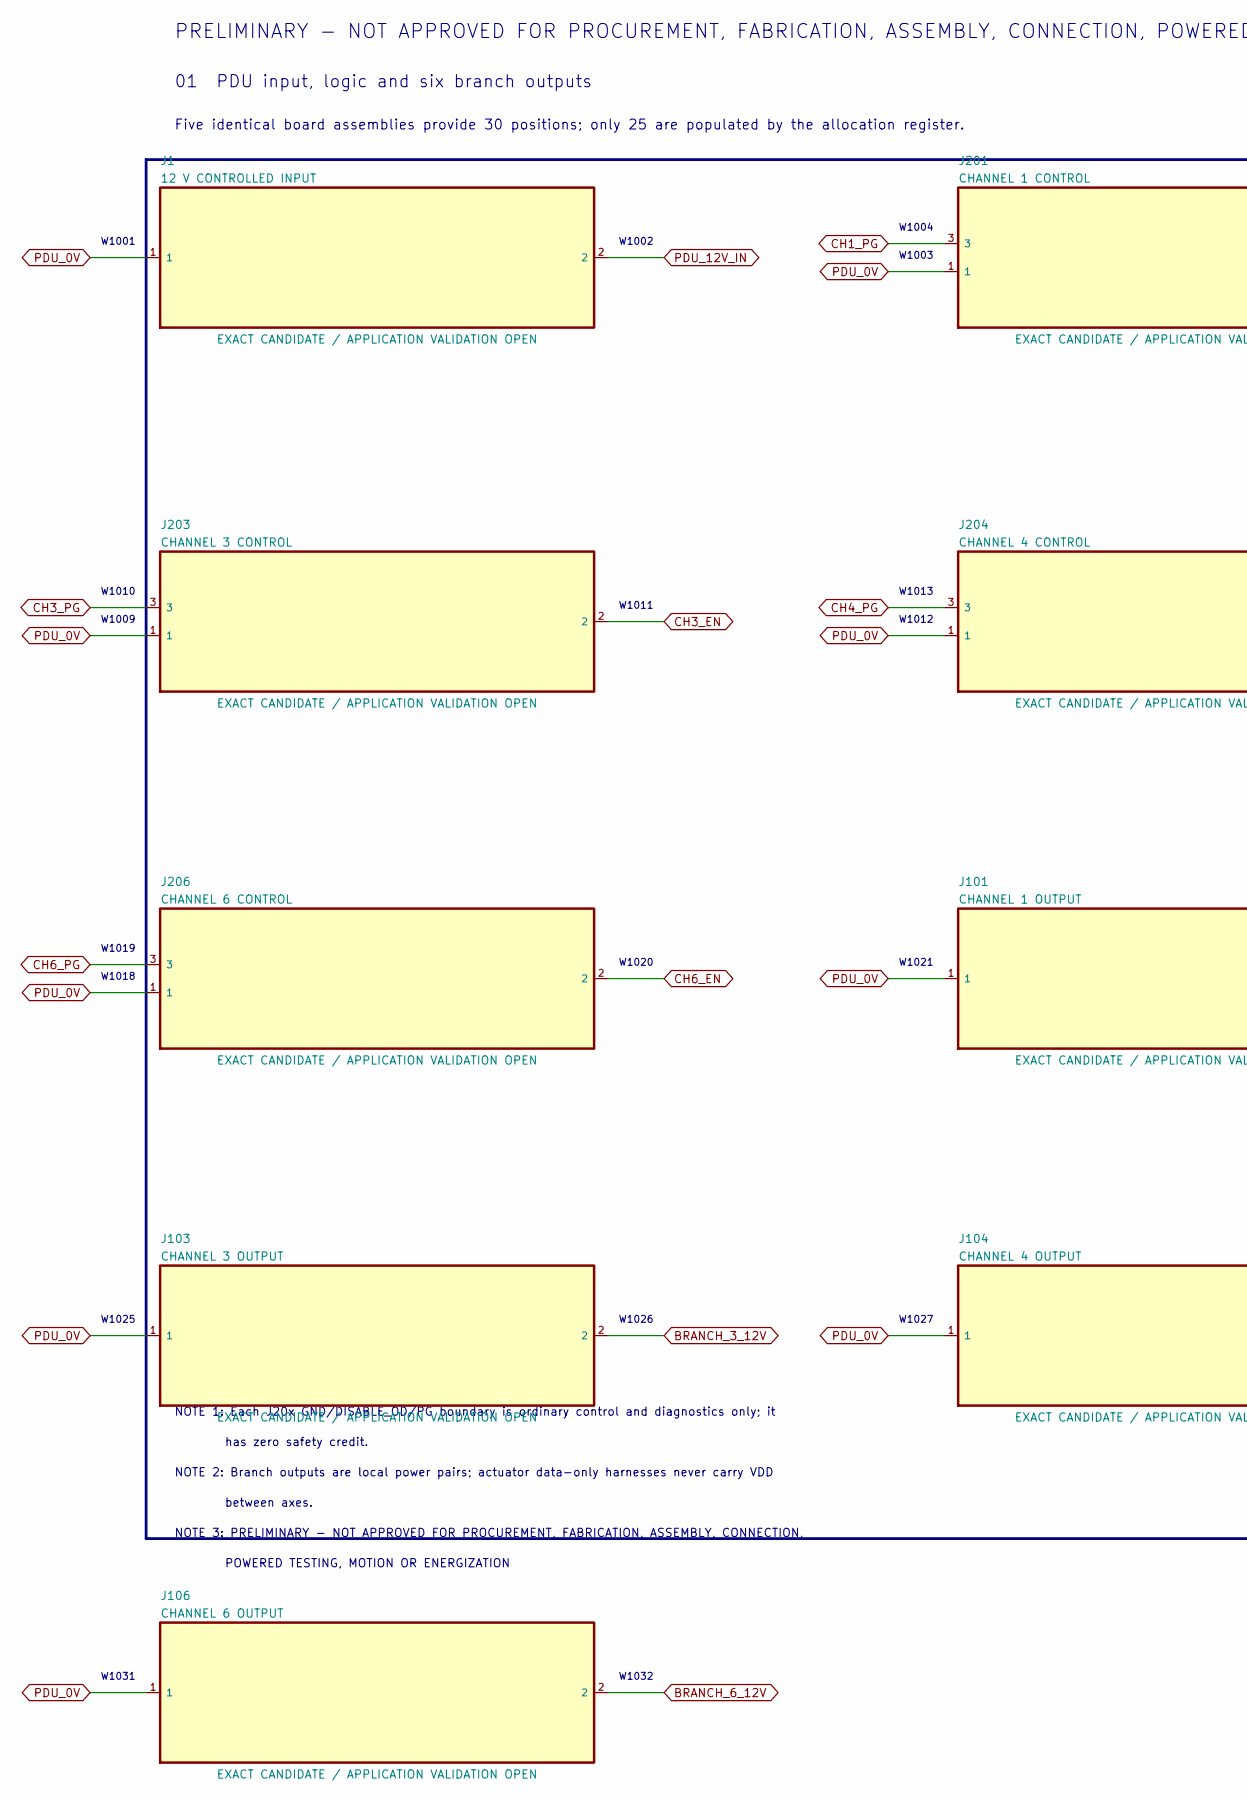
[picture p308: schematic 01_pdu_boundaries.kicad_sch, PB HR-V0 P0.1 - 01, part in row 1, column 1]

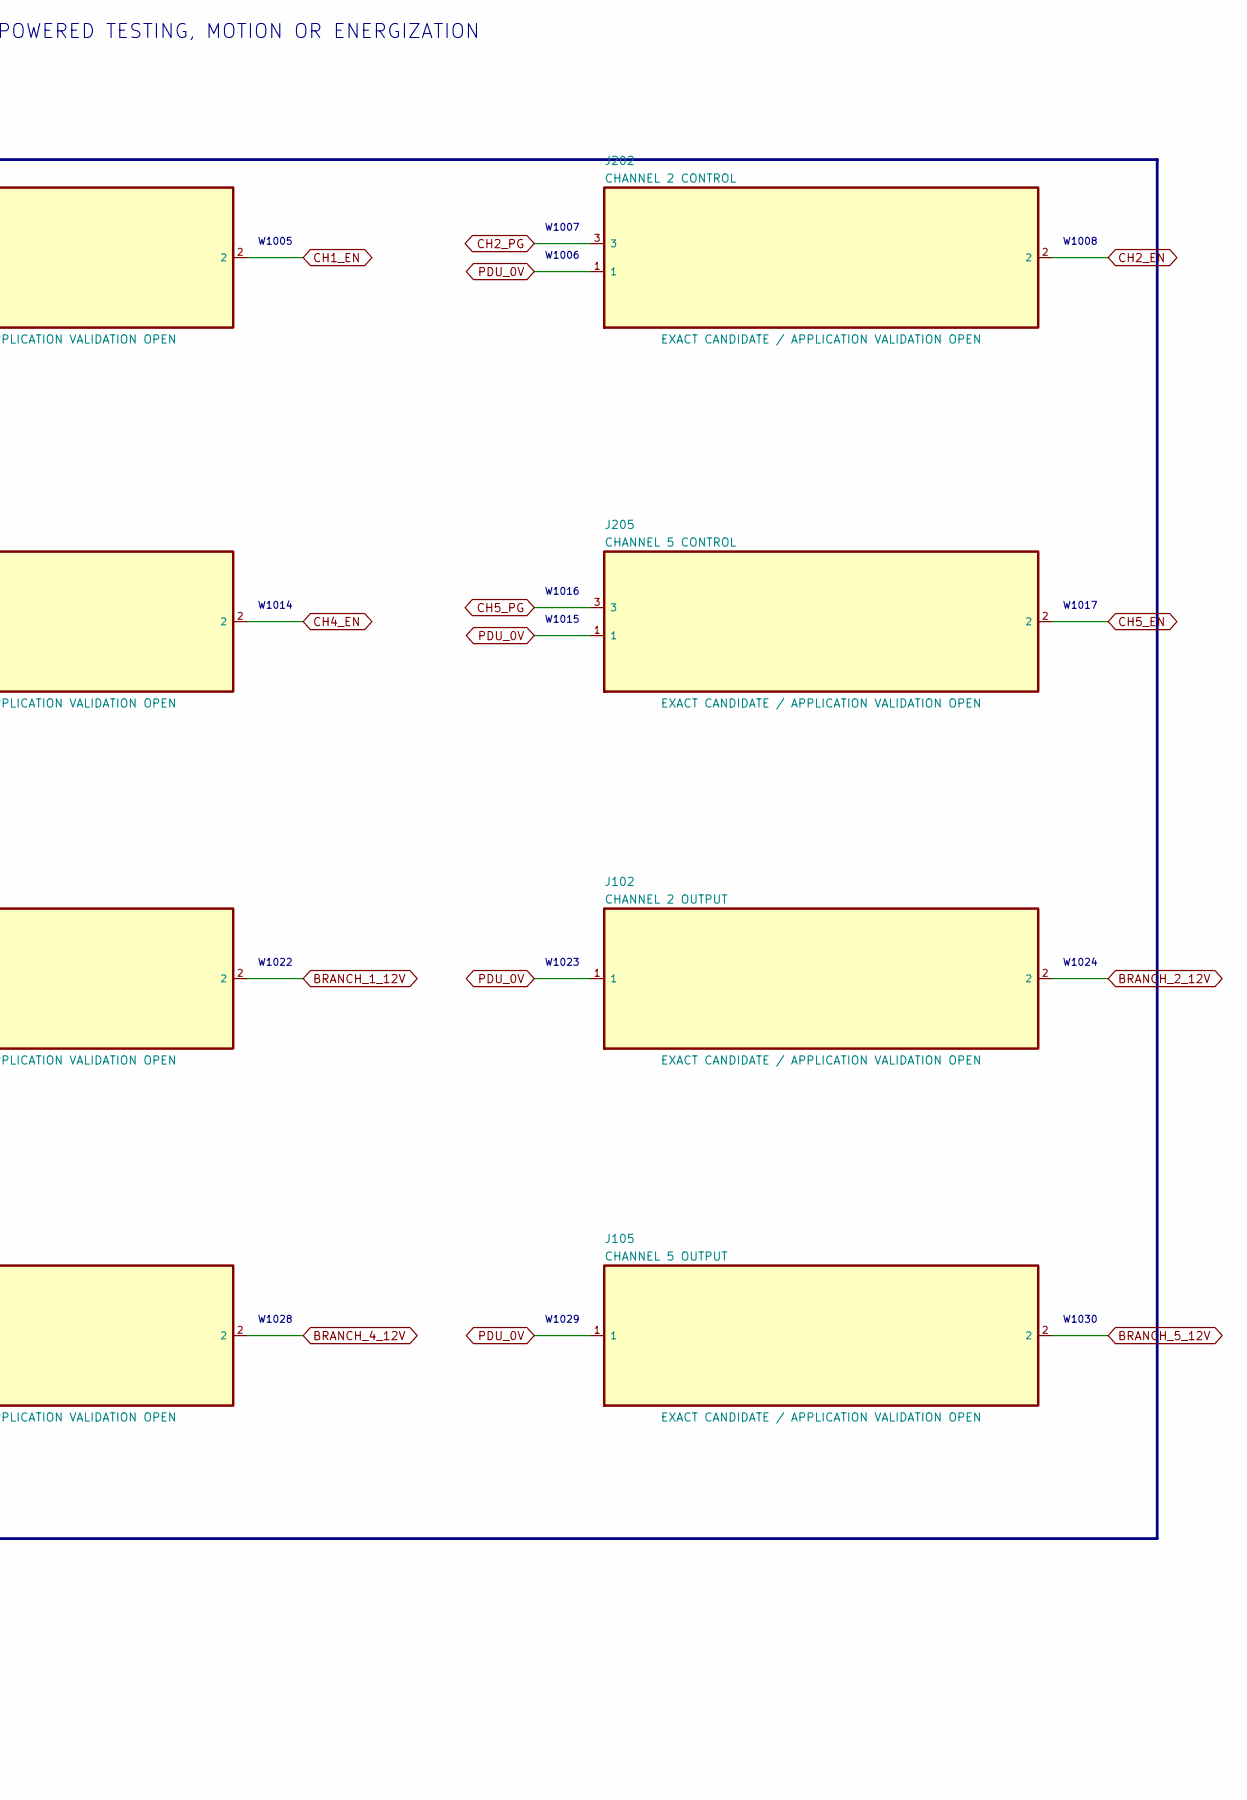
[picture p309: schematic 01_pdu_boundaries.kicad_sch, PB HR-V0 P0.1 - 01, part in row 1, column 2]

Parts:
J1: 12 V CONTROLLED INPUT; TerminalBlock_MetzConnect_Type703_RT10N02HGLU_1x02_P9.52mm_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
J101: CHANNEL 1 OUTPUT; JST_VH_B2P-VH_1x02_P3.96mm_Vertical
J102: CHANNEL 2 OUTPUT; JST_VH_B2P-VH_1x02_P3.96mm_Vertical
J103: CHANNEL 3 OUTPUT; JST_VH_B2P-VH_1x02_P3.96mm_Vertical
J104: CHANNEL 4 OUTPUT; JST_VH_B2P-VH_1x02_P3.96mm_Vertical
J105: CHANNEL 5 OUTPUT; JST_VH_B2P-VH_1x02_P3.96mm_Vertical
J106: CHANNEL 6 OUTPUT; JST_VH_B2P-VH_1x02_P3.96mm_Vertical
J201: CHANNEL 1 CONTROL; JST_GH_BM03B-GHS-TBT_1x03-1MP_P1.25mm_Vertical
J202: CHANNEL 2 CONTROL; JST_GH_BM03B-GHS-TBT_1x03-1MP_P1.25mm_Vertical
J203: CHANNEL 3 CONTROL; JST_GH_BM03B-GHS-TBT_1x03-1MP_P1.25mm_Vertical
J204: CHANNEL 4 CONTROL; JST_GH_BM03B-GHS-TBT_1x03-1MP_P1.25mm_Vertical
J205: CHANNEL 5 CONTROL; JST_GH_BM03B-GHS-TBT_1x03-1MP_P1.25mm_Vertical
J206: CHANNEL 6 CONTROL; JST_GH_BM03B-GHS-TBT_1x03-1MP_P1.25mm_Vertical

Connections:
BRANCH_1_12V: J101.2; also elsewhere on the board
BRANCH_2_12V: J102.2; also elsewhere on the board
BRANCH_3_12V: J103.2; also elsewhere on the board
BRANCH_4_12V: J104.2; also elsewhere on the board
BRANCH_5_12V: J105.2; also elsewhere on the board
BRANCH_6_12V: J106.2; also elsewhere on the board
CH1_EN: J201.2; also elsewhere on the board
CH1_PG: J201.3; also elsewhere on the board
CH2_EN: J202.2; also elsewhere on the board
CH2_PG: J202.3; also elsewhere on the board
CH3_EN: J203.2; also elsewhere on the board
CH3_PG: J203.3; also elsewhere on the board
CH4_EN: J204.2; also elsewhere on the board
CH4_PG: J204.3; also elsewhere on the board
CH5_EN: J205.2; also elsewhere on the board
CH5_PG: J205.3; also elsewhere on the board
CH6_EN: J206.2; also elsewhere on the board
CH6_PG: J206.3; also elsewhere on the board
PDU_0V: J1.1, J101.1, J102.1, J103.1, J104.1, J105.1, J106.1, J201.1, J202.1, J203.1, J204.1, J205.1, J206.1; also elsewhere on the board
PDU_12V_IN: J1.2; also elsewhere on the board

Notes on the sheet:
PRELIMINARY - NOT APPROVED FOR PROCUREMENT, FABRICATION, ASSEMBLY, CONNECTION, POWERED TESTING, MOTION OR ENERGIZATION
01 PDU input, logic and six branch outputs
Five identical board assemblies provide 30 positions; only 25 are populated by the allocation register.
W1001
W1002
W1003
W1004
W1005
W1006
W1007
W1008
W1009
W1010
W1011
W1012
W1013
W1014
W1015
W1016
W1017
W1018
W1019
W1020
W1021
W1022
W1023
W1024
W1025
W1026
W1027
W1028
W1029
W1030
W1031
W1032
NOTE 1: Each J20x GND/DISABLE_OD/PG boundary is ordinary control and diagnostics only; it
has zero safety credit.
NOTE 2: Branch outputs are local power pairs; actuator data-only harnesses never carry VDD
between axes.
NOTE 3: PRELIMINARY - NOT APPROVED FOR PROCUREMENT, FABRICATION, ASSEMBLY, CONNECTION,
POWERED TESTING, MOTION OR ENERGIZATION

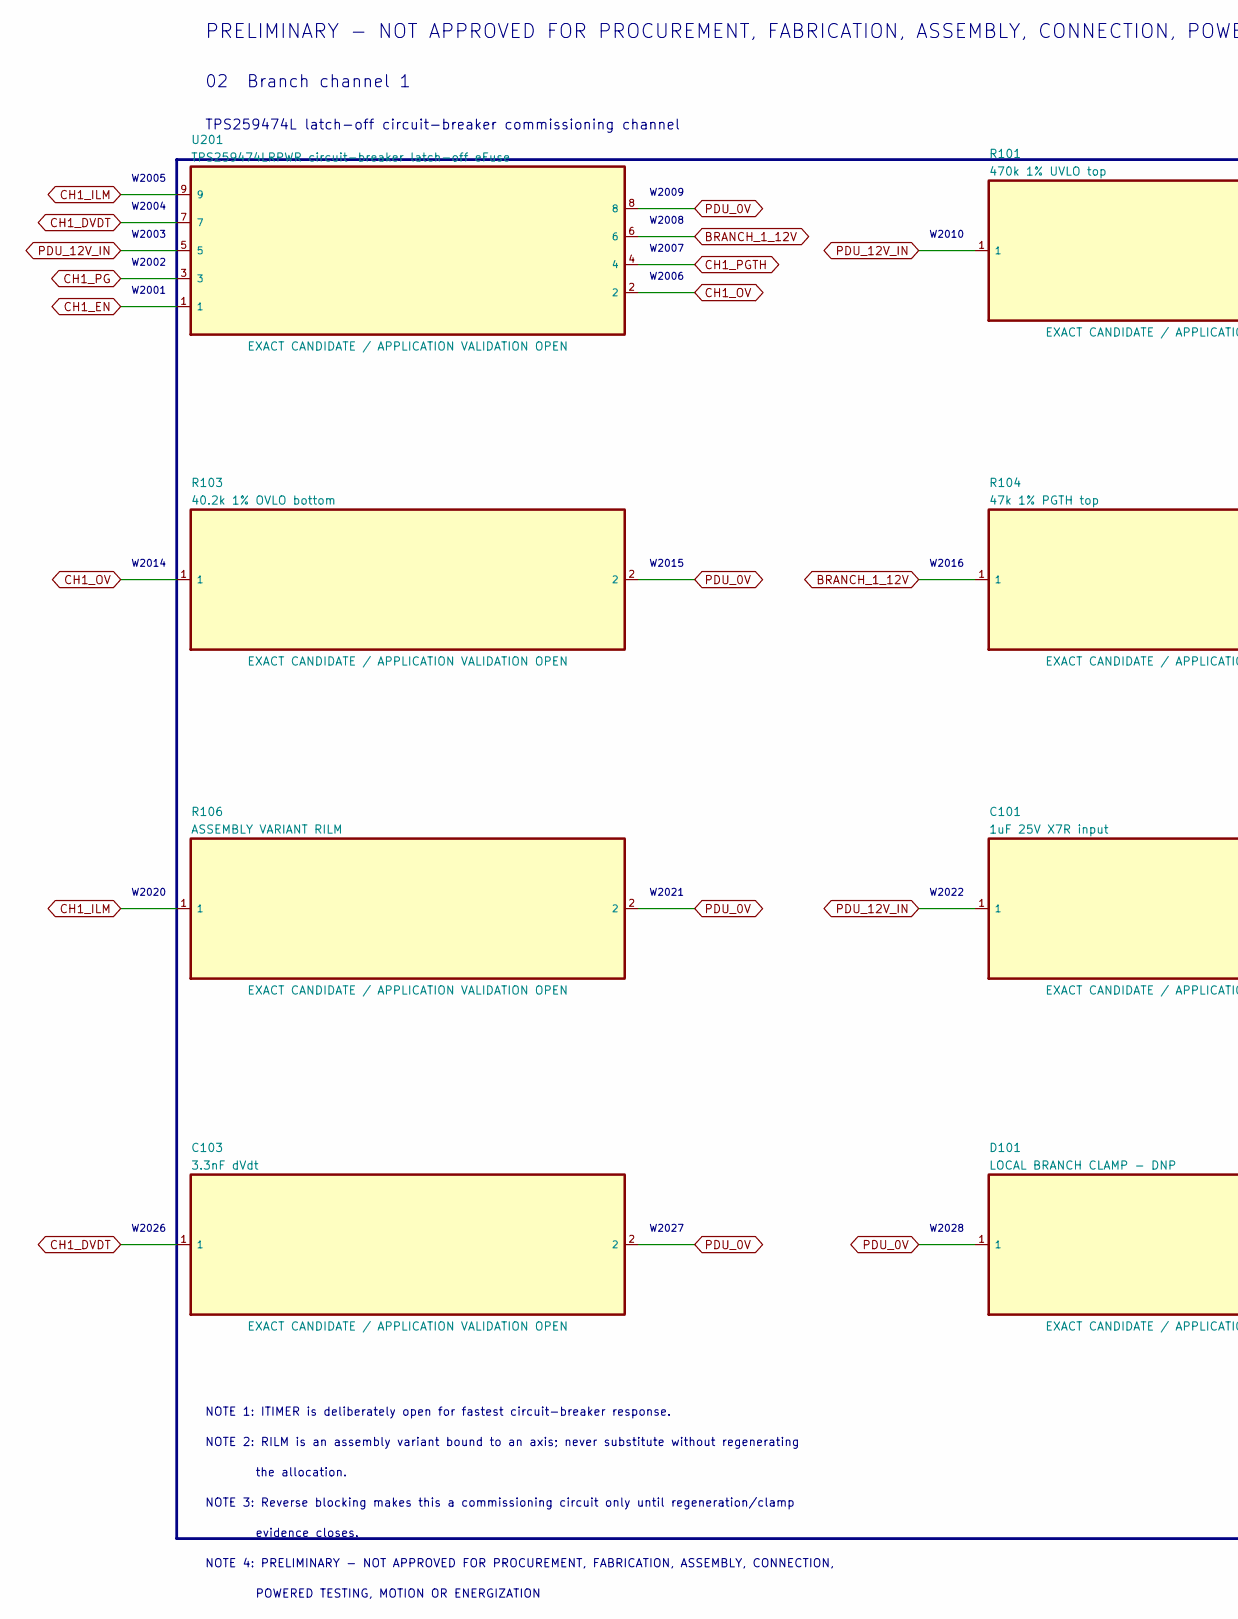
[picture p310: schematic 02_channel_1.kicad_sch, PB HR-V0 P0.1 - 02, part in row 1, column 1]

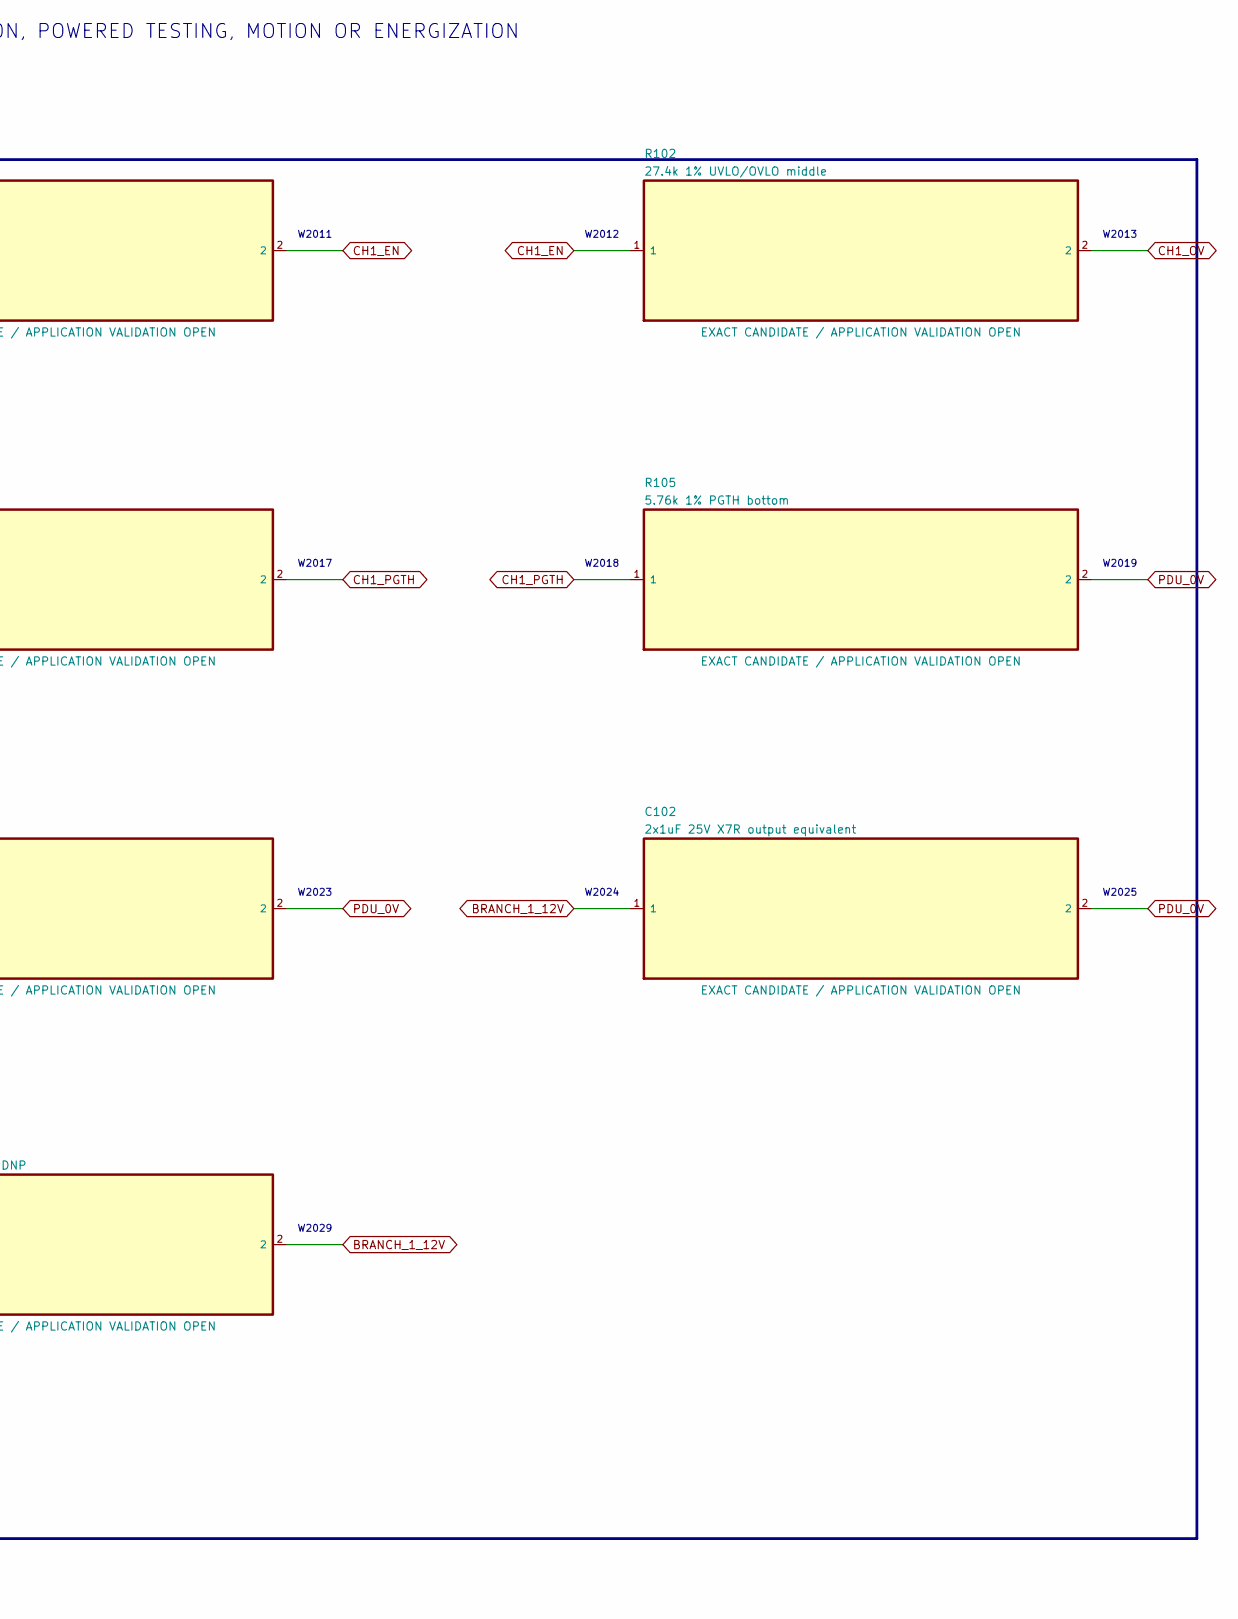
[picture p311: schematic 02_channel_1.kicad_sch, PB HR-V0 P0.1 - 02, part in row 1, column 2]

Parts:
C101: 1uF 25V X7R input; C_0603_1608Metric
C102: 2x1uF 25V X7R output equivalent; C_0603_1608Metric
C103: 3.3nF dVdt; C_0603_1608Metric
D101: LOCAL BRANCH CLAMP - DNP; D_SMA
R101: 470k 1% UVLO top; R_0603_1608Metric
R102: 27.4k 1% UVLO/OVLO middle; R_0603_1608Metric
R103: 40.2k 1% OVLO bottom; R_0603_1608Metric
R104: 47k 1% PGTH top; R_0603_1608Metric
R105: 5.76k 1% PGTH bottom; R_0603_1608Metric
R106: ASSEMBLY VARIANT RILM; R_0603_1608Metric
U201: TPS259474LRPWR circuit-breaker latch-off eFuse; TI_RPW0010A_HotRodQFN_2x2mm_P0.45mm_TI4225183A_P02

Connections:
BRANCH_1_12V: C102.1, D101.2, R104.1, U201.6; also elsewhere on the board
CH1_DVDT: C103.1, U201.7
CH1_EN: R101.2, R102.1, U201.1; also elsewhere on the board
CH1_ILM: R106.1, U201.9
CH1_OV: R102.2, R103.1, U201.2
CH1_PG: U201.3; also elsewhere on the board
CH1_PGTH: R104.2, R105.1, U201.4
PDU_0V: C101.2, C102.2, C103.2, D101.1, R103.2, R105.2, R106.2, U201.8; also elsewhere on the board
PDU_12V_IN: C101.1, R101.1, U201.5; also elsewhere on the board

Notes on the sheet:
PRELIMINARY - NOT APPROVED FOR PROCUREMENT, FABRICATION, ASSEMBLY, CONNECTION, POWERED TESTING, MOTION OR ENERGIZATION
02 Branch channel 1
TPS259474L latch-off circuit-breaker commissioning channel
W2001
W2002
W2003
W2004
W2005
W2006
W2007
W2008
W2009
W2010
W2011
W2012
W2013
W2014
W2015
W2016
W2017
W2018
W2019
W2020
W2021
W2022
W2023
W2024
W2025
W2026
W2027
W2028
W2029
NOTE 1: ITIMER is deliberately open for fastest circuit-breaker response.
NOTE 2: RILM is an assembly variant bound to an axis; never substitute without regenerating
the allocation.
NOTE 3: Reverse blocking makes this a commissioning circuit only until regeneration/clamp
evidence closes.
NOTE 4: PRELIMINARY - NOT APPROVED FOR PROCUREMENT, FABRICATION, ASSEMBLY, CONNECTION,
POWERED TESTING, MOTION OR ENERGIZATION

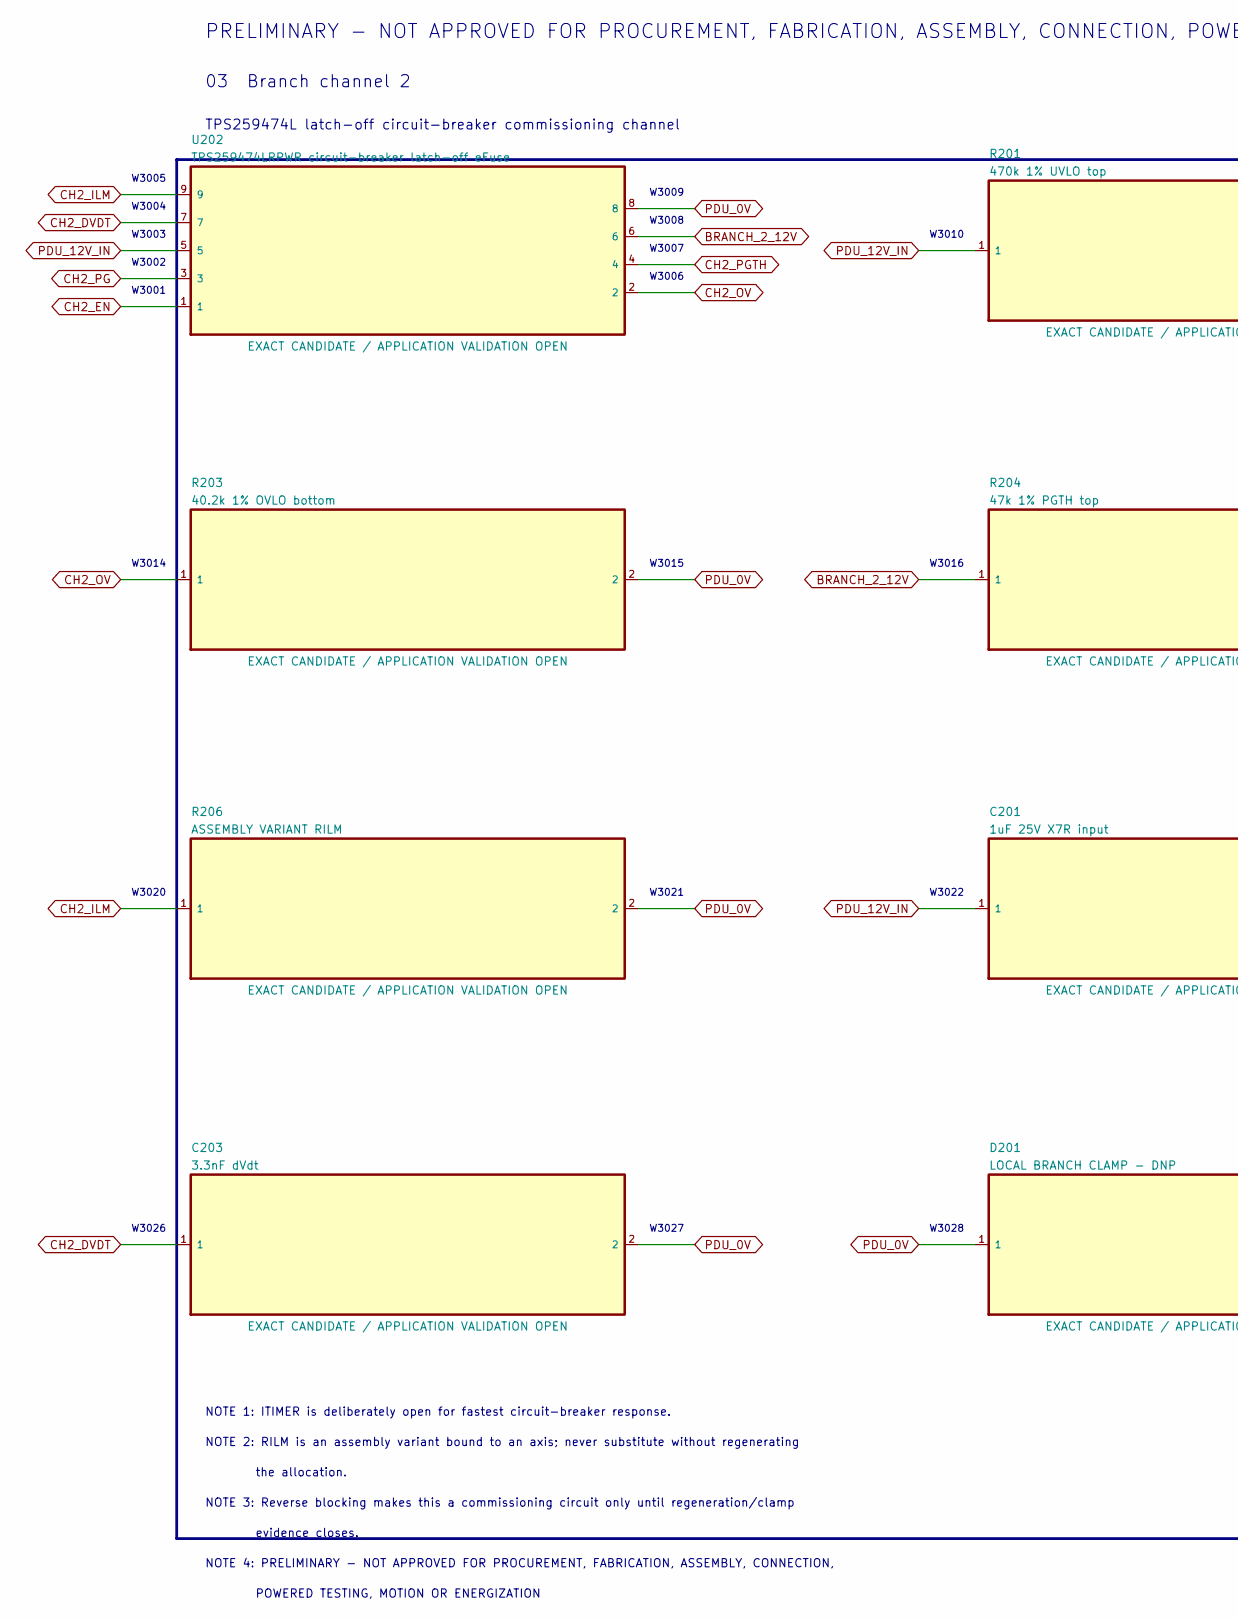
[picture p312: schematic 03_channel_2.kicad_sch, PB HR-V0 P0.1 - 03, part in row 1, column 1]

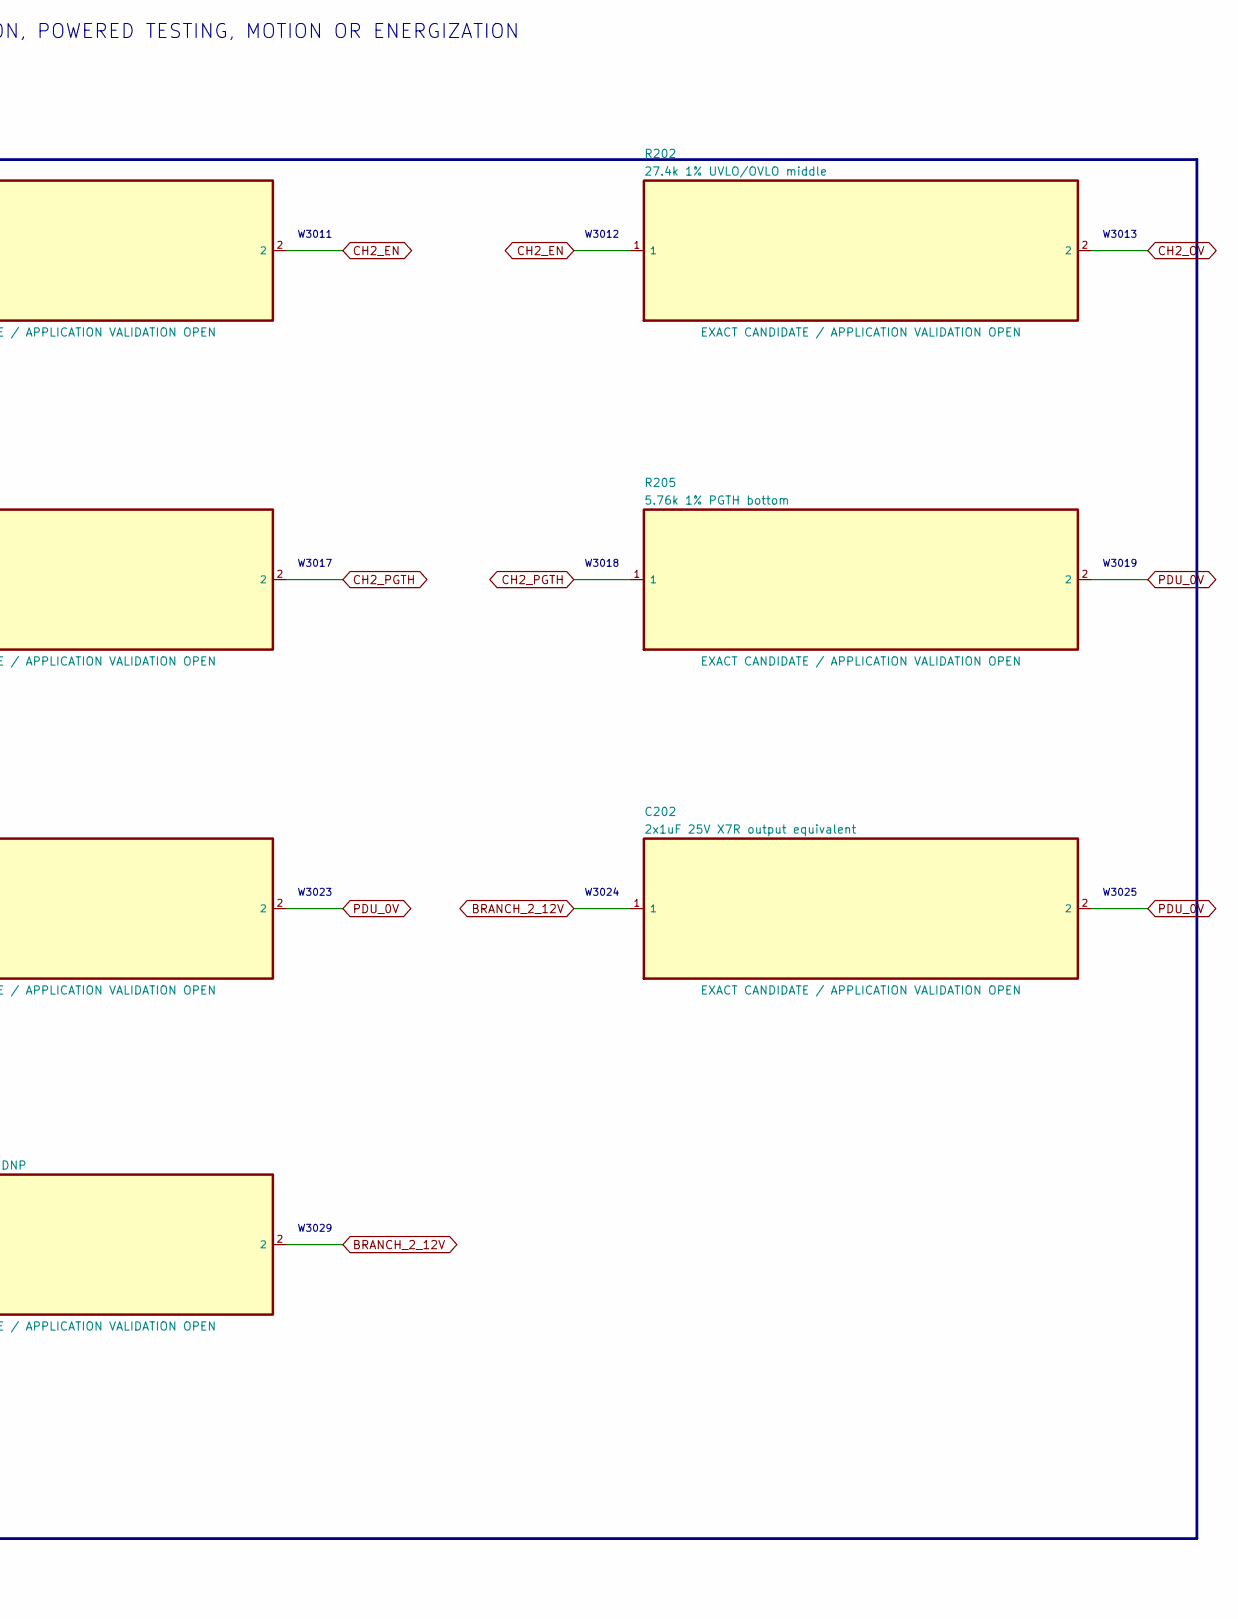
[picture p313: schematic 03_channel_2.kicad_sch, PB HR-V0 P0.1 - 03, part in row 1, column 2]

Parts:
C201: 1uF 25V X7R input; C_0603_1608Metric
C202: 2x1uF 25V X7R output equivalent; C_0603_1608Metric
C203: 3.3nF dVdt; C_0603_1608Metric
D201: LOCAL BRANCH CLAMP - DNP; D_SMA
R201: 470k 1% UVLO top; R_0603_1608Metric
R202: 27.4k 1% UVLO/OVLO middle; R_0603_1608Metric
R203: 40.2k 1% OVLO bottom; R_0603_1608Metric
R204: 47k 1% PGTH top; R_0603_1608Metric
R205: 5.76k 1% PGTH bottom; R_0603_1608Metric
R206: ASSEMBLY VARIANT RILM; R_0603_1608Metric
U202: TPS259474LRPWR circuit-breaker latch-off eFuse; TI_RPW0010A_HotRodQFN_2x2mm_P0.45mm_TI4225183A_P02

Connections:
BRANCH_2_12V: C202.1, D201.2, R204.1, U202.6; also elsewhere on the board
CH2_DVDT: C203.1, U202.7
CH2_EN: R201.2, R202.1, U202.1; also elsewhere on the board
CH2_ILM: R206.1, U202.9
CH2_OV: R202.2, R203.1, U202.2
CH2_PG: U202.3; also elsewhere on the board
CH2_PGTH: R204.2, R205.1, U202.4
PDU_0V: C201.2, C202.2, C203.2, D201.1, R203.2, R205.2, R206.2, U202.8; also elsewhere on the board
PDU_12V_IN: C201.1, R201.1, U202.5; also elsewhere on the board

Notes on the sheet:
PRELIMINARY - NOT APPROVED FOR PROCUREMENT, FABRICATION, ASSEMBLY, CONNECTION, POWERED TESTING, MOTION OR ENERGIZATION
03 Branch channel 2
TPS259474L latch-off circuit-breaker commissioning channel
W3001
W3002
W3003
W3004
W3005
W3006
W3007
W3008
W3009
W3010
W3011
W3012
W3013
W3014
W3015
W3016
W3017
W3018
W3019
W3020
W3021
W3022
W3023
W3024
W3025
W3026
W3027
W3028
W3029
NOTE 1: ITIMER is deliberately open for fastest circuit-breaker response.
NOTE 2: RILM is an assembly variant bound to an axis; never substitute without regenerating
the allocation.
NOTE 3: Reverse blocking makes this a commissioning circuit only until regeneration/clamp
evidence closes.
NOTE 4: PRELIMINARY - NOT APPROVED FOR PROCUREMENT, FABRICATION, ASSEMBLY, CONNECTION,
POWERED TESTING, MOTION OR ENERGIZATION

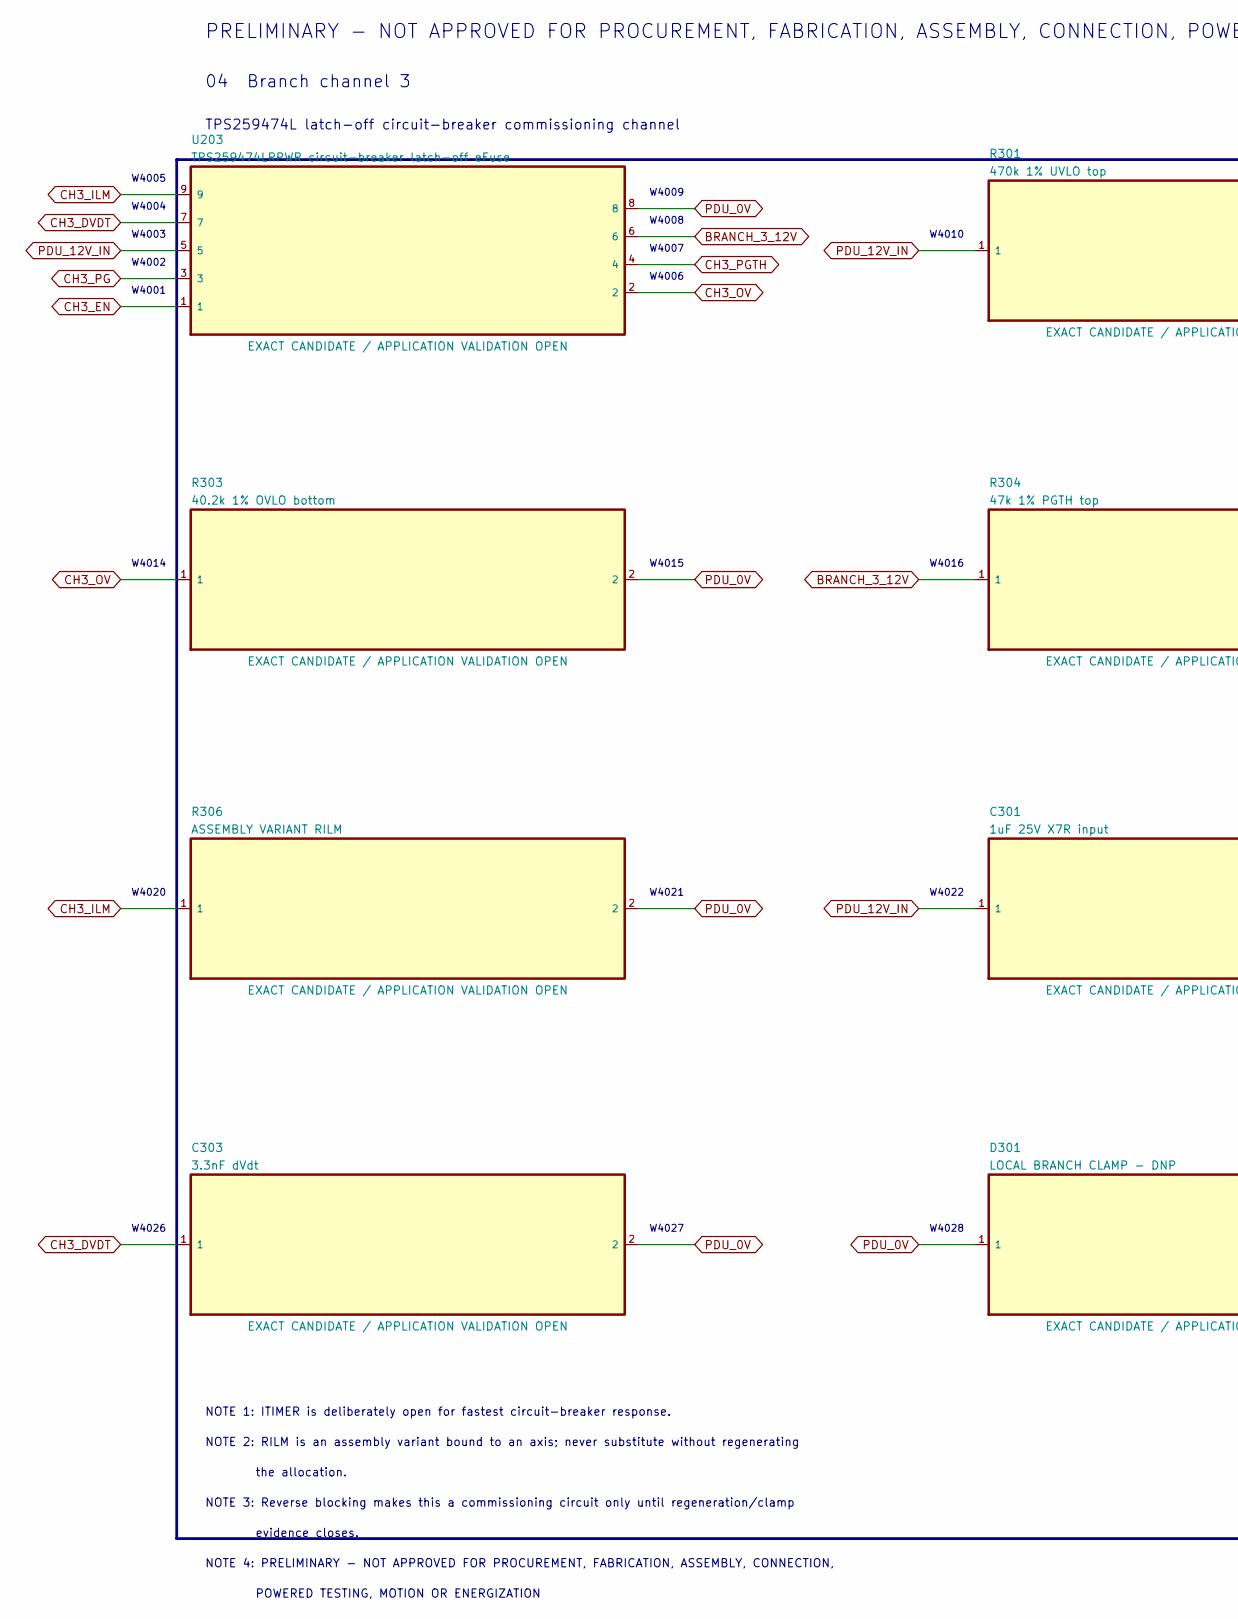
[picture p314: schematic 04_channel_3.kicad_sch, PB HR-V0 P0.1 - 04, part in row 1, column 1]

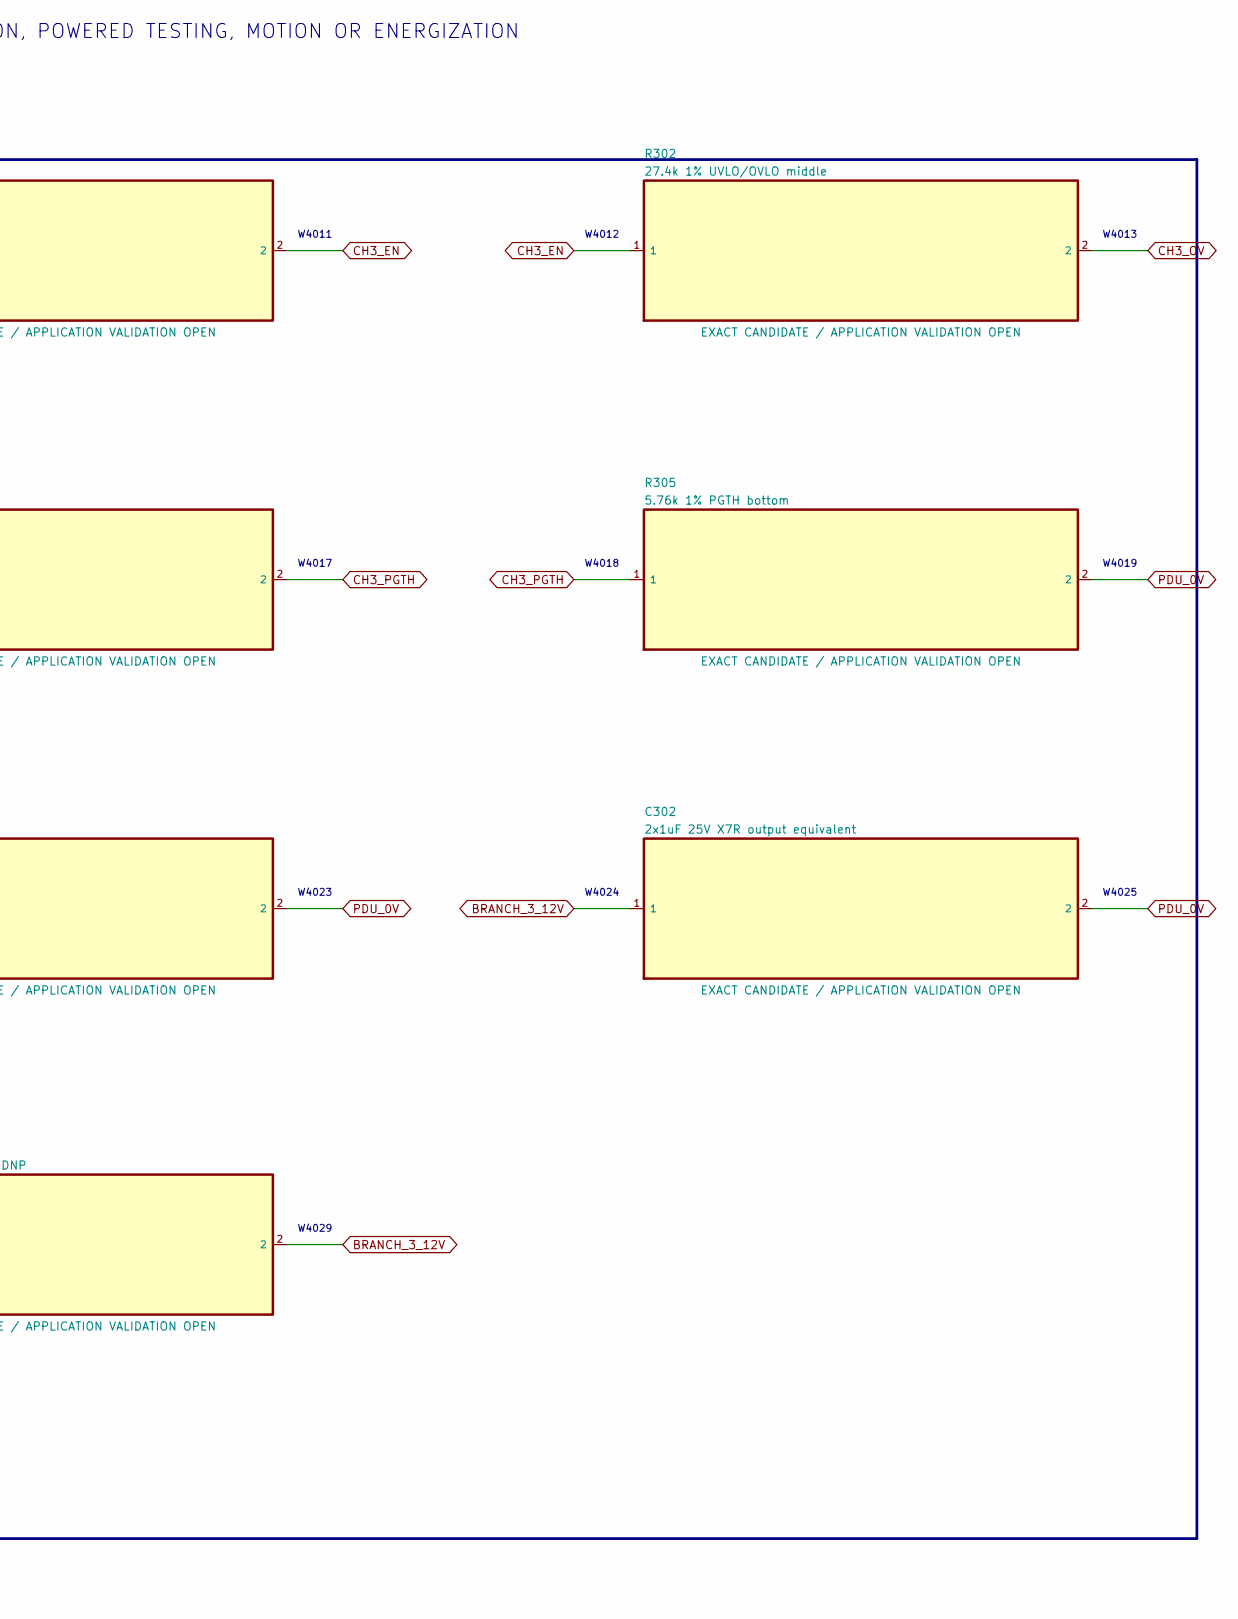
[picture p315: schematic 04_channel_3.kicad_sch, PB HR-V0 P0.1 - 04, part in row 1, column 2]

Parts:
C301: 1uF 25V X7R input; C_0603_1608Metric
C302: 2x1uF 25V X7R output equivalent; C_0603_1608Metric
C303: 3.3nF dVdt; C_0603_1608Metric
D301: LOCAL BRANCH CLAMP - DNP; D_SMA
R301: 470k 1% UVLO top; R_0603_1608Metric
R302: 27.4k 1% UVLO/OVLO middle; R_0603_1608Metric
R303: 40.2k 1% OVLO bottom; R_0603_1608Metric
R304: 47k 1% PGTH top; R_0603_1608Metric
R305: 5.76k 1% PGTH bottom; R_0603_1608Metric
R306: ASSEMBLY VARIANT RILM; R_0603_1608Metric
U203: TPS259474LRPWR circuit-breaker latch-off eFuse; TI_RPW0010A_HotRodQFN_2x2mm_P0.45mm_TI4225183A_P02

Connections:
BRANCH_3_12V: C302.1, D301.2, R304.1, U203.6; also elsewhere on the board
CH3_DVDT: C303.1, U203.7
CH3_EN: R301.2, R302.1, U203.1; also elsewhere on the board
CH3_ILM: R306.1, U203.9
CH3_OV: R302.2, R303.1, U203.2
CH3_PG: U203.3; also elsewhere on the board
CH3_PGTH: R304.2, R305.1, U203.4
PDU_0V: C301.2, C302.2, C303.2, D301.1, R303.2, R305.2, R306.2, U203.8; also elsewhere on the board
PDU_12V_IN: C301.1, R301.1, U203.5; also elsewhere on the board

Notes on the sheet:
PRELIMINARY - NOT APPROVED FOR PROCUREMENT, FABRICATION, ASSEMBLY, CONNECTION, POWERED TESTING, MOTION OR ENERGIZATION
04 Branch channel 3
TPS259474L latch-off circuit-breaker commissioning channel
W4001
W4002
W4003
W4004
W4005
W4006
W4007
W4008
W4009
W4010
W4011
W4012
W4013
W4014
W4015
W4016
W4017
W4018
W4019
W4020
W4021
W4022
W4023
W4024
W4025
W4026
W4027
W4028
W4029
NOTE 1: ITIMER is deliberately open for fastest circuit-breaker response.
NOTE 2: RILM is an assembly variant bound to an axis; never substitute without regenerating
the allocation.
NOTE 3: Reverse blocking makes this a commissioning circuit only until regeneration/clamp
evidence closes.
NOTE 4: PRELIMINARY - NOT APPROVED FOR PROCUREMENT, FABRICATION, ASSEMBLY, CONNECTION,
POWERED TESTING, MOTION OR ENERGIZATION
