amyleesterling/humanoid-robot/hr30/whole-body-p0.1/electrical/actuator-branch-pdu-p0.1/hr30-actuator-branch-pdu-p0.1.kicad_pcb

## KiCad design hr30/whole-body-p0.1/electrical/actuator-branch-pdu-p0.1/hr30-actuator-branch-pdu-p0.1.kicad_pcb (continued)

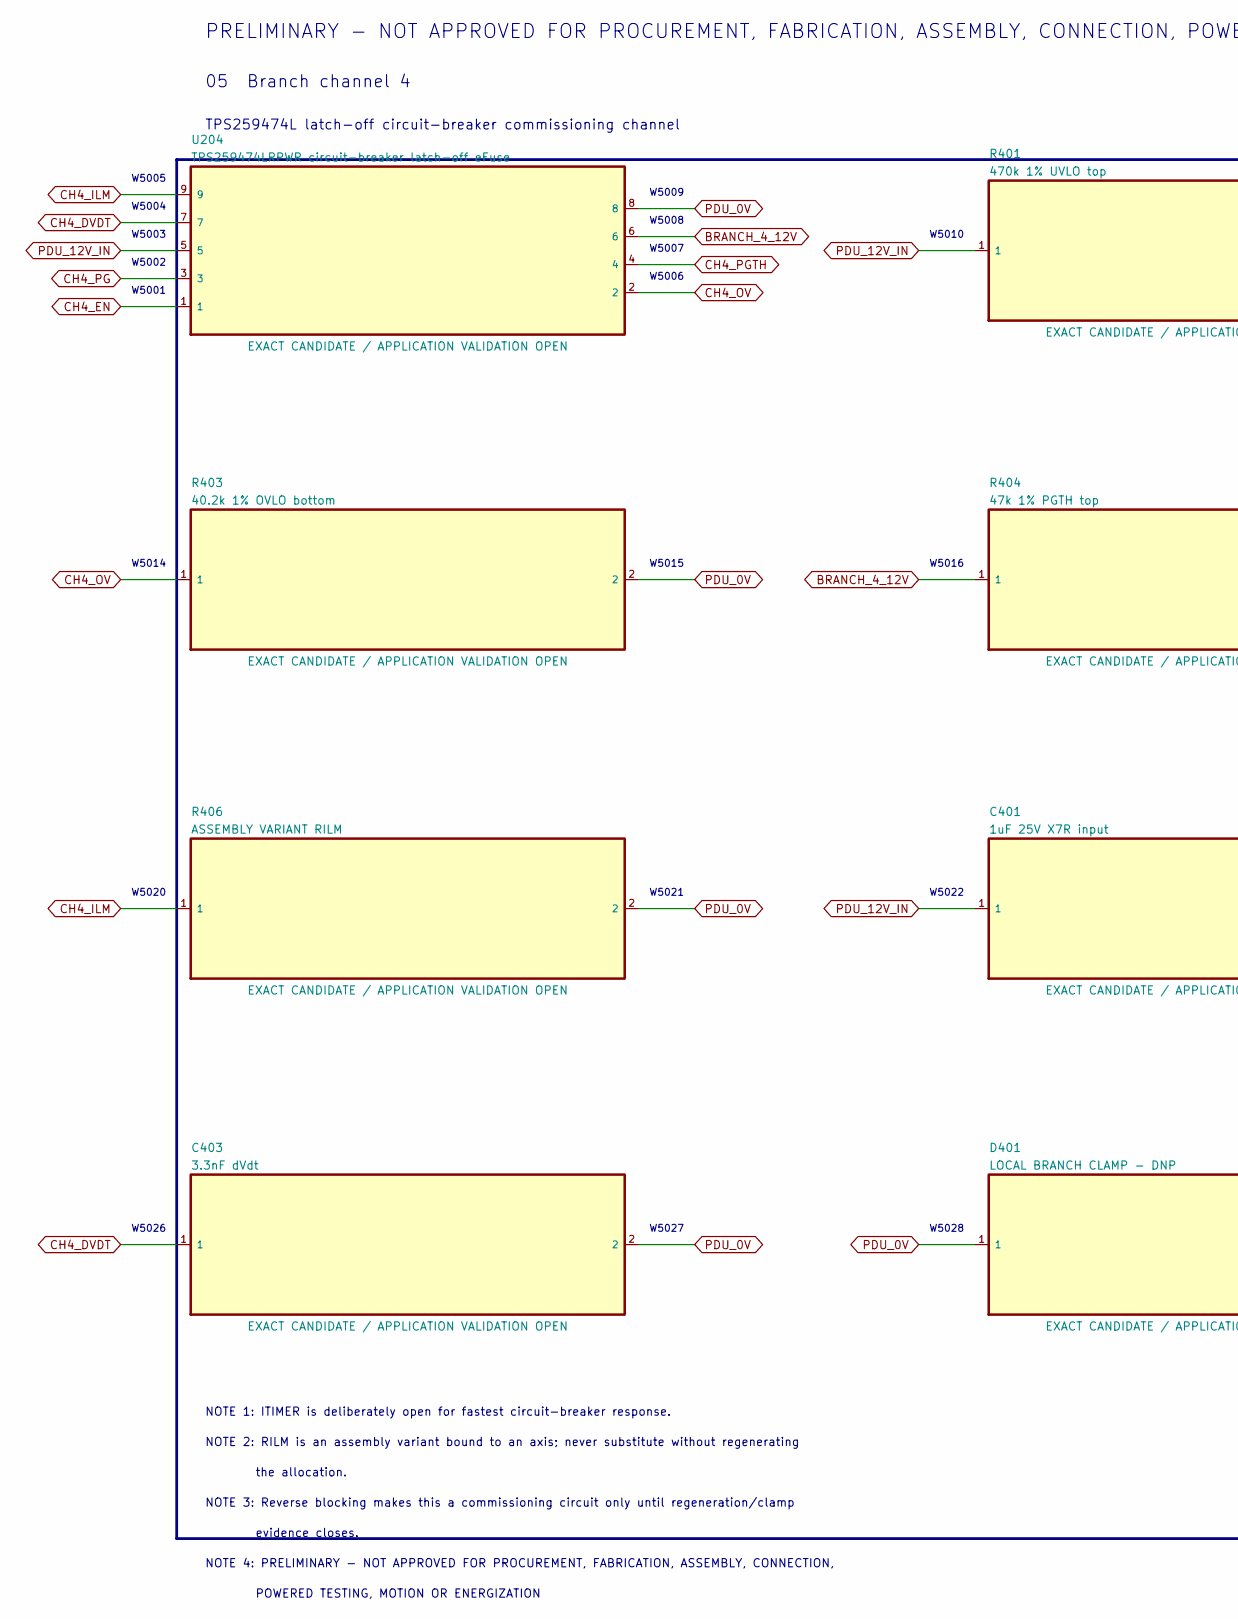
[picture p316: schematic 05_channel_4.kicad_sch, PB HR-V0 P0.1 - 05, part in row 1, column 1]

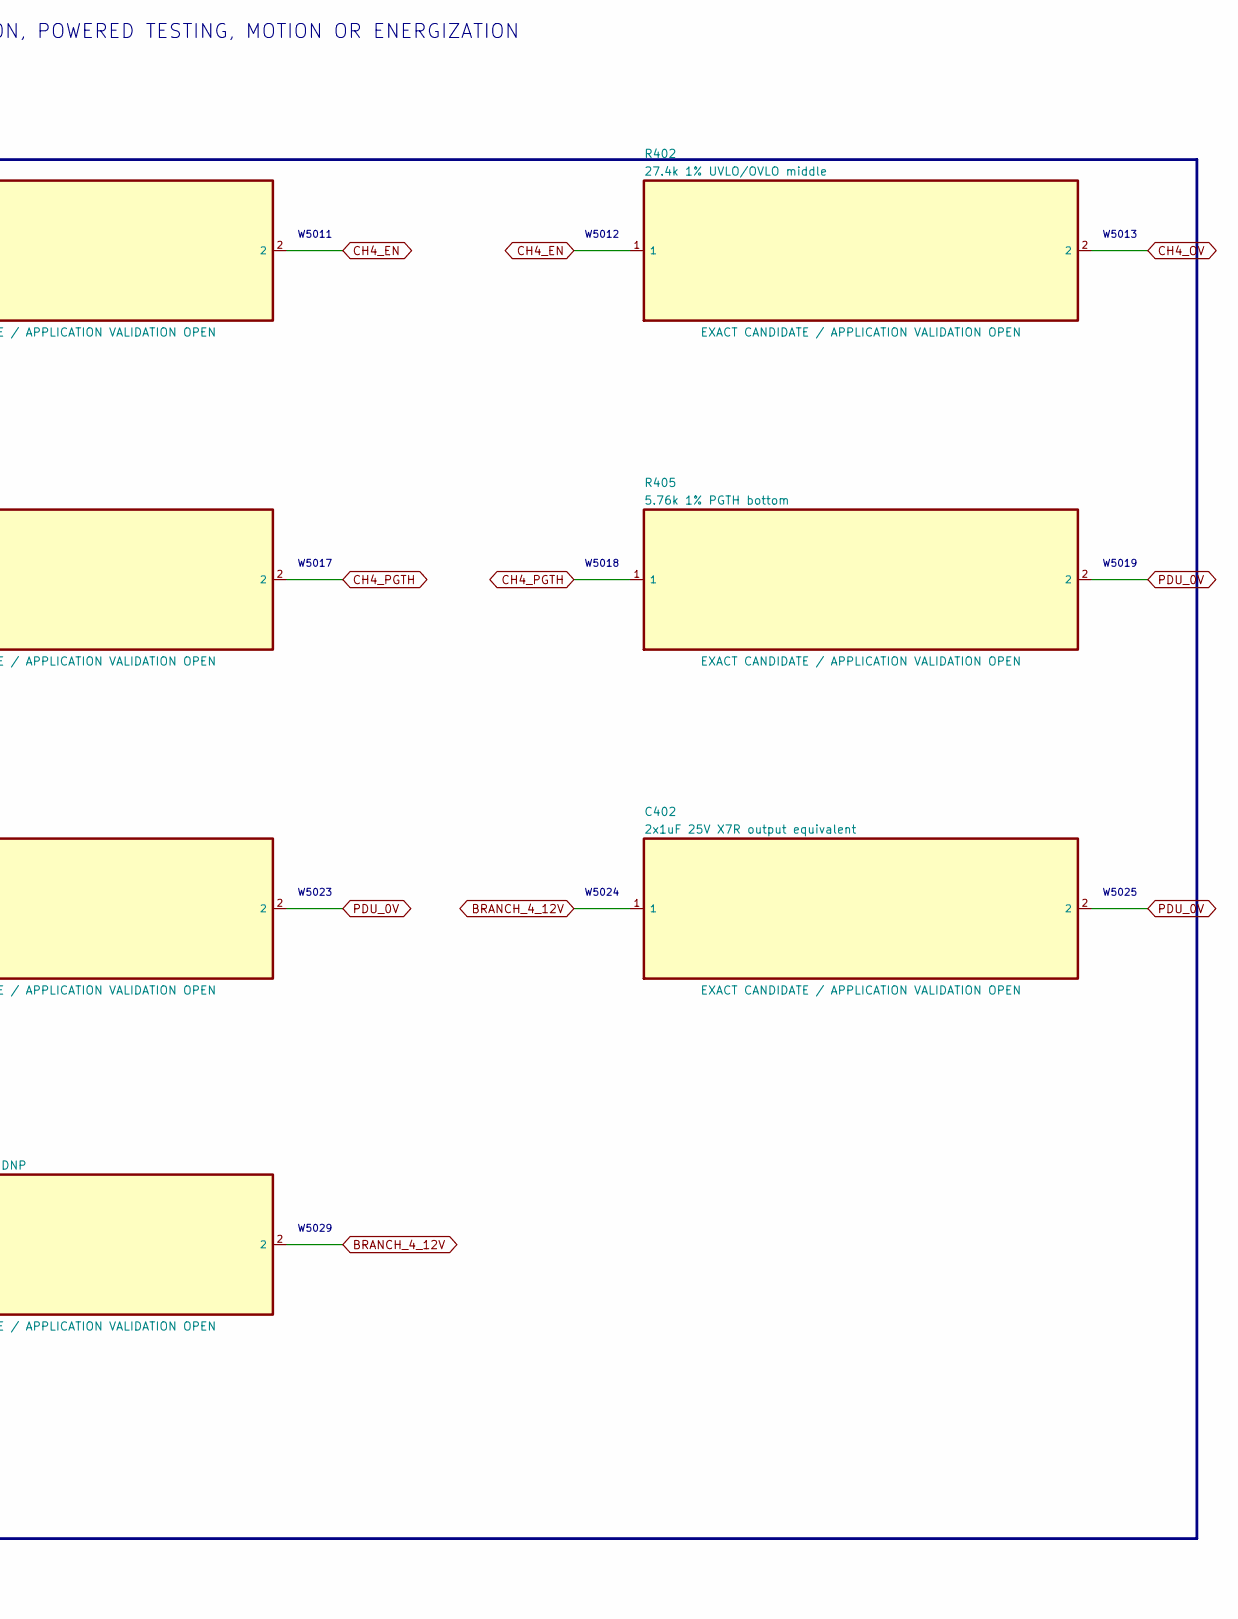
[picture p317: schematic 05_channel_4.kicad_sch, PB HR-V0 P0.1 - 05, part in row 1, column 2]

Parts:
C401: 1uF 25V X7R input; C_0603_1608Metric
C402: 2x1uF 25V X7R output equivalent; C_0603_1608Metric
C403: 3.3nF dVdt; C_0603_1608Metric
D401: LOCAL BRANCH CLAMP - DNP; D_SMA
R401: 470k 1% UVLO top; R_0603_1608Metric
R402: 27.4k 1% UVLO/OVLO middle; R_0603_1608Metric
R403: 40.2k 1% OVLO bottom; R_0603_1608Metric
R404: 47k 1% PGTH top; R_0603_1608Metric
R405: 5.76k 1% PGTH bottom; R_0603_1608Metric
R406: ASSEMBLY VARIANT RILM; R_0603_1608Metric
U204: TPS259474LRPWR circuit-breaker latch-off eFuse; TI_RPW0010A_HotRodQFN_2x2mm_P0.45mm_TI4225183A_P02

Connections:
BRANCH_4_12V: C402.1, D401.2, R404.1, U204.6; also elsewhere on the board
CH4_DVDT: C403.1, U204.7
CH4_EN: R401.2, R402.1, U204.1; also elsewhere on the board
CH4_ILM: R406.1, U204.9
CH4_OV: R402.2, R403.1, U204.2
CH4_PG: U204.3; also elsewhere on the board
CH4_PGTH: R404.2, R405.1, U204.4
PDU_0V: C401.2, C402.2, C403.2, D401.1, R403.2, R405.2, R406.2, U204.8; also elsewhere on the board
PDU_12V_IN: C401.1, R401.1, U204.5; also elsewhere on the board

Notes on the sheet:
PRELIMINARY - NOT APPROVED FOR PROCUREMENT, FABRICATION, ASSEMBLY, CONNECTION, POWERED TESTING, MOTION OR ENERGIZATION
05 Branch channel 4
TPS259474L latch-off circuit-breaker commissioning channel
W5001
W5002
W5003
W5004
W5005
W5006
W5007
W5008
W5009
W5010
W5011
W5012
W5013
W5014
W5015
W5016
W5017
W5018
W5019
W5020
W5021
W5022
W5023
W5024
W5025
W5026
W5027
W5028
W5029
NOTE 1: ITIMER is deliberately open for fastest circuit-breaker response.
NOTE 2: RILM is an assembly variant bound to an axis; never substitute without regenerating
the allocation.
NOTE 3: Reverse blocking makes this a commissioning circuit only until regeneration/clamp
evidence closes.
NOTE 4: PRELIMINARY - NOT APPROVED FOR PROCUREMENT, FABRICATION, ASSEMBLY, CONNECTION,
POWERED TESTING, MOTION OR ENERGIZATION

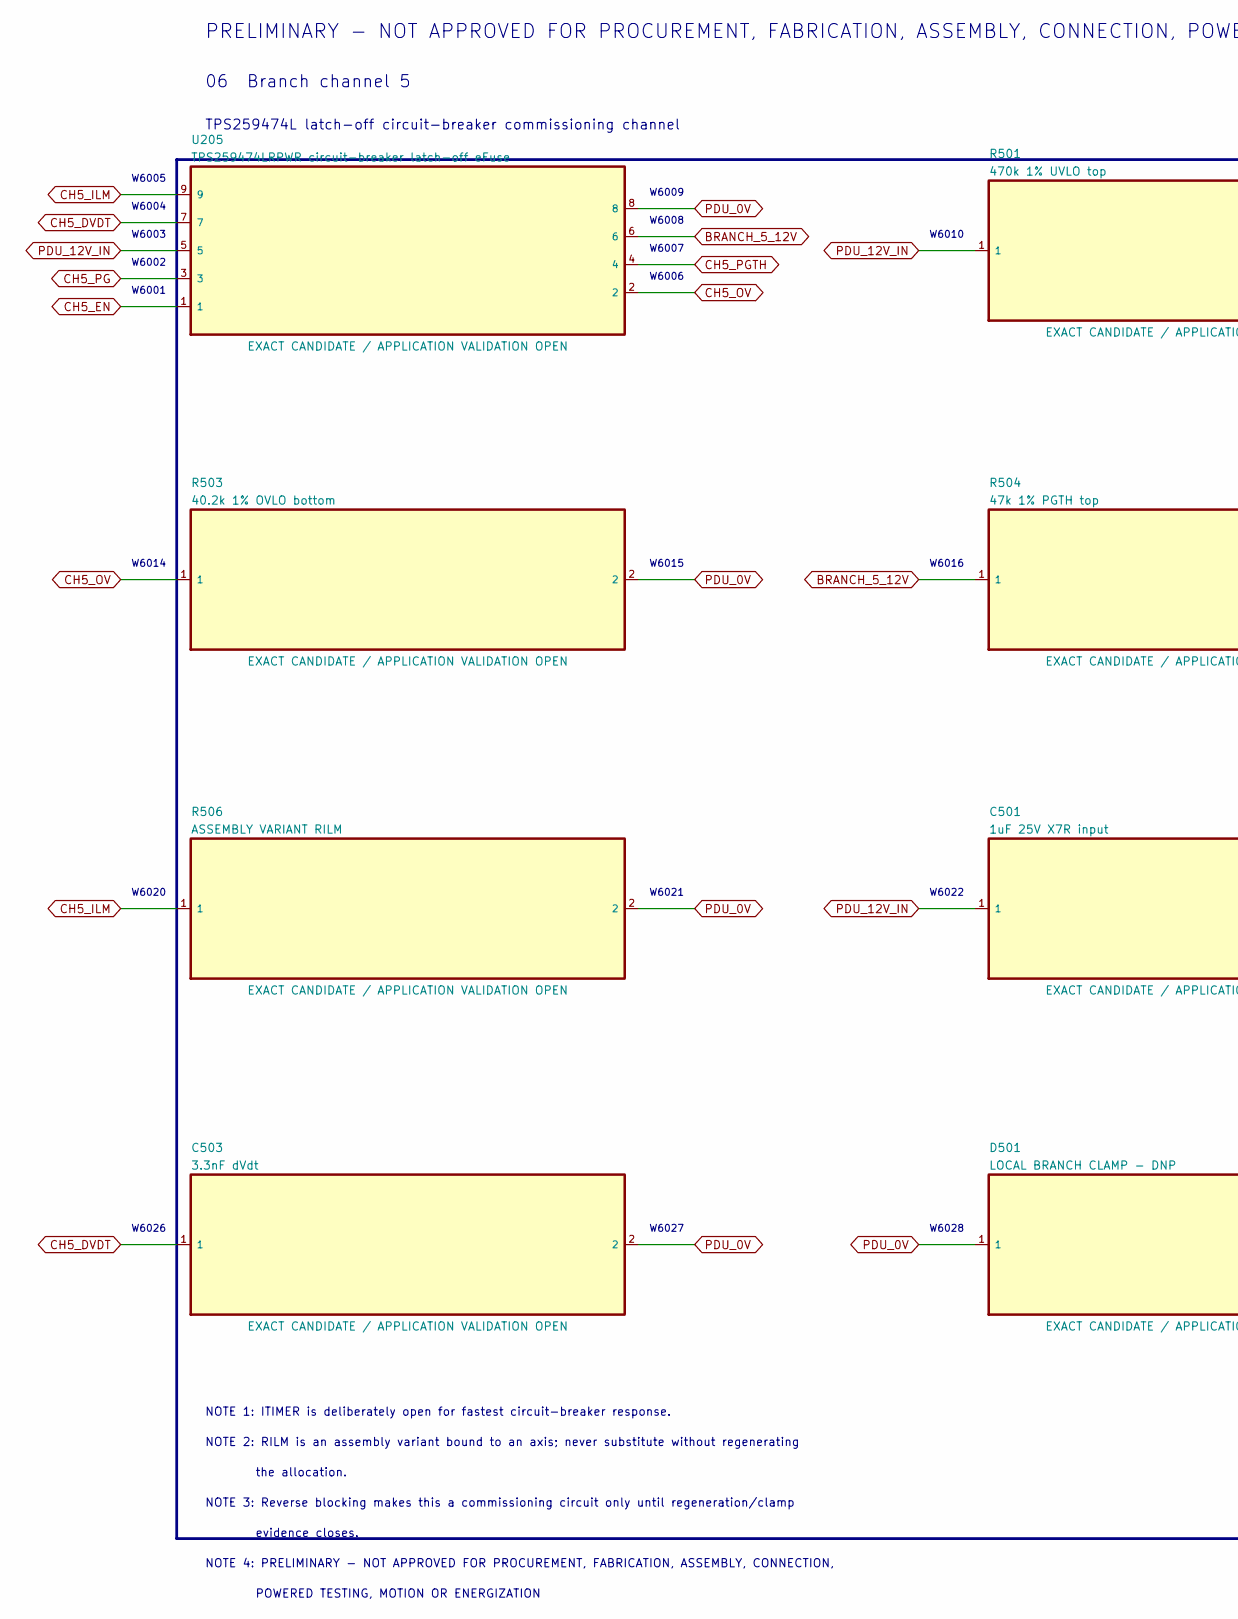
[picture p318: schematic 06_channel_5.kicad_sch, PB HR-V0 P0.1 - 06, part in row 1, column 1]

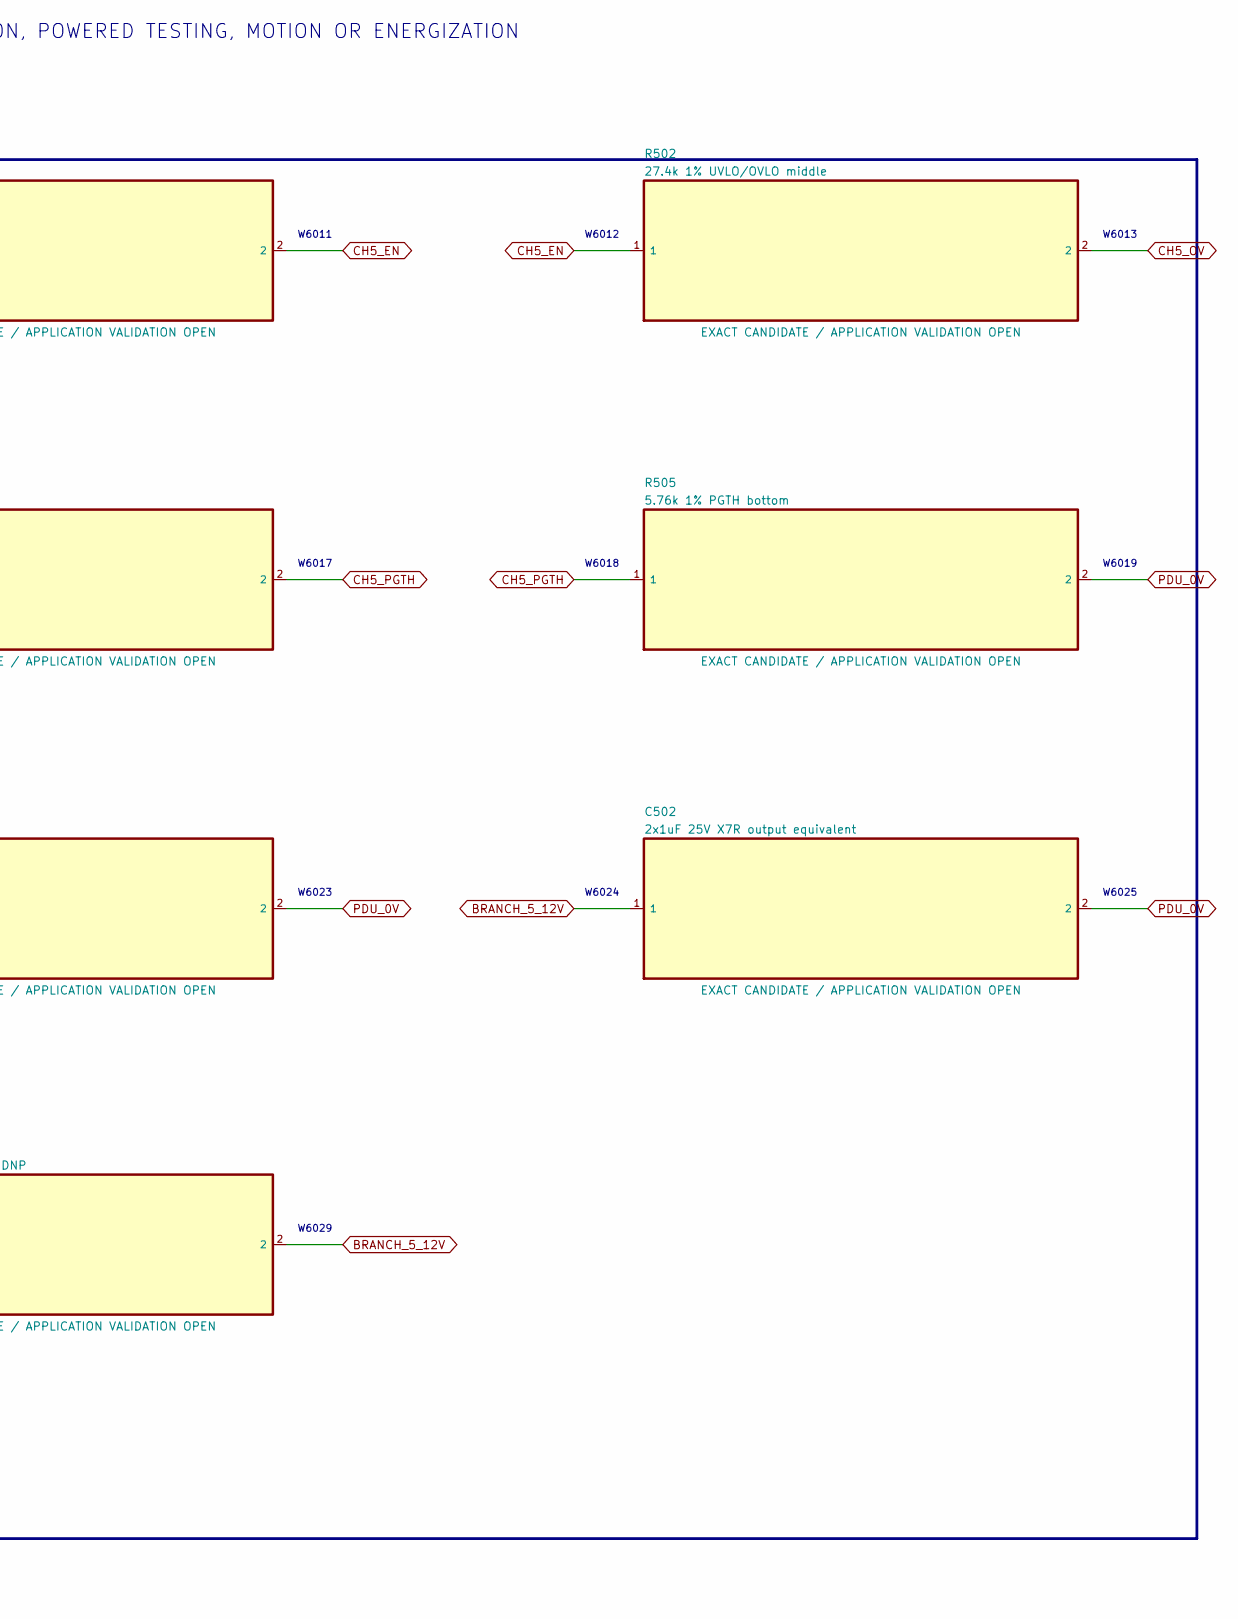
[picture p319: schematic 06_channel_5.kicad_sch, PB HR-V0 P0.1 - 06, part in row 1, column 2]

Parts:
C501: 1uF 25V X7R input; C_0603_1608Metric
C502: 2x1uF 25V X7R output equivalent; C_0603_1608Metric
C503: 3.3nF dVdt; C_0603_1608Metric
D501: LOCAL BRANCH CLAMP - DNP; D_SMA
R501: 470k 1% UVLO top; R_0603_1608Metric
R502: 27.4k 1% UVLO/OVLO middle; R_0603_1608Metric
R503: 40.2k 1% OVLO bottom; R_0603_1608Metric
R504: 47k 1% PGTH top; R_0603_1608Metric
R505: 5.76k 1% PGTH bottom; R_0603_1608Metric
R506: ASSEMBLY VARIANT RILM; R_0603_1608Metric
U205: TPS259474LRPWR circuit-breaker latch-off eFuse; TI_RPW0010A_HotRodQFN_2x2mm_P0.45mm_TI4225183A_P02

Connections:
BRANCH_5_12V: C502.1, D501.2, R504.1, U205.6; also elsewhere on the board
CH5_DVDT: C503.1, U205.7
CH5_EN: R501.2, R502.1, U205.1; also elsewhere on the board
CH5_ILM: R506.1, U205.9
CH5_OV: R502.2, R503.1, U205.2
CH5_PG: U205.3; also elsewhere on the board
CH5_PGTH: R504.2, R505.1, U205.4
PDU_0V: C501.2, C502.2, C503.2, D501.1, R503.2, R505.2, R506.2, U205.8; also elsewhere on the board
PDU_12V_IN: C501.1, R501.1, U205.5; also elsewhere on the board

Notes on the sheet:
PRELIMINARY - NOT APPROVED FOR PROCUREMENT, FABRICATION, ASSEMBLY, CONNECTION, POWERED TESTING, MOTION OR ENERGIZATION
06 Branch channel 5
TPS259474L latch-off circuit-breaker commissioning channel
W6001
W6002
W6003
W6004
W6005
W6006
W6007
W6008
W6009
W6010
W6011
W6012
W6013
W6014
W6015
W6016
W6017
W6018
W6019
W6020
W6021
W6022
W6023
W6024
W6025
W6026
W6027
W6028
W6029
NOTE 1: ITIMER is deliberately open for fastest circuit-breaker response.
NOTE 2: RILM is an assembly variant bound to an axis; never substitute without regenerating
the allocation.
NOTE 3: Reverse blocking makes this a commissioning circuit only until regeneration/clamp
evidence closes.
NOTE 4: PRELIMINARY - NOT APPROVED FOR PROCUREMENT, FABRICATION, ASSEMBLY, CONNECTION,
POWERED TESTING, MOTION OR ENERGIZATION

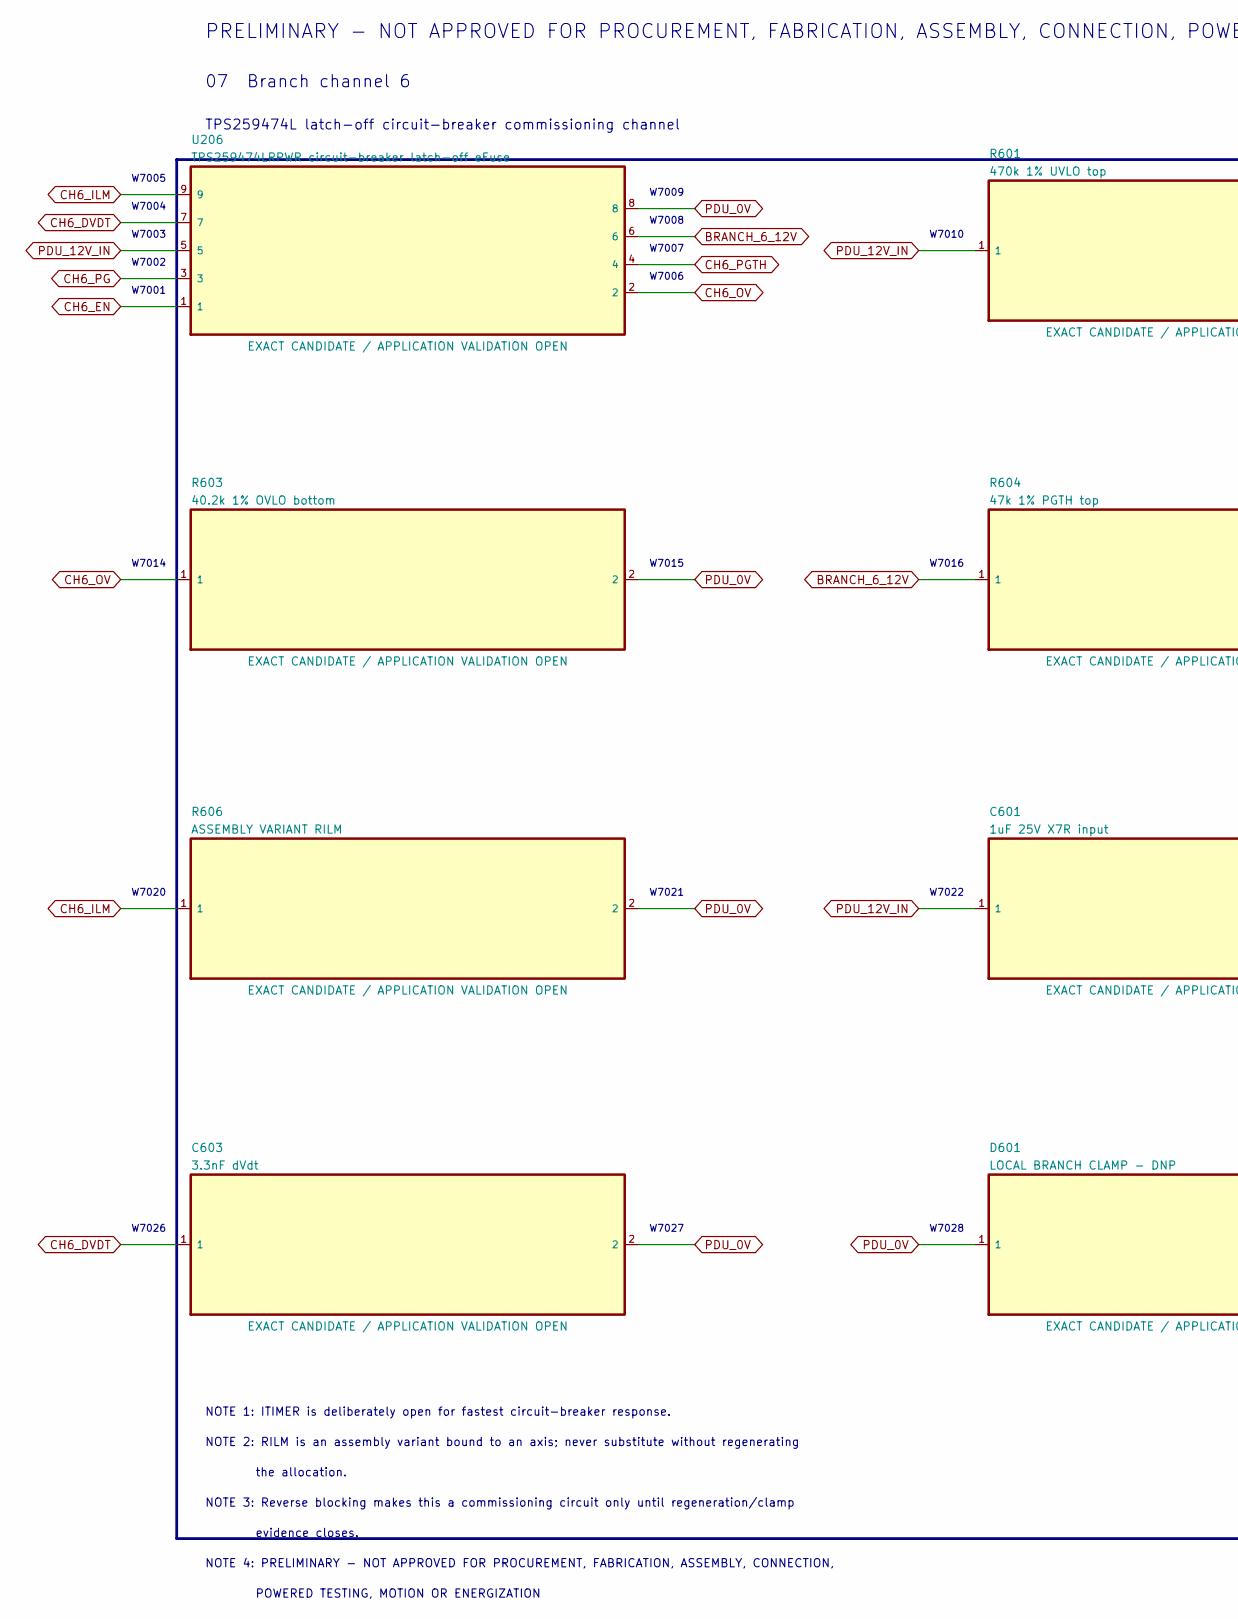
[picture p320: schematic 07_channel_6.kicad_sch, PB HR-V0 P0.1 - 07, part in row 1, column 1]

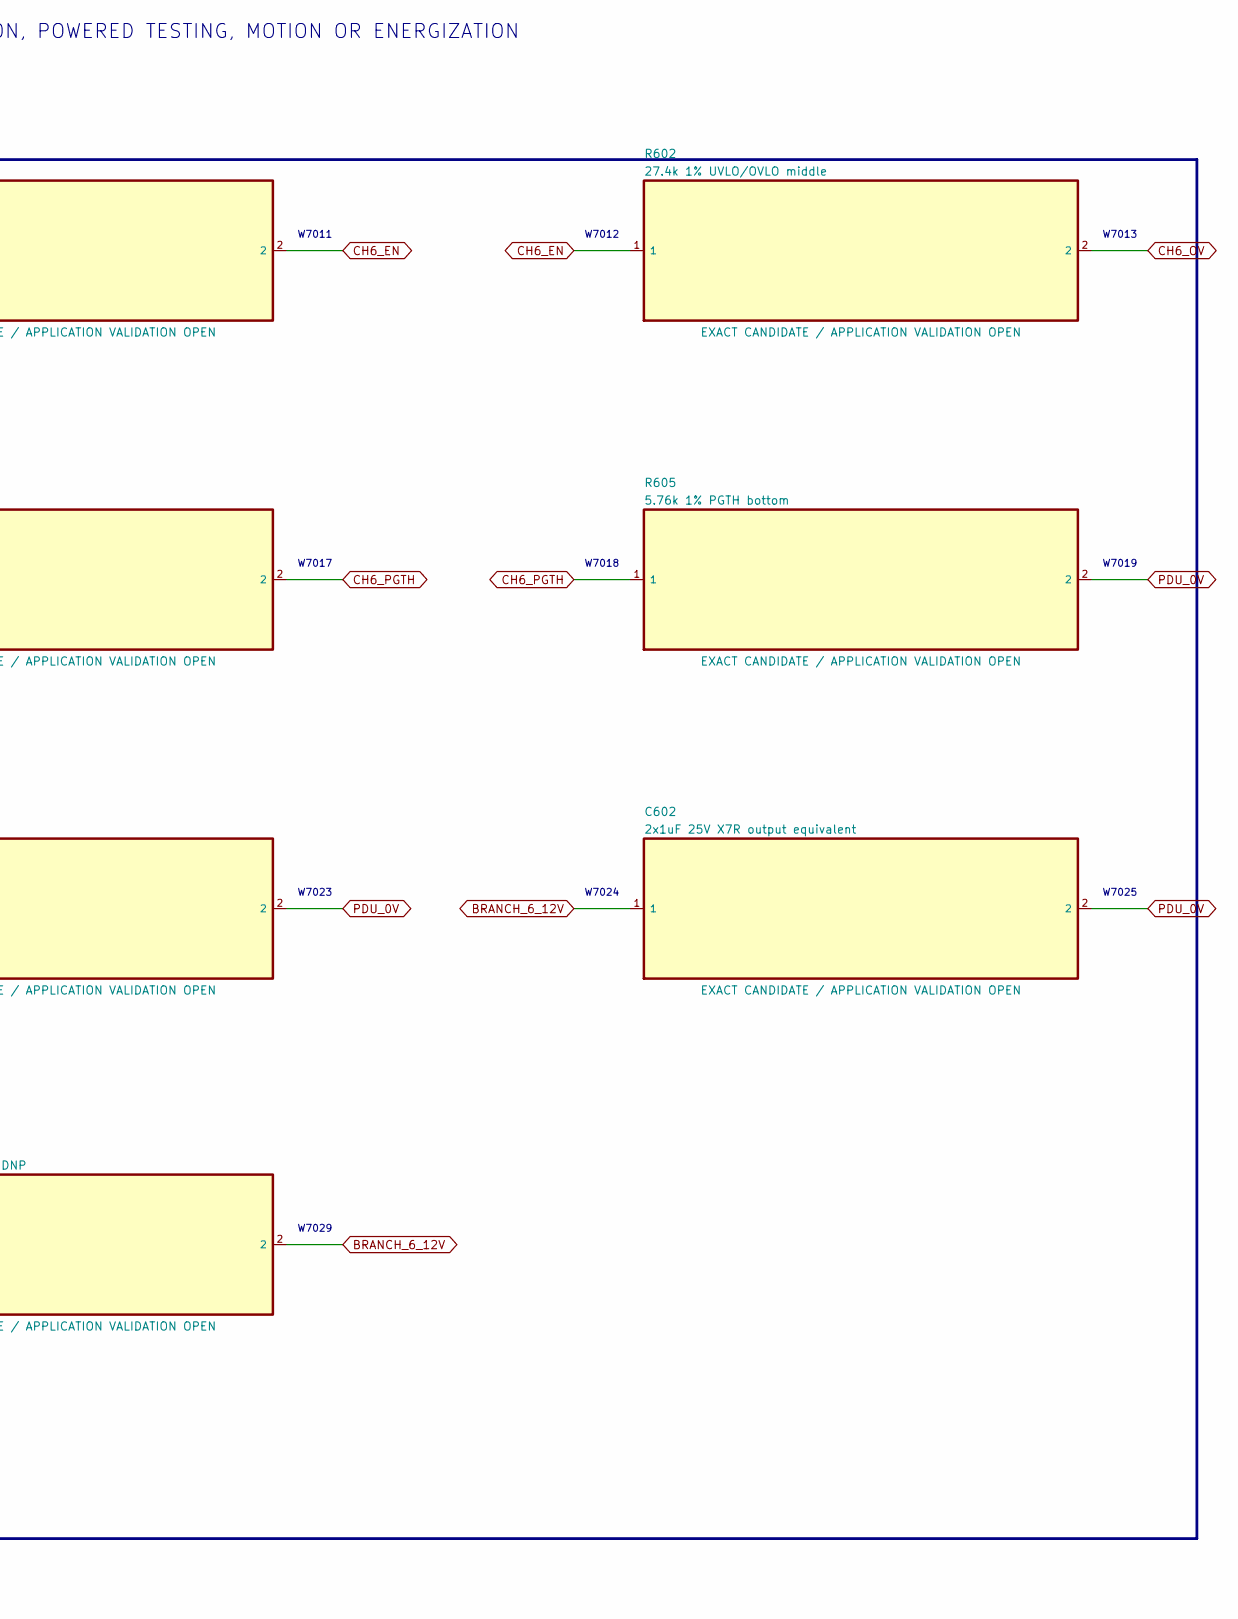
[picture p321: schematic 07_channel_6.kicad_sch, PB HR-V0 P0.1 - 07, part in row 1, column 2]

Parts:
C601: 1uF 25V X7R input; C_0603_1608Metric
C602: 2x1uF 25V X7R output equivalent; C_0603_1608Metric
C603: 3.3nF dVdt; C_0603_1608Metric
D601: LOCAL BRANCH CLAMP - DNP; D_SMA
R601: 470k 1% UVLO top; R_0603_1608Metric
R602: 27.4k 1% UVLO/OVLO middle; R_0603_1608Metric
R603: 40.2k 1% OVLO bottom; R_0603_1608Metric
R604: 47k 1% PGTH top; R_0603_1608Metric
R605: 5.76k 1% PGTH bottom; R_0603_1608Metric
R606: ASSEMBLY VARIANT RILM; R_0603_1608Metric
U206: TPS259474LRPWR circuit-breaker latch-off eFuse; TI_RPW0010A_HotRodQFN_2x2mm_P0.45mm_TI4225183A_P02

Connections:
BRANCH_6_12V: C602.1, D601.2, R604.1, U206.6; also elsewhere on the board
CH6_DVDT: C603.1, U206.7
CH6_EN: R601.2, R602.1, U206.1; also elsewhere on the board
CH6_ILM: R606.1, U206.9
CH6_OV: R602.2, R603.1, U206.2
CH6_PG: U206.3; also elsewhere on the board
CH6_PGTH: R604.2, R605.1, U206.4
PDU_0V: C601.2, C602.2, C603.2, D601.1, R603.2, R605.2, R606.2, U206.8; also elsewhere on the board
PDU_12V_IN: C601.1, R601.1, U206.5; also elsewhere on the board

Notes on the sheet:
PRELIMINARY - NOT APPROVED FOR PROCUREMENT, FABRICATION, ASSEMBLY, CONNECTION, POWERED TESTING, MOTION OR ENERGIZATION
07 Branch channel 6
TPS259474L latch-off circuit-breaker commissioning channel
W7001
W7002
W7003
W7004
W7005
W7006
W7007
W7008
W7009
W7010
W7011
W7012
W7013
W7014
W7015
W7016
W7017
W7018
W7019
W7020
W7021
W7022
W7023
W7024
W7025
W7026
W7027
W7028
W7029
NOTE 1: ITIMER is deliberately open for fastest circuit-breaker response.
NOTE 2: RILM is an assembly variant bound to an axis; never substitute without regenerating
the allocation.
NOTE 3: Reverse blocking makes this a commissioning circuit only until regeneration/clamp
evidence closes.
NOTE 4: PRELIMINARY - NOT APPROVED FOR PROCUREMENT, FABRICATION, ASSEMBLY, CONNECTION,
POWERED TESTING, MOTION OR ENERGIZATION

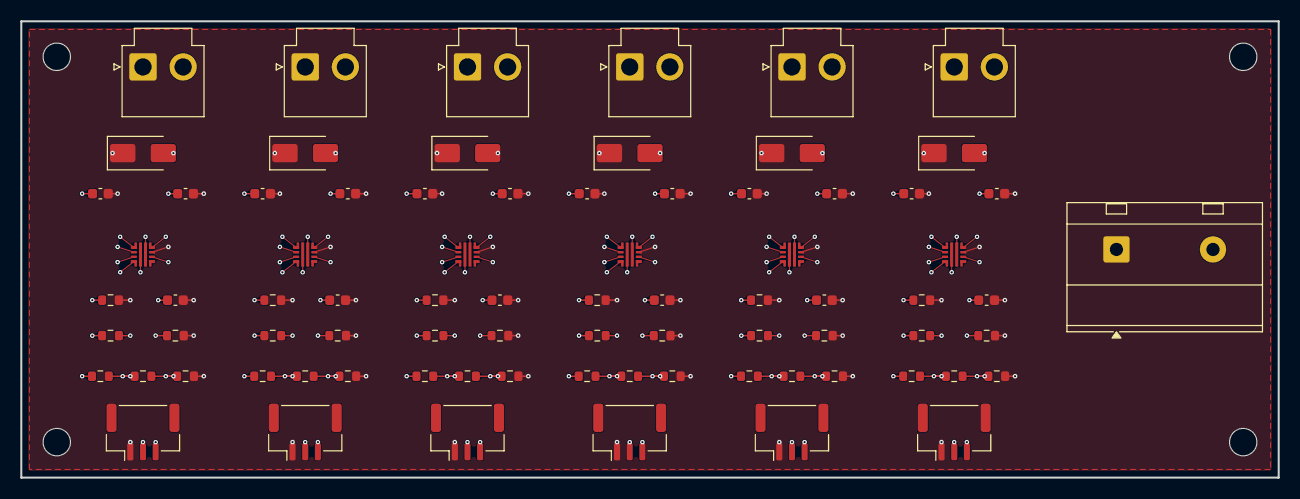
[picture p322: board hr30-actuator-branch-pdu-p0.1.kicad_pcb from above]

Board: 10 copper layers, 124.0 x 45.0 mm, 83 parts (0 on the bottom side), 44 nets.

Other parts of the board:
MH1, MH2, MH3, MH4: M2.5 BOARD-ONLY; MountingHole_2.7mm_M2.5
