amyleesterling/humanoid-robot/electrical/kicad/hr-v0-pi-observation-carrier-p0.1/hr-v0-pi-observation-carrier-p0.1.kicad_pcb

## KiCad design electrical/kicad/hr-v0-pi-observation-carrier-p0.1/hr-v0-pi-observation-carrier-p0.1.kicad_pcb (2026-08-15)

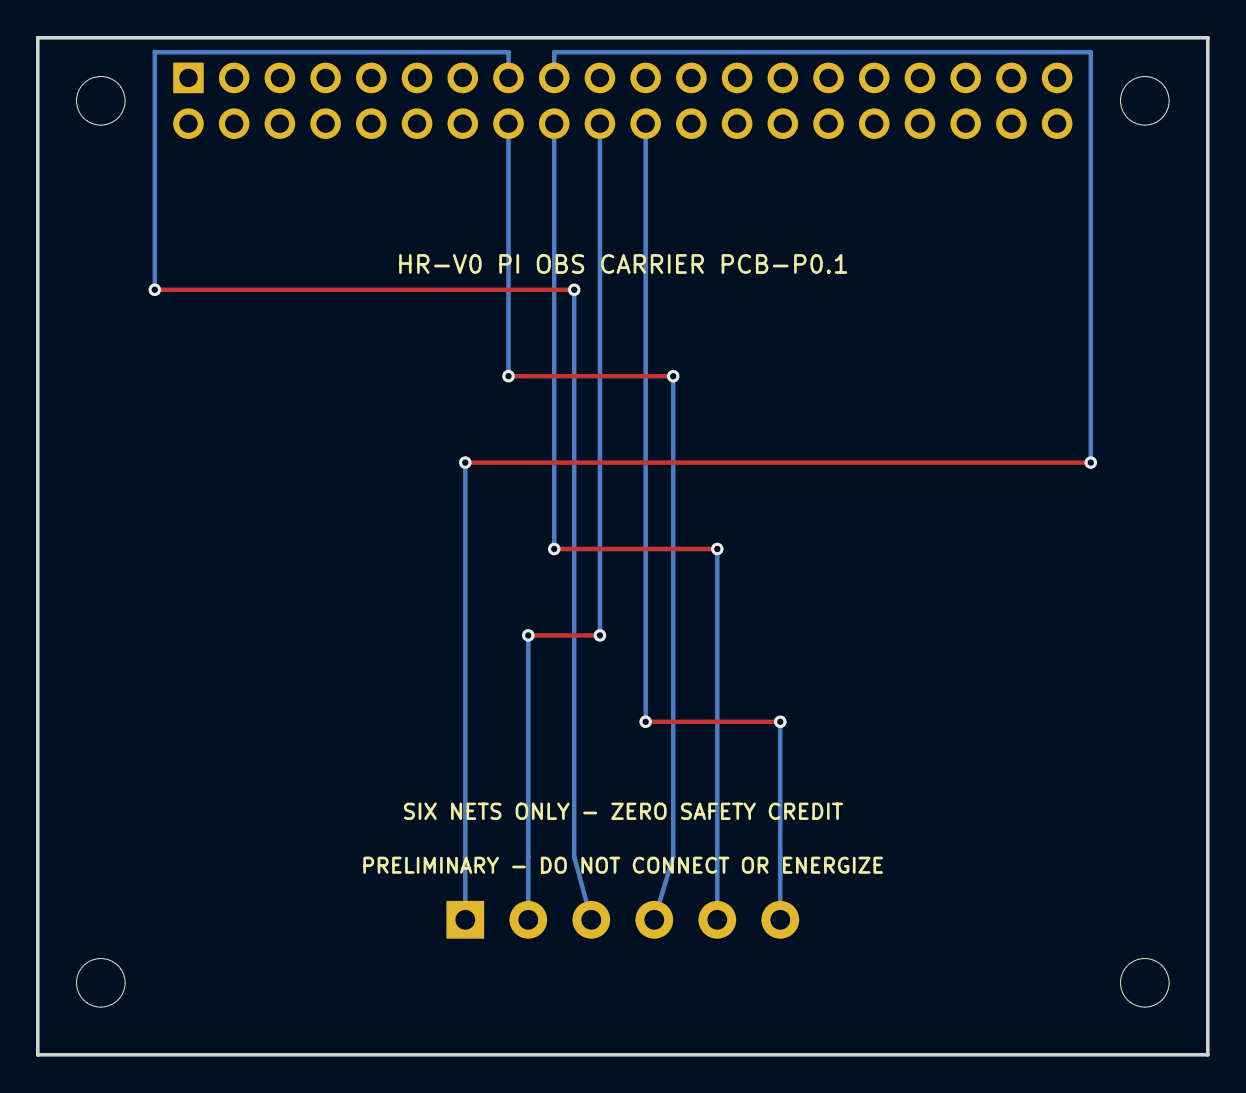
[picture p323: board hr-v0-pi-observation-carrier-p0.1.kicad_pcb from above]

Board: 2 copper layers, 65.0 x 56.5 mm, 6 parts (0 on the bottom side), 6 nets.

Parts:
JOBS1: Phoenix_MKDS_1_6_3P5_1751280
JPI1: Samtec_ESQ_120_33_G_D
MH1, MH2, MH3, MH4: BOARD-ONLY REFERENCE HOLE; RECEIVED FIT/HARDWARE 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; MountingHole_2.7mm_M2.5

Connections:
COMPUTE_0V: JOBS1.2, JPI1.20
OBS_K1_PI: JOBS1.5, JPI1.18
OBS_K2_PI: JOBS1.6, JPI1.22
OBS_SR1_PI: JOBS1.3, JPI1.15
OBS_SRA1_PI: JOBS1.4, JPI1.16
PI_3V3_CANDIDATE: JOBS1.1, JPI1.17
