amyleesterling/humanoid-robot/electrical/kicad/hr-v0-runtime-observation-carrier-p0.3/hr-v0-runtime-observation-carrier-p0.3.kicad_pcb

## KiCad design electrical/kicad/hr-v0-runtime-observation-carrier-p0.3/hr-v0-runtime-observation-carrier-p0.3.kicad_pcb (2026-08-15)

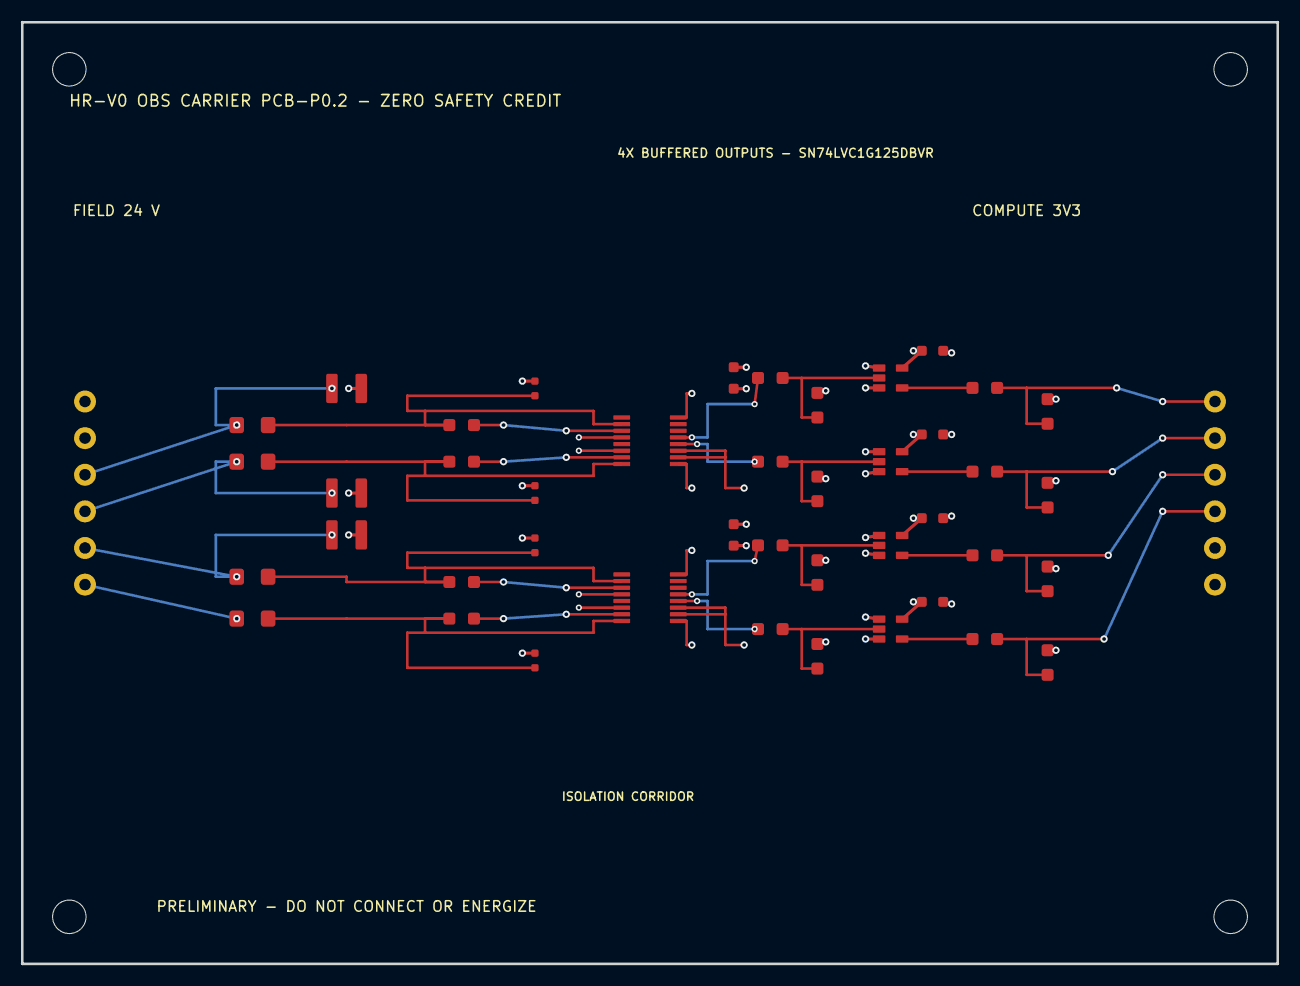
[picture p324: board hr-v0-runtime-observation-carrier-p0.3.kicad_pcb from above]

Board: 4 copper layers, 120.0 x 90.0 mm, 49 parts (0 on the bottom side), 31 nets.

Parts:
CDEC1, CDEC2: Murata_GRM21_Reflow_Nominal
CDEC3, CDEC4, CDEC5, CDEC6: 100 nF 50 V X7R; Murata GRM21BR71H104KA01L; Murata_GRM21_Reflow_Nominal
CFI1, CFI2, CFI3, CFI4: TDK_CGA3_Reflow_Nominal
JFIELD1: Phoenix_MKDS_1_6_3P5_1751280
JLOGIC1: Phoenix_MKDS_1_6_3P5_1751280
MH1, MH2, MH3, MH4: BOARD-ONLY M3; HARDWARE/ENCLOSURE SELECTION REQUI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; MountingHole_3.2mm_M3
RGP1, RGP2, RGP3, RGP4: 36.5 kohm 1% 0.125 W 0805; Panasonic ERJ6ENF3652V; Panasonic_ERJ6_Reflow_Nominal
RPD1, RPD2, RPD3, RPD4: 47.0 kohm 1% 0.125 W 0805; Panasonic ERJ6ENF4702V; Panasonic_ERJ6_Reflow_Nominal
RPO1, RPO2, RPO3, RPO4: 330 kohm 1% 0.125 W 0805; Panasonic ERJ6ENF3303V; Panasonic_ERJ6_Reflow_Nominal
RSN1, RSN2, RSN3, RSN4: Panasonic_ERJ6_Reflow_Nominal
RSO1, RSO2, RSO3, RSO4: 1.50 kohm 1% 0.125 W 0805; Panasonic ERJ6ENF1501V; Panasonic_ERJ6_Reflow_Nominal
RTH1, RTH2, RTH3, RTH4: Vishay_MMA0204_IPC_Reflow
RW2, RW3, RW4: Vishay_CRCW1210_Reflow
UBUF1, UBUF2, UBUF3, UBUF4: Texas Instruments SN74LVC1G125DBVR; TI_DBV0005A_SOT23_5
UOBS1, UOBS2: TI_DBQ0016A_Example_Land

Connections:
COMPUTE_0V: CDEC1.2, CDEC2.2, CDEC3.2, CDEC4.2, CDEC5.2, CDEC6.2, JLOGIC1.2, RPD1.2, RPD2.2, RPD3.2, RPD4.2, RPO1.2, RPO2.2, RPO3.2, RPO4.2, UBUF1.1, UBUF1.3, UBUF2.1, UBUF2.3, UBUF3.1, UBUF3.3, UBUF4.1, UBUF4.3, UOBS1.1, UOBS1.8, UOBS2.1, UOBS2.8
K1_IN: RSN3.2, UOBS2.15
K1_SENSE: CFI3.1, RSN3.1, RTH3.2, UOBS2.16
K1_STATUS: JFIELD1.3, RTH3.1, RW3.1
K2_IN: RSN4.2, UOBS2.11
K2_SENSE: CFI4.1, RSN4.1, RTH4.2, UOBS2.10
K2_STATUS: JFIELD1.4, RTH4.1, RW4.1
OBS_K1_BUF_IN: RPD3.1, RSO3.2, UBUF3.2
OBS_K1_BUF_OUT: RGP3.1, UBUF3.4
OBS_K1_PI: JLOGIC1.5, RGP3.2, RPO3.1
OBS_K1_RAW: RSO3.1, UOBS2.4
OBS_K2_BUF_IN: RPD4.1, RSO4.2, UBUF4.2
OBS_K2_BUF_OUT: RGP4.1, UBUF4.4
OBS_K2_PI: JLOGIC1.6, RGP4.2, RPO4.1
OBS_K2_RAW: RSO4.1, UOBS2.5
OBS_SR1_BUF_IN: RPD1.1, RSO1.2, UBUF1.2
OBS_SR1_BUF_OUT: RGP1.1, UBUF1.4
OBS_SR1_PI: JLOGIC1.3, RGP1.2, RPO1.1
OBS_SR1_RAW: RSO1.1, UOBS1.4
OBS_SRA1_BUF_IN: RPD2.1, RSO2.2, UBUF2.2
OBS_SRA1_BUF_OUT: RGP2.1, UBUF2.4
OBS_SRA1_PI: JLOGIC1.4, RGP2.2, RPO2.1
OBS_SRA1_RAW: RSO2.1, UOBS1.5
PI_3V3_CANDIDATE: CDEC1.1, CDEC2.1, CDEC3.1, CDEC4.1, CDEC5.1, CDEC6.1, JLOGIC1.1, UBUF1.5, UBUF2.5, UBUF3.5, UBUF4.5, UOBS1.2, UOBS1.3, UOBS2.2, UOBS2.3
SAFETY_0V: CFI1.2, CFI2.2, CFI3.2, CFI4.2, JFIELD1.5, RW2.2, RW3.2, RW4.2, UOBS1.12, UOBS1.14, UOBS2.12, UOBS2.14
SR1_IN: RSN1.2, UOBS1.15
SR1_SENSE: CFI1.1, RSN1.1, RTH1.2, UOBS1.16
SR1_STATUS: JFIELD1.1, RTH1.1
SRA1_IN: RSN2.2, UOBS1.11
SRA1_SENSE: CFI2.1, RSN2.1, RTH2.2, UOBS1.10
SRA1_STATUS: JFIELD1.2, RTH2.1, RW2.1
