amyleesterling/humanoid-robot/electrical/kicad/project-button-v3/project-button-v3.kicad_pcb

## KiCad design electrical/kicad/project-button-v3/project-button-v3.kicad_pcb (2026-08-10)

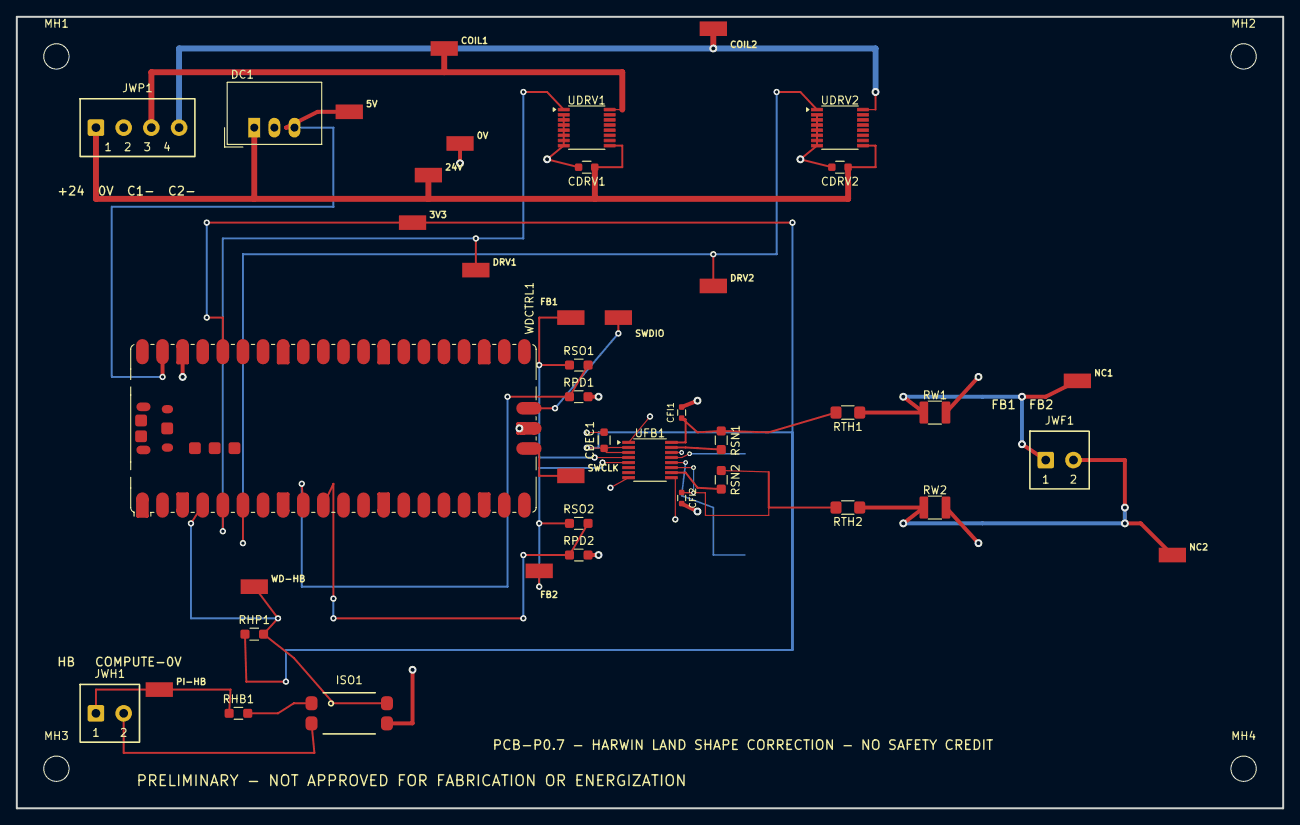
[picture p325: board project-button-v3.kicad_pcb from above]

Board: 2 copper layers, 160.0 x 100.0 mm, 46 parts (0 on the bottom side), 24 nets.

Parts:
CDEC1: Murata GRM21BR71H104KA01L, 100 nF 50 V X7R 0805; Murata_GRM21_Reflow_Nominal
CDRV1, CDRV2: Murata GRM21BR71H104KA01L, 100 nF 50 V X7R 0805; Murata_GRM21_Reflow_Nominal
CFI1, CFI2: TDK CGA3E2X7R1H103K080AA, 10 nF 50 V X7R 0603; TDK_CGA3_Reflow_Nominal
DC1: TRACO POWER TSR 1-2450, 24 V to 5 V 1 A non-isola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; Converter_DCDC_TRACO_TSR-1_THT
ISO1: Vishay VO618A-4X017T heartbeat optocoupler; VO618A_Option7_SMD
JWF1: Phoenix Contact MKDS 1/2-3,5, item 1751248; MKDS_1_2_3P5
JWH1: Phoenix Contact MKDS 1/2-3,5, item 1751248; MKDS_1_2_3P5
JWP1: Phoenix Contact MKDS 1/4-3,5, item 1751264; MKDS_1_4_3P5
MH1, MH2, MH3, MH4: M3 BOARD-ONLY - MOUNTING/ENCLOSURE SELECTION OPEN; MountingHole_3.2mm_M3
RHB1: Panasonic ERJ6ENF9100V, 910 Ohm 1% 0805 0.125 W; Panasonic_ERJ6_Reflow_Nominal
RHP1: Panasonic ERJ6ENF1002V, 10.0 kOhm 1% 0805 0.125 W; Panasonic_ERJ6_Reflow_Nominal
RPD1, RPD2: Panasonic ERJ6ENF1002V, 10.0 kOhm 1% 0805; Panasonic_ERJ6_Reflow_Nominal
RSN1, RSN2: Panasonic ERJ6ENF5620V, 562 Ohm 1% 0805; Panasonic_ERJ6_Reflow_Nominal
RSO1, RSO2: Panasonic ERJ6ENF1001V, 1.00 kOhm 1% 0805; Panasonic_ERJ6_Reflow_Nominal
RTH1, RTH2: Vishay MMA02040C1001FB300, 1.00 kOhm 1% 0.4 W MELF; Vishay_MMA0204_IPC_Reflow
RW1, RW2: Vishay CRCW12102K70FKEA, 2.70 kOhm 1% 0.5 W 1210; Vishay_CRCW1210_Reflow
TP1, TP2, TP3, TP4, TP5, TP6, TP7, TP8, TP9, TP10, TP11, TP12, TP13, TP14, TP15, TP16: Harwin S1751-46R SMT test point; Harwin_S1751_46R
UDRV1: Texas Instruments TPL7407LPWR channel-1 relay dri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; TI_PW0016A_Example_Land
UDRV2: Texas Instruments TPL7407LPWR channel-2 relay dri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; TI_PW0016A_Example_Land
UFB1: Texas Instruments ISO1212DBQ dual 24 V input rece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; TI_DBQ0016A_Example_Land
WDCTRL1: Raspberry Pi Pico 1, order SC0915 / RP2040; RaspberryPi_Pico_SMD

Connections:
COMPUTE_0V: ISO1.2, JWH1.2
FB_IN1: RSN1.2, UFB1.15
FB_IN2: RSN2.2, UFB1.10
FB_SENSE1: CFI1.1, RSN1.1, RTH1.2, UFB1.16
FB_SENSE2: CFI2.1, RSN2.1, RTH2.2, UFB1.11
HB_LED_A: ISO1.1, RHB1.2
PI_HEARTBEAT: JWH1.1, RHB1.1, TP5.1
SAFETY_0V: CDEC1.2, CDRV1.2, CDRV2.2, CFI1.2, CFI2.2, DC1.2, ISO1.3, JWP1.2, RPD1.2, RPD2.2, RW1.2, RW2.2, TP2.1, UDRV1.2, UDRV1.3, UDRV1.4, UDRV1.5, UDRV1.6, UDRV1.7, UDRV1.8, UDRV2.2, UDRV2.3, UDRV2.4, UDRV2.5, UDRV2.6, UDRV2.7, UDRV2.8, UFB1.1, UFB1.8, UFB1.9, UFB1.14, WDCTRL1.38, WDCTRL1.D2
SAFETY_24V: CDRV1.1, CDRV2.1, DC1.1, JWP1.1, TP1.1, UDRV1.9, UDRV2.9
UFB_OUT1: RSO1.1, TP13.1, UFB1.4
UFB_OUT2: RSO2.1, TP14.1, UFB1.5
WD1_COIL_N: JWP1.3, TP9.1, UDRV1.16
WD1_DRIVE: TP7.1, UDRV1.1, WDCTRL1.5
WD1_NC_24V: JWF1.1, RTH1.1, RW1.1, TP11.1
WD1_NC_DIAG: RPD1.1, RSO1.2, WDCTRL1.9
WD2_COIL_N: JWP1.4, TP10.1, UDRV2.16
WD2_DRIVE: TP8.1, UDRV2.1, WDCTRL1.6
WD2_NC_24V: JWF1.2, RTH2.1, RW2.1, TP12.1
WD2_NC_DIAG: RPD2.1, RSO2.2, WDCTRL1.10
WD_3V3: CDEC1.1, RHP1.1, TP4.1, UFB1.2, UFB1.3, WDCTRL1.36
WD_5V: DC1.3, TP3.1, WDCTRL1.39
WD_HEARTBEAT: ISO1.4, RHP1.2, TP6.1, WDCTRL1.4
WD_SWCLK: TP16.1, WDCTRL1.D1
WD_SWDIO: TP15.1, WDCTRL1.D3
