amyleesterling/humanoid-robot/electrical/kicad/hr-v0-dxl-star/hr-v0-dxl-star.kicad_pcb

## KiCad design electrical/kicad/hr-v0-dxl-star/hr-v0-dxl-star.kicad_pcb (2026-08-10)

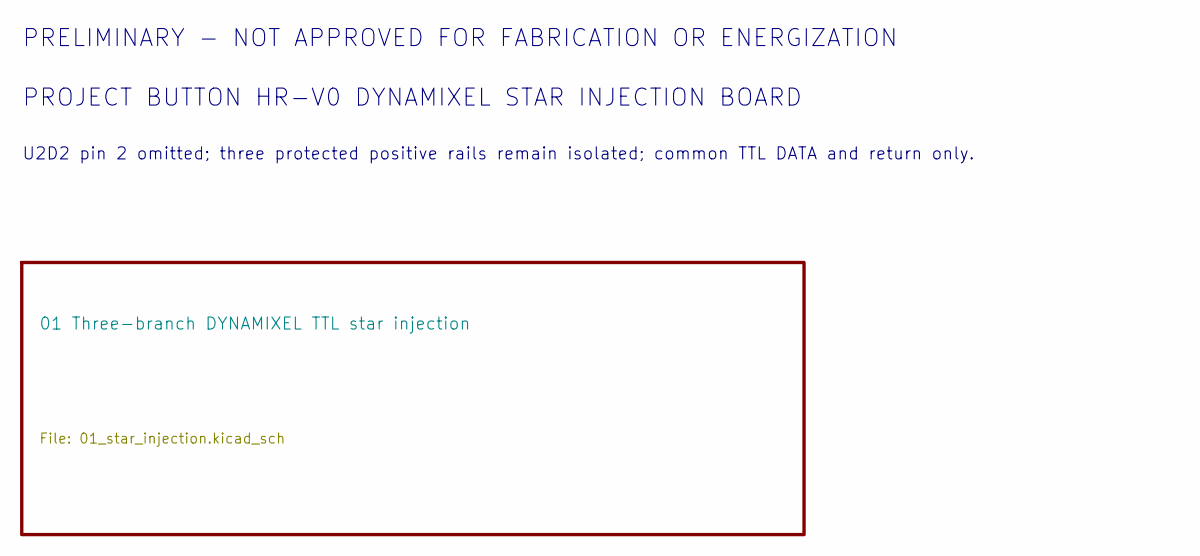
[picture p326: schematic hr-v0-dxl-star.kicad_sch, PROJECT BUTTON HR-V0 DYNAMIXEL STAR INJECTION BOARD index]

Notes on the sheet:
PRELIMINARY - NOT APPROVED FOR FABRICATION OR ENERGIZATION
PROJECT BUTTON HR-V0 DYNAMIXEL STAR INJECTION BOARD
U2D2 pin 2 omitted; three protected positive rails remain isolated; common TTL DATA and return only.

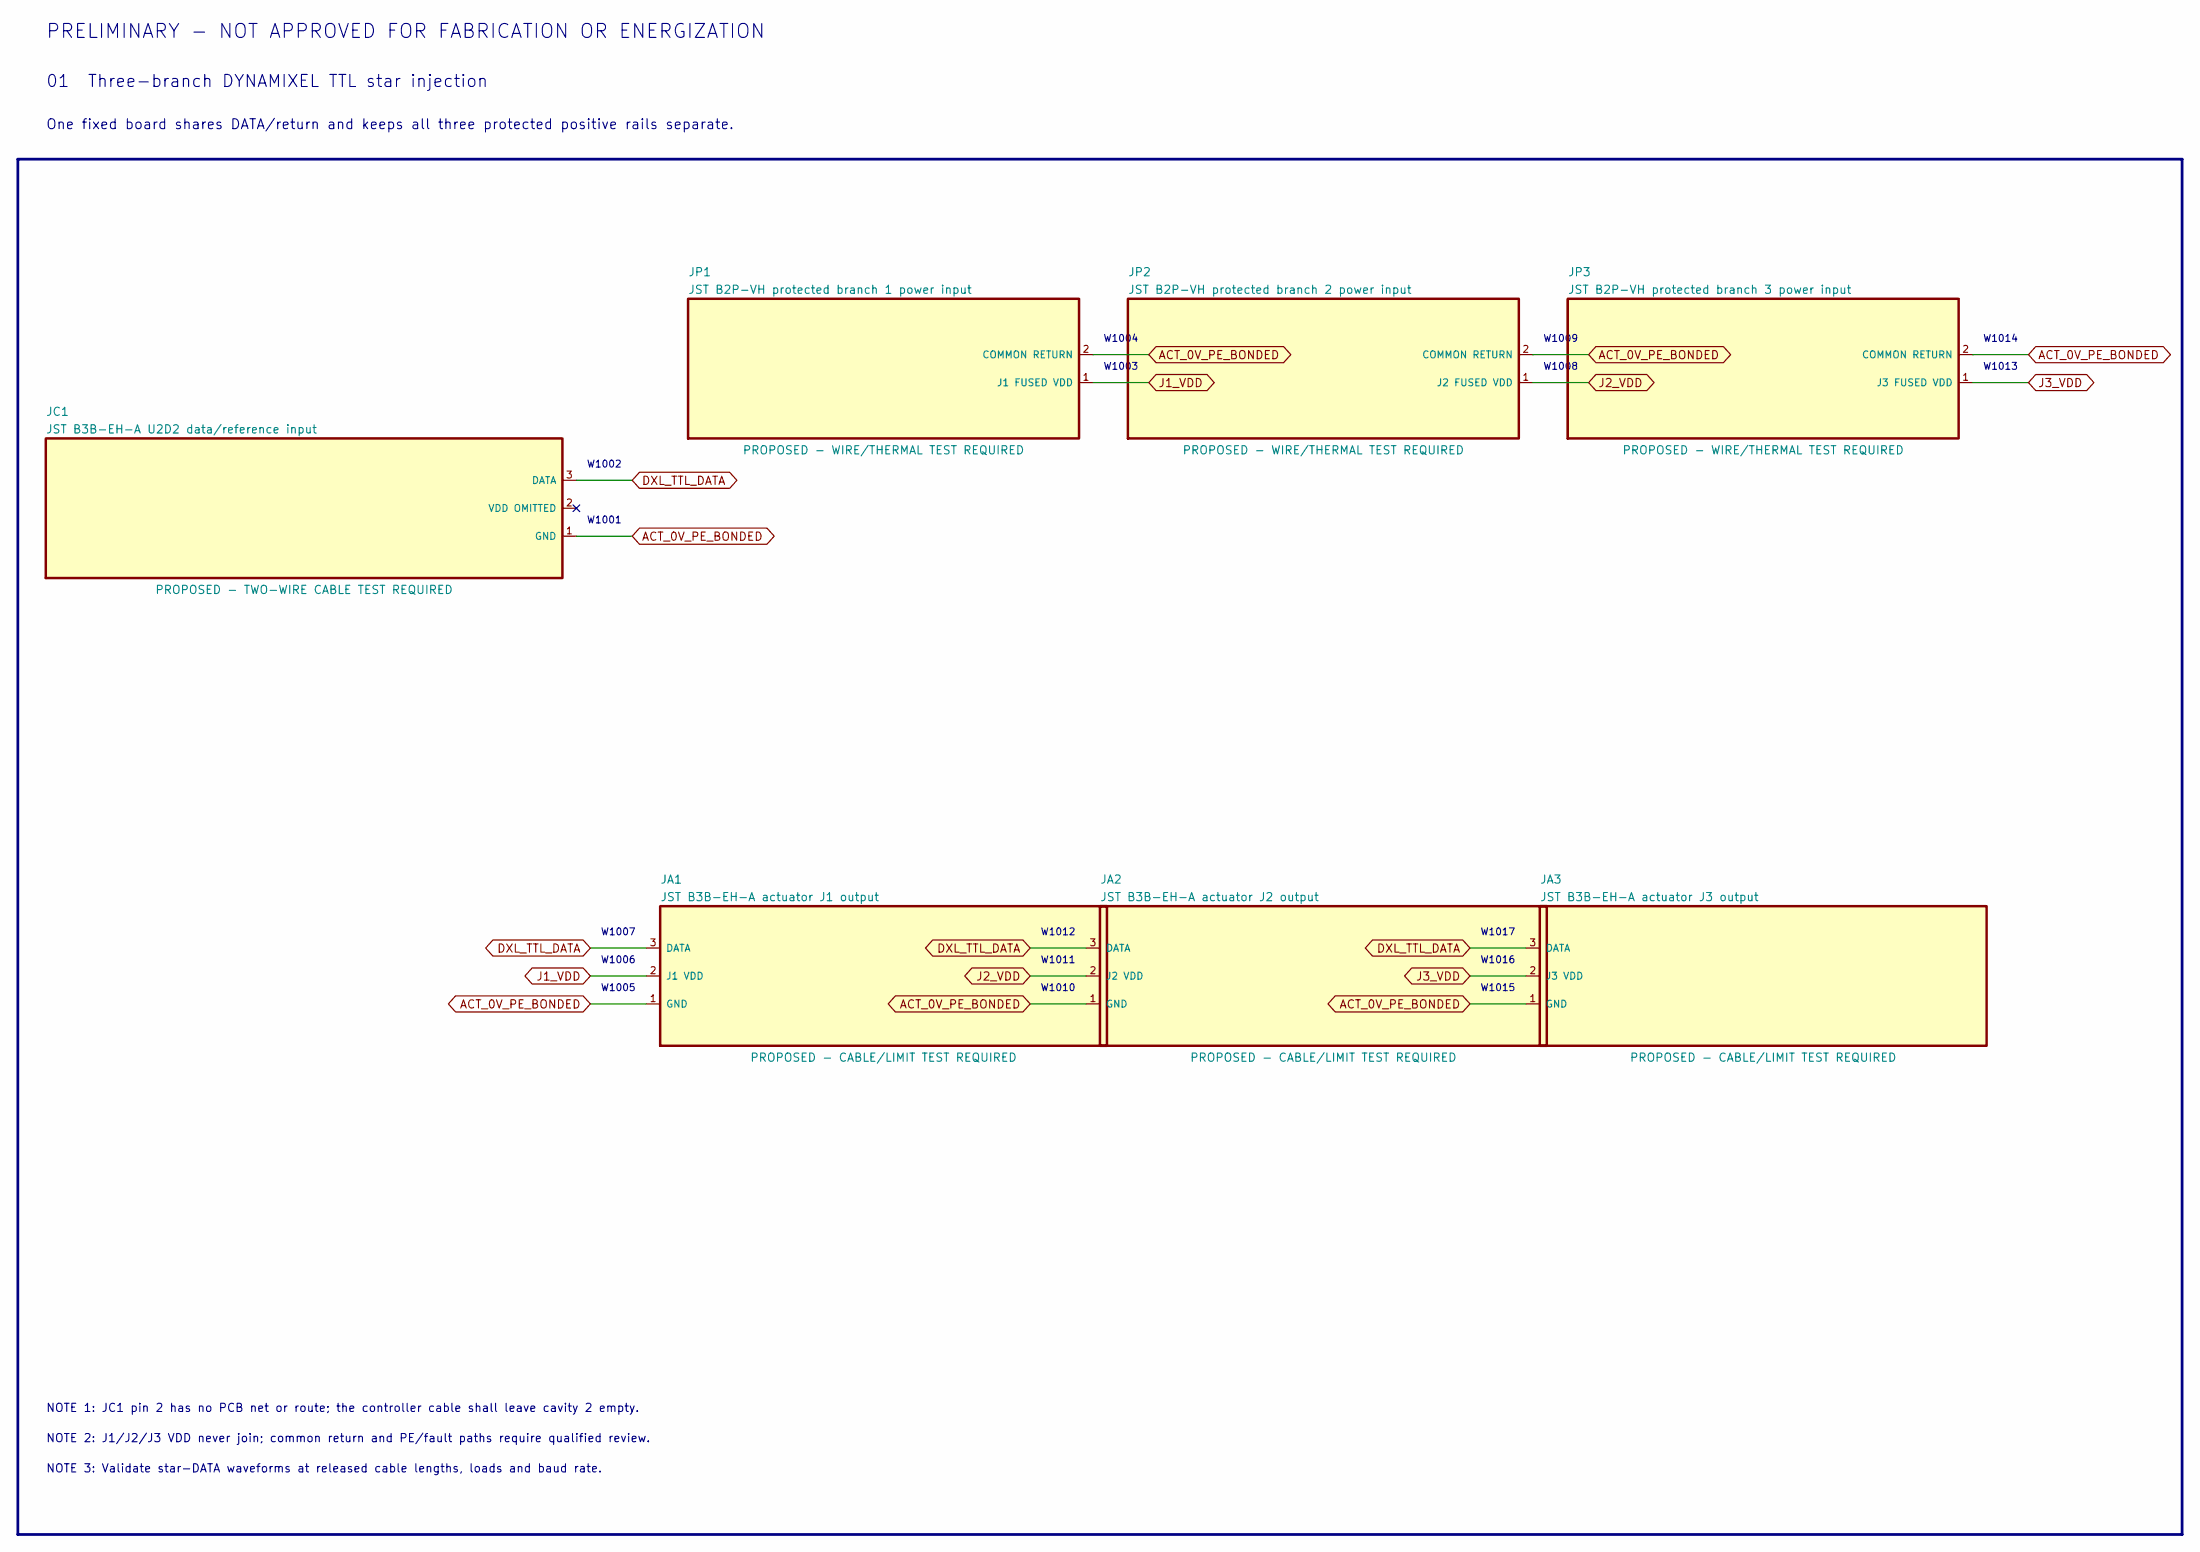
[picture p327: schematic 01_star_injection.kicad_sch, PB HR-V0 DXL-STAR-P0.1 - 01]

Parts:
JA1: JST B3B-EH-A actuator J1 output; JST_EH_B3B-EH-A_1x03_P2.50mm_Vertical
JA2: JST B3B-EH-A actuator J2 output; JST_EH_B3B-EH-A_1x03_P2.50mm_Vertical
JA3: JST B3B-EH-A actuator J3 output; JST_EH_B3B-EH-A_1x03_P2.50mm_Vertical
JC1: JST B3B-EH-A U2D2 data/reference input; JST_EH_B3B-EH-A_1x03_P2.50mm_Vertical
JP1: JST B2P-VH protected branch 1 power input; JST_VH_B2P-VH_1x02_P3.96mm_Vertical
JP2: JST B2P-VH protected branch 2 power input; JST_VH_B2P-VH_1x02_P3.96mm_Vertical
JP3: JST B2P-VH protected branch 3 power input; JST_VH_B2P-VH_1x02_P3.96mm_Vertical

Connections:
ACT_0V_PE_BONDED: JA1.1 (GND), JA2.1 (GND), JA3.1 (GND), JC1.1 (GND), JP1.2 (COMMON RETURN), JP2.2 (COMMON RETURN), JP3.2 (COMMON RETURN)
DXL_TTL_DATA: JA1.3 (DATA), JA2.3 (DATA), JA3.3 (DATA), JC1.3 (DATA)
J1_VDD: JA1.2 (J1 VDD), JP1.1 (J1 FUSED VDD)
J2_VDD: JA2.2 (J2 VDD), JP2.1 (J2 FUSED VDD)
J3_VDD: JA3.2 (J3 VDD), JP3.1 (J3 FUSED VDD)

Notes on the sheet:
PRELIMINARY - NOT APPROVED FOR FABRICATION OR ENERGIZATION
01 Three-branch DYNAMIXEL TTL star injection
One fixed board shares DATA/return and keeps all three protected positive rails separate.
W1001
W1002
W1003
W1004
W1005
W1006
W1007
W1008
W1009
W1010
W1011
W1012
W1013
W1014
W1015
W1016
W1017
NOTE 1: JC1 pin 2 has no PCB net or route; the controller cable shall leave cavity 2 empty.
NOTE 2: J1/J2/J3 VDD never join; common return and PE/fault paths require qualified review.
NOTE 3: Validate star-DATA waveforms at released cable lengths, loads and baud rate.

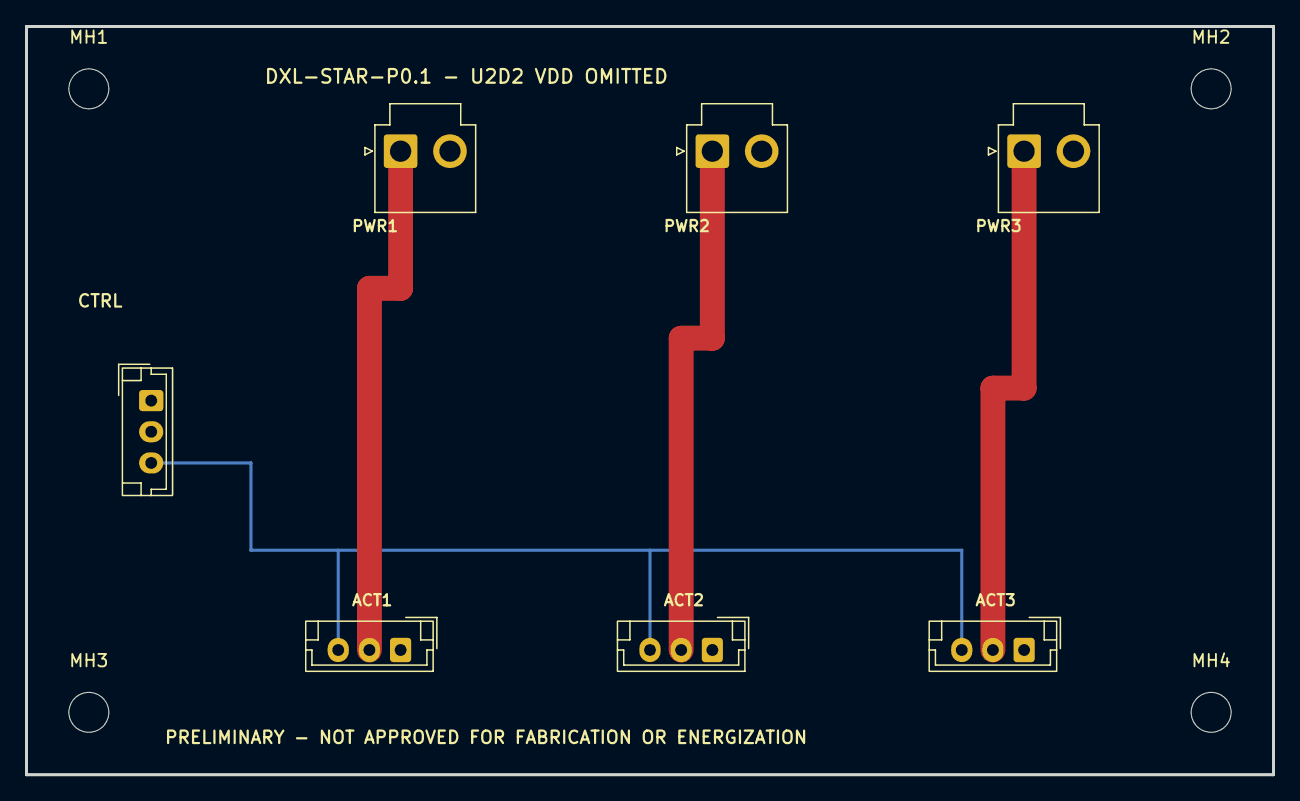
[picture p328: board hr-v0-dxl-star.kicad_pcb from above]

Board: 2 copper layers, 100.0 x 60.0 mm, 11 parts (0 on the bottom side), 5 nets.

Other parts of the board:
MH1, MH2, MH3, MH4: M3 BOARD-ONLY - ENCLOSURE/MOUNTING SELECTION OPEN; MountingHole_3.2mm_M3
