amyleesterling/humanoid-robot/electrical/kicad/hr-v0-dxl-protection-carrier-p0.3/hr-v0-dxl-protection-carrier-p0.3.kicad_pcb

## KiCad design electrical/kicad/hr-v0-dxl-protection-carrier-p0.3/hr-v0-dxl-protection-carrier-p0.3.kicad_pcb (2026-08-10)

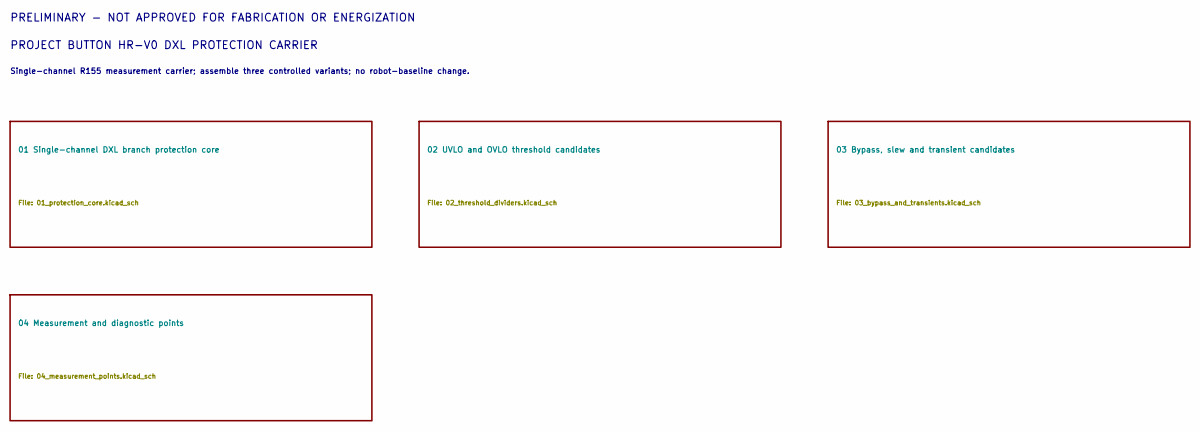
[picture p329: schematic hr-v0-dxl-protection-carrier-p0.3.kicad_sch, PROJECT BUTTON HR-V0 DXL PROTECTION CARRIER index]

Notes on the sheet:
PRELIMINARY - NOT APPROVED FOR FABRICATION OR ENERGIZATION
PROJECT BUTTON HR-V0 DXL PROTECTION CARRIER
Single-channel R155 measurement carrier; assemble three controlled variants; no robot-baseline change.

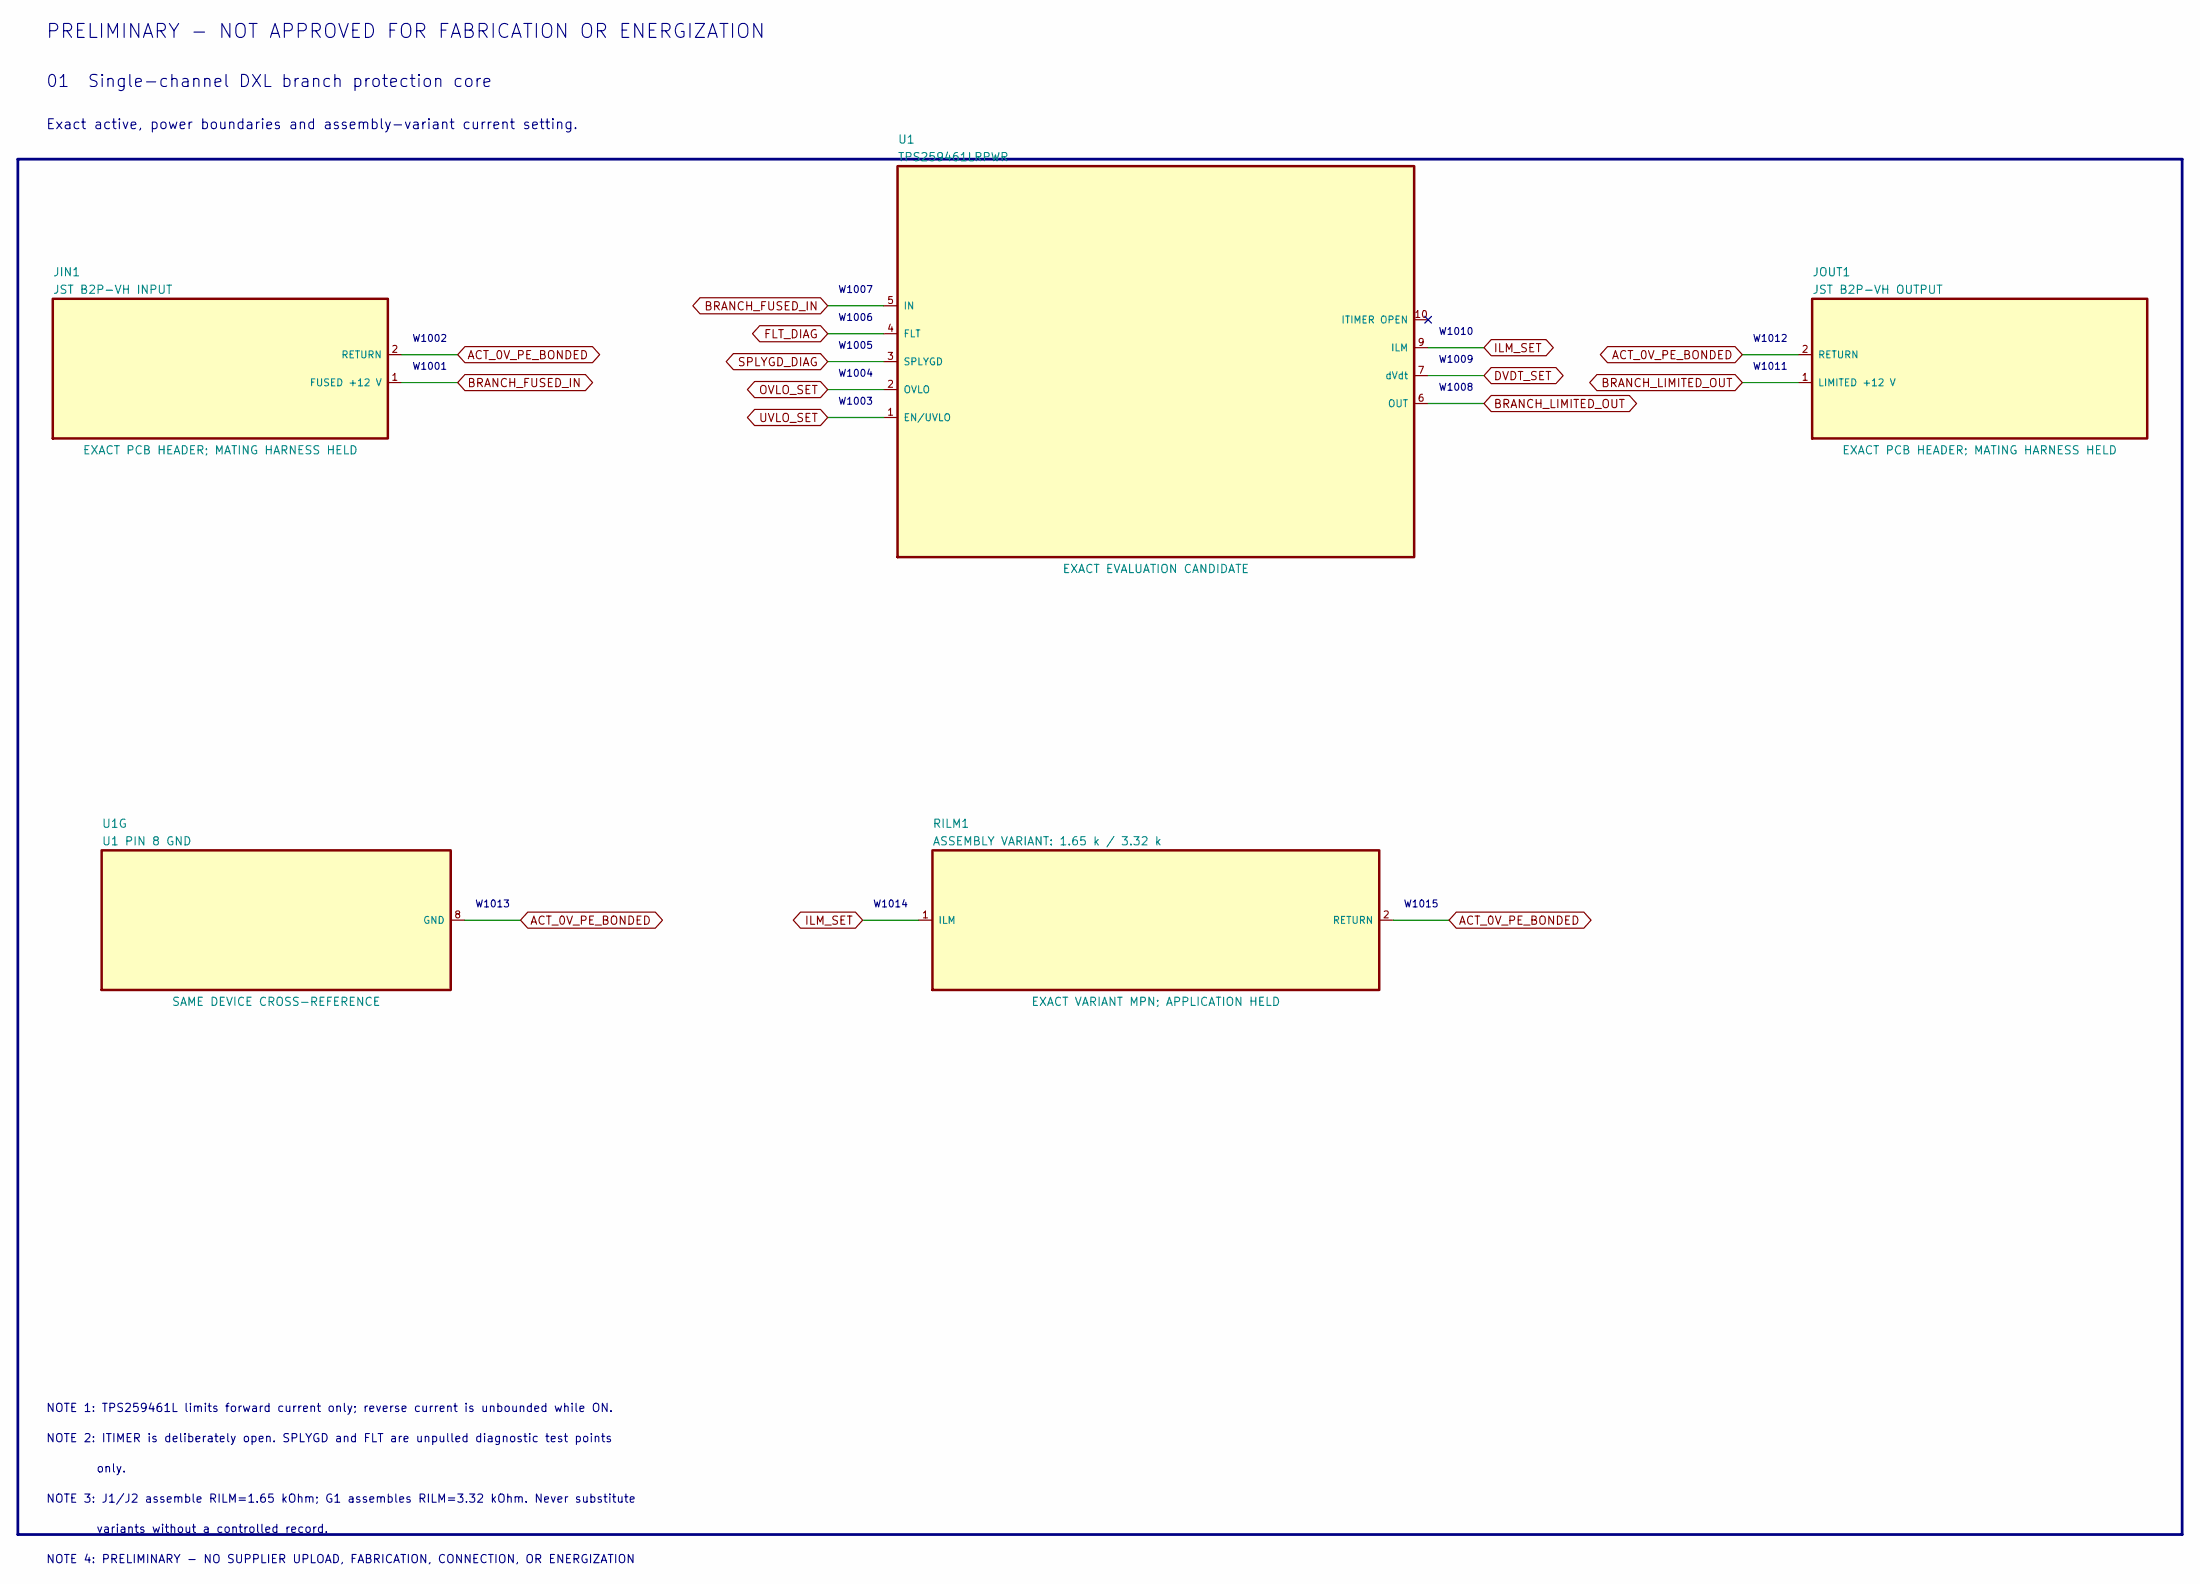
[picture p330: schematic 01_protection_core.kicad_sch, PB HR-V0 DXL-PROT-CARRIER-P0.3 - 01]

Parts:
JIN1: JST B2P-VH INPUT; JST_VH_B2P-VH_1x02_P3.96mm_Vertical
JOUT1: JST B2P-VH OUTPUT; JST_VH_B2P-VH_1x02_P3.96mm_Vertical
RILM1: ASSEMBLY VARIANT: 1.65 k / 3.32 k; R_0603_1608Metric
U1: TPS259461LRPWR; TI_RPW0010A_HotRodQFN_2x2mm_P0.45mm_TI4225183A_P02
U1G: U1 PIN 8 GND; TI_RPW0010A_HotRodQFN_2x2mm_P0.45mm_TI4225183A_P02

Connections:
ACT_0V_PE_BONDED: JIN1.2 (RETURN), JOUT1.2 (RETURN), RILM1.2 (RETURN), U1.8, U1G.8; also elsewhere on the board
BRANCH_FUSED_IN: JIN1.1 (FUSED +12 V), U1.5 (IN); also elsewhere on the board
BRANCH_LIMITED_OUT: JOUT1.1 (LIMITED +12 V), U1.6 (OUT); also elsewhere on the board
DVDT_SET: U1.7 (dVdt); also elsewhere on the board
FLT_DIAG: U1.4 (FLT); also elsewhere on the board
ILM_SET: RILM1.1 (ILM), U1.9 (ILM); also elsewhere on the board
OVLO_SET: U1.2 (OVLO); also elsewhere on the board
SPLYGD_DIAG: U1.3 (SPLYGD); also elsewhere on the board
UVLO_SET: U1.1 (EN/UVLO); also elsewhere on the board

Notes on the sheet:
PRELIMINARY - NOT APPROVED FOR FABRICATION OR ENERGIZATION
01 Single-channel DXL branch protection core
Exact active, power boundaries and assembly-variant current setting.
W1001
W1002
W1003
W1004
W1005
W1006
W1007
W1008
W1009
W1010
W1011
W1012
W1013
W1014
W1015
NOTE 1: TPS259461L limits forward current only; reverse current is unbounded while ON.
NOTE 2: ITIMER is deliberately open. SPLYGD and FLT are unpulled diagnostic test points
only.
NOTE 3: J1/J2 assemble RILM=1.65 kOhm; G1 assembles RILM=3.32 kOhm. Never substitute
variants without a controlled record.
NOTE 4: PRELIMINARY - NO SUPPLIER UPLOAD, FABRICATION, CONNECTION, OR ENERGIZATION

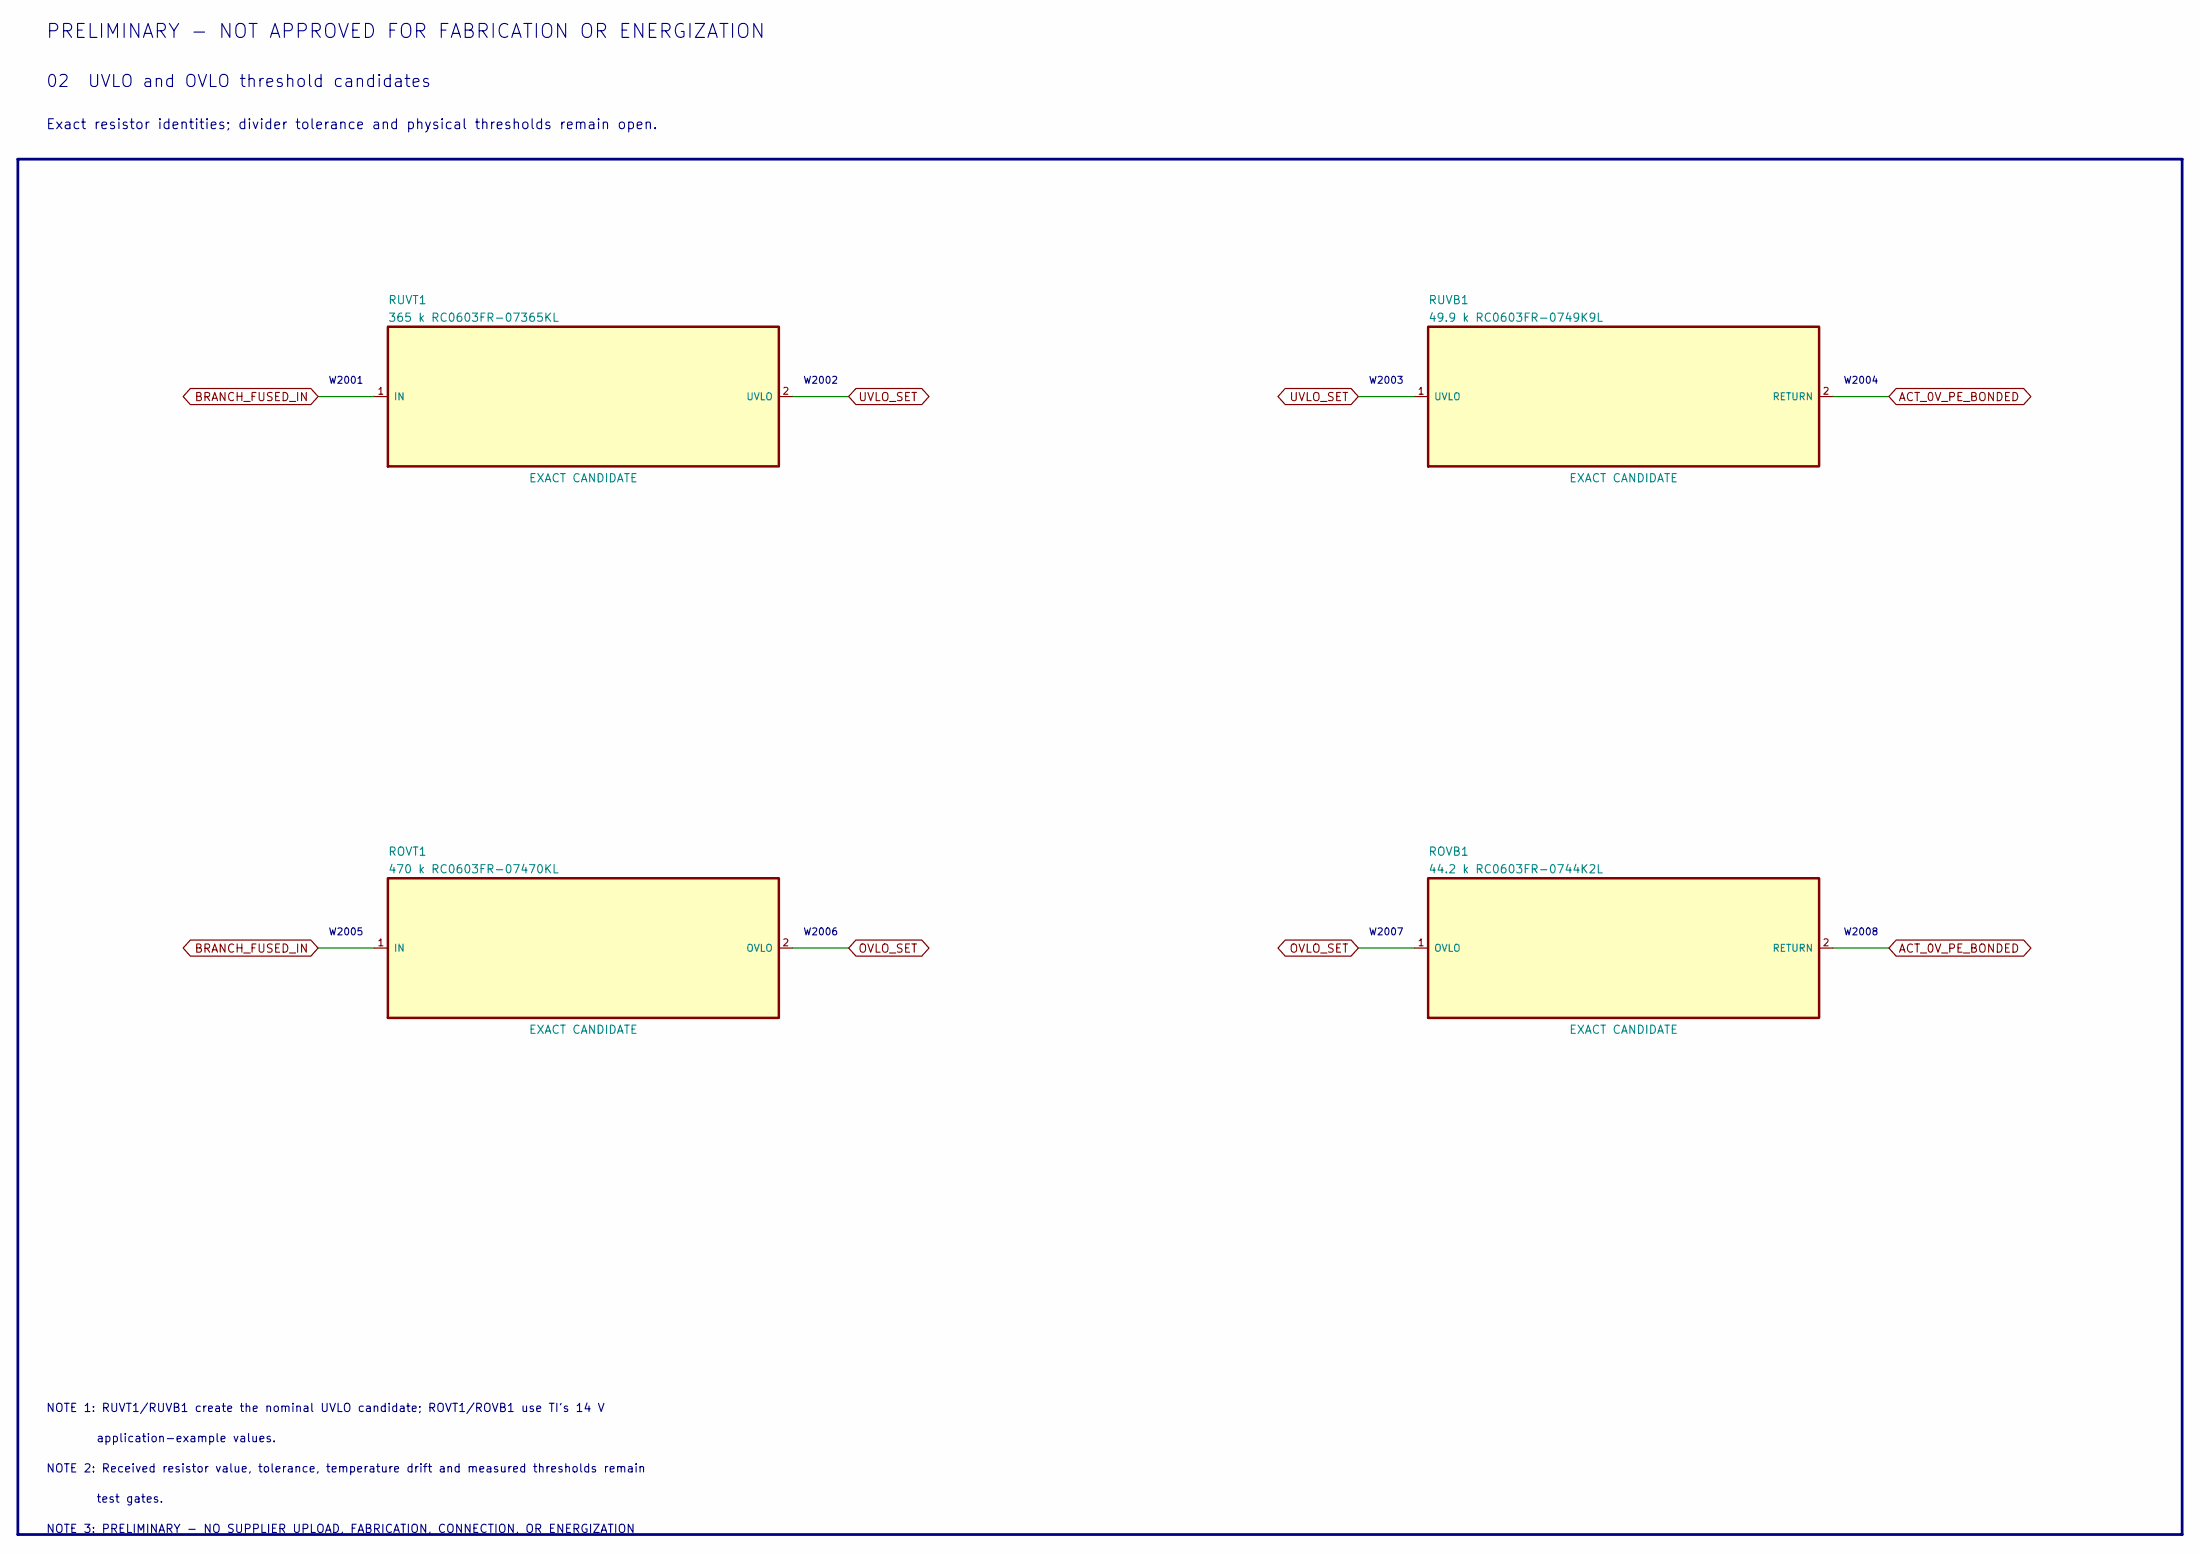
[picture p331: schematic 02_threshold_dividers.kicad_sch, PB HR-V0 DXL-PROT-CARRIER-P0.3 - 02]

Parts:
ROVB1: 44.2 k RC0603FR-0744K2L; R_0603_1608Metric
ROVT1: 470 k RC0603FR-07470KL; R_0603_1608Metric
RUVB1: 49.9 k RC0603FR-0749K9L; R_0603_1608Metric
RUVT1: 365 k RC0603FR-07365KL; R_0603_1608Metric

Connections:
ACT_0V_PE_BONDED: ROVB1.2 (RETURN), RUVB1.2 (RETURN); also elsewhere on the board
BRANCH_FUSED_IN: ROVT1.1 (IN), RUVT1.1 (IN); also elsewhere on the board
OVLO_SET: ROVB1.1 (OVLO), ROVT1.2 (OVLO); also elsewhere on the board
UVLO_SET: RUVB1.1 (UVLO), RUVT1.2 (UVLO); also elsewhere on the board

Notes on the sheet:
PRELIMINARY - NOT APPROVED FOR FABRICATION OR ENERGIZATION
02 UVLO and OVLO threshold candidates
Exact resistor identities; divider tolerance and physical thresholds remain open.
W2001
W2002
W2003
W2004
W2005
W2006
W2007
W2008
NOTE 1: RUVT1/RUVB1 create the nominal UVLO candidate; ROVT1/ROVB1 use TI's 14 V
application-example values.
NOTE 2: Received resistor value, tolerance, temperature drift and measured thresholds remain
test gates.
NOTE 3: PRELIMINARY - NO SUPPLIER UPLOAD, FABRICATION, CONNECTION, OR ENERGIZATION

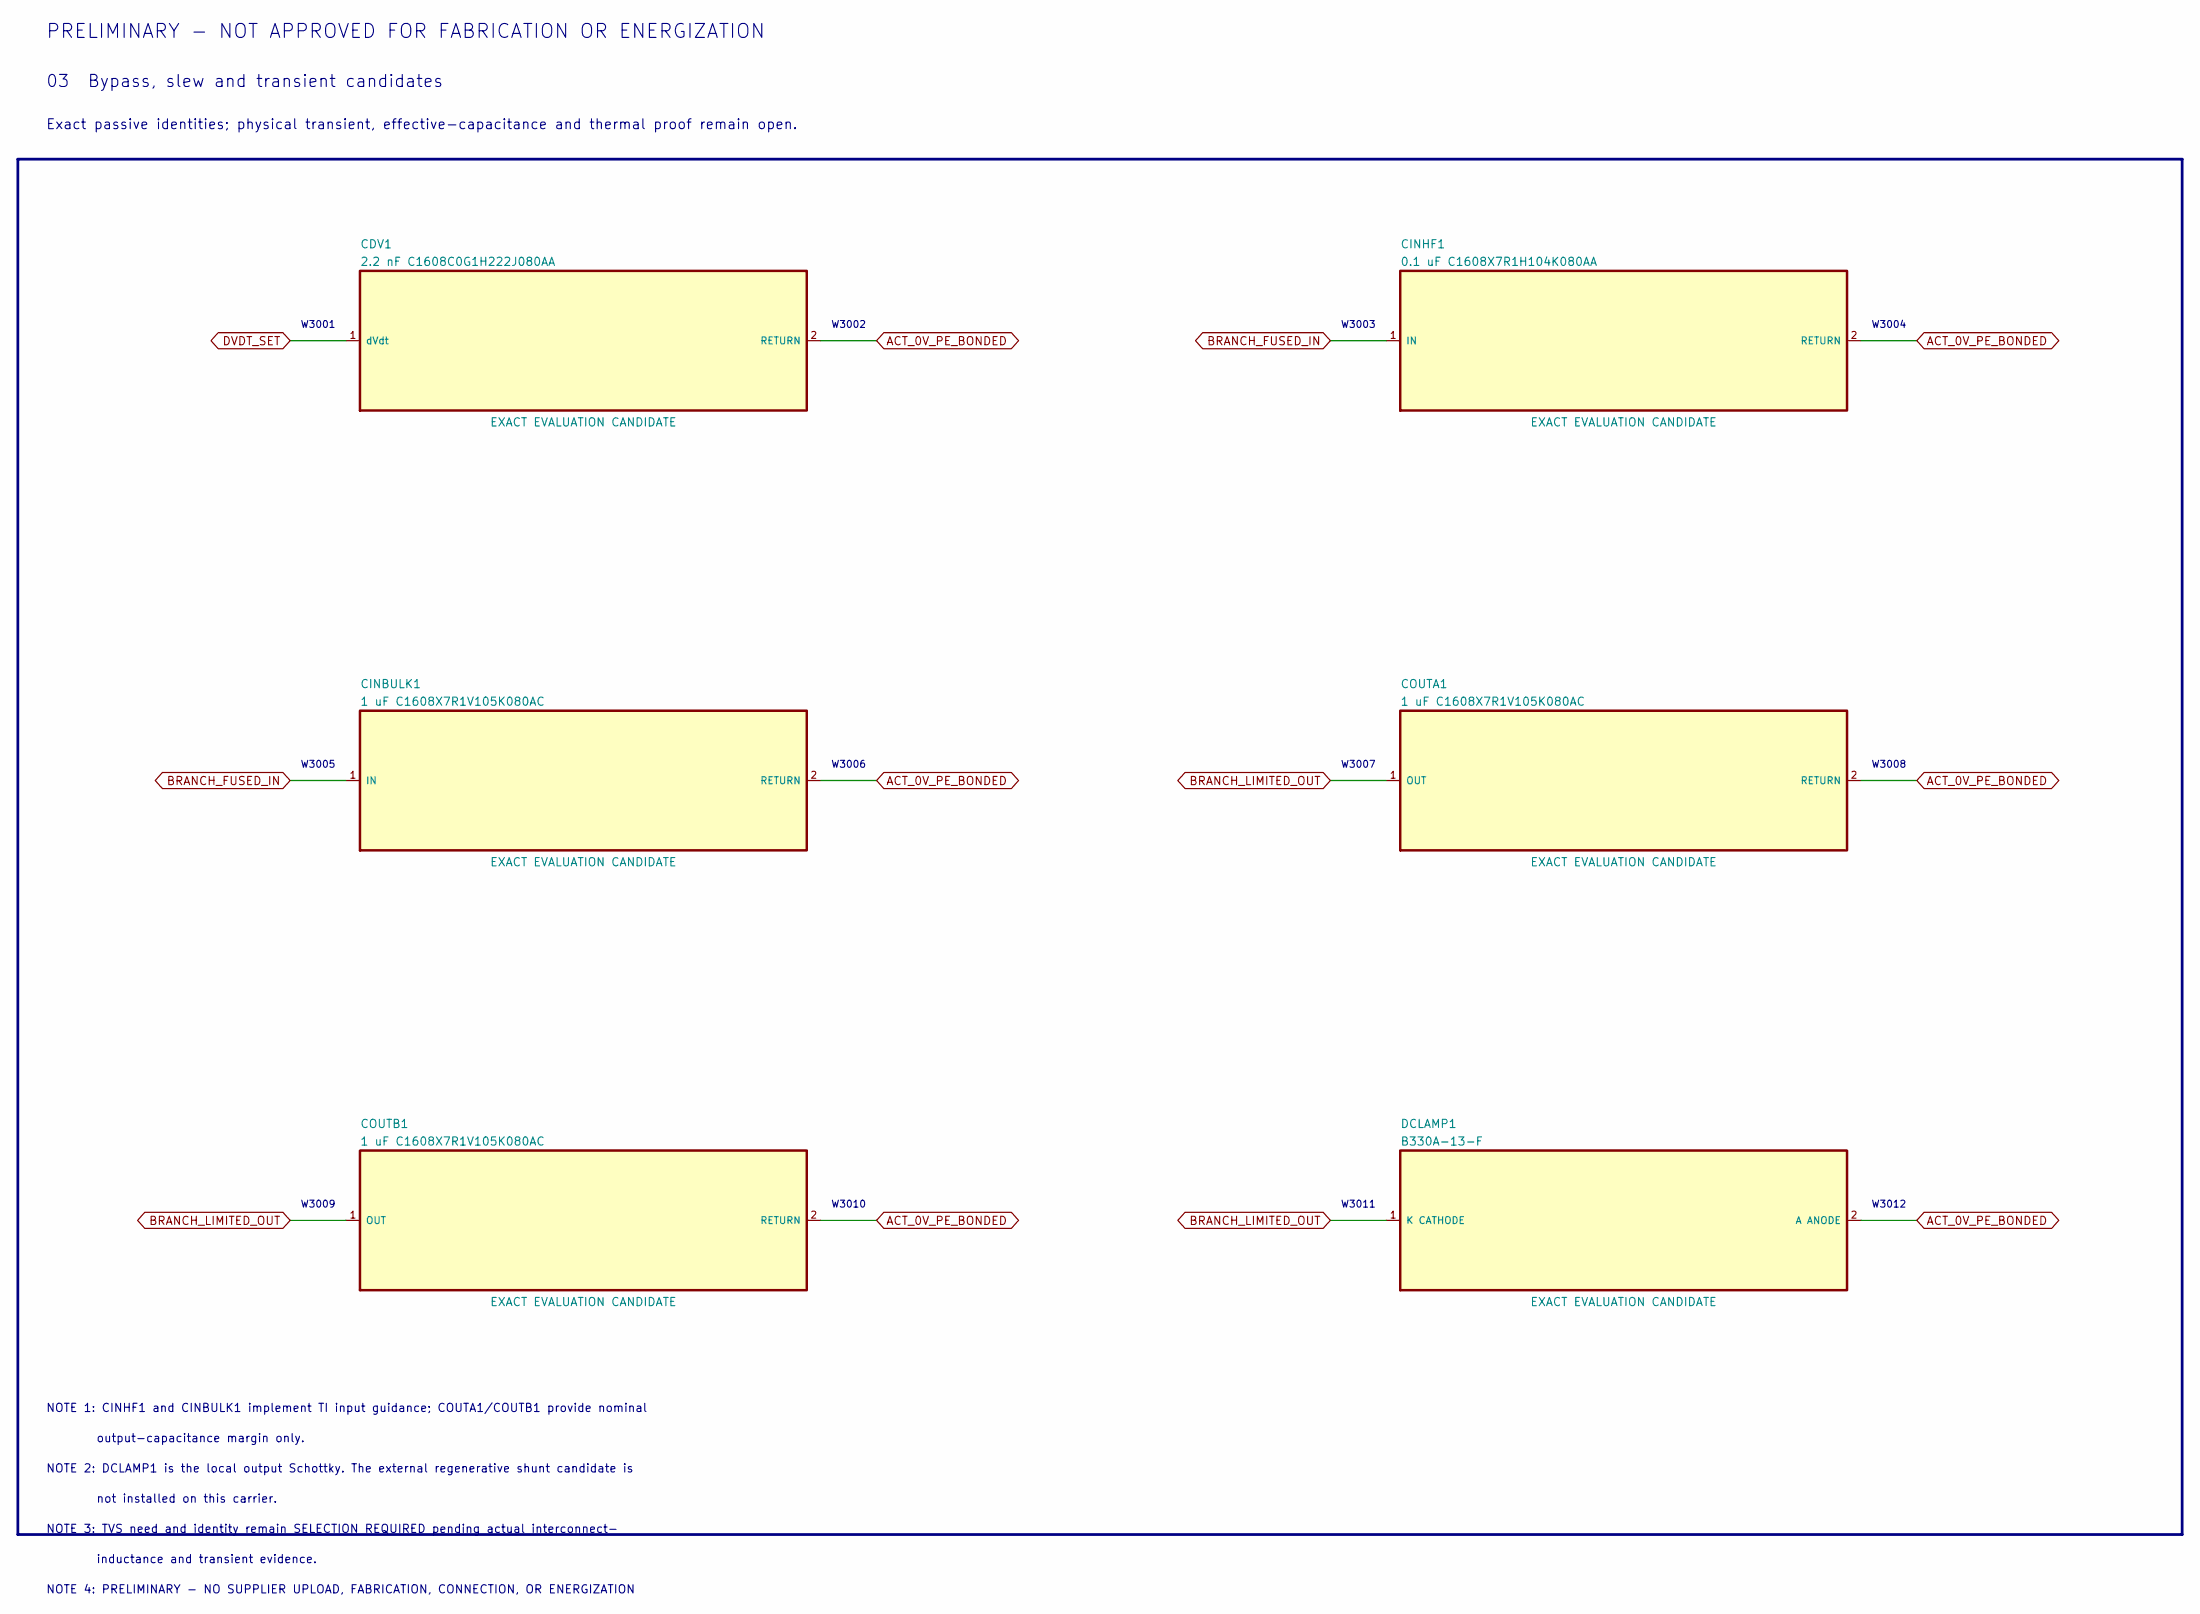
[picture p332: schematic 03_bypass_and_transients.kicad_sch, PB HR-V0 DXL-PROT-CARRIER-P0.3 - 03]

Parts:
CDV1: 2.2 nF C1608C0G1H222J080AA; C_0603_1608Metric
CINBULK1: 1 uF C1608X7R1V105K080AC; C_0603_1608Metric
CINHF1: 0.1 uF C1608X7R1H104K080AA; C_0603_1608Metric
COUTA1: 1 uF C1608X7R1V105K080AC; C_0603_1608Metric
COUTB1: 1 uF C1608X7R1V105K080AC; C_0603_1608Metric
DCLAMP1: B330A-13-F; D_SMA

Connections:
ACT_0V_PE_BONDED: CDV1.2 (RETURN), CINBULK1.2 (RETURN), CINHF1.2 (RETURN), COUTA1.2 (RETURN), COUTB1.2 (RETURN), DCLAMP1.2 (A ANODE); also elsewhere on the board
BRANCH_FUSED_IN: CINBULK1.1 (IN), CINHF1.1 (IN); also elsewhere on the board
BRANCH_LIMITED_OUT: COUTA1.1 (OUT), COUTB1.1 (OUT), DCLAMP1.1 (K CATHODE); also elsewhere on the board
DVDT_SET: CDV1.1 (dVdt); also elsewhere on the board

Notes on the sheet:
PRELIMINARY - NOT APPROVED FOR FABRICATION OR ENERGIZATION
03 Bypass, slew and transient candidates
Exact passive identities; physical transient, effective-capacitance and thermal proof remain open.
W3001
W3002
W3003
W3004
W3005
W3006
W3007
W3008
W3009
W3010
W3011
W3012
NOTE 1: CINHF1 and CINBULK1 implement TI input guidance; COUTA1/COUTB1 provide nominal
output-capacitance margin only.
NOTE 2: DCLAMP1 is the local output Schottky. The external regenerative shunt candidate is
not installed on this carrier.
NOTE 3: TVS need and identity remain SELECTION REQUIRED pending actual interconnect-
inductance and transient evidence.
NOTE 4: PRELIMINARY - NO SUPPLIER UPLOAD, FABRICATION, CONNECTION, OR ENERGIZATION
