amyleesterling/humanoid-robot/electrical/kicad/hr-v0-dxl-protection-carrier-p0.3/hr-v0-dxl-protection-carrier-p0.3.kicad_pcb

## KiCad design electrical/kicad/hr-v0-dxl-protection-carrier-p0.3/hr-v0-dxl-protection-carrier-p0.3.kicad_pcb (continued)

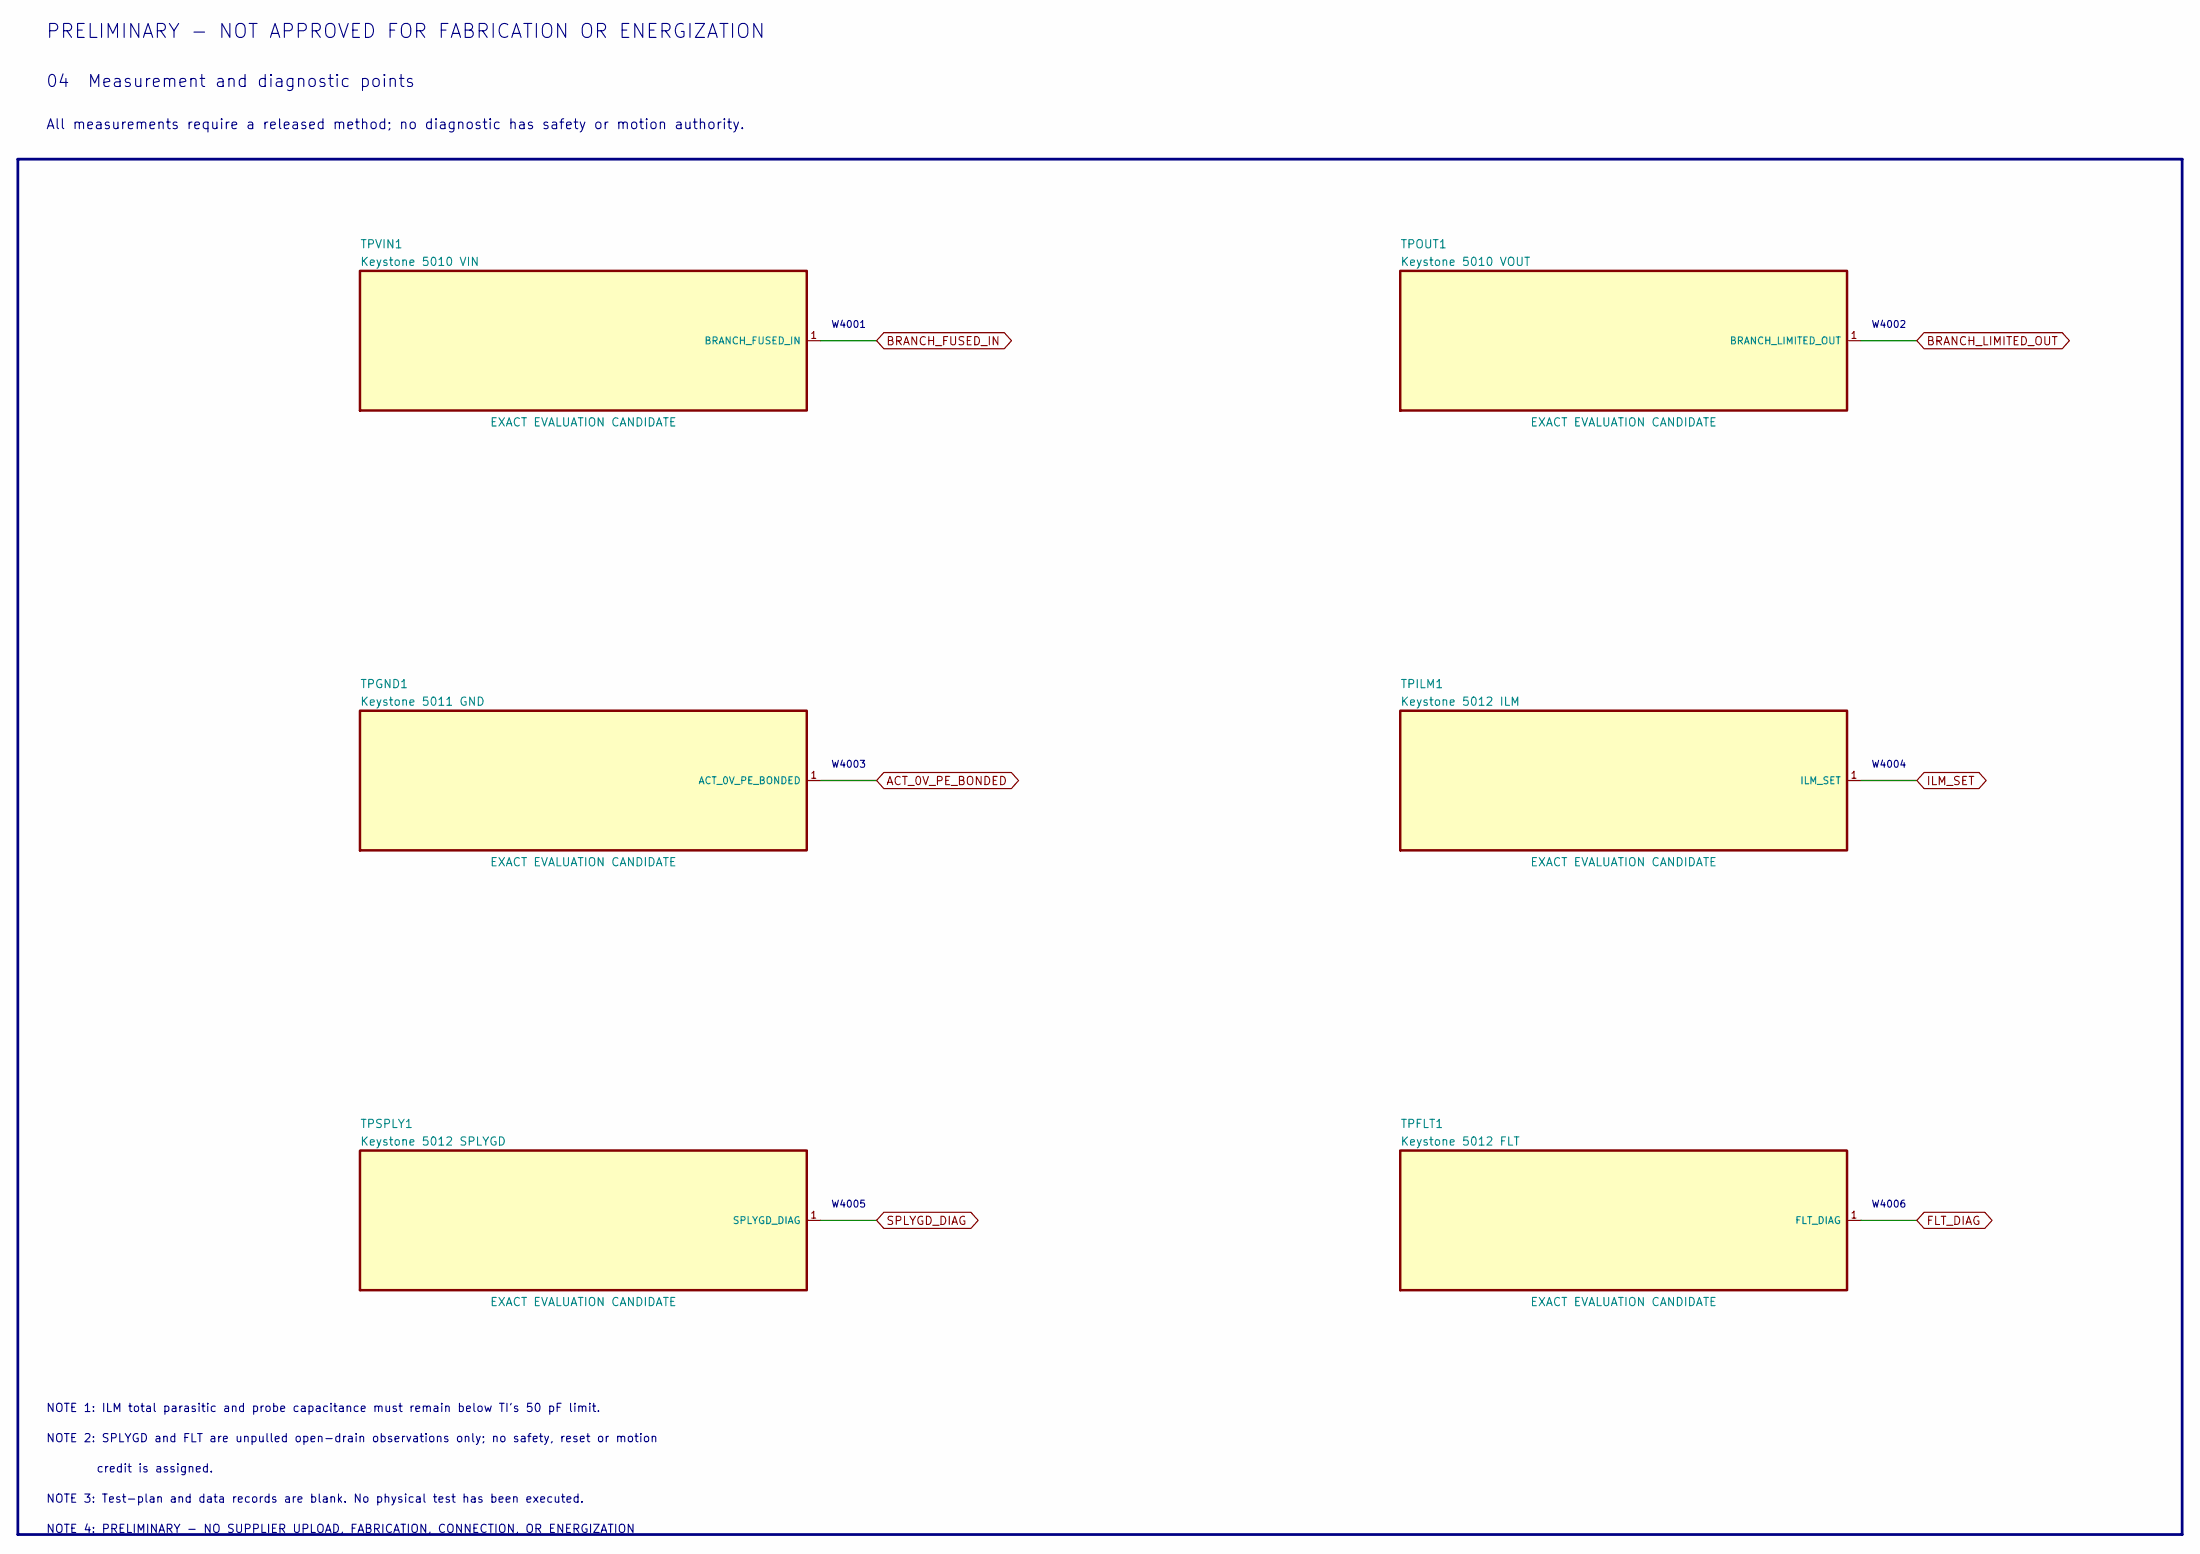
[picture p333: schematic 04_measurement_points.kicad_sch, PB HR-V0 DXL-PROT-CARRIER-P0.3 - 04]

Parts:
TPFLT1: Keystone 5012 FLT; TestPoint_Keystone_5010-5014_Multipurpose
TPGND1: Keystone 5011 GND; TestPoint_Keystone_5010-5014_Multipurpose
TPILM1: Keystone 5012 ILM; TestPoint_Keystone_5010-5014_Multipurpose
TPOUT1: Keystone 5010 VOUT; TestPoint_Keystone_5010-5014_Multipurpose
TPSPLY1: Keystone 5012 SPLYGD; TestPoint_Keystone_5010-5014_Multipurpose
TPVIN1: Keystone 5010 VIN; TestPoint_Keystone_5010-5014_Multipurpose

Connections:
ACT_0V_PE_BONDED: TPGND1.1; also elsewhere on the board
BRANCH_FUSED_IN: TPVIN1.1; also elsewhere on the board
BRANCH_LIMITED_OUT: TPOUT1.1; also elsewhere on the board
FLT_DIAG: TPFLT1.1; also elsewhere on the board
ILM_SET: TPILM1.1; also elsewhere on the board
SPLYGD_DIAG: TPSPLY1.1; also elsewhere on the board

Notes on the sheet:
PRELIMINARY - NOT APPROVED FOR FABRICATION OR ENERGIZATION
04 Measurement and diagnostic points
All measurements require a released method; no diagnostic has safety or motion authority.
W4001
W4002
W4003
W4004
W4005
W4006
NOTE 1: ILM total parasitic and probe capacitance must remain below TI's 50 pF limit.
NOTE 2: SPLYGD and FLT are unpulled open-drain observations only; no safety, reset or motion
credit is assigned.
NOTE 3: Test-plan and data records are blank. No physical test has been executed.
NOTE 4: PRELIMINARY - NO SUPPLIER UPLOAD, FABRICATION, CONNECTION, OR ENERGIZATION

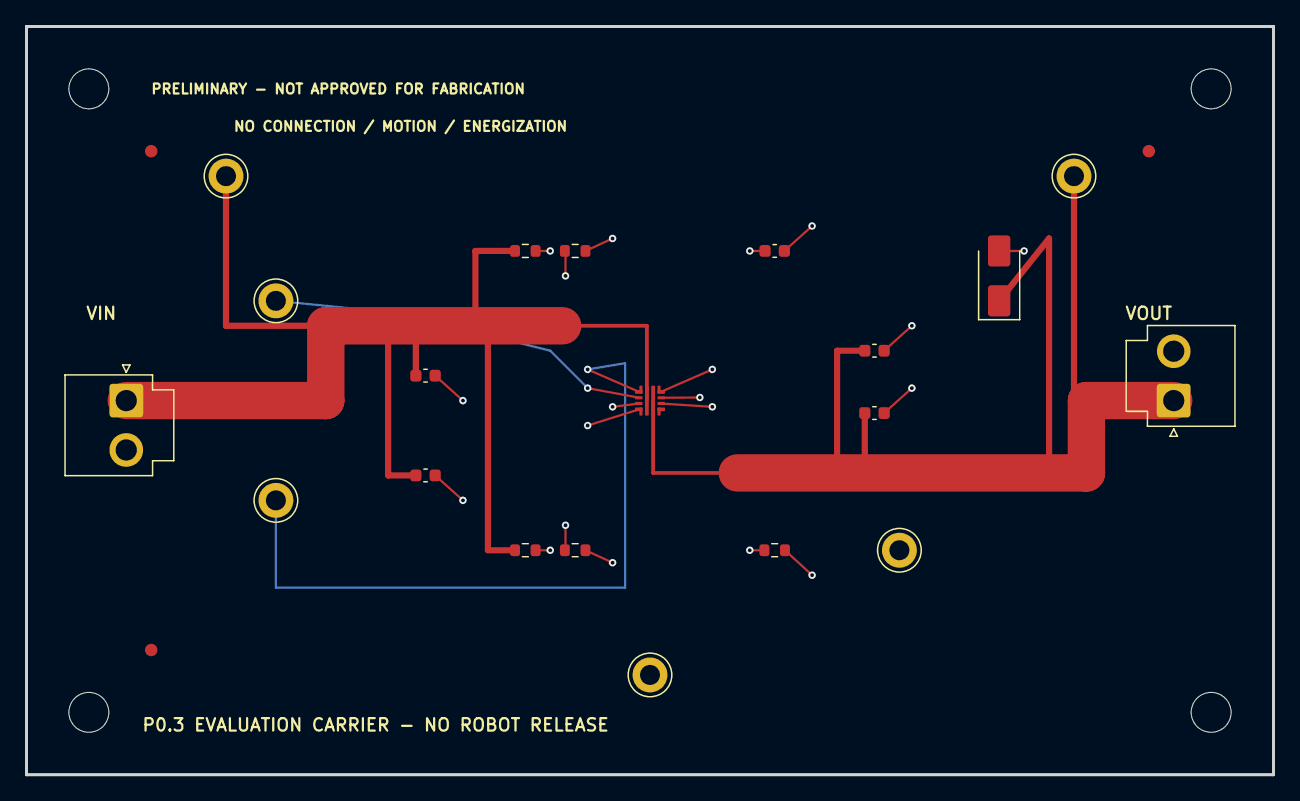
[picture p334: board hr-v0-dxl-protection-carrier-p0.3.kicad_pcb from above]

Board: 4 copper layers, 100.0 x 60.0 mm, 27 parts (0 on the bottom side), 9 nets.

Other parts of the board:
FD1, FD2, FD3: BOARD-LEVEL GLOBAL FIDUCIAL 1.0/2.0 mm; PROVIDER 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
MH1, MH2, MH3, MH4: BOARD-ONLY M3; MOUNTING SELECTION REQUIRED; MountingHole_3.2mm_M3
