amyleesterling/humanoid-robot/hr30/whole-body-p0.1/electrical/carriers-p0.1/carrier-a/hr30-carrier-a-p0.1.kicad_pcb

## KiCad design hr30/whole-body-p0.1/electrical/carriers-p0.1/carrier-a/hr30-carrier-a-p0.1.kicad_pcb (2026-08-17)

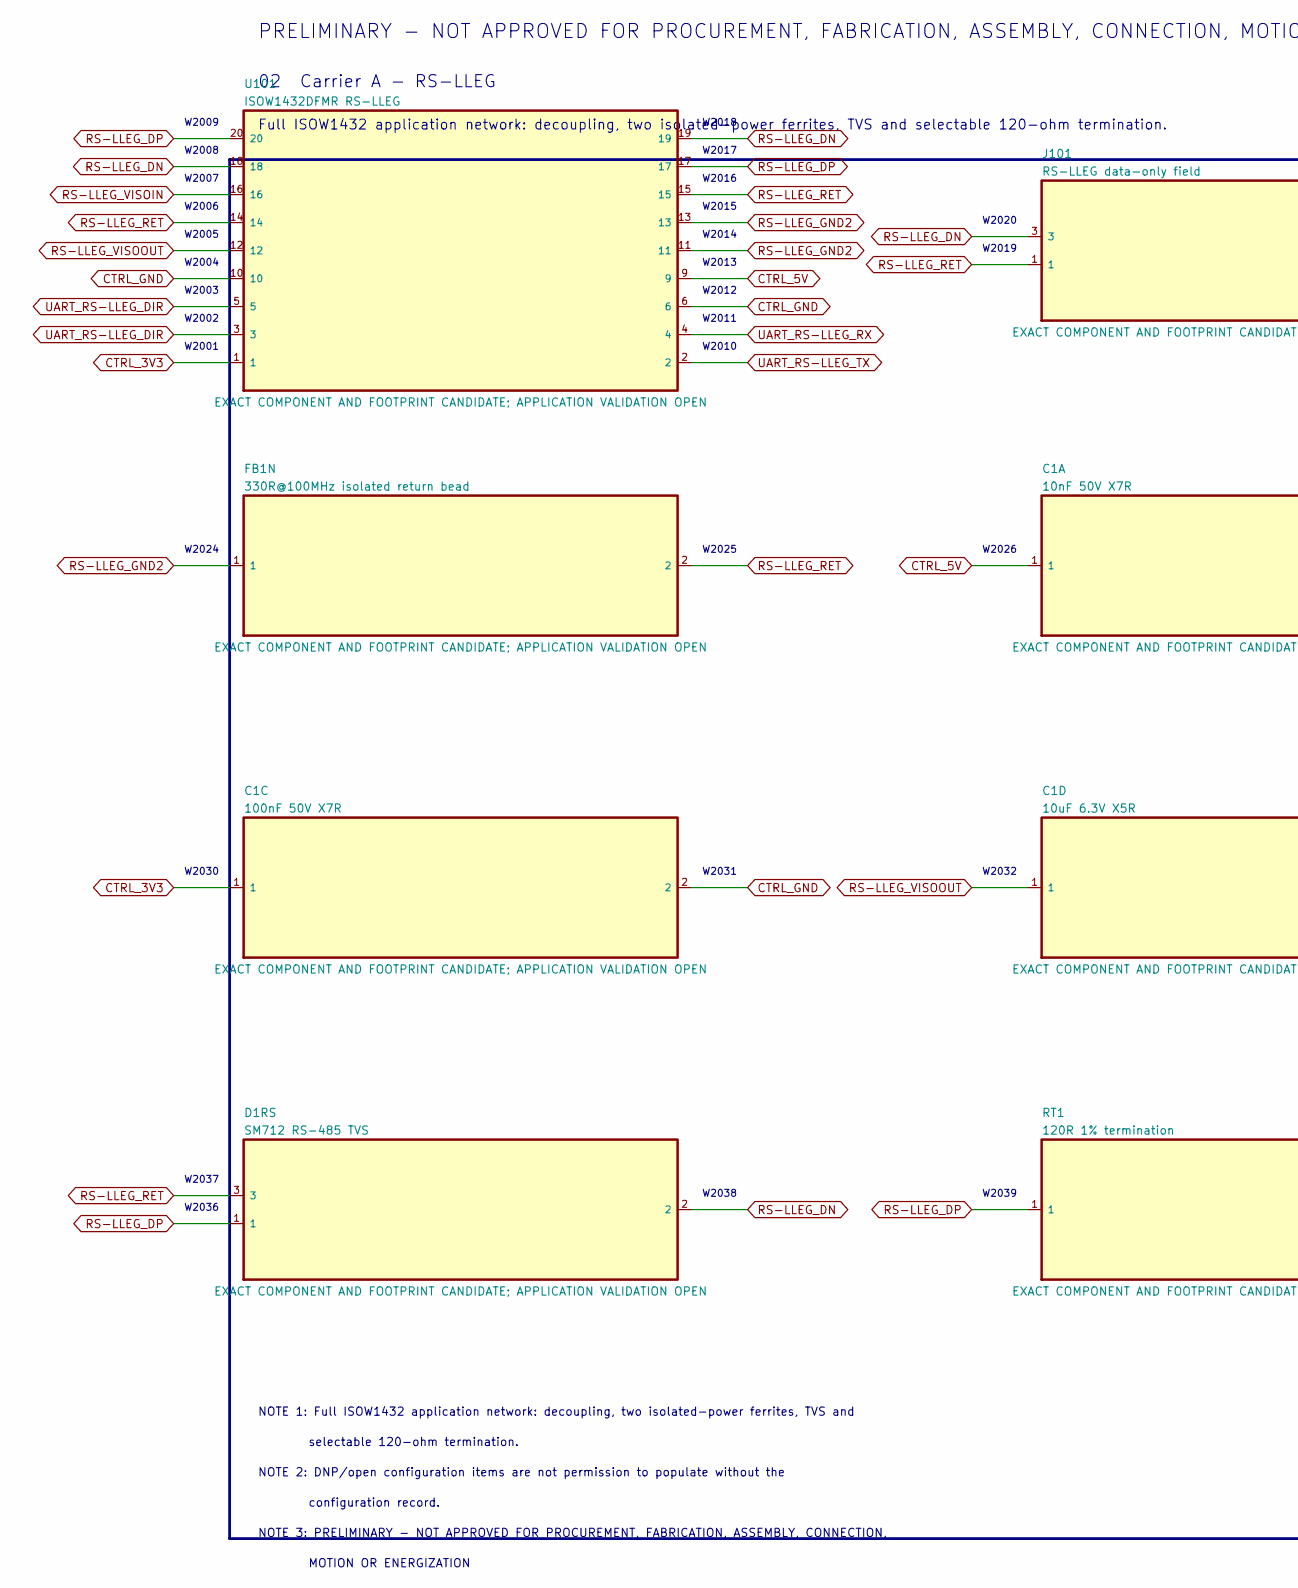
[picture p335: schematic 02_rs_lleg.kicad_sch, PB HR-V0 P0.1 - 02, part in row 1, column 1]

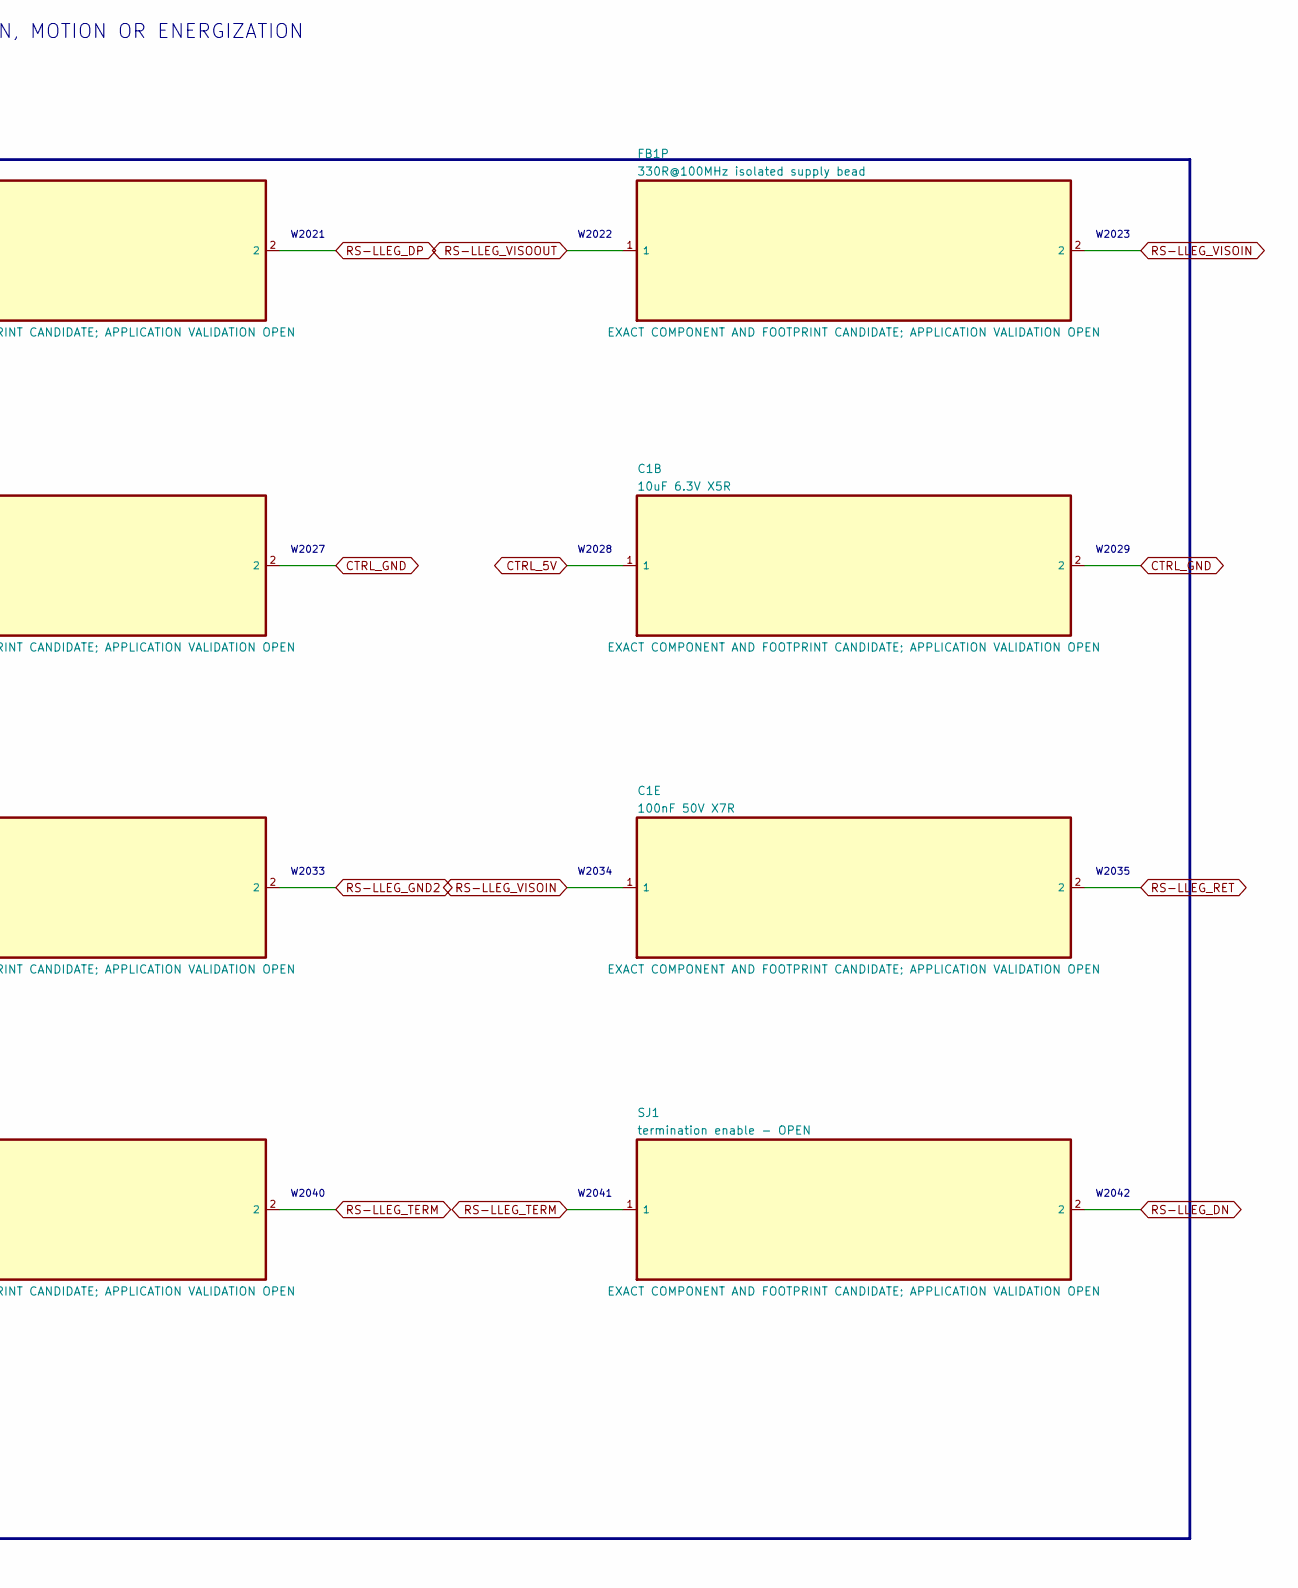
[picture p336: schematic 02_rs_lleg.kicad_sch, PB HR-V0 P0.1 - 02, part in row 1, column 2]

Parts:
C1A: 10nF 50V X7R; C_0603_1608Metric
C1B, C1D: 10uF 6.3V X5R; C_0603_1608Metric
C1C, C1E: 100nF 50V X7R; C_0603_1608Metric
D1RS: SM712 RS-485 TVS; SOT-23
FB1N: 330R@100MHz isolated return bead; L_0402_1005Metric
FB1P: 330R@100MHz isolated supply bead; L_0402_1005Metric
J101: RS-LLEG data-only field; JST_GH_BM03B-GHS-TBT_1x03-1MP_P1.25mm_Vertical
RT1: 120R 1% termination; R_0603_1608Metric
SJ1: termination enable - OPEN; SolderJumper-2_P1.3mm_Open_Pad1.0x1.5mm
U101: ISOW1432DFMR RS-LLEG; SOIC-20W_7.5x12.8mm_P1.27mm

Connections:
CTRL_3V3: C1C.1, U101.1; also elsewhere on the board
CTRL_5V: C1A.1, C1B.1, U101.9; also elsewhere on the board
CTRL_GND: C1A.2, C1B.2, C1C.2, U101.6, U101.10; also elsewhere on the board
RS-LLEG_DN: D1RS.2, J101.3, SJ1.2, U101.18, U101.19
RS-LLEG_DP: D1RS.1, J101.2, RT1.1, U101.17, U101.20
RS-LLEG_GND2: C1D.2, FB1N.1, U101.11, U101.13
RS-LLEG_RET: C1E.2, D1RS.3, FB1N.2, J101.1, U101.14, U101.15
RS-LLEG_TERM: RT1.2, SJ1.1
RS-LLEG_VISOIN: C1E.1, FB1P.2, U101.16
RS-LLEG_VISOOUT: C1D.1, FB1P.1, U101.12
UART_RS-LLEG_DIR: U101.3, U101.5; also elsewhere on the board
UART_RS-LLEG_RX: U101.4; also elsewhere on the board
UART_RS-LLEG_TX: U101.2; also elsewhere on the board

Notes on the sheet:
PRELIMINARY - NOT APPROVED FOR PROCUREMENT, FABRICATION, ASSEMBLY, CONNECTION, MOTION OR ENERGIZATION
02 Carrier A - RS-LLEG
Full ISOW1432 application network: decoupling, two isolated-power ferrites, TVS and selectable 120-ohm termination.
W2001
W2002
W2003
W2004
W2005
W2006
W2007
W2008
W2009
W2010
W2011
W2012
W2013
W2014
W2015
W2016
W2017
W2018
W2019
W2020
W2021
W2022
W2023
W2024
W2025
W2026
W2027
W2028
W2029
W2030
W2031
W2032
W2033
W2034
W2035
W2036
W2037
W2038
W2039
W2040
W2041
W2042
NOTE 1: Full ISOW1432 application network: decoupling, two isolated-power ferrites, TVS and
selectable 120-ohm termination.
NOTE 2: DNP/open configuration items are not permission to populate without the
configuration record.
NOTE 3: PRELIMINARY - NOT APPROVED FOR PROCUREMENT, FABRICATION, ASSEMBLY, CONNECTION,
MOTION OR ENERGIZATION

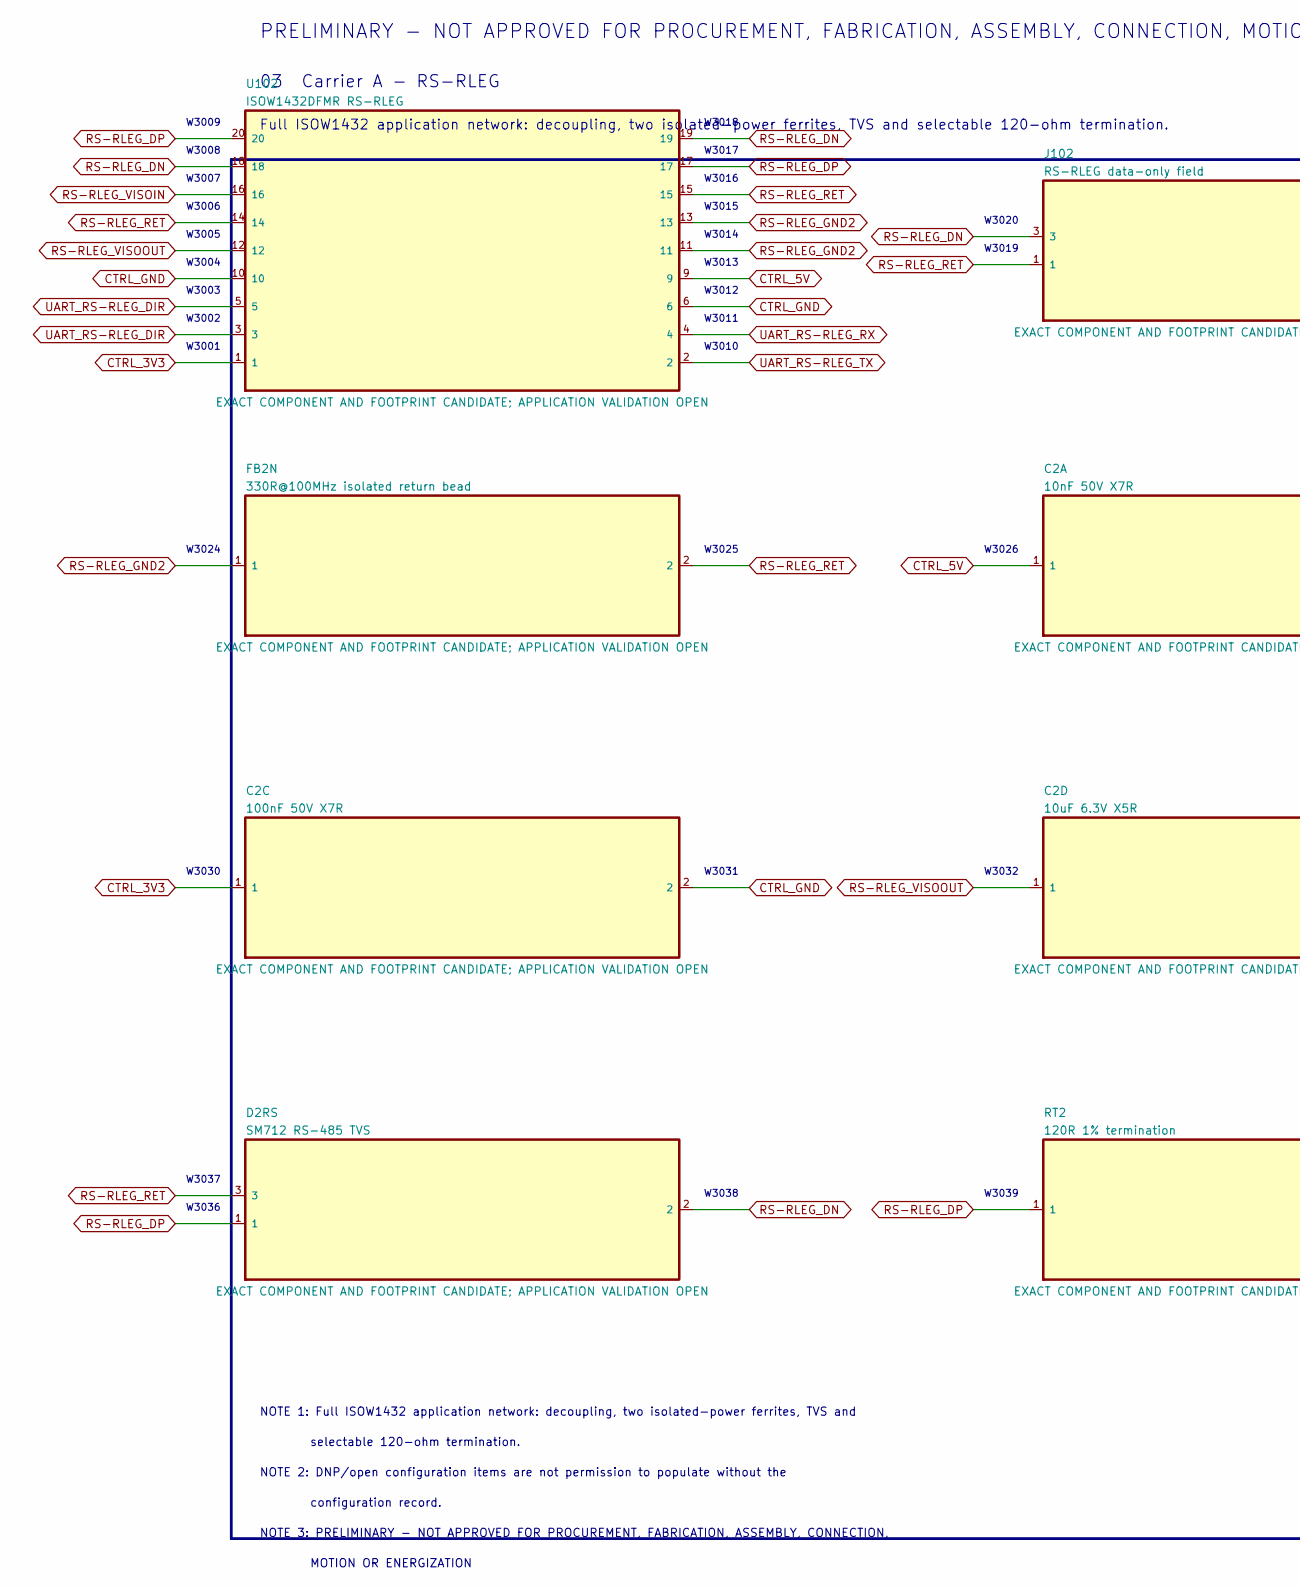
[picture p337: schematic 03_rs_rleg.kicad_sch, PB HR-V0 P0.1 - 03, part in row 1, column 1]

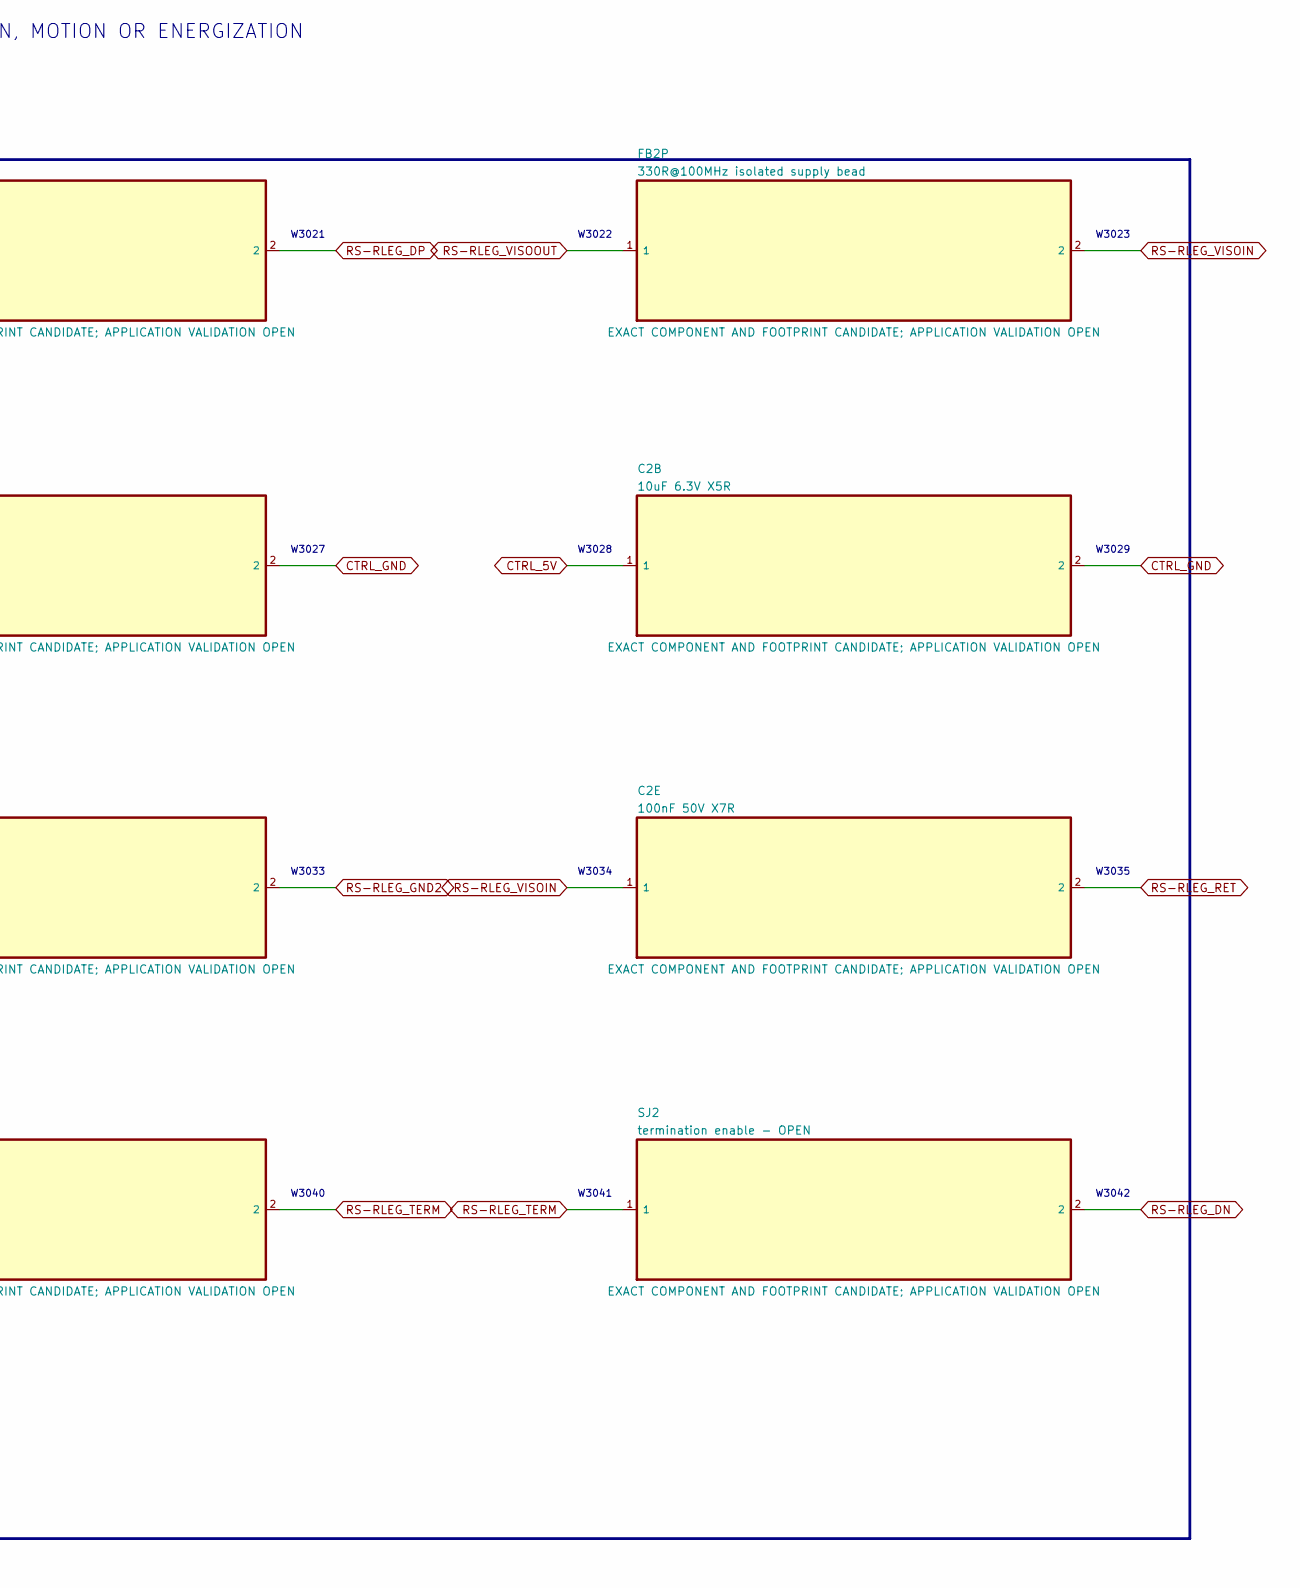
[picture p338: schematic 03_rs_rleg.kicad_sch, PB HR-V0 P0.1 - 03, part in row 1, column 2]

Parts:
C2A: 10nF 50V X7R; C_0603_1608Metric
C2B, C2D: 10uF 6.3V X5R; C_0603_1608Metric
C2C, C2E: 100nF 50V X7R; C_0603_1608Metric
D2RS: SM712 RS-485 TVS; SOT-23
FB2N: 330R@100MHz isolated return bead; L_0402_1005Metric
FB2P: 330R@100MHz isolated supply bead; L_0402_1005Metric
J102: RS-RLEG data-only field; JST_GH_BM03B-GHS-TBT_1x03-1MP_P1.25mm_Vertical
RT2: 120R 1% termination; R_0603_1608Metric
SJ2: termination enable - OPEN; SolderJumper-2_P1.3mm_Open_Pad1.0x1.5mm
U102: ISOW1432DFMR RS-RLEG; SOIC-20W_7.5x12.8mm_P1.27mm

Connections:
CTRL_3V3: C2C.1, U102.1; also elsewhere on the board
CTRL_5V: C2A.1, C2B.1, U102.9; also elsewhere on the board
CTRL_GND: C2A.2, C2B.2, C2C.2, U102.6, U102.10; also elsewhere on the board
RS-RLEG_DN: D2RS.2, J102.3, SJ2.2, U102.18, U102.19
RS-RLEG_DP: D2RS.1, J102.2, RT2.1, U102.17, U102.20
RS-RLEG_GND2: C2D.2, FB2N.1, U102.11, U102.13
RS-RLEG_RET: C2E.2, D2RS.3, FB2N.2, J102.1, U102.14, U102.15
RS-RLEG_TERM: RT2.2, SJ2.1
RS-RLEG_VISOIN: C2E.1, FB2P.2, U102.16
RS-RLEG_VISOOUT: C2D.1, FB2P.1, U102.12
UART_RS-RLEG_DIR: U102.3, U102.5; also elsewhere on the board
UART_RS-RLEG_RX: U102.4; also elsewhere on the board
UART_RS-RLEG_TX: U102.2; also elsewhere on the board

Notes on the sheet:
PRELIMINARY - NOT APPROVED FOR PROCUREMENT, FABRICATION, ASSEMBLY, CONNECTION, MOTION OR ENERGIZATION
03 Carrier A - RS-RLEG
Full ISOW1432 application network: decoupling, two isolated-power ferrites, TVS and selectable 120-ohm termination.
W3001
W3002
W3003
W3004
W3005
W3006
W3007
W3008
W3009
W3010
W3011
W3012
W3013
W3014
W3015
W3016
W3017
W3018
W3019
W3020
W3021
W3022
W3023
W3024
W3025
W3026
W3027
W3028
W3029
W3030
W3031
W3032
W3033
W3034
W3035
W3036
W3037
W3038
W3039
W3040
W3041
W3042
NOTE 1: Full ISOW1432 application network: decoupling, two isolated-power ferrites, TVS and
selectable 120-ohm termination.
NOTE 2: DNP/open configuration items are not permission to populate without the
configuration record.
NOTE 3: PRELIMINARY - NOT APPROVED FOR PROCUREMENT, FABRICATION, ASSEMBLY, CONNECTION,
MOTION OR ENERGIZATION

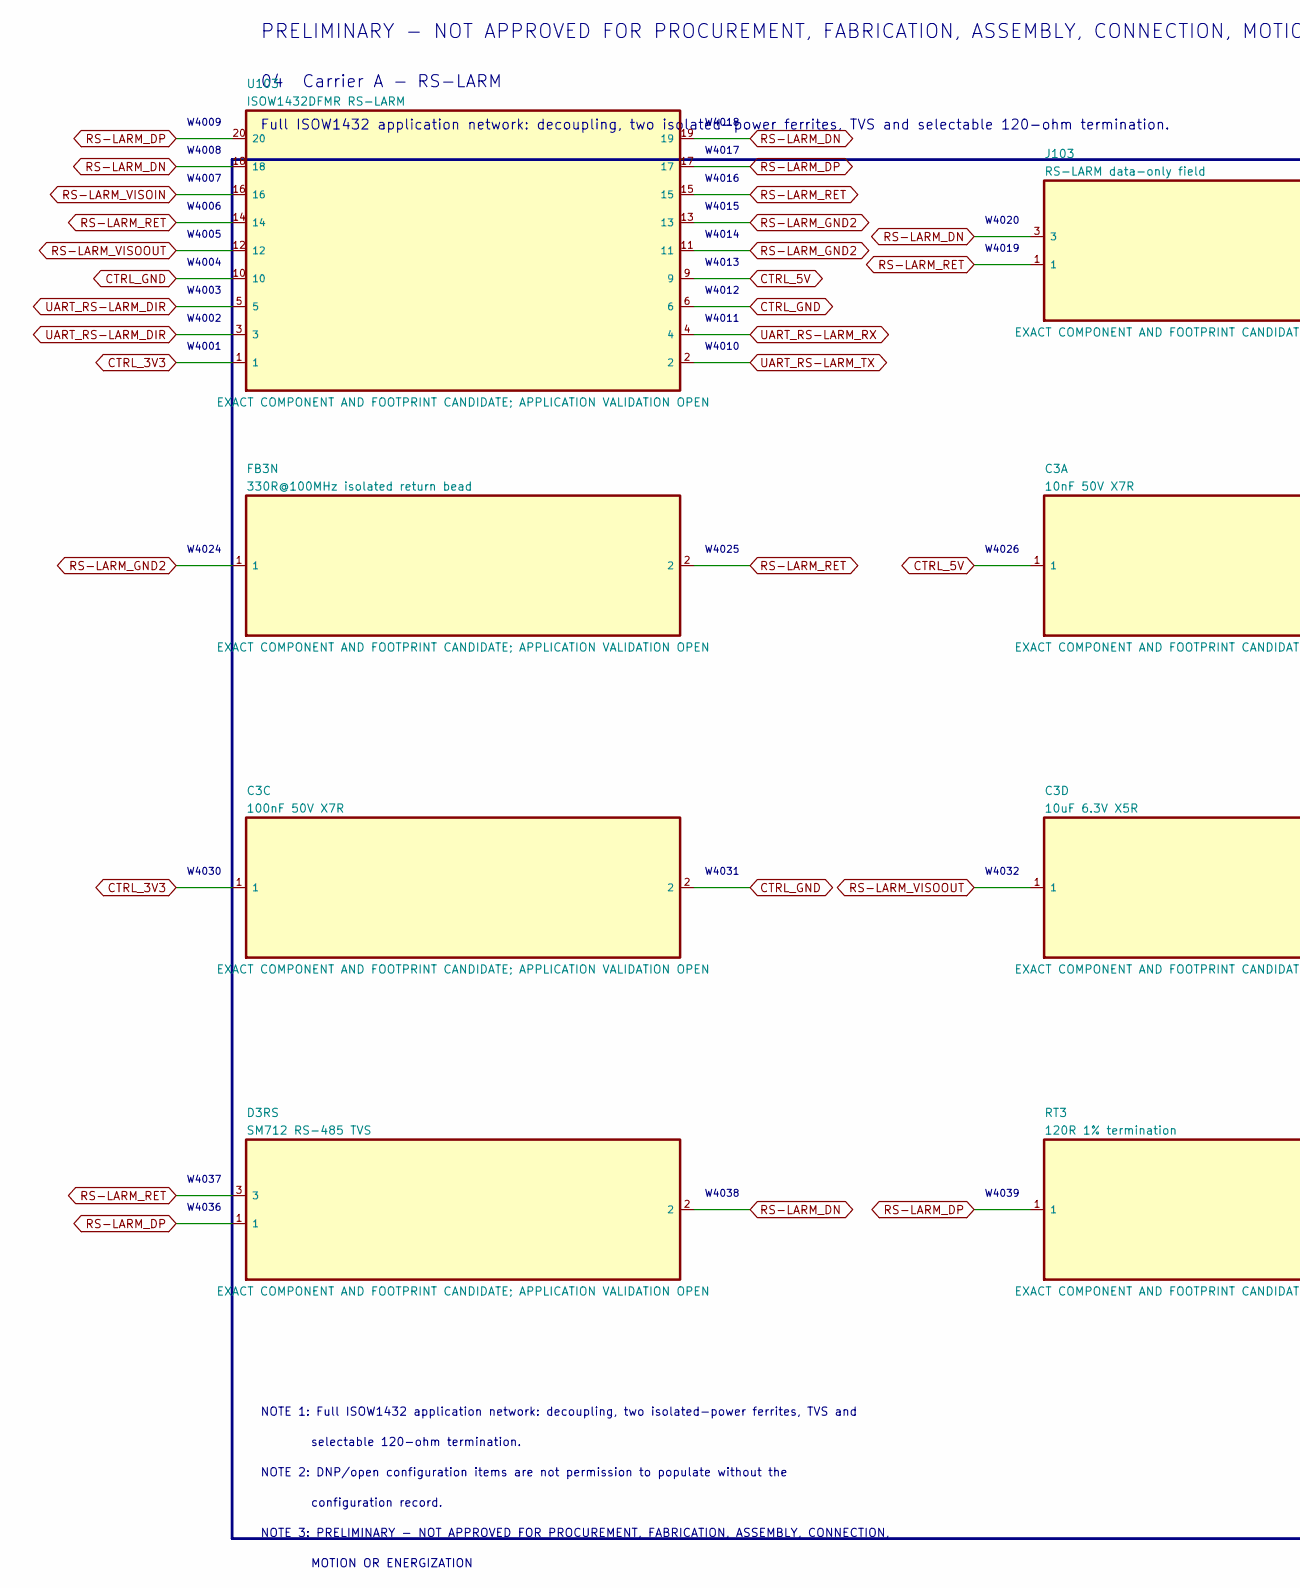
[picture p339: schematic 04_rs_larm.kicad_sch, PB HR-V0 P0.1 - 04, part in row 1, column 1]

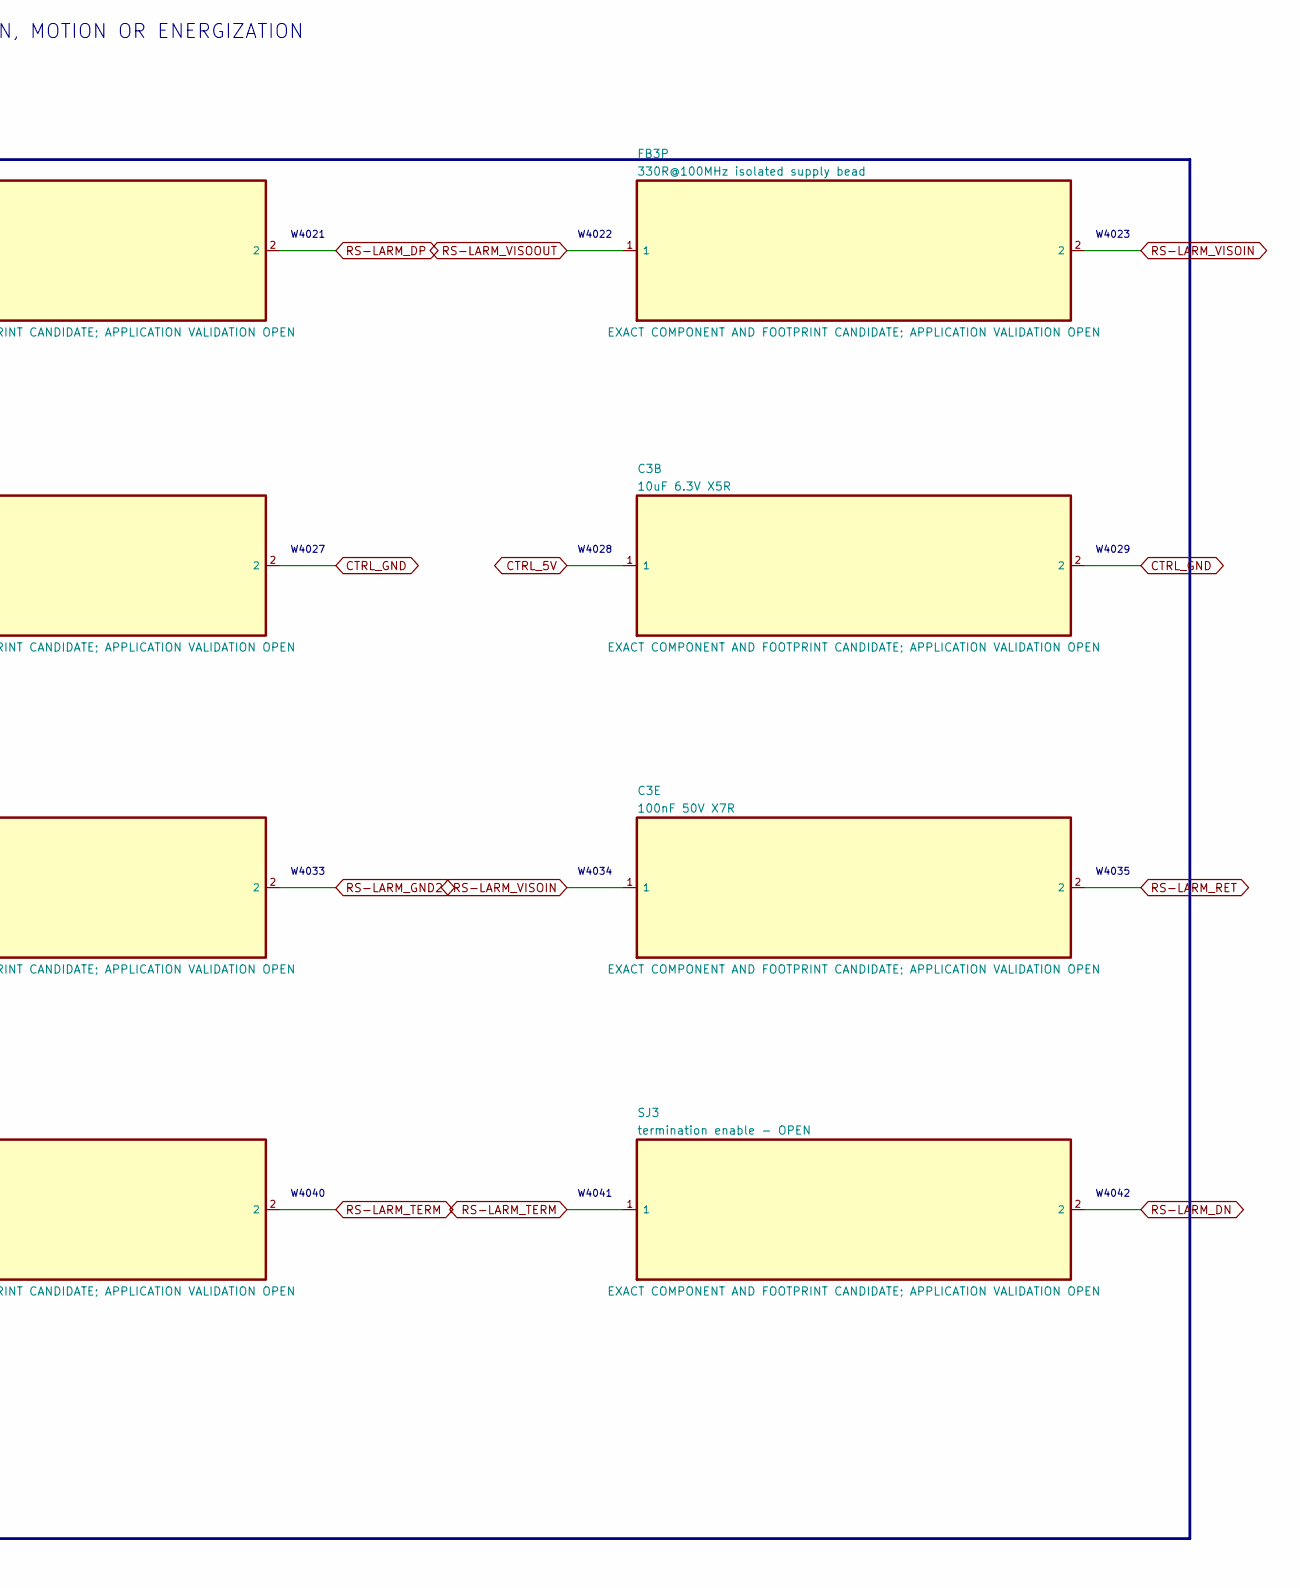
[picture p340: schematic 04_rs_larm.kicad_sch, PB HR-V0 P0.1 - 04, part in row 1, column 2]

Parts:
C3A: 10nF 50V X7R; C_0603_1608Metric
C3B, C3D: 10uF 6.3V X5R; C_0603_1608Metric
C3C, C3E: 100nF 50V X7R; C_0603_1608Metric
D3RS: SM712 RS-485 TVS; SOT-23
FB3N: 330R@100MHz isolated return bead; L_0402_1005Metric
FB3P: 330R@100MHz isolated supply bead; L_0402_1005Metric
J103: RS-LARM data-only field; JST_GH_BM03B-GHS-TBT_1x03-1MP_P1.25mm_Vertical
RT3: 120R 1% termination; R_0603_1608Metric
SJ3: termination enable - OPEN; SolderJumper-2_P1.3mm_Open_Pad1.0x1.5mm
U103: ISOW1432DFMR RS-LARM; SOIC-20W_7.5x12.8mm_P1.27mm

Connections:
CTRL_3V3: C3C.1, U103.1; also elsewhere on the board
CTRL_5V: C3A.1, C3B.1, U103.9; also elsewhere on the board
CTRL_GND: C3A.2, C3B.2, C3C.2, U103.6, U103.10; also elsewhere on the board
RS-LARM_DN: D3RS.2, J103.3, SJ3.2, U103.18, U103.19
RS-LARM_DP: D3RS.1, J103.2, RT3.1, U103.17, U103.20
RS-LARM_GND2: C3D.2, FB3N.1, U103.11, U103.13
RS-LARM_RET: C3E.2, D3RS.3, FB3N.2, J103.1, U103.14, U103.15
RS-LARM_TERM: RT3.2, SJ3.1
RS-LARM_VISOIN: C3E.1, FB3P.2, U103.16
RS-LARM_VISOOUT: C3D.1, FB3P.1, U103.12
UART_RS-LARM_DIR: U103.3, U103.5; also elsewhere on the board
UART_RS-LARM_RX: U103.4; also elsewhere on the board
UART_RS-LARM_TX: U103.2; also elsewhere on the board

Notes on the sheet:
PRELIMINARY - NOT APPROVED FOR PROCUREMENT, FABRICATION, ASSEMBLY, CONNECTION, MOTION OR ENERGIZATION
04 Carrier A - RS-LARM
Full ISOW1432 application network: decoupling, two isolated-power ferrites, TVS and selectable 120-ohm termination.
W4001
W4002
W4003
W4004
W4005
W4006
W4007
W4008
W4009
W4010
W4011
W4012
W4013
W4014
W4015
W4016
W4017
W4018
W4019
W4020
W4021
W4022
W4023
W4024
W4025
W4026
W4027
W4028
W4029
W4030
W4031
W4032
W4033
W4034
W4035
W4036
W4037
W4038
W4039
W4040
W4041
W4042
NOTE 1: Full ISOW1432 application network: decoupling, two isolated-power ferrites, TVS and
selectable 120-ohm termination.
NOTE 2: DNP/open configuration items are not permission to populate without the
configuration record.
NOTE 3: PRELIMINARY - NOT APPROVED FOR PROCUREMENT, FABRICATION, ASSEMBLY, CONNECTION,
MOTION OR ENERGIZATION
