amyleesterling/humanoid-robot/hr30/whole-body-p0.1/electrical/carriers-p0.1/carrier-a/hr30-carrier-a-p0.1.kicad_pcb

## KiCad design hr30/whole-body-p0.1/electrical/carriers-p0.1/carrier-a/hr30-carrier-a-p0.1.kicad_pcb (continued)

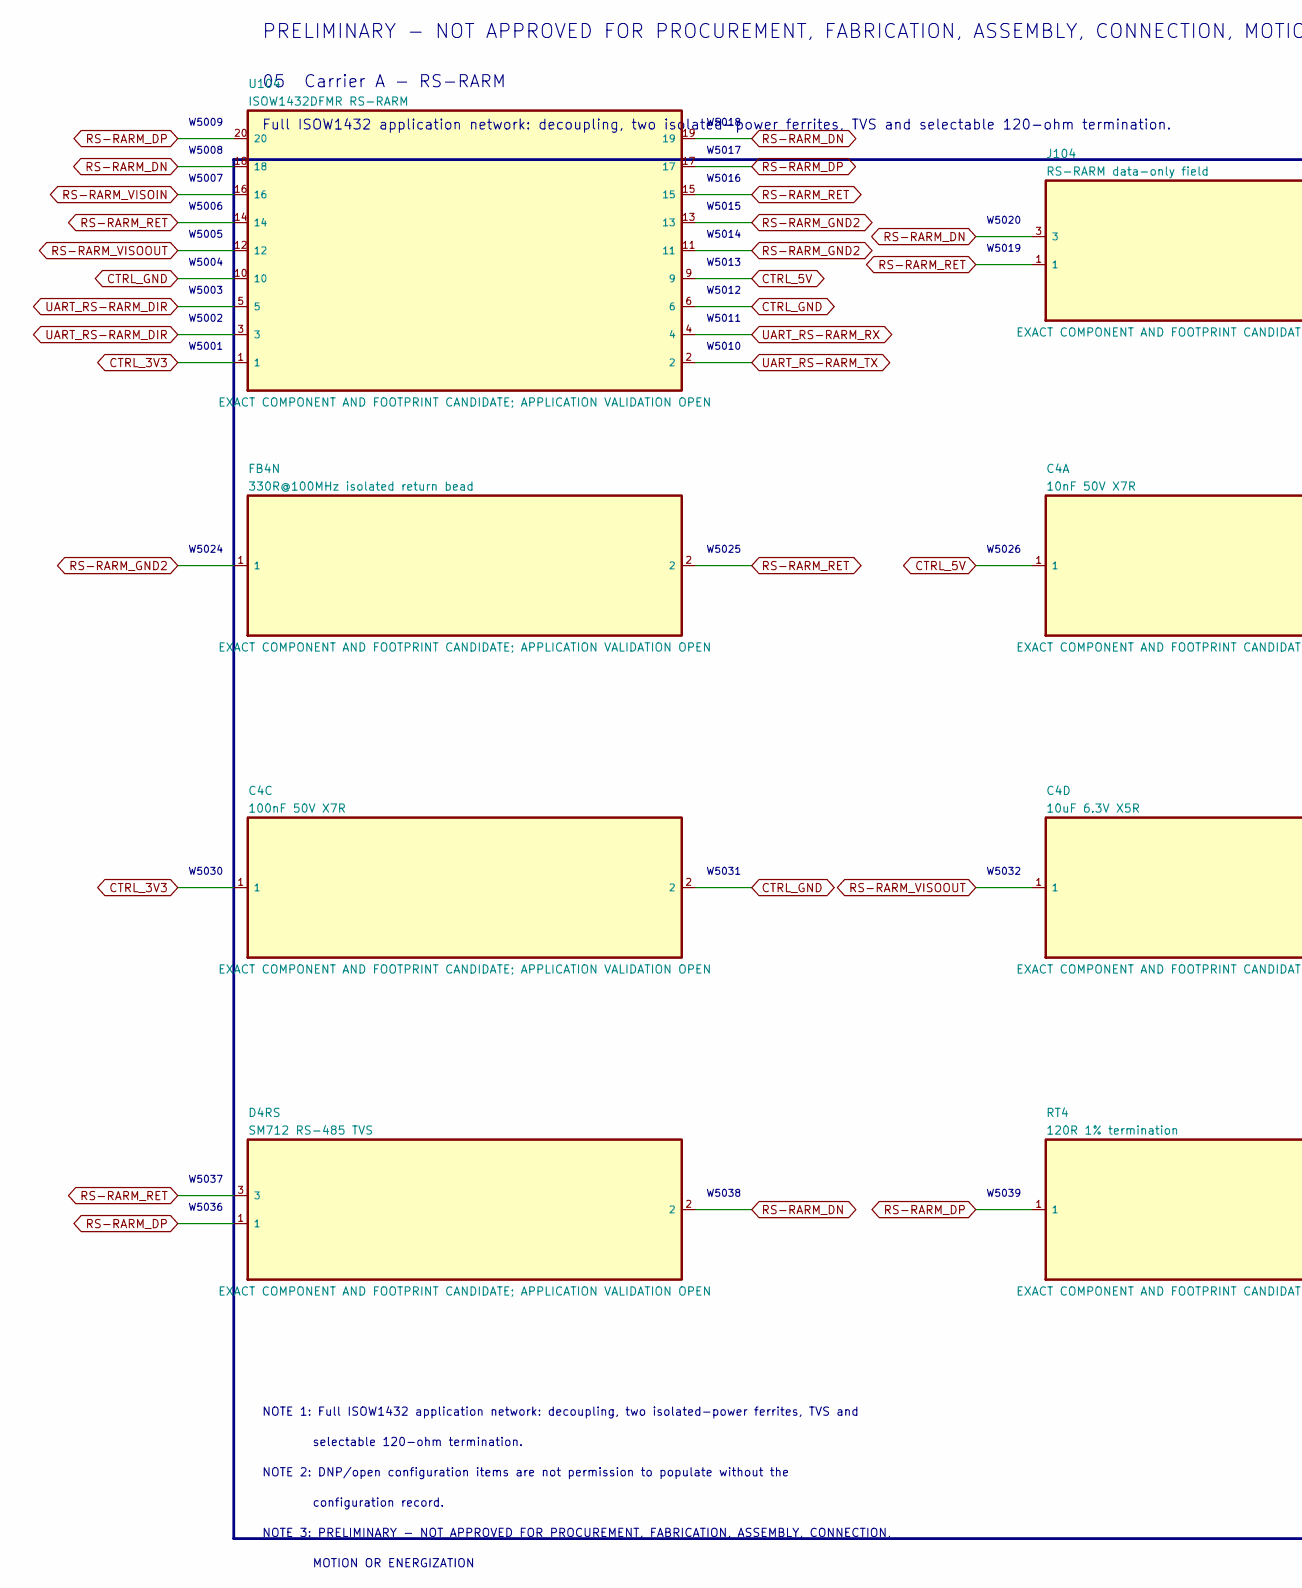
[picture p341: schematic 05_rs_rarm.kicad_sch, PB HR-V0 P0.1 - 05, part in row 1, column 1]

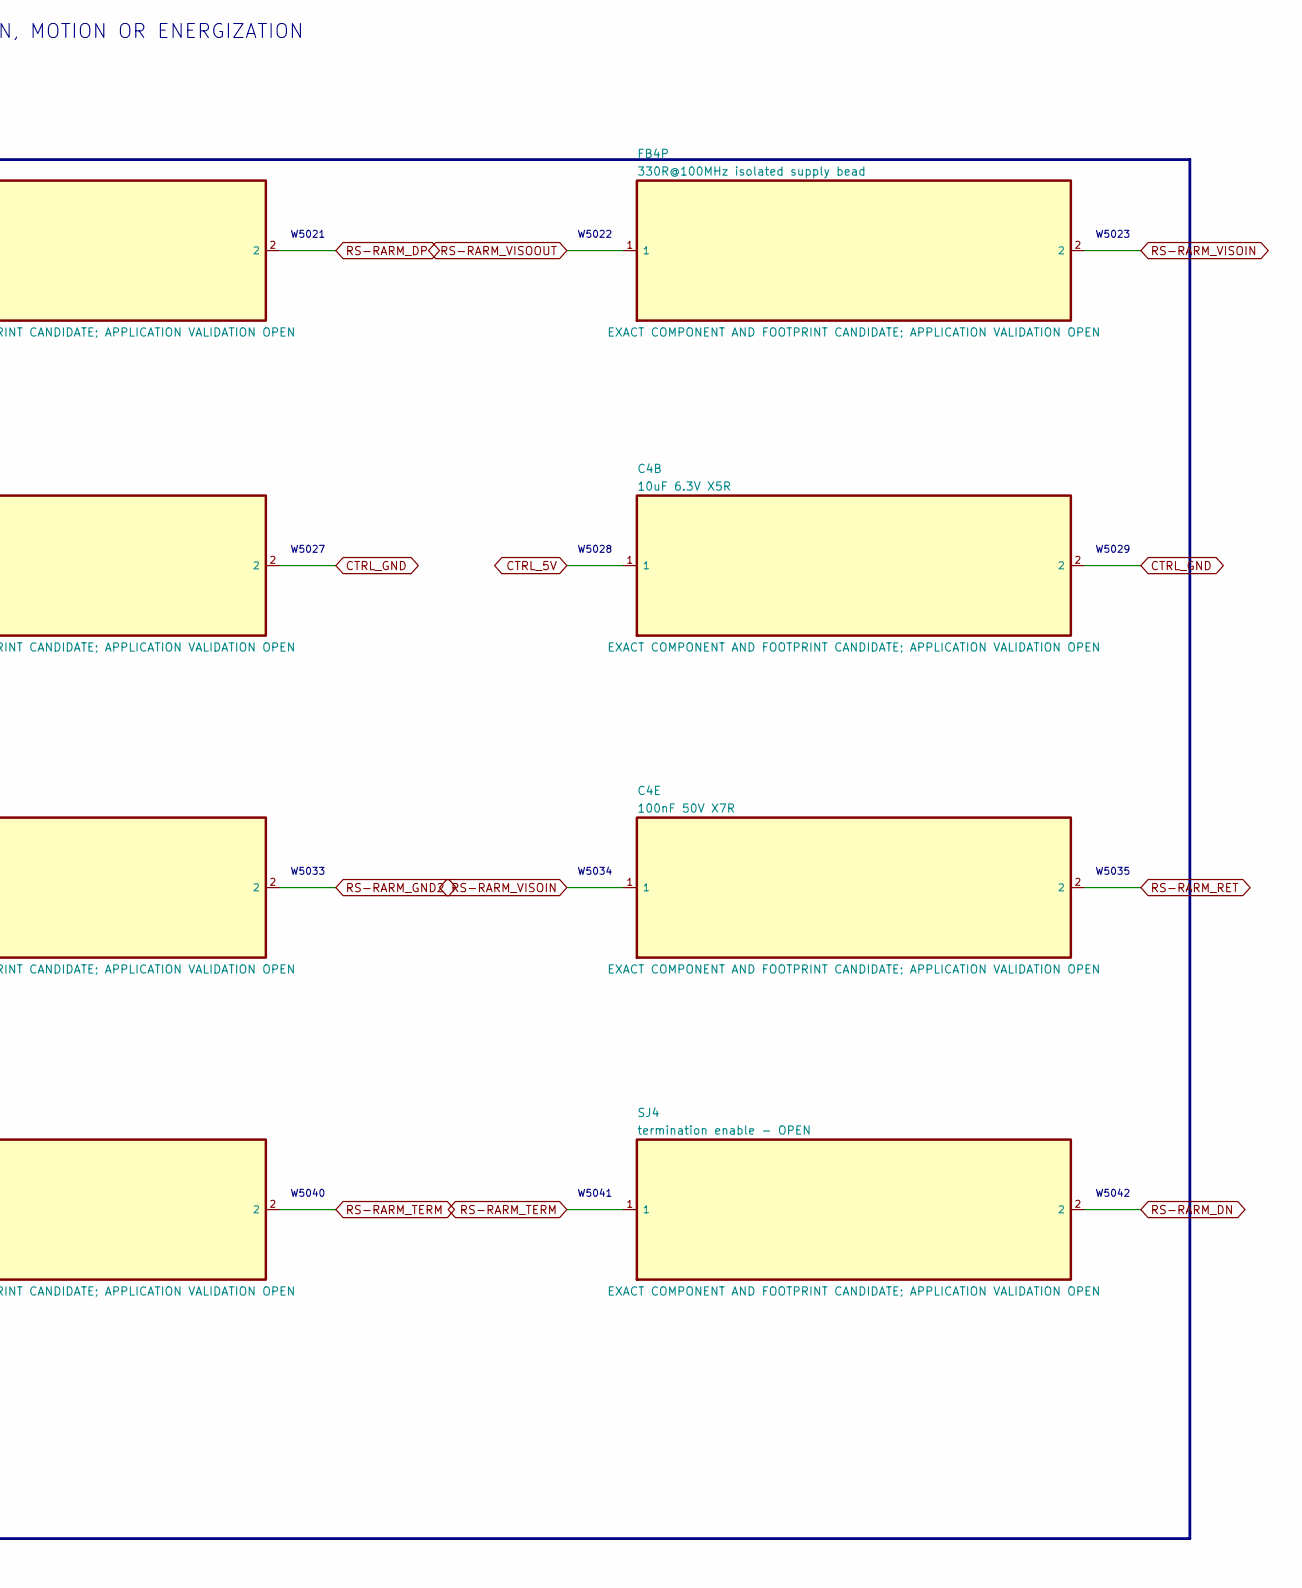
[picture p342: schematic 05_rs_rarm.kicad_sch, PB HR-V0 P0.1 - 05, part in row 1, column 2]

Parts:
C4A: 10nF 50V X7R; C_0603_1608Metric
C4B, C4D: 10uF 6.3V X5R; C_0603_1608Metric
C4C, C4E: 100nF 50V X7R; C_0603_1608Metric
D4RS: SM712 RS-485 TVS; SOT-23
FB4N: 330R@100MHz isolated return bead; L_0402_1005Metric
FB4P: 330R@100MHz isolated supply bead; L_0402_1005Metric
J104: RS-RARM data-only field; JST_GH_BM03B-GHS-TBT_1x03-1MP_P1.25mm_Vertical
RT4: 120R 1% termination; R_0603_1608Metric
SJ4: termination enable - OPEN; SolderJumper-2_P1.3mm_Open_Pad1.0x1.5mm
U104: ISOW1432DFMR RS-RARM; SOIC-20W_7.5x12.8mm_P1.27mm

Connections:
CTRL_3V3: C4C.1, U104.1; also elsewhere on the board
CTRL_5V: C4A.1, C4B.1, U104.9; also elsewhere on the board
CTRL_GND: C4A.2, C4B.2, C4C.2, U104.6, U104.10; also elsewhere on the board
RS-RARM_DN: D4RS.2, J104.3, SJ4.2, U104.18, U104.19
RS-RARM_DP: D4RS.1, J104.2, RT4.1, U104.17, U104.20
RS-RARM_GND2: C4D.2, FB4N.1, U104.11, U104.13
RS-RARM_RET: C4E.2, D4RS.3, FB4N.2, J104.1, U104.14, U104.15
RS-RARM_TERM: RT4.2, SJ4.1
RS-RARM_VISOIN: C4E.1, FB4P.2, U104.16
RS-RARM_VISOOUT: C4D.1, FB4P.1, U104.12
UART_RS-RARM_DIR: U104.3, U104.5; also elsewhere on the board
UART_RS-RARM_RX: U104.4; also elsewhere on the board
UART_RS-RARM_TX: U104.2; also elsewhere on the board

Notes on the sheet:
PRELIMINARY - NOT APPROVED FOR PROCUREMENT, FABRICATION, ASSEMBLY, CONNECTION, MOTION OR ENERGIZATION
05 Carrier A - RS-RARM
Full ISOW1432 application network: decoupling, two isolated-power ferrites, TVS and selectable 120-ohm termination.
W5001
W5002
W5003
W5004
W5005
W5006
W5007
W5008
W5009
W5010
W5011
W5012
W5013
W5014
W5015
W5016
W5017
W5018
W5019
W5020
W5021
W5022
W5023
W5024
W5025
W5026
W5027
W5028
W5029
W5030
W5031
W5032
W5033
W5034
W5035
W5036
W5037
W5038
W5039
W5040
W5041
W5042
NOTE 1: Full ISOW1432 application network: decoupling, two isolated-power ferrites, TVS and
selectable 120-ohm termination.
NOTE 2: DNP/open configuration items are not permission to populate without the
configuration record.
NOTE 3: PRELIMINARY - NOT APPROVED FOR PROCUREMENT, FABRICATION, ASSEMBLY, CONNECTION,
MOTION OR ENERGIZATION

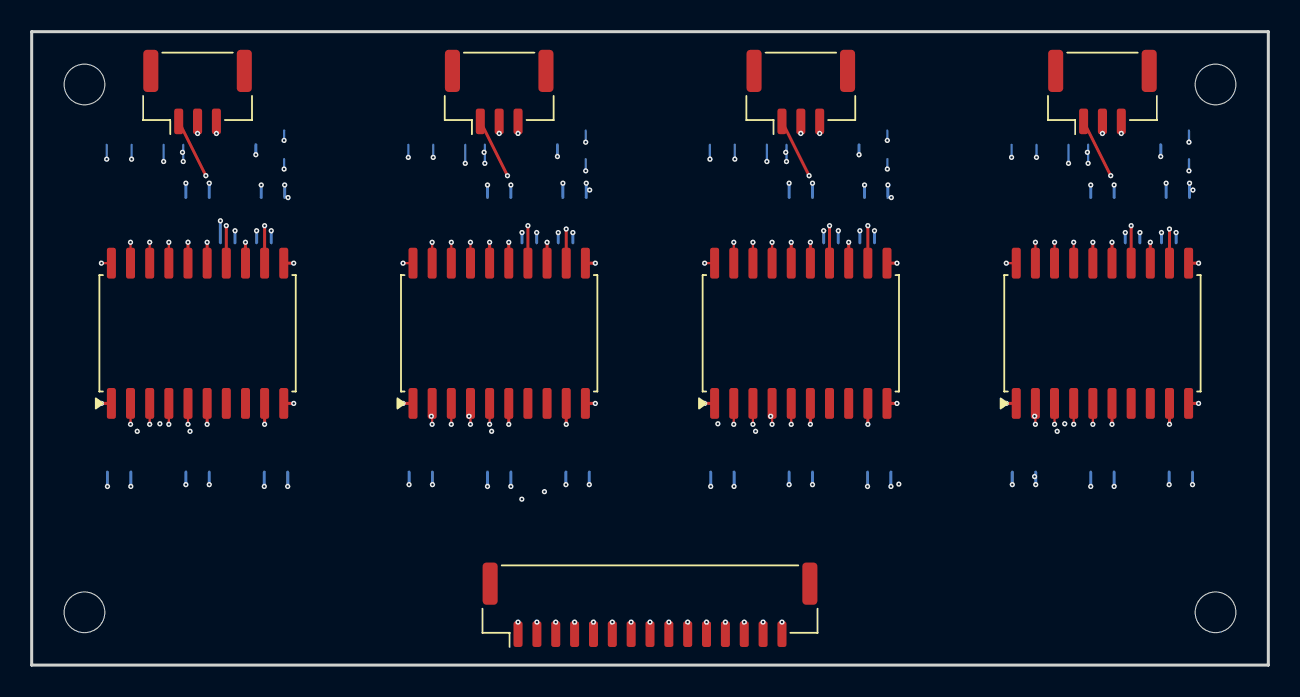
[picture p343: board hr30-carrier-a-p0.1.kicad_pcb from above]

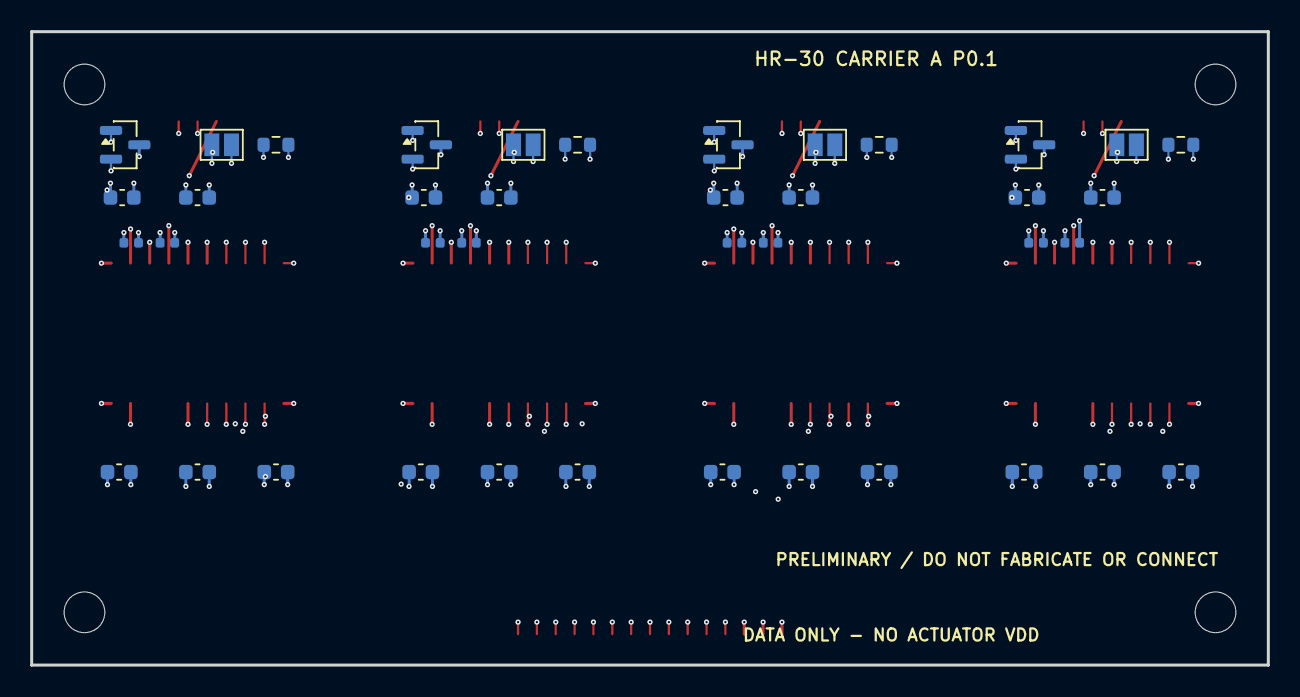
[picture p344: board hr30-carrier-a-p0.1.kicad_pcb from below]

Board: 6 copper layers, 82.0 x 42.0 mm, 53 parts (40 on the bottom side), 43 nets.

Other parts of the board:
JCA1: JST BM15B-GHS-TBT controller; JST_GH_BM15B-GHS-TBT_1x15-1MP_P1.25mm_Vertical
MHA1, MHA2, MHA3, MHA4: M2.5 BOARD-ONLY; TRAY STACK VALIDATION OPEN; MountingHole_2.7mm_M2.5

Their connections:
CTRL_3V3: JCA1.3; also elsewhere on the board
CTRL_5V: JCA1.2; also elsewhere on the board
CTRL_GND: JCA1.1; also elsewhere on the board
UART_RS-LARM_DIR: JCA1.12; also elsewhere on the board
UART_RS-LARM_RX: JCA1.11; also elsewhere on the board
UART_RS-LARM_TX: JCA1.10; also elsewhere on the board
UART_RS-LLEG_DIR: JCA1.6; also elsewhere on the board
UART_RS-LLEG_RX: JCA1.5; also elsewhere on the board
UART_RS-LLEG_TX: JCA1.4; also elsewhere on the board
UART_RS-RARM_DIR: JCA1.15; also elsewhere on the board
UART_RS-RARM_RX: JCA1.14; also elsewhere on the board
UART_RS-RARM_TX: JCA1.13; also elsewhere on the board
UART_RS-RLEG_DIR: JCA1.9; also elsewhere on the board
UART_RS-RLEG_RX: JCA1.8; also elsewhere on the board
UART_RS-RLEG_TX: JCA1.7; also elsewhere on the board
