amyleesterling/humanoid-robot/hr30/whole-body-p0.1/electrical/swd-adapter-p0.1/board/hr30-swd-adapter-p0.1.kicad_pcb

## KiCad design hr30/whole-body-p0.1/electrical/swd-adapter-p0.1/board/hr30-swd-adapter-p0.1.kicad_pcb (2026-08-17)

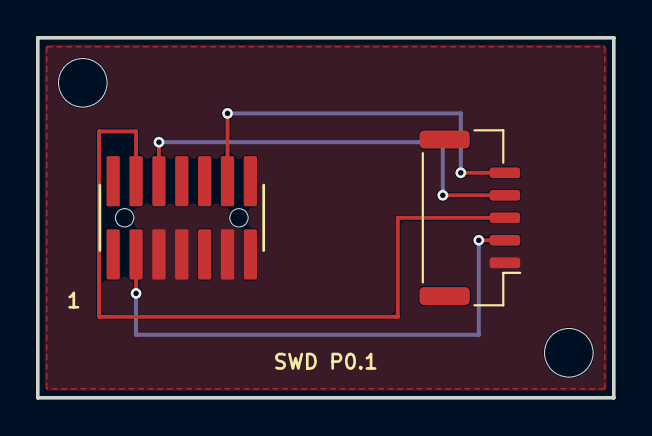
[picture p345: board hr30-swd-adapter-p0.1.kicad_pcb from above]

Board: 2 copper layers, 32.0 x 20.0 mm, 4 parts (0 on the bottom side), 5 nets.

Parts:
H1, H2: M2.5 FIXTURE HOLE - MECHANICAL VALIDATION OPEN; MountingHole_2.7mm_M2.5
J1: FTSH-107-01-L-DV-K-A
J2: BM05B-GHS-TBT; JST_GH_BM05B-GHS-TBT_1x05-1MP_P1.25mm_Vertical

Connections:
CTRL_3V3: J1.3, J2.2
CTRL_GND: J1.5, J1.7, J1.11, J2.1
MCU_NRST: J1.12, J2.5
SWCLK: J1.6, J2.4
SWDIO: J1.4, J2.3
