amyleesterling/humanoid-robot/hr30/whole-body-p0.1/electrical/motion-controller-p0.1/board/hr30-motion-controller-p0.1.kicad_pcb

## KiCad design hr30/whole-body-p0.1/electrical/motion-controller-p0.1/board/hr30-motion-controller-p0.1.kicad_pcb (2026-08-17)

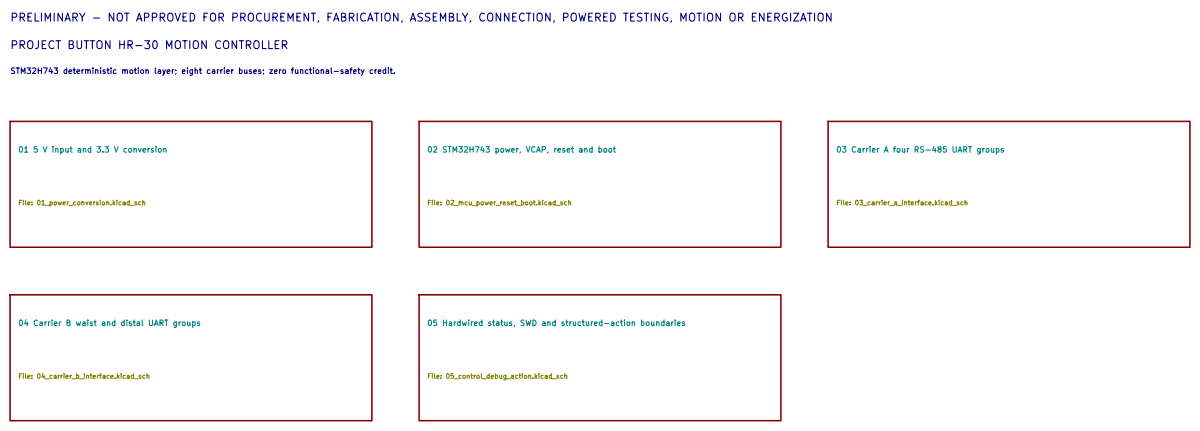
[picture p346: schematic hr30-motion-controller-p0.1.kicad_sch, PROJECT BUTTON HR-30 MOTION CONTROLLER index]

Notes on the sheet:
PRELIMINARY - NOT APPROVED FOR PROCUREMENT, FABRICATION, ASSEMBLY, CONNECTION, POWERED TESTING, MOTION OR ENERGIZATION
PROJECT BUTTON HR-30 MOTION CONTROLLER
STM32H743 deterministic motion layer; eight carrier buses; zero functional-safety credit.

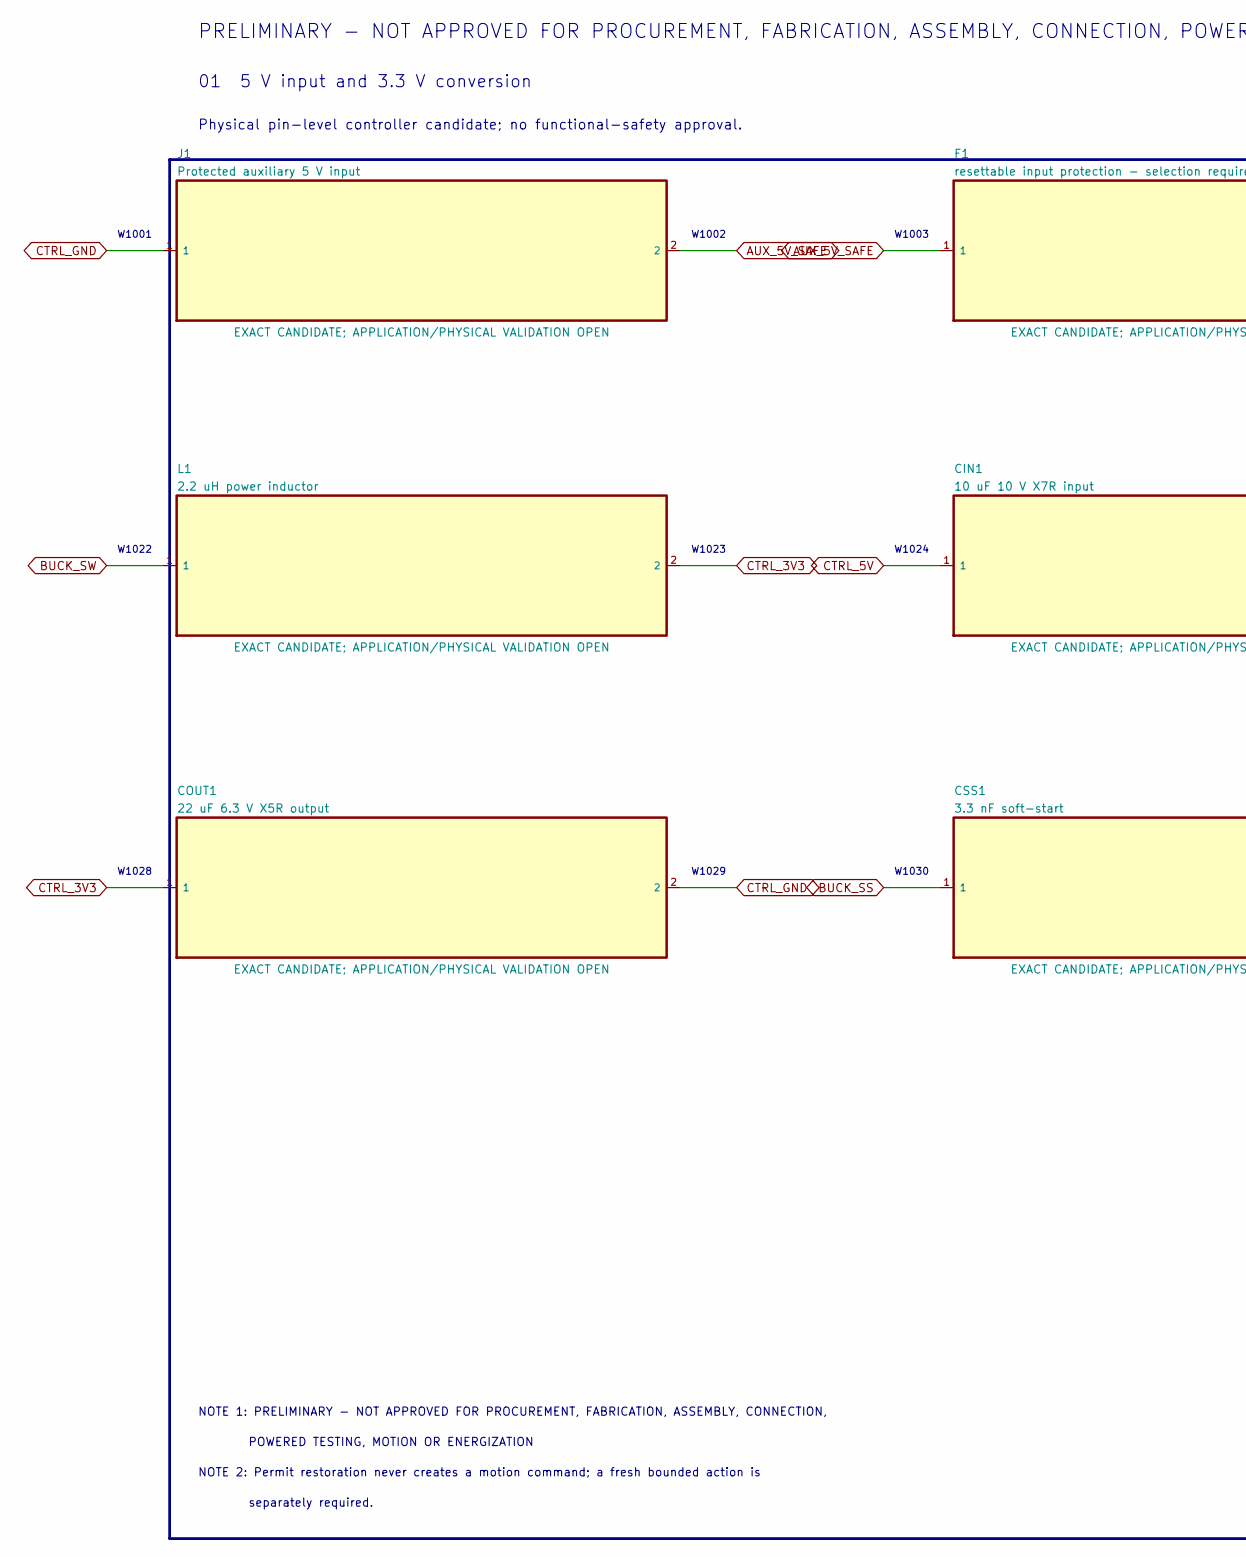
[picture p347: schematic 01_power_conversion.kicad_sch, PB HR-V0 P0.1 - 01, part in row 1, column 1]

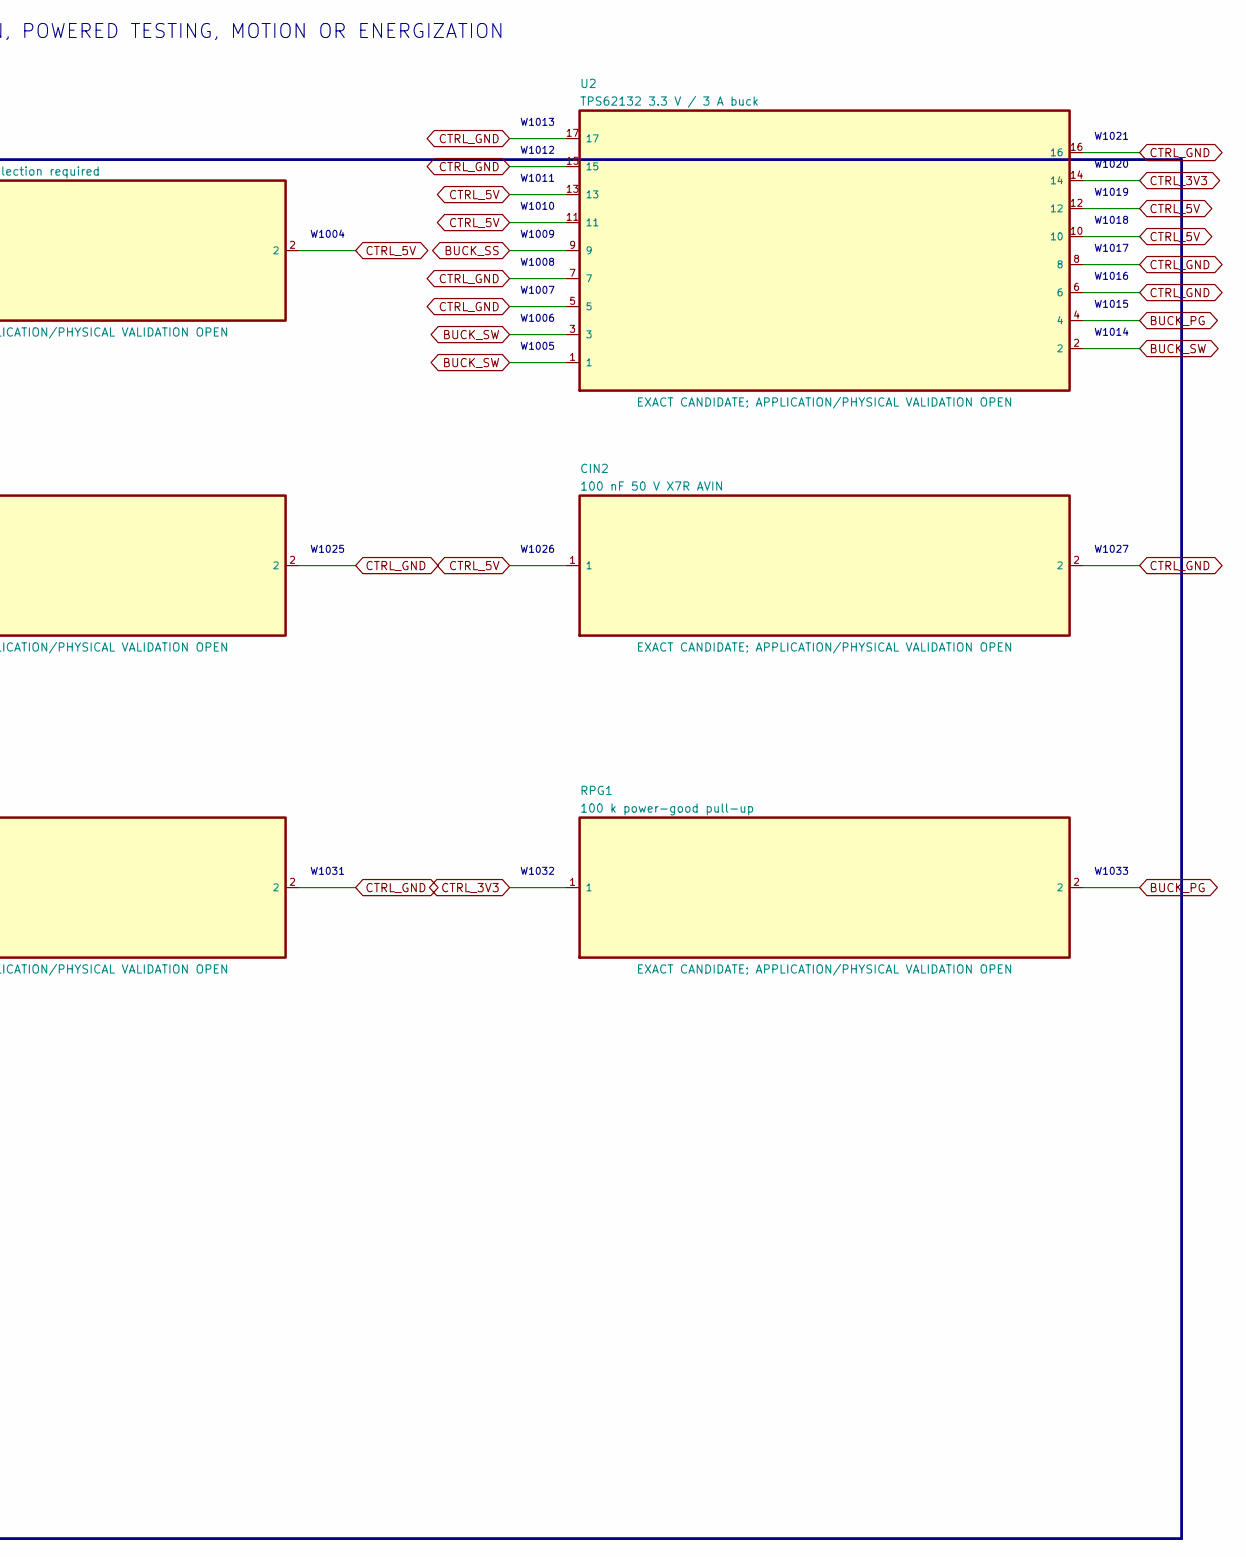
[picture p348: schematic 01_power_conversion.kicad_sch, PB HR-V0 P0.1 - 01, part in row 1, column 2]

Parts:
CIN1: 10 uF 10 V X7R input; C_0805_2012Metric
CIN2: 100 nF 50 V X7R AVIN; C_0603_1608Metric
COUT1: 22 uF 6.3 V X5R output; C_0805_2012Metric
CSS1: 3.3 nF soft-start; C_0603_1608Metric
F1: resettable input protection - selection required; Fuse_1206_3216Metric
J1: Protected auxiliary 5 V input; JST_VH_B2P-VH-B_1x02_P3.96mm_Vertical
L1: 2.2 uH power inductor; L_Coilcraft_XAL5030-XXX
RPG1: 100 k power-good pull-up; R_0603_1608Metric
U2: TPS62132 3.3 V / 3 A buck; VQFN-16-1EP_3x3mm_P0.5mm_EP1.45x1.45mm_ThermalVias

Connections:
AUX_5V_SAFE: F1.1, J1.2
BUCK_PG: RPG1.2, U2.4
BUCK_SS: CSS1.1, U2.9
BUCK_SW: L1.1, U2.1, U2.2, U2.3
CTRL_3V3: COUT1.1, L1.2, RPG1.1, U2.14; also elsewhere on the board
CTRL_5V: CIN1.1, CIN2.1, F1.2, U2.10, U2.11, U2.12, U2.13; also elsewhere on the board
CTRL_GND: CIN1.2, CIN2.2, COUT1.2, CSS1.2, J1.1, U2.5, U2.6, U2.7, U2.8, U2.15, U2.16, U2.17; also elsewhere on the board

Notes on the sheet:
PRELIMINARY - NOT APPROVED FOR PROCUREMENT, FABRICATION, ASSEMBLY, CONNECTION, POWERED TESTING, MOTION OR ENERGIZATION
01 5 V input and 3.3 V conversion
Physical pin-level controller candidate; no functional-safety approval.
W1001
W1002
W1003
W1004
W1005
W1006
W1007
W1008
W1009
W1010
W1011
W1012
W1013
W1014
W1015
W1016
W1017
W1018
W1019
W1020
W1021
W1022
W1023
W1024
W1025
W1026
W1027
W1028
W1029
W1030
W1031
W1032
W1033
NOTE 1: PRELIMINARY - NOT APPROVED FOR PROCUREMENT, FABRICATION, ASSEMBLY, CONNECTION,
POWERED TESTING, MOTION OR ENERGIZATION
NOTE 2: Permit restoration never creates a motion command; a fresh bounded action is
separately required.
