amyleesterling/humanoid-robot/hr30/whole-body-p0.1/electrical/motion-controller-p0.1/board/hr30-motion-controller-p0.1.kicad_pcb

## KiCad design hr30/whole-body-p0.1/electrical/motion-controller-p0.1/board/hr30-motion-controller-p0.1.kicad_pcb (continued)

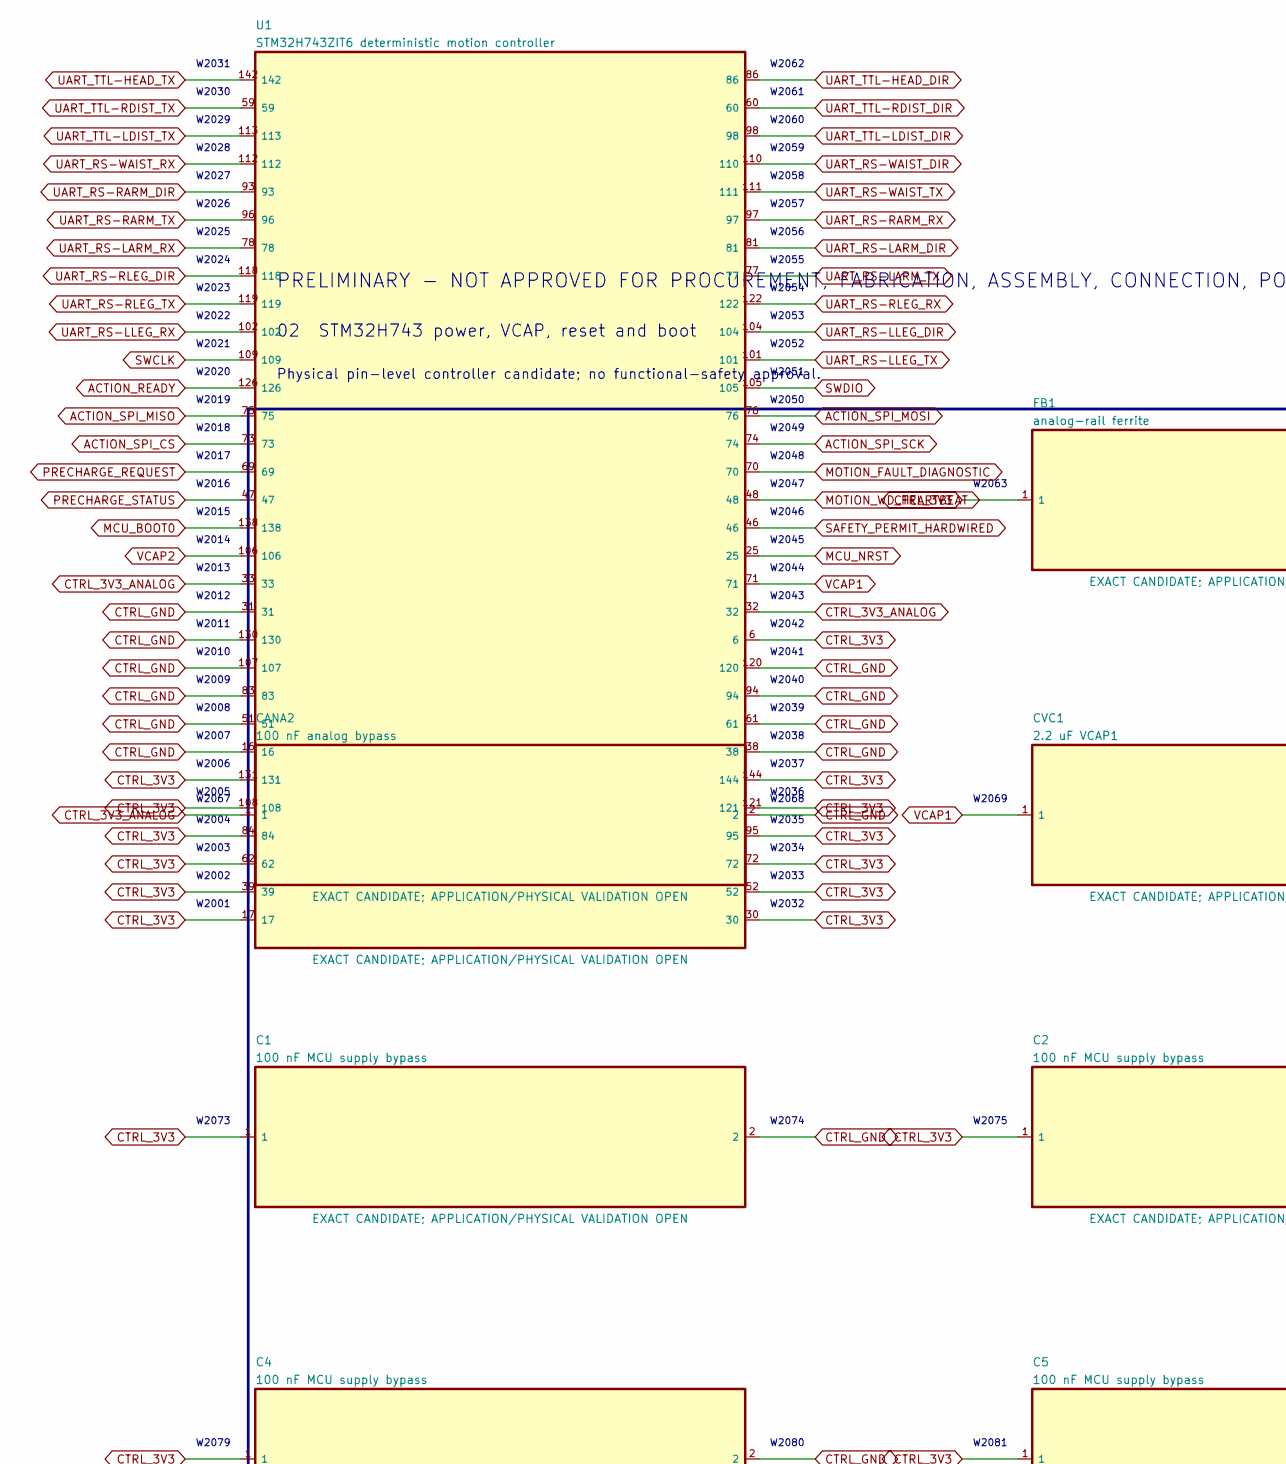
[picture p349: schematic 02_mcu_power_reset_boot.kicad_sch, PB HR-V0 P0.1 - 02, part in row 1, column 1]

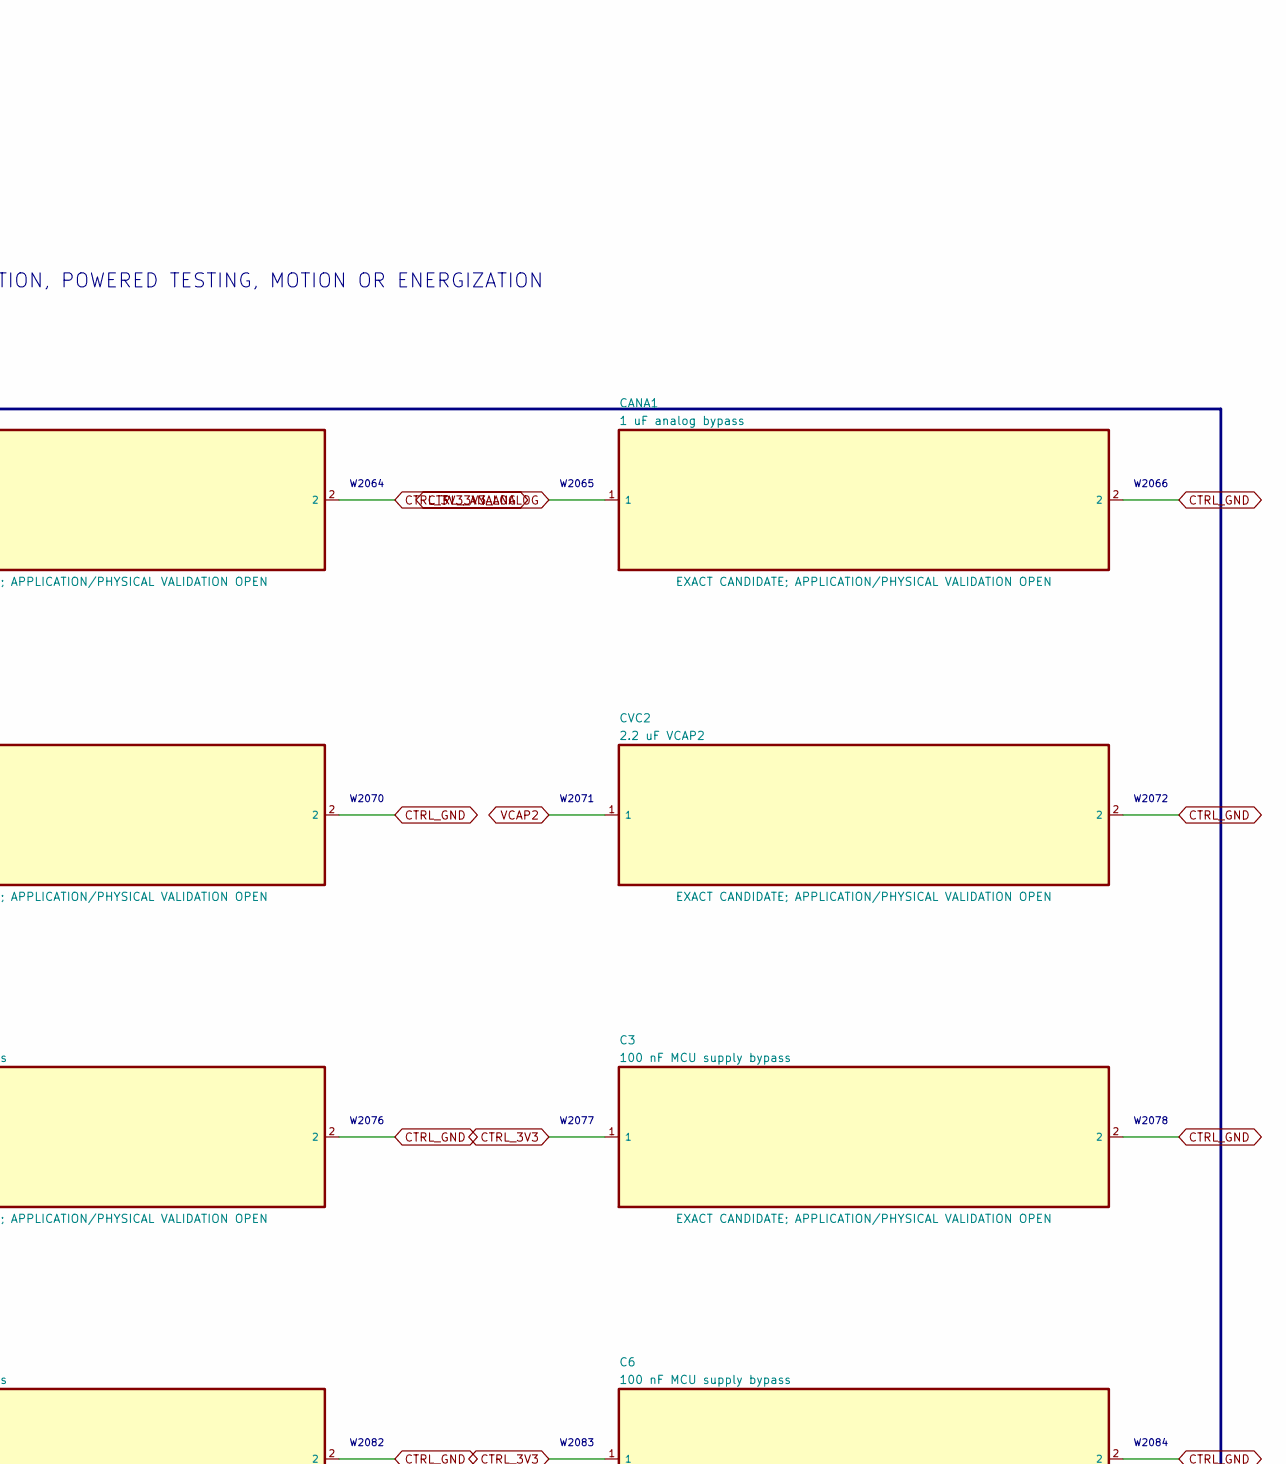
[picture p350: schematic 02_mcu_power_reset_boot.kicad_sch, PB HR-V0 P0.1 - 02, part in row 1, column 2]

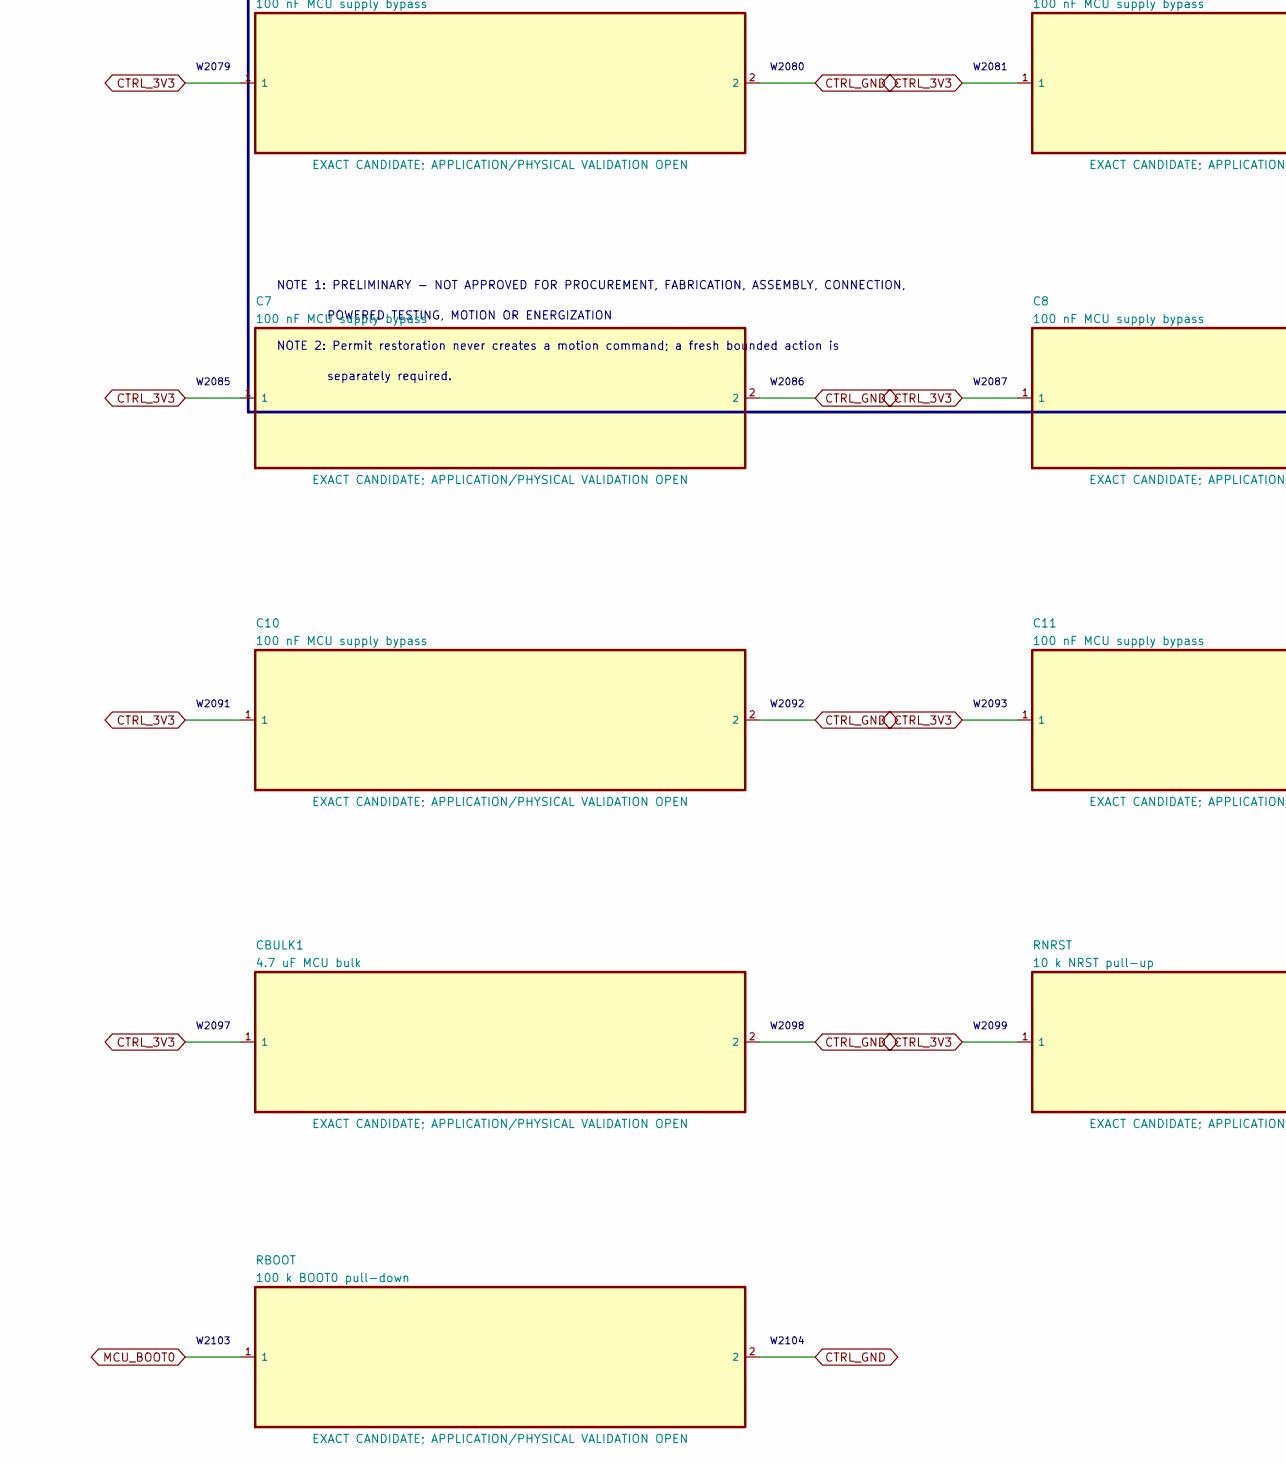
[picture p351: schematic 02_mcu_power_reset_boot.kicad_sch, PB HR-V0 P0.1 - 02, part in row 2, column 1]

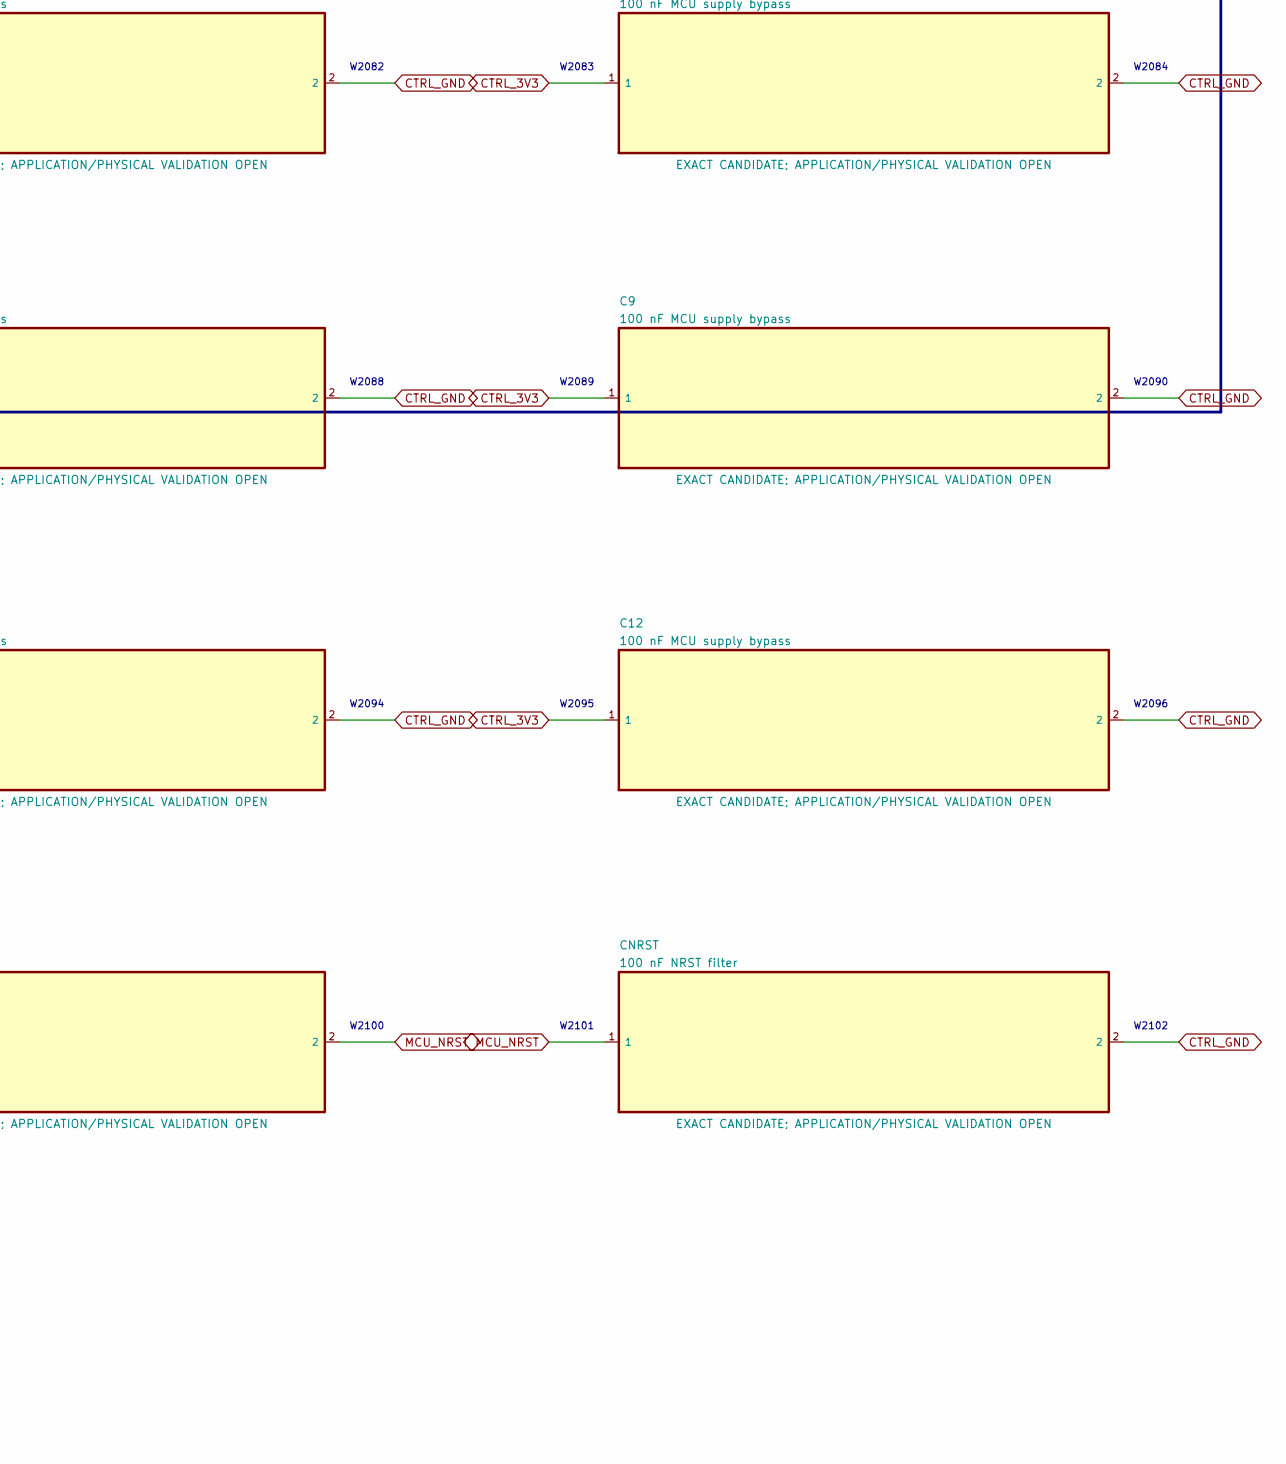
[picture p352: schematic 02_mcu_power_reset_boot.kicad_sch, PB HR-V0 P0.1 - 02, part in row 2, column 2]

Parts:
C1, C2, C3, C4, C5, C6, C7, C8, C9, C10, C11, C12: 100 nF MCU supply bypass; C_0402_1005Metric
CANA1: 1 uF analog bypass; C_0603_1608Metric
CANA2: 100 nF analog bypass; C_0603_1608Metric
CBULK1: 4.7 uF MCU bulk; C_0603_1608Metric
CNRST: 100 nF NRST filter; C_0603_1608Metric
CVC1: 2.2 uF VCAP1; C_0603_1608Metric
CVC2: 2.2 uF VCAP2; C_0603_1608Metric
FB1: analog-rail ferrite; L_0603_1608Metric
RBOOT: 100 k BOOT0 pull-down; R_0603_1608Metric
RNRST: 10 k NRST pull-up; R_0603_1608Metric
U1: STM32H743ZIT6 deterministic motion controller; LQFP-144_20x20mm_P0.5mm

Connections:
ACTION_READY: U1.126; also elsewhere on the board
ACTION_SPI_CS: U1.73; also elsewhere on the board
ACTION_SPI_MISO: U1.75; also elsewhere on the board
ACTION_SPI_MOSI: U1.76; also elsewhere on the board
ACTION_SPI_SCK: U1.74; also elsewhere on the board
CTRL_3V3: C1.1, C2.1, C3.1, C4.1, C5.1, C6.1, C7.1, C8.1, C9.1, C10.1, C11.1, C12.1, CBULK1.1, FB1.1, RNRST.1, U1.6, U1.17, U1.30, U1.39, U1.52, U1.62, U1.72, U1.84, U1.95, U1.108, U1.121, U1.131, U1.144; also elsewhere on the board
CTRL_3V3_ANALOG: CANA1.1, CANA2.1, FB1.2, U1.32, U1.33
CTRL_GND: C1.2, C2.2, C3.2, C4.2, C5.2, C6.2, C7.2, C8.2, C9.2, C10.2, C11.2, C12.2, CANA1.2, CANA2.2, CBULK1.2, CNRST.2, CVC1.2, CVC2.2, RBOOT.2, U1.16, U1.31, U1.38, U1.51, U1.61, U1.83, U1.94, U1.107, U1.120, U1.130; also elsewhere on the board
MCU_BOOT0: RBOOT.1, U1.138
MCU_NRST: CNRST.1, RNRST.2, U1.25; also elsewhere on the board
MOTION_FAULT_DIAGNOSTIC: U1.70; also elsewhere on the board
MOTION_WD_HEARTBEAT: U1.48; also elsewhere on the board
PRECHARGE_REQUEST: U1.69; also elsewhere on the board
PRECHARGE_STATUS: U1.47; also elsewhere on the board
SAFETY_PERMIT_HARDWIRED: U1.46; also elsewhere on the board
SWCLK: U1.109; also elsewhere on the board
SWDIO: U1.105; also elsewhere on the board
UART_RS-LARM_DIR: U1.81; also elsewhere on the board
UART_RS-LARM_RX: U1.78; also elsewhere on the board
UART_RS-LARM_TX: U1.77; also elsewhere on the board
UART_RS-LLEG_DIR: U1.104; also elsewhere on the board
UART_RS-LLEG_RX: U1.102; also elsewhere on the board
UART_RS-LLEG_TX: U1.101; also elsewhere on the board
UART_RS-RARM_DIR: U1.93; also elsewhere on the board
UART_RS-RARM_RX: U1.97; also elsewhere on the board
UART_RS-RARM_TX: U1.96; also elsewhere on the board
UART_RS-RLEG_DIR: U1.118; also elsewhere on the board
UART_RS-RLEG_RX: U1.122; also elsewhere on the board
UART_RS-RLEG_TX: U1.119; also elsewhere on the board
UART_RS-WAIST_DIR: U1.110; also elsewhere on the board
UART_RS-WAIST_RX: U1.112; also elsewhere on the board
UART_RS-WAIST_TX: U1.111; also elsewhere on the board
UART_TTL-HEAD_DIR: U1.86; also elsewhere on the board
UART_TTL-HEAD_TX: U1.142; also elsewhere on the board
UART_TTL-LDIST_DIR: U1.98; also elsewhere on the board
UART_TTL-LDIST_TX: U1.113; also elsewhere on the board
UART_TTL-RDIST_DIR: U1.60; also elsewhere on the board
UART_TTL-RDIST_TX: U1.59; also elsewhere on the board
VCAP1: CVC1.1, U1.71
VCAP2: CVC2.1, U1.106

Notes on the sheet:
PRELIMINARY - NOT APPROVED FOR PROCUREMENT, FABRICATION, ASSEMBLY, CONNECTION, POWERED TESTING, MOTION OR ENERGIZATION
02 STM32H743 power, VCAP, reset and boot
Physical pin-level controller candidate; no functional-safety approval.
W2001
W2002
W2003
W2004
W2005
W2006
W2007
W2008
W2009
W2010
W2011
W2012
W2013
W2014
W2015
W2016
W2017
W2018
W2019
W2020
W2021
W2022
W2023
W2024
W2025
W2026
W2027
W2028
W2029
W2030
W2031
W2032
W2033
W2034
W2035
W2036
W2037
W2038
W2039
W2040
W2041
W2042
W2043
W2044
W2045
W2046
W2047
W2048
W2049
W2050
W2051
W2052
W2053
W2054
W2055
W2056
W2057
W2058
W2059
W2060
W2061
W2062
W2063
W2064
W2065
W2066
W2067
W2068
W2069
W2070
W2071
W2072
W2073
W2074
W2075
W2076
W2077
W2078
W2079
W2080
W2081
W2082
W2083
W2084
W2085
W2086
W2087
W2088
W2089
W2090
W2091
W2092
W2093
W2094
W2095
W2096
W2097
W2098
W2099
W2100
W2101
W2102
W2103
W2104
NOTE 1: PRELIMINARY - NOT APPROVED FOR PROCUREMENT, FABRICATION, ASSEMBLY, CONNECTION,
POWERED TESTING, MOTION OR ENERGIZATION
NOTE 2: Permit restoration never creates a motion command; a fresh bounded action is
separately required.

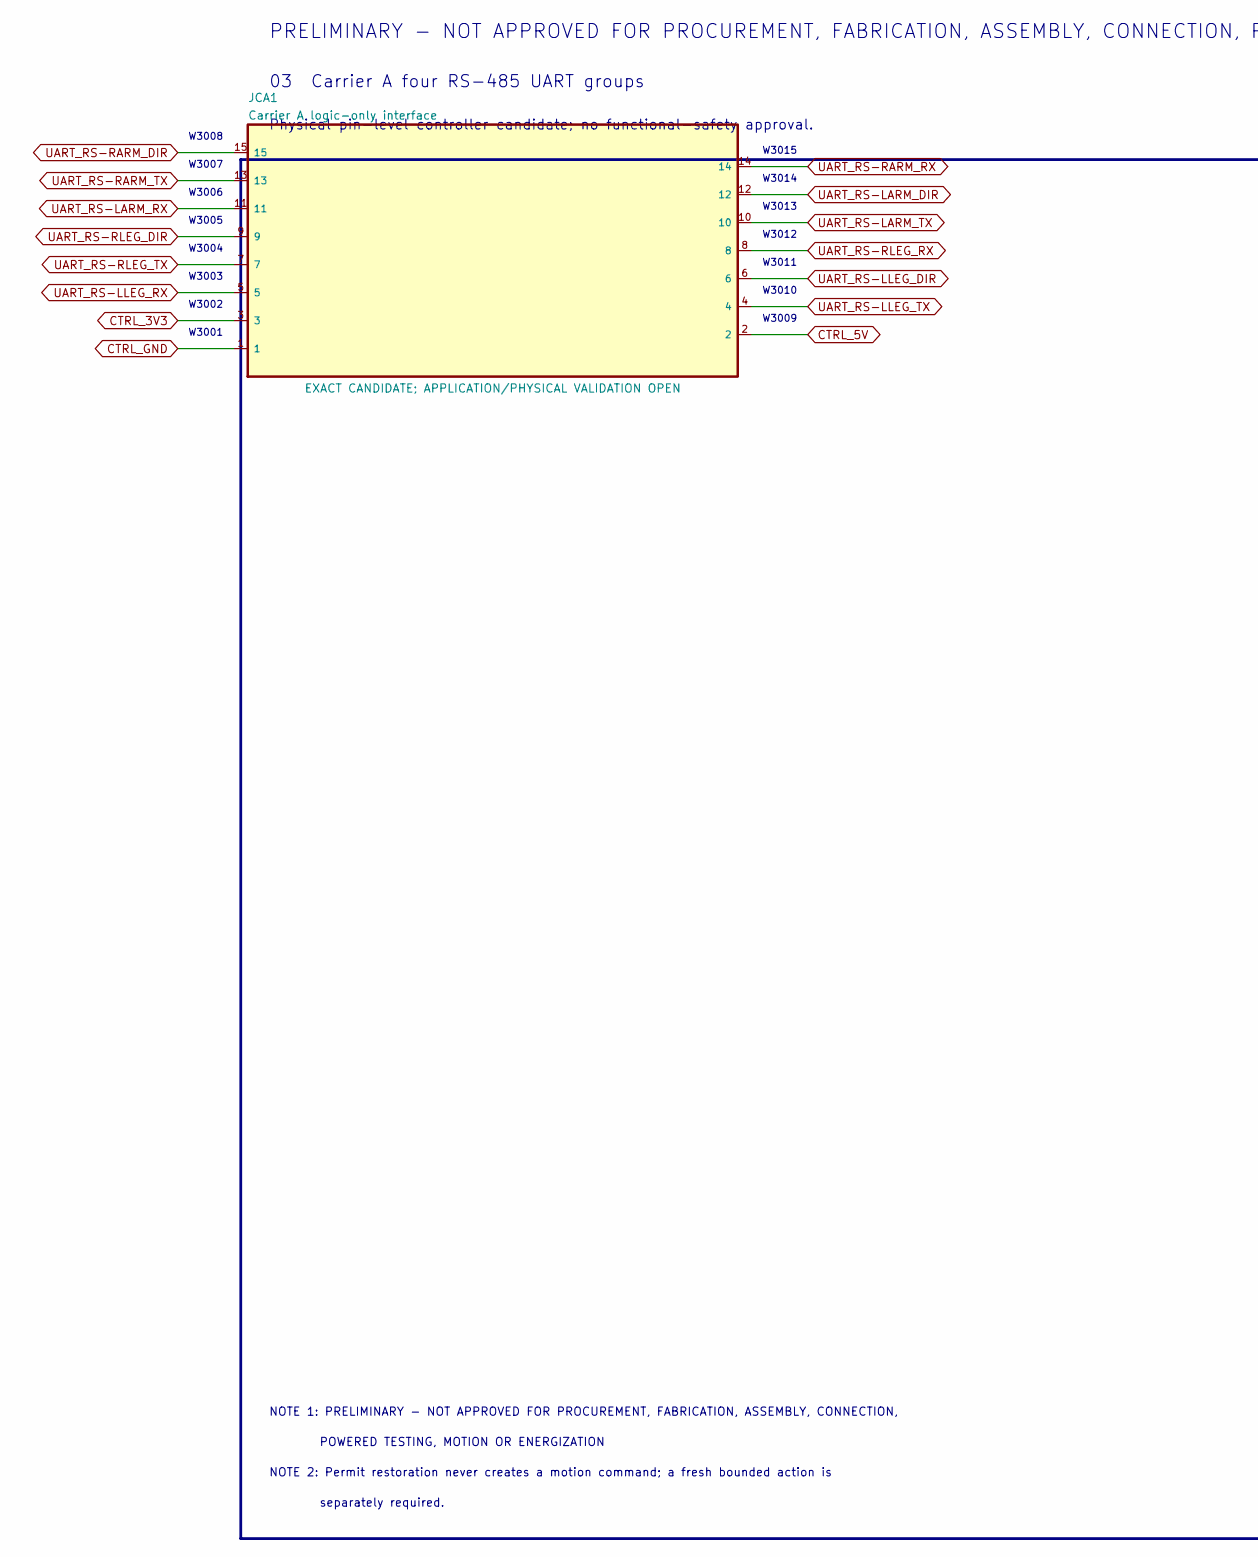
[picture p353: schematic 03_carrier_a_interface.kicad_sch, PB HR-V0 P0.1 - 03, part in row 1, column 1]

Parts:
JCA1: Carrier A logic-only interface; JST_GH_BM15B-GHS-TBT_1x15-1MP_P1.25mm_Vertical

Connections:
CTRL_3V3: JCA1.3; also elsewhere on the board
CTRL_5V: JCA1.2; also elsewhere on the board
CTRL_GND: JCA1.1; also elsewhere on the board
UART_RS-LARM_DIR: JCA1.12; also elsewhere on the board
UART_RS-LARM_RX: JCA1.11; also elsewhere on the board
UART_RS-LARM_TX: JCA1.10; also elsewhere on the board
UART_RS-LLEG_DIR: JCA1.6; also elsewhere on the board
UART_RS-LLEG_RX: JCA1.5; also elsewhere on the board
UART_RS-LLEG_TX: JCA1.4; also elsewhere on the board
UART_RS-RARM_DIR: JCA1.15; also elsewhere on the board
UART_RS-RARM_RX: JCA1.14; also elsewhere on the board
UART_RS-RARM_TX: JCA1.13; also elsewhere on the board
UART_RS-RLEG_DIR: JCA1.9; also elsewhere on the board
UART_RS-RLEG_RX: JCA1.8; also elsewhere on the board
UART_RS-RLEG_TX: JCA1.7; also elsewhere on the board

Notes on the sheet:
PRELIMINARY - NOT APPROVED FOR PROCUREMENT, FABRICATION, ASSEMBLY, CONNECTION, POWERED TESTING, MOTION OR ENERGIZATION
03 Carrier A four RS-485 UART groups
Physical pin-level controller candidate; no functional-safety approval.
W3001
W3002
W3003
W3004
W3005
W3006
W3007
W3008
W3009
W3010
W3011
W3012
W3013
W3014
W3015
NOTE 1: PRELIMINARY - NOT APPROVED FOR PROCUREMENT, FABRICATION, ASSEMBLY, CONNECTION,
POWERED TESTING, MOTION OR ENERGIZATION
NOTE 2: Permit restoration never creates a motion command; a fresh bounded action is
separately required.

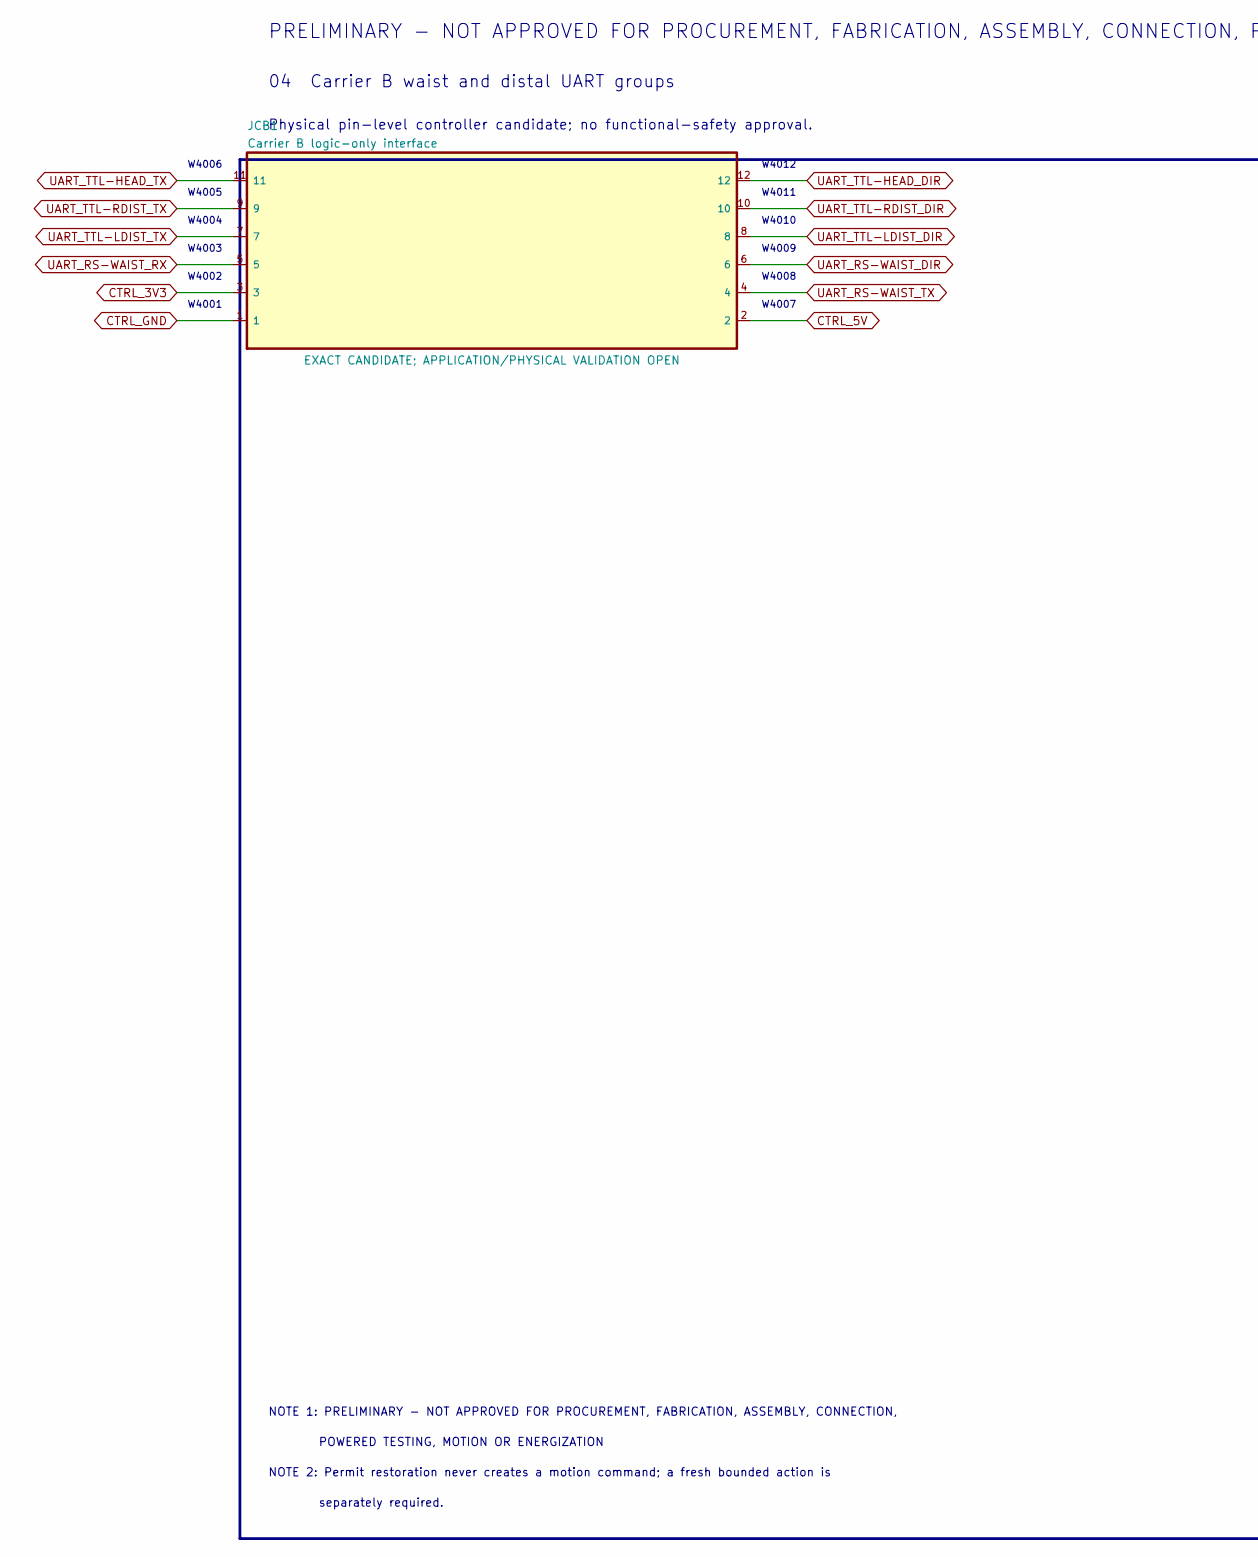
[picture p354: schematic 04_carrier_b_interface.kicad_sch, PB HR-V0 P0.1 - 04, part in row 1, column 1]

Parts:
JCB1: Carrier B logic-only interface; JST_GH_BM15B-GHS-TBT_1x15-1MP_P1.25mm_Vertical

Connections:
CTRL_3V3: JCB1.3; also elsewhere on the board
CTRL_5V: JCB1.2; also elsewhere on the board
CTRL_GND: JCB1.1; also elsewhere on the board
UART_RS-WAIST_DIR: JCB1.6; also elsewhere on the board
UART_RS-WAIST_RX: JCB1.5; also elsewhere on the board
UART_RS-WAIST_TX: JCB1.4; also elsewhere on the board
UART_TTL-HEAD_DIR: JCB1.12; also elsewhere on the board
UART_TTL-HEAD_TX: JCB1.11; also elsewhere on the board
UART_TTL-LDIST_DIR: JCB1.8; also elsewhere on the board
UART_TTL-LDIST_TX: JCB1.7; also elsewhere on the board
UART_TTL-RDIST_DIR: JCB1.10; also elsewhere on the board
UART_TTL-RDIST_TX: JCB1.9; also elsewhere on the board

Notes on the sheet:
PRELIMINARY - NOT APPROVED FOR PROCUREMENT, FABRICATION, ASSEMBLY, CONNECTION, POWERED TESTING, MOTION OR ENERGIZATION
04 Carrier B waist and distal UART groups
Physical pin-level controller candidate; no functional-safety approval.
W4001
W4002
W4003
W4004
W4005
W4006
W4007
W4008
W4009
W4010
W4011
W4012
NOTE 1: PRELIMINARY - NOT APPROVED FOR PROCUREMENT, FABRICATION, ASSEMBLY, CONNECTION,
POWERED TESTING, MOTION OR ENERGIZATION
NOTE 2: Permit restoration never creates a motion command; a fresh bounded action is
separately required.

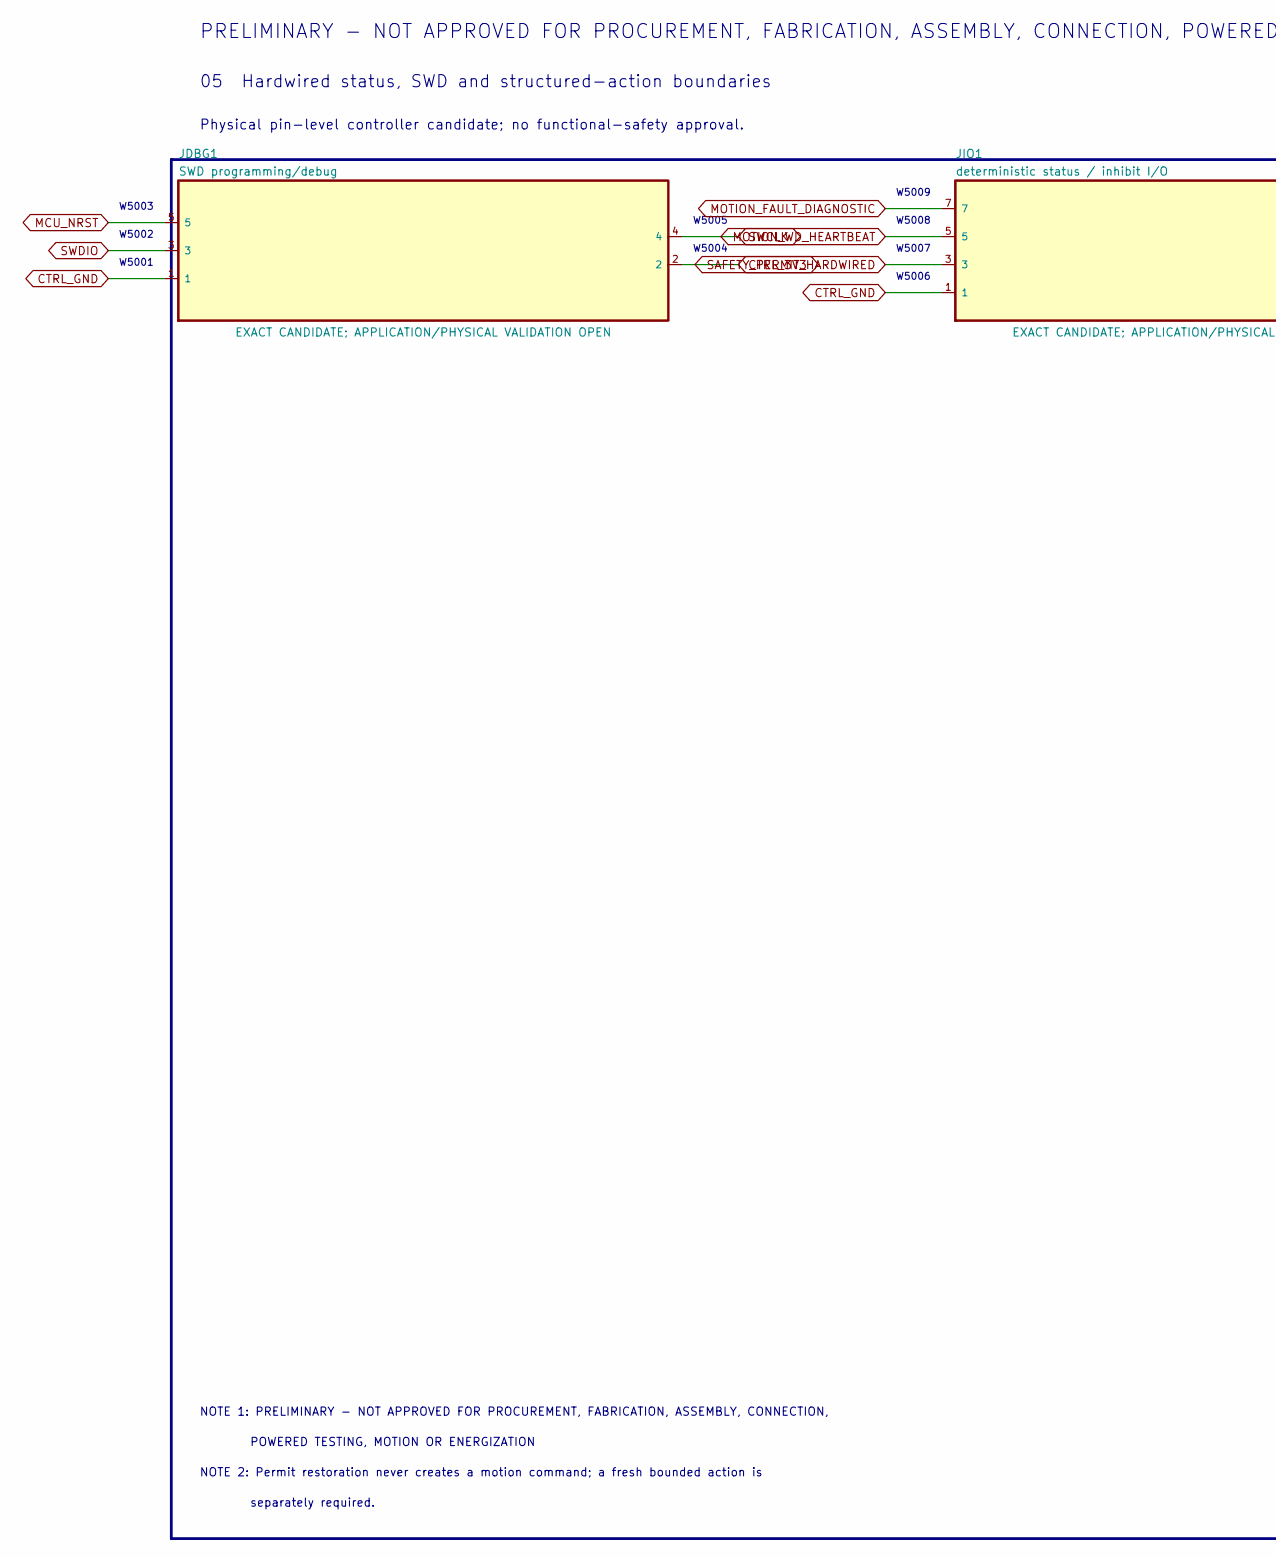
[picture p355: schematic 05_control_debug_action.kicad_sch, PB HR-V0 P0.1 - 05, part in row 1, column 1]

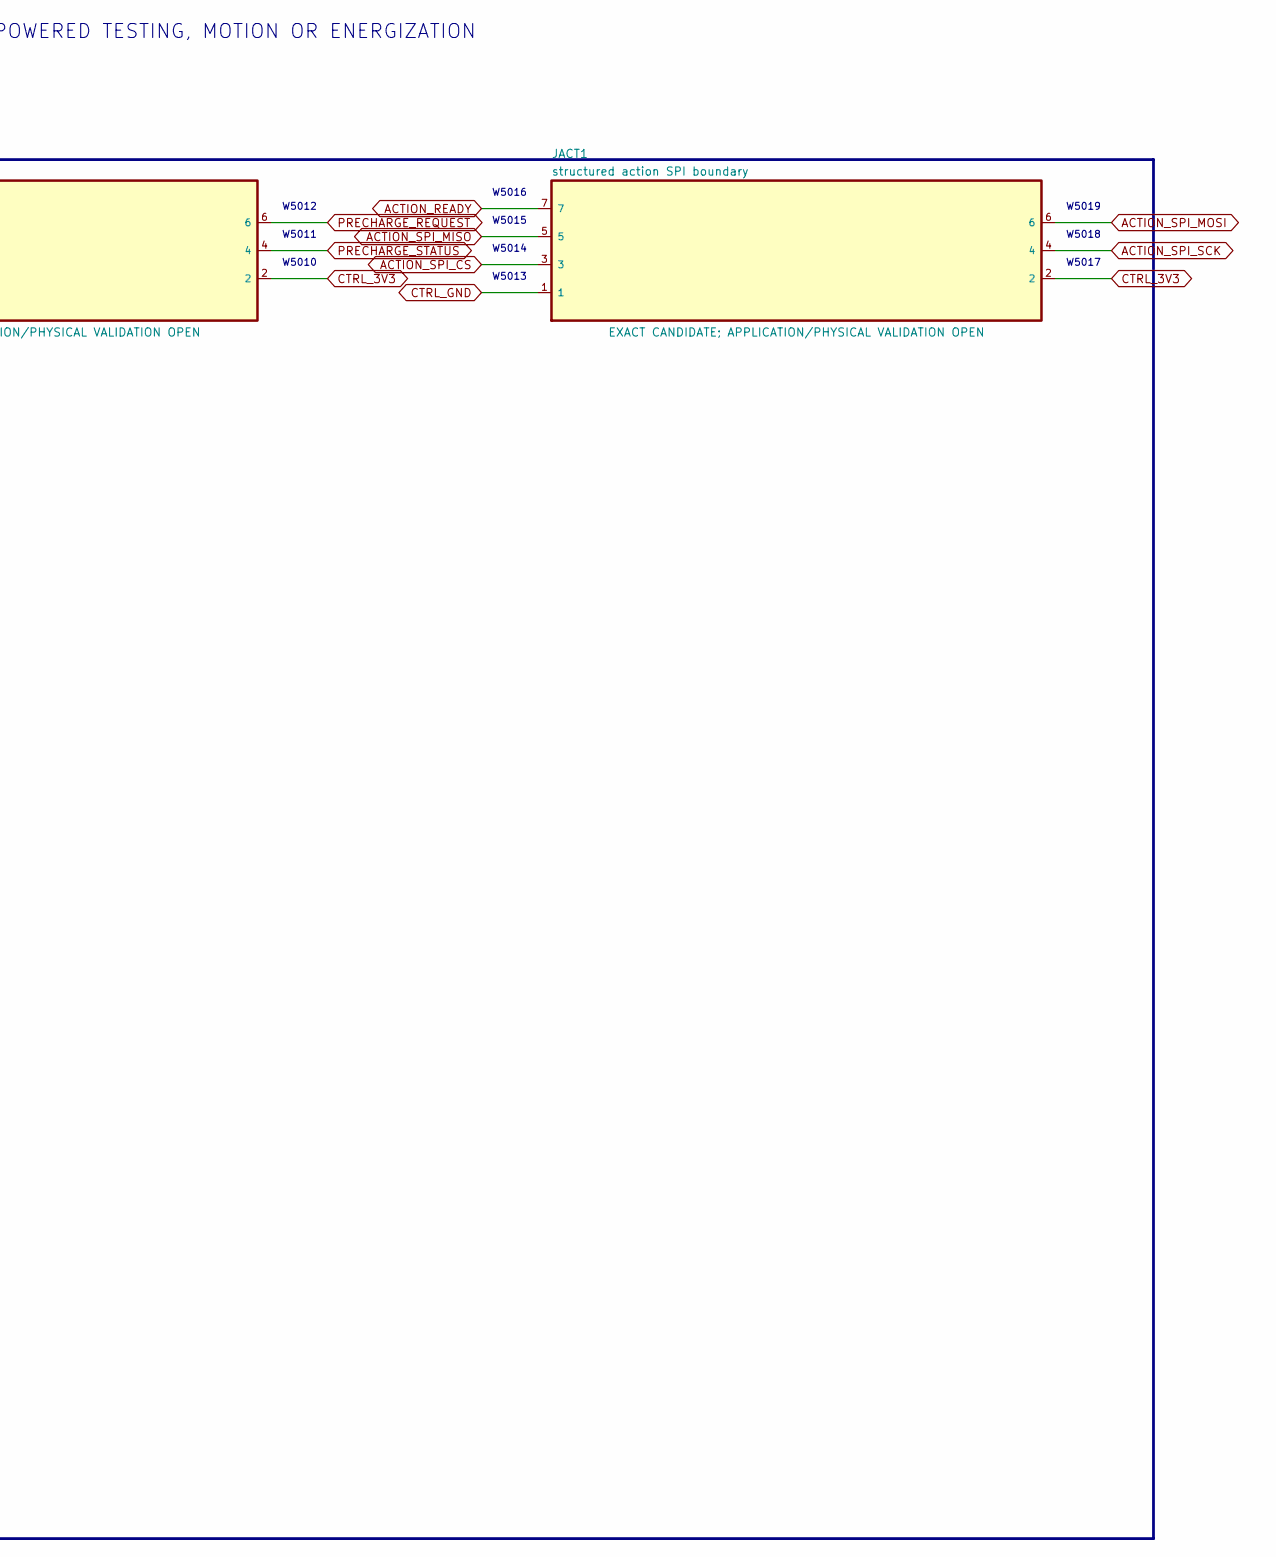
[picture p356: schematic 05_control_debug_action.kicad_sch, PB HR-V0 P0.1 - 05, part in row 1, column 2]

Parts:
JACT1: structured action SPI boundary; JST_GH_BM08B-GHS-TBT_1x08-1MP_P1.25mm_Vertical
JDBG1: SWD programming/debug; JST_GH_BM05B-GHS-TBT_1x05-1MP_P1.25mm_Vertical
JIO1: deterministic status / inhibit I/O; JST_GH_BM08B-GHS-TBT_1x08-1MP_P1.25mm_Vertical

Connections:
ACTION_READY: JACT1.7; also elsewhere on the board
ACTION_SPI_CS: JACT1.3; also elsewhere on the board
ACTION_SPI_MISO: JACT1.5; also elsewhere on the board
ACTION_SPI_MOSI: JACT1.6; also elsewhere on the board
ACTION_SPI_SCK: JACT1.4; also elsewhere on the board
CTRL_3V3: JACT1.2, JDBG1.2, JIO1.2; also elsewhere on the board
CTRL_GND: JACT1.1, JDBG1.1, JIO1.1; also elsewhere on the board
MCU_NRST: JDBG1.5; also elsewhere on the board
MOTION_FAULT_DIAGNOSTIC: JIO1.7; also elsewhere on the board
MOTION_WD_HEARTBEAT: JIO1.5; also elsewhere on the board
PRECHARGE_REQUEST: JIO1.6; also elsewhere on the board
PRECHARGE_STATUS: JIO1.4; also elsewhere on the board
SAFETY_PERMIT_HARDWIRED: JIO1.3; also elsewhere on the board
SWCLK: JDBG1.4; also elsewhere on the board
SWDIO: JDBG1.3; also elsewhere on the board

Notes on the sheet:
PRELIMINARY - NOT APPROVED FOR PROCUREMENT, FABRICATION, ASSEMBLY, CONNECTION, POWERED TESTING, MOTION OR ENERGIZATION
05 Hardwired status, SWD and structured-action boundaries
Physical pin-level controller candidate; no functional-safety approval.
W5001
W5002
W5003
W5004
W5005
W5006
W5007
W5008
W5009
W5010
W5011
W5012
W5013
W5014
W5015
W5016
W5017
W5018
W5019
NOTE 1: PRELIMINARY - NOT APPROVED FOR PROCUREMENT, FABRICATION, ASSEMBLY, CONNECTION,
POWERED TESTING, MOTION OR ENERGIZATION
NOTE 2: Permit restoration never creates a motion command; a fresh bounded action is
separately required.

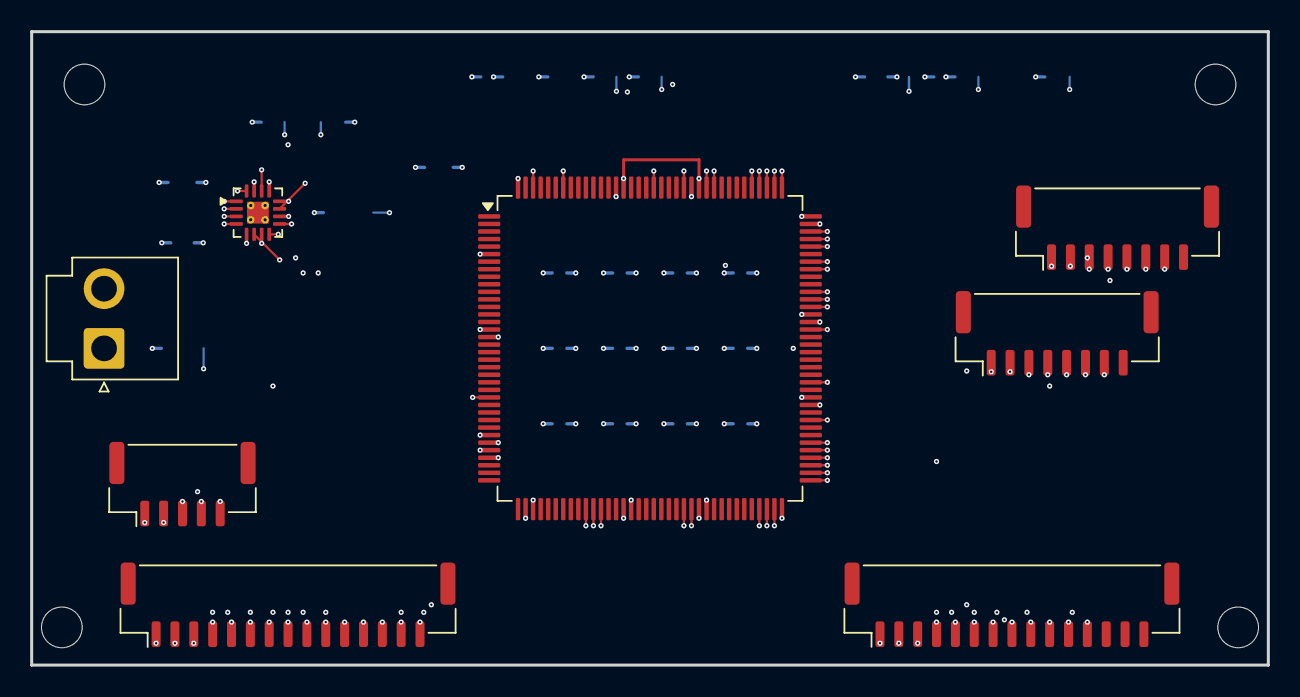
[picture p357: board hr30-motion-controller-p0.1.kicad_pcb from above]

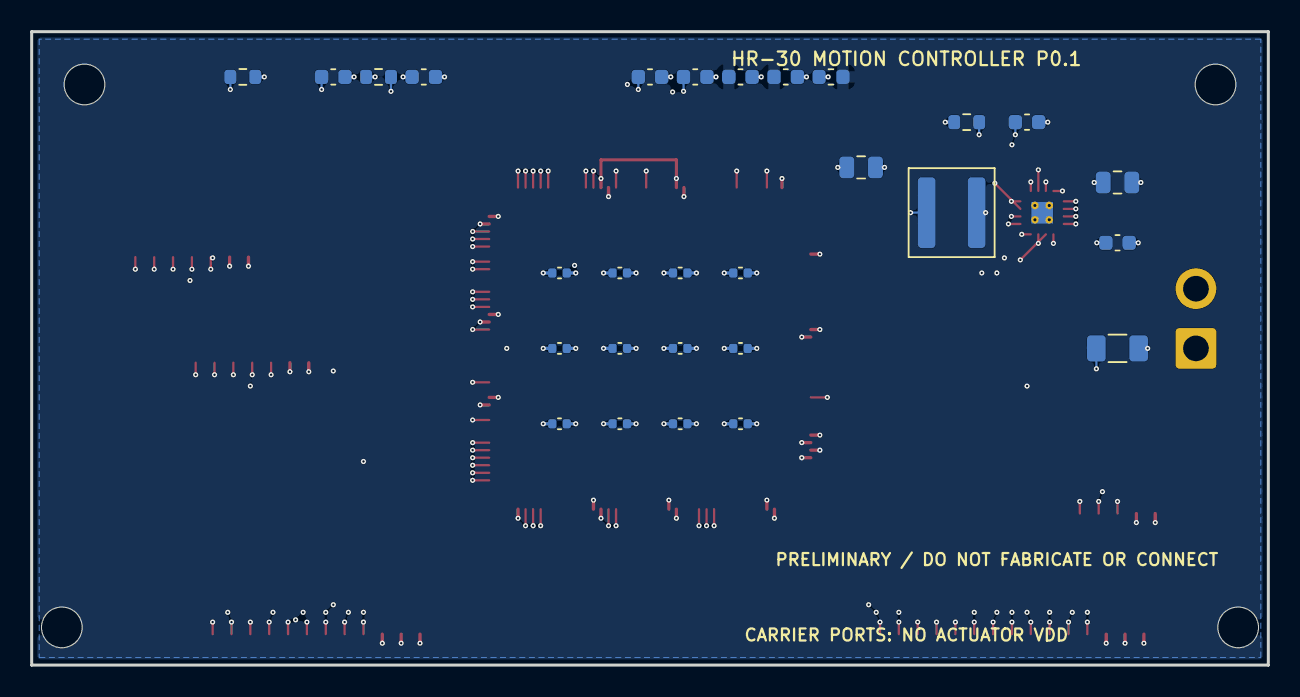
[picture p358: board hr30-motion-controller-p0.1.kicad_pcb from below]

Board: 6 copper layers, 82.0 x 42.0 mm, 40 parts (28 on the bottom side), 45 nets.

Other parts of the board:
MHM1, MHM2, MHM3, MHM4: M2.5 BOARD-ONLY; TRAY STACK VALIDATION OPEN; MountingHole_2.7mm_M2.5
