amyleesterling/humanoid-robot/hr30/whole-body-p0.1/electrical/carriers-p0.1/carrier-b/hr30-carrier-b-p0.1.kicad_pcb

## KiCad design hr30/whole-body-p0.1/electrical/carriers-p0.1/carrier-b/hr30-carrier-b-p0.1.kicad_pcb (2026-08-17)

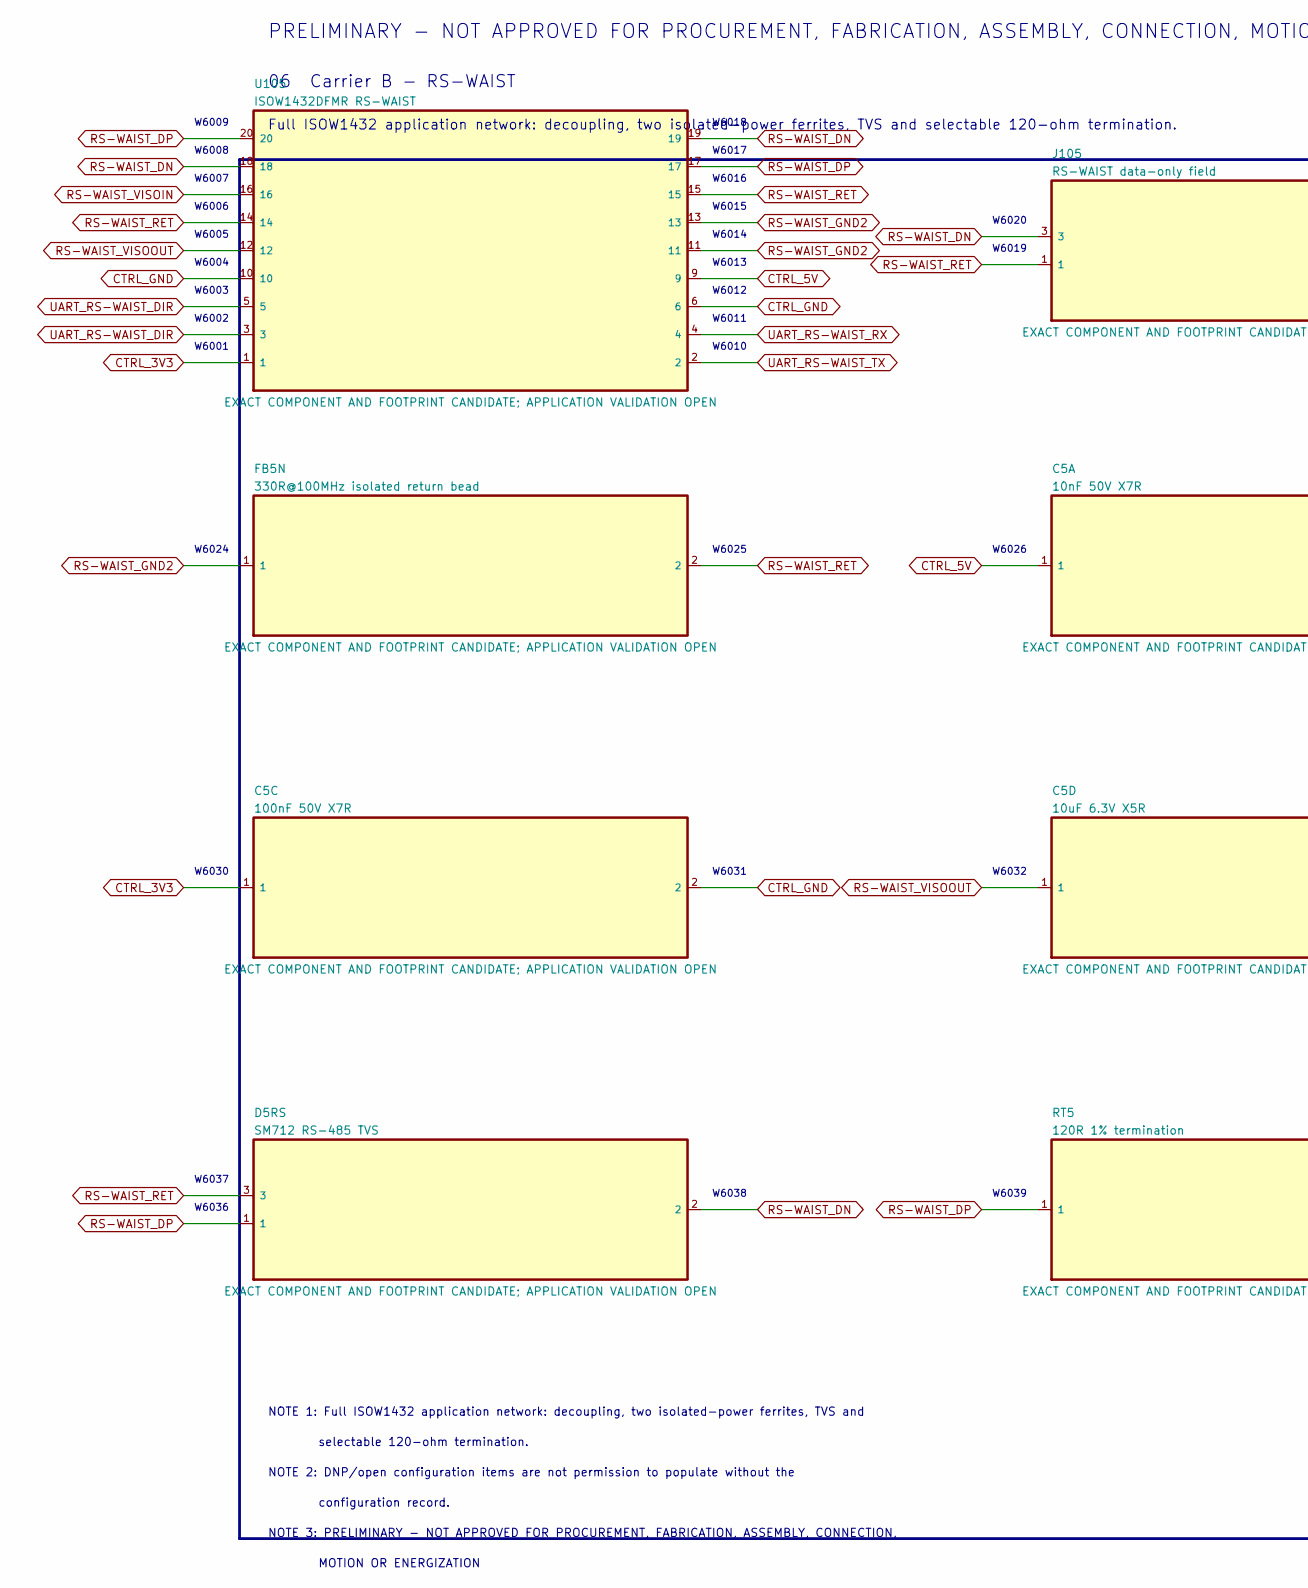
[picture p359: schematic 06_rs_waist.kicad_sch, PB HR-V0 P0.1 - 06, part in row 1, column 1]

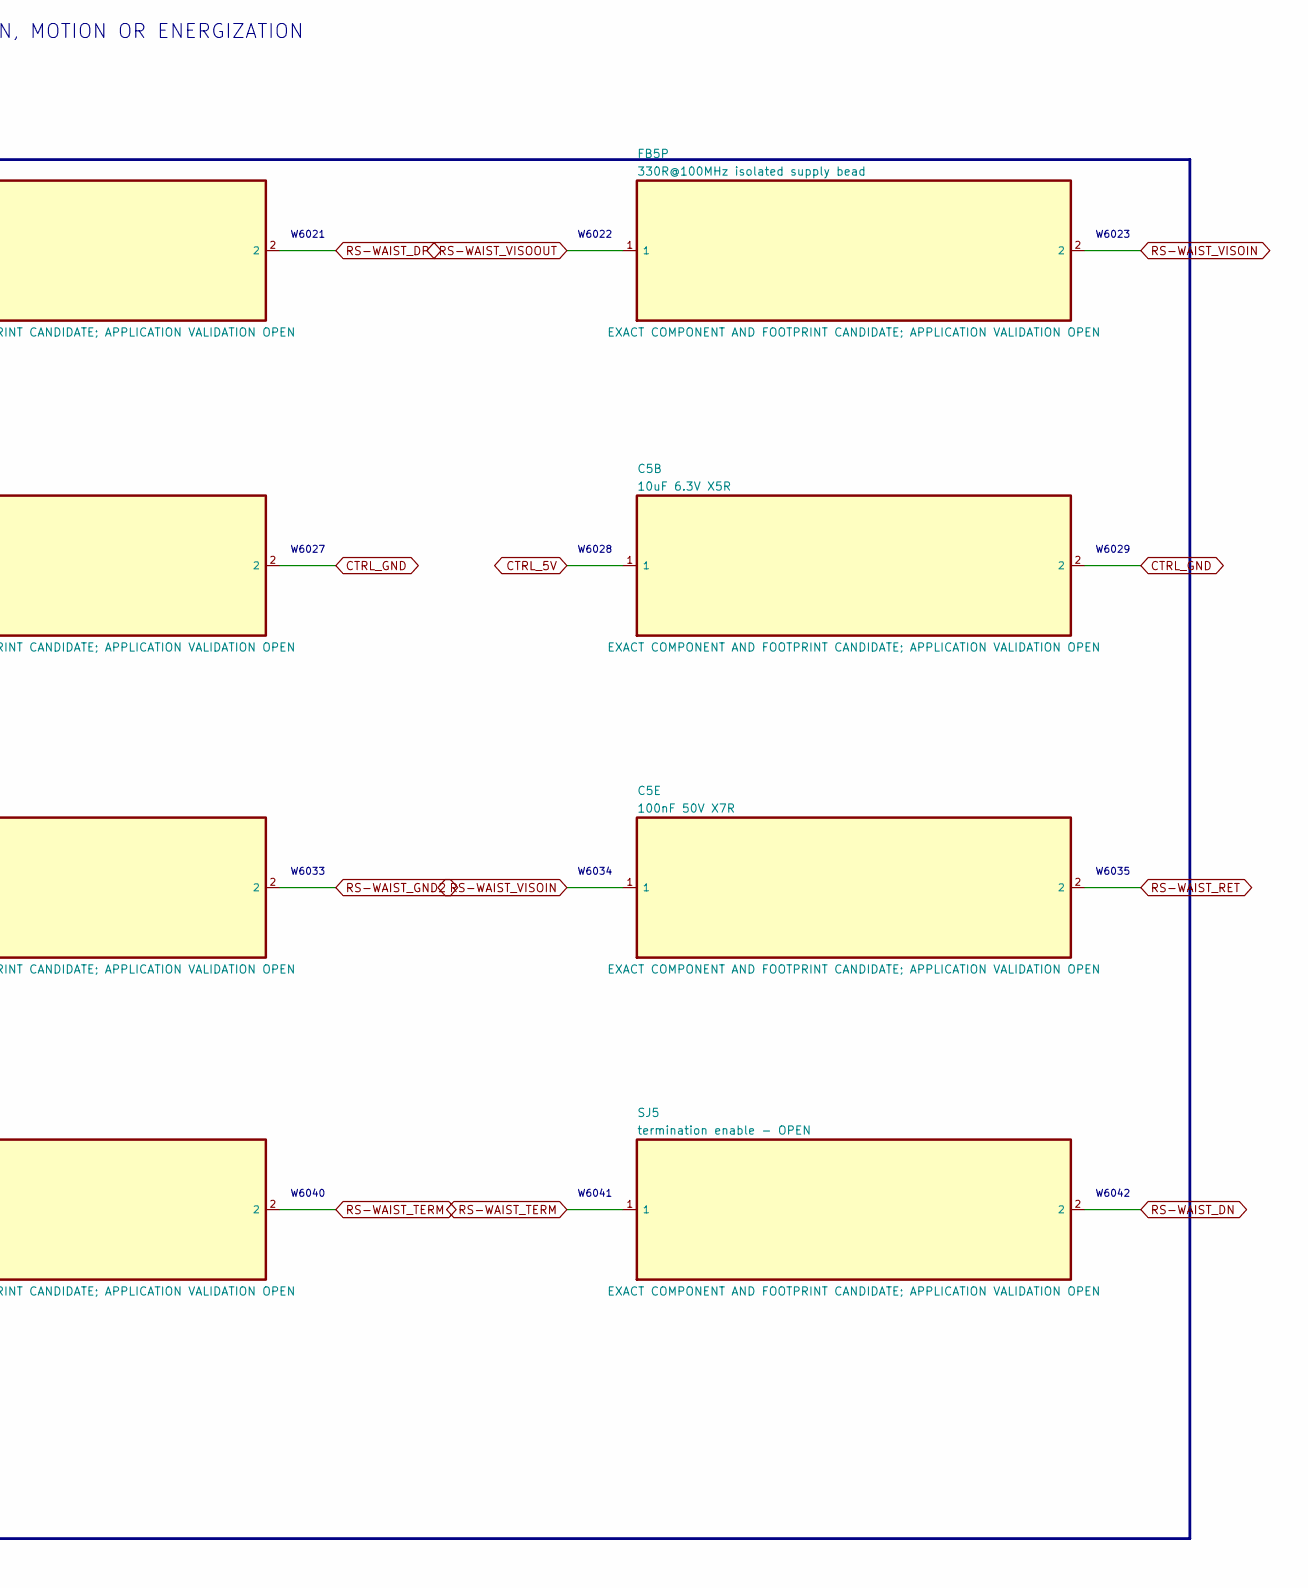
[picture p360: schematic 06_rs_waist.kicad_sch, PB HR-V0 P0.1 - 06, part in row 1, column 2]

Parts:
C5A: 10nF 50V X7R; C_0603_1608Metric
C5B, C5D: 10uF 6.3V X5R; C_0603_1608Metric
C5C, C5E: 100nF 50V X7R; C_0603_1608Metric
D5RS: SM712 RS-485 TVS; SOT-23
FB5N: 330R@100MHz isolated return bead; L_0402_1005Metric
FB5P: 330R@100MHz isolated supply bead; L_0402_1005Metric
J105: RS-WAIST data-only field; JST_GH_BM03B-GHS-TBT_1x03-1MP_P1.25mm_Vertical
RT5: 120R 1% termination; R_0603_1608Metric
SJ5: termination enable - OPEN; SolderJumper-2_P1.3mm_Open_Pad1.0x1.5mm
U105: ISOW1432DFMR RS-WAIST; SOIC-20W_7.5x12.8mm_P1.27mm

Connections:
CTRL_3V3: C5C.1, U105.1; also elsewhere on the board
CTRL_5V: C5A.1, C5B.1, U105.9; also elsewhere on the board
CTRL_GND: C5A.2, C5B.2, C5C.2, U105.6, U105.10; also elsewhere on the board
RS-WAIST_DN: D5RS.2, J105.3, SJ5.2, U105.18, U105.19
RS-WAIST_DP: D5RS.1, J105.2, RT5.1, U105.17, U105.20
RS-WAIST_GND2: C5D.2, FB5N.1, U105.11, U105.13
RS-WAIST_RET: C5E.2, D5RS.3, FB5N.2, J105.1, U105.14, U105.15
RS-WAIST_TERM: RT5.2, SJ5.1
RS-WAIST_VISOIN: C5E.1, FB5P.2, U105.16
RS-WAIST_VISOOUT: C5D.1, FB5P.1, U105.12
UART_RS-WAIST_DIR: U105.3, U105.5; also elsewhere on the board
UART_RS-WAIST_RX: U105.4; also elsewhere on the board
UART_RS-WAIST_TX: U105.2; also elsewhere on the board

Notes on the sheet:
PRELIMINARY - NOT APPROVED FOR PROCUREMENT, FABRICATION, ASSEMBLY, CONNECTION, MOTION OR ENERGIZATION
06 Carrier B - RS-WAIST
Full ISOW1432 application network: decoupling, two isolated-power ferrites, TVS and selectable 120-ohm termination.
W6001
W6002
W6003
W6004
W6005
W6006
W6007
W6008
W6009
W6010
W6011
W6012
W6013
W6014
W6015
W6016
W6017
W6018
W6019
W6020
W6021
W6022
W6023
W6024
W6025
W6026
W6027
W6028
W6029
W6030
W6031
W6032
W6033
W6034
W6035
W6036
W6037
W6038
W6039
W6040
W6041
W6042
NOTE 1: Full ISOW1432 application network: decoupling, two isolated-power ferrites, TVS and
selectable 120-ohm termination.
NOTE 2: DNP/open configuration items are not permission to populate without the
configuration record.
NOTE 3: PRELIMINARY - NOT APPROVED FOR PROCUREMENT, FABRICATION, ASSEMBLY, CONNECTION,
MOTION OR ENERGIZATION

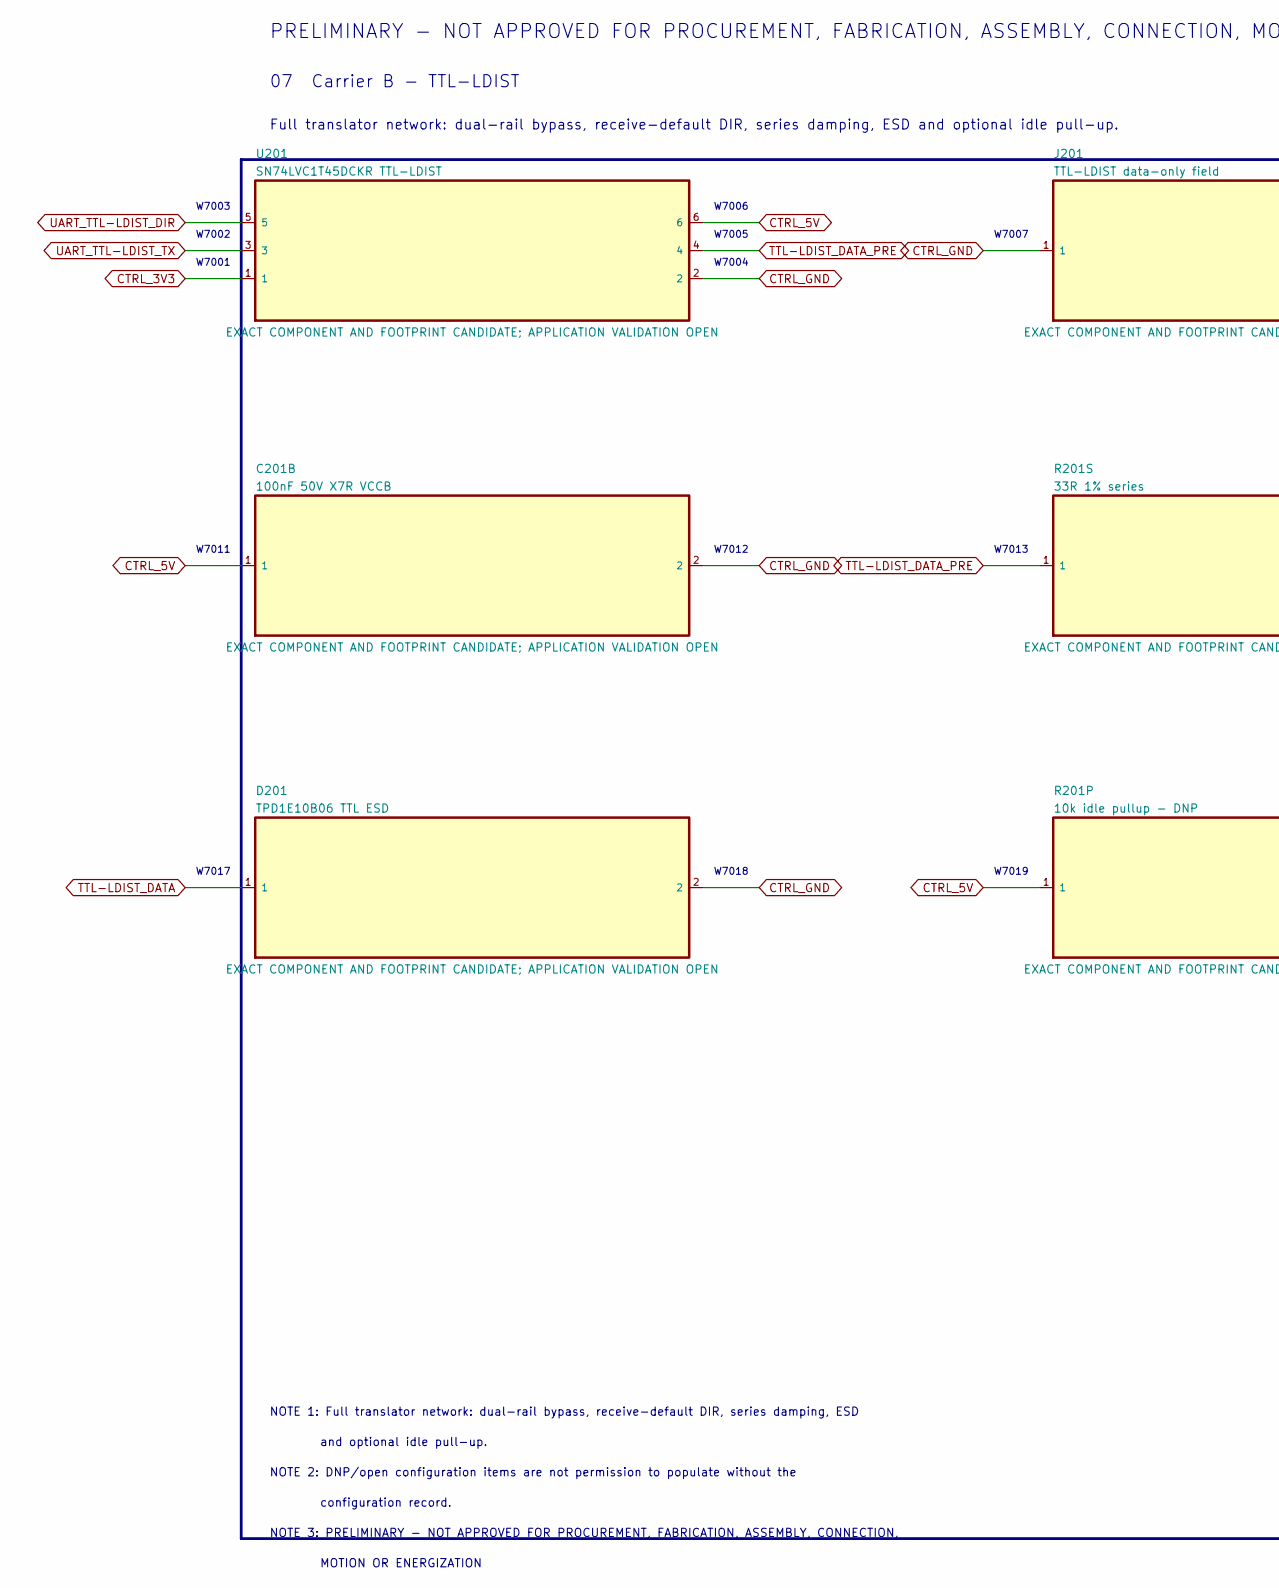
[picture p361: schematic 07_ttl_ldist.kicad_sch, PB HR-V0 P0.1 - 07, part in row 1, column 1]

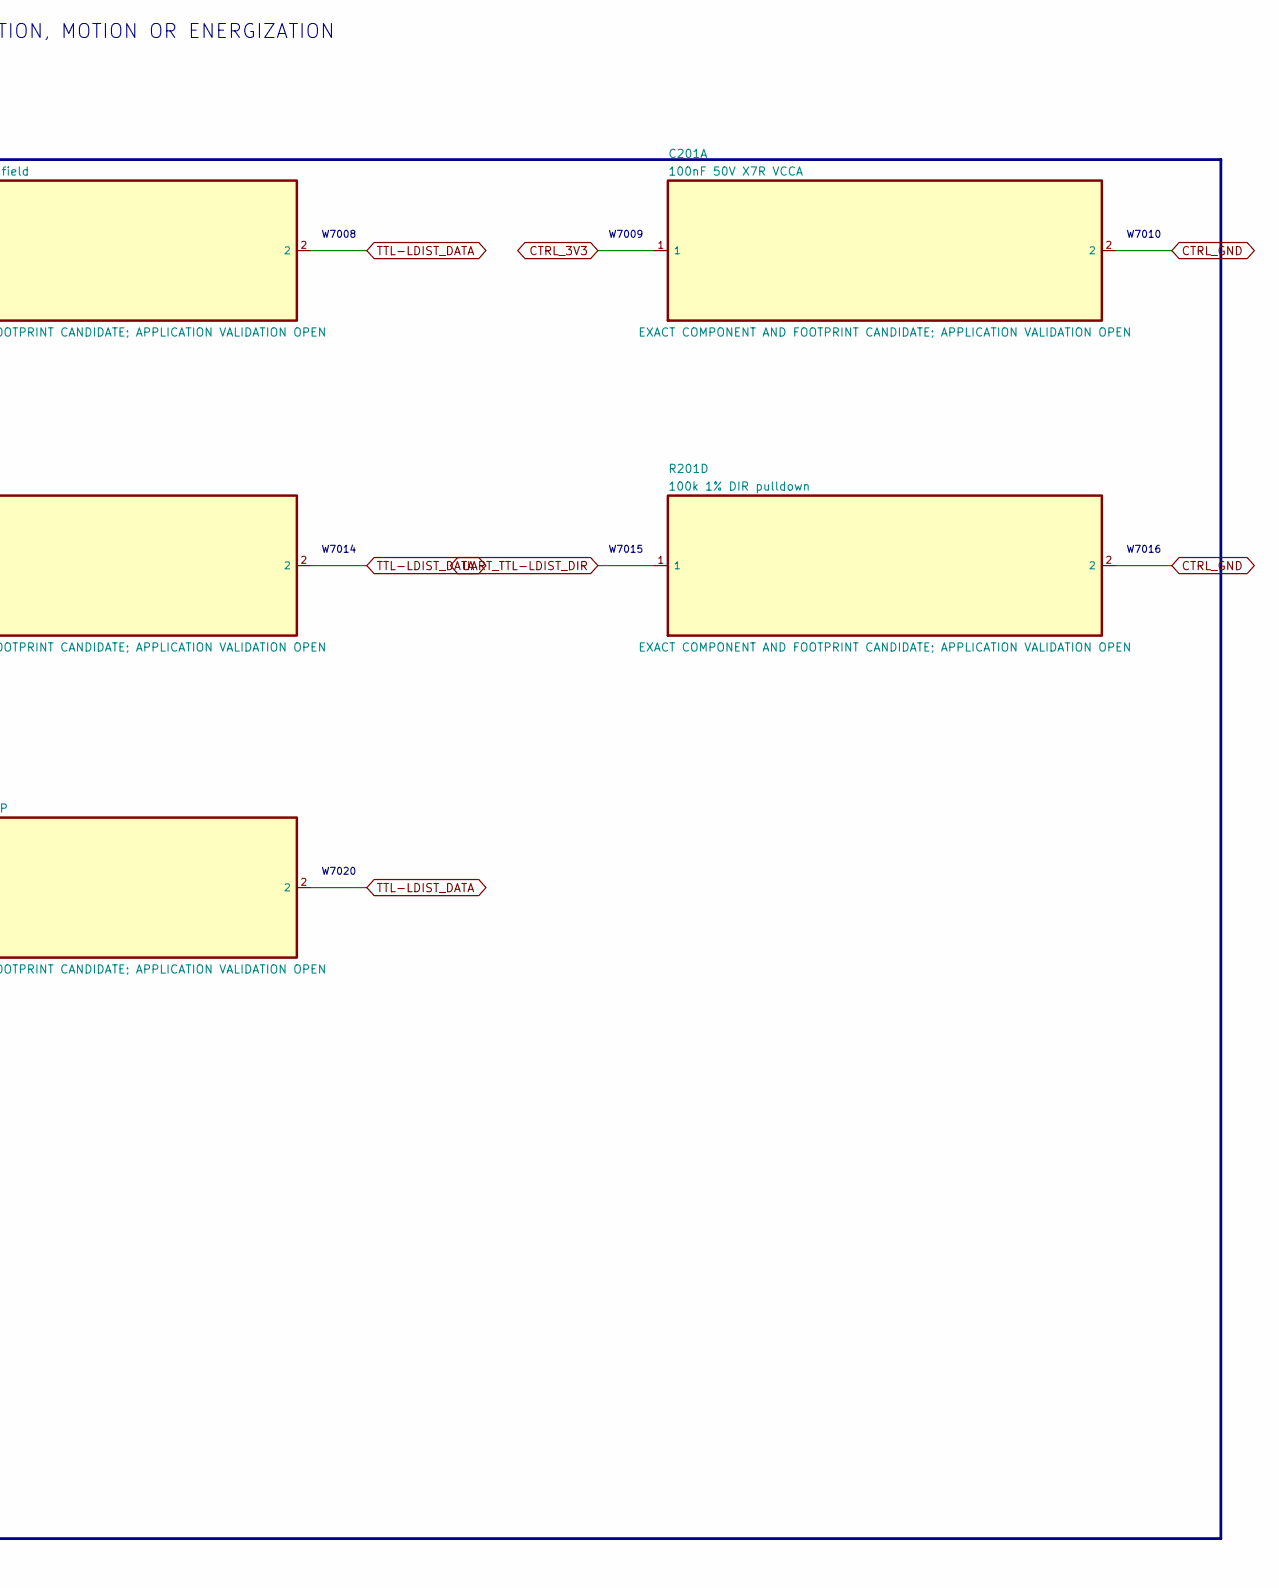
[picture p362: schematic 07_ttl_ldist.kicad_sch, PB HR-V0 P0.1 - 07, part in row 1, column 2]

Parts:
C201A: 100nF 50V X7R VCCA; C_0603_1608Metric
C201B: 100nF 50V X7R VCCB; C_0603_1608Metric
D201: TPD1E10B06 TTL ESD; D_SOD-523
J201: TTL-LDIST data-only field; JST_GH_BM02B-GHS-TBT_1x02-1MP_P1.25mm_Vertical
R201D: 100k 1% DIR pulldown; R_0603_1608Metric
R201P: 10k idle pullup - DNP; R_0603_1608Metric
R201S: 33R 1% series; R_0603_1608Metric
U201: SN74LVC1T45DCKR TTL-LDIST; SOT-363_SC-70-6

Connections:
CTRL_3V3: C201A.1, U201.1; also elsewhere on the board
CTRL_5V: C201B.1, R201P.1, U201.6; also elsewhere on the board
CTRL_GND: C201A.2, C201B.2, D201.2, J201.1, R201D.2, U201.2; also elsewhere on the board
TTL-LDIST_DATA: D201.1, J201.2, R201P.2, R201S.2
TTL-LDIST_DATA_PRE: R201S.1, U201.4
UART_TTL-LDIST_DIR: R201D.1, U201.5; also elsewhere on the board
UART_TTL-LDIST_TX: U201.3; also elsewhere on the board

Notes on the sheet:
PRELIMINARY - NOT APPROVED FOR PROCUREMENT, FABRICATION, ASSEMBLY, CONNECTION, MOTION OR ENERGIZATION
07 Carrier B - TTL-LDIST
Full translator network: dual-rail bypass, receive-default DIR, series damping, ESD and optional idle pull-up.
W7001
W7002
W7003
W7004
W7005
W7006
W7007
W7008
W7009
W7010
W7011
W7012
W7013
W7014
W7015
W7016
W7017
W7018
W7019
W7020
NOTE 1: Full translator network: dual-rail bypass, receive-default DIR, series damping, ESD
and optional idle pull-up.
NOTE 2: DNP/open configuration items are not permission to populate without the
configuration record.
NOTE 3: PRELIMINARY - NOT APPROVED FOR PROCUREMENT, FABRICATION, ASSEMBLY, CONNECTION,
MOTION OR ENERGIZATION

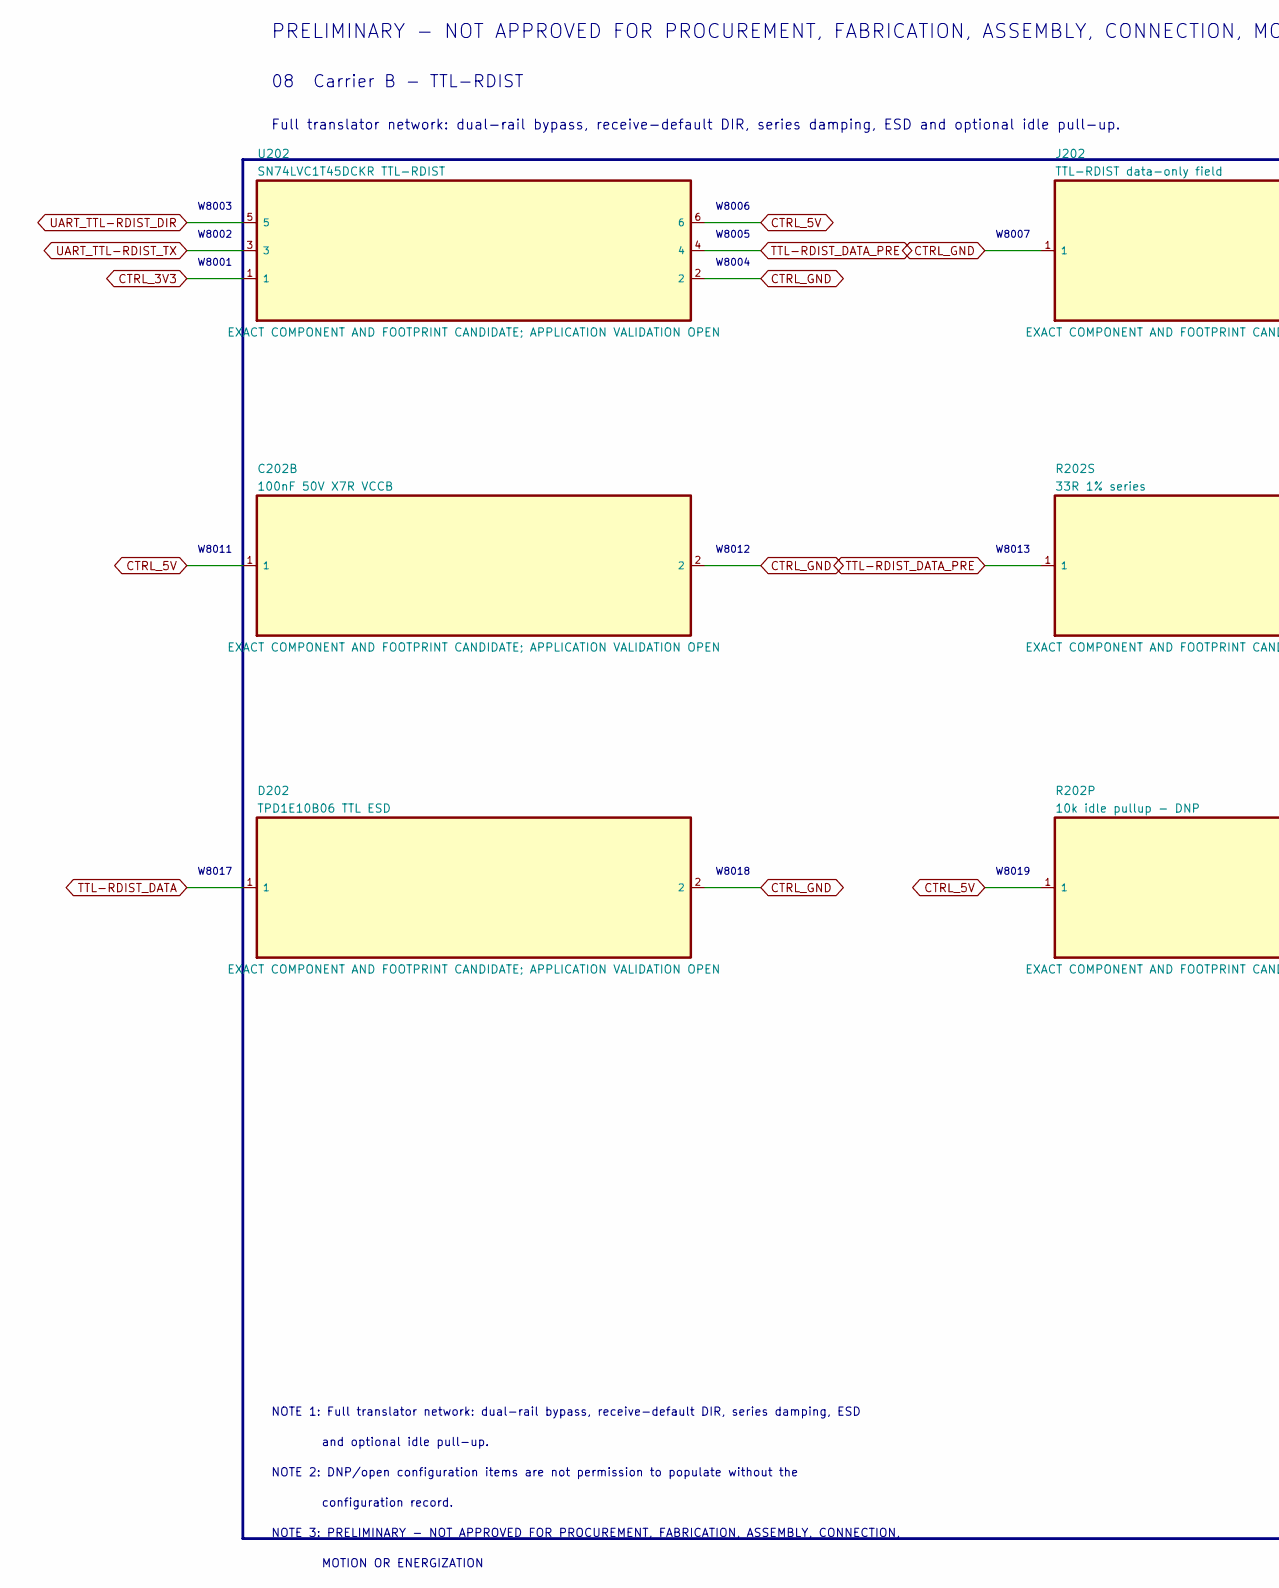
[picture p363: schematic 08_ttl_rdist.kicad_sch, PB HR-V0 P0.1 - 08, part in row 1, column 1]

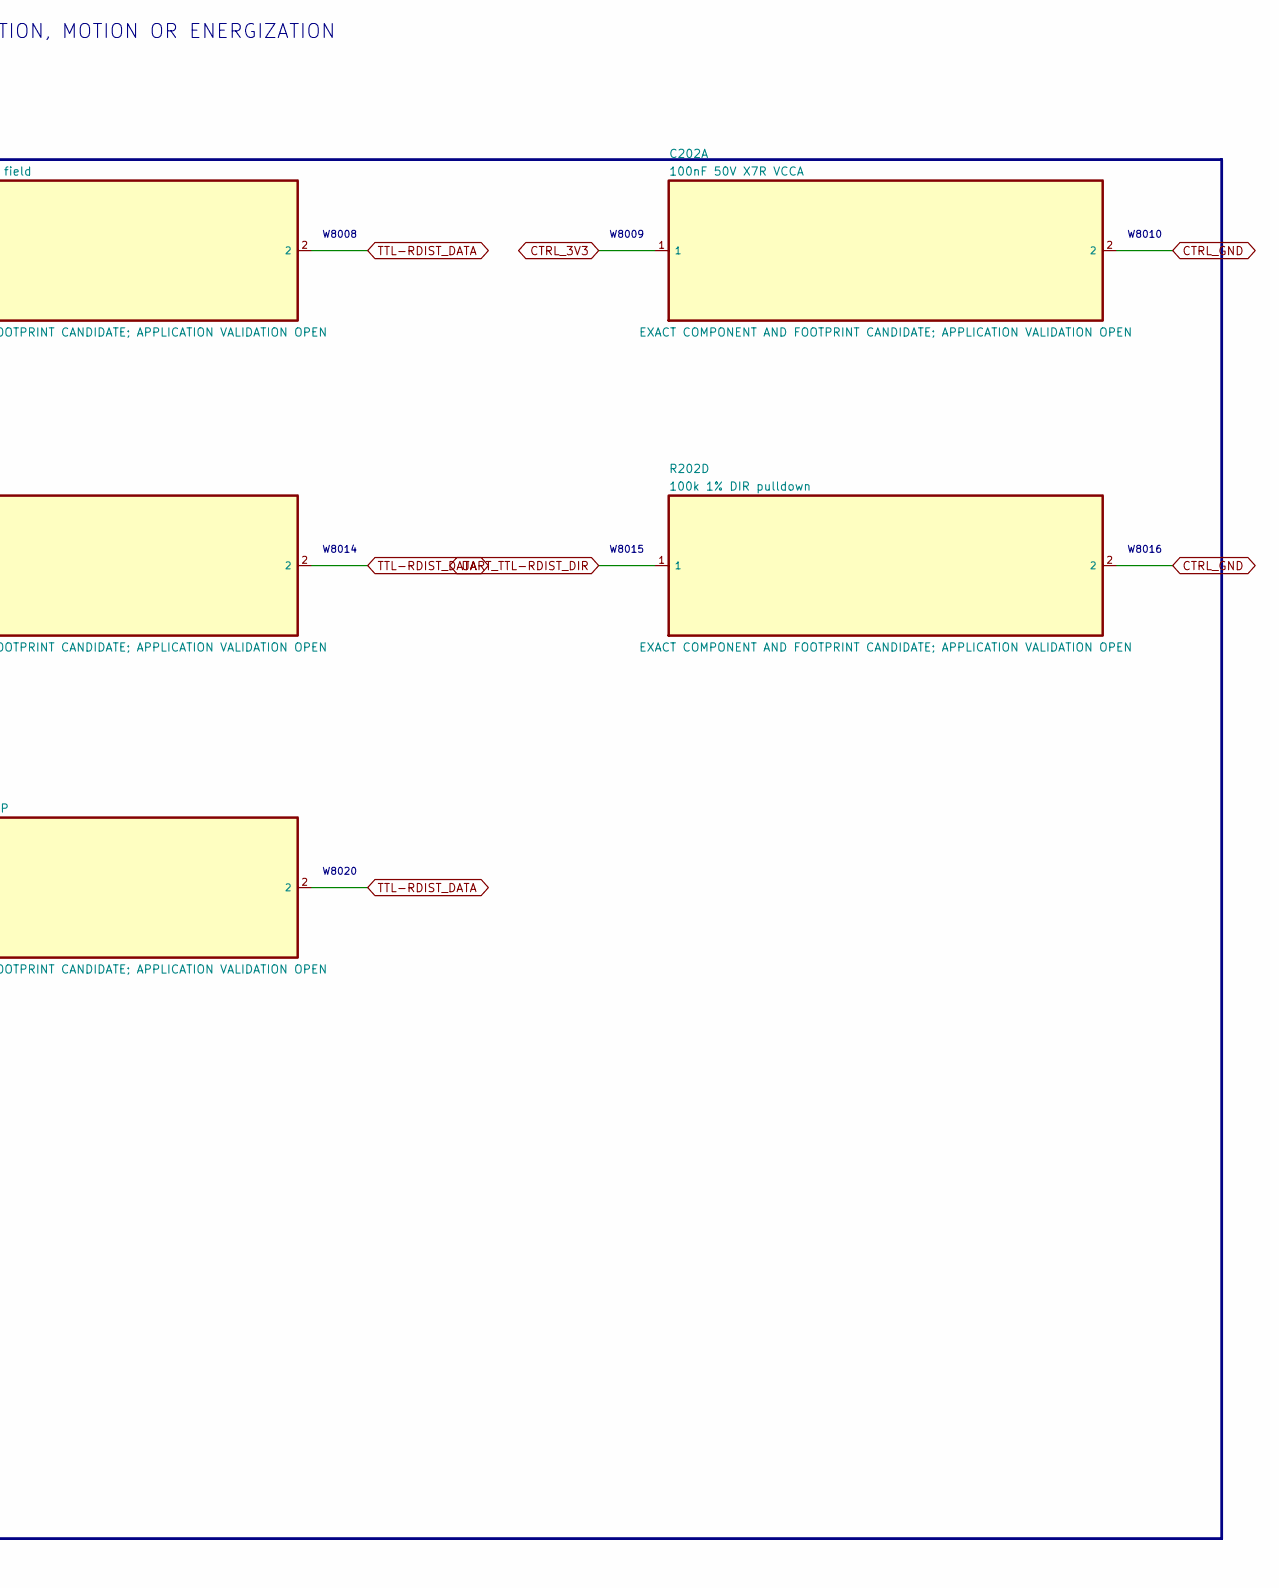
[picture p364: schematic 08_ttl_rdist.kicad_sch, PB HR-V0 P0.1 - 08, part in row 1, column 2]

Parts:
C202A: 100nF 50V X7R VCCA; C_0603_1608Metric
C202B: 100nF 50V X7R VCCB; C_0603_1608Metric
D202: TPD1E10B06 TTL ESD; D_SOD-523
J202: TTL-RDIST data-only field; JST_GH_BM02B-GHS-TBT_1x02-1MP_P1.25mm_Vertical
R202D: 100k 1% DIR pulldown; R_0603_1608Metric
R202P: 10k idle pullup - DNP; R_0603_1608Metric
R202S: 33R 1% series; R_0603_1608Metric
U202: SN74LVC1T45DCKR TTL-RDIST; SOT-363_SC-70-6

Connections:
CTRL_3V3: C202A.1, U202.1; also elsewhere on the board
CTRL_5V: C202B.1, R202P.1, U202.6; also elsewhere on the board
CTRL_GND: C202A.2, C202B.2, D202.2, J202.1, R202D.2, U202.2; also elsewhere on the board
TTL-RDIST_DATA: D202.1, J202.2, R202P.2, R202S.2
TTL-RDIST_DATA_PRE: R202S.1, U202.4
UART_TTL-RDIST_DIR: R202D.1, U202.5; also elsewhere on the board
UART_TTL-RDIST_TX: U202.3; also elsewhere on the board

Notes on the sheet:
PRELIMINARY - NOT APPROVED FOR PROCUREMENT, FABRICATION, ASSEMBLY, CONNECTION, MOTION OR ENERGIZATION
08 Carrier B - TTL-RDIST
Full translator network: dual-rail bypass, receive-default DIR, series damping, ESD and optional idle pull-up.
W8001
W8002
W8003
W8004
W8005
W8006
W8007
W8008
W8009
W8010
W8011
W8012
W8013
W8014
W8015
W8016
W8017
W8018
W8019
W8020
NOTE 1: Full translator network: dual-rail bypass, receive-default DIR, series damping, ESD
and optional idle pull-up.
NOTE 2: DNP/open configuration items are not permission to populate without the
configuration record.
NOTE 3: PRELIMINARY - NOT APPROVED FOR PROCUREMENT, FABRICATION, ASSEMBLY, CONNECTION,
MOTION OR ENERGIZATION

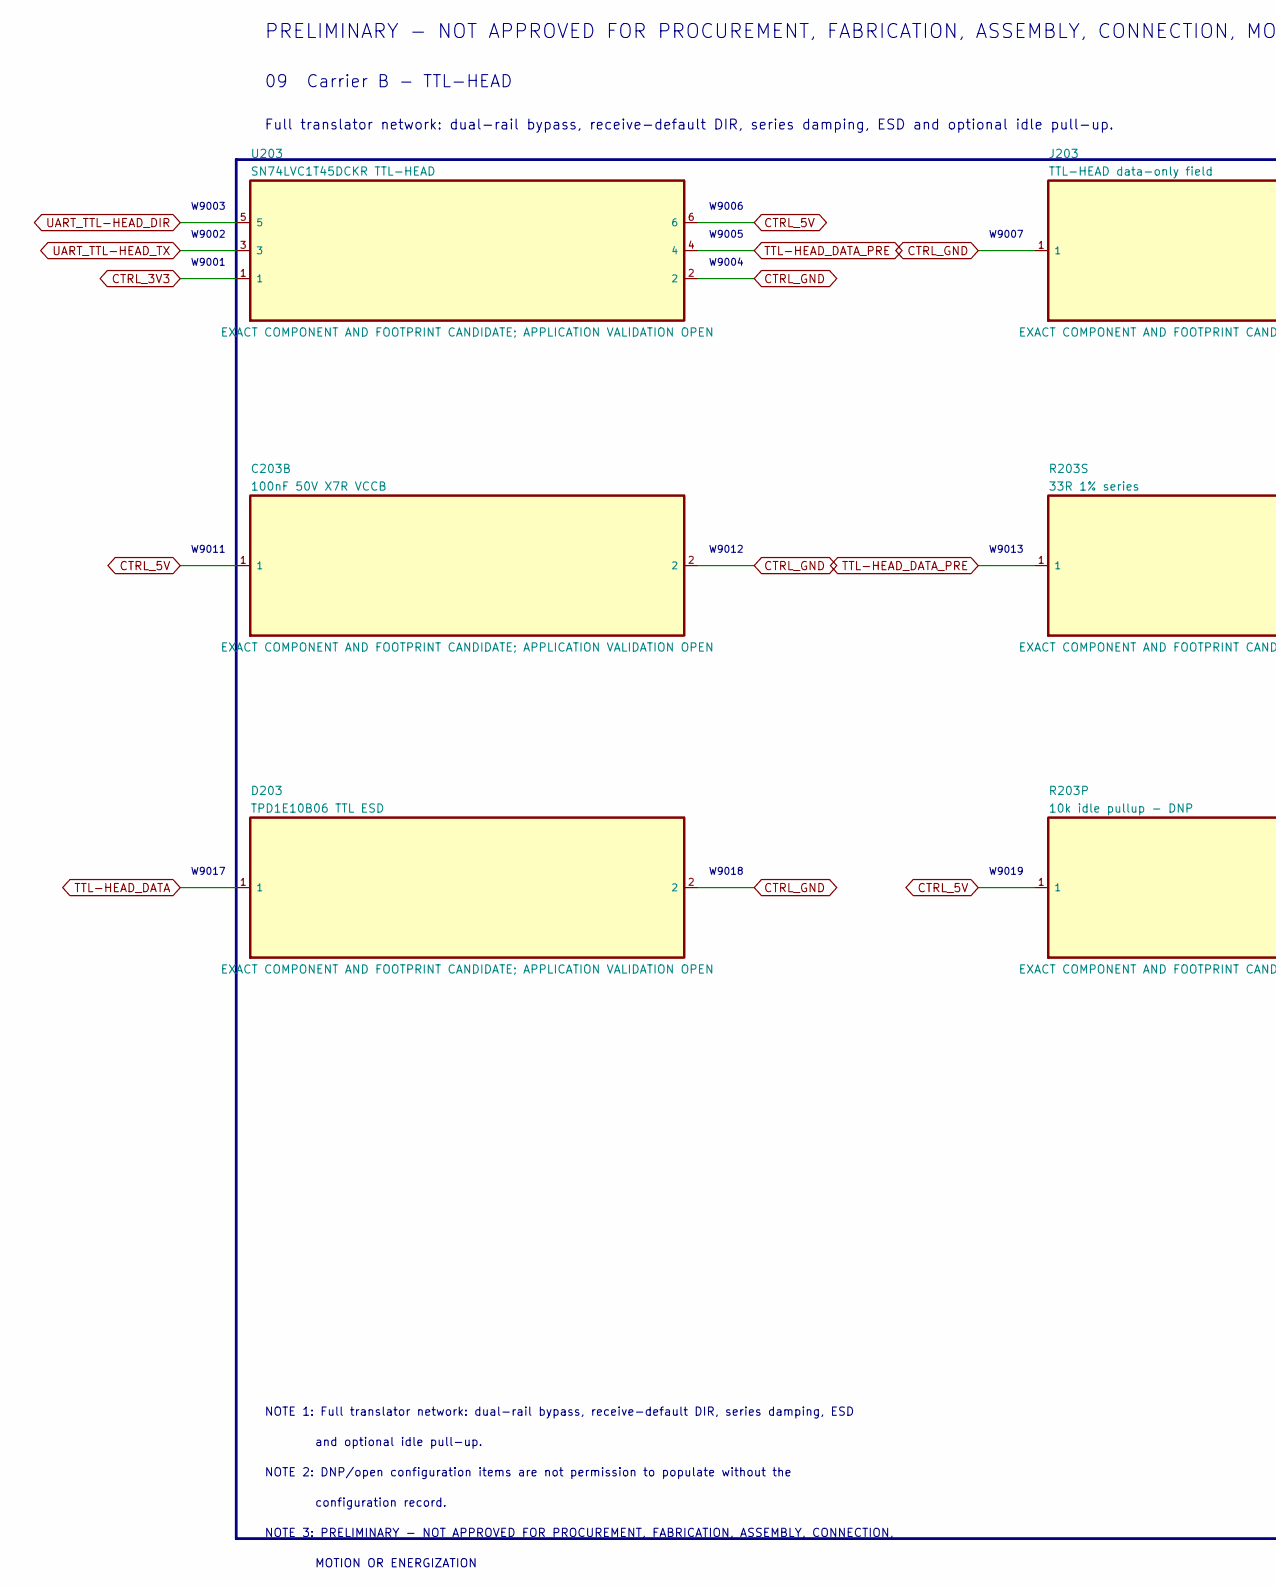
[picture p365: schematic 09_ttl_head.kicad_sch, PB HR-V0 P0.1 - 09, part in row 1, column 1]

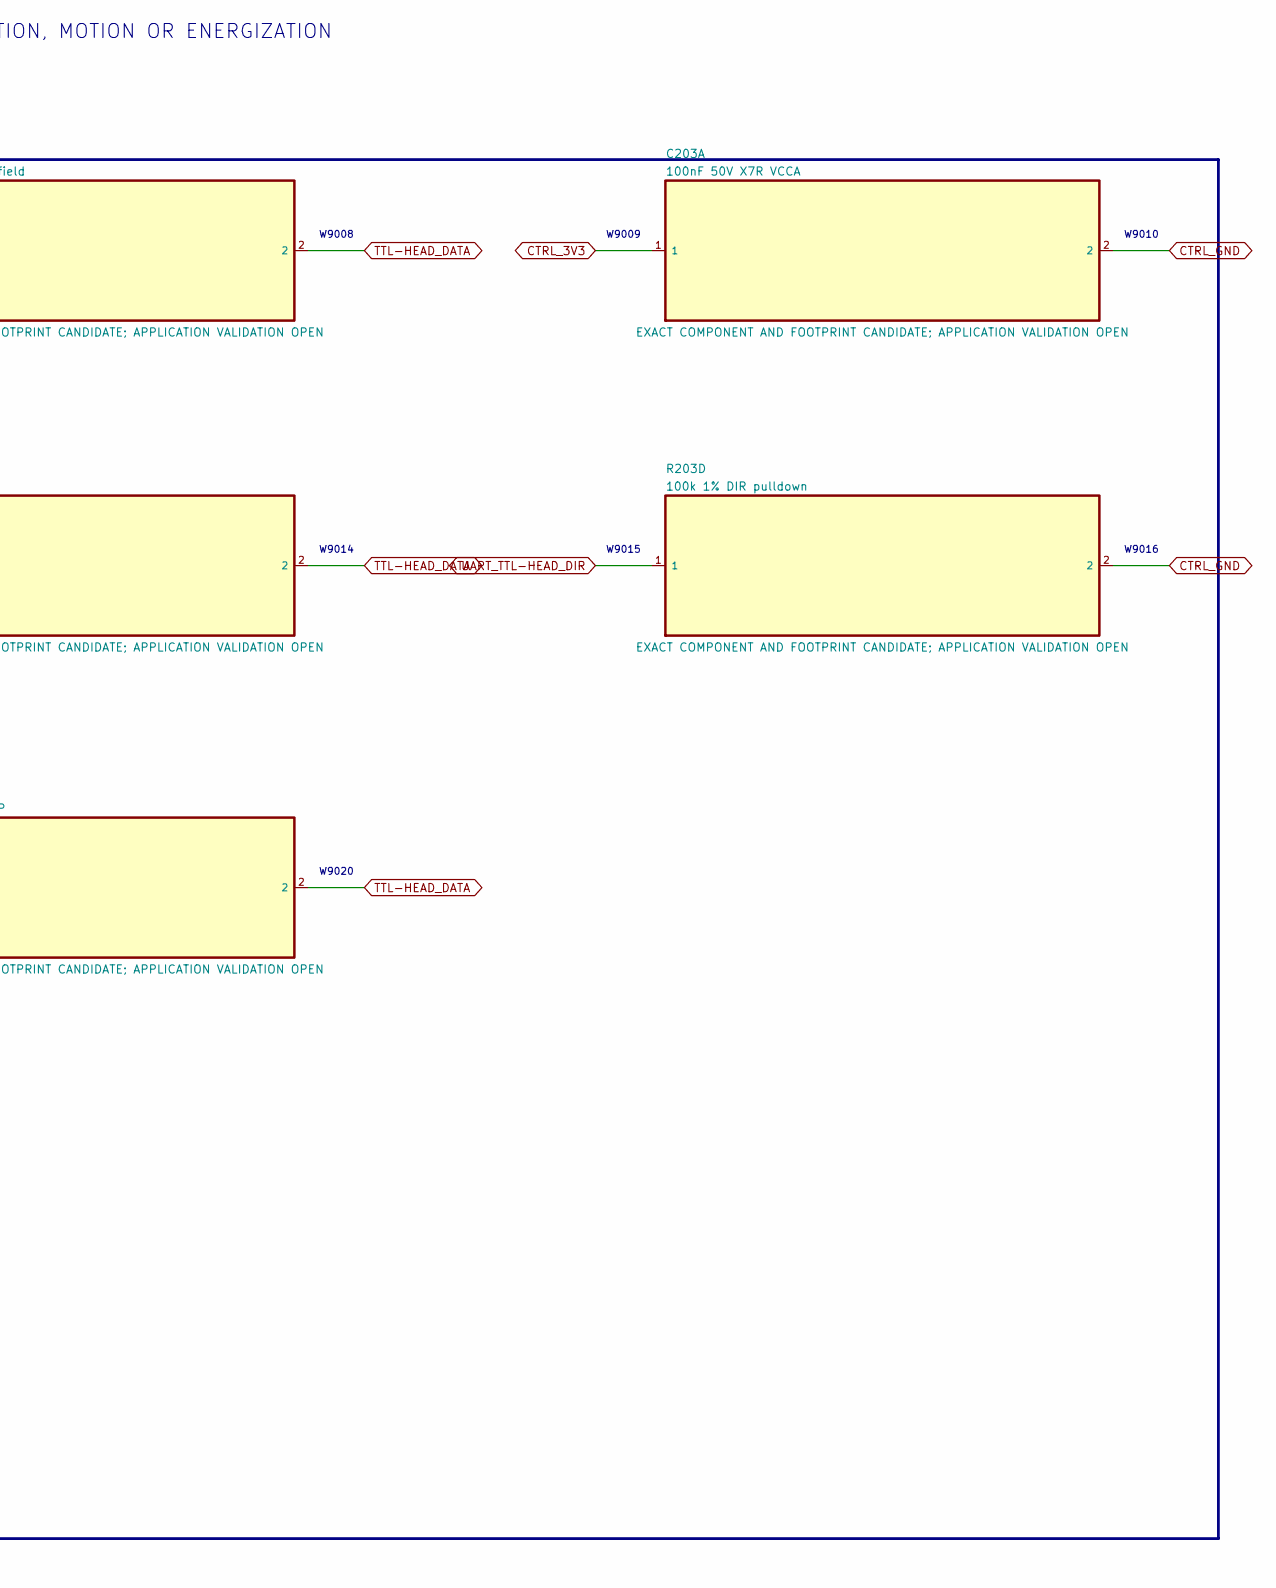
[picture p366: schematic 09_ttl_head.kicad_sch, PB HR-V0 P0.1 - 09, part in row 1, column 2]

Parts:
C203A: 100nF 50V X7R VCCA; C_0603_1608Metric
C203B: 100nF 50V X7R VCCB; C_0603_1608Metric
D203: TPD1E10B06 TTL ESD; D_SOD-523
J203: TTL-HEAD data-only field; JST_GH_BM02B-GHS-TBT_1x02-1MP_P1.25mm_Vertical
R203D: 100k 1% DIR pulldown; R_0603_1608Metric
R203P: 10k idle pullup - DNP; R_0603_1608Metric
R203S: 33R 1% series; R_0603_1608Metric
U203: SN74LVC1T45DCKR TTL-HEAD; SOT-363_SC-70-6

Connections:
CTRL_3V3: C203A.1, U203.1; also elsewhere on the board
CTRL_5V: C203B.1, R203P.1, U203.6; also elsewhere on the board
CTRL_GND: C203A.2, C203B.2, D203.2, J203.1, R203D.2, U203.2; also elsewhere on the board
TTL-HEAD_DATA: D203.1, J203.2, R203P.2, R203S.2
TTL-HEAD_DATA_PRE: R203S.1, U203.4
UART_TTL-HEAD_DIR: R203D.1, U203.5; also elsewhere on the board
UART_TTL-HEAD_TX: U203.3; also elsewhere on the board

Notes on the sheet:
PRELIMINARY - NOT APPROVED FOR PROCUREMENT, FABRICATION, ASSEMBLY, CONNECTION, MOTION OR ENERGIZATION
09 Carrier B - TTL-HEAD
Full translator network: dual-rail bypass, receive-default DIR, series damping, ESD and optional idle pull-up.
W9001
W9002
W9003
W9004
W9005
W9006
W9007
W9008
W9009
W9010
W9011
W9012
W9013
W9014
W9015
W9016
W9017
W9018
W9019
W9020
NOTE 1: Full translator network: dual-rail bypass, receive-default DIR, series damping, ESD
and optional idle pull-up.
NOTE 2: DNP/open configuration items are not permission to populate without the
configuration record.
NOTE 3: PRELIMINARY - NOT APPROVED FOR PROCUREMENT, FABRICATION, ASSEMBLY, CONNECTION,
MOTION OR ENERGIZATION

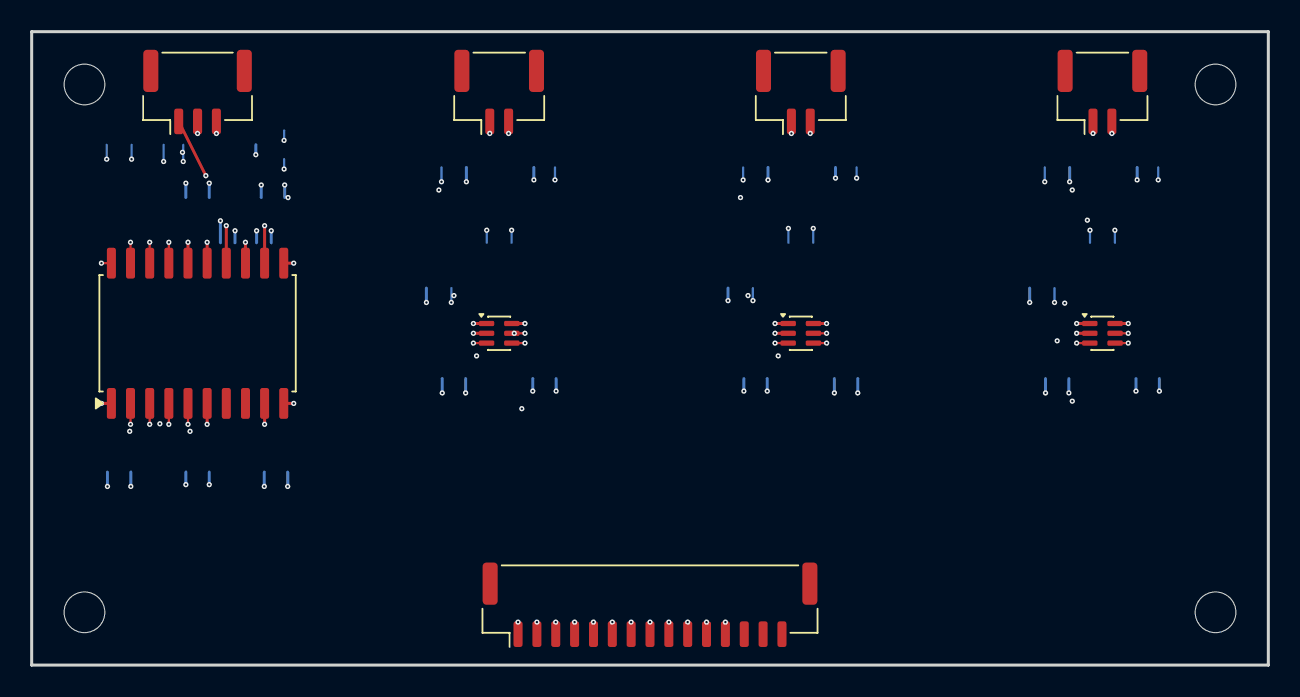
[picture p367: board hr30-carrier-b-p0.1.kicad_pcb from above]

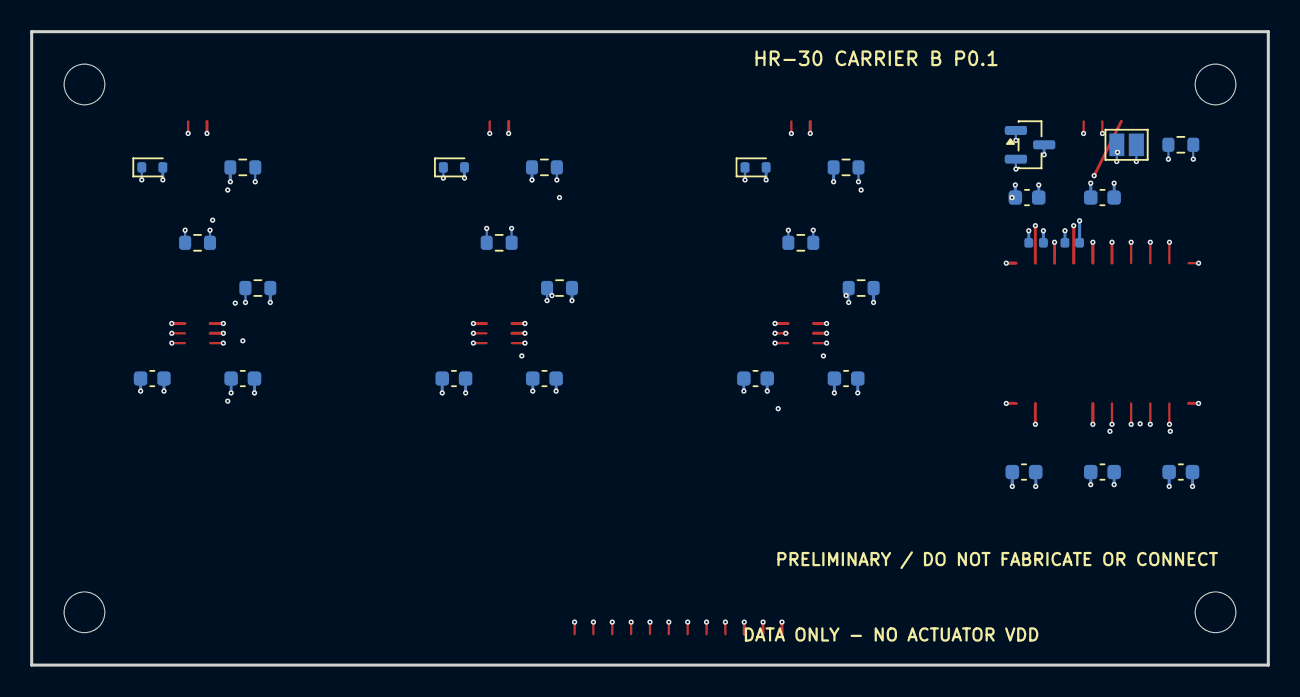
[picture p368: board hr30-carrier-b-p0.1.kicad_pcb from below]

Board: 6 copper layers, 82.0 x 42.0 mm, 41 parts (28 on the bottom side), 25 nets.

Other parts of the board:
JCB1: JST BM15B-GHS-TBT controller; JST_GH_BM15B-GHS-TBT_1x15-1MP_P1.25mm_Vertical
MHB1, MHB2, MHB3, MHB4: M2.5 BOARD-ONLY; TRAY STACK VALIDATION OPEN; MountingHole_2.7mm_M2.5

Their connections:
CTRL_3V3: JCB1.3; also elsewhere on the board
CTRL_5V: JCB1.2; also elsewhere on the board
CTRL_GND: JCB1.1; also elsewhere on the board
UART_RS-WAIST_DIR: JCB1.6; also elsewhere on the board
UART_RS-WAIST_RX: JCB1.5; also elsewhere on the board
UART_RS-WAIST_TX: JCB1.4; also elsewhere on the board
UART_TTL-HEAD_DIR: JCB1.12; also elsewhere on the board
UART_TTL-HEAD_TX: JCB1.11; also elsewhere on the board
UART_TTL-LDIST_DIR: JCB1.8; also elsewhere on the board
UART_TTL-LDIST_TX: JCB1.7; also elsewhere on the board
UART_TTL-RDIST_DIR: JCB1.10; also elsewhere on the board
UART_TTL-RDIST_TX: JCB1.9; also elsewhere on the board
