amyleesterling/humanoid-robot/test-fixtures/hr-v0-p121-no-load-fixture-p0.1/01_power_and_absence_boundary.kicad_sch

## KiCad design test-fixtures/hr-v0-p121-no-load-fixture-p0.1/01_power_and_absence_boundary.kicad_sch (2026-08-18)

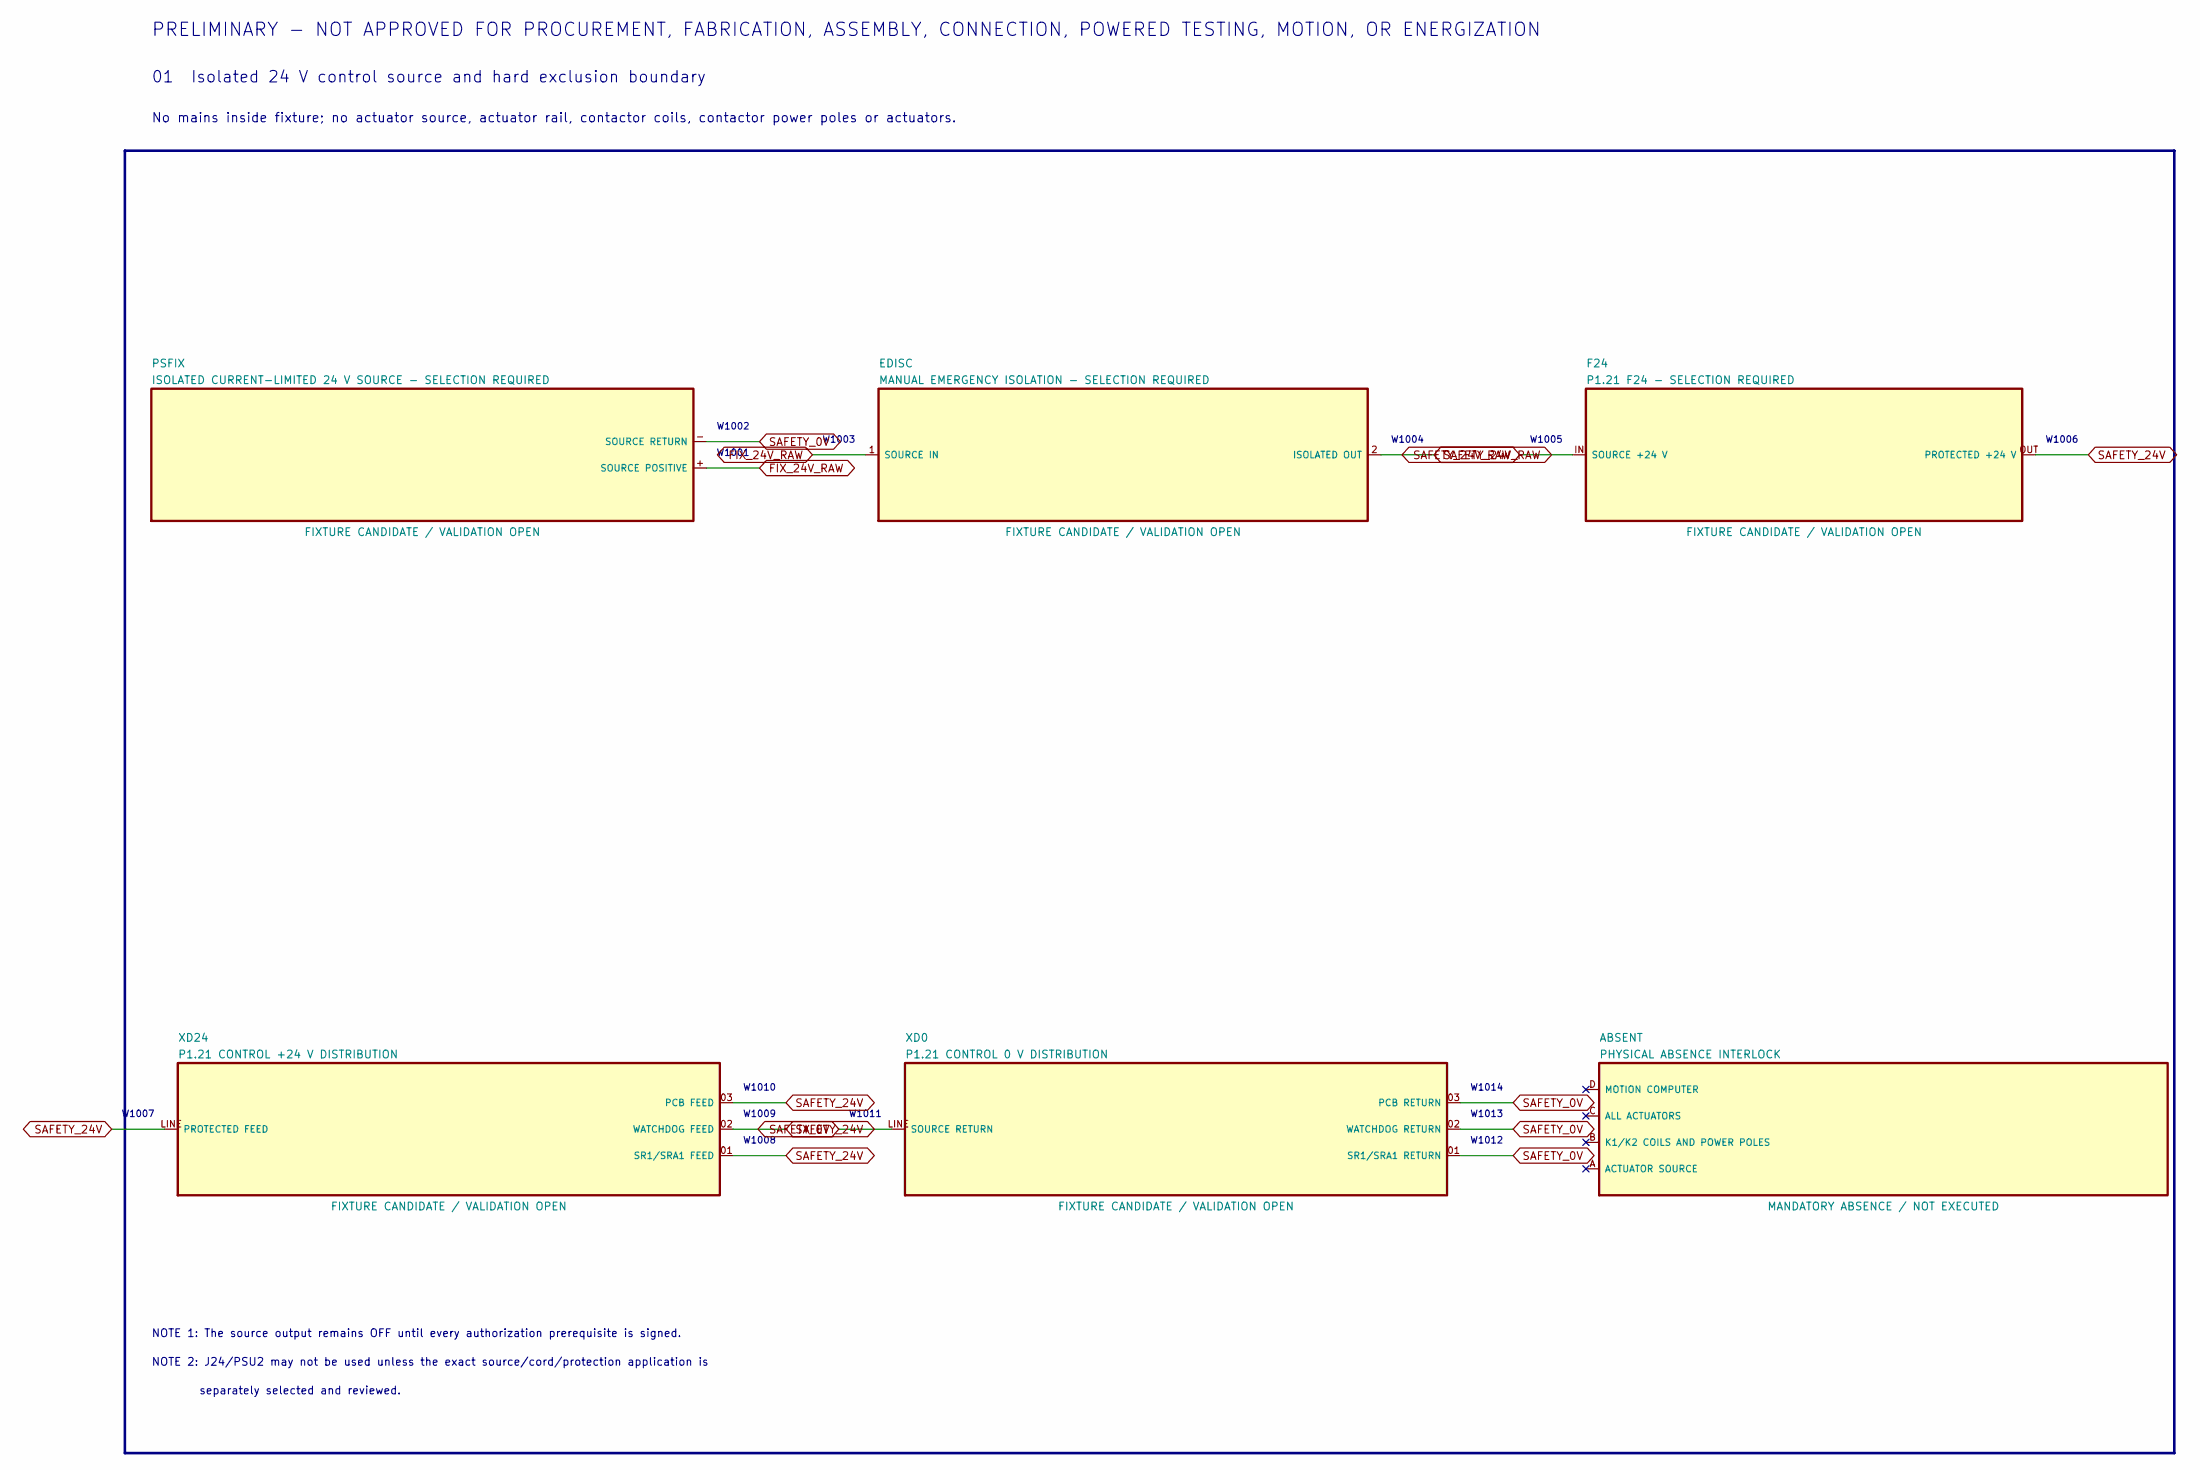
[picture p369: schematic 01_power_and_absence_boundary.kicad_sch]

Parts:
ABSENT: PHYSICAL ABSENCE INTERLOCK
EDISC: MANUAL EMERGENCY ISOLATION - SELECTION REQUIRED
F24: P1.21 F24 - SELECTION REQUIRED
PSFIX: ISOLATED CURRENT-LIMITED 24 V SOURCE - SELECTION 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
XD0: P1.21 CONTROL 0 V DISTRIBUTION
XD24: P1.21 CONTROL +24 V DISTRIBUTION

Connections:
FIX_24V_RAW: EDISC.1 (SOURCE IN), PSFIX.+ (SOURCE POSITIVE)
SAFETY_0V: PSFIX.- (SOURCE RETURN), XD0.01 (SR1/SRA1 RETURN), XD0.02 (WATCHDOG RETURN), XD0.03 (PCB RETURN), XD0.LINE (SOURCE RETURN)
SAFETY_24V: F24.OUT (PROTECTED +24 V), XD24.01 (SR1/SRA1 FEED), XD24.02 (WATCHDOG FEED), XD24.03 (PCB FEED), XD24.LINE (PROTECTED FEED)
SAFETY_24V_RAW: EDISC.2 (ISOLATED OUT), F24.IN (SOURCE +24 V)

Notes on the sheet:
PRELIMINARY - NOT APPROVED FOR PROCUREMENT, FABRICATION, ASSEMBLY, CONNECTION, POWERED TESTING, MOTION, OR ENERGIZATION
01 Isolated 24 V control source and hard exclusion boundary
No mains inside fixture; no actuator source, actuator rail, contactor coils, contactor power poles or actuators.
W1001
W1002
W1003
W1004
W1005
W1006
W1007
W1008
W1009
W1010
W1011
W1012
W1013
W1014
NOTE 1: The source output remains OFF until every authorization prerequisite is signed.
NOTE 2: J24/PSU2 may not be used unless the exact source/cord/protection application is
separately selected and reviewed.
