amyleesterling/humanoid-robot/test-fixtures/hr-v0-p121-no-load-fixture-p0.1/02_estop_and_eligibility_chain.kicad_sch

## KiCad design test-fixtures/hr-v0-p121-no-load-fixture-p0.1/02_estop_and_eligibility_chain.kicad_sch (2026-08-18)

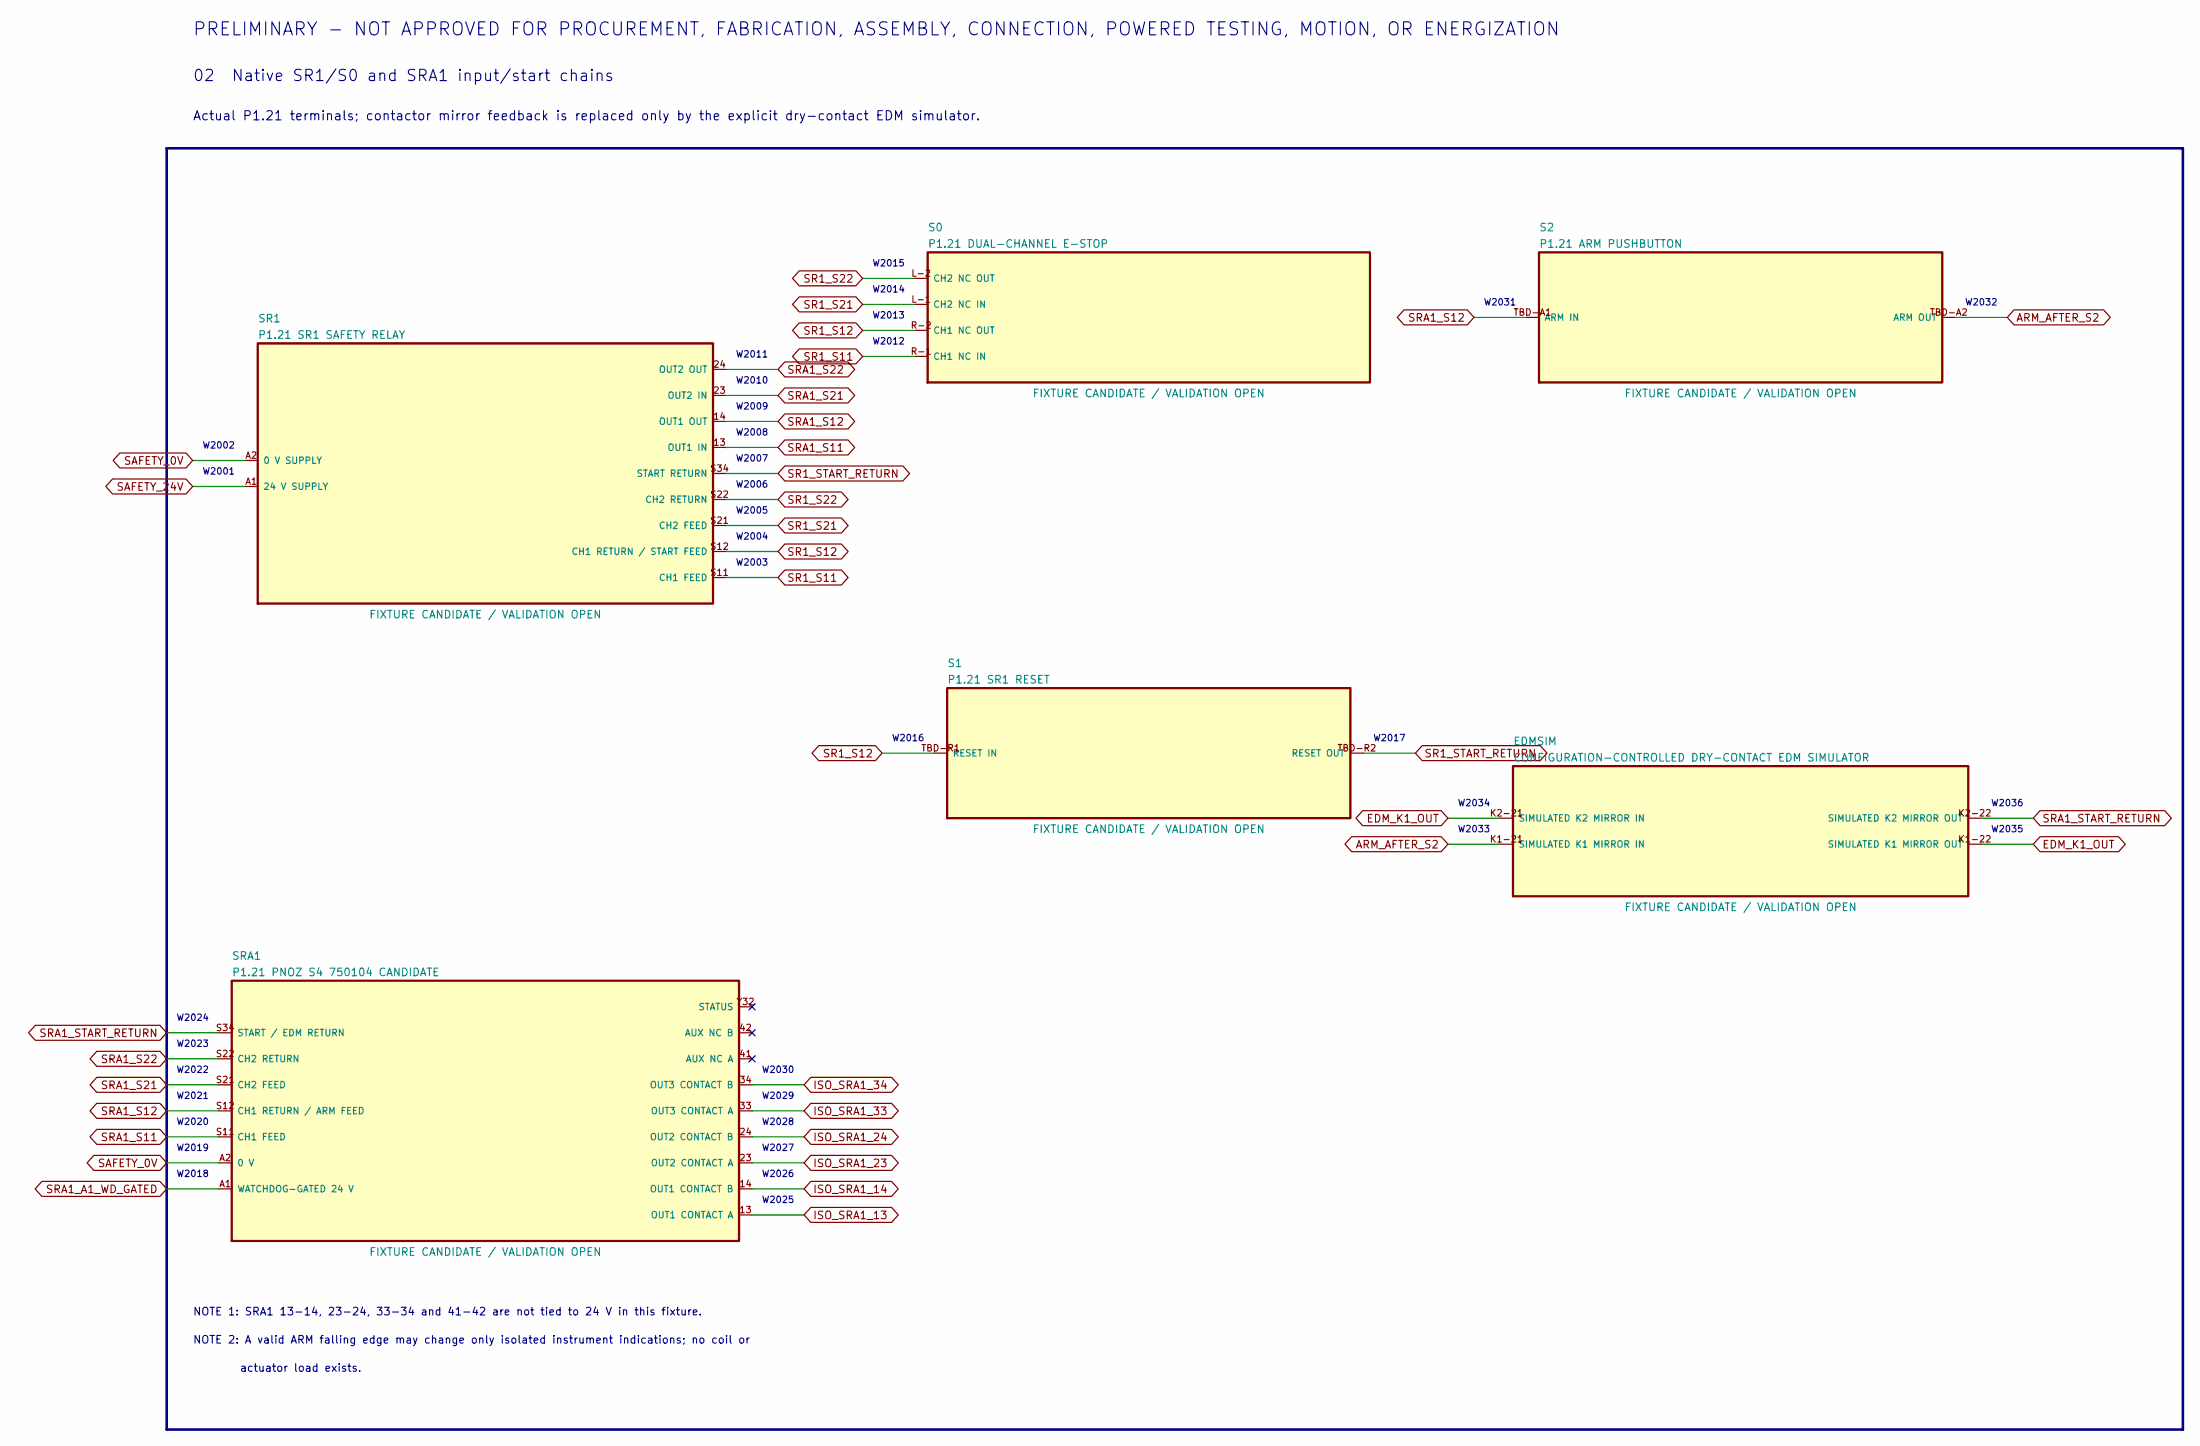
[picture p370: schematic 02_estop_and_eligibility_chain.kicad_sch]

Parts:
EDMSIM: CONFIGURATION-CONTROLLED DRY-CONTACT EDM SIMULATOR
S0: P1.21 DUAL-CHANNEL E-STOP
S1: P1.21 SR1 RESET
S2: P1.21 ARM PUSHBUTTON
SR1: P1.21 SR1 SAFETY RELAY
SRA1: P1.21 PNOZ S4 750104 CANDIDATE

Connections:
ARM_AFTER_S2: EDMSIM.K1-21 (SIMULATED K1 MIRROR IN), S2.TBD-A2 (ARM OUT)
EDM_K1_OUT: EDMSIM.K1-22 (SIMULATED K1 MIRROR OUT), EDMSIM.K2-21 (SIMULATED K2 MIRROR IN)
ISO_SRA1_13: SRA1.13 (OUT1 CONTACT A)
ISO_SRA1_14: SRA1.14 (OUT1 CONTACT B)
ISO_SRA1_23: SRA1.23 (OUT2 CONTACT A)
ISO_SRA1_24: SRA1.24 (OUT2 CONTACT B)
ISO_SRA1_33: SRA1.33 (OUT3 CONTACT A)
ISO_SRA1_34: SRA1.34 (OUT3 CONTACT B)
SAFETY_0V: SR1.A2 (0 V SUPPLY), SRA1.A2 (0 V)
SAFETY_24V: SR1.A1 (24 V SUPPLY)
SR1_S11: S0.R-1 (CH1 NC IN), SR1.S11 (CH1 FEED)
SR1_S12: S0.R-2 (CH1 NC OUT), S1.TBD-R1 (RESET IN), SR1.S12 (CH1 RETURN / START FEED)
SR1_S21: S0.L-1 (CH2 NC IN), SR1.S21 (CH2 FEED)
SR1_S22: S0.L-2 (CH2 NC OUT), SR1.S22 (CH2 RETURN)
SR1_START_RETURN: S1.TBD-R2 (RESET OUT), SR1.S34 (START RETURN)
SRA1_A1_WD_GATED: SRA1.A1 (WATCHDOG-GATED 24 V)
SRA1_S11: SR1.13 (OUT1 IN), SRA1.S11 (CH1 FEED)
SRA1_S12: S2.TBD-A1 (ARM IN), SR1.14 (OUT1 OUT), SRA1.S12 (CH1 RETURN / ARM FEED)
SRA1_S21: SR1.23 (OUT2 IN), SRA1.S21 (CH2 FEED)
SRA1_S22: SR1.24 (OUT2 OUT), SRA1.S22 (CH2 RETURN)
SRA1_START_RETURN: EDMSIM.K2-22 (SIMULATED K2 MIRROR OUT), SRA1.S34 (START / EDM RETURN)

Notes on the sheet:
PRELIMINARY - NOT APPROVED FOR PROCUREMENT, FABRICATION, ASSEMBLY, CONNECTION, POWERED TESTING, MOTION, OR ENERGIZATION
02 Native SR1/S0 and SRA1 input/start chains
Actual P1.21 terminals; contactor mirror feedback is replaced only by the explicit dry-contact EDM simulator.
W2001
W2002
W2003
W2004
W2005
W2006
W2007
W2008
W2009
W2010
W2011
W2012
W2013
W2014
W2015
W2016
W2017
W2018
W2019
W2020
W2021
W2022
W2023
W2024
W2025
W2026
W2027
W2028
W2029
W2030
W2031
W2032
W2033
W2034
W2035
W2036
NOTE 1: SRA1 13-14, 23-24, 33-34 and 41-42 are not tied to 24 V in this fixture.
NOTE 2: A valid ARM falling edge may change only isolated instrument indications; no coil or
actuator load exists.
