amyleesterling/humanoid-robot/test-fixtures/hr-v0-p121-no-load-fixture-p0.1/03_watchdog_gate_and_stimulus.kicad_sch

## KiCad design test-fixtures/hr-v0-p121-no-load-fixture-p0.1/03_watchdog_gate_and_stimulus.kicad_sch (2026-08-18)

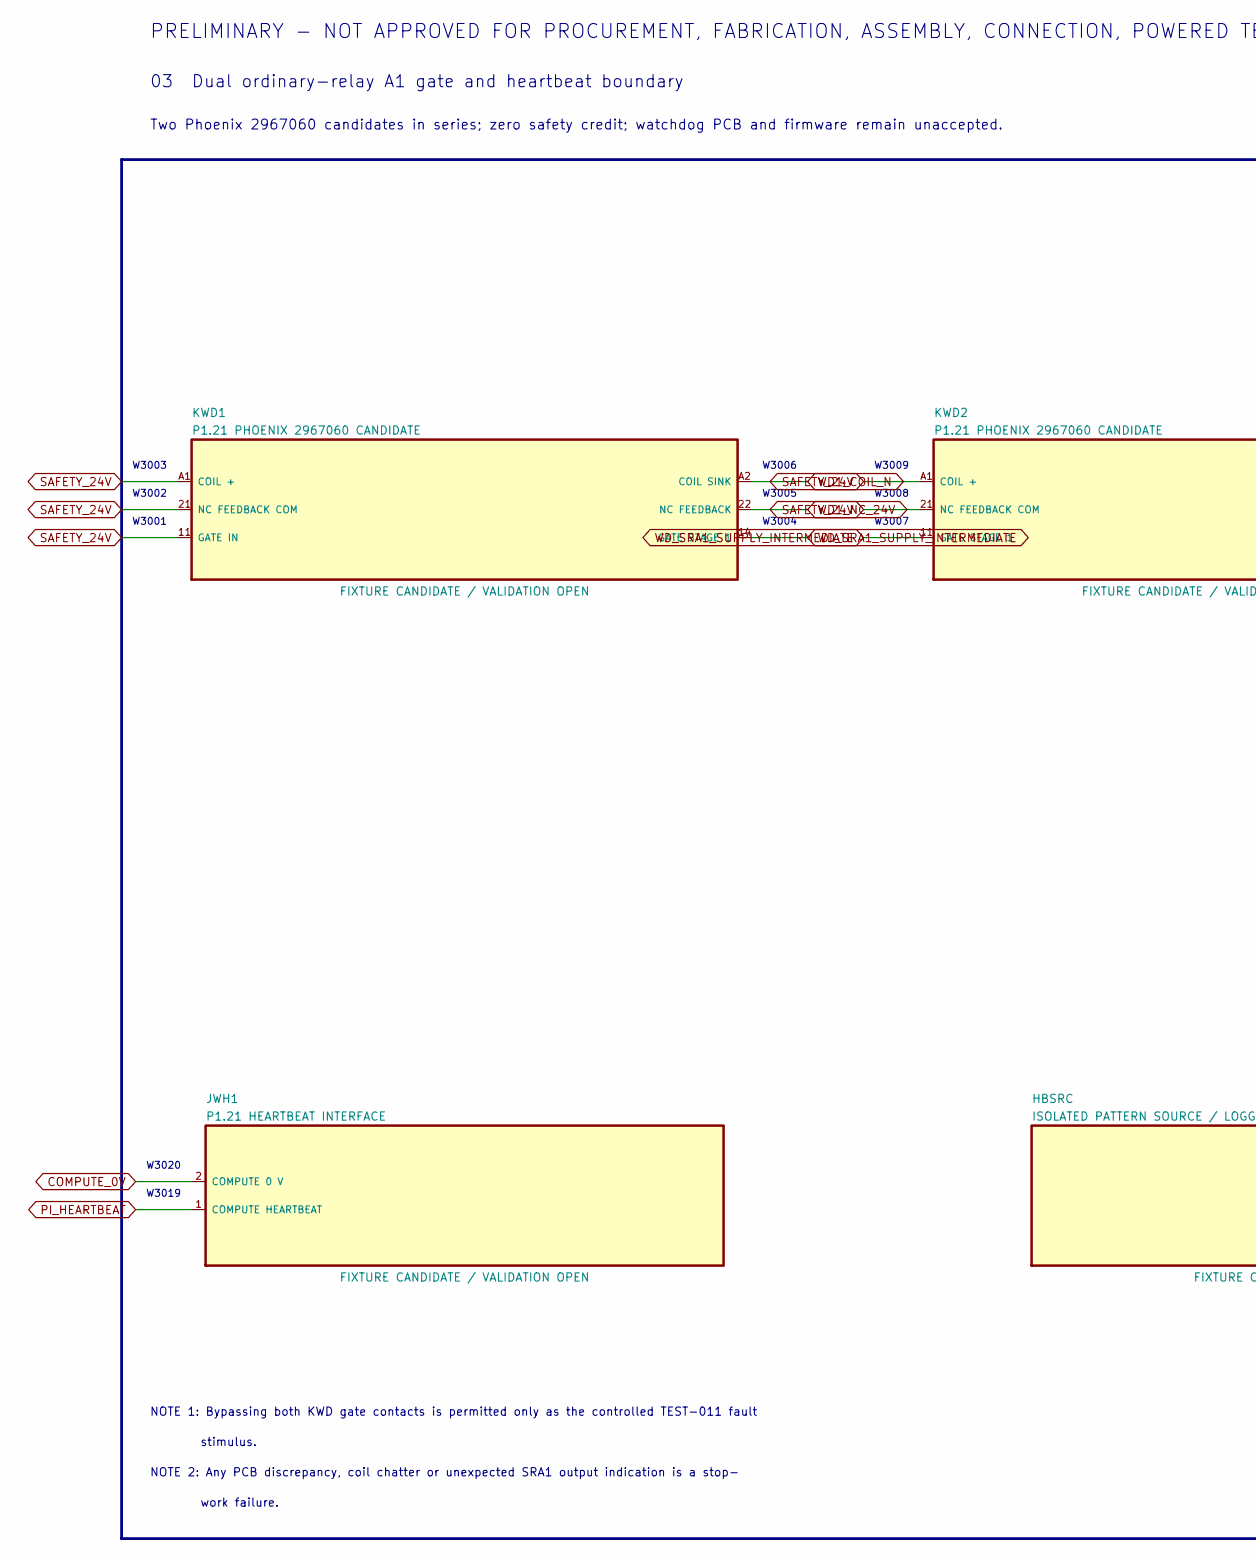
[picture p371: schematic 03_watchdog_gate_and_stimulus.kicad_sch, part in row 1, column 1]

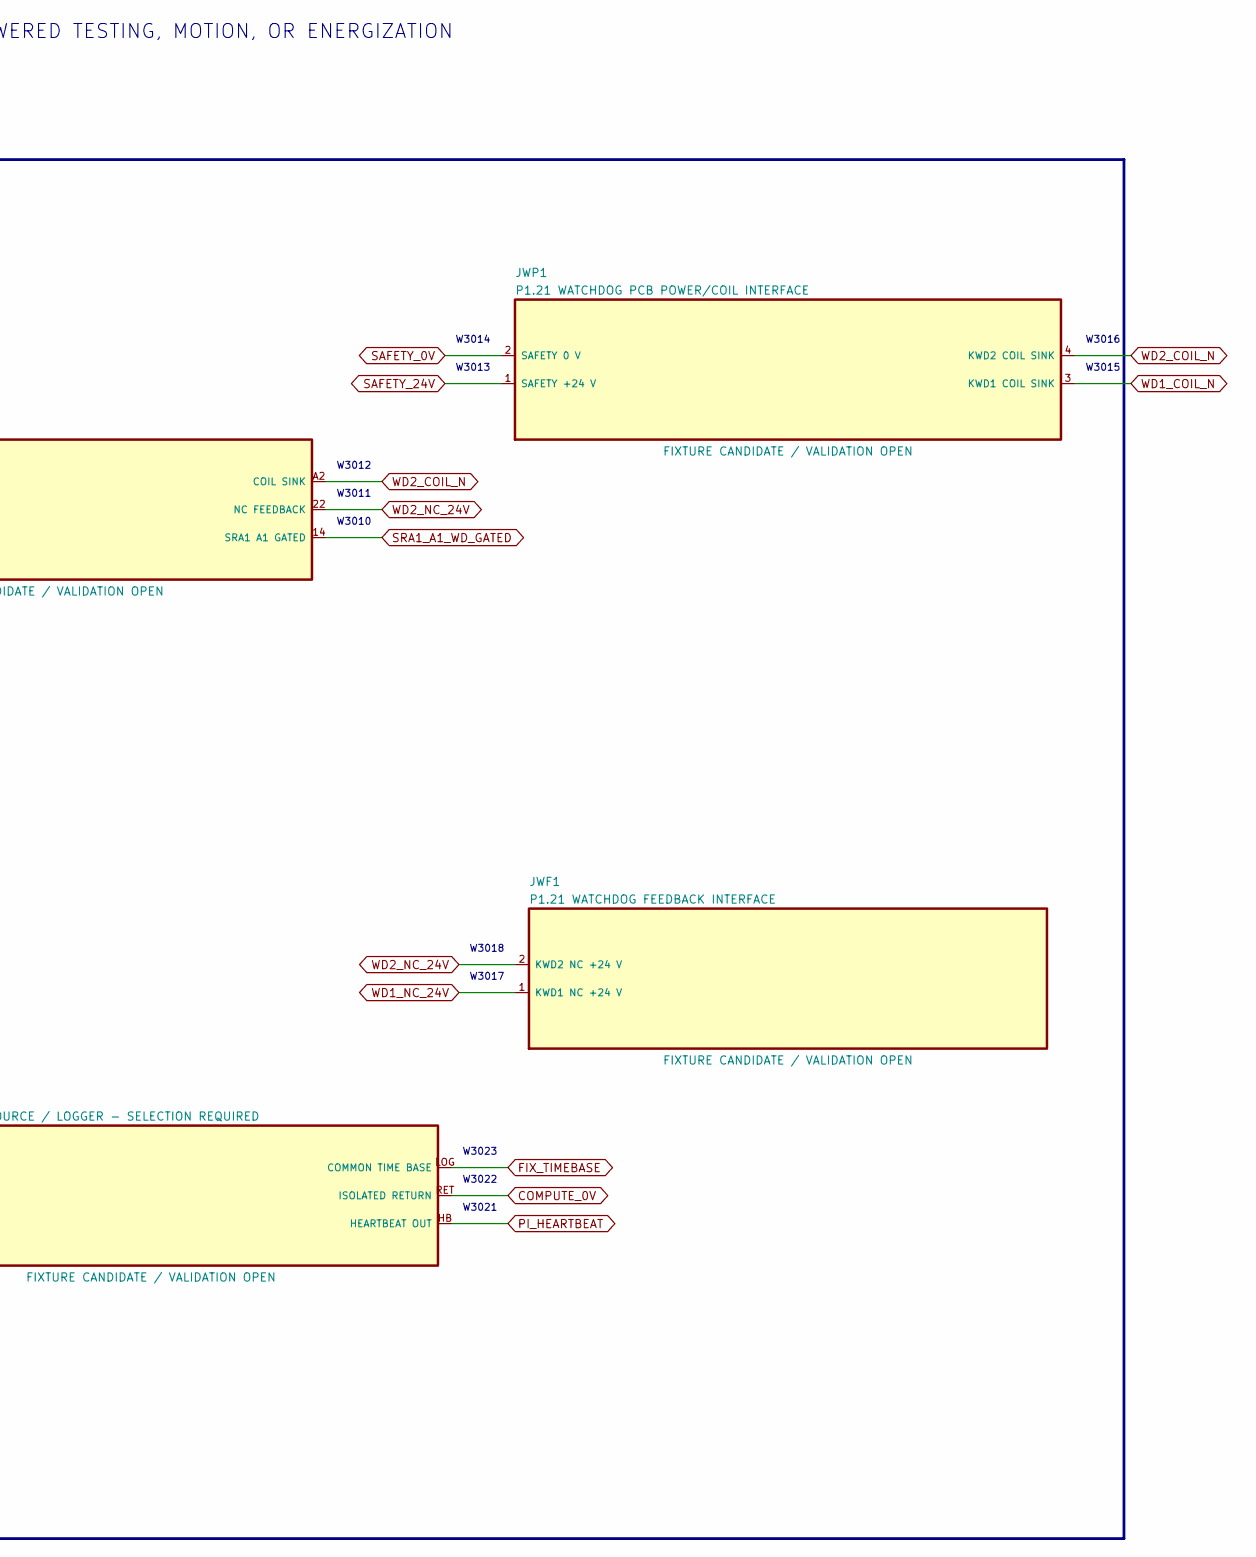
[picture p372: schematic 03_watchdog_gate_and_stimulus.kicad_sch, part in row 1, column 2]

Parts:
HBSRC: ISOLATED PATTERN SOURCE / LOGGER - SELECTION REQU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
JWF1: P1.21 WATCHDOG FEEDBACK INTERFACE
JWH1: P1.21 HEARTBEAT INTERFACE
JWP1: P1.21 WATCHDOG PCB POWER/COIL INTERFACE
KWD1, KWD2: P1.21 PHOENIX 2967060 CANDIDATE

Connections:
COMPUTE_0V: HBSRC.RET (ISOLATED RETURN), JWH1.2 (COMPUTE 0 V)
FIX_TIMEBASE: HBSRC.LOG (COMMON TIME BASE)
PI_HEARTBEAT: HBSRC.HB (HEARTBEAT OUT), JWH1.1 (COMPUTE HEARTBEAT)
SAFETY_0V: JWP1.2 (SAFETY 0 V)
SAFETY_24V: JWP1.1 (SAFETY +24 V), KWD1.11 (GATE IN), KWD1.21 (NC FEEDBACK COM), KWD1.A1 (COIL +), KWD2.21 (NC FEEDBACK COM), KWD2.A1 (COIL +)
SRA1_A1_WD_GATED: KWD2.14 (SRA1 A1 GATED)
WD1_COIL_N: JWP1.3 (KWD1 COIL SINK), KWD1.A2 (COIL SINK)
WD1_NC_24V: JWF1.1 (KWD1 NC +24 V), KWD1.22 (NC FEEDBACK)
WD2_COIL_N: JWP1.4 (KWD2 COIL SINK), KWD2.A2 (COIL SINK)
WD2_NC_24V: JWF1.2 (KWD2 NC +24 V), KWD2.22 (NC FEEDBACK)
WD_SRA1_SUPPLY_INTERMEDIATE: KWD1.14 (GATE STAGE 1), KWD2.11 (GATE STAGE 1)

Notes on the sheet:
PRELIMINARY - NOT APPROVED FOR PROCUREMENT, FABRICATION, ASSEMBLY, CONNECTION, POWERED TESTING, MOTION, OR ENERGIZATION
03 Dual ordinary-relay A1 gate and heartbeat boundary
Two Phoenix 2967060 candidates in series; zero safety credit; watchdog PCB and firmware remain unaccepted.
W3001
W3002
W3003
W3004
W3005
W3006
W3007
W3008
W3009
W3010
W3011
W3012
W3013
W3014
W3015
W3016
W3017
W3018
W3019
W3020
W3021
W3022
W3023
NOTE 1: Bypassing both KWD gate contacts is permitted only as the controlled TEST-011 fault
stimulus.
NOTE 2: Any PCB discrepancy, coil chatter or unexpected SRA1 output indication is a stop-
work failure.
