amyleesterling/humanoid-robot/test-fixtures/hr-v0-p121-no-load-fixture-p0.1/04_isolated_measurement_fanout.kicad_sch

## KiCad design test-fixtures/hr-v0-p121-no-load-fixture-p0.1/04_isolated_measurement_fanout.kicad_sch (2026-08-18)

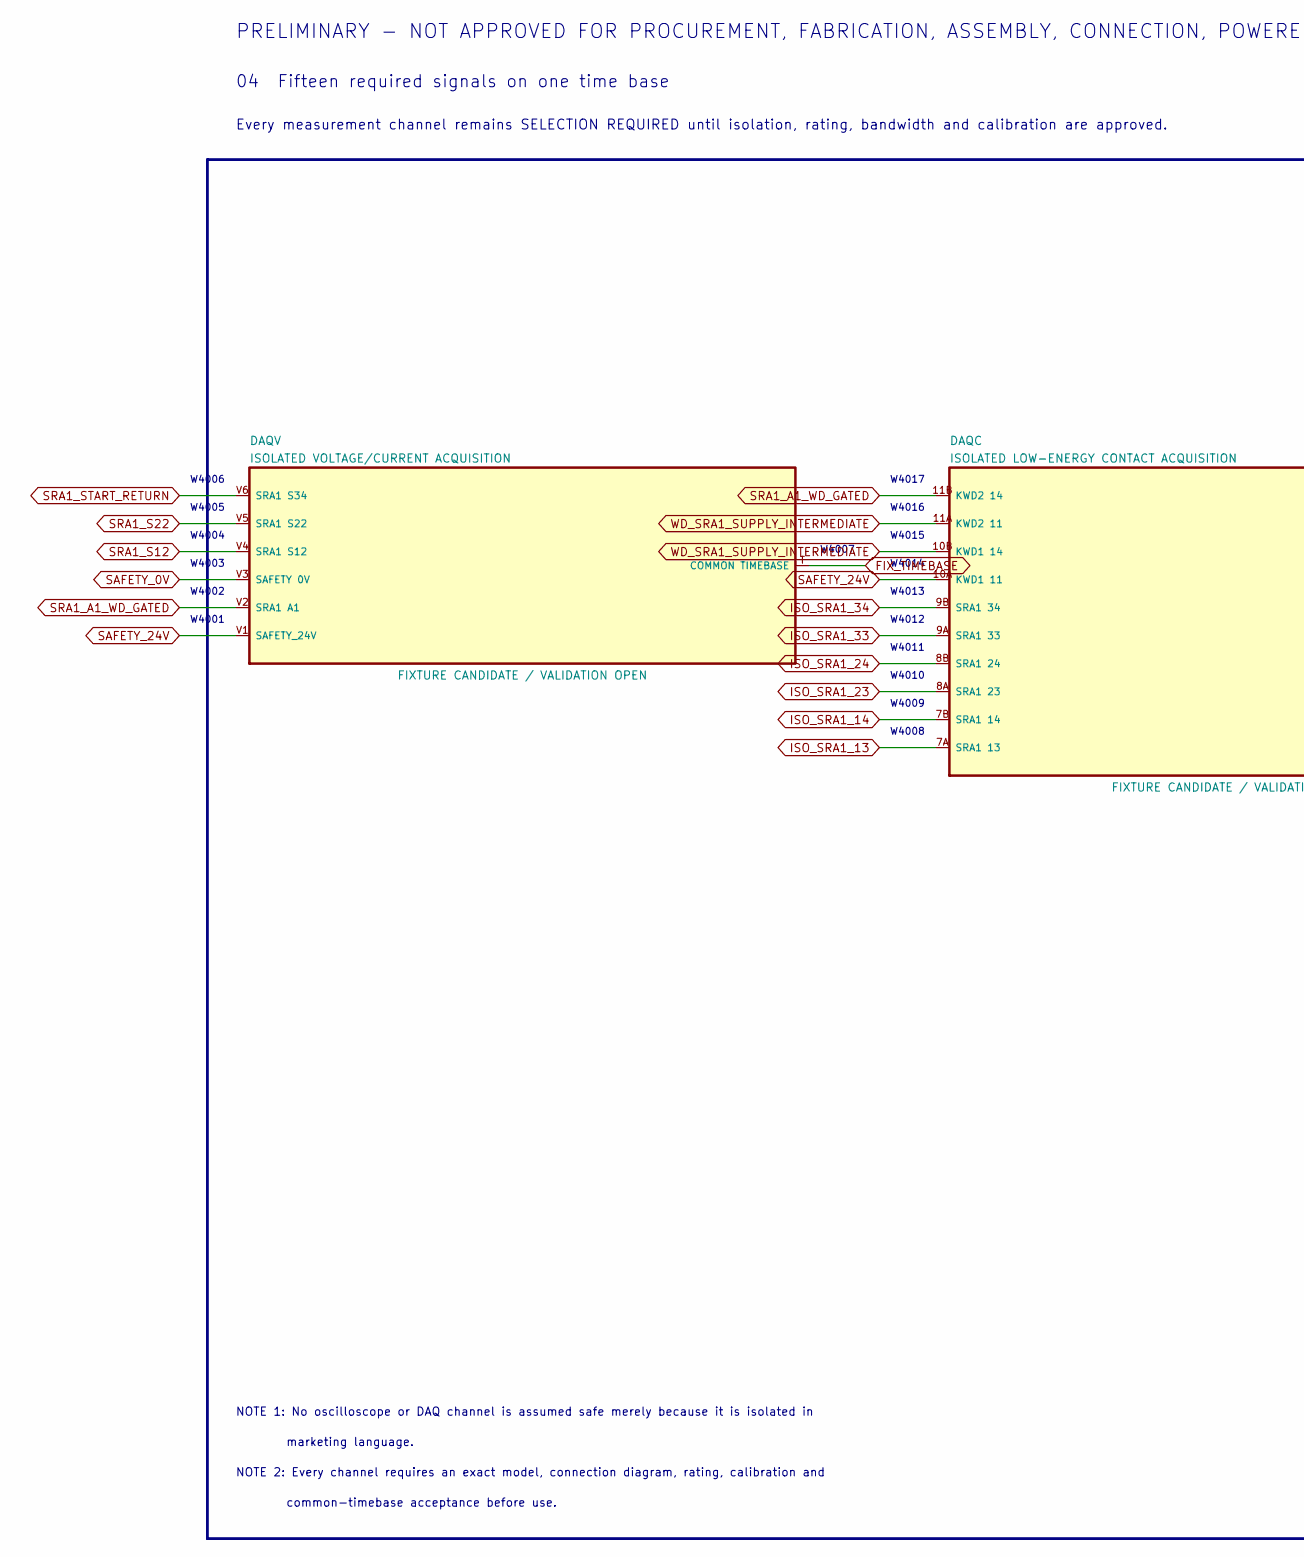
[picture p373: schematic 04_isolated_measurement_fanout.kicad_sch, part in row 1, column 1]

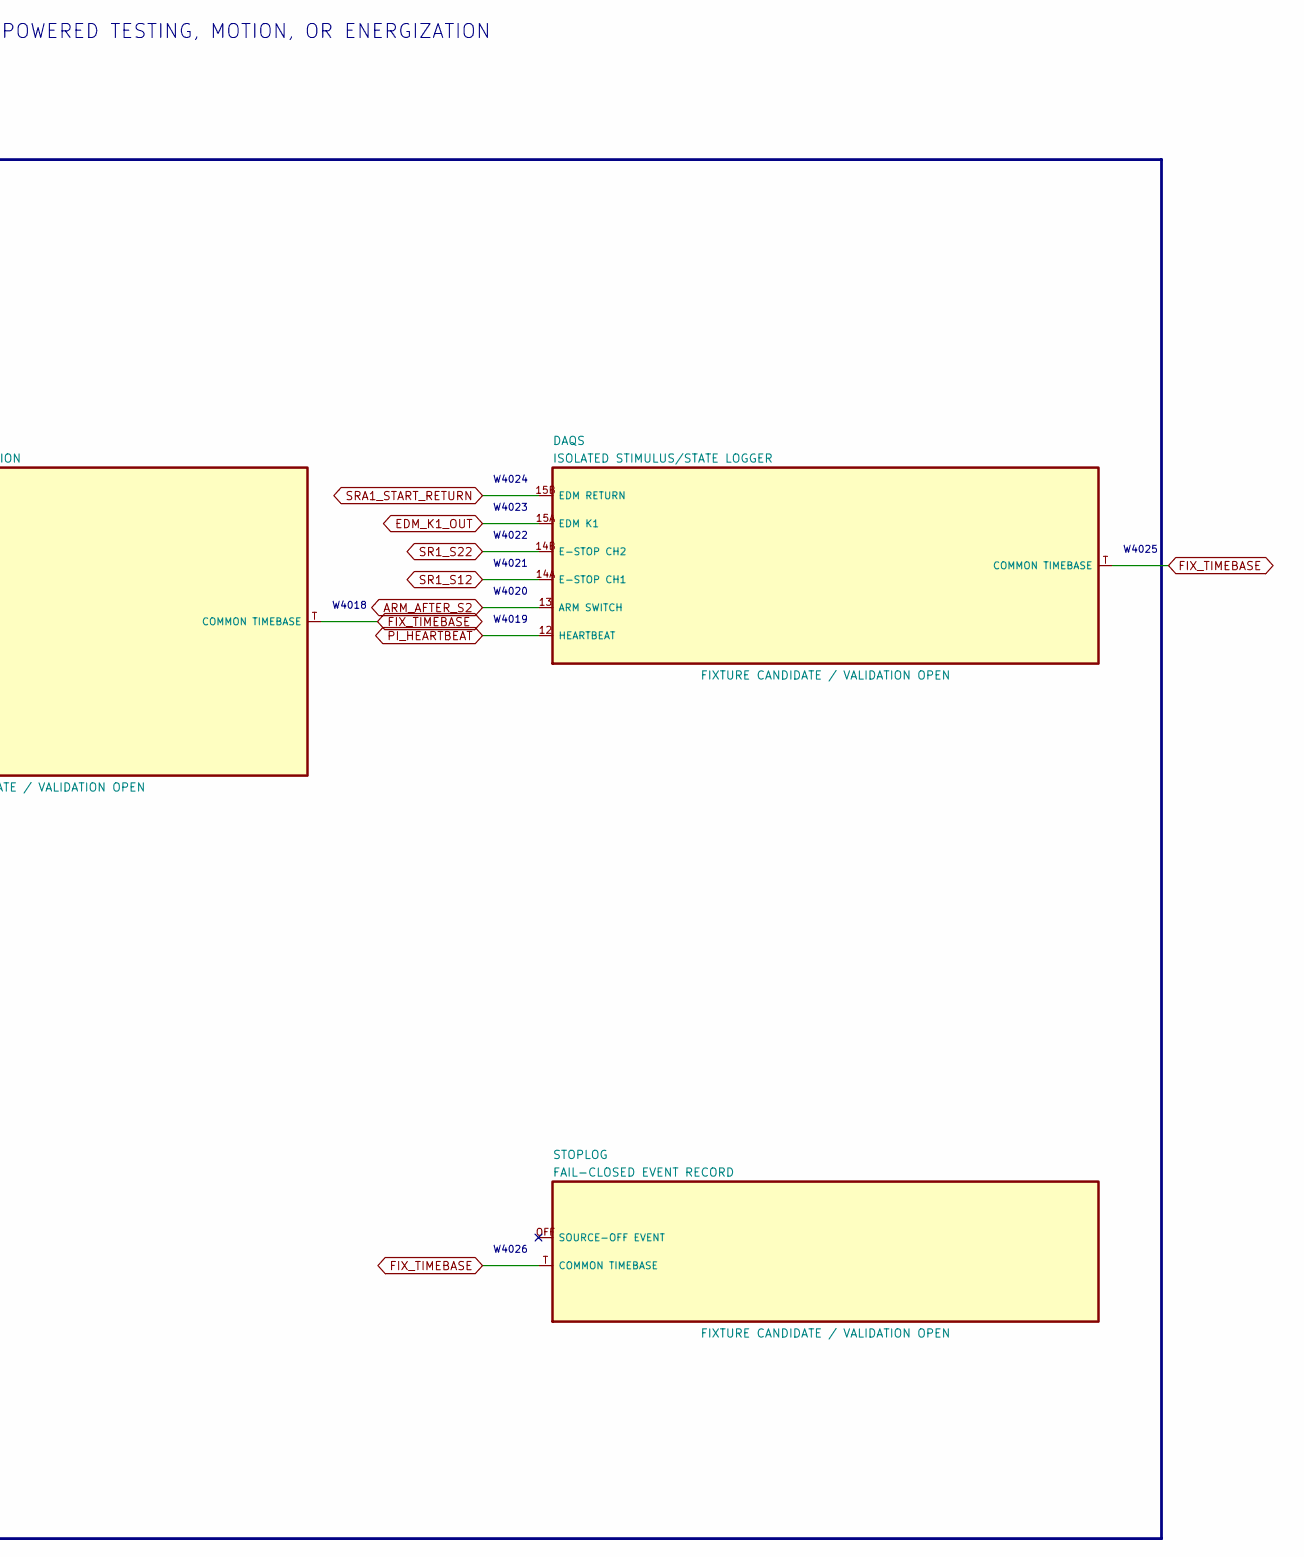
[picture p374: schematic 04_isolated_measurement_fanout.kicad_sch, part in row 1, column 2]

Parts:
DAQC: ISOLATED LOW-ENERGY CONTACT ACQUISITION
DAQS: ISOLATED STIMULUS/STATE LOGGER
DAQV: ISOLATED VOLTAGE/CURRENT ACQUISITION
STOPLOG: FAIL-CLOSED EVENT RECORD

Connections:
ARM_AFTER_S2: DAQS.13 (ARM SWITCH)
EDM_K1_OUT: DAQS.15A (EDM K1)
FIX_TIMEBASE: DAQC.T (COMMON TIMEBASE), DAQS.T (COMMON TIMEBASE), DAQV.T (COMMON TIMEBASE), STOPLOG.T (COMMON TIMEBASE)
ISO_SRA1_13: DAQC.7A (SRA1 13)
ISO_SRA1_14: DAQC.7B (SRA1 14)
ISO_SRA1_23: DAQC.8A (SRA1 23)
ISO_SRA1_24: DAQC.8B (SRA1 24)
ISO_SRA1_33: DAQC.9A (SRA1 33)
ISO_SRA1_34: DAQC.9B (SRA1 34)
PI_HEARTBEAT: DAQS.12 (HEARTBEAT)
SAFETY_0V: DAQV.V3 (SAFETY 0V)
SAFETY_24V: DAQC.10A (KWD1 11), DAQV.V1 (SAFETY_24V)
SR1_S12: DAQS.14A (E-STOP CH1)
SR1_S22: DAQS.14B (E-STOP CH2)
SRA1_A1_WD_GATED: DAQC.11B (KWD2 14), DAQV.V2 (SRA1 A1)
SRA1_S12: DAQV.V4 (SRA1 S12)
SRA1_S22: DAQV.V5 (SRA1 S22)
SRA1_START_RETURN: DAQS.15B (EDM RETURN), DAQV.V6 (SRA1 S34)
WD_SRA1_SUPPLY_INTERMEDIATE: DAQC.10B (KWD1 14), DAQC.11A (KWD2 11)

Notes on the sheet:
PRELIMINARY - NOT APPROVED FOR PROCUREMENT, FABRICATION, ASSEMBLY, CONNECTION, POWERED TESTING, MOTION, OR ENERGIZATION
04 Fifteen required signals on one time base
Every measurement channel remains SELECTION REQUIRED until isolation, rating, bandwidth and calibration are approved.
W4001
W4002
W4003
W4004
W4005
W4006
W4007
W4008
W4009
W4010
W4011
W4012
W4013
W4014
W4015
W4016
W4017
W4018
W4019
W4020
W4021
W4022
W4023
W4024
W4025
W4026
NOTE 1: No oscilloscope or DAQ channel is assumed safe merely because it is isolated in
marketing language.
NOTE 2: Every channel requires an exact model, connection diagram, rating, calibration and
common-timebase acceptance before use.
