amyleesterling/humanoid-robot/hr30/whole-body-p0.1/electrical/kicad/hr30-whole-body-electrical-p0.1/01_energy_precharge_conversion.kicad_sch

## KiCad design hr30/whole-body-p0.1/electrical/kicad/hr30-whole-body-electrical-p0.1/01_energy_precharge_conversion.kicad_sch (2026-08-15)

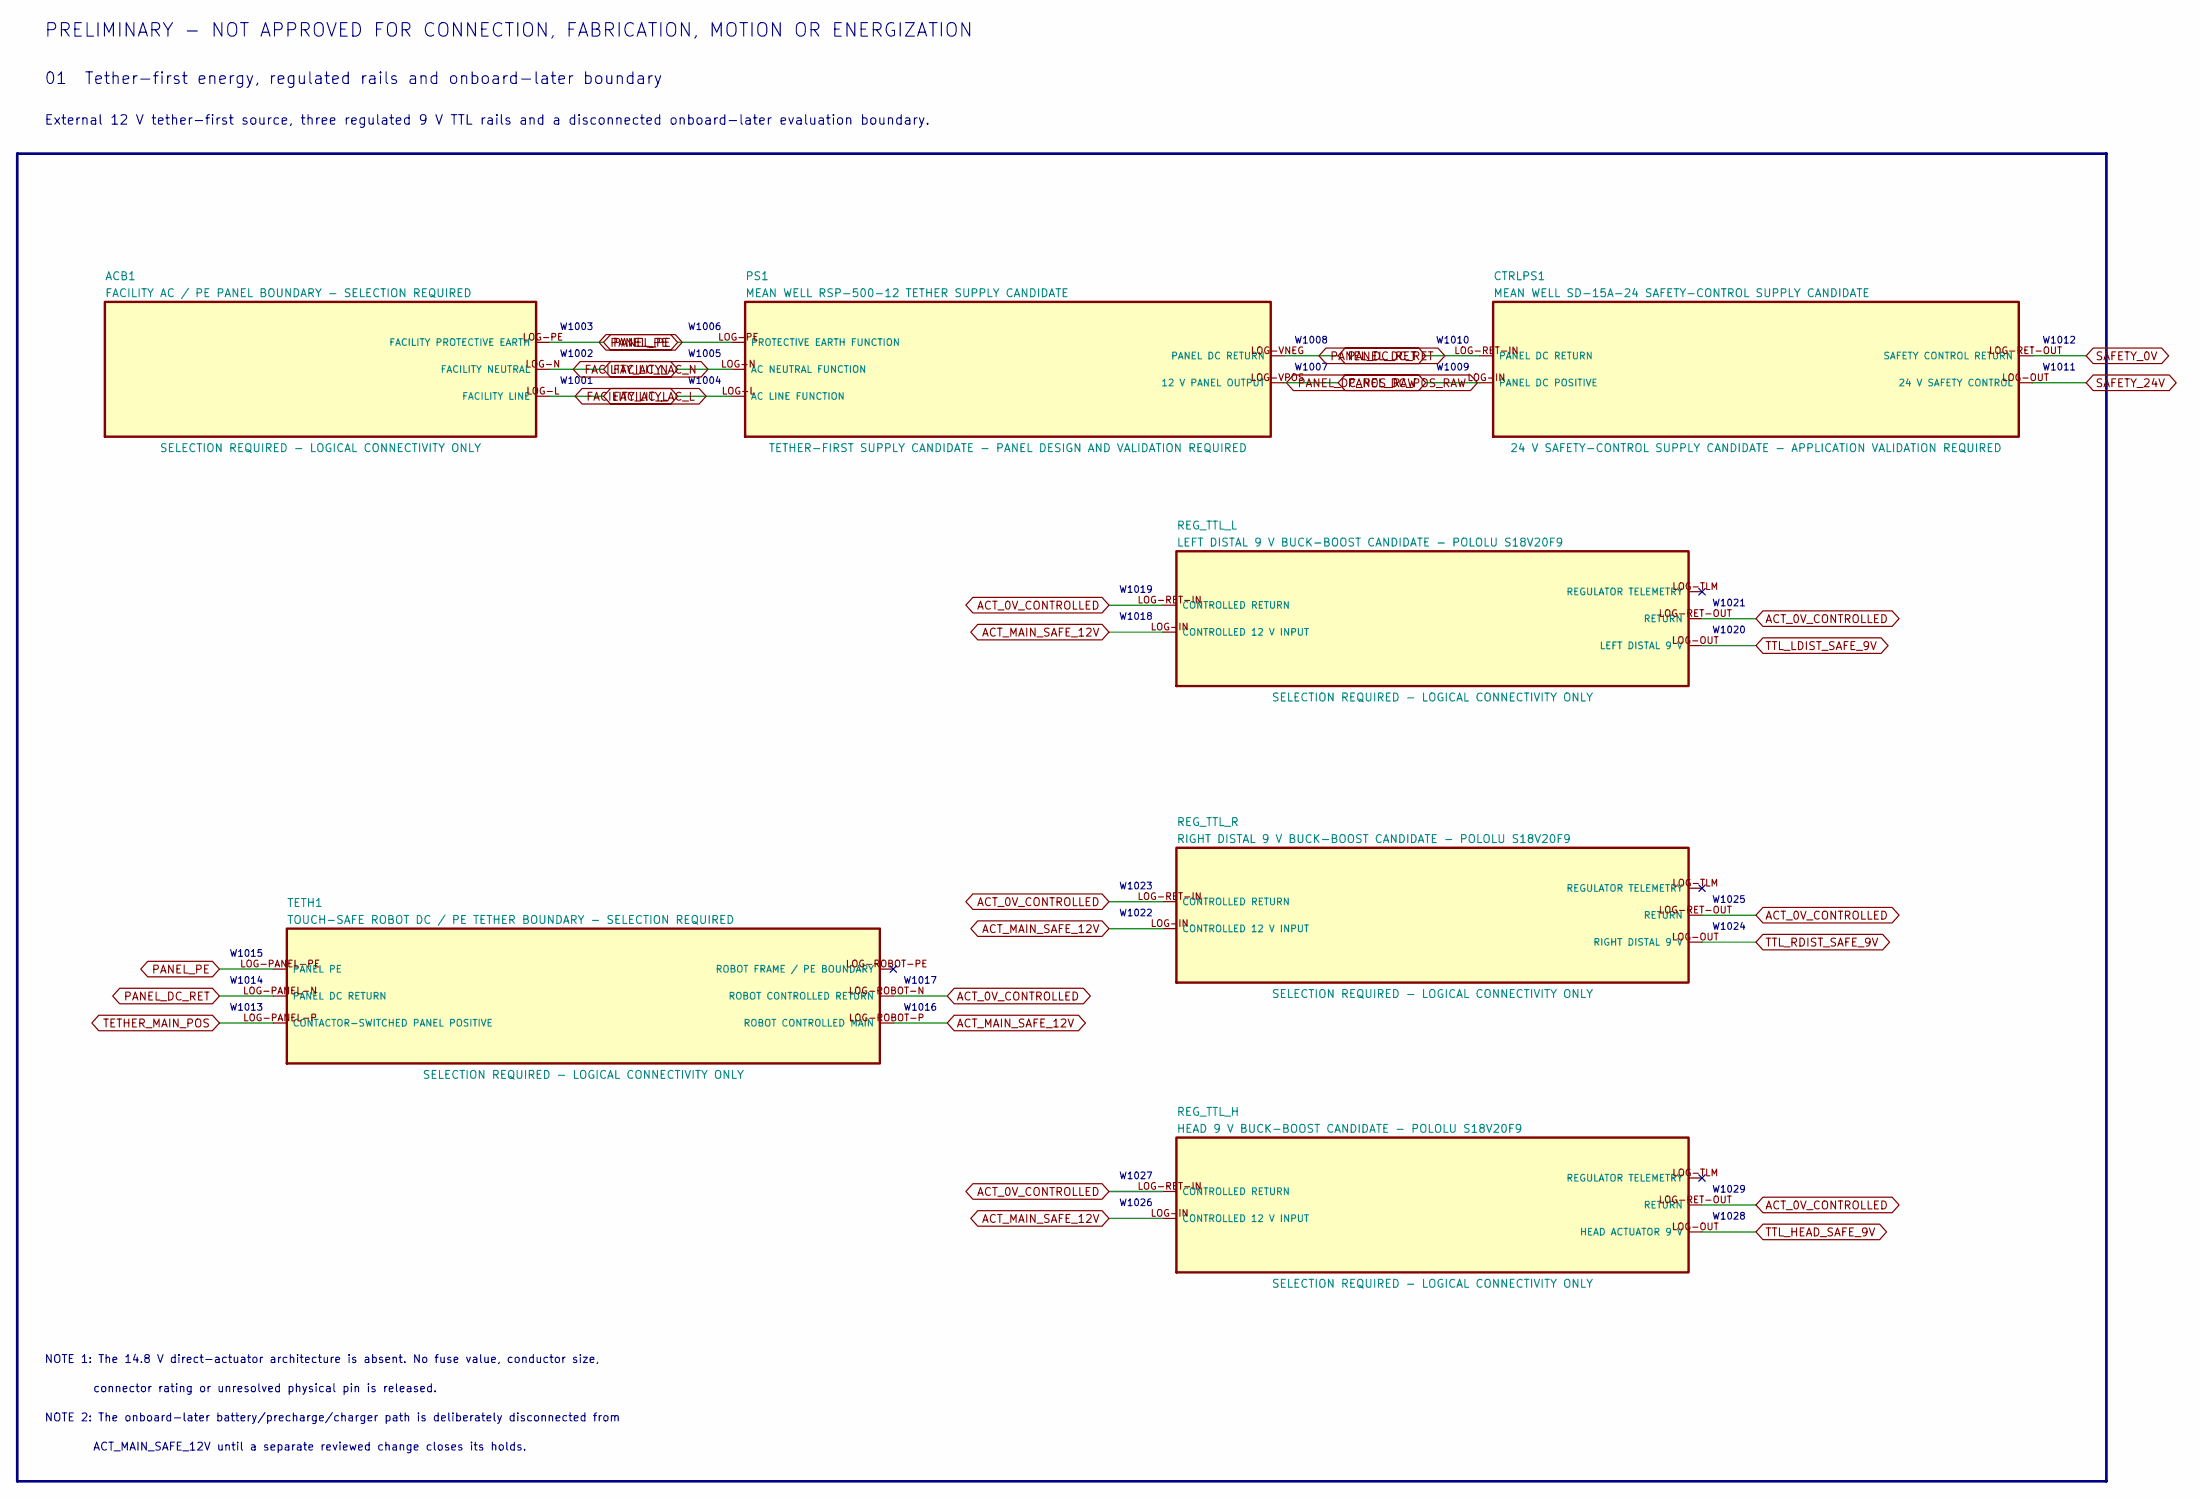
[picture p375: schematic 01_energy_precharge_conversion.kicad_sch]

Parts:
ACB1: FACILITY AC / PE PANEL BOUNDARY - SELECTION REQUI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
CTRLPS1: MEAN WELL SD-15A-24 SAFETY-CONTROL SUPPLY CANDIDA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
PS1: MEAN WELL RSP-500-12 TETHER SUPPLY CANDIDATE
REG_TTL_H: HEAD 9 V BUCK-BOOST CANDIDATE - POLOLU S18V20F9
REG_TTL_L: LEFT DISTAL 9 V BUCK-BOOST CANDIDATE - POLOLU S18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
REG_TTL_R: RIGHT DISTAL 9 V BUCK-BOOST CANDIDATE - POLOLU S1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
TETH1: TOUCH-SAFE ROBOT DC / PE TETHER BOUNDARY - SELECT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

Connections:
ACT_0V_CONTROLLED: REG_TTL_H.LOG-RET-IN (CONTROLLED RETURN), REG_TTL_H.LOG-RET-OUT (RETURN), REG_TTL_L.LOG-RET-IN (CONTROLLED RETURN), REG_TTL_L.LOG-RET-OUT (RETURN), REG_TTL_R.LOG-RET-IN (CONTROLLED RETURN), REG_TTL_R.LOG-RET-OUT (RETURN), TETH1.LOG-ROBOT-N (ROBOT CONTROLLED RETURN)
ACT_MAIN_SAFE_12V: REG_TTL_H.LOG-IN (CONTROLLED 12 V INPUT), REG_TTL_L.LOG-IN (CONTROLLED 12 V INPUT), REG_TTL_R.LOG-IN (CONTROLLED 12 V INPUT), TETH1.LOG-ROBOT-P (ROBOT CONTROLLED MAIN)
FACILITY_AC_L: ACB1.LOG-L (FACILITY LINE), PS1.LOG-L (AC LINE FUNCTION)
FACILITY_AC_N: ACB1.LOG-N (FACILITY NEUTRAL), PS1.LOG-N (AC NEUTRAL FUNCTION)
PANEL_DC_POS_RAW: CTRLPS1.LOG-IN (PANEL DC POSITIVE), PS1.LOG-VPOS (12 V PANEL OUTPUT)
PANEL_DC_RET: CTRLPS1.LOG-RET-IN (PANEL DC RETURN), PS1.LOG-VNEG (PANEL DC RETURN), TETH1.LOG-PANEL-N (PANEL DC RETURN)
PANEL_PE: ACB1.LOG-PE (FACILITY PROTECTIVE EARTH), PS1.LOG-PE (PROTECTIVE EARTH FUNCTION), TETH1.LOG-PANEL-PE (PANEL PE)
SAFETY_0V: CTRLPS1.LOG-RET-OUT (SAFETY CONTROL RETURN)
SAFETY_24V: CTRLPS1.LOG-OUT (24 V SAFETY CONTROL)
TETHER_MAIN_POS: TETH1.LOG-PANEL-P (CONTACTOR-SWITCHED PANEL POSITIVE)
TTL_HEAD_SAFE_9V: REG_TTL_H.LOG-OUT (HEAD ACTUATOR 9 V)
TTL_LDIST_SAFE_9V: REG_TTL_L.LOG-OUT (LEFT DISTAL 9 V)
TTL_RDIST_SAFE_9V: REG_TTL_R.LOG-OUT (RIGHT DISTAL 9 V)

Notes on the sheet:
PRELIMINARY - NOT APPROVED FOR CONNECTION, FABRICATION, MOTION OR ENERGIZATION
01 Tether-first energy, regulated rails and onboard-later boundary
External 12 V tether-first source, three regulated 9 V TTL rails and a disconnected onboard-later evaluation boundary.
W1001
W1002
W1003
W1004
W1005
W1006
W1007
W1008
W1009
W1010
W1011
W1012
W1013
W1014
W1015
W1016
W1017
W1018
W1019
W1020
W1021
W1022
W1023
W1024
W1025
W1026
W1027
W1028
W1029
NOTE 1: The 14.8 V direct-actuator architecture is absent. No fuse value, conductor size,
connector rating or unresolved physical pin is released.
NOTE 2: The onboard-later battery/precharge/charger path is deliberately disconnected from
ACT_MAIN_SAFE_12V until a separate reviewed change closes its holds.
