amyleesterling/humanoid-robot/hr30/whole-body-p0.1/electrical/kicad/hr30-whole-body-electrical-p0.1/02_estop_permit_contactors.kicad_sch

## KiCad design hr30/whole-body-p0.1/electrical/kicad/hr30-whole-body-electrical-p0.1/02_estop_permit_contactors.kicad_sch (2026-08-15)

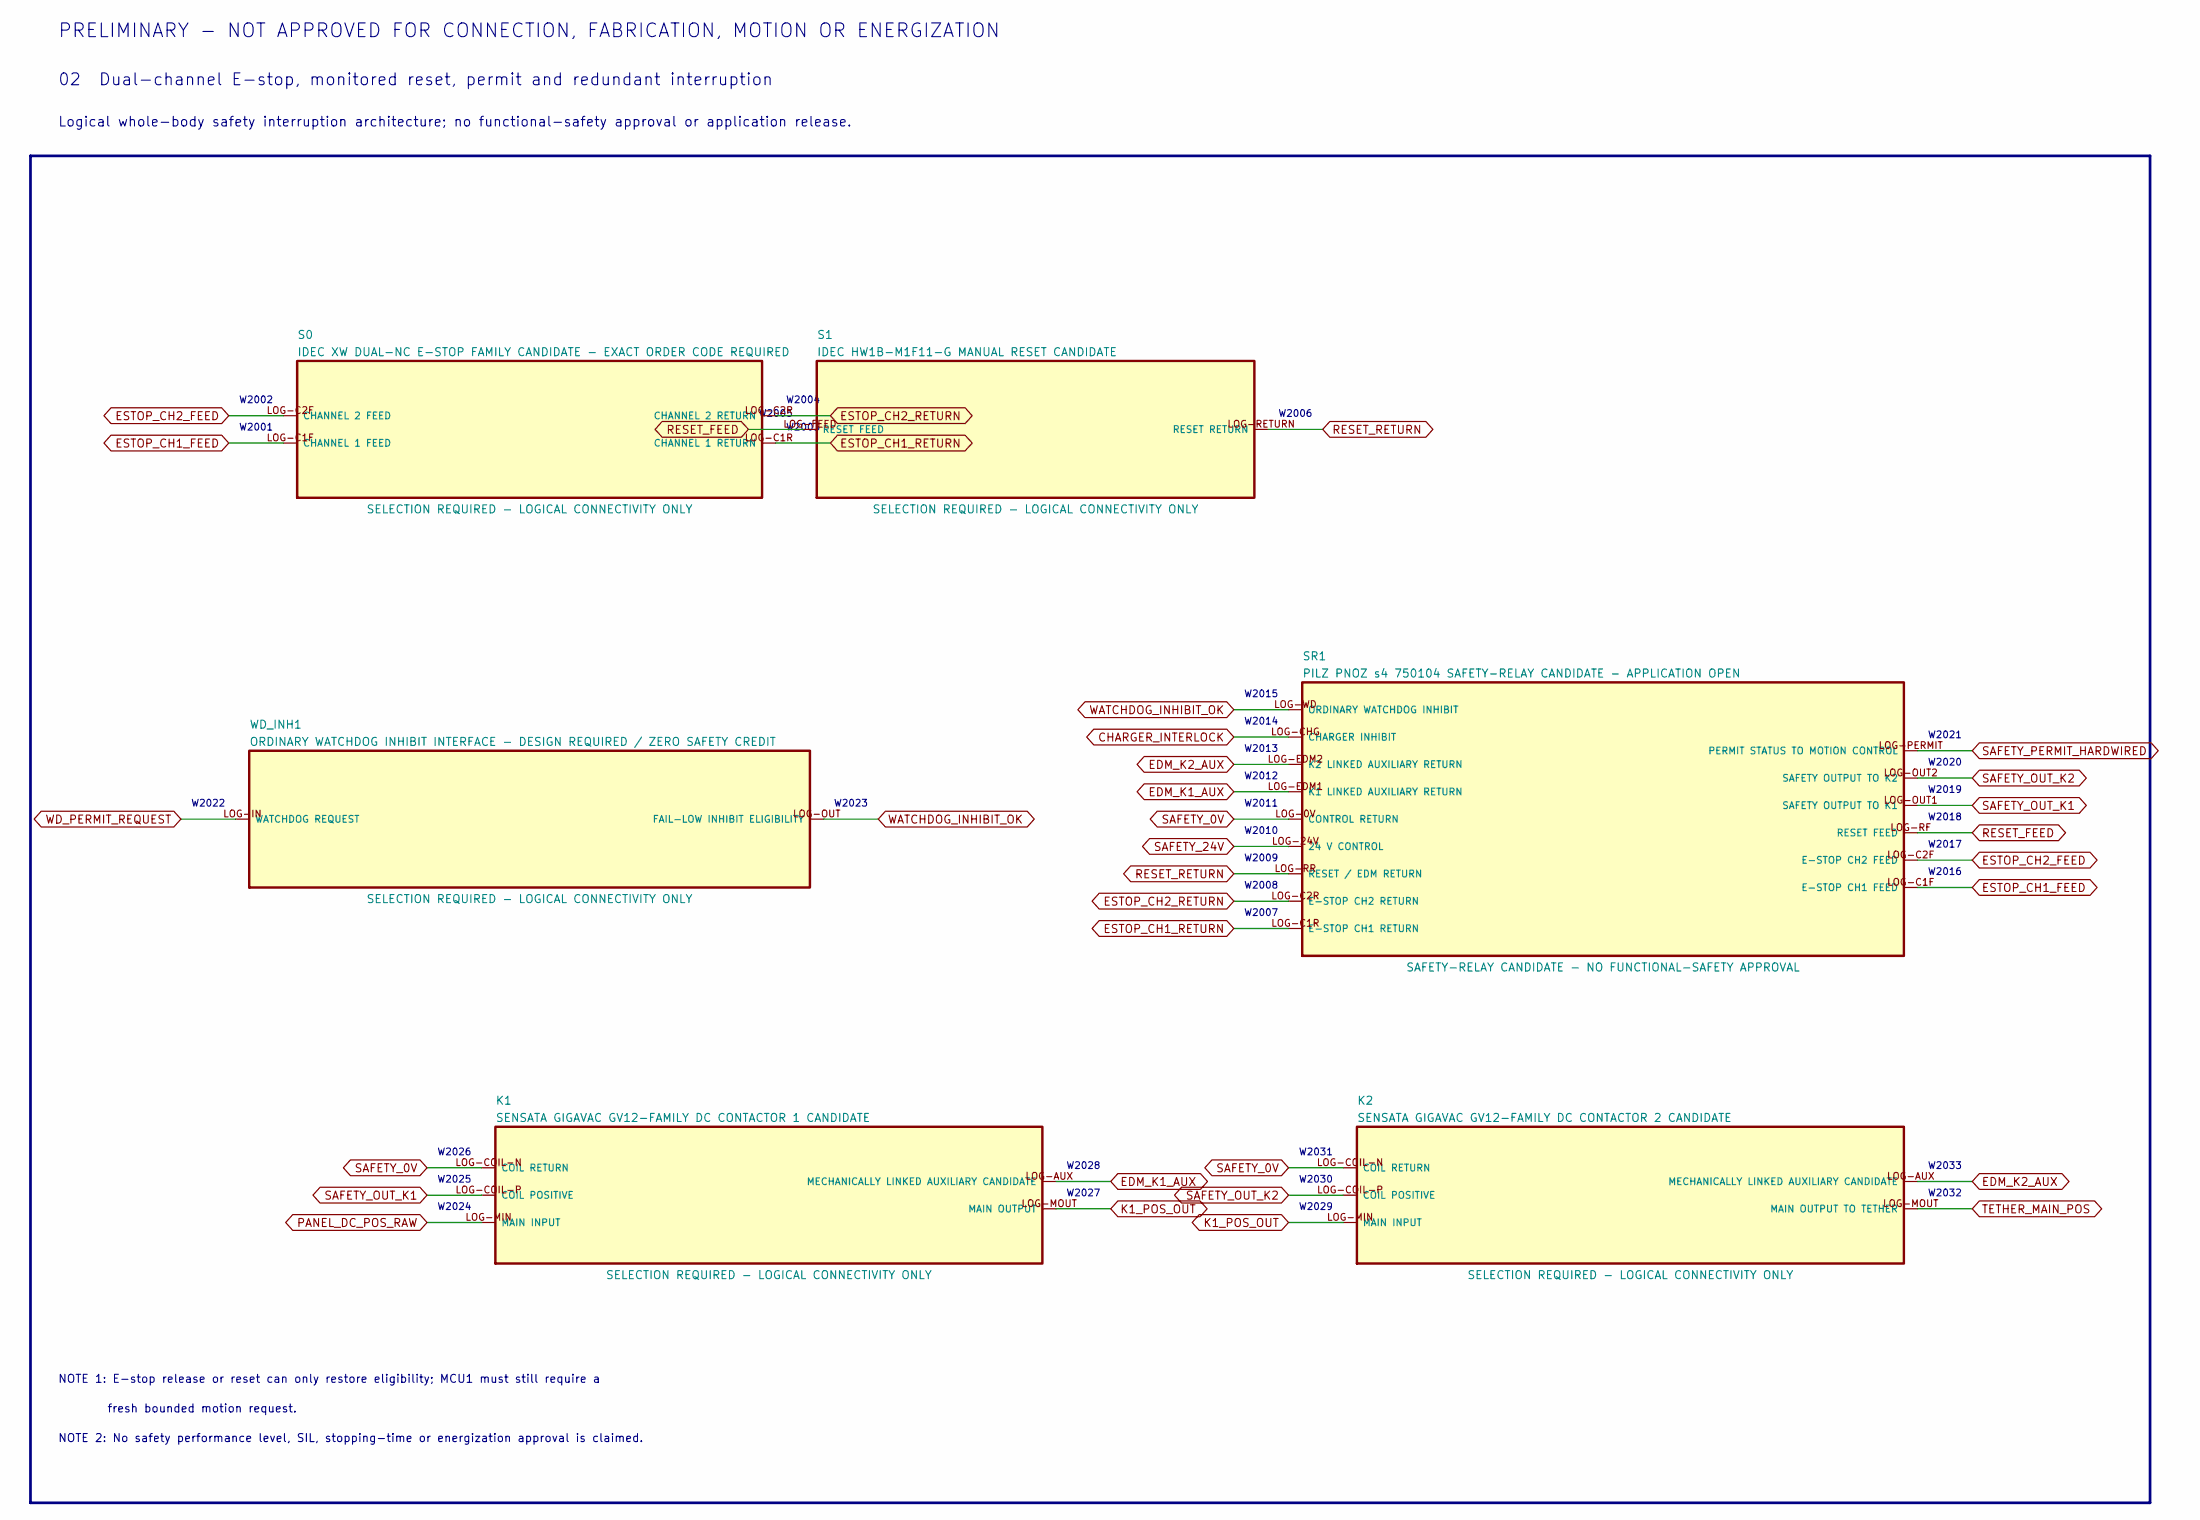
[picture p376: schematic 02_estop_permit_contactors.kicad_sch]

Parts:
K1: SENSATA GIGAVAC GV12-FAMILY DC CONTACTOR 1 CANDID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
K2: SENSATA GIGAVAC GV12-FAMILY DC CONTACTOR 2 CANDID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
S0: IDEC XW DUAL-NC E-STOP FAMILY CANDIDATE - EXACT O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
S1: IDEC HW1B-M1F11-G MANUAL RESET CANDIDATE
SR1: PILZ PNOZ s4 750104 SAFETY-RELAY CANDIDATE - APPL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
WD_INH1: ORDINARY WATCHDOG INHIBIT INTERFACE - DESIGN REQU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

Connections:
CHARGER_INTERLOCK: SR1.LOG-CHG (CHARGER INHIBIT)
EDM_K1_AUX: K1.LOG-AUX (MECHANICALLY LINKED AUXILIARY CANDIDATE), SR1.LOG-EDM1 (K1 LINKED AUXILIARY RETURN)
EDM_K2_AUX: K2.LOG-AUX (MECHANICALLY LINKED AUXILIARY CANDIDATE), SR1.LOG-EDM2 (K2 LINKED AUXILIARY RETURN)
ESTOP_CH1_FEED: S0.LOG-C1F (CHANNEL 1 FEED), SR1.LOG-C1F (E-STOP CH1 FEED)
ESTOP_CH1_RETURN: S0.LOG-C1R (CHANNEL 1 RETURN), SR1.LOG-C1R (E-STOP CH1 RETURN)
ESTOP_CH2_FEED: S0.LOG-C2F (CHANNEL 2 FEED), SR1.LOG-C2F (E-STOP CH2 FEED)
ESTOP_CH2_RETURN: S0.LOG-C2R (CHANNEL 2 RETURN), SR1.LOG-C2R (E-STOP CH2 RETURN)
K1_POS_OUT: K1.LOG-MOUT (MAIN OUTPUT), K2.LOG-MIN (MAIN INPUT)
PANEL_DC_POS_RAW: K1.LOG-MIN (MAIN INPUT)
RESET_FEED: S1.LOG-FEED (RESET FEED), SR1.LOG-RF (RESET FEED)
RESET_RETURN: S1.LOG-RETURN (RESET RETURN), SR1.LOG-RR (RESET / EDM RETURN)
SAFETY_0V: K1.LOG-COIL-N (COIL RETURN), K2.LOG-COIL-N (COIL RETURN), SR1.LOG-0V (CONTROL RETURN)
SAFETY_24V: SR1.LOG-24V (24 V CONTROL)
SAFETY_OUT_K1: K1.LOG-COIL-P (COIL POSITIVE), SR1.LOG-OUT1 (SAFETY OUTPUT TO K1)
SAFETY_OUT_K2: K2.LOG-COIL-P (COIL POSITIVE), SR1.LOG-OUT2 (SAFETY OUTPUT TO K2)
SAFETY_PERMIT_HARDWIRED: SR1.LOG-PERMIT (PERMIT STATUS TO MOTION CONTROL)
TETHER_MAIN_POS: K2.LOG-MOUT (MAIN OUTPUT TO TETHER)
WATCHDOG_INHIBIT_OK: SR1.LOG-WD (ORDINARY WATCHDOG INHIBIT), WD_INH1.LOG-OUT (FAIL-LOW INHIBIT ELIGIBILITY)
WD_PERMIT_REQUEST: WD_INH1.LOG-IN (WATCHDOG REQUEST)

Notes on the sheet:
PRELIMINARY - NOT APPROVED FOR CONNECTION, FABRICATION, MOTION OR ENERGIZATION
02 Dual-channel E-stop, monitored reset, permit and redundant interruption
Logical whole-body safety interruption architecture; no functional-safety approval or application release.
W2001
W2002
W2003
W2004
W2005
W2006
W2007
W2008
W2009
W2010
W2011
W2012
W2013
W2014
W2015
W2016
W2017
W2018
W2019
W2020
W2021
W2022
W2023
W2024
W2025
W2026
W2027
W2028
W2029
W2030
W2031
W2032
W2033
NOTE 1: E-stop release or reset can only restore eligibility; MCU1 must still require a
fresh bounded motion request.
NOTE 2: No safety performance level, SIL, stopping-time or energization approval is claimed.
