amyleesterling/humanoid-robot/hr30/whole-body-p0.1/electrical/kicad/hr30-whole-body-electrical-p0.1/03_compute_motion_watchdog.kicad_sch

## KiCad design hr30/whole-body-p0.1/electrical/kicad/hr30-whole-body-electrical-p0.1/03_compute_motion_watchdog.kicad_sch (2026-08-16)

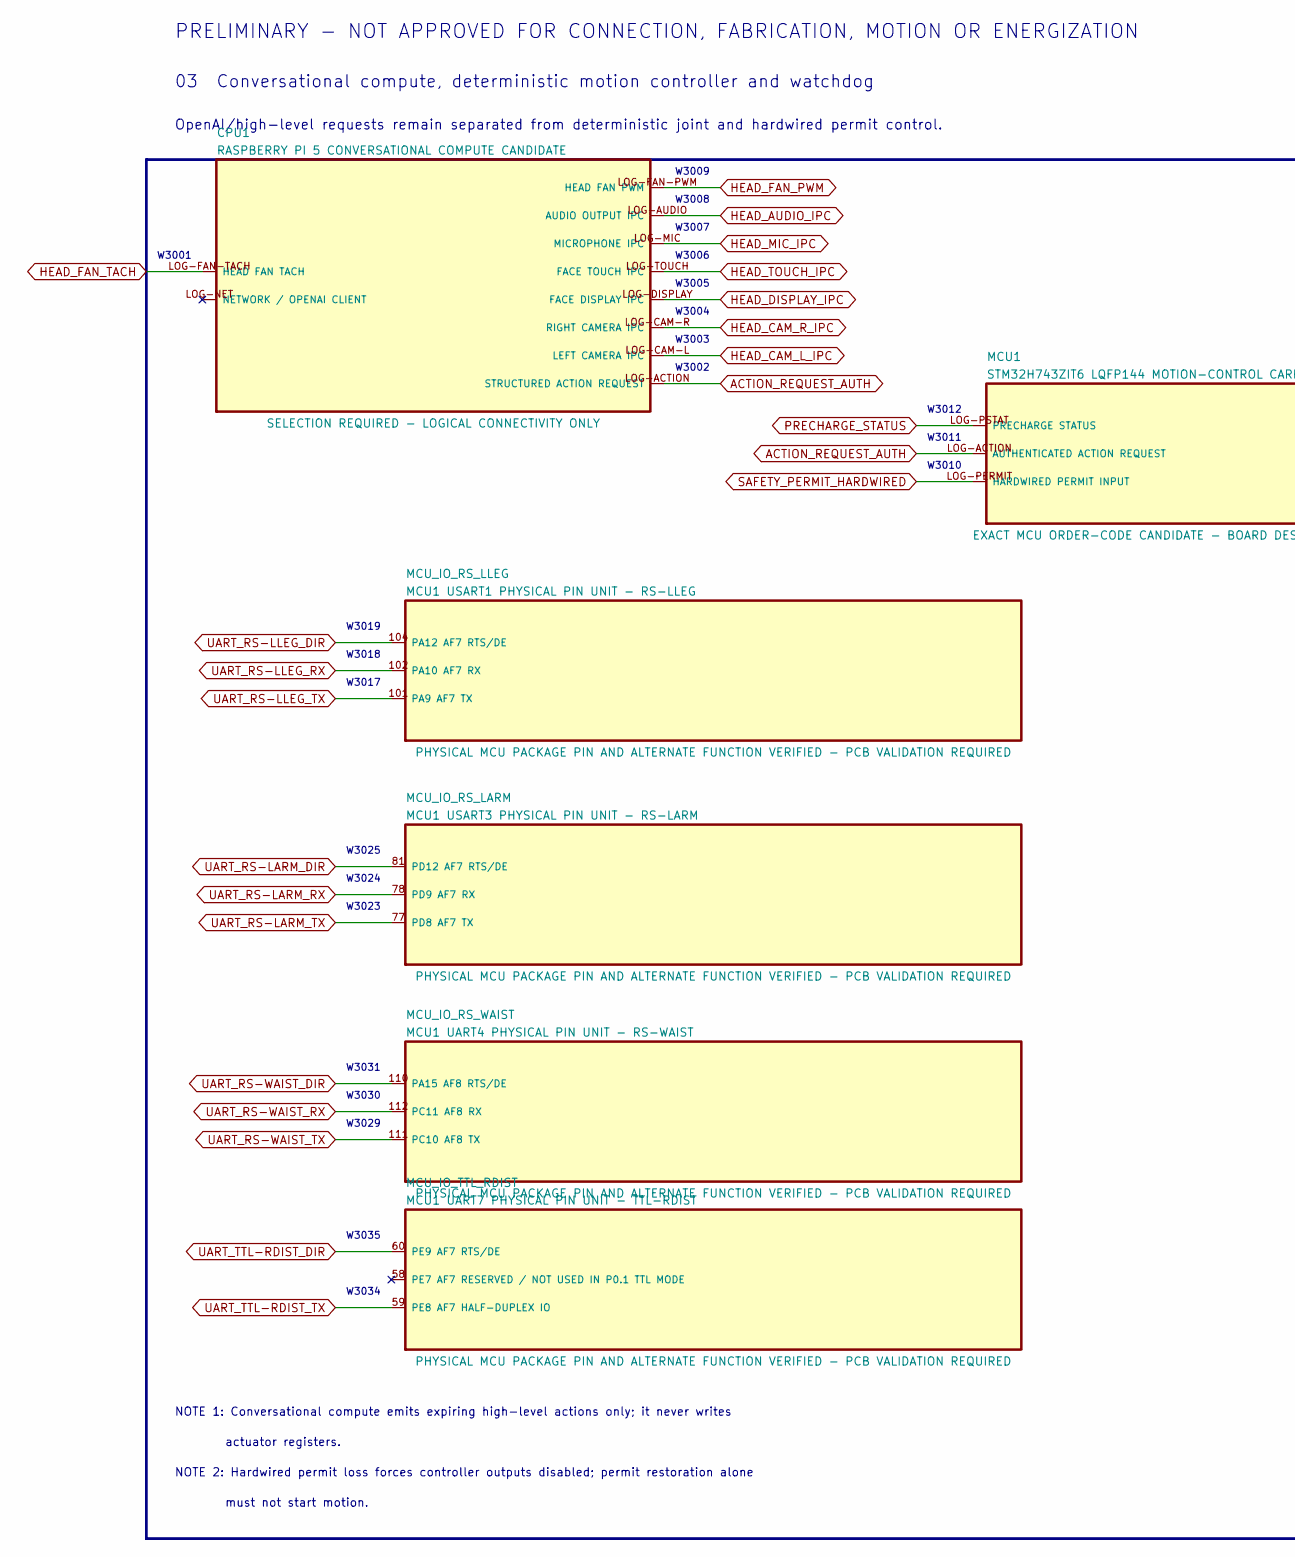
[picture p377: schematic 03_compute_motion_watchdog.kicad_sch, part in row 1, column 1]

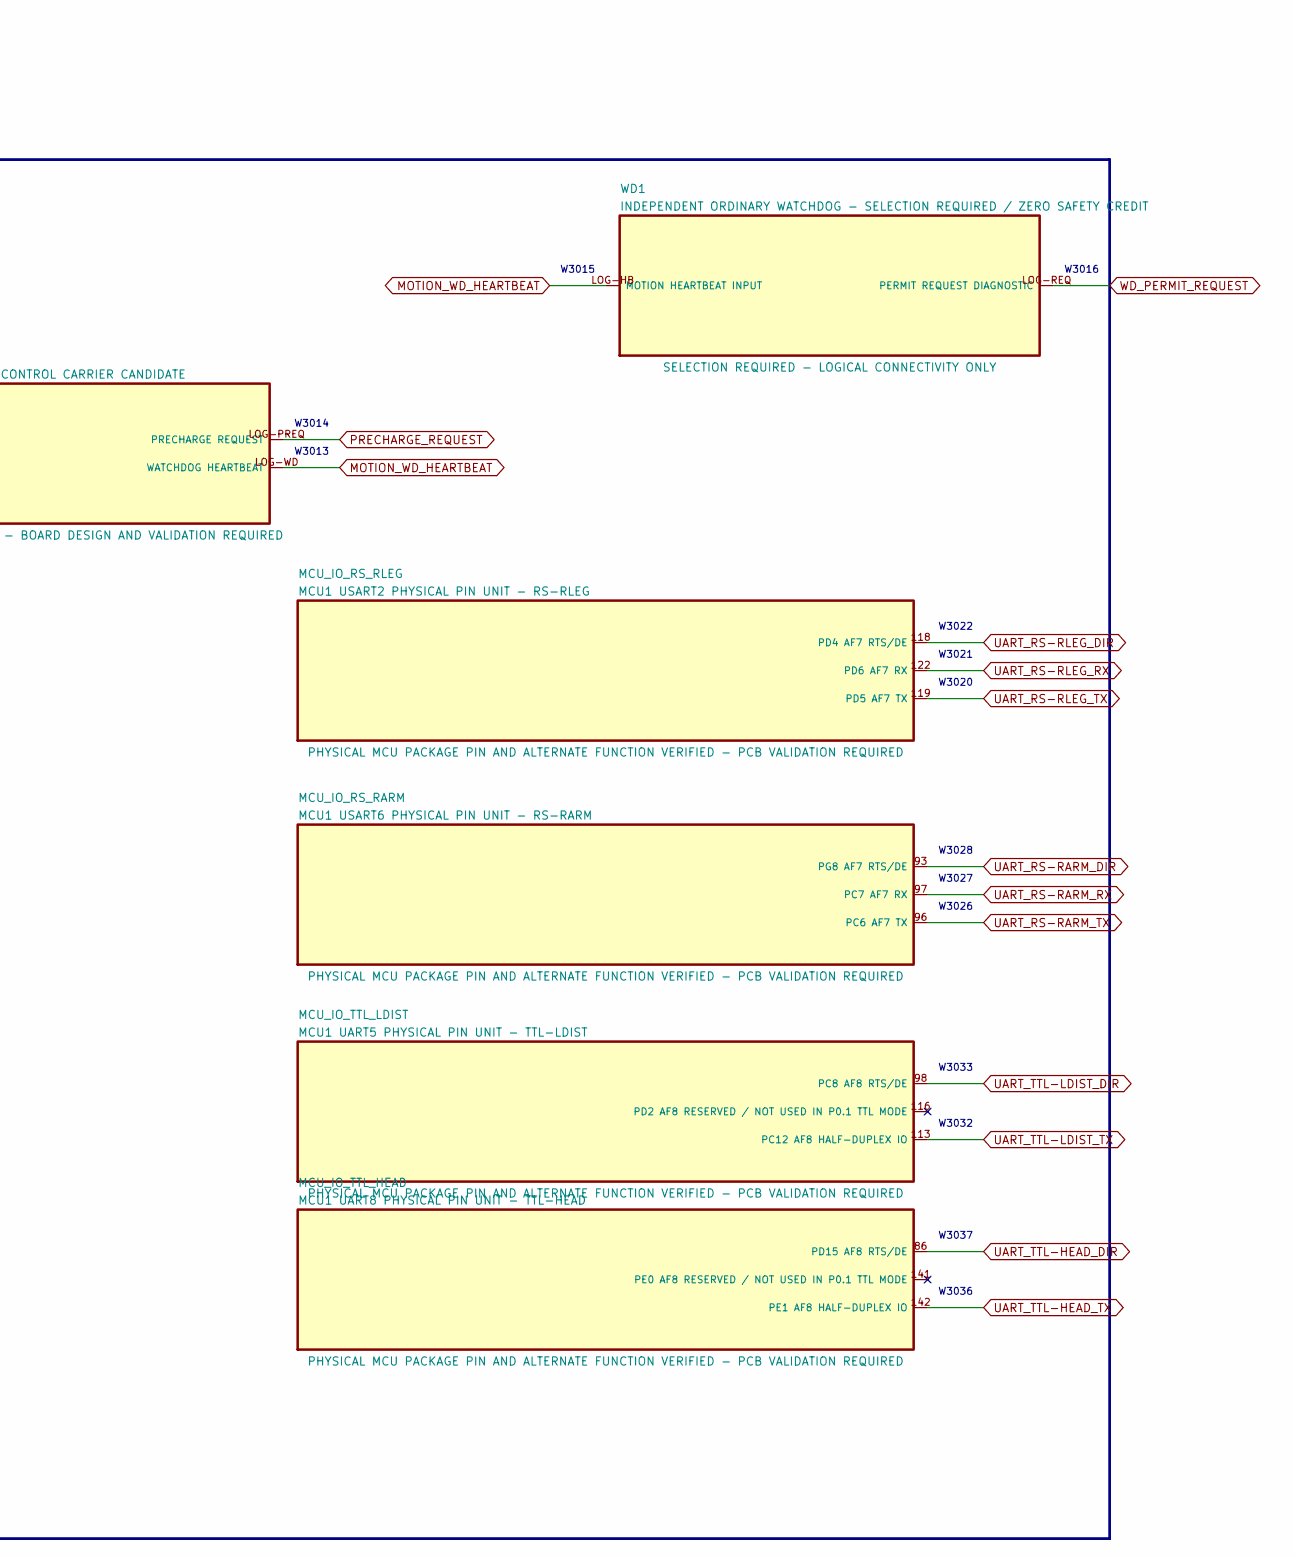
[picture p378: schematic 03_compute_motion_watchdog.kicad_sch, part in row 1, column 2]

Parts:
CPU1: RASPBERRY PI 5 CONVERSATIONAL COMPUTE CANDIDATE
MCU1: STM32H743ZIT6 LQFP144 MOTION-CONTROL CARRIER CAND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
MCU_IO_RS_LARM: MCU1 USART3 PHYSICAL PIN UNIT - RS-LARM
MCU_IO_RS_LLEG: MCU1 USART1 PHYSICAL PIN UNIT - RS-LLEG
MCU_IO_RS_RARM: MCU1 USART6 PHYSICAL PIN UNIT - RS-RARM
MCU_IO_RS_RLEG: MCU1 USART2 PHYSICAL PIN UNIT - RS-RLEG
MCU_IO_RS_WAIST: MCU1 UART4 PHYSICAL PIN UNIT - RS-WAIST
MCU_IO_TTL_HEAD: MCU1 UART8 PHYSICAL PIN UNIT - TTL-HEAD
MCU_IO_TTL_LDIST: MCU1 UART5 PHYSICAL PIN UNIT - TTL-LDIST
MCU_IO_TTL_RDIST: MCU1 UART7 PHYSICAL PIN UNIT - TTL-RDIST
WD1: INDEPENDENT ORDINARY WATCHDOG - SELECTION REQUIRE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

Connections:
ACTION_REQUEST_AUTH: CPU1.LOG-ACTION (STRUCTURED ACTION REQUEST), MCU1.LOG-ACTION (AUTHENTICATED ACTION REQUEST)
HEAD_AUDIO_IPC: CPU1.LOG-AUDIO (AUDIO OUTPUT IPC)
HEAD_CAM_L_IPC: CPU1.LOG-CAM-L (LEFT CAMERA IPC)
HEAD_CAM_R_IPC: CPU1.LOG-CAM-R (RIGHT CAMERA IPC)
HEAD_DISPLAY_IPC: CPU1.LOG-DISPLAY (FACE DISPLAY IPC)
HEAD_FAN_PWM: CPU1.LOG-FAN-PWM (HEAD FAN PWM)
HEAD_FAN_TACH: CPU1.LOG-FAN-TACH (HEAD FAN TACH)
HEAD_MIC_IPC: CPU1.LOG-MIC (MICROPHONE IPC)
HEAD_TOUCH_IPC: CPU1.LOG-TOUCH (FACE TOUCH IPC)
MOTION_WD_HEARTBEAT: MCU1.LOG-WD (WATCHDOG HEARTBEAT), WD1.LOG-HB (MOTION HEARTBEAT INPUT)
PRECHARGE_REQUEST: MCU1.LOG-PREQ (PRECHARGE REQUEST)
PRECHARGE_STATUS: MCU1.LOG-PSTAT (PRECHARGE STATUS)
SAFETY_PERMIT_HARDWIRED: MCU1.LOG-PERMIT (HARDWIRED PERMIT INPUT)
UART_RS-LARM_DIR: MCU_IO_RS_LARM.81 (PD12 AF7 RTS/DE)
UART_RS-LARM_RX: MCU_IO_RS_LARM.78 (PD9 AF7 RX)
UART_RS-LARM_TX: MCU_IO_RS_LARM.77 (PD8 AF7 TX)
UART_RS-LLEG_DIR: MCU_IO_RS_LLEG.104 (PA12 AF7 RTS/DE)
UART_RS-LLEG_RX: MCU_IO_RS_LLEG.102 (PA10 AF7 RX)
UART_RS-LLEG_TX: MCU_IO_RS_LLEG.101 (PA9 AF7 TX)
UART_RS-RARM_DIR: MCU_IO_RS_RARM.93 (PG8 AF7 RTS/DE)
UART_RS-RARM_RX: MCU_IO_RS_RARM.97 (PC7 AF7 RX)
UART_RS-RARM_TX: MCU_IO_RS_RARM.96 (PC6 AF7 TX)
UART_RS-RLEG_DIR: MCU_IO_RS_RLEG.118 (PD4 AF7 RTS/DE)
UART_RS-RLEG_RX: MCU_IO_RS_RLEG.122 (PD6 AF7 RX)
UART_RS-RLEG_TX: MCU_IO_RS_RLEG.119 (PD5 AF7 TX)
UART_RS-WAIST_DIR: MCU_IO_RS_WAIST.110 (PA15 AF8 RTS/DE)
UART_RS-WAIST_RX: MCU_IO_RS_WAIST.112 (PC11 AF8 RX)
UART_RS-WAIST_TX: MCU_IO_RS_WAIST.111 (PC10 AF8 TX)
UART_TTL-HEAD_DIR: MCU_IO_TTL_HEAD.86 (PD15 AF8 RTS/DE)
UART_TTL-HEAD_TX: MCU_IO_TTL_HEAD.142 (PE1 AF8 HALF-DUPLEX IO)
UART_TTL-LDIST_DIR: MCU_IO_TTL_LDIST.98 (PC8 AF8 RTS/DE)
UART_TTL-LDIST_TX: MCU_IO_TTL_LDIST.113 (PC12 AF8 HALF-DUPLEX IO)
UART_TTL-RDIST_DIR: MCU_IO_TTL_RDIST.60 (PE9 AF7 RTS/DE)
UART_TTL-RDIST_TX: MCU_IO_TTL_RDIST.59 (PE8 AF7 HALF-DUPLEX IO)
WD_PERMIT_REQUEST: WD1.LOG-REQ (PERMIT REQUEST DIAGNOSTIC)

Notes on the sheet:
PRELIMINARY - NOT APPROVED FOR CONNECTION, FABRICATION, MOTION OR ENERGIZATION
03 Conversational compute, deterministic motion controller and watchdog
OpenAI/high-level requests remain separated from deterministic joint and hardwired permit control.
W3001
W3002
W3003
W3004
W3005
W3006
W3007
W3008
W3009
W3010
W3011
W3012
W3013
W3014
W3015
W3016
W3017
W3018
W3019
W3020
W3021
W3022
W3023
W3024
W3025
W3026
W3027
W3028
W3029
W3030
W3031
W3032
W3033
W3034
W3035
W3036
W3037
NOTE 1: Conversational compute emits expiring high-level actions only; it never writes
actuator registers.
NOTE 2: Hardwired permit loss forces controller outputs disabled; permit restoration alone
must not start motion.
