amyleesterling/humanoid-robot/hr30/whole-body-p0.1/electrical/kicad/hr30-whole-body-electrical-p0.1/04_motion_controller_carrier_connectors.kicad_sch

## KiCad design hr30/whole-body-p0.1/electrical/kicad/hr30-whole-body-electrical-p0.1/04_motion_controller_carrier_connectors.kicad_sch (2026-08-16)

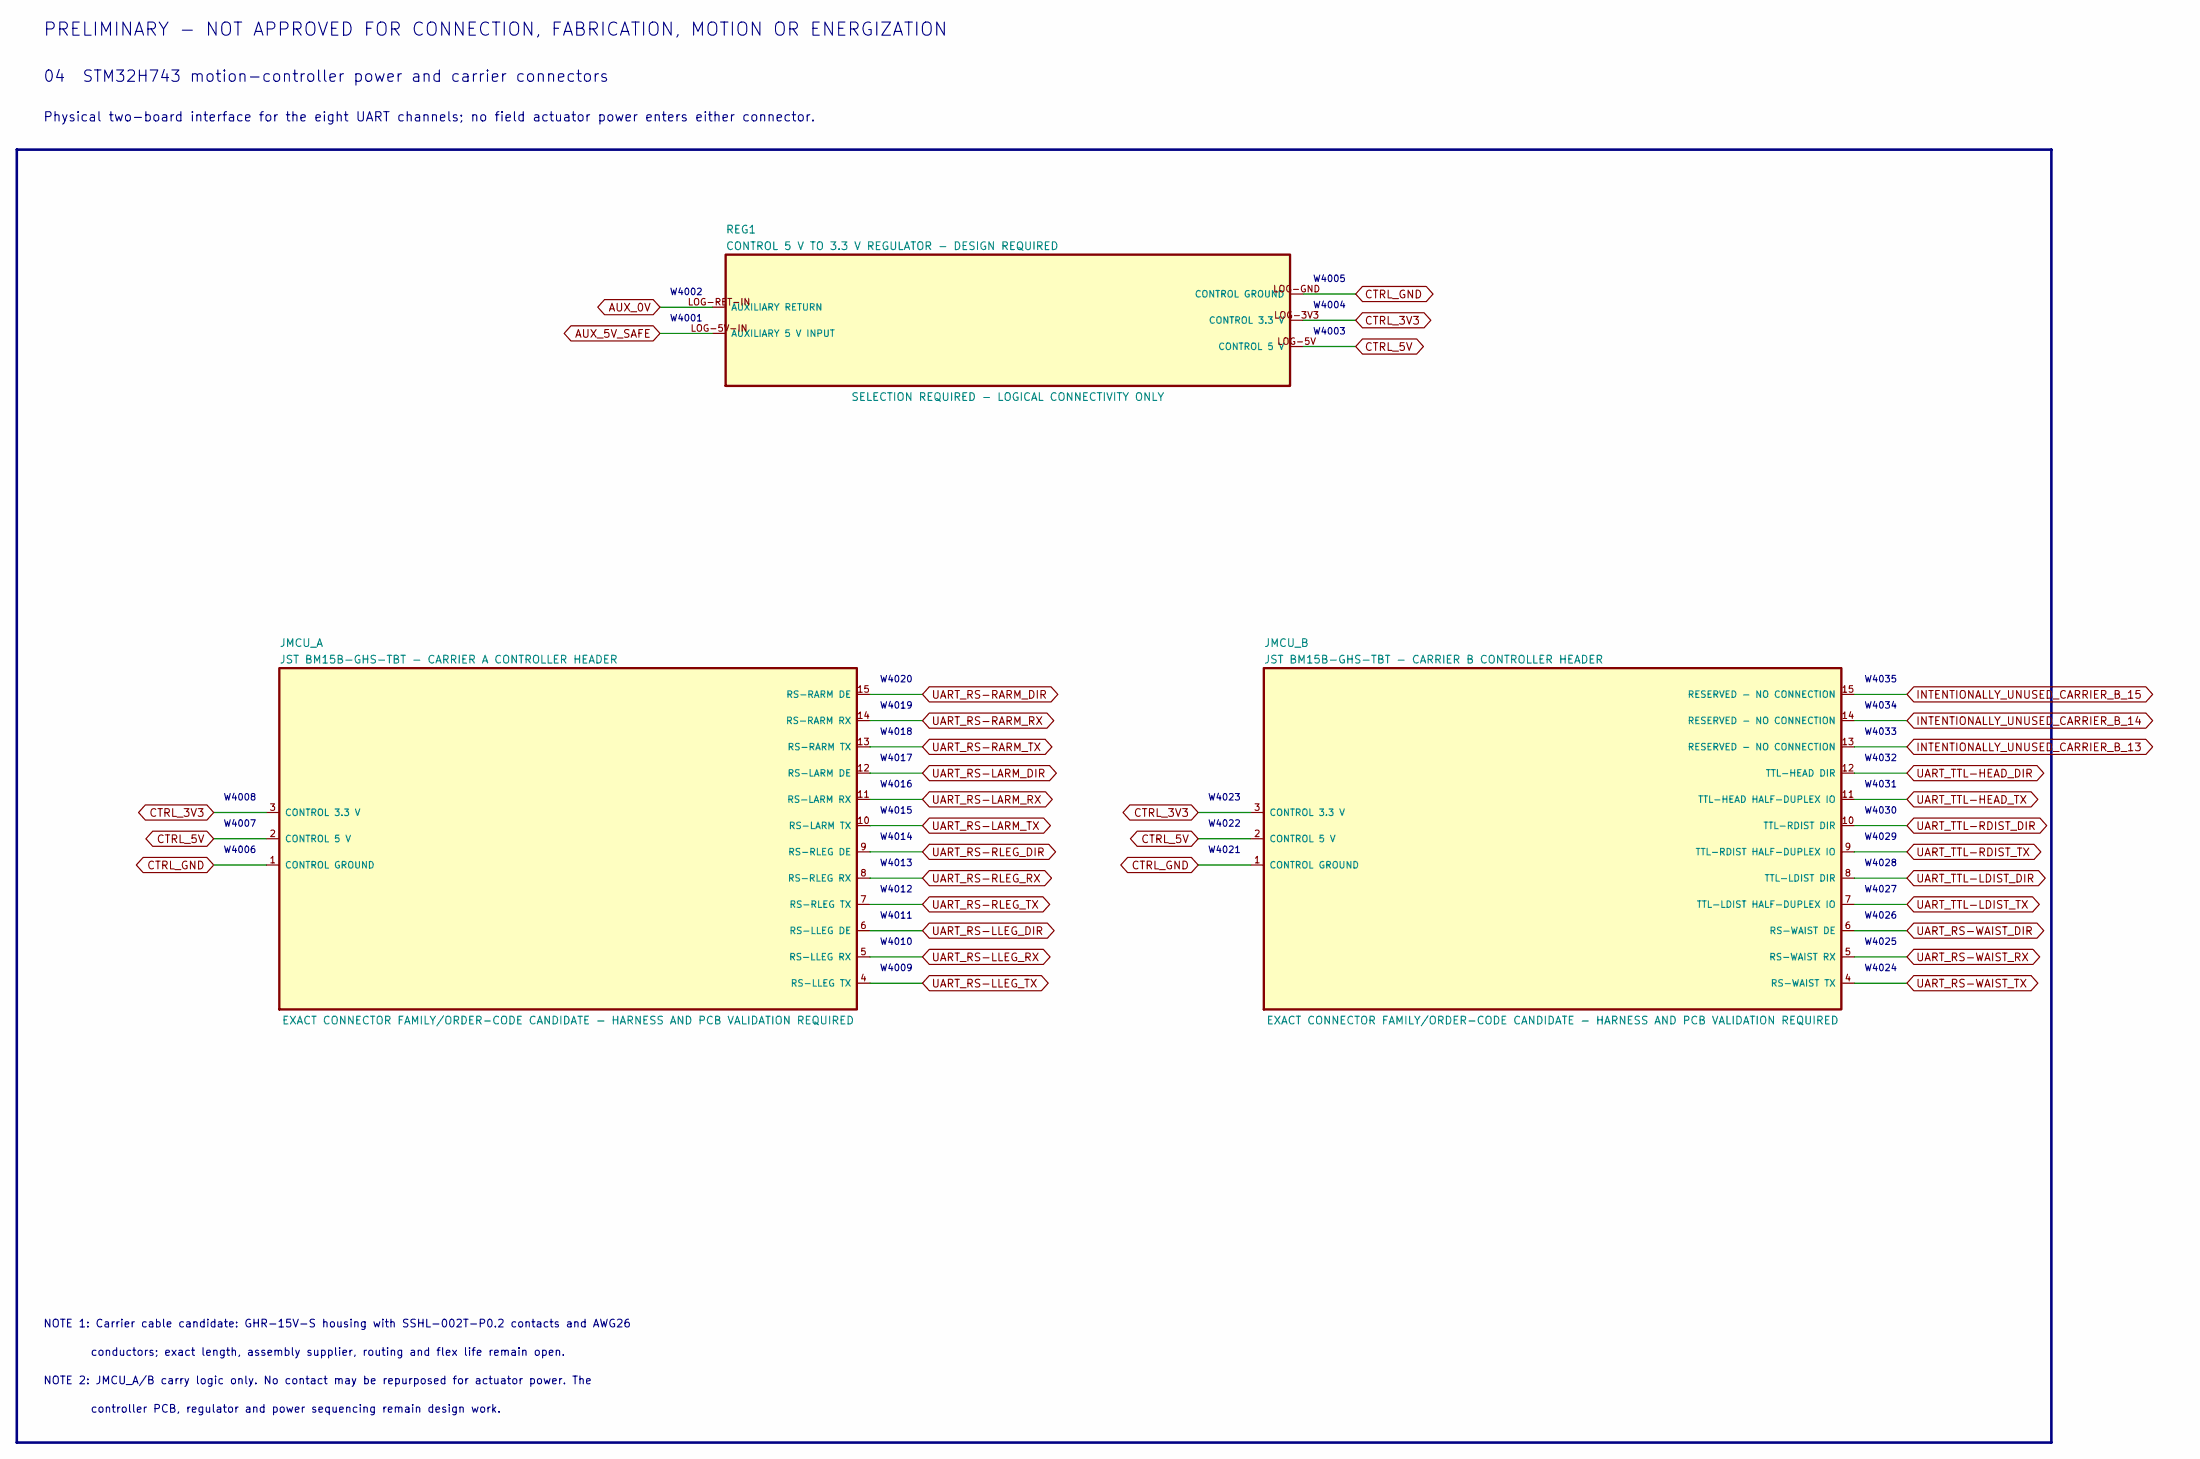
[picture p379: schematic 04_motion_controller_carrier_connectors.kicad_sch]

Parts:
JMCU_A: JST BM15B-GHS-TBT - CARRIER A CONTROLLER HEADER
JMCU_B: JST BM15B-GHS-TBT - CARRIER B CONTROLLER HEADER
REG1: CONTROL 5 V TO 3.3 V REGULATOR - DESIGN REQUIRED

Connections:
AUX_0V: REG1.LOG-RET-IN (AUXILIARY RETURN)
AUX_5V_SAFE: REG1.LOG-5V-IN (AUXILIARY 5 V INPUT)
CTRL_3V3: JMCU_A.3 (CONTROL 3.3 V), JMCU_B.3 (CONTROL 3.3 V), REG1.LOG-3V3 (CONTROL 3.3 V)
CTRL_5V: JMCU_A.2 (CONTROL 5 V), JMCU_B.2 (CONTROL 5 V), REG1.LOG-5V (CONTROL 5 V)
CTRL_GND: JMCU_A.1 (CONTROL GROUND), JMCU_B.1 (CONTROL GROUND), REG1.LOG-GND (CONTROL GROUND)
INTENTIONALLY_UNUSED_CARRIER_B_13: JMCU_B.13 (RESERVED - NO CONNECTION)
INTENTIONALLY_UNUSED_CARRIER_B_14: JMCU_B.14 (RESERVED - NO CONNECTION)
INTENTIONALLY_UNUSED_CARRIER_B_15: JMCU_B.15 (RESERVED - NO CONNECTION)
UART_RS-LARM_DIR: JMCU_A.12 (RS-LARM DE)
UART_RS-LARM_RX: JMCU_A.11 (RS-LARM RX)
UART_RS-LARM_TX: JMCU_A.10 (RS-LARM TX)
UART_RS-LLEG_DIR: JMCU_A.6 (RS-LLEG DE)
UART_RS-LLEG_RX: JMCU_A.5 (RS-LLEG RX)
UART_RS-LLEG_TX: JMCU_A.4 (RS-LLEG TX)
UART_RS-RARM_DIR: JMCU_A.15 (RS-RARM DE)
UART_RS-RARM_RX: JMCU_A.14 (RS-RARM RX)
UART_RS-RARM_TX: JMCU_A.13 (RS-RARM TX)
UART_RS-RLEG_DIR: JMCU_A.9 (RS-RLEG DE)
UART_RS-RLEG_RX: JMCU_A.8 (RS-RLEG RX)
UART_RS-RLEG_TX: JMCU_A.7 (RS-RLEG TX)
UART_RS-WAIST_DIR: JMCU_B.6 (RS-WAIST DE)
UART_RS-WAIST_RX: JMCU_B.5 (RS-WAIST RX)
UART_RS-WAIST_TX: JMCU_B.4 (RS-WAIST TX)
UART_TTL-HEAD_DIR: JMCU_B.12 (TTL-HEAD DIR)
UART_TTL-HEAD_TX: JMCU_B.11 (TTL-HEAD HALF-DUPLEX IO)
UART_TTL-LDIST_DIR: JMCU_B.8 (TTL-LDIST DIR)
UART_TTL-LDIST_TX: JMCU_B.7 (TTL-LDIST HALF-DUPLEX IO)
UART_TTL-RDIST_DIR: JMCU_B.10 (TTL-RDIST DIR)
UART_TTL-RDIST_TX: JMCU_B.9 (TTL-RDIST HALF-DUPLEX IO)

Notes on the sheet:
PRELIMINARY - NOT APPROVED FOR CONNECTION, FABRICATION, MOTION OR ENERGIZATION
04 STM32H743 motion-controller power and carrier connectors
Physical two-board interface for the eight UART channels; no field actuator power enters either connector.
W4001
W4002
W4003
W4004
W4005
W4006
W4007
W4008
W4009
W4010
W4011
W4012
W4013
W4014
W4015
W4016
W4017
W4018
W4019
W4020
W4021
W4022
W4023
W4024
W4025
W4026
W4027
W4028
W4029
W4030
W4031
W4032
W4033
W4034
W4035
NOTE 1: Carrier cable candidate: GHR-15V-S housing with SSHL-002T-P0.2 contacts and AWG26
conductors; exact length, assembly supplier, routing and flex life remain open.
NOTE 2: JMCU_A/B carry logic only. No contact may be repurposed for actuator power. The
controller PCB, regulator and power sequencing remain design work.
