amyleesterling/humanoid-robot/hr30/whole-body-p0.1/electrical/kicad/hr30-whole-body-electrical-p0.1/05_carrier_a_four_isolated_rs485.kicad_sch

## KiCad design hr30/whole-body-p0.1/electrical/kicad/hr30-whole-body-electrical-p0.1/05_carrier_a_four_isolated_rs485.kicad_sch (2026-08-16)

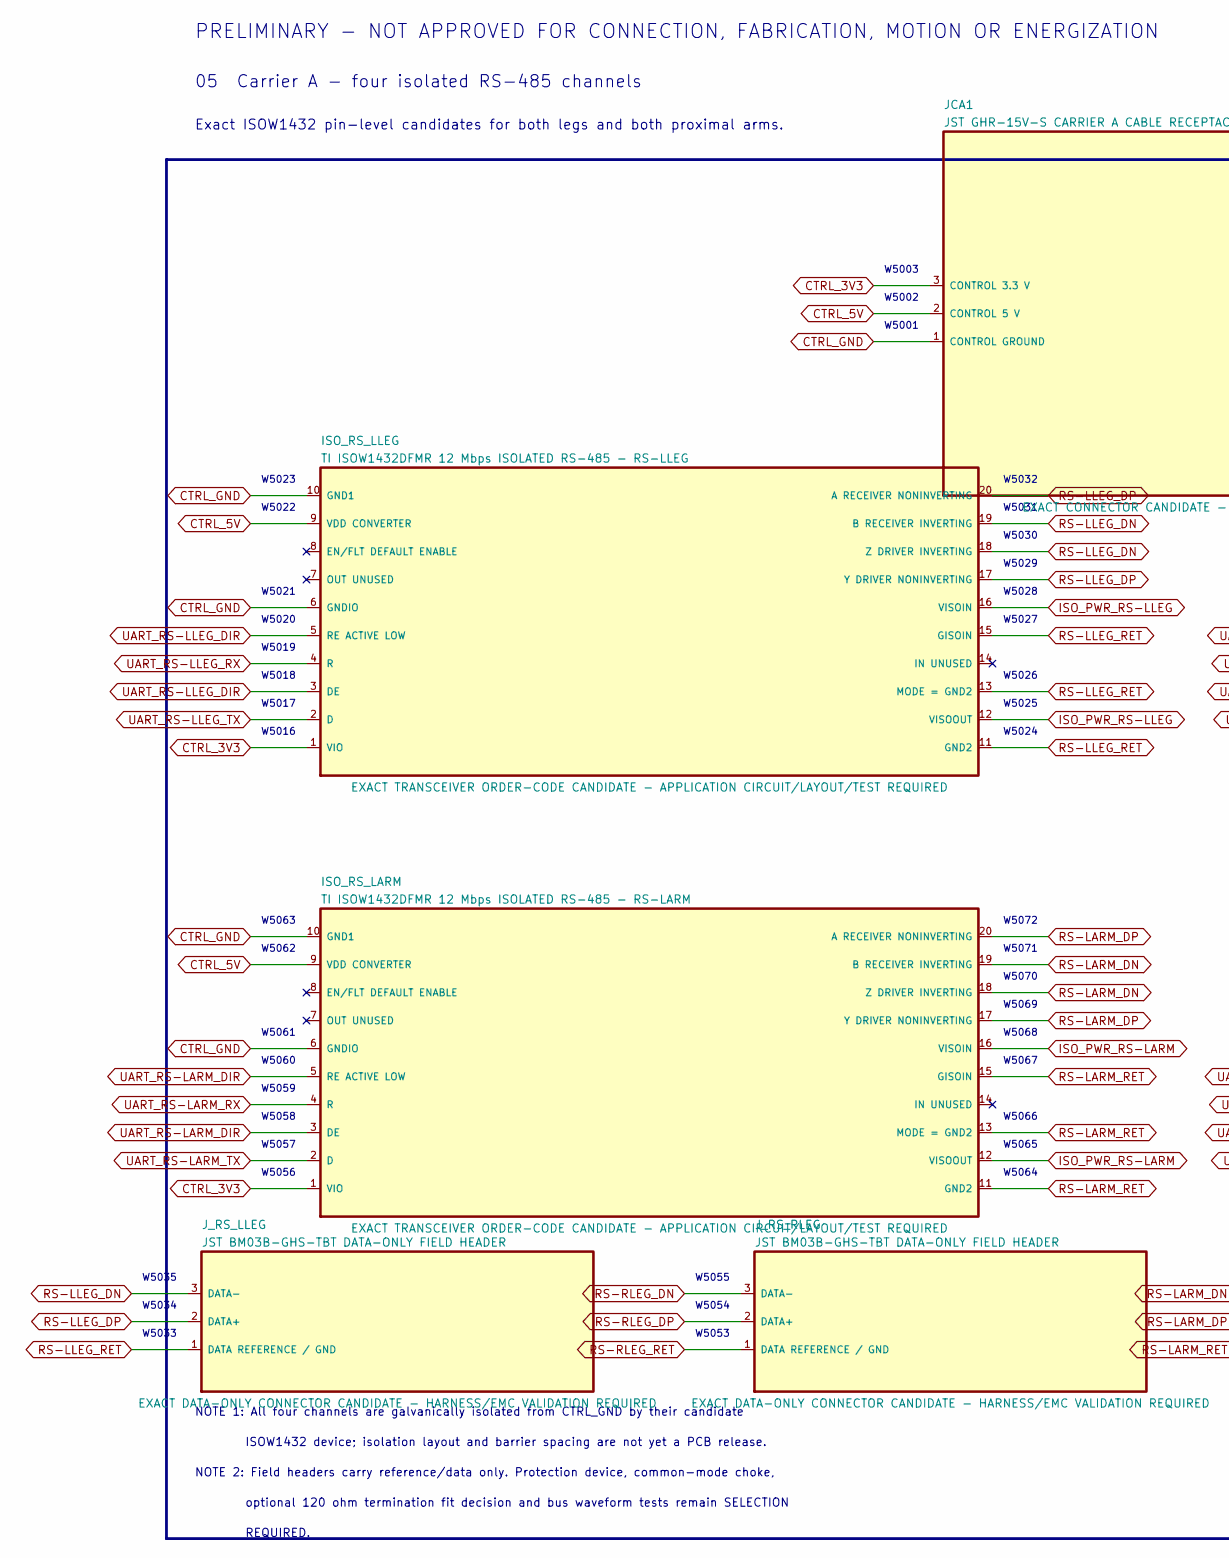
[picture p380: schematic 05_carrier_a_four_isolated_rs485.kicad_sch, part in row 1, column 1]

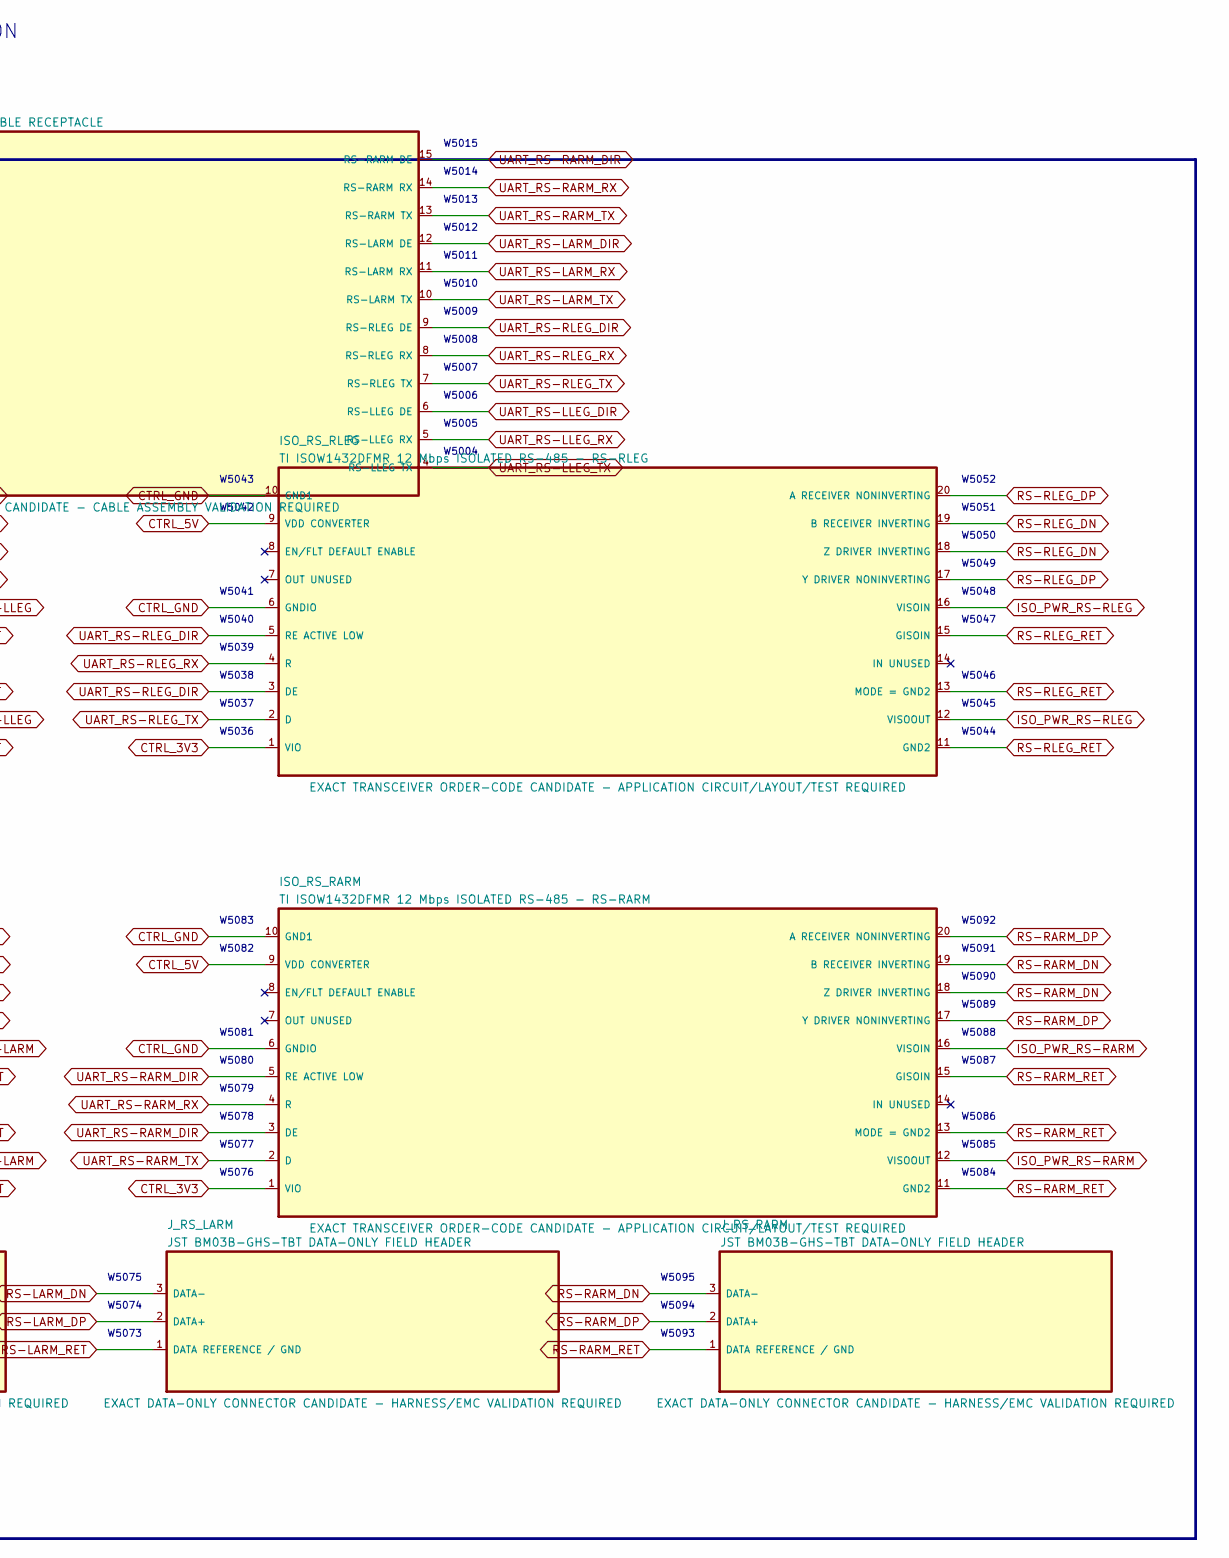
[picture p381: schematic 05_carrier_a_four_isolated_rs485.kicad_sch, part in row 1, column 2]

Parts:
ISO_RS_LARM: TI ISOW1432DFMR 12 Mbps ISOLATED RS-485 - RS-LARM; SOIC-20W_7.5x12.8mm_P1.27mm
ISO_RS_LLEG: TI ISOW1432DFMR 12 Mbps ISOLATED RS-485 - RS-LLEG; SOIC-20W_7.5x12.8mm_P1.27mm
ISO_RS_RARM: TI ISOW1432DFMR 12 Mbps ISOLATED RS-485 - RS-RARM; SOIC-20W_7.5x12.8mm_P1.27mm
ISO_RS_RLEG: TI ISOW1432DFMR 12 Mbps ISOLATED RS-485 - RS-RLEG; SOIC-20W_7.5x12.8mm_P1.27mm
JCA1: JST GHR-15V-S CARRIER A CABLE RECEPTACLE
J_RS_LARM: JST BM03B-GHS-TBT DATA-ONLY FIELD HEADER
J_RS_LLEG: JST BM03B-GHS-TBT DATA-ONLY FIELD HEADER
J_RS_RARM: JST BM03B-GHS-TBT DATA-ONLY FIELD HEADER
J_RS_RLEG: JST BM03B-GHS-TBT DATA-ONLY FIELD HEADER

Connections:
CTRL_3V3: ISO_RS_LARM.1 (VIO), ISO_RS_LLEG.1 (VIO), ISO_RS_RARM.1 (VIO), ISO_RS_RLEG.1 (VIO), JCA1.3 (CONTROL 3.3 V)
CTRL_5V: ISO_RS_LARM.9 (VDD CONVERTER), ISO_RS_LLEG.9 (VDD CONVERTER), ISO_RS_RARM.9 (VDD CONVERTER), ISO_RS_RLEG.9 (VDD CONVERTER), JCA1.2 (CONTROL 5 V)
CTRL_GND: ISO_RS_LARM.6 (GNDIO), ISO_RS_LARM.10 (GND1), ISO_RS_LLEG.6 (GNDIO), ISO_RS_LLEG.10 (GND1), ISO_RS_RARM.6 (GNDIO), ISO_RS_RARM.10 (GND1), ISO_RS_RLEG.6 (GNDIO), ISO_RS_RLEG.10 (GND1), JCA1.1 (CONTROL GROUND)
ISO_PWR_RS-LARM: ISO_RS_LARM.12 (VISOOUT), ISO_RS_LARM.16 (VISOIN)
ISO_PWR_RS-LLEG: ISO_RS_LLEG.12 (VISOOUT), ISO_RS_LLEG.16 (VISOIN)
ISO_PWR_RS-RARM: ISO_RS_RARM.12 (VISOOUT), ISO_RS_RARM.16 (VISOIN)
ISO_PWR_RS-RLEG: ISO_RS_RLEG.12 (VISOOUT), ISO_RS_RLEG.16 (VISOIN)
RS-LARM_DN: ISO_RS_LARM.18 (Z DRIVER INVERTING), ISO_RS_LARM.19 (B RECEIVER INVERTING), J_RS_LARM.3 (DATA-)
RS-LARM_DP: ISO_RS_LARM.17 (Y DRIVER NONINVERTING), ISO_RS_LARM.20 (A RECEIVER NONINVERTING), J_RS_LARM.2 (DATA+)
RS-LARM_RET: ISO_RS_LARM.11 (GND2), ISO_RS_LARM.13 (MODE = GND2), ISO_RS_LARM.15 (GISOIN), J_RS_LARM.1 (DATA REFERENCE / GND)
RS-LLEG_DN: ISO_RS_LLEG.18 (Z DRIVER INVERTING), ISO_RS_LLEG.19 (B RECEIVER INVERTING), J_RS_LLEG.3 (DATA-)
RS-LLEG_DP: ISO_RS_LLEG.17 (Y DRIVER NONINVERTING), ISO_RS_LLEG.20 (A RECEIVER NONINVERTING), J_RS_LLEG.2 (DATA+)
RS-LLEG_RET: ISO_RS_LLEG.11 (GND2), ISO_RS_LLEG.13 (MODE = GND2), ISO_RS_LLEG.15 (GISOIN), J_RS_LLEG.1 (DATA REFERENCE / GND)
RS-RARM_DN: ISO_RS_RARM.18 (Z DRIVER INVERTING), ISO_RS_RARM.19 (B RECEIVER INVERTING), J_RS_RARM.3 (DATA-)
RS-RARM_DP: ISO_RS_RARM.17 (Y DRIVER NONINVERTING), ISO_RS_RARM.20 (A RECEIVER NONINVERTING), J_RS_RARM.2 (DATA+)
RS-RARM_RET: ISO_RS_RARM.11 (GND2), ISO_RS_RARM.13 (MODE = GND2), ISO_RS_RARM.15 (GISOIN), J_RS_RARM.1 (DATA REFERENCE / GND)
RS-RLEG_DN: ISO_RS_RLEG.18 (Z DRIVER INVERTING), ISO_RS_RLEG.19 (B RECEIVER INVERTING), J_RS_RLEG.3 (DATA-)
RS-RLEG_DP: ISO_RS_RLEG.17 (Y DRIVER NONINVERTING), ISO_RS_RLEG.20 (A RECEIVER NONINVERTING), J_RS_RLEG.2 (DATA+)
RS-RLEG_RET: ISO_RS_RLEG.11 (GND2), ISO_RS_RLEG.13 (MODE = GND2), ISO_RS_RLEG.15 (GISOIN), J_RS_RLEG.1 (DATA REFERENCE / GND)
UART_RS-LARM_DIR: ISO_RS_LARM.3 (DE), ISO_RS_LARM.5 (RE ACTIVE LOW), JCA1.12 (RS-LARM DE)
UART_RS-LARM_RX: ISO_RS_LARM.4 (R), JCA1.11 (RS-LARM RX)
UART_RS-LARM_TX: ISO_RS_LARM.2 (D), JCA1.10 (RS-LARM TX)
UART_RS-LLEG_DIR: ISO_RS_LLEG.3 (DE), ISO_RS_LLEG.5 (RE ACTIVE LOW), JCA1.6 (RS-LLEG DE)
UART_RS-LLEG_RX: ISO_RS_LLEG.4 (R), JCA1.5 (RS-LLEG RX)
UART_RS-LLEG_TX: ISO_RS_LLEG.2 (D), JCA1.4 (RS-LLEG TX)
UART_RS-RARM_DIR: ISO_RS_RARM.3 (DE), ISO_RS_RARM.5 (RE ACTIVE LOW), JCA1.15 (RS-RARM DE)
UART_RS-RARM_RX: ISO_RS_RARM.4 (R), JCA1.14 (RS-RARM RX)
UART_RS-RARM_TX: ISO_RS_RARM.2 (D), JCA1.13 (RS-RARM TX)
UART_RS-RLEG_DIR: ISO_RS_RLEG.3 (DE), ISO_RS_RLEG.5 (RE ACTIVE LOW), JCA1.9 (RS-RLEG DE)
UART_RS-RLEG_RX: ISO_RS_RLEG.4 (R), JCA1.8 (RS-RLEG RX)
UART_RS-RLEG_TX: ISO_RS_RLEG.2 (D), JCA1.7 (RS-RLEG TX)

Notes on the sheet:
PRELIMINARY - NOT APPROVED FOR CONNECTION, FABRICATION, MOTION OR ENERGIZATION
05 Carrier A - four isolated RS-485 channels
Exact ISOW1432 pin-level candidates for both legs and both proximal arms.
W5001
W5002
W5003
W5004
W5005
W5006
W5007
W5008
W5009
W5010
W5011
W5012
W5013
W5014
W5015
W5016
W5017
W5018
W5019
W5020
W5021
W5022
W5023
W5024
W5025
W5026
W5027
W5028
W5029
W5030
W5031
W5032
W5033
W5034
W5035
W5036
W5037
W5038
W5039
W5040
W5041
W5042
W5043
W5044
W5045
W5046
W5047
W5048
W5049
W5050
W5051
W5052
W5053
W5054
W5055
W5056
W5057
W5058
W5059
W5060
W5061
W5062
W5063
W5064
W5065
W5066
W5067
W5068
W5069
W5070
W5071
W5072
W5073
W5074
W5075
W5076
W5077
W5078
W5079
W5080
W5081
W5082
W5083
W5084
W5085
W5086
W5087
W5088
W5089
W5090
W5091
W5092
W5093
W5094
W5095
NOTE 1: All four channels are galvanically isolated from CTRL_GND by their candidate
ISOW1432 device; isolation layout and barrier spacing are not yet a PCB release.
NOTE 2: Field headers carry reference/data only. Protection device, common-mode choke,
optional 120 ohm termination fit decision and bus waveform tests remain SELECTION
REQUIRED.
