amyleesterling/humanoid-robot/hr30/whole-body-p0.1/electrical/kicad/hr30-whole-body-electrical-p0.1/06_carrier_b_waist_and_ttl.kicad_sch

## KiCad design hr30/whole-body-p0.1/electrical/kicad/hr30-whole-body-electrical-p0.1/06_carrier_b_waist_and_ttl.kicad_sch (2026-08-16)

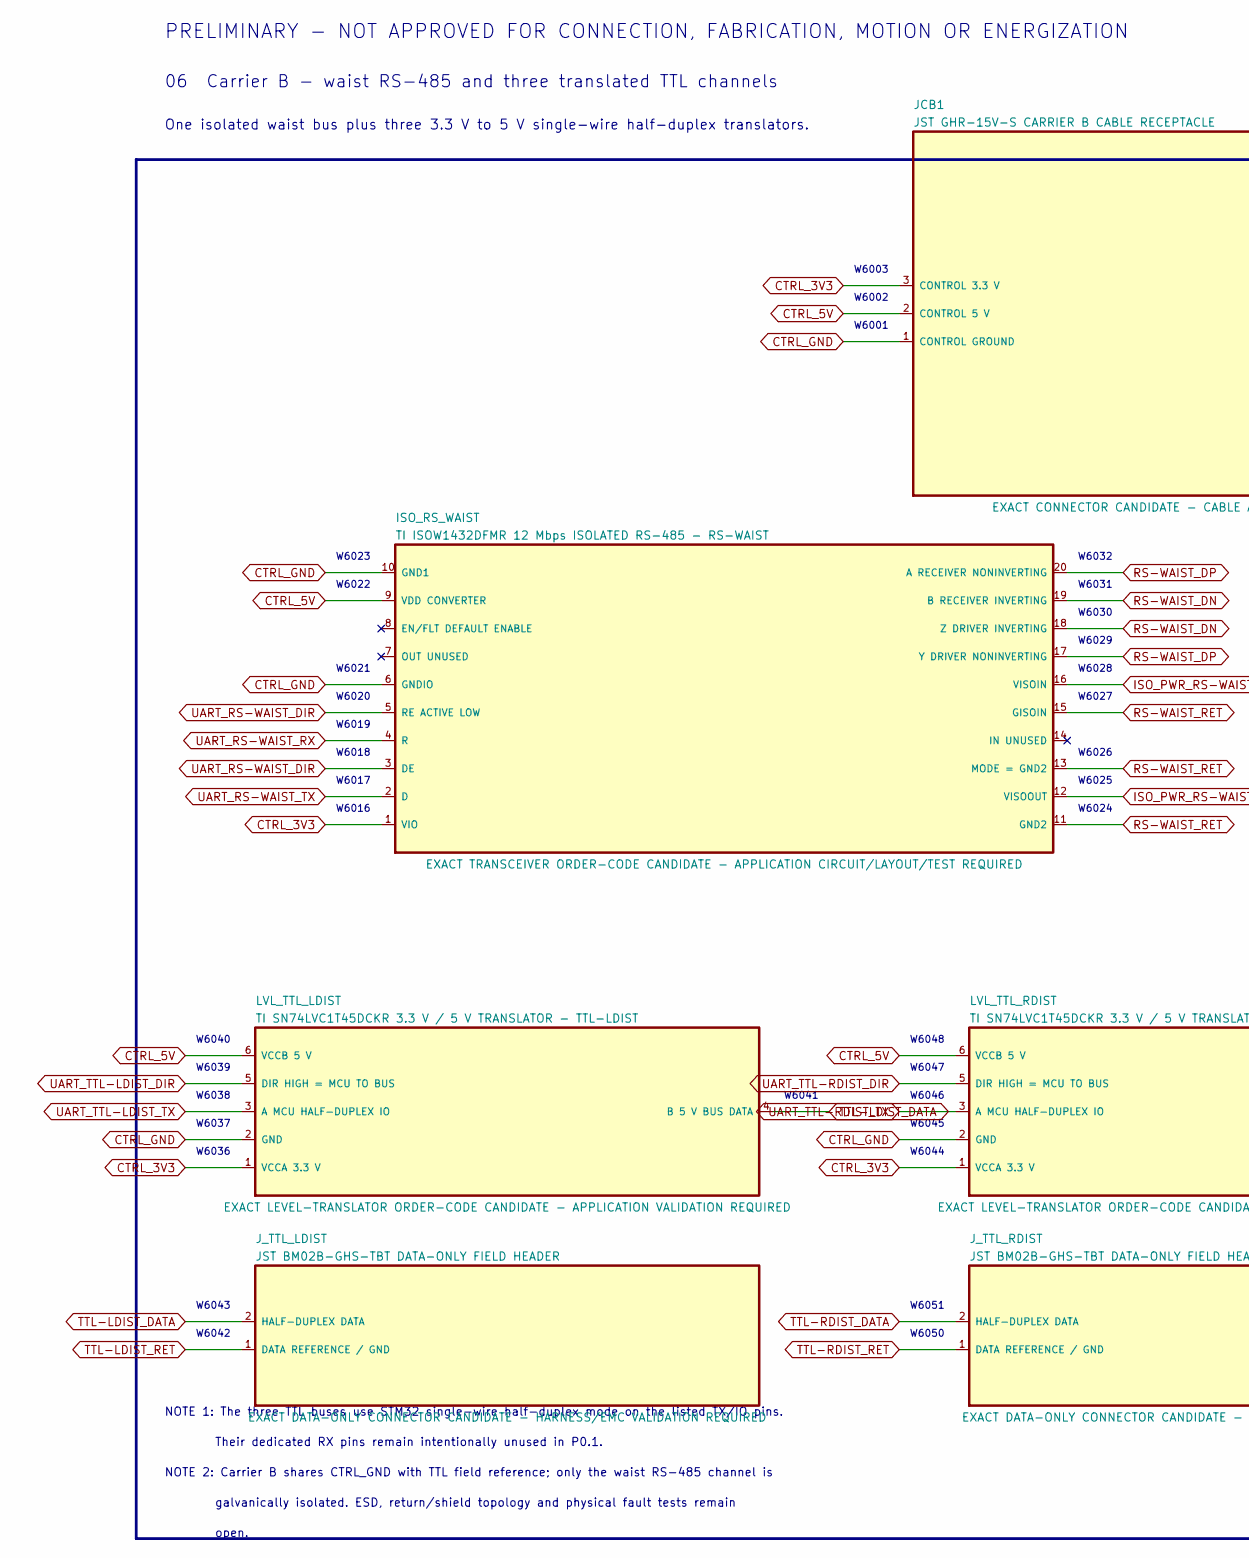
[picture p382: schematic 06_carrier_b_waist_and_ttl.kicad_sch, part in row 1, column 1]

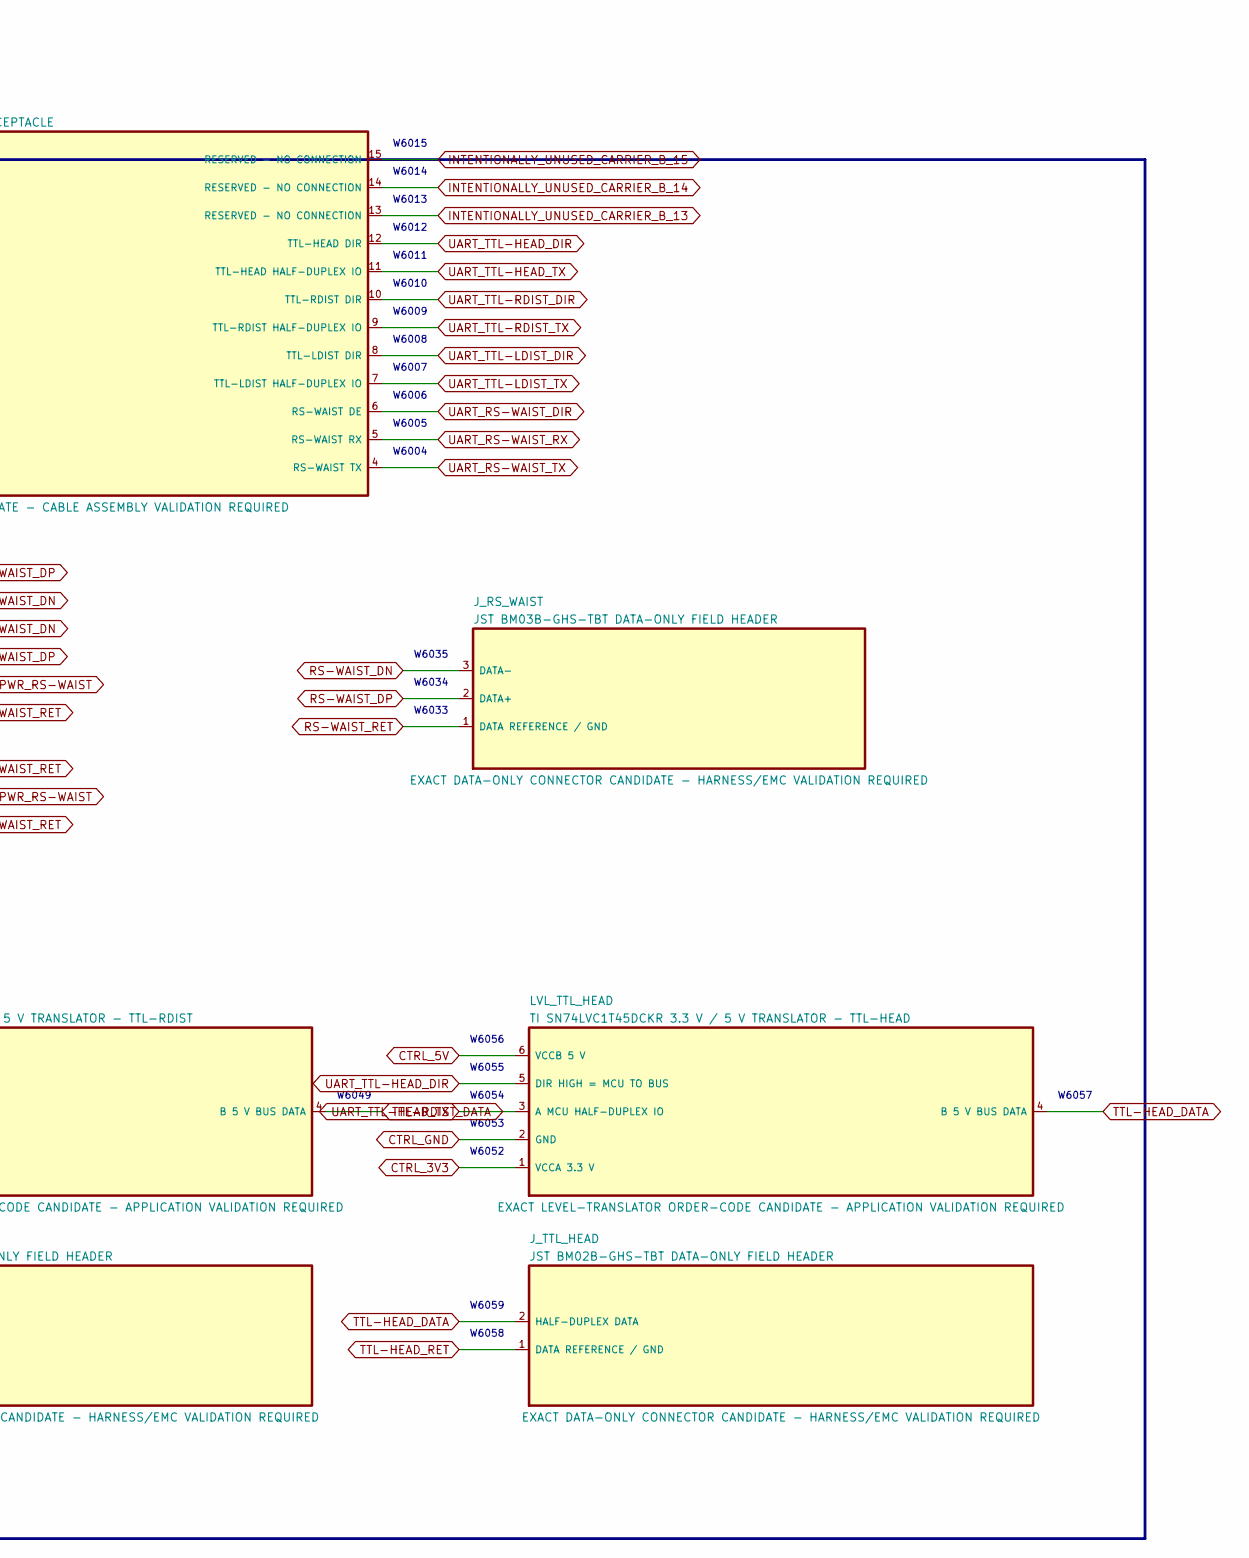
[picture p383: schematic 06_carrier_b_waist_and_ttl.kicad_sch, part in row 1, column 2]

Parts:
ISO_RS_WAIST: TI ISOW1432DFMR 12 Mbps ISOLATED RS-485 - RS-WAIST; SOIC-20W_7.5x12.8mm_P1.27mm
JCB1: JST GHR-15V-S CARRIER B CABLE RECEPTACLE
J_RS_WAIST: JST BM03B-GHS-TBT DATA-ONLY FIELD HEADER
J_TTL_HEAD: JST BM02B-GHS-TBT DATA-ONLY FIELD HEADER
J_TTL_LDIST: JST BM02B-GHS-TBT DATA-ONLY FIELD HEADER
J_TTL_RDIST: JST BM02B-GHS-TBT DATA-ONLY FIELD HEADER
LVL_TTL_HEAD: TI SN74LVC1T45DCKR 3.3 V / 5 V TRANSLATOR - TTL-H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; SOT-363_SC-70-6
LVL_TTL_LDIST: TI SN74LVC1T45DCKR 3.3 V / 5 V TRANSLATOR - TTL-L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; SOT-363_SC-70-6
LVL_TTL_RDIST: TI SN74LVC1T45DCKR 3.3 V / 5 V TRANSLATOR - TTL-R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; SOT-363_SC-70-6

Connections:
CTRL_3V3: ISO_RS_WAIST.1 (VIO), JCB1.3 (CONTROL 3.3 V), LVL_TTL_HEAD.1 (VCCA 3.3 V), LVL_TTL_LDIST.1 (VCCA 3.3 V), LVL_TTL_RDIST.1 (VCCA 3.3 V)
CTRL_5V: ISO_RS_WAIST.9 (VDD CONVERTER), JCB1.2 (CONTROL 5 V), LVL_TTL_HEAD.6 (VCCB 5 V), LVL_TTL_LDIST.6 (VCCB 5 V), LVL_TTL_RDIST.6 (VCCB 5 V)
CTRL_GND: ISO_RS_WAIST.6 (GNDIO), ISO_RS_WAIST.10 (GND1), JCB1.1 (CONTROL GROUND), LVL_TTL_HEAD.2 (GND), LVL_TTL_LDIST.2 (GND), LVL_TTL_RDIST.2 (GND)
INTENTIONALLY_UNUSED_CARRIER_B_13: JCB1.13 (RESERVED - NO CONNECTION)
INTENTIONALLY_UNUSED_CARRIER_B_14: JCB1.14 (RESERVED - NO CONNECTION)
INTENTIONALLY_UNUSED_CARRIER_B_15: JCB1.15 (RESERVED - NO CONNECTION)
ISO_PWR_RS-WAIST: ISO_RS_WAIST.12 (VISOOUT), ISO_RS_WAIST.16 (VISOIN)
RS-WAIST_DN: ISO_RS_WAIST.18 (Z DRIVER INVERTING), ISO_RS_WAIST.19 (B RECEIVER INVERTING), J_RS_WAIST.3 (DATA-)
RS-WAIST_DP: ISO_RS_WAIST.17 (Y DRIVER NONINVERTING), ISO_RS_WAIST.20 (A RECEIVER NONINVERTING), J_RS_WAIST.2 (DATA+)
RS-WAIST_RET: ISO_RS_WAIST.11 (GND2), ISO_RS_WAIST.13 (MODE = GND2), ISO_RS_WAIST.15 (GISOIN), J_RS_WAIST.1 (DATA REFERENCE / GND)
TTL-HEAD_DATA: J_TTL_HEAD.2 (HALF-DUPLEX DATA), LVL_TTL_HEAD.4 (B 5 V BUS DATA)
TTL-HEAD_RET: J_TTL_HEAD.1 (DATA REFERENCE / GND)
TTL-LDIST_DATA: J_TTL_LDIST.2 (HALF-DUPLEX DATA), LVL_TTL_LDIST.4 (B 5 V BUS DATA)
TTL-LDIST_RET: J_TTL_LDIST.1 (DATA REFERENCE / GND)
TTL-RDIST_DATA: J_TTL_RDIST.2 (HALF-DUPLEX DATA), LVL_TTL_RDIST.4 (B 5 V BUS DATA)
TTL-RDIST_RET: J_TTL_RDIST.1 (DATA REFERENCE / GND)
UART_RS-WAIST_DIR: ISO_RS_WAIST.3 (DE), ISO_RS_WAIST.5 (RE ACTIVE LOW), JCB1.6 (RS-WAIST DE)
UART_RS-WAIST_RX: ISO_RS_WAIST.4 (R), JCB1.5 (RS-WAIST RX)
UART_RS-WAIST_TX: ISO_RS_WAIST.2 (D), JCB1.4 (RS-WAIST TX)
UART_TTL-HEAD_DIR: JCB1.12 (TTL-HEAD DIR), LVL_TTL_HEAD.5 (DIR HIGH = MCU TO BUS)
UART_TTL-HEAD_TX: JCB1.11 (TTL-HEAD HALF-DUPLEX IO), LVL_TTL_HEAD.3 (A MCU HALF-DUPLEX IO)
UART_TTL-LDIST_DIR: JCB1.8 (TTL-LDIST DIR), LVL_TTL_LDIST.5 (DIR HIGH = MCU TO BUS)
UART_TTL-LDIST_TX: JCB1.7 (TTL-LDIST HALF-DUPLEX IO), LVL_TTL_LDIST.3 (A MCU HALF-DUPLEX IO)
UART_TTL-RDIST_DIR: JCB1.10 (TTL-RDIST DIR), LVL_TTL_RDIST.5 (DIR HIGH = MCU TO BUS)
UART_TTL-RDIST_TX: JCB1.9 (TTL-RDIST HALF-DUPLEX IO), LVL_TTL_RDIST.3 (A MCU HALF-DUPLEX IO)

Notes on the sheet:
PRELIMINARY - NOT APPROVED FOR CONNECTION, FABRICATION, MOTION OR ENERGIZATION
06 Carrier B - waist RS-485 and three translated TTL channels
One isolated waist bus plus three 3.3 V to 5 V single-wire half-duplex translators.
W6001
W6002
W6003
W6004
W6005
W6006
W6007
W6008
W6009
W6010
W6011
W6012
W6013
W6014
W6015
W6016
W6017
W6018
W6019
W6020
W6021
W6022
W6023
W6024
W6025
W6026
W6027
W6028
W6029
W6030
W6031
W6032
W6033
W6034
W6035
W6036
W6037
W6038
W6039
W6040
W6041
W6042
W6043
W6044
W6045
W6046
W6047
W6048
W6049
W6050
W6051
W6052
W6053
W6054
W6055
W6056
W6057
W6058
W6059
NOTE 1: The three TTL buses use STM32 single-wire half-duplex mode on the listed TX/IO pins.
Their dedicated RX pins remain intentionally unused in P0.1.
NOTE 2: Carrier B shares CTRL_GND with TTL field reference; only the waist RS-485 channel is
galvanically isolated. ESD, return/shield topology and physical fault tests remain
open.
