amyleesterling/humanoid-robot/hr30/whole-body-p0.1/electrical/kicad/hr30-whole-body-electrical-p0.1/07_left_leg_rs485.kicad_sch

## KiCad design hr30/whole-body-p0.1/electrical/kicad/hr30-whole-body-electrical-p0.1/07_left_leg_rs485.kicad_sch (2026-08-15)

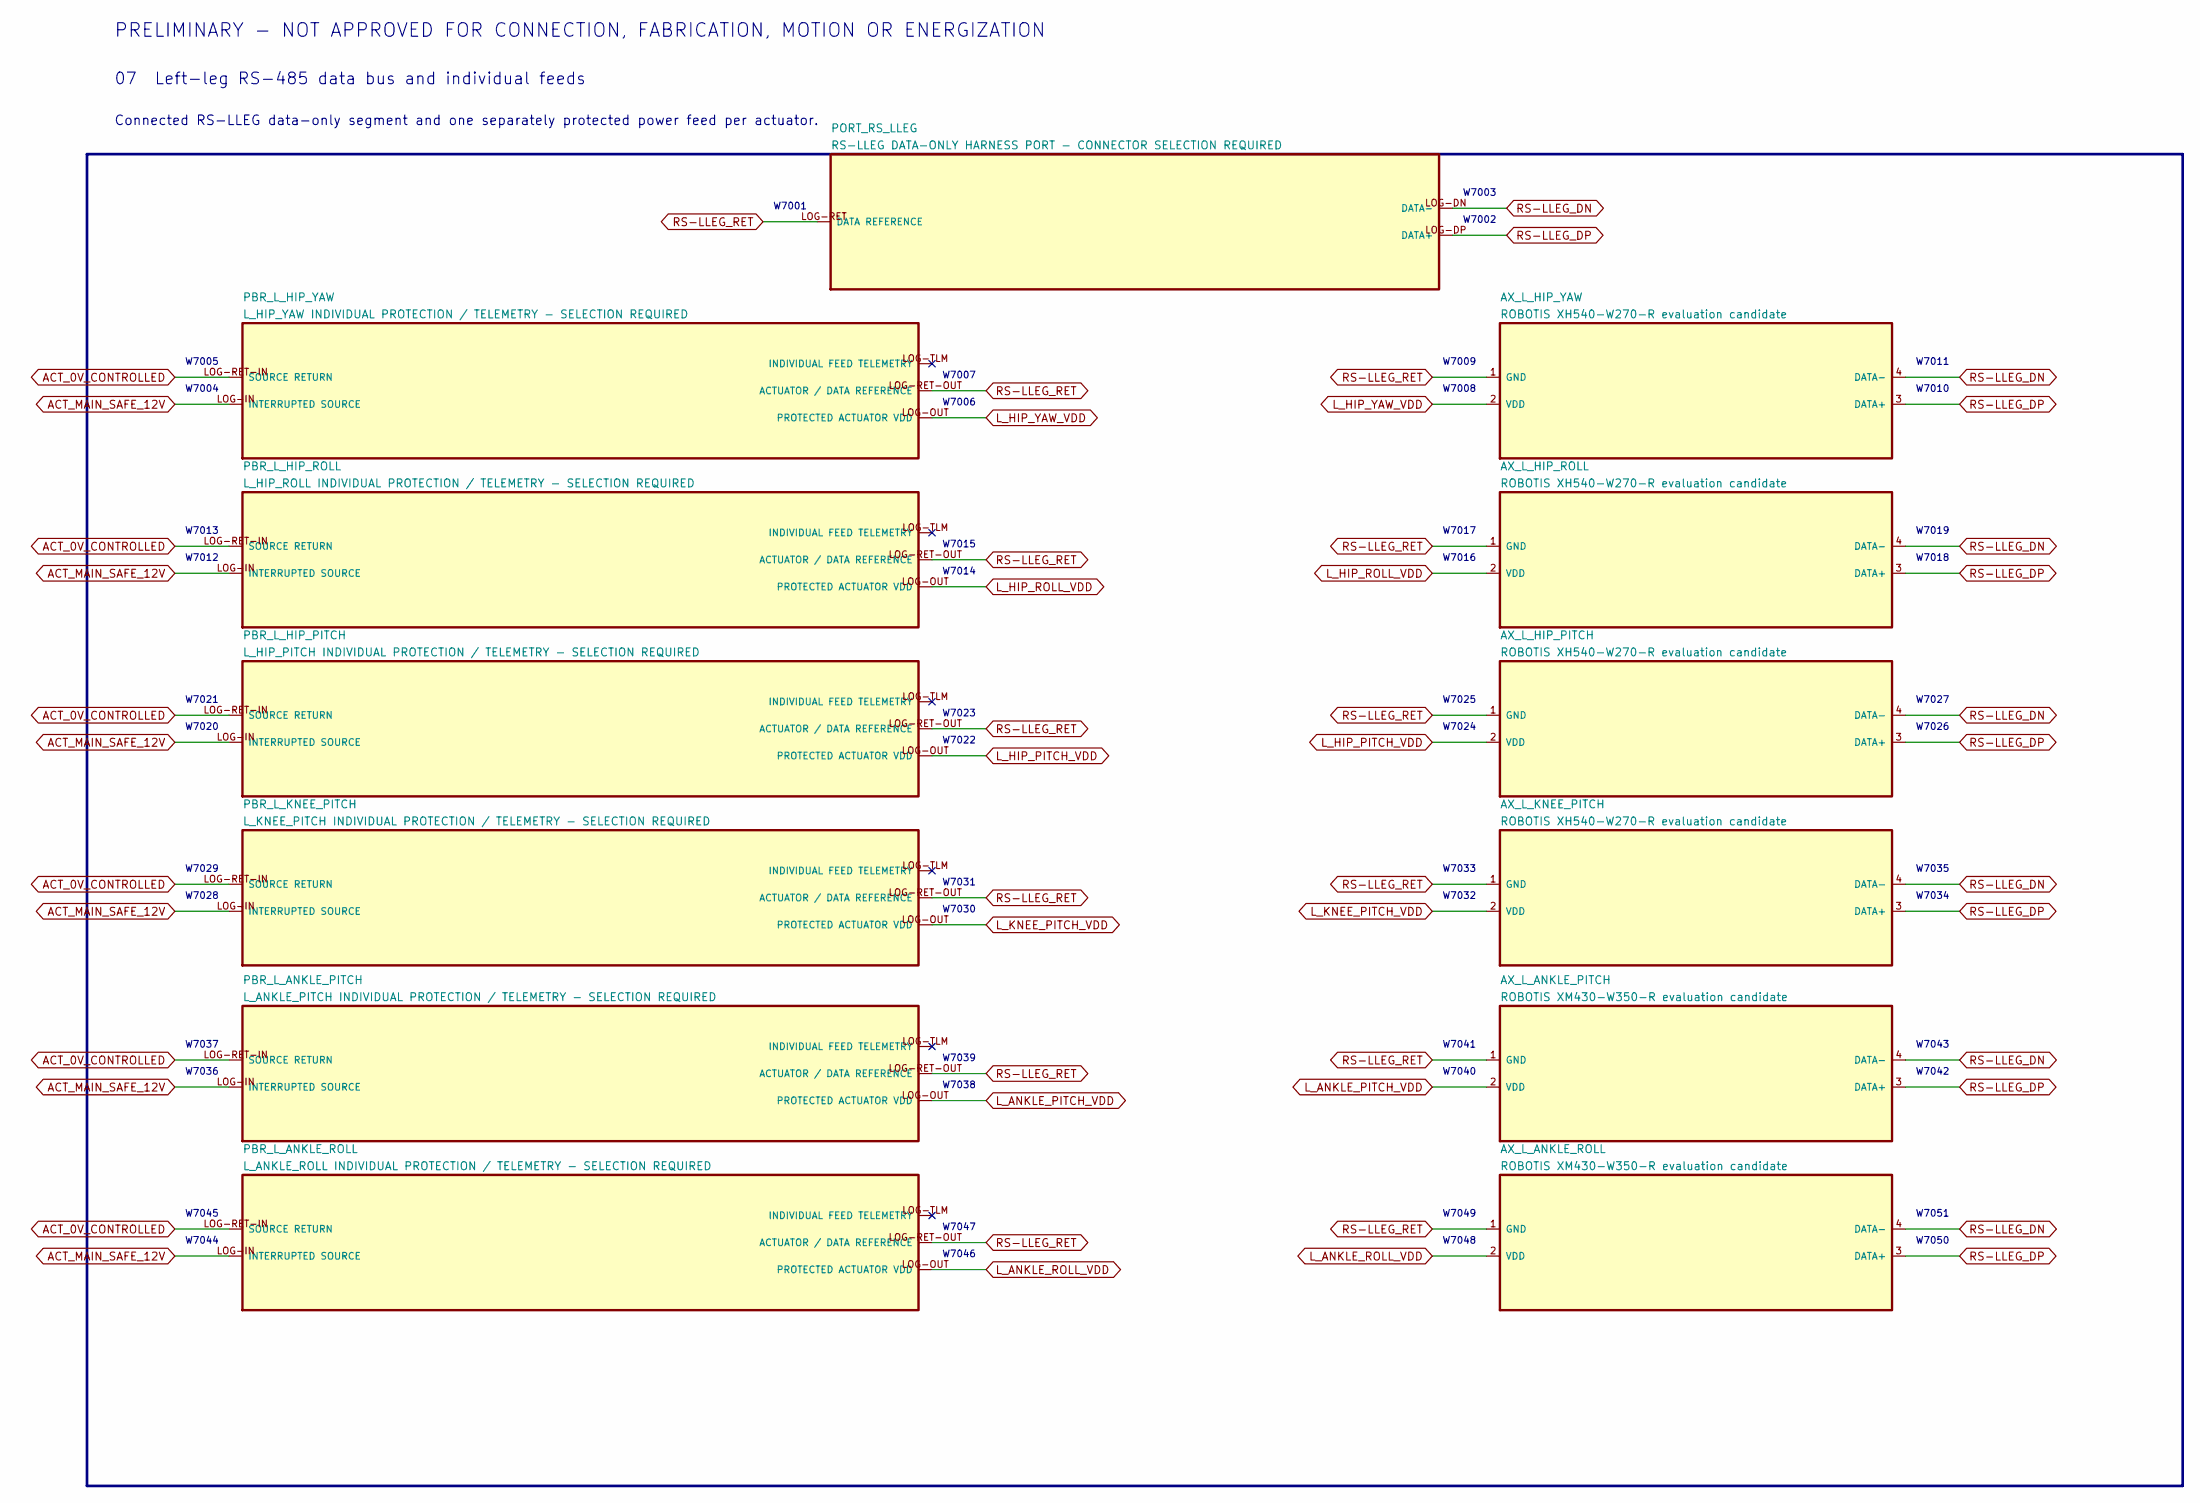
[picture p384: schematic 07_left_leg_rs485.kicad_sch]

Parts:
AX_L_ANKLE_PITCH: ROBOTIS XM430-W350-R evaluation candidate
AX_L_ANKLE_ROLL: ROBOTIS XM430-W350-R evaluation candidate
AX_L_HIP_PITCH: ROBOTIS XH540-W270-R evaluation candidate
AX_L_HIP_ROLL: ROBOTIS XH540-W270-R evaluation candidate
AX_L_HIP_YAW: ROBOTIS XH540-W270-R evaluation candidate
AX_L_KNEE_PITCH: ROBOTIS XH540-W270-R evaluation candidate
PBR_L_ANKLE_PITCH: L_ANKLE_PITCH INDIVIDUAL PROTECTION / TELEMETRY -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
PBR_L_ANKLE_ROLL: L_ANKLE_ROLL INDIVIDUAL PROTECTION / TELEMETRY - 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
PBR_L_HIP_PITCH: L_HIP_PITCH INDIVIDUAL PROTECTION / TELEMETRY - S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
PBR_L_HIP_ROLL: L_HIP_ROLL INDIVIDUAL PROTECTION / TELEMETRY - SE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
PBR_L_HIP_YAW: L_HIP_YAW INDIVIDUAL PROTECTION / TELEMETRY - SEL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
PBR_L_KNEE_PITCH: L_KNEE_PITCH INDIVIDUAL PROTECTION / TELEMETRY - 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
PORT_RS_LLEG: RS-LLEG DATA-ONLY HARNESS PORT - CONNECTOR SELECT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

Connections:
ACT_0V_CONTROLLED: PBR_L_ANKLE_PITCH.LOG-RET-IN (SOURCE RETURN), PBR_L_ANKLE_ROLL.LOG-RET-IN (SOURCE RETURN), PBR_L_HIP_PITCH.LOG-RET-IN (SOURCE RETURN), PBR_L_HIP_ROLL.LOG-RET-IN (SOURCE RETURN), PBR_L_HIP_YAW.LOG-RET-IN (SOURCE RETURN), PBR_L_KNEE_PITCH.LOG-RET-IN (SOURCE RETURN)
ACT_MAIN_SAFE_12V: PBR_L_ANKLE_PITCH.LOG-IN (INTERRUPTED SOURCE), PBR_L_ANKLE_ROLL.LOG-IN (INTERRUPTED SOURCE), PBR_L_HIP_PITCH.LOG-IN (INTERRUPTED SOURCE), PBR_L_HIP_ROLL.LOG-IN (INTERRUPTED SOURCE), PBR_L_HIP_YAW.LOG-IN (INTERRUPTED SOURCE), PBR_L_KNEE_PITCH.LOG-IN (INTERRUPTED SOURCE)
L_ANKLE_PITCH_VDD: AX_L_ANKLE_PITCH.2 (VDD), PBR_L_ANKLE_PITCH.LOG-OUT (PROTECTED ACTUATOR VDD)
L_ANKLE_ROLL_VDD: AX_L_ANKLE_ROLL.2 (VDD), PBR_L_ANKLE_ROLL.LOG-OUT (PROTECTED ACTUATOR VDD)
L_HIP_PITCH_VDD: AX_L_HIP_PITCH.2 (VDD), PBR_L_HIP_PITCH.LOG-OUT (PROTECTED ACTUATOR VDD)
L_HIP_ROLL_VDD: AX_L_HIP_ROLL.2 (VDD), PBR_L_HIP_ROLL.LOG-OUT (PROTECTED ACTUATOR VDD)
L_HIP_YAW_VDD: AX_L_HIP_YAW.2 (VDD), PBR_L_HIP_YAW.LOG-OUT (PROTECTED ACTUATOR VDD)
L_KNEE_PITCH_VDD: AX_L_KNEE_PITCH.2 (VDD), PBR_L_KNEE_PITCH.LOG-OUT (PROTECTED ACTUATOR VDD)
RS-LLEG_DN: AX_L_ANKLE_PITCH.4 (DATA-), AX_L_ANKLE_ROLL.4 (DATA-), AX_L_HIP_PITCH.4 (DATA-), AX_L_HIP_ROLL.4 (DATA-), AX_L_HIP_YAW.4 (DATA-), AX_L_KNEE_PITCH.4 (DATA-), PORT_RS_LLEG.LOG-DN (DATA-)
RS-LLEG_DP: AX_L_ANKLE_PITCH.3 (DATA+), AX_L_ANKLE_ROLL.3 (DATA+), AX_L_HIP_PITCH.3 (DATA+), AX_L_HIP_ROLL.3 (DATA+), AX_L_HIP_YAW.3 (DATA+), AX_L_KNEE_PITCH.3 (DATA+), PORT_RS_LLEG.LOG-DP (DATA+)
RS-LLEG_RET: AX_L_ANKLE_PITCH.1 (GND), AX_L_ANKLE_ROLL.1 (GND), AX_L_HIP_PITCH.1 (GND), AX_L_HIP_ROLL.1 (GND), AX_L_HIP_YAW.1 (GND), AX_L_KNEE_PITCH.1 (GND), PBR_L_ANKLE_PITCH.LOG-RET-OUT (ACTUATOR / DATA REFERENCE), PBR_L_ANKLE_ROLL.LOG-RET-OUT (ACTUATOR / DATA REFERENCE), PBR_L_HIP_PITCH.LOG-RET-OUT (ACTUATOR / DATA REFERENCE), PBR_L_HIP_ROLL.LOG-RET-OUT (ACTUATOR / DATA REFERENCE), PBR_L_HIP_YAW.LOG-RET-OUT (ACTUATOR / DATA REFERENCE), PBR_L_KNEE_PITCH.LOG-RET-OUT (ACTUATOR / DATA REFERENCE), PORT_RS_LLEG.LOG-RET (DATA REFERENCE)

Notes on the sheet:
PRELIMINARY - NOT APPROVED FOR CONNECTION, FABRICATION, MOTION OR ENERGIZATION
07 Left-leg RS-485 data bus and individual feeds
Connected RS-LLEG data-only segment and one separately protected power feed per actuator.
W7001
W7002
W7003
W7004
W7005
W7006
W7007
W7008
W7009
W7010
W7011
W7012
W7013
W7014
W7015
W7016
W7017
W7018
W7019
W7020
W7021
W7022
W7023
W7024
W7025
W7026
W7027
W7028
W7029
W7030
W7031
W7032
W7033
W7034
W7035
W7036
W7037
W7038
W7039
W7040
W7041
W7042
W7043
W7044
W7045
W7046
W7047
W7048
W7049
W7050
W7051
