amyleesterling/humanoid-robot/hr30/whole-body-p0.1/electrical/kicad/hr30-whole-body-electrical-p0.1/08_right_leg_rs485.kicad_sch

## KiCad design hr30/whole-body-p0.1/electrical/kicad/hr30-whole-body-electrical-p0.1/08_right_leg_rs485.kicad_sch (2026-08-15)

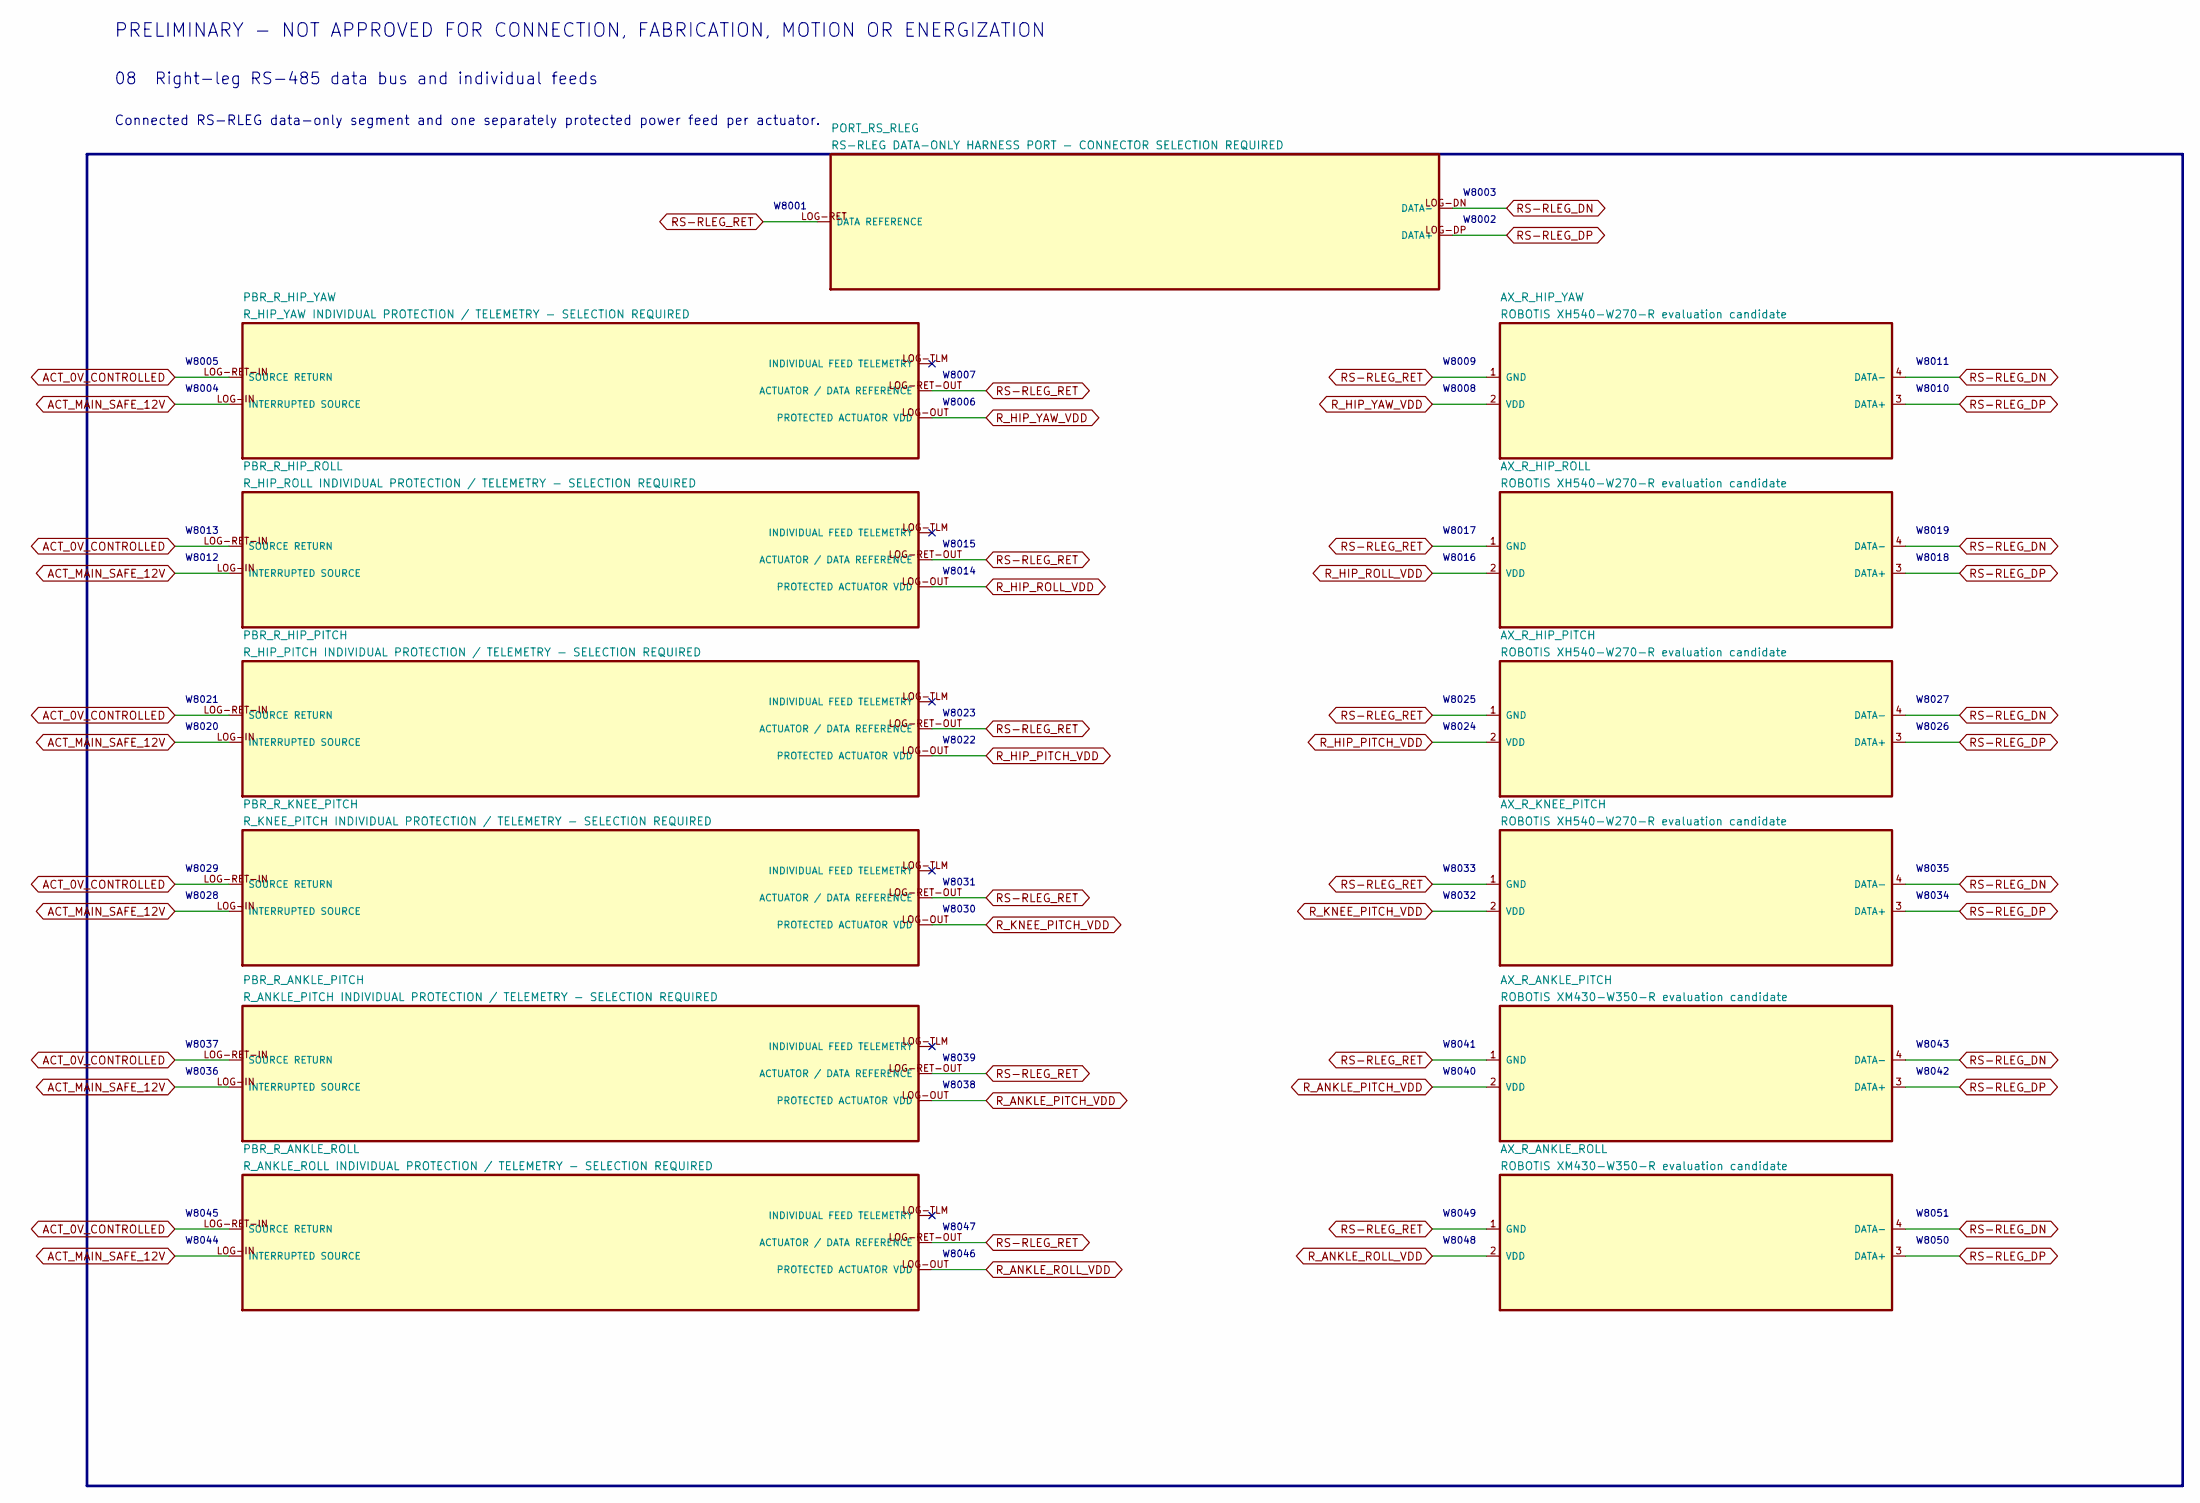
[picture p385: schematic 08_right_leg_rs485.kicad_sch]

Parts:
AX_R_ANKLE_PITCH: ROBOTIS XM430-W350-R evaluation candidate
AX_R_ANKLE_ROLL: ROBOTIS XM430-W350-R evaluation candidate
AX_R_HIP_PITCH: ROBOTIS XH540-W270-R evaluation candidate
AX_R_HIP_ROLL: ROBOTIS XH540-W270-R evaluation candidate
AX_R_HIP_YAW: ROBOTIS XH540-W270-R evaluation candidate
AX_R_KNEE_PITCH: ROBOTIS XH540-W270-R evaluation candidate
PBR_R_ANKLE_PITCH: R_ANKLE_PITCH INDIVIDUAL PROTECTION / TELEMETRY -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
PBR_R_ANKLE_ROLL: R_ANKLE_ROLL INDIVIDUAL PROTECTION / TELEMETRY - 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
PBR_R_HIP_PITCH: R_HIP_PITCH INDIVIDUAL PROTECTION / TELEMETRY - S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
PBR_R_HIP_ROLL: R_HIP_ROLL INDIVIDUAL PROTECTION / TELEMETRY - SE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
PBR_R_HIP_YAW: R_HIP_YAW INDIVIDUAL PROTECTION / TELEMETRY - SEL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
PBR_R_KNEE_PITCH: R_KNEE_PITCH INDIVIDUAL PROTECTION / TELEMETRY - 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
PORT_RS_RLEG: RS-RLEG DATA-ONLY HARNESS PORT - CONNECTOR SELECT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

Connections:
ACT_0V_CONTROLLED: PBR_R_ANKLE_PITCH.LOG-RET-IN (SOURCE RETURN), PBR_R_ANKLE_ROLL.LOG-RET-IN (SOURCE RETURN), PBR_R_HIP_PITCH.LOG-RET-IN (SOURCE RETURN), PBR_R_HIP_ROLL.LOG-RET-IN (SOURCE RETURN), PBR_R_HIP_YAW.LOG-RET-IN (SOURCE RETURN), PBR_R_KNEE_PITCH.LOG-RET-IN (SOURCE RETURN)
ACT_MAIN_SAFE_12V: PBR_R_ANKLE_PITCH.LOG-IN (INTERRUPTED SOURCE), PBR_R_ANKLE_ROLL.LOG-IN (INTERRUPTED SOURCE), PBR_R_HIP_PITCH.LOG-IN (INTERRUPTED SOURCE), PBR_R_HIP_ROLL.LOG-IN (INTERRUPTED SOURCE), PBR_R_HIP_YAW.LOG-IN (INTERRUPTED SOURCE), PBR_R_KNEE_PITCH.LOG-IN (INTERRUPTED SOURCE)
RS-RLEG_DN: AX_R_ANKLE_PITCH.4 (DATA-), AX_R_ANKLE_ROLL.4 (DATA-), AX_R_HIP_PITCH.4 (DATA-), AX_R_HIP_ROLL.4 (DATA-), AX_R_HIP_YAW.4 (DATA-), AX_R_KNEE_PITCH.4 (DATA-), PORT_RS_RLEG.LOG-DN (DATA-)
RS-RLEG_DP: AX_R_ANKLE_PITCH.3 (DATA+), AX_R_ANKLE_ROLL.3 (DATA+), AX_R_HIP_PITCH.3 (DATA+), AX_R_HIP_ROLL.3 (DATA+), AX_R_HIP_YAW.3 (DATA+), AX_R_KNEE_PITCH.3 (DATA+), PORT_RS_RLEG.LOG-DP (DATA+)
RS-RLEG_RET: AX_R_ANKLE_PITCH.1 (GND), AX_R_ANKLE_ROLL.1 (GND), AX_R_HIP_PITCH.1 (GND), AX_R_HIP_ROLL.1 (GND), AX_R_HIP_YAW.1 (GND), AX_R_KNEE_PITCH.1 (GND), PBR_R_ANKLE_PITCH.LOG-RET-OUT (ACTUATOR / DATA REFERENCE), PBR_R_ANKLE_ROLL.LOG-RET-OUT (ACTUATOR / DATA REFERENCE), PBR_R_HIP_PITCH.LOG-RET-OUT (ACTUATOR / DATA REFERENCE), PBR_R_HIP_ROLL.LOG-RET-OUT (ACTUATOR / DATA REFERENCE), PBR_R_HIP_YAW.LOG-RET-OUT (ACTUATOR / DATA REFERENCE), PBR_R_KNEE_PITCH.LOG-RET-OUT (ACTUATOR / DATA REFERENCE), PORT_RS_RLEG.LOG-RET (DATA REFERENCE)
R_ANKLE_PITCH_VDD: AX_R_ANKLE_PITCH.2 (VDD), PBR_R_ANKLE_PITCH.LOG-OUT (PROTECTED ACTUATOR VDD)
R_ANKLE_ROLL_VDD: AX_R_ANKLE_ROLL.2 (VDD), PBR_R_ANKLE_ROLL.LOG-OUT (PROTECTED ACTUATOR VDD)
R_HIP_PITCH_VDD: AX_R_HIP_PITCH.2 (VDD), PBR_R_HIP_PITCH.LOG-OUT (PROTECTED ACTUATOR VDD)
R_HIP_ROLL_VDD: AX_R_HIP_ROLL.2 (VDD), PBR_R_HIP_ROLL.LOG-OUT (PROTECTED ACTUATOR VDD)
R_HIP_YAW_VDD: AX_R_HIP_YAW.2 (VDD), PBR_R_HIP_YAW.LOG-OUT (PROTECTED ACTUATOR VDD)
R_KNEE_PITCH_VDD: AX_R_KNEE_PITCH.2 (VDD), PBR_R_KNEE_PITCH.LOG-OUT (PROTECTED ACTUATOR VDD)

Notes on the sheet:
PRELIMINARY - NOT APPROVED FOR CONNECTION, FABRICATION, MOTION OR ENERGIZATION
08 Right-leg RS-485 data bus and individual feeds
Connected RS-RLEG data-only segment and one separately protected power feed per actuator.
W8001
W8002
W8003
W8004
W8005
W8006
W8007
W8008
W8009
W8010
W8011
W8012
W8013
W8014
W8015
W8016
W8017
W8018
W8019
W8020
W8021
W8022
W8023
W8024
W8025
W8026
W8027
W8028
W8029
W8030
W8031
W8032
W8033
W8034
W8035
W8036
W8037
W8038
W8039
W8040
W8041
W8042
W8043
W8044
W8045
W8046
W8047
W8048
W8049
W8050
W8051
