amyleesterling/humanoid-robot/hr30/whole-body-p0.1/electrical/kicad/hr30-whole-body-electrical-p0.1/09_left_arm_rs485.kicad_sch

## KiCad design hr30/whole-body-p0.1/electrical/kicad/hr30-whole-body-electrical-p0.1/09_left_arm_rs485.kicad_sch (2026-08-16)

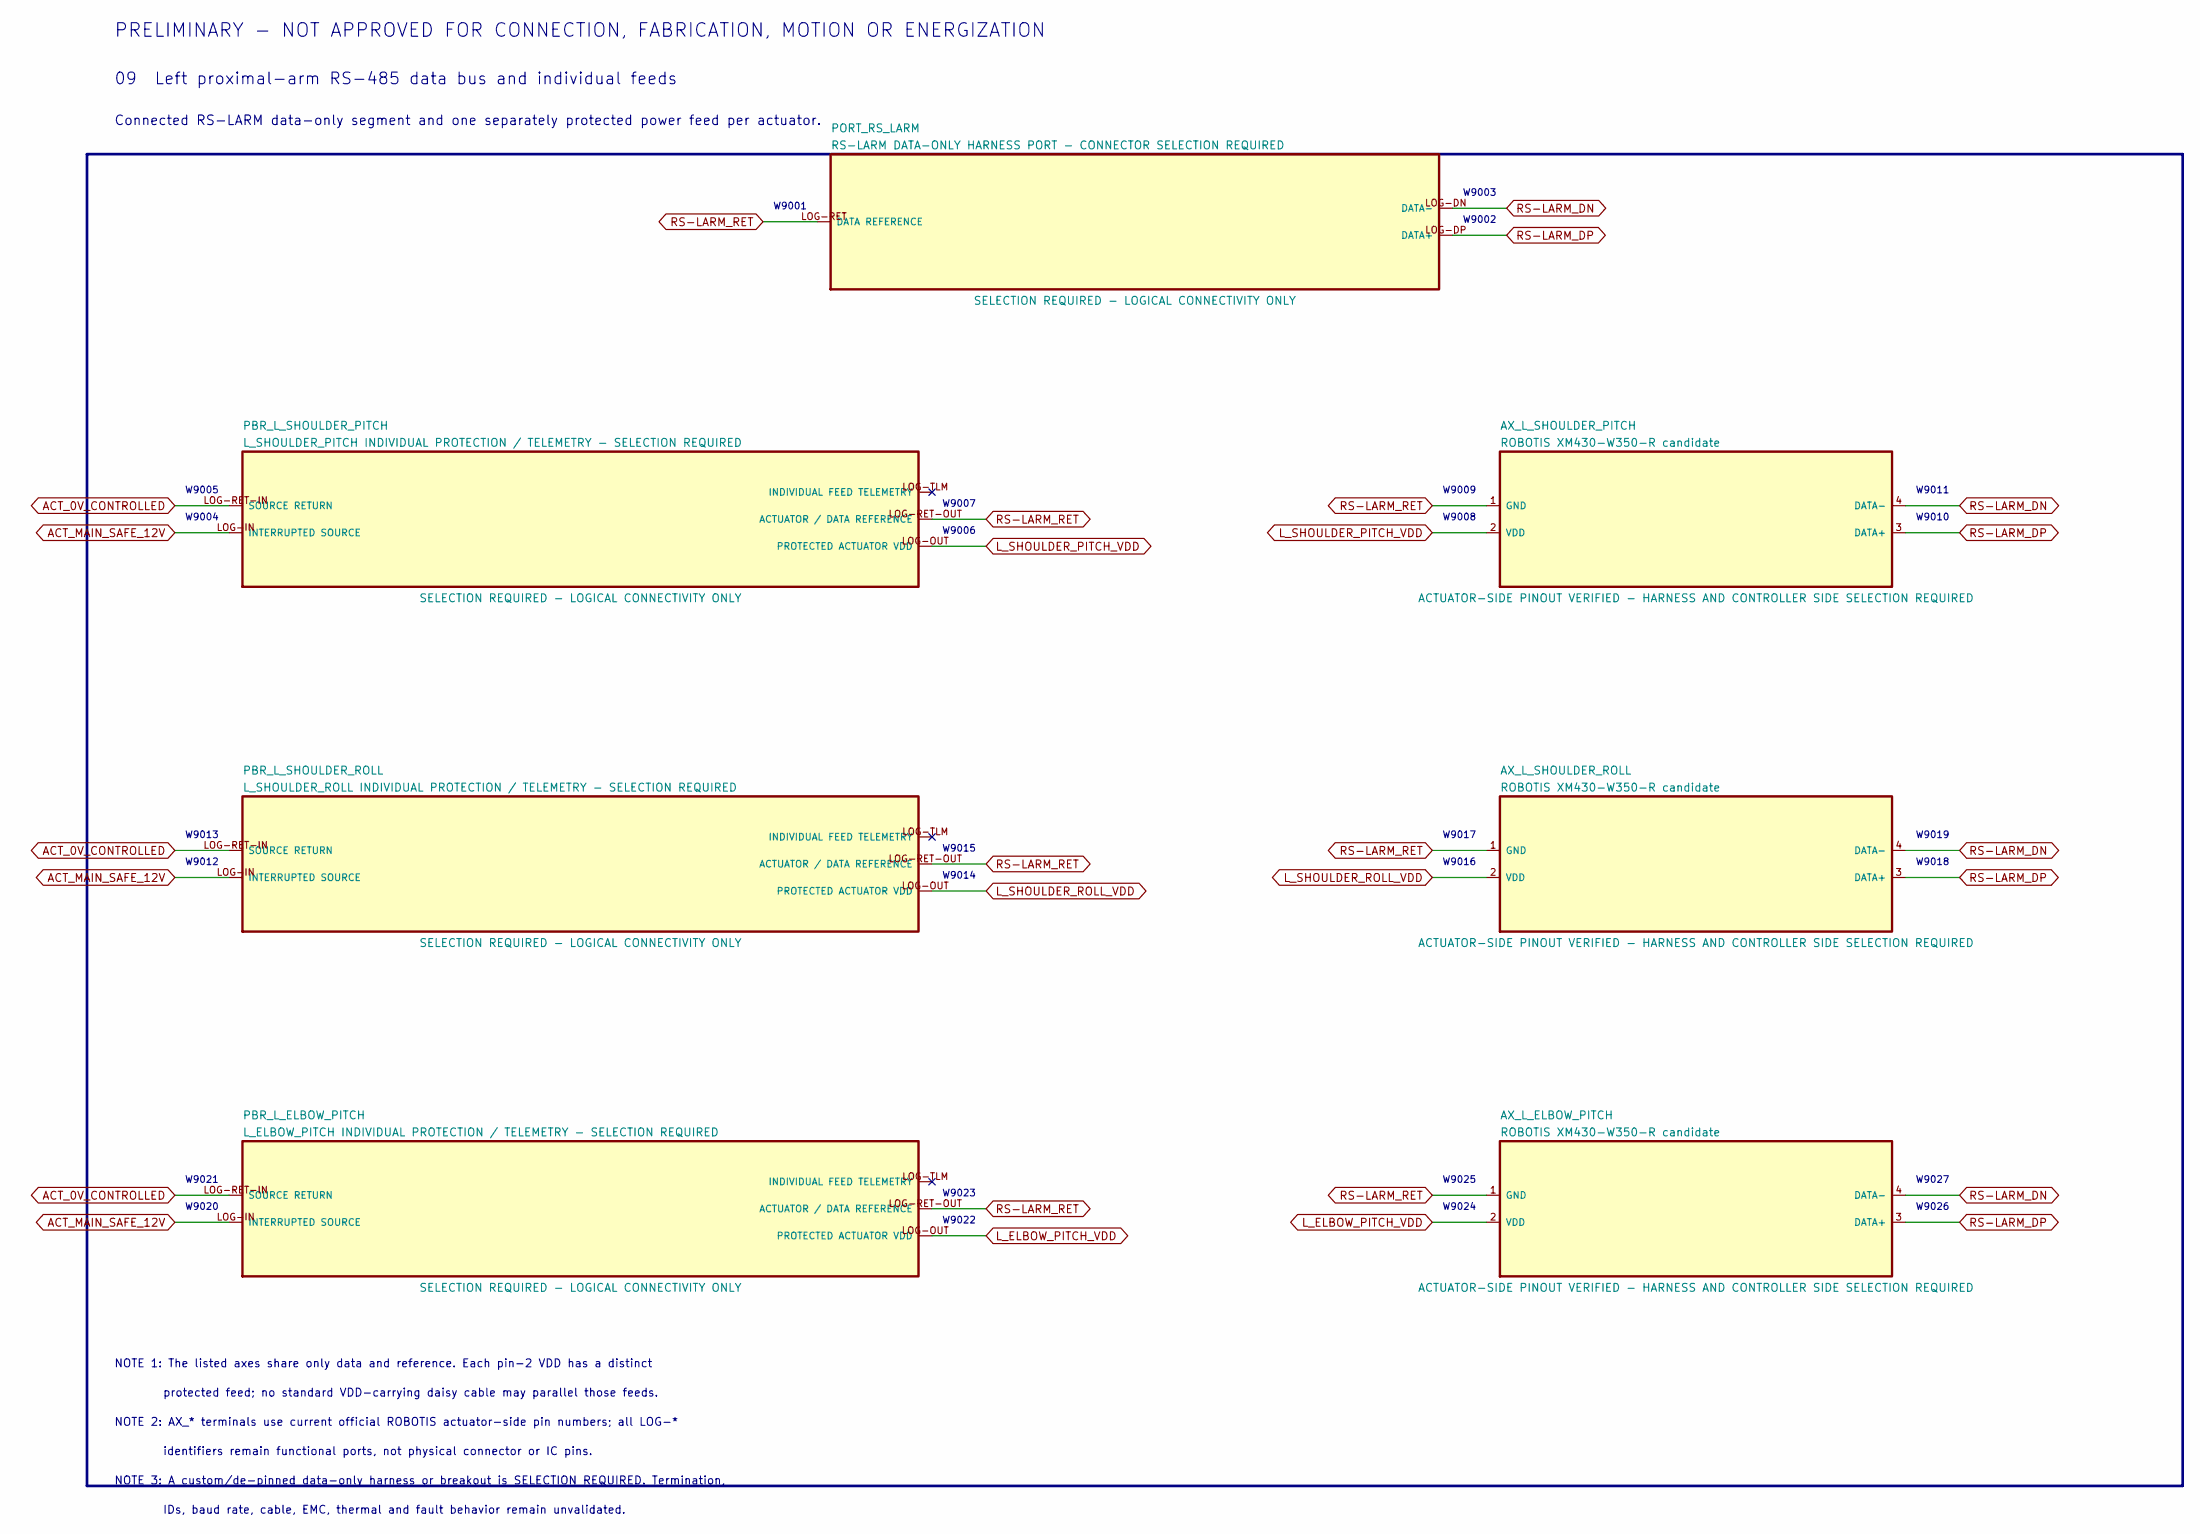
[picture p386: schematic 09_left_arm_rs485.kicad_sch]

Parts:
AX_L_ELBOW_PITCH: ROBOTIS XM430-W350-R candidate
AX_L_SHOULDER_PITCH: ROBOTIS XM430-W350-R candidate
AX_L_SHOULDER_ROLL: ROBOTIS XM430-W350-R candidate
PBR_L_ELBOW_PITCH: L_ELBOW_PITCH INDIVIDUAL PROTECTION / TELEMETRY -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
PBR_L_SHOULDER_PITCH: L_SHOULDER_PITCH INDIVIDUAL PROTECTION / TELEMETR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
PBR_L_SHOULDER_ROLL: L_SHOULDER_ROLL INDIVIDUAL PROTECTION / TELEMETRY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
PORT_RS_LARM: RS-LARM DATA-ONLY HARNESS PORT - CONNECTOR SELECT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

Connections:
ACT_0V_CONTROLLED: PBR_L_ELBOW_PITCH.LOG-RET-IN (SOURCE RETURN), PBR_L_SHOULDER_PITCH.LOG-RET-IN (SOURCE RETURN), PBR_L_SHOULDER_ROLL.LOG-RET-IN (SOURCE RETURN)
ACT_MAIN_SAFE_12V: PBR_L_ELBOW_PITCH.LOG-IN (INTERRUPTED SOURCE), PBR_L_SHOULDER_PITCH.LOG-IN (INTERRUPTED SOURCE), PBR_L_SHOULDER_ROLL.LOG-IN (INTERRUPTED SOURCE)
L_ELBOW_PITCH_VDD: AX_L_ELBOW_PITCH.2 (VDD), PBR_L_ELBOW_PITCH.LOG-OUT (PROTECTED ACTUATOR VDD)
L_SHOULDER_PITCH_VDD: AX_L_SHOULDER_PITCH.2 (VDD), PBR_L_SHOULDER_PITCH.LOG-OUT (PROTECTED ACTUATOR VDD)
L_SHOULDER_ROLL_VDD: AX_L_SHOULDER_ROLL.2 (VDD), PBR_L_SHOULDER_ROLL.LOG-OUT (PROTECTED ACTUATOR VDD)
RS-LARM_DN: AX_L_ELBOW_PITCH.4 (DATA-), AX_L_SHOULDER_PITCH.4 (DATA-), AX_L_SHOULDER_ROLL.4 (DATA-), PORT_RS_LARM.LOG-DN (DATA-)
RS-LARM_DP: AX_L_ELBOW_PITCH.3 (DATA+), AX_L_SHOULDER_PITCH.3 (DATA+), AX_L_SHOULDER_ROLL.3 (DATA+), PORT_RS_LARM.LOG-DP (DATA+)
RS-LARM_RET: AX_L_ELBOW_PITCH.1 (GND), AX_L_SHOULDER_PITCH.1 (GND), AX_L_SHOULDER_ROLL.1 (GND), PBR_L_ELBOW_PITCH.LOG-RET-OUT (ACTUATOR / DATA REFERENCE), PBR_L_SHOULDER_PITCH.LOG-RET-OUT (ACTUATOR / DATA REFERENCE), PBR_L_SHOULDER_ROLL.LOG-RET-OUT (ACTUATOR / DATA REFERENCE), PORT_RS_LARM.LOG-RET (DATA REFERENCE)

Notes on the sheet:
PRELIMINARY - NOT APPROVED FOR CONNECTION, FABRICATION, MOTION OR ENERGIZATION
09 Left proximal-arm RS-485 data bus and individual feeds
Connected RS-LARM data-only segment and one separately protected power feed per actuator.
W9001
W9002
W9003
W9004
W9005
W9006
W9007
W9008
W9009
W9010
W9011
W9012
W9013
W9014
W9015
W9016
W9017
W9018
W9019
W9020
W9021
W9022
W9023
W9024
W9025
W9026
W9027
NOTE 1: The listed axes share only data and reference. Each pin-2 VDD has a distinct
protected feed; no standard VDD-carrying daisy cable may parallel those feeds.
NOTE 2: AX_* terminals use current official ROBOTIS actuator-side pin numbers; all LOG-*
identifiers remain functional ports, not physical connector or IC pins.
NOTE 3: A custom/de-pinned data-only harness or breakout is SELECTION REQUIRED. Termination,
IDs, baud rate, cable, EMC, thermal and fault behavior remain unvalidated.
