amyleesterling/humanoid-robot/hr30/whole-body-p0.1/electrical/kicad/hr30-whole-body-electrical-p0.1/10_right_arm_rs485.kicad_sch

## KiCad design hr30/whole-body-p0.1/electrical/kicad/hr30-whole-body-electrical-p0.1/10_right_arm_rs485.kicad_sch (2026-08-16)

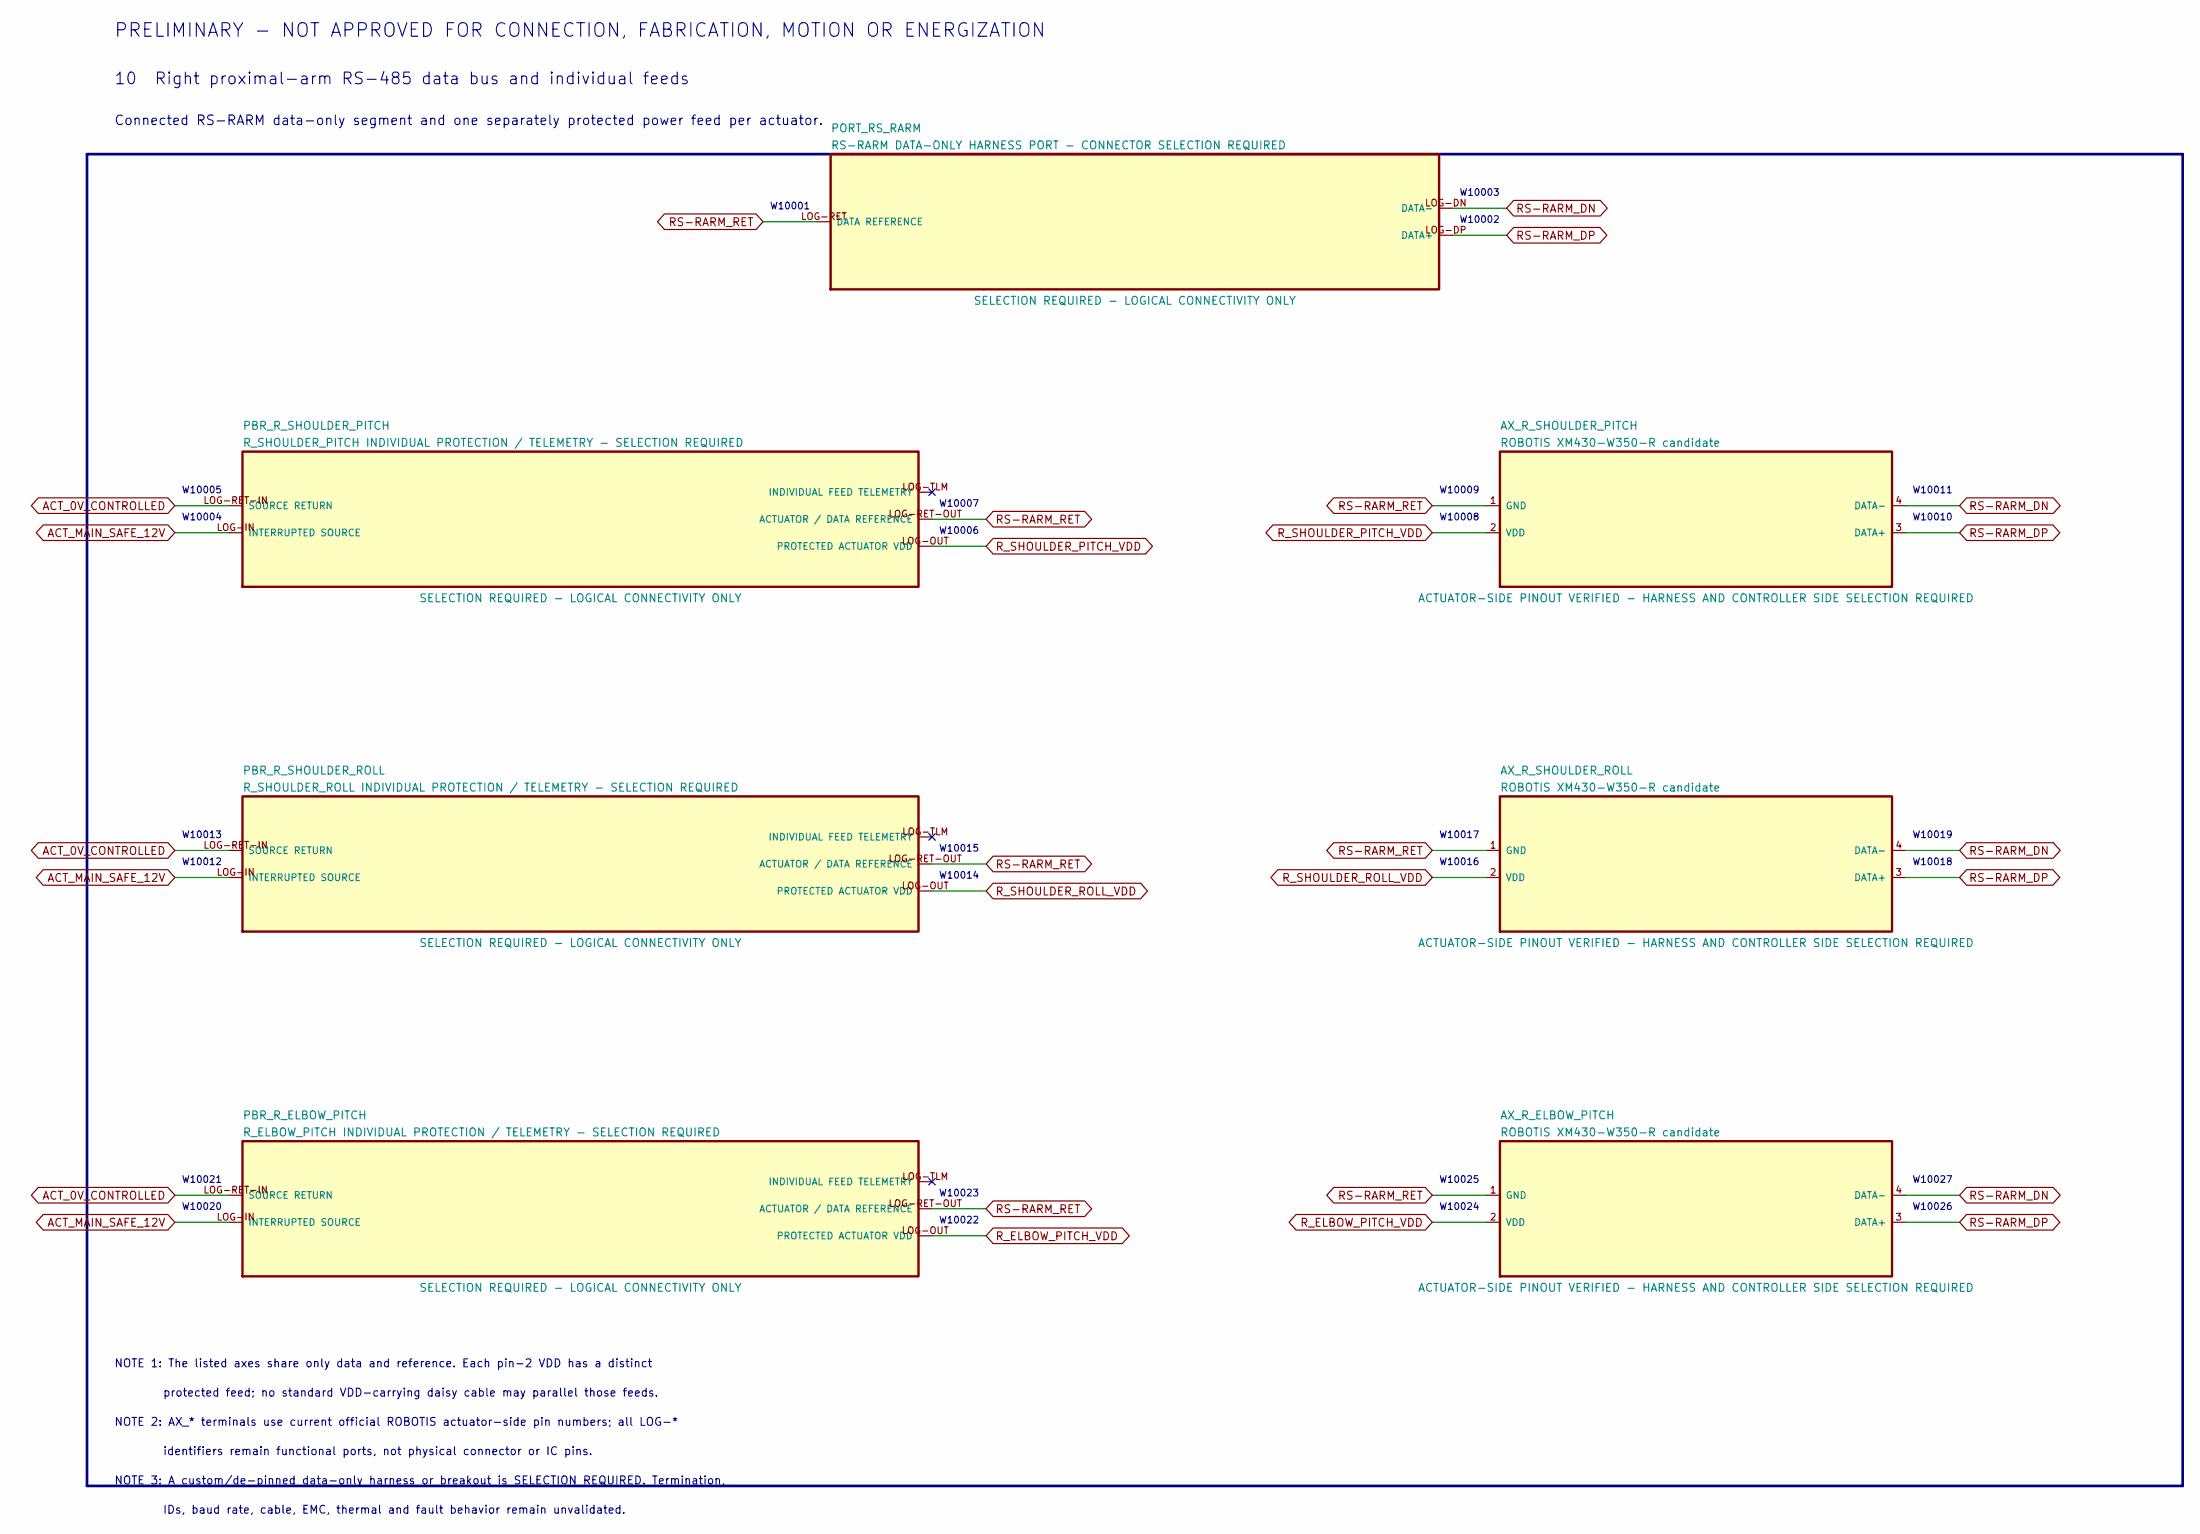
[picture p387: schematic 10_right_arm_rs485.kicad_sch]

Parts:
AX_R_ELBOW_PITCH: ROBOTIS XM430-W350-R candidate
AX_R_SHOULDER_PITCH: ROBOTIS XM430-W350-R candidate
AX_R_SHOULDER_ROLL: ROBOTIS XM430-W350-R candidate
PBR_R_ELBOW_PITCH: R_ELBOW_PITCH INDIVIDUAL PROTECTION / TELEMETRY -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
PBR_R_SHOULDER_PITCH: R_SHOULDER_PITCH INDIVIDUAL PROTECTION / TELEMETR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
PBR_R_SHOULDER_ROLL: R_SHOULDER_ROLL INDIVIDUAL PROTECTION / TELEMETRY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
PORT_RS_RARM: RS-RARM DATA-ONLY HARNESS PORT - CONNECTOR SELECT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

Connections:
ACT_0V_CONTROLLED: PBR_R_ELBOW_PITCH.LOG-RET-IN (SOURCE RETURN), PBR_R_SHOULDER_PITCH.LOG-RET-IN (SOURCE RETURN), PBR_R_SHOULDER_ROLL.LOG-RET-IN (SOURCE RETURN)
ACT_MAIN_SAFE_12V: PBR_R_ELBOW_PITCH.LOG-IN (INTERRUPTED SOURCE), PBR_R_SHOULDER_PITCH.LOG-IN (INTERRUPTED SOURCE), PBR_R_SHOULDER_ROLL.LOG-IN (INTERRUPTED SOURCE)
RS-RARM_DN: AX_R_ELBOW_PITCH.4 (DATA-), AX_R_SHOULDER_PITCH.4 (DATA-), AX_R_SHOULDER_ROLL.4 (DATA-), PORT_RS_RARM.LOG-DN (DATA-)
RS-RARM_DP: AX_R_ELBOW_PITCH.3 (DATA+), AX_R_SHOULDER_PITCH.3 (DATA+), AX_R_SHOULDER_ROLL.3 (DATA+), PORT_RS_RARM.LOG-DP (DATA+)
RS-RARM_RET: AX_R_ELBOW_PITCH.1 (GND), AX_R_SHOULDER_PITCH.1 (GND), AX_R_SHOULDER_ROLL.1 (GND), PBR_R_ELBOW_PITCH.LOG-RET-OUT (ACTUATOR / DATA REFERENCE), PBR_R_SHOULDER_PITCH.LOG-RET-OUT (ACTUATOR / DATA REFERENCE), PBR_R_SHOULDER_ROLL.LOG-RET-OUT (ACTUATOR / DATA REFERENCE), PORT_RS_RARM.LOG-RET (DATA REFERENCE)
R_ELBOW_PITCH_VDD: AX_R_ELBOW_PITCH.2 (VDD), PBR_R_ELBOW_PITCH.LOG-OUT (PROTECTED ACTUATOR VDD)
R_SHOULDER_PITCH_VDD: AX_R_SHOULDER_PITCH.2 (VDD), PBR_R_SHOULDER_PITCH.LOG-OUT (PROTECTED ACTUATOR VDD)
R_SHOULDER_ROLL_VDD: AX_R_SHOULDER_ROLL.2 (VDD), PBR_R_SHOULDER_ROLL.LOG-OUT (PROTECTED ACTUATOR VDD)

Notes on the sheet:
PRELIMINARY - NOT APPROVED FOR CONNECTION, FABRICATION, MOTION OR ENERGIZATION
10 Right proximal-arm RS-485 data bus and individual feeds
Connected RS-RARM data-only segment and one separately protected power feed per actuator.
W10001
W10002
W10003
W10004
W10005
W10006
W10007
W10008
W10009
W10010
W10011
W10012
W10013
W10014
W10015
W10016
W10017
W10018
W10019
W10020
W10021
W10022
W10023
W10024
W10025
W10026
W10027
NOTE 1: The listed axes share only data and reference. Each pin-2 VDD has a distinct
protected feed; no standard VDD-carrying daisy cable may parallel those feeds.
NOTE 2: AX_* terminals use current official ROBOTIS actuator-side pin numbers; all LOG-*
identifiers remain functional ports, not physical connector or IC pins.
NOTE 3: A custom/de-pinned data-only harness or breakout is SELECTION REQUIRED. Termination,
IDs, baud rate, cable, EMC, thermal and fault behavior remain unvalidated.
