amyleesterling/humanoid-robot/hr30/whole-body-p0.1/electrical/kicad/hr30-whole-body-electrical-p0.1/11_waist_rs485.kicad_sch

## KiCad design hr30/whole-body-p0.1/electrical/kicad/hr30-whole-body-electrical-p0.1/11_waist_rs485.kicad_sch (2026-08-15)

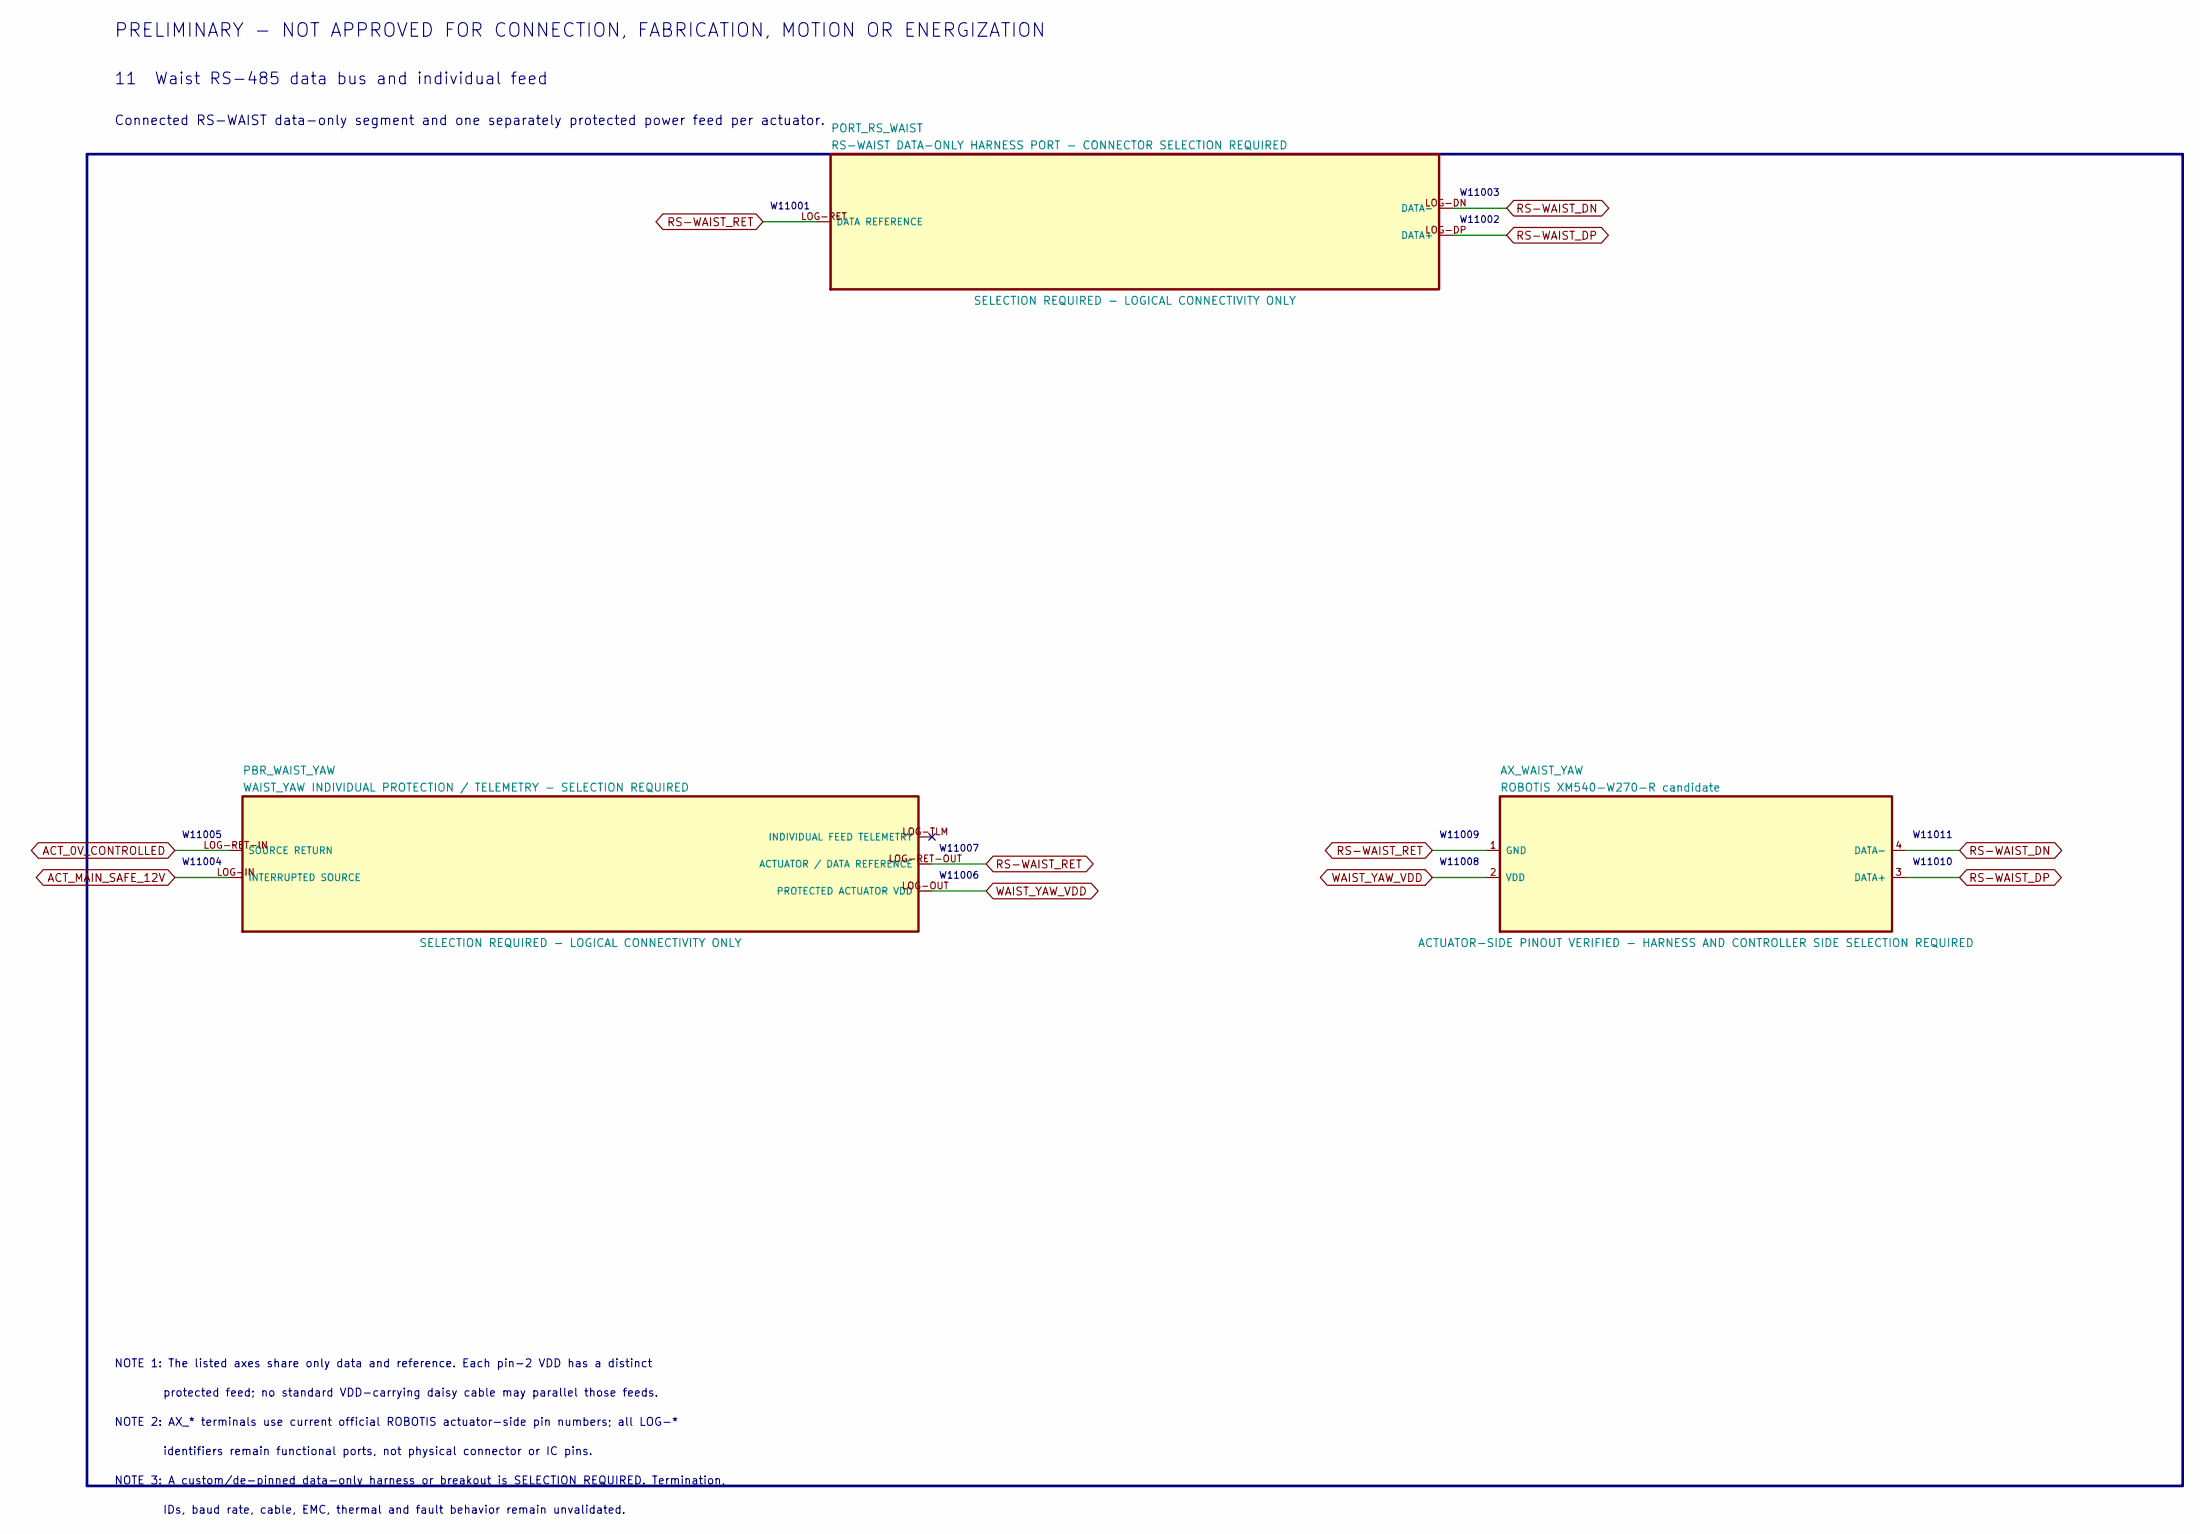
[picture p388: schematic 11_waist_rs485.kicad_sch]

Parts:
AX_WAIST_YAW: ROBOTIS XM540-W270-R candidate
PBR_WAIST_YAW: WAIST_YAW INDIVIDUAL PROTECTION / TELEMETRY - SEL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
PORT_RS_WAIST: RS-WAIST DATA-ONLY HARNESS PORT - CONNECTOR SELEC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

Connections:
ACT_0V_CONTROLLED: PBR_WAIST_YAW.LOG-RET-IN (SOURCE RETURN)
ACT_MAIN_SAFE_12V: PBR_WAIST_YAW.LOG-IN (INTERRUPTED SOURCE)
RS-WAIST_DN: AX_WAIST_YAW.4 (DATA-), PORT_RS_WAIST.LOG-DN (DATA-)
RS-WAIST_DP: AX_WAIST_YAW.3 (DATA+), PORT_RS_WAIST.LOG-DP (DATA+)
RS-WAIST_RET: AX_WAIST_YAW.1 (GND), PBR_WAIST_YAW.LOG-RET-OUT (ACTUATOR / DATA REFERENCE), PORT_RS_WAIST.LOG-RET (DATA REFERENCE)
WAIST_YAW_VDD: AX_WAIST_YAW.2 (VDD), PBR_WAIST_YAW.LOG-OUT (PROTECTED ACTUATOR VDD)

Notes on the sheet:
PRELIMINARY - NOT APPROVED FOR CONNECTION, FABRICATION, MOTION OR ENERGIZATION
11 Waist RS-485 data bus and individual feed
Connected RS-WAIST data-only segment and one separately protected power feed per actuator.
W11001
W11002
W11003
W11004
W11005
W11006
W11007
W11008
W11009
W11010
W11011
NOTE 1: The listed axes share only data and reference. Each pin-2 VDD has a distinct
protected feed; no standard VDD-carrying daisy cable may parallel those feeds.
NOTE 2: AX_* terminals use current official ROBOTIS actuator-side pin numbers; all LOG-*
identifiers remain functional ports, not physical connector or IC pins.
NOTE 3: A custom/de-pinned data-only harness or breakout is SELECTION REQUIRED. Termination,
IDs, baud rate, cable, EMC, thermal and fault behavior remain unvalidated.
