amyleesterling/humanoid-robot/hr30/whole-body-p0.1/electrical/kicad/hr30-whole-body-electrical-p0.1/12_left_distal_ttl.kicad_sch

## KiCad design hr30/whole-body-p0.1/electrical/kicad/hr30-whole-body-electrical-p0.1/12_left_distal_ttl.kicad_sch (2026-08-15)

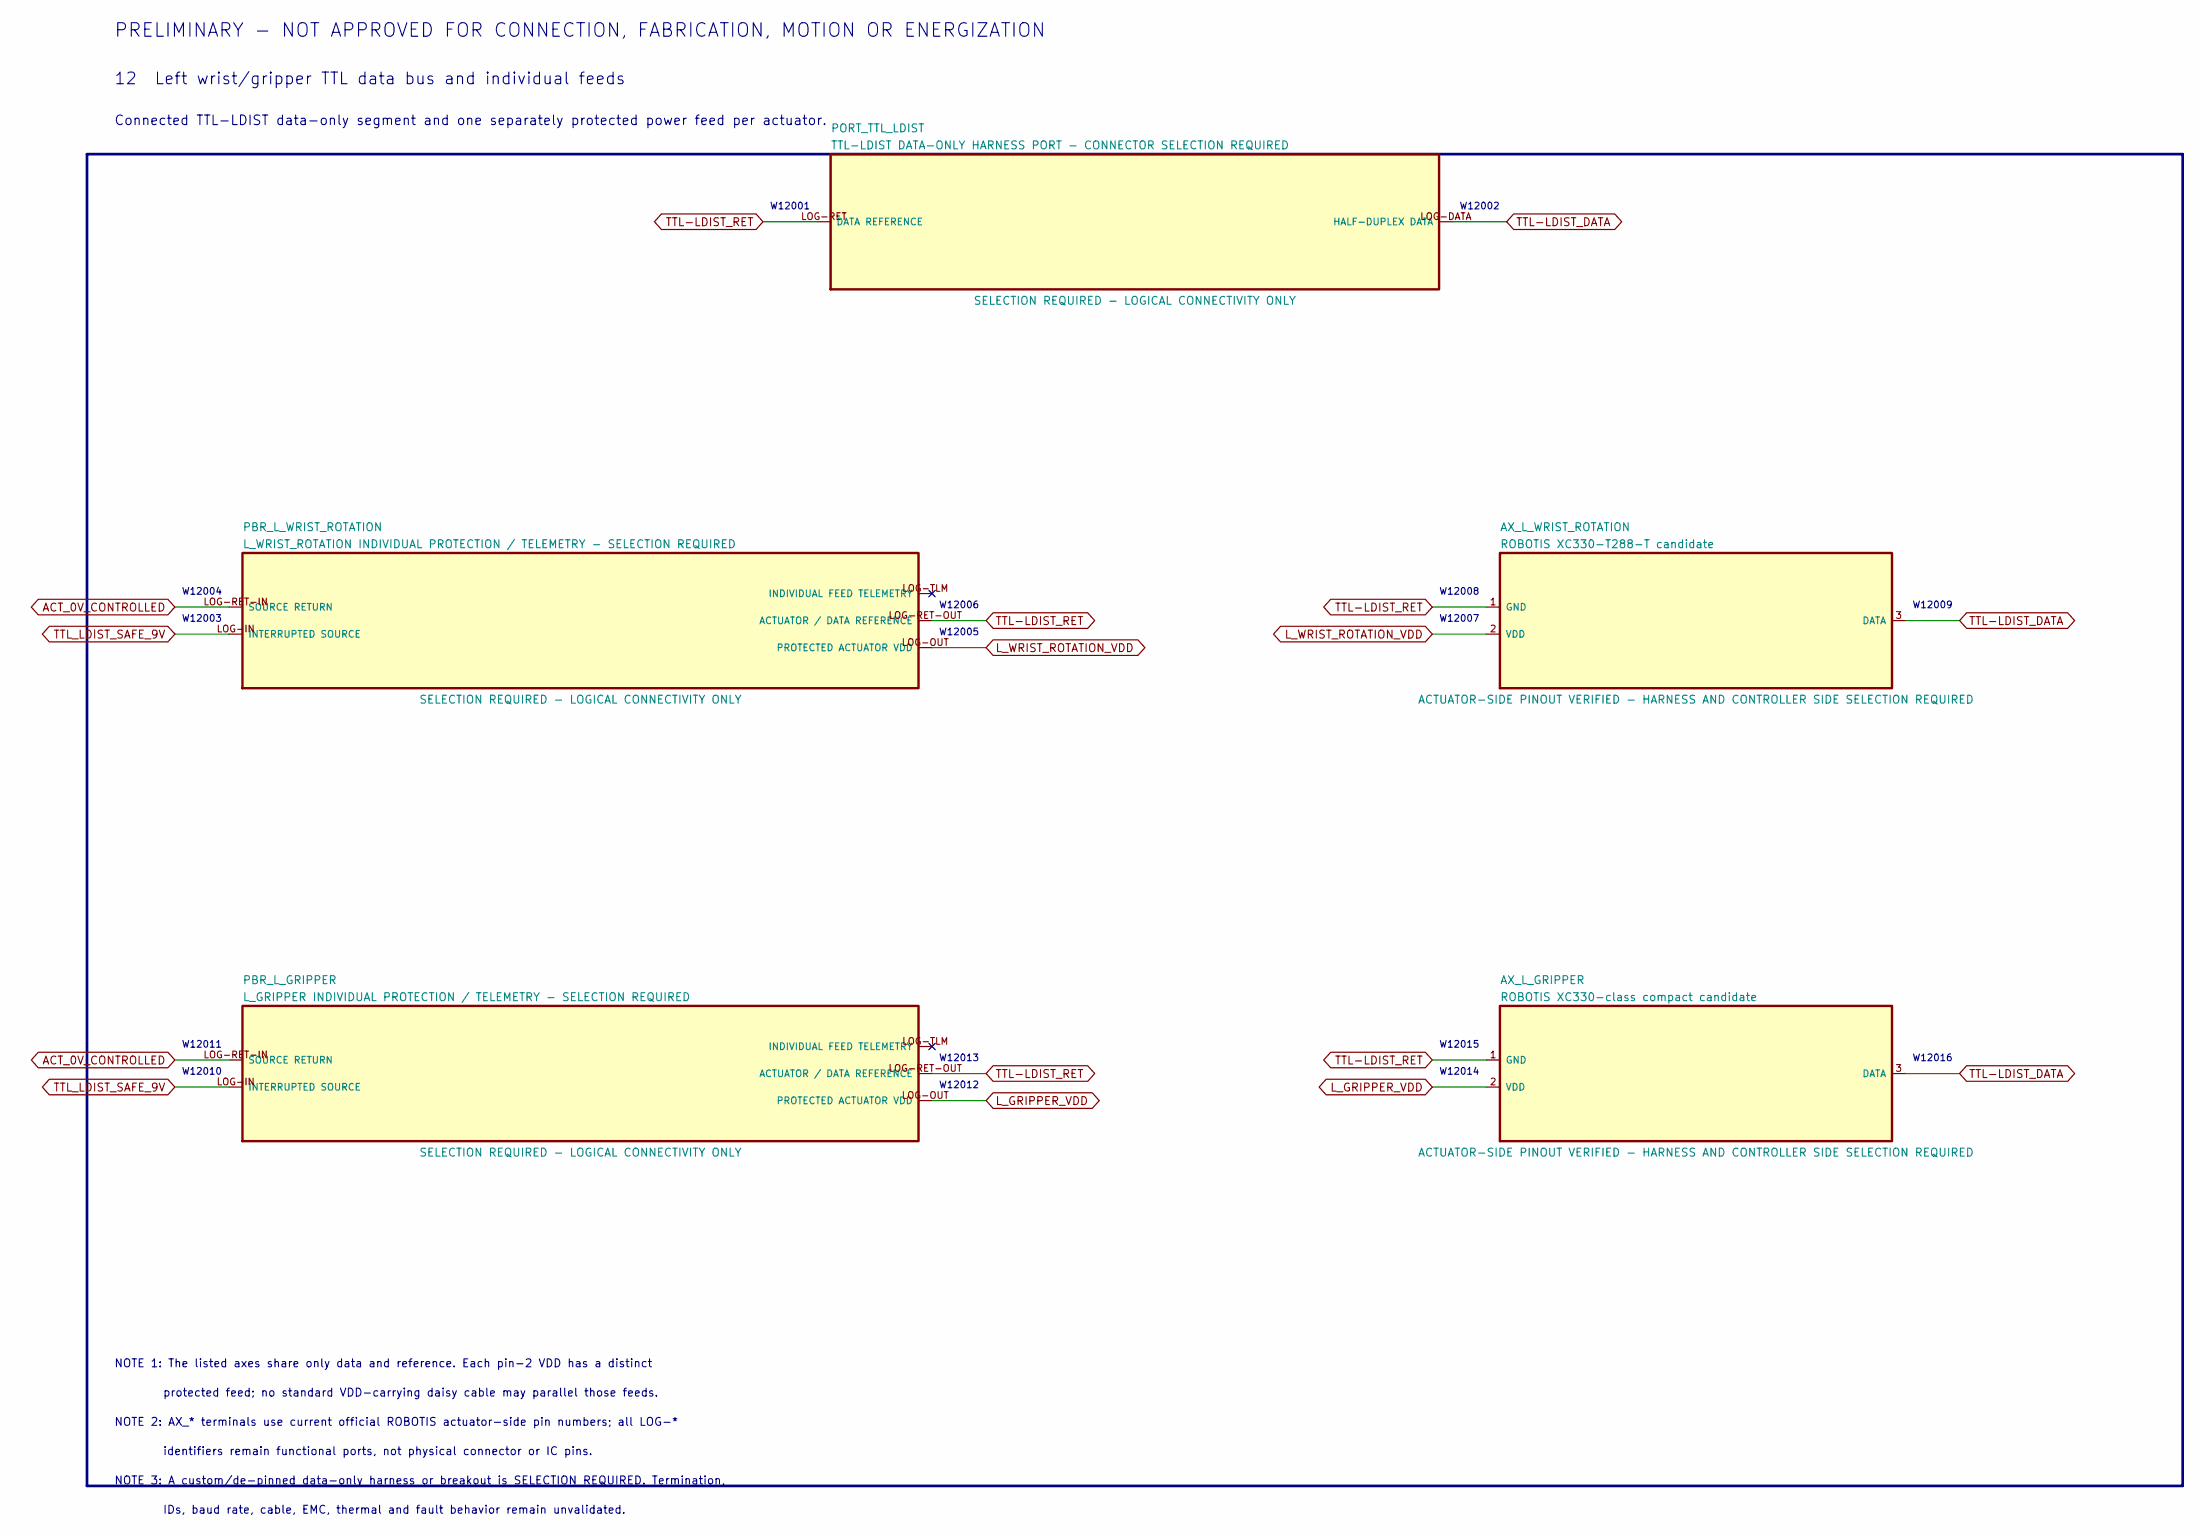
[picture p389: schematic 12_left_distal_ttl.kicad_sch]

Parts:
AX_L_GRIPPER: ROBOTIS XC330-class compact candidate
AX_L_WRIST_ROTATION: ROBOTIS XC330-T288-T candidate
PBR_L_GRIPPER: L_GRIPPER INDIVIDUAL PROTECTION / TELEMETRY - SEL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
PBR_L_WRIST_ROTATION: L_WRIST_ROTATION INDIVIDUAL PROTECTION / TELEMETR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
PORT_TTL_LDIST: TTL-LDIST DATA-ONLY HARNESS PORT - CONNECTOR SELE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

Connections:
ACT_0V_CONTROLLED: PBR_L_GRIPPER.LOG-RET-IN (SOURCE RETURN), PBR_L_WRIST_ROTATION.LOG-RET-IN (SOURCE RETURN)
L_GRIPPER_VDD: AX_L_GRIPPER.2 (VDD), PBR_L_GRIPPER.LOG-OUT (PROTECTED ACTUATOR VDD)
L_WRIST_ROTATION_VDD: AX_L_WRIST_ROTATION.2 (VDD), PBR_L_WRIST_ROTATION.LOG-OUT (PROTECTED ACTUATOR VDD)
TTL-LDIST_DATA: AX_L_GRIPPER.3 (DATA), AX_L_WRIST_ROTATION.3 (DATA), PORT_TTL_LDIST.LOG-DATA (HALF-DUPLEX DATA)
TTL-LDIST_RET: AX_L_GRIPPER.1 (GND), AX_L_WRIST_ROTATION.1 (GND), PBR_L_GRIPPER.LOG-RET-OUT (ACTUATOR / DATA REFERENCE), PBR_L_WRIST_ROTATION.LOG-RET-OUT (ACTUATOR / DATA REFERENCE), PORT_TTL_LDIST.LOG-RET (DATA REFERENCE)
TTL_LDIST_SAFE_9V: PBR_L_GRIPPER.LOG-IN (INTERRUPTED SOURCE), PBR_L_WRIST_ROTATION.LOG-IN (INTERRUPTED SOURCE)

Notes on the sheet:
PRELIMINARY - NOT APPROVED FOR CONNECTION, FABRICATION, MOTION OR ENERGIZATION
12 Left wrist/gripper TTL data bus and individual feeds
Connected TTL-LDIST data-only segment and one separately protected power feed per actuator.
W12001
W12002
W12003
W12004
W12005
W12006
W12007
W12008
W12009
W12010
W12011
W12012
W12013
W12014
W12015
W12016
NOTE 1: The listed axes share only data and reference. Each pin-2 VDD has a distinct
protected feed; no standard VDD-carrying daisy cable may parallel those feeds.
NOTE 2: AX_* terminals use current official ROBOTIS actuator-side pin numbers; all LOG-*
identifiers remain functional ports, not physical connector or IC pins.
NOTE 3: A custom/de-pinned data-only harness or breakout is SELECTION REQUIRED. Termination,
IDs, baud rate, cable, EMC, thermal and fault behavior remain unvalidated.
