amyleesterling/humanoid-robot/hr30/whole-body-p0.1/electrical/kicad/hr30-whole-body-electrical-p0.1/13_right_distal_ttl.kicad_sch

## KiCad design hr30/whole-body-p0.1/electrical/kicad/hr30-whole-body-electrical-p0.1/13_right_distal_ttl.kicad_sch (2026-08-15)

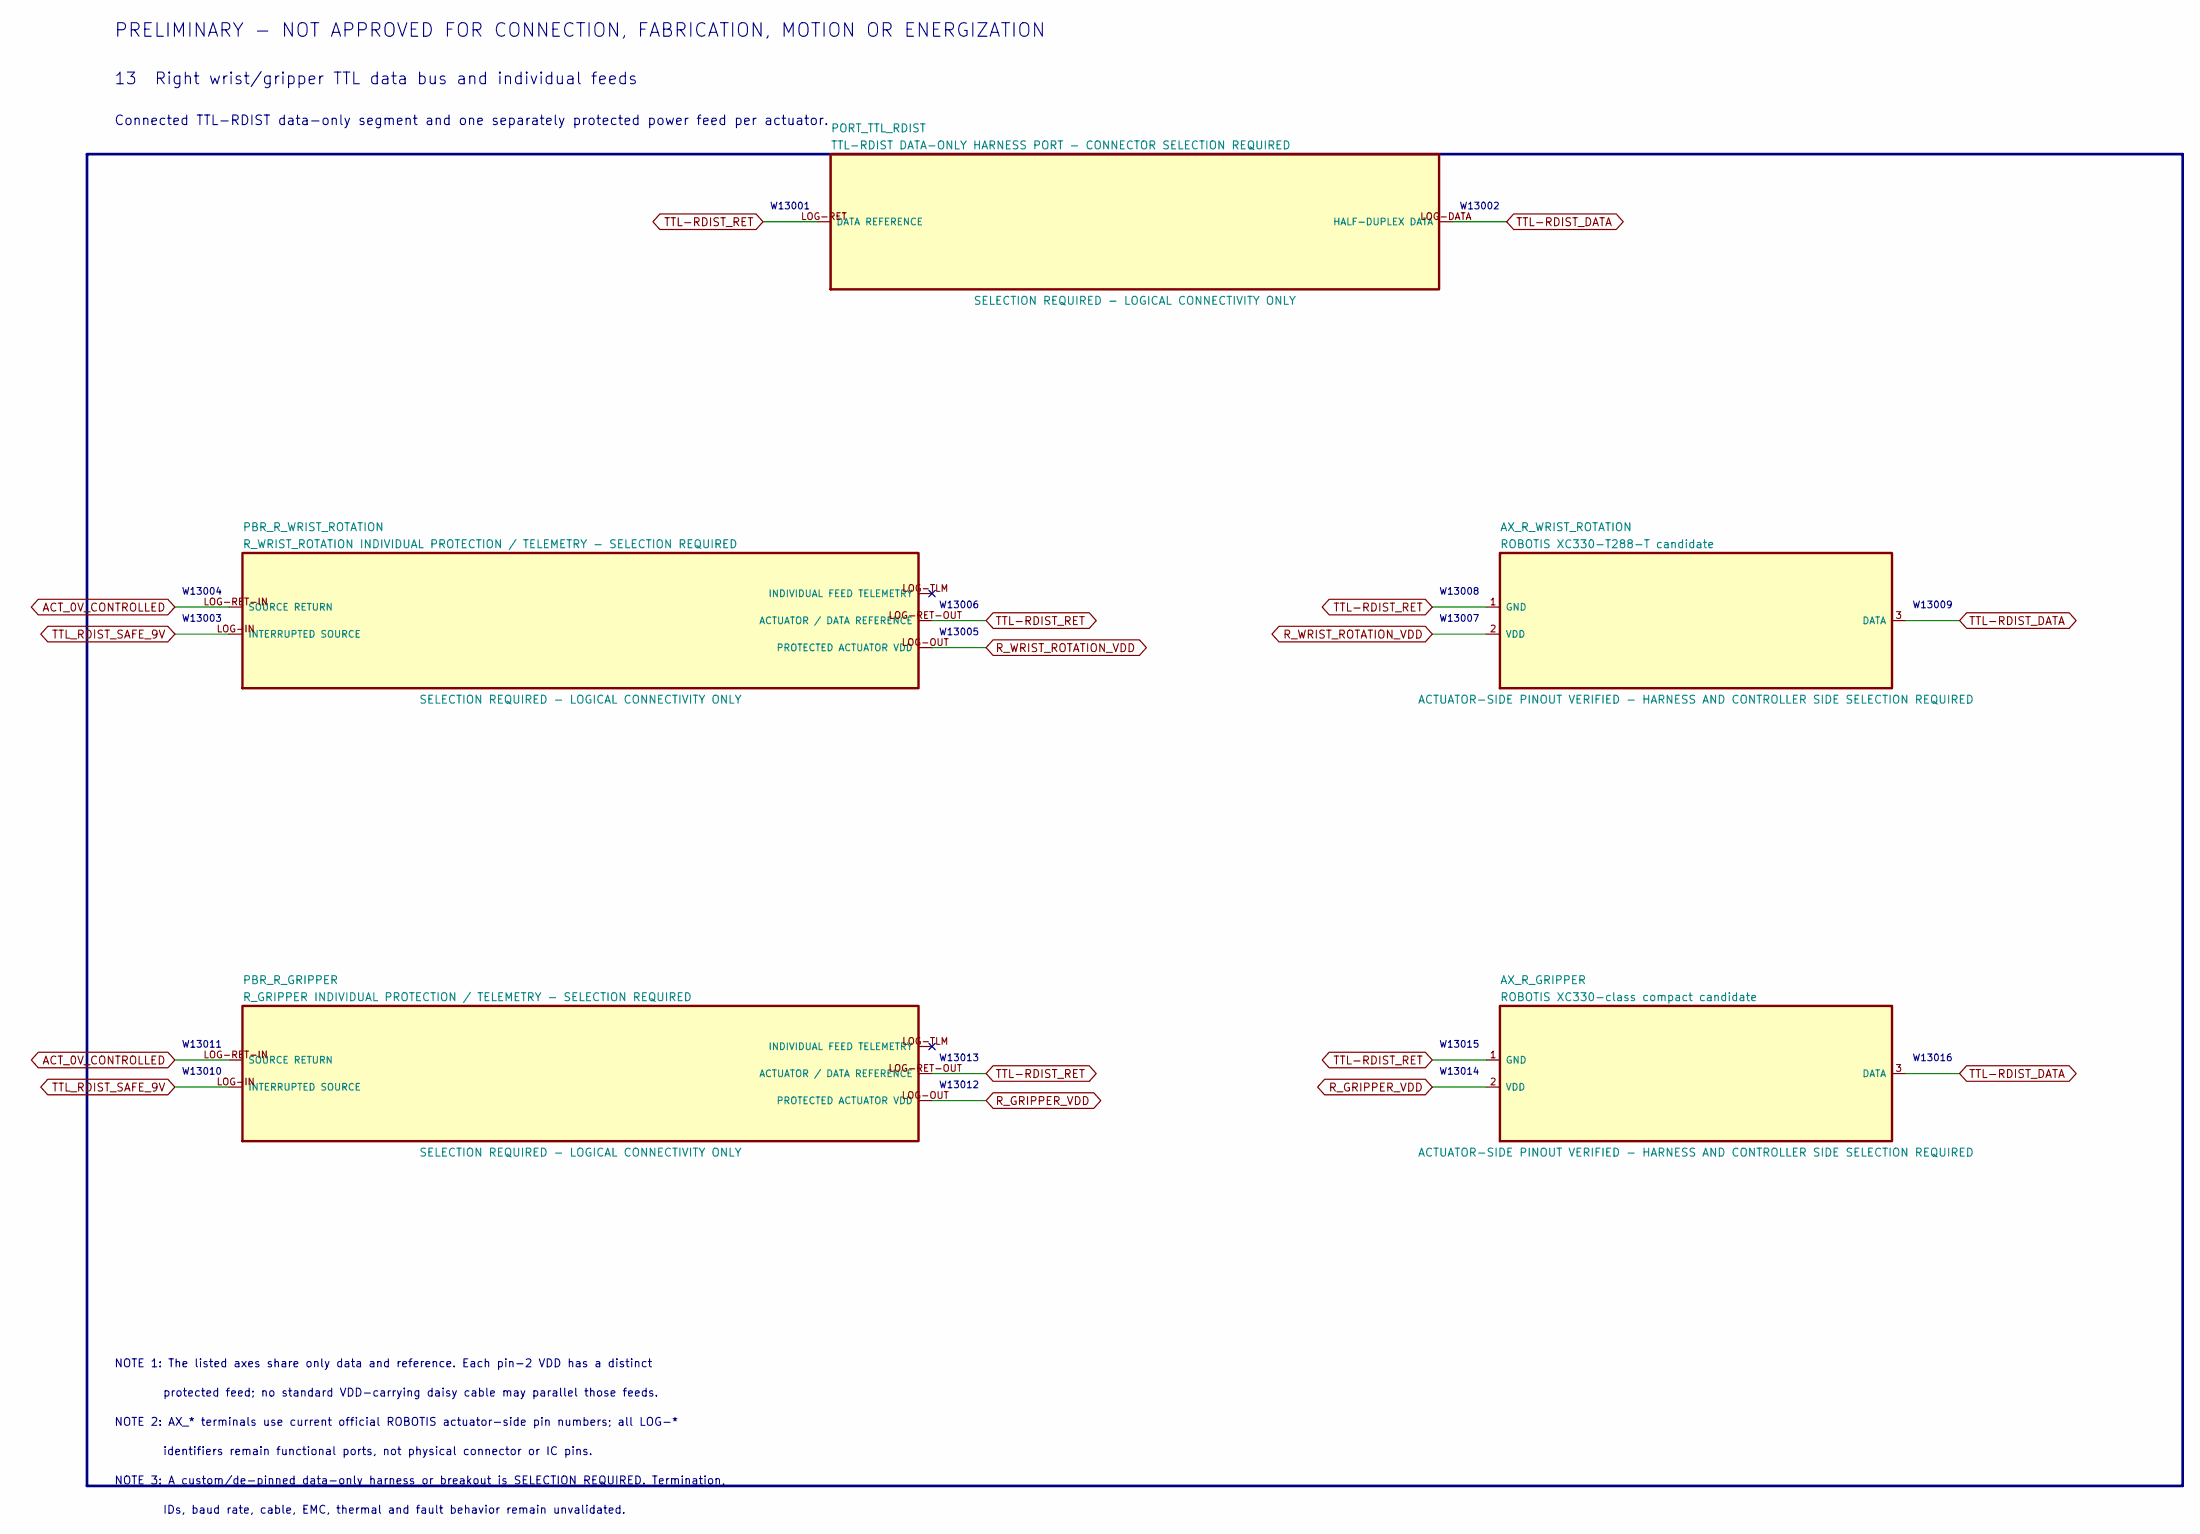
[picture p390: schematic 13_right_distal_ttl.kicad_sch]

Parts:
AX_R_GRIPPER: ROBOTIS XC330-class compact candidate
AX_R_WRIST_ROTATION: ROBOTIS XC330-T288-T candidate
PBR_R_GRIPPER: R_GRIPPER INDIVIDUAL PROTECTION / TELEMETRY - SEL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
PBR_R_WRIST_ROTATION: R_WRIST_ROTATION INDIVIDUAL PROTECTION / TELEMETR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
PORT_TTL_RDIST: TTL-RDIST DATA-ONLY HARNESS PORT - CONNECTOR SELE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

Connections:
ACT_0V_CONTROLLED: PBR_R_GRIPPER.LOG-RET-IN (SOURCE RETURN), PBR_R_WRIST_ROTATION.LOG-RET-IN (SOURCE RETURN)
R_GRIPPER_VDD: AX_R_GRIPPER.2 (VDD), PBR_R_GRIPPER.LOG-OUT (PROTECTED ACTUATOR VDD)
R_WRIST_ROTATION_VDD: AX_R_WRIST_ROTATION.2 (VDD), PBR_R_WRIST_ROTATION.LOG-OUT (PROTECTED ACTUATOR VDD)
TTL-RDIST_DATA: AX_R_GRIPPER.3 (DATA), AX_R_WRIST_ROTATION.3 (DATA), PORT_TTL_RDIST.LOG-DATA (HALF-DUPLEX DATA)
TTL-RDIST_RET: AX_R_GRIPPER.1 (GND), AX_R_WRIST_ROTATION.1 (GND), PBR_R_GRIPPER.LOG-RET-OUT (ACTUATOR / DATA REFERENCE), PBR_R_WRIST_ROTATION.LOG-RET-OUT (ACTUATOR / DATA REFERENCE), PORT_TTL_RDIST.LOG-RET (DATA REFERENCE)
TTL_RDIST_SAFE_9V: PBR_R_GRIPPER.LOG-IN (INTERRUPTED SOURCE), PBR_R_WRIST_ROTATION.LOG-IN (INTERRUPTED SOURCE)

Notes on the sheet:
PRELIMINARY - NOT APPROVED FOR CONNECTION, FABRICATION, MOTION OR ENERGIZATION
13 Right wrist/gripper TTL data bus and individual feeds
Connected TTL-RDIST data-only segment and one separately protected power feed per actuator.
W13001
W13002
W13003
W13004
W13005
W13006
W13007
W13008
W13009
W13010
W13011
W13012
W13013
W13014
W13015
W13016
NOTE 1: The listed axes share only data and reference. Each pin-2 VDD has a distinct
protected feed; no standard VDD-carrying daisy cable may parallel those feeds.
NOTE 2: AX_* terminals use current official ROBOTIS actuator-side pin numbers; all LOG-*
identifiers remain functional ports, not physical connector or IC pins.
NOTE 3: A custom/de-pinned data-only harness or breakout is SELECTION REQUIRED. Termination,
IDs, baud rate, cable, EMC, thermal and fault behavior remain unvalidated.
