amyleesterling/humanoid-robot/hr30/whole-body-p0.1/electrical/kicad/hr30-whole-body-electrical-p0.1/14_head_ttl_sensors_hmi.kicad_sch

## KiCad design hr30/whole-body-p0.1/electrical/kicad/hr30-whole-body-electrical-p0.1/14_head_ttl_sensors_hmi.kicad_sch (2026-08-15)

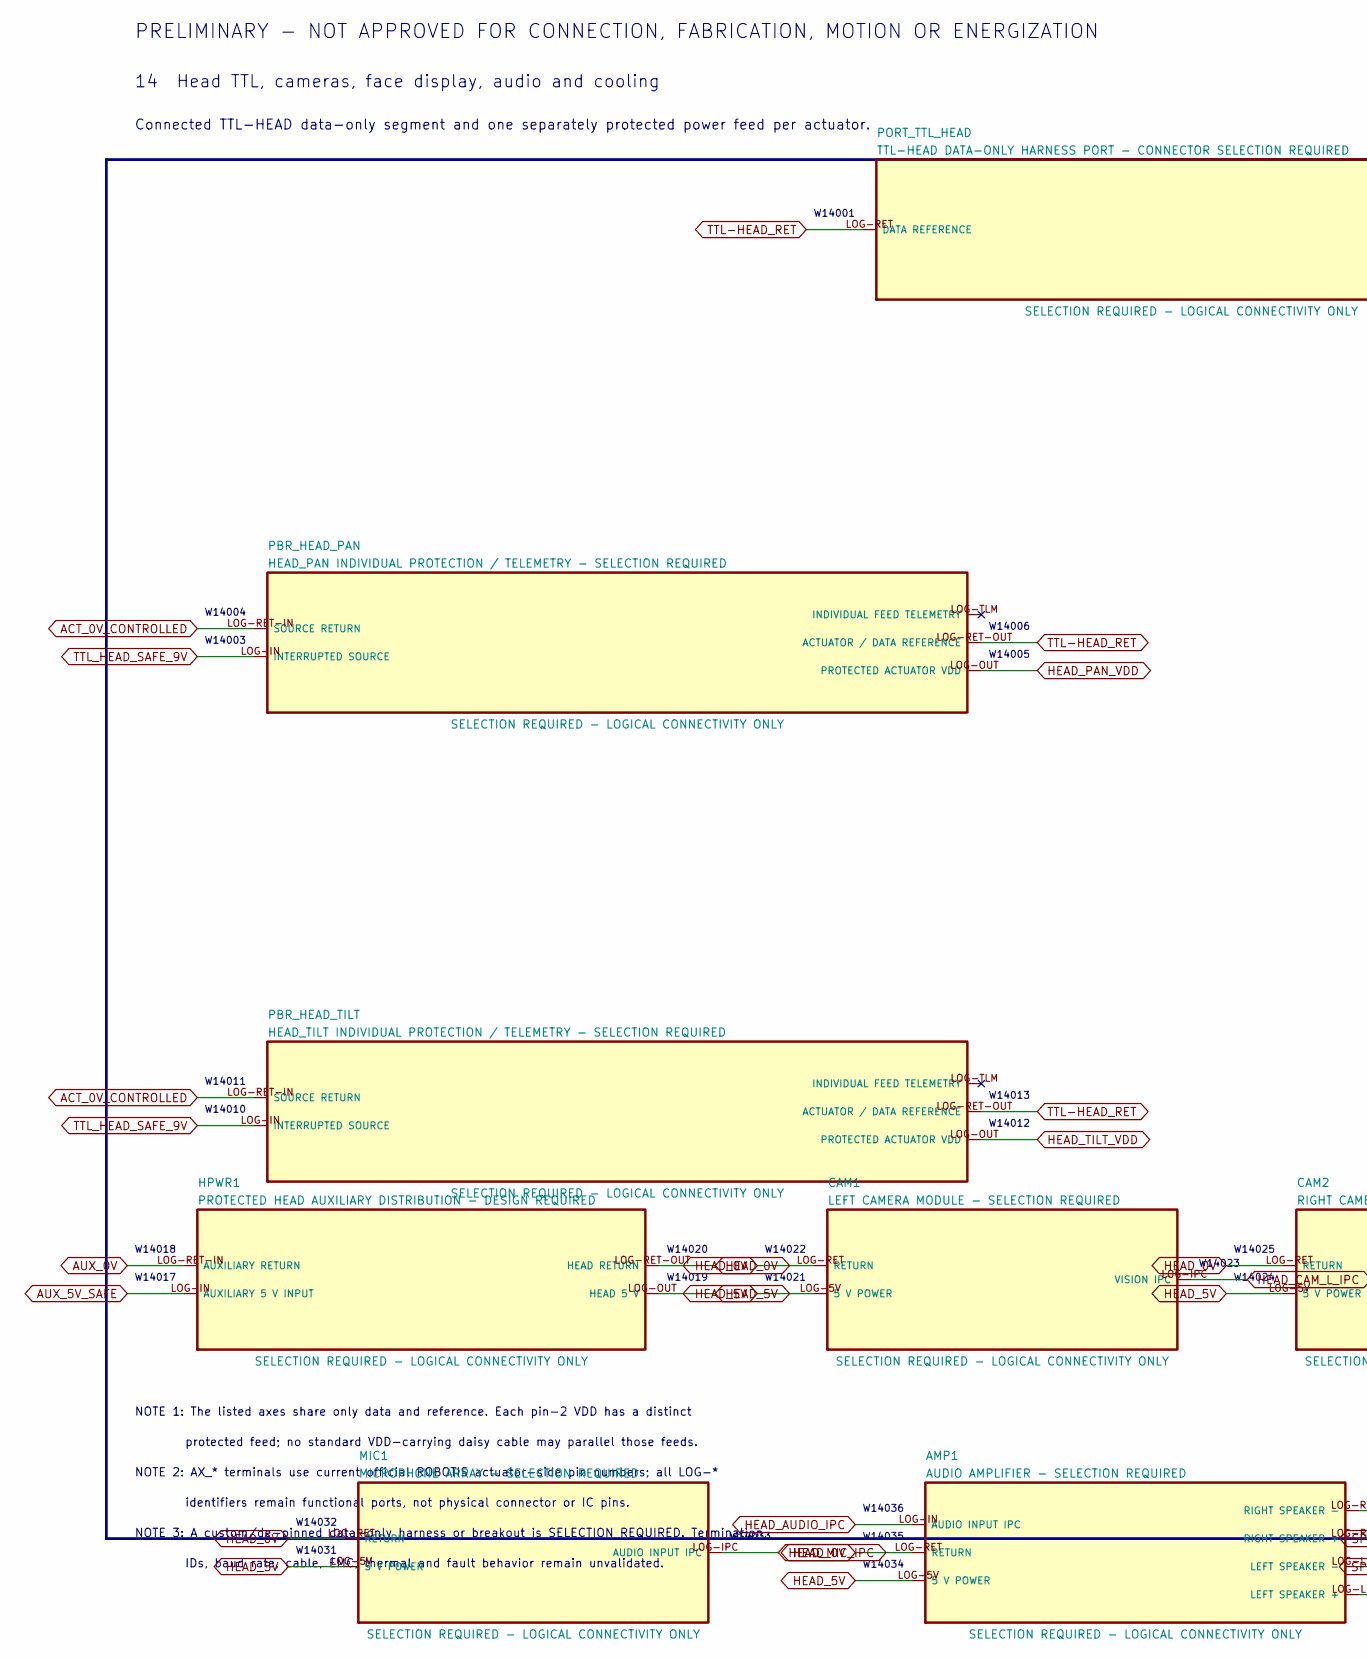
[picture p391: schematic 14_head_ttl_sensors_hmi.kicad_sch, part in row 1, column 1]

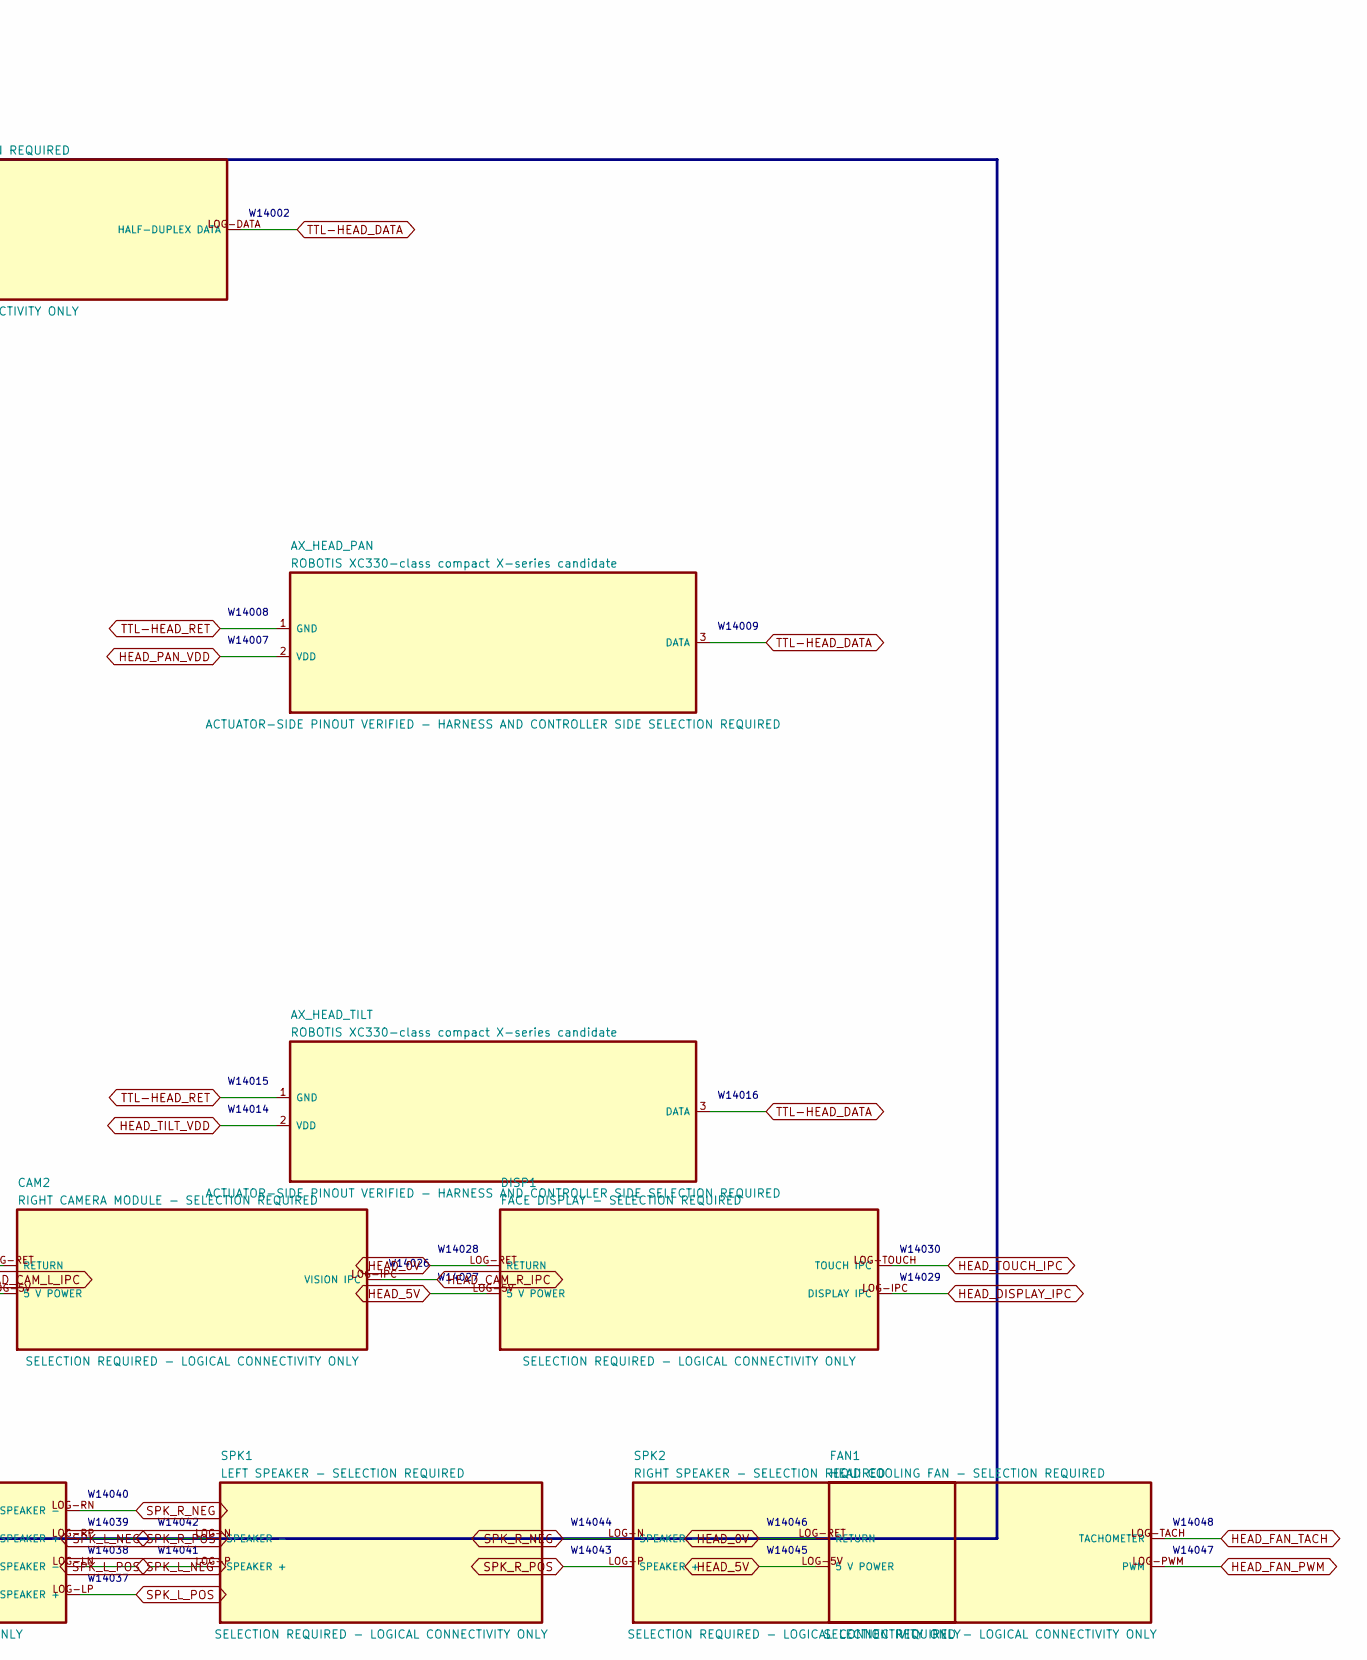
[picture p392: schematic 14_head_ttl_sensors_hmi.kicad_sch, part in row 1, column 2]

Parts:
AMP1: AUDIO AMPLIFIER - SELECTION REQUIRED
AX_HEAD_PAN: ROBOTIS XC330-class compact X-series candidate
AX_HEAD_TILT: ROBOTIS XC330-class compact X-series candidate
CAM1: LEFT CAMERA MODULE - SELECTION REQUIRED
CAM2: RIGHT CAMERA MODULE - SELECTION REQUIRED
DISP1: FACE DISPLAY - SELECTION REQUIRED
FAN1: HEAD COOLING FAN - SELECTION REQUIRED
HPWR1: PROTECTED HEAD AUXILIARY DISTRIBUTION - DESIGN RE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
MIC1: MICROPHONE ARRAY - SELECTION REQUIRED
PBR_HEAD_PAN: HEAD_PAN INDIVIDUAL PROTECTION / TELEMETRY - SELE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
PBR_HEAD_TILT: HEAD_TILT INDIVIDUAL PROTECTION / TELEMETRY - SEL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
PORT_TTL_HEAD: TTL-HEAD DATA-ONLY HARNESS PORT - CONNECTOR SELEC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
SPK1: LEFT SPEAKER - SELECTION REQUIRED
SPK2: RIGHT SPEAKER - SELECTION REQUIRED

Connections:
ACT_0V_CONTROLLED: PBR_HEAD_PAN.LOG-RET-IN (SOURCE RETURN), PBR_HEAD_TILT.LOG-RET-IN (SOURCE RETURN)
AUX_0V: HPWR1.LOG-RET-IN (AUXILIARY RETURN)
AUX_5V_SAFE: HPWR1.LOG-IN (AUXILIARY 5 V INPUT)
HEAD_0V: AMP1.LOG-RET (RETURN), CAM1.LOG-RET (RETURN), CAM2.LOG-RET (RETURN), DISP1.LOG-RET (RETURN), FAN1.LOG-RET (RETURN), HPWR1.LOG-RET-OUT (HEAD RETURN), MIC1.LOG-RET (RETURN)
HEAD_5V: AMP1.LOG-5V (5 V POWER), CAM1.LOG-5V (5 V POWER), CAM2.LOG-5V (5 V POWER), DISP1.LOG-5V (5 V POWER), FAN1.LOG-5V (5 V POWER), HPWR1.LOG-OUT (HEAD 5 V), MIC1.LOG-5V (5 V POWER)
HEAD_AUDIO_IPC: AMP1.LOG-IN (AUDIO INPUT IPC)
HEAD_CAM_L_IPC: CAM1.LOG-IPC (VISION IPC)
HEAD_CAM_R_IPC: CAM2.LOG-IPC (VISION IPC)
HEAD_DISPLAY_IPC: DISP1.LOG-IPC (DISPLAY IPC)
HEAD_FAN_PWM: FAN1.LOG-PWM (PWM)
HEAD_FAN_TACH: FAN1.LOG-TACH (TACHOMETER)
HEAD_MIC_IPC: MIC1.LOG-IPC (AUDIO INPUT IPC)
HEAD_PAN_VDD: AX_HEAD_PAN.2 (VDD), PBR_HEAD_PAN.LOG-OUT (PROTECTED ACTUATOR VDD)
HEAD_TILT_VDD: AX_HEAD_TILT.2 (VDD), PBR_HEAD_TILT.LOG-OUT (PROTECTED ACTUATOR VDD)
HEAD_TOUCH_IPC: DISP1.LOG-TOUCH (TOUCH IPC)
SPK_L_NEG: AMP1.LOG-LN (LEFT SPEAKER -), SPK1.LOG-N (SPEAKER -)
SPK_L_POS: AMP1.LOG-LP (LEFT SPEAKER +), SPK1.LOG-P (SPEAKER +)
SPK_R_NEG: AMP1.LOG-RN (RIGHT SPEAKER -), SPK2.LOG-N (SPEAKER -)
SPK_R_POS: AMP1.LOG-RP (RIGHT SPEAKER +), SPK2.LOG-P (SPEAKER +)
TTL-HEAD_DATA: AX_HEAD_PAN.3 (DATA), AX_HEAD_TILT.3 (DATA), PORT_TTL_HEAD.LOG-DATA (HALF-DUPLEX DATA)
TTL-HEAD_RET: AX_HEAD_PAN.1 (GND), AX_HEAD_TILT.1 (GND), PBR_HEAD_PAN.LOG-RET-OUT (ACTUATOR / DATA REFERENCE), PBR_HEAD_TILT.LOG-RET-OUT (ACTUATOR / DATA REFERENCE), PORT_TTL_HEAD.LOG-RET (DATA REFERENCE)
TTL_HEAD_SAFE_9V: PBR_HEAD_PAN.LOG-IN (INTERRUPTED SOURCE), PBR_HEAD_TILT.LOG-IN (INTERRUPTED SOURCE)

Notes on the sheet:
PRELIMINARY - NOT APPROVED FOR CONNECTION, FABRICATION, MOTION OR ENERGIZATION
14 Head TTL, cameras, face display, audio and cooling
Connected TTL-HEAD data-only segment and one separately protected power feed per actuator.
W14001
W14002
W14003
W14004
W14005
W14006
W14007
W14008
W14009
W14010
W14011
W14012
W14013
W14014
W14015
W14016
W14017
W14018
W14019
W14020
W14021
W14022
W14023
W14024
W14025
W14026
W14027
W14028
W14029
W14030
W14031
W14032
W14033
W14034
W14035
W14036
W14037
W14038
W14039
W14040
W14041
W14042
W14043
W14044
W14045
W14046
W14047
W14048
NOTE 1: The listed axes share only data and reference. Each pin-2 VDD has a distinct
protected feed; no standard VDD-carrying daisy cable may parallel those feeds.
NOTE 2: AX_* terminals use current official ROBOTIS actuator-side pin numbers; all LOG-*
identifiers remain functional ports, not physical connector or IC pins.
NOTE 3: A custom/de-pinned data-only harness or breakout is SELECTION REQUIRED. Termination,
IDs, baud rate, cable, EMC, thermal and fault behavior remain unvalidated.
