amyleesterling/humanoid-robot/hr30/whole-body-p0.1/electrical/kicad/hr30-whole-body-electrical-p0.1/15_pelvis_aux_imu.kicad_sch

## KiCad design hr30/whole-body-p0.1/electrical/kicad/hr30-whole-body-electrical-p0.1/15_pelvis_aux_imu.kicad_sch (2026-08-15)

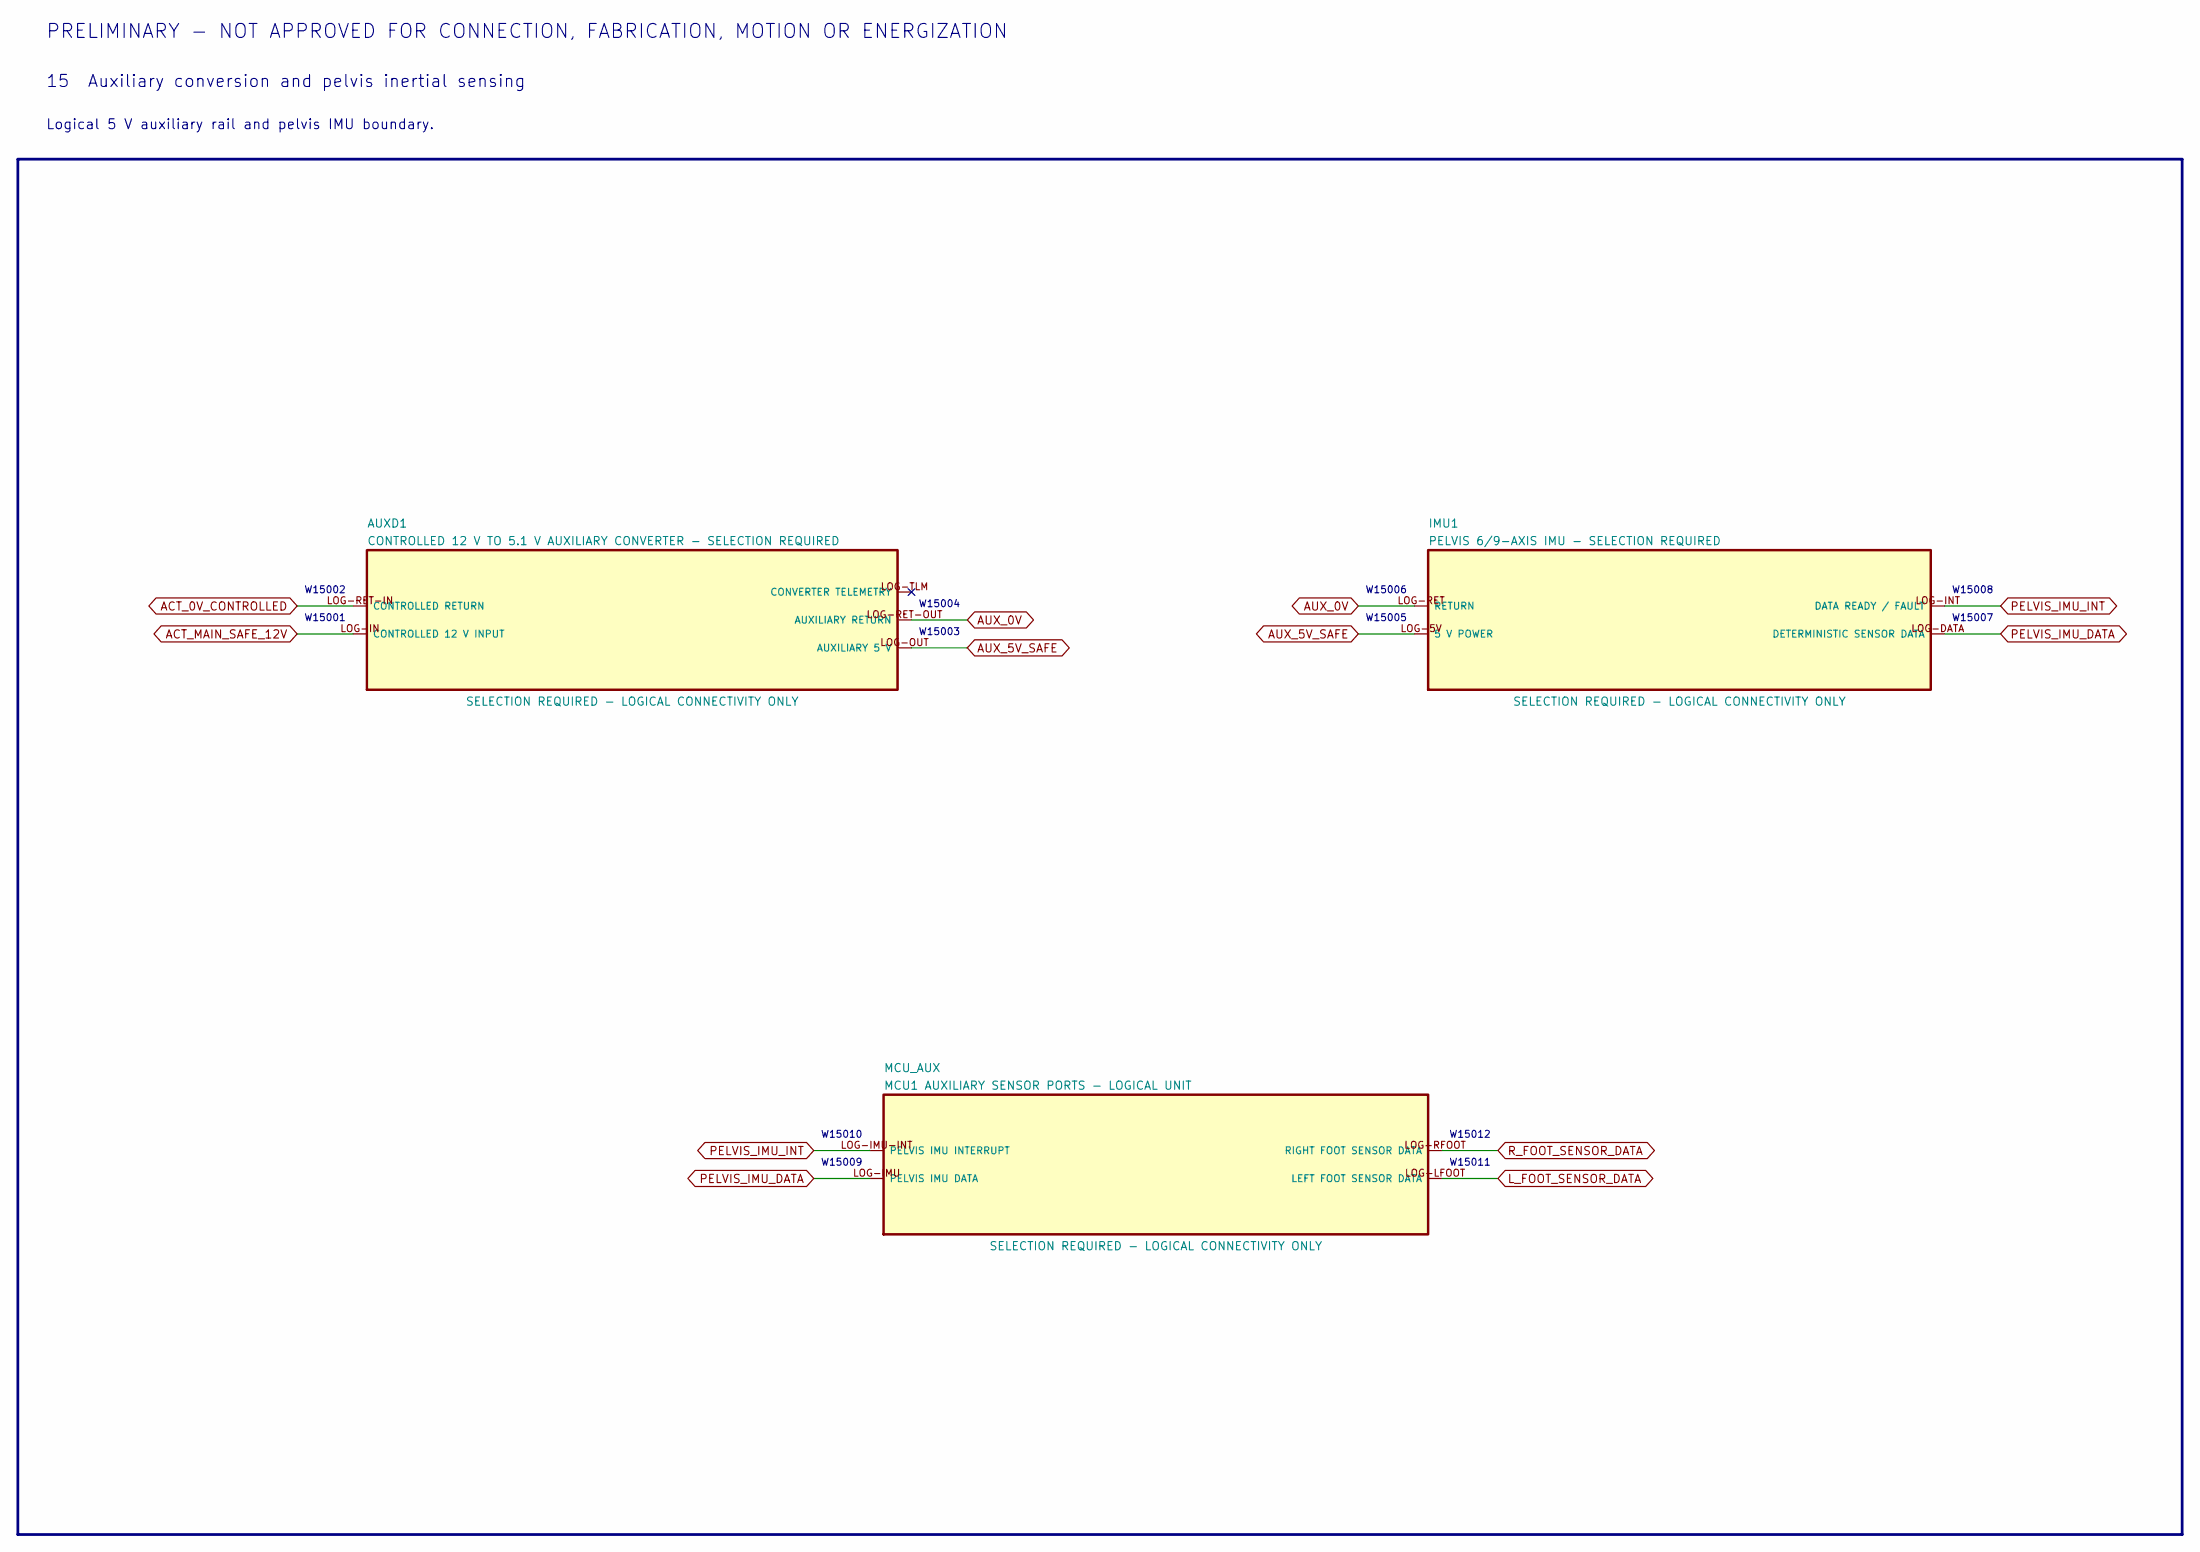
[picture p393: schematic 15_pelvis_aux_imu.kicad_sch]

Parts:
AUXD1: CONTROLLED 12 V TO 5.1 V AUXILIARY CONVERTER - SE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
IMU1: PELVIS 6/9-AXIS IMU - SELECTION REQUIRED
MCU_AUX: MCU1 AUXILIARY SENSOR PORTS - LOGICAL UNIT

Connections:
ACT_0V_CONTROLLED: AUXD1.LOG-RET-IN (CONTROLLED RETURN)
ACT_MAIN_SAFE_12V: AUXD1.LOG-IN (CONTROLLED 12 V INPUT)
AUX_0V: AUXD1.LOG-RET-OUT (AUXILIARY RETURN), IMU1.LOG-RET (RETURN)
AUX_5V_SAFE: AUXD1.LOG-OUT (AUXILIARY 5 V), IMU1.LOG-5V (5 V POWER)
L_FOOT_SENSOR_DATA: MCU_AUX.LOG-LFOOT (LEFT FOOT SENSOR DATA)
PELVIS_IMU_DATA: IMU1.LOG-DATA (DETERMINISTIC SENSOR DATA), MCU_AUX.LOG-IMU (PELVIS IMU DATA)
PELVIS_IMU_INT: IMU1.LOG-INT (DATA READY / FAULT), MCU_AUX.LOG-IMU-INT (PELVIS IMU INTERRUPT)
R_FOOT_SENSOR_DATA: MCU_AUX.LOG-RFOOT (RIGHT FOOT SENSOR DATA)

Notes on the sheet:
PRELIMINARY - NOT APPROVED FOR CONNECTION, FABRICATION, MOTION OR ENERGIZATION
15 Auxiliary conversion and pelvis inertial sensing
Logical 5 V auxiliary rail and pelvis IMU boundary.
W15001
W15002
W15003
W15004
W15005
W15006
W15007
W15008
W15009
W15010
W15011
W15012
