amyleesterling/humanoid-robot/hr30/whole-body-p0.1/electrical/kicad/hr30-whole-body-electrical-p0.1/16_left_foot_load_sensing.kicad_sch

## KiCad design hr30/whole-body-p0.1/electrical/kicad/hr30-whole-body-electrical-p0.1/16_left_foot_load_sensing.kicad_sch (2026-08-15)

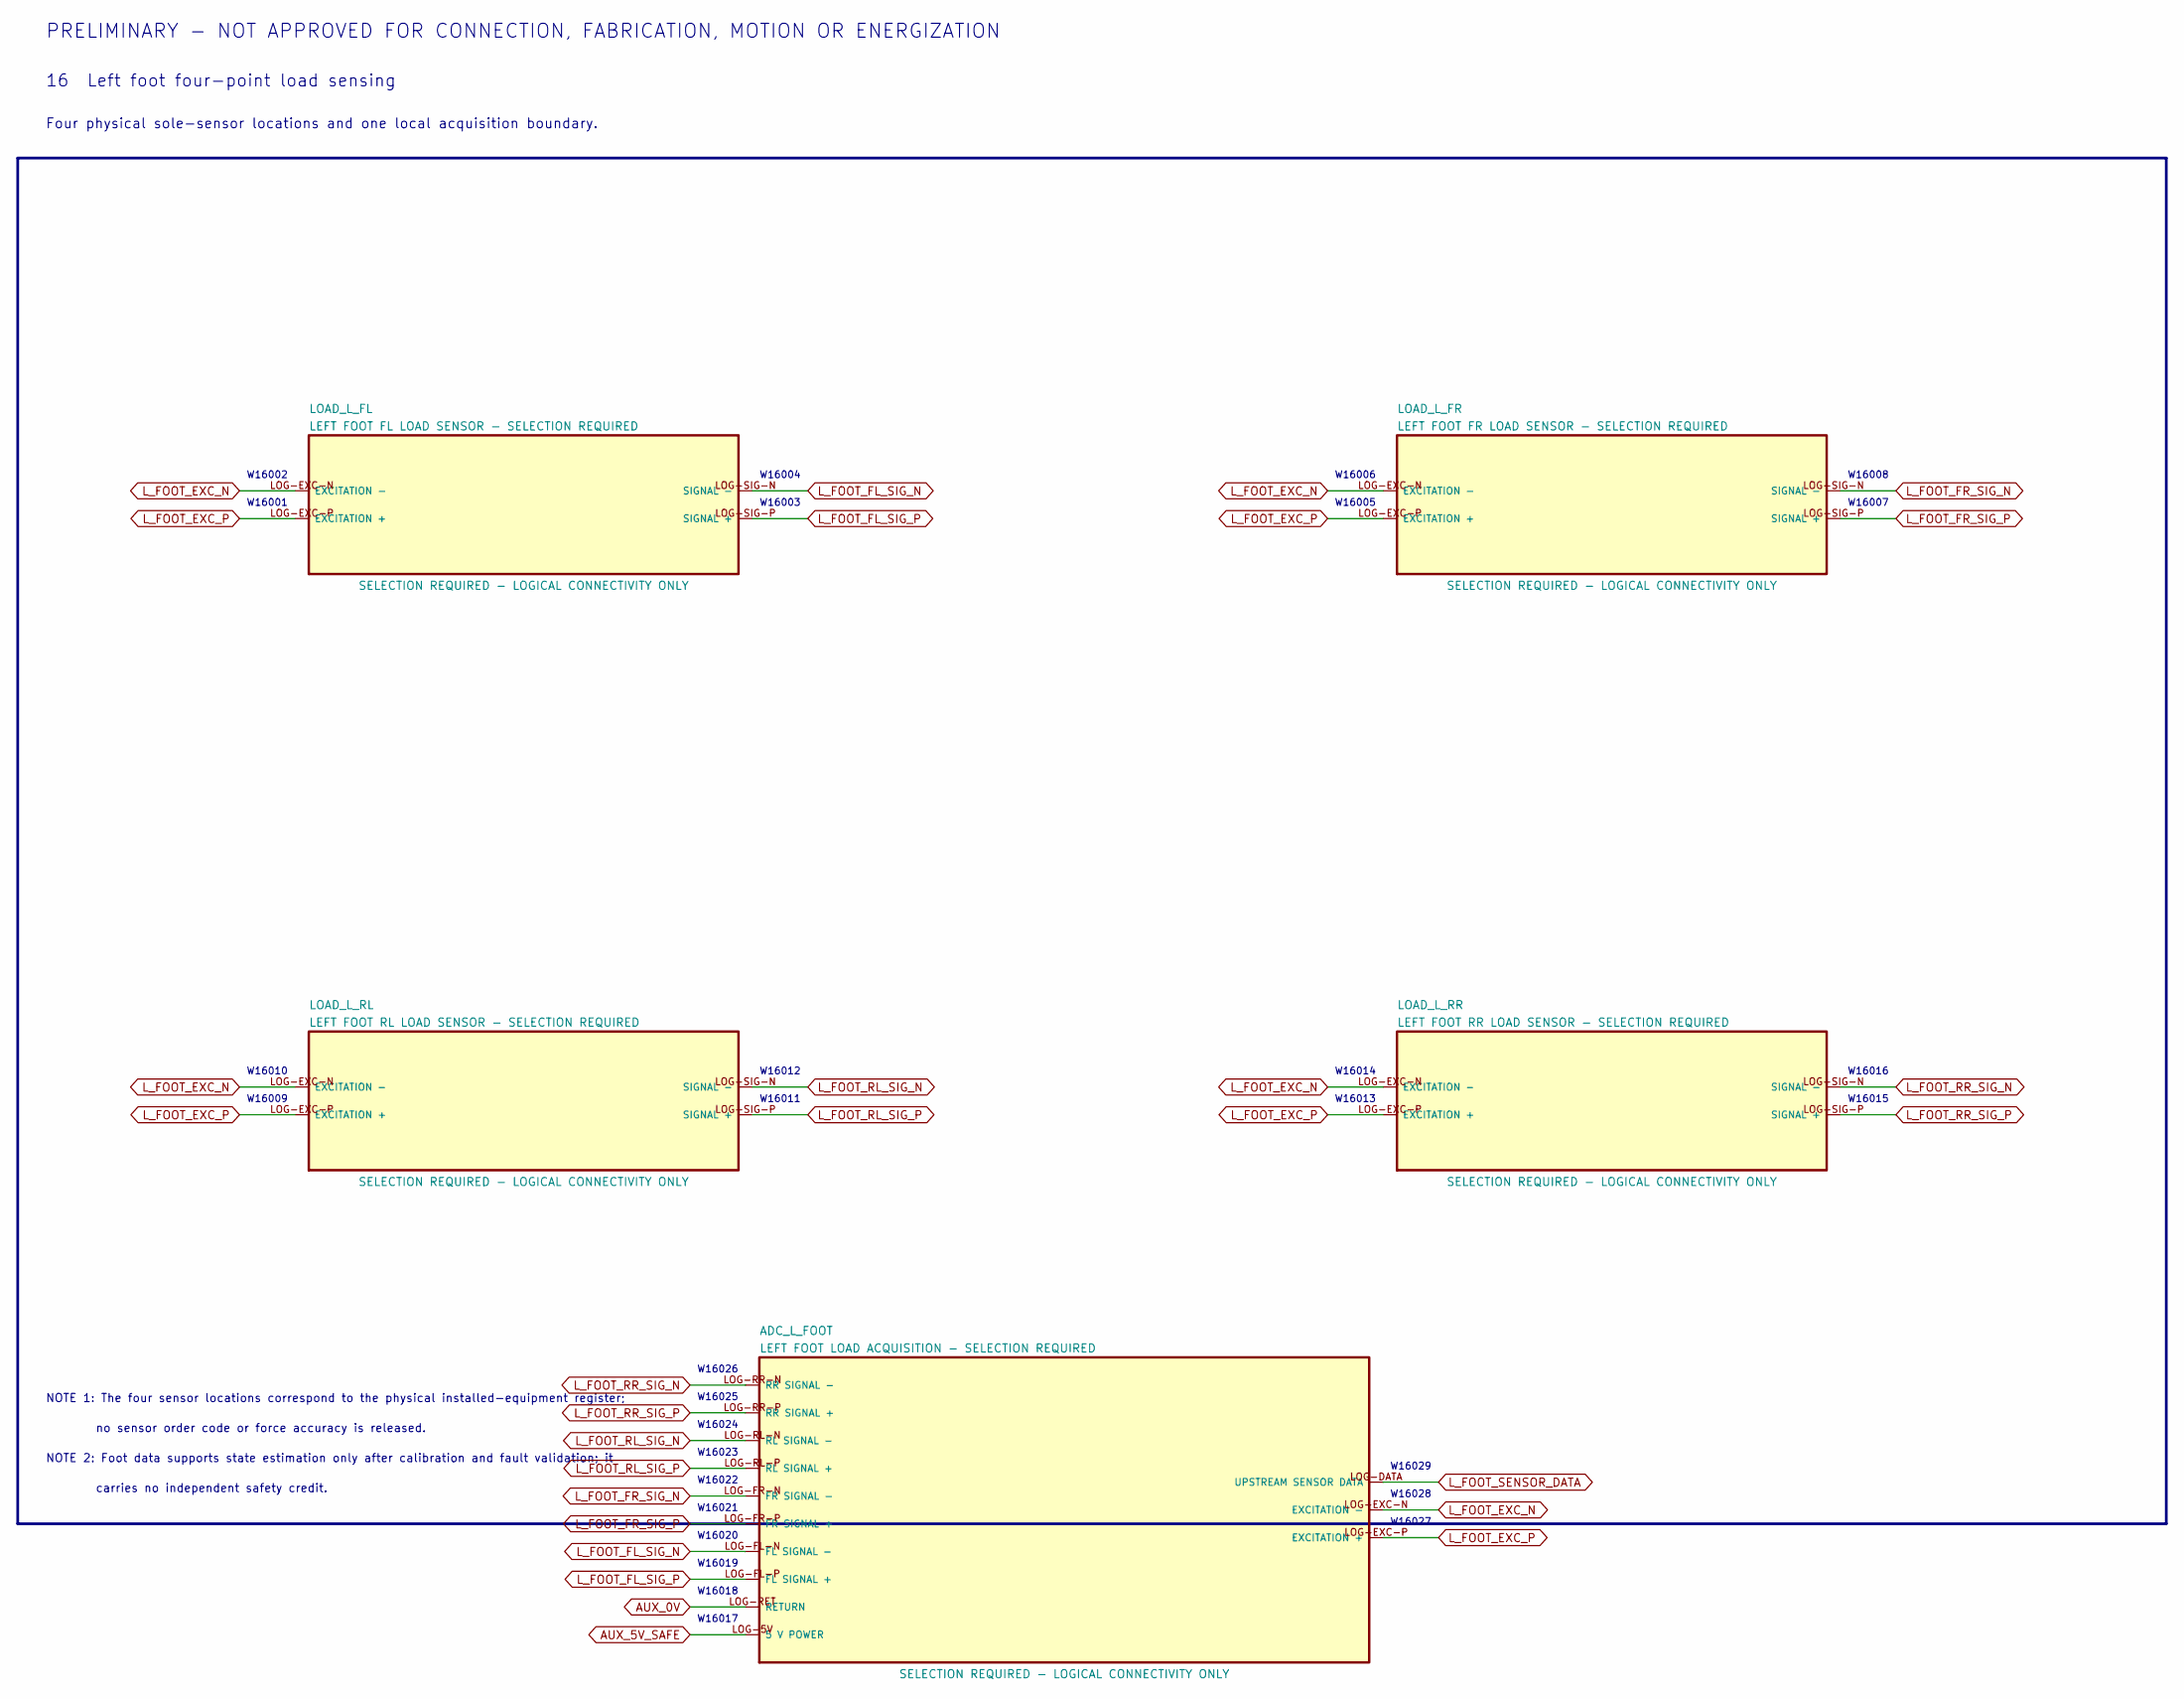
[picture p394: schematic 16_left_foot_load_sensing.kicad_sch]

Parts:
ADC_L_FOOT: LEFT FOOT LOAD ACQUISITION - SELECTION REQUIRED
LOAD_L_FL: LEFT FOOT FL LOAD SENSOR - SELECTION REQUIRED
LOAD_L_FR: LEFT FOOT FR LOAD SENSOR - SELECTION REQUIRED
LOAD_L_RL: LEFT FOOT RL LOAD SENSOR - SELECTION REQUIRED
LOAD_L_RR: LEFT FOOT RR LOAD SENSOR - SELECTION REQUIRED

Connections:
AUX_0V: ADC_L_FOOT.LOG-RET (RETURN)
AUX_5V_SAFE: ADC_L_FOOT.LOG-5V (5 V POWER)
L_FOOT_EXC_N: ADC_L_FOOT.LOG-EXC-N (EXCITATION -), LOAD_L_FL.LOG-EXC-N (EXCITATION -), LOAD_L_FR.LOG-EXC-N (EXCITATION -), LOAD_L_RL.LOG-EXC-N (EXCITATION -), LOAD_L_RR.LOG-EXC-N (EXCITATION -)
L_FOOT_EXC_P: ADC_L_FOOT.LOG-EXC-P (EXCITATION +), LOAD_L_FL.LOG-EXC-P (EXCITATION +), LOAD_L_FR.LOG-EXC-P (EXCITATION +), LOAD_L_RL.LOG-EXC-P (EXCITATION +), LOAD_L_RR.LOG-EXC-P (EXCITATION +)
L_FOOT_FL_SIG_N: ADC_L_FOOT.LOG-FL-N (FL SIGNAL -), LOAD_L_FL.LOG-SIG-N (SIGNAL -)
L_FOOT_FL_SIG_P: ADC_L_FOOT.LOG-FL-P (FL SIGNAL +), LOAD_L_FL.LOG-SIG-P (SIGNAL +)
L_FOOT_FR_SIG_N: ADC_L_FOOT.LOG-FR-N (FR SIGNAL -), LOAD_L_FR.LOG-SIG-N (SIGNAL -)
L_FOOT_FR_SIG_P: ADC_L_FOOT.LOG-FR-P (FR SIGNAL +), LOAD_L_FR.LOG-SIG-P (SIGNAL +)
L_FOOT_RL_SIG_N: ADC_L_FOOT.LOG-RL-N (RL SIGNAL -), LOAD_L_RL.LOG-SIG-N (SIGNAL -)
L_FOOT_RL_SIG_P: ADC_L_FOOT.LOG-RL-P (RL SIGNAL +), LOAD_L_RL.LOG-SIG-P (SIGNAL +)
L_FOOT_RR_SIG_N: ADC_L_FOOT.LOG-RR-N (RR SIGNAL -), LOAD_L_RR.LOG-SIG-N (SIGNAL -)
L_FOOT_RR_SIG_P: ADC_L_FOOT.LOG-RR-P (RR SIGNAL +), LOAD_L_RR.LOG-SIG-P (SIGNAL +)
L_FOOT_SENSOR_DATA: ADC_L_FOOT.LOG-DATA (UPSTREAM SENSOR DATA)

Notes on the sheet:
PRELIMINARY - NOT APPROVED FOR CONNECTION, FABRICATION, MOTION OR ENERGIZATION
16 Left foot four-point load sensing
Four physical sole-sensor locations and one local acquisition boundary.
W16001
W16002
W16003
W16004
W16005
W16006
W16007
W16008
W16009
W16010
W16011
W16012
W16013
W16014
W16015
W16016
W16017
W16018
W16019
W16020
W16021
W16022
W16023
W16024
W16025
W16026
W16027
W16028
W16029
NOTE 1: The four sensor locations correspond to the physical installed-equipment register;
no sensor order code or force accuracy is released.
NOTE 2: Foot data supports state estimation only after calibration and fault validation; it
carries no independent safety credit.
