amyleesterling/humanoid-robot/hr30/whole-body-p0.1/electrical/kicad/hr30-whole-body-electrical-p0.1/17_right_foot_load_sensing.kicad_sch

## KiCad design hr30/whole-body-p0.1/electrical/kicad/hr30-whole-body-electrical-p0.1/17_right_foot_load_sensing.kicad_sch (2026-08-15)

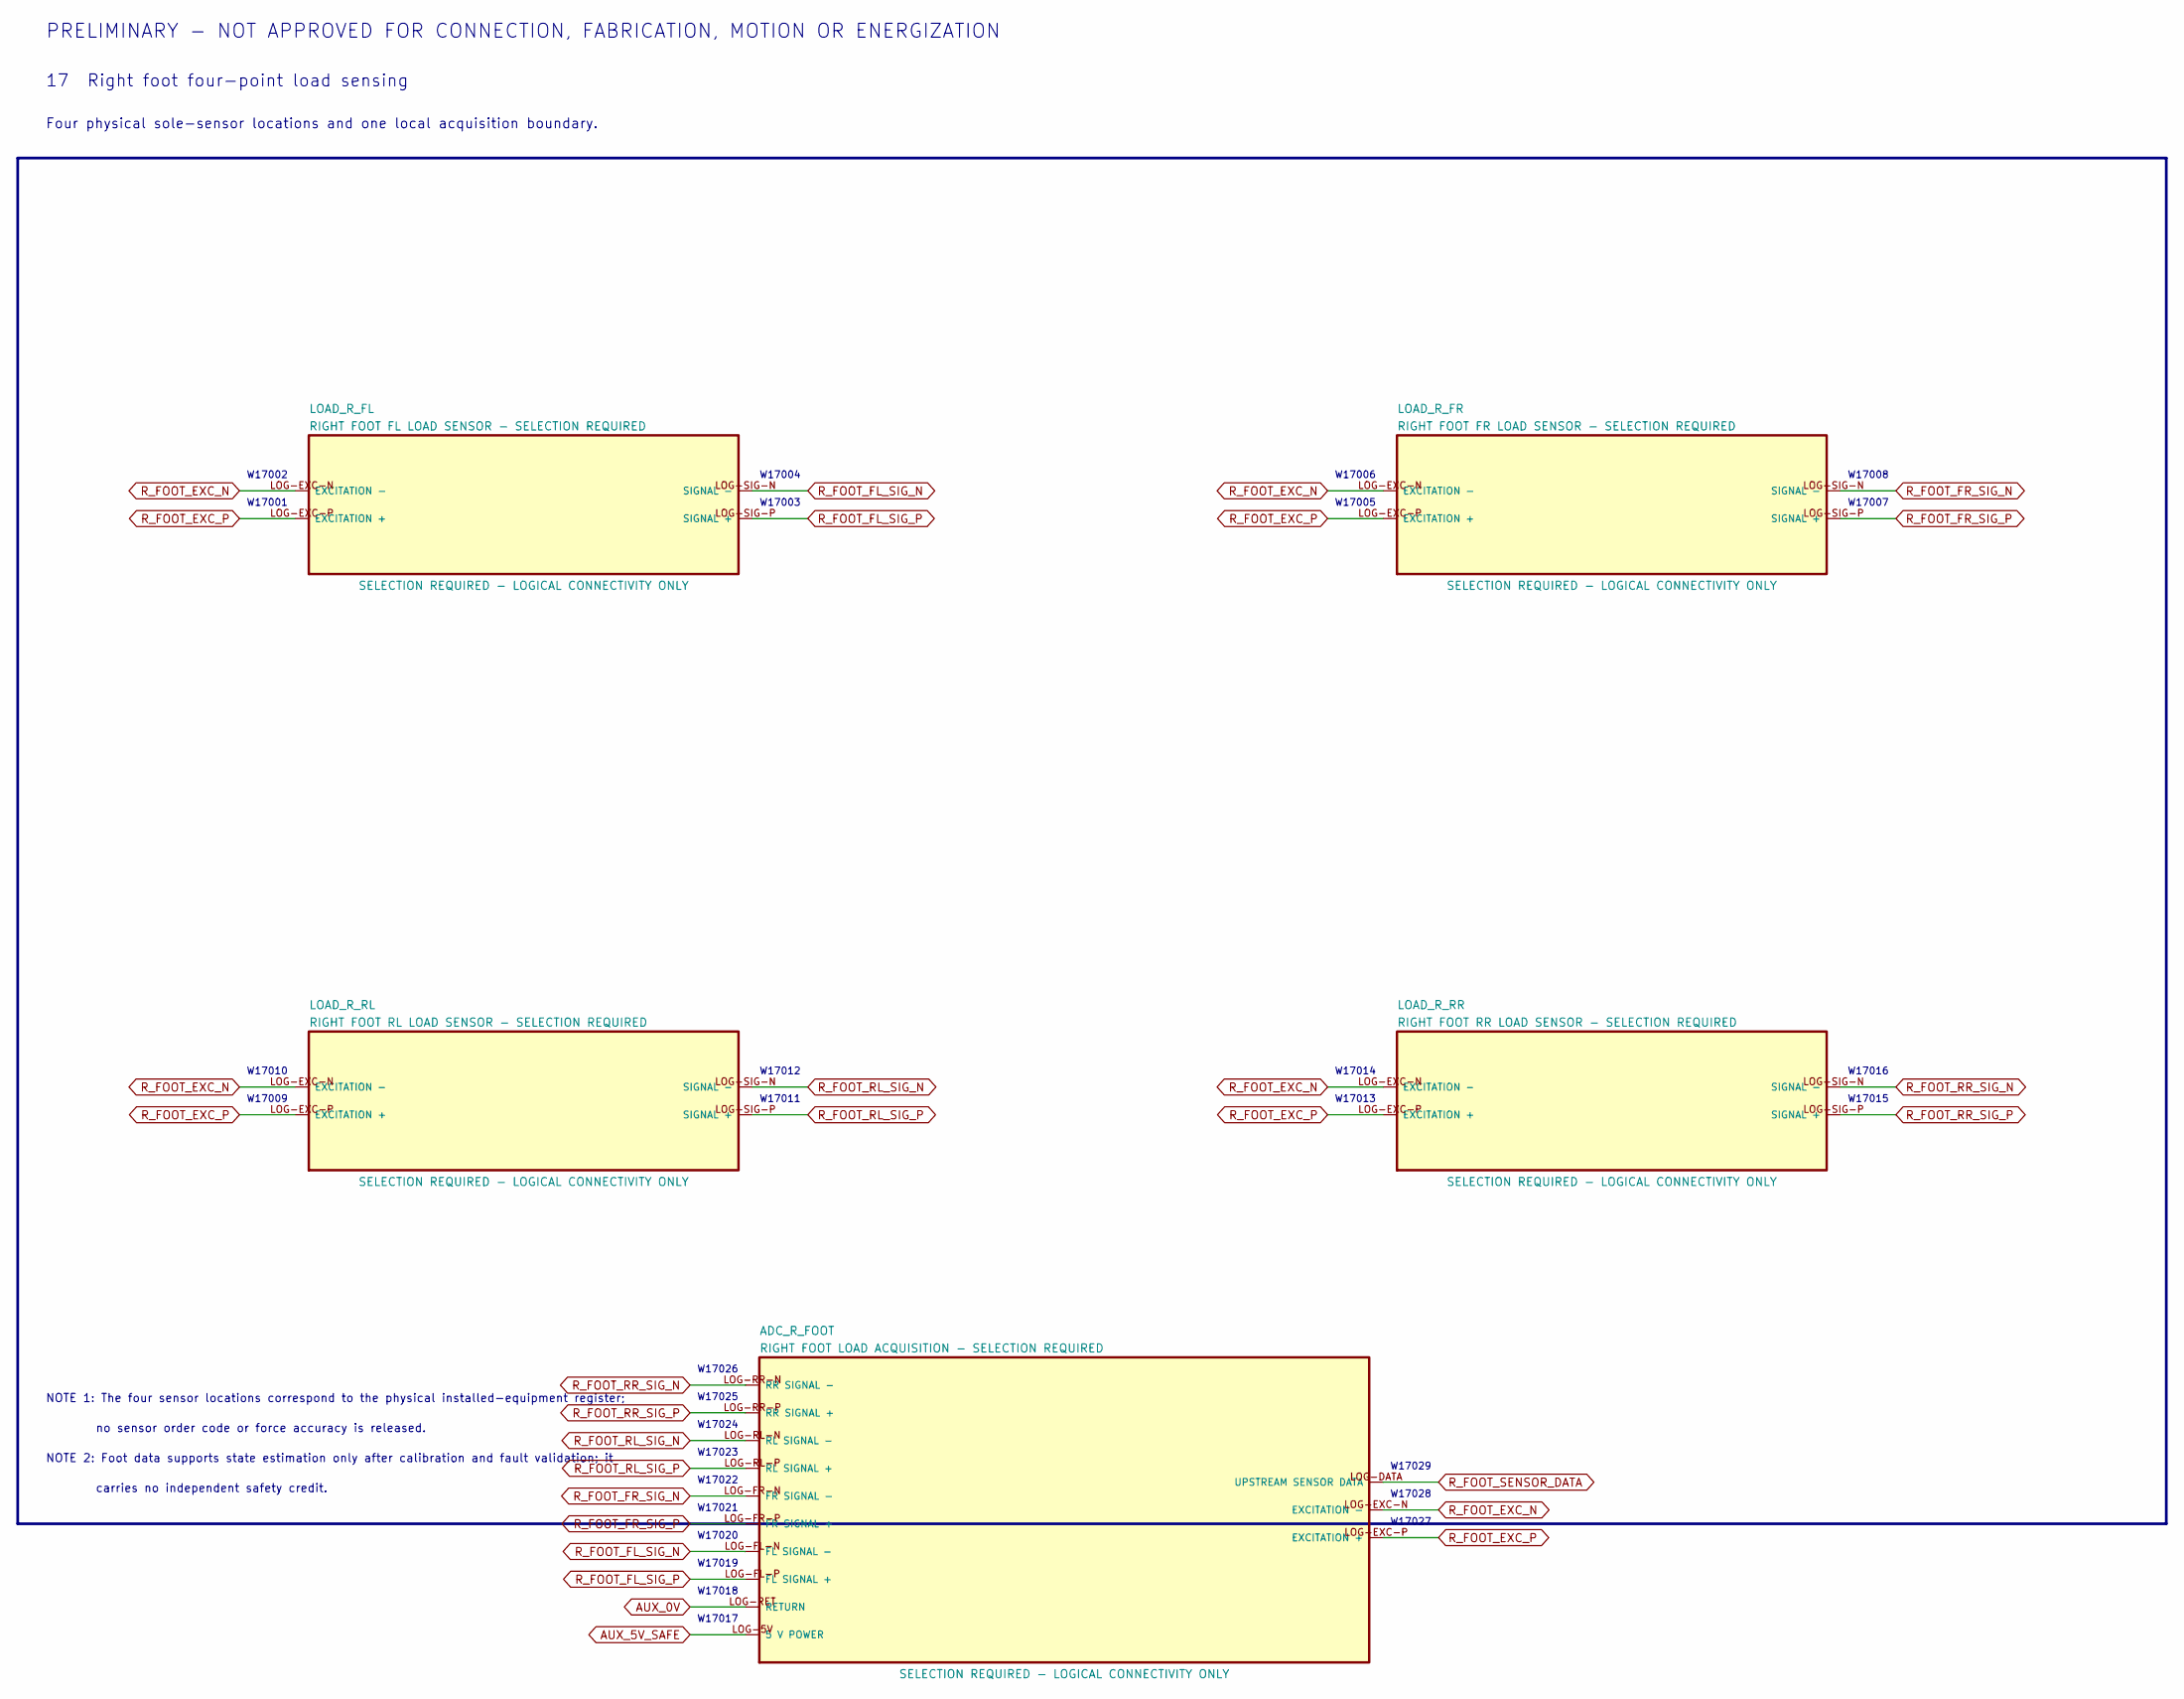
[picture p395: schematic 17_right_foot_load_sensing.kicad_sch]

Parts:
ADC_R_FOOT: RIGHT FOOT LOAD ACQUISITION - SELECTION REQUIRED
LOAD_R_FL: RIGHT FOOT FL LOAD SENSOR - SELECTION REQUIRED
LOAD_R_FR: RIGHT FOOT FR LOAD SENSOR - SELECTION REQUIRED
LOAD_R_RL: RIGHT FOOT RL LOAD SENSOR - SELECTION REQUIRED
LOAD_R_RR: RIGHT FOOT RR LOAD SENSOR - SELECTION REQUIRED

Connections:
AUX_0V: ADC_R_FOOT.LOG-RET (RETURN)
AUX_5V_SAFE: ADC_R_FOOT.LOG-5V (5 V POWER)
R_FOOT_EXC_N: ADC_R_FOOT.LOG-EXC-N (EXCITATION -), LOAD_R_FL.LOG-EXC-N (EXCITATION -), LOAD_R_FR.LOG-EXC-N (EXCITATION -), LOAD_R_RL.LOG-EXC-N (EXCITATION -), LOAD_R_RR.LOG-EXC-N (EXCITATION -)
R_FOOT_EXC_P: ADC_R_FOOT.LOG-EXC-P (EXCITATION +), LOAD_R_FL.LOG-EXC-P (EXCITATION +), LOAD_R_FR.LOG-EXC-P (EXCITATION +), LOAD_R_RL.LOG-EXC-P (EXCITATION +), LOAD_R_RR.LOG-EXC-P (EXCITATION +)
R_FOOT_FL_SIG_N: ADC_R_FOOT.LOG-FL-N (FL SIGNAL -), LOAD_R_FL.LOG-SIG-N (SIGNAL -)
R_FOOT_FL_SIG_P: ADC_R_FOOT.LOG-FL-P (FL SIGNAL +), LOAD_R_FL.LOG-SIG-P (SIGNAL +)
R_FOOT_FR_SIG_N: ADC_R_FOOT.LOG-FR-N (FR SIGNAL -), LOAD_R_FR.LOG-SIG-N (SIGNAL -)
R_FOOT_FR_SIG_P: ADC_R_FOOT.LOG-FR-P (FR SIGNAL +), LOAD_R_FR.LOG-SIG-P (SIGNAL +)
R_FOOT_RL_SIG_N: ADC_R_FOOT.LOG-RL-N (RL SIGNAL -), LOAD_R_RL.LOG-SIG-N (SIGNAL -)
R_FOOT_RL_SIG_P: ADC_R_FOOT.LOG-RL-P (RL SIGNAL +), LOAD_R_RL.LOG-SIG-P (SIGNAL +)
R_FOOT_RR_SIG_N: ADC_R_FOOT.LOG-RR-N (RR SIGNAL -), LOAD_R_RR.LOG-SIG-N (SIGNAL -)
R_FOOT_RR_SIG_P: ADC_R_FOOT.LOG-RR-P (RR SIGNAL +), LOAD_R_RR.LOG-SIG-P (SIGNAL +)
R_FOOT_SENSOR_DATA: ADC_R_FOOT.LOG-DATA (UPSTREAM SENSOR DATA)

Notes on the sheet:
PRELIMINARY - NOT APPROVED FOR CONNECTION, FABRICATION, MOTION OR ENERGIZATION
17 Right foot four-point load sensing
Four physical sole-sensor locations and one local acquisition boundary.
W17001
W17002
W17003
W17004
W17005
W17006
W17007
W17008
W17009
W17010
W17011
W17012
W17013
W17014
W17015
W17016
W17017
W17018
W17019
W17020
W17021
W17022
W17023
W17024
W17025
W17026
W17027
W17028
W17029
NOTE 1: The four sensor locations correspond to the physical installed-equipment register;
no sensor order code or force accuracy is released.
NOTE 2: Foot data supports state estimation only after calibration and fault validation; it
carries no independent safety credit.
