amyleesterling/humanoid-robot/hr30/whole-body-p0.1/electrical/kicad/hr30-whole-body-electrical-p0.1/18_onboard_later_energy_evaluation.kicad_sch

## KiCad design hr30/whole-body-p0.1/electrical/kicad/hr30-whole-body-electrical-p0.1/18_onboard_later_energy_evaluation.kicad_sch (2026-08-15)

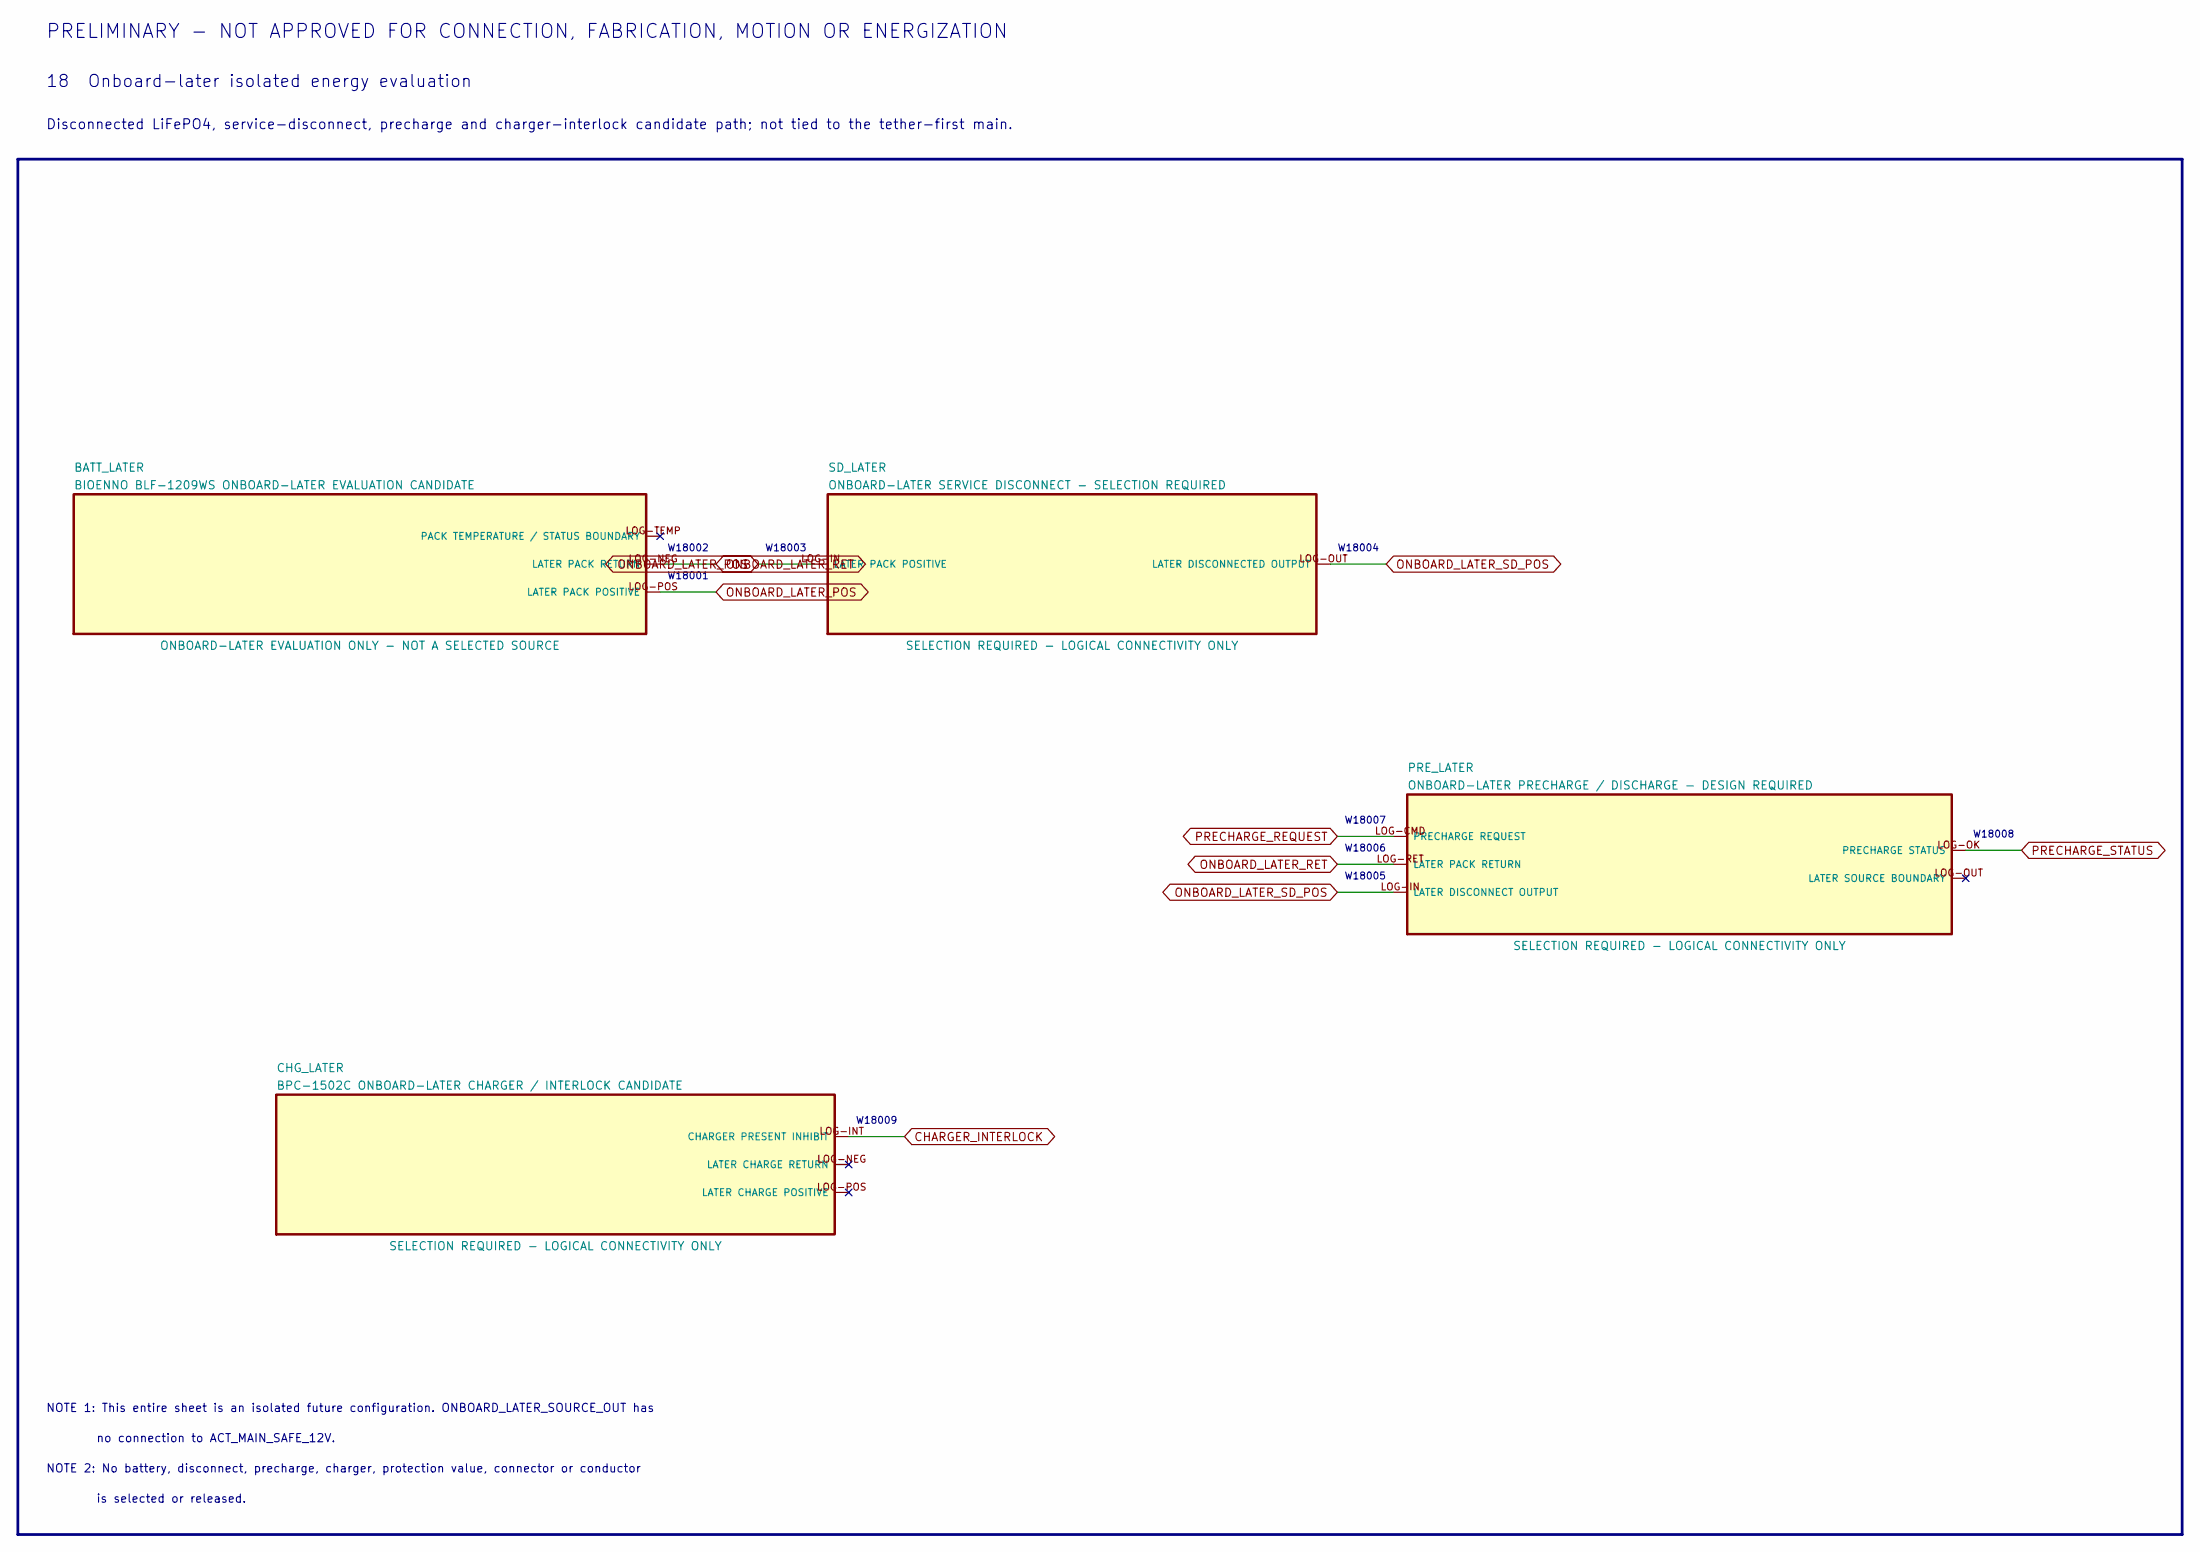
[picture p396: schematic 18_onboard_later_energy_evaluation.kicad_sch]

Parts:
BATT_LATER: BIOENNO BLF-1209WS ONBOARD-LATER EVALUATION CANDI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
CHG_LATER: BPC-1502C ONBOARD-LATER CHARGER / INTERLOCK CANDI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
PRE_LATER: ONBOARD-LATER PRECHARGE / DISCHARGE - DESIGN REQU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
SD_LATER: ONBOARD-LATER SERVICE DISCONNECT - SELECTION REQU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

Connections:
CHARGER_INTERLOCK: CHG_LATER.LOG-INT (CHARGER PRESENT INHIBIT)
ONBOARD_LATER_POS: BATT_LATER.LOG-POS (LATER PACK POSITIVE), SD_LATER.LOG-IN (LATER PACK POSITIVE)
ONBOARD_LATER_RET: BATT_LATER.LOG-NEG (LATER PACK RETURN), PRE_LATER.LOG-RET (LATER PACK RETURN)
ONBOARD_LATER_SD_POS: PRE_LATER.LOG-IN (LATER DISCONNECT OUTPUT), SD_LATER.LOG-OUT (LATER DISCONNECTED OUTPUT)
PRECHARGE_REQUEST: PRE_LATER.LOG-CMD (PRECHARGE REQUEST)
PRECHARGE_STATUS: PRE_LATER.LOG-OK (PRECHARGE STATUS)

Notes on the sheet:
PRELIMINARY - NOT APPROVED FOR CONNECTION, FABRICATION, MOTION OR ENERGIZATION
18 Onboard-later isolated energy evaluation
Disconnected LiFePO4, service-disconnect, precharge and charger-interlock candidate path; not tied to the tether-first main.
W18001
W18002
W18003
W18004
W18005
W18006
W18007
W18008
W18009
NOTE 1: This entire sheet is an isolated future configuration. ONBOARD_LATER_SOURCE_OUT has
no connection to ACT_MAIN_SAFE_12V.
NOTE 2: No battery, disconnect, precharge, charger, protection value, connector or conductor
is selected or released.
