amyleesterling/humanoid-robot/hr30/whole-body-p0.1/first-energization-readiness-p0.1/first-energization-readiness-source.py

"""Generate the fail-closed HR-30 first-energization readiness package.

This package joins existing whole-body engineering artifacts into a controlled
execution ladder.  It does not execute a physical test or grant authority.
"""

from __future__ import annotations

import csv
import hashlib
import html
import json
import shutil
from pathlib import Path


ROOT = Path(__file__).resolve().parents[1]
WHOLE = ROOT / "hr30" / "whole-body-p0.1"
OUT = WHOLE / "first-energization-readiness-p0.1"
RELEASE = ROOT / "release" / "hr30" / "whole-body-p0.1" / OUT.name
IDENTIFIER = "HR30-FIRST-ENERGIZATION-READINESS-P0.1"
WARNING = "PRELIMINARY - READINESS PLAN ONLY - NOT APPROVED FOR CONNECTION, POWERED TESTING, MOTION, OR ENERGIZATION"
AUTHORITY = "NO CONNECTION, POWERED-TEST, MOTION, OR ENERGIZATION AUTHORITY"


def sha(path: Path) -> str:
    return hashlib.sha256(path.read_bytes()).hexdigest()


def write_csv(path: Path, rows: list[dict]) -> None:
    if not rows:
        raise RuntimeError(f"refusing empty CSV: {path}")
    with path.open("w", encoding="utf-8", newline="") as handle:
        writer = csv.DictWriter(handle, fieldnames=list(rows[0]), lineterminator="\n")
        writer.writeheader()
        writer.writerows(rows)


def read_csv(path: Path) -> list[dict]:
    with path.open(encoding="utf-8", newline="") as handle:
        return list(csv.DictReader(handle))


def common(row: dict) -> dict:
    return {**row, "state": "OPEN - NOT EXECUTED", "authority": AUTHORITY, "warning": WARNING}
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
