amyleesterling/humanoid-robot/(commit log)

2026-08-06 Sync Project Button HR-30 V2.2 specification
    [bom.csv, hr30a-bom.csv, hr30w-bom.csv, requirements.csv, risk-register.csv]
2026-08-06 Add engineering review ledger and handoff
2026-08-06 Add authoritative native KiCad V2.1 source
    [01_ac_pe_power.kicad_sch, 02_hrv0_safety.kicad_sch, 03_hrv0_distribution.kicad_sch, 04_control_watchdog.kicad_sch, 05_hr30_battery_precharge.kicad_sch, 06_hr30_safety_distribution.kicad_sch, 07_left_leg_rs485.kicad_sch, 08_right_leg_rs485.kicad_sch]
2026-08-06 Correct R11 engineering and verification blockers
    [05_hr30_battery_precharge.kicad_sch, SOURCE-MANIFEST.csv, bom.csv, hr30w-bom.csv, procedure-registry.csv, requirements.csv, unresolved-selections.csv]
2026-08-06 Archive and disposition Sol R12 review
    [hr30w-bom.csv]
2026-08-06 Add Boston fabrication path and energization gates
    [hr-v0-energization-gates.csv]
2026-08-06 Add HR-V0 native mechanical quote package
    [HR-V0_preliminary_assembly.step, MV0-001_upper_link_plate.dxf, MV0-001_upper_link_plate.step, MV0-001_upper_link_plate.stl, MV0-002_forearm_link_plate.dxf, MV0-002_forearm_link_plate.step, MV0-002_forearm_link_plate.stl, MV0-003_shoulder_adapter.dxf]
2026-08-06 Record Boston fabrication route and light-duty basis
    [HR-V0_preliminary_assembly.step, MV0-001_upper_link_plate.dxf, MV0-001_upper_link_plate.step, MV0-002_forearm_link_plate.dxf, MV0-002_forearm_link_plate.step, MV0-003_shoulder_adapter.dxf, MV0-003_shoulder_adapter.step, MV0-004_bench_anchor_plate.dxf]
2026-08-06 Add connected HR-V0 Electrical V3 candidate
    [01_external_sources.kicad_sch, 02_estop_eligibility.kicad_sch, 03_arm_watchdog_eligibility.kicad_sch, 04_contactor_edm.kicad_sch, 05_actuator_interruption.kicad_sch, 06_branches_and_injection.kicad_sch, 07_watchdog_control.kicad_sch, 08_compute_and_control_terminals.kicad_sch]
2026-08-06 Correct watchdog reset chain and add firmware candidate
    [01_external_sources.kicad_sch, 02_estop_eligibility.kicad_sch, 03_arm_watchdog_eligibility.kicad_sch, 04_contactor_edm.kicad_sch, 05_actuator_interruption.kicad_sch, 06_branches_and_injection.kicad_sch, 07_watchdog_control.kicad_sch, 08_compute_and_control_terminals.kicad_sch]
2026-08-06 Correct watchdog feedback voltage boundary
    [01_external_sources.kicad_sch, 02_estop_eligibility.kicad_sch, 03_arm_watchdog_eligibility.kicad_sch, 04_contactor_edm.kicad_sch, 05_actuator_interruption.kicad_sch, 06_branches_and_injection.kicad_sch, 07_watchdog_control.kicad_sch, 08_compute_and_control_terminals.kicad_sch]
2026-08-06 Define watchdog feedback circuit candidate
    [01_external_sources.kicad_sch, 02_estop_eligibility.kicad_sch, 03_arm_watchdog_eligibility.kicad_sch, 04_contactor_edm.kicad_sch, 05_actuator_interruption.kicad_sch, 06_branches_and_injection.kicad_sch, 07_watchdog_control.kicad_sch, 08_watchdog_feedback_interface.kicad_sch]
2026-08-06 Add controlled HR-V0 frame fit coupon
    [HR-V0_preliminary_assembly.step, MV0-001_upper_link_plate.dxf, MV0-001_upper_link_plate.step, MV0-002_forearm_link_plate.step, MV0-003_shoulder_adapter.dxf, MV0-003_shoulder_adapter.step, MV0-004_bench_anchor_plate.dxf, MV0-004_bench_anchor_plate.step]
2026-08-06 Correct HR-V0 frame interface topology
    [HR-V0_preliminary_assembly.step, MV0-001_upper_link_plate.dxf, MV0-001_upper_link_plate.step, MV0-002_forearm_link_plate.dxf, MV0-002_forearm_link_plate.step, MV0-003_shoulder_adapter.step, MV0-003_shoulder_adapter.stl, MV0-004_bench_anchor_plate.dxf]
2026-08-06 Define HR-V0 hard-stop validation basis
    [HR-V0_preliminary_assembly.step, MV0-001_upper_link_plate.dxf, MV0-001_upper_link_plate.step, MV0-002_forearm_link_plate.dxf, MV0-002_forearm_link_plate.step, MV0-003_shoulder_adapter.dxf, MV0-003_shoulder_adapter.step, MV0-004_bench_anchor_plate.dxf]
2026-08-06 Add HR-V0 moving-mass closure ledger
    [HR-V0_preliminary_assembly.step, MV0-001_upper_link_plate.dxf, MV0-001_upper_link_plate.step, MV0-002_forearm_link_plate.dxf, MV0-002_forearm_link_plate.step, MV0-003_shoulder_adapter.dxf, MV0-003_shoulder_adapter.step, MV0-004_bench_anchor_plate.dxf]
2026-08-06 Define HR-V0 gripper interface and evidence route
    [HR-V0_preliminary_assembly.step, MV0-001_upper_link_plate.dxf, MV0-001_upper_link_plate.step, MV0-002_forearm_link_plate.dxf, MV0-002_forearm_link_plate.step, MV0-003_shoulder_adapter.dxf, MV0-003_shoulder_adapter.step, MV0-004_bench_anchor_plate.dxf]
2026-08-06 Add HR-V0 guard receiver and cable evidence
    [HR-V0_guard_receiver_envelope_NOT_RELEASED.step, HR-V0_preliminary_assembly.step, MV0-001_upper_link_plate.dxf, MV0-001_upper_link_plate.step, MV0-002_forearm_link_plate.dxf, MV0-002_forearm_link_plate.step, MV0-003_shoulder_adapter.dxf, MV0-003_shoulder_adapter.step]
2026-08-06 Advance electrical candidate to V3-P0.5
    [01_external_sources.kicad_sch, 02_estop_eligibility.kicad_sch, 03_arm_watchdog_eligibility.kicad_sch, 04_contactor_edm.kicad_sch, 05_actuator_interruption.kicad_sch, 06_branches_and_injection.kicad_sch, 07_watchdog_control.kicad_sch, 08_watchdog_feedback_interface.kicad_sch]
2026-08-06 Close E-stop terminal positions in V3-P0.6
    [01_external_sources.kicad_sch, 02_estop_eligibility.kicad_sch, 03_arm_watchdog_eligibility.kicad_sch, 04_contactor_edm.kicad_sch, 05_actuator_interruption.kicad_sch, 06_branches_and_injection.kicad_sch, 07_watchdog_control.kicad_sch, 08_watchdog_feedback_interface.kicad_sch]
2026-08-06 Freeze source interfaces in V3-P0.7
    [01_external_sources.kicad_sch, 02_estop_eligibility.kicad_sch, 03_arm_watchdog_eligibility.kicad_sch, 04_contactor_edm.kicad_sch, 05_actuator_interruption.kicad_sch, 06_branches_and_injection.kicad_sch, 07_watchdog_control.kicad_sch, 08_watchdog_feedback_interface.kicad_sch]
2026-08-07 Freeze watchdog interfaces in V3-P0.8
    [01_external_sources.kicad_sch, 02_estop_eligibility.kicad_sch, 03_arm_watchdog_eligibility.kicad_sch, 04_contactor_edm.kicad_sch, 05_actuator_interruption.kicad_sch, 06_branches_and_injection.kicad_sch, 07_watchdog_control.kicad_sch, 08_watchdog_feedback_interface.kicad_sch]
2026-08-07 Freeze watchdog feedback passives in V3-P0.9
    [01_external_sources.kicad_sch, 02_estop_eligibility.kicad_sch, 03_arm_watchdog_eligibility.kicad_sch, 04_contactor_edm.kicad_sch, 05_actuator_interruption.kicad_sch, 06_branches_and_injection.kicad_sch, 07_watchdog_control.kicad_sch, 08_watchdog_feedback_interface.kicad_sch]
2026-08-07 Add native watchdog PCB placement candidate
    [01_external_sources.kicad_sch, 02_estop_eligibility.kicad_sch, 03_arm_watchdog_eligibility.kicad_sch, 04_contactor_edm.kicad_sch, 05_actuator_interruption.kicad_sch, 06_branches_and_injection.kicad_sch, 07_watchdog_control.kicad_sch, 08_watchdog_feedback_interface.kicad_sch]
2026-08-07 Correct watchdog PCB package and placement constraints
    [08_watchdog_feedback_interface.kicad_sch, SOURCE-MANIFEST.csv, bom.csv, hr-v0-watchdog-pcb-inspection-template.csv, procedure-registry.csv, project-button-v3.kicad_pcb]
2026-08-07 Add DRC-clean watchdog PCB routing candidate
    [SOURCE-MANIFEST.csv, project-button-v3.kicad_pcb]
2026-08-07 Add watchdog PCB test access and SUB copper
    [01_external_sources.kicad_sch, 02_estop_eligibility.kicad_sch, 03_arm_watchdog_eligibility.kicad_sch, 04_contactor_edm.kicad_sch, 05_actuator_interruption.kicad_sch, 06_branches_and_injection.kicad_sch, 07_watchdog_control.kicad_sch, 08_watchdog_feedback_interface.kicad_sch]
2026-08-07 Add PCB P0.5 fabrication envelope
    [SOURCE-MANIFEST.csv, project-button-v3.kicad_pcb]
2026-08-07 Add HR-V0 protection coordination controls
    [04_contactor_edm.kicad_sch, 05_actuator_interruption.kicad_sch, 06_branches_and_injection.kicad_sch, SOURCE-MANIFEST.csv, bom.csv, hr-v0-energization-gates.csv, hr-v0-protection-coordination-inputs.csv, hr-v0-protection-coordination-template.csv]
2026-08-07 Add native DYNAMIXEL star injection release candidate
    [01_external_sources.kicad_sch, 01_star_injection.kicad_sch, 02_estop_eligibility.kicad_sch, 03_arm_watchdog_eligibility.kicad_sch, 04_contactor_edm.kicad_sch, 05_actuator_interruption.kicad_sch, 06_branches_and_injection.kicad_sch, 07_watchdog_control.kicad_sch]
2026-08-07 Add fail-closed actuator current envelope
    [SOURCE-MANIFEST.csv, hr-v0-actuator-current-characterization-template.csv, hr-v0-energization-gates.csv, hr-v0-protection-coordination-inputs.csv, procedure-registry.csv, requirements.csv]
2026-08-07 Add reproducible Pico watchdog target
    [SOURCE-MANIFEST.csv, artifact-manifest.csv, hr-v0-energization-gates.csv]
2026-08-07 Add compiled watchdog differential evidence
    [SOURCE-MANIFEST.csv, artifact-manifest.csv]
2026-08-07 Document HR-V0 contactor application evidence
    [01_external_sources.kicad_sch, 02_estop_eligibility.kicad_sch, 03_arm_watchdog_eligibility.kicad_sch, 04_contactor_edm.kicad_sch, 05_actuator_interruption.kicad_sch, 06_branches_and_injection.kicad_sch, 07_watchdog_control.kicad_sch, 08_watchdog_feedback_interface.kicad_sch]
2026-08-07 Add received-lot control for reset and arm terminals
    [01_external_sources.kicad_sch, 02_estop_eligibility.kicad_sch, 03_arm_watchdog_eligibility.kicad_sch, 04_contactor_edm.kicad_sch, 05_actuator_interruption.kicad_sch, 06_branches_and_injection.kicad_sch, 07_watchdog_control.kicad_sch, 08_watchdog_feedback_interface.kicad_sch]
2026-08-07 Control HR-V0 flat-plate RFQ and first articles
    [SOURCE-MANIFEST.csv, custom-parts.csv, hr-v0-energization-gates.csv, hr-v0-flat-plate-dfm-fai-template.csv, hr-v0-flat-plate-process-register.csv, procedure-registry.csv]
2026-08-07 Correct HR-V0 watchdog safety allocation
    [hr-v0-energization-gates.csv, hr-v0-functional-safety-allocation-template.csv, hr-v0-safety-function-allocation.csv, hr-v0-watchdog-boundary-fmea.csv, procedure-registry.csv, requirements.csv, risk-register.csv]
2026-08-07 Add deterministic HR-V0 release candidate manifest
    [HR-V0-RC-P0.1-file-manifest.csv, hr-v0-energization-gates.csv]
2026-08-07 Fix portable release manifest hashing
    [HR-V0-RC-P0.1-file-manifest.csv]
2026-08-07 Preserve domain file formats in release candidate
    [HR-V0-RC-P0.1-file-manifest.csv]
2026-08-07 Add HR-V0 BOM closure and evaluation boundary
    [HR-V0-RC-P0.1-file-manifest.csv, bom.csv, hr-v0-bom-closure.csv, hr-v0-energization-gates.csv, hr-v0-evaluation-batch-a-receiving-template.csv, hr-v0-evaluation-batch-a.csv, procedure-registry.csv, requirements.csv]
2026-08-07 Add HR-V0 mechanical release coordination
    [HR-V0-RC-P0.1-file-manifest.csv, HR-V0_guard_receiver_envelope_NOT_RELEASED.step, HR-V0_preliminary_assembly.step, MV0-001_upper_link_plate.dxf, MV0-001_upper_link_plate.step, MV0-001_upper_link_plate.stl, MV0-002_forearm_link_plate.dxf, MV0-002_forearm_link_plate.step]
2026-08-07 Add exact HR-V0 frame joint candidate
    [HR-V0-RC-P0.1-file-manifest.csv, SOURCE-MANIFEST.csv, bom.csv, hr-v0-bom-closure.csv, hr-v0-energization-gates.csv, hr-v0-frame-joint-receiving-assembly-template.csv, hr-v0-frame-joint-schedule.csv, hr-v0-mechanical-release-inspection-template.csv]
2026-08-07 Correct HR-V0 frame geometry and joint topology
    [HR-V0-RC-P0.1-file-manifest.csv, HR-V0_guard_receiver_envelope_NOT_RELEASED.step, HR-V0_preliminary_assembly.step, MV0-001_upper_link_plate.dxf, MV0-001_upper_link_plate.step, MV0-002_forearm_link_plate.dxf, MV0-002_forearm_link_plate.step, MV0-003_shoulder_adapter.dxf]
2026-08-07 Add controlled HR-V0 fabrication RFQ routes
    [HR-V0-RC-P0.1-file-manifest.csv, HR-V0_guard_receiver_envelope_NOT_RELEASED.step, HR-V0_preliminary_assembly.step, MV0-001_upper_link_PROFILE_ONLY_RFQ.dxf, MV0-001_upper_link_PROFILE_ONLY_RFQ.step, MV0-001_upper_link_plate.dxf, MV0-001_upper_link_plate.step, MV0-002_forearm_link_PROFILE_ONLY_RFQ.dxf]
2026-08-07 Add deterministic fabrication inquiry packets
    [HR-V0-RC-P0.1-file-manifest.csv, hr-v0-boston-bench-survey-template.csv, hr-v0-energization-gates.csv, packet-index.csv, procedure-registry.csv, requirements.csv, risk-register.csv]
2026-08-07 Fix fabrication packet clean-clone reproducibility
    [HR-V0-RC-P0.1-file-manifest.csv, packet-index.csv]
2026-08-07 R53 withdraw invalid HR-V0 arm geometry
    [HR-V0-RC-P0.1-file-manifest.csv, SOURCE-MANIFEST.csv, XM540-H101-S102-same-origin.step, assembly-datums.csv, bom.csv, hr-v0-bom-closure.csv, hr-v0-energization-gates.csv, hr-v0-evaluation-batch-a.csv]
2026-08-07 R54 add exact-coordinate HR-V0 arm candidate
    [HR-V0-RC-P0.1-file-manifest.csv, MV0-C01_pcd22_to_20-2040_adapter.step, MV0-C02_20-2040_100mm_collision_envelope.step, MV0-C03_20-2040_50mm_collision_envelope.step, SOURCE-MANIFEST.csv, collision-sweep.csv, hr-v0-energization-gates.csv, hr-v0-robotis-interface-closure-template.csv]
2026-08-07 Make R54 arm STEP reproducible
    [HR-V0-RC-P0.1-file-manifest.csv, SOURCE-MANIFEST.csv]
2026-08-07 Correct HR-V0 arm architecture and stop boundary
    [HR-V0-RC-P0.1-file-manifest.csv, HR-V0_guard_receiver_envelope_NOT_RELEASED.step, HR-V0_preliminary_assembly.step, MV0-001_upper_link_PROFILE_ONLY_RFQ.dxf, MV0-001_upper_link_PROFILE_ONLY_RFQ.step, MV0-001_upper_link_plate.dxf, MV0-001_upper_link_plate.step, MV0-002_forearm_link_PROFILE_ONLY_RFQ.dxf]
2026-08-07 Preserve vendor evidence in clean clones
    [HR-V0-RC-P0.1-file-manifest.csv]
2026-08-07 Strengthen HR-V0 arm adapter and fastener stack
    [HR-V0-RC-P0.1-file-manifest.csv, MV0-C01_rect32x16_to_20-2040_countersunk_adapter.step, MV0-C02_20-2040_100mm_vertical_collision_envelope.step, MV0-C03_20-2040_50mm_vertical_collision_envelope.step, SOURCE-MANIFEST.csv, bom.csv, collision-sweep.csv, fastener-candidate-schedule.csv]
2026-08-07 Define HR-V0 adapter fabrication candidate
    [HR-V0-RC-P0.1-file-manifest.csv, MV0-C01_adapter-finished-profile.dxf, MV0-C01_rect32x16_to_20-2040_countersunk_adapter.step, MV0-C02_20-2040_100mm_vertical_collision_envelope.step, MV0-C03_20-2040_50mm_vertical_collision_envelope.step, SOURCE-MANIFEST.csv, adapter-drawing-controls.csv, adapter-proof-analysis.csv]
2026-08-07 Define fail-closed HR-V0 E2 commissioning
    [HR-V0-RC-P0.1-file-manifest.csv, hr-v0-e2-authorization-template.csv, hr-v0-e2-control-only-sequence.csv, hr-v0-e2-elv-point-to-point-template.csv, hr-v0-e2-mains-pe-insulation-template.csv, hr-v0-e2-safety-logic-template.csv, hr-v0-e2-unpowered-configuration-template.csv, hr-v0-energization-gates.csv]
2026-08-07 Correct current HR-V0 fabrication sourcing
    [HR-V0-RC-P0.1-file-manifest.csv, hr-v0-r57-fabrication-inquiry-template.csv, hr-v0-r57-fabrication-route-register.csv]
2026-08-07 Define HR-V0 control panel candidate
    [HR-V0-RC-P0.1-file-manifest.csv, backplate-layout.csv, cable-entry-schedule.csv, door-layout.csv, hr-v0-control-panel-receiving-assembly-template.csv, panel-bom.csv, stationary-wire-schedule.csv, terminal-allocation.csv]
2026-08-07 Reconcile H1 pilot light in electrical V3
    [01_external_sources.kicad_sch, 02_estop_eligibility.kicad_sch, 03_arm_watchdog_eligibility.kicad_sch, 04_contactor_edm.kicad_sch, 05_actuator_interruption.kicad_sch, 06_branches_and_injection.kicad_sch, 07_watchdog_control.kicad_sch, 08_watchdog_feedback_interface.kicad_sch]
2026-08-07 Correct control-panel protection fit
    [01_external_sources.kicad_sch, 02_estop_eligibility.kicad_sch, 03_arm_watchdog_eligibility.kicad_sch, 04_contactor_edm.kicad_sch, 05_actuator_interruption.kicad_sch, 06_branches_and_injection.kicad_sch, 07_watchdog_control.kicad_sch, 08_watchdog_feedback_interface.kicad_sch]
2026-08-07 Screen service disconnect and freeze fuse end cover
    [01_external_sources.kicad_sch, 02_estop_eligibility.kicad_sch, 03_arm_watchdog_eligibility.kicad_sch, 04_contactor_edm.kicad_sch, 05_actuator_interruption.kicad_sch, 06_branches_and_injection.kicad_sch, 07_watchdog_control.kicad_sch, 08_watchdog_feedback_interface.kicad_sch]
2026-08-07 Freeze SD1 candidate and synchronize R64
    [01_external_sources.kicad_sch, 02_estop_eligibility.kicad_sch, 03_arm_watchdog_eligibility.kicad_sch, 04_contactor_edm.kicad_sch, 05_actuator_interruption.kicad_sch, 06_branches_and_injection.kicad_sch, 07_watchdog_control.kicad_sch, 08_watchdog_feedback_interface.kicad_sch]
2026-08-07 Add fail-closed DYNAMIXEL transport boundary
    [HR-V0-RC-P0.1-file-manifest.csv, SOURCE-MANIFEST.csv, hr-v0-dynamixel-transport-hil-template.csv, procedure-registry.csv, requirements.csv]
2026-08-07 Integrate HR-V0 arm support and gripper interfaces
    [HR-V0-RC-P0.1-file-manifest.csv, HR-V0_guard_receiver_envelope_NOT_RELEASED.step, HR-V0_preliminary_assembly.step, MV0-001_upper_link_PROFILE_ONLY_RFQ.dxf, MV0-001_upper_link_PROFILE_ONLY_RFQ.step, MV0-001_upper_link_plate.dxf, MV0-001_upper_link_plate.step, MV0-002_forearm_link_PROFILE_ONLY_RFQ.dxf]
2026-08-07 Add continuous HR-V0 clearance and stop allocation
    [HR-V0-RC-P0.1-file-manifest.csv, MV0-C01_adapter-finished-profile.dxf, MV0-C01_rect32x16_to_20-2040_countersunk_adapter.step, MV0-C02_20-2040_100mm_vertical_collision_envelope.step, MV0-C03_20-2040_50mm_vertical_collision_envelope.step, MV0-C04_H104_to_20-2040_countersunk_adapter.step, MV0-C04_gripper-adapter-finished-profile.dxf, MV0-C05_S102_to_40-4040_side_slot_support.step]
2026-08-07 Bind HR-V0 J2 limit to mechanical configuration
    [HR-V0-RC-P0.1-file-manifest.csv, SOURCE-MANIFEST.csv, hr-v0-actuator-current-characterization-template.csv, hr-v0-dynamixel-transport-hil-template.csv]
2026-08-08 Add R69 J2 positive-stop candidate
    [HR-V0-RC-P0.1-file-manifest.csv, HR-V0_J2_positive_stop_contact_candidate.step, MV0-C01_adapter-finished-profile.dxf, MV0-C01_rect32x16_to_20-2040_countersunk_adapter.step, MV0-C02_20-2040_100mm_vertical_collision_envelope.step, MV0-C03_20-2040_50mm_vertical_collision_envelope.step, MV0-C04_H104_to_20-2040_countersunk_adapter.step, MV0-C04_gripper-adapter-finished-profile.dxf]
2026-08-08 Add R70 moving-mass reduction study
    [HR-V0-RC-P0.1-file-manifest.csv, HR-V0_mass-reduced-moving-adapters-candidate.step, MV0-C01R_same-interface-relief-candidate.step, MV0-C04R_same-interface-relief-candidate.step, MV0-C06R_same-interface-relief-candidate.step, MV0-C07R_same-interface-relief-candidate.step, SOURCE-MANIFEST.csv, candidate-decision-register.csv]
2026-08-08 Add exact-source HR-V0 gripper integration inputs
    [HR-V0-RC-P0.1-file-manifest.csv, SOURCE-MANIFEST.csv, gripper-integration-holds.csv, gripper-kinematic-samples.csv, gripper-mass-load-sensitivity.csv, gripper-source-integrity.csv, hr-v0-energization-gates.csv]
2026-08-08 Add gripper CAD acquisition controls
    [HR-V0-RC-P0.1-file-manifest.csv, gripper-datum-control-p0.1.csv, gripper-source-availability-p0.1.csv, hr-v0-gripper-cad-acquisition-template.csv, hr-v0-gripper-datum-metrology-template.csv, procedure-registry.csv]
2026-08-08 Reconcile unpowered mechanical evaluation batch
    [HR-V0-RC-P0.1-file-manifest.csv, bom.csv, hr-v0-bom-closure.csv, hr-v0-energization-gates.csv, hr-v0-evaluation-batch-a.csv, hr-v0-unpowered-mechanical-evaluation.csv, mechanical-assembly-components.csv]
2026-08-08 Add dimensioned HR-V0 guard candidate
    [HR-V0-RC-P0.1-file-manifest.csv, HR-V0_fixed-guard-receiver-candidate.step, guard-calculation-screen.csv, guard-closure-holds.csv, guard-frame-cut-schedule.csv, guard-interface-controls.csv, guard-panel-cut-schedule.csv, guard-source-register.csv]
2026-08-08 Add catalog-bound HR-V0 guard candidate
    [HR-V0-RC-P0.1-file-manifest.csv, HR-V0_fixed-guard-receiver-candidate.step, bom.csv, guard-calculation-screen.csv, guard-catalog-candidates.csv, guard-closure-holds.csv, guard-frame-cut-schedule.csv, guard-interface-controls.csv]
2026-08-08 Add guard retention and mass evaluation study
    [HR-V0-RC-P0.1-file-manifest.csv, HR-V0_fixed-guard-receiver-candidate.step, bom.csv, guard-catalog-candidates.csv, guard-gasket-edge-schedule.csv, guard-gasket-stock-plan.csv, guard-mass-options.csv, guard-mass-screen.csv]
2026-08-08 Add HR-V0 guard impact allocation basis
    [HR-V0-RC-P0.1-file-manifest.csv, impact-direction-matrix.csv, impact-energy-cases.csv, impact-input-register.csv, impact-source-register.csv, impact-test-controls.csv]
2026-08-08 Add R78 dynamic characterization evidence package
    [HR-V0-RC-P0.1-file-manifest.csv, HR-V0_guard_receiver_envelope_NOT_RELEASED.step, HR-V0_preliminary_assembly.step, MV0-001_upper_link_PROFILE_ONLY_RFQ.dxf, MV0-001_upper_link_PROFILE_ONLY_RFQ.step, MV0-001_upper_link_plate.dxf, MV0-001_upper_link_plate.step, MV0-002_forearm_link_PROFILE_ONLY_RFQ.dxf]
2026-08-08 Add R79 E2 hardware slice and Electrical V3-P1.9
    [01_external_sources.kicad_sch, 02_estop_eligibility.kicad_sch, 03_arm_watchdog_eligibility.kicad_sch, 04_contactor_edm.kicad_sch, 05_actuator_interruption.kicad_sch, 06_branches_and_injection.kicad_sch, 07_watchdog_control.kicad_sch, 08_watchdog_feedback_interface.kicad_sch]
2026-08-08 Record R79 clean-clone validation
    [HR-V0-RC-P0.1-file-manifest.csv]
2026-08-08 Add held 24V source interface candidate
    [01_external_sources.kicad_sch, 02_estop_eligibility.kicad_sch, 03_arm_watchdog_eligibility.kicad_sch, 04_contactor_edm.kicad_sch, 05_actuator_interruption.kicad_sch, 06_branches_and_injection.kicad_sch, 07_watchdog_control.kicad_sch, 08_watchdog_feedback_interface.kicad_sch]
2026-08-08 Record R80 clean-clone verification
    [HR-V0-RC-P0.1-file-manifest.csv]
2026-08-08 Issue R81 24 V factory-cord correction
    [01_external_sources.kicad_sch, 02_estop_eligibility.kicad_sch, 03_arm_watchdog_eligibility.kicad_sch, 04_contactor_edm.kicad_sch, 05_actuator_interruption.kicad_sch, 06_branches_and_injection.kicad_sch, 07_watchdog_control.kicad_sch, 08_watchdog_feedback_interface.kicad_sch]
2026-08-08 Normalize R81 release review artifacts
    [HR-V0-RC-P0.1-file-manifest.csv]
2026-08-08 Refresh R81 release manifest
    [HR-V0-RC-P0.1-file-manifest.csv]
2026-08-08 Issue R82 compute and debug interface correction
    [01_external_sources.kicad_sch, 02_estop_eligibility.kicad_sch, 03_arm_watchdog_eligibility.kicad_sch, 04_contactor_edm.kicad_sch, 05_actuator_interruption.kicad_sch, 06_branches_and_injection.kicad_sch, 07_watchdog_control.kicad_sch, 08_watchdog_feedback_interface.kicad_sch]
2026-08-08 Normalize R82 clean-clone text artifacts
    [HR-V0-RC-P0.1-file-manifest.csv]
2026-08-08 Record R82 clean-clone validation
    [HR-V0-RC-P0.1-file-manifest.csv]
2026-08-08 Add R83 hard-stop region evidence
    [HR-V0-RC-P0.1-file-manifest.csv, SOURCE-MANIFEST.csv, mechanical-interface-control.csv, mechanical-release-data.csv, stop-interface-measurement-register.csv, stop-region-clearance-samples.csv, stop-region-continuous-cells.csv, stop-region-continuous-summary.csv]
2026-08-08 Record R83 clean-clone validation
    [HR-V0-RC-P0.1-file-manifest.csv]
2026-08-08 Add R84 unpowered joint metrology package
    [HR-V0-RC-P0.1-file-manifest.csv, SOURCE-MANIFEST.csv, article-allocation.csv, hold-point-register.csv, hr-v0-joint-stack-metrology-template.csv, hsi-trace.csv, instrument-capability-register.csv, operation-sequence.csv]
2026-08-08 Record R84 clean-clone validation
    [HR-V0-RC-P0.1-file-manifest.csv]
2026-08-08 Add R85 evaluation acquisition packet
    [HR-V0-RC-P0.1-file-manifest.csv, cost-snapshot.csv, decision-hold-register.csv, hr-v0-evaluation-acquisition-authorization-template.csv, hr-v0-metrology-provider-response-template.csv, metrology-rfq-question-register.csv, procedure-registry.csv, provider-capability-register.csv]
2026-08-08 Record R85 clean-clone validation
    [HR-V0-RC-P0.1-file-manifest.csv]
2026-08-08 Add R86 watchdog dependent-failure package
    [HR-V0-RC-P0.1-file-manifest.csv, common-cause-group-register.csv, exact-path-register.csv, failure-mode-register.csv, fault-injection-matrix.csv, hr-v0-watchdog-boundary-fmea.csv, hr-v0-watchdog-fault-injection-template.csv, hr-v0-watchdog-separation-inspection-template.csv]
2026-08-08 Record R86 clean-clone validation
    [HR-V0-RC-P0.1-file-manifest.csv]
2026-08-08 Add R87 watchdog-gated SR1 supply correction
    [01_external_sources.kicad_sch, 02_estop_eligibility.kicad_sch, 03_arm_watchdog_eligibility.kicad_sch, 04_contactor_edm.kicad_sch, 05_actuator_interruption.kicad_sch, 06_branches_and_injection.kicad_sch, 07_watchdog_control.kicad_sch, 08_watchdog_feedback_interface.kicad_sch]
2026-08-08 Record R87 remote clean-clone validation
    [HR-V0-RC-P0.1-file-manifest.csv]
2026-08-08 Add watchdog PCB CAM review and build traveler
    [HR-V0-RC-P0.1-file-manifest.csv, assembly-bom.csv, e2-blocking-holds.csv, e2-configuration-slice.csv, fabrication-holds.csv, fabrication-parameters.csv, file-manifest.csv, hr-v0-watchdog-pcb-cam-review-template.csv]
2026-08-08 Correct watchdog PCB land patterns and supersede P0.5 CAM
    [07_watchdog_control.kicad_sch, 08_watchdog_feedback_interface.kicad_sch, HR-V0-RC-P0.1-file-manifest.csv, SOURCE-MANIFEST.csv, backplate-layout.csv, e2-blocking-holds.csv, e2-configuration-slice.csv, exact-path-register.csv]
2026-08-08 Add R90 Boston fabrication route correction
    [HR-V0-RC-P0.1-file-manifest.csv, geometry-file-register.csv, hr-v0-r69-fabrication-inquiry-template.csv, hr-v0-r69-fabrication-route-register.csv, route-comparison.csv, source-register.csv]
2026-08-08 Add R91 elbow and mass architecture hold
    [HR-V0-RC-P0.1-file-manifest.csv, architecture-holds.csv, source-register.csv, trade-study.csv, vendor-file-register.csv]
2026-08-08 Add R92 exact-coordinate X430 elbow candidate
    [HR-V0-RC-P0.1-file-manifest.csv, P08-C01_X430_fixed-catch-adapter.step, P08-C02_X430_moving-striker-adapter.step, SOURCE-MANIFEST.csv, architecture-holds.csv, collision-sweep.csv, hard-stop-sweep.csv, interface-feature-evidence.csv]
2026-08-08 Add R93 integrated X430 arm candidate
    [HR-V0-RC-P0.1-file-manifest.csv, P09-C01_X430_fixed-catch-adapter.step, P09-C02_X430_moving-striker-adapter.step, SOURCE-MANIFEST.csv, architecture-holds.csv, continuous-clearance-cells.csv, continuous-clearance-summary.csv, fastener-stack-requirements.csv]
2026-08-08 Add R94 X430 stop clearance candidate
    [HR-V0-RC-P0.1-file-manifest.csv, P10-C02_X430_relief-moving-striker.step, SOURCE-MANIFEST.csv, architecture-holds.csv, certificate-supersession-basis.csv, continuous-clearance-cells.csv, continuous-clearance-summary.csv, critical-clearance-and-stop-sweep.csv]
2026-08-08 Add R95 X430 lowered forearm candidate
    [HR-V0-RC-P0.1-file-manifest.csv, P11-C02_X430_lowered-forearm-moving-striker.step, SOURCE-MANIFEST.csv, architecture-holds.csv, certificate-supersession-basis.csv, continuous-clearance-cells.csv, continuous-clearance-summary.csv, critical-clearance-and-stop-sweep.csv]
2026-08-08 Add R96 X430 moving load basis
    [HR-V0-RC-P0.1-file-manifest.csv, SOURCE-MANIFEST.csv, component-mass-properties.csv, gravity-envelope.csv, inertia-energy-sensitivity.csv, open-input-register.csv, source-register.csv, stop-load-sensitivity.csv]
2026-08-08 Add R97 FR12 mass metrology route
    [HR-V0-RC-P0.1-file-manifest.csv, SOURCE-MANIFEST.csv, commerce-weight-conflict.csv, evaluation-article-allocation.csv, hr-v0-fr12-mass-repeat-template.csv, hr-v0-fr12-moving-subassembly-measurement-template.csv, mass-radius-bound-sensitivity.csv, received-measurement-plan.csv]
2026-08-08 Add R98 X430 duty characterization route
    [HR-V0-RC-P0.1-file-manifest.csv, acceptance-equation-register.csv, current-torque-sensitivity.csv, duty-test-sequence.csv, fixture-control-register.csv, hr-v0-x430-duty-characterization-template.csv, instrument-channel-register.csv, open-hold-register.csv]
2026-08-08 Add X430 reaction-torque fixture topology
    [HR-V0-RC-P0.1-file-manifest.csv, geometry-control.csv, hr-v0-x430-duty-fixture-inspection-template.csv, instrument-candidate-register.csv, interface-register.csv, load-path-screen.csv, open-hold-register.csv, source-register.csv]
2026-08-08 Add R100 X430 fixture adapter interface
    [FX100-C01_fixed_adapter_review.step, FX100-C02_active_adapter_review.step, HR-V0-RC-P0.1-file-manifest.csv, adapter-interface-stack.csv, collision-clearance.csv, fastener-stack.csv, load-screen.csv, open-hold-register.csv]
2026-08-08 Add R101 X430 fixture support route
    [FX101-C01_40006-BP_central-machining-review.step, HR-V0-RC-P0.1-file-manifest.csv, open-hold-register.csv, source-register.csv, support-bom.csv, support-load-screen.csv, support-rfi.csv, topology-trade.csv]
2026-08-08 Add R102 X430 horizontal load-rig route
    [HR-V0-RC-P0.1-file-manifest.csv, alignment-tolerance-register.csv, interface-register.csv, load-capacity-screen.csv, load-device-bom.csv, open-hold-register.csv, power-thermal-register.csv, source-register.csv]
2026-08-08 Add R103 X430 output interface evidence
    [FX103-C01_HN12_to_15mm_stub_review.step, HR-V0-RC-P0.1-file-manifest.csv, adapter-feature-register.csv, calculation-screen.csv, candidate-bom.csv, collision-register.csv, interface-tolerance-register.csv, open-hold-register.csv]
2026-08-08 Add R104 brake support and PT profile correction
    [FX104-C01_4866_to_PT_adapter_review.step, HR-V0-RC-P0.1-file-manifest.csv, brake-support-bom.csv, calculation-screen.csv, dimension-register.csv, erratum-register.csv, interface-register.csv, open-hold-register.csv]
2026-08-08 Add R105 FX104 adapter fabrication candidate
    [FX104-C01_P0.1_fabrication_candidate.step, HR-V0-RC-P0.1-file-manifest.csv, SOURCE-MANIFEST.csv, analysis-register.csv, dfm-rfi.csv, feature-register.csv, inspection-plan.csv, material-process-register.csv]
2026-08-08 Add R106 two-piece output adapter correction
    [FX103-C01_P0.2_horn_flange.step, FX103-C02_P0.1_shaft_flange.step, FX103_output_adapter_P0.2_review.step, HR-V0-RC-P0.1-file-manifest.csv, SOURCE-MANIFEST.csv, analysis-register.csv, dfm-rfi.csv, feature-register.csv]
2026-08-08 Add R107 output adapter fastener-stack correction
    [FX103-C01_P0.3_horn_flange.step, FX103-C02_P0.1_shaft_flange.step, FX103_output_adapter_P0.3_review.step, HR-V0-RC-P0.1-file-manifest.csv, SOURCE-MANIFEST.csv, analysis-register.csv, assembly-sequence.csv, dfm-rfi.csv]
2026-08-08 Add R108 gripper acquisition correction
    [HR-V0-RC-P0.1-file-manifest.csv, bom.csv, hr-v0-bom-closure.csv, hr-v0-gripper-acquisition-candidate-p0.1.csv, hr-v0-gripper-kit-contents.csv, robotis-gripper-orderable-source-register-p0.1.csv]
2026-08-08 Control official ROBOTIS gripper frame sources
    [HR-V0-RC-P0.1-file-manifest.csv]
2026-08-08 Record current ROBOTIS gripper source route
    [HR-V0-RC-P0.1-file-manifest.csv, robotis-gripper-source-route-p0.2.csv, robotis-onshape-element-index-p0.1.csv]
2026-08-08 Add source-controlled HR-V0 gripper alternatives
    [HR-V0-RC-P0.1-file-manifest.csv, gripper-alternative-interface-holds-p0.1.csv, hr-v0-feedback-servo-gripper-interface-p0.1.csv, hr-v0-gripper-alternative-trade-p0.1.csv]
2026-08-08 Add R112 gripper adapter and native control interface
    [01_gripper_interface.kicad_sch, HR-V0-RC-P0.1-file-manifest.csv, SOURCE-MANIFEST.csv, analysis-register.csv, bom.csv, collision-register.csv, connector-schedule.csv, feature-register.csv]
2026-08-08 Correct HR-V0 gripper selection baseline
    [HR-V0-RC-P0.1-file-manifest.csv, SOURCE-MANIFEST.csv, hr-v0-gripper-alternative-trade-p0.1.csv, hr-v0-gripper-requirement-compliance-p0.1.csv, hr-v0-gripper-requirement-decision-p0.1.csv, hr-v0-pololu-gripper-adapter-p0.1.step]
2026-08-08 Synchronize HR-V0 object and handoff evidence
    [HR-V0-RC-P0.1-file-manifest.csv, hr-v0-controlled-object-metrology-template.csv, hr-v0-gripper-requirement-decision-p0.1.csv, hr-v0-handoff-endurance-100-cycle-template.csv, hr-v0-handoff-endurance-summary-template.csv, procedure-registry.csv, requirements.csv]
2026-08-08 Control FR12-H104K source provenance
    [HR-V0-RC-P0.1-file-manifest.csv, gripper-h104-source-disposition-p0.1.csv]
2026-08-09 Control PNOZ path conformance
    [02_estop_eligibility.kicad_sch, 03_arm_watchdog_eligibility.kicad_sch, HR-V0-RC-P0.1-file-manifest.csv, SOURCE-MANIFEST.csv, bom.csv, hr-v0-pnoz-path-conformance-p0.1.csv, robotis-gripper-source-route-p0.2.csv]
2026-08-09 Control K1 K2 application closure
    [HR-V0-RC-P0.1-file-manifest.csv, hr-v0-contactor-interruption-characterization-template-p0.1.csv, hr-v0-energization-gates.csv, hr-v0-lc1d25bd-application-inputs-p0.2.csv]
2026-08-09 Control grounding and bonding closure
    [HR-V0-RC-P0.1-file-manifest.csv, hr-v0-energization-gates.csv, hr-v0-grounding-bonding-survey-template-p0.1.csv, hr-v0-grounding-node-register-p0.1.csv, hr-v0-grounding-selection-matrix-p0.1.csv]
2026-08-09 Add exact held Raspberry Pi compute candidates
    [01_external_sources.kicad_sch, 02_estop_eligibility.kicad_sch, 03_arm_watchdog_eligibility.kicad_sch, 04_contactor_edm.kicad_sch, 05_actuator_interruption.kicad_sch, 06_branches_and_injection.kicad_sch, 07_watchdog_control.kicad_sch, 08_watchdog_feedback_interface.kicad_sch]
2026-08-09 Add R120 compute subassembly evidence package
    [HR-V0-RC-P0.1-file-manifest.csv, bom.csv, hr-v0-bom-closure.csv, hr-v0-compute-image-build-template-p0.1.csv, hr-v0-compute-subassembly-p0.1.csv, hr-v0-compute-subassembly-receiving-template-p0.1.csv, hr-v0-energization-gates.csv]
2026-08-09 Add R121 compute installation candidate
    [HR-V0-RC-P0.1-file-manifest.csv, backplate-layout.csv, bom.csv, cable-entry-schedule.csv, compute-installation-holds.csv, door-layout.csv, hr-v0-bom-closure.csv, hr-v0-compute-installation-receiving-template-p0.1.csv]
2026-08-09 Add R122 U2D2 USB cable candidate
    [HR-V0-RC-P0.1-file-manifest.csv, backplate-layout.csv, bom.csv, cable-entry-schedule.csv, compute-installation-holds.csv, hr-v0-bom-closure.csv, hr-v0-compute-installation-receiving-template-p0.1.csv, hr-v0-energization-gates.csv]
2026-08-09 Add R123 panel rail and duct correction
    [HR-V0-RC-P0.1-file-manifest.csv, backplate-layout.csv, bom.csv, hr-v0-bom-closure.csv, hr-v0-energization-gates.csv, hr-v0-panel-rail-duct-installation-template-p0.1.csv, hr-v0-panel-rail-duct-receiving-template-p0.1.csv, panel-bom.csv]
2026-08-09 Add R124 stopping budget correction
    [HR-V0-RC-P0.1-file-manifest.csv, hr-v0-energization-gates.csv, hr-v0-stopping-budget-p0.1.csv, hr-v0-stopping-time-template-p0.1.csv]
2026-08-09 Add R125 passive power-loss containment
    [HR-V0-RC-P0.1-file-manifest.csv, hr-v0-energization-gates.csv, hr-v0-power-loss-containment-template-p0.1.csv, power-loss-energy-bound.csv, power-loss-strategy.csv]
2026-08-09 Add R126 continuous collapse envelope
    [HR-V0-RC-P0.1-file-manifest.csv, HR-V0_collapse-envelope-review.step, SOURCE-MANIFEST.csv, collapse-envelope-components.csv, guard-fit-screen.csv, hr-v0-collapse-envelope-metrology-template-p0.1.csv, hr-v0-energization-gates.csv, receiver-role-disposition.csv]
2026-08-09 Add R127 passive arm receiver candidate
    [HR-V0-RC-P0.1-file-manifest.csv, HR-V0_passive-arm-receiver-candidate.step, SOURCE-MANIFEST.csv, absorber-application-screen.csv, commanded-envelope-screen.csv, hr-v0-energization-gates.csv, hr-v0-passive-arm-receiver-template-p0.1.csv, receiver-closure-holds.csv]
2026-08-09 Add R128 receiver verification
    [HR-V0-RC-P0.1-file-manifest.csv, SOURCE-MANIFEST.csv, analytic-envelope-verification.csv, arithmetic-rederivation.csv, hr-v0-energization-gates.csv, method-register.csv, receiver-guard-fit-verification.csv]
2026-08-09 Add R129 detailed receiver candidate
    [FAB-REC-001-platen-blank.dxf, FAB-REC-001-platen-blank.step, FAB-REC-002-shock-plate-blank.dxf, FAB-REC-002-shock-plate-blank.step, FAB-REC-003-guide-tab-blank.dxf, FAB-REC-003-guide-tab-blank.step, HR-V0-RC-P0.1-file-manifest.csv, HR-V0_passive-arm-receiver-detail-candidate.step]
2026-08-09 Add R130 corrected receiver guide interface
    [FAB-REC-004-guide-angle-hole-free-envelope.step, HR-V0-RC-P0.1-file-manifest.csv, HR-V0_receiver-guide-interface-review.step, SOURCE-MANIFEST.csv, catalog-coordinate-register.csv, closure-holds.csv, hole-center-control.csv, hr-v0-energization-gates.csv]
2026-08-09 Add R131 watchdog PCB mounting reconciliation
    [HR-V0-RC-P0.1-file-manifest.csv, SOURCE-MANIFEST.csv, closure-holds.csv, current-board-reconciliation.csv, hr-v0-energization-gates.csv, interface-screen.csv, mount-coordinate-register.csv, receiving-template.csv]
2026-08-09 Add R132 watchdog PCBA capability package
    [HR-V0-RC-P0.1-file-manifest.csv, SOURCE-MANIFEST.csv, assembly-requirements.csv, backplate-layout.csv, capability-question-register.csv, closure-holds.csv, controlled-file-release-register.csv, current-geometry-conformance-register.csv]
2026-08-09 Add R133 watchdog PCBA assembly data
    [HR-V0-RC-P0.1-file-manifest.csv, SOURCE-MANIFEST.csv, assembly-data-file-state.csv, assembly-data-holds.csv, assembly-note-register.csv, assembly-placement-reference.csv, board-assembly-bom.csv, closure-holds.csv]
2026-08-09 Add R134 mechanical DFM review data
    [HR-V0-RC-P0.1-file-manifest.csv, dfm-question-register.csv, first-article-plan.csv, geometry-file-register.csv, hold-register.csv, inspection-control-register.csv, part-register.csv]
2026-08-09 Add R135 mechanical geometry parity audit
    [HR-V0-RC-P0.1-file-manifest.csv, drawing-control-coverage.csv, feature-parity.csv, finding-register.csv, profile-parity.csv]
2026-08-09 Add R136 countersink MBD correction candidate
    [HR-V0-RC-P0.1-file-manifest.csv, MV0-C01_rect32x16_to_20-2040_countersunk_adapter_P0.8_nominal-countersink-candidate.step, MV0-C04_H104_to_20-2040_countersunk_adapter_P0.8_nominal-countersink-candidate.step, MV0-C06_J2_positive_moving_striker_adapter_P0.8_nominal-countersink-candidate.step, MV0-C07_J2_positive_fixed_catch_adapter_P0.8_nominal-countersink-candidate.step, SOURCE-MANIFEST.csv, decis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]
2026-08-09 Add R137 conventional manufacturing drawing candidate
    [HR-V0-RC-P0.1-file-manifest.csv, MV0-C01_finished-profile-and-features_P0.1.dxf, MV0-C04_finished-profile-and-features_P0.1.dxf, MV0-C05_finished-profile-and-features_P0.1.dxf, MV0-C06_finished-profile-and-features_P0.1.dxf, MV0-C07_finished-profile-and-features_P0.1.dxf, SOURCE-MANIFEST.csv, drawing-control-coverage.csv]
2026-08-09 Add R138 watchdog IC metadata correction
    [HR-V0-RC-P0.1-file-manifest.csv, SOURCE-MANIFEST.csv, footprint-metadata-register.csv, pcb-p0.7-geometry-topology-baseline.json, pcb-p0.8-geometry-topology-current.json, project-button-v3.kicad_pcb, source-register.csv]
2026-08-09 Add R139 current watchdog assembly identity
    [HR-V0-RC-P0.1-file-manifest.csv, SOURCE-MANIFEST.csv, assembly-data-file-state.csv, assembly-data-holds.csv, assembly-note-register.csv, assembly-parity-p0.7-to-p0.9.csv, assembly-placement-reference.csv, board-assembly-bom.csv]
2026-08-09 Add R140 HR-V0 frame convention
    [HR-V0-RC-P0.1-file-manifest.csv, SOURCE-MANIFEST.csv, coordinate-convention-holds.csv, frame-register.csv, hr-v0-coordinate-calibration-template-p0.1.csv, joint-sign-register.csv, legacy-layout-mapping.csv, mirroring-register.csv]
2026-08-09 Add R141 governance control
    [HR-V0-RC-P0.1-file-manifest.csv, gate-control-register.csv, governance-holds.csv, requirement-atomicity-review.csv, requirement-control-register.csv, risk-control-register.csv, source-register.csv]
2026-08-09 Add R142 atomic requirements
    [HR-V0-RC-P0.1-file-manifest.csv, atomic-requirement-holds.csv, atomic-requirements.csv, gate-control-register.csv, governance-holds.csv, parent-decomposition-summary.csv, requirement-atomicity-review.csv, requirement-control-register.csv]
2026-08-09 Add R143 atomicity audit
    [HR-V0-RC-P0.1-file-manifest.csv, atomic-requirement-holds.csv, atomic-requirements.csv, child-acceptance-record-template.csv, gate-control-register.csv, governance-holds.csv, internal-atomicity-audit.csv, parent-decomposition-summary.csv]
2026-08-09 Add R144 integrated build traveler
    [HR-V0-RC-P0.1-file-manifest.csv, build-phases.csv, build-steps.csv, gate-phase-matrix.csv, hold-points.csv, source-register.csv]
2026-08-09 Add R145 evaluation acquisition packet
    [HR-V0-RC-P0.1-file-manifest.csv, hr-v0-evaluation-batch-a-authorization-template.csv, line-register.csv, lot-register.csv, purchase-authorization-register.csv, source-register.csv]
2026-08-09 Add R146 unit receiving campaign
    [HR-V0-RC-P0.1-file-manifest.csv, evidence-file-manifest-template.csv, gate-control-register.csv, gate-phase-matrix.csv, hr-v0-energization-gates.csv, hr-v0-evaluation-batch-a-unit-receiving-template-p0.1.csv, quarantine-label-register.csv, receiving-traveler.csv]
2026-08-09 Add R147 actuator AC cord candidate
    [HR-V0-RC-P0.1-file-manifest.csv, bom.csv, gate-control-register.csv, gate-phase-matrix.csv, hr-v0-actuator-ac-cord-receiving-template-p0.1.csv, hr-v0-actuator-ac-cord-site-fit-template-p0.1.csv, hr-v0-bom-closure.csv, hr-v0-energization-gates.csv]
2026-08-09 Add R148 P0.7 mechanical BOM binding
    [HR-V0-RC-P0.1-file-manifest.csv, bom.csv, gate-control-register.csv, gate-phase-matrix.csv, hr-v0-bom-closure.csv, hr-v0-energization-gates.csv, hr-v0-mechanical-custom-part-binding.csv, source-register.csv]
2026-08-09 Add R149 watchdog PCB BOM binding
    [HR-V0-RC-P0.1-file-manifest.csv, bom.csv, gate-control-register.csv, gate-phase-matrix.csv, hr-v0-bom-closure.csv, hr-v0-energization-gates.csv, hr-v0-watchdog-pcb-binding.csv, source-register.csv]
2026-08-09 Add R150 current watchdog CAM review package
    [HR-V0-RC-P0.1-file-manifest.csv, bom.csv, cam-assembly-parity.csv, cam-output-register.csv, cam-release-holds.csv, file-manifest.csv, gate-control-register.csv, gate-phase-matrix.csv]
2026-08-09 Add R151 DXL star manufacturing review package
    [HR-V0-RC-P0.1-file-manifest.csv, assembly-bom-register.csv, bom.csv, cam-output-register.csv, file-manifest.csv, gate-control-register.csv, gate-phase-matrix.csv, hr-v0-bom-closure.csv]
2026-08-09 Record R151 clean validation
    [HR-V0-RC-P0.1-file-manifest.csv]
2026-08-09 Add R152 DXL injection allocation binding
    [HR-V0-RC-P0.1-file-manifest.csv, allocation-parity.csv, bom-allocation-binding.csv, bom.csv, file-manifest.csv, hr-v0-bom-closure.csv, residual-holds.csv, source-register.csv]
2026-08-09 Add R153 DXL harness allocation correction
    [HR-V0-RC-P0.1-file-manifest.csv, acceptance-matrix.csv, bom.csv, connector-bom-parity.csv, controller-cable-pinmap.csv, current-qualification-template.csv, file-manifest.csv, harness-allocation.csv]
2026-08-09 Add R154 DXL current envelope controls
    [HR-V0-RC-P0.1-file-manifest.csv, HR-V0_guard_receiver_envelope_NOT_RELEASED.step, HR-V0_preliminary_assembly.step, MV0-001_upper_link_PROFILE_ONLY_RFQ.dxf, MV0-001_upper_link_PROFILE_ONLY_RFQ.step, MV0-001_upper_link_plate.dxf, MV0-001_upper_link_plate.step, MV0-002_forearm_link_PROFILE_ONLY_RFQ.dxf]
2026-08-09 Add R155 DXL protection evaluation
    [01_branch_1.kicad_sch, 02_branch_2.kicad_sch, 03_branch_3.kicad_sch, 04_regeneration_clamp.kicad_sch, HR-V0-RC-P0.1-file-manifest.csv, SOURCE-MANIFEST.csv, acceptance-matrix.csv, bom.csv]
2026-08-09 Add R156 DXL protection carrier candidate
    [01_protection_core.kicad_sch, 02_threshold_dividers.kicad_sch, 03_bypass_and_transients.kicad_sch, 04_measurement_points.kicad_sch, HR-V0-RC-P0.1-file-manifest.csv, assembly-variants.csv, bom.csv, file-manifest.csv]
2026-08-09 Add R157 branch fault validation package
    [HR-V0-RC-P0.1-file-manifest.csv, gate-control-register.csv, hr-v0-branch-fault-matrix-p0.1.csv, hr-v0-branch-fault-validation-template.csv, hr-v0-energization-gates.csv, source-register.csv]
2026-08-09 Add R158 corrected RPW carrier candidate
    [01_protection_core.kicad_sch, 02_threshold_dividers.kicad_sch, 03_bypass_and_transients.kicad_sch, 04_measurement_points.kicad_sch, HR-V0-RC-P0.1-file-manifest.csv, assembly-variants.csv, bom.csv, file-manifest.csv]
2026-08-09 Add R159 carrier DFM inquiry package
    [01_protection_core.kicad_sch, 02_threshold_dividers.kicad_sch, 03_bypass_and_transients.kicad_sch, 04_measurement_points.kicad_sch, HR-V0-RC-P0.1-file-manifest.csv, assembly-variants.csv, bom.csv, file-manifest.csv]
2026-08-09 Add R160 carrier harness interface controls
    [HR-V0-RC-P0.1-file-manifest.csv, acceptance-matrix.csv, cut-crimp-schedule.csv, file-manifest.csv, harness-bom.csv, interface-control.csv, manufacturing-process.csv, primary-source-register.csv]
2026-08-09 Add R161 carrier-integrated ECAD candidate
    [01_external_sources.kicad_sch, 01_star_injection.kicad_sch, 02_estop_eligibility.kicad_sch, 03_arm_watchdog_eligibility.kicad_sch, 04_contactor_edm.kicad_sch, 05_actuator_interruption.kicad_sch, 06_branches_and_limiters.kicad_sch, 07_watchdog_control.kicad_sch]
2026-08-09 Add R162 no-drill carrier mounting interface
    [HR-V0-RC-P0.1-file-manifest.csv, acceptance-matrix.csv, clearance-screen.csv, file-manifest.csv, hardware-bom.csv, hole-coordinate-register.csv, no-drill-metrology-form.csv, source-register.csv]
2026-08-09 Add R163 carrier configuration reconciliation
    [HR-V0-RC-P0.1-file-manifest.csv, acceptance-matrix.csv, bom-integration-map.csv, bom.csv, cam-output-register.csv, current-configuration-map.csv, file-manifest.csv, gate-control-register.csv]
2026-08-09 Add R164 current DXL-star manufacturing review
    [HR-V0-RC-P0.1-file-manifest.csv, assembly-bom-register.csv, bom-integration-map.csv, bom.csv, cam-output-register.csv, current-configuration-map.csv, file-manifest.csv, gate-control-register.csv]
2026-08-09 Add R165 P1.15 watchdog E2 parity
    [HR-V0-RC-P0.1-file-manifest.csv, acceptance-matrix.csv, component-parity-register.csv, current-configuration-map.csv, e2-blocking-holds.csv, e2-configuration-slice.csv, e2-scope-register.csv, e2-source-register.csv]
2026-08-10 Add R166 P1.15-bound watchdog CAM
    [HR-V0-RC-P0.1-file-manifest.csv, bom.csv, cam-assembly-parity.csv, cam-output-register.csv, cam-release-holds.csv, current-configuration-map.csv, e2-configuration-slice.csv, file-manifest.csv]
2026-08-10 Add R167 Boston fabrication capability refresh
    [HR-V0-RC-P0.1-file-manifest.csv, file-manifest.csv, open-design-inputs.csv, route-comparison.csv, source-hash-register.csv, source-register.csv]
2026-08-10 Add R168 exact XT1 terminal group
    [HR-V0-RC-P0.1-file-manifest.csv, accessory-allocation.csv, bom.csv, file-manifest.csv, hr-v0-bom-closure.csv, hr-v0-gate-evidence-supplement-r168.csv, open-holds.csv, source-hash-register.csv]
2026-08-10 Add R169 panel identification system
    [HR-V0-RC-P0.1-file-manifest.csv, accessory-allocation.csv, bom.csv, device-marker-schedule.csv, file-manifest.csv, hr-v0-bom-closure.csv, hr-v0-gate-evidence-supplement-r169.csv, large-legend-schedule.csv]
2026-08-10 Add R170 exact compute storage candidate
    [HR-V0-RC-P0.1-file-manifest.csv, bom.csv, file-manifest.csv, hr-v0-bom-closure.csv, hr-v0-compute-storage-holds-p0.2.csv, hr-v0-compute-storage-p0.2.csv, hr-v0-compute-storage-receiving-template-p0.2.csv, hr-v0-gate-evidence-supplement-r170.csv]
2026-08-10 Add R171 fail-closed host deployment package
    [HR-V0-RC-P0.1-file-manifest.csv, SOURCE-MANIFEST.csv, file-manifest.csv, gate-control-register.csv, gate-phase-matrix.csv, hold-register.csv, hr-v0-energization-gates.csv, hr-v0-gate-evidence-supplement-r171.csv]
2026-08-10 Add R172 Raspberry Pi OS SBOM package lock
    [HR-V0-RC-P0.1-file-manifest.csv, SOURCE-MANIFEST.csv, critical-package-register.csv, dpkg-package-lock.csv, file-manifest.csv, gate-control-register.csv, gate-phase-matrix.csv, hr-v0-energization-gates.csv]
2026-08-10 Add R173 fabrication input reconciliation
    [HR-V0-RC-P0.1-file-manifest.csv, file-manifest.csv, gate-control-register.csv, gate-phase-matrix.csv, hr-v0-energization-gates.csv, hr-v0-gate-evidence-supplement-r173.csv, input-reconciliation.csv, kinematic-screens.csv]
2026-08-10 Add R174 dynamic trace analysis
    [HR-V0-RC-P0.1-file-manifest.csv, acceptance-rule-register.csv, event-channel-extension.csv, fail-early-start-trace.csv, fail-integrity-trace.csv, fail-reset-trace.csv, file-manifest.csv, gate-control-register.csv]
2026-08-10 Add R175 dynamic instrumentation backbone
    [HR-V0-RC-P0.1-file-manifest.csv, candidate-bom.csv, channel-allocation.csv, file-manifest.csv, gate-control-register.csv, hr-v0-dynamic-instrumentation-receiving-template-p0.1.csv, hr-v0-energization-gates.csv, hr-v0-gate-evidence-supplement-r175.csv]
2026-08-10 Add R176 isolated dynamic event interface
    [01_field_a.kicad_sch, 02_field_b.kicad_sch, 03_evm_logic.kicad_sch, 04_common_clock_capture.kicad_sch, HR-V0-RC-P0.1-file-manifest.csv, SOURCE-MANIFEST.csv, bom.csv, candidate-bom.csv]
2026-08-10 Add R177 low-loading event acquisition candidate
    [01_field_and_evm_1.kicad_sch, 02_field_and_evm_2.kicad_sch, 03_field_and_evm_3.kicad_sch, 04_logic_outputs_1_4.kicad_sch, 05_logic_outputs_5_7_and_capture.kicad_sch, HR-V0-RC-P0.1-file-manifest.csv, SOURCE-MANIFEST.csv, bom.csv]
2026-08-10 Add R178 event tap disposition
    [01_pilz_inputs.kicad_sch, 02_coil_nodes.kicad_sch, 03_edm_returns.kicad_sch, HR-V0-RC-P0.1-file-manifest.csv, SOURCE-MANIFEST.csv, bom.csv, calculation-screen.csv, connector-schedule.csv]
2026-08-10 Add R179 noncontact event observation route
    [HR-V0-RC-P0.1-file-manifest.csv, closure-holds.csv, conductor-observation-map.csv, e2-comparison-sequence.csv, hr-v0-gate-evidence-supplement-r179.csv, hr-v0-noncontact-event-observation-template.csv, instrument-register.csv, source-register.csv]
2026-08-10 Correct HR-V0 event observation independence
    [HR-V0-RC-P0.1-file-manifest.csv, channel-allocation.csv, closure-holds.csv, diagnostic-load-holds.csv, hr-v0-event-observation-correction-template.csv, hr-v0-gate-evidence-supplement-r180.csv, instrument-register.csv, source-register.csv]
2026-08-10 Correct HR-V0 E2 trace analysis
    [HR-V0-RC-P0.1-file-manifest.csv, acceptance-rule-register.csv, fail-edm-stop-trace.csv, fail-integrity-stop-trace.csv, fail-motion-stop-trace.csv, fail-reset-motion-trace.csv, hr-v0-dynamic-reset-arm-trace-template-p0.2.csv, hr-v0-dynamic-stop-trace-template-p0.2.csv]
2026-08-10 Add R182 E2 acquisition compatibility package
    [HR-V0-RC-P0.1-file-manifest.csv, channel-population.csv, closure-holds.csv, hr-v0-gate-evidence-supplement-r182.csv, manufacturer-inquiry-register.csv, motion-witness-register.csv, probe-power-budget.csv, source-register.csv]
2026-08-10 Add fail-closed Q4X E2 witness interface
    [HR-V0-RC-P0.1-file-manifest.csv, calibration-campaign.csv, closure-holds.csv, configuration-candidate-register.csv, domain-separation-register.csv, equipment-register.csv, hr-v0-gate-evidence-supplement-r183.csv, hr-v0-q4x-receiving-template-p0.1.csv]
2026-08-10 Add connected Q4X interface box candidate
    [01_source_and_protection.kicad_sch, 02_sensor_and_signal.kicad_sch, HR-V0-RC-P0.1-file-manifest.csv, SOURCE-MANIFEST.csv, bom.csv, calculation-register.csv, candidate-bom.csv, closure-holds.csv]
2026-08-10 Add dimensioned Q4X box layout candidate
    [14F0907-review-proxy.stl, HR-V0-RC-P0.1-file-manifest.csv, closure-holds.csv, dimension-register.csv, hr-v0-q4x-box-layout-inspection-p0.1.csv, hr-v0-q4x-box-layout-p0.1.step, panel-layout.csv, source-register.csv]
2026-08-10 Add Q4X installation evidence route
    [HR-V0-RC-P0.1-file-manifest.csv, closure-holds.csv, hr-v0-q4x-hardware-receiving-template-p0.1.csv, installation-evidence.csv, metrology-plan.csv, receiving-lot.csv, source-register.csv, vendor-file-hashes.csv]
2026-08-10 Add R187 unpowered Q4X acquisition decision
    [HR-V0-RC-P0.1-file-manifest.csv, hr-v0-q4x-unpowered-acquisition-authorization-template-p0.1.csv, line-register.csv, lot-register.csv, purchase-decision-register.csv, source-register.csv]
2026-08-10 Add R188 Q4X quote readiness amendment
    [HR-V0-RC-P0.1-file-manifest.csv, cost-reconciliation.csv, line-disposition.csv, source-delta.csv]
2026-08-10 Enforce LF for reproducible engineering checks
    [HR-V0-RC-P0.1-file-manifest.csv]
2026-08-10 Record exact checkout line-ending contract
    [HR-V0-RC-P0.1-file-manifest.csv]
2026-08-10 Remove machine-specific dynamic trace paths
    [HR-V0-RC-P0.1-file-manifest.csv]
2026-08-10 Record clean-clone reproducibility audit
    [HR-V0-RC-P0.1-file-manifest.csv, failure-disposition.csv, hr-v0-gate-evidence-supplement-r189.csv]
2026-08-10 Add source-controlled XC330 gripper feasibility branch
    [HR-V0-RC-P0.1-file-manifest.csv, SOURCE-MANIFEST.csv, candidate-bom.csv, force-screen.csv, hold-register.csv, hr-v0-gate-evidence-supplement-r190.csv, hr-v0-xc330-gripper-base-p0.1.step, hr-v0-xc330-gripper-base-p0.1.stl]
2026-08-10 Add exact XC330 frame and involute gripper interface
    [HR-V0-RC-P0.1-file-manifest.csv, SOURCE-MANIFEST.csv, candidate-bom.csv, clearance-screen.csv, gear-register.csv, hold-register.csv, hole-register.csv, hr-v0-gate-evidence-supplement-r191.csv]
2026-08-10 Add source-bound XC330 wrist integration
    [HR-V0-RC-P0.1-file-manifest.csv, SOURCE-MANIFEST.csv, bridge-register.csv, collision-sweep.csv, contact-clearance-register.csv, fastener-stack-register.csv, hold-register.csv, hole-register.csv]
2026-08-10 Correct gripper native source boundary
    [HR-V0-RC-P0.1-file-manifest.csv, SOURCE-MANIFEST.csv, configuration-decision.csv, file-manifest.csv, hold-register.csv, hr-v0-gate-evidence-supplement-r193.csv, onshape-element-register.csv, source-hash-register.csv]
2026-08-10 Add Boston site readiness evidence
    [HR-V0-RC-P0.1-file-manifest.csv, gate-control-register.csv, gate-phase-matrix.csv, hold-register.csv, hr-v0-energization-gates.csv, hr-v0-gate-evidence-supplement-r194.csv, jurisdiction-register.csv, premises-input-template.csv]
2026-08-10 Direct-bind watchdog PCB to electrical P1.15
    [HR-V0-RC-P0.1-file-manifest.csv, SOURCE-MANIFEST.csv, assembly-data-file-state.csv, assembly-parity-p0.7-to-p1.0.csv, bom.csv, cam-output-register.csv, current-configuration-map.csv, e2-blocking-holds.csv]
2026-08-10 Prove stale command rejection after rearm
    [HR-V0-RC-P0.1-file-manifest.csv, SOURCE-MANIFEST.csv, file-manifest.csv, hr-v0-e2-software-authority-template-p0.1.csv, source-hash-register.csv, source-register.csv]
2026-08-10 Add conservative HR-V0 kinematic speed bound
    [HR-V0-RC-P0.1-file-manifest.csv, SOURCE-MANIFEST.csv, file-manifest.csv, hr-v0-kinematic-speed-bound-p0.1.csv, source-hash-register.csv, source-register.csv]
2026-08-10 Add fail-closed HR-V0 runtime execution boundary
    [HR-V0-RC-P0.1-file-manifest.csv, SOURCE-MANIFEST.csv, file-manifest.csv, hold-register.csv, hr-v0-runtime-execution-boundary-p0.1.csv, overlay-manifest.csv, source-hash-register.csv, source-register.csv]
2026-08-10 Add fail-closed HR-V0 host backend candidates
    [HR-V0-RC-P0.1-file-manifest.csv, SOURCE-MANIFEST.csv, file-manifest.csv, hold-register.csv, hr-v0-runtime-backend-holds-p0.1.csv, hr-v0-runtime-backend-source-register-p0.1.csv, hr-v0-runtime-execution-boundary-p0.1.csv, overlay-manifest.csv]
2026-08-10 Correct HR-V0 runtime observation semantics
    [HR-V0-RC-P0.1-file-manifest.csv, SOURCE-MANIFEST.csv, hold-register.csv, hr-v0-runtime-backend-holds-p0.1.csv, hr-v0-runtime-backend-source-register-p0.1.csv, hr-v0-runtime-execution-boundary-p0.1.csv, hr-v0-runtime-observation-holds-p0.1.csv, hr-v0-runtime-observation-map-p0.1.csv]
2026-08-10 Add HR-V0 runtime observation receiver candidate
    [01_boundaries.kicad_sch, 02_sr1_sra1_inputs.kicad_sch, 03_k1_k2_inputs.kicad_sch, 04_compute_outputs.kicad_sch, HR-V0-RC-P0.1-file-manifest.csv, SOURCE-MANIFEST.csv, bom.csv, connector-schedule.csv]
2026-08-10 Add routed HR-V0 observation carrier candidate
    [01_boundaries.kicad_sch, 02_sr1_sra1_inputs.kicad_sch, 03_k1_k2_inputs.kicad_sch, 04_compute_outputs.kicad_sch, HR-V0-RC-P0.1-file-manifest.csv, SOURCE-MANIFEST.csv, bom.csv, connector-schedule.csv]
2026-08-10 Add fail-closed Raspberry Pi observation pin map
    [HR-V0-RC-P0.1-file-manifest.csv, SOURCE-MANIFEST.csv, conflict-audit.csv, file-manifest.csv, harness-interface.csv, hold-register.csv, hr-v0-runtime-observation-holds-p0.1.csv, pin-allocation.csv]
2026-08-10 Add R204 Pi observation carrier and harness candidate
    [01_pi_observation_carrier.kicad_sch, HR-V0-RC-P0.1-file-manifest.csv, SOURCE-MANIFEST.csv, bom.csv, connector-schedule.csv, harness-interface.csv, hr-v0-pi-observation-carrier-p0.1.kicad_pcb, hr-v0-pi-observation-carrier-p0.1.kicad_sch]
2026-08-10 Add R205 Pi observation panel integration
    [HR-V0-RC-P0.1-file-manifest.csv, SOURCE-MANIFEST.csv, acceptance-matrix.csv, collision-clearance-register.csv, harness-length-calculation.csv, harness-route.csv, interface-parity.csv, mounting-hole-screen.csv]
2026-08-10 Add R206 connected observation system and field harness
    [01_external_sources.kicad_sch, 02_estop_eligibility.kicad_sch, 03_arm_watchdog_eligibility.kicad_sch, 04_contactor_edm.kicad_sch, 05_actuator_interruption.kicad_sch, 06_branches_and_limiters.kicad_sch, 07_watchdog_control.kicad_sch, 08_watchdog_feedback_interface.kicad_sch]
2026-08-10 Add R207 observation compute harness
    [HR-V0-RC-P0.1-file-manifest.csv, SOURCE-MANIFEST.csv, acceptance-matrix.csv, bundle-area-screen.csv, conductor-schedule.csv, electrical-budget-screen.csv, harness-bom.csv, interface-control.csv]
2026-08-10 Add R208 observation compute power boundary
    [HR-V0-RC-P0.1-file-manifest.csv, SOURCE-MANIFEST.csv, acceptance-matrix.csv, fault-matrix.csv, load-budget.csv, manufacturer-question-register.csv, power-state-matrix.csv, selection-holds.csv]
2026-08-11 Add R209 buffered observation carrier
    [01_boundaries.kicad_sch, 02_sr1_sra1_inputs.kicad_sch, 03_k1_k2_inputs.kicad_sch, 04_compute_outputs.kicad_sch, HR-V0-RC-P0.1-file-manifest.csv, SOURCE-MANIFEST.csv, bom.csv, connector-schedule.csv]
2026-08-11 Correct R210 observation carrier footprint
    [01_boundaries.kicad_sch, 02_sr1_sra1_inputs.kicad_sch, 03_k1_k2_inputs.kicad_sch, 04_compute_outputs.kicad_sch, HR-V0-RC-P0.1-file-manifest.csv, SOURCE-MANIFEST.csv, bom.csv, connector-schedule.csv]
2026-08-11 Issue R211 open-drain observation carrier correction
    [01_boundaries.kicad_sch, 02_sr1_sra1_inputs.kicad_sch, 03_k1_k2_inputs.kicad_sch, 04_compute_outputs.kicad_sch, HR-V0-RC-P0.1-file-manifest.csv, SOURCE-MANIFEST.csv, bom.csv, connector-schedule.csv]
2026-08-11 Issue R212 observation system reconciliation
    [01_external_sources.kicad_sch, 02_estop_eligibility.kicad_sch, 03_arm_watchdog_eligibility.kicad_sch, 04_contactor_edm.kicad_sch, 05_actuator_interruption.kicad_sch, 06_branches_and_limiters.kicad_sch, 07_watchdog_control.kicad_sch, 08_watchdog_feedback_interface.kicad_sch]
2026-08-11 Issue R213 corrected mechanical custom-part baseline
    [HR-V0-RC-P0.1-file-manifest.csv, bom.csv, geometry-parity.csv, hr-v0-bom-closure.csv, hr-v0-gate-evidence-supplement-r213.csv, hr-v0-mechanical-custom-part-binding-p0.2.csv, open-holds.csv, source-hash-register.csv]
2026-08-11 Issue R214 integrated P0.8 arm baseline
    [HR-V0-RC-P0.1-file-manifest.csv, HR-V0_J2_positive_stop_contact_candidate.step, MV0-C01_adapter-finished-profile.dxf, MV0-C01_rect32x16_to_20-2040_countersunk_adapter.step, MV0-C02_20-2040_100mm_vertical_collision_envelope.step, MV0-C03_20-2040_50mm_vertical_collision_envelope.step, MV0-C04_H104_to_20-2040_countersunk_adapter.step, MV0-C04_gripper-adapter-finished-profile.dxf]
2026-08-11 Add R215 mechanical manufacturing review package
    [HR-V0-RC-P0.1-file-manifest.csv, authority-boundary.csv, document-precedence.csv, fastener-candidate-register.csv, file-manifest.csv, gate-phase-matrix.csv, hr-v0-energization-gates.csv, hr-v0-gate-evidence-supplement-r215.csv]
2026-08-11 Add E2 evidence parity contract
    [HR-V0-RC-P0.1-file-manifest.csv, case-pairing-register.csv, configuration-identity-register.csv, file-manifest.csv, form-sha256-register.csv, gate-control-register.csv, gate-phase-matrix.csv, hr-v0-e2-authorization-template-p0.2.csv]
2026-08-11 Add current Boston fabrication route
    [HR-V0-RC-P0.1-file-manifest.csv, authority-boundary.csv, capability-inquiry-authorization-template.csv, capability-inquiry-register.csv, configuration-binding.csv, file-manifest.csv, gate-control-register.csv, gate-phase-matrix.csv]
2026-08-11 Add measurable HR-V0 safety requirements
    [HR-V0-RC-P0.1-file-manifest.csv, authority-boundary.csv, common-cause-review-register.csv, configuration-binding.csv, file-manifest.csv, gate-control-register.csv, gate-phase-matrix.csv, hr-v0-energization-gates.csv]
2026-08-11 Add functional safety reviewer route
    [HR-V0-RC-P0.1-file-manifest.csv, authority-boundary.csv, capability-inquiry-authorization-template.csv, capability-inquiry-register.csv, competence-independence-criteria.csv, configuration-binding.csv, deliverable-acceptance-matrix.csv, file-manifest.csv]
2026-08-11 Reconcile current control panel identities
    [HR-V0-RC-P0.1-file-manifest.csv, authority-boundary.csv, board-envelope-parity.csv, closure-register.csv, configuration-binding.csv, current-backplate-layout.csv, current-installation-bom.csv, current-stationary-wire-schedule.csv]
2026-08-11 Define HR-V0 panel conductor basis
    [HR-V0-RC-P0.1-file-manifest.csv, authority-boundary.csv, conductor-family-candidates.csv, configuration-binding.csv, endpoint-conductor-candidate-schedule.csv, engineering-screens.csv, file-manifest.csv, gate-control-register.csv]
2026-08-11 Add explicit HR-V0 panel wiring topology
    [01_external_sources.kicad_sch, 02_estop_eligibility.kicad_sch, 03_arm_watchdog_eligibility.kicad_sch, 04_contactor_edm.kicad_sch, 05_actuator_interruption.kicad_sch, 06_branches_and_limiters.kicad_sch, 07_watchdog_control.kicad_sch, 08_watchdog_feedback_interface.kicad_sch]
2026-08-11 Place HR-V0 panel topology nodes
    [HR-V0-RC-P0.1-file-manifest.csv, acceptance-matrix.csv, authority-boundary.csv, bom-integration-map.csv, bom-integration.csv, bom.csv, candidate-backplate-layout.csv, conductor-route-status.csv]
2026-08-11 Add native ECAD web review
    [HR-V0-RC-P0.1-file-manifest.csv, authority-boundary.csv, configuration-binding.csv, file-manifest.csv, gate-control-register.csv, gate-phase-matrix.csv, hr-v0-energization-gates.csv, hr-v0-gate-evidence-supplement-r224.csv]
2026-08-11 Prove watchdog permit topology
    [HR-V0-RC-P0.1-file-manifest.csv, authority-boundary.csv, configuration-binding.csv, fault-truth-table.csv, file-manifest.csv, finding-reconciliation.csv, gate-control-register.csv, gate-phase-matrix.csv]
2026-08-11 Bind contactor application to current ECAD
    [HR-V0-RC-P0.1-file-manifest.csv, application-evidence-register.csv, authority-boundary.csv, configuration-binding.csv, file-manifest.csv, gate-control-register.csv, gate-phase-matrix.csv, hr-v0-energization-gates.csv]
2026-08-11 Freeze E2 grounding boundary
    [HR-V0-RC-P0.1-file-manifest.csv, authority-boundary.csv, boundary-register.csv, configuration-binding.csv, endpoint-parity-register.csv, file-manifest.csv, gate-control-register.csv, gate-phase-matrix.csv]
2026-08-11 Add configuration-bound E2 pre-power verification
    [HR-V0-RC-P0.1-file-manifest.csv, absence-of-voltage-plan.csv, authority-boundary.csv, configuration-binding.csv, file-manifest.csv, gate-control-register.csv, gate-phase-matrix.csv, hr-v0-energization-gates.csv]
2026-08-11 Add P1.18 disposition dossier
    [HR-V0-RC-P0.1-file-manifest.csv, added-terminal-register.csv, authority-boundary.csv, component-delta.csv, configuration-binding.csv, connector-terminal-parity.csv, decision-matrix.csv, file-manifest.csv]
2026-08-11 Add P1.19 visual correction candidate
    [01_external_sources.kicad_sch, 02_estop_eligibility.kicad_sch, 03_arm_watchdog_eligibility.kicad_sch, 04_contactor_edm.kicad_sch, 05_actuator_interruption.kicad_sch, 06_branches_and_limiters.kicad_sch, 07_watchdog_control.kicad_sch, 08_watchdog_feedback_interface.kicad_sch]
2026-08-11 Reconcile Sol R12 blockers against R230
    [HR-V0-RC-P0.1-file-manifest.csv, blocker-disposition.csv, file-manifest.csv]
2026-08-11 Add P1.20 watchdog interlock candidate
    [01_external_sources.kicad_sch, 02_estop_eligibility.kicad_sch, 03_arm_watchdog_eligibility.kicad_sch, 04_contactor_edm.kicad_sch, 05_actuator_interruption.kicad_sch, 06_branches_and_limiters.kicad_sch, 07_watchdog_control.kicad_sch, 08_watchdog_feedback_interface.kicad_sch]
2026-08-11 Add R233 PNOZ watchdog application dossier
    [HR-V0-RC-P0.1-file-manifest.csv, b005-disposition.csv, electrical-compatibility.csv, fault-behavior.csv, file-manifest.csv, hr-v0-gate-evidence-supplement-r233.csv, open-holds.csv, qualification-questions.csv]
2026-08-11 Add P1.21 SRA1 watchdog supply candidate
    [01_external_sources.kicad_sch, 02_estop_eligibility.kicad_sch, 03_arm_watchdog_eligibility.kicad_sch, 04_contactor_edm.kicad_sch, 05_actuator_interruption.kicad_sch, 06_branches_and_limiters.kicad_sch, 07_watchdog_control.kicad_sch, 08_watchdog_feedback_interface.kicad_sch]
2026-08-11 Add P1.21 manufacturer evidence route
    [HR-V0-RC-P0.1-file-manifest.csv, authorization-prerequisites.csv, file-manifest.csv, hr-v0-gate-evidence-supplement-r235.csv, manufacturer-question-register.csv, manufacturer-response-template.csv, open-holds.csv, response-acceptance-register.csv]
2026-08-11 Add configuration-bound runtime evidence logging
    [HR-V0-RC-P0.1-file-manifest.csv, SOURCE-MANIFEST.csv, atomic-requirements.csv, calibration-register.csv, channel-register.csv, clock-budget.csv, configuration-binding.csv, file-manifest.csv]
2026-08-11 Block Lot A purchase on actuator variant mismatch
    [HR-V0-RC-P0.1-file-manifest.csv, anomaly-register.csv, decision-gate.csv, file-manifest.csv, hr-v0-gate-evidence-supplement-r237.csv, item-register.csv, receiving-acceptance-template.csv, source-fact-register.csv]
2026-08-11 Add R238 consolidated P1.21 review baseline
    [HR-V0-RC-P0.1-file-manifest.csv, file-manifest.csv, hr-v0-gate-evidence-supplement-r238.csv, lineage-register.csv, open-holds.csv, sheet-review-register.csv, source-hash-register.csv, source-register.csv]
2026-08-11 Add R239 P1.21 visual review
    [HR-V0-RC-P0.1-file-manifest.csv, direct-observations.csv, file-manifest.csv, hr-v0-gate-evidence-supplement-r239.csv, open-holds.csv, sheet-visual-review.csv, source-hash-register.csv, source-register.csv]
2026-08-11 Add P1.21 protected routing candidate
    [HR-V0-RC-P0.1-file-manifest.csv, corridor-register.csv, crossing-screen.csv, file-manifest.csv, hr-v0-gate-evidence-supplement-r240.csv, inspection-register.csv, open-holds.csv, p121-route-delta.csv]
2026-08-11 Add R241 protected routing hardware candidate
    [HR-V0-RC-P0.1-file-manifest.csv, acceptance-matrix.csv, bom-integration-map.csv, bom.csv, catalog-candidate-register.csv, conductor-allocation-screen.csv, configuration-binding.csv, current-configuration-map.csv]
2026-08-11 Add R242 P1.21 conductor and fill evidence
    [HR-V0-RC-P0.1-file-manifest.csv, acceptance-matrix.csv, bom-integration-map.csv, bom.csv, color-identification-hold.csv, configuration-binding.csv, current-configuration-map.csv, duct-occupancy-screen.csv]
2026-08-11 Add R243 P1.21 termination evidence
    [HR-V0-RC-P0.1-file-manifest.csv, acceptance-matrix.csv, bom-integration-map.csv, bom.csv, configuration-binding.csv, current-configuration-map.csv, endpoint-termination-schedule.csv, exact-material-candidates.csv]
2026-08-11 Add R244 nominal voltage-drop evidence
    [HR-V0-RC-P0.1-file-manifest.csv, acceptance-matrix.csv, bom-integration-map.csv, configuration-binding.csv, current-configuration-map.csv, dcr-conversion.csv, driver-bit-disposition.csv, file-manifest.csv]
2026-08-11 Add R245 integrated mechanical source binding
    [HR-V0-RC-P0.1-file-manifest.csv, SOURCE-MANIFEST.csv, acceptance-matrix.csv, bom-integration-map.csv, current-configuration-map.csv, file-manifest.csv, firmware-binding-verification.csv, gate-impact.csv]
2026-08-11 Add R246 P1.21 static voltage budget
    [HR-V0-RC-P0.1-file-manifest.csv, acceptance-matrix.csv, bom-integration-map.csv, current-configuration-map.csv, file-manifest.csv, gate-impact.csv, hr-v0-gate-evidence-supplement-r246.csv, loop-topology-register.csv]
2026-08-12 Add R247 mechanical shop and assembly package
    [HR-V0-RC-P0.1-file-manifest.csv, SOURCE-MANIFEST.csv, acceptance-matrix.csv, administrative-correction-register.csv, bom-integration-map.csv, current-configuration-map.csv, datum-gdt-disposition.csv, file-manifest.csv]
2026-08-12 Add R248 moving properties closure contract
    [HR-V0-RC-P0.1-file-manifest.csv, acceptance-matrix.csv, assembly-mass-closure-template.csv, bom-integration-map.csv, calculation-contract.csv, current-configuration-map.csv, file-manifest.csv, gate-impact.csv]
2026-08-12 Add R249 accepted property propagation
    [HR-V0-RC-P0.1-file-manifest.csv, acceptance-matrix.csv, accepted-property-input-template.csv, analysis-rebuild-order.csv, bom-integration-map.csv, consumer-input-register.csv, current-configuration-map.csv, downstream-analysis-record-template.csv]
2026-08-12 Add R250 GD&T review proposal
    [HR-V0-RC-P0.1-file-manifest.csv, acceptance-matrix.csv, bom-integration-map.csv, current-configuration-map.csv, datum-reference-frame-proposal.csv, feature-control-proposal.csv, file-manifest.csv, gate-impact.csv]
2026-08-12 Add R251 first shop session contract
    [HR-V0-RC-P0.1-file-manifest.csv, acceptance-matrix.csv, bom-integration-map.csv, current-configuration-map.csv, evidence-location-plan.csv, file-manifest.csv, gate-impact.csv, hold-point-snapshot.csv]
2026-08-12 Add R252 joint-stack fixture evidence route
    [HR-V0-RC-P0.1-file-manifest.csv, HR-V0_joint-stack-fixture_P0.1_review.step, acceptance-matrix.csv, bom-integration-map.csv, contact-zone-register.csv, current-configuration-map.csv, file-manifest.csv, gate-impact.csv]
2026-08-12 Correct joint-stack fixture to rank-6 3-2-1 scheme
    [HR-V0-RC-P0.1-file-manifest.csv, HR-V0_joint-stack-fixture_P0.2_review.step, acceptance-matrix.csv, bom-integration-map.csv, constraint-matrix.csv, contact-zone-register.csv, current-configuration-map.csv, file-manifest.csv]
2026-08-12 Split joint-stack metrology into task-specific methods
    [HR-V0-RC-P0.1-file-manifest.csv, acceptance-matrix.csv, bom-integration-map.csv, current-configuration-map.csv, file-manifest.csv, fixture-applicability.csv, gate-impact.csv, hold-point-register.csv]
2026-08-12 Add controlled Lot A supplier and metrology inquiries
    [HR-V0-RC-P0.1-file-manifest.csv, acceptance-matrix.csv, attachment-manifest.csv, bom-integration-map.csv, current-configuration-map.csv, decision-gate.csv, file-manifest.csv, gate-impact.csv]
2026-08-12 Define source-bound HR-V0 joint measurements
    [HR-V0-RC-P0.1-file-manifest.csv, acceptance-matrix.csv, bom-integration-map.csv, current-configuration-map.csv, execution-result-template.csv, feature-register.csv, file-manifest.csv, gate-impact.csv]
2026-08-12 Bind Lot A inquiries to exact joint measurements
    [HR-V0-RC-P0.1-file-manifest.csv, acceptance-matrix.csv, attachment-manifest.csv, bom-integration-map.csv, characteristic-bid-response-R257-RT-03.csv, characteristic-bid-response-R257-RT-04.csv, characteristic-bid-response-R257-RT-05.csv, characteristic-bid-schedule.csv]
2026-08-12 Create deterministic Lot A transmission bundles
    [HR-V0-RC-P0.1-file-manifest.csv, acceptance-matrix.csv, bom-integration-map.csv, bundle-member-register.csv, bundle-register.csv, current-configuration-map.csv, decision-gate.csv, file-manifest.csv]
2026-08-12 Integrate observation assemblies into system BOM
    [HR-V0-RC-P0.1-file-manifest.csv, acceptance-matrix.csv, assembly-quantity-register.csv, bom-integration-map.csv, bom.csv, conductor-candidate-register.csv, current-configuration-map.csv, file-manifest.csv]
2026-08-12 Define observation carrier mounting candidates
    [HR-V0-RC-P0.1-file-manifest.csv, acceptance-matrix.csv, bom-integration-map.csv, bom.csv, current-configuration-map.csv, file-manifest.csv, fit-and-acceptance-form.csv, gate-impact.csv]
2026-08-12 Define U2D2 controller harness candidate
    [HR-V0-RC-P0.1-file-manifest.csv, acceptance-matrix.csv, bom-integration-map.csv, bom.csv, conductor-and-build-register.csv, continuity-isolation-matrix.csv, current-configuration-map.csv, file-manifest.csv]
2026-08-12 Prepare controller harness manufacturer request
    [HR-V0-RC-P0.1-file-manifest.csv, acceptance-matrix.csv, bom-integration-map.csv, bom.csv, current-configuration-map.csv, file-manifest.csv, gate-impact.csv, harness-requirement.csv]
2026-08-12 Correct carrier power harness definition
    [HR-V0-RC-P0.1-file-manifest.csv, acceptance-matrix.csv, bom-integration-map.csv, bom.csv, current-configuration-map.csv, cut-crimp-schedule.csv, file-manifest.csv, gate-impact.csv]
2026-08-12 Add carrier mounting datum integration package
    [HR-V0-RC-P0.1-file-manifest.csv, acceptance-matrix.csv, bom-integration-map.csv, bom.csv, clearance-screen.csv, connector-anchor-register.csv, current-configuration-map.csv, depth-stack-screen.csv]
2026-08-12 Add carrier fit evidence capture package
    [HR-V0-RC-P0.1-file-manifest.csv, acceptance-matrix.csv, article-identity-register.csv, bom-integration-map.csv, current-configuration-map.csv, deviation-register.csv, file-manifest.csv, gate-impact.csv]
2026-08-12 Add Lot A decision capsule
    [HR-V0-RC-P0.1-file-manifest.csv, acceptance-matrix.csv, authorization-register.csv, bom-integration-map.csv, configuration-binding.csv, current-configuration-map.csv, file-manifest.csv, gate-impact.csv]
2026-08-12 Qualify Lot A alternate actuator route
    [HR-V0-RC-P0.1-file-manifest.csv, acceptance-matrix.csv, authorization-register.csv, bom-integration-map.csv, configuration-binding.csv, current-configuration-map.csv, file-manifest.csv, gate-impact.csv]
2026-08-12 Correct HR-V0 datum and tolerance review
    [HR-V0-RC-P0.1-file-manifest.csv, acceptance-matrix.csv, bom-integration-map.csv, current-configuration-map.csv, degree-of-freedom-intent.csv, drawing-binding.csv, exact-feature-family-register.csv, feature-control-decision.csv]
2026-08-12 Add R269 J2 stop strength correction
    [HR-V0-RC-P0.1-file-manifest.csv, HR-V0_J2_positive_stop_contact_candidate.step, MV0-C01_adapter-finished-profile.dxf, MV0-C01_rect32x16_to_20-2040_countersunk_adapter.step, MV0-C02_20-2040_100mm_vertical_collision_envelope.step, MV0-C03_20-2040_50mm_vertical_collision_envelope.step, MV0-C04_H104_to_20-2040_countersunk_adapter.step, MV0-C04_gripper-adapter-finished-profile.dxf]
2026-08-12 Correct J2 stop contact model and add bossed candidate
    [HR-V0-RC-P0.1-file-manifest.csv, HR-V0_J2_positive_stop_contact_candidate.step, MV0-C01_adapter-finished-profile.dxf, MV0-C01_rect32x16_to_20-2040_countersunk_adapter.step, MV0-C02_20-2040_100mm_vertical_collision_envelope.step, MV0-C03_20-2040_50mm_vertical_collision_envelope.step, MV0-C04_H104_to_20-2040_countersunk_adapter.step, MV0-C04_gripper-adapter-finished-profile.dxf]
2026-08-12 Add reproducible C06 stop FEA rejection evidence
    [HR-V0-RC-P0.1-file-manifest.csv, acceptance-matrix.csv, bom-integration-map.csv, current-configuration-map.csv, file-manifest.csv, finest-mesh-load-cases.csv, gate-impact.csv, mesh-artifact-register.csv]
2026-08-12 Add mixed-side J2 stop correction candidate
    [HR-V0-RC-P0.1-file-manifest.csv, HR-V0_J2_positive_stop_contact_candidate.step, MV0-C01_adapter-finished-profile.dxf, MV0-C01_rect32x16_to_20-2040_countersunk_adapter.step, MV0-C02_20-2040_100mm_vertical_collision_envelope.step, MV0-C03_20-2040_50mm_vertical_collision_envelope.step, MV0-C04_H104_to_20-2040_countersunk_adapter.step, MV0-C04_gripper-adapter-finished-profile.dxf]
2026-08-12 Add C07 access-well stop candidate
    [HR-V0-RC-P0.1-file-manifest.csv, HR-V0_J2_positive_stop_contact_candidate.step, MV0-C01_adapter-finished-profile.dxf, MV0-C01_rect32x16_to_20-2040_countersunk_adapter.step, MV0-C02_20-2040_100mm_vertical_collision_envelope.step, MV0-C03_20-2040_50mm_vertical_collision_envelope.step, MV0-C04_H104_to_20-2040_countersunk_adapter.step, MV0-C04_gripper-adapter-finished-profile.dxf]
2026-08-12 Define A04 joint and J2 contact pad evidence
    [HR-V0-RC-P0.1-file-manifest.csv, acceptance-matrix.csv, analytical-screen.csv, bom-integration-map.csv, bom.csv, candidate-definition.csv, current-configuration-map.csv, dynamic-load-case-register.csv]
2026-08-12 Correct J2 pad load boundary
    [HR-V0-RC-P0.1-file-manifest.csv, acceptance-matrix.csv, bom-integration-map.csv, bom.csv, candidate-definition.csv, configuration-source-binding.csv, current-configuration-map.csv, exact-contact-load-case-register.csv]
2026-08-12 Add dimensioned J2 pad-pocket candidate
    [HR-V0-RC-P0.1-file-manifest.csv, HR-V0_J2_C07_pad-pocket-installed-screen.step, HR-V0_J2_positive_stop_contact_candidate.step, MV0-C01_adapter-finished-profile.dxf, MV0-C01_rect32x16_to_20-2040_countersunk_adapter.step, MV0-C02_20-2040_100mm_vertical_collision_envelope.step, MV0-C03_20-2040_50mm_vertical_collision_envelope.step, MV0-C04_H104_to_20-2040_countersunk_adapter.step]
2026-08-12 Correct P0.13 J2 stop load directions
    [HR-V0-RC-P0.1-file-manifest.csv, acceptance-matrix.csv, assumption-register.csv, bom-integration-map.csv, current-configuration-map.csv, file-manifest.csv, gate-impact.csv, load-boundary-register.csv]
2026-08-12 Define fail-closed J2 mesh convergence protocol
    [HR-V0-RC-P0.1-file-manifest.csv, acceptance-criteria.csv, acceptance-matrix.csv, bom-integration-map.csv, current-configuration-map.csv, file-manifest.csv, gate-impact.csv, mesh-plan.csv]
2026-08-13 Record J2 refinement solver feasibility
    [HR-V0-RC-P0.1-file-manifest.csv, acceptance-matrix.csv, attempt-register.csv, bom-integration-map.csv, brep-entity-register.csv, case-results.csv, current-configuration-map.csv, file-manifest.csv]
2026-08-13 Establish bounded iterative P2 backend
    [HR-V0-RC-P0.1-file-manifest.csv, acceptance-matrix.csv, bom-integration-map.csv, bounded-case-register.csv, current-configuration-map.csv, file-manifest.csv, gate-impact.csv, initial-attempt-register.csv]
2026-08-13 Correct and freeze J2 refinement protocol
    [HR-V0-RC-P0.1-file-manifest.csv, acceptance-matrix.csv, affine-patch-register.csv, agreement-register.csv, bom-integration-map.csv, current-configuration-map.csv, curved-import-c06.csv, curved-import-c07.csv]
2026-08-13 Establish J2 execution architecture
    [HR-V0-RC-P0.1-file-manifest.csv, acceptance-matrix.csv, bom-integration-map.csv, corner-bijection-v04_refined_high_order.csv, current-configuration-map.csv, direct-quadrature-method-test.csv, entity-signature-register.csv, exact-distance-prototype.csv]
2026-08-13 Add R284 curved mesh method evidence
    [HR-V0-RC-P0.1-file-manifest.csv, acceptance-matrix.csv, bom-integration-map.csv, corner-bijection-r284_v03_refined_fixed.csv, corner-correspondence.csv, current-configuration-map.csv, exact-input-register.csv, failed-element-localization.csv]
2026-08-13 Add R285 repeatable targeted mesh evidence
    [HR-V0-RC-P0.1-file-manifest.csv, acceptance-matrix.csv, bom-integration-map.csv, current-configuration-map.csv, exact-feature-identity-register.csv, exact-input-register.csv, exact-target-entity-register.csv, feature-topology-summary.csv]
2026-08-13 Add R286 exact facet and load geometry evidence
    [HR-V0-RC-P0.1-file-manifest.csv, exact-input-register.csv, face-fidelity-summary.csv, file-manifest.csv, load-boundary-preservation.csv, open-holds.csv, validation-register.csv]
2026-08-13 Add R287 mirror-closed fidelity remesh
    [HR-V0-RC-P0.1-file-manifest.csv, exact-input-register.csv, face-fidelity-summary.csv, failed-attempt-register.csv, fidelity-target-entity-register.csv, file-manifest.csv, jacobian-screen-register.csv, load-boundary-preservation.csv]
2026-08-13 Add exact C07 zones and conformal mesh evidence
    [HR-V0-RC-P0.1-file-manifest.csv, actual-quadrature-jacobian-register.csv, curved-jacobian-failure-localization.csv, exact-zone-register.csv, file-manifest.csv, fragment-volume-register.csv, hole-geometry-erratum.csv, open-holds.csv]
2026-08-13 Add R291 conformal successor evidence
    [HR-V0-RC-P0.1-file-manifest.csv, actual-quadrature-jacobian-register.csv, exact-face-target-register.csv, exact-volume-target-register.csv, failed-baseline-register.csv, file-manifest.csv, open-holds.csv, r289-r291-comparison.csv]
2026-08-13 Advance C07 seam-free mesh evidence
    [HR-V0-RC-P0.1-file-manifest.csv, actual-quadrature-jacobian-register.csv, analysis-fragment-register.csv, analysis-zone-register.csv, bore-wall-field-resolution.csv, curved-jacobian-failure-localization.csv, exact-bore-wall-target-register.csv, exact-face-target-register.csv]
2026-08-13 Record C07 curving method dispositions
    [HR-V0-RC-P0.1-file-manifest.csv, acceptance-register.csv, actual-quadrature-jacobian-register.csv, attempt-register.csv, bore-wall-field-resolution.csv, curved-jacobian-failure-localization.csv, exact-face-failure-summary.csv, failed-element-geometry.csv]
2026-08-13 Record CAD curving and facet topology disposition
    [HR-V0-RC-P0.1-file-manifest.csv, actual-quadrature-jacobian-register.csv, affected-node-comparison.csv, attempt-register.csv, bore-wall-field-resolution.csv, exact-face-cluster-register.csv, file-manifest.csv, nearest-face-cluster-summary.csv]
2026-08-13 Correct C07 trimmed-face topology evidence
    [HR-V0-RC-P0.1-file-manifest.csv, exact-24-face-target-register.csv, exact-imprinted-face-register.csv, failed-trimmed-facet-register.csv, failure-cluster-summary.csv, file-manifest.csv, open-holds.csv, zone-equivalence-register.csv]
2026-08-14 Establish HR-30 whole-body architecture P0.1
    [HR-30_body_architecture_candidate.step, HR-30_body_kinematic_reference.step, actuator-transmission-allocation.csv, asimov-1-reuse-adapt-reject.csv, component-envelope-schedule.csv, file-manifest.csv, joint-axis-schedule.csv, mass-allocation-register.csv]
2026-08-14 Complete HR-30 whole-body systems package P0.1
    [compute-sensor-network-budget.csv, cost-budget.csv, file-manifest.csv, hr30.urdf, mass-allocation-register.csv, mass-properties-budget.csv, power-energy-budget.csv, thermal-budget.csv]
2026-08-14 Correct HR-30 walking models to floating base
    [file-manifest.csv, hr30.urdf]
2026-08-14 Integrate HR-30 whole-body joint module families
    [component-envelope-schedule.csv, file-manifest.csv, joint-module-axis-binding.csv, joint-module-family-schedule.csv, open-holds.csv]
2026-08-14 Bind exact actuator geometry across HR-30 body
    [actuator-transmission-allocation.csv, component-envelope-schedule.csv, file-manifest.csv, joint-module-axis-binding.csv, joint-module-family-schedule.csv, open-holds.csv, vendor-actuator-source-register.csv, vendor-actuator-transform-register.csv]
2026-08-14 Clear HR-30 neutral joint packaging
    [actuator-transmission-allocation.csv, component-envelope-schedule.csv, file-manifest.csv, joint-axis-schedule.csv, joint-module-axis-binding.csv, open-holds.csv, vendor-actuator-transform-register.csv]
2026-08-14 Add HR-30 modular fabrication architecture
    [HR-30_modular_fabrication_candidate.step, HR-30_modular_fabrication_reference.step, fabrication-part-register.csv, file-manifest.csv, harness-route-register.csv, open-holds.csv, service-panel-interface-register.csv, whole-robot-candidate-bom.csv]
2026-08-14 Reconcile HR-30 whole-body mass model
    [actuator-mass-source-register.csv, file-manifest.csv, hr30.urdf, link-mass-reconciliation.csv, mass-allocation-register.csv, mass-item-reconciliation.csv, mass-properties-budget.csv, open-holds.csv]
2026-08-14 Lighten HR-30 whole-body architecture
    [component-envelope-schedule.csv, fabrication-part-register.csv, file-manifest.csv, hr30.urdf, joint-module-axis-binding.csv, joint-module-family-schedule.csv, lightweight-architecture-register.csv, link-mass-reconciliation.csv]
2026-08-14 Install HR-30 whole-body equipment layout
    [HR-30_installed_equipment_candidate.step, file-manifest.csv, hr30.urdf, installed-equipment-register.csv, installed-equipment-source-register.csv, lightweight-architecture-register.csv, link-mass-reconciliation.csv, mass-allocation-register.csv]
2026-08-14 Add HR-30 whole-body joint load architecture
    [actuator-endpoint-source-register.csv, actuator-transmission-allocation.csv, bearing-candidate-source-register.csv, component-envelope-schedule.csv, file-manifest.csv, hr30.urdf, joint-load-screen.csv, joint-module-axis-binding.csv]
2026-08-14 Complete HR-30 whole-body actuation and mass architecture
    [actuator-transmission-allocation.csv, bearing-candidate-source-register.csv, component-envelope-schedule.csv, compute-sensor-network-budget.csv, cost-budget.csv, fabrication-part-register.csv, file-manifest.csv, hr30.urdf]
2026-08-14 Model HR-30 onboard walking energy
    [HR-30_installed_equipment_candidate.step, battery-energy-source-register.csv, cost-budget.csv, file-manifest.csv, hr30.urdf, installed-equipment-register.csv, installed-equipment-source-register.csv, joint-load-screen.csv]
2026-08-14 Rebaseline HR-30 whole-body mass envelope
    [file-manifest.csv, lightweight-architecture-register.csv, mass-allocation-register.csv, open-holds.csv]
2026-08-14 Add articulated HR-30 standing and step poses
    [HR-30_p00_neutral_stand_candidate.step, HR-30_p01_crouched_stand_candidate.step, HR-30_p02_left_weight_transfer_candidate.step, HR-30_p03_right_foot_lift_candidate.step, HR-30_p04_right_capture_step_candidate.step, file-manifest.csv, pose-joint-targets.csv, pose-support-metrics.csv]
2026-08-14 Correct HR-30 arm datums and close nominal pose collisions
    [HR-30_p00_neutral_stand_candidate.step, HR-30_p01_crouched_stand_candidate.step, HR-30_p02_left_weight_transfer_candidate.step, HR-30_p03_right_foot_lift_candidate.step, HR-30_p04_right_capture_step_candidate.step, collision-exclusion-register.csv, component-envelope-schedule.csv, file-manifest.csv]
2026-08-14 Add bilateral HR-30 stepping candidates
    [HR-30_p05_right_weight_transfer_candidate.step, HR-30_p06_left_foot_lift_candidate.step, HR-30_p07_left_capture_step_candidate.step, file-manifest.csv, open-holds.csv, pose-collision-summary.csv, pose-joint-targets.csv, pose-support-metrics.csv]
2026-08-14 Correct HR-30 mixed-protocol actuator buses
    [actuator-bus-axis-binding.csv, actuator-bus-source-register.csv, actuator-bus-topology.csv, compute-sensor-network-budget.csv, file-manifest.csv, open-holds.csv, whole-robot-candidate-bom.csv]
2026-08-14 Add native HR-30 whole-body electrical project
    [01_energy_precharge_conversion.kicad_sch, 02_estop_permit_contactors.kicad_sch, 03_compute_motion_watchdog.kicad_sch, 04_eight_actuator_bus_interfaces.kicad_sch, 05_left_leg_rs485.kicad_sch, 06_right_leg_rs485.kicad_sch, 07_left_arm_rs485.kicad_sch, 08_right_arm_rs485.kicad_sch]
2026-08-14 Add HR-30 whole-body interface atlas
    [file-manifest.csv, module-assembly-sequence.csv, module-interface-control-register.csv, open-holds.csv]
2026-08-14 Add separable HR-30 module CAD
    [A01_fabrication_candidate.step, A02_fabrication_candidate.step, F01_fabrication_candidate.step, F01_integration_reference.step, F02_fabrication_candidate.step, F02_integration_reference.step, G01_fabrication_candidate.step, G01_integration_reference.step]
2026-08-14 Add located HR-30 joint fasteners
    [A01_fabrication_candidate.step, A02_fabrication_candidate.step, F01_fabrication_candidate.step, F01_integration_reference.step, F02_fabrication_candidate.step, F02_integration_reference.step, G01_integration_reference.step, G02_integration_reference.step]
2026-08-14 Lighten HR-30 joint carrier topology
    [G01_integration_reference.step, G02_integration_reference.step, HR-30_joint_fastener_candidates.step, HR-30_p00_neutral_stand_candidate.step, HR-30_p01_crouched_stand_candidate.step, HR-30_p02_left_weight_transfer_candidate.step, HR-30_p03_right_foot_lift_candidate.step, HR-30_p04_right_capture_step_candidate.step]
2026-08-14 Add serviceable HR-30 joint family CAD
    [JMF-01-COMPACT_assembly.step, JMF-02-GRIPPER_assembly.step, JMF-04-MEDIUM_assembly.step, JMF-05-WAIST_assembly.step, JMF-06-LEG-DIRECT_assembly.step, JMF-07-LEG-REDUCED-15_assembly.step, JMF-08-LEG-REDUCED-20_assembly.step, JMF-09-KNEE-REDUCED-20_assembly.step]
2026-08-14 Add individual HR-30 fabrication files
    [A01_FOREARM_FRONT_COVER.step, A01_FOREARM_FRONT_COVER.stl, A01_FOREARM_LINK_FRONT.step, A01_FOREARM_LINK_FRONT_largest-face-profile.dxf, A01_FOREARM_LINK_REAR.step, A01_FOREARM_LINK_REAR_largest-face-profile.dxf, A01_FOREARM_REAR_COVER.step, A01_FOREARM_REAR_COVER.stl]
2026-08-14 Add HR-30 whole-body harness architecture
    [05_left_leg_rs485.kicad_sch, 06_right_leg_rs485.kicad_sch, 07_left_arm_rs485.kicad_sch, 08_right_arm_rs485.kicad_sch, 09_waist_rs485.kicad_sch, 10_left_distal_ttl.kicad_sch, 11_right_distal_ttl.kicad_sch, 12_head_ttl_sensors_hmi.kicad_sch]
2026-08-14 Expand HR-30 whole-body electrical architecture
    [03_compute_motion_watchdog.kicad_sch, 12_head_ttl_sensors_hmi.kicad_sch, 13_pelvis_aux_imu.kicad_sch, 14_left_foot_load_sensing.kicad_sch, 15_right_foot_load_sensing.kicad_sch, A01_fabrication_candidate.step, A02_fabrication_candidate.step, F01_fabrication_candidate.step]
2026-08-14 Add pin-level HR-30 actuator interface carriers
    [03_compute_motion_watchdog.kicad_sch, 04_eight_actuator_bus_interfaces.kicad_sch, 04_motion_controller_carrier_connectors.kicad_sch, 05_carrier_a_four_isolated_rs485.kicad_sch, 05_left_leg_rs485.kicad_sch, 06_carrier_b_waist_and_ttl.kicad_sch, 06_right_leg_rs485.kicad_sch, 07_left_arm_rs485.kicad_sch]
2026-08-14 Add physical HR-30 actuator carrier circuits
    [01_carrier_connectors.kicad_sch, 02_rs_lleg.kicad_sch, 03_rs_rleg.kicad_sch, 04_rs_larm.kicad_sch, 05_rs_rarm.kicad_sch, 06_rs_waist.kicad_sch, 07_ttl_ldist.kicad_sch, 08_ttl_rdist.kicad_sch]
2026-08-14 Route and constrain HR-30 actuator carriers
    [carrier-configuration-register.csv, carrier-routing-register.csv, fabrication-candidate-register.csv, file-manifest.csv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]
2026-08-14 Add complete HR-30 physical harness architecture
    [actuator-power-drop-register.csv, axis-harness-binding.csv, bus-physical-link-register.csv, bus-termination-register.csv, cable-core-register.csv, connector-contact-map.csv, connector-instance-register.csv, current-derating-register.csv]
2026-08-14 Add HR-30 tether-first energy safety spine
    [battery-energy-source-register.csv, candidate-device-register.csv, configuration-register.csv, current-power-budget.csv, equipment-interface-register.csv, fault-response-register.csv, file-manifest.csv, first-energization-sequence.csv]
2026-08-14 Correct HR-30 whole-body electrical architecture
    [01_energy_precharge_conversion.kicad_sch, 02_estop_permit_contactors.kicad_sch, 03_compute_motion_watchdog.kicad_sch, 07_left_leg_rs485.kicad_sch, 08_right_leg_rs485.kicad_sch, 09_left_arm_rs485.kicad_sch, 10_right_arm_rs485.kicad_sch, 11_waist_rs485.kicad_sch]
2026-08-14 Add HR-30 whole-robot assembly traveler
    [assembly-checkpoint-register.csv, assembly-operation-register.csv, file-manifest.csv, module-kit-register.csv]
2026-08-14 Add detailed bilateral HR-30 grippers
    [FINGER_NEGATIVE.step, FINGER_POSITIVE.step, GUIDE_ROD_FRONT.step, GUIDE_ROD_REAR.step, MANUAL_RELEASE_HUB.step, PAD_NEGATIVE.step, PAD_POSITIVE.step, PALM_BOTTOM_BRIDGE.step]
2026-08-15 Integrate detailed hands into HR-30 whole-body build
    [A01_FOREARM_LINK_FRONT_largest-face-profile.dxf, A01_FOREARM_LINK_REAR_largest-face-profile.dxf, A01_UPPER_ARM_LINK_FRONT_largest-face-profile.dxf, A01_UPPER_ARM_LINK_REAR_largest-face-profile.dxf, A02_FOREARM_FRONT_COVER.step, A02_FOREARM_LINK_FRONT.step, A02_FOREARM_LINK_FRONT_largest-face-profile.dxf, A02_FOREARM_LINK_REAR.step]
2026-08-15 Define serial HR-30 actuator harness
    [actuator-chain-contact-map.csv, bus-physical-link-register.csv, cable-core-register.csv, connector-boundary-register.csv, connector-contact-map.csv, connector-instance-register.csv, current-derating-register.csv, file-manifest.csv]
2026-08-15 Replace provisional gripper teeth with involute transmission
    [A01_FOREARM_LINK_FRONT_largest-face-profile.dxf, A01_FOREARM_LINK_REAR_largest-face-profile.dxf, A01_UPPER_ARM_LINK_FRONT_largest-face-profile.dxf, A01_UPPER_ARM_LINK_REAR_largest-face-profile.dxf, A02_FOREARM_LINK_FRONT_largest-face-profile.dxf, A02_FOREARM_LINK_REAR_largest-face-profile.dxf, A02_UPPER_ARM_LINK_FRONT_largest-face-profile.dxf, A02_UPPER_ARM_LINK_REAR_largest-face-profile.dxf]
2026-08-15 Define product-specific HR-30 leg drivetrains
    [HR-30_leg_drivetrain_lineup_candidate.step, LD-15_candidate.step, LD-20_candidate.step, LD-25_candidate.step, axis-drivetrain-allocation.csv, belt-center-geometry.csv, candidate-product-register.csv, file-manifest.csv]
2026-08-15 Install product-specific drivetrains in HR-30 body
    [A01_FOREARM_LINK_FRONT_largest-face-profile.dxf, A01_FOREARM_LINK_REAR_largest-face-profile.dxf, A01_UPPER_ARM_LINK_FRONT_largest-face-profile.dxf, A01_UPPER_ARM_LINK_REAR_largest-face-profile.dxf, A02_FOREARM_LINK_FRONT_largest-face-profile.dxf, A02_FOREARM_LINK_REAR_largest-face-profile.dxf, A02_UPPER_ARM_LINK_FRONT_largest-face-profile.dxf, A02_UPPER_ARM_LINK_REAR_largest-face-profile.dxf]
2026-08-15 Increase HR-30 hip-to-torso service clearance
    [A01_FOREARM_LINK_FRONT_largest-face-profile.dxf, A01_FOREARM_LINK_REAR_largest-face-profile.dxf, A01_UPPER_ARM_LINK_FRONT_largest-face-profile.dxf, A01_UPPER_ARM_LINK_REAR_largest-face-profile.dxf, A02_FOREARM_LINK_FRONT_largest-face-profile.dxf, A02_FOREARM_LINK_REAR_largest-face-profile.dxf, A02_UPPER_ARM_LINK_FRONT_largest-face-profile.dxf, A02_UPPER_ARM_LINK_REAR_largest-face-profile.dxf]
2026-08-15 Complete HR-30 leg drivetrain adapter geometry
    [A01_FOREARM_LINK_FRONT_largest-face-profile.dxf, A01_FOREARM_LINK_REAR_largest-face-profile.dxf, A01_UPPER_ARM_LINK_FRONT_largest-face-profile.dxf, A01_UPPER_ARM_LINK_REAR_largest-face-profile.dxf, A02_FOREARM_LINK_FRONT_largest-face-profile.dxf, A02_FOREARM_LINK_REAR_largest-face-profile.dxf, A02_UPPER_ARM_LINK_FRONT_largest-face-profile.dxf, A02_UPPER_ARM_LINK_REAR_largest-face-profile.dxf]
2026-08-15 Add HR-30 actuator branch PDU architecture
    [01_pdu_boundaries.kicad_sch, 02_channel_1.kicad_sch, 03_channel_2.kicad_sch, 04_channel_3.kicad_sch, 05_channel_4.kicad_sch, 06_channel_5.kicad_sch, 07_channel_6.kicad_sch, board-instance-channel-allocation.csv]
2026-08-15 Route HR-30 actuator branch PDU
    [01_pdu_boundaries.kicad_sch, component-register.csv, file-manifest.csv, hr30-actuator-branch-pdu-p0.1.kicad_pcb, terminal-register.csv]
2026-08-15 Install distributed HR-30 actuator power architecture
    [HR-30_installed_equipment_candidate.step, actuator-power-drop-register.csv, assembly-operation-register.csv, cable-core-register.csv, connector-contact-map.csv, connector-instance-register.csv, current-derating-register.csv, equipment-interface-register.csv]
2026-08-15 Build HR-30 tether power core
    [01_external_source_panel.kicad_sch, 02_estop_reset_safety_relay.kicad_sch, 03_redundant_dc_interruption.kicad_sch, 04_touch_safe_tether.kicad_sch, 05_robot_five_branch_distribution.kicad_sch, 06_telemetry_interlocks_commissioning.kicad_sch, HR-30_installed_equipment_candidate.step, HR30_external_tether_panel_candidate.step]
2026-08-15 Add whole-body harness route CAD
    [HR30_whole_body_harness_centerlines_candidate.step, file-manifest.csv, route-cad-register.csv, source-register.csv]
2026-08-15 Add whole-body fabrication sourcing guide
    [dfm-request-register.csv, file-manifest.csv, flat-stock-gap-register.csv, open-holds.csv, part-to-shop-route.csv, primary-source-register.csv, quote-batch-register.csv, shop-route-register.csv]
2026-08-15 Add actual-axis joint hardware manufacturing package
    [JMOD_HEAD_PAN_INTERFACE_PLATE_B.step, JMOD_HEAD_PAN_INTERFACE_PLATE_B_profile.dxf, JMOD_HEAD_PAN_OUTPUT_SHAFT.step, JMOD_HEAD_TILT_INTERFACE_PLATE_B.step, JMOD_HEAD_TILT_INTERFACE_PLATE_B_profile.dxf, JMOD_HEAD_TILT_OUTPUT_SHAFT.step, JMOD_L_ANKLE_PITCH_INTERFACE_PLATE_A.step, JMOD_L_ANKLE_PITCH_INTERFACE_PLATE_A_profile.dxf]
2026-08-15 Complete HR-30 whole-body transmission architecture
    [A01_FOREARM_LINK_FRONT_largest-face-profile.dxf, A01_FOREARM_LINK_REAR_largest-face-profile.dxf, A01_UPPER_ARM_LINK_FRONT_largest-face-profile.dxf, A01_UPPER_ARM_LINK_REAR_largest-face-profile.dxf, A01_fabrication_candidate.step, A02_FOREARM_LINK_FRONT_largest-face-profile.dxf, A02_FOREARM_LINK_REAR_largest-face-profile.dxf, A02_UPPER_ARM_LINK_FRONT_largest-face-profile.dxf]
2026-08-15 Add HR-30 current-limited axis commissioning station
    [01_current_limited_source.kicad_sch, 02_power_hub_and_usb.kicad_sch, 03_one_actuator_selection.kicad_sch, 04_no_motion_boundary.kicad_sch, HR30_axis_commissioning_cover_candidate.stl, HR30_axis_commissioning_station_candidate.step, HR30_axis_commissioning_tray_candidate.stl, axis-commissioning-matrix.csv]
2026-08-15 Clarify HR-30 commissioning sheet count
    [HR30_axis_commissioning_station_candidate.step, file-manifest.csv]
2026-08-15 Fix HR-30 interactive schematic links
    [HR30_axis_commissioning_station_candidate.step, file-manifest.csv]
2026-08-15 Add guarded HR-30 actuator inspection fixtures
    [actuator-fixture-register.csv, file-manifest.csv, fixture-dimension-register.csv, fixture-part-register.csv, inspection-field-register.csv, open-holds.csv, primary-source-register.csv, xc330_t288_t_guarded_fixture.step]
2026-08-15 Add HR-30 commissioning bench harness package
    [as-built-record.csv, assembly-traveler.csv, candidate-bom.csv, conductor-preparation-register.csv, connector-contact-map.csv, file-manifest.csv, harness-assembly-register.csv, open-holds.csv]
2026-08-15 Select manufacturer-assembled HR-30 bench leads
    [01_current_limited_source.kicad_sch, 02_power_hub_and_usb.kicad_sch, HR30_axis_commissioning_station_candidate.step, as-built-record.csv, assembly-traveler.csv, bom.csv, candidate-bom.csv, conductor-preparation-register.csv]
2026-08-15 Select manufacturer-assembled HR-30 bench leads
    Synchronize exact Mueller source leads, 18 AWG Mini-Fit criteria, native KiCad, traveler, web guide, and release evidence. All physical and energization gates remain open.
    [01_current_limited_source.kicad_sch, 02_power_hub_and_usb.kicad_sch, HR30_axis_commissioning_station_candidate.step, as-built-record.csv, assembly-traveler.csv, bom.csv, candidate-bom.csv, conductor-preparation-register.csv]
2026-08-15 Select HR-30 harness inspection tooling
    [HR30_axis_commissioning_station_candidate.step, as-built-record.csv, assembly-traveler.csv, candidate-bom.csv, file-manifest.csv, open-holds.csv, primary-source-register.csv, tooling-register.csv]
2026-08-15 Separate HR-30 tether and onboard mass models
    [file-manifest.csv, hr30_onboard_envelope.urdf, hr30_tether.urdf, joint-hardware-part-register.csv, link-mass-reconciliation-tether.csv, mass-configuration-register.csv, mass-properties-budget-tether.csv, open-holds.csv]
2026-08-15 Close HR-30 current-constrained whole-body candidate
    [A01_FOREARM_LINK_FRONT_largest-face-profile.dxf, A01_FOREARM_LINK_REAR_largest-face-profile.dxf, A01_UPPER_ARM_LINK_FRONT_largest-face-profile.dxf, A01_UPPER_ARM_LINK_REAR_largest-face-profile.dxf, A02_FOREARM_LINK_FRONT_largest-face-profile.dxf, A02_FOREARM_LINK_REAR_largest-face-profile.dxf, A02_UPPER_ARM_LINK_FRONT_largest-face-profile.dxf, A02_UPPER_ARM_LINK_REAR_largest-face-profile.dxf]
2026-08-15 Reconcile HR-30 joint hardware successors
    [file-manifest.csv, joint-hardware-feature-register.csv, joint-hardware-part-register.csv, open-holds.csv, successor-class-summary.csv, successor-manufacturing-binding.csv]
2026-08-16 Bind HR-30 harness to current policy
    [architecture-decision-register.csv, axis-power-policy-binding.csv, bus-power-boundary.csv, file-manifest.csv, open-holds.csv, source-binding.csv]
2026-08-16 Close HR-30 whole-body mass and shoulder architecture
    [09_left_arm_rs485.kicad_sch, 10_right_arm_rs485.kicad_sch, A01_FOREARM_LINK_FRONT_largest-face-profile.dxf, A01_FOREARM_LINK_REAR_largest-face-profile.dxf, A01_UPPER_ARM_LINK_FRONT_largest-face-profile.dxf, A01_UPPER_ARM_LINK_REAR_largest-face-profile.dxf, A02_FOREARM_LINK_FRONT_largest-face-profile.dxf, A02_FOREARM_LINK_REAR_largest-face-profile.dxf]
2026-08-16 Close HR-30 10 kg planning envelope
    [A01_FOREARM_FRONT_COVER.step, A01_FOREARM_FRONT_COVER.stl, A01_FOREARM_LINK_FRONT_largest-face-profile.dxf, A01_FOREARM_LINK_REAR_largest-face-profile.dxf, A01_FOREARM_REAR_COVER.step, A01_FOREARM_REAR_COVER.stl, A01_UPPER_ARM_FRONT_COVER.step, A01_UPPER_ARM_FRONT_COVER.stl]
2026-08-16 Meet HR-30 preferred arm envelope
    [A01_FOREARM_FRONT_COVER.step, A01_FOREARM_FRONT_COVER.stl, A01_FOREARM_LINK_FRONT.step, A01_FOREARM_LINK_FRONT_largest-face-profile.dxf, A01_FOREARM_LINK_REAR.step, A01_FOREARM_LINK_REAR_largest-face-profile.dxf, A01_FOREARM_REAR_COVER.step, A01_FOREARM_REAR_COVER.stl]
2026-08-16 Bind HR-30 actuator harness manufacturer interfaces
    [actuator-interface-verification-register.csv, file-manifest.csv, manufacturer-interface-discrepancy-register.csv, robotis-cable-family-register.csv, source-register.csv]
2026-08-16 Add HR-30 motion controller candidate
    [01_power_conversion.kicad_sch, 02_mcu_power_reset_boot.kicad_sch, 03_carrier_a_interface.kicad_sch, 03_compute_motion_watchdog.kicad_sch, 04_carrier_b_interface.kicad_sch, 04_motion_controller_carrier_connectors.kicad_sch, 05_carrier_a_four_isolated_rs485.kicad_sch, 05_control_debug_action.kicad_sch]
2026-08-16 Close HR-30 controller DRC and refresh whole-body release
    [A01_FOREARM_LINK_FRONT_largest-face-profile.dxf, A01_FOREARM_LINK_REAR_largest-face-profile.dxf, A01_UPPER_ARM_LINK_FRONT_largest-face-profile.dxf, A01_UPPER_ARM_LINK_REAR_largest-face-profile.dxf, A02_FOREARM_LINK_FRONT_largest-face-profile.dxf, A02_FOREARM_LINK_REAR_largest-face-profile.dxf, A02_UPPER_ARM_LINK_FRONT_largest-face-profile.dxf, A02_UPPER_ARM_LINK_REAR_largest-face-profile.dxf]
2026-08-16 Add HR-30 first-energization readiness path
    [A01_FOREARM_LINK_FRONT_largest-face-profile.dxf, A01_FOREARM_LINK_REAR_largest-face-profile.dxf, A01_UPPER_ARM_LINK_FRONT_largest-face-profile.dxf, A01_UPPER_ARM_LINK_REAR_largest-face-profile.dxf, A02_FOREARM_LINK_FRONT_largest-face-profile.dxf, A02_FOREARM_LINK_REAR_largest-face-profile.dxf, A02_UPPER_ARM_LINK_FRONT_largest-face-profile.dxf, A02_UPPER_ARM_LINK_REAR_largest-face-profile.dxf]
2026-08-16 Add HR-30 deterministic no-motion firmware
    [SOURCE-MANIFEST.csv, action-disposition.csv, axis-binding.csv, bus-binding.csv, configuration-baseline.csv, energization-gate-register.csv, fault-injection-register.csv, fault-response.csv]
2026-08-16 Add reproducible STM32H743 no-motion target
    [SOURCE-MANIFEST.csv, action-disposition.csv, artifact-manifest.csv, axis-binding.csv, bus-binding.csv, configuration-baseline.csv, fault-response.csv, file-manifest.csv]
2026-08-16 Add controlled STM32 target bring-up path
    [bringup-gate-register.csv, command-plan.csv, configuration-freeze.csv, debug-adapter-bom.csv, debug-path-contact-map.csv, fault-injection-plan.csv, file-manifest.csv, measurement-plan.csv]
2026-08-16 Add native HR-30 SWD adapter
    [01_swd_adapter.kicad_sch, adapter-bom.csv, bringup-gate-register.csv, configuration-freeze.csv, contact-map.csv, debug-adapter-bom.csv, debug-path-contact-map.csv, fabrication-candidate-register.csv]
2026-08-16 Add HR-30 logic-only power kit
    [configuration-freeze.csv, connector-contact-map.csv, debug-adapter-bom.csv, equipment-register.csv, file-manifest.csv, measurement-register.csv, open-holds.csv, primary-source-register.csv]
2026-08-16 Define whole-robot grounding and DC reference architecture
    [bond-register.csv, configuration-freeze.csv, fabrication-candidate-register.csv, fault-case-register.csv, file-manifest.csv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]
2026-08-16 Add HR-30 physical protective bonding kit
    [bond-hardware-register.csv, conductor-sizing-basis.csv, file-manifest.csv, inspection-measurement-plan.csv, installation-traveler.csv, joint-bypass-obligation.csv, open-holds.csv, primary-source-register.csv]
2026-08-16 Add synchronized HR-30 head HMI harness
    [A01_FOREARM_LINK_FRONT_largest-face-profile.dxf, A01_FOREARM_LINK_REAR_largest-face-profile.dxf, A01_UPPER_ARM_LINK_FRONT_largest-face-profile.dxf, A01_UPPER_ARM_LINK_REAR_largest-face-profile.dxf, A02_FOREARM_LINK_FRONT_largest-face-profile.dxf, A02_FOREARM_LINK_REAR_largest-face-profile.dxf, A02_UPPER_ARM_LINK_FRONT_largest-face-profile.dxf, A02_UPPER_ARM_LINK_REAR_largest-face-profile.dxf]
2026-08-16 Add HR-30 actuator cable-kit definition
    [HR30_axis_commissioning_station_candidate.step, axis-power-cable-candidate.csv, configuration-freeze.csv, connector-cavity-population.csv, connector-family-disposition.csv, data-cable-candidate.csv, fabrication-candidate-register.csv, file-manifest.csv]
2026-08-17 Advance HR-30 actuator cable qualification
    [axis-power-cable-candidate.csv, data-cable-candidate.csv, file-manifest.csv, open-holds.csv, primary-source-register.csv, source-binding.csv]
2026-08-17 Add HR-30 cable coupon build workflow
    [coupon-bom.csv, coupon-build-traveler.csv, coupon-measurement-record.csv, coupon-specimen-register.csv, file-manifest.csv, open-holds.csv, precut-route-register.csv, primary-source-register.csv]
2026-08-17 Add full-scale HR-30 fit-check kit
    [A01_FOREARM_FRONT_COVER.stl, A01_FOREARM_LINK_FRONT.stl, A01_FOREARM_LINK_REAR.stl, A01_FOREARM_REAR_COVER.stl, A01_UPPER_ARM_FRONT_COVER.stl, A01_UPPER_ARM_LINK_FRONT.stl, A01_UPPER_ARM_LINK_REAR.stl, A01_UPPER_ARM_REAR_COVER.stl]
2026-08-17 Normalize HR-30 fit-check files for printing
    [A01_FOREARM_FRONT_COVER.stl, A01_FOREARM_LINK_FRONT.stl, A01_FOREARM_LINK_REAR.stl, A01_FOREARM_REAR_COVER.stl, A01_UPPER_ARM_FRONT_COVER.stl, A01_UPPER_ARM_LINK_FRONT.stl, A01_UPPER_ARM_LINK_REAR.stl, A01_UPPER_ARM_REAR_COVER.stl]
2026-08-17 Add HR-30 whole-body safety requirements
    [common-cause-control-register.csv, file-manifest.csv, hazard-register.csv, lifecycle-mode-register.csv, open-holds.csv, plr-calculation-input-register.csv, safety-function-register.csv, source-binding.csv]
2026-08-17 Complete HR-30 safety and clean-build package
    [03_redundant_dc_interruption.kicad_sch, A01_FOREARM_LINK_FRONT_largest-face-profile.dxf, A01_FOREARM_LINK_REAR_largest-face-profile.dxf, A01_UPPER_ARM_LINK_FRONT_largest-face-profile.dxf, A01_UPPER_ARM_LINK_REAR_largest-face-profile.dxf, A02_FOREARM_LINK_FRONT_largest-face-profile.dxf, A02_FOREARM_LINK_REAR_largest-face-profile.dxf, A02_UPPER_ARM_LINK_FRONT_largest-face-profile.dxf]
2026-08-17 Fix deployed tether schematic links
    [A01_FOREARM_LINK_FRONT_largest-face-profile.dxf, A01_FOREARM_LINK_REAR_largest-face-profile.dxf, A01_UPPER_ARM_LINK_FRONT_largest-face-profile.dxf, A01_UPPER_ARM_LINK_REAR_largest-face-profile.dxf, A02_FOREARM_LINK_FRONT_largest-face-profile.dxf, A02_FOREARM_LINK_REAR_largest-face-profile.dxf, A02_UPPER_ARM_LINK_FRONT_largest-face-profile.dxf, A02_UPPER_ARM_LINK_REAR_largest-face-profile.dxf]
2026-08-17 Add HR-30 staged power protection architecture
    [axis-conductor-screen.csv, bus-envelope.csv, closure-input-register.csv, connector-bottleneck-register.csv, file-manifest.csv, open-holds.csv, pdu-feed-envelope.csv, power-state-separation-register.csv]
2026-08-17 Add HR-30 bidirectional walking power successor
    [01_system_boundaries.kicad_sch, 02_paired_channel_1.kicad_sch, 03_paired_channel_2.kicad_sch, 04_paired_channel_3.kicad_sch, 05_paired_channel_4.kicad_sch, 06_paired_channel_5.kicad_sch, 07_paired_channel_6.kicad_sch, architecture-option-register.csv]
2026-08-17 Correct HR-30 whole-body power and harness architecture (#48)
    Validated whole-body correction; preserves all preliminary and no-energization holds.
    [01_system_boundaries.kicad_sch, 02_paired_channel_1.kicad_sch, 03_paired_channel_2.kicad_sch, 04_paired_channel_3.kicad_sch, 05_paired_channel_4.kicad_sch, 05_robot_eight_branch_distribution.kicad_sch, 05_robot_five_branch_distribution.kicad_sch, 06_paired_channel_5.kicad_sch]
2026-08-17 Correct HR-30 actuator power cable candidates
    [axis-conductor-screen.csv, axis-power-cable-candidate.csv, connector-bottleneck-register.csv, coupon-bom.csv, coupon-specimen-register.csv, file-manifest.csv, open-holds.csv, primary-source-register.csv]
2026-08-17 Define HR-30 actuator fixed-transition harness (#51)
    [HR30_whole_body_harness_centerlines_candidate.step, actuator-power-drop-register.csv, actuator-power-transition-register.csv, axis-conductor-screen.csv, axis-power-cable-candidate.csv, cable-core-register.csv, connector-contact-map.csv, connector-family-disposition.csv]
2026-08-17 Add HR-30 actuator transition bracket CAD (#52)
    Add editable transition cassette CAD and 25 whole-body placements; update the first-energization harness evidence boundary.
    [ATB-BASE-P0.1.step, ATB-CLAMP-CAP-P0.1.step, ATB-STANDARD-ASSEMBLY-P0.1.step, file-manifest.csv, interface-register.csv, open-holds.csv, part-register.csv, placement-register.csv]
2026-08-17 Regenerate complete HR-30 whole-body release
    [A01_FOREARM_LINK_FRONT_largest-face-profile.dxf, A01_FOREARM_LINK_REAR_largest-face-profile.dxf, A01_UPPER_ARM_LINK_FRONT_largest-face-profile.dxf, A01_UPPER_ARM_LINK_REAR_largest-face-profile.dxf, A02_FOREARM_LINK_FRONT_largest-face-profile.dxf, A02_FOREARM_LINK_REAR_largest-face-profile.dxf, A02_UPPER_ARM_LINK_FRONT_largest-face-profile.dxf, A02_UPPER_ARM_LINK_REAR_largest-face-profile.dxf]
2026-08-17 Lightweight HR-30 whole-body candidate
    [A01_FOREARM_FRONT_COVER.step, A01_FOREARM_FRONT_COVER.stl, A01_FOREARM_LINK_FRONT_largest-face-profile.dxf, A01_FOREARM_LINK_REAR_largest-face-profile.dxf, A01_FOREARM_REAR_COVER.step, A01_FOREARM_REAR_COVER.stl, A01_UPPER_ARM_FRONT_COVER.step, A01_UPPER_ARM_FRONT_COVER.stl]
2026-08-17 Add routed HR-30 walking-power PCB candidate
    [02_paired_channel_1.kicad_sch, 03_paired_channel_2.kicad_sch, 04_paired_channel_3.kicad_sch, 05_paired_channel_4.kicad_sch, 06_paired_channel_5.kicad_sch, 07_paired_channel_6.kicad_sch, component-pin-register.csv, file-manifest.csv]
2026-08-17 Add Boston HR-30 fabrication handoff
    [HR30_G01_gripper_fit_plate_nonstructural.stl, bpl-envelope-screen.csv, commercial-rfq-routing.csv, execution-action-register.csv, facility-capability-register.csv, file-manifest.csv, open-holds.csv, plate-part-register.csv]
2026-08-17 Add HR-30 first physical-build cart
    [borrow-contract-register.csv, do-not-buy-yet-register.csv, file-manifest.csv, first-build-action-register.csv, primary-source-register.csv, project-source-binding.csv, purchase-candidate-register.csv, receiving-inspection-register.csv]
2026-08-17 Add HR-30 manual first fit article
    [FFA_BOTTOM_BRIDGE.stl, FFA_END_NEGATIVE.stl, FFA_END_POSITIVE.stl, FFA_FINGER_RACK_NEGATIVE.stl, FFA_FINGER_RACK_POSITIVE.stl, FFA_FRAME_FRONT.stl, FFA_FRAME_REAR.stl, FFA_GUIDE_FRONT.stl]
2026-08-17 Add HR-30 timed walking sequences
    [HR-30_p05_right_weight_transfer_candidate.step, HR-30_p06_left_foot_lift_candidate.step, HR-30_p07_left_capture_step_candidate.step, HR-30_p08_right_touchdown_candidate.step, HR-30_p09_left_touchdown_candidate.step, file-manifest.csv, open-holds.csv, pose-collision-summary.csv]
2026-08-18 Add HR-30 whole-body dynamics validation (#60)
    [axis-dynamics-register.csv, file-manifest.csv, hr30.urdf, hr30_onboard_envelope.urdf, hr30_tether.urdf, hr30_tether_ideal_fixture.xml, lightweight-architecture-register.csv, link-mass-reconciliation-tether.csv]
2026-08-18 Add HR-30 whole-body torque demand evidence (#61)
    [axis-demand-summary.csv, axis-successor-results.csv, file-manifest.csv, hip4-transmission-scenario.csv, open-holds.csv, sequence-demand-summary.csv, sequence-successor-summary.csv, source-binding.csv]
2026-08-18 Add whole-body 4:1 hip transmission candidate (#62)
    [candidate-product-register.csv, file-manifest.csv, hip-package-clearance-register.csv, hip-transmission-mass-budget.csv, hip-transmission-register.csv, hr30_tether_hip4_candidate.urdf, open-holds.csv, source-binding.csv]
2026-08-18 Close HR-30 bounded control and whole-body mass screens (#63)
    Adds the verified bounded controller correction and complete lightweight one-stage hip successor while preserving all physical authority holds.
    [axis-control-results.csv, candidate-product-register.csv, control-samples.csv, controller-candidate.csv, file-manifest.csv, hip-clearance-register.csv, hip-mass-budget.csv, hip-transmission-register.csv]
2026-08-18 Add whole-body harness duty-current evidence (#64)
    Publish bounded per-axis, per-bus, and whole-body current-equivalent traces from the frozen HR-30 control successor while keeping all physical ratings and powered-work authority open.
    [axis-current-duty-envelope.csv, bus-current-duty-envelope.csv, file-manifest.csv, open-holds.csv, source-binding.csv, whole-body-current-duty-envelope.csv]
2026-08-18 Add route-specific HR-30 harness duty thermal screen (#65)
    Bind whole-body walking duty to all 25 routed actuator feeds and publish voltage-drop, loss, bundle, contact, and physical thermal-test planning evidence without releasing any hot rating or powered-work authority.
    [axis-duty-voltage-drop-screen.csv, bus-duty-loss-screen.csv, calculation-basis.csv, contact-utilization-screen.csv, corridor-bundle-duty-screen.csv, current-derating-successor-binding.csv, file-manifest.csv, open-holds.csv]
2026-08-18 Add HR-30 distributed actuator power harness
    Deploy the 25-axis distributed power-harness successor and synchronized interactive guides.
    [actuator-breakout-register.csv, axis-core-allocation.csv, cable-family-register.csv, connector-contact-register.csv, corridor-architecture.csv, distribution-node-register.csv, file-manifest.csv, open-holds.csv]
2026-08-18 Add HR-30 whole-body power route guides
    [HR-30_power_route_guides_candidate.step, clamp-obligation-register.csv, file-manifest.csv, guard-envelope-register.csv, open-holds.csv, primary-source-register.csv, route-centerline-register.csv]
2026-08-18 Add HR-V0 P1.21 no-load fixture
    [01_power_and_absence_boundary.kicad_sch, 02_estop_and_eligibility_chain.kicad_sch, 03_watchdog_gate_and_stimulus.kicad_sch, 04_isolated_measurement_fanout.kicad_sch, authorization-gate-register.csv, bom.csv, candidate-bom.csv, connector-schedule.csv]
