amyleesterling/humanoid-robot/(notices)

Notices in the files:
parts and their libraries:
User guide copyright 2001-2022; product page current 2026. Not safety rated or credited.
